funiang-x/G2026/hardware/67-外壳v5尺寸定案-20261017.md

# 67 · 外壳 v5 尺寸定案（2026-10-17）

> **用途**：在立创EDA 3D 外壳编辑器里**照表落图**的唯一尺寸源。所有数值已用实测锚点闭合，可直接填。
> **性质**：几何定案（**未落图、未打印**）。上一版实测见 `62`，设计基准见 `61`，堆叠来源见 `60`。
> **取代**：`62` §3 的三处建议值（那版按"屏装在上壳"推，已作废）。
> **证据目录**：`_work/print_prep/`（活体导出 `live/`、解析脚本、STL）。

---

## §0 一屏结论

| 项 | v4（10-17 实测） | **v5 定案** | 动作 |
|---|---|---|---|
| 外廓 | 85.0 × 123.0 × 42.0 | **87.0 × 123.0 × 35.8** | X +2（内腔要到 81）、总高 −6.2 |
| 内腔 | 79.0 × 117.0 | **81.0 × 117.0** | 板 80.25 才能进 |
| 分界面 | 22.0 | **27.25** | 抬到 SMA 孔顶 |
| 屏窗 | 57 × 86 | **54 × 83** | 现在比屏还大，屏会掉 |
| 螺丝柱 | Ø4.74/Ø2.2，上壳垂下 | **Ø8.0/Ø2.5，下壳内底长出** | 端面壁厚 1.27 → 2.75 |
| 上下盖 | 无定位无锁止 | **止口 + 一颗 M3 锁三层** | 新增 |
| SMA 孔 | Ø8.5 @Y22 封闭 | **Ø8.5 @Y23，上开口 U 槽** | 抬 1.0 并改开口 |
| Type-C 孔 | 8.0 × 5.3 | **9.5 × 4.0 R2** | 插头 8.25 进不去 |

---

## §1 实测锚点（唯一硬约束）

**用户实测**：核心板顶面（含突出元件）→ 底板顶面 = **17.0 mm**（游标卡尺）。

由此反推座子档位：

```
17.0 = 层高 + 核心板厚 1.6 + 元件高
层高 11.5（母座塑高 9 + 排针塑胶 2.5）⇒ 元件 3.9   ← 与 Type-C 座 3.26 吻合 ✓
层高 9.0（若 9 是插合层高）         ⇒ 元件 6.4   ← 偏大，不成立
```

⇒ **采信层高 11.5**，即"约 9 mm"= 母座塑高。上、下两组座子同规格（用户确认两处都是约 9 mm）。

---

## §2 高度链（外壳外底 = 0，全部锁定）

| 层 | Y | 相对板顶 | 依据 |
|---|---|---|---|
| 下壳外底 | 0.00 | −18.50 | |
| 下壳内底 | **1.50** | −17.00 | 底厚 1.5 |
| 核心板最低点 | 1.50 | −17.00 | **实测 17** |
| 核心板背面 | 5.40 | −13.10 | |
| 核心板针面 | 7.00 | −11.50 | 层高 11.5 |
| 底板底面 | 16.90 | −1.60 | |
| **底板顶面** | **18.50** | **0 ★基准** | 1.5 + 17 |
| 转接板底面 | 30.00 | +11.50 | 层高 11.5 |
| 转接板顶面 | 31.60 | +13.10 | 板厚 1.6 |
| 屏背面 | 31.90 | +13.40 | 背胶 0.3 |
| **屏面** | **33.96** | **+15.46** | 屏 2.06 |
| 上壳内面 | 34.26 | +15.76 | 留 0.3 压筋 |
| **外顶** | **35.76** | +17.26 | 顶厚 1.5 |

⇒ **总高 35.8**（取整）。下壳 0~27.25，上壳 27.25~35.8。

> ⚠️ 与 `60` §0.3 的差异：`60` 用层高 11.0 得屏面 +14.96、总高 ≈35.3。本次按用户口径 9 mm 取层高 11.5，
> 整体上移 0.5。**以本表为准**。

---

## §3 外廓 / 内腔 / 壁厚

| 项 | 值 | 说明 |
|---|---|---|
| 外廓 X | **87.0** | v4 是 85.0 |
| 外廓 Z | **123.0** | 不变 |
| 壁厚 | **3.0** | 不变（X 加宽而非减壁） |
| 内腔 X | **81.0** | 板 80.25 ⇒ 单边 0.375 |
| 内腔 Z | **117.0** | 板 100.25 ⇒ 余量充裕 |
| 下壳底厚 | 1.5 | |
| 上壳顶厚 | 1.5 | |
| 四角圆角 | R10（沿用） | |

> 为什么不能靠减壁解决：壁厚降到 1.9 才够内腔 81.2，FDM 打出来侧壁会软、螺丝柱无根。

---

## §4 开孔表（★ 照此落图）

坐标口径：**板坐标**（底板框左下角为原点，X 右 Y 上）。
外壳→板映射（用 3 个柱位拟合，残差 <0.15）：`板x = 外壳X + 0.13`，`板y = 0.14 − 外壳Z`。

| 开孔 | 位置（板坐标） | 尺寸 | 高度（Y，外底起算） | 形状 |
|---|---|---|---|---|
| **屏窗** | 中心 **(38.86, 37.90)** | **54.0 × 83.0** | 上壳顶面贯穿 34.26~35.76 | 矩形，四角 R2 |
| **SMA** | 板 y **41.44** | **Ø8.5** | 中心 **23.0**（= 板顶 +4.5） | **上开口 U 形槽**，槽宽 7.0，槽顶 = 分界面 27.25 |
| **Type-C** | 板 y **85.84** | **9.5 × 4.0**，R2 | 中心 **≈7.4**（座中心，实测反推） | 横向胶囊 |
| **M3 ×3** | (4.32,4.50)/(75.56,4.50)/(75.56,94.16) | 上壳 **Ø4.2 过孔 + Ø7.5 沉孔深 1.8** | 贯穿上壳 | 沉头 |

**屏窗校核**：屏模块 55.05 × 84.50，显示区 52.96 × 81.34。
窗 54 × 83 ⇒ 四周压边 0.525 / 0.75，露出显示区并挡住 PCB 边框 ✓（v4 的 57×86 反而比屏大 1.95，屏会掉出去）

**SMA 校核**：SMA-KE 螺纹外径 Ø6.35，槽宽 7.0 ⇒ 单边 0.325，端子从上方垂直落入不掉出。
孔顶 27.25 = 分界面 ⇒ 上壳完全不碰端子（v4 孔骑在接缝上，合盖会刮螺纹）。

**Type-C 校核**：插座外框 8.94 宽、插头 8.25 ⇒ 开 9.5 给单边 0.28；v4 的 8.0 插头进不去。

---

## §5 结构与锁紧

### 5.1 螺丝柱（3 处，从**下壳内底**长出）

| 项 | 值 |
|---|---|
| 柱外径 | **Ø8.0** |
| 自攻底孔 | **Ø2.5**（M3 自攻） |
| 柱高 | **15.4**（1.5 → 16.9，顶到板底） |
| 端部 | 倒角 C0.5；柱顶做 Ø4.0 × 0.8 定位凸台（先定板再合盖） |
| 位置 | 与板上 3 个 M3 孔同心（见 §4） |

> 三个柱位都在核心板区域 (1.08,53.61)–(71.31,98.87) **之外**，柱体不会撞核心板。

### 5.2 锁紧：一颗 M3×20 锁三层

螺丝从**上壳外面**沉头穿入 → 穿过上壳 → 穿过底板 → 拧进下壳柱 8 mm。
板由柱端面承重，不再靠 Ø2.2 自攻孔吊着（v4 的自攻壁厚仅 1.27 mm，必裂）。

### 5.3 止口（上下盖定位）

| 项 | 值 |
|---|---|
| 下壳侧壁顶部 | 内侧开槽 **1.7 宽 × 2.5 深**（外侧保留 1.3） |
| 上壳开口端 | 内侧减薄成 **1.5 厚 × 2.4 长** 的凸边 |
| 配合 | 外侧齐平，内侧单边间隙 **0.1**（FDM 实测偏紧时放到 0.15） |

### 5.4 屏的防晃

屏靠母座固定，插合有 0.2~0.5 间隙 ⇒ 上壳内面做 **0.3 高压筋**（窗框内侧 2 mm 处一圈），
合盖时贴住屏的 PCB 边框把屏压正。上壳内面 34.26 − 屏面 33.96 = 0.30，压筋正好不顶屏。

---

## §6 装配顺序（U 形槽成立的前提）

1. 核心板插到底板下方（2×20 双排母 ×2）
2. 屏模块（转接板）插到底板上方 J5
3. 组件整体垂直放入下壳，**SMA 端子从 U 槽口落入**；3 个柱顶凸台套进板孔定位
4. 上壳套下，止口导向，30pin 已在步骤 2 完成，此处不再对插
5. 3 颗 M3×20 从顶面穿入拧紧

> ⚠️ 屏与板的对插在**合盖前**就完成了（屏跟着板走），合盖只是罩上去。
> 这与 `61` §6 的"合盖时对插"不同 —— 那一版假设屏装在上壳。

---

## §7 待验 / 出处

| 项 | 状态 |
|---|---|
| 核心板顶面→板顶 17.0 | ✅ 用户游标卡尺实测（2026-10-17） |
| 母座塑高 9 → 层高 11.5 | ✅ 由 17 反推自洽（元件 3.9） |
| Type-C 座中心 7.4 | ⚠️ 由 v4 外壳孔位反推，**装壳前用实物核一次** |
| 屏模块 55.05×84.50 / 显示区 52.96×81.34 | ✅ `58` / `60` |
| 板 80.25×100.25 | ✅ `hardware/data/pcb_snapshot_20261011.json` |
| SMA-KE 中心在板顶 +4.5 | ✅ `62` §3.2 |

**复算**：`_work/print_prep/` 下 `analyze.py`（分层）、`loops.py`（开孔环）、`obj2stl.py`（转 STL + 流形自检）。
**活体导出**：EDA bridge `POST /execute` → `pcb_ManufactureData.get3DShellFile(pcb_uuid,'obj')`。
