funiang-x/G2026/hardware/58-屏与转接板机械尺寸-20261011.md

# 58 · 屏与转接板 机械尺寸（做外壳用）（2026-10-11）

> **用途**：给 **PCB 外壳/结构件** 设计提供**纯屏幕**与**转接板**两部分的准确尺寸。
> **性质**：只读资料整理。**每个数字都标了出处**，凡没找到出处的都明确写"未查到"。
> **配图**：`_work/_mech/尺寸标注_屏与转接板.png`（按真实比例绘制的两件外形 + 关键尺寸）。

---

## §1 一屏结论（先看这张表）

| 件 | 外形（W×H） | 厚 | 出处 |
|---|---|---|---|
| **① 纯屏幕**（LCD 模块 TK035F9629，驱动 IC ST7796） | **55.05 (±0.2) × 84.50 (±0.2) mm** | **2.06 (±0.06) mm** | 屏规格书 P.4「GENERAL INFORMATION」+ P.5「EXTERNAL DIMENSIONS」 |
| **② 转接板**（TK035F5501） | **98.70 × 56.00 mm** | **未查到**（常规 1.6 mm，**请卡尺实测**） | 转接板 Altium 源文件 `TK035F5501_adapter_Constant_current.pcbdoc` 的 Board 记录（板框顶点实测 56.01 × 98.71 mm） |

> ⚠️ **方向约定**：屏是**竖屏**（55.05 宽 × 84.50 高）；转接板是**横板**（98.70 长 × 56.00 宽）。
> 屏在转接板上**居中**安装，两者长轴同向（屏的 84.50 贴着转接板的 98.70）。

---

## §2 ① 纯屏幕（LCD 模块）的尺寸

| 项 | 数值 | 出处 |
|---|---|---|
| **模块外形（含铁框/背光）** | **55.05 ±0.2 × 84.50 ±0.2 mm** | 规格书 P.5 标注 `55.05±0.2` / `84.50±0.2` |
| **模块厚度** | **2.06 ±0.06 mm** | 规格书 P.5 侧视图标注 `2.06±0.06` |
| **玻璃外形（LCD OD）** | 52.96 × 81.34 mm | 规格书 P.5 标注 `LCD OD 52.96` / `LCD OD 81.34` |
| **可视区（LCD AA）** | **48.96 × 73.44 mm** | 规格书 P.4「Active area」+ P.5 标注 `LCD AA 48.96` / `LCD AA 73.44` |
| 分辨率 / 像素间距 | 320RGB × 480 / 0.1395 × 0.1395 mm | 规格书 P.4 |
| **FPC** | **45 pin，0.3 mm 间距**，型号 `CDN1TDRFH26-45S-0.3SHW(05)` | 规格书 P.5 注释「FPC MEET WITH CDN1TDRFH26-45S-0.3SHW(05)」 |
| FPC 引出长度 | 图上标注 **9.67** / **9.45**（**归属未完全确认**，建议实测） | 规格书 P.5（数字可读，箭头归属需现场核） |
| 视角方向 | 6 O'CLOCK（正视） | 规格书 P.4 / P.5 |
| 工作温度 | −20 ~ +70 ℃ | 规格书 P.6 |

**给外壳的提示**：
- **开窗**要 ≥ **可视区 48.96 × 73.44**，但要留**公差 + 视角**余量 ⇒ 建议按 **玻璃外形 52.96 × 81.34** 再放 0.3–0.5 mm 单边间隙来开窗。
- **压边**（盖住铁框）可用区域 = 玻璃外形到模块外形之间，即**单边 1.045 mm**（(55.05−52.96)/2）与 **1.58 mm**（(84.50−81.34)/2）。压边别压到玻璃。
- 屏正面到安装面 ≈ **2.06 mm**（模块厚）。

---

## §3 ② 转接板（TK035F5501）的尺寸

### 3.1 板框与安装孔（**从 Altium 源文件直接解出，可复算**）

| 项 | 数值 | 出处 / 说明 |
|---|---|---|
| **PCB 外形** | **98.70 × 56.00 mm** | `.pcbdoc` Board 记录：X 3000.0–5205.1 mil = **56.01 mm**；Y 3000.0–6886.2 mil = **98.71 mm** |
| **四角圆角** | **R ≈ 1.275 mm** | 顶点 `3050.1968 mil = 3000 + 50.2 mil` ⇒ 半径 50.2 mil = 1.275 mm |
| **安装孔** | **4 × Ø3.00 mm** | `.pcbdoc` 中 4 个 `HOLESIZE=118.1 mil` 的无网络焊盘 |
| **安装孔中心距** | **92.70 × 50.00 mm** | 孔心 (79.20,79.20)/(129.20,79.20)/(79.20,171.90)/(129.20,171.90) mm ⇒ ΔX=**50.00**、ΔY=**92.70** |
| **孔到板边** | **各 3.00 mm** | (98.70−92.70)/2 = 3.00；(56.00−50.00)/2 = 3.00 |
| **定位孔** | **2 × Ø1.70 mm**，间距 **33.02 mm** | `.pcbdoc` 中 2 个 `HOLESIZE=66.9 mil` 焊盘，位于距短边 4.40 mm 处 |

> **外壳安装建议**：用 **M3 螺钉**穿过 Ø3.0 孔，或做 **Ø3.2 的定位柱**。
> 孔位 = 板左下角起 **(3.00, 3.00)、(95.70, 3.00)、(3.00, 53.00)、(95.70, 53.00) mm**（x 沿 98.70 方向、y 沿 56.00 方向）。

### 3.2 板上的关键接口位置

| 项 | 位置 | 出处 |
|---|---|---|
| **屏 footprint**（板上的屏轮廓） | **84.50 × 55.05**，在板上**居中** | 机构图内框（像素实测 84.6 × 55.0）+ 与屏规格一致；长向各留 **7.10 mm**、短向各留 **0.475 mm** |
| **30pin 接口**（2×15 / 2.54 mm，与底板 `J5` 对插） | 板**左端**，沿 **56.00** 方向排列，跨度 **35.56 mm** | 机构图丝印标签（CS/RS/WR/RD/RST/D00…D15/T_CS/T_SCK/T_MISO/T_MOSI/T_IQR/BL_CTR/3V3/GND 共 30 个） |
| **LCD FPC 座**（45 pin） | 板**左侧**（贴板边） | `.pcbdoc` 中 45 个 0.3 mm 间距焊盘 |

> ⚠️ **未完全落实**：30pin 排针与 FPC 座的**精确坐标**我没能在 Altium 文件里唯一定位（该板有多个细间距连接器），
> 上表给的是**从机构图像素测量 + 丝印推断**的结果。**做外壳若要紧贴这两个接口开孔，请以实物卡尺为准。**

### 3.3 板厚与层数

- **板厚**：`.pcbdoc` 里**未找到** THICKNESS 记录（Altium 的层叠表在别的流里）。
  ⇒ **按常规 1.6 mm 假设，请卡尺实测**（这是外壳"总厚"的关键一项）。

---

## §4 装配关系（三层堆叠）与总厚估算

本装置的堆叠（详见 `hardware/49`）：

```
        ┌───────────────┐
        │  ① 屏 2.06mm  │   ← 朝上（用户看的一面）
        ├───────────────┤
        │  ② 转接板     │   ← 屏在其上居中；板厚待实测（≈1.6mm）
        ├───────────────┤
        │  30pin 排针   │   ← 转接板向下插进底板 J5（母座）
        ├───────────────┤
        │  底板 1.6mm   │   ← 本项目自己画的板
        ├───────────────┤
        │  核心板       │   ← 从下方插进底板的 EVK1 双排母
        └───────────────┘
```

| 层 | 厚度 | 来源 |
|---|---|---|
| 屏 | **2.06 mm** | 规格书 |
| 转接板 | **待实测**（≈1.6 mm） | 未查到 |
| 排针啮合高度 | **待实测** | 未查到 |
| 底板 | 1.6 mm（默认） | `54 §8.1` |
| 核心板 | 待实测 | — |

> ⚠️ **总厚必须实测**：上面三层里**有两层我没拿到厚度**（转接板、排针啮合），
> 外壳的"总高"必须等实物到齐后用卡尺量。**不要用估算值开模。**

---

## §5 关键注意事项（做外壳前必读）

1. **别用估算值开模**：屏的两个尺寸（55.05×84.50×2.06）来自**厂家规格书**，可信；
   转接板外形（98.70×56.00）来自**厂家 Altium 源文件**，也可信；
   但**板厚、排针啮合高度、FPC 实际长度**都**没有**权威数字 ⇒ 必须实测。
2. **公差**：屏的外形公差 **±0.2 mm**（宽/高）、**±0.06 mm**（厚）⇒ 开窗与压边要按最坏情况留余量。
3. **FPC 的弯折空间**：屏的 FPC 要从屏折到转接板的 FPC 座上，**这段折叠需要空间**（厚度 + 弯折半径）。
   外壳里要给 FPC 留**至少一个板厚的空腔**，否则压伤 FPC。
4. **转接板的安装孔与屏的压边可能打架**：孔距板边只有 **3.00 mm**，
   而屏居中后短向只留 **0.475 mm** ⇒ 短向两侧的螺钉/定位柱**紧贴屏边**，注意别顶到屏的铁框。
5. **本工程的转接板是"屏厂配套件"**，不在我们的 BOM 里 ⇒ 尺寸以**厂家机构图**为准；
   本项目自画的只有**底板**（80.3 × 100.3 mm，见 `54 §8.1`）。

---

## §6 出处与复算

| 数据 | 文件 | 取法 |
|---|---|---|
| 屏外形 / 玻璃 / AA / 厚 / FPC 型号 | `docs/TK035F5687_9629_整理资料_(含SPI及并口版)/01_文档规格书/TK035F9629_ST7796版/TK035F9629规格书v1.2.pdf` | P.4 文字表 + P.5 外形图（渲染成图后读标注） |
| 转接板板框 / 圆角 / 安装孔 / 定位孔 | `…/05_硬件转接板资料/1000亮度转接板/Altium_TK035F5501_adapter_Constant_current/TK035F5501_adapter_Constant_current.pcbdoc` | 该文件是 **`\|RECORD=` 分隔的 ASCII**（不是纯二进制）⇒ 直接正则解出 Board 记录的顶点与 Pad 记录的孔径 |
| 转接板尺寸标注（98.70 / 92.70 / 56.00 / 50.00 / 55.00） | `…/TK035F5501_adapter机构图/TK035F5501_adapter机构图.png` | 用板上 **2×15 排针（2.54 mm 间距）** 做标尺标定 ≈18.63 px/mm，再量各轮廓 |
| 两件比例图 | `_work/_mech/尺寸标注_屏与转接板.png` | matplotlib 按真实 mm 绘制 |

> **交叉验证**：转接板外形用**三种方法**得到一致结果 —— ① Altium 板框顶点 **56.01 × 98.71 mm**；
> ② 机构图像素测量（以排针 2.54 mm 标定）**98.71 × 56.04 mm**；③ 图上标注 **98.70 × 56.00**。⇒ **可信**。
