funiang-x/G2026/hardware/59-PCB与原理图深度审查-精度专项-20261011.md

# 59 · PCB 与原理图深度审查（精度专项）（2026-10-11）

> **性质**：对**当前活体原理图 + PCB** 的**只读**深度审查，**以"设计精度"为主线**，
> 同时覆盖：布局合理性 · 布线规范 · 信号完整性 · 电源完整性 · 接地 · 去耦 · 阻抗匹配 ·
> 散热 · EMC/EMI · 丝印 · 封装与实物一致性 · 制造工艺。
> **状态**：审查完成，**一条都没改**（本轮只读 + 取证脚本）。
>
> **本版快照**：PCB `semanticSha256 = ce89ef0f…`（20:29 版）· 原理图网表
> `.easyeda/artifacts/20261011-202945-schematic_netlist-c708521a.enet`（20:29:45）。
> **与 54/55/56/57 的关系**：那四份是 16:07–17:24 版；**16:07 之后板子又变过**
> （四只电感换 0630 一体成型、L7=15µH、R15/R16 删除、R6/R11 同步），
> 本文按**新快照**重跑全部几何判据，并补上此前四轮都没做的**互感耦合量化**与**公差累积表**。
> **判据**：本文数字全部可复跑 —— 脚本 `_work/pcb_audit_r5_20261011/{audit_r5,audit_r5b,mutual_coupling}.py`，
> 原始输出 `geo_report.txt` / `geo_report_b.txt`，快照 `pcb.json`，DRC/DFM/规则 `{drc,check,drc_rules,config}.json`。
>
> **符号**：**★ = 直接影响电路精度 / 测量准确性**；◐ = 间接（经基准 / 接地 / 耦合 / 换件）；
> — = 与精度无关（工艺 / 装配 / 可读性）。

---

## §0 一屏结论

| # | 级 | 结论 | 精度 |
|---|---|---|---|
| 1 | **P1** | **B1（增益 ×4）已落图落码 ⇒ 旧标定表作废**；且**标定残差 0.383 mV 是 12 µH 口径**（L7 已改 15 µH）⇒ 必须重标定 + 复跑残差 | **★** |
| 2 | **P1** | **L7 的 BOM 三字段不一致**：`Value=15µH` / `MPN=HCM0630-150M` / `LCSC=C9900009031` → 库内实为 **`MPEV1D0630L150`**（封装名 `W6.5` ≠ 板用 `W6.6`）；且丝印还印着旧名 `XR0630-220M` | ◐ |
| 3 | **P1** | **背光驱动方式仍未确认**：转接板通用版只有 `SI2302` MOSFET 直驱、**无镇流**，而屏规格要求**恒流 60 mA ±10%** | ◐ |
| 4 | **P1** | **`+3V3` 同时是 ADC 基准与屏/背光电源**（核心板 `VREF+=VDDA=+3V3`）⇒"背光开/关谱底差"**仍未实测** | **★** |
| 5 | **P1** | **`SCREW3` 仍在板中央 AFE 岛内** (40.64, 46.53) —— 四角不齐、三点支撑、在模拟地岛中央打 Ø3.2 通孔 | — |
| 6 | **P1** | **`AGND↔GND` 铜隙仅 5.0 mil = 0.127 mm**（`POUR6↔POUR2` L1）⇒ 制造缺陷即可桥接成第二个接地点（**DRC 不报**） | ◐ |
| 7 | **P1** | **模数隔离带 5.97 mm < 10 mm**（`LCD_BL_CTL`→`C11`）；数字**过孔**最近 7.36 mm —— 而固件找峰门限只有 **1.5 mV** | **★** |
| 8 | **P2** | **L3/L5/L7 现在共轴摆放（0°/0°/0°）**，违反"四电感正交"这条既有设计规则（旧版为 90/0/90/0）。新件是一体成型（自屏蔽）⇒ 估计 k≈0.5–3%，折算**阻带劣化约 1–5 dB**（余量 15.6 → ≥10 dB，仍达标） | **★** |
| 9 | **P2** | 总线 `LCD_D1` **62.0 mm** / `LCD_RS` **60.8 mm** 越 60 mm 硬上限；`D0` 51.9 / `D2` 44.3 / `RD` 42.4 越 40 mm 提示线 | ◐ |
| 10 | **P2** | **规则两条比厂能力还松**：`trackTrack = 4.02 mil` < 嘉立创 2 层下限 5 mil；`copperToEdge = 10 mil` < 建议 0.3 mm | — |
| 11 | **P2** | **地铺铜焊盘连接 = 直接连接**（`connectMode=0`，三层模型全 0）⇒ 手焊时地脚被大铜面抽热 | — |
| 12 | **P2** | `R7` → `U1.6(-INB)` = **3.67 mm**（判据 ≤3 mm）；`-in` 高阻节点铜长 **7.05 mm** | ◐ |
| 13 | **P2** | **`+5V` 入口只有一颗 22 µF 钽**（无陶瓷）；`J5.30` 旁只有 `C3`(3.42 mm)/`C22`(6.33 mm)，无 22–47 µF | ◐ |
| 14 | **P2** | **`R1`→`J1`(SMA) 8.75 mm**（判据 ≤2–3 mm）：端接点不在"输入端" | **★** |
| 15 | **P2** | **`C10`→`PA1` 9.53 mm / `R11`→`PA1` 11.52 mm**：ADC 电荷库与串联电阻离引脚偏远 | **★** |
| 16 | **P2** | **文档口径错两处**（54/55/56 写"CD54 **屏蔽**电感"、"L **±10%**"）：旧件 XRCD54/CD54 实为**非屏蔽鼓芯**、M 档是 **±20%** | **★** |
| 17 | **P3** | **全板丝印 0 条自由文字**（无板名/版本/装配说明）；**21 处位号倒置**；**9 处丝印压盘**（含 `L7` 的旧器件名） | — |
| 18 | **P3** | **`+3V3` 在 L2 上穿过 `AGND` 铺铜 22.13 mm**（把模拟地平面开了一条槽；2 条模拟线跨越它） | ◐ |
| 19 | **P3** | `J5.23`(`T_CS`) 悬空 ⇒ 转接板 XPT2046 未确定性关断 | ◐ |
| 20 | **P3** | `R6` 的 `Tolerance`/`Temperature Coefficient` 字段为空；`R7` 字段写 ±5 ppm/℃（与 R6 的 25 ppm 不一致） | ◐ |
| 21 | **P3** | 触摸 I²C **底板已无上拉**（`R15/R16` 已删）⇒ 完全依赖转接板 `R9=4.7K`（通用版原理图已确认有此件） | ◐ |
| 22 | **P3** | 无 Mark 点（**可接受**：最小间距 1.27 mm、无细间距件、手焊）；`track-over-pad` 1 处（`R2.1`）；`width-mismatch` 7 处；`width-under-spec` 1 处（AGND 10 mil 短段） | — |
| 23 | **P3** | 板框是**圆角矩形**（工具报 `unexpected-start:R`，`outline-get` 的 `segments=0`/`centerlineBBox=null`）⇒ 需在 EDA 里目视确认板框闭合 | — |
| **好** | — | **DRC `passed=true` / 0 违规**；**原理图↔PCB 逐脚 65/65 件、68/68 网、0 不符**；33Ω 21/21 仍贴 MCU 侧 2.53–2.88 mm；`AFE_ADC_IN` 4.01 mm / 0 过孔；数字线 **0 段**侵入 AGND；AGND 单点成立；缝合孔 373 个；**并联电容 AGND 脚到过孔 1.28–1.30 mm**（新证，优秀）；层间铜平衡 77.4/77.7 cm² | — |

**一句话**：电气与几何层面**没有致命缺陷**（DRC 绿、网表 1:1、六条电源网都有源、单点接地成立）。
本轮新增的三条实打实的发现是：**① L7 料号三字段不一致 + 丝印印旧名；② 电感由"正交"变"共轴"（附互感量化）；③ `+3V3` 在模拟地平面上开了 22 mm 的槽**。
**而"精度"这件事，当前最大的风险仍然不在板子上，而在流程上：B1 改了增益之后，标定必须重做。**

---

## §1 16:07 之后板子变了什么（本轮与 54/55/56/57 的差异清单）

| 项 | 16:07 版（54/55/56/57 口径） | **20:29 版（本文口径）** |
|---|---|---|
| `L1` | `XRCD54-4R7M`（非屏蔽鼓芯，5.2×4.5） | **`XR0630-4R7M`**（一体成型 0630，7.0×6.6） |
| `L3`/`L5` | `CD54-220M`（非屏蔽鼓芯） | **`XR0630-220M`**（一体成型） |
| `L7` | `XRCD54-120M`（**12 µH**，非屏蔽） | **`HCM0630-150M`**（**15 µH**，一体成型档） |
| 电感轴向 | **90°/0°/90°/0°**（相邻正交） | **90°/0°/0°/0°** —— **L3/L5/L7 共轴**（§2.4） |
| `R15`/`R16` | 4.7 kΩ 触摸上拉 | **已删**（PCB/原理图均已无此件） |
| `R6` | 24.9 kΩ（×2.0） | **53.6 kΩ**（×4.0，B1 已落图落码） |
| `R11` | 100 Ω | **300 Ω**（D1 已落，`0805W8F3000T5E`/`C17617`） |
| 走线/过孔/弧 | 272 段 / 386 孔 / 9 弧 | **270 段 / 393 孔 / 5 弧**（电感换型后重布） |
| 缝合孔 | 364 | **373**（AGND 230 / GND 143） |
| 丝印 DFM | silk-over-pad 8 | **9**（新增 `L7` 的两条器件名丝印压盘） |
| 线宽突变 DFM | width-mismatch 4 | **7**（电感换型后新增 3） |
| DRC | passed（57 记 1 条平台侧 Netlist Error） | **passed=true，`violations=[]`（那条已不在）** |

> 网表口径同步：**原理图 65 件 / PCB 65 件 / 68 网 / 逐脚 0 差异**（仅 `EVK1` 符号 84 脚比封装多 4 个 NC 脚，既有、无害）。

---

## §2 精度专项（本文重点）

### 2.1 先把"哪些东西真的影响精度"划清楚

| 类别 | 项 | 为什么 | 标记 |
|---|---|---|---|
| **标定消不掉**（真正吃 5 mV 预算） | ADC 的 INL/DNL（0.6–1.2 mV）· VREF 温漂（0.25–1.0 mV）· 屏/背光对 `+3V3`(=基准) 的扰动 · 混叠残留（0.135 mV） | 标定只消"恒定乘性/加性"项 | **★** |
| **标定消不掉，但来自"标定质量"** | 17 点表的插值残差（现值 **0.383 mV** 是 12 µH 口径）· 标定后换件/换板 | 与"表"和"件"绑定 | **★** |
| **会被标定吸收**（但会放大上面的项） | `R1/R3/R4` ±1% · `R6/R7` ±0.1% · `L ±20%` · C0G ±5% · 运放带宽/孔径损失 | 恒定 ⇒ 表里记下就是 | ◐ |
| **与精度无关** | 33Ω 位置、丝印、Mark 点、`SCREW3`、`connectMode`、总线长度 | 影响 EMC/装配/可制造性 | — |
| **无匹配要求** | 走线等长（§2.3） | 无差分对、无同步时钟总线 | — |

### 2.2 公差累积链（逐项 → 折算 → 能否被标定吸收）

> 口径：输入 250 mVpp ⇒ ADC 端 ≈1003 mVpp（×4.0137）。"折算读数"指折算到**输入端**的 mV。

| # | 环节 | 器件 / 参数 | 容差 | 折算到输入端 | 标定能吸收？ |
|---|---|---|---|---|---|
| 1 | 输入端接 | `R1` 49.9 Ω ±1% | 1%（乘性） | 2.5 mV | 能（恒定） |
| 2 | 滤波源/负载端接 | `R3`/`R4` 49.9 Ω ±1% | 1% | 带内 <0.1 dB | 能 |
| 3 | **滤波电感** | `L1/L3/L5/L7` **±20%（M 档真实件）** | ±20% | 带内起伏最坏 **2.5 dB**（15 µH 档，n=1500 MC）⇒ 标定残差被放大 | 能（同板标定），**但增大 §2.1 的插值残差** |
| 4 | 滤波电容 | `C2/C4/C6/C8` C0G ±5% | ±5% | 同上 | 能 |
| 5 | **增益网络** | `R6` 53.6 k / `R7` 3.57 k，**均 ±0.1%** | 最坏 0.14% | **0.35 mV** | 能 |
| 6 | 增益温漂 | `R6` 25 ppm/℃（RT 系列）vs `R7` 字段写 **±5 ppm/℃** | 差 20 ppm/℃ | 20 ℃ 内 ≈0.10 mV | **不能**（但极小；两者同热区） |
| 7 | 偏置 | `R9`/`R10` ±1% + `+3V3` ±1~2% | VBIAS ±1~3% | **只吃 ADC 余量**（±50 mV 内），不改读数 | — |
| 8 | **基准** | `+3V3`(=VREF) 温漂 | 0.25–1.0 mV | **不能**（见 `56 §4`） |
| 9 | **ADC 非线性** | INL ±1.5/±3 LSB | 0.6 / 1.2 mV | **不能**（第 1 大项） |
| 10 | ADC 量化 | LSB_in = 0.2014 mV（×4 后） | 每 bin 0.008 mV | 能（噪声） |
| 11 | 采样时序 | fs = 144 MHz/72 = **2.000 MHz 精确**、触发间隔 = 18 ADCCLK 整 | **0 抖动** | 能 |
| 12 | **电感温漂** | 一体成型件规格未归档（按 ±0.05%/℃ 量级估） | 20 ℃ → ~1% L | **0.1–0.5 mV（估）** | **不能**（未归档，见 §2.5） |

**结论**：所有"乘性/加性"容差（1–5、10）都会被标定吸收 —— 这也是本项目一直能过的原因；
**剩下的 6/8/9/12 四项（温漂 + ADC INL）才是 5 mV 判据的敌人**，与 `56`/`57` 的结论一致，
**新增的是第 12 项（电感温漂）此前没有归档**。

### 2.3 走线长度匹配误差 —— 本板"不需要等长"，但要给出量化

- **核实**：网表里 `equalLengthNetGroup = {}`、`differentialPair = {}` —— **没有任何等长/差分约束**。
- **信号侧**：模拟链是单端、单通道 ⇒ 无匹配对象；8080 总线**无同步时钟**（写周期由 `WR` 选通，~104 ns/字）。
- **量化**：数据线最长 `LCD_D1` 62.0 mm ↔ 最短（数据组）`LCD_D14` 34.6 mm ⇒ 失配 **27.4 mm**；
  按 εeff≈3.3（v≈165 mm/ns）折算**偏斜 ≈ 166 ps**，占 104 ns 写周期的 **0.16%** ⇒ **无影响**。
- **唯一"看似要匹配"的是 FSMC 21 条线**：它们靠 **33Ω 源端阻尼**（已 21/21 贴 MCU 侧 2.53–2.88 mm）控制振铃，
  不靠等长 ⇒ **结论：本板不存在走线长度匹配误差问题**（这一条是"审查过、无问题"，不是遗漏）。

### 2.4 新发现：电感互感耦合（L3/L5/L7 共轴摆放）

**事实**（PCB 快照实测）：

| 电感 | 器件 | 轴向 | 中心位置(mm) | 相邻中心距 |
|---|---|---|---|---|
| `L1` | XR0630-4R7M（4.7 µH） | **90°** | (12.95, 33.07) | L1↔L3 10.20 mm（正交 ✓） |
| `L3` | XR0630-220M（22 µH） | **0°** | (15.37, 23.17) | L3↔L5 **10.29 mm（共轴）** |
| `L5` | XR0630-220M（22 µH） | **0°** | (25.65, 23.29) | L5↔L7 **10.29 mm（共轴）** |
| `L7` | HCM0630-150M（15 µH） | **0°** | (35.94, 23.17) | L3↔L7 20.57 mm |

替换前是 **90/0/90/0（相邻正交）**，替换后 **L3/L5/L7 三只共轴一列**（绕线轴都在 X，且 Y 相同）——
这正是"非屏蔽鼓芯时代"那条设计规则（互感抑制）要避免的摆放。**新件的材料属性变了，规则的理由也变了，但"共轴"这个事实必须重新评估。**

**量化**（`mutual_coupling.py`，MNA 含耦合电感支路；已用独立节点法对拍，k=0 时差 **0.0000%**）：

| 耦合系数 k | 带内峰谷(dB) | 500 kHz Δ | 1.0 MHz Δ | 1.2 MHz Δ | 1.5 MHz Δ |
|---|---|---|---|---|---|
| 0（基准） | 0.081 | — | — | — | — |
| **+2%** | 0.076 | −0.006 | **+2.6** | **+3.5** | **+5.2** |
| **+5%** | 0.075 | −0.015 | **+6.1** | **+7.9** | **+10.9** |
| +8% | 0.080 | −0.025 | +9.1 | +11.5 | +15.3 |

（值为"阻带衰减劣化量"，dB；正号 = 抑制变差。负 k 会反而改善，但同型号同朝向、电流同向 ⇒ **实际应为正 k**。）

**怎么读这张表**：
1. **带内几乎不变**（±0.08 dB 量级）⇒ 500 kHz 以内的读数与标定**不受影响**；
2. **阻带敏感度是 dB 级/%** ⇒ 这是"u_J 抑制余量"（现 15.6 dB）的净损失；
3. 新件是**一体成型（自屏蔽）**：LCSC 器件描述原文"**由于采用模制结构，超低嗡嗡声**"⇒ 估计 k ≈ **0.5–3%**
   （旧的非屏蔽鼓芯同样距离会到 5–10%，那时才必须正交）⇒ **预计损失 1–5 dB，余量仍 ≥10 dB，达标**。
   ⚠️ 但 k 是**估计值**，没有实测（本板未制造）；且 `_work/ind_sel_check/results.md` 的 MC 也**没有计入互感**。
4. **建议**（按性价比）：
   - **首选**：投板前把 **`L5` 转 90°**（2 个焊盘各挪 ~3.3 mm，只动 2 段短线）⇒ 恢复相邻正交，风险归零；
   - **次选**：不改，把 **"u_b + 200 mVpp @1.5 MHz ⇒ |ΔUpp| < 1 mV"**（`56 §14-7`）列为投板后**第一优先**验证项 ——
     它天然覆盖这条风险，测不过再改板；
   - 文档侧：把"四电感正交（因非屏蔽鼓芯互感）"改写为"**新件为一体成型，正交非必需但保留**；已评估".

### 2.5 "标定之后会漂"的清单（精度最怕的不是误差，是误差会变）

| 会漂的项 | 现值/估计 | 标定后是否失效 | 对策 |
|---|---|---|---|
| `+3V3`(=VREF) 温漂 | 0.25–1.0 mV | 是 | `57 A3`（VREFINT 补偿）；赛前/赛中各标一次 |
| 屏/背光加载 `+3V3` | 未测 | 是（若背光被反复开关） | 背光只开一次（现有固件如此）+ 实测谱底 |
| `R6`/`R7` 比值温漂 | ≤0.1 mV / 20 ℃ | 否（量级太小） | — |
| `L`/`C` 温漂 | C0G 可忽略；**电感温漂未归档** | 可能是（0.1–0.5 mV 估） | 归档 `XR0630/HCM0630` 的感值温漂规格；**赛前/赛中各标一次** |
| 换件 / 换屏 / 换核心板 | — | **是（残差直接翻倍级）** | 铁律：标定后不换任何前端件（`56 §13-1`） |

### 2.6 影响精度的布局判据复核（本轮实测）

| 判据 | 实测 | 结论 | 精度 |
|---|---|---|---|
| 21×33Ω → MCU 引脚 | **2.53–2.88 mm**（21/21） | 优 | — |
| `R1` → `J1`(SMA) | **8.75 mm** | 端接点不在输入端；≤500 kHz 电气可忽略（Γ<0.005） | **★**（规范项） |
| `R11` → `C10` | **1.93 mm** | 好（Riso + 电荷库成对） | — |
| `C10` → `PA1`(EVK1.4) | **9.53 mm** | 偏远（判据 ≤5 mm）；`AFE_ADC_IN` 本体仅 4.01 mm | **★** |
| `C14` → `U1.8`(+5V_A) | **2.23 mm** | 优 | — |
| `C11` → `U1.8` | **3.55 mm** | 边际（DFM `decap-too-far`） | ◐ |
| `C3`/`C22` → `J5.30` | **3.42 / 6.33 mm** | 一般 | ◐ |
| `R6`/`R7` → `U1.6(-INB)` | **2.46 / 3.67 mm** | `R7` 越线（`-in` 高阻节点） | ◐ |
| `-in` 节点(`$3N658`)铜长 | **7.05 mm / 6 段** | 与 16:07 版持平（未回退） | ◐ |
| `AFE_ADC_IN` | **4.01 mm / 1 段 / 0 过孔** | 优 | — |
| 并联电容 AGND 脚 → 最近 AGND 过孔 | **1.28–1.30 mm**（`C2/C4/C6/C8/C10/C5/D1`） | **优（本文新证）** | — |
| 数字线侵入 AGND 岛 | **0 段** | 优 | — |

---

## §3 布局合理性

| 项 | 实测 | 判定 |
|---|---|---|
| 三区结构（AFE 岛 / 数字+屏 / 电源） | `AGND` 五块铺铜（L1+L2 成对）罩住 AFE；`GND` 三块在数字区 | 成立 |
| `SCREW3` 在 AFE 岛中央 (40.64, 46.53) | 判据=四角对称 | **P1 未改** |
| `R24`(97.7)/`R41`(97.6) 距上边缘 ~2.4 mm | 装壳时防压 | 注意 |
| 屏模块 + 转接板压在底板上方 | 转接板背光升压正对 AFE 上方 | 与 §7 N2 同一件事（实测覆盖） |
| 电感区域 | 四只 0630，L3/L5/L7 共轴 | 见 §2.4 |
| 底层 23 件 | `EVK1` + `R12` + `R22~R42`（21 只 33Ω） | 与 `55 §1.3` 口径一致 |

## §4 布线规范性

| 项 | 实测/规则 | 判定 |
|---|---|---|
| 最小线宽 / 最小净距 | 10 mil / **9.56 mil**（`AGND↔$3N702`） | 实测达标（厂下限 5 mil） |
| **设计规则** `trackTrack` | **4.02 mil** | **P2：比厂能力松**（应按 6 mil 收） |
| **设计规则** `copperToEdge` | **10 mil** | **P2：嘉立创建议 ≥12 mil** |
| 过孔 | **393 个全部 24/12 mil**，单一规格 | 优 |
| 线宽分布 | 10 mil×229 / 15×27 / 30×14 | 合理（30 mil 在电源/地） |
| 走线↔过孔 最小净距 | 5.99 mil | 刚好达标 |
| 弧 / 悬空头 / 锐角 / 重复段 / 单层过孔 / 盘中孔 | 5 / **0** / **0** / **0** / **0** / **0** | 优 |
| DFM 遗留 | `track-over-pad` 1（`R2.1`）· `width-mismatch` 7 · `width-under-spec` 1（AGND 10 mil 短段） | P3 |

## §5 信号完整性

- **端接与匹配**：`J1 → R1 49.9Ω ∥ (C1+R2)` ⇒ 输入 ≈50 Ω；LC 梯形双端 49.9 Ω；**无需控阻抗走线**（最高关注频率 1.5 MHz，λ/100 尺度 ≫ 板尺寸）。
- **源端阻尼**：21 条 FSMC 线 33Ω 贴 MCU 侧（2.53–2.88 mm）—— 过冲 47%→8% 的既有结论仍成立。
- **ADC 前端**：`R11` 300 Ω + `C10` 470 pF ⇒ fc ≈ **1.13 MHz**；`R11` 落在 ADC 数据手册反解的窗口（240 Ω…1.1 kΩ）内；
  采样电荷由 `C10`（≥100×`CADC`）就近供给 ⇒ 采样瞬态不受 `R11` 影响。
- **总线长度**：`D1` 62.0 / `RS` 60.8 / `D0` 51.9 / `D2` 44.3 / `RD` 42.4 mm —— **P2**（有 33Ω 阻尼，主要是辐射面积）。
- **串扰**：DFM `coupling` = 0；最小线间距 9.56 mil ⇒ 3W 规则（10 mil 线 → 30 mil 间距）在数字区不满足，但总线为**低速选通**（~9.6 MHz 基频），风险低。
- **参考平面**：`AGND` 在 L1+L2 **成对**；数字网**没有一个**以 AGND 为参考（此前 `55` 已证，本轮结构未变）。

## §6 电源完整性

| 网 | 实现 | 判定 |
|---|---|---|
| `+5V` | 3 块填充；来源 `EVK1.40`+`EVK1.80` | 去耦仅 `C16`(22 µF 钽) ⇒ **P2 补陶瓷** |
| `+5V_A` | 1 块填充；`R21` 4.7Ω 隔离 | `C11`+`C14`（2.23 mm）✓ |
| `+3V3` | 2 块填充 + **32.58 mm 走线**；`EVK1.38` → `J5.30`(屏) / `R9`(VBIAS) / `C3`/`C22` | 见 §2.1 N2；**且 L2 段在 AGND 铺铜里开了 22.13 mm 槽（§7）** |
| `VBIAS` | 分压 + `C5`；25.83 mm 走线 | AC 低阻（5 k∥10 µF）⇒ 长走线无害 |
| `GND` / `AGND` | 3 块 / 5 块铺铜 + 缝合孔 373 | 单点成立 |

- **载流**：最大电流（背光恒流 60 mA + LCD 逻辑 + MCU ≈ 170 mA）对 10 mil（≈0.89 A）仍有 ~5× 余量 ✓。
- **填充间最小净距**：0.508 mm（前版结论，本轮结构未变）。
- `pcb check` 的 3 条 `power-not-poured` 仍是**误报**（工是不认 fill）。

## §7 接地

- **单点结构成立**：`AGND` 唯一出口 `EVK1.37`；板上 `AGND↔GND` **零连接件**。
- **P1 未改**：`AGND↔GND` 铜隙 **0.127 mm**（`POUR6↔POUR2` L1）⇒ 见 §13-6。
- 缝合孔 **373**（AGND 230 / GND 143）；10 mm 网格空格 6/90（7%）；最大最近邻 **7.62 mm**（顶到 ≤300 mil 边界，**别再删**）。
- `J5.29`（屏地针）→ 最近 GND 过孔 **1.80 mm**，5 mm 内 **8 个** ✓。
- **新发现（P3）**：`+3V3` 有一条 **22.13 mm** 的 L2 走线（x=14.76 mm，y 35.6→57.7）**穿在 `AGND` 铺铜内部**，
  把模拟地平面切开一条 ~0.7 mm 宽的槽；**跨越该槽的 L1 走线 2 段**（`$3N526`@37.2 mm、`$3N702`@41.6 mm，都是模拟网）。
  该走线只供 `R9/R10` 分压（165 µA），**电学影响很小**；建议改到 L1 沿 AGND/GND 边界走，或接受并记录。

## §8 EMC / EMI

| 项 | 量化 | 级 |
|---|---|---|
| `J5.29` 单地针承担 21 线 + 背光回流 | 8 就近过孔缓解；上板用地弹实测 | 中 |
| 模数隔离带 **5.97 mm**（判据 ≥10 mm） | 门限 1.5 mV ⇒ 直接判据 | **P1** |
| `AGND↔GND` 0.127 mm | 桥接 + 24 mm 近距耦合边 | **P1** |
| 电感由**非屏蔽鼓芯**换**一体成型** | 自屏蔽 ⇒ **漏磁显著下降（改善）**；但共轴摆放的**互耦**仍在（§2.4） | P2 |
| 总线 `D1` 62 mm 环路 | 有 33Ω，自干扰风险低 | P2 |
| `+3V3` 槽 | 见 §7 | P3 |
| 整机辐射认证 | 赛题无要求 ⇒ 风险是"自干扰" | 低 |

## §9 散热

- 器件级：`U1` ≤20 mW、`R21` 0.12 mW、其余 <1 mW ⇒ **无器件散热风险**。
- 工艺级（P2）：地铺铜**直接连接**（`connectMode=0`）⇒ 手焊时烙铁热量被 77 cm² 铜面抽走，地脚难上锡。
  **建议改十字连接**（改前请在 EDA 里目视确认 `connectMode` 语义）。

## §10 丝印与装配

- **自由文字 = 0 条**（236 个丝印对象**全是** attribute）⇒ **没有板名/版本/日期/装配说明**。
- **21 处位号倒置**（`EVK1` 侧向 + 底层 `R12`/`R22~R42` 反向）；**9 处丝印压盘**。
- **新发现（P3）**：`L7` 的**器件名丝印仍印着 `XR0630-220M`**，且正压在 `L7.2` 焊盘上 —— 而实物是 **15 µH** ⇒ 装配误导，建议删掉/改成 `15µH`。
- 建议补的丝印（沿用 `54/57`，一条都没做）：板名/版本/日期 · **"33Ω 贴 MCU 侧"** · **"`PB0` 严禁 PWM"** · `J1 = 50Ω IN` · `TP3/4/5` 功能 · 安装孔 `NPTH Ø3.2`。
- 极性件 `C11`/`C16`（钽）封装内丝印**读不到**，仍需目视确认。

## §11 封装 / BOM 与实物一致性

| 项 | 状态 |
|---|---|
| 原理图↔PCB 脚级 | **65/65 件、68/68 网、0 不符**（本轮用 20:29 网表 + 20:29 快照重算） |
| `C3/C5/C7/R11` 料号（上轮修的） | 已闭环 ✓（`CC0805KRX5R8BB106`/`C1952586`、`0805W8F3000T5E`/`C17617`） |
| **`L7`（新）** | **三字段不一致**：`Value=15µH` ↔ `MPN=HCM0630-150M` ↔ `LCSC=C9900009031`（库内 `MPEV1D0630L150`，封装 `W6.5`，板用 `W6.6`）⇒ **P1，下单前必须对齐** |
| `L1/L3/L5`（新） | `XR0630-4R7M`/`C5307631`、`XR0630-220M`/`C5307626` 自洽 ✓ |
| 电感容差口径 | 实物为 **M 档 ±20%**（不是文档写的 ±10%）⇒ 报告/PPT 要改 |
| `R6` | `RT0805BRD0753K6L`（0.1%/25 ppm 由料号隐含），但**属性字段空** ⇒ 建议补齐 |
| 转接板 I²C 上拉 | 底板 `R15/R16` 已删 ⇒ 依赖转接板 `R9=4.7K`（**通用版原理图已确认存在**）✓ |
| 转接板背光 | 通用版 = `SI2302` 直驱（**无镇流**）⇒ 与屏规格"恒流 60 mA"不符 ⇒ **P1 待实物确认** |
| 屏 `VCI` 电压 | 规格书自相矛盾（2.8 V vs 2.8–3.3 V），需实测（沿用 `55 §4.3`） |
| 转接板 `IM[2:0]` | 6 个 0Ω，上电前万用表核（贴错 = 乱码） |

## §12 制造工艺与 DFM（本版实测）

- **DRC `passed=true` / 0 违规**（`pcb drc --project G2026`）。
- **DFM 自检：0 ERROR / 36 WARN** —— `silkFlipped 21` · `silkOverPad 9` · `widthMismatch 7` ·
  `overPad 1`(`R2.1`) · `decapTooFar 1`(`C11`) · `widthUnderSpec 1` · `fiducialMissing 1` · `powerNotPoured 3`(误报)；
  `viaInPad / dangling / clearance / acute / coupling / singleLayerVia / netlessPour / floatingIsland` **全 0**。
- 铜到板边 10 mil（P2）、过孔环 6 mil ✓、113 个金属化孔最小环宽 9.35 mil（前版数据，本轮 dump 未含孔字段）。
- 安装孔已 NPTH ✓；无 Mark 点（可接受）。
- **两个已证 DRC 盲区仍成立**：① "焊盘有网、板上无网"（网表不同步）抓不到 ⇒ 本文用**本地逐脚比对**补上（0 差异）；
  ② `Pad Hole Ring` 检查项为空 ⇒ 改过孔/封装后必须桥读孔径。

---

## §13 问题总表（按严重程度分级；★=直接影响精度/测量准确度）

| # | 级 | 问题 | 位置 | 精度 | 状态 |
|---|---|---|---|---|---|
| 1 | **P1** | 增益改 ×4 后**必须重标定**；标定残差需按 **L7=15µH** 复跑（现 0.383 mV 是 12 µH 口径） | 流程 + `op_cal` | **★** | 未做 |
| 2 | **P1** | `L7` BOM 三字段不一致 + 丝印印旧名 `XR0630-220M` | L7 | ◐ | 未做 |
| 3 | **P1** | 背光驱动方式未确认（通用版无镇流 vs 规格恒流 60 mA） | 转接板 | ◐ | 待实物 |
| 4 | **P1** | `+3V3`=ADC 基准 且被屏/背光共用 ⇒ 背光开/关谱底差未测 | 全板 | **★** | 待实测 |
| 5 | **P1** | `SCREW3` 在 AFE 岛中央 (40.64, 46.53) | SCREW3 | — | 未改 |
| 6 | **P1** | `AGND↔GND` 铜隙 0.127 mm（DRC 不报） | POUR6↔POUR2 | ◐ | 未改 |
| 7 | **P1** | 模数隔离带 5.97 mm < 10 mm（门限 1.5 mV） | LCD_BL_CTL→C11 | **★** | 未改 |
| 8 | **P2** | L3/L5/L7 共轴（违反正交规则）；估 k 0.5–3% ⇒ 阻带 −1~−5 dB | AFE | **★** | 本文新发现 |
| 9 | **P2** | `LCD_D1` 62.0 / `LCD_RS` 60.8 越硬上限；`D0/D2/RD` 越 40 mm | 总线 | ◐ | 未改 |
| 10 | **P2** | 规则 `trackTrack 4.02 mil` / `copperToEdge 10 mil` 比厂能力松 | 规则 | — | 未改 |
| 11 | **P2** | 地铺铜焊盘连接 = 直接连接（手焊散热） | 规则 | — | 未改 |
| 12 | **P2** | `R7`→`U1.6` 3.67 mm；`-in` 节点 7.05 mm | AFE | ◐ | 未改 |
| 13 | **P2** | `+5V` 仅 22 µF 钽；`J5.30` 旁无 22–47 µF | 电源 | ◐ | 未改 |
| 14 | **P2** | `R1`→`J1` 8.75 mm（端接点不在输入端） | 输入 | **★** | 未改 |
| 15 | **P2** | `C10`→`PA1` 9.53 mm / `R11`→`PA1` 11.52 mm | ADC | **★** | 未改 |
| 16 | **P2** | 文档口径错：旧件"非屏蔽"误写"屏蔽"；L 容差 ±10% 误（实为 ±20%） | 54/55/56/报告 | **★** | 未改 |
| 17 | **P3** | 丝印 0 自由文字 + 21 倒置 + 9 压盘 | 全板 | — | 未改 |
| 18 | **P3** | `+3V3` 在 L2 穿过 AGND 22.13 mm（槽） | x=14.76 mm | ◐ | 本文新发现 |
| 19 | **P3** | `J5.23`(`T_CS`) 悬空 | J5.23 | ◐ | 未改 |
| 20 | **P3** | `R6` 容差/温漂字段空；`R7` 温漂字段 ±5 ppm 与 R6 不一致 | 属性 | ◐ | 本文新发现 |
| 21 | **P3** | 底板触摸 I²C 无上拉（依赖转接板） | I²C2 | ◐ | 已确认可接受 |
| 22 | **P3** | 无 Mark 点 / `R2.1` 压盘 / 7 处线宽突变 / AGND 10 mil 短段 | 全板 | — | 可接受 |
| 23 | **P3** | 板框为圆角矩形，工具读不全（需目视确认闭合） | 板框 | — | 待确认 |

## §14 建议动作（按"先做哪个"排序）

| 序 | 级 | 动作 | 验证方法 |
|---|---|---|---|
| 1 | **P1** | **`L7` 料号对齐**：把 `MPN` 改成与 `LCSC C9900009031` 一致的 `MPEV1D0630L150`（或反之，并确认封装 W6.5/W6.6 是否同焊盘）；**删掉/改写 L7 的旧器件名丝印** | `easyeda lib by-lcsc` 回读 + `bom export` 29 行复核 |
| 2 | **P1** | **投板前复跑标定残差**（L7=15 µH 口径）并**把"重标定"写进上板流程** | 复跑 `cal_resid_opt.py`（需 numpy/scipy）；上板跑 `56 §14-1` 的 41 个非表点 |
| 3 | **P1** | **确认转接板版本**（有 `LP3321B6F`+4.7 µH ⇒ 恒流版；只有 `SI2302` ⇒ 通用版，需改驱动或加镇流） | 目视 + 测 `LED−` 电流 54–66 mA |
| 4 | **P1** | **实测背光开/关的 ADC 谱底差**（判据 <0.5 mV） | 输入端 50Ω 终端 + 频谱底对比 |
| 5 | **P1** | **`SCREW3` 移到左上角**（与另三孔对称） | `pcb drc` + 目视 |
| 6 | **P1** | **`AGND` 颈两侧加禁铺铜区**，间隙 ≥0.5 mm（建议 1 mm） | `pcb drc` + 复跑 `ref_plane_check.py` |
| 7 | **P1** | **`LCD_BL_CTL` 绕开 `C11`**，隔离带 ≥10 mm | 复跑 `audit_r5.py §5`（数字线↔AFE 距离） |
| 8 | **P2** | **`L5` 转 90°**（恢复相邻正交），或**不改并记录**，把 u_J 1.5 MHz 实测列为投板后第一项 | `audit_r5.py §4`（轴向角）+ 上板 `56 §14-7` |
| 9 | **P2** | 规则收紧：`trackTrack → 6 mil`；`copperToEdge → 12 mil`；地铺铜改**十字连接** | `pcb config get` 回读 + `pcb drc` |
| 10 | **P2** | `+5V` 并 10 µF X5R + 100 nF；`J5.30` 旁补 22–47 µF | 纹波/谱底实测 |
| 11 | **P2** | `R1` 往 `J1` 收（≤3 mm）；`C10` 往 `PA1` 收（≤5 mm） | 复跑 `audit_r5.py §3` |
| 12 | **P2** | **文档口径修正**：旧件非屏蔽、新件一体成型、L 容差 ±20%、共轴已评估 | 改 `hardware/54/55/56` 与答辩 PPT 对应页 |
| 13 | **P3** | 补丝印（板名/版本/"33Ω 贴 MCU 侧"/"PB0 禁 PWM"/`J1=50Ω IN`/TP 功能/NPTH Ø3.2）；位号转正 21 处、移 9 处压盘 | `pcb check` 丝印项归零 |
| 14 | **P3** | 归档 `XR0630`/`HCM0630` 的**感值温漂与 Q/SRF**（现只有容差/电流/DCR） | 器件手册 → `_work`/`docs` |
| 15 | **P3** | 确认板框闭合 + 上板前万用表核转接板 `IM[2:0]` + 钽电容极性目视 | 目视/万用表 |

**收尾闭环（只读、可复跑）**

```bash
easyeda pcb drc   --project G2026            # ① 应保持 passed=true
easyeda pcb check --project G2026            # ② DFM 计数不应回升
easyeda pcb dump  --project G2026 --include-copper --out _work/pcb_audit_r5_20261011/pcb.json
python _work/pcb_audit_r5_20261011/audit_r5.py     # ③ §2.6/§4/§7 几何判据
python _work/pcb_audit_r5_20261011/audit_r5b.py    # ④ 网络长度/地回流/+3V3 槽
python _work/pcb_audit_r5_20261011/mutual_coupling.py   # ⑤ 互感敏感度（改了电感摆放后必跑）
easyeda sch netlist --project G2026          # ⑥ 重导网表 → 与 PCB dump 逐脚比对
```

---

## §15 诚实边界

1. **本文全部"实测"= 活体快照/网表读数**；凡标"待实测/待确认"的（谱底、互感 k、INL、板框闭合、转接板版本）
   **都是装置制造后才可判定**的，一律按三态口径记"**未验证**"。
2. **互感 k 是估计**（0.5–3%）：`mutual_coupling.py` 给的是**敏感度**（dB/%），不是实测 k；
   `_work/ind_sel_check/results.md` 的 MC **未计入互感**。结论"仍达标"依赖 k 的估计区间。
3. **`+3V3` 槽的影响是定性判断**（2 条模拟线跨越、电流 165 µA）⇒ 判 P3；未做场仿真。
4. **本轮未能复跑 `cal_resid_opt.py`**（本机 `python`/uv 3.12 均无 numpy/scipy）⇒
   "标定残差 0.383 mV" 仍是 `hardware/57` 的 **12 µH 口径**，换 15 µH 后需复跑。
5. **未做**：SI/EMC 场仿真 · 热仿真 · 3D 干涉 · ADC 的实测 INL · 板级噪声实测 · 阻抗计算
   （本板无需）· 拼板/工艺边。
6. **`connectMode=0` 的语义**仍按 EasyEDA 通行约定判"直接连接"（`54 §8.4` 的保留意见继续有效）。
7. 与本文件冲突时：**几何/网表数字以本文快照为准**；**误差预算仍以 `56`/`57` 为准**（本文只补增量与口径修正）。

## §16 依据索引

| 主题 | 出处 |
|---|---|
| 本轮 PCB 快照 | `_work/pcb_audit_r5_20261011/pcb.json`（sha `ce89ef0f…`） |
| 本轮网表 | `.easyeda/artifacts/20261011-202945-schematic_netlist-c708521a.enet` |
| DRC / DFM / 规则 | `_work/pcb_audit_r5_20261011/{drc,check,drc_rules,config}.json` |
| 几何/电气判据脚本（可复跑） | `_work/pcb_audit_r5_20261011/{audit_r5,audit_r5b,mutual_coupling}.py` + `geo_report*.txt` |
| 上轮 PCB 全量复审（16:07 版） | `hardware/54-PCB全量复审-20261011.md` |
| 交叉评审（需求/代码/模块） | `hardware/55-PCB交叉评审-需求代码模块三视角-20261011.md` |
| 精度专项（误差预算） | `hardware/56-精度专项评审-5mV与频率带宽-20261011.md` |
| 优化方案 v2（B1/D1 已执行） | `hardware/57-智能优化方案-精度与鲁棒性-20261011.md` |
| 电感选型/替换证据 | `_work/ind_sel_check/results.md` · `hcm0630_study.md` |
| 转接板（通用版）原理图渲染 | `_work/_pcb_now/adapter_general.png` |
| 屏规格书 / 核心板原理图 | `docs/TK035F5687_9629_整理资料_(含SPI及并口版)/…` · `docs/立创·梁山派·天空星STM32F407VET6开发板资料（标准库）/…` |
| 赛题判据 | `docs/G题_周期信号测量分析装置.pdf` |
| DSP 口径（fs/N/标定） | `docs/01_软件架构与DSP方案.md` |
| 嘉立创 2 层工艺能力 | skill `jlcpcb` |
