funiang-x/G2026/hardware/01-requirements.md

# G2026 硬件方案 · 01 需求冻结（约束表）· v2

> ⚠️ **2026-10-03 题面口径勘误（读原文得到，以 `27-优化方案与仿真验证-20261003.md` §1 为准）**：
> 题面**要求 1（u_a）的频率成分是 10kHz~200kHz**，**要求 2/3（u_b）才是 10kHz~500kHz**。
> 下表第 2 行写的"全部 10kHz~500kHz"是**把两个场景混成一个**了。
> 设计按 500kHz 做（对 u_a 是保守的，无危害），但**报告里必须分开写**，否则会被问"u_a 为什么要 500k 的带宽"。
>
> ⚠️ **2026-09-30 勘误指针**：本篇的 `fc=800kHz` / L·C 元件值 / `×4 前端增益` 均为**定稿前旧口径**；
> 图纸实落 = fc≈648kHz（L=4.7/22/22/12µH，C=5.6/10/10/1.8nF），增益已改 **×8（净增益≈2.0）**。
> 以 `14-全链路审核-20260930.md` 与 `15-评审与开发-20260930.md` 为准。
>
> 项目：G题 周期信号测量分析装置 · 阶段一选型 · 2026-09-28
> v2 变更（2026-09-28 用户拍板）：**前端架构解冻**（"你来一个最优解"）；板卡形态 = **STM32 核心板 + 底板**；**手焊**；手头有 **OPA2197**。
> DSP 判据仍冻结：fs=2.0MHz / N=4096 / BH4 / 5mV·1kHz 误差判据 / 500Hz 分辨率（依据 `../docs/01_软件架构与DSP方案.md`）。
> 状态：**待 [CHK] 人确认**

## 1. 工程约束表

| # | 约束项 | 值 | 来源 |
|---|---|---|---|
| 1 | 功能 | 波形页(1T/3T)/参数页/定性谱页/谱线表页 × u_a、u_b、u_b+J 三场景；触摸键控（外置按键已取消） | 题面 + 用户拍板 |
| 2 | 信号带宽 | 被测信号全部频率成分 10kHz~500kHz；单频干扰 u_J ≥1MHz、**200mVpp**（按题面不打折） | 题面 |
| 3 | ADC | MCU 片内 ADC1，12bit，fs=2.0MSPS（核心板 F407VGT6，TIM8 触发） | 软件文档 §4（冻结） |
| 4 | 幅值精度 | Upp/Urms/谱线幅值 绝对误差 ≤5mV；基频 ≤1kHz | 题面 |
| 5 | 模拟前端（判据级） | ① 折叠带（起点 fs−f_max=1.5MHz）衰减 ≥42.5dB（=残留不过 1.5mV 峰门限反解，见 02 §3）；② 带内 10k~500k 传函 LTI（可标定）；③ **增益级前必须先滤除 u_J**（防 IM3 入带）；④ 输入 BNC+50Ω 端接（端接的 ×0.5 同时是最便宜的抗混叠增益）；⑤ 单 5V 供电，1.65V 偏置轨 ratiometric 于 VREF | v3 链路 02 §3 |
| 6 | 显示 | 3.5″ 320×480 ST7796S，FSMC 8080-16bit；题面 ≥6″ 条款偏差用户已拍板接受 | 用户拍板 |
| 7 | 触摸 | FT6206(FT6x06)，I2C2（PB10/PB11），INT=PC5 | 既有固件/模组 |
| 8 | 供电 | 单路 5V 直流稳压电源；模拟/数字 LC 分割 | 题面 + 软件文档 §9 |
| 9 | 板卡形态 | **核心板 + 底板**；核心板 = **立创·天空星 STM32F407VGT6 高配版**（VREF+ 三路可选 R1/R2/R4：板载基准/排针外部基准/主电源磁珠；板载 LDO SCJA1117B-3.3 自供；双排针引出 ~70 IO；AGND-DGND 0Ω 单点） | 用户确认 2026-09-28 + lckfb Wiki |
| 10 | 焊接工艺 | **手焊** → LQFP（核心板出厂）/SOIC/TSSOP/SOT-23/SOT-223/0805/1206/通孔，禁 QFN/BGA | 用户拍板 2026-09-28 |
| 11 | 成本上限 | [TBD-3] 底板 BOM ≤¥100 量级（v2 已把模拟+电源压到 ≈¥15，不含屏/核心板） | 假设待确认 |
| 12 | 交期 | [TBD-4] 无硬交期（复盘练习项目） | 假设待确认 |
| 13 | 供应链 | [TBD-5] 默认混合：模拟/主控 TI·ST，电源/被动/连接器国产通用件 | 假设待确认 |
| 14 | PCB 层数 | [TBD-6] 底板 2 层 vs **4 层（建议）**——mV 级模拟与 FSMC 共板，完整 GND 平面根治回流/EMI；差价量级几十元（下单复核） | ✅ **已拍板：2 层**（2026-10-01；补偿措施见 `16 §4-1` / `22`） |
| 15 | 环境 | 室内实验/竞赛现场，无温湿度/EMC 认证要求 | 题面语境 |

## 2. 关键推导（约束 → 器件门槛）

- 滤波器：折叠带起点 1.5MHz 处需 ≥40dB（复算报告 §1：8 阶 BW fc=800k 给 −43.7dB ✓）——
  **有源实现需 GBW≥205MHz 运放（SK 规则 100×f0×Qmax），无源 LC 实现零运放门槛** → v2 走 LC。
- 增益级：×4 闭环带宽 ≥5×800kHz → GBW ≥16MHz？不必——通带 droop 是 LTI 可标定项，
  OPA2197 的 10MHz（闭环 2.5MHz，−0.17dB@500k）+ 17 点标定即可（复算报告 §5）。
  压摆率需求 0.79V/µs ≪ 20V/µs（复算报告 §6）。
- 峰检测门限联动：折叠残留最坏 1.31mVpk < 1.5mV 门限（余量薄，verify_dsp.py 重跑时复核门限取值）。
- 3.3V 轨预算 ~0.15A（LCD 数字+触摸；核心板自供 MCU；背光走 5V）。
