funiang-x/G2026/hardware/02-architecture.md

# G2026 硬件方案 · 02 架构候选与冻结声明 · v3

> ⚠️ **2026-09-30 勘误指针**：本篇 §3 的电平预算漏算了两个 ×0.5（端接 + LC 双端接插损），
> 实际净增益 = 0.5×0.5×运放增益；2026-09-30 运放级已改 **×8**（R6 69.8k），净增益 ≈2.0，
> ADC 摆幅 ±250mVpk 量级。以 `14-全链路审核-20260930.md` §3-B 与 `15-评审与开发-20260930.md` 为准。
>
> ⚠️ **2026-10-02 勘误指针（更新，以 `25-独立评审与优化-20261002.md` 为准）**：
> ① `VREF+` 实为 **≈3.3V**（不是 3.0V）——核心板 `R4=47Ω` 由 `VDDA` 供，板载 `REF3030` **不贴**；
> ② 本文 §3 的"滤波器输出回到 0V DC"**错**：直流点是 `VBIAS`（见下表 AC 耦合 2 行），
>    现已由 `C23` 串入 `R4` 地侧断掉梯内 16.4mA 直流；
> ③ 偏置的**取用点**从核心板排针 `REF` 针改为底板 `+3V3`（那根针官方默认悬空）。
>
> 阶段一选型 · 2026-09-28 · 状态：**待 [CHK] 人确认**
> v3 变更：前端链路按"逐级跟随/隔离/偏置"重排（补输入跟随器、明确每级职责与电平预算）；
> fc=800k 给出反解推导（不是沿用文档的拍板值）；核心板确认天空星高配版。

## 1. 冻结范围声明

- **仍冻结**：DSP 全链（fs=2.0MHz、N=4096、BH4、单点 DFT 口径、17 点标定、5mV/1kHz 判据）。
- **解冻（2026-09-28 用户拍板）**：模拟前端实现路线。判据级要求见 01 §1 第 5 行。

## 2. 前端实现路线三案

| 案 | 构成 | 结论 |
|---|---|---|
| A 有源 8 阶（初案） | TLV3544（200MHz）4×SK + 增益 | 排除：GBW 205MHz 门槛贴线、Q=2.56 稳定性风险、u_J 未滤先入运放 IM3 |
| C 无源 LC 无跟随（v2，被否） | LC 直接挂电缆 | 排除：LC 输入端无隔离，端接节点被滤波器阻抗起伏与 TVS 容性扰动；无输入跟随 |
| **B 无源 LC + 逐级缓冲 + OPA2197（v3，定案）** | 见 §3 | **定案** |

## 3. 前端 v3 信号链（逐级职责与电平预算）

```
BNC ─ TVS(≤5pF) ─ 50Ω端接(1%) ─ AC耦合100nF/10k ─ ►BUF1（OPA2197半A，G=1）
                                                       │ 50Ω 串联端接电阻
                                                       ▼
                        LC 8阶巴特沃斯 fc=800k（50Ω 系统，双端接，L/C E24 值见复算报告 §2）
                                                       │ 50Ω 负载电阻(1%)
                                                       ▼
                              AC耦合100nF/10k ─► GAIN（OPA2197半B，同相×4，+in偏置1.65V）
                                                       │ 100Ω + 470pF(C0G)
                                                       ▼
                                                    ADC1（fs=2.0MSPS）
1.65V 偏置轨：REF3033(3.3V=VREF) → 10k/10k 分压 → 10µF 去耦 → 10k 偏置电阻喂两级 +in
              （ratiometric：VREF 漂移对幅值测量自动抵消；自检走备用 ADC 通道采 1.65V）
```

**逐级"为什么"（v3 的主见所在）：**

| 级 | 职责 | 不这样做的后果 / 依据 |
|---|---|---|
| TVS ≤5pF | 静电防护，容性不伤通带 | 普通 TVS 数十 pF → 500kHz 相位/增益漂移不可控 |
| 50Ω 端接 | 匹配题面 50Ω 电缆；电平与源阻抗无关；**×0.5 同时是链路里唯一免费且无失真的抗混叠增益**（折叠残留减半：2.62→1.31mVpk） | 不端接：残留翻倍 >1.5mV 峰门限，须抬门限、伪峰风险 |
| AC 耦合 1（100nF/10k，fc=159Hz） | 隔源端 DC 偏移，把单电源域入口偏到 1.65V | 直耦：输入 CM 摆到 −112mV 出轨（u_b+u_J 反相叠加最坏） |
| **BUF1（G=1）** | 高阻读端接节点（端接值精确）、低阻经 50Ω 串联电阻驱动 LC；G=1 输出摆幅最小 → 对未滤除的 u_J 处于最线性区 | v2 缺此级：LC 直接挂电缆/TVS 节点，端接与滤波器输入阻抗互相扰动 |
| 50Ω 串联 + LC + 50Ω 负载 | 双端接梯形：低元件灵敏度、无稳定性问题、@1.5M −43.7dB | 有源 8 阶：需 GBW≥205MHz 运放 + Q 稳定性风险 |
| AC 耦合 2 | 滤波器输出经 C9 隔直、抬到 VBIAS 进增益级。**2026-10-02 更正**：滤波器的直流点就是 VBIAS（电感在直流上等于短路，"回到 0V DC"是错的），真正断直流的是串在 `R4` 入地侧的 **C23(10µF)** ⇒ 梯内直流电流 = 0（修前 16.4mA） | 单电源域必需 |
| **GAIN（×4）** | 滤波后才加增益 → 运放只见带内 ±62.5mVpk，u_J 已 −43.7dB → IM3 无从产生；同相输入高阻兼作滤波器的终接隔离（"后跟随"的职责由本级输入完成）；低阻输出经 100Ω 直驱 ADC（"后跟随"的驱动职责由本级输出完成） | 增益前置：u_J ±400mVpk@≥1MHz 打进运放，IM3 产物落带内且**滤波器无法去除**（失真产生在滤波器之前） |
| 100Ω+470pF | ADC 开关电容 kickback 隔离；Rsrc=100Ω ≤1.1kΩ（SMP=3 要求） | 无：采样电荷反冲在 ×4 输出产生建尖 |
| 不加第三管（输出跟随） | ×4 已是低阻驱动，再串 G=1 只多一级 droop 与失真源，零收益 | 主见：拒绝为"结构好看"加管 |

**电平/动态预算表**（最坏 = u_b 250mVpp ⊕ u_J 200mVpp 同相，全部脚本复算于 `verify_afe_v2_report.md`）：

| 节点 | DC | 最坏交流 | 核算 |
|---|---|---|---|
| 端接节点 | 0V | ±112mVpk | 50Ω/50Ω |
| BUF1 出 | 1.65V | ±112mVpk | SR 1.8 ≪ 20V/µs，小摆幅线性区 |
| LC 出 | 0V | 带内 ±62.5mVpk；u_J 残留 0.33mVpk(@1.5M) | −43.7dB@1.5M |
| ×4 出 = ADC | 1.65V | ±250mVpk | SR 0.79V/µs；摆幅 1.40~1.90V；轨余量 1.4V |
| 折叠残留@ADC | — | 最坏 **1.31mVpk** | < 1.5mV 峰门限 < 5mV 判据 ✓ |

## 4. fc=800kHz 的理论依据（反解，非沿用）

- 唯一硬频率：折叠带起点 **f_fold = fs − f_max = 1.5MHz**（≥1.5MHz 的干扰才折进分析带；[1.0,1.5)M 的镜像落 [0.5,1.0)M 带外；1.0M 整落 Nyquist bin 丢弃）。
- 残留约束：伪峰不过峰门限 → 100mVpk(u_J) × 0.5(端接) × |H(1.5M)| × 4(增益) ≤ 1.5mV
  → **|H(1.5M)| ≤ 0.0075 即 −42.5dB**。
- n 阶巴特沃斯解：[1+(1.5M/fc)^2n]^−½ ≥ 0.0075 → n=8 得 **fc ≤ 813.7kHz**；n=6 得 fc ≤ 663kHz。
- **fc=800k = 门限反解出的最大标准值**（留 0.9dB 余量）；此时通带 @500k 仅 −0.003dB（标称读数即准，利调试）。
  n=6/650k 省 2 个元件但通带 −0.18dB（标称口径失真，只能标定后读数）——为调试期可用性取 n=8。
- 上限验证（复算报告 §1）：−43.7dB@1.5M ✓ −15.6dB@1.0M（镜像带外）✓ −79dB@2.5M ✓。

## 5. 核心板（立创·天空星 F407VGT6 高配版）对本设计的事实

| 事实 | 对设计的影响 |
|---|---|
| **VREF+ 三路可选**（R1/R2/R4 贴法：板载基准 / 排针外部基准 / 主电源磁珠） | REF3033 走**排针外部基准**贴法注入——官方支持路径；具体电阻位/排针脚阶段二对原理图确认 |
| 板载 LDO SCJA1117B-3.3（钽电容）自供 MCU | 底板 AMS1117 只供 LCD 数字/触摸，不加载核心板 |
| 5V 排针/Type-C 共用过流保护+防反接+钳位(~13V) | 底板 5V 排针馈入即可，无需重复保护 |
| AGND–DGND 0Ω 单点在核心板 | 底板模拟地与核心板 AGND 的连接点阶段二定（经 0Ω/磁珠） |
| 双排针 ~70 IO + 2×5P 调试口（SWD+SWO+串口1+5V/3.3V，排针随板未焊） | pinout 空间足够；**提醒：调试排针记得焊** |
| 板载 W25Q128 SPI Flash / TF 卡 / 用户键 | op_flash 持久化可迁 W25Q128（比片内 Flash 擦写友好）；BOOT/NRST 板载齐备 |

## 6. 优化记录（多方面扫描，全部量化后裁决，脚本 `report_opt.md`）

### 6.1 采纳（零成本或纯收益）

| # | 优化项 | 方面 | 收益/理由 | 落点 |
|---|---|---|---|---|
| O1 | **采样窗静默**：engine 的 2.048ms 采样窗内暂停 LVGL/FSMC 刷新与触摸轮询 | 软件×硬件协同 | 机制性消除"采集瞬间 LCD 总线开关噪声灌进 AFE"这一最大板内干扰源；三任务架构天然支持，成本≈0 | 交接 `../docs/01` 修订一条 |
| O2 | **背光恒亮，禁 PWM** | 干扰源管理 | PWM 谐波列全落 10k~500k 分析带 → 固定频率伪峰源；竞赛装置无需调光 | 底板背光驱动恒亮 + 软件不调 |
| O3 | **测试点组 ×6**：端接节点 / LC入 / LC出 / ×4出 / 1.65V轨 / AGND | 可调试性 | 扫频标定（§11）与上电自检的物理基础；没有它们 R5 风险无从验证 | 底板 BOM 加 testpoint |
| O4 | **电感正交摆放 + 间距 ≥2mm** | 布局 | LC 梯形低灵敏度≠零灵敏度：互感会改高节频响；零成本降 R4 | 阶段二布局约束 |
| O5 | **标定表迁 W25Q128** | 存储可靠性 | 擦写寿命/掉电安全优于片内 Flash；板载现成 | 03 结论表 #12 |
| O6 | **AFE 分区 + 模拟地平面完整 + 单点接地** | 布局 | 星点与核心板 AGND 0Ω 汇合点对齐；REF/偏置走线最短 | 阶段二布局约束 |
| O7 | **FSMC 总线 33Ω 串阻 + 降速余量** | EMI 源头 | 总线飞线/排线边沿振铃的谐波落分析带；串阻阻尼+预留降速档（LVGL 帧率不敏感） | 底板 33Ω×N（✅ **已定 N=20 并落图** `R22`~`R41`，2026-10-01/02） |
| O8 | **0Ω 断点 ×3**：BUF1 入 / ×4 出→ADC / VREF 注入 | 可调试性 | 与 6 测试点配合，把 AFE/ADC/基准三段解耦，分治排障 | 底板 0Ω×3 |
| O9 | **LCD 模块刚性固定**（官方转接板/双排母直插，禁杜邦飞线） | 可靠性+SI | 16bit 总线走飞线=振铃+接触不良；转接板资料已在 docs/TK035 | 装配约束 |
| O10 | **板间多 GND 针 + ~~底板 5V 入口 SS34+自恢复保险~~** | 回流/防护 | 跨板回流阻抗↓ | 排针 GND 占满。⚠️ **2026-10-04**：底板 5V 入口件（`J3`/`F1`/`D2`）**已从图上删除**，本板改由**核心板 Type-C 供电**（`38 §3.2-①`）⇒ 这一半作废 |
| O11 | **底板 4 层工艺（完整 GND 平面）** | PCB 工艺 | mV 级模拟与 FSMC 共板，完整地平面根治回流/EMI；嘉立创 4 层差价下单复核（量级几十元） | ✅ **已拍板 = 2 层**（2026-10-01）；本条转为"2 层的补偿措施"（`16 §4-1`、`22` 号文档） |

### 6.2 量化后拒绝（防返工，数字在 `report_opt.md`）

| 候选 | 收益 | 拒绝理由 |
|---|---|---|
| fs 微调 K=71（2.0282M） | 残留 1.31→1.13mV | 收益 0.18mV，代价=软件文档全部 DSP 复算重跑回填；K=64~70 更优但 Δf>500Hz 违规 |
| 增益 ×4→×6 | 0.0004 mV | 量化噪声本就可忽略；白吃回归面 |
| 输入串 100Ω 加强保护 | — | 须改 100Ω 系统梯形，增益同步 ×8 → 残留反升 1.31→1.74mV；TVS+50Ω 端接已够 |
| 双帧变频识别 u_J | 残留→~0.1mV，余量→30× | 收益最大但回归面最大（§5/§6 重写+全重跑）；挂「精度拉满」可选项，余量 3.8× 下不做 |
| **内置 DAC 标定源**（DDS→模拟开关→AFE 输入） | 现场自标定不依赖外部信号源 | **不可行**：F407 DAC 建立 ~3µs（DS8626，复核✓），500kHz 正弦周期 2µs，模拟输出跟不上；寄存器可写 10.5MSPS（AN4566）但模拟域不建立=幅值未知，标定源必须幅值已知 → 毙。且生成器竞测必然在场（u_b+u_J 必用） |
| 双 ADC 交替采样提 fs | 翻案 fs=2.0M 冻结参数 | 拒 |
| 温漂对抗（TCXO/低温漂基准） | 判据无关（±20ppm=0.5Hz@25kHz vs 1kHz 判据） | 拒 |

### 6.3 Plan B 挂起（触发条件制）

- **椭圆（Cauer）n=6 滤波器**：零点@1.5M + Amin=50dB → 残留 0.63mV、余量 7.8×，且比巴特沃斯 n=8 少一个电感。
  不先做的理由：元件值非 E24、零点随容差漂移、DSP 文档滤波器模型要改。
  **触发条件**：板到手扫频标定后，混叠残留实测 > 预算，或竞测发现 u_J 相关伪峰 → 启用重设计。
