funiang-x/G2026/hardware/04-pinout连接表.md

# G2026 硬件方案 · 04 pinout 表 / 模块连接表 / 电源树（阶段二交付物）

> 2026-09-28 · pinout 表是硬件（EDA）与软件（CubeMX / board_config.h）的**单一真相源**。
> 依据：`firmware/Core/Inc/board_config.h`（45 脚登记）+ `firmware/G2026.ioc`（52 实脚）+
> TK035F9629 规格书 v1.2（45 脚 FPC 权威表）+ ST7796S_SPEC V1.0（IM 表）。
> 状态：**待 [CHK] 人过目**（重点：物理排针映射、CTP FPC 脚序两项 TBD）。

## 0. 两项勘误（引脚真相对齐时发现）

1. board_config.h 屏注释写"40pin FPC"，实测 TK035F9629 = **45 脚 FPC**（P.5 图 + P.9-11 表）。
   待改 board_config 注释（改注释不改宏，属文档修正，随 [CHK] 一并做）。
2. ST7796S 8080-16bit 的 IM 绑法（SPEC P.42）：**IM2=0 / IM1=1 / IM0=0**。
   厂家通用转接板 IM 全拉 3.3V 是 4-line SPI 绑法（串口版用），底板不得照抄。

## 1. pinout 表（单一真相源；MCU 引脚 → 去向）

命名规则 `功能_信号`；全部 FSMC/AF 号对照 RM0090 与 .ioc，无凭记忆项。

### 1.1 底板连接引脚（经核心板排针 → 底板连接器 H1/H2）

| MCU 引脚 | 复用/功能 | 方向 | 网络名 | 接什么 | 备注 |
|---|---|---|---|---|---|
| PA0 | —（核心板 SW2 按键占用，底板不接） | — | — | EVK1.3 打 NO_CONNECT | **2026-09-30 D1 修复**：SW2 电路污染模拟输入，信号让位（佐证链见 15 号 §2.1） |
| PA1 | ADC1_IN1（.ioc=ADCx_IN1） | 入 | AFE_ADC_IN | U1B ×8 出（经 JP2） | SMP=3 ADCCLK；**2026-09-30 D1 修复**自 PA0 挪入 |
| PC4 | —（**2026-10-05 已整体拆除**） | — | — | 图上 `EVK1.9` 打 NC；`.ioc` 条目已删（PinsNb 52→51）；`BOARD_VBIAS_SENSE_PORT/PIN` 登记宏已删 | **死线清理**：固件从未读它，"轨在线"判据走 AFE 帧直流均值（`BOARD_VBIAS_SENSE_CODE_MID`，`bsp_adc.c`），人工核对量 `TP5`。历史：TP_RST →（09-30）VBIAS 自检脚 →（10-05）拆除 |
| PD14 | FSMC_D0 | 双向 | LCD_D0 | 屏 FPC-30(DB0) | 16bit 数据 |
| PD15 | FSMC_D1 | 双向 | LCD_D1 | 屏 FPC-31(DB1) | |
| PD0 | FSMC_D2 | 双向 | LCD_D2 | 屏 FPC-32(DB2) | |
| PD1 | FSMC_D3 | 双向 | LCD_D3 | 屏 FPC-29?→DB3 | 脚号见表 1.2 |
| PE7~PE12 | FSMC_D4~D9 | 双向 | LCD_D4~D9 | 屏 DB4~DB9 | |
| PE13~PE15 | FSMC_D10~D12 | 双向 | LCD_D10~D12 | 屏 DB10~DB12 | |
| PD8~PD10 | FSMC_D13~D15 | 双向 | LCD_D13~D15 | 屏 DB13~DB15 | DB15=MSB |
| PD4 | FSMC_NOE | 出 | LCD_RD | 屏 FPC-36(RDX) | 只写屏也可不接 |
| PD5 | FSMC_NWE | 出 | LCD_WR | 屏 FPC-35(WRX) | |
| PD7 | FSMC_NE1 | 出 | LCD_CS | 屏 FPC-37(CSX) | Bank1 0x60000000 |
| PD11 | FSMC_A16 | 出 | LCD_RS | 屏 FPC-36?→DCX | RS=HADDR[17]，数据=+0x20000 |
| PB1 | GPIO_Output | 出 | LCD_RST | 屏 FPC-33(RESX) | 低有效，闲置高 |
| PB0 | GPIO_Output | 出 | LCD_BL_CTL | 背光 NMOS 栅 | **恒亮禁 PWM**（铁律级） |
| PB10 | I2C2_SCL (AF4) | 双向 | TP_SCL | FT6206(FT6x06) | 开漏，外置 4.7k 上拉×2 |
| PB11 | I2C2_SDA (AF4) | 双向 | TP_SDA | FT6206(FT6x06) | |
| PC5 | **输入 + 内部上拉**（2026-10-02 已改，照 `12 §9.1` 的"不加外部 4.7k"决定） | 入 | TP_INT | FT6336(FT6x06) INT（开漏输出，经 `J5.27` 上适配板） | 顶替外部上拉；本工程暂无代码读它（触摸走 I²C 轮询） |

（H1/H2 连接器物理针位：**已解决**——EDA 里天空星官方符号 EVK1 的针位号 = 排针位置
（P1=1~40、P2=41~80），全部网络已按此映射落到画布，见 `report_check.md`。）

### 1.2 屏 FPC（45 脚，TK035F9629 规格书 P.9-11 权威表）逐脚去向

| FPC 脚 | 信号 | 底板处理 | | FPC 脚 | 信号 | 底板处理 |
|---|---|---|---|---|---|---|
| 1 | TE | NC（规格：不用悬空） | | 24 | DB8 | LCD_D8 |
| 2 | GND | GND | | 25 | DB7 | LCD_D7 |
| 3 | DE | GND（规格：不用接 IOVCC1 或 GND） | | 26 | DB6 | LCD_D6 |
| 4 | PCLK | GND（同上） | | 27 | DB5 | LCD_D5 |
| 5 | VSYNC | GND（同上） | | 28 | DB4 | LCD_D4 |
| 6 | GND | GND | | 29 | DB3 | LCD_D3 |
| 7 | HSYNC | GND（同上） | | 30 | DB2 | LCD_D2 |
| 8 | IM0 | **GND**（8080-16bit） | | 31 | DB1 | NC（16bit 模式不用） |
| 9 | IM1 | **3V3**（8080-16bit） | | 32 | DB0 | NC（16bit 模式不用） |
| 10 | IM2 | **GND**（8080-16bit） | | 33 | RESX | LCD_RST |
| 11 | IOVCC1 | 3V3_DIGIT（规格 1.8~3.3V ✓） | | 34 | RDX | LCD_RD |
| 12 | VCI | 3V3_DIGIT（规格 2.8~3.3V ✓） | | 35 | WRX/SCL | LCD_WR |
| 13 | DIN | NC（SPI 不用） | | 36 | DCX | LCD_RS |
| 14 | DOUT | NC | | 37 | CSX | LCD_CS |
| 15 | DB17 | NC（16bit 模式不用） | | 38~43 | LED-K1~K6 | BL_K（共阴→NMOS→GND） |
| 16 | DB16 | NC（16bit 模式不用） | | 44 | LED-A | BL_A（5V→33Ω/0.5W→阳极） |
| 17 | DB15 | LCD_D15 | | 45 | LCD-ID | 100k→GND（按规格） |
| 18~23 | DB14~DB9 | LCD_D14~D9 | | | | |

### 1.3 触摸 FPC（FT6206(FT6x06)，6P 0.5mm）

| CTP 脚 | 信号 | 去向 | 备注 |
|---|---|---|---|
| 1~6 | VDD / GND / SCL / SDA / RST / INT | 3V3_DIGIT / GND / TP_SCL / TP_SDA / ~~TP_RST~~（已并入 `LCD_RST`）/ TP_INT | ⚠️ 本表为 H4-6P 旧口径，现行接口是 J5-30P（见 §1.7）； **[TBD-CTP-FPC 脚序]**：6 脚功能序为行业常规，落图前对实物 FPC 丝印/万用表通断核实 |

### 1.4 核心板内部占用（不接底板，登记备查）

PA4~PA7(SPI1→W25Q128✅JEDEC已验) | PA9/PA10(USART1→调试座H1) | PA11/12(USB OTG FS) | PA13/14(SWD) | PB2(LED2/BOOT1) | PC8~PC12+PD2(SDIO→TF) | PD3(SD_DET，插卡=低) | PC14/15(LSE) | PH0/1(HSE 8MHz)。晶振/BOOT/最小系统由天空星固定。

### 1.5 未用引脚去向

PA2/PA3/PB3~PB9(除0,1,10,11)/PC0~PC3/PC6/PC7/PC13/PD6/PD12/PD13/PE0~PE6：**NC-排针悬空**（核心板引出、底板不接）；PA15/PB3 默认 JTAG 占用须重映射才可用（不用，留 NC）。

### 1.6 上拉 / 脚位实测规程（万用表，带板前必做）

**要验的三件事**：① 30-pin 上哪两脚是 I²C（`SCK`/`MOSI` 还是别的）；② 屏模组**自带 I²C 上拉吗**；③ `BL` 脚是不是纯栅极输入（§6.7-④）。

**A. 测"模块有没有上拉"——电压法（推荐）**

1. 只给模块接 **3V3（J5.30）与 GND（J5.29）**；被测两脚（假定 `24`/`26`）**悬空**，不接 MCU、不接 3V3、不接 GND。
2. 万用表**直流电压档**，黑笔 GND，红笔测该脚。
3. 判读：

| 读数 | 结论 | 原理 |
|---|---|---|
| **≈3.3V**（3.0~3.3V） | **模块自带上拉** ✓ | 数字表输入阻抗 10MΩ，4.7k 上拉分压 = 3.3×10M/(10M+4.7k) ≈ **3.298V** |
| **≈0V 或乱跳**（数十 mV~1V） | **无上拉**（悬空脚） | 10MΩ 负载不足以把悬空脚抬到 3.3V |

4. **加强版（拉偏法，结论更铁）**：在 `SCK`↔GND 之间临时插 **100kΩ** 再测：
   - 有 4.7k 上拉 → 3.3×100k/(100k+4.7k) ≈ **3.15V**
   - 无 → **≈0V**
   把"悬空漂中间值"与"上拉很弱"彻底分开。

**B. 测"脚位对不对"——通断法（断电）**

断电、拔模块，用**通断档**测 30-pin 各脚到你已知目标（CTP 焊盘 / 屏 FPC 焊盘 / 触摸 IC 脚）的通断。
`§6.5-①`/`§6.7-②` 指出的阻塞项就靠这一步解掉。

**C. 禁忌（会烧东西）**

- **绝不能把 SCL/SDA 直接短到 3V3 或 GND**：触摸 IC 可能正把 SDA 拉到低电平，灌 3V3 = 硬短路；短 GND 既无意义也测不出上拉。
- **断电测电阻**（量 `SCK→3V3脚`）虽然也能读 ~4.7k，但**容易被 IC 的 ESD 二极管骗**（读到个二极管压降像低阻）⇒ **优先用 A 的电压法**。若要用，红黑表笔**对调各测一次**，真电阻两次读数一致。
- 动手前**先按丝印认脚**（`SCK`/`MOSI`/`T_CS`/`MISO`/`IQR`/`BL`），别按编号猜。

**D. 测量结果对设计的影响 —— 不影响**。

| 实测 | R15/R16（4.7k）怎么办 |
|---|---|
| **无上拉** | **必须留** —— 删了 I²C 直接不通 |
| 有 4.7k | 并联等效 **2.35k**，仍在 I²C 合规区（3.3V 下 2.2k~10k），多 2 颗阻 + ~1.4mA |
| 有 10k | 并联等效 3.2k，更没问题 |

⇒ **留着不亏、删了有风险**。所以测上拉的真正价值是**验证脚位（A→B 的前提）**，不是决定删不删电阻。

**E. 实测记录（2026-09-29，30-pin 适配板；只上电 3V3+GND，被测脚悬空，直流电压档）**

| 脚 | 丝印 | 读数 | 判读 |
|---|---|---|---|
| 26 | `MOSI` | **有上拉**（≈3.3V） | ✅ **`TP_SDA` 落点基本坐实** —— 普通 SPI 数据线不会放上拉；I²C 从设备在 SDA 上放上拉是常规 |
| 27 | `IQR` | **有上拉** | ✅ **`TP_INT` 落点坐实** —— INT 多为开漏输出，必须上拉 |
| 24 | `SCK` | **2V** | ⚠️ 见下"SCK 待定" |
| 23 | `T_CS` | **2V** | 正常 —— 普通 CMOS 输入脚，本就不该有上拉；2V = 悬空脚在 10MΩ 表下的典型驻留值（触摸 IC 处于复位态时引脚全浮） |
| 17 | `D15` | **2V** | 正常 —— 数据脚悬空，同上 |

**SCK 待定（唯一未决项）**：2V 说明它**要么没有上拉、要么根本没连到触摸 IC** —— 电压法分不开这两者。
- **(a)** 模组只给 SDA/INT 放上拉、SCL 交给主机 —— **很常见** ⇒ 映射成立，且 **R15 就是 SCL 唯一的上拉，必须留**；
- **(b)** `SCK` 不是触摸那一路（真 SPI 时钟）⇒ 映射错误，需按 **B 通断法** 重新定位。

**怎么定论（按代价从低到高）**：
1. **通断法**（方法 B，断电）：测 `SCK(24)` ↔ 触摸 IC 的 SCL 脚 / CTP 6-pin FPC 对应焊盘；通 ⇒ (a)。
2. **终极判据 —— 跑一次 I²C 扫描**：上电，MCU 用 I²C2 扫总线。扫到 **`0x38`**（FT6206(FT6x06)）或 **`0x5D/0x14`**（GT911）⇒ **SCL/SDA 全对，映射彻底坐实**；扫不到再回头查脚位。这一步 bring-up 本来就要做，成本≈0。
3. 若扫不到：临时把 `SCK(24)` 与 `MOSI(26)` **对调**再扫一次（I²C 的 SCL/SDA 接反是常见误接）。

**顺带白拿两个数据**：
- 断电测 `MOSI → 30-pin 3V3(30)` 的**电阻** ⇒ 读出模组上拉的**阻值**（10k？4.7k？）。若 10k，与底板 R16(4.7k) 并联 ≈ 3.2k，正合适。
- 顺手测 `MISO(25)`：若它也带上拉，能反推适配板内部到底走了哪几根。

**结论：R15/R16 必须留 —— 现在有两条独立理由**：① 模组的 SCL 可能压根没有上拉；② 即便有，并联后 2.35k 仍在 I²C 合规区。

### 1.7 ⚠️ 本文与定稿的同步状态

`§1.2 / §2(行 8~10) / §3` 若干行仍写着**旧方案**（`H3 屏 FPC-45P` / `H4 CTP FPC-6P` / 底板 `AMS1117` LDO / `Q1` NMOS + `33Ω` 背光支路 / `+5V_MAIN` 命名）。
> **2026-10-04 追加**：`§3` 电源树里那句 **"外部 5V 电源(DC005) ─ SS34防反+自恢复保险"**
> 也已作废 —— `J3`/`F1`/`D2` 三件已从 PWR 页删除，本板**由核心板 Type-C 供电**
> （图内注释原文，见 `38-底板设计状态体检-20261004.md` §3.2-①）。
> 现行电源口径 = **核心板 5V 引脚 → `+5V` → `R21`(4.7Ω) → `+5V_A`**，底板无入口防护件。
> **同批删除的还有**：`JP3`/`C12`/`TP6`（`VREF` 留位死支路，`30 §5`）· `C19`/`C20`/`LED1`/`R11`（`25 §3`）·
> **`TP2`（缓冲器输入探针，无记录，`38 §3.2-②`）**。所以 §2/§3 里出现这些位号的行**一律作废**。
**当前定稿**以 `13-底板定稿决策.md` 为准：屏与触摸统一走 **`J5`（30-pin 适配板）**，底**不放大 LDO**、**不放背光驱动**（`J5.28` 只给开关电平），电源网名 **`+5V`/`+5V_A`**。
**待办**：下一轮把 §1.2/§2/§3 整体改成 J5 口径（固件侧的宏不受影响，只有文档描述过期）。

**网名变更对照（2026-09-29，见 `13-底板定稿决策.md` §5.2.3-B8）** —— 读本文旧章节时按下表换算：

| 旧名（§2/§3 里可能还在用） | **当前网名** | 说明 |
|---|---|---|
| `VREF_3V3` | **`VREF_ADC`** | 核心板 REF3030 = 3.0V，旧名可能本来就错 |
| `VREF_3V3_EXT` | **`VREF_CORE`** | 从核心板 `EVK1.2`(REF) 取来的那一段 |
| `VBIAS_1V65` | **`VBIAS`** | = `VREF/2`（3.0V 档下 1.50V） |
| `LED_A` | **`PWR_LED`** | 板载指示灯节点，与背光 `LED-A` 无关 |

另：**`J1` 已由直插 BNC（`BY-BNC-50KWE`）改为 SMA 贴片座**（`SMA-KE` / C9900004802，封装 `SMA-SMD_SMA-KE`）——**50Ω 端接电阻 `R1` 不动（49.9Ω）**，5 个脚位与旧件完全一致。

## 8. 2026-09-30 变更（D1 + D7 落图，实施与证据链见 15 号）

| 项 | 改前 | 改后 | 依据 |
|---|---|---|---|
| AFE 信号 | EVK1.3(PA0)=AFE_ADC_IN | **EVK1.4(PA1)=AFE_ADC_IN**；EVK1.3 打 NC | 固件三处一致 + board_config「SW2 接 PA0，2026-09-23 上板验证过」；PA1 干净且固件已按 PA1 构建 |
| VBIAS 自检脚 | EVK1.4(PA1) | **EVK1.9(PC4)=VBIAS**（~~ADC1_IN14，本已引出且空闲~~ → ✅ **2026-10-02 改判：不配 ADC 通道**，"轨在线"改由 AFE 帧直流均值判，见 `22 §8`） | PC4 是退役 TP_RST 腾出的脚 |
| U1B 增益 | R6=30k ⇒ ×4 | **R6=69.8k（0805W8F6982T5E）⇒ ≈×8** | 14 号 §3-B：净增益 0.5×0.5×8≈2.0，ADC 利用率 8%→16%，白捡 6dB |
| 图面注释 | ×4/30k/AGND/J2/AFE_ADC_MON/VREF_3V3/VBIAS_1V65 等死名 + 同位重复 | 删重复 39 条、改死名 19 条 | 死名 = B2/B4/B8/B12 改动前的旧网名与已删器件 |

验收：DRC 三页 4/0/0/2/2（=基线）；几何对账四判据全"无"；跨页命名网逐条核对通过；viewer 渲染 unknown=0。
本节以上的历史小节（含 §6 信号链总表）为**旧口径存档**，不再维护。

另：`LCD_BL_CTL` 现在只到 `J5.28` 一侧；`PB0` 侧改叫 **`LCD_BL_PB0`**，两者之间才是 `R12`(1k) —— 见 §5.2.3-B7。

## 2. 模块连接表（从 → 到 → 信号 → 电平/速率）

| # | 从 | 到 | 信号 | 电平/速率 | 备注 |
|---|---|---|---|---|---|
| 1 | J1 BNC | L1 50Ω端接 | BNC_SIG | ±112mVpk max | 50Ω 电缆，TVS≤5pF 就近 |
| 2 | L1 | U2A BUF1(+in) | AFE_TERM | AC，fc=159Hz | 100nF C0G + 10k 偏置 |
| 3 | U2A 出 | R 50Ω → LC8 | AFE_FILT_IN | 带内 | 双端接梯形 |
| 4 | LC8 | R 50Ω → C 100nF → U2B(+in) | AFE_FILT_OUT | −43.7dB@1.5M | Qmax 无稳定性问题 |
| 5 | U2B 出 | R100+C470p → 核心板 PA0 | AFE_ADC_IN | 1.65V±250mV | 0Ω 断点 JP2 |
| 6 | REF3033 | VREF+（核心板 R2 档）+ 1.65V 分压 | VREF_3V3 / VBIAS_1V65 | 3.3V / 1.65V | 0Ω 断点 JP3 |
| 7 | 1.65V | 核心板 PA1 | VBIAS_ST | 自检电平 | 上电自检读 |
| 8 | 核心板 FSMC20+PB0/1 | H3 屏 FPC-45P | LCD_* | 111ns/字(16HCLK) | IM=010 绑定 |
| 9 | 核心板 I2C2+PC4/5 | H4 CTP FPC-6P | TP_* | 100kHz I2C | 上拉 4.7k×2 在底板 |
| 10 | 5V_MAIN | 33Ω → 屏 LED-A；K1~K6 → Q1 NMOS → GND | BL_A/BL_K | 60mA 级恒亮 | PB0 控栅，禁 PWM |
| 11 | 核心板 5V/3V3/GND 排针 | H1/H2 电源针 | +5V/+3V3/GND | — | GND 针占满（O10） |

## 3. 电源树（余量 ≥30% 核算）

```
外部 5V 电源(DC005) ─ SS34防反+自恢复保险 ─ +5V_MAIN
   ├─ 核心板 5V（板载 SCJA1117B-3.3 → MCU/板载件）      ~0.15A
   ├─ 模拟 5V（磁珠+LC 分割）→ OPA2197(2mA) + 背光支路   ~0.07A
   └─ AMS1117-3.3 → +3V3_DIGIT：IOVCC1(~15mA)+VCI(~5mA)+FT6206(FT6x06)(2mA)+I2C上拉(~3mA)+IM1(0.1mA)  ~0.03A
模拟 5V → REF3033 → VREF_3V3（ADC VREF+）                0.05mA+1.65V分压0.165mA
```

| 轨 | 预算 | 上级输出 | 余量 |
|---|---|---|---|
| +5V_MAIN | ≈0.25A | 竞赛电源 ≥1A | ≥4× ✓（和 ≤0.7× 判据：0.25 ≤ 1×0.7 ✓） |
| +3V3_DIGIT | ≈0.03A | AMS1117 1A | 33× ✓ |
| VREF_3V3 | ≈0.2mA | REF3033 25mA | ✓ |

背光电流核算：Vf 2.9~3.6V，5V−33Ω：I=(5−Vf)/33=42~64mA，跨在规格 If=60mA±10% 边缘——
**33Ω 改 39Ω**：I=36~54mA（亮度略降，恒流区间更近），功耗 ≤0.11W→用 0.5W 封装。✓ 闭合。

## 4. 三项一致性自检（AI 自查，[CHK] 前置）

| # | 检查 | 结果 |
|---|---|---|
| 1 | 引脚不冲突 | ✅ 45 个 .ioc 实脚 + PA0 无一引脚两用；PA1(ADC 模拟预留)与 PA0 各占一行 |
| 2 | 复用号合法 | ✅ FSMC 数据/控制线按 LQFP100 唯一映射（board_config §LCD 注释与 .ioc 一致）；I2C2=AF4、SPI1=AF5、USART1=AF7、SDIO=AF12 与 .ioc 相符；无凭记忆新增 |
| 3 | 电源树闭合 | ✅ 各轨消耗 ≤ 上级 ×0.7（§3 表）；背光改 39Ω 后电流落回规格区间 |

**遗留 [TBD]**：① 天空星 P1/P2 排针物理映射（官方速查工具为 JS 交互页抓不到，PCB 布局前对实物/开源原理图锁定）；② CTP FPC 脚序（对实物核实）；③ ~~PC5 改 GPIO_Input（走 GUI 清单，随 [CHK] 后做）~~ → ✅ **已做（2026-10-02）**。

## 5. 阶段三结果（2026-09-28，立创 EDA 工程 ai）

- **三页原理图已落图**：AFE（信号链+基准+测试点）/ PWR（转接板电源+背光+IM 绑定）/
  INT（EVK1 核心板符号 + H3 屏 FPC-45P + H4 触摸 FPC-6P + J2 板间互连 2×7）。
- **回读核对：191 个期望连接点全部在画布核实成立，差异 = 0**（`report_check.md`，
  几何法独立回读；getNetlist 受桥接 30s 超时限制未用）。
- **BOM 已从画布抽取**（`bom_raw.txt`）；OPA2197ID 计 2 个符号 = 1 片实体（双通道）。
- 遗留 TBD：① CTP FPC-6P 脚序对实物核实；② ~~PC5 改 GPIO_Input（GUI 清单）~~ → ✅ **已做（2026-10-02）**；
  ③ verify_dsp.py 重跑回填软件文档 §6/§10；④ U9/U10（用户所放排母）确认保留或删除；
  ⑤ PCB 不画（用户拍板），后续下单前补 DRC/下单 checklist。
- 净表要点：AGND 与 GND 分开（AGND 经 J2 到核心板 AGND 针，板上 0Ω 单点在核心板内）；
  VREF 注入走 EVK1 2 号针 EXT REF+；屏供电 IOVCC1/VCI 均 3.3V（规格合法）。

---

## 6. 屏 **30-pin 通用接口**（2026-09-29 实物照片记录）

> **来源**：用户提供的实物照片（屏 / 屏自带转接板的 2×15 = **30 pin 2.54mm 排针面**，2026-09-29）。
> 这是"**引出到外面的接口**"，**不是屏本身的 45 脚 FPC**；下表按照片丝印**原样**（自上而下 15 行）。
> 性质：**照片实读**（非推导）；"待确认"项已单列 §6.4。

### 6.1 逐脚（照片丝印原样）

> ⚠️ **2026-10-04 勘误**：本节原表把**右列整体写高了一行**（原写 `D15\|D14`、`RST\|空`）。
> 正确读法是**左列 = 奇数脚、右列 = 偶数脚，两列都自 CS/RS 端起算** —— 于是
> `D15` 的右邻是**空位**（= 脚 22 `T_BUSY`，电容版不引出），`RST` 的右邻是 **`D00`**。
> 依据：厂家转接板原理图 PDF 文本层（`CS 1 / RS 2 / WR 3 / RD 4 / RST 5 / D00 6 / D01 7 … D15 21 / T_BUSY 22 / T_CS 23 / T_CLK 24 / T_MISO 25 / T_MOSI 26 / T_IQR 27 / BL_CTR 28 / GND 29 / 3V3 30`）
> + 2026-09-29 / 2026-10-02 两张实物照片 + 装配图焊盘标号（`01` 落在 CS 端）。
> 表已按下述修正，J5 原理图同步改（见 §6.18）。

| 行 | 左列（奇数脚） | 右列（偶数脚） | 8080-16bit 下的用途 |
|---|---|---|---|
| 1 | GND | 3V3 | 电源 |
| 2 | IQR | BL | 触摸中断 / 背光控制 |
| 3 | MISO | MOSI | 触摸数据线（电容版疑似 SDA） |
| 4 | T_CS | SCK | 触摸片选（电容版疑似 SCL） |
| 5 | **D15** | *（丝印空 = T_BUSY）* | 数据 / 空位 |
| 6 | **D13** | **D14** | 数据 |
| 7 | **D11** | **D12** | 数据 |
| 8 | **D09** | **D10** | 数据 |
| 9 | **D07** | **D08** | 数据 |
| 10 | **D05** | **D06** | 数据 |
| 11 | **D03** | **D04** | 数据 |
| 12 | **D01** | **D02** | 数据 |
| 13 | RST | **D00** | 屏复位 / 数据 |
| 14 | WR | RD | 写选通 / 读选通 |
| 15 | CS | RS | 片选 / 命令-数据选择 |

**合计 = 29 个信号 + 1 个空位 = 30 pin。**
**逐脚线性表（照厂家编号）**：`1=CS 2=RS 3=WR 4=RD 5=RST 6=D00 7=D01 8=D02 9=D03 10=D04 11=D05 12=D06
13=D07 14=D08 15=D09 16=D10 17=D11 18=D12 19=D13 20=D14 21=D15 22=T_BUSY 23=T_CS 24=T_CLK
25=T_MISO 26=T_MOSI 27=T_IQR 28=BL_CTR 29=GND 30=3V3` —— **奇脚一列、偶脚一列，两列都自 CS/RS 端起算**。

### 6.2 8080-16bit 的引脚预算（为什么 30 pin 刚好够）

| 类别 | 脚数 | 明细 |
|---|---|---|
| 数据 | 16 | D00~D15 |
| 控制 | 5 | CS / RS(DCX) / WR / RD / RST |
| 电源 | 2 | 3V3 / GND |
| 背光 | 1 | BL |
| **小计（本设计必用）** | **24** | |
| 触摸 | 5 | IQR / MISO / MOSI / SCK / T_CS（电容版只用其中一部分） |
| 空位 | 1 | — |

⇒ **8080-16bit 用满 24 脚，30 pin 余 6 脚全部给触摸** —— 与"引出的只有 30pin"完全自洽。

### 6.3 与厂家 TK035F5501"公认通用"30-pin 的关系（**不得照抄厂家顺序**）

- **信号集合一致**：`CS/RS/WR/RD/RST + D00~D15 + 3V3/GND + BL + T_CS/T_CLK/T_MISO/T_MOSI/T_IQR`；
  **唯一差别 = 本板没有 `T_BUSY`**（T_BUSY 是电阻触摸 XPT2046 专用）⇒ 本板面向**电容触摸**配置。
- **物理次序**：**就是厂家编号本身**（2026-10-04 更正）。
  厂家板 1~30 为
  `CS,RS,WR,RD,RST,D00…D15,T_BUSY,T_CS,T_CLK,T_MISO,T_MOSI,T_IQR,BL_CTR,GND,3V3`
  （奇脚一列、偶脚一列，**两列都自 `CS/RS` 那端起算**）。
  把这条规则画成两列，**自然就得到实物丝印的样子** —— `D15` 旁边是空位（`T_BUSY`）、
  `RST` 旁边是 `D00`。
  ⛔ **原文此处"本板把数据线按 `D(2k+1)`/`D(2k)` 成对重排"的结论是错的**：那是把
  "左列/右列"误当成了"同行的两个数据位"。实物并没有重排，**直接照厂家编号对即可**。
  ⇒ **画底板/转接板时必须按实物丝印逐脚对，不得照抄厂家 PDF 的编号顺序。**

### 6.4 接口侧"已经被处理掉"的三件事（对底板设计的直接结论）

| 观察 | 结论 |
|---|---|
| 30-pin 上**没有 IM0/IM1/IM2** | 接口模式已在**转接板内部绑好** ⇒ **底板不需要 IM 配置电路**（前提见 §6.5-②） |
| 30-pin 上**没有 DE/PCLK/VSYNC/HSYNC/TE** | 已按规格接地/悬空 ⇒ 底板不用管 |
| 30-pin 上**没有 LCD-ID** | 该脚未引出 ⇒ 底板 100k 无处可接、也不需要 |

### 6.5 待确认（照片看不出来，**需万用表/资料**）

| # | 项 | 为什么必须确认 | 怎么确认 |
|---|---|---|---|
| ① | **触摸总线落点** | 本 30-pin **没有独立的 SDA/SCL**。若屏是电容触摸（FT6206(FT6x06)，I²C），SDA/SCL 必然映射到 `MOSI/SCK`（或另有 6-pin CTP FPC）。**这是底板能否画的阻塞项。** | 万用表从 30-pin 的 `MOSI/SCK/T_CS/MISO/IQR` 逐脚测到 CTP 焊盘 / 触摸 IC 脚的通断 |
| ② | **转接板的 IM 绑法** | 必须确认出厂绑的是 `IM2=0 / IM1=1 / IM0=0`（8080-16bit）而非 SPI；若是 SPI 版，数据脚会悬空。**§6.6-② 已证实板上有 Parallel/SPI 二选一焊盘 ⇒ 出厂很可能不是 8080，需改焊。** | 测 IM0/IM1/IM2 对 GND/3V3 的通断；或按板上 `Parallel` 丝印表改焊 0Ω |
| ③ | **`BL` 脚的性质** | **✅ 2026-10-02 已定案（见 §6.11）：是背光开关控制脚（NMOS 栅极）**，厂家转接板上网络名就叫 `BL_CTR`、经 `R7`(10K) 上拉、驱动 `Q1`(SI2302) ⇒ **底板只给 BL 一个 GPIO 电平即可，不必自带背光驱动** | 已从厂家转接板原理图读出，**无需实测** |
| ④ | **RST 是否与触摸 RST 共用** | 若共用，底板可省掉一个 GPIO（PC4） | 测 30-pin `RST` 到 CTP 焊盘的通断 |
| ⑤ | **底部两个白色连接器是什么** | §6.6-⑤ 可见两个 2P 白座；若是"背光电源入/出"，则背光供电由底板从这两个座送，底板支路要按此改 | 目视 + 测通断 |

---

### 6.6 **整板观察**（2026-09-29 第二张照片：屏 + 成品转接板全貌）

> 照片实读，**结论性判断已标注"待确认"**。这块板把 **屏的 45 脚 FPC → 30 pin 2.54 排针**，
> 是"屏到手即用的成品接口"，不是裸屏。

| # | 板上看到什么 | 对底板/方案的意义 |
|---|---|---|
| ① | **左缘：45 脚 FPC 座**（橙色屏排线插入），旁边丝印 **`D16` / `D17`** | 确认 FPC 是 45 脚；`D16/D17`（= FPC 脚 15/16 = DB16/DB17）正是 **8080-16bit 模式下不用**的两根，与"这块板面向并口"一致 |
| ② | **中左：一张 `Parallel` / `SPI` 的位宽选择表丝印 + 一组 0Ω 焊盘** | ⚠️ **本次最重要的发现**：IM 是焊盘二选一，**出厂默认档不一定是 8080**。`04 §0` 早已记录厂家通用板"IM 全拉 3.3V = 4-line SPI 绑法" ⇒ **很可能需要改焊**。详见 §6.7 |
| ③ | **中部：白色 6-pin FPC 座 → 一小块 FPC → 板上小方块 IC** | 这是**电容触摸模组 + 触摸控制器**的独立通道。⇒ 30-pin 上的 `T_CS/MISO/MOSI/SCK` 是"通用/电阻触摸"那一路；**电容触摸的 I²C 是在转接板内部复用过去的**，落点必须实测（§6.5-①） |
| ④ | **右缘：`DE / PCLK / VSYNC / HSYNC` 焊盘区**（= 厂家图的"RGB 同步信号接入处"） | 8080 模式下这四根按规格应"接 IOVCC1 或 GND"。板上留了跳线区 ⇒ **需确认当前接地还是悬空**（§6.7-③） |
| ⑤ | **右下：`0R/NC` 焊盘 + "LCD 与触摸共用 SPI 线可焊此电阻"说明**；**底部两个白色 2P 连接器** | 又一处 SPI 复用配置；底部两个白座功能待确认（疑为背光电源入口/出口，§6.5-⑤） |
| ⑥ | 30-pin 丝印**逐列成对**（左→右：`CS/RS`、`WR/RD`、`RST/D00`、`D01/D02`、`D03/D04` … `D15/空位`、`T_CS/SCK`、`MISO/MOSI`、`IQR/BL`、`GND/3V3`） | ⚠️ **2026-10-04 更正**：这个顺序**与厂家 PDF 的 1~30 线性表完全一致**（奇脚一列、偶脚一列，都自 `CS/RS` 端起算）。原文写的 `RST/空`、`D01/D00` 是把右列读高了一行 ⇒ 见 §6.1 勘误 |

### 6.7 由整板观察产生的**新增先决条件**（比 §6.5 更硬）

| # | 先决条件 | 判据 | 不满足的后果 |
|---|---|---|---|
| ① | **转接板必须处于 `Parallel`（8080-16bit）档** | 测 `IM0=0 / IM1=1 / IM2=0`（对 GND/3V3 通断）；或按板上 `Parallel` 表改焊 | 数字脚全死，点不亮；且**无法靠软件补救** |
| ② | **触摸总线落点明确** | 30-pin 的哪两脚 = SDA/SCL、哪一脚 = INT、RST 是否共用 | 触屏不可用（或底板多画/少画连线） |
| ③ | **`DE/PCLK/VSYNC/HSYNC` 已在板上接地** | 测这四脚对 GND 通断 | 悬空时屏内 RGB 逻辑可能被误触发（规格书要求接 IOVCC1 或 GND） |
| ④ | **`BL` 脚性质明确** | **✅ 2026-10-02 已定案（见 §6.11）：栅极控制脚，接 GPIO 电平即可** | 原风险"底板背光支路无法定"**已消除** |

### 6.8 IM 档位**怎么判、怎么改**（"数个数"傻瓜法）

**权威表**（`ST7796S_SPEC_V1.0` P.42 / P.59 / P.63；已存底 `st7796_im.txt`）

| IM2 | IM1 | IM0 | 接口 | 数据脚 |
|---|---|---|---|---|
| 0 | 0 | 0 | 8080 18-bit | DB[17:0] |
| 0 | 0 | 1 | 8080 9-bit | DB[8:0] |
| **0** | **1** | **0** | **8080 16-bit** | **DB[15:0]** ← **本项目要的** |
| 0 | 1 | 1 | 8080 8-bit | DB[7:0] |
| 1 | 0 | 0 | Reserve | — |
| 1 | 0 | 1 | 3-Line SPI | SDA, SDO |
| 1 | 1 | 0 | MIPI | — |
| 1 | 1 | 1 | 4-Line SPI | SDA, SDO |

**判据（**不需要**分辨哪一组是 IM0/IM1/IM2，只数"被拉到 3V3 的有几个"）**

| 从 30-pin 的 `3V3` 脚蜂鸣到的 IM 焊盘个数 | IM[2:0] 里 1 的个数 | 可能档位 | 是 8080-16bit 吗 |
|---|---|---|---|
| **1 个** | 1 | `010` / `001` / `100` | **`010` 就是 ✅**（另两个厂家板不会用：`100`=Reserve、`001`=9bit） |
| 0 个 | 0 | `000` | ❌ 18-bit |
| 2 个 | 2 | `011` / `101` / `110` | ❌ 8bit / 3SPI / MIPI |
| 3 个 | 3 | `111` | ❌ 4-Line SPI |

> 100% 确定的判据只有一条：**IM1 那组必须接 3V3，IM0/IM2 必须接 GND**。

**改焊目标**：`IM1 → 3V3`，`IM0 → GND`，`IM2 → GND`。

- 0Ω 电阻本质上就是一根线 ⇒ **直接用一坨锡把两个焊盘桥连，与焊 0Ω 完全等价**（手边没 0Ω 也能改）。
- 也可以把贴在 3V3 列那颗用烙铁**挪**到 GND 列。

**测量注意**

- ⚠️ **不要在 45 脚 FPC 座上测**（0.5mm 间距，极易短路）。在转接板 `Parallel/SPI` 丝印表**旁边那 3 组焊盘**上测。
- 断电测（通断/蜂鸣档）；一支表笔固定在 30-pin 的 **`3V3`（第 30 脚，最右列）** 或 **`GND`（第 29 脚）**，另一支依次点 3 组焊盘。

> **2026-09-29 用户实读**：板上 `Parallel` 表对应 **`010`** ⇒ 判为 **8080-16bit 档**。
> ⚠️ 注意区分：丝印表是**指导**（"该档位需要 010"），**实际档位由 0Ω 贴在哪一列决定**。
> 30 秒复核法：断电，一支笔固定 30-pin `3V3`，另一支点那 3 组焊盘——**只响 1 次**即确认 `010`。

### 6.9 DE / PCLK / VSYNC / HSYNC 的处理（**照片显示这 4 处元件未焊**）

**两份权威资料口径一致 —— 不用时必须接 `IOVCC1` 或 `GND`，不能悬空：**

| 出处 | 原文 |
|---|---|
| `TK035F3296规格书v1.2.pdf` P.9（= 屏体规格书，9629 共用） | 脚 3 `DE` / 脚 4 `PCLK` / 脚 5 `VSYNC` / 脚 7 `HSYNC` 逐条注 **"（RGB 接口信号，不用时接 IOVCC1 或者 GND）"** |
| `ST7796S_SPEC_V1.0.pdf` P.42（接口逻辑脚表） | `ENABLE` / `VSYNC` / `HSYNC` / `DOTCLK` 逐条注 **"If not used, please fix this pin at VDDI or DGND."** |
| 同上，`DE` 另有语义注 | 模块规格书写 **"Low: Select (Accessible) / High: Not select (inaccessible)"** ⇒ **DE 必须为低（GND）**；接 IOVCC1 反而有"接口不可访问"的风险 |

**结论：这四根应当接地（GND），不能悬空。** 那 4 处未焊的焊盘**建议补上**（补 0Ω **或直接锡桥**，等价）。

- **不焊的后果**：CMOS 输入悬空 → 输入级可能振荡/穿通，对 mV 级 AFE 是白送的噪声源；`DE` 若漂高还有"接口不可访问"的风险。
- **代价**：一滴锡 / 4 根细飞线。**没有理由省。**
- **怎么接**：蜂鸣档，一支笔固定 30-pin 的 `GND` 脚，另一支点那 4 组焊盘——
  响的那一列就是接地位，把信号脚用锡桥搭过去即可；若两列都不响（说明那 4 个焊盘是引到 RGB 接入点的），**直接飞 4 根线到最近的 GND 焊盘/过孔**。

### 6.10 两条来自厂家《液晶屏通用说明》的重要事实

出处：`01_文档规格书/00_通用/好钜润科技液晶屏通用说明.pdf`（V1.02，P.1）

| # | 原文 | 对本项目的意义 |
|---|---|---|
| **①** | **"○3 如果背光是并联的，可以用 3.3V 串联限流电阻点亮，如果是背光是串联的，则要升压恒流源点亮。"** | **背书了"电阻限流"路线本身没错** —— 本屏背光 `Connection mode = P`（并联）⇒ **厂家明说可用串联限流电阻，不必上恒流源**。上一轮"③ 背光恒流驱动"的争议到此**收敛**：问题不在"要不要恒流"，而在 **R14 的阻值与供电电压要按实测的 A–K 特性定**（模块内可能已有串阻）。同时也解释了厂家 1000 亮度板为何要升压：那是为了把并联背光推到 1000nit（电流大、Vf 抬升） |
| **②** | **"电容触摸一般驱动 IC 分为两大派系……GT911 及 FT5XXX、FT6XXX"** | ⚠️ **本屏的触摸 IC 未必是 FT6206(FT6x06)**（工程按 FT6206(FT6x06) 写的）。照片上那块小 FPC 上的方块 IC 就是触摸控制器，**请读一下丝印型号**；若是 **GT911**，I²C 地址与寄存器全不同（GT911 默认 0x5D/0x14，FT6206(FT6x06) 为 0x38/0x70），固件 `bsp_touch` 要改 |
| ③（顺带） | "MCU 屏（又名 8080 接口屏），初始化后会是雪花状的……这时候已经表明液晶屏初始化已经完成" | 上板 bring-up 判据：**出现雪花 = 初始化成功**，不用等刷颜色 |

### 6.11 **`BL` 脚性质定案（2026-10-02，从厂家转接板原理图读出，无需实测）**

**结论：`BL` = 背光开关控制脚（NMOS 栅极）**。底板（或台面杜邦线）**只给一个 GPIO 电平即可**，
`§6.5-③` 与 `§6.7-④` 两项 **[待确认] 到此关闭**。

**依据文件**（此前一直没打开的厂家转接板原理图）：

`docs/TK035F5687_9629_整理资料_(含SPI及并口版)/05_硬件转接板资料/通用亮度转接板原理图及PCB/TK035F5501_转接板.pdf`

| 图纸事实 | 位置（PDF 页 1 坐标 x,y） | 含义 |
|---|---|---|
| 30-pin 的 `BL` 脚网络名 = **`BL_CTR`** | (407.7, 442.0) | **CTR = control**，厂家自己命名为"控制" |
| `Q1` = **`SI2302`**（N 沟道 MOS） | (266.4, 191~199) | 背光开关管 |
| `BL_CTR` → `Q1` 栅极；栅极经 **`R7` = 10K** 上拉到 **3.3V** | (289.9,214.8) · (328.4,217.2/204.7) · (362.2,210.9) | 低边开关 + **栅极上拉 ⇒ 默认亮** |
| `Q1` 漏极 = **`LED-`** | (274.2, 238.3) | 接屏背光阴极 |
| `LED-` = 45-pin FPC **脚 38~43（`K1`~`K6`）** 汇流 | (93.3~116.9, 205.5~229.0) | 屏内 6 路背光阴极并联到开关管 |
| `Q1` 源极 = GND | x=258.4 竖干线（下端 GND 符号） | — |
| 屏 **脚 44 `A`（背光阳极）→ 3.3V** | (82.7/126.4, 195.3) | **背光电源取自模块自己的 `3V3` 脚，外部不必供** |

**由此得到两条可直接用的推论**：

1. **`BL` 接 `PB0`（`B00`）安全** —— 栅极几乎不吃电流，不存在"GPIO 带不动 60mA 背光"的问题。
   与 `board_config.h` 的注释「PB0 · **高 = 背光亮**」一致。
2. **背光默认就是亮的**：`R7` 把栅极上拉到 3.3V，而 `PB0` 复位后是浮空输入 ⇒
   **只要 3V3 上电，背光即亮**，与固件无关。这是预期现象，不是故障。

**顺带解释**：蜂鸣档量 `BL` 对 GND/3V3 都不通是**正常**的 —— MOSFET 栅极是栅氧隔离的，
本来就该不通。**注意**：不能用"量不到通断"来推断它是栅极（白光背光是 2.9~3.6V 才导通的
LED 串，供电脚同样量不出通断），必须读图或做两向 1kΩ 串阻测量。

### 6.12 天空星排针**物理方位定案**（2026-10-02，PCB 焊盘几何 + 实物图双重核实）

**结论（台面接线直接照此用）**：

1. **丝印名印在核心板背面**。丝印面朝上时 —— **`P1` 在右、`P2` 在左**。
2. **每一行两个孔、两个丝印名，从左到右一一对应**（左边的名字 = 左边那个孔）。
3. **奇数脚在外侧列、偶数脚在内侧列**（两面同理，因为内外是相对板边说的）。

**证据链（两条独立来源互相印证）**：

| 来源 | 做法 | 结果 |
|---|---|---|
| **PCB 焊盘几何** | 解 `…/嘉立创EDA工程文件/*.epro` → `PCB/*.epcb`：`COMPONENT` 拿排针坐标与旋转（`e56` 在 x=+700、`e57` 在 x=-700，均 rot=-90），`ATTR…Footprint` 拿封装号，`FOOTPRINT/*.efoo` 拿 40 个 `PAD` 的局部坐标（单位 **mil**，1 行距 = 100 mil = 2.54 mm），`PAD_NET` 拿**每个焊盘的网络名** | `e57`（板左）pad1=`PA2`、pad13=`PE7`、pad23=`PB10`、pad37=`AGND` ⇒ **`e57` = P1**；`e56`（板右）pad27=`PD7`、pad29=`PD5` ⇒ **`e56` = P2**。换算得 **P1 奇数脚在 x=−750（外侧）、偶数脚在 −650（内侧）**，P2 同理 |
| **官方实物渲染图** | 对 `docs/…/天空星STM32F407VET6图片/天空星STM32F407背面图片.png`（2160×3360）做纯色 `(255,255,0)` 焊盘检测，得 4 列 20 行、行距 121.2 px；按 PCB 坐标拟合出镜像映射 `x_photo = 1076.2 − 1.2137·x_pcb`、`y_photo = 471.7 − 1.212·y_pcb`（4 列全部落在 ±2 px 内） | 标注叠图后逐脚目视复核：`B01\|E07` 行中 **B01(=P1-14) 在左孔、E07(=P1-13) 在右孔**；`D06\|D07` 行中 **D07(=P2-27) 在右孔** —— **与丝印名左右顺序完全一致** ✅ |

⇒ `§1.1` 里那条"天空星 P1/P2 排针物理映射"的遗留 **[TBD] ①** 到此**彻底关闭**（此前只是"按符号针位推断"，
现在有 PCB 焊盘网络名 + 实物图像素级对齐两条硬证据）。

> ⚠️ **2026-10-05 勘误（上面第 3 条结论的"P2 同理"）**：P2 的奇数脚在**内侧**、偶数在外侧
> ——本节自己的证据表就是证明（"D07(=P2-27) 在右孔"，左连接器的右孔=内侧）。
> 正确口诀：**设计帧（正面朝上）下两个连接器的奇数排都在西侧**；背面视角则"每对孔右孔=奇数"。
> 另：本节定案只覆盖"丝印面朝上（台面）"姿态——若核心板**翻面从下方插入**（三层夹心装法），
> 整个针脚场镜像、现 EVK1 封装必错位（含 3V3↔GND 短路），处置见 `49-三层堆叠排针方向审计-20261005.md`。

**台面接线卡**（带标注实物图 + 4 张放大图）：`hardware/21-接线卡-屏幕模块直连核心板.html`
（配图资产在 `hardware/21-接线卡_assets/`）。

## 8. 厂家资料复核（2026-10-02，ST7796/并口版）

> 依据：`docs/TK035F5687_9629_整理资料_(含SPI及并口版)/` 内的
> `01_文档规格书/TK035F9629_ST7796版/TK035F9629规格书v1.2.pdf`（45 脚 FPC 权威表 + 背光电气）、
> `01_文档规格书/TK035F9629_ST7796版/ST7796S_SPEC_V1.0.pdf`（IM 表）、
> `05_硬件转接板资料/通用亮度转接板原理图及PCB/TK035F5501_转接板.pdf`（厂家转接板原理图，已抽文本到 `hardware/data/adapter_sch_extract.txt`）、
> `02_STM32例程/TK035F9629_ST7796版/STM32_16位并口_标准库_电容触摸/`（厂家电容触摸驱动源码）。

### 8.1 J5（30-pin 实物丝印）逐行复核 —— **2026-10-04 更正：原"全部对上"是误判**

按 §6.1 照片丝印 15 行逐行核活体净名（`sch list --include-pins`）。**下表为 2026-10-04 改图后的实测值**：

| 丝印行 | 左列 → J5 脚/净名 | 右列 → J5 脚/净名 | 判定 |
|---|---|---|---|
| 15 | CS → 1 `LCD_CS_J5` | RS → 2 `LCD_RS_J5` | ✓ |
| 14 | WR → 3 `LCD_WR_J5` | RD → 4 `LCD_RD_J5` | ✓ |
| 13 | RST → 5 `LCD_RST_J5` | **D00 → 6 `LCD_D0_J5`** | ✓ **修**（原 6 = NC） |
| 12 | D01 → 7 `LCD_D1_J5` | **D02 → 8 `LCD_D2_J5`** | ✓ **修**（原 8 错挂 `LCD_D0_J5`） |
| 11 | D03 → 9 `LCD_D3_J5` | **D04 → 10 `LCD_D4_J5`** | ✓ **修**（原 `LCD_D2_J5`） |
| 10 | D05 → 11 `LCD_D5_J5` | **D06 → 12 `LCD_D6_J5`** | ✓ **修**（原 `LCD_D4_J5`） |
| 9 | D07 → 13 `LCD_D7_J5` | **D08 → 14 `LCD_D8_J5`** | ✓ **修**（原 `LCD_D6_J5`） |
| 8 | D09 → 15 `LCD_D9_J5` | **D10 → 16 `LCD_D10_J5`** | ✓ **修**（原 `LCD_D8_J5`） |
| 7 | D11 → 17 `LCD_D11_J5` | **D12 → 18 `LCD_D12_J5`** | ✓ **修**（原 `LCD_D10_J5`） |
| 6 | D13 → 19 `LCD_D13_J5` | **D14 → 20 `LCD_D14_J5`** | ✓ **修**（原 `LCD_D12_J5`） |
| 5 | D15 → 21 `LCD_D15_J5` | **（丝印空 = `T_BUSY`）→ 22 NC** | ✓ **修**（原 22 错挂 `LCD_D14_J5`） |
| 4 | T_CS → 23 **NC** | SCK → 24 `TP_SCL` | ✓ |
| 3 | MISO → 25 **NC** | MOSI → 26 `TP_SDA` | ✓ |
| 2 | IQR → 27 `TP_INT` | BL → 28 `LCD_BL_CTL` | ✓ |
| 1 | GND → 29 | 3V3 → 30 `+3V3` | ✓ |

⇒ 3 个 NC（22/23/25）= 空位（`T_BUSY`）+ `T_CS` + `MISO`，正是**电容版用不到**的三根 ✓。

> ⚠️ **2026-10-04 更正**：本节原表把右列整体读高了一行（原写 `D15\|D14`、`RST\|空`），
> 于是**全部偶数数据位错挂一位**：`pin6` 漏接 `D00`、`pin8…pin20` 错挂 `D00/D02/…/D12`、
> `pin22` 错挂 `D14`。照原图插屏 ⇒ 偶数位整体错位 + `D00` 悬空 + `D14` 落空，
> **RGB565 下 R/G/B 三段同时偏色**（屏能亮、能显示界面，所以"上板通了"掩盖了它）。
> 原表把 `LCD_WR`/`LCD_RD`/`LCD_RST` 与 `_J5` 后缀混写，也在同一次更正里统一为 `_J5`。
> **厂家 PDF 那份 `1..30 = CS,RS,WR,RD,RST,D00..D15,T_BUSY,…` 才是真相源**（§6.3 已更正），
> 实物丝印是它的两列画法，**不是另一套顺序**。

### 6.18 J5 引脚映射修正（2026-10-04，改图凭据）

| 项 | 内容 |
|---|---|
| 现象 | 偶数数据位整体错一位（见 §8.1 勘误） |
| 根因 | `§6.1/§6.3/§6.6-⑥/§8.1` 把"左列/右列"误读成"同行配对"，丢掉了厂家编号的**奇/偶列规则** |
| 改法 | INT 页 J5：删/建 8 个 `LCD_Dn_J5` 网口（原位同坐标重建，几何零位移）+ `pin6` 清 NC 后 `connect` + `pin22` 打 NC 并删残桩 |
| 改动脚 | `6,8,10,12,14,16,18,20,22`（共 9 脚） |
| 未动 | `LCD_Dn` ↔ `LCD_Dn_J5` 拼接区、EVK1 侧、固件（`board_config.h` / FSMC 映射全不用改） |
| 闭环 | `sch save` → `doc reload` → 回读网表（§8.1 表）→ `sch nets` 68 网无同轨异名/无单引脚网 → `bridge-check` 0 桥 0 孤儿 → `sch check` 47 条与基线同量、J5 区无新增 → `sch drc` 0 fatal 0 error |
| 备份 | `_archive/_review5/G2026_before_J5fix_20261004.epro2`（sha256 `b129352d…e07d5f`，可整包回退） |

### 8.2 厂家转接板原理图读出的结论（与 §6.11 同源，此处收全）

| 项 | 厂家板事实（PDF 文本抽取） | 对底板的结论 |
|---|---|---|
| 排针定义 | 30 脚含 `BL_CTR`(28)/`GND`(29)/`3V3`(30)、`T_*` 6 根 | 与丝印一致 ✓ |
| 背光 | `Q1 SI2302`（NMOS）+ `BL_CTR` 经 **`R7 10K` 上拉**；LED-K1~K6 共漏 | 底板**只给电平** ✓（D3）；⚠ 上拉使 **PB0 高阻时背光为亮**（上电一闪，无害） |
| 触摸 | CTP 座 `P6`：`P6.5→SCL→30pin 24`、`P6.4→SDA→30pin 26`、`P6.3→INT→30pin 27`、`P6.2→LCD.33(RESX)`（共用复位）；`R9 4.7K` 上拉 | 与 D2 推定**完全一致** ✓；底板 4.7k 与板上 4.7k 并联 ≈2.35k（100kHz 合法）✓ |
| 复位 | `R8 18K` + `C5 104`（100nF）= 硬件阻容复位 | 底板无需再给 RC ✓ |
| 位宽 | `R1..R6` 0Ω 焊盘 = IM0/IM1/IM2 二选一（丝印 `Parallel`/`SPI` 表）+ `R10 0R/NC`（LCD 与触摸共用 SPI） | 底板**不做 IM 配置** ✓（前提：出厂档必须是并口）⚠ 待实测 |
| RGB 同步脚 | `DE/PCLK/VSYNC/HSYNC` → `P4`「RGB 同步信号接入处」 | 8080 模式下规格要求**接 IOVCC1 或 GND** ⇒ ⚠ **需实测 P4/相关焊盘是否已对地短接**，否则悬空 |
| 电阻触摸 | 板上另有 `IC1 XPT2046`（`电阻/电容触摸 二选一`） | 与电容模组**共用 `T_*` 三根** ⇒ 实测确认电容档下 XPT2046 不驱动总线（否则争用） |

### 8.3 规格书侧的硬数字（ST7796 版 TK035F9629 v1.2）

- 背光：**`LED-A` 阳极 3.0–3.4 V，`If = 60 mA`**（Ta=25℃），6 颗 LED（K1~K6）。
  ⇒ 阳极由 30-pin 的 **3V3** 供电是厂家既定做法 ✓；**60 mA 会经 J5 单根 3V3 针 + 单根 GND 针回流**，底板 3V3 支路需按 ≥100 mA 余量看（EVK1 侧 500 mA 保险覆盖 ✓）。
- `IM[2:0]` 为**接口选择脚**（45 脚 FPC 的 8/9/10）；本设计要 **8080-16bit = IM2/IM1/IM0 = 010**。
  ⚠ 规格书这段文字里混进了 **R61581** 的描述（厂家笔误），**别拿它当判据**，以 ST7796S 数据手册 P.42 为准。
- `DE/PCLK/VSYNC/HSYNC` 注文：**「RGB 接口信号，不用时接 IOVCC1 或者 GND」**。
- `LED-A`(44) / `LED-K1..K6`(38~43) / `LCD-ID`(45)：**ID「接 100K 到地，不用时此脚可悬空」** ⇒ 底板不接 R20 ✓（厂家 30-pin 未引出该脚）。
- 触摸控制器：厂家 ST7796 版例程里是 **`FT6206`**（源码 `touch_CTP.c` 的 `FT6206_Read_Reg/Write_Reg`，`FT6206_ADDR=0x70` 即 7 位 0x38）。
  ⇒ **固件侧早已按此例程改对**（见 `README.md` 第 3 条闭环记录：`bsp_touch.c/h` 寄存器事实取自该例程）；
  残留的是**文档/注释用词**写着 `FT6206(FT6x06)`（同族、地址与基础寄存器兼容），本文件与 `18-…` 两处已改，
  固件注释（`app_lvgl.c/h`）属同类笔误，随下次代码整理一并改，不影响功能。

### 8.4 结论与待办（3 项实测即可闭环）

1. **合不合理**：**合理**。30-pin 逐脚正确、触摸路径与厂家同源、背光只给电平与厂家设计一致、IM 不做配置与"厂家板内已绑"一致；无多余器件。
2. ⚠ **待实测 3 项**（都不需要改图，最坏情况是飞线/改焊）：
   - 转接板出厂档位：`IM0=0 / IM1=1 / IM2=0`（对 GND/3V3 通断，或按 `Parallel` 表改 0Ω）；
   - `P4`（DE/PCLK/VSYNC/HSYNC）是否已对地短接；
   - 电容档下 `XPT2046` 是否与 CTP 争用 `T_MOSI/T_CLK/T_IQR`。
3. ⚠ **文档侧 1 处更正**：`FT6206(FT6x06) → FT6206（FT6x06 家族）`。

### 8.5 实物复核补充（2026-10-02，用户拍摄 TK035F5501 转接板 + 屏实物，1080×1919）

裁切放大件存 `_archive/_eda/`（`intD1_top.png` / `intD1_p4.png` / `intD1_ctp.png` / `intD1_table.png`）。

| # | 照片读到的 | 结论 |
|---|---|---|
| ① | **`IM0/IM1/IM2 = 0/1/0`**（用户在实物上确认） | ⇒ **§8.4-① 关闭**：出厂即 8080-16bit 档，底板"不做 IM 配置"的前提成立 ✓ |
| ② | 顶部 30-pin 丝印逐列（裁切逐字读）：`(CS/RS)(WR/RD)(RST/D00)(D01/D02)(D03/D04)…(D15/∅)(T_CS/SCK)(MISO/MOSI)(IQR/BL)(GND/3V3)` | **2026-10-04 更正**：原文写成 `(RST/∅)(D01/D00)…(D15/D14)` 是**把右列读高了一行**。正确列序如上；`∅`（=`T_BUSY`）挨着 `D15`，`D00` 挨着 `RST`。改图后与 J5 净名**逐脚一致** ✓（24=SCK→`TP_SCL`、26=MOSI→`TP_SDA`、22/23/25=NC ✓） |
| ③ | **P4 区（DE/PCLK/VSYNC/HSYNC）焊盘全空、无短接** | 四根**出厂悬空** ✗（规格要求"不用时接 IOVCC1 或 GND"）⇒ **上电前把它短到 GND**（焊锡搭接 P4 信号焊盘↔GND 焊盘，或飞 4 根短线）|
| ④ | 触摸模组 = **6-pin 电容 FPC**（丝印 `VCC/RST/INT/…/GND`，COF 触摸 IC）插在白色 FPC 座 | 与 §8.2 的 P6 映射、D2 推定一致 ✓；板上**电阻触摸（XPT2046）区域未见装件** ⇒ 与 CTP 争用 `T_*` 的风险低 ✓（上电后用 I²C 读 0x38/0x70 的 TD_STATUS 复核即可）|
| ⑤ | 其余：`TE`/`D16`/`D17` 测试焊盘、两个白色 2P 座（背光电源入/出，未用）、4 安装孔、`Parallel`/`SPI` 选择表 + 0Ω 焊盘、`0R/NC`（共用 SPI 用，**本设计不焊**）| 与 §6.6 观察一致 ✓ |

**⇒ 转接板这条路的设计收口**：底板侧无需再改（J5 逐脚正确、触摸/背光/复位路径与厂家一致），
也**不需要另画 30→45 小转接板**（D1 的逃生方案可搁置）；剩余只有 ③ 的搭接与 ④ 的上电复核两件小事。

### 6.13 屏接线**首次上板验证记录（2026-10-02）**

台面 26 根杜邦线（§6.11/§6.12 的方案）直接接天空星核心板，J-Link 烧录 + RTT 取日志。
**验证凭据 = 固件自检日志**（`firmware/build/Debug/rtt_verify.log`）：

| 判据 | 实测 | 结论 |
|---|---|---|
| `[SELFTEST] LCD ok, RDDID=00 FF FF FF` | ✅ 读到 4 字节 | **RS 地址译码 + 读写时序 + 16 位数据总线全通** ⇒ **26 根线的接法正确**（该判据只要求"读得到"，不判具体值 —— 不同批次 ID 有差异） |
| `[LVGL] 就绪：320x480 · draw buffer 48 行 · 池 32 KB @CCM` | ✅ | 屏初始化序列发完、背光已开、界面已建 |
| `[AI_READY] boot ok, uptime=3009 ms` + `heartbeat` | ✅ | 启动链走完、调度器起来了 |
| `[SELFTEST] ADC ok, 采到 64 点，码值范围 872 ~ 1052` | ✅ | TIM8→ADC1→DMA2 三跳全通 |
| `[LVGL] 就绪` + 屏实拍 | ✅ | 背光亮、界面已刷（见 §6.14） |
| `[SELFTEST] FT6336 读不到 TD_STATUS` | ❌ | **触摸 I²C 不通** —— 与 §1.6-E / §6.5-① 的预警一致（`SCK` 侧可能缺上拉）。待补 4.7k 或对调 SCK/MOSI 后复测 |

⇒ **屏与并口那 26 根线由"未验证"转正**（有上板日志）。**触摸总线仍未验证**（未过）。

⚠️ 本次上板同时暴露了**一串与接线无关的固件缺陷**（全部是"调度器启动前使用 FreeRTOS
原语"这一类），已修并复验；根因链与修法见 `.workbuddy-ai/memory/2026-10-02.md`。
**注意 `app.h` 顶部那条规矩的兑现**：ADC 自检因为要走 `xSemaphoreTake` 与 DMA 中断里的
`xSemaphoreGiveFromISR`，已从 `app_self_test()` 挪到 `app_adc_selftest()`（调度器后跑）。

### 6.14 屏"能初始化但不出界面"的根因（2026-10-02，已修）

**现象**（用户实拍）：背光亮、屏上**雪花 + 顶部一条白带**。
雪花按厂家口径 = 初始化已完成（§6.10-③）；白带宽度 ≈ **48 行 = 一个 LVGL draw buffer**
⇒ 指向"只刷了一块就停"。

**根因**：`Task/Src/app_lvgl.c` 的 `lcd_send_color()` **没有调 `lv_display_flush_ready(disp)`**。
LVGL 的 flush 是**异步握手**（驱动源码 `lv_lcd_generic_mipi.c` 里那句 note 写明），
不回这一句就永远等第一块 ⇒ 整屏只刷了第一块。
**该文件头第 9 行早已写着这条警告，只是漏了实现。**

**修法**：`lcd_send_color()` 末尾补 `lv_display_flush_ready(disp);`（本工程 `bsp_lcd_write_pixels`
是同步写，写完才返回，紧接着调是对的）。

**验证口径（不靠肉眼）**：读 `app_lvgl.c` 的静态计数 `s_flush_px`（`nm` 取址，J-Link 连读）——
修后 **339694 px ≈ 2.2 整帧**且停止增长、`s_fps_x10 = 0`（静屏空闲，设计如此）；
修前只可能是 48×320 = **15360 px**。差 22 倍 ⇒ 整屏确实刷完了。

⇒ **"注释里写了的规矩" ≠ "实现了"**。本工程已出现两次：本节这条、
以及 `app.h` 顶部"`app_init()` 里不许取 FreeRTOS 原语"（§6.13 的 ADC 自检）。
**接手这类工程时，把注释里的硬规矩逐条 grep 一遍看有没有实现，是省时的第一招。**

### 6.15 横屏与触摸总线（2026-10-02 晚）

**① 显示已改横屏 480×320（顺时针 90°）**
`Task/Src/app_lvgl.c` 加一句 `lv_display_set_rotation(s_disp, LV_DISPLAY_ROTATION_90);`。
读源码确认：**LVGL 9.5 不做软件旋转**，旋转是显示驱动的活 ——
`lv_lcd_generic_mipi.c` 的 `res_chg_event_cb` + `set_rotation()` 把它落到面板 **MADCTL**
（翻 `swap_xy`/`mirror_y`）⇒ **硬件旋转、零 CPU、不动绘制缓冲**；LVGL 自己把逻辑
分辨率换成 480×320。实测日志 `[LVGL] 就绪：480x320` ✓
（顺手把该行从打 `BOARD_LCD_*` 常量改成打 `lv_display_get_*_resolution()` —— 之前那行
旋转后会**说谎**，从日志看不出旋转生效没有。）
⚠️ 方向若反 ⇒ 只改 `LV_DISPLAY_ROTATION_270` 一处。⚠️ **触摸坐标也要跟着转**。

**② 触摸：全总线扫描证明"一个器件都不应答"**
`bsp_touch.c` 新增 `touch_scan_bus()`（`HAL_I2C_IsDeviceReady` 扫 0x08~0x77），
在 `bsp_touch_self_check()` 读失败时调用。实测：

```
[E] [TOUCH] I2C2 上**没有任何器件应答** —— 查 SCL/SDA 上拉（4.7k）、SCL·SDA 是否接对/接反、屏 3V3 是否到位
```

⇒ **排除"触摸 IC 型号不是 FT6336"**（若 GT911 会在 0x5D/0x14 应答，`§6.10-②` 那条
挂着的"请读丝印型号"到此**不必再读**）。
⇒ 坐实 `§1.6-E` 那个"分不出"的结论：**模块很可能只给 SDA 上了拉、SCL 没有**。
**下一步（按代价）**：模块 `SCK` ↔ 3V3 补 **4.7k** → 不行则 SCK/MOSI 对调 →
再不行量触摸 FPC 的 `VCC`（照片实读 FPC 6 脚 = `VCC/RST/INT/SDA/SCL/GND`）。

### 6.16 触摸不通的**根因定论**：SCL 缺上拉（2026-10-02，厂家例程为证）

**先排除两条**（查厂家例程 `02_STM32例程/TK035F9629_ST7796版/STM32_16位并口_标准库_电容触摸/project/bsp/touch/touch_CTP.c`）：
- 例程**全程不碰 RST**（`grep RST` 无命中）⇒ 不是复位时序问题，`§1.3` 的 CTP 脚序猜测不影响；
- `FT6206_ADDR = 0x70`（= 7 位 **0x38**）⇒ **与固件假设一致**，IC 型号确认是 FT6336/FT6206 系，
  `§6.10-②` 那条"请读丝印型号"到此**关闭**。

**根因（厂家例程的引脚模式 + 注释直接给出）**：

| 线 | 例程配置 | 例程注释原话 |
|---|---|---|
| **SCL**（PB13） | `GPIO_Mode_Out_PP` **推挽** | "由于只工作在主机模式，没涉及切换，所以 **SCK 直是输出模式，不用串电阻**" |
| **SDA**（PB15） | `GPIO_Mode_Out_OD` **开漏** | "硬件电路中一般**在 SDA 信号线上接一个电阻后再接 VCC**" |

⇒ **厂家例程用软件模拟 I²C，SCL 推挽驱动（能主动拉高）⇒ 不需要 SCL 上拉；
只有开漏的 SDA 要上拉 ⇒ 模块/转接板也只给 SDA 放了上拉。**
这与 `§1.6-E` 的 2026-09-29 实测**完全吻合**（`MOSI`/SDA 有上拉 ≈3.3V、`SCK`/SCL 只读到 2V）。

**而本工程走 STM32 硬件 I²C2 —— SCL/SDA 都是开漏（AF4），两路都必须外部上拉。**
SCL 没上拉 ⇒ 时钟线拉不起来 ⇒ 总线不通 ⇒ `§6.15` 的全总线扫描 112 个地址全无应答。

**⇒ 结论：不是漏接线，是台面缺上拉电阻。** 这正是**底板 `R15/R16`（4.7k I²C 上拉）**
的作用（`§1.6-D` 已论证"必须留"）—— 台面没有它们。

**修法**：模块 `SCK` 脚（或核心板 `PB10`）↔ 3V3 补一颗 **4.7k**。SDA 侧模块自带；
再补一颗也无妨（并联 ≈2.35k，仍在 I²C 合规区 2.2k~10k，`§1.6-D` 已算过）。
（另一条路：把触摸改成软件模拟 I²C，像厂家那样 SCL 推挽 —— 要写代码、丢硬件 I²C 优势，**不推荐**。）

**§6.16 补：证据链收口（同日）**

- **接线是对的**：转接板原理图网络名显示 30-pin **第 24 脚 = `SCL`、第 26 脚 = `SDA`**
  （即 `T_CS|SCK` 行的右脚与 `MISO|MOSI` 行的右脚），与接线卡的 `SCK→PB10`、`MOSI→PB11` 一致。
- **型号/地址/寄存器宽度都对**：厂家例程 `FT6206_ADDR=0x70`（7 位 `0x38`）、8 位寄存器、**全程不碰 RST**。
- **本板 MCU 侧无上拉**：`Core/Src/i2c.c` 里 `GPIO_InitStruct.Pull = GPIO_NOPULL`。
- **转接板上唯一的上拉 `R9`(4.7k) 挂在 `INT` 上**（与 §1.6-E 实测"`IQR` 有上拉"吻合），
  **`SCL`/`SDA` 上没有上拉电阻**；厂家例程也只给 SDA 上了拉（SCL 靠推挽驱）。
⇒ 综合仍是 **SCL 缺上拉**。**10 秒确认**：断电，量模块 `SCK` 脚 → 3V3 的电阻，
开路 = 缺上拉 ⇒ 补一颗 4.7k。
⚠️ **别用"空闲电平高"当判据** —— 悬空脚也会读 1（本次就栽在这条上，日志已改成诚实说法）。
**第二怀疑对象**：触摸 `RST`（转接板上未见其拉高电阻；`R8` 18K 是屏 RESX 那一路）。

**§6.16 再补（同日，测法纠错 + 上拉排除）**

- ⚠️ **"断电量 `SCK`→3V3 电阻"这个判据不成立**：用户实测红黑互换得 **8.4k / 14k**，
  两个方向不同 ⇒ 路径里有 **ESD 保护二极管**，不是电阻。**在路测半导体无意义。**
  ⇒ **正确测法是上拉的定义**：拉低 → 松开 → 看能否自己回高。已由固件实现
  （`bsp_touch.c` 的 `line_has_pullup()`），**实测两条线都有上拉** ⇒ **上拉这条排除**。
- **扫描前必须先复位 I²C 外设**（`HAL_I2C_DeInit + MX_I2C2_Init`），否则
  `bsp_touch_init()` 那次失败会把外设留在 BUSY 态，后续每个地址都立刻返回 `HAL_BUSY`
  （**根本没上总线**），错误码全是 TIMEOUT —— 会得出"时序没形成"的**假结论**。
- **干净数据**：首次失败 `State=0x20(READY)` / `ErrorCode=0x20(TIMEOUT)`；
  上拉都有；两线都没被拉死。
  ⇒ **失败是 TIMEOUT 而不是 NACK** ⇒ 指向"线序 / 从机拉死时钟"，不是"器件不在"。
- **下一步顺序**：① 对调 `SCK`(24)/`MOSI`(26) 重试；② 触摸 FPC 插到位 / `VCC` 有电；
  ③ `RST`（FPC 第 2 脚）是否被拉低。

### 6.17 LVGL 诊断浮层（2026-10-02）

`Task/Src/app_lvgl.c`：诊断浮层建在 **`lv_layer_top()`** 上（浮在所有页面之上、切页面不丢），含
- 状态标签：`fps 12.3   touch 123,45  DOWN` / `up`，无触点显示 `--,--`；
- 触点红点：按下时 `lv_obj_set_pos(x-9, y-9)`，抬起隐藏。
⚠️ 必须 `lv_obj_remove_flag(lv_layer_top(), LV_OBJ_FLAG_CLICKABLE)`，否则 top 层吃掉触摸事件、界面点不动。
⚠️ `touch x,y` 是 **LVGL 坐标系**（横屏下 480×320）；对不上要改 `bsp_touch_read()` 的映射，不是改这里。
