funiang-x/G2026/hardware/05-原理图评审与改造方案.md

# G2026 硬件 · 05 原理图评审与改造方案 · v1

> 对象：立创 EDA 工程 `ai`（工程 uuid `a45fc831…`，三页）
> 日期：2026-09-28 · 性质：**评审 + 改造方案**（本文不改冻结参数，只把"图与冻结参数不符"的地方摆出来）
> 状态：**待 [CHK] 人确认**，确认后按 §4 执行改造
> 证据：画布实读（`_review/inventory.json`、`_review/netlist.json`、`_review/src_*.txt`）+ 本目录脚本复算

---

## §0 评审口径

- **三态**：**已验证**（跑了哪条命令、结果如何）/ **未验证**（为什么没跑）/ **不适用**。
- 本次评审全部结论均为**画布实读**或**脚本复算**，无凭记忆项。
- 判据来源：`01-requirements.md`（约束表）、`02-architecture.md`（链路与推导）、`03-components.md`（选型表）、`04-pinout连接表.md`（引脚真相源）。

---

## §1 现状快照（画布实读）

| 页（uuid） | 页面名 | 内容 | 器件 | 导线 | 网络端口/旗标 | 有效位号 |
|---|---|---|---|---|---|---|
| `fe840e6f545a2753` | **P2** | 前端模拟（AFE） | 40 | **0** | 82 | **0** |
| `0c870c063661db6c` | **P1** | 电源 + 背光 + IM 绑定 | 20 | **0** | 44 | **0** |
| `63accad121e053cf` | **ai** | 核心板 + 屏 FPC + 触摸 FPC + 板间互连 | 6 | 80 | 103 | 3（EVK1/U9/U10） |

**先说一条澄清（避免误判）**：AFE/PWR 两页虽然**一根线都没有**，但连接是**成立的**——
网络端口被精确放在引脚端点上（`端点 = 引脚根 + 引脚长 × 方向`，见 `label_plan.py::endpoint()`），
属"纯标签式连线"。所以**不是电气断路，是图纸不可读**。这一点与"画得不好"的用户直觉吻合。

**位号状态**：AFE/PWR 的 60 个器件**全部是 `U?/R?/C?/L?/D?/CN?`**，无一个有效位号。

---

## §2 问题清单

### A 级 —— 会让板子做错 / 指标必挂（必须改）

| # | 问题 | 画布实际 | 冻结要求 | 证据 | 后果 |
|---|---|---|---|---|---|
| **A1** | **核心板符号选错型号** | `立创·天空星开发板-**GD32F407VET6-青春版**`（`LCKFB-LSPI-SkyStar-GD32F407VET6-LITE`，C20607214） | `立创·天空星 **STM32F407VGT6 高配版**`（01 约束#9 / 03 结论#1） | `_review/netlist.json` EVK1 props | MCU 品牌/容量/外设全变；**高配版独有的 VREF+ 三路可选（外部基准注入路径）在青春版上未必存在** → 03 风险 R3 由"待确认"升级为"已踩雷"；固件按 STM32 HAL + F407VGT6 写，全部前提失效 |
| **A2** | **背光限流电阻值错 118 倍** | `rbl` = **330 mΩ**（1206W4F330） | **39 Ω / 0.5 W**（04 §3 明确"33Ω 改 39Ω"） | `place_parts.py:60` + 画布值 | 5V 经 0.33Ω 直灌 LED-A：限流几乎只剩 LED 自身 ESR → 电流数十安级 → **屏背光当场烧毁** |
| **A3** | **ADC 隔离电阻值错 10 倍** | `r100` = **1 kΩ**（0805W8F1001） | **100 Ω**（02 §3、03 #11） | `place_parts.py:32` | 与 470pF 组成极点从 3.39MHz 掉到 **339kHz** → 500kHz 处 **−5.0dB**、带内不再平坦；虽属 LTI 可标定，但 17 点标定表要吸收 5dB 的斜率，且违背"Rsrc=100Ω"设计口径 |
| **A4** | **三个电感值偏离冻结值，直接把抗混叠打穿门槛** | L3=**15µH**（应16）、L5=**18µH**（应20）、L7=**12µH**（应11） | L = 3.9/16/20/11 µH | `place_parts.py:21,23,25` + `_lc_recheck.py` 复算 | **@1.5MHz 衰减 −42.18dB，不满足 −42.5dB 门槛（差 0.32dB）** → 折叠带残留超出峰门限预算，02 §4 的整条反解失效 |
| **A5** | **滤波电容介质违规（3/4 只）** | C2=7.5nF **X8R** 1210；C3=6.8nF **X7R 630V** 0805；C1=4.3nF **U2J** 0603；C4=1.6nF C0G **0402** | 信号/滤波路径**必须 C0G/NP0**（01 #10、03 #10） | 画布器件属性 `Temperature Coefficient` | X7R/X8R 容值随温度/偏压漂移（±15% 量级）→ 滤波器形状不可控，直接命中 R4/HB4；0402 违反**手焊**工艺约束（01 #10 禁 0402） |
| **A6** | **输入 TVS 结电容超标** | `PESD5V0S1BA`，**Cj ≈ 30pF (Typ)** | **≤ 5 pF**（01 #5、03 #8） | DOWOSEMI/东沃 `ESD-PESD5V0S1BA` datasheet（2026-09-28 查）；NXP 同型号亦为"低容"系列 | 并接在 50Ω 端接节点：@1.5MHz 容抗 3.5kΩ ∥ 49.9Ω → 阻抗偏 1.5%、相位 −0.8°。**不致命但违反约束**，且是与滤波器级联的复阻抗项，标定吸收不干净 |
| **A7** | **5V 入口"自恢复保险"用错元件** | 只放了 `SS34`；"保险"位置实际是 **330mΩ 厚膜电阻** | **SS34 串入 + 自恢复保险（PPTC）**（02 §6 O10、03 #15） | `place_parts.py:50,60` | 电阻不熔断：短路时 5V/0.33Ω → 15A/75W，**保护功能为零**，且电阻自身炸裂可能引燃 |

### B 级 —— 图纸不可交付（出不了 BOM / 无法评审）

| # | 问题 | 证据 | 后果 |
|---|---|---|---|
| **B1** | **60 个器件零位号**（全 `?`） | `_review/inventory.json` | 出不了 BOM、无法贴片、无法对图、无法写"把 R12 换成…" |
| **B2** | **位号前缀系统性错乱** | 18µH 电感标 `U?`、22µF 钽电容标 `U?`、6 个测试点标 `U?`、BNC 标 `CN?`、连接器标 `U?` | 即便做了标注，前缀也是错的；BOM 分类与 PCB 装配全乱 |
| **B3** | **AFE/PWR 零导线** | 画布 `wireCount = 0/0` | 主信号链 BNC→TVS→端接→AC耦合→BUF1→LC8→GAIN→ADC 在图上**看不见**，评审者只能逐个标签名追；且靠名字匹配的隐式连接，**任一处名字打错即静默断链**（EDA 不报错） |
| **B4** | **网络命名三套并存，与 pinout 表对不上** | AFE 用 `AFE_B1_IN/AFE_G1_OUT/AFE_G2_FB/F1..F5`；04 §2 用 `AFE_FILT_IN/AFE_FILT_OUT`；电源三套 `+5V/+5V_RAW/+5V_A`、`GND/AGND`、`+3V3` | 文档↔图不一致，交接必出错 |
| **B5** | **OPA2197 拆成两个独立符号** | 画布两处 `U?`（同一 device `d8ce77080adbe3fc`），各自独立 | BOM 会出 2 片（实际 1 片）；PCB 出现 2 个 SOIC-8；应做 **U1A / U1B** 双通道 |
| **B6** | **页面命名与内容无关、页序颠倒** | 工程名 `ai`；页名 `ai`(INT) / `P1`(PWR) / `P2`(AFE)，第 1 页是 INT | 打开工程不知道哪页是什么 |
| **B7** | **无标题栏内容** | `titleBlockData` 全空 | 无工程名/版本/日期/页码，不可交付 |
| **B8** | **同一位置放两个 `AFE_TERM` 端口** | 画布 (160,1050) 处两个同名端口叠放 | 冗余，易误改 |
| **B9** | **板间互连连接器针数不符** | `J2/J3` = `W10006-206MG0ER1`（**2×6P** SH1.0 SMT） | 04 §5 写 **2×7**；针数对不上，AGND/ADC_IN/VBIAS/VREF 四条模拟线 + 电源的分配需重定 |

### C 级 —— 设计里写了、图上没落（缺件）

| # | 缺什么 | 依据 | 说明 |
|---|---|---|---|
| **C1** | **FSMC 33Ω 串阻 ×N** | 02 §6 O7、03 #13 | ✅ 已落图 18 只（`R22`~`R39`，INT 页 J5 侧，2026-10-01，见 `22` 号文档）；原判：PWR/INT 两页无任何 33Ω；EMI 源头治理未落地 |
| **C2** | **运放电源去耦** | 工程惯例 | AFE 页的 100nF×2 是 AC 耦合电容，不是去耦；**OPA2197 的 V+/V− 没有就近 100nF** |
| **C3** | **PPTC 自恢复保险** | 见 A7 | — |
| **C4** | **0Ω 断点未标位号** | 02 §6 O8 | 3 个 0Ω 存在（数量✓），但应标 `JP1/JP2/JP3` 并加丝印注释 |
| **C5** | **测试点未标位号** | 02 §6 O3 | 6 个测试点存在（数量✓），应标 `TP1..TP6` 并注明对应节点 |

### D 级 —— 命名/注释（小）

| # | 项 |
|---|---|
| D1 | `led1` 搜索词写 "LED 0805 red"，实际落料 `KT-0805Y` **黄灯** |
| D2 | `cin/cout` 用 22µF 钽电容（ESR 2.3Ω）做 REF3033 输入/输出——基准输出建议陶瓷（datasheet 量级 1~10µF），钽电容噪声不利 |
| D3 | `cin`/`cout` 被选成两个**不同厂牌/不同库条目**的 22µF（一个前缀 `U?` 一个 `C?`），是 B2 的一个来源 |
| D4 | `j3`(AFE) 与 `j2`(INT) 同型号同功能，命名不统一 |

---

## §3 数值复算：A4 的量化（脚本 `_lc_recheck.py`）

8 阶巴特沃斯 · 双端接 50Ω · fc=800kHz · 级联 ABCD 求 |S21|：

| f | 设计值 (L=3.9/16/20/11) | 画布值 (L=3.9/**15/18/12**) | 差 |
|---|---|---|---|
| 100 kHz | −0.000 dB | −0.000 dB | — |
| 500 kHz | −0.011 dB | −0.007 dB | +0.004 |
| 800 kHz | −2.914 dB | −1.305 dB | +1.609 |
| 1.0 MHz | −15.054 dB | −12.927 dB | +2.127 |
| **1.5 MHz** | **−43.104 dB** | **−42.180 dB** | **+0.923** |
| 2.5 MHz | −78.817 dB | −78.129 dB | +0.688 |

**判据**（02 §4 反解）：折叠带起点 1.5MHz 需 **≤ −42.5 dB**。

- 设计值：−43.10 dB → **通过**，余量 +0.60 dB（注：`02 §4` 写 −43.7dB，口径略有差异，量级一致）。
- 画布值：−42.18 dB → **不通过**，**欠 0.32 dB**。

> ⚠️ 即使改回设计值，余量也只有 0.6 dB —— 与 `docs/02 §2` 已登记的 **HB2「混叠残留余量薄」** 一致。
> 这意味着 A4 修好只是"回到合规线"，不是"回到安全区"。是否顺手启用 **Plan B（Cauer n=6，Amin=50dB）**，见 §5 待拍板 T4。
>
> **口径备注（2026-09-28 补）**：项目日志（`.workbuddy-ai/memory/2026-09-28.md`）记录 SB4 已澄清——
> 0.655mV 与 1.309mV 是**不同参考点**（输入端 vs ADC 端，比值 = 4×0.5 = 2），
> 误差预算表与峰门限 1.5mV **都在输入端域**，故若按输入端域反解，门槛应为
> `100mVpk × |H| ≤ 1.5mV → −36.5dB`，而非 `02 §4` 写的 −42.5dB。
> 两个口径的差异不影响本节结论的**方向**（画布值最差、设计值勉强），
> 也不影响 §4 的改造定案：**fc=660kHz 方案在两种口径下都通过，余量分别为 16.8dB / 22.8dB**。

---

## §4 改造方案（目标态）

### 4.1 总原则

1. **图必须自证**：主信号链用**实线**画出来，端口只用于跨页与电源/地。
2. **一位一号**：所有器件标注位号，前缀按器件类型（U/R/C/L/D/Q/J/TP/JP/FPC/CN）。
3. **一名一网**：网络名以 `04-pinout连接表.md` 为准，图与表**逐条对账**。
4. **一页一职**：页名 = `AFE` / `PWR` / `INT`，页序 AFE→PWR→INT，工程名改 `G2026-底板`。
5. **改一个数，重跑一次**：任何 LC/增益/采样参数改动，先重跑 `verify_afe_v2.py` 与 `tools/verify_dsp.py` 再落图。

### 4.2 AFE 页（重画）

- **信号链实线**：`J1(BNC) —D1(TVS)— R1(49.9Ω) —C1(100nF)— U1A(BUF1, G=1) —R2(49.9Ω)— [LC8] —C6(100nF)— U1B(GAIN ×4) —R? (100Ω)+C?(470pF)— JP2 — AFE_ADC_IN`，一条线走到底。
- **LC8 用子框圈起**，标注"8阶巴特沃斯 fc=800k 双端接50Ω"，元件值标设计值。
- **电源/地走旗标**：`+5V_A` / `AGND`；**跨页走端口**：`AFE_ADC_IN` / `VBIAS_1V65` / `VREF_3V3_EXT`。
- **功能分区**（虚线框 + 文字标题）：①输入保护与端接 ②缓冲 ③抗混叠滤波 ④增益与 ADC 驱动 ⑤基准与偏置 ⑥测试点与断点。
- **补**：U1 的 V+/V− 就近 100nF 去耦；REF3033 输出改陶瓷电容（10µF 0805 X7R + 100nF C0G，或按 datasheet）。

### 4.3 PWR 页（重画）

- 5V 入口：`DC005 → SS34 → PPTC → +5V_MAIN`（按 04 电源树统一命名）。
- 数字 3.3V：`AMS1117-3.3`（SOT-223）+ 22µF 钽输入 + 22µF 钽/10µF 陶瓷输出 + 100nF。
- 背光：`+5V_MAIN → R_bl(**39Ω 0.5W**) → LED_A`；`LED_K → Q1(SI2302) → GND`；`PB0 → 1kΩ → Q1_G`；`100kΩ` 栅极下拉；**恒亮禁 PWM**（注释写死）。
- IM 绑定：`IM0=GND / IM1=3V3 / IM2=GND`（8080-16bit），加醒目注释"**不得照抄厂家 SPI 转接板**"。
- I²C 上拉 4.7k×2；LCD_ID 100k→GND。
- ~~**补**：FSMC D0~D15/NE1/RS 的 33Ω 串阻（放在 PWR 或 INT 页，二选一，不重复）。~~ → ✅ **已落图（2026-10-01/02）**：`R22`~`R41` ×20，在 INT 页 J5 侧。

### 4.4 INT 页（修补为主，尽量保留现有走线）

- **替换 EVK1 符号为 STM32F407VGT6 高配版**（A1）→ 逐脚重核 `04 §1.1` 的映射。
- 屏 FPC-45P（H3）逐脚按 `04 §1.2` 表核对；触摸 FPC-6P（H4）按 `04 §1.3`（脚序仍为 [TBD]，图上加醒目注释）。
- 板间互连连接器针数按拍板结果（T3）统一。
- 处理悬空的 3 个 `={Manufacturer Part}` 标签。

### 4.5 三页共做

- 标题栏：工程名 / 版本 / 日期 / 页号 / 设计者。
- 网络名全项目唯一化 + 与 04 表对账脚本（`_netcheck.py`）。
- 出 BOM 并与 03 选型表逐条比对（脚本 `_bomcheck.py`）。

---

## §5 待人拍板项（[CHK]）

| # | 项 | 选项 | 建议 |
|---|---|---|---|
| **T1** | 核心板型号 | (a) 按文档换 **STM32F407VGT6 高配版** 符号 ／ (b) 实际就用 **GD32F407VET6 青春版**，同步改文档与固件前提 | **(a)**。除非手上只有青春版实物 |
| **T2** | 改造方式 | (a) **重建三页**（清空重画，位号/值/连线全部规范） ／ (b) 原地修补（保留现有坐标，只换错料+补位号+加线） | **(a)**。当前图的可读性无法靠补丁救 |
| **T3** | 板间互连连接器 | (a) **2×7**（按 04 §5） ／ (b) **2×6**（按现图，需删减一路） | **(a)**，但需确认 SH1.0 2×7 有货；或换 2.54 排针更利于手焊 |
| **T4** | 抗混叠余量 | (a) 只修回设计值（余量 0.6dB，薄） ／ (b) 顺手启用 **Plan B：Cauer n=6 @1.5M Amin=50dB**（余量 ≈7.8×，且**少一个电感**） | **(b)** 值得评估——A4 暴露的正是"余量薄"这个已知瓶颈；但需重跑 DSP 文档的滤波器模型 |
| **T5** | TVS 替代料 | 建议 `SRV05-4`（SOT-23-6，Cj≈1.5pF，立创 ¥0.08，手焊友好）或 `PESD5V0X1BCSF`（0.3pF，SOD-882 偏小） | `SRV05-4` |
| **T6** | INT 页 U9/U10 排母 | (a) 保留（作为核心板插座） ／ (b) 删除（改用排针直接对插） | 待用户答 |

---

## §6 变更记录

| 日期 | 变更 | 谁 |
|---|---|---|
| 2026-09-28 | v1 初稿：画布实读评审（A1~A7 / B1~B9 / C1~C5 / D1~D4）+ LC 数值复算 + 改造方案 + 6 项待拍板 | AI（待 [CHK]） |
