funiang-x/G2026/hardware/12-原理图二次评审-硬件资料核实.md

# G2026 底板 · 二次评审（基于屏规格书 + 核心板官方原理书 的逐条核实）· v1

> 日期：2026-09-29 · 性质：**只读评审 + 重构方案**（本文不改任何已冻结参数，**不打样、不动图**）
> 状态：**待 [CHK] 人确认**；实施前须先过 §7 的三项实测
> 评审对象：立创 EDA Pro 工程 `ai`（uuid `a45fc831…`）三页（AFE-前端模拟 / PWR-电源与背光 / INT-核心板与接口），
> 评审时点画布：器件 39+20+4 / 导线 56+39+82 / NO_CONNECT 11+0+60 / DRC **全部 4 · 致命 0 · 错误 0 · 警告 2 · 信息 2**（警告=器件标准化）
>
> **证据来源（全部为原文实读，无凭记忆项）**
> 1. `docs/TK035F…/01_文档规格书/TK035F9629_ST7796版/TK035F9629规格书v1.2.pdf`（P.4/5/6/9/10/11）
> 2. `docs/立创…STM32F407VET6…/第02章…硬件/立创梁山派·天空星开发板原理图_2024-01-17.pdf`（P.1/3/6/7）
> 3. 同目录 `原理图必读.md`
> 4. `docs/TK035F…/05_硬件转接板资料/` 两块厂家转接板：
>    - **通用亮度板**：`TK035F5501_转接板.pdf`（带坐标文本还原）
>    - **1000 亮度板**：`1000亮度转接板/Altium_…_Constant_current.schdoc`（Protel ASCII，可全文解析）
> 5. 画布实读：`_rv_pages.json`（器件/导线/端口）· `_rv_src_{AFE,PWR,INT}.txt`（页面源码）
>    · `_rv_netlist.txt` + `_rv_netsum.txt` + `_rv_pinmap.txt`（EDA 自导网表，逐脚核对）

---

## §0 评审口径

- **三态**：**已验证**（附命令/读数）/ **未验证**（说明为何没做）/ **不适用**。
- 凡涉及"上板"的结论一律 **未验证** —— 装置尚未制造（工作台铁律 1），本文只做图纸与资料层面的判定。
- **唯一可信的连通性判据 = EDA 自导网表/DRC**，本文的连通性结论全部引自 `_rv_netlist.txt`。

---

## §1 资料通读：三份带来结论的原文

### 1.1 屏规格书 TK035F9629 v1.2（45 脚 FPC）

| 页 | 关键原文 | 对设计的意义 |
|---|---|---|
| P.4 | Driver IC **ST7796**；320RGB×480；Interface **System parallel**；Input voltage 2.8V | 与设计一致 |
| P.6 | 背光 **Vf 2.9 / 3.1 / 3.6 V**（min/typ/max）；Lv 2600/3000/3400 cd/m² @ **If=60mA**；**Number of LED = 4 · Connection mode = P（并联）**；**"Using condition: constant current driving method If=60mA(±10%)"** | **规格书明确要求恒流**；单结压降（3.1V）⇒ LED 为**并联**，非串 |
| P.9~11 | IM0/IM1/IM2 = "接口选择脚"（无内部上下拉描述）；DE/PCLK/VSYNC/HSYNC "不用时接 IOVCC1 或 GND"；TE "不用时请悬空"；**LED-K1~K6 = Cathode**；LED-A = Anode(3.0~3.4V)；**LCD-ID "此脚位接 100K 欧姆的电阻到地，不用时此脚可悬空"** | IM 必须**外部**配置；TE/DE 组接法有明确规定；LCD-ID 的 100k **可由用户接也可悬空** |
| P.11 | REFERENCE APPLICATION CIRCUIT：**"Please consult our technical department for detail information."（无参考电路）** | 厂家**不给**参考电路 ⇒ 背光/接口的具体做法只能从厂家**转接板实物图**反推 |

### 1.2 天空星 STM32F407 官方原理图（2024-01-17）

| 页 | 关键原文 | 对设计的意义 |
|---|---|---|
| P.3 | **U4 = REF3030AIDBZR**（TI REF30xx 家族，3.0V，SOT-23-3）+ C21 470nF；注释 **"板载参考电压芯片"**；网络 `CHIP_VREF` | **核心板自带精密基准** |
| P.6 | **"三路参考电压，三者存其一"**：① 内部 3V3 经磁珠 ② 板载基准 U4 ③ 接外部排针（`EXT_PIN_VERF+`）；换路靠 **R1/R2/R6/R7 四个 0Ω（图上标 `0Ω(N)` = 不贴）** 与 R5 0Ω；另有注释 **"【用外部基准源时需要去掉】"** | 底板**可以**外部注入，但**必须先断开核心板侧默认通路** |
| P.6 | `SMT生产兼容一览`：`STM32F407Vx → R5 贴 / R6 不贴 / R7 不贴 / C8 贴 / C9 贴`；另有 **R8 0Ω = AGND–DGND 单点** + 注释 "数字地与模拟地单点相连" | 具体是哪一路在导，**必须实物/实测确认**（见 §7 T3） |
| P.7 | 双路 80Pin 排针：`+3V3`（38/78）· `GND`（39/77/79）· `PIN_IN_+5V`（40/80）· **`EXT_PIN_VERF+`** · `AGND` | **底板 3.3V 可直接从核心板取**；外部基准注入脚 = 本图 EVK1 pin2（符号名 `REF`）✅ |
| P.3 | 5V 入口：USB/排针共用 **F1 0603 500mA 保险 + 钳位 + 防反接** | 核心板的保护**只覆盖核心板支路**（文档 02 §6 O10 的判断正确） |
| `原理图必读.md` | 本资料包是 **STM32F407VET6 版**；与 GD 版差异仅"芯片换 STM32F407VET6 + C8/C9 贴上" | 与工程按 **VGT6 高配版** 写的固件前提**不完全一致** → 见 §7 T7 |

### 1.3 厂家两块转接板（本次评审的"关键反证"）

| | **通用亮度板** `TK035F5501_转接板` | **1000 亮度板** `…_Constant_current` |
|---|---|---|
| 背光 | **LED-A（脚44）直接接 3.3V**；LED-K1~K6 并联 → `Q1(SI2302)` 低边 → GND；`R7 10K` 栅极下拉；`BL_CTR` 控栅。**全板没有任何背光限流电阻** | **恒流升压驱动**：`LP3321B6F`（LX/GND/FB/EN/VIN）+ `4.7µH`(SWPA3015S4R7MT) + `SS14HS` 肖特基 + **`5R1` 采样电阻** + `1uF/4.7uF`；LEDA→LED 串→LEDK→5R1→GND，FB 检采样电阻压降（图上手写 `U=204mV`） |
| IM 配置 | **R1/R2（IM0）、R3/R4（IM1）、R5/R6（IM2）—— 每脚一对 0Ω，可选 3V3 / GND** | 同样一对一对 |
| 触摸 | `R9 4.7K`（**只一颗，在 INT 上**）；`R8 18K + C5 104` = "硬件阻容复位"（RST） | 同 |
| LCD-ID | **没有任何 100k**（ID 脚按规格"可悬空"处理） | 同 |
| 取值来源 | 带坐标 PDF 文本还原（`_adapter_pdf_p1.txt`） | Protel ASCII 全文解析（`_cc_report.txt`） |

> **三条直接推论**
> 1. **屏模组内不含背光恒流驱动**（否则 1000 亮度板不必另做一颗 LP3321）；
> 2. **屏模组内不含 IM 配置**（两块转接板都要外配）；
> 3. **通用亮度板把 LED-A 直挂 3.3V 且无限流** ⇒ 要么模组**内部已有串阻/限流**，要么厂家板本身就是个隐患。
>    **这条只能靠实测证伪**（§7 T1）——它直接决定底板 R14 该取多少。

---

## §2 总体判定：设计是否合理

**结论：架构合理，局部有 1 处致命、1 处严重、若干冗余。图纸完成度约 85%。**

合理之处（评审确认，不必动）：

1. **分板形态正确**：核心板（自带 MCU/LDO/基准/FLASH/晶振/保护）+ 底板（只放接口与模拟）。
2. **AFE 拓扑自洽**：`BNC → D1(SRV05-4, Cj≈1.5pF) → R1 49.9Ω 端接 → C1 100nF → JP1 → U1A(G=1) → R3 49.9Ω → L1-C2-L3-C4-L5-C6-L7-C8(8 阶, fc=660k) → R4 49.9Ω → C9 100nF → U1B(×4 = 1+30k/10k) → R8 100Ω+C10 470pF → JP2 → EVK1.3(PA0)`。
   网表逐级核对：**梯形结构 L-C-L-C-L-C-L-C 正确**（首元件串联、末元件并联，双端接 50Ω 规范）✅
3. **地/基准分离正确**：`AGND`（含 EVK1.37 VSSA 脚）与 `GND` 在图上分开，单点在核心板内 → 实读网表确认二者无同点 ✅
4. **屏接口逐脚正确**（实读网表，`_rv_pinmap.txt`）：
   - H3.1 TE 悬空 ✅；H3.3/4/5/7（DE/PCLK/VSYNC/HSYNC）→ GND ✅（规格书允 IOVCC1 或 GND）；
   - H3.11/12（IOVCC1/VCI）→ +3V3 ✅；H3.13/14/15/16（DIN/DOUT/DB17/DB16）NC ✅；
   - H3.17~32 = LCD_D15~LCD_D0 ✅（与 EVK1 的 FSMC 脚逐条对齐，DB0/DB1 已正确接上）；
   - H3.33~37（RESX/RDX/WRX/DCX/CSX）→ LCD_RST/RD/WR/RS/CS ✅；H3.38~43 → BL_K ✅；H3.44 → BL_A ✅；
   - EVK1 引脚映射与 `board_config.h`/`04-pinout连接表.md` 逐条一致 ✅（PA0=pin3、PA1=pin4、PD14/15→D0/D1、PE7~PE15→D4~D12、PD8~PD10→D13~D15、PD4/5/7/11、PB0/1、PB10/11、PC4/5 全部对号）
5. **核心板符号已换对**：`LCKFB-LSPI-SkyStar-STM32F407VGT6-PRO`（原 GD32 青春版已替换）✅
6. **滤波器复算扎实**：fc=660k 定案，折叠带最差 −59.3dB（判据 −42.5dB），5000 次蒙特卡洛 0 跌破。
7. **背光"禁 PWM"决策正确**：PWM 谐波列会整列落进 10k~500kHz 分析带，与题面判据冲突；`board_config.h` 已把 PB0 锁死为纯开关。

---

## §3 冗余与可简化清单

> 判据：**该功能是否已由核心板/屏模组/厂家转接板提供？删掉会不会改变电气语义？**

| # | 冗余/可简化项 | 现状（实读） | 判定 | 建议 |
|---|---|---|---|---|
| **R-1** | **底板的 AMS1117-3.3 与其 3 颗电容** | `+3V3 = {…, EVK1.38(3V3), EVK1.78(3V3), …, U3.2(VOUT), U3.4(VOUT)}` —— **底板 LDO 与核心板 LDO 输出并联在同一节点** | **是冗余，且是缺陷**（见 §4 P0-2） | **删 U3 + C16/C17/C18**，底板 3.3V 直接吃 `EVK1.38/78`。负载仅 ~30mA（IOVCC1 15 + VCI 5 + FT6206(FT6x06) 2 + 上拉 3 + 指示 1.3），核心板 LDO 1A 余量 33× |
| **R-2** | **外置 REF3033 + C12/C13 + JP3（+分压改值）** | U2 REF3033AIDBZT + C11/C12/C13 + JP3 + R9/R10 | **取决于核心板默认档**（见 §6） | 若核心板**板载 REF3030 可用** → **整块删**（同为 TI REF30xx 家族：±0.2% / 50ppm/℃）。省 5 件 + 1 断点 + 1 路跨板走线 |
| **R-3** | **J2 + J4（2×7 SH1.0）"板间互连"** | AFE 页 J2 ↔ INT 页 J4，两者在**同一块 PCB** 上串联了 `+5V_A / AGND×2 / AFE_ADC_IN / VBIAS_1V65 / VREF_3V3_EXT` | **单板内的纯冗余** | mV 级模拟通路串两个接插件 = 接触电阻 + 热电势 + 2 个故障点。**不做双板拆分就删掉、同页直连** |
| **R-4** | **D1 SRV05-4 的 3 个通道** | 实读：`D1.1/D1.3/D1.6` 全部未接（NC），只用 `D1.4` 一路 | 略微冗余 | 可用单路低容 ESD 替代；但 SRV05-4 手焊友好、≈¥0.08，**保留可接受**（列在"可不动"） |
| **R-5** | **R20 100k（LCD_ID）** | `LCD_ID = {H3.45, R20.1}`；固件全仓**无** LCD_ID 引用（grep 0 命中） | **功能上冗余** | 规格书"不用时可悬空"→ **可删**（省 1 件）；保留也无害 |
| **R-6** | ✅ **已闭（2026-10-01/02）**：33Ω=`R22`~`R39`、PPTC=`F1`、U1 去耦=`C14` 均已落图，另补 J5 去耦 `C21/C22`（见 `22` 号）—— 原：空置的 33Ω FSMC 串阻 / PPTC / U1 去耦 | **确认未落图**（三项在 `06 §2` 已定料、`06 §6.3` 已挂账） | **不是冗余，是缺件** | 见 §5 P1-3 |

---

## §4 三个重点核实项（逐一给结论）

### 4.1 ③ **"背光恒流驱动" —— 名不副实，且 R14=39Ω 的方向存疑**

**实测（画布 + 网表）**

```
+5V → R14(39Ω, 1206) → BL_A(H3.44)
BL_K(H3.38~43 并联) → Q1(SI2302).D → GND ;  Q1.G → R12 1k ← PB0(LCD_BL_CTL) ; R13 100k 下拉
```
⇒ **这是一个"限流电阻 + 低边 MOS 开关"，不是恒流源。** 分区框标题"③ 背光恒流驱动"与实现不符。

**规格要求 vs 现状（量化）**

| 项 | 规格书 | 本设计 39Ω | 33Ω（备选） |
|---|---|---|---|
| 工作方式 | **constant current driving** | 电阻限流 | 电阻限流 |
| If | **60mA ±10%（54~66mA）** | **48.7mA**（Vf=3.1V 典型）→ **−18.8%** | 57.6mA → 窗口内 |
| 分档跨度（Vf 2.9~3.6V） | — | 53.8 ~ 35.9 mA（**−10% ~ −40%**） | 63.6 ~ 42.4 mA |
| dI/dVf | — | **−25.6 mA/V** | −30.3 mA/V |
| 温漂（~90K 跨度，Vf −2mV/K） | — | ΔI ≈ **+4.6mA** | +5.4mA |
| R14 功耗 | — | 92 mW（1206/250mW ✅） | 111 mW ✅ |

**关键判断**

1. **39Ω 把典型工作点从窗口内挪到了窗口外**：`(5−3.1)/0.06 = 31.7Ω` 才是"典型 Vf 命中 60mA"的值；33Ω 给 57.6mA（窗口内），39Ω 给 48.7mA（窗口外）。
   06 号文档当初"33Ω→39Ω"的理由是"落在 42~64mA 的区间中部"，但**规格书的合规窗口是 54~66mA，不是 42~64mA** ⇒ 该次改值方向反了。**这是本次评审对既有文档的一处更正。**
2. **但 39Ω 到底对不对，先得知道模组内部有没有串阻**（见 §1.3 推论 3）：
   `I = (5 − Vf) / (39 + Rint)`。若模组内含串阻（通用板 3.3V 直驱仍不烧，强烈暗示如此），则实际电流比上表更低。
   ⇒ **R14 的最终值必须由实测反推，不能按纸面定**（§7 T1）。
3. **是否要真恒流？我的建议：不必须。** 理由：
   - 题面判据是**幅值/频率测量**，背光亮度不在判据内；
   - 线性恒流 sink 会引入一个控制环路，而本项目对 10k~500kHz 频段的任何电源扰动都极度敏感（mV 级 AFE），**电阻是"最安静"的方案**；
   - 真要合规且稳亮，正确路线是**线性恒流**（不是厂家 1000 亮度板那种升压：本设计 5V 已高于 Vf，不需要升压）。
4. **保留的合理点**：背光挂在**数字 +5V**（不是 +5V_A），不污染模拟轨 ✅；低边开关 + 栅极下拉 ✅；禁 PWM ✅。

> **口径更新（2026-09-29，来自厂家《液晶屏通用说明》P.1 ○3）**：
> **"如果背光是并联的，可以用 3.3V 串联限流电阻点亮，如果是串联的，则要升压恒流源点亮。"**
> 本屏背光 `Connection mode = P`（并联）⇒ **厂家明说"串联限流电阻"是被认可的驱动方式，不必上恒流源**。
> ⇒ ③ 的争议**收敛为一条**：**不是"要不要恒流"，而是"R14 的阻值与供电电压要按实测的 A–K 特性定"**
> （模块内可能已含串阻；厂家自己的通用转接板把 LED-A 直挂 3.3V 无串阻，也指向"模块内已有内阻"）。
> 下方案 A 即为定案方向。

**结论**：③ 不是恒流驱动。三选一（待人拍板）：
- **(A) 最省**：改名"③ 背光开关与限流"，R14 按实测定（预计 33Ω 或 30Ω），接受亮度随 Vf/温度漂 ±20%~25%。（**推荐**）
- **(B) 合规**：加一颗线性恒流 sink（SOT-23 级，如 AL5802/BCR 类）+ 采样电阻，恒流 60mA。多 2~3 件、多 0.3W 热。
- **(C) 上调亮度**：改用厂家 1000 亮度恒流升压板（LP3321B6F 路线）——**不推荐**（需要改接插件、且升压是开关源，对 AFE 更不利）。

---

### 4.2 ④ **屏接口配置与上拉 —— 模组"没带"，底板这几件不是冗余；但有一处漏项**

**逐条判定（"模组是否已包含"）**

| 子项 | 模组/厂家板是否已含 | 本底板 | 结论 |
|---|---|---|---|
| **IM0/IM1/IM2 配置** | **不含**。屏 FPC 上只是三个输入脚（P.9~11 无内部上下拉描述）；两块厂家板都用 0Ω 外配 | R17/R18/R19 单只 0Ω：**IM0=GND / IM1=3V3 / IM2=GND**（网表实读 ✅）→ IM[2:0]=010 = **8080-16bit 正确** | **不是冗余，必须保留**。<br>小优化：按厂家做法改成"每脚一对 0Ω 焊盘"（+3 个焊盘，0 成本），保留切 SPI 的返工余地。<br>小瑕疵：PWR 页注释写"R17/R18/R19 → IM0/IM1/IM2"，实际是 **R18→IM2、R19→IM1**，注释与实连错位 |
| **数据/控制线是否需要上拉** | 不需要（8080 并口为推挽驱动） | 无 | ✅ 正确，无需添加 |
| **I²C（TP_SCL/TP_SDA）上拉** | **厂家通用板只给了 INT 一颗 4.7K，SDA/SCL 没有** ⇒ 要么模组自带，要么由主控侧给 | R15/R16 各 4.7k → +3V3 | **保留是稳妥的**，但**必须实测模组侧**：<br>· 若模组自带 4.7k ⇒ 并联成 2.35k（3.3V/2.35k ≈ 1.4mA 常流，上升沿可能过冲）→ 可改 0Ω/删除<br>· 若模组不带 ⇒ 现状正确，**不能删**（`board_config.h` 也写明"I2C 需要外部上拉"） |
| **TP_INT 上拉** | 厂家板 **有** `R9 4.7K` 上拉 INT；模组是否自带未知 | **没有**（`TP_INT = {EVK1.12(PC5), H4.6}`，无上拉电阻） | ⚠️ **漏项**。FT6206(FT6x06) 的 INT 通常为开漏输出；若模组内无上拉 + MCU 不开内部上拉 ⇒ **INT 悬空，触摸中断失效**。**建议补 4.7k→+3V3**（或实测确认模组已带） |
| **TP_RST 上电默认电平** | 厂家板用 `18K + 100nF` 硬件阻容复位 | 直连 PC4（GPIO） | ⛔ **已被覆盖（2026-10-02）**：TP_RST 已删（`13 §D4`），触控复位与屏 `LCD_RST` 共用（正是这颗 RC），固件复位脉冲低 20ms（`bsp_lcd.c:55-59`）⇒ "上电状态未定义"不再成立。原判：⚠️ **弱项**。复位后 GPIO 默认输入浮空 ⇒ FT6206(FT6x06) 的 RST 悬空、状态未定义，直到软件跑起来。（厂家板之所以用 RC，是因为它没有 MCU 线控。）<br>**建议**：补 `100k` 上拉到 +3V3（成本≈0，不影响 GPIO 线控），或明确要求软件在最早期驱动 PC4 |
| **LCD_ID 100k→GND** | 厂家板**完全没有**；规格书"不接也可悬空"；固件不读 | R20 100k → GND | **可选件**。保留=符合规格书；删除=省 1 件且不改变任何功能（推荐删） |
| **DE/PCLK/VSYNC/HSYNC、TE** | — | 接 GND / 悬空 | ✅ 正确（规格书明文允许） |

~~**结论**：④ 的"配置与上拉"**不属于冗余**（模组确实没带），但**TP_INT 上拉缺失**、**TP_RST 上电状态未定义**、**I²C 上拉需实测确认是否重复**——这三点是本次核实到的真问题。~~ → ⛔ **已被覆盖（2026-10-02）**：TP_INT 上拉 = 改用 PC5 内部上拉（`.ioc` 已改 ✅）；TP_RST = 已删，触控复位与 `LCD_RST` 共用 ✅；I²C 上拉 = 底板 `R15/R16` 保留 ✅。

---

### 4.3 **ADC 基准电压 —— 核心板"已具备"，底板外挂属"半个冗余 + 一个必须澄清的短路风险"**

**核心板确实自带基准（已验证，官方原理图 P.3）**

- **U4 = REF3030AIDBZR**（TI REF30xx 家族，**3.0V**，±0.2%，50ppm/℃，50µA，SOT-23-3）+ C21 470nF；
- 注释原文即 **"板载参考电压芯片"**；输出网络 `CHIP_VREF`。

**核心板给了三路 VREF+ 选择（P.6"三路参考电压，三者存其一"）**

| 路 | 内容 | 选通件（图上） |
|---|---|---|
| ① | 内部 3V3 经磁珠 | R1/R2/R6/R7 = `0Ω(N)`（不贴）；R5 = 0Ω（`SMT生产兼容一览`：STM32F407Vx → **R5 贴**） |
| ② | 板载基准 REF3030 | ↑ 同上 |
| ③ | **外部排针注入** `EXT_PIN_VERF+` | ↑ 同上 + 注释 **"【用外部基准源时需要去掉】"** |

**对本设计的意义**

- 底板把 REF3033 灌到 **EVK1 pin2**（符号名 `REF`），恰好是官方排针的 `EXT_PIN_VERF+` ⇒ **注入路径正确**，`03-components.md` 风险 **R3 的前半段（"排针脚是哪个"）已闭**。
- **但 R3 的后半段（"核心板侧默认通路断没断"）现在是红灯**：
  若核心板出厂已由 **板载 REF3030** 或 **内部 3V3 经磁珠** 驱动 VREF+，底板再灌 REF3033 就是 **两个基准输出直接对接**（若走内部 3V3，则是 3.3V 轨低阻顶住 REF3033，更糟）。
  ⇒ **这是上电前必须实测的一次**（§7 T3）。

**冗余判定与两案**

| 案 | 做法 | 收益 | 代价 |
|---|---|---|---|
| **A 保留外置** | 先按官方"SMT 生产兼容一览"确认/摘掉核心板侧的 0Ω，再灌 REF3033 | 基准 3.3V（ADC 满量程最大）、外置件性能已知 | 5 件 + 1 断点 + 1 路跨板走线 + **一次动焊** |
| **B 用板载（推荐）** | 不灌外部，直接把 VREF+ 交给板载 **REF3030（3.0V）**；删 U2/C12/C13/JP3，R9/R10 分压由 1.65V 改 **1.5V** | 省 5 件、少一次动焊、**基准同族同级**（±0.2%/50ppm/℃） | VREF 3.3→3.0V：ADC LSB 0.81→0.73mV（**更细**）；信号摆幅 ±250mV 相对 1.5V 轨余量仍 >6×；DSP 链（fs/N/窗/5mV 判据）**不受影响** |

> 两案都**必须先做 T3 实测**：板载那路若确认可用 ⇒ 选 B；若确认板载件不贴或走的是内部 3V3 ⇒ 选 A，并且**仍要先摘核心板侧 0Ω**。
> **无论哪一案，"两个基准/一个 3.3V 轨与 REF3033 同时驱同一节点"都是绝对禁止的。**

---

## §5 评审中新发现的硬缺陷（本次最大增量）

### P0-1 ⛔ **`+5V_A` 模拟轨没有任何电源来源（致命，上电即废）**

**证据（EDA 自导网表，逐脚）**

```
+5V_A : C11.1(REF入) , D1.5(SRV05-4 VCC) , J2.1 , J4.1 , U1.8(OPA2197 V+) , U2.1(REF3033 IN)
+5V   : C16.1 , D2.1(K) , EVK1.40(5V0) , EVK1.80(5V0) , R14.1 , U3.3(VIN)
```
- `+5V_A` 的 6 个成员里**没有**任何一处接 `+5V`、`+5V_RAW` 或任何稳压输出；
- PWR 页页面源码中字符串 `"5V_A"` 出现 **0 次**（AFE 10 次、INT 3 次）；
- 根因：`02-architecture.md §3` / `04-pinout连接表.md §3` 的电源树写了 **"模拟 5V（磁珠 + LC 分割）"**，但**磁珠/电感这个分割元件从未落图** ⇒ 轨道断了。

**后果**：OPA2197（V+）与 REF3033（IN）全部不供电；SRV05-4 的 VCC 悬空 ⇒ **输入 TVS 失去钳位能力**；整条模拟前端与基准死。

**修法**：PWR 页 5V 主干补 `+5V → FB（磁珠，如 600Ω@100MHz） → +5V_A`（或 0Ω/小电感），AFE 页在 U1.8 / U2.1 就近补 100nF。

### P0-2 ⛔ **3.3V 双 LDO 并联抢同一节点（严重）**

```
+3V3 : … , EVK1.38(3V3) , EVK1.78(3V3) , … , U3.2(VOUT) , U3.4(VOUT)
```
底板的 **AMS1117-3.3 输出**与核心板板载 **SCJA1117B-3.3 输出**接在同一网络：
- 两个 LDO 无法均流，谁的实际输出高谁扛全部负载，另一个不导通（1117 类一般**不能反灌**）；
- 若底板那颗偏高，会**倒灌进核心板 LDO 输出**（发热/异常态）；
- 白耗两倍的静态电流，且"数字轨独立"的原意（`02 §5`、`03 #6` 都写了"不加载核心板"）**在实图上并不成立** ⇒ **文档与实图矛盾**。

**修法（二选一，建议 a）**
- **(a) 删 U3 + C16/C17/C18**，底板 3.3V 直接吃核心板 `EVK1.38/78`。（副带好处：3.3V 支路自动纳入核心板 F1 500mA 保险保护）
- (b) 保留 U3，但**断开 EVK1.38/78 与 +3V3 的连接**，网络改名 `+3V3_DIGIT`，真做隔离（代价：新增"底板 3.3V 掉电而核心板正常"的失效态，且隔离无实益——同源 5V、无隔离器件）。

### P1-3 **计划已定料但未落图的三项**（`06 §6.3` 挂账，本次确认仍在）

| # | 缺件 | 依据 | 现状（实读 BOM/网表） |
|---|---|---|---|
| a | **PPTC 自恢复保险 F1**（`SMD1206P050TF/24_C209741`） | 02 §6 O10 / 03 #15 / 06 §2 F1 | ✅ **已闭（2026-10-01）**：`F1` 已落图。原判：**图上无**。核心板 F1 只保核心板支路；背光支路（~50mA@5V）与底板仍裸露 |
| b | **FSMC 33Ω 串阻 ×17**（D0~D15 + NE1 + RS） | 02 §6 O7 / 03 #13 / 06 §2 RN1~ | ✅ **已闭（2026-10-01/02）**：18 只 `R22`~`R39` 已落图。原判：**图上无**。跨板排线振铃的谐波会落进 10k~500kHz 分析带 |
| c | **U1 电源去耦 100nF×2**（C14/C15） | 06 §6.3 N4 | **图上无**。OPA2197 的 V+ 目前只有远处的 C11 22µF（且该网还是断的，见 P0-1） |

### P1-4 **图纸注释与实连不符（会误导评审与后续维修）**

| # | 位置 | 注释写的 | 实连（网表） |
|---|---|---|---|
| a | AFE 页 | 旧套分区框写 **"④ 8 阶巴特沃斯抗混叠低通（fc=800kHz）"** | 图上元件值对应 **fc=660kHz** ⇒ **两套注释并存且自相矛盾**，需删旧套 |
| b | AFE 页 | 文字提到 **`AFE_ADC_MON`** 与 ADC_IN "分列" | 该网**已不存在**（`_rv_netsum.txt` 无此网） |
| c | PWR 页 | "+3V3 → R11 1k → LED1 → **Q1** → GND（背光指示）" | `LED1.2(-) → GND`；`LED_A = {LED1.1(+), R11.1}` ⇒ 指示灯**常亮**，不受 PB0 控制（Q1.D 只挂 BL_K） |
| d | PWR 页 | "R17/R18/R19 0Ω：IM0/IM1/IM2" | **R18→IM2、R19→IM1**（IM0 才是 R17） |
| e | PWR 页 | 指示灯节点网名 **`LED_A`** | 与背光阳极网 **`BL_A`** 语义打架，极易误改 ⇒ 建议改 `PWR_LED` |

### P2-5 其它（低优先）

- AFE 页 `JP1/JP2/JP3` 与 `TP1~TP6` 已按方案落地 ✅（TP6 现为 VREF，文档 `06` 写 TP6=AGND，属文档滞后）。
- PWR 页 `U3.2/U3.4` 双 VOUT 并联走线 ✅；`R13 100k` 栅极下拉 ✅。

---

## §6 重构方案（仅方案，**暂不实施**）

### 6.1 硬件（按依赖顺序；H1/H2 是"能不能上电"的前提）

| # | 动作 | 依赖 | 验收判据 |
|---|---|---|---|
| **H1 [P0]** | 补 `+5V → FB(磁珠) → +5V_A`；AFE 页补 U1.8 / U2.1 就近 100nF（即 06 挂账的 C14/C15） | 无 | 网表里 `+5V_A` 必须能追到 `+5V`；DRC 无新增致命/错误 |
| **H2 [P0]** | 解 3.3V 双 LDO：**删 U3 + C16/C17/C18**（方案 a） | 无 | 网表 `+3V3` 只剩 `EVK1.38/78` 一个来源 |
| **H3** | 背光：按 §7 T1 实测定 **R14**；把分区名改为 **"③ 背光开关与限流"**；注释补"**非恒流**，If≈(5−Vf)/R，随 Vf 分档漂" | T1 | 实测电流落在 54~66mA（若走方案 B 恒流则写恒流值） |
| **H4** | ✅ **已闭（2026-10-01/02）**：② → PC5 内部上拉（`.ioc` 已改）；③ → TP_RST 已删（触控复位与 `LCD_RST` 共用，无需上拉）；④ → R20 已随 13 §D10 删除；① → `R15/R16` 保留（本表 §163 的"须实测模组侧"仍有效）。原表述：屏接口收口：① 按 T2 实测决定 I²C 上拉去留；② 补 TP_INT 4.7k→+3V3；③ 补 TP_RST 100k→+3V3（或书面确认软件最早驱动 PC4）；④ 删 R20（LCD_ID）或保留并注明"仅符合规格书、功能未用" | T2 | H4 三脚静态电阻实测记录在案 |
| **H5** | 基准定案：按 T3 实测选 **案 A（保留 REF3033）/ 案 B（改用板载 REF3030）**；案 B 同时把 R9/R10 分压目标由 1.65V 改 **1.5V** | T3 | 上电实测 VREF+ 电压与 VBIAS 电压 = VREF/2 |
| **H6** | ✅ **已闭（2026-10-01/02）**：PPTC=`F1`、33Ω=`R22`~`R41` ×20、U1 去耦=`C14` —— 均已落图。原表述：补齐 P1-3 三项：PPTC（5V 主干串入）、33Ω FSMC 串阻 ×17、U1 去耦（并入 H1） | 无 | BOM 对 `06 §2` 逐条 |
| **H7** | 清注释与命名：删 AFE 旧套分区文字、删 `AFE_ADC_MON` 引用、修 PWR 三处错位说明、`LED_A`→`PWR_LED` | 无 | 图上每个功能框只有一个标题 |
| **H8** | 决定 J2/J4 去留（单板则删、直连；拆双板则保留并标注） | 拍板 | 网表里 AFE↔INT 的信号不再经接插件 |
| **H9** | 全量复核：重跑 DRC + 网表回读 + `easyeda-sch-audit-fix/scripts/audit_sch.py` | H1~H8 | 致命 0 / 错误 0；警告只剩"器件标准化" |

### 6.2 软件（与硬件联动；**改动前先过 §7 实测**）

| # | 动作 | 关联 | 说明 |
|---|---|---|---|
| **S1** | `PC5` 由 `GPIO_Output` 改 **`GPIO_Input`**（R6，**走 GUI，人做**） | H4 | 否则 FT6206(FT6x06) 的 INT 与 MCU 输出对打。内部上拉开不开取决于 T2 实测 |
| **S2** | `bsp_touch` 增加 INT 超时/去抖保护 | S1 | 有上拉后仍要防"INT 长低"卡死轮询 |
| **S3** | 背光策略固化：PB0 **只做开关、严禁 PWM**（`board_config.h` 已有铁律，保留并在 `app` 层加注释引用） | H3 | 若将来要调光，只能走**外部恒流**，不许 GPIO 斩波 |
| **S4** | 基准口径联动：若采纳案 B（3.0V）→ 更新 `docs/01_软件架构与DSP方案.md` 与 `tools/verify_dsp.py` 的 1.65V/3.3V 口径为 1.5V/3.0V，重跑复算并回填 | H5 | **5mV 绝对判据不受影响**（与满量程无关），但文档数字必须同步 |
| **S5** | 上电自检增加"**模拟轨在线**"判据：读 PA1（`VBIAS_ST`）应 ≈ VREF/2；读不到即为模拟轨故障 | H1 | **恰好把 P0-1 变成一个可自动发现的失效**，不依赖人眼 |
| **S6** | `board_config.h` 增编译期闸门（沿用工程已有的 `#if/#error` 范式）：如 `BOARD_ANALOG_RAIL_MUST_EXIST`、`BOARD_TP_INT_PULLUP`，把"硬件前提"写进代码 | H1/H4 | 避免"宏改了没反应"的孤儿宏陷阱 |
| **S7** | 文档同步：`04-pinout连接表.md §3` 电源树、`05`/`06` 挂账表、`README` 现状表更新为本轮定案 | 全部 | `doccheck` 无死链 |
| **S8** | 遗留（本轮不改）：`app_ui.c` 拆分、LVGL DMA 化 —— 等实测数据再动 | — | 保持现状 |

### 6.3 不建议动的（防返工）

- **滤波器拓扑与取值**（fc=660k、L1/L3/L5/L7=4.7/22/22/12µH、C 全 C0G）：复算余量 16.8dB、蒙特卡洛 0 跌破，**没有理由改**。
- **AFE 拓扑**（无源 LC + 逐级缓冲 + 后置增益）：选型文档已量化排除了有源 SK / Cauer（Plan B 挂触发条件）。
- **`AGND`/`GND` 分离与单点**：正确，不要为了"省一个网名"合并。
- **D1 = SRV05-4**：略冗余但手焊友好，保留。

---

## §7 待实测 / 待拍板（**实施前的前置**）

| # | 项 | 类型 | 方法（无源、断电优先） | 影响 |
|---|---|---|---|---|
| **T1** | 屏背光 A–K 是否内含串阻 / 额定电流 | **实测** | ① 万用表二极管档/电阻档测 `H3.44(A)` 对 `H3.38~43(K)`；② 用 5V + 已知电阻（如 100Ω）实测电流，反解 `Rint` | **定 R14**（H3）；决定是否上恒流 |
| **T2** | CTP 模组的 `SCL/SDA/INT` 是否自带上拉 | **实测** | 断电测 `H4.3 / H4.4 / H4.6` 对 `H4.1(+3V3)` 的电阻 | 定 I²C 上拉去留；定 INT 上拉是否必补（H4） |
| **T3** | 核心板 `EXT_PIN_VERF+` 出厂默认由谁驱动 | **实测 + 对图** | 上电测 `EVK1.2` 对地电压/对 +3V3 电阻；对照官方 P.6 的 R1/R2/R5/R6/R7 实际贴装 | 定基准案 A/B（H5）；**两条路都不能让两个源对打** |
| **T4** | 是否保留外置 REF3033 | 拍板 | 依据 T3 | §4.3 |
| **T5** | J2/J4 板间连接器去留 | 拍板 | 是否要拆成两块板 | §3 R-3 |
| **T6** | 是否删底板 AMS1117 | 拍板 | 建议删（前提：核心板 3.3V 排针可用） | §5 P0-2 |
| **T7** | 实物核心板是 **VET6** 还是 **VGT6** | **对实物** | 看板面丝印；`原理图必读.md` 说本资料包是 **VET6 版**，而固件/文档按 **VGT6 高配版** 写 | 影响 Flash 容量（512KB vs 1MB）与"高配版 VREF 三路"是否成立；**必须与 T3 一并确认** |
| **T8** | CTP FPC-6P 物理脚序 | 对实物 | 沿用既有 [TBD]，落图/打样前对 FPC 丝印与通断 | H4 |

---

## §8 结论摘要（一屏版）

1. **整体架构合理**：核心板 + 底板、无源 LC 8 阶 + OPA2197、AGND/GND 分离、屏接口 45 脚逐脚正确、FSMC 映射与 `board_config.h` 完全一致。
2. **1 处致命**：`+5V_A` **没有任何电源来源**（"磁珠分割"从未落图）⇒ 模拟前端与基准整体不上电。
3. **1 处严重**：底板 `AMS1117-3.3` 与核心板 LDO **输出并联** ⇒ 双 LDO 抢输出、白耗、且与设计文档"不加载核心板"自相矛盾。
4. **③ 背光**：**不是恒流驱动**（39Ω 限流 + NMOS 开关）；39Ω 使典型工作点 48.7mA **落在 54~66mA 规格窗口之外**（33Ω 才在窗内）；且最终取值取决于"模组是否内含串阻"——**必须先实测**。
5. **④ 屏接口配置与上拉**：**模组确实不含 IM 配置与（至少部分）上拉**，所以底板这些件**不是冗余**；~~但 **TP_INT 缺上拉**、**TP_RST 上电状态未定义**、**I²C 上拉可能与模组重复**（须实测）~~ → ⛔ **已被覆盖（2026-10-02）**：TP_INT 改 PC5 内部上拉 ✅、TP_RST 已删 ✅、I²C 上拉 `R15/R16` 保留 ✅。
6. **ADC 基准**：**核心板已具备**（板载 `REF3030AIDBZR` 3.0V，同 TI REF30xx 家族；另有排针 `EXT_PIN_VERF+` 注入路），⇒ 底板外挂 REF3033 属**半冗余**；**但直接灌入前必须先确认核心板侧 0Ω 的贴装**，否则两个基准对打。
7. **三项已定料未落图**：PPTC、FSMC 33Ω 串阻、U1 电源去耦 —— 补。
8. **图纸健康**：DRC 致命 0 / 错误 0（剩 2 条"器件标准化"警告）；但存在**两套自相矛盾的分区注释**与 4 处注释/实连不符 —— 清。

---

## §9 极简方案 v2（2026-09-29 追加：30-pin 接口 + **"只加必要的"** 原则）

> **触发**：用户提供屏 **30-pin 实物接口照片**（逐脚记录已并入 `04-pinout连接表.md` §6），并给出原则：
> **"一定要加上吗？没有必要就去掉。"** 本节按此原则把 §6 的改造清单**逐条重审**，能删的都删。

### 9.1 逐条重审：原先"建议加"的 6 项

| 原建议 | 重审结论 | 理由 |
|---|---|---|
| 补 `+5V → **磁珠** → +5V_A` | **改 `+5V → 0Ω → +5V_A`；不加磁珠** | 600Ω@100MHz 的磁珠**在 500kHz 只有几 mΩ 量级阻抗**，对本项目关心的 10k~500kHz **没有任何隔离作用**（真正的隔离靠就近去耦 + 地平面）。0Ω 保留"可断开量测"的价值即可 |
| 补 U1 去耦 `100nF ×2` | **只加 1 颗（V+ 就近）** | OPA2197 单电源供电，**V− 直接落在 AGND 上**，不需要第二颗 |
| 补 **TP_INT 上拉 4.7k** | **不加** → 改软件：`PC5 = GPIO_Input + Pull-up`（STM32 内部 ~40kΩ） | INT 是低速信号，40k 上拉的上升时间 ≈0.4µs 完全够用；**零元件、零布线**，而 PC5 本来就要改成 Input |
| 补 **TP_RST 100k 上拉** | ✅ **已闭（2026-10-02）**：触控复位**与屏 `LCD_RST` 共用**（适配板 18K+100nF RC，`13 §D4`），固件复位脉冲低 20ms（`bsp_lcd.c:55-59`，满足 `13 §5.6-③` 的 ≥5ms）——既不需要上拉、也不需要软件 RST 脉冲（`bsp_touch.c` 本就不接触控 RST）。原判：**不加** → 改软件：`bsp_touch_init()` 里显式给一次 RST 脉冲 | 固件本来就该在初始化时复位触摸 IC；加上拉反而与 GPIO 推挽形成分压 |
| 补 **PPTC 自恢复保险** | **不加** | ① `D2(SS34)` 已覆盖反接；② 实验室稳压电源自带限流；③ 删 U3 后 3.3V 负载纳入核心板自带 500mA 保险；④ 剩裸支路只有背光 ~50mA。（**将来改电池供电再加**） |
| ⛔ **本条已被覆盖（2026-10-02）**：实测耦合已出现（台面 CS 受扰即整屏花屏），18 路已落图 `R22`~`R39`，见 `22-屏接口抗干扰评审与布局要点.md`。原判： | 补 **FSMC 33Ω ×17** | **不加，转"触发条件制"** | 33Ω 对 10.5MHz 方波主要压 >100MHz 的谐波，对 500kHz 分析带的贡献**未量化**；而机制性对策（**采样窗静默 O1** + 限帧率）**已在软件侧落地** ⇒ 与 Plan B 同等待遇：**实测有耦合再加** |

### 9.2 基准：从"**注入**"改成"**取用**"（一举省 5 件 + 消掉对打风险）

原设计：底板用 REF3033 自产 3.3V，**灌**进 `EVK1.2`（核心板外部基准脚）。
重审：核心板 P.6 的"三路存其一"里**必有一路导通**（`SMT生产兼容一览`：STM32F407Vx → **R5 贴**）⇒ **VREF+ 本来就有驱动**。
⇒ 底板**根本不需要产生基准**，只需：

1. **删** `U2(REF3033) + C11 + C12 + JP3 + TP6`（4 件 + 1 断点 + 1 测试点）；
2. 把 `EVK1.2` 那根线**从"注入"改成"取用（输入）**"，喂 `R9/R10` 分压得 `VREF/2`：
   - 核心板走**板载 REF3030（3.0V）** → `VBIAS = 1.50V`
   - 核心板走**内部 3V3** → `VBIAS = 1.65V`
   - **两种都是 VREF/2 ⇒ `R9/R10` 的 10k/10k 不用改值**，只改注释；
3. 保留 `C13`（VBIAS 去耦）、`R9/R10`、`TP5`、`PA1` 自检通道。

> **收益**：① 消掉"两个基准 / 3.3V 轨对打"这个上电风险；② 省 4 件 + 1 断点 + 1 测试点；③ **不再需要动核心板的 0Ω**。
> **代价**：ADC 满量程若走板载档由 3.3V→3.0V（LSB 0.81→**0.73mV，更细**）；信号 ±250mV 相对 1.5V 轨余量仍 >6×；**DSP 链（fs/N/窗/5mV 判据）不受影响**。

### 9.3 屏接口按 30-pin 走，再删一批

若采用现成 **30-pin 转接板**（记录见 `04-pinout连接表.md` §6）作为底板与屏的接口
（**前提：`04 §6.7` ①~④ 确认后** —— 其中 **①「转接板必须处于 Parallel 档」是新的硬门槛**：
整板照片显示板上有一张 `Parallel / SPI` 的位宽选择表丝印与一组 0Ω 焊盘，**出厂默认很可能不是 8080-16bit**，
与 `04 §0` 记录的"厂家通用板 IM 全拉 3.3V = 4-line SPI 绑法"相互印证 ⇒ **需按板上 `Parallel` 表改焊 IM0/IM1/IM2**）：

| 原设计 | 处置 | 理由 |
|---|---|---|
| `H3 = FH12-45S`（0.5mm FPC-45P） | **换成 2×15 2.54mm 排针/排母** | 30-pin 已含 16 数据 + 5 控制 + 电源 + 背光 + 触摸；2.54 **手焊友好、可拔插**；0.5mm FPC 座手焊难度高 |
| `R17/R18/R19`（IM 配置） | **删 3 件** | 接口模式已在转接板内部绑好（`04 §6.4`） |
| `R20`（LCD_ID 100k） | **删 1 件** | 该脚未被引出，且固件不读 |
| `H4 = FH12-6S`（CTP FPC-6P） | **视 `04 §6.5` ① 的结论**：触摸走 30-pin ⇒ 删；走独立 FPC ⇒ 保留 | — |
| `DE/PCLK/VSYNC/HSYNC/TE` 的处理 | **不需要** | 未引出，转接板已按规格处理 |
| 背光 `Q1 + R12 + R13 + R14` | **视 `04 §6.5` ③ 的结论**：转接板自带 NMOS 且 `BL` 是栅极 ⇒ 底板只留 1 个 GPIO、删 4 件；`BL` 是 LED-A 供电 ⇒ 保留底板限流支路 | 见 §4.1 |

### 9.4 最终"加 / 删 / 不改"清单

**加（只有 2 项，都是"让电路成立"级别）**

1. `+5V → 0Ω → +5V_A`（让模拟轨有电 —— **P0-1 的唯一必要修法**）
2. `100nF ×1`（U1 的 V+ 就近去耦）

**删（净减 15 个元件 + 2 个连接器）**

| 删什么 | 件数 | 依据 |
|---|---|---|
| `U3 + C16 + C17 + C18` | 4 | §5 P0-2：双 LDO 并联 |
| `U2 + C11 + C12 + JP3` | 4 | §9.2：VREF 改"取用" |
| `TP6` | 1 | §9.2 |
| `R20`（LCD_ID） | 1 | 30-pin 未引出；固件不读 |
| `R17/R18/R19`（IM 配置） | 3 | 30-pin 转接板已绑 |
| `J2 + J4`（2×7 SH1.0） | 2 | 单板内纯冗余（§3 R-3） |

**替换**：`H3 FH12-45S 0.5mm FPC-45P` → `2×15 2.54mm 排针/排母`
**视 §6.5 结论再删**：`H4`(CTP FPC-6P)、`Q1/R12/R13/R14`(背光，最多 4 件)

**不改（已判定合理，零改动）**

- AFE 全部元件值与拓扑（fc=660k，余量 16.8dB、蒙特卡洛 0 跌破）
- `AGND/GND` 分离与单点接地
- FSMC 15 根数据/控制线的映射
- `D1 SRV05-4`（略冗余，但手焊友好、¥0.08，保留）
- `TP1~TP5`、`JP1/JP2`、`R9/R10`、`C13`

### 9.5 软件侧：**"不加硬件，用软件顶上"**

| # | 动作 | 顶替了什么硬件 |
|---|---|---|
| **S1** | CubeMX：`PC5 = GPIO_Input + Pull-up`；`PB0` 保持 `GPIO_Output`（**禁 PWM**） | **顶替 TP_INT 外部上拉** |
| **S2** | ✅ **已闭（2026-10-02）**：本条前提（TP_RST 连着 PC4）已消失 —— 触控复位与屏 `LCD_RST` 共用（`13 §D4`），固件复位脉冲低 20ms（`bsp_lcd.c:55-59`）已覆盖触摸 IC 的复位，`bsp_touch.c` 本就不碰 RST。原表述：`bsp_touch_init()` 里显式给 RST 一个"低→高"脉冲（≥10ms） | ~~**顶替 TP_RST 100k 上拉**~~（前提不存在） |
| **S3** | 若采 §9.2：`docs/01` 与 `tools/verify_dsp.py` 的 VBIAS 口径统一写成 **VREF/2**（1.5V / 1.65V 两个候选），**去掉"3.3V 固定"的硬编码** | 顶替外置基准 |
| **S4** | 上电自检：读 `PA1(VBIAS_ST)` 判"模拟轨 + 基准在线"，再读 `PA0` 判 ADC 通道 | 顶替一部分测试点功能 |
| **S5** | 采样窗静默（O1，**已实现**）+ LVGL 限帧率 | ⛔ "顶替"关系已失效（2026-10-02）：软件对策**保留**，与硬件阻尼**并行**（`R22`~`R39` 已落图，见 `22` 号）。原表述： | **顶替 FSMC 33Ω 串阻** |
| **S6** | `board_config.h` 加编译期闸门（沿用工程 `#if/#error` 范式），把"模拟轨必须有电""TP_INT 必须上拉"写成**编译期约束** | 防回归 |

### 9.6 更新后的执行顺序

```
[先做·实测] 04 §6.7 的 ①转接板 Parallel 档（硬门槛）②触摸总线 ③DE组接地 ④BL 性质
           ← 这四条不定，底板画了也可能是废板
[P0] +5V_A 通电(0Ω)
     ├─► 删 U3/C16~C18 ──► 删 J2/J4 ──► 删 R17~R19 + R20 ──► 删 U2/C11/C12/JP3/TP6
     └─► R9/R10 注释改 "VREF/2" ──► AFE 补 1×100nF（U1 V+）
[H3/背光] 按 04 §6.5 结论：H3 换 2×15 排针；背光支路删或保留
[验收] DRC（致命 0 / 错误 0）+ 网表回读 + `easyeda-sch-audit-fix/scripts/audit_sch.py`
[软件] S1~S6 与硬件同一版落地，口径一起改
```

---

## §10 变更记录

| 日期 | 变更 | 谁 |
|---|---|---|
| 2026-09-29 | v1 初稿：通读屏规格书 + 天空星官方原理图 + 厂家两块转接板；实读画布/网表；给出 ③④/基准 三项核实结论、P0×2 + P1×2 新发现、硬件 9 项 + 软件 8 项重构方案、8 项待实测/待拍板 | AI（待 [CHK] 人确认） |
| 2026-09-29 | **追加 §9 极简方案 v2**：并入屏 30-pin 实物接口（记录见 `04 §6`）；按"只加必要的"重审——加项由 6 项收敛为 **2 项**，删项累计 **净减 15 元件 + 2 连接器**；基准由"注入"改"取用" | AI（待 [CHK] 人确认） |

> **复现命令**（本机）
> ```powershell
> cd projects\G2026\hardware
> python _rv_dump2.py       # 三页器件/导线/端口清点 → _rv_pages.txt
> python _rv_src.py         # 拉三页页面源码 → _rv_src_{AFE,PWR,INT}.txt
> python _rv_parse.py       # 源码→结构化摘要（器件表/注释文字）→ _rv_parse_*.txt
> python _rv_net.py         # EDA 自导网表  → _rv_netlist.txt
> python _rv_netsum.py      # 网名→引脚    → _rv_netsum.txt
> python _rv_pinmap.py      # 逐脚映射     → _rv_pinmap.txt
> python _cc_parse2.py      # 厂家 1000 亮度恒流板解析 → _cc_report.txt
> python _adapter_pdf.py    # 厂家通用板带坐标文本 → _adapter_pdf_p1.txt
> python _rv_drc.py         # DRC 计数徽标（当前：全部 4 · 致命 0 · 错误 0）
> ```
