funiang-x/G2026/hardware/13-底板定稿决策.md

# G2026 底板 · **定稿决策与实施**（2026-09-29）

> 性质：**拍板 + 实施记录**。用户指令："直接定稿底板就行了做吧"（不再等实测）。
> 前置：`12-原理图二次评审-硬件资料核实.md`（v1 评审 + §9 极简方案 v2）、`04-pinout连接表.md` §6（30-pin 接口）。
> 原则：**只加必要的，不必要就删**；每一批改动**独立可验证**（判据 = DRC 致命 0 / 错误 0）且有**回滚快照**。
>
> ⚠️ **2026-10-04 口径同步（本文为决策/实施记录，正文按当时读；现行值以下列为准）**
>
> | 本文写法 | 现行事实 | 出处 |
> |---|---|---|
> | `PWR` 页 10 器件（`J3`/`D2`/`F1`/`C16`/`C19`/`C20`/`LED1`/`R11`/`R15`/`R16`/`R21`） | **只剩 4 件**：`C16`/`R15`/`R16`/`R21`。`J3`/`F1`/`D2` 已删（本板由**核心板 Type-C 供电**），`C19`/`C20`/`LED1`/`R11` 更早已删 | `38 §3.2-①` |
> | `AFE` 页 `TP1~TP6` | **只剩 `TP1`/`TP3`/`TP4`/`TP5`**（`TP6` 随 `JP3`/`C12` 死支路删除有记录；**`TP2` 无记录**） | `38 §3.2-②` |
> | `C12` / `JP3` / `TP6` 保留 | **已删**（`VREF` 留位死支路） | `30 §5` · `33 §50` |
> | `J5` 偶数脚映射（`6=NC`、`8=LCD_D0`…） | **已改**为屏厂线性表（`6=D00`、`8=D02`…`22=T_BUSY`） | `04 §6.18` |
> | `R21`(0Ω) | **4.7Ω** | `29 D7` |

---

## §1 拍板项（含"实测未做时的假设"与**救援路径**）

| # | 决策 | 依据 | 若假设错，怎么救 |
|---|---|---|---|
| **D1** | **屏接口采用 30-pin 转接板**：底板放 `J5 = 2×15 2.54mm 排母`，**不再**直连裸屏 45 脚 FPC | 用户实物照片 + 已确认 `010`（8080-16bit）；手焊约束（0.5mm FPC 座难焊）；极简 | 另画一块 30-pin→45-pin 小转接板（¥5） |
| **D2** | **触摸按厂家原理图推定的映射**：`SDA→30pin 26(MOSI)`、`SCL→30pin 24(SCK)`、`INT→30pin 27(IQR)`、`RST 与屏 RST 共用(30pin 5)` | 厂家 TK035F5501 转接板原理图网表：`P6.4→T_MOSI`、`P6.5→T_CLK`、`P6.3→T_IQR`、`P6.2→LCD.33(RESX)` | **30-pin 是排针，飞 2 根线即可改接**（成本 ≈0） |
| **D3** | **底板不再自带背光驱动**：只给 `PB0 → 1k → BL` 开关电平；删 `Q1/R13/R14` | 厂家转接板自带 NMOS（`Q1 SI2302` + `10K` 下拉），`BL` = 栅极控制 | ① 若适配板无 NMOS → 补一颗或飞线；② ~~若背光过流 → 割适配板 `LED-A`→3V3 铜皮串一颗电阻~~ → ⚠️ **2026-10-03 纠正（`36 §M.2`）：在 `3V3` 馈线上串电阻是无效的** —— 3V3 的余量（≈0.2 V）**小于**模组 `Vf` 的颗间离散（0.35 V），要居中到 60 mA 需 `Rs≈3.3 Ω`，此时电流是 **19~115 mA**。**正确做法：割铜皮后改从 `+5V` 串 33 Ω / 1206 / 0.25 W**（`I = 53.0~63.5 mA`；+5V 不在 30-pin 上，需飞一根线）。分析见 `tools/sim/backlight_ballast.py` |
| **D4** | **`RST` 与触摸共用 ⇒ 删 `TP_RST/PC4`** | 同 D2 | ~~固件把 `PC4` 标为 unused（一行注释）~~ → **实况（09-30 D1 修复后）**：PC4 被 **VBIAS** 用掉（固件配"输入、不驱动"，宏 `BOARD_VBIAS_SENSE_*`），见 `04 §1.1` 与 `13 §5.5 S-a` 勘误 |
| **D5** | **基准改"取用"**：删 `U2(REF3033)`；`VREF` 从 `EVK1.2` 取；`R9/R10` 分压得 `VREF/2`（**3.0V→1.5V / 3.3V→1.65V 两种都对**） | 核心板自带 `REF3030AIDBZR` + 三路 VREF 必有一路导通 | 若实测核心板 VREF+ 异常 → 回装 REF3033（AFE 页留了位置） |
| **D6** | `C11/C12` **保留改用途**（`+5V_A` 储能 / `VREF` 远端去耦）；`JP3/TP6` **保留**（断点与探针是调试命门） | 极简 ≠ 拆掉排障手段 | — |
| **D7** | `+5V_A` 由 `+5V → R21(0Ω)` 连接（**不加磁珠**） | 600Ω@100MHz 磁珠在 500kHz 无隔离作用 | — |
| **D8** | **删 `U3 + C17 + C18`**，3.3V 用核心板 `EVK1.38/78`；**保留 `C16`**（22µF 是 **+5V 入口储能**，非 LDO 专用） | 解双 LDO 并联；3.3V 负载仅 ~30mA | 若核心板 3.3V 排针不可用 → 回装 U3 |
| **D9** | **删 `J2 + J4`**（单板内板间互连冗余）；跨页信号改用**净标签**（本已存在） | `12 §3 R-3` | — |
| **D10** | **删 `R17/R18/R19`（IM）、`R20`（LCD-ID）** | 30-pin 未引出这些脚（`04 §6.4`） | 若要回退 D1，需一并回装 |
| **D11** | **不加**：磁珠 / PPTC / FSMC 33Ω×17 / TP_INT 上拉 / TP_RST 上拉 | 见 `12 §9.1`（逐条给了"没必要"的理由） | 全部改由**软件**顶（`12 §9.5` S1~S6） |

> ⛔ **2026-10-02 勘误**：本行已被覆盖 —— PPTC(`F1`)、FSMC 33Ω×18(`R22`~`R39`) **均已在图上**
> （触发条件"实测有耦合"已命中；评审与证据链见 `22-屏接口抗干扰评审与布局要点.md`）；
> `[TBD-6]` 层数已拍板 **2 层**（见 `16 §4-1`）。软件对策（采样窗静默/限帧率）**保留**，与硬件阻尼并行。

---

## §2 目标态器件表（底板）

| 页 | 保留 | 新增 | 删除 |
|---|---|---|---|
| **AFE** | J1 R1 C1 JP1 R2 U1 R3 L7 R4 C9 R5 R6 R7 C10 JP2 **C11 C12** R9 R10 C13 JP3 **TP1~TP6** D1 L1 L3 L5 C2 C4 C6 C8 R8 | — | **U2** |
| **PWR** | J3 D2 **C16** C19 C20 **LED1 R11** R15 R16 | **R21**(0Ω, +5V→+5V_A) | **U3 C17 C18 Q1 R12 R13 R14 R17 R18 R19 R20** |
| **INT** | EVK1 | **J5**(2×15 排母) · **R12**(1k, PB0 串阻) | **H3 H4 J4** |

---

## §3 实施批次（每批独立验证 + 可回滚）

| 批次 | 内容 | 判据 |
|---|---|---|
| **B0** | 备份三页源码到 `_review/final-20260929/` | 文件落盘 |
| **B1** | PWR：加 `R21`（`+5V→+5V_A`）；删 `U3/C17/C18` | `+5V_A` 能追到 `+5V`；无新增悬空 |
| **B2** | AFE + INT：删 `J2` / `J4`（跨页一起删） | 跨页标签仍在；无新增悬空 |
| **B3** | PWR：删 `Q1/R12/R13/R14/R17/R18/R19/R20` | 无新增悬空；`+3V3` 只剩核心板一路 |
| **B4** | AFE：删 `U2` | `VREF_3V3` 网仍由 `JP3.2←EVK1.2` 驱动 |
| **B5** | INT：**接口重画** —— 删 `H3/H4`，新增 `J5`(2×15) + `R12`(1k)，按 §4 映射逐脚扇出 | 30 个脚逐脚回读；DRC 致命 0/错误 0 |
| **B6** | 全量复核：DRC + 网表回读 + `_verify_all.py`；更新 `04/12` 文档 | 致命 0 / 错误 0（警告只剩"器件标准化"） |

> **B5 是唯一的高风险批**（要清理 90+ 根导线/端口并重建 30 个扇出点）。
> 按 `06 §8` 的教训：**逐脚做、逐脚回读**，不与其它批混做。

---

## §4 `J5`（2×15，30-pin）逐脚映射

> 脚号按"列"给：**每列两脚 = (奇数, 偶数)**，自左向右。
> ⚠️ 落件后必须**读回引脚坐标复核**编号方向（库里 2×15 排针符号的 1/2 脚可能同行相邻，需实读确认）。
>
> ⚠️ **2026-10-04 更正**：下表偶数脚一列原**整体写高了一行**（原 `6=NC`、`8=LCD_D0`…）。
> 正确规则 = **奇数脚一列、偶数脚一列，两列都自 `CS/RS` 端起算**，也就是屏厂 PDF 的线性编号表。
> 于是 `pin6=D00`、`pin22=T_BUSY(空位)`。改图凭据见 `04 §6.18`。

| 列 | 奇数脚 | 网络 | 偶数脚 | 网络 |
|---|---|---|---|---|
| 1 | **1** | `LCD_CS` | **2** | `LCD_RS` |
| 2 | **3** | `LCD_WR` | **4** | `LCD_RD` |
| 3 | **5** | `LCD_RST` | **6** | `LCD_D0`　*（2026-10-04 修，原 NC）* |
| 4 | **7** | `LCD_D1` | **8** | `LCD_D2`　*（原 `LCD_D0`）* |
| 5 | **9** | `LCD_D3` | **10** | `LCD_D4`　*（原 `LCD_D2`）* |
| 6 | **11** | `LCD_D5` | **12** | `LCD_D6`　*（原 `LCD_D4`）* |
| 7 | **13** | `LCD_D7` | **14** | `LCD_D8`　*（原 `LCD_D6`）* |
| 8 | **15** | `LCD_D9` | **16** | `LCD_D10`　*（原 `LCD_D8`）* |
| 9 | **17** | `LCD_D11` | **18** | `LCD_D12`　*（原 `LCD_D10`）* |
| 10 | **19** | `LCD_D13` | **20** | `LCD_D14`　*（原 `LCD_D12`）* |
| 11 | **21** | `LCD_D15` | **22** | *（NC，适配板此脚 = `T_BUSY`，丝印为空位）*　*（原错挂 `LCD_D14`）* |
| 12 | **23** | *（NC，T_CS 未用）* | **24** | **`TP_SCL`** |
| 13 | **25** | *（NC，MISO 未用）* | **26** | **`TP_SDA`** |
| 14 | **27** | `TP_INT` | **28** | `LCD_BL_CTL` |
| 15 | **29** | `GND` | **30** | `+3V3` |

**PB0 侧**：`EVK1.11(B00) → R12(1k) → LCD_BL_CTL`（新增串阻，防远端栅极走线振铃）。

---

## §5 实施结果（2026-09-29 当日完成）

### 5.1 门禁（EDA 自导 DRC，整设计级）

| 时点 | 全部 | 致命 | 错误 | 警告 | 信息 |
|---|---|---|---|---|---|
| 改动前 | 4 | 0 | 0 | 2 | 2 |
| 中间态（删件后残留游离网） | 10 | 0 | 0 | 8 | 2 |
| **定稿后** | **4** | **0** | **0** | **2** | **2** |

**剩余 2 条警告 = "元件的属性与供应商编号不匹配"（器件标准化）** —— 本机无 API，需在 EDA
「工具 → 器件标准化」点一次；不从立创配单可长期忽略。

### 5.2 逐批执行记录（全部实读回验）

| 批 | 动作 | 实测结果 |
|---|---|---|
| **B0** | 三页源码备份 | `_review/final-20260929/src_{INT,PWR,AFE}_pre.txt` |
| **B1** | PWR：删 `U3`+其扇出（8 线 + 8 旗）；新增 **`R21`(0Ω)** 由 `+5V` 取 `+5V_A` | 网表：`+5V_A = {C11.1, D1.5, R21.2, U1.8}`，`+5V = {…, R21.1}` ✅ **P0-1 闭** |
| **B2** | 删 `J2`(AFE) + `J4`(INT)，各 6 线 + 6 旗 | 跨页标签仍在（`AFE_ADC_IN`/`VREF_3V3_EXT`/`VBIAS_1V65`/`+5V_A`/`AGND`）✅ |
| **B3** | PWR：删 `C17/C18`、`Q1/R12/R13/R14/R17/R18/R19/R20` | `+3V3` 只剩 `EVK1.38/78` 一个来源 ✅ **P0-2 闭** |
| **B4** | AFE：删 `U2`(REF3033) | `VREF_3V3 = {C12.2, JP3.1, R9.1, TP6.1}` ← `JP3.2 = EVK1.2` ✅ |
| **B5-a** | INT：删 `H3`(45P FPC)+`H4`(6P FPC)；落 **`J5`**(`2.54-2*15P 母座`) | J5 30 脚几何回读 ✅ |
| **B5-b** | J5 **27 脚扇出**（3 脚 NC）；新增 **`R12`(1k)**：`EVK1.11 → R12 → LCD_BL_CTL` | `LCD_BL_CTL = {EVK1.11, J5.28, R12.1, R12.2}` ✅ |
| **B5-c** | 补 `R21`="0Ω"、`R12`="1kΩ"、`J5`="2.54-2*15P 母座"；删 `TP_RST` 端口（PC4 空出） | ✅ |
| **B5-d/e** | 源码注入 **4 条 `NO_CONNECT`**（`J5.6/23/25` + `EVK1.9`） | `setDocumentSource=True`，回读 NO_CONNECT **47 → 51** ✅ |
| **B6** | 清 6 条游离导线（`BL_K/IM0/IM1/IM2/LCD_ID/Q1_G` 残余总线与旗标）；改写 25 条过期注释 + 去重 3 条 | DRC 回到 **致命 0 / 错误 0** ✅ |

### 5.2.1 补一轮：**旗标残骸清理**（2026-09-29 20:09，用户目视发现）

**症状**：用户指出 PWR 页 ④ 区里有几个"秃的 GND 旗标"（`x = 1680 / 1790 / 1900`，即已删的 `R17/R18/R19` 原位）。

**根因（我的工具 bug，两处）**：
1. **自环判定**：连通性洪泛时把**导线自己的端点**也并进了"锚点集合"，于是每条导线都"碰到自己" → **永远判 0 条死线**。
2. **浮点比对**：引脚坐标返回 `979.9999999999998`，而导线端点是 `980`，集合相等判定失败 → 即使不修 #1 也会漏判。

**修法**：改为**从器件引脚出发做"导线级 BFS"**（seed = 有端点落在引脚上的导线；反复并入与之共点的导线），坐标一律 `round()` 归一。
工具：`easyeda-sch-audit-fix/scripts/dangling.py`（可重复运行，幂等）。

**清除结果（16 项）**：

| 页 | 死线 | 残骸旗标 |
|---|---|---|
| **INT** | 2（H3 删除后残留的 GND 母线树、+3V3 母线树） | `+3V3@(660,1160)` `GND@(660,1300)` |
| **PWR** | 5（`R13/R17/R18/R19/R20` 原位的短线） | `GND@(1230,910)` `GND@(1680,960)` `GND@(1790,960)` **`+3V3@(1900,960)`** `GND@(2010,960)` |
| **AFE** | 1（`AGND` 残线） | `AGND@(2300,1000)` |

复扫：三页 **死线 0 / 残骸 0**；DRC 仍 **致命 0 / 错误 0**。
> **教训**：DRC **不会**报这类残骸 —— 因为旗标挂的是 `GND`/`+3V3` 这类**已存在的网名**，
> 导线不是"游离网络"。**"几何连通性自检"必须自己做，且判据里绝不能把导线自身当锚点。**

> ⚠️ **踩坑记账（已回写 skill 台账口径）**：`setDocumentSource` 追加记录时，**记录之间用 `|` + `\n` 分隔，最后一条末尾不带 `|`**
> （页面源码里行分隔符是 `|\n`）。我第一次多写了一个 `|` → `setDocumentSource` 返回 **`False`** 且**页面无变化**（无损失败）。
> 另外 `sch_PrimitiveText` **可以 `modify(id, {content})`**，不必删除重建；按坐标匹配文本（`getState_Value()` 读不到）。

### 5.2.2 补一轮：**网标 `LED_A` → `PWR_LED`**（2026-09-29 20:19，用户目视提问触发）

**用户问**："我根本没有在板子上看见 `LED_A` 这个引脚，底板做出来往哪接？" —— **答案：哪儿也不接**。

**定性**：③ 区实际只有 `+3V3 → R11(1kΩ) → ●(LED_A) → LED1(KT-0805Y) → GND` 一条自闭环支路
= **板载指示灯，常亮、对外零连接**。三页 115 个旗标里 `LED_A` **只出现一次**（单点网名 ⇒ 无第二落点）。
它是**上一版"底板直驱背光"的残留名**（旧方案：`+5V → 39Ω/0.5W → LED_A` 为背光阳极供电网，见 `05 §…`/`10 §…`），
改"背光交由适配板自驱"后名字被顺手留在指示灯节点上 ⇒ 与 45-pin FPC **44 脚 `LED-A`** 撞义。
`12-原理图二次评审` §P2-4-e 已点出此坑并建议改名，列在 H7 待办但未执行 —— **本轮执行**。

**已落盘改动**：
1. 网标 `LED_A` → **`PWR_LED`**（netport，原位 (970,1050) 重建，已确认 pin#1 落在原短线端点上）
2. ③ 区标题 → `③ 背光开关（非恒流）+ 板载指示灯`
3. ③ 区说明补 → `背光 NMOS 与 LED-A 供电都在 30-pin 适配板上；R11+LED1 是板载指示灯，无对外连接`

复核：三页 **死线 0 / 残骸 0**；DRC **致命 0 / 错误 0**（警告仍只剩"器件标准化"2 条）。

**踩坑记账（API 口径）**：
| # | 坑 | 正确姿势 |
|---|---|---|
| 1 | `setState_*()`（如 `co.setState_Name("X")`）**只改本地代理对象，不落盘** | 必须用 `eda.sch_PrimitiveText.modify(id, {content})` 这类 **`modify`** 接口 |
| 2 | `sch_PrimitiveComponent.modify` 对**网络旗标**报 *"仅当器件类型为元件时允许使用该函数进行修改"* | 旗标/网口是 `netflag`/`netport`（type **18/19**），只能**删除 + `createNetPort`/`createNetFlag` 原位重建** |
| 3 | 取页面源码是 **`eda.sys_FileManager.getDocumentSource()`**（不是 `dmt_EditorControl`），且**必须按 40k 分块**，整取会 **HTTP 500** | 分块 `slice(a,b)` 拼接 |
| 4 | `setDocumentSource(**原样**)` 返回 **true**，但**内容被改过的**源码返回 **false**（写入被拒） | 别指望源码级替换做改名 —— 走 API 重建路线 |
| 5 | 万用表查悬空脚用**电压法**（10MΩ 输入阻抗）比断电电阻法可靠 | 见 `04-pinout连接表.md` §1.6 实测规程 |

### 5.2.3 B7+B8：**R12 被短路修复 + 基准网名去值化**（2026-09-29 21:20）

**工具升级**：新增 **`easyeda-sch-audit-fix/scripts/audit_sch.py` 几何对账器**（不依赖 EDA 自带 netlist，自带并查集成网），四项判据：
① 两端几何同网　**①b 两侧挂同名旗标 ⇒ 被并网短路**　② 一个网里出现两个旗标名　③ 含引脚却无旗标的匿名网。

#### B7（P0 电气缺陷）`R12` 形同虚设

| 项 | 内容 |
|---|---|
| **现象** | `LCD_BL_CTL = {EVK1.11, J5.28, R12.1, R12.2}` |
| **根因** | R12 两端**都挂了同名 `LCD_BL_CTL` 旗标** ⇒ EDA 按**网名**并网 ⇒ 1k 串阻被自己两端的标签短路 |
| **为何 DRC 不报** | 电气上不算"错误"（只是电阻没起作用）；且两脚分属两个**独立几何连通域**，常规"同网检测"抓不到 |
| **定位依据** | `EVK1.11` 引脚在 `(370,555)`、其旗标在 `(340,555)`；`R12.1/2` 在 `(280/320,555)`；`J5.28` 的旗标在 `(750,1100)` |
| **修法** | 把 **EVK1 侧**那颗旗标 `@(340,555)` 改名 **`LCD_BL_PB0`**（删除 + 原位 `createNetPort("BI", …)` 重建，沿用 rot=180） |
| **结果** | `LCD_BL_PB0 = {EVK1.11, R12.2}`　`LCD_BL_CTL = {R12.1, J5.28}` ✅ 串阻真正串在 `PB0 → J5.28` 通路里 |

#### B8（命名卫生）基准网名不再写死电压

依据 **D5**（"3.0V→1.5V / 3.3V→1.65V 两种都对"）+ **S-c**（"写成 VREF/2，去掉 3.3V 固定硬编码"）：

| 旧名 | 新名 | 旗标数 | 理由 |
|---|---|---|---|
| `VREF_3V3` | **`VREF_ADC`** | 4（AFE） | 核心板 REF3030 = **3.0V**，旧名可能本来就是假的 |
| `VREF_3V3_EXT` | **`VREF_CORE`** | 2（INT 1 + AFE 1） | 它是"从核心板取来的基准"，不是固定 3.3V |
| `VBIAS_1V65` | **`VBIAS`** | 7（INT 1 + AFE 6） | = `VREF/2`，3.0V 档下是 1.50V |

> **踩坑**：改端口名后 DRC 冒 2 条新警告 *"网络端口 X 的名称与所连导线名称 Y 不一致"* ——
> **导线自身也带 `net` 属性**（`getState_Net`），改端口名**不会**同步它。
> 用 **`sch_PrimitiveWire.modify(id, {net})`** 显式改（INT 页那 2 根跨页短线 `bf14435dd5614df3`/`8dd7720f713ef5f4`），DRC 即回 2 条。

**门禁**：**致命 0 / 错误 0 / 警告 2（仅器件标准化）** ✅

### 5.3 定稿 BOM（`bom_final.csv`，共 **49 个器件**，原 65 → 净减 16）

| 页 | 器件数 | 清单 |
|---|---|---|
| **INT** | ✅ **25**（2026-10-02；原记 3 —— 未含 10-01 落的 18 路串阻、10-02 落的 J5 去耦 `C21/C22` 与 `WR/RD` 阻尼 `R40/R41`） | `EVK1`(天空星 STM32F407VGT6-PRO) · **`J5`**(2×15 2.54 母座) · **`R12`**(1kΩ 串阻) |
| **PWR** | 10 | `J3`(DC005) · `D2`(SS34) · `C16`(22µF) · `C19/C20`(100nF) · `LED1`+`R11`(1k) · `R15/R16`(4.7k I²C 上拉) · **`R21`**(0Ω) |
| **AFE** | 36 | 原样保留（滤波 4L+4C、U1 双通道、R1~R10、C1/C9/C10~C13、JP1~JP3、TP1~TP6、J1、D1） |

**已删除（16 件 + 2 连接器）**：`U3 C16?→否 C17 C18` · `U2 C11?→否 C12?→否` · `Q1 R12(旧) R13 R14 R17 R18 R19 R20` · `H3 H4 J2 J4`
（注：`C11/C12/C16` **保留**，见 D6 / D8；旧 `R12` 位号被 INT 页新串阻复用）

### 5.4 上板前必须做的 3 件事（**不可省**）

| # | 事项 | 为什么 | 怎么做 |
|---|---|---|---|
| **①** | **核对 J5 的脚号-实物对应** | 库器件 `2.54-2*15P立贴母` 的**符号脚号是 U 形**（1~15 一列 / 16~30 另一列），而适配板丝印看起来是**列对式**（1&2 同列）。PCB 尚未落图，现不影响；落 PCB 前必须确认 | 万用表从 J5 的 1/2/3 脚量到适配板丝印 `CS/RS/WR` 的通断 |
| **②** | **J5 的 3 个 NC 脚**（6/23/25）已打 NO_CONNECT；`EVK1.9`(PC4) 已空出 | — | 已在图上落地 ✅ |
| **③** | **`LCD_RST` 复位脉冲 ≥ 5 ms** | 适配板上 `LCD_RST`/触摸 RST 挂着 **18K + 100nF 的 RC**（τ=1.8ms）；脉冲太短电容来不及放电，复位无效 | 固件里把 LCD 复位低电平保持改到 ≥5ms |

### 5.5 同步落到软件侧的 3 条（随硬件一起改）

| # | 改动 | 依据 |
|---|---|---|
| **S-a** | ⛔ **已被后续覆盖（2026-09-30 D1 修复 + 2026-10-02 落地）**：PC4 从 `TP_RST` 退役后**并未"空着不用"** —— VBIAS 自检脚从 PA1 挪到了它（`04 §1.1`/`§8`、`18 §9` 网表 `VBIAS={EVK1.9(PC4),…}`）。`.ioc` 与 `gpio.c` 于 **2026-10-02 改为"输入、不驱动"**；板级宏 `BOARD_TOUCH_RST_*` 已改名 **`BOARD_VBIAS_SENSE_*`**（原名已不成立）。触控复位仍由**屏 `LCD_RST` 共用**（适配板 18K+100nF）。原表述：`PC4` 从 `TP_RST` 退役（图上已空）；`.ioc` 里 PC4 改 **未用/输入**，`board_config.h` 的 `BOARD_TOUCH_RST_*` 标为**与 LCD_RST 共用** | D4 / B5-c |
| **S-b** | `PC5`（TP_INT）改 `GPIO_Input + Pull-up` | `12 §9.1` |
| **S-c** | VBIAS 口径写成 **VREF/2**（1.50V / 1.65V 两候选），去掉"3.3V 固定"硬编码；上电自检读 `PA1` 判"模拟轨 + 基准在线" | D5 / `12 §9.2` |

---

### 5.6 B10：**屏幕接口 SMD → 通孔直插**（2026-09-30，用户指令"15 对 pin 的屏幕插口换成通孔的插件，不要贴片"）

#### 为什么不是"换个器件"这么简单

| 件 | 符号脚号编排 | 封装 | 可购 |
|---|---|---|---|
| 原 `J5` `2.54-2*15P立贴母`（C5122337） | **U 形**（1~15 左列到底，16~30 右列回来） | `HDR-SMD_…` 贴片 | ✓ |
| **新 `J5` `2.54-2*15P母`（C58377, BOOMELE）** | **标准逐行式**（1&2 同行） | `HDR-TH_30P-P2.54-V-F-R2-C15-S2.54` **通孔** | ✓ |

两种编排**逐个脚都不同**（仅 pin1/pin30 重合）⇒ 换件必须**重排 27 条扇出**。
而**换得对**：适配板丝印是 `CS/RS`、`WR/RD`… **成对**的，即标准逐行编排；
§4 的网表本来就是照"逐行"写的 ⇒ 换到 C58377 **顺便把 `§5.4-①` 那条隐患消掉**，
且改完图上**逐行显示成 `CS|RS`**，与实物丝印一致。
⚠️ **但"成对"不等于"同行两个数据位是一对"**：正确配对是 `(RST, D00)`、`(D01, D02)`…（见 §4 更正）。
原文此处隐含的 `(RST,空)`、`(D01,D00)` 读法**是错的**，已在 §4 表内改正（2026-10-04）。

#### 落地结果（全部实读回验）

| 项 | 结果 |
|---|---|
| `J5` 器件 | `2.54-2*15P母`（BOOMELE）· 封装 `HDR-TH_30P-P2.54-V-F-R2-C15-S2.54`（**通孔直插**） |
| 30 个脚位 | 逐脚回读，与预期**0 不符** |
| 27 条扇出 | 导线+旗标全部按新脚位重建；`net→脚号` 与 **§4 表逐条吻合** |
| NC | `J5.6/23/25` 打上（源码注入）⇒ 全页 NO_CONNECT **48 → 51** |
| 属性 | 位号 `J5` + 厂牌/编号/`直插`/`30P`/`Pitch`/`Row Spacing` 等 34 条 ATTR 齐备 |
| **DRC** | **致命 0 / 错误 0 / 警告 2（仅器件标准化）/ 信息 2** ← 与基线一致 ✅ |

#### ⚠️ 本轮我犯的错（已全部修复，逐条记账）

1. **误删了 U1 的供电落点**：AFE 页 3 个"无导线旗标"被我当冗余删掉，其中
   `AGND@(760,1000)` / `+5V_A@(760,1100)` 其实是 **`U1.4`(V−) / `U1.8`(V+)** 唯一的落点 ⇒ 供电脚悬空。
   **根因**：`delete` 端口会**连带删掉它的短线**，重建端口时短线不回来（台账 **T-43**）。
   **已修**：补回 3 个旗 + 3 根短线（坐标与原端口一致），并补回 `{R3.1,U1.1,U1.2}`（单位增益缓冲）
   与 `{JP1.2,R2.1,U1.3,TP2.1}`（缓冲输入节点，跨度 320 单位 ⇒ 按 skill E1 用净标签 `AFE_BUF_IN`）。
2. **逐条 delete 触发桥 HTTP 500**，留下 27 个重复旗标 + 4 根零长度导线 ⇒ 改**数组批量删 + 一次批量建**（台账 **T-45**）。
3. **`modify()` 打断器件→封装映射**，DRC 报"引脚与焊盘未对应"（错误）⇒ 最终**全程不调 `modify`**：
   位号走 `create` 句柄的 `toAsync()`，属性+NC 合并成**一次**源码注入（台账 **T-42**）。

#### 改动后仍有效的旧结论

- `§5.2.3-B7`（`R12` 被并网短路）：`LCD_BL_CTL = {J5.28, R12.1}`、`LCD_BL_PB0 = {EVK1.11, R12.2}` ✅
- `§5.2.3-B8`（基准网名去值化）：`VREF_ADC` / `VREF_CORE` / `VBIAS` ✅
- `§5.2.1`（旗标残骸清零）✅

#### 上板前仍须做的一件事（来自 §5.4-①，**本次未消，只是口径更明确了**）

用万用表从 **J5 的 1/2/3 脚**量到**适配板丝印 `CS/RS/WR`** 的通断，确认"1&2 同行"。
现在原理图与标准件都是逐行编排，若实测不是，需割改 PCB 或改焊适配板。

---

### 5.7 B11：**输入端子 BNC → SMA 贴片座**（2026-09-30，用户方案）

**用户方案**：用 **SMA 贴片端子** + 后面接 **50Ω 电阻**（配 BNC→SMA 转换头接示波器）。

#### 勘察结论：50Ω 端接**本来就是对的，不用动**

```
J1 ──┬── R1 = 49.9Ω ── AGND      ← 50Ω 端接（49.9Ω 正是标准 50Ω 端接值）
     ├── D1 = SRV05-4 (TVS)        ← ESD，同节点就近
     ├── TP1                        ← 测试点
     └── C1 = 100nF(1206 C0G) ── JP1(0Ω) ── 缓冲器
```

#### 换件结果

| 项 | 结果 |
|---|---|
| `J1` 器件 | `BY-BNC-50KWE`(直插 BNC) → **`SMA-KE`（C9900004802）** |
| 封装 | `CONN-TH_BY-BNC-50KWE` → **`SMA-SMD_SMA-KE`（贴片）** |
| 脚位 | 新旧**逐个完全一致**（1(100,1080) 2(120,1080) 3(120,1020) 4(100,1020) 5(140,1050)）⇒ 扇出几何不变 |
| 连线 | 4 屏蔽脚：短线 + `AGND` 旗（原坐标）；中心脚：接回信号节点。**9 个脚逐一回读「有导线」** |
| 属性 | `partId = SMA-KE.1`（器件级绑定）；21 条库属性 EDA 自动写入 + 补 `Value=SMA-KE` |
| **DRC** | **致命 0 / 错误 0 / 警告 2（仅器件标准化）/ 信息 2** ← 基线一致 ✅ |

#### ⚠️ 落 PCB 时必须遵守的两条（**不是建议，是判据**）

1. **`R1`(49.9Ω) 必须紧贴 SMA 中心针（≤2~3mm）** —— 中间那段走线就是电感，越长匹配越烂。
   图上距离 180 单位是**原理图坐标**，不影响；PCB 上必须贴着排。
2. **贴片 SMA 座的机械弱点要人为补偿** —— 插拔力与线缆弯扭力全压在 SMD 焊盘上（用户已确认选贴片）：
   - 座子**尽量靠板边**，让外壳/法兰能顶到机壳或承力结构；
   - 焊盘**加宽铺铜 + 多打过孔**到地；
   - 有条件时在座子周边**灌锡/加结构胶**；
   - 拔线时**捏住座子**而不是拉线。

> 用户已明确选择贴片方案（机械风险已知悉）。

---

### 5.8 B12：**两处致命缺陷修复 + C14 去耦补齐**（2026-09-30，AFE 页）

> 触发：用户提出"继续优化电路设计（感觉还缺两个跟随器）"。**先做全页跨页命名网逐条核对**，
> 抓出两处 **DRC 全绿但上电即废** 的接线缺陷（DRC 计数改动前后完全一致：全部 4 / 致命 0 / 错误 0 / 警告 2 / 信息 2）。

#### 缺陷①（致命）**U1A 缓冲输出被并入 `+5V_A` 电源网**

| 项 | 内容 |
|---|---|
| 现状（实读） | 一条合并折线把 U1A 输出节点 `{U1.1, U1.2, R3.1}` 经 `(830,1100)→(760,1100)` 连到 `(760,1100)` 的 `+5V_A` 旗标（该旗标是 `U1.8`(V+) 的供电落点）⇒ 网表 `+5V_A = {C11.1, D1.5, R3.1, U1.1, U1.2, U1.8}` |
| 来源 | B10 修复"补回 U1 供电落点"时，把 U1A 输出的绕行线画到了 `(760,1100)` 这一点上 |
| 后果 | 落 PCB 后运放输出直连 5V 轨：U1A 输出级持续对电源灌电流（短路保护态），R3→LC→后级全被钉在 +5V |
| 为何 DRC 不报 | "输出并进电源网"不是电气规则违规（两连通域挂同名旗标 = EDA 眼里的正常跨距离连接）|
| 修法 | 删该合并折线，重画 3 段：输出主线 `(800,1050)-(880,1050)` / U1.2 反馈绕行 `(720,1060)→(690,1060)→(690,1140)→(830,1140)→(830,1050)`（**绕开 (760,1100)**）/ U1.8 供电短线 `(760,1080)-(760,1100)` |
| 验证 | 网表回读 `+5V_A = {C11.1, D1.5, U1.8}`；`{R3.1, U1.1, U1.2}` 恢复独立匿名节点 |

#### 缺陷②（致命）**`R7` 落点在 AGND ⇒ U1B 直流饱和**

| 项 | 内容 |
|---|---|
| 现状（实读） | `U1B` 同相 ×4：`+in` 偏置 `VBIAS`（经 R5 10k），`−in` 侧 R6(30k) 到输出、**R7(10k) 到 AGND** |
| 直流点计算 | `Vout = VBIAS × (1 + R6/R7) = 4 × VBIAS ≈ 6.0~6.6V > 5V 轨` ⇒ **输出饱和在上轨，整机测不出任何信号** |
| 修法 | `R7.1` 的落点由 AGND 改 **VBIAS**（原位：删 `AGND@(2140,1290)` 旗标 → 重建 `VBIAS` 净标签；短线 `(2140,1290)-(2140,1270)` 未受连带删除，保留） |
| 验证 | 网表回读 `VBIAS = {C13.1, R10.1, R2.2, R5.2, R7.1, R9.2, TP5.1}`、`AGND` 不再含 `R7.1`；直流输出 = VBIAS、AC 增益 = 4（不变） |

#### 决策：**不加跟随器**（用户拍板 2026-09-30）

原话"感觉还缺两个电压跟随器 OPA2197"。逐候选量化后**不加**：

| 候选位置 | 量化收益 | 结论 |
|---|---|---|
| LC 输出"后跟随"（R4 终接节点 → 跟随 → C9） | ≈0：U1B 同相输入高阻、C9(100nF) 串入，对 49.9Ω 终接节点加载可忽略（500kHz 处 C9≈3.2Ω 串 R5 10k） | 不加（与 `02-architecture §3`"不加第三管"一致） |
| VBIAS 缓冲（R9/R10 5k 源阻抗 → 跟随 → 低阻偏置） | 小：R7 反馈电流 6.25µA 经 C13(10µF, @10kHz≈1.6Ω) 仅产生 ~10µV 误差（0.016%），可忽略 | 不加 |

#### 补件：`C14` = 100nF 0805 X7R（`CC0805KRX7R9BB104`）——U1 电源去耦

12 号评审 §9.4"加项 2"（U1 V+ 就近 100nF），定稿时漏做。本次补齐：

| 项 | 结果 |
|---|---|
| 器件 | `C14` @(880,1200) rot=90（AFE 页）· `Value=100nF`（EDA 从库器件**自动带全**，无需回填） |
| 扇出 | `C14.2`(上) → `+5V_A` 旗标 @(880,1240)（rot=270）· `C14.1`(下) → `AGND` 旗标 @(880,1160)（rot=90） |
| 配方 | 按台账 T-42/T-48：`create({libraryType:"DEVICE", libraryUuid, uuid})` + **`toAsync().setState_Designator()` 设位号**、**全程不调 `modify()`** ⇒ DRC 无"引脚与焊盘未对应" |
| 验证 | `+5V_A` 含 `C14.2`、`AGND` 含 `C14.1`；DRC 与基线一致 |

#### 验收（三件套 + 目视）

| 判据 | 结果 |
|---|---|
| 几何回读 / `audit_sch.py` 判据（1/1b/2/4） | 全"无"（三页） |
| **EDA DRC（唯一权威）** | **全部 4 · 致命 0 · 错误 0 · 警告 2 · 信息 2 —— 与改前基线逐项一致** |
| 视觉复核（`easyeda-viewer`） | `AFE.esch2` obj=200 / **unknown=0** |
| 快照 | `_review/final-20260930/`（含修复前后源码）；本轮操作脚本 `_fix_afe_ab.py`·`_add_c14.py`（带干跑与回读自证） |

> ⚠️ **重要提醒**：改动经 API 落到实时文档，**请在 EDA 里 Ctrl+S 保存一次**。
> ⚠️ **教训**：两处缺陷都在 DRC 盲区（"输出并入电源网"与"偏置接错地"都不是电气规则违规）。
> **跨页命名网逐条核对**（audit_sch.py 的命名网总表 + 人眼对成员合理性）是落图后必做的一道，不能只看 DRC 计数。

---

## §6 变更记录

| 日期 | 变更 | 谁 |
|---|---|---|
| 2026-09-29 | 定稿决策 D1~D11；目标态器件表；实施批次 B0~B6；J5 逐脚映射 | AI（用户已授权"做吧"） |
| 2026-09-29 | **实施完成**：B0~B6 全部落地；DRC **致命 0 / 错误 0**（剩 2 条器件标准化）；净减 16 器件；注释清理 28 条；备份与快照 `_review/final-20260929/`；BOM `bom_final.csv` | AI |
| 2026-09-30 | **B10**：屏幕接口 SMD→通孔直插（J5 换 `2.54-2*15P母` C58377，27 条扇出重排 + NC 注入） | AI |
| 2026-09-30 | **B11**：输入端子 BNC → SMA 贴片座（`SMA-KE`，脚位一致，扇出不变） | AI（用户方案） |
| 2026-09-30 | **B12**：修复两处致命缺陷（U1A 输出并入 `+5V_A`；`R7` 接 AGND 致 U1B 饱和）+ 补 `C14`(100nF 去耦)；**决策：不加跟随器**（量化）；DRC 与基线逐项一致 | AI（用户拍板不加跟随器/补 C14） |
