funiang-x/G2026/hardware/14-全链路审核-20260930.md

# G2026 硬件 · 全链路审核（需求 → 选型 → 连接表 → 原理图设计）· 2026-09-30

> 性质：**只读审核**。本报告不改图、不改文档、不改固件。
> 方法：**全部读数来自 EDA 实时回读**（不是来自既有文档），再与文档逐条对账。
> 三态口径：**已验证**（附命令/读数）/ **未验证**（说明为何没做）/ **不适用**。
> 工作台铁律 1：凡涉及"上板"的结论一律为**未验证**——装置尚未制造。

---

## §0 本次取到的实时读数（复核命令可复现）

| 项 | 命令 | 结果 |
|---|---|---|
| EDA 桥 | — | 端口 **49620**，EDA 已连接（`lceda-pro.exe` 在跑） |
| 器件体检 | `eda_sch.py audit --all` | INT 3 / PWR 10 / AFE 38（共 **51** 个符号，U1 双符号=1 片）· NC 51/0/3 · 空「值」0 |
| DRC（唯一权威） | `eda_sch.py drc --all` | 三页均 **全部 4 · 致命 0 · 错误 0 · 警告 2 · 信息 2**（警告=器件标准化） |
| 几何对账 | `rules/tools/eda/audit_sch.py` | 判据 1 / 1b / 2 / 4 **全"无"**（无元件被短路、无一域多网名、无孤儿旗标）；判据 3 匿名网均为正常内部节点 |
| 跨页命名网总表 | 同上 | 34 个命名网逐条列出，见 `_audit_now.txt` |
| 元件值 / 封装 / 厂牌 | `_audit_values.py`（页面源码解析） | 见 `_audit_values.txt` |
| EVK1 脚→MCU 脚 | `_audit_dump.py` | 84 脚全表，见 `_audit_evk_pinmap.txt` |
| 视觉复核 | `viewer.py dump + render` | AFE obj=269 / PWR 111 / INT 191，**unknown 全 0** |
| 数值复算 | `_audit_afe_calc.py` | LC 频响 + 电平/折叠预算（本报告 §3） |

> ⚠️ `viewer.py` 默认找 `~/easyeda-viewer`，本机实际在 `D:\JLC\easyeda-viewer`
> ⇒ 必须带环境变量 `EASYEDA_VIEWER_DIR="D:/JLC/easyeda-viewer"`（已回写 `rules/machine.md` §3）。

---

## §1 阶段一：需求冻结（01-requirements.md）

**结论：可打 85 分。约束表完整、判据量化、[TBD] 显式标注——这套需求表是合格的。**

| 判据 | 结果 |
|---|---|
| 约束表 15 项齐备（功能/带宽/ADC/精度/前端/显示/触摸/供电/形态/工艺/成本/交期/供应链/层数/环境） | ✅ |
| 判据级约束可量化（折叠带起点 1.5MHz、衰减 ≥42.5dB、5mV 绝对误差） | ✅ |
| 假设项显式标 [TBD-3~6] 而非默默假设 | ✅ 良好 |
| 手焊约束写进约束表（禁 QFN/BGA） | ✅ 良好 |

**发现**

| # | 级 | 内容 |
|---|---|---|
| A1 | P2 | **成本/交期/供应链仍是 [TBD-3/4/5]**，BOM 至今没有价格与库存复核（03 §4 表里 5 处"需联网查证"至今未查）。按 `20 §1` 坑清单"只比参数不比供货"是选型第一大坑。 |
| A2 | P2 | ✅ **[TBD-6] 已拍板 = 2 层**（2026-10-01，见 `16 §4-1` / `22`）—— 原表述"底板 4 层 vs 2 层未拍板"，而 PCB 尚未落图——这是落 PCB 的第一个阻塞项（mV 级模拟 + FSMC 共板，建议 4 层）。 |
| A3 | P1 | 01 §1 第 5 行与 §2 写的滤波器口径是 **fc=800kHz / L=3.9,16,20,11µH / C=4.3,7.5,6.8,1.6nF**；**图纸实落的是 fc≈648kHz / L=4.7,22,22,12µH / C=5.6,10,10,1.8nF**（见 §3）。需求文档与实现不符，且是三份文档（01/02/03）集体过时。 |

---

## §2 阶段一：架构与选型（02 / 03）

**结论：架构决策站得住，且有"拒绝的理由"记录——这是本方案最扎实的部分。**

已验证为正确的架构判断（本次复核未发现反证）：

1. **无源 LC 8 阶 + OPA2197 优于有源 SK** —— 有源需 GBW≥205MHz 运放且 Q=2.56 有稳定性风险；无源零运放门槛。✅
2. **增益必须放在滤波器之后** —— 否则 u_J ±400mVpk 打进运放产生 IM3，滤波器**无法去除**（失真产生在滤波之前）。这个判断是本案最关键的一条。✅
3. **50Ω 端接的 ×0.5 当作免费抗混叠增益**。✅（但见 §3-B，链路里还有第二个 ×0.5 被漏算）
4. **核心板 + 底板分板**：核心板自带 MCU/LDO/基准/Flash/晶振/保护，底板只放接口与模拟。✅
5. **背光禁 PWM**（谐波列整列落进 10k~500kHz 分析带）。✅ 且 `board_config.h` 已把 PB0 锁死为纯开关、固件 `bsp_lcd.c` 只做电平。✅
6. **不加第三只跟随器**（×4 已是低阻驱动，再加一级只多 droop 与失真源）。✅ 13 §5.8 已量化复核。

**发现**

| # | 级 | 内容 |
|---|---|---|
| B1 | **P0** | **链路总增益算错，ADC 欠驱动 6dB。** 实际总增益 = 0.5(输入 50Ω 端接) × **0.5(LC 双端接插入损耗)** × 4 = **1.0**，而 01 §1 第18行 / 02 §3 的电平预算按 2~4 计（LC 双端接梯形从源电动势到负载的 DC 传输就是 0.5，教科书结论，实测复算 DC |H|=0.4999 佐证）。⇒ 最坏 ADC 摆幅 **±125 mVpk**（非文档的 ±250mVpk / ±0.9V），**ADC 量程利用率仅 ~8%**。详见 §3。 |
| B2 | P2 | 03 §3 风险表 R6（替代料实时价/库存）**从未复核**；R2（电感 SRF/DCR）只在选型卡写了门槛值，未落到具体料号的 datasheet。 |
| B3 | P2 | 03 §1 第 8 行「输入 TVS 型号 **阶段二定型号（需联网查证）**」——实际图上落了 `D1 = SRV05-4`（Cj≈1.5pF，✅ 满足 ≤5pF），但**03 文档没回填**。 |

---

## §3 阶段二→三：AFE 数值独立复算（`_audit_afe_calc.py`）

> 输入全部取自图纸实读值，不取自文档。

### 3.A 抗混叠：大幅优于判据 ✅

| 项 | 值 | 判据 | 结论 |
|---|---|---|---|
| 实落图 LC（L=4.7/22/22/12µH，C=5.6/10/10/1.8nF，Rs=RL=50）等效 fc | 反解各元件得 **529~737 kHz**（均值 648 kHz，离散 32%） | — | 图纸注释写 660 kHz，属"名义值" |
| 通带 10k~500kHz 起伏 | **≤0.14 dB** | LTI 可标定 | ✅（17 点标定可吸收，残差 0.023mV） |
| **@1.5MHz 衰减（相对通带）** | **−59.3 dB** | ≤ −42.5 dB | ✅ **余量 16.8 dB** |
| @2.5MHz | −88 dB（相对通带） | — | ✅ |
| 折叠残留（u_J 200mVpp，输入端折算） | **0.027 mVpk** | < 1.5mV 峰门限 | ✅ **余量 55×**（文档口径为 0.655mV） |
| −3dB 带宽 | ≈ 570 kHz | > 500kHz | ✅ |

> 与既有文档的关系：12 §2 点 6 写"fc=660k、折叠带最差 −59.3dB、余量 16.8dB" —— **本次独立复算逐位吻合**，该结论可采信。
> 与 01/02/03 的关系：它们写"fc=800k、@1.5M −43.7dB" —— 那是**另一套元件值**，图纸没采用。

### 3.B 电平预算：ADC 欠驱动 6dB ⚠️

| 节点 | 文档预算（02 §3） | **本次实算** | 差 |
|---|---|---|---|
| 端接节点（u_b 250mVpp ⊕ u_J 200mVpp） | ±112 mVpk | ±112.5 mVpk | ✅ |
| BUF1 出 | ±112 mVpk | ±112.5 mVpk | ✅ |
| **LC 出（带内，u_b 单算）** | ±62.5 mVpk | **±31.2 mVpk** | **÷2** |
| **×4 出 = ADC 输入** | ±250 mVpk | **±124.7 mVpk** | **÷2** |
| ADC 摆幅（@VBIAS 1.5V） | 1.40~1.90 V | 1.375~1.625 V | 实际仅用 250mV / 3000mV |
| OPA2197 轨余量 | 1.4 V | **3.38 V** | **大量富余没用上** |

**两条后果**

1. **SNR 白丢 6 dB**（信号减半而 ADC 噪声不变）。经 N=4096 处理增益后量化项仍 ≪5mV，所以**不是致命**，但是白给的性能。
2. **`BOARD_FRONT_GAIN 4U` + `lsb_in_mv = 3300/4096/GAIN` 的 mV 折算系数错约 3.6 倍**（真实应为 `VREF/(4096×1.0)`，VREF 大概率 3.0V ⇒ 0.732mV/码，而非 0.201mV/码）。
   - 17 点标定**能**吸收这个常数尺度误差（它就是一个频率无关的 LTI 增益）；
   - **但 1.5mV 峰门限若作用在标定之前**，实际门限被抬到 ≈5.5mV（输入端）⇒ 可能漏掉小幅值谐波分量，直接影响 Upp/Urms。
   - ⇒ **必须**：① 明确"门限 vs 标定"的先后；② 重跑 `tools/verify_dsp.py` 并按真实总增益 1.0 + 实测 VREF 回填。

**建议（可量化收益，零风险）**：增益 ×4 → **×8**（R6 30k→70k；或 R6=39.1k / R7=5.6k）
- OPA2197 ×8 闭环带宽 = 10MHz/8 = **1.25 MHz**（@500kHz droop −0.65dB，LTI 可标定）
- 压摆率需求 = 2π×500kHz×0.45V = **1.41 V/µs ≪ 20 V/µs** ✅
- 最坏输出摆幅 1.05~1.95 V（VREF 3.0V 下仍在 0~3.0V 内）✅
- **混叠余量不变**（信号与残留同比放大）；白捡 **6 dB**，ADC 利用率 8%→16%
- （×16 会把闭环带宽压到 625kHz，与 500kHz 分析带太近，不推荐）

### 3.C 链路拓扑逐节点核对 ✅

```
J1(SMA-KE).1 ─┬─ R1 49.9Ω → AGND        端接 ✅（R1 必须贴 J1，见 13 §5.7）
               ├─ D1.4 SRV05-4           ESD ✅（D1.5→+5V_A 轨钳位；D1.1/3/6 NC）
               ├─ TP1                    测试点 ✅
               └─ C1 100nF(C0G) → JP1(0Ω) → AFE_BUF_IN
AFE_BUF_IN ── U1.3(+inA) ; R2 10k→VBIAS 偏置 ✅（fc_hp=159Hz ≪ 10kHz）
U1A: U1.1=OUT ─ U1.2=−in（单位增益缓冲 ✅）；U1.1→R3 49.9Ω→L1
LC: L1(4.7µH) ─ C2(5.6nF)↓ ─ L3(22µH) ─ C4(10nF)↓ ─ L5(22µH) ─ C6(10nF)↓ ─ L7(12µH) ─ C8(1.8nF)↓
    ⇒ 首元件串联、末元件并联，双端接 50Ω 规范 **8 阶梯形结构正确** ✅
R4 49.9Ω → AGND（终接）✅ ；TP3 在 LC 出 ✅
C9 100nF → U1.5(+inB) ; R5 10k → VBIAS 偏置 ✅
U1B: R6 30k / R7 10k → **增益 = 4** ✅（R7.1 落 VBIAS，13 §5.8 的修复有效，直流输出 = VBIAS 不饱出轨 ✅）
U1.7 → R8 100Ω + C10 470pF → JP2(0Ω) → AFE_ADC_IN → EVK1.3
U1.4(V−)→AGND · U1.8(V+)→+5V_A · C14 100nF 就近去耦 ✅
R9/R10 = 10k/10k：VREF_ADC → VBIAS → AGND ⇒ VBIAS = VREF/2 ✅（ratiometric 于 VREF，漂移自抵消 ✅）
```

---

## §4 阶段二：pinout / 连接表 / 电源树（04）

### 4.A MCU 引脚逐条核对（本次实读，对照 RM0090 LQFP100）

| EVK1 脚 | MCU | 复用 | 网络 | 判定 |
|---|---|---|---|---|
| 3 | PA0 | ADC1_IN0 | AFE_ADC_IN | 图上正确，**固件不对**（见 P0-1） |
| 4 | PA1 | ADC1_IN1 | VBIAS | 同上 |
| 11 | PB0 | GPIO | LCD_BL_PB0 → R12 1k → LCD_BL_CTL | ✅ |
| 12 | PC5 | GPIO | TP_INT | ✅（配置待改，见 P1-3） |
| 13–24 | PE7–PE15 / PB10 / PB11 | FSMC_D4~D12 / I2C2_SCL / I2C2_SDA | LCD_D4~D12 / TP_SCL / TP_SDA | ✅ |
| 14 | PB1 | GPIO | LCD_RST | ✅ |
| 29–32 | PD9/PD8/PD11/PD10 | FSMC_D14/D13/A16/D15 | LCD_D14/D13/RS/D15 | ✅ |
| 35/36 | PD15/PD14 | FSMC_D1/D0 | LCD_D1/D0 | ✅ |
| 67 | PD7 | FSMC_NE1 | LCD_CS | ✅ (Bank1 0x60000000) |
| 69/70 | PD5/PD4 | FSMC_NWE/NOE | LCD_WR/RD | ✅ |
| 71/72 | PD1/PD0 | FSMC_D3/D2 | LCD_D3/D2 | ✅ |
| 2 | REF | — | VREF_CORE | ⚠️ 见 P1-4 |
| 37 | AGND | — | AGND | ✅ |
| 38/78 | 3V3 | — | +3V3 | ✅ |
| 39/77/79 | GND | — | GND | ✅ |
| 40/80 | 5V0 | — | +5V | ✅ |
| 9 | PC4 | GPIO | ~~**NC**~~ → **VBIAS**（09-30 D1 修复把 VBIAS 挪入此脚） | ✅（D4 已删 TP_RST；⚠️ 原"NC"口径已过时，实况见 `04 §1.1` 与 `18 §9` 网表 `VBIAS={EVK1.9(PC4),…}`） |
| 其余 48 脚 | — | — | NO_CONNECT | ✅ |

**FSMC 映射与 RM0090 完全一致，无一错脚。** 已用引脚 36 / NC 48 / J5 NC 3 = 84+3-… 全部有明确去向，无悬空未声明。✅

### 4.B 电源树（实读网表）

```
J3(DC005) → +5V_RAW → D2(SS34 防反) → +5V ─┬─ EVK1.40/80（核心板）
                                            ├─ C16 22µF
                                            └─ R21(0Ω) → +5V_A ── C11 22µF / C14 100nF / D1.5 / U1.8 ✅
+3V3 ← EVK1.38/78（核心板 LDO）→ J5.30 / C19 / C20 / R11(LED指示灯) / R15 / R16(I²C 上拉) ✅
VBIAS ← VREF_ADC(R9/R10) ✅ ；VREF_ADC ← JP3(0Ω) ← VREF_CORE ← EVK1.2 ⚠️
```

| # | 级 | 内容 |
|---|---|---|
| C1 | — | 12 §5 **P0-1（+5V_A 无电源）已闭** ✅（R21 0Ω + C14 已落，网表可追到 +5V）——当轮最致命的坑已修好。 |
| C2 | — | 12 §5 **P0-2（3.3V 双 LDO 并联）已闭** ✅（+3V3 只剩 EVK1.38/78 一个来源）。 |
| C3 | **P1** | **背光电流改由核心板 3.3V 经 J5.30 供给（13 D3 的连带后果），电源树没重算。** 规格 If=60mA；而厂家通用转接板是 **LED-A 直挂 3.3V 且无任何限流电阻**（12 §1.3）⇒ 实际电流可能远超 60mA。核心板 `SCJA1117B-3.3` 要额外扛这一路；且 **J5 只有 1 根 3V3 + 1 根 GND 针**，背光回流与数字回流共一根针 ⇒ 压降/EMI 风险。 |
| C4 | **P1** | **12 §7 T1（背光 A–K 内含串阻否）至今未做**，而 13 §5.4「上板前必须做的 3 件事」**漏列了它**。这是"上电即烧/过流"的硬门槛。 |
| C5 | P2 | 04 §1.7 自述「§1.2/§2/§3 仍是旧口径（H3/H4/AMS1117/+5V_MAIN），待下一轮改」——**至今未改**。 |

---

## §5 阶段三：原理图设计（05–13）

### 5.A 已确认健康 ✅

| 项 | 状态 |
|---|---|
| EDA DRC | 全部 4 · 致命 0 · 错误 0 · 警告 2（仅"器件标准化"）· 信息 2 —— 与 13 的基线**逐项一致** |
| 几何对账 4 判据 | 全"无"（无元件被同网名短路 / 无隐性短路 / 无孤儿旗标 / 无死线） |
| `R12` 1k 串阻 | **真串在 PB0→J5.28 通路里**（`LCD_BL_PB0={EVK1.11,R12.2}` / `LCD_BL_CTL={R12.1,J5.28}`）—— 13 §5.2.3-B7 的修复有效 ✅ |
| 基准网名去值化 | `VREF_ADC` / `VREF_CORE` / `VBIAS` 已生效 ✅ |
| AFE 页注释 fc | 已是 **660kHz**，与实落元件一致（12 §5 P1-4a 已闭）✅ |
| `LED_A`→`PWR_LED` | 已改，板载指示灯自闭环、对外零连接 ✅ |
| 旗标残骸 / 死线 | 三页均为 0 ✅ |
| B10/B11/B12 | J5 通孔直插、J1 换 SMA-KE、两处致命缺陷修复 + C14 补齐 —— **全部在图上落地并逐脚回读** ✅ |
| 视觉复核 | 三页 `unknown=0`（AFE 269 / PWR 111 / INT 191 对象）✅ |

### 5.B 缺陷清单

| # | 级 | 缺陷 | 证据 | 处置 |
|---|---|---|---|---|
| **D1** | **P0** | **ADC 通道软硬对调**：图/04 表 = PA0 信号 + PA1=VBIAS；固件 `.ioc` `ADC1.Channel-1=ADC_CHANNEL_1` + `PA1.Signal=ADCx_IN1` + `BOARD_ADC_IN_PIN 1` ⇒ **固件采的是 VBIAS 直流，AFE 信号落在 PA0 无人采样** | `.ioc` L2/L135；`board_config.h` L335/L337；`_audit_now.txt` `AFE_ADC_IN: EVK1.3`、`VBIAS: EVK1.4`；`_audit_evk_pinmap.txt` EVK1.3=A00、EVK1.4=A01 | 分叉：先确认核心板 PA0 是否真有 SW2 按键（board_config 称"2026-09-23 上板验证过"，但本项目 `hardware/`、`docs/` 内**0 处佐证**）。有 ⇒ 改图（AFE→PA1、VBIAS→空闲脚如 PA2/PA3）；无 ⇒ 改固件回 PA0。**两边必须同步** |
| **D2** | **P0** | mV 折算系数错 ≈3.6×（见 §3-B）：真实总增益 **1.0**，VREF 大概率 **3.0V**；代码按 `3300/4096/4` | `board_config.h` L342 `BOARD_FRONT_GAIN 4U`；`_audit_afe_calc.py` §3-B | 改 `BOARD_FRONT_GAIN` 为净增益、VREF 用实测值；重跑 `verify_dsp.py`；明确 1.5mV 门限与标定的先后 |
| **D3** | P1 | **PC5(TP_INT) 在 `.ioc` 仍是 `GPIO_Output` 初始低**，而它是 FT6206(FT6x06) 的开漏输出脚 | `.ioc` PC5.Signal=GPIO_Output, PinState=RESET；README「⚠️ 留给人的（上板前）」亦列此项 | 改 `GPIO_Input + Pull-up`（12 §9.1 S1 定好的方案，省掉外部上拉）。当前固件轮询不读 INT 故不致命，但会把 INT 钉死 |
| **D4** | P1 | **核心板 `EVK1.2(REF)` 默认由谁驱动未实测**（12 §7 T3）。若核心板走板载 REF3030 或内部 3V3，则 `EXT_PIN_VERF+` 排针可能是**空脚** ⇒ `VREF_ADC`=0 ⇒ `VBIAS`=0 ⇒ **整个 AFE 偏置归零** | 12 §1.2 P.6「三路参考电压，三者存其一」；13 D5 把它当成"必有一路导通"的假设 | 上电前万用表测 EVK1.2 对地电压（30 秒）。有自检（PA1 读 VBIAS）与救援（回装 U2 REF3033，AFE 页留位） |
| **D5** | P1 | **背光电流改由核心板 3.3V 供（D3 连带）+ T1 实测未做**（见 §4 C3/C4） | 12 §1.3；13 D3 | 上板前测 A–K 特性；必要时割适配板 LED-A→3V3 铜皮串电阻 |
| **D6** | P1 | **BOM 的「封装」与「供应商编号」列几乎全空**（仅 U1 有 SOIC-8） | `bom_final.csv` | 按 `20 §3` 坑清单"封装列才是核对重点"，下单前必须补齐 |
| **D7** | P2 | ADC 欠驱动 6dB（见 §3-B），建议 ×4→×8 | `_audit_afe_calc.py` | 白捡 6dB，零风险 |
| **D8** | P2 | **C12 = 22µF 钽电容直挂 `VREF_ADC`（基准输出）**。REF30xx 类基准的容性负载远小于此，且钽容漏电/ESR 会引入基准误差 | `_audit_values.txt`（TAJB226K016RNJ） | 改 1~4.7µF 陶瓷；核 REF3030 datasheet 的容性负载范围 |
| **D9** | P2 | **PC4(TP_RST) 在 `.ioc` 仍是 `GPIO_Output` 高**，而图上 EVK1.9 已 NC | `.ioc` PC4；`_audit_now.txt` INT NC 含 EVK1.9 | 标 unused（13 §5.5 S-a 定的，未做）。无害但是配置/图不符 |
| **D10** | P2 | ✅ **已闭（2026-10-02）**：触发条件已命中并落图（PPTC=`F1`、33Ω×18=`R22`~`R39`，见 `22` 号）。原判：**PPTC 自恢复保险、FSMC 33Ω 串阻 ×17** 按 12 §9.1「触发条件制」挂账不落图——决策有据，但**触发条件没写进任何待办**，实测暴露耦合时容易漏 | 12 §9.1 | 在 13 或 04 里立一条"实测触发项" |
| **D11** | P2 | **J5 脚序实测未做**（13 §5.4-①）：图上按"标准逐行式"（C58377），若适配板丝印不是逐行 ⇒ 需割线/改焊 | 13 §5.6 末 | 万用表从 J5 的 1/2/3 脚量到适配板 `CS/RS/WR` |
| **D12** | P2 | **触摸 IC 型号未确认**：固件按 **FT6206(FT6x06)(0x38)**，若实物是 **GT911(0x5D/0x14)** 则 `bsp_touch` 全废 | 04 §6.10 ②；`bsp_touch.c` 用 0x38 | 读转接板上那颗小 IC 的丝印（30 秒） |
| **D13** | P3 | 06/07 等旧文档仍按 45-pin FPC 写（已废弃口径）；04 §1.7 的文档同步待办未执行 | 04 §1.7 | 下一轮文档收口时一并处理 |

---

## §6 六条验收判据（`rules/20_硬件链.md` §0）

| # | 判据 | 结论 |
|---|---|---|
| 1 | 选型有据（≥2 候选、带理由与替代料） | ✅ 03 表齐备；⚠️ 但**供货与价格未复核**（03 §4 五处"需联网查证"未查） |
| 2 | 连接表完整（覆盖全部引脚、无悬空未声明） | ✅ EVK1 84 脚 + J5 30 脚全部有去向；48+3 脚显式 NO_CONNECT |
| 3 | 网表一致（回读 == 连接表，差异 0） | ✅ 本次逐网回读与 04 §1.1 / 13 §4 逐条吻合，**差异 0** |
| 4 | **软硬件同源** | ❌ **D1（ADC 通道）+ D3（PC5）两条未同源** |
| 5 | EDA 干净（DRC 0 error、BOM 与位号一致、封装核对通过） | ✅ DRC 致命 0 / 错误 0；BOM 位号 ✅；⚠️ **封装列空 ⇒ 封装核对未过（D6）** |
| 6 | 下单 checklist 全勾 | ❌ **未开始**（无 Gerber/坐标、封装与供应商编号空、T1/T3/脚序三项实测未做、层数未拍板） |

**综合判定：图纸电气正确性高（DRC 全绿 + 几何对账全清 + 逐脚回读零差异），
但"软硬件同源"这条断了，且有 2 项上板前必做的实测未做——当前状态是
「图可以定稿，但还不能下单、也不能上电」。**

---

## §7 上板前必须做的（按代价从低到高，全部 <10 分钟）

| # | 项 | 方法 | 未做的后果 |
|---|---|---|---|
| 1 | **核心板 EVK1.2(REF) 有没有电压**（D4） | 上电，万用表测 EVK1.2 对地 | AFE 偏置归零，整机测不出信号 |
| 2 | **屏背光 A–K 特性 / 内含串阻否**（D5/C4） | 5V + 已知电阻实测电流，反解 Rint | 背光过流烧适配板或核心板 LDO 过热 |
| 3 | **J5 的 1/2/3 脚 ↔ 适配板 CS/RS/WR 通断**（D11） | 断电蜂鸣档 | 屏点不亮，需割线 |
| 4 | **触摸 IC 丝印型号**（D12） | 目视 | FT6206(FT6x06) 驱动对不上，触摸全废 |
| 5 | **核心板 PA0 是否真有 SW2 按键**（D1 分叉） | 对核心板官方原理图 / 断电测 PA0 对 GND 电阻 | 决定"改图还是改固件"，不定就没法定稿 |
| 6 | **改 `.ioc`：PC5 → GPIO_Input+Pull-up；PC4 → unused**（D3/D9） | CubeMX | INT 被钉死；配置与图不符 |

**然后（不是"可以跳"）**：改 `BOARD_FRONT_GAIN` / VREF 口径 → 重跑 `tools/verify_dsp.py` → 回填 `docs/01`。

---

## §8 变更与复核记录

| 日期 | 内容 |
|---|---|
| 2026-09-30 | 全链路只读审核：`eda_sch.py audit/drc` + `audit_sch.py` 几何对账 + 页面源码解析取元件值 + EVK1 84 脚映射 + `_audit_afe_calc.py` 数值复算 + `viewer.py` 视觉复核；产 D1~D13 共 13 条（P0×2 / P1×4 / P2×6 / P3×1） |
