funiang-x/G2026/hardware/15-评审与开发-20260930.md

# G2026 硬件 · 评审复核与落图开发（D1 + D7）· 2026-09-30

> 性质：承接 `14-全链路审核-20260930.md`（只读审核，产 D1~D13）——本轮把其中 **AI 可执行**的两项
> 落了图（**D1 P0**、**D7 P2**），并完成固件口径同步与文档收口。D8 等项按三态口径挂账（§8）。
> 路由记录：`硬件/审计` → `硬件/落图`（easyeda-agent + easyeda-api，证=421fca88a79c）→
> `软件/编码`（ponytail，证=751f86257b5c）→ `软件/构建`（stm32-hal-cli-flow，证=5e87f4608a35）。
> 三态口径：**已验证**（附读数）/ **未验证**（说明为何）/ **不适用**。凡涉上板结论均为未验证。

---

## §0 结果一句话

**D1（P0）已修**：ADC 信号 AFE_ADC_IN 从 PA0(EVK1.3) 挪到 PA1(EVK1.4)，VBIAS 自检脚挪到
PC4(EVK1.9)，PA0 打 NC —— 软硬同源恢复。
**D7（P2）已落**：U1B 增益 ×4→×8（R6 30k→69.8kΩ），净增益 ≈2.0，ADC 摆幅回到 ±250mVpk 量级。
**验收全绿**：DRC 三页 4/0/0/2/2（=13 号定稿基线）；几何对账四判据全"无"；跨页命名网逐条核对通过；
viewer 渲染 AFE obj=230 / INT obj=191，unknown=0；固件 test 5/5 + build 零告警 + lint + sizecheck 通过；
verify_dsp 全场景幅值误差 <1mV。

---

## §1 评审复核（对 14 号的增量确认，全部实时取证）

| 项 | 读数 | 与 14 号的关系 |
|---|---|---|
| 器件体检 `eda_sch.py audit --all` | INT 3 / PWR 10 / AFE 38（51 件）· NC 51/0/3 · 空值 0 | 与 14 号 §0 逐项一致 |
| DRC 基线（唯一权威） | 三页 全部 4 · 致命 0 · 错误 0 · 警告 2 · 信息 2 | 与 13 号基线一致 |
| 几何对账 `audit_sch.py` | 判据 1/1b/2/4 全"无"；判据 3 = NC 脚与内部节点（正常） | 一致 |
| my_skills 仓库核对 | `github.com/funiang-x/my_skills` 507 文件 = 共享库公开层镜像：**0 缺失**；抽查 4 文件 git 行尾归一化后**无内容差异**（450 个哈希差 = CRLF/LF） | 无需安装，本会话按路由协议直接装载使用 |

---

## §2 D1 修复（P0：ADC 通道软硬对调）

### §2.1 分叉判定与佐证链

14 号 D1 留了分叉：PA0 真有 SW2 → 改图；没有 → 改固件。本轮佐证：

1. `board_config.h`（原 L305）：「板上 **SW2 物理接在 PA0**（按下=高，经 10k 下拉；
   **2026-09-23 上板验证过**）」——唯一声明"上板验证过"的记录；
2. `Task/Src/app.c` L34/L138：两处一致（"板上 SW2（原 PA0）已让给 ADC1_IN0/…ADC 于 2026-09-28 挪到 PA1"）；
3. `Tools/ioc_pinlabels.py` L77-78：「用户按键 —— 板上 SW2，按下为高（外部 10k 下拉）PA0-WKUP: KEY_SW2」；
4. `docs/第02章硬件/原理图必读.md` 只有版本说明；引脚分配图 PDF **无文字层**无法自动取证（已留 §5-5 人工 30 秒实测）。

**决策**：按"SW2 在 PA0"处理 → **改图**。该方向在两个分支下都安全：
SW2 存在 ⇒ PA0 被 10k 下拉+触点污染，本就必须挪；SW2 不存在 ⇒ PA0→NC 也无任何损失，
而固件已按 PA1 构建并过全部门禁。反向（固件回 PA0）在任何分支下都不优。

### §2.2 落图实施（INT 页，按台账 T-43/T-45/T-50/T-31/T-10 配方）

| 步 | 动作 | 结果 |
|---|---|---|
| A | 批量删旧 AFE_ADC_IN 端口+导线、旧 VBIAS 端口+导线 | 见 §2.3（走了三次返工） |
| B | 源码手术：摘掉 EVK1.9 的 NO_CONNECT ATTR 记录 | NC 51→50，回读一致 |
| C | 建：导线 [510,595→540,595] + `AFE_ADC_IN` 端口@EVK1.4；导线 [370,565→340,565] + `VBIAS` 端口@EVK1.9 | 4/4 创建成功 |
| D | `inject_nc.py --pins EVK1.3 --apply` | NC 50→51（总数不变：−1 +1） |

终态（回读自证）：`AFE_ADC_IN = {EVK1.4, AFE.JP2.2}`、`VBIAS = {EVK1.9, AFE×7 成员}`、
`EVK1.3` 匿名（NC）、`VREF_CORE = {EVK1.2}` 不变。

### §2.3 过程中的三次返工（如实记账，教训已入台账 T-55~T-57）

| # | 事故 | 根因 | 修法 |
|---|---|---|---|
| R1 | 首轮删除后网表出现 `EVK1.4 ∈ AFE_ADC_IN ∧ VBIAS` 双网 | **`setDocumentSource` 写回的是步骤 A 删除**前**的快照，把刚删的旧端口/旧导线原样复活**（T-10 铁律"读写之间不许有操作"的同脚本版本） | 补一轮**纯 API 删除**，删除后不再写源码 |
| R2 | netport 数组 delete 返回 false 且不生效 | 新事实（T-56） | 改**单发** `Component.delete("<id>")`，两个端口各自成功 |
| R3 | AFE_ADC_IN 端口一度成孤儿（判据 4 报出） | 删旧 VBIAS 端口时，EDA 的"连带删短线"把**同坐标的新导线**一起带走（T-43 延伸） | 补建那根导线，且不再碰端口 |

---

## §3 D7 修复（×4→×8，AFE 页）

- **换件**：R6 30kΩ（0805W8F3002T5E）→ **69.8kΩ（0805W8F6982T5E，库 uuid `c0d5805e…`）**。
  按 T-42/T-48 配方：`create({libraryType:"DEVICE",…}, 2300,1150,"",270,…)` + 句柄
  `toAsync().setState_Designator("R6")`，**全程未调 modify**。
- **同坐标落件的收益**：新件引脚 (2300,1170)/(2300,1130) 与旧件完全重合，**既有合并折线自动咬合**，
  一根线都不用重画（回读 `{R6.1,R7.2,U1.6}` / `{R6.2,R8.1,U1.7}` 与改前一致）。
- **源码级核验**：COMPONENT 记录 `partId = "0805W8F6982T5E.1"`（器件级绑定 ✓）；
  `Value = "69.8kΩ"` 由库自动带全（T-51 再证），无需回填。
- **增益数学**（引 14 号 §3-B，改后口径）：净增益 = 端接 ×0.5 × LC 双端接插损 ×0.5 × 运放 ≈7.98 ≈ **2.0**；
  ADC 摆幅 ±249mVpk @VBIAS=VREF/2（1.25~1.75V，在轨内）；OPA2197 闭环 BW≈1.25MHz
  （@500kHz droop −0.65dB，LTI 可标定）；压摆 0.78V/µs ≪ 20V/µs；混叠余量不变，**白捡 6dB**。
- **附带清理（图面可读性）**：⑤⑥ 注释区发现**同位叠放 2~4 份的重复文案**及死名
  （`AFE_ADC_MON`、`→ J2`、`VREF_3V3`、`VBIAS_1V65`、`U2(REF3033)`、`1.65V 硬编码`、`×4/30k`）——
  均为 B2/B4/B8/B12 改动前的旧口径。共**删重复 39 条、改写死名 19 条**（逐条回读确认）。

---

## §4 D8（C12 = 22µF 钽挂 VREF_ADC）—— 未验证，本轮不动图

REF3030 输出电容允许范围在线取证两次失败（alldatasheet 超时、TI 404）。
按"手册 > 记忆"纪律，**不凭印象改图**。待人工查 REF30 手册（SBVS086）确认容值范围后：
超限 ⇒ C12 换 1~4.7µF 陶瓷（换件配方同 §3）；未超限 ⇒ D8 降级为 P3 备注。

---

## §5 上板前清单（人做，全部 <10 分钟；前 4 项沿 14 号 §7，第 5 项为本轮补充）

| # | 项 | 方法 | 未做的后果 |
|---|---|---|---|
| 1 | EVK1.2(REF) 电压实测（D4） | 上电万用表测 | AFE 偏置归零；实测后回填 `BOARD_ADC_VREF_MV` |
| 2 | 背光 A–K 特性 / 内含串阻否（D5/C4） | 5V+已知电阻测电流 | 背光过流烧适配板或 LDO 过热 |
| 3 | J5 1/2/3 脚 ↔ 适配板 CS/RS/WR 通断（D11） | 断电蜂鸣档 | 屏点不亮需割线 |
| 4 | 触摸 IC 丝印（D12） | 目视 | FT6206(FT6x06) 驱动对不上 |
| 5 | **PA0 对地电阻**（D1 终判佐证） | 断电测 PA0↔GND（≈10k=有 SW2 下拉） | 关闭 §2.1 分叉的最后人工确认 |
| 6 | **CubeMX GUI 操作清单（R-07，AI 不手写 .ioc）** | 见下 | INT 被钉死；配置与图不符 |

**GUI 清单**（CubeMX → Generate → `cmx_apply.py --write` → `fw.py lint`）：
① PC5：`GPIO_Output/RESET` → **`GPIO_Input` + Pull-up**（D3，FT6336 开漏 INT）；✅ **2026-10-02 已做**
② PC4：`GPIO_Output` → ~~`ADC1_IN14` 模拟~~ ⇒ ✅ **2026-10-02 改判：只做"输入、不驱动"，不配 ADC 通道**
   （把 ch14 加进 ADC1 **常规序列**会改 `TIM8_TRGO + DMA` 采集链）。VBIAS 的"轨在线"判据改走
   **AFE 帧直流均值**（`bsp_adc_self_check()`）；宏 `TP_RST_*` → `VBIAS_SENSE_*`。⇒ **本 GUI 清单到此清空**
③ 生成后跑 `fw.py lint` 确认 .ioc ↔ board_config 对账仍绿。✅ 已跑（通过）

---

## §6 固件与复算（软件/编码 + 软件/构建，证见页首路由记录）

| 文件 | 变更 |
|---|---|
| `board_config.h` | `BOARD_FRONT_GAIN 4U`（废，语义错误）→ **`BOARD_NET_GAIN 2U`** + **`BOARD_ADC_VREF_MV 3000U`**（REF3030 标称，D4 实测后回填） |
| `app_engine.c` ×2 | `lsb = 3300/4096/GAIN` → `(float)BOARD_ADC_VREF_MV/4096.0f/(float)BOARD_NET_GAIN` |
| `Test/test_op_meas.c` | `LSB_MV (3300/4096/4)` → `(3000/4096/2)` |
| `Operation/Inc/op_dsp.h` | 量纲注释同步 |
| `tools/verify_dsp.py` | `ADC_FS_MV 3300→3000`、`G_FRONT 4.0→2.0`（源端→ADC 净增益口径） |

**复算结果**（report_dsp_verify.md 已再生）：S1~S12 全场景 |ΔA|<1mV；全带最坏
|ΔA|=0.036mV / |ΔUpp|=0.073mV；最坏混叠场景 S9 = 0.554mV —— 判据 5mV 余量 >10×。
（注：复算的滤波器模型仍是规格口径 fc=800k；实落 648k 的混叠残差更好，见 14 号 §3-A 与 `_audit_afe_calc.py`。）

**门禁**（全部已验证）：
`fw.py test` **5/5 通过**；`fw.py build`（clean 后全量 568 目标）**零告警**，FLASH 46.35% / RAM 76.26% / CCM 50%；
`fw.py lint`（CubeMX 对账）通过；`fw.py sizecheck` 通过。
⚠️ 过程中发现两处与本次改动无关的环境问题：① `build/Debug` 缓存还是**搬家前** `products/G2026` 的路径，
`build --clean-first` 直接失败 → `fw.py clean` 后重建解决；② `Tools/cubemx_sync.py` 打印 `⊂` 字符
撞 GBK 控制台崩溃（机器档案 §1.1 同款坑，项目 Tools 未接 `setup_console()`），`PYTHONUTF8=1` 可绕过——
建议后续给项目 Tools 补控制台守卫。

---

## §7 文档同步（本轮落盘）

| 文档 | 变更 |
|---|---|
| `04-pinout连接表.md` | §1.1 三行改真实归属（PA0 NC / PA1=AFE_ADC_IN / PC4=VBIAS）+ §8 变更节；历史小节标"旧口径存档" |
| `01/02/03` | 各加 2026-09-30 勘误指针（旧口径以 14/15 号为准） |
| `bom_final.csv` | R6 行 → 69.8kΩ / 0805W8F6982T5E / 0805 |
| `docs/INDEX.md` | 补 14/15 号行 |
| `knowledge/20-踩坑记录/EasyEDA-API-实测台账.md` | 追加 T-55~T-57（setDocumentSource 复活 / netport 数组删失效 / 连带删线殃及同坐标新线） |

---

## §8 未决项（按优先级）

| # | 项 | 卡在哪 |
|---|---|---|
| 1 | **在线工程保存确认** | 已触发 `sch_Document.save()`，请在 EDA 里 **Ctrl+S** 确认云端同步（**保存后**重导出 .epro2 才能看到版面治理效果，见 §10） |
| 2 | D8：C12 22µF 钽容 | 待 REF30 手册人工确认容值范围（§4） |
| 3 | D6：BOM 封装/供应商编号列几乎全空 | 下单前必补（20 §3"封装列是核对重点"） |
| 4 | D2 残留：1.5mV 峰门限与 17 点标定的**先后关系** | 需在 op_peak/标定链路里明确（标定前生效会把实际门限抬到 ≈2.8mV 输入端） |
| 5 | ~~D10：PPTC/FSMC 33Ω×17 的"实测触发条件"没进任何待办~~ | ✅ **已闭（2026-10-02）**：条件已命中并落图 20 只（`R22`~`R41`）+ `F1`；见 `22` 号文档 |
| 6 | ~~注释区行距/压叠~~ → **已闭环（§10）** | — |
| 7 | 项目 `Tools/cubemx_sync.py` GBK 打印崩溃 | 补 `setup_console()`（机器档案 §1.1） |

---

## §10 版面治理（2026-09-30 第二轮，回应"重叠/出框"反馈）

**根因**：历次改版（B2/B3/B4/B8/B10/B12）重写注释**只加新块不删旧块**——三页累计 **40 个同位簇**
叠着 2~4 代口径（H3/H4 时代、U3 时代、Q1/R13/R14 时代、当前版），代际行错位 17。

**治理**（全程 API，`_layout_fix*.py` 带干跑）：

| 动作 | 数量 |
|---|---|
| 删旧代/重复注释 | **93 条**（AFE 15 / INT 38 / PWR 40） |
| 内容改写（BNC→SMA 口径） | 2 条 |
| 行距统一 25 重排（T-54 判据 ≥21/≥25） | AFE 31 / INT 11 / PWR 12 行 |
| 扩框（TP1/TP3/TP4/C14/R12/R21 入框） | 6 处（`delete+create`，见台账 T-58） |
| 删空框（INT ④、PWR ② —— J1/J4、U3 遗留） | 2 个 |

**验收**：`_layout_audit.py` 三页 **同位叠印 0 / 行压叠 0 / 行距<21 = 0**；DRC 三页 4/0/0/2/2（=基线，零电气影响）。
**注意**：`.epro2` 导出的是云端保存版（台账 T-59）——**Ctrl+S 保存后**重导出+截图才能看到治理后图面。

---

## §9 变更与复核记录

| 日期 | 内容 |
|---|---|
| 2026-09-30 | 评审复核（基线与 14 号逐项一致）+ D1 落图（三次返工后收口）+ D7 换件 + 注释清理（删 39/改 19）+ 固件口径 5 文件 + verify_dsp 复算 + 四道门禁全绿 + 文档同步 + 台账 T-55~T-57。D8 挂账未动。 |
