funiang-x/G2026/hardware/16-方案复核与补齐-20261001.md

# G2026 硬件 · 方案复核与补齐 · 2026-10-01

> 性质：承接 `14-全链路审核-20260930.md`（只读审核，产 D1~D13）与 `15-评审与开发-20260930.md`（D1/D7 落图），
> 按 **hardware-solution** skill 的「验证门控 + 评审清单」做**方案级复核**，并把 14/15 号挂账的遗留项**联网查证收口**。
> 方法：门控逐条判（Gate 1~5）+ 评审清单四张（原理图 / PCB / BOM / 设计方案）+ 立创商城与 TI 官网实时查证。
> 三态口径：**已验证**（附来源）/ **未验证**（说明为何）/ **不适用**。凡涉上板结论一律为未验证。
> **未改图纸、未改固件、未改旧文档正文。**

## §0 一句话结论

方案骨架**站得住**（架构取舍有据、前端数值已独立复算、图纸 DRC 全绿）。缺口**集中在「方案文档层」而非「图纸层」**：
成本与供应链从未查证、EVT/DVT/PVT 验证计划缺失、01/02/03 三份文档正文口径过时（带勘误指针但正文未改）。
本次把供应链与器件资料**查证补齐**；其余按 Gate 逐条列出，需人拍板的集中到 §4。

## §1 门控复核（Gate 1~5）

### Gate 1 需求冻结后

| 判据 | 结果 | 说明 |
|---|---|---|
| 约束表无空白必填项 | 部分 | 01 §1 共 15 项齐备，但 **TBD-3（成本）/ TBD-4（交期）/ TBD-5（供应链）** 三项仍未定（**TBD-6 层数已闭 = 2 层**，见 §4-1） |
| 每个「待确认」项标注负责人与截止时间 | 不通过 | 01 只标 `[TBD-n]`，无负责人、无截止点 |
| 用户已确认需求表 | 未闭环 | 01/02/03 页首状态仍写「待 [CHK] 人确认」 |

### Gate 2 架构选择后

| 判据 | 结果 | 说明 |
|---|---|---|
| 至少比较三个候选架构（国产优先 / 海外主流 / 混合折中） | 不通过 | 02 §2 比的是**前端实现路线**三案（有源 SK / 无源 LC 无跟随 / 无源 LC+缓冲），**不是 skill 要求的供应链三档** |
| 每案有优缺点与适用条件 | 通过 | 02 §2 逐案给了排除理由，质量高 |
| 用户已确认架构方向 | 通过 | 2026-09-28 拍板「前端架构解冻，你来一个最优解」 |
| 推荐理由基于约束匹配而非「常用」 | 通过 | 02 §4 用门限反解出 fc，非沿用文档拍板值 |

> 说明：本案是「赛题装置 + 手头库存优先」，供应链三档比较的适用性有限——但**仍需一句显式说明**（skill 要求「某类不适用必须说明原因」），当前是**沉默跳过**。

### Gate 3 选型完成后

| 判据 | 结果 | 说明 |
|---|---|---|
| 关键器件均有替代方案 | 部分 | 主控「锁定无替代」（核心板）；OPA2197 有 OPA2350A；REF3033 有 onsemi 第二源 |
| 每个关键模块比较国内与海外候选 | 不通过 | 03 §1 主控 / 运放 / 基准**全为海外件**，无国产候选对比，也无「国产为何不适用」的说明 |
| 供应链风险联网查证（生命周期 / 库存 / 交期 / 认证） | **本次补齐** | 见 §3 |
| 风险表非空且高风险项有验证动作 | 通过 | 03 §3 有 R1~R6；R1 已闭 |
| 器件参数来自手册而非记忆 | 通过 | `verify_afe_v2_report.md` + `_audit_afe_calc.py` |
| 关键 IC 与功能模块器件附采购 / datasheet / 封装链接 | **本次补齐** | 03 §4 原有 5 处「需联网查证」，见 §3 |
| 被动元件不要求链接 | 通过 | 符合 |

### Gate 4 方案输出后

| 判据 | 结果 | 说明 |
|---|---|---|
| 含系统框图 / 接口矩阵 / 电源树 / PCB 约束 / 验证计划 | 部分 | 前四项有（02 §3 信号链、04 pinout、02 §6 O4/O6 布局约束）；**EVT/DVT/PVT 验证计划缺失** |
| 风险清单非空，每项有影响 / 概率 / 验证动作 | 通过 | 03 §3 |
| 无占位符（TBD / 待补充）出现在已确定项中 | 不通过 | 01/02/03 正文仍是旧口径（fc=800k、×4、L/C 旧值），靠页首勘误指针兜——**指针不是替代品** |
| 已确定 / 待确认 / 高风险三类分列 | 部分 | 分散在 01 §1 TBD、03 §3 风险表、14 号 D 清单三处，无统一视图 |

### Gate 5 评审完成后

| 判据 | 结果 | 说明 |
|---|---|---|
| 独立评审已完成 | 通过 | 14 号全链路只读审核（实时回读 + 逐条对账），质量高于「自检」 |
| CONCERN / FAIL 已处理或标注 | 通过 | D1/D7 已落图修（15 号）；D8 本次查实（§3.3） |
| 可交给硬件工程师开始原理图设计 | 通过 | 实际已落图完成，DRC 全绿 |

## §2 14/15 号遗留项收口

| # | 项 | 状态 | 处置 |
|---|---|---|---|
| A1 | 成本 / 交期 / 供应链 TBD 未查证 | **本次补齐** | §3 查证表 |
| A2 | 底板 2 层 vs 4 层未拍板 | 待拍板 | §4-1 |
| A3 | 01/02/03 旧口径与图纸实落不符 | 待回填 | §4-2 |
| B2 | 替代料实时价 / 库存未复核；电感 SRF/DCR 未落料号 | **本次补齐（部分）** | §3.1 / §3.4 |
| B3 | 输入 TVS 型号未回填（图上已是 SRV05-4） | **本次补齐** | §3.1 |
| D6 | BOM 的封装 / 供应商编号列几乎全空 | 给方案 | §4-3 |
| D8 | C12 22µF 钽挂 VREF_ADC | **已查实** | §3.3 |

## §3 联网查证（2026-10-01，来源：立创商城 / TI 官网）

### 3.1 选型表价格与封装回填

| 位号 | 型号 | 封装 | 立创价 | 来源 |
|---|---|---|---|---|
| EVK1 | 立创·天空星 LCKFB-LSPI-SkyStar-STM32F407VGT6-**PRO** | 核心板 | **¥49.9** | item.szlcsc.com/34442339 |
| U1 | **OPA2197IDR** | SOIC-8 | **¥5.00** | item.szlcsc.com/150686 |
| U2（留位，BOM 中无此行） | **REF3033AIDBZR** | SOT-23-3 (DBZ) | **¥1.41** | item.szlcsc.com/37636 |
| — | AMS1117-3.3 | SOT-223 | **¥0.12** | item.szlcsc.com/6126101 |
| D1 | **SRV05-4.TCT** | SOT-23-6L | **¥0.52** | item.szlcsc.com/14264 |
| L* | 绕线功率电感（如 CYH74-22UH） | SMD 7.5x7.5 | ¥0.56 量级 | item.szlcsc.com/20528512 |

> 替代料第二源：REF3033 的 onsemi 第二源 **REF3033TB-GT3** 未查证库存（03 §1 第 5 行曾列为第二源）——**仍挂账**。

### 3.2 生命周期

- **REF30 / REF30E**（SBVS032 Rev K）：TI 产品页标 **ACTIVE**；REF30E 为 REF30 的 drop-in 替代（±0.1% / 15ppm/°C / ±10mA）。
- **OPA2197**：TI 在产（OPA197 家族），立创有现货。
- **STM32F407VGT6**：ST 在产（核心板锁定）。

### 3.3 D8 收口：REF30xx 输出电容 —— 已查实

**datasheet SBVS032 §9.1 Application Information 原文**（REF3033 datasheet，PDF 提取）：

> For normal operation, the REF30xx does not require a capacitor on the output. If a capacitive load is connected,
> **take special care when using low equivalent series resistance (ESR) capacitors and high capacitance**.
> This precaution is especially true for low-output voltage devices; therefore, for the REF3012 use a low-ESR
> capacitance of 10 uF or less. ... A supply bypass capacitor of 0.47 uF is always recommended.

**判读**：

1. REF30xx **不要求**输出电容——有它没它都能工作；
2. 接容性负载时，**「低 ESR + 大容值」**是风险组合；
3. 「especially true for low-output voltage devices」针对 REF3012（1.25V），REF3033 是 3.3V，**不在最敏感档**。

**对 C12 = 22µF 钽的结论**：22µF 属 high capacitance，**触发第 2 条**；钽电容 ESR 不算低（相对陶瓷），**不触发 low ESR**。
=> **D8 从 P2 降为 P3 建议**：不必紧急改，但**建议改为 1µF 陶瓷（0805）**——本设计 VREF 负载仅 R9/R10 分压（5kΩ）+ 偏置电阻，电流 <1mA，22µF 纯属过剩；改小可同时消掉钽的漏电与容值偏压漂移。
**不改也合规**（datasheet 未禁止），故列为「建议」而非「缺陷」。

### 3.4 仍挂账（本次未查证）

| 项 | 为何未查 |
|---|---|
| onsemi REF3033TB-GT3 库存 / 价格 | 第二源，非当前 BOM 件 |
| 电感具体料号的 SRF / DCR 实测值 | 需按「SRF>=12MHz、DCR<=0.5Ω、Isat>=50mA」在立创筛料号并逐个核 datasheet（人工筛更准） |
| 屏模组（ST7796S+FT6206(FT6x06) 3.5 寸）采购状态 | 既有件，非新选 |
| 交期（TBD-4） | 本项目为复盘练习，无硬交期 |

## §4 需人拍板 / 待办

### 4-1 底板层数（A2，落 PCB 前必须定）

| 方案 | 成本量级 | 收益 | 风险 |
|---|---|---|---|
| 4 层（02 §6 O11 建议） | 嘉立创 4 层打样较 2 层贵**数十元**（下单时复核） | 完整 GND 平面：mV 级模拟与 FSMC 共板的回流 / EMI 根治 | 无 |
| **2 层** | 省数十元 | — | 模拟地与数字地共板、FSMC 总线回流路径不可控 |

> **✅ 2026-10-01 用户拍板：底板 2 层。**
> AI 原建议 4 层（理由：mV 级判据 + 14 号已识别「LCD 总线开关噪声灌进 AFE」是最大板内干扰源）。
> 用户选 2 层后，**必须补做的补偿措施**（2 层靠布局换性能）：
> 1. AFE 区与 FSMC 区**物理隔开**，模拟地做成**完整铜皮**并单点汇到核心板 AGND；
> 2. 02 §6 O1「采样窗静默」由优化项**升级为必做项**（2 层没有地平面兜底）；
> 3. 02 §6 O7「FSMC 总线 33Ω 串阻」由"触发条件制"**提前为必装**（✅ 2026-10-01/02 已落图 18 只 `R22`~`R39`，见 `22` 号）；
> 4. 上板后必测 TP4 噪声底（目标 <0.5 mVrms），不达标再考虑局部改板。

### 4-2 文档口径回填（A3）

以下正文仍是**定稿前旧口径**，与图纸实落不符。建议在 01/02/03 正文直接改：

| 文档 | 旧口径 | 图纸实落 / 定稿 |
|---|---|---|
| 01 §1 第 5 行、§2 | fc=800kHz；L=3.9/16/20/11µH；C=4.3/7.5/6.8/1.6nF；×4 增益 | **fc≈648kHz；L=4.7/22/22/12µH；C=5.6/10/10/1.8nF；运放级 ×8，净增益≈2.0** |
| 02 §3、§4 | 链路 ×4；「@1.5M −43.7dB」 | **×8；@1.5M −59.3dB（余量 16.8dB）** |
| 03 §1 第 2 行 | 同上 LC 值；「@1.5M −43.7dB」 | 同上 |
| 03 §1 第 8 行 | 输入 TVS「阶段二定型号（需联网查证）」 | **D1 = SRV05-4.TCT（SOT-23-6L，Cj≈1.5pF）** |

### 4-3 BOM 封装 / 供应商编号补齐（D6）

`bom_final.csv` 现状：**51 行中仅 2 行**有值（R6 的 0805W8F6982T5E / 0805、U1 的 SOIC-8），其余「厂商型号 / 供应商编号 / 封装」三列全空。

**补齐方法**（不建议手写 CSV——会与 EDA 脱钩）：

1. 在嘉立创 EDA 里给每个元件**指定立创编号**（LCSC Part，如 `C123456`）——这是「器件级绑定」；
2. 重新导出 BOM（此时三列由库自动带全，15 号 §3 的 T-51 已证）；
3. 与 `bom_final.csv` 对账，确认位号无增减。

**关键件的立创编号**（本次已查到，可直接填）：OPA2197IDR、REF3033AIDBZR、AMS1117-3.3、SRV05-4.TCT、0805W8F6982T5E（R6 已有）。

### 4-4 其余挂账（沿 14/15 号，未动）

- **D4**：核心板 EVK1.2(REF) 实测电压（上电 30 秒）——**决定 VREF 是 3.0V 还是 3.3V**，固件 `BOARD_ADC_VREF_MV` 待此回填。
  > 顺带指出一处**文档不一致**：03 §1 第 5 行选的是 **REF3033（3.3V）**，而 15 号 §6 把固件口径写成 **`BOARD_ADC_VREF_MV 3000U`（REF3030 标称 3.0V）**。两者必须对齐——若实际走核心板板载基准，须查核心板基准型号。
- **D5 / C4**：屏背光 A–K 特性 / 内含串阻否（上电前必测）
- **D11**：J5 脚序 ↔ 适配板 CS/RS/WR 通断
- **D12**：触摸 IC 丝印（FT6206(FT6x06) vs GT911）
- **D2 残留**：1.5mV 峰门限与 17 点标定的先后关系
- ~~**D10**：PPTC / FSMC 33Ω×17 的「实测触发条件」未进待办~~ → ✅ **已闭（2026-10-02）**：触发条件已命中共落图（PPTC=`F1`、33Ω×18=`R22`~`R39`），见 `22` 号文档
- **Gate 4 缺口**：EVT/DVT/PVT 验证计划尚未成文（02 §11 只有扫频标定流程）

## §5 变更记录

| 日期 | 内容 |
|---|---|
| 2026-10-01 | 按 hardware-solution Gate 1~5 + 评审清单四张做方案级复核；联网补齐选型表价格 / 封装 / 生命周期；D8 用 datasheet §9.1 原文收口（降为 P3 建议）；列 A2 / A3 / D6 三项待拍板与待办。未改图纸、未改固件、未改旧文档正文。 |
