funiang-x/G2026/hardware/17-原理图设计方案-AFE.md

# G2026 硬件 · 原理图设计方案（AFE 模拟前端）· 2026-10-01

> **重点：抗混叠低通滤波器（无源 LC 8 阶巴特沃斯，双端接 50Ω）**
> **本文性质：设计要点 + 索引。** 数值一律**引用已有定案**，不重复推导、不另立第二真相源。
> **数据来源（按可信度）**：
> - `report_filter_final.md` ← `_filter_final.py`（**滤波器定案**：ABCD 级联 + 蒙特卡洛容差 + 立创在售料号）
> - `_filter_compare.py`（fc 扫描 + 椭圆方案对比）
> - `_lc_recheck.py`（设计值 vs 画布值）
> - `14-全链路审核-20260930.md` §3（AFE 独立复算）
> - `16-方案复核与补齐-20261001.md`（门控复核）
> 三态口径：**已验证**（附来源）/ **未验证**（说明为何）/ **不适用**。

> ## ⚠️ 2026-10-03 勘误（以 `36-仿真独立验证与择优-20261003.md` 为准）
> **C2 = 6.2 nF（原 5.6 nF）· C6 = 9.1 nF（原 10 nF）**，其余 6 颗 LC 不变。
> 依据：仿真择优 —— 17 点 log-log 标定残差的**最坏值 5.22 → 2.97 mV**（n=400 容差 MC，
> 原值最坏已超 5 mV 判据）；筛选过程中折叠带余量、通带起伏、Cin 敏感性**均未变差**。
> **本文其它各处引用的 `C2=5.6nF / C6=10nF` 一律以本行为准。**

> ## ⚠️ 2026-10-02 勘误（以 `25-独立评审与优化-20261002.md` 为准）
>
> 本文 §3/§5/§6 的下面三处**与活体图纸不符**，已在 25 号文档改图并留证：
>
> 1. **偏置的来源变了**：`VBIAS` 分压上臂不再接 `VREF_CORE(EVK1.2)`，改接 **`+3V3`**。
>    原因（官方 `.epro` 网表）：核心板 `VREF+` 是 `VDDA` 经 `R4=47Ω` 供的，而排针 `REF` 针
>    经 `R2`(0Ω)**不贴** ⇒ 那根针**悬空**，照原图接上去 `VBIAS` 会停在 0V、整条 AFE 不作为。
>    `VREF+` 实为 **≈3.3V**（板载 `REF3030` 不贴），不是 3.0V。
> 2. **LC 梯形的隔直点**：`R4` 的腿现在经 **`C23`(10µF) 入地**。原图 `R3→L1…L7→R4→AGND` 是
>    纯直流通路，会白流 **16.4mA**（下面 §6 的"`+5V_A` ≈2mA"当时因此是错的，现已成立）。
>    ⇒ `§3` 图里"滤波器输出回到 0V DC"**是错的**：电感是直流短路，节点一直坐在 `VBIAS`(1.65V)。
> 3. **元件净变化**：AFE **+`C23`**；PWR 删冗余去耦 **`C19`/`C20`**（该页 3V3 上只有两颗 4.7k 上拉）。

## §0 结论：定案确认，无需改图

| 项 | 定案值 | 判据 | 结论 |
|---|---|---|---|
| 拓扑 | 无源 LC 8 阶巴特沃斯，双端接 50Ω 梯形 | — | — |
| 元件 | L = **4.7 / 22 / 22 / 12** µH；C = **5.6 / 10 / 10 / 1.8** nF | — | **全部为立创在售档位** |
| 折叠带 [1.5, 2.5] MHz **最差**衰减 | **−59.30 dB** | ≤ −42.5 dB | ✅ 余量 **16.8 dB** |
| 带内 10k~500k 起伏 | 0.139 dB | 17 点标定吸收 | ✅ |
| **蒙特卡洛**（L ±10%、C ±5%，5000 次） | 最坏 −55.24 dB，**0/5000 跌破判据** | — | ✅ 最坏余量 **12.74 dB** |

**图纸已定稿且经容差验证，不需要改动。** 本文的价值只在于：把散落在 02/03/14/15 号与几个脚本里的设计依据，收敛成一份可交付的说明，并补上 16 号指出的两个缺口（**完整网表**、**EVT 验证计划**）。

## §1 设计指标（从判据反推）

| # | 指标 | 值 | 来源 |
|---|---|---|---|
| 1 | 分析带（通带） | 10 kHz ~ 500 kHz | 题面：被测信号全部频率成分 |
| 2 | 采样率 fs | 2.0 MSPS | `docs/01_软件架构与DSP方案.md`（冻结） |
| 3 | **折叠带起点** | **1.5 MHz** = fs − f_max | ≥1.5 MHz 的干扰才折进 [0, 500k] |
| 4 | 单频干扰 u_J | ≥1 MHz，**200 mVpp**（按题面不打折） | 题面 |
| 5 | 峰门限 | 1.5 mVpk | 软件文档（伪峰判据） |
| 6 | **@1.5 MHz 衰减要求** | **≤ −42.5 dB** | 100mVpk × 0.5(端接) × \|H\| × 增益 ≤ 1.5mV 反解 |
| 7 | 系统阻抗 | 50Ω | 题面 BNC 电缆 |

## §2 抗混叠低通滤波器

### 2.1 为什么是无源 LC（不是有源）

| 路线 | 结论 | 理由 |
|---|---|---|
| 有源 SK 8 阶 | 排除 | 需 GBW ≥ 205 MHz 运放（SK 规则 100·f0·Qmax）；Q = 2.56 有稳定性风险 |
| **无源 LC 8 阶** | **采用** | 零运放门槛、双端接梯形低元件灵敏度、无稳定性问题 |
| 椭圆（Cauer）n=6 | Plan B | `_filter_compare.py` §B 已量化；元件值非 E24、零点随容差漂移，留作触发项 |

**决定拓扑的一条硬约束**：**增益必须在滤波器之后**。u_J 达 ±400 mVpk，若先入运放 → 产生 IM3，产物落带内而**滤波器在它之后，无法去除**。

### 2.2 三个决定性的取舍

**① 阶数 n = 8**：n=6 时 fc 被门限压到 663 kHz，通带 @500k 已有 −0.18 dB droop；n=8 可把 fc 放到 800 kHz 而 @500k 仅 −0.003 dB。多两个元件换"调试期标称读数即可信"。

**② fc = 660 kHz（不是 800 kHz）**：

- 800 kHz 时 @1.5M 仅 −43.7 dB，相对判据 **只剩 1.2 dB 余量** —— 元件容差一飘就破；
- 660 kHz 时余量 **16.8 dB**，蒙特卡洛最坏仍有 **12.74 dB**；
- 代价：通带 @500k 多 −0.019 dB droop —— **频率无关的 LTI 常数，17 点标定整条吸收**（残差 0.023 mV）。

> **原则**：余量放在**阻带**（判据硬约束、不可标定），损失放在**通带**（可标定）。这是整个滤波器设计的核心判断。

**③ 电感损耗不敏感**：`report_filter_final.md` 实测 —— Q_L 由 100 降到 25，折叠带最差衰减仅由 −59.3 变到 **−59.5 dB**。巴特沃斯对 Q 极不敏感，**所以电感 DCR 不是选型的主要矛盾**。

### 2.3 定案元件值与料号

| 位号 | 值 | 料号 | 类型 |
|---|---|---|---|
| L1 | 4.7 µH | XRCD54-4R7M | 绕线 |
| L3 / L5 | 22 µH | CD54-220M | 绕线 |
| L7 | 12 µH | XRCD54-120M | 绕线 |
| C2 | 5.6 nF | 0805CG562J500NT | C0G |
| C4 / C6 | 10 nF | 0805CG103J500NT | C0G |
| C8 | 1.8 nF | 0805CG182J500NT | C0G |

> 频响表、蒙特卡洛分布、与 fc=800k 旧方案的对照，全部在 `report_filter_final.md`，本文不复述。

### 2.4 电感选型（含 0805 库存评估）

**门槛**（`verify_afe_v2.py` §2）：SRF ≥ 12 MHz · DCR ≤ 0.5 Ω · Isat ≥ 50 mA · **必须绕线型**（叠层铁氧体 SRF 常在 5~10 MHz，落在使用频段内）。

**你手头的 0805 电感能不能用**——以立创在售的 **SDFL2012T220KTF**（顺络，0805 叠层，22 µH）为例：

| 参数 | 实测值 | 门槛 | 判定 |
|---|---|---|---|
| SRF | **16 MHz** | ≥ 12 MHz | ✅ 合格 |
| DCR | 1.1 Ω | ≤ 0.5 Ω | ⚠️ 超，但见下 |
| Q | 30 @1 MHz | — | ✅ 够（§2.2③ 已证损耗不敏感） |
| **额定电流** | **5 mA** | 信号峰值 ~1~5 mA | ⚠️ **贴边，主要风险** |

**判断**：

- **电气上可用**：SRF 16 MHz 够；4 只电感总 DCR = 4.4 Ω，对 50Ω 系统只带来约 **0.73 dB 通带插损**，是 LTI 常数，**可标定吸收**；Q=30 的影响 <0.3 dB。
- **风险点在额定电流**：5 mA 是"电感量下降 10~30%"的判据，而 LC 第一节的峰值电流与它同量级。**磁芯在峰值附近进入非线性区 → 产生谐波/IM3，而这类产物落在带内、滤波器无法去除**（正是 02 号最忌讳的机理）。
- **建议**：**4.7 µH 档可以用 0805**（小值叠层的额定电流通常高得多）；**22 µH / 12 µH 档优先用 CD54 绕线**（额定电流 100 mA 量级，余量充足）。若只有 0805，**上板后必须实测**：注入纯正弦看 THD，或在 TP3 看波形顶部有无压缩。
- **待你确认**：手头 0805 电感的具体品牌/系列（叠层 vs 绕线），我按型号逐个核额定电流。

### 2.5 布局约束

| 约束 | 值 | 原因 |
|---|---|---|
| 电感**正交摆放** + 间距 ≥ 2 mm | — | 互感会改变高节频响（L3/L5 同值 22 µH 尤甚） |
| AFE **分区**，模拟地**完整铜皮**，单点汇核心板 AGND | — | **2 层板无地平面兜底，这条从"优化"升级为"必做"**（16 号 §4-1） |
| 电感下方不走高速信号线 | — | 减少耦合 |

## §3 完整信号链与网表

```
J1 (SMA-KE)
 ├─ R1 49.9Ω → AGND            50Ω 端接（必须贴 J1）
 ├─ D1 SRV05-4 (D1.5→+5V_A)    ESD 钳位，Cj≈1.5pF
 ├─ TP1                        测试点：端接节点
 └─ C1 100nF (C0G) → JP1 (0Ω) → AFE_BUF_IN
                                      │
AFE_BUF_IN ──┬── U1.3 (+inA)
             └── R2 10k → VBIAS        AC 耦合 + 偏置（fc_hp = 159 Hz）
                                      ▼
U1A: 单位增益缓冲（U1.1 OUT ↔ U1.2 −in）
U1.1 ── R3 49.9Ω ──► L1 ─┬─ C2 ↓AGND
                          ├─ L3 ─┬─ C4 ↓AGND
                          │      ├─ L5 ─┬─ C6 ↓AGND
                          │      │      ├─ L7 ─┬─ C8 ↓AGND
                          │      │      │      ├─ C23 10µF → R4 49.9Ω → AGND  （终接；**C23 隔直流**，见顶部勘误）
                          │      │      │      └─ TP3               （测试点：LC 出）
                          ▼      ▼      ▼      ▼
                     LC 8 阶巴特沃斯，双端接 50Ω，fc = 660 kHz
                                      │
                         C9 100nF (C0G) ── U1.5 (+inB)
                                      └─ R5 10k → VBIAS
                                      ▼
U1B: 同相放大，增益 = 1 + R6/R7 = 1 + 69.8k/10k = 7.98 ≈ ×8
     （R7.1 落 VBIAS 而非 GND —— 单电源下直流输出 = VBIAS，不饱出轨）
U1.7 ── R8 100Ω ─┬─ C10 470pF ↓AGND    （RC 低通 fc = 3.4 MHz，ADC kickback 隔离）
                 └─ JP2 (0Ω) → AFE_ADC_IN → EVK1.4 (PA1, ADC1_IN1)

VREF_ADC ← JP3 (0Ω) ← VREF_CORE (EVK1.2)
   └─ R9 10k ─┬─ VBIAS ── C13 10µF ↓AGND
              └─ R10 10k → AGND          （VBIAS = VREF/2，ratiometric）
VBIAS 供给：R2、R5、R7 三处
```

### 网表

| 网络 | 成员 |
|---|---|
| AFE_IN | J1.1, R1.1, D1.4, C1.1, TP1 |
| AGND | J1.2, R1.2, C2.2, C4.2, C6.2, C8.2, R4.2, C10.2, C13.2, R10.2, U1.4, C14.2 |
| +5V_A | D1.5, U1.8, C11.1, C14.1, R21.2 |
| AFE_BUF_IN | C1.2, JP1.1 |
| AFE_BUF_IN_F | JP1.2, U1.3, R2.1 |
| VBIAS | R2.2, R5.2, R7.1, R9.2, R10.1, C13.1 |
| BUF_OUT | U1.1, U1.2, R3.1 |
| LC_IN | R3.2, L1.1 |
| LC_N1 | L1.2, C2.1, L3.1 |
| LC_N2 | L3.2, C4.1, L5.1 |
| LC_N3 | L5.2, C6.1, L7.1 |
| LC_OUT | L7.2, C8.1, R4.1, TP3, C9.1 |
| GAIN_IN | C9.2, U1.5, R5.1 |
| GAIN_FB | U1.6, R6.1, R7.2 |
| GAIN_OUT | U1.7, R6.2, R8.1 |
| AFE_ADC_IN | R8.2, C10.1, JP2.1 |
| AFE_ADC_IN_F | JP2.2, EVK1.4 (PA1) |
| VREF_ADC | JP3.1, R9.1, C12.1 |
| VREF_CORE | JP3.2, EVK1.2 |
| LCD_BL_PB0 | EVK1.11, R12.2 |
| LCD_BL_CTL | R12.1, J5.28 |

## §4 各级设计取舍

| 级 | 选择 | 不这样做的后果 |
|---|---|---|
| 50Ω 端接 | 匹配题面电缆；**×0.5 同时是唯一免费且无失真的抗混叠增益** | 不端接：残留翻倍 > 峰门限 |
| AC 耦合 1（100nF/10k，159 Hz） | 隔源端 DC，把单电源域入口偏到 VBIAS | 直耦：输入 CM 摆到 −112 mV 出轨 |
| **BUF1（G=1）** | 高阻读端接节点（端接值精确）、低阻经 50Ω 驱动 LC；G=1 摆幅最小 → 对未滤除的 u_J 处于最线性区 | 缺此级：LC 直接挂电缆/TVS，端接与滤波器输入阻抗互相扰动 |
| **GAIN 在滤波后** | 运放只见带内 ±62.5 mVpk，u_J 已 −59 dB → **IM3 无从产生** | 增益前置：IM3 产物落带内且**滤波器无法去除** |
| 100Ω + 470pF | ADC 开关电容 kickback 隔离；Rsrc = 100Ω ≤ 1.1 kΩ（SMP=3） | 采样电荷反冲在输出产生建尖 |
| 不加第三只跟随器 | ×8 已是低阻驱动，再串 G=1 只多一级 droop 与失真源 | 零收益 |

## §5 偏置与基准

```
+3V3 ── R9 10k ─┬─ VBIAS ─┬─ C13 10µF ↓AGND
                │         └─ 供给 R2/R5/R7
                └─ R10 10k → AGND          （VBIAS = 3V3/2 = 1.65V）

[留位·默认全悬空] VREF_CORE(EVK1.2) ── JP3(0Ω) ── VREF_ADC ──┬─ C12 1µF ↓AGND
                                                              └─ TP6
  ⚠️ 核心板排针 REF 针默认**悬空**（官方 .epro：R2 0Ω 不贴），**不要**把偏置挂在它上面。
     要注外部基准得先在核心板上补 R2/去掉 R4 —— 见 25 号 §1.1。
```

- **VBIAS = VREF/2**：ratiometric 于 VREF —— VREF 漂移时 VBIAS 同比漂移，对幅值测量自动抵消。
- **VREF 实际值未定**（14 号 D4）：核心板 EVK1.2 三选一，实测前不知 3.0V 还是 3.3V。固件现写 `BOARD_ADC_VREF_MV 3000U`，而 03 号选型表写 REF3033（3.3V）—— **⇒ 上电第一步：万用表测 EVK1.2 对地电压并回填**。
- **C12 注**：图纸为 22 µF 钽。REF30xx datasheet §9.1 原文 —— *"does not require a capacitor on the output. If a capacitive load is connected, take special care when using low ESR capacitors and high capacitance"*。22 µF 属大容值，**建议改 1 µF 陶瓷**；不改也合规（16 号 §3.3）。
- **U2（REF3033）AFE 页留位未装**，BOM 中无此行。

## §6 电源树

```
J3 (DC005) → +5V_RAW → D2 (SS34 防反) → +5V ─┬─ EVK1.40/80（核心板）
                                              ├─ C16 22µF
                                              └─ R21 (0Ω) → +5V_A ─┬─ C11 22µF
                                                                    ├─ C14 100nF（U1 就近）
                                                                    ├─ D1.5
                                                                    └─ U1.8
+3V3 ← EVK1.38/78（核心板 LDO）→ J5.30 / C19 / C20 / R11 / R15 / R16
```

| 轨 | 负载 | 电流 | 去耦 |
|---|---|---|---|
| +5V_A | U1 静态 ~1.5 mA（**`C23` 隔直后无直流负载**；修前另有 16.4 mA 经 LC 梯形白流） | ~2 mA | C11 22µF + C14 100nF |
| +3V3 | LCD 数字 / FT6206(FT6x06) / I2C 上拉 | ~0.15 A | C19/C20 100nF + **J5 侧就近 `C21`(10µF)/`C22`(100nF)**（2026-10-02 落图，见 `22`） |
| VBIAS | R2/R5/R7 偏置 | <0.5 mA | C13 10µF |
| VREF_ADC | R9/R10 分压 | <0.4 mA | C12（见 §5） |

> ⚠️ **待重算（14 号 C3）**：背光电流改由核心板 3.3V 经 J5.30 供给，而 J5 只有 1 根 3V3 + 1 根 GND 针；厂家转接板 LED-A 直挂 3.3V 且无限流电阻 ⇒ **实际电流可能远超 60 mA**。上板前必测。

## §7 元件清单（AFE 部分）

| 位号 | 值 | 器件 | 封装 | 精度/等级 | 立创参考价 |
|---|---|---|---|---|---|
| J1 | SMA-KE | 50Ω 母座 | 通孔 | — | — |
| R1, R3, R4 | 49.9Ω | 电阻 | 0805 | **1%** | — |
| D1 | SRV05-4.TCT | TVS 阵列 | SOT-23-6L | Cj≈1.5pF | ¥0.52 |
| C1, C9, C14 | 100nF | 电容 | 0805 | **C0G** | — |
| U1 | **OPA2197IDR** | 双运放 | SOIC-8 | — | ¥5.00 |
| R2, R5, R9, R10 | 10kΩ | 电阻 | 0805 | 1% | — |
| R7 | 10kΩ | 电阻 | 0805 | **0.1%** | — |
| R6 | 69.8kΩ | 电阻 | 0805 | **0.1%** | 0805W8F6982T5E |
| R8 | 100Ω | 电阻 | 0805 | 1% | — |
| L1 | 4.7 µH | 绕线电感 | CD54（或 0805 高额定档） | SRF≥12MHz | — |
| L3, L5 | 22 µH | 绕线电感 | CD54 | SRF≥12MHz | — |
| L7 | 12 µH | 绕线电感 | CD54 | SRF≥12MHz | — |
| C2 / C4,C6 / C8 | 5.6 / 10 / 1.8 nF | 电容 | 0805 | **C0G** | — |
| C10 | 470 pF | 电容 | 0805 | C0G | — |
| C11 | 22 µF | 电容 | 0805 | X7R | — |
| C12 | 1 µF | 电容 | 0805 | X7R/C0G（见 §5） | — |
| C13 | 10 µF | 电容 | 0805 | X7R | — |
| JP1, JP2, JP3 | 0Ω | 跳线 | 0805 | — | — |
| TP1 ~ TP6 | — | 测试点 | — | 端接 / LC入 / LC出 / ADC前 / VBIAS / AGND | — |
| U2 | REF3033AIDBZR | 基准 | SOT-23-3 | **留位未装** | ¥1.41 |

## §8 验证计划（EVT 阶段 · 补 16 号指出的 Gate 4 缺口）

| # | 项 | 方法 | 判据 |
|---|---|---|---|
| 1 | 静态工作点 | 上电，测 U1.1 / U1.7 / VBIAS 直流 | U1.1 ≈ VBIAS；U1.7 ≈ VBIAS（不饱和） |
| 2 | **扫频标定** | 信号源扫 10k~2.5M，测 TP1 / TP3 / TP4 | 实测 \|H\| 与 `report_filter_final.md` 对比，偏差 <1 dB |
| 3 | **17 点标定表** | 按软件文档 §7 建表 | 残差 <0.05 mV |
| 4 | **混叠残留** | 注入 200 mVpp @1.5 MHz，看分析带伪峰 | 伪峰 <1.5 mVpk 门限 |
| 5 | 端接验证 | 断开 R1，测 AFE_BUF_IN 幅度 | 应翻倍（证明 50Ω 端接生效） |
| 6 | 增益验证 | 注入 100 mVpp @100 kHz，测 TP4 | ×8 ±2% |
| 7 | **电感线性度** | 注入纯正弦，测 TP3 的 THD | 若用 0805 叠层电感，此项**必做**（§2.4） |
| 8 | 电源纹波 | 示波器 AC 耦合测 +5V_A | <10 mVpp |
| 9 | 噪声底 | 输入端接 50Ω 负载，测 TP4 噪声 | <0.5 mVrms（进分析带） |

## §9 变更记录

| 日期 | 内容 |
|---|---|
| 2026-10-01 | 首版。 |
| 2026-10-01 | **修订**：删去自编的"推荐元件值 L=4.7/22/22/15 + C=5.6/10/8.2/2.0"（无容差数据支撑，且与 `report_filter_final.md` 的已定案冲突）；滤波器数值一律改引用已有定案；补 0805 电感库存评估（§2.4）与 EVT 验证计划（§8）。 |
