funiang-x/G2026/hardware/18-全板原理图设计方案.md

# G2026 底板 · 全板原理图设计方案 · 2026-10-01

> **性质**：按 `hardware-solution` skill（**快速模式**）产出的**全板级原理图设计方案**，覆盖 **AFE / INT / PWR 三页**。
> **与 17 号的分工**：17 号只讲 AFE 的 LC 滤波器设计要点与索引；本文把三页收敛成一份可评审、可交给硬件工程师的方案
> （系统框图 / 三页网表 / 接口矩阵 / 全板器件清单 / 电源树 / PCB 约束 / 风险 / 验证计划 / 决策门）。
> **文件落点说明**：skill 默认落 `docs/hardware/NN-*.md`；本工程现行约定是 `hardware/NN-*.md`（`docs/INDEX.md` 与 01~17 号同此），**工程内约定优先**。
>
> **数据来源（按可信度排序）**
> ① **立创EDA 活体回读**（2026-10-01 17:0x，工程 `funiang/ai`，三页逐页实测）——证据文件见 §16；
> ② **EDA 原生网表导出**（首版 `.easyeda/artifacts/20261001-171059-…enet` 50 位号 / 50 网；**第二轮终态** `20261001-180216-…enet` **69 网**，sha256 `ff330cfc…ea89f`）；
> ③ 工程内文档 01~17 号（**注意 01/02/03/04 正文仍有旧口径**，见 §3.5 对账表）；
> ④ 脚本复算：`report_filter_final.md`、`verify_afe_v2_report.md`、`tools/verify_dsp.py`。
>
> **三态口径**：**已验证**（附来源）/ **未验证**（说明为何）/ **不适用**。凡涉"上板"的结论一律 **未验证**——装置尚未制造。
>
> ⚠️ **2026-10-04 口径同步（本文 10-01 写成，以下五处已变，正文按历史读）**
>
> | 本文写法 | 现行事实 | 出处 |
> |---|---|---|
> | `§6 PWR` = 10 器件 + `F1` / 9 网（含 `+5V_IN`/`+5V_RAW`） | **PWR 页只剩 4 件**：`C16`/`R15`/`R16`/`R21`。`J3`/`F1`/`D2` 已删 ⇒ 本板**由核心板 Type-C 供电**，两网消失 | `38 §3.2-①` |
> | `§5.2 AFE_BUF_IN = JP1.2, R2.1, TP2.1, U1A.3` | 该网现为 `JP1.2`/`R2.1`/`U1.3`（自动名 `$3N698`）—— **`TP2` 已不在图上** | `38 §3.2-②` |
> | `§6` 电源树 `J3(DC005)→+5V_RAW→D2(SS34)→+5V` | 现行：**核心板 5V 引脚 → `+5V` → `R21`(4.7Ω) → `+5V_A`** | `38 §3.2-①` |
> | `C12` / `JP3` / `TP6` / `C19` / `C20` / `LED1` / `R11` 在册 | **均已删** | `30 §5` · `33 §50` |
> | `J5` 偶数脚映射 | **已改**为屏厂线性表 | `04 §6.18` |
>
> 另：跨页网从 10 条变 **9 条**（`VREF_CORE` 随死支路删除）。
> **本文不改图纸、不改固件、不改 `.ioc`**（AI 边界：改引脚/时钟、烧录、下单都要先问人）。

## §0 摘要（骨架成立；有一处必须先修的断线）

| 项 | 结论 |
|---|---|
| 推荐架构 | **核心板（立创·天空星 STM32F407VGT6-PRO）+ 自绘底板**；底板三页 = AFE（模拟前端）· INT（核心板 ↔ 30-pin 适配板接口）· PWR（电源与指示） |
| 推荐理由 | 前端走**无源 LC 8 阶巴特沃斯 + OPA2197 逐级缓冲**：零运放带宽门槛、无稳定性问题；**增益放在滤波之后**（u_J 先滤后放 ⇒ 无 IM3 入带）；核心板承担最小系统与板载基准，底板只放"赛题必需"的器件 |
| 图纸状态 | **EDA 原生 DRC：0 致命 / 0 错误 / 5 警告**（判"通过"）；`sch nets` 跨页审计：**50 张网，无同轨异名、无单引脚网**；但重建检查器 `sch check` 另报 206/132/108 条**绘图规范类** findings（§3.3） |
| **P0 缺陷（曾阻断上板）** | ~~`VREF_CORE → JP3 → VREF_ADC → R9 → VBIAS` 基准/偏置链断开~~ → **2026-10-01 17:3x 已落图修复并验证落盘**（§18 有全过程）：`floatingPins` 3→**0**、原生 DRC 5→**2 警告**、`bridge-check` 0 问题树。修复前 `VBIAS` 无源（被 `R10` 拉到 AGND ≈ 0 V）⇒ AFE 直流工作点不成立 |
| 次要缺口 | ① ~~5 V 入口无过流保护~~ → **已补 PPTC `F1`**；② ~~FSMC 33 Ω 串阻未落图~~ → **已补 20 只 `R22`~`R41`（图纸画在 J5 侧＝工具限制、**PCB 必贴 MCU 引脚 3~5mm**，见 §19/R-21 与 `22 §5`；10-02 补 `R40`/`R41` 给 `WR`/`RD`）**；③ ~~`.ioc` 仍把 PC4 配成 GPIO_Output(TP_RST)~~ → ✅ **已代改完并上板取证（2026-10-02）**：PC4=**输入、不驱动**（**不配 `ADC1_IN14`**，改判见 §11-2）、PC5=**输入+内部上拉**（原判"用户后面自己改 / 只登记不代改"已被当日批准取代） |
| 下一步 | ① 拍板项已落（C-2/C-3/C-4/C-5 见 §15）→ ② ✅ ~~等人改 `.ioc`(PC4→ADC1_IN14、PC5→Input+Pull-up)~~ **已完成（2026-10-02）**，且 PC4 改判为不配 ADC 通道 → ③ 过上板前实测清单（§12 / §13） |

## §1 需求与假设（快速模式）

**已冻结的工程约束**（来源：01 §1 + 13 号定稿决策 + 15 号变更；"状态"列为本文复核结果）

| # | 约束项 | 值 | 状态 |
|---|---|---|---|
| 1 | 功能 | 四页 UI（波形 1T/3T · 参数 · 定性谱 · 谱线表）× u_a / u_b / u_b+J 三场景；触摸键控 | 已知 |
| 2 | 信号带宽 | 被测成分 10 kHz~500 kHz；单频干扰 u_J ≥1 MHz / 200 mVpp | 已知（题面） |
| 3 | ADC | MCU 片内 ADC1 12 bit，fs = 2.000 MSPS（TIM8 TRGO，ADCCLK 36 MHz，SMP=3） | 已知（`board_config.h`） |
| 4 | 幅值精度 | Upp / Urms / 谱线幅值绝对误差 ≤5 mV（基频 ≤1 kHz） | 已知（题面） |
| 5 | 模拟前端 | 折叠带 [1.5, 2.5] MHz 衰减 ≤ −42.5 dB；带内 LTI 可标定；**增益必须在滤波之后**；50 Ω 端接；单 5 V 供电 + VREF/2 偏置 | 已知（02 §3/§4、12 §2） |
| 6 | 显示/触摸 | 3.5″ 320×480 ST7796S + FT6206(FT6x06)，**FSMC 8080-16 bit**，统一走 **J5（30-pin 适配板）** | 已知（13 §1 D1/D2） |
| 7 | 供电 | 单路 5 V 直流；底板不放 LDO、不放背光驱动（3.3 V 取核心板 EVK1.38/78） | 已知（13 §1 D5/D8） |
| 8 | 板卡形态 | 核心板 + 单块底板（无板间连接器 J2/J4） | 已知（13 §1 D9） |
| 9 | 焊接工艺 | 手焊：SOIC/SOT-23/SOT-223/0805/1206/通孔/直插排针（禁 QFN/BGA） | 已知 |
| 10 | PCB 层数 | **2 层**（用户 2026-10-01 拍板；14 §1 A2 曾列为待拍板） | 已知（16 §4-1） |
| 11 | 成本上限 / 交期 / 供应链 | 底板 BOM ≤¥100 量级 / 无硬交期 / 默认混合（模拟·主控 TI·ST，电源被动国产通用件） | **[假设]**（14 §1 A1 的 TBD-3/4/5 仍未闭环） |
| 12 | 认证与环境 | 室内实验/竞赛现场，无温湿度与 EMC 认证要求 | 已知 |

**快速模式的假设清单**（未提供或未闭环项，本文按此推进；有异议直接改）

- **[假设-1]** 成本上限按 ¥100 量级（01 §1 TBD-3）——本文不据此裁剪任何器件，只用于下单前复核。
- **[假设-2]** 供应链继续走"模拟/主控海外 + 电源/被动/连接器国产通用件"（TBD-5）。
- **[假设-3]** 不做供应链三档（国产优先/海外主流/混合）的正式比选：**核心板已锁定**（03 #1），本工程是赛题复盘装置，供应链自主性不是约束（skill 要求"某类不适用必须说明原因"）。
- **[假设-4]** 适配板（屏厂 30-pin）内部已绑好 IM=010 与背光 NMOS（04 §6.8 用户实读，仅确认丝印档位，见 §12 R-09）。

## §2 全板系统框图（活体实测拓扑）

```
                    ┌─────────────── 底板 PWR 页 ───────────────┐
 J3(DC005) 5V ──► +5V_RAW ── D2(SS34 防反) ──► +5V ──┬──► EVK1.40/80（核心板）
                                                    ├── C16 22µF（入口储能）
                                                    └── R21(0Ω) ──► +5V_A ──┬── U1.8(V+)
                                                                            ├── D1.5(TVS 钳位)
                                                                            ├── C11 22µF + C14 100nF
      +3V3 ◄── EVK1.38/78（核心板 LDO）──┬── J5.30（屏/触摸供电）          └── （AFE 页）
                                        ├── C19/C20 100nF + **C21/C22（J5 就近去耦，2026-10-02 落图）**
                                        ├── R11 1k ─► LED1 ─► GND（板载指示灯）
                                        ├── R15 4.7k ─► TP_SCL（I²C 上拉）
                                        └── R16 4.7k ─► TP_SDA（I²C 上拉）
                    └───────────────────────────────────────────┘

 INT 页（3 器件）：EVK1 ⟷ J5（30-pin 适配板）
   FSMC 16bit: LCD_D0~D15 · LCD_CS/RS/WR/RD · LCD_RST
   I²C2      : TP_SCL / TP_SDA · TP_INT
   背光开关  : EVK1.11(PB0) ── R12 1k ── LCD_BL_CTL ──► J5.28
   模拟接口  : AFE_ADC_IN ──► EVK1.4(PA1) ; VBIAS ──► EVK1.9(PC4) ; VREF_CORE ◄── EVK1.2(REF) ; AGND ◄── EVK1.37

 AFE 页（38 器件）：J1(SMA) → D1(SRV05-4) → R1 49.9Ω 端接 → C1 100nF → JP1
   → U1A(G=1 缓冲) → R3 49.9Ω → LC 8 阶(fc≈648k) → R4 49.9Ω 终接 → C9 100nF
   → U1B(同相 ×7.98) → R8 100Ω + C10 470pF → JP2 → AFE_ADC_IN
   基准/偏置：VREF_CORE ── JP3 ──► VREF_ADC ── R9 10k ──► VBIAS ◄── R10 10k ── AGND
              VBIAS 供给 R2 / R5 / R7 三处偏置           ▲ **本条当前图纸未接通，见 §3.4**
```

## §3 图纸现状与缺陷（活体实测 2026-10-01）

### 3.1 三页清单

| 页 | uuid | 器件 | 导线 | 网络 | 连接点 | 说明 |
|---|---|---|---|---|---|---|
| AFE-前端模拟 | `fe840e6f545a2753` | 38 符号 / 37 位号 | 89 | 20 | 81 脚 | 信号链 + 基准/偏置 + 6 测试点（`U1` 双运放 = 1 位号 2 符号） || INT-核心板与接口 | `63accad121e053cf` | 3 + **20 只 33 Ω** | — | 33 + 20 | 65 + 40 | EVK1 / J5 / R12 / `R22`~`R41`（两轮新增，见 §19；10-02 补 `R40`/`R41` 给 `WR`/`RD`） |
| PWR-电源与背光 | `0c870c063661db6c` | 10 + **F1(PPTC)** | — | 9 | 21 + 3 | 输入防反 + PPTC + 去耦 + 指示灯 + I²C 上拉 |
| 合计 | — | **52 符号 + 19 新件** | — | **69（跨页去重）** | — | 工程另含一个 PCB 文档 `PCB1`（按 04 §5 拍板**本项目不做 PCB** = 不适用） |

### 3.2 全工程网表审计（`easyeda sch nets`，跨页）

```
sch nets — 69 张网（全工程，跨页）            # 第二轮前为 50 张；+18 = LCD_xx_J5，+1 = +5V_IN
✓ 69 张网，无同轨异名，无单引脚网
```

⇒ 跨页命名（`+5V` / `+3V3` / `GND` / `AGND` / `+5V_A` / `VBIAS` / `VREF_CORE` / `AFE_ADC_IN` / `LCD_*` / `TP_*`）**一致，无一处"同一条轨两个名字"**。

### 3.3 三种检查口径（不要混用）

| 口径 | 命令 | AFE | INT | PWR | 性质 |
|---|---|---|---|---|---|
| **EDA 原生 DRC**（唯一权威验收，工程铁律） | `easyeda sch drc` | — | — | — | **0 致命 / 0 错误**：修复前 **5 警告** → 修复后 **2 警告** → passed |
| **重建检查器** | `easyeda sch check --page …` | 203 | 151 | 101 | 绘图规范类（`text-overlap` 166/69/78、`marker-overlap` 9/**47**/4、`reversed-net-flag` 16/10/12、`wire-through-body`(ERROR) 0/**19**/1、`pin-exit-direction`(ERROR) 5/0/7、`designator-overlap` 5/**4**/0、`dangling-wire` 0/0/0、`missing-partition` 1/0/1、`titleblock-key-absent` 1/1/1）；INT 的 marker-overlap 由 31→47，全部来自第二轮新增的 18 组网（J5 30-pin 在 10 单位脚距上多挂 18 个 netport） |
| **电气连通性**（本文判定缺陷用这个） | 原生网表 `.enet` + `sch list --include-pins` | **20 网** | 33+18 网 | 9 网 | 见 §3.4/§5/§6 与 §19 |

**读法**：`sch check` 的 `ERROR` 级**不是电气错误**，是工具自定的绘图规范判据（导线从引脚内侧引出、导线穿过元件体等），**不影响网表**；但它们影响可读性与后续自动布局，列入 §12 的交付规范项，不列为缺陷。

### 3.4 **P0 缺陷：基准/偏置链断开 → 已修复并验证落盘**（电气级）

**发现时的证据（三方一致，2026-10-01 17:0x）**

| 来源 | 结果 |
|---|---|
| EDA 原生网表 `.enet` | `R9`：`{'1': '', '2': ''}`；`JP3`：`{'1': '', '2': 'VREF_CORE'}`；`VREF_ADC = {C12.2, TP6.1}`；`VBIAS = {EVK1.9, R2.2, R5.2, R7.1, R10.1, C13.1, TP5.1}` |
| `sch list --include-pins`（AFE 页） | 同上，`R9.1/R9.2/JP3.1` 的 `net` 为空串 |
| `sch check --page AFE` | `floating-pin` ×2 器件（`JP3`、`R9`）、`dangling-wire` ×1 @(535,1355) |

对照设计意图（13 §5.2 B4 / §5.8）：应为 `VREF_ADC = {C12.2, JP3.1, R9.1, TP6.1}`、`VBIAS = {…, R9.2, …}`。
⇒ **09-29 落图时是通的（有文档回读记录），10-01 回读已断言开**——属**回归**。

**后果（不是"少一条线"）**

1. `VBIAS` 无上拉，只剩 `R10`(10 k) 到 AGND 与 `C13`(10 µF) ⇒ **VBIAS ≈ 0 V**；
2. `U1A` 输入被 `R2` 偏到 0 V，单电源下输出贴地；`U1B` 同相端经 `C9` 到 0 V、`R7` 回 VBIAS(0 V) ⇒ **增益级贴下轨饱和**，ADC 读数恒 0；
3. `VREF_ADC` 与 `VREF_CORE`（`EVK1.2`）断开 ⇒ 该页的基准去耦 `C12` / 测试点 `TP6` 悬空。

**根因未确证**：`_r9_restore.py`（09-30 22:32）里写死的 `(530,1335)`/`(570,1335)` 与 `R9.2`/`R9.1` 的连接点**完全一致** ⇒ "硬编码坐标写错"**不成立**。
最可能：**那一笔没真正落盘**（15 §8-1 的「Ctrl+S 保存确认」一直未闭环）。**所以修完必须做"保存 → 关页重开 → 回读网表"闭环——只回读一次不算验完。**

**✅ 已实施的修复（2026-10-01 17:3x，全过程见 §18）**

| # | 动作 | 结果 |
|---|---|---|
| 1 | `sch autoconnect --pin R9:1 --kind netport --net VREF_ADC` → 复核时因与原端口重叠改为 `sch disconnect` + `sch connect --direction right --offset 100` | `R9.1 = VREF_ADC` ✅ |
| 2 | `R9:2 → VBIAS`（同理改 `--direction left --offset 90` 让开原有 VBIAS 端口） | `R9.2 = VBIAS` ✅ |
| 3 | `JP3:1 → VREF_ADC`（`right/18`） | `JP3.1 = VREF_ADC`、`.2 = VREF_CORE` ✅ |
| 4 | 删 AFE 孤儿 stub (535,1355) + `bridge-check` 报的 1 个孤儿树 + 1 个孤儿旗 | AFE `dangling-wire` 1→**0**、`bridge-check` **0 问题树** ✅ |
| 5 | **保存 + 关页重开 + 回读**（`sch save` ×3 页 → `doc reload AFE` → `doc switch` → 重读） | 重开后三脚仍在目标网 ✅ **落盘确认** |

**修复前后（同一份工程，实测）**

| 指标 | 修复前 | 修复后 |
|---|---|---|
| AFE `floatingPins` | 3（JP3.1 / R9.1 / R9.2） | **0** |
| AFE `danglingWires` | 1 | **0** |
| PWR `danglingWires` | 2 | **0** |
| 原生 DRC（整设计） | 0 致命 / 0 错误 / **5 警告** | 0 致命 / 0 错误 / **2 警告** |
| `sch nets` 跨页审计 | 50 网，无同轨异名、无单引脚网 | 同（未破坏） |
| `bridge-check`（AFE） | — | 51 树，**0 桥接 / 0 孤儿** |

**⚠️ 两条必须记住的教训（都踩到了）**

1. **`dangling-wire` / "孤儿 stub" 的 finding 不能作为删除依据**。PWR 页两条被检查器判为"一端连引脚、另一端游离"的导线，**其实是 `+5V`（D2.K↔+5V 旗）与 `+5V_RAW`（J3.1↔D2.2）的承力线**——按 finding 删掉后 `+5V_RAW` 整张网消失、3 个引脚悬空（§18 记录了抢修过程）。
   **正确判据**：删任何线之前先看**原生网表成员**（`.enet` 里那两个脚在不在网上），并优先用 `sch disconnect`（线+旗一起删）；删完立刻 `sch connectivity` 对账。
2. **改完必须做"保存 → 关页重开 → 回读"闭环**（`sch save` → `doc reload` → 重读网表）。§3.4 这条 P0 本身就是"改了没落盘"的产物。

### 3.5 文档 ↔ 图纸对账（引用前必看）

| # | 文档口径 | **图纸实落（活体）** | 处置 |
|---|---|---|---|
| A | 01 §1/§2、03 #2：`fc=800k`、L=3.9/16/20/11 µH、C=4.3/7.5/6.8/1.6 nF、运放 ×4 | **fc≈648 kHz、L=4.7/22/22/12 µH、C=5.6/10/10/1.8 nF、U1B ×7.98** | 已由 14 号 A3/15 号指出；**本文一律用图纸实落值** |
| B | 01 §1/§2、02 §3：电平预算按**运放级 ×4** 计，**漏算端接与 LC 双端接两个 ×0.5**（14 §2 B1） | **运放 ×7.98、净增益 ≈2.0**（0.5 × 0.5 × 7.98） | 以 14 §2 B1 / 15 §3 为准（固件 `BOARD_NET_GAIN 2U`） |
| C | 17 §7：`C1/C9` = 0805 100 nF；`C10` = 0805 470 pF；`C11/C12` = 0805 X7R | **`C1/C9` = 1206 C0G（1206CG104J500NT）· `C10` = 0603（CL10C471JB8NNNC）· `C11/C12` = 钽 B 型（TAJB226K025/016RNJ）** | 以图纸为准；17 §7 封装列待回填 |
| D | 17 §7：`R6/R7` = 0.1% | **`R6` = 0805W8F6982T5E、`R7` = 0805W8F1002T5E**（厚声 `0805W8F` 系列按编码惯例为 **±1%**，**待下单页核对**） | ⚠️ 增益误差 ~2% 白吃判据余量（§12 R-13）；换 0.1% 或靠 17 点标定吸收 |
| E | 04 §1.7 自述 §1.2/§2/§3 仍是 `H3/H4/AMS1117/+5V_MAIN` 旧口径 | 图纸为 `J5` 30-pin、无底 LDO、网名 `+5V/+5V_A` | 引用 04 时只信 §1.1、§6~§8 |
| F | 03 #15：5 V 入口 = `SS34 + 自恢复保险` | ~~只有 `D2`(SS34)~~ → **第二轮已补 PPTC `F1`** | ✅ 已闭合（13 D11 的"不加"被用户 2026-10-01 授权覆盖，见 §15/§19） |
| G | 02 §6 O7 / 03 #13：FSMC 33 Ω×N | ~~未落图~~ → **第二轮已落 18 只（`R22`~`R39`；图纸在 J5 侧＝工具限制，PCB 必贴 MCU 侧）** | ✅ 已闭合（同样按用户授权；位置偏差见 R-21/§19.2） |
| H | 12 §7 T7：实物核心板 VET6 还是 VGT6 未定 | 图纸符号 = `LCKFB-LSPI-SkyStar-STM32F407VGT6-PRO` | 看板面丝印确认（Flash 512 KB vs 1 MB），§12 R-14 |
| I | 06 号：`TP6 = AGND` | **`TP6 = VREF_ADC`** | 06 号该行作废 |

## §4 AFE 页设计（38 器件 / 20 网）

### 4.1 信号链（活体网表还原）

```
J1(SMA-KE) ─┬─ R1 49.9Ω → AGND            50Ω 端接（必须紧贴 J1）
            ├─ D1.4 (SRV05-4, Cj≈1.5pF)    ESD 钳位；D1.5→+5V_A、D1.2→AGND；D1.1/3/6 = NC
            ├─ TP1                          测试点（端接节点）
            └─ C1 100nF(C0G,1206) → JP1(0Ω) ──► AFE_BUF_IN
AFE_BUF_IN ─┬─ U1A.3 (+inA)   ·  U1A.1(OUT)─U1A.2(−in) 单位增益缓冲
            └─ R2 10k → VBIAS                AC 耦合 + 偏置注入
U1A.1 → R3 49.9Ω → L1 ─┬─ C2 5.6nF ↓AGND
                       ├─ L3 ─┬─ C4 10nF ↓AGND
                       │      ├─ L5 ─┬─ C6 10nF ↓AGND
                       │      │      ├─ L7 ─┬─ C8 1.8nF ↓AGND
                       │      │      │      ├─ R4 49.9Ω → AGND   终接
                       │      │      │      └─ TP3                测试点（LC 出）
LC 8 阶巴特沃斯，双端接 50Ω，fc≈648 kHz（标称注释 660 kHz）
LC 出 → C9 100nF(C0G,1206) ─┬─ U1B.5 (+inB)
                            └─ R5 10k → VBIAS
U1B：同相 ×(1+R6/R7) = 1+69.8k/10k = 7.98 ≈ ×8（R7.1 落 VBIAS ⇒ 直流输出 = VBIAS）
U1B.7 → R8 100Ω ─┬─ C10 470pF ↓AGND（fc≈3.4 MHz，ADC kickback 隔离）
                 └─ JP2(0Ω) → AFE_ADC_IN → EVK1.4 (PA1, ADC1_IN1)
VREF_CORE(EVK1.2) ─ JP3(0Ω) ─ VREF_ADC ─┬─ C12 22µF 钽 ↓AGND
                                        ├─ TP6
                                        └─ R9 10k ─ VBIAS ─┬─ R10 10k → AGND
                                                           ├─ C13 10µF ↓AGND
                                                           ├─ TP5
                                                           └─ 供给 R2 / R5 / R7
```

### 4.2 全页网表（活体；`$3Nxxx` = EDA 自动网名）

| 网络 | 引脚 |
|---|---|
| `$3N586` | J1.1, R1.1, D1.4, C1.1, TP1.1 |
| `$3N523` | C1.2, JP1.1 |
| `AFE_BUF_IN` | JP1.2, R2.1, TP2.1, U1A.3 |
| `$3N591` | U1A.1(OUT), U1A.2(−in), R3.1 |
| `$3N526` | R3.2, L1.1 |
| `$3N527` | L1.2, C2.2, L3.1 |
| `$3N528` | L3.2, C4.2, L5.1 |
| `$3N529` | L5.2, C6.2, L7.1 |
| `$3N530` | L7.2, C8.2, R4.1, C9.1, TP3.1 |
| `$3N531` | C9.2, R5.1, U1B.5 |
| `$3N533` | R6.1, R7.2, U1B.6 |
| `$3N532` | R6.2, R8.1, U1B.7 |
| `$3N534` | R8.2, C10.1, JP2.1, TP4.1 |
| `AFE_ADC_IN` | JP2.2 **＋ EVK1.4（跨页）** |
| `+5V_A` | C11.1, C14.2, D1.5, U1A.8(V+) |
| `AGND` | J1.2/3/4/5, R1.2, R4.2, R10.2, C2.1, C4.1, C6.1, C8.1, C10.2, C11.2, C12.1, C13.2, C14.1, U1A.4(V−), D1.2 |
| `VBIAS` | C13.1, R2.2, R5.2, R7.1, R10.1, TP5.1 **＋ EVK1.9（跨页）** ⚠️ **缺 R9.2** |
| `VREF_ADC` | C12.2, TP6.1 ⚠️ **缺 JP3.1 / R9.1** |
| `VREF_CORE` | JP3.2 **＋ EVK1.2（跨页）** |
| （空网） | **JP3.1、R9.1、R9.2 ← P0 缺陷**；D1.1/3/6 = 有意 NC |

### 4.3 关键定量（来源：`report_filter_final.md` / 14 §3）

| 项 | 值 | 判据 | 结论 |
|---|---|---|---|
| 折叠带 [1.5, 2.5] MHz 最差衰减 | **−59.30 dB**（标称）/ 蒙特卡洛最坏 −55.24 dB（L±10%、C±5%，5000 次） | ≤ −42.5 dB | ✅ 余量 16.8 dB / 12.74 dB |
| 带内 10 k~500 k 起伏 | 0.139 dB | 17 点标定吸收 | ✅ |
| 端接 + LC 双端接插损 | 0.5 × 0.5 = 0.25（−12 dB，LTI 常数） | 可标定 | ✅ |
| 运放级增益 | ×7.98（R6 69.8 k / R7 10 k） | — | ✅ |
| 净增益（源端→ADC） | **≈2.0** ⇒ `BOARD_NET_GAIN 2U` | 固件同口径 | ✅ |
| ADC 摆幅 | ±249 mVpk @ VBIAS = VREF/2 | 轨余量 ≥1.4 V | ✅ |

### 4.4 逐级取舍（沿用 17 §4，本文不另立第二真相源）

| 级 | 选择 | 不这样做的后果 |
|---|---|---|
| 50 Ω 端接 | 匹配题面电缆；×0.5 是唯一免费且无失真的"抗混叠增益" | 不端接：折叠残留翻倍 > 1.5 mV 峰门限 |
| BUF1（G=1） | 高阻读端接节点、低阻经 49.9 Ω 驱动 LC；摆幅最小 ⇒ 对未滤除的 u_J 处于最线性区 | 缺此级：端接与滤波器输入阻抗互相扰动 |
| **增益在滤波之后** | 运放只见带内小信号，u_J 已 −59 dB ⇒ IM3 无从产生 | 增益前置：IM3 产物落带内，**滤波器无法去除** |
| 100 Ω + 470 pF | ADC 开关电容 kickback 隔离；Rsrc ≤ 1.1 kΩ（SMP=3） | 采样电荷反冲在输出产生建尖 |
| 不加第三只跟随器 | ×8 已是低阻驱动，再加 G=1 只多一级 droop 与失真源 | 零收益 |

### 4.5 布局约束（AFE 区）

| 约束 | 值 | 原因 |
|---|---|---|
| 电感**正交摆放**、间距 ≥2 mm、下方不走高速线 | — | 互感改变高节频响（L3/L5 同为 22 µH 尤甚） |
| AFE 分区 + 模拟地**完整铜皮** + 单点汇 `EVK1.37`(AGND) | — | **2 层板无地平面兜底，这条由"优化"升级为"必做"**（16 §4-1） |
| `R1` 端接电阻距 `J1` 中心针 ≤2~3 mm | — | 端接必须在电缆口，否则端接失效（13 §5.7） |
| `C14` 就近 `U1.8`、`C11` 就近 `+5V_A` 入口 | — | 去耦回路最短 |
| `TP1`~`TP6` 全部保留在板面可探位置 | — | 扫频标定与上电自检的物理基础（02 §6 O3） |

## §5 INT 页设计（3 器件 / 33 网）——EVK1 ↔ J5 全脚连接

### 5.1 J5（2×15 2.54 母座）逐脚连接表（活体网表，**这是接口的单一真相源**）

| J5 | 网络 | EVK1 脚（丝印） | MCU 脚 | 功能 |
|---|---|---|---|---|
| 1 | `LCD_CS` | 67 (D07) | PD7 | FSMC_NE1 |
| 2 | `LCD_RS` | 31 (D11) | PD11 | FSMC_A16 |
| 3 | `LCD_WR` | 69 (D05) | PD5 | FSMC_NWE |
| 4 | `LCD_RD` | 70 (D04) | PD4 | FSMC_NOE |
| 5 | `LCD_RST` | 14 (B01) | PB1 | 屏复位（按 13 D2/D4 与触摸复位共用；**共用关系未实测**，04 §6.5-④） |
| 6 | `LCD_D0` | 36 (D14) | PD14 | FSMC_D0　**2026-10-04 修**（原为 NC） |
| 7 | `LCD_D1` | 35 (D15) | PD15 | FSMC_D1 |
| 8 | `LCD_D2` | 72 (D00) | PD0 | FSMC_D2　**修**（原 `LCD_D0`） |
| 9 | `LCD_D3` | 71 (D01) | PD1 | FSMC_D3 |
| 10 | `LCD_D4` | 13 (E07) | PE7 | FSMC_D4　**修**（原 `LCD_D2`） |
| 11 | `LCD_D5` | 16 (E08) | PE8 | FSMC_D5 |
| 12 | `LCD_D6` | 15 (E09) | PE9 | FSMC_D6　**修**（原 `LCD_D4`） |
| 13 | `LCD_D7` | 18 (E10) | PE10 | FSMC_D7 |
| 14 | `LCD_D8` | 17 (E11) | PE11 | FSMC_D8　**修**（原 `LCD_D6`） |
| 15 | `LCD_D9` | 20 (E12) | PE12 | FSMC_D9 |
| 16 | `LCD_D10` | 19 (E13) | PE13 | FSMC_D10　**修**（原 `LCD_D8`） |
| 17 | `LCD_D11` | 22 (E14) | PE14 | FSMC_D11 |
| 18 | `LCD_D12` | 21 (E15) | PE15 | FSMC_D12　**修**（原 `LCD_D10`） |
| 19 | `LCD_D13` | 30 (D08) | PD8 | FSMC_D13 |
| 20 | `LCD_D14` | 29 (D09) | PD9 | FSMC_D14　**修**（原 `LCD_D12`） |
| 21 | `LCD_D15` | 32 (D10) | PD10 | FSMC_D15 |
| 22 | — | — | — | **NC**（适配板此脚 = `T_BUSY`，丝印为空位）　**修**（原错挂 `LCD_D14`） |
| 23 | — | — | — | **NC**（按 13 §4 判为适配板 T_CS 一路；**丝印/通断未实测**，04 §6.5-① 曾列为阻塞项） |
| 24 | `TP_SCL` | 23 (B10) | PB10 | I²C2_SCL |
| 25 | — | — | — | **NC**（按 13 §4 判为适配板 MISO 一路；**未实测**，同上） |
| 26 | `TP_SDA` | 24 (B11) | PB11 | I²C2_SDA |
| 27 | `TP_INT` | 12 (C05) | PC5 | 触摸中断（FT6206 输出，MCU 侧应为**输入**） |
| 28 | `LCD_BL_CTL` | ← `R12` 1 k ← 11 (B00) | PB0 | 背光**开关电平**（恒亮，禁 PWM） |
| 29 | `GND` | 39 / 77 / 79 | — | 地 |
| 30 | `+3V3` | 38 / 78 | — | 核心板 LDO 输出（屏/触摸供电，**背光电流从这里出，见 §12 R-02**） |

> **口径提醒 1（2026-10-04 更正）**：J5 的物理脚序**就是屏厂 PDF 的线性编号表**
> （`1=CS 2=RS 3=WR 4=RD 5=RST 6=D00 7=D01 … 21=D15 22=T_BUSY 23=T_CS 24=T_CLK 25=T_MISO
> 26=T_MOSI 27=T_IQR 28=BL_CTR 29=GND 30=3V3`）—— 画成两列就是**奇脚一列、偶脚一列，
> 两列都自 `CS/RS` 端起算**，实物丝印正是这么印的。
> ⛔ 原文"物理脚序按丝印成对排布（`D1/D0`、`D3/D2`…）"**是误读**：`D15` 的邻居是**空位**、
> `RST` 的邻居是 **`D00`**，不存在 `D1/D0` 这种配对。详情与改图凭据见 04 §6.1/§6.18/§8.1。
> **口径提醒 2（本节的性质）**：上表 = **图纸侧的连接事实**（活体网表，坐实）；但**"J5 第几脚 = 适配板哪根丝印"这一层是映射判断，尚未用万用表通断实测**
> （04 §6.5-①/§6.7-②/§6.9、15 §5-3、16 §4-4 D11：`CS/RS/WR`、`DE/PCLK/VSYNC/HSYNC`、触摸总线落点）。⇒ 上板前必做 §13 的 **EVT-14 通断核对**。

### 5.2 跨页网与逻辑关系

| 网络 | 成员（跨页） | 说明 |
|---|---|---|
| `+5V` | INT: EVK1.40/80 · PWR: C16.1, D2.1(K), R21.1 | 5 V 主轨 |
| `+5V_IN`/`+5V_RAW` | PWR: J3.1/F1.1 与 F1.2/D2.2 | **第二轮**：PPTC `F1` 插在 J3 与 D2 之间 |
| `LCD_Dx`/`LCD_CS`/`LCD_RS`/`LCD_WR`/`LCD_RD` | INT: EVK1 脚 + `R22`~`R41`:1 · J5 侧同名 netport | MCU 侧网（第二轮后只到阻尼电阻） |
| `LCD_Dx_J5`/`LCD_CS_J5`/`LCD_RS_J5`/`LCD_WR_J5`/`LCD_RD_J5` | INT: `R22`~`R41`:2 + J5 对应脚 | **第二轮新增 18 张网**；**2026-10-02 补 `WR`/`RD` 两张**（`R40`/`R41`，第三排 y=-50）⇒ 屏侧网共 20 张 |
| `PWR_LED` | PWR: LED1.1(+) / R11.1 | 板载指示灯，**常亮、不受 PB0 控制**（12 §5 P1-4c 已澄清） |
| `+3V3` | INT: EVK1.38/78, J5.30 · PWR: C19/C20/R11/R15/R16 · INT: C21/C22（J5 就近去耦，2026-10-02） | 核心板 LDO 输出，底板不放 LDO |
| `GND` | INT: EVK1.39/77/79, J5.29 · PWR: J3.2/3, C16.2, C19.2, C20.2, LED1.2 | 数字地 |
| `AGND` | INT: EVK1.37 · AFE: 见 §4.2 | 模拟地，0 Ω 单点在核心板内 |
| `AFE_ADC_IN` | INT: EVK1.4(PA1) · AFE: JP2.2 | 模拟输入（0 Ω 断点 JP2） |
| `VBIAS` | INT: EVK1.9(PC4) · AFE: 6 脚 | 偏置自检电平（~~需配 ADC1_IN14，见 §11~~ → ✅ **2026-10-02 改判：不配 ADC 通道**，改由 AFE 帧直流均值判"轨在线"，见 §11-2 与 `board_config.h`） |
| `VREF_CORE` | INT: EVK1.2(REF) · AFE: JP3.2 | 基准取用（0 Ω 断点 JP3） |
| `TP_SCL`/`TP_SDA` | INT: J5.24/26, EVK1.23/24 · PWR: R15.2/R16.2 | I²C2 + 底板 4.7 k 上拉 |
| `LCD_BL_PB0`/`LCD_BL_CTL` | INT: EVK1.11/R12.2 与 R12.1/J5.28 | 1 k 串阻分隔，便于单独测/断 |

### 5.3 EVK1 用量

84 脚中**已连 36 / 未连 48**（未连的绝大多数已打 `NO_CONNECT`，`sch check` 在 INT 页报 `floatingPins = 0`）。
关键脚：`2=REF` `4=A01(PA1)` `9=C04(PC4)` `11=B00(PB0)` `12=C05(PC5)` `14=B01(PB1)` `23=B10` `24=B11` `37=AGND` `38/78=3V3` `39/77/79=GND` `40/80=5V0`。

## §6 PWR 页设计（10 器件 + F1 / 9 网）

> ⚠️ **2026-10-04 口径已变，本节为历史存档**：`J3`(DC005) / `F1`(PPTC) / `D2`(SS34) **已从图上删除**，
> `+5V_IN` / `+5V_RAW` 两网随之消失。图内注释的现行口径是
> **"本板由核心板 Type-C 供电：+5V 取自核心板 5V 引脚，底板不再自带 DC 座"**。
> **PWR 页现存 4 个器件**：`C16`(22µF 就近储能) / `R15` / `R16`(I²C 上拉) / `R21`(4.7Ω 隔离)。
> 因此本节以下各表的 `J3`/`F1`/`D2`/`+5V_IN`/`+5V_RAW` 条目**全部作废**。
> 现行状态见 `38-底板设计状态体检-20261004.md` §3.2-①。

### 6.1 网表（活体，2026-10-01 第二轮后）

| 网络 | 成员 | 说明 |
|---|---|---|
| `+5V_IN` | J3.1, F1.1 | **第二轮新增**：DC005 座出口（PPTC 之前） |
| `+5V_RAW` | F1.2, D2.2(A) | **改为** PPTC 之后、SS34 之前 |
| `+5V` | D2.1(K), C16.1, R21.1, EVK1.40/80 | 防反后主轨；D2 = SS34（Vf≈0.4 V） |
| `+5V_A` | R21.2, + AFE 页（C11/C14/D1.5/U1.8） | 模拟 5 V 支路（`R21` = 0 Ω，预留磁珠位） |
| `+3V3` | C19.1, C20.1, R11.2, R15.1, R16.1, EVK1.38/78, J5.30 | 核心板 LDO 输出 |
| `GND` | J3.2, J3.3, C16.2, C19.2, C20.2, LED1.2(−) | 地 |
| `PWR_LED` | R11.1, LED1.1(+) | `+3V3 → R11 1 k → LED1(KT-0805Y) → GND`，常亮指示灯（≈1.3 mA） |
| `TP_SCL` | R15.2, + INT 页 | I²C 上拉（4.7 k） |
| `TP_SDA` | R16.2, + INT 页 | I²C 上拉（4.7 k） |

### 6.2 已删器件（13 号定稿，本文据活体确认均已不在图上）

`U3`(AMS1117) · `C17/C18` · `Q1/R13/R14`(背光驱动) · `U2`(REF3033) · `H3/H4`(45P/6P FPC) · `J2/J4`(板间连接器) · `R17/R18/R19/R20`(IM 0 Ω 配置)。
⇒ **底板不放 LDO、不放背光驱动、不做 IM 配置**（IM 由适配板出厂绑定）。

## §7 全板器件清单（活体回读；首版 50 位号，**第二轮后 69 位号**）

| 页 | 位号 | 值 / 器件 | 封装（活体） | 厂商型号 |
|---|---|---|---|---|
| INT | EVK1 | 立创·天空星 F407VGT6-PRO 核心板 | COMM-TH_…-PRO | LCKFB-LSPI-SkyStar-STM32F407VGT6-PRO |
| INT | J5 | 2.54-2×15P 母座 | HDR-TH_30P-P2.54-V-F-R2-C15 | 2.54-2\*15P母（BOOMELE） |
| INT | R12 | 1 kΩ | R0805 | 0805W8F1001T5E |
| PWR | J3 | DC005 电源座 | DC-IN-TH_DC005 | DC005 |
| PWR | D2 | SS34 肖特基 | SMA_L4.3-W2.6 | SS34 |
| PWR | C16 | 22 µF 钽 | CAP-SMD_L3.5-W2.8 | TAJB226K025RNJ |
| PWR | C19 / C20 | 100 nF X7R | C0805 | CC0805KRX7R9BB104 |
| PWR | R21 | 0 Ω | R0805 | 0805W8F0000T5E |
| PWR | R11 | 1 kΩ | R0805 | 0805W8F1001T5E |
| PWR | LED1 | 黄色 LED | LED0805-R-RD | KT-0805Y |
| PWR | R15 / R16 | 4.7 kΩ（I²C 上拉） | R0805 | 0805W8F4701T5E |
| AFE | J1 | SMA-KE 50 Ω 母座 | SMA-SMD_SMA-KE | SMA-KE |
| AFE | D1 | SRV05-4 TVS 阵列 | SOT-23-6 | SRV05-4 |
| AFE | U1 | OPA2197ID 双运放（1 片 2 单元） | SOIC-8 | OPA2197ID |
| AFE | R1 / R3 / R4 | 49.9 Ω（端接 / 串阻 / 终接） | R0805 | 0805W8F499JT5E |
| AFE | R2 / R5 / R7 / R9 / R10 | 10 kΩ | R0805 | 0805W8F1002T5E |
| AFE | R6 | 69.8 kΩ（增益 Rf） | R0805 | 0805W8F6982T5E |
| AFE | R8 | 100 Ω | R0805 | 0805W8F1000T5E |
| AFE | L1 | 4.7 µH 绕线 | IND-SMD_L5.8-W5.2_CD54 | XRCD54-4R7M |
| AFE | L3 / L5 | 22 µH 绕线 | IND-SMD_L5.8-W5.2 | CD54-220M |
| AFE | L7 | 12 µH 绕线 | IND-SMD_L5.8-W5.2 | XRCD54-120M |
| AFE | C2 | 5.6 nF C0G | C0805 | 0805CG562J500NT |
| AFE | C4 / C6 | 10 nF C0G | C0805 | 0805CG103J500NT |
| AFE | C8 | 1.8 nF C0G | C0805 | 0805CG182J500NT |
| AFE | C1 / C9 | 100 nF C0G（AC 耦合） | **C1206** | 1206CG104J500NT |
| AFE | C10 | 470 pF C0G | **C0603** | CL10C471JB8NNNC |
| AFE | C11 | 22 µF 钽（+5V_A 储能） | CAP-SMD_L3.5-W2.8 | TAJB226K025RNJ |
| AFE | C12 | 22 µF 钽（VREF 去耦，**建议改 1 µF 陶瓷**） | CASE-B_3528 | TAJB226K016RNJ |
| AFE | C13 | 10 µF X7R（VBIAS 去耦） | C0805 | CL21A106KAYNNNE |
| AFE | C14 | 100 nF X7R（U1 就近） | C0805 | CC0805KRX7R9BB104 |
| AFE | JP1 / JP2 / JP3 | 0 Ω 断点（BUF1 入 / ADC 前 / VREF 注入） | R0805 | 0805W8F0000T5E |
| AFE | TP1~TP6 | 黄色测试点（端接 / BUF 入 / LC 出 / ADC 前 / VBIAS / VREF） | TESTPOINT-TH_BD3.2 | TP-黄色测试点 |
| PWR | **F1**（第二轮） | PPTC 自恢复保险 1 A 保持 / 6 V | F0805 | PPTCPSMD1006V1A（C9900004101） |
| INT | **R22~R41**（两轮, 20 只） | 33 Ω ±1% FSMC 串阻 | R0805 | 0805W8F330JT5E（C17634） |
| AFE | **R6**（换料） | **69.8 kΩ ±0.1%** 薄膜（原 1% 厚膜） | R0805 | RT0805BRD0769K8L（C706249） |
| AFE | **R7**（换料） | **10 kΩ ±0.1%** 陶瓷（原 1%） | R0805 | HoAR0805-1/10W-10KR-0.1%-TCR5（C2912582） |
| AFE | **C12**（换料） | **1 µF 0805 X7R 25 V**（原 22 µF 钽 B 型） | C0805 | CC0805KFX7R8BB105（C1854196） |

## §8 接口矩阵

| 接口 | 信号 | 方向 | 电平 | 速率 / 电流 | 保护 / 约束 |
|---|---|---|---|---|---|
| J1（SMA-KE） | AFE 输入 | 入 | ±112 mVpk（50 Ω 端接后） | 10 k~2.5 MHz | `R1` 端接贴座；`D1` Cj≈1.5 pF；`TP1` |
| J3（DC005） | 5 V 直流 | 入 | 5 V | 底板支路 ≈0.3 A 量级（**估算，未验证**；04 §3 旧口径 +0.25 A，背光电流未定） | `D2` SS34 防反；**无过流保护**（§12 R-04） |
| EVK1 排针 40/80 | +5V | 入/出 | 5 V | 核心板 + 底板支路 | 板间 GND 针已占满（O10） |
| EVK1 排针 38/78 | +3V3 | 出 | 3.3 V | 屏/触摸/上拉/LED | 核心板 LDO 自供 |
| J5（30-pin） | 见 §5.1 | 双向 | 3.3 V / 8080 16 bit | FSMC 111 ns/字 | 通孔直插；**禁飞线**（O9） |
| J5.28 | 背光开关 | 出 | 3.3 V 电平 | 栅极级 | 经 `R12` 1 k；**恒亮，禁 PWM**（铁律） |
| J5.24/26/27 | I²C2 + INT | 双向/入 | 3.3 V 开漏 | 100 kHz | `R15/R16` 4.7 k 上拉；**PC5 应为输入** |
| EVK1 调试口 | SWD + SWO + USART1 | — | 3.3 V | — | 核心板排针**随板未焊**（记得补焊） |
| TP1~TP6 | 测试点 | — | — | — | 扫频标定 / 上电自检 |

## §9 电源树与功耗预算

```
J3(DC005) 5V ──► +5V_RAW ── D2(SS34) ──► +5V ─┬─► EVK1.40/80（核心板：MCU + 板载件）
                                              ├─ C16 22µF
                                              └─ R21(0Ω) ─► +5V_A ─► U1(2mA) + D1 钳位 + C11/C14
核心板 LDO(SCJA1117B-3.3) ─► +3V3 ─┬─► EVK1.38/78 ─► J5.30（屏 + 触摸 + 背光）
                                   ├─ C19/C20 100nF
                                   ├─ R11 1k ─► LED1（≈1.3mA）
                                   └─ R15/R16 4.7k 上拉（≈1.4mA）
```

| 轨 | 来源 | 负载 | 估算电流 | 备注 |
|---|---|---|---|---|
| `+5V` | J3 → D2 | 核心板 + 底板支路 | 屏背光未定（**未验证**） | 竞赛电源 ≥1 A，量级充裕 |
| `+5V_A` | `+5V` 经 R21(0Ω) | U1 双运放 + D1 | ≈2 mA | C11 22 µF + C14 100 nF |
| `+3V3` | 核心板 LDO | MCU + 板载件 + J5（屏 IOVCC/VCI + **背光**）+ 上拉 + LED | **背光电流未知** | ⚠️ 14 号 D5/C3：J5 只有 1 根 3V3、1 根 GND，适配板 LED-A 直挂 3.3 V 且无限流电阻 ⇒ **上板前必须实测**（§13 EVT-3） |
| `VBIAS` | VREF 分压（R9/R10） | R2/R5/R7 偏置 | <0.5 mA | ⚠️ 当前图纸未接通（§3.4） |
| `VREF_ADC` | `VREF_CORE` 经 JP3 | R9/R10 分压 + C12 | <0.4 mA | 实测前不知核心板基准是 3.0 V 还是 3.3 V |

## §10 PCB 与结构约束（2 层定稿后的补偿措施）

| # | 约束 | 依据 |
|---|---|---|
| 1 | **AFE 区与 FSMC/屏区物理隔开**；模拟地做**完整铜皮**，单点汇 `EVK1.37` | 2 层无地平面兜底（16 §4-1） |
| 2 | **采样窗静默**（采集的 2.048 ms 内暂停 LVGL/FSMC 刷新与触摸轮询）——**必做** | 机制性消除最大板内干扰源（02 O1，16 §4-1 升级） |
| 3 | **FSMC 33 Ω 串阻**：覆盖 D0~D15 / NE1 / RS / **WR / RD**（20 条；10-02 补 `R40`/`R41`） | 02 O7；**已落图**（`R22`~`R39`；图纸画在 J5 侧是工具限制，**PCB 必贴 MCU 引脚 3~5mm**，见 §19 与 `22 §5`）；13 D11 曾决定不加、16 §4-1 在 2 层定稿后改为必装 |
| 4 | 电感正交摆放、间距 ≥2 mm、下方不走高速线 | 02 O4 / 17 §2.5 |
| 5 | 屏模组**刚性固定**（直插转接板/排母），禁杜邦飞线 | O9 |
| 6 | `TP1~TP6` 测试点落板面；`JP1~JP3` 0 Ω 断点保留 | O3 / O8 |
| 7 | 5 V 入口靠 J3，`D2` 就近；`C16` 就近 +5 V | 入门防护与储能 |
| 8 | 板框/安装孔按屏模组与 SMA 座位置自定（**尺寸未定**，[假设] 按前作量级） | 14/16 号未见尺寸约束 |
| 9 | 上板后必测 `TP4` 噪声底 <0.5 mVrms（进分析带） | 16 §4-1 的验收判据 |

## §11 固件与调试影响

| # | 项 | 现状 | 待办 |
|---|---|---|---|
| 1 | ADC 通道 | `PA1 = ADC1_IN1`（`BOARD_ADC_CHANNEL 1`），SMP=3、ADCCLK 36 MHz、TIM8 TRGO 2.0 MSPS | ✅ 与图纸 `AFE_ADC_IN → EVK1.4` 一致 |
| 2 | 偏置自检 | 图纸 `PC4 = VBIAS` | ✅ **2026-10-02 已收**：`.ioc` + `MX_GPIO_Init()` 改 **输入、不驱动**（原为 `GPIO_Output(TP_RST)` 初始高 ⇒ 会向模拟偏置轨灌电流）；宏 `TP_RST_*` → `VBIAS_SENSE_*`。**不配 `ADC1_IN14`**（加 ch14 进常规序列会改 `TIM8_TRGO + DMA` 采集链）—— "模拟轨在线"改由 **AFE 帧直流均值**判（`bsp_adc_self_check()` + `board_config.h` 阈值） |
| 3 | 触摸中断 | `PC5 = TP_INT`（FT6336 开漏输出） | ✅ **2026-10-02 已改**：`.ioc` + `MX_GPIO_Init()` 改 **输入 + 内部上拉**（顶替外部 4.7k），见 14 号 D3 |
| 4 | 背光 | `PB0 = LCD_BL`，恒亮 | **禁 PWM**（PWM 谐波全落 10~500 kHz 分析带）；`R12` 1 k 只是串阻 |
| 5 | 基准口径 | `BOARD_ADC_VREF_MV = 3000U`（REF3030 标称）；`BOARD_NET_GAIN = 2U` | 上电 30 s 万用表测 `EVK1.2` 对地电压并回填（D4） |
| 6 | 触摸器件 | FT6206(FT6x06) @ 0x38，I²C2 100 kHz，`bsp_touch` 不碰 RST/INT | 上板跑一次 I²C 扫描坐实（0x38 = FT6206(FT6x06) / 0x5D/0x14 = GT911） |
| 7 | 采样缓冲 | DMA 缓冲必须在 SRAM1/2，**绝不放 CCM** | 与硬件无关但同属上板成败项 |
| 8 | 标定 | 17 点频标定吸收带内 LTI 起伏（残差 <0.05 mV） | 标定表落 W25Q128（O5） |

## §12 风险清单

| # | 风险 | 影响 | 概率 | 验证动作 | 截止 |
|---|---|---|---|---|---|
| ~~**R-01**~~ | ~~**P0：`VREF→VBIAS` 链断开**~~ → **已修复（2026-10-01 17:3x，§3.4/§18）** | — | — | 已验证：`floatingPins` 3→0、原生网表成员正确、`bridge-check` 0 问题树、**保存+关页重开**后仍成立 | **已关闭** |
| R-02 | 屏背光电流未知（适配板 LED-A 直挂 3.3 V，J5 只有 1 根 3V3） | 核心板 LDO 过热 / 适配板过流 | 中 | 限流源 3.3 V + 已知串阻测 J5.30 电流；再用 5 V+电阻反解 `Rint`（14 T1） | EVT |
| R-03 | FSMC 串扰/振铃（2 层无地平面兜底） | 判据（mV 级噪声/伪峰） | 中 | **20 只 33 Ω 已落图（§19；10-02 补 `R40`/`R41`）**；上板仍按 EVT-10 测 `TP4` 噪声底 <0.5 mVrms，不达标再降 FSMC 速度（软件已有余量） | EVT |
| R-04 | 5 V 入口无过流保护（03 #15 定了 PPTC，13 D11 又不加） | 可靠性（反插已由 D2 覆盖） | 低 | 拍板：加 PPTC 或明确接受（§15） | 下单前 |
| R-05 | 电感额定电流/线性（若用 0805 叠层） | 判据（THD/IM3 入带） | 低 | `TP3` 注入纯正弦测 THD（17 §8-7）；活体料号已是 CD54 绕线 | EVT |
| R-06 | 核心板基准实际值未实测（3.0 vs 3.3 V） | 判据（幅值标定） | 中 | 上电 30 s 测 `EVK1.2`（D4） | EVT 第一步 |
| R-07 | `.ioc` PC4/PC5 引脚模式与图纸冲突 | 功能（偏置轨被推、I²C 对打） | 高 | 人工改 `.ioc` 后 `fw.py lint` + `build` | 上板前 |
| R-08 | `C12` 22 µF 钽直挂基准输出 | 稳定性（REF30xx 容性负载提示） | 低 | 建议改 1 µF 陶瓷（16 §3.3 已用 datasheet §9.1 原文收口） | 下单前 |
| R-09 | 适配板 IM 档位 / DE-PCLK-VSYNC-HSYNC 接地状态 | 功能（点不亮 / 输入级振荡） | 中 | 断电通断法 30 秒复核（04 §6.8/§6.9） | 上板前 |
| R-10 | 触摸 IC 型号（FT6206(FT6x06) vs GT911） | 功能（固件全废） | 低 | 目视丝印 + I²C 扫描 | EVT |
| R-11 | **多部件 `U1` 使 `sch connectivity` 对 AFE 页报 `duplicate component cmp-U1`** | 流程（自动化回读失败，不是电气问题） | 必然 | 兜底：`sch list --include-pins` + `sch netlist`（本文即用此路）；后续整改元件多部件绑定 | 流程 |
| R-12 | 图纸无标题栏字段 / 无分区声明（`missing-partition`、`titleblock-key-absent`、166 条 `text-overlap`） | 交付规范与可读性 | 中 | 补标题栏与分区框；`text-overlap` 按需消 | 交付前 |
| R-13 | `R6/R7` 料号按厚声编码惯例为 ±1%（17 §7 写 0.1%，**待下单页核对**）⇒ 增益误差可达 ~2% | 判据余量被白吃 | 中 | 核对料号精度；必要时换 0.1% 件，或确认 17 点标定覆盖增益 | 下单前 |
| R-14 | 实物核心板 `VET6`(512 KB) 还是 `VGT6`(1 MB) 未确认 | 固件体积口径 | 低 | 看板面丝印（12 §7 T7） | 上板前 |
| R-15 | 成本/交期/供应链 TBD 与 BOM 三列空缺 | 下单效率 | 中 | 下单前在 EDA 内指定 LCSC 编号后重导 BOM（16 §4-3） | 下单前 |
| R-16 | **J5 脚序 ↔ 适配板丝印未实测**（CS/RS/WR、触摸总线落点、RST 是否共用、DE/PCLK/VSYNC/HSYNC 是否接地） | 功能（点不亮 / 触摸不可用 / 多画少画） | 中 | 断电通断法逐脚核对（04 §6.5/§6.7/§6.9）；见 §13 EVT-14 | 上板前 |
| R-17 | **1.5 mV 峰门限与 17 点标定的先后关系未定**（标定在门限判定前生效 ⇒ 实际门限被抬到 ≈2.8 mV 输入端） | 判据（伪峰漏判/误判） | 中 | 定顺序并写进软件文档；见 §13 EVT-13 | 上板前 |
| R-18 | `PA0` 上 `SW2` 电路是否仍构成模拟侧负载（D1 分叉终判） | 判据（多余负载/干扰） | 低 | 断电测 `PA0` 对地电阻（≈10 k = 有下拉）→ 15 §5-5 | 上板前 |
| ~~R-19~~ | ~~在线工程保存未闭环~~ → **本次已闭环**（`sch save` ×3 页 + `doc reload` + 回读对账通过） | — | — | 保留规矩：**每次改图后都要"保存→关页重开→回读"** | 已闭合（规矩保留） |
| R-20 | **检查器 `dangling-wire`/孤儿 stub 会误报承力线**（PWR 实例：删掉后 `+5V_RAW` 整网消失、3 脚悬空） | 电路被改坏且原生 DRC 未必立刻报 | 中 | 删线前先查**原生网表成员**；优先 `sch disconnect`（线+旗同删）；删后立刻 `sch connectivity` 对账（§3.4/§19 教训 1） | 每次清理时 |
| R-21 | **EVK1 符号的几何守卫误判**：内排引脚（x=510 面向右 / x=1040 面向左）被 `getPrimitivesBBox()` 的**并集框**覆盖 ⇒ 任何新导线都被判 `wire-through-body` 拒绝；原图的老导线是先于该守卫存在的 | 18 条 FSMC 线中有 9 条**无法在 MCU 侧插入器件/重画** | 必然（已实测） | 缓解：阻尼电阻改放 J5 侧（已做）；根治：修 EVK1 符号的两矩形布局或向工具方报 case | 已缓解 |
| R-22 | **`sch destagger` 在本页不可用**（内核拒绝"成员连线树触及非成员器件 pin"，两次都自动回滚） | 标记重叠只能手工/按几何重排 | 必然（已实测） | 已用"240 间距双排 + 重连"把 INT 标记重叠从 97 压到 47（基线 31） | 已缓解 |
| R-23 | **EDA 连接器中途掉线 2 次**（typed 链路 `windows: []`，桥链路仍在） | 保存/校验中断；改动可能只在客户端内存 | 中 | 用"保存→关页重开→回读"闭环 + `daemon health` 巡检；掉线期间改用桥链路保存（已做） | 每次改图 |
| R-24 | **注释"代"累积**：每次会话追加说明而不删旧代 ⇒ 图上多套文字叠加（§20 实测 313 处重叠、含旧口径 `×4/30k/VREF_3V3`） | 图不可读、口径混乱，评审/接板者会照旧值干活 | **必然（不加约束）** | 交付前**逐页渲染目视**；改注释先 `sch text-list` 盘点、改完删旧代（脚本 `_archive/_eda/*_text_clean.py`）；`text-overlap` 计入交付门 | 每次改注释 |
| R-25 | **`sch replace` 不带库器件属性** ⇒ 换料后图上 `Value` 丢失（本次 `R6` 空白） | 图上看不到阻值，装配/调试易错 | 高（换料必现） | 换料后回读 `otherProperty.Value` 并在图上确认；缺则源级补写（§20.2 第 4 条） | 每次换料 |

## §13 验证计划（EVT / DVT / PVT）

**EVT（板到手，限流上电）** —— **前置**：改过图就必须先走完"补线 → 保存 → 关页重开 → 回读网表"闭环（R-19），否则后面的测量对象不是你以为的那张图。

| # | 测试项 | 方法 | 通过标准 |
|---|---|---|---|
| EVT-1 | 静态工作点 | 5 V 限流上电，测 `TP5`(VBIAS) / `U1.1` / `TP4` | VBIAS ≈ VREF/2；`U1.1`≈VBIAS；`TP4`≈VBIAS（不饱和） |
| EVT-2 | 基准实测 | 万用表测 `EVK1.2` 对地 | 记录实测值 → 回填 `BOARD_ADC_VREF_MV` |
| EVT-3 | 背光/3V3 电流 | 限流源供 3.3 V 经 J5.30，测电流 | 不超核心板 LDO 与适配板额定；否则加串阻 |
| EVT-4 | 扫频标定 | 信号源扫 10 k~2.5 M，测 `TP1`/`TP3`/`TP4` | 实测 \|H\| 与 `report_filter_final.md` 偏差 <1 dB |
| EVT-5 | 混叠残留 | 注入 200 mVpp @1.5 MHz，看分析带伪峰 | 伪峰 <1.5 mVpk 门限 |
| EVT-6 | 端接验证 | 断开 `R1`，测 `AFE_BUF_IN` 幅度 | 应翻倍（证明 50 Ω 端接生效） |
| EVT-7 | 增益验证 | 注入 100 mVpp @100 kHz，测 `TP4` | ×7.98 ±2% |
| EVT-8 | 电感线性度 | 纯正弦注入，测 `TP3` THD | 无明显顶部压缩（R-05） |
| EVT-9 | 电源纹波 | AC 耦合测 `+5V_A` | <10 mVpp |
| EVT-10 | **噪声底** | 输入端接 50 Ω，测 `TP4`（进分析带） | **<0.5 mVrms**（16 §4-1 验收判据） |
| EVT-11 | I²C 坐实 | I²C2 扫描 | 读到 0x38（FT6206(FT6x06)） |
| EVT-12 | 屏点亮 | FSMC 初始化后写色块 | 出图正常（04 §6.10 ③：雪花=初始化成功） |
| EVT-13 | 17 点标定表 | 按软件文档 §7 建表 | 残差 <0.05 mV；**同时定清"门限判定 vs 标定"的先后**（R-17） |
| EVT-14 | **J5 脚序通断核对** | 断电蜂鸣档：J5.1/2/3/4/5 ↔ 适配板 `CS/RS/WR/RD/RST` 丝印；触摸总线落点；`DE/PCLK/VSYNC/HSYNC` 对 GND 通断（04 §6.8/§6.9） | 与 §5.1 表逐脚一致；否则改图/改线序 |
| EVT-15 | `PA0` 对地电阻 | 断电万用表 | ≈10 k（有 SW2 下拉）⇒ D1 分叉关闭（R-18） |
| EVT-16 | **33 Ω 阻尼效果**（第二轮新增） | 示波器看 J5 侧数据/控制线边沿过冲（对比 `R.n` 两侧），或直接看 EVT-10 的噪声底 | 过冲/振铃明显减轻；`TP4` 噪声底 <0.5 mVrms |
| EVT-17 | **PPTC 压降与保持电流**（第二轮新增） | 满载测 `+5V_IN`→`+5V_RAW` 压降；短时短路口验证跳闸 | 正常工作不跳闸（Ihold 1 A ≫ 预期 ≈0.3~0.5 A）、压降 <100 mV |

**DVT**：FSMC 全速长稳 2 h（查花屏/丢点）· 触摸连续点按 1 k 次 · 电源 4.75/5.25 V 边界 · 板内干扰复测（LCD 刷新 vs 采样窗静默前后对比伪峰）· 手感/装配（屏模组固定、SMA 插拔）。

**PVT**：**不适用**（单件赛题装置，无量产）。替代动作：交付前一次全量 DRC + 网表对账 + BOM 编号补全（16 §4-3）。

## §14 门控复核（hardware-solution Gate 1~6）

| 门 | 判据 | 结果 | 说明 |
|---|---|---|---|
| Gate 1 需求冻结 | 约束表无空白 / 待确认项有主有期 / 用户确认 | **部分** | 01 §1 15 项齐备；TBD-3/4/5 仍未闭环（无负责人/截止）→ §15 待确认 |
| Gate 2 架构选择 | ≥3 候选 + 理由基于约束匹配 + 用户确认 | **通过（附说明）** | 02 §2 比的是**前端实现路线三案**（有源 SK / 无源无跟随 / 无源+缓冲）；skill 要求的"国产/海外/混合"三档**不适用**（核心板锁定 + 赛题复盘，见 §1 [假设-3]） |
| Gate 3 选型 | 关键件有替代 / 供应链已查 / 参数来自手册 | **部分** | 替代料（OPA2350A、REF3033 第二源）在 03 §1；生命周期与价格 16 §3 已联网查；仍挂：电感**已有具体料号**（`XRCD54-4R7M`/`CD54-220M`/`XRCD54-120M`，活体）但 **SRF/DCR 未逐个对 datasheet 复核**（14 §2 B2）、BOM 三列空缺（R-15） |
| Gate 4 方案输出 | 框图/接口矩阵/电源树/PCB 约束/验证计划齐 + 风险非空 + 三分类 | **通过** | 本文即补齐件（§2/§8/§9/§10/§13/§12/§15）；无占位符（未闭环项一律标"待确认/未验证"） |
| Gate 5 评审 | 独立评审 + CONCERN 已处理 | **通过** | 14 号全链路只读审核 + **本文由独立 `hardware-reviewer` 复评**（五维：Completeness/Risk/Implementability/Cost/Validation，逐条 python 复算 `.enet`）：**P0 与 J5 逐脚表、三页网表、50 位号清单（当时）全部被独立证实**；评审提的 CONCERN 已并入本文（AFE 脚数 98→81、P0 根因改为"未落盘"、J5 待确认项加"未实测"标注、补 R-16~R-19 与 EVT-14/15、EVT-13 补充判据、PWR 孤儿 stub 进 §3.4） |
| Gate 6 模块原理图 | 用户选择展示方式后输出 | **不适用** | 图纸已在 EDA 里落图（比"连接表"更强），用户本次只要**方案文档**，不另出模块图 |

## §15 决策门

**已确定（可据以开工/交付）**

1. 架构：核心板 + 底板；AFE 走无源 LC 8 阶 + OPA2197 逐级缓冲，**增益在滤波之后**。
2. 屏/触摸统一走 `J5` 30-pin（`PCB` 不做，仅原理图）。
3. 底板**不放 LDO、不放背光驱动、不做 IM 配置**；3.3 V 取核心板。
4. 电源网名与拓扑：`+5V_RAW/+5V/+5V_A/+3V3/GND/AGND`（活体网表已核实）。
5. 图纸元件值：L=4.7/22/22/12 µH、C=5.6/10/10/1.8 nF、R6=69.8 k（×7.98）、净增益≈2.0。
6. PCB **2 层**（用户 2026-10-01 拍板）+ 三项补偿措施（§10-1/2/3）。

**待确认（要人拍板）**

| # | 事项 | 选项 |
|---|---|---|
| ~~C-1~~ | ~~**先修 P0 断线**~~ → **已按授权落图修复并验证落盘**（§3.4 / §18） | ✅ 完成 |
| ~~C-8~~ | ~~在线工程**保存闭环**归属~~ → **已由 `sch save`×3 + `doc reload` + 回读对账闭环** | ✅ 完成 |
| ~~C-2~~ | ~~FSMC 33 Ω×N 是否补装~~ → **已落图 18 只（`R22`~`R39`：D0~D15 + CS + RS），图纸统一画在 J5 侧（工具限制，理由见 R-21）——PCB 必贴 MCU 引脚 3~5mm**，每线新增 `LCD_xx_J5` 网 | ✅ 完成（§19） |
| ~~C-3~~ | ~~5 V 入口是否补 PPTC~~ → **已补 `F1`（1 A 保持 / 6 V / 0805），插在 J3 与 D2 之间**，新增 `+5V_IN` 网 | ✅ 完成（§19） |
| ~~C-4~~ | ~~`C12` 22 µF 钽 → 1 µF 陶瓷~~ → **已换 `CC0805KFX7R8BB105`（1 µF 0805 X7R 25 V）** | ✅ 完成（§19） |
| ~~C-5~~ | ~~`R6/R7` 精度 1% → 0.1%~~ → **已换 `RT0805BRD0769K8L`（69.8 k ±0.1%）+ `HoAR0805-1/10W-10KR-0.1%-TCR5`（10 k ±0.1%）** | ✅ 完成（§19） |
| C-6 | 标题栏字段与分区声明是否补（R-12） | ① 补 ② 忽略（本工程内部件） |
| C-7 | 1.5 mV 峰门限与 17 点标定的**先后关系**（R-17） | ① 先标定后判定 ② 先判定后标定 ③ 现状（未明确） |
| C-8 | 在线工程**保存闭环**归属（R-19） | ① 你手工 Ctrl+S 并回读确认 ② 授权我用 `sch save` + 关页重开 + 回读对账 |

### 用户明确"自己后面改"的项（AI 登记、不代改）

| 项 | 内容 | 为什么不由 AI 改 |
|---|---|---|
| **`.ioc` PC4 → 输入、不驱动**（~~`ADC1_IN14` 模拟~~） | 图纸 `PC4 = VBIAS` 自检脚，原先 `.ioc` 是 `GPIO_Output(TP_RST)` 初始高 ⇒ 会与模拟偏置轨对打（R-07） | ✅ **2026-10-02 已改**（用户当场批准 = 工程铁律 R6 的"人批准"）。**改判为不配 ADC 通道**：加 ch14 进常规序列会改 `TIM8_TRGO+DMA` 采集链；"轨在线"改用 **AFE 帧直流均值**（`bsp_adc_self_check()`） |
| **`.ioc` PC5 → `GPIO_Input + Pull-up`** | FT6336 的 INT 是开漏输出，MCU 侧不该驱动（14 号 D3） | ✅ **2026-10-02 已改**（同上批准）。照 `SD_CARD_DET(PD3)` 的既有写法，内部 ~40k 顶替外部 4.7k |

> 两条已分别登记在 §11 第 2/3 行与 R-07；改完请回读 `.ioc` 并跑 `fw.py lint`（改引脚要上板复验）。

**高风险（不验证会影响判据/可靠性）**

| # | 事项 | 截止 |
|---|---|---|
| H-1 | R-01 P0 断线（**阻断上板**） | 上板前 |
| H-2 | R-07 `.ioc` PC4/PC5（**会与图纸对打**） | 上板前 |
| H-3 | R-02 背光电流（可能烧 LDO/适配板） | EVT 第一步 |
| H-4 | R-06 基准实测（决定幅值口径） | EVT 第一步 |
| H-5 | R-03 FSMC 噪声（决定判据能否达标） | EVT |

## §16 证据文件与复现命令

**复现命令（只读回读；本次改图的写入命令见 §18）**

```powershell
$e = 'C:\Users\funiang\.local\bin\easyeda.exe'
& $e doc ls --project ai                                   # 三页 + PCB 清单（★=活动页）
& $e sch list --all-pages --project ai                      # 全板器件/封装/厂商型号
& $e sch list --include-pins --project ai                   # （AFE 页）逐脚网名
& $e sch connectivity --page "INT-核心板与接口" --project ai  # 连接 IR（AFE 页因多部件 U1 会报错，见 R-11）
& $e sch connectivity --page "PWR-电源与背光" --project ai
& $e sch check --page "AFE-前端模拟" --json                  # 逐项 findings
& $e sch netlist --project ai                               # EDA 原生网表 → .easyeda/artifacts/*.enet
& $e sch nets  --project ai                                 # 跨页网名审计
& $e sch drc   --project ai                                 # 原生 DRC（唯一权威验收）
& $e sch status --project ai                                # S1~S6 进度
```

**本次回读留档（本文的唯一事实来源）**

| 文件 | 内容 |
|---|---|
| `_archive/_eda/list_all.json` | 全板 50 位号 + 封装 + 厂商型号（2026-10-01 17:1x） |
| `_archive/_eda/afepins.json` | AFE 页逐脚网名（`sch list --include-pins`） |
| `_archive/_eda/conn_int.json` / `_archive/_eda/conn_pwr.json` | INT / PWR 页连接 IR（器件 + 网络 + 连接点） |
| `_archive/_eda/check_afe.json` / `_archive/_eda/check_int.json` / `_archive/_eda/check_pwr.json` | 三页 `sch check --json` findings |
| `_archive/_eda/net_afe.json` / `net_int.json` / `net_pwr.json` | 三页可读检查报告 |
| `_archive/_eda/live_drc.txt` / `live_nets.txt` / `live_status.txt` / `docls.txt` | 原生 DRC / 跨页网名 / S1~S6 / 工程文档清单（含 `PCB1`） |
| `_archive/_eda/board_truth.md` | 三页器件与网络汇总（脚本 `_archive/_eda/_truth.py` 生成） |
| `.easyeda/artifacts/20261001-171059-schematic_netlist-*.enet` | **EDA 原生网表（判定 P0 的决定性证据）** |

## §17 变更记录

| 日期 | 内容 |
|---|---|
| 2026-10-01 | 首版：按 `hardware-solution`（快速模式）出全板原理图设计方案；三页以**活体回读 + EDA 原生网表**为事实源；**新发现 P0 断线**（`VREF→VBIAS`）与 4 处文档↔图纸不一致；给出 Gate 1~6 复核、风险清单与 EVT/DVT 验证计划。未改图纸、未改固件。 |
| 2026-10-01 | 独立复评（`hardware-reviewer`，五维 + python 逐条对账）后修订：AFE 脚数 98→**81**；P0 根因由"硬编码坐标"改为"**未落盘**（15 §8-1 保存未闭环）"并加"保存-重开-回读"闭环要求；J5 映射中"触摸总线落点 / RST 共用 / CS-RS-WR"补 **未实测** 标注；补 R-16~R-19、EVT-14/15 与 EVT-13 判据、PWR 孤儿 stub 进 §3.4；§3.5 行 B 口径更正为"漏算两个 ×0.5"；补 C-7/C-8 决策项。 |
| 2026-10-01 | **落图实施**（用户授权改图）：修复 P0（`R9.1/R9.2/JP3.1` 三处连接）+ 清理 AFE/PWR 孤儿标记 + 落盘验证 → 详见 §18；§3/§12/§15 数字与状态同步；新增 R-20（删线前必须对原生网表）。 |
| 2026-10-01 | **第二轮落图（"一步到位"）**：① `C12`→1 µF 陶瓷、`R6`→0.1% 69.8 k、`R7`→0.1% 10 k 三处换料；② 5 V 入口插 PPTC `F1`（新增 `+5V_IN` 网）；③ FSMC 18 条线各插 33 Ω（`R22`~`R39`，图纸统一画在 J5 侧＝工具限制、PCB 必贴 MCU 侧，新增 `LCD_xx_J5` 网络）；④ 中途因工具守卫限制导致 INT 页 9 条内排引脚断线 → **用项目文档记载的 `setDocumentSource` 整页回滚**后改在可写侧重做（详见 §19）。终态：DRC 仍 0 致命/0 错误/2 警告；`sch nets` 69 张网无异常；三页 `floating/dangling = 0`。新增 R-21~R-23（工具限制与连接器掉线）。 |
| 2026-10-01 | **第三轮：可读性收口（视觉复核）**——按用户要求**逐页渲染并看图**，发现并修掉"注释多代叠加、`R6` 无值、旧口径文字"等问题：`text-overlap` 313→12、`check` 合计 455→152、注释记录 208→51 条，**电气零变化**；补 INT/PWR 新件说明；新增 §20（含方法、脚本与 4 条教训）。 |

## §18 本次落图实施记录（2026-10-01 17:2x~17:3x，用户授权改图）

> 类型：`硬件/落图`（skill `easyeda-agent` + `easyeda-api`，证 `f647b6de0573`）。
> 现场：内置浏览器 Web EDA，工程 `funiang/ai`（uuid `a45fc8318e214a9f88fbc2f75d4b2884`），V4.1.60，daemon v1.8.1 常驻。

| 步 | 动作 | 命令（要点） | 结果 |
|---|---|---|---|
| 0 | 体检 / 读现场 | `daemon health`、`health`、`project info`、`doc ls`、`sch list --include-pins`、`sch check`、`sch netlist` | 确认三页与活动页、拿到原生网表基线 |
| 1 | 修 P0 | `sch autoconnect --pin R9:1/R9:2/JP3:1`（幂等、pin-aware、硬拒短路） | `VREF_ADC` / `VBIAS` 补齐，`floatingPins` 3→0 |
| 2 | 消新标记重叠 | 先 `sch destagger --apply`（**失败**：内核拒绝"成员连线树触及非成员器件 pin"，自动回滚）→ 改用 `sch disconnect` + `sch connect --direction/--offset` 指定更远桩长 | 标记重叠回到基线 9，无新增 |
| 3 | 清孤儿 | AFE：`prim-delete` 孤儿 stub + `bridge-check` 报的 1 孤儿树 + 1 孤儿旗；PWR：**误删 2 条承力线 → 及时发现 → 用 `sch autoconnect`（3 脚）重建并删掉失联旧标记** | AFE/PWR `danglingWires` 1/2→**0/0**；`+5V_RAW`/`+5V` 网恢复；`bridge-check` 0 问题树 |
| 4 | 落盘闭环 | `sch save` ×3 页（`saved:true`）→ `doc reload AFE` → `doc switch AFE` → 重读 | 三脚仍在目标网 ⇒ **持久化确认** |
| 5 | 复核与留档 | `sch nets`、`sch drc`、`sch netlist`、`project export`、`sch export-image` | 50 网无异常；DRC 5→**2 警告**；产物见下 |

**产物（本次留档）**

| 文件 | 内容 |
|---|---|
| `.easyeda/artifacts/20261001-173457-schematic_netlist-*.enet` | **修复后**原生网表（sha256 `c726d4ef…b42cc7`） |
| `.easyeda/artifacts/20261001-173505-schematic_export-*.png` | 修复后 AFE 页渲染图（5672×1558） |
| `_archive/_eda/afe_chain_fixed.png` | `VBIAS —[R9 10k]— VREF_ADC`、`VREF_CORE —[JP3 0Ω]— VREF_ADC`、`AGND —[C12 22µF]— VREF_ADC` 视觉复核 |
| `_archive/_eda/G2026_board_after_fix.epro2` | **整工程原生快照**（1.93 MB，可回滚/对比） |
| `_archive/_eda/pwr_before_repair.png` / `_archive/_eda/pwr_input_zoom.png` | PWR 输入段修复过程证据（含那次误删的现场） |
| `_archive/_eda/check_afe_after*.json` / `check_pwr_after.json` / `pwr_clusters.json` | 修复过程中间的 findings 与簇几何 |

**S5 校验门（`sch gate`，AFE 页，诚实记录：仍 FAIL）**

```
sch gate: FAIL
  PASS   layout-lint    0 overlap, 0 pin-coincidence, 0 tight, 0 off-grid, …（全 0）
  FAIL   clusters       37 组：2 处组间图元重叠
  FAIL   check          203 finding: 5 error/fatal（全部 pin-exit-direction）
  PASS   bridge-check   0 bridge / 0 orphan-stub / 0 orphan-flag / 0 orphan-tree（51 树）
  PASS   drc            0 fatal, 0 error, 2 warn → native verdict PASS
阻塞项：clusters 2 处组间重叠 · check 的 5 条 pin-exit-direction
```

- 这 **5 条 `pin-exit-direction` 是改动前就存在的**（`R7.2`/`R6.2` 引脚朝下却横向出线、`TP1.1`/`TP3.1`/`TP4.1` 引脚朝左却纵向出线），**不是电气错误**，`drc` 与 `bridge-check` 均通过。
- **本次刻意不动它们**：这 5 根线是**带内信号链的中间段**（不是"引脚→旗"的短桩），要合规就得改走线形态或给内部网命名（`$3N53x` → 具名网），属于**结构性重排**，风险与本轮的收益不成比例（今天已经用 PWR 那两条承力线证明过：动看起来"多余"的线会真断网）。
- 建议作为**独立一轮"图纸规范收口"**做：先 `sch group-move`/`sch modify` 调 TP1/TP3/TP4 朝向，再对 `$3N532`/`$3N533` 两根反馈线做"命名 + 重画"，每步 `gate` 复验。
- 那 2 处组间重叠同理（`sch clusters` + `sch autoplace-free`/`group-move`），不是电气问题。

**未做**（刻意）：无 —— 第二轮（§19）已把 C-2/C-3/C-4/C-5 全部落图；唯一留着的是**用户点名自己改**的 `.ioc` PC4/PC5（§15 末表）。

## §19 第二轮落图实施记录（2026-10-01 17:40~18:05，"一步到位"）

> 类型：`硬件/落图`（skill `easyeda-agent` + `easyeda-api`）。用户授权：最高权限、可随意改图与重构、不必逐一过问。

### 19.1 做了什么

| # | 项 | 器件/网 | 结果 |
|---|---|---|---|
| 1 | **换料：AFE 基准去耦** | `C12`：22 µF 钽(B 型) → **1 µF 0805 X7R 25 V**（CC0805KFX7R8BB105） | `C12.1=AGND`、`C12.2=VREF_ADC` ✅ |
| 2 | **换料：增益电阻精度** | `R6` → **69.8 kΩ ±0.1%**（RT0805BRD0769K8L）、`R7` → **10 kΩ ±0.1%**（HoAR0805-…-0.1%-TCR5） | `$3N532`/`$3N533`/`VBIAS` 连接不变 ✅ |
| 3 | **5 V 入口加 PPTC** | `F1` = PPTCPSMD1006V1A（1 A 保持 / 6 V / 0805），插在 `J3` 与 `D2` 之间 | 新增 `+5V_IN={J3.1,F1.1}`；`+5V_RAW={F1.2,D2.2}` ✅ |
| 4 | **FSMC 18 条线各串 33 Ω** | `R22`~`R39`（0805W8F330JT5E 33 Ω ±1%），覆盖 `LCD_D0~D15` + `LCD_CS`(NE1) + `LCD_RS`(A16) | 每线：`LCD_xx = {EVK1 脚, R.n:1}`、**新增** `LCD_xx_J5 = {R.n:2, J5 脚}` ✅ |
| 5 | 落盘与留档 | 三页 `sch save`（`saved:true`）· 原生网表 · epro2 快照 | 见 19.4 |

### 19.2 走了什么弯路（**必须先看这一段**）

1. **第一次尝试把 33 Ω 放在 MCU（源）侧**：18 只放好、18 条 EVK1 侧旧端口断开后，`autoconnect` 有一半（9 条）被**几何守卫**拒绝：
   `wire-through-body (EVK1): wire segment 0 (510,435)→(540,435) enters component body`。
   **根因（工具误判，R-21）**：EVK1 是双排（P1/P2）符号，内排引脚（x=510 面向右、x=1040 面向左）落在**两矩形并集包围盒**（389.5~1160.5）内部 ⇒ 任何从它们引出的新导线都被判"穿本体"。原图那些老导线**先于该守卫存在**，所以留得住，但**重建不了**。守卫是强制的（`schematic.wire.create` 文档原文："Mandatory daemon geometry preflight … SCHEMATIC_GEOMETRY_INVALID is a failed action"），CLI/typed action **没有** bypass 开关。
2. **"pin 与 pin 重合 / netport 直接压 pin"不算电气连接**（实测：把 `R22.1` 挪到与 `EVK1.36` 同坐标、再在 `R22.2` 上直接放 netport，网表里三者仍是 `None`）⇒ 没有旁门。
3. 于是**整页回滚**（项目文档 10 §5 记载的做法）：从 17:35 的 epro2 快照抽出 INT 页源码（469,533 字符，`R22` 不存在、51 个 `NO_CONNECT`），用 `eda.sys_FileManager.setDocumentSource()` 写回 → **回读确认恢复原状**（3 器件 / EVK1 36 网 / J5 27 网 / `check` 总 132 = 基线值）。回滚前先把"被弄坏的"源码备份成 `_archive/_eda/INT_broken_backup.esch2`。
4. **改在 J5（负载）侧重做**：J5 的引脚在自身符号边缘（x=770/830，bbox 779.5~820.5 之外）⇒ **全部可写**。18 只按"J5 脚 —(`LCD_xx_J5`)— R —(`LCD_xx`)— EVK1 侧"插入，一次批量 54 个连接**全成**（0 失败）。
5. **布局收口**：首版 120 间距单排 → 标记重叠 **97**（基线 31）。`sch destagger` 在本页**不可用**（内核拒绝"成员连线树触及非成员器件 pin"，两次都自动回滚，R-22）⇒ 手工重排（断开标签 → `sch modify` 挪件 → 重连）改成 **240 间距双排**（y=250 九只 / y=100 九只）⇒ 标记重叠 **47**，净增 16，全部来自"J5 30-pin 在 10 单位脚距上多挂 18 个 netport"这一固有拥挤。

### 19.3 第二轮终态（实测）

| 指标 | 值 |
|---|---|
| 原生 DRC（整设计） | **0 致命 / 0 错误 / 2 警告**（与第一轮修复后相同，未被本轮改动破坏） |
| `sch nets`（跨页） | **69 张网**：无同轨异名、无单引脚网 |
| `floating / dangling` | AFE 0/0 · INT 0/0 · PWR 0/0 |
| `sch check` 总数 | AFE 203 · INT 151 · PWR 101（INT 增量来自 18 组新网） |
| 新增网名 | `+5V_IN` · `LCD_D0_J5`…`LCD_D15_J5` · `LCD_CS_J5` · `LCD_RS_J5`（共 19 张） |

### 19.4 产物与留档

| 文件 | 内容 |
|---|---|
| `_archive/_eda/G2026_final_20261001.epro2` | **第二轮终态整工程快照**（1.96 MB，可回滚/对比） |
| `_archive/_eda/G2026_before_33r_v2.epro2` | 33 Ω 动工前快照（回滚点） |
| `_archive/_eda/INT_before_33r.esch2` | 从快照抽出的 INT 页源码（整页回滚用） |
| `_archive/_eda/INT_broken_backup.esch2` | 出问题时的 INT 源码（事故证据） |
| `.easyeda/artifacts/20261001-180216-schematic_netlist-*.enet` | 终态原生网表（sha256 `ff330cfc…ea89f`） |
| `_archive/_eda/spec_33r_v2.json` / `spec_33r_v3.json` / `r_layout.txt` | 33 Ω 批量连接与排布的**参数化源数据**（可复现） |
| `_archive/_eda/relayout_33r.ps1` / `place_33r_v2.ps1` / `restore_int.py` | 本轮脚本（整页回滚法见 `restore_int.py`） |

### 19.5 第二轮教训（已进风险表）

1. **R-21**：EVK1 双排符号的并集 bbox 让 9 条内排引脚不可布线——**工具能力缺口**，不是图纸错误；缓解=把器件放到可写侧，根治=修符号或报 case。
2. **R-22**：`destagger` 在"标记挂在共享导线树"的页面上整批拒绝（两次实测）——别指望它兜底，布局一次做对（宽间距）。
3. **R-23**：typed 连接器在密集写入后会掉线（`windows: []`），本次掉线 **2 次**；桥链路仍在、可用它保存；恢复后**必须重新回读**再继续。
4. **假失败定律再次成立**：批量连接里 3 条报 `connector did not respond / 几何回读失败`，回读后其实**全部落地**（`R22.1/R24.1/R35.1`）——报错先回读，**绝不盲重试**。

## §20 可读性收口（第三轮：**用眼睛看**，2026-10-01 18:10~18:26）

> 触发：用户指出「你没有用视觉来看这些电路的可读性」。此前只做了**电气**核对（网表/DRC/连接性），
> 三页的**图面可读性**从未逐页目视复核过。本轮补上：**渲染 → 看图 → 定位问题 → 改 → 再渲染再看**。

### 20.1 看图看到了什么（这是本文此前缺失的一环）

用 `sch export-image` 出三页整页 PNG（AFE 5672×1552 / INT 5257×2839 / PWR 5001×986），逐页看：

| 页 | 看到的问题 |
|---|---|
| AFE | ① 注释**两代叠加**：同一位置叠着两套说明文字（如 "④ 增益 ×4 与 ADC 驱动" 与 "⑤ 二级增益 ×4 与 ADC 驱动" 同时存在并互相压字）；② 大量**逐字重影**（同一行坐标差 17 单位的两份拷贝）；③ **`R6` 没有值**（换料后 `Value` 属性为空，图上只有位号）；④ 注释里的旧口径：`×4`、`30k`、`VREF_3V3`、`VBIAS_1V65`、`U2(REF3033)`、`J2`、`AFE_ADC_MON` |
| INT | 同类多代注释；另见到已删器件的残留说明（`J2 = 2×4` 等） |
| PWR | 同类多代注释叠加；`③ 背光开关（非恒流）` 标题与说明互压 |

**判据**：`sch check` 的 `text-overlap` 数 = 166 / 69 / 78（三页合计 **313**），与目视一致。

### 20.2 怎么修的

1. **注释盘点**：`sch text-list`（typed，只读）拿全页 TEXT 记录；本次实测文本**没有** create/modify 的 typed action（catalog 里只有 `schematic.text.list` + `schematic.primitives.delete`）⇒ 内容改写走**源级**（`sys_FileManager.getDocumentSource` → 逐记录改 → `setDocumentSource`，即项目文档 07/10 记载的页面源码通路）。
2. **去代规则**（脚本 `_archive/_eda/afe_text_clean.py` / `_archive/_eda/sch_text_clean.py`，可复现）：
   · `fontSize ≥ 16` 的**分区框标题** → 保留；
   · `size < 16` 且以 ①②③… 开头的**标题副本** → 删；
   · 同一槽位（x/80、y/30 网格）的多代注释 → 只留**死名最少**的一条（并列取 zIndex 大者）；
   · 同文重复 → 只留一条；
   · 存活注释里的死名/旧值 → 按页替换表改写（`×4→×7.98`、`30k→69.8k`、`VREF_3V3→VREF_ADC`、`VBIAS_1V65→VBIAS`、`AMS1117→核心板 LDO`、`LED_A→PWR_LED` …）。
3. **补新件的说明**：按新件补了注释（源级克隆样式）——INT 两条（`R22~R39` 33 Ω 的用途与两侧网名）、PWR 两条（`F1` PPTC 与 `+5V_IN → F1 → +5V_RAW → D2 → +5V` 链路）。
4. **补 `R6` 的值**：`replace` 没有把库器件属性带过来（`Value` 为空）⇒ 源级写回 `Value=69.8kΩ / Tolerance=±0.1% / Type / LCSC Part Name`（`sch modify --patch` 对含 `Ω` 的字符串在本机 PowerShell 传参会被吃掉，故走源级）。
5. **再渲染再看**：改完重新出图逐页复看 ✓（`_archive/_eda/view_AFE_clean.png`、`_archive/_eda/view2_0c870c.png`、`_archive/_eda/view2_63acca.png`）。

### 20.3 效果（实测，同一份工程）

| 页 | `text-overlap` | `designator-overlap` | `marker-overlap` | `check` 合计 | DRC |
|---|---|---|---|---|---|
| AFE | **166 → 12** | 5 → 3 | 9 → 9 | **203 → 47** | 0 致命/0 错误/2 警告 |
| INT | **69 → 0** | 4 → 4 | 47 → 47 | **151 → 82** | 同上 |
| PWR | **78 → 0** | 0 | 4 → 4 | **101 → 23** | 同上 |
| 合计 | **313 → 12** | 9 → 7 | 60 → 60 | **455 → 152** | 不变 |

**电气零变化**：三页 `floating / dangling / multi-net / geom-mismatch` 全部仍为 **0**；`sch nets` 仍 **69 张网、无同轨异名**；原生 DRC 不变。文本记录：AFE 98→27、INT 54→14、PWR 56→10。

### 20.4 教训（新增）

1. **电气通过 ≠ 图能看懂**。三页的 DRC/网表早就全绿，但图上"两代注释叠在一起、电阻没有值"这类问题只有**渲染出来看**才发现。⇒ 交付前必须**逐页渲染 + 目视**，不能只跑检查器（检查器只会告诉你"有 313 处重叠"，不会告诉你**哪句是人话**）。
2. **反复改图会累积"注释代"**：每次会话追加一套说明、不删上一套，几轮下来就叠成一团。⇒ 改注释时**先 `sch text-list` 盘点，改完删旧代**。
3. **换料要连带核对显示属性**：`sch replace` 只带位号/uniqueId，**不带库器件属性**——本次 `R6` 因此丢了 `Value`（图上空白）。换料后必须回读 `otherProperty.Value` 并在图上确认。
4. 本机 **PowerShell 传含 `Ω` 的 CLI 参数会被吃掉**（`--patch` 报 invalid JSON / 值不生效）⇒ 中文/Ω 类属性改写走**源级**更稳。

## §21 PWR 页可读性与规范收口（用户授权 B 范围，2026-10-01 11:00~11:20）

> 用户拍板：范围 B（可读性 + 规范收口）；板载指示灯 **删**（`LED1`/`R11`）；供电 DC005 主用（电路不变）；背光实测后按需割板（图纸不变）。

**改动清单（全部落盘，含 save→reload→回读闭环）**

| # | 项 | 结果 |
|---|---|---|
| 1 | 删 `LED1`+`R11`（板载指示灯） | 连带清 3 标记（GND/+3V3 旗、PWR_LED port）+ 3 桩线；`PWR_LED` 网消失 |
| 2 | J3 出线修复 | `pin-exit-direction` 4 条 + `wire-through-body` 1 条 → 0；GND 两脚改"共树单旗"（J3.2 →折线→ J3.3 桩） |
| 3 | 全页旗标规范化 | `reversed-net-flag` 10 → **0**（逐 pin `disconnect`+`autoconnect` 重放） |
| 4 | **分区框**（`frame apply`） | 三个彩色虚线框：① 电源输入与防反接(红) ② 屏接口 I2C 上拉(蓝) ③ 3V3 去耦与 +5V_A(绿)；`missing-partition` **0**；旧 3 个彩色实线 RECT + 4 条旧标题删除 |
| 5 | 注释整理（源级 v3/v5） | 12 删 / 5 改 / 3 增（图外注释归位、+5V_IN 口径更新）；`text-overlap` → 0 |
| 6 | 簇重叠收口 | `clusters` 2 ERROR → **0**：J3.1—F1.1 改**直连**（+5V_IN 变匿名内部节点）、D2 右移 40、F1.2/D2 旗重放 |

**终态（实测）**：`check` **1**（仅 `titleblock-key-absent` INFO）· `clusters` 9 组 0 重叠 · `bridge-check` 0 · DRC 0/0/2（与基线同）· `nets` 68 张无异常 · 逐页渲染目视通过。
快照：`_archive/_eda/G2026_pwr_done_20261001.epro2`（sha256 `04c79ff1…`）。

**本轮新教训（进坑册）**

1. **`setDocumentSource` 是异步的**：写回后**立即** `sch save` 会保存"旧状态"（实测一次"写回 true 但三处改动全没落"）。正确流程：**写回 → 等 ~1s + `getDocumentSource` 复核（比语义不比字节；宿主序列化会造成 `same:false`/长度差）→ 再 save/reload/typed 回读**。
2. **`sch frame apply` 的 `documentId` 与 `--doc` 必须传同一字符串**（uuid 对 uuid），否则 `frame document conflicts with --doc`；标题渲染宽度必须落在框内（超宽拒绝：`rendered title outside module frame`）。
3. **多段折线（≥2 段）不能 `disconnect`/`group-move`**（拒绝文案 `has 3 observed segments, not one`）——先 `prim-delete` 整树重建，或保持单段桩。
4. **`group-move --ids` 单件时"附件"（桩/旗）不随迁**（须逐个列 id）；`--group` 的成员归属**独占**（一个器件不能同时在两个组）。
5. **对脸 pin 的"每 pin 一旗"是结构性冲突**（两旗间距 < 旗长必然互挤）：子网内部节点应改**直连**或**共树单旗**；两 pin 直连的合法性判据 = **两端各自的"第一段"都朝外**（同一直线上可同时满足）。
6. `sch modify` **只对 part 生效**（netflag/netport 改不了旋转，报"仅当器件类型为元件时允许"）；旗朝向的修法只有 `disconnect` + `autoconnect`/`connect`。
7. 源级坐标：**TEXT 的 y 必须写负值**（= -显示坐标）；`sch list` 的引脚编号字段是 **`pinNumber`**。

**未决（已登记）**

- PWR 页图签模板**无可写明细项**（`sch titleblock` 只接受模板已有 key）——"标题栏"目前以**框标题**呈现；如要图签字段需在 UI 换模板。
- 三页**无 sheet 图元**（纸面缺失）：`zone-plan` 按 A4 fallback 校验出纸面（`SheetOverflow`）；`zone-draw` 因此 fail-closed 拒画——本轮改走 **`frame apply`（显式几何，绕开纸面依赖）**。**是否在 UI 给三页设大纸（或接受无纸）待用户拍板**。
- D2（SS34）防反方向：按 symbol/网表初判正确（+5V_RAW→+5V），上板前用二极管档顺路复核。
- AFE / INT 页未动（待续；AFE 的待办清单以 §22 恢复后的实测为准：9 marker-overlap + 16 reversed-net-flag + 1 missing-partition + 框/注释收口；INT 47 marker 重排 + 10 reversed flags + 框）。

## §22 事故与恢复：AFE 页被 PWR 内容覆盖（2026-10-01 11:17~11:27Z / 北京 19:17~19:27）

**事故**：`setDocumentSource` 源级写回（v5/v5b 系列，本意写 PWR 页）的**目标页解析错位**——**AFE 页（`fe840e6f545a2753`）被 PWR 页的完整内容覆盖**（TEXT 11 条、3 个 frame 框、9 器件 + 16 标记，坐标逐项与 PWR 一致；页头 uuid 仍为 AFE）。

**发现路径**：AFE check 报"9 个器件无分区框"（37 器件版应为 38 符号）→ `list` 到的 9 个位号（J1,D1,C1,R1,R2,C2,C3,R3,F2）与渲染画面（出的是 PWR 图）**互相矛盾** → 拉**AFE 页源码**（`_archive/_eda/AFE_suspect.esch2`）比对：**TEXT/框/器件坐标 100% 是 PWR 的** → 定性"AFE 被 PWR 覆盖"。

**恢复**（已验证）：
- 素材：`_archive/_eda/AFE_source_after_clean.esch2`（第三轮终版，77 组件/27 文本/5 框，页头 uuid=AFE）
- 流程：`doc switch AFE` → `setDocumentSource`（527,367 chars）→ 等 1.5s → `getDocumentSource` 复核（`hasU1:true`）→ `save` → `doc reload` → 回读闭环
- 结果：38 位号（37 件全回）· check 回到 AFE 形态（50 条）· 渲染与改前快照同构 · **PWR 复查无恙**（1 条 info）· 全设计 DRC 0/0/2 · nets 68 张自洽
- 留档：保险副本 `_archive/_eda/PWR_rescue.esch2`（PWR 完好证实）；快照 `_archive/_eda/G2026_afe_restored_20261001.epro2`（sha256 `cb7d00cd…`）

**教训（进坑册，最高优先级）**

1. **`setDocumentSource`/`getDocumentSource` 无 `--doc` 保护**（作用于"当前聚焦页"）——密集切页与多条链路交替操作后，"聚焦页"可能≠预期页。**写回前必须**：显式 `doc switch` + `project doc` 确认 + **先存"目标页现有源"作保险副本**；**写回后必须**：`getDocumentSource` 复核**关键标志**（如 `hasU1`），不能只看 `set:"true"`。
2. **`same:false` + 回读长度异常 = "写错目标"的红灯**：v5b 时 `len2=158,622` vs 写入 `158,440` 被误判为"序列化差异"并放行——**那是最早的异常信号，当时追查即可避免覆盖 AFE**。
3. **typed（list/check/text-list）与桥（getDocumentSource）的页路由可能不一致**（同一 uuid 读出不同内容）——**发现矛盾时，以"页源码 + 器件/文字/框三重交叉"判真身**，不以任一单命令为准。
4. 覆盖事故的**检测模板**（可复用）：渲染画面与 `list` 器件集不符 → 拉源 → `_dump_page.py`（TEXT/RECT/COMPONENT 三联）比对坐标族 → 定性。
