funiang-x/G2026/hardware/20-INT原理图诊断与收口-20261001.md

# 20 · INT 页原理图诊断与收口（2026-10-01）

> 对象：工程 `ai` · 页面 **INT-核心板与接口**（doc `63accad121e053cf`）
> 工具：`easyeda` CLI v1.8.1 + `easyeda-agent` daemon(60832) + 连接器 1.8.0 / 宿主 4.1.60
> 证：`f647b6de0573`（`preflight.py 硬件/落图`）

## 1. 本轮已完成（已 `sch save` 固化）

| 项 | 收口前 | 现在 |
|---|---|---|
| `sch check` findings | 82 | **74** |
| `reversed-net-flag` | 10 | **4** |
| `floating pin` | 0 | **0**（中途拆旗产生的 10 个浮空脚已全部补回） |
| `marker-overlap` | 47 | 45 |
| `wire-through-body` ERROR | 19 | 19（被阻塞，见 §3） |

做法：
1. 拆掉 10 条反挂旗后按**正确朝外方向**重连 6 个体外引脚：`EVK1:37/39`@x370、`EVK1:78/80`@x1180、`J5:29/30`@y965。反挂旗 10→4。
2. 4 个**内侧脚**（`EVK1:38/40`@x510、`EVK1:77/79`@x1040）typed 无法落地，改由**源级写回**按改动前快照原样回填旗+桩，保住连通性（floating=0）。
3. 踩坑记录：**源快照必须在最后一次写操作之后重新拉取**。本次 `INT_work2` 是断旗后拉的，回填时把随后 6 次重连一并回滚，已重做。

## 2. 根因一：EVK1 符号本体罩住内侧引脚列（阻塞 19 ERROR + ≈40 叠旗）

`EVK1` = `LCKFB-LSPI-SkyStar-STM32F407VGT6-PRO`@(780,515)，Device `5064d5360e2055fe`（立创公共库，无项目内符号副本）。

引脚分布（实测）：左列 **x=370**（外）与 **x=510**（内）；右列 **x=1040**（内）与 **x=1180**（外）。

在 `EVK1:38`(510,425) 上做定向实验，`connect` 预检同时返回两条 ERROR：

```
pin-exit-direction : pin 38 outward rotation 0° requires its first wire segment to leave outward
                     segment 0 (510,425)->(480,425) does not
wire-through-body  : wire segment 0 (510,425)->(480,425) enters component body
                     （原桩 (510,425)->(540,425) 同样被判进本体）
```

即：**往右、往左都被判进本体** —— 符号的大矩形/实拍图把 x510 与 x1040 两列整列罩住，这两列上的**任何**桩线都不合法。x370 / x1180 两列在体外，所以它们的桩线正常。

⇒ 19 条 `wire-through-body` 与约 40 条 `marker-overlap` 都是这一根因，**靠挪端口/改桩长修不掉**。

**处置建议（未执行）**：为 EVK1 另建一个符号变体（去掉/缩小罩住内侧列的那块图形），再 `sch rebind-symbol` 事务式换绑（候选先建后读、回读绑定与 `uniqueId`、失败看 `phase`）。注意立创**系统库不可写**，须在项目库建副本。

## 3. 根因二：R22–R39 串阻阵列节距不足（15 处簇 ERROR）

实测中心坐标：

- 行1（y=250）：`R22`=400、`R23`=520、`R24`=880、`R25`=1120、`R26`=1360、`R27`=1600、`R28`=1840、`R29`=2080、`R30`=2320
- 行2（y=100）：`R31`=400、`R32`=640、`R33`=880、`R34`=1120、`R35`=1360、`R36`=1600、`R37`=1840、`R38`=2080、`R39`=2320

每颗的簇"体积"宽 **267–297**（本体仅 21，其余是两端的标记与桩线），而节距 **240**（`R22↔R23` 仅 120）→ 相邻体积互压 21–39，且两段桩线在**同一 y 上共线相遇**（潜在并网隐患，属真实缺陷而非纯视觉）。

**处置建议（未执行）**：把两行节距拉到 **≥300**（按 300 重排中心：400/700/1000/…/2800），用 `sch group-move`（带线刚移，附件自动随行）逐级右移后缀成员；**不可用 `sch distribute`** —— 它只挪器件不带线，会把桩线拉断。

## 4. 其余待办

- `designator-overlap` 4 条：`R23`、`R22`、`R12`×2 —— 位号压本体/他件，可随 §3 重排一并解决。**（2026-10-01 晚更新：R22/R23 两条已随 §3 重排消失，剩 `R12`×2，见 §6）**
- `missing-partition` 1 条：本页 21 个器件无功能分区框，需 `sch zones set` → `sch zone-draw`（整纸 `--mode partition`）。
- `titleblock-key-absent` 1 条 INFO：图签模板无 `Name`/`Drawed`/`Description` 可写项，无法消除。

## 5. 本轮相关文件

- 源快照：`_archive/_eda/INT_work1.esch2`（改动前）、`_archive/_eda/INT_work2.esch2`、`_archive/_eda/INT_work3.esch2`（当前）
- 脚本：`_archive/_eda/_int_dump.py`（findings 分类）、`_archive/_eda/_int_geo.py`（wire-through-body 全文 + 构件）、`_archive/_eda/_int_fill.py`（4 个被罩脚的回填）、`_archive/_eda/_p2.py`/`_archive/_eda/_p3.py`（引脚与网名）、`_archive/_eda/_int_arr.py`（阵列中心/附件）
- 渲染：`_archive/_eda/int_evk1.png`（EVK1 符号本体）

## 6. 第二轮（2026-10-01 晚）：② 完成落盘；① 备料完成、换型被宿主挂起

### 6.1 ② 串阻阵列重排 —— 已完成并 `sch save` 落盘

- 实测中心（活体 `sch list`）与 §3 一致：行1(y=250) `R22`=400、`R23`=520、`R24`=880…`R30`=2320；行2(y=100) `R31`=400…`R39`=2320。
- 做法：每颗一颗持久虚拟组（`sch group create --members Rxx`）→ `sch group-move --group gN --dx <Δ>` 按目标位**从右到左**逐颗刚移（桩线+两端口 netport 自动随行、导线按原桩长重建）；完成后 `sch group ungroup` 全部解散（不留假"功能模块"）。
- 结果：18 颗全部落在 400/700/1000/…/2800（300 节距），逐脚网名与动手前完全一致；`bridge-check` 0 桥/0 孤儿；`sch check` **74→55**（marker-overlap 45→28、designator-overlap 4→2）；`sch clusters` **16 ERROR → 1 ERROR + 1 WARN**（剩 R12↔EVK1 本体重叠，随 ① 消失；R22↔R23 gap=3 仅 WARN，§3 预期内）。
- 事故与修复：`R25/R34/R35` 三次撞上 bug #256（`sch modify` cmdKey 假失败，器件未动）；`R34` 的恢复段误清了 `EVK1:30` 与 `R35:1` 的 `LCD_D13` 桩/旗，`R34:1/2`、`R35:1` 断连。修复：typed `doc open` 后重试 group-move + `sch connect --pin … --kind netport` 补回（R34:1→LCD_D12、R34:2→LCD_D12_J5、R35:1→LCD_D13，方向/offset/rotation 与原桩一致），并删除重连过程中堆叠出的 4 只重复 netport（`sch prim-delete`，回读证实 4/4）。
- **遗留 1 条 floating-pin（EVK1:30→LCD_D13）**：其桩/旗被上述事故清掉，而补连被本体守卫拦（正是 ① 的根因）；① 换型成功后一条
  `easyeda sch connect --pin EVK1:30 --kind netport --net LCD_D13 --direction right --offset 30` 即可补上。

### 6.2 ① 根因再证实（比 §2 更精确）

- 19 条 wire-through-body 的判定域 = **符号图形并集 bbox**，不是逐图形：EVK1 符号实为「左右两个红色框(390..490 / 1060..1160 × ~400..635) + 中央板照(660..868 × 364..675)」（渲染 SVG 实测），被标记的 19 段导线 (510→540 / 1000→1040)**不与任何图形相交**，但落在三块图形的并集 bbox 389.5..1160.5 × 364..675 内。marker-overlap 里 19 条「EVK1(part) 与 XXX 视觉重叠」同源。
- 推论：**保留左右两个框 + 内侧列布线在几何上不可能**（并集 bbox 必然横跨两列）；变体只能放**一块中部矩形**（页坐标 x 600..950 × y 400..660，与两侧禁入带 [510,580.5]/[969.5,1040] 各留 ≥19.5）。

### 6.3 ① 已备料（团队库 `61e7264a-d363-47f1-8959-7d655265dee2`，EA_AGENT 命名空间）

- 符号变体 `EA_AGENT__LCKFB_LSPI_SKYSTAR_STM32F407VGT6_PRO`：uuid `629182eb-654b-433c-babe-4161102ee1ac`，由 `lib symbol create` + `lib symbol build` 生成：**84 只引脚逐脚按活体坐标（局部 = 页坐标 −(780,515)，rotation/length=20/shape=None 一致），唯一图形 = 中部矩形**（规格 `_archive/_eda/evk1_variant_spec.json`，build 回执 `verified:true`）。
- 封装副本：原 `COMM-TH_…`（系统库 `b957aa5d-…`）已由 device create 自动无损复制为团队库 `f6aa69ad-c691-45fe-b7f2-d30c3c0b34ca`。
- 自有 Device `EA_AGENT__…`：uuid `101e7ecb-c6eb-4198-92c3-63a95d19135c`（符号=变体、封装=副本、BOM 身份照抄 C32710423）。
- 顺带修正：EVK1 实例原先 `supplierId="…-PRO.1"`，已改为真实 **C32710423**（器件在系统库唯一，`lib by-lcsc` 证实）；重放后回读一致。

### 6.4 ① 阻塞点与已验证的恢复路径

- `sch rebind-symbol`（带 `--symbol-uuid`）在 `bind-device-association` 阶段失败：系统库设备只读、`lib_Device.modify` 返回 false，事务**在动画布前**安全回滚。
- 改走 `sch replace`（自有 Device）时，**删除步落地、重建步挂起**：宿主对「放置团队库自建设备」连续 4 次无响应（replace×2、place×2），同期放置原系统库器件（C32710423）两次都正常——嫌疑指向跨库 3D 模型引用/副本封装加载，未定论。
- 期间两次整链恢复均成功（删除→原器件原位重放→补 `uniqueId=gge4`），当前页面：EVK1=原符号原样（primitiveId `11435cf8-3b7f-20dd`，位号/坐标/C号/uniqueId/84 脚与基线一致，100 段导线全在），② 全部落盘。
- **待人在场重试（一条命令）**：
  `easyeda sch replace --project ai --doc 63accad121e053cf --id 11435cf83b7f20dd --device-uuid 101e7ecbc6eb419892c363a95d19135c --device-lib 61e7264ad36347f189597d655265dee2`
  成功判据：回执 `pinDiff` 为空（变体 84 脚与原符号逐脚同位）→ `sch check` 应余 0 wire-through-body、marker-overlap 28→9、floating-pin 0（补 EVK1:30 后）、clusters R12↔EVK1 消失 → `sch save`。
  失败恢复（已演练两次）：`sch place --lib 0819f05c4eef4c71ace90d822a990e87 --uuid 83522c3a8f3449db8f1333db69020001 --x 780 --y 515 --designator EVK1` → `sch modify --id <新pid> --patch '{"uniqueId":"gge4"}'`。
  注：若仍挂起，先在 EDA 窗口前台确认有无卡住的「器件标准化/另存为」弹窗（连接器对话框自动点击在后台标签页会被节流），或重启 EDA 宿主后重试。

### 6.5 第二轮证据文件

- 基线/对账：`_archive/_eda/int_list_live1.json`（②前）、`_archive/_eda/int_list_live4.json`（②后）、`_archive/_eda/int_check_live1.json`、`_archive/_eda/int_check_after2.json`、`_archive/_eda/int_check_final.json`、`_archive/_eda/int_clusters_live1.json`、`_archive/_eda/int_clusters_after2.json`
- ② 过程：`_archive/_eda/int40_arr_create.ps1`、`_archive/_eda/int40_arr_move.ps1`、`_archive/_eda/int40_arr_moves.log`、`_archive/_eda/int40_arr_ungroup.ps1`
- ① 备料：`_archive/_eda/_int53_spec.py`、`_archive/_eda/evk1_variant_spec.json`、`_archive/_eda/evk1_build1.json`、`_archive/_eda/evk1_sym_get.json`、`_archive/_eda/evk1_dev_orig.json`、`_archive/_eda/evk1_dev_new.json`、`_archive/_eda/evk1_rebind1/2.json`、`_archive/_eda/evk1_replace1/2.json`、`_archive/_eda/evk1_place_orig*.json`、`_archive/_eda/evk1_uid*.json`
- 判据/渲染：`_archive/_eda/_int40d.py`（并集 bbox 判据）、`_archive/_eda/_int41_svg.py`/`_archive/_eda/_int41b_img.py`（符号图形坐标实测）、`_archive/_eda/_int50_diff.py`/`_archive/_eda/_int56_lost.py`（逐脚对账）、`_archive/_eda/int_final_page.png`（终态整页渲染）

## 7. 第三轮（2026-10-02）：按模块排版（3 区认领 + owned 分区框）

> 目标：INT 页像 AFE/PWR 一样「按模块排版」——功能模块各自成区、有分区框与标题、区内自洽。
> skill：本轮补齐了 `easyeda-schematic-net-fanout`（落图/分区框正牌规程，**前两轮漏装**）与 `easyeda-viewer`；按其「开工前置·五问」执行（先列 scripts、写前落工程快照、DRC 为唯一权威）。

### 7.1 结果（前后同表）

| 项 | 改前 | 改后 |
|---|---|---|
| `sch check` | 55（含 `missing-partition` 1） | **54**（`missing-partition` **0**） |
| `sch clusters` | 1 ERROR + **1 WARN** | **1 ERROR + 0 WARN**（tight 已消） |
| `sch layout-score` | 56.9 fair | **85.9 good**（folded 100 / 反贴 100 / 长链 92 / 版面整洁 76 / 反向 60） |
| 分区框 | 2 个手画实线 RECT（规则不认） | **3 个 owned 虚线框 + 中文题注**（`frame check` verified / unchanged:3） |
| 模块认领 | 无 | **3 个**：`mod1_core_evk1`(EVK1,R12) / `mod2_display_touch_j5`(J5) / `mod3_fsmc_series_r`(R22–R39) |
| 网表 | — | **逐脚 0 差异**（`_archive/_eda/int81_verify.py`）；`bridge-check` 0 桥/0 孤儿；`drc` 0 致命 0 错 |
| `sch gate` | — | layout-lint PASS / bridge PASS / **drc PASS**；FAIL 两项=R12 簇重叠 + 18 条 wire-through-body（均留档） |

形状：`int-f1` 140..1310 × 340..830（① 蓝 #1F5FA9）· `int-f2` 500..1360 × 930..1450（② 绿 #1F7A3D）· `int-f3` -40..2900 × 60..300（③ 橙 #B7791F）；三框互不重叠、框内包住成员器件/引脚/导线/旗/位号/必检文字（含 ①② 的三行注释、③ 左侧两条串阻说明），框间留白 40~100。

### 7.2 做法（全 typed，可复现）

1. 写前整工程快照：`easyeda project export-source --uuid a45fc831… --out _archive/_eda/G2026_r4_20261002.epro2`（1.96 MB）。
2. 阵列节距修正（消 `R22↔R23` tight gap=3）：两行各自一个持久组 → `sch group-move --dx 40`（组员桩线+两侧 netport 自动随行）→ 解散。**R29/R30 撞 bug #256**（`sch modify` cmdKey 假失败，Row1 停在 R28 后），按规程「新鲜回读 → `doc open` → 重试」补移到位；期间产生 1 只重复 `LCD_RS` netport（2800,100），按工具建议 `sch prim-delete dee6eb319fdc63fa` 清掉。
3. 建 3 个模块认领组（虚拟组=功能模块，`sch group create`）。
4. 删旧 2 个手画 RECT + 2 条旧题注（`sch prim-delete`，回读证实 4/4）；`sch frame apply --from _archive/_eda/int_frames.json` 落 3 个 owned 框；`sch frame check` → verified/unchanged:3。
5. `sch save`（saved:true）→ `sch export-image` 整页渲染 `_archive/_eda/int_layout_after.png` 目视复核。

### 7.3 本轮**收不掉**的项（typed 能力边界，已实测钉死，附证据）

| 项 | 根因（实测） | 影响与选项 |
|---|---|---|
| **自由文字移动/新建** | `schematic.text.list` 只配 `primitives.delete`（action 目录原文）；`sch group-move --ids <textId>` → 「none of the 1 id(s) resolved to a component, flag, or wire」；`sch modify --id <textId>` → 「Failed to read component」 | 注释**不能归位**、模块群**不能整体位移**（① ② 被各自注释锚定）⇒ 改由「框去包住注释」达成 | 
| **③ 阵列折回 3×6** | 折回顶行 y=400 的端口文字带（至 y≈455）与 ① 带（340..830，被注释锚定不能上移）在 x 320..1270 相交 ⇒ 框必互压；腾挪只能靠移动被锚定的块 | 按方案逃生条款**保二维原样**（行内节距已锁 300，R22 段已拉开） | 
| **R12 位号错位 ×2 / R12↔EVK1 簇重叠 ERROR** | R12 右端 `(340,555)` 与 EVK1 引脚是**同一条 3 点导线**（x320..370），单独搬 R12 会撕线；位号位置无 typed 入口；R12 右端口文字嵌在 EVK1 的 x=340 端口列里 ⇒ 簇体积必然相交 | 留档。选项：(a) 授权一次源级文本/位号写入；(b) 人工在 EDA 里挪一次；(c) 接受该 WARN 级观感 | 

### 7.4 留白（同 §6.4，未动）

- **① EVK1 符号换型**（一条 `sch replace`，见 §6.4）——`wire-through-body` 18 条、`marker-overlap` 28 条与其同源。
- **4 条反挂旗**（EVK1 内侧脚 38/40/77/79）与 **EVK1:30 补连**：均被符号本体 bbox 守卫拦，① 完成后各一条 typed 命令即可（`sch disconnect` → `sch connect --direction …`；`sch connect --pin EVK1:30 --kind netport --net LCD_D13 --direction right --offset 30`）。
- `titleblock-key-absent` 1 条 INFO：图签模板无 `Name`/`Drawed`/`Description` 可写项，无法消除。

### 7.5 第三轮证据文件

- 契约/草案：`_archive/_eda/int_frames.json`（3 框，schemaVersion:1）· `_archive/_eda/int_layout_plan.json`（版式草案 + 折回否决依据 + blocked 清单）
- 基线/改后：`_archive/_eda/int_list_base.json`/`int_list_v2.json` · `int_check_base.json`/`int_check_after_layout.json` · `int_clusters_base*.json`/`int_clusters_after_layout.json` · `int_score_base.json`/`int_score_after.json` · `int_frames_check.json` · `int_bridge_after.json`
- 脚本/日志：`_archive/_eda/int70_env.py`（模块包络实测）· `int71_r12.py`（R12 共享结点取证）· `int72_74_clu*.py`（簇成员）· `int80_move.ps1`/`int80_move.log` · `int81_verify.py`（逐脚对账）· `int82_fix2930.ps1`/`.log` · `int83_del.json` · `int84_frame_apply.json` · `int85_newfind.py`
- 备份/渲染：`_archive/_eda/G2026_r4_20261002.epro2`（写前整工程快照）· `_archive/_eda/int_layout_after.png`（改后整页）
- 环境事实：`easyeda-viewer` 脚本在位（`~/.ai-skills/easyeda-viewer/scripts/viewer.py`）但**本体未安装**（`~/easyeda-viewer` 不存在、无 dist）⇒ 离线无头渲染本轮不可用，视觉证据用在线 `export-image`。

### 7.6 经验（已并入 skill 台账 T-55~T-62）

1. **自由文字在 easyeda-agent typed 面里是「只读+可删」**：`text.list` 配对的是 `primitives.delete`；`group-move --ids` 不认 text、`modify` 读不到 text。⇒ 只走 typed 时布局规划必须**把注释当固定锚点**。（**api 链路可改**：`sch_PrimitiveText.modify(id,{x,y,content})` 实测可用——见 T-54/T-63，两条链路能力不同。）
2. **`missing-partition` 只认 owned 框**：手画 RECT 不算（本轮之前该页带 2 个 RECT 仍报 1 条）；`sch frame apply` 后即 0。
3. **group-move 大组会撞 bug #256 后中途停**：8 件一组移动时若第 6 件失败，**后续成员不动**且恢复段会重建整组桩线——必须回读逐件核位，缺的按「fresh read → doc open → 重试」补（本轮 R29/R30）。
4. **恢复段可能留下重复 netport**：`sch check` 的 `duplicate-net-marker`/`redundant-net-marker` 会点名 `suggestDeleteIds`，照删即可（本轮 LCD_RS@2800）。

## 8. 第三轮·下（2026-10-02 同日，授权后）：api 链路手术 + ① 再试与恢复

> 授权：「给你全部权力放心做」⇒ 启用 **easyeda-api 桥**（49620，`edaConnected:true`）做 typed 面做不到的两件事，并把可独立收口的项一次收干。

### 8.1 最终结果（同一页，接 §7.1）

| 项 | 轮初 | §7 结束 | **本轮结束** |
|---|---|---|---|
| `sch check` | 55 | 54 | **45** |
| ├ `missing-partition` | 1 | 0 | 0 |
| ├ `designator-overlap` | 2 | 2 | **0** |
| ├ `reversed-net-flag` | 4 | 4 | **0** |
| ├ `floating-pin` | 1（49 脚） | 1（49 脚） | **0**（见 §8.6） |
| ├ duplicate/redundant-net-marker | 0 | 0 | 0 |
| └ 余下 | — | — | **19 wire-through-body + 25 marker-overlap + 1 titleblock-INFO（全部 ① 同类几何噪声或 INFO；pin30 补出的 2 条属此列）** |
| `sch clusters` | 1 E + 1 W | 1 E + 0 W | **0（PASS）** |
| `sch layout-score` | 56.9 fair | 85.9 good | **94.9 excellent** |
| `sch drc` | 0/0/7 | 0/0/7 | **0 致命 / 0 错 / 6 警** |
| `sch gate` | — | FAIL×2（clusters+check） | **layout-lint / clusters / bridge-check / drc 全 PASS，仅 check(①) FAIL** |
| 网表 | — | 0 差异 | **0 差异**（重载后复读仍 0） |

### 8.2 R12 根治（新范式：**按名互连**，与 R22–R39 一致）

- **实测根因**：R12 的右端口 `(340,555)` rot=180，其长标签 `LCD_BL_PB0` **反向挂进** R12 本体/位号区（`designator-overlap` bbox 重叠 12.84×8），同时它与 EVK1 引脚**共享同一条 3 点导线**（`8bc74de65d0c0bb0`，x320–370）⇒ `R12↔EVK1` 簇体积必然相交（那 1 条 cluster ERROR）。
- **动手前先量符号**：EVK1 内部图形（从 `evk1_live.svg` 取真实坐标）＝ H1 块 x390–490 / 照片 x660–868 / H2 块 x1060–1160；左列引脚 x=370（标签带 x295–340）。⇒ 空位在 H1 左侧。
- **做法**：`sch disconnect R12:1/R12:2`（R12:2 因合并线被拒 → `sch prim-delete` 合并线 + 旧端口）→ `sch modify --x 240 --y 590` → `sch connect` 三处：R12:1→`LCD_BL_CTL`(左)、R12:2→`LCD_BL_PB0`(右)、**EVK1:11→`LCD_BL_PB0`**(左, offset 30)。
- **电气等价证明**：改后逐脚网名与基线 **0 差异**；`sch bridge-check` 0 桥/0 孤儿；簇 ERROR 消失；两条 designator-overlap 归零；marker-overlap 28→24。
- 关键认识：**串联器件两端各挂净标签**（不拉实体长线）是本页阵列的既有范式；R12 采用同一范式后，「共享结点」这一整类问题（簇重叠/位号压字）自然消失。

### 8.3 4 条反挂旗（EVK1:38 / 40 / 77 / 79）修复

- **typed 路径不可用**（实测）：`sch connect` 被几何守卫拦 —— `wire-through-body ERROR: wire segment (510,425)→(540,425) enters component body`。**存量桩被容忍、新增桩被拒** ⇒ 这正是 ① 的判定式根因。
- **改走官方 API（skill 正文 Step 5 配方）**：`eda.sch_PrimitiveComponent.createNetFlag(kind, net, x, y, rot, false)`，**旗旋转按检查器要求**：API 传 `rot=90` → 检查器读 `270`（两者差 180，实测标定：探针旗验证后删除）。
- 结果：`reversed-net-flag` 4 → **0**；`drc` 警告 7 → 6。
- 中间态无损失：删除旧旗后曾短暂出现 4 脚无网名，按上法重建后回读四脚净名（GND/GND/+3V3/+5V）+ 逐脚网表 0 差异。

### 8.4 ① EVK1 符号换型：再试 → 失败 → **完整恢复**（页面等价）

- 命令同 §6.4。回执：`DISPATCH_FAILED: connector did not respond (context deadline exceeded)`。
- **按假失败规程新鲜回读**：EVK1 **已被删除**（parts 21→20），重建步挂起——与 §6.4 同一失败模式（第 3 次复现）。
- **恢复（§6.4 已演练路径，1 次成功）**：`sch place --lib 0819f05c… --uuid 83522c3a… --x 780 --y 515 --designator EVK1`（回执 ok:false 但 `actionResult` 显示已建、几何守卫仅报存量 finding）→ `sch modify --id c5c8741a896a14ee --patch '{"uniqueId":"gge4"}'`。
  - ⚠ **PowerShell 引号坑**：`--patch '{"uniqueId":"gge4"}'` 会被吞成 `{uniqueId:gge4}`（报 `invalid --patch JSON`）；须用 `--patch '{\"uniqueId\":\"gge4\"}'`。
- **恢复后自证**：84 脚 / 35 有网名脚（= 84−49 悬空）/ `uniqueId=gge4` / 逐脚网表 **0 差异** / `sch save` + `doc reload` 后复读一致。
- 结论：**① 仍受宿主「放置团队库自建设备挂起」阻塞**（本轮为第 3 次）；其余可达项已全部收口。

### 8.6 EVK1:30 → LCD_D13 补连 + 48 个声明未用脚打 NC（`floating-pin` 归零）

- **定性**：`floating-pin` finding 当时是「49 个引脚悬空（无导线连接，未打 NC 标识）」。按设计表拆开看：84 脚 = 已连 35 + **真缺口 1（EVK1:30）** + 声明未用 48 ✓（`18-全板原理图设计方案.md:286` 记 `J5.19 ↔ EVK1.30(D08) ↔ PD8 ↔ FSMC_D13`；`hardware/20` 旧文亦记「EVK1:30→LCD_D13 桩被 R34 事故清掉」）。
- **补 pin30**：typed `sch connect` 被本体守卫拦（T-59）⇒ 走官方 API：`sch_PrimitiveWire.create([510,465,540,465],'')` + `sch_PrimitiveComponent.createNetPort('BI','LCD_D13',540,465,0,false)`；回读 rot=0/x=540/y=465 ✓（netport 的 rot 无 netflag 那种 180 偏移）。
- **打 NC**：`easyeda sch no-connect --designator EVK1 --pin 41,45,…`（48 脚，一次命令，回执 `noConnected:true, notApplied:[]`）。
- **对账**：逐脚网表与基线**唯一差异 = `EVK1 pin 30 '' → 'LCD_D13'`**（即这处修复本身，其余 0 差异）；`floating-pin` → **0**；`clusters` 仍 0；`bridge` 0/0。
- **代价（明记）**：pin30 新桩带来 1 条 wire-through-body + 1 条 marker-overlap（桩落在符号体内，属 ① 同类噪声）——电气正确性优先于几何噪声，① 换型后自然归零。

### 8.5 本轮证据文件

- 手术：`_archive/_eda/int99_restore.py`、`_archive/_eda/int99e_fixflags.py`（旗重建）、`_archive/_eda/int99d_probe.py`（rot 标定）、`_archive/_eda/int99_rot2.py`、`_archive/_eda/int99b_rot.py`
- ① 与恢复：`_archive/_eda/int95_replace.json`、`_archive/_eda/int96_place.json`、`_archive/_eda/int97_uid.json`、`_archive/_eda/int_list_v4/v5/v6.json`
- 终局：`_archive/_eda/int_check_final3.json`、`_archive/_eda/int_clusters_final3.json`、`_archive/_eda/int_bridge_final3.json`、`_archive/_eda/int_score_final.json`、`_archive/_eda/int_final_v3.png`
- pin30/NC：`_archive/_eda/int9b_pin30.py`、`_archive/_eda/int9c_nc.json`、`_archive/_eda/int_check_final4.json`、`_archive/_eda/int_clusters_final4.json`、`_archive/_eda/int_bridge_final4.json`、`_archive/_eda/int_final_v4.png`（终态整页）
- 备份：`_archive/_eda/G2026_r4_20261002.epro2`（R12 术前）、`_archive/_eda/G2026_r4b_afterR12.epro2`（① 术前）
- 探针脚本：`_archive/_eda/int90_texts.py`（全页 TEXT + 器件几何，走桥）、`_archive/_eda/int91_h1h2.py`（符号内部图形坐标）
