funiang-x/G2026/hardware/22-屏接口抗干扰评审与布局要点.md

# 22 · 屏 8080 并口：抗干扰评审与布局要点（2026-10-02）

> 范围：**原理图评审 + 落图收口**（不含 PCB 作业）。评审目标是"电路可工作 + 抗干扰"，
> 触发事实是台面实测的**信号完整性问题**（下 §1）。
> 依据：活体 EDA 工程（`INT`/`PWR`/`AFE` 三页）+ 几何对账（自建脚本，判据同 `easyeda-sch-audit-fix`）
> + **EDA 自身 DRC**（唯一权威）。
> 本轮改动**两次落图**：① J5 就近去耦 `C21/C22`；② `WR`/`RD` 补源端阻尼 `R40/R41`。

---

## 0. 结论速览

| 项 | 结论 |
|---|---|
| DRC（全程 = 基线） | **致命 0 / 错误 0 / 警告 2 / 信息 2**，警告仅"器件标准化"一类（既有可接受口径） |
| 20 路源端串阻 | **全部正确串接**，无被两端同名旗标并网短路（判据 1b 三页全"无"） |
| 更新 1 | **J5 就近去耦 `C21`(10µF) + `C22`(100nF)** —— 原图**确实缺**（全工程零记载） |
| 更新 2 | **`WR`/`RD` 补 33Ω**（`R40`/`R41`）—— 原先这两根是**直连**，无阻尼 |
| 现在仍直连 | 只剩 `LCD_RST` 一根（低频、上电一次，**无需**阻尼） |
| 遗留（需人判） | 上板后目视复核屏显（颜色/方向）；~~`PC5(TP_INT)`/`PC4` 的 `.ioc` 配套~~ → ✅ **已闭（2026-10-02，见 §8）** |

---

## 1. 触发事实与机理（为什么这次评审盯 8080 接口）

台面用约 30 根杜邦线跨接 16 位并口。实测：

- 把 **CS** 线挪到"不受干扰的位置" ⇒ 刷新**清晰**；
- CS 一受干扰 ⇒ **整屏花屏**。

机理：CS 是每次访问的**门闸**，一次假跳变即整条事务作废（一条参数被当命令写进面板 ⇒
`CASET/RASET` 窗口寄存器错位 ⇒ 之后所有像素落错位置，且 LVGL 不知情、**不会重画**）。
这是跨板长线上的**边沿振铃/串扰**（信号完整性），与"面板反显/显示方向/渲染缓冲"那条
已修复的链路**正交**。

> **`WR` 是同一类风险**：CS 决定"谁"、`WR` 决定"**什么时候写**"——被干扰同样是整屏级后果。
> 这就是本轮把 `WR`/`RD` 也补上阻尼的原因。

---

## 2. 逐脚核对结果（20 路串阻）

跨页命名网逐条核对（**MCU 侧 `LCD_x` 与 J5 侧 `LCD_x_J5` 成对分离**）：

| 串阻 | 串在哪条线上 | MCU 侧网络成员 | J5 侧网络成员 |
|---|---|---|---|
| `R22`~`R37` | `LCD_D0`~`LCD_D15` | `EVK1.36/35/72/71/13/16/15/18/17/20/19/22/21/30/29/32` | `J5.6/7/8/9/10/11/12/13/14/15/16/17/18/19/20/21`　**2026-10-04 修**（原 `J5.8/7/10/9/12/11/14/13/16/15/18/17/20/19/22/21`） |
| **`R38`** | **`LCD_CS`**（用户实测敏感那根） | `EVK1.67` | **`J5.1`** |
| `R39` | `LCD_RS` | `EVK1.31` | `J5.2` |
| **`R40`**（本轮） | **`LCD_WR`** | `EVK1.69` | **`J5.3`** |
| **`R41`**（本轮） | **`LCD_RD`** | `EVK1.70` | **`J5.4`** |

其余几何判据（三页一致）：① 无导线短接 ② **无"两侧同名旗标⇒并网短路"** ③ 无一域多旗标名 ④ 无孤儿旗标。
（判据 ② 是本工具独有、DRC 报不出来的那一类 —— 本仓 `R12` 历史上就栽过一次。）

**仍直连**：`LCD_RST`(`EVK1.14`→`J5.5`) —— 上电复位一次的低频信号，**不加阻尼**（加了反而拖慢复位沿）。

---

## 3. 本轮改动（两次落图，均已留证）

### 3.1 J5 就近去耦（更新 1）

模块 VCC(`J5.30` = `+3V3`) 旁补 10µF + 100nF，吸收面板电流尖峰（"间歇/位置相关花屏"的另一大成因）。
沿用**现有同料**，不引入新料号：

| 位号 | 值 | 料号 | 位置 |
|---|---|---|---|
| `C21` | 10µF | `CL21A106KAYNNNE`（同 `C13`） | J5 正下方 `(700,860)` |
| `C22` | 100nF | `CC0805KRX7R9BB104` | J5 正下方 `(820,860)` |

### 3.2 `WR`/`RD` 源端阻尼（更新 2）

照抄既有 18 只的**实测范式**（`18 §19.2`）：`J5 脚 —(LCD_x_J5)— R —(LCD_x)— EVK1 侧`。
新起第三排 `y=-50`，与前两排（`y=250` / `y=100`）同列对齐：

| 位号 | 值 | 料号 | 位置 | pin1(左)=MCU 侧 | pin2(右)=J5 侧 |
|---|---|---|---|---|---|
| `R40` | 33Ω | `0805W8F330JT5E`（同 `R38/R39`） | `(440,-50)` | `LCD_WR` → `EVK1.69` | `LCD_WR_J5` → `J5.3` |
| `R41` | 33Ω | 同上 | `(740,-50)` | `LCD_RD` → `EVK1.70` | `LCD_RD_J5` → `J5.4` |

端口做法：`createNetPort('BI', 网名, x, y, rot, false)` + **每个端口配一根短线**；
J5 侧那两个旧端口（原名 `LCD_WR`/`LCD_RD`）按规程**删除重建**为 `_J5` 名
（**不能用 `toAsync().setState_X/Y` 挪端口** —— 会抹掉网名，见 `06` 号踩坑）。

### 3.3 证据链（四件齐全）

1. **写前备份**：三页整页源码落盘 `_review/final-2026-10-02/pre/`（INT 510,031 字符）；
2. **回读自证**：`INT` 页 器件 **21 → 25**；`R40/R41` 回读为**横排**（pin1 左 `rot180` / pin2 右 `rot0`，
   与 `R38/R39` 逐字一致），四张网端口成员与网表设计一致：
   `LCD_WR = (1010,475)+(410,-50)` · `LCD_WR_J5 = (470,-50)+(750,1095)`（`RD` 同构）；
3. **DRC**：全程 = 基线（致命 0 / 错误 0 / 警告 2）；
4. **离线快照**：`_review/final-2026-10-02/post/`（INT 575,663 字符），
   viewer 无头渲染自检 **`obj=261 / unknown=0`**（较去耦后 +10：**2 器件 + 4 端口 + 4 导线**）。
   改后自证（脚本 `--verify`）：INT 页 **器件 25 / 端口与旗标 109 / 导线 109**；
   `R40`/`R41` 每脚都有端口（`LCD_WR`@410 · `LCD_WR_J5`@470 · `LCD_RD`@710 · `LCD_RD_J5`@770）且**恰好 1 根接线**。

### 3.4 本轮自己踩到并修掉的坑（留档）

给"改名重建的两个端口"我又按通用规程补了短线 ⇒ 与端口原有短线**合并成一条带多余尾巴的折线**
（`(770,1095)->(750,1095)->(750,1095)->(740,1095)`）⇒ DRC 警告 2→4。
**根因**：EDA 会把端点相接的导线自动合并成多段折线，而多段折线**不能修剪**
（`18 §19.3` 坑 3 已记）⇒ 只能**整条删除 + 重建**。
教训：**改端口的网名时不要补短线**（端口原有短线还在）；落完件立刻用 DRC 计数对基线，别只看"成功"。

---

## 4. 未落、需人判的两条

1. **上板目视复核（必须人做）**：`INVON` 修复（面板反显）与本月两次落图都需要**眼睛确认**
   —— 屏上颜色是否正确、方向是否符合预期（判据见 `05 §4.4`）。
2. ~~**`.ioc` 配套（见 §8）**：`PC5(TP_INT)` 仍是 `GPIO_Output` 初始低 ⇒ **上板会与触摸 IC 的 INT 输出对打**；
   `PC4` 应按 `18 §11-2` 改 `ADC1_IN14`~~ → ✅ **已闭（2026-10-02）**：两脚已改完并寄存器取证（见本文 §8；`PC5`=输入+上拉、`PC4`=输入不驱动且**改判不配 `ADC1_IN14`**，"轨在线"改由帧均值判）。

> `WR`/`RD` 这两条**已不再"建议评估"，已落图**（原 §4 的第一条建议已闭环）。

---

## 5. 布局必须做到（给画板的人；2 层版）

> 本节是**要求**，不是建议。任一"硬约束"做不到 ⇒ 请先回来说，不要硬画。

| 网络/区域 | 约束 | 理由 |
|---|---|---|
| `D0~D15` + `CS/RS/WR/RD` | 走成一束；目标 ≤40mm、硬上限 60mm；束内每 2~3 根插一根地；**不得跨地平面分割** | 2 层下"回流路径连续"是唯一可靠的"地" |
| 33Ω 串阻（`R22`~`R41`） | **贴 MCU 引脚 3~5mm 内**（源端阻尼） | 阻尼要加在**驱动端**；放连接器侧等于没加 |
| `J5` | **尽量靠近 FMC 引脚**；`GND`(29 脚) 就近打孔到地层并加宽铺铜，两侧加缝合过孔 | 单地脚 ⇒ 靠平面补回流 |
| J5 去耦（`C21/C22`） | 落板时**紧贴 `J5.30`**（≤5mm），先 100nF 后 10µF | 就近储能才吸得住尖峰 |
| AFE 区 | 与数字/总线区**分离 ≥10mm**；模拟地局部完整、单点汇合于核心板 `AGND` | mV 级模拟不得被数字回流借道 |
| 背光 / 5V | 5V 走线加粗；背光回路与总线**不平行**（≥10mm）或用地面隔开 | 40~60mA 开关电流是大环路干扰源 |
| 触摸 I²C | `R15/R16`(4.7k) 就近主端 ≤10mm；`TP_SCL/SDA` 不与总线平行 | 上拉位置决定边沿与抗扰 |
| SMA 输入 | `R1`(49.9Ω) 紧贴 SMA 中心针 ≤2~3mm；座子靠板边、焊盘加宽多打过孔 | `13 §5.7` 已定 |
| 层数升级判据 | 若**地平面被切成 2 块以上** / 总线**必须跨分割或穿越 AFE 区** / 总线 >60mm ⇒ **改 4 层** | 差价几十元，远低于一次返工 |

---

## 6. 上板验证方法

1. **上电前**：J5 逐脚对适配板丝印核对（`13 §5.4-①` 不可省）+ 通断/短路检查；
2. **显示对照**：整屏四色条 / 满屏图案 / 长时间动画三组；量化口径用固件的像素吞吐
   （`app_lvgl_fps_x10` / J-Link 读 `s_flush_px`）；
3. **AFE 噪声底**：与台面基线比（目标 <0.5 mVrms @ TP4）；
4. **判据**：显示无错位、无间歇花屏、心跳正常、LVGL 无告警。

---

## 7. 文档同步清单（下列旧结论已过期，以本文档为准）

| 位置 | 旧表述 | 现状 |
|---|---|---|
| `12 §9.1` | 补 FSMC 33Ω×17 ⇒ "**不加**，转触发条件制" | **已被覆盖**：实测耦合已出现，20 路已落图 |
| `12 §9.5 S5` | "采样窗静默 + 限帧率 ⇒ **顶替** FSMC 33Ω 串阻" | "顶替"关系失效：软件对策保留，与硬件阻尼**并行** |
| `13-D11` | "**不加**：… FSMC 33Ω×17 …" | 同上；33Ω（`R22`~`R41`，后补 `R42` 给 `RST`）均已在图上。~~PPTC(`F1`)~~ 已于 2026-10-04 删除（`38 §3.2-①`） |
| `13 §5.3` / `14 D10` / `15 §5` / `16 §4-4-D10` | "33Ω 未落图 / 未进待办" | 已落图并闭环（`R22`~`R41` ×20） |
| `01 约束 14` / `02 O11` / `14-A2` | `[TBD-6]` 层数"待拍板" | **已拍板 = 2 层**（2026-10-01） |
| `05 §C1` / `06 §2 RN1~` | "PWR/INT 两页无任何 33Ω" | 已落图 20 只（非排阻）；另补 J5 去耦 `C21/C22` |
| `bom_final.csv` / `bom_after.md` | INT 段只有 `EVK1`/`J5`/`R12` | 已补 21 路串阻（`R22`~`R42`）+ `C21/C22`（`bom_after.md` 为 09-28 快照，已标注作废）。~~`F1`~~ 已于 2026-10-04 删除 |
| `18 §9` 网表 | 阻尼电阻只到 `R39`、屏侧网 18 张 | 已更新为 `R22`~`R41`、屏侧网 20 张 |

---

## 8. 登记：不属于本次评审、但上板前必须做的两项（固件侧）

这两项**不在本次原理图评审范围内**，只是登记在册，免得漏（结论来自 `18 §11`、`14 D3/D9`、`13 §5.5`）：

| 项 | 现状 / 处置 |
|---|---|
| `PC5`（`TP_INT`） | ✅ **已改（2026-10-02，用户当场批准 = 工程铁律 R6 的"人批准"）**：`.ioc` + `MX_GPIO_Init()` 双双改为 **输入 + 上拉**（照 `SD_CARD_DET(PD3)` 的既有写法）；寄存器实测已生效。原风险：输出初始低会与触摸 IC 的 INT **对打** |
| `PC4`（`VBIAS`） | ✅ **已改（同上）**：`.ioc` + `MX_GPIO_Init()` 改为 **输入、不驱动**。原风险：`GPIO_Output` 初始**高** = 向模拟偏置轨（`VBIAS = {EVK1.9, R2.2, R5.2, R7.1, R10.1, C13.1, TP5.1}`）**灌电流**。板级宏 `BOARD_TOUCH_RST_*` → **`BOARD_VBIAS_SENSE_*`**（原名已不成立） |
| `PC4` 的 `ADC1_IN14` | ✅ **2026-10-02 拍板：不配**。把 ch14 加进 ADC1 的**常规序列**会改掉 `TIM8_TRGO + DMA` 采集链（现为 1 通道 @2.0 MSPS），而"模拟轨是否在线"本来只要一个是/否结论 ⇒ 改由 **AFE 输出帧的直流均值**判（`bsp_adc_self_check()` 里新增提示级判据 + `board_config.h` 的 `BOARD_VBIAS_SENSE_CODE_MID/TOL_PCT`：VBIAS=VREF/2 且 ADC 的 VREF+ 同源 ⇒ 恒在半量程附近，与核心板给 3.0V 还是 3.3V 无关）。**真正的 VBIAS 绝对值**由人工在 `TP5` 上用万用表量 |

> 验收：`Tools/fw.py lint` **通过**（.ioc ↔ board_config 对账）+ 重建零告警 + 烧录 `Verify successful` + RTT `[AI_READY] boot ok` + J-Link 读 `GPIOC` 寄存器确认两脚 `MODER=输入`、`PC5 PUPDR=上拉`、`ODR` 均不驱高。
