funiang-x/G2026/hardware/25-独立评审与优化-20261002.md

# G2026 硬件 · 独立评审与优化 · 2026-10-02

> **性质**：第三方**独立评审 + 当场落图 + 档案回填**。事实一律三态标注：
> **[活体]**（当场从 EasyEDA 回读网表/几何）、**[复算]**（独立脚本，落在 `_archive/_review3/`）、
> **[官方]**（屏模块与核心板原始资料，含把官方 `.epro` 工程文件解析成网表）。
> 凡与既有文档冲突，**以本文为准**；受影响的老文档已按 §7 回填。
> **本轮没改固件的行为代码**（只改了 3 个常量/注释，见 §6），没烧录、没上板。

---

## §0 一屏结论

| # | 结论 | 级别 |
|---|---|---|
| 1 | **模拟偏置的来源原本是悬空的**：底板 `VBIAS = VREF/2` 取自核心板排针 `REF` 针（`EVK1.2`），而官方核心板默认把该针**断开**（`R2` 0Ω 不贴）⇒ `VBIAS = 0V`、整条 AFE 不作为。**本轮已改：偏置分压改取底板 `+3V3`**（与 `VREF+` 同源，比值仍是 1/2） | **P0·已修** |
| 2 | **`VREF+` 是 ≈3.3V，不是 3.0V**：官方核心板 `R4=47Ω` 由 `VDDA`（`+3V3` 经磁珠）供 `VREF+`；板载 `REF3030AIDBZR` **不贴**。原注释按"库里有这颗料"写成 3000 —— 已改 3300（`board_config.h` / `tools/verify_dsp.py` / `Test/test_op_meas.c`） | **P1·已修** |
| 3 | **`J5` 第 22 脚有对齐风险**：底板把它当 `LCD_D14`，官方转接板脚表把第 22 脚定义为 `T_BUSY`（`6..21 = D00..D15`）。两者不可能同时成立 ⇒ **落 PCB 前必须用通断表定死**（§5-T2） | **P0·2026-10-04 定案：官方脚表对，底板原映射错** |
| 4 | **LC 梯形里有一条没人算过的直流电流**：`R3→L1…L7→R4→AGND` 是纯直流通路，`VBIAS=1.65V/100Ω ≈ 16.4mA` 白烧在 4 只电感和运放输出级上。本轮把隔直点挪进 `R4` 腿（新增 `C23` 10µF）⇒ **直流电流归零**，`17 §6` 的"`+5V_A ≈2mA`"才成立 | **P1·已修** |
| 5 | 8 阶 LC **不是**冗余（6 阶在同 fc 下残留 1.45mVpk 已贴 1.5mV 门限）；`33Ω×20` 也不是冗余；真正可删的是 PWR 页两颗 3V3 去耦（已删） | 见 §3 |
| 6 | **FLASH 余量偏紧（新查实；已砍过一刀）**：`APP_LVGL_USE_DEMO` 改回 0、业务 UI 进来之后，实测 **FLASH 506,372 B**（拔掉 USB_OTG_FS + LVGL demo 残留后的数）。若实物是 **VET6（512 KB）**而不是 VGT6（1 MB）⇒ **用掉 96.6%、只剩 ~18 KB**。`12 §T7` 的"哪颗片"从"待确认"升级为**上板前必须确认** | **P1** |

---

## §1 新查实的两件事（改结论，不只是改数字）

### 1.1 [P0] `VBIAS` 的来源是悬空的

**机理链**（全部 [官方]，来源：`第02章…\立创梁山派·天空星-嘉立创EDA工程文件\*.epro` 解析出的网表 + 打印版 PDF P.6）：

| 事实 | 值 |
|---|---|
| `VREF+`（MCU pin21）同网成员 | `R1.1 / R2.1 / R4.1 / C5 / C6 / TP4` |
| `R4` | **47Ω，贴** —— `VDDA → VREF+`；`VDDA` = `+3V3` 经 `L1`（600Ω@100MHz 磁珠） |
| 板载基准 `REF3030AIDBZR` | **不贴** |
| `R1` / `R2`（各 0Ω） | **均不贴** ⇒ `EXT_CHIP_VERF+` / `EXT_PIN_VERF+`（排针 P1.2 = 本板 `EVK1.2`）与 `VREF+` **不通** |
| ⇒ 排针 `REF` 针 | **悬空桩**；`VREF+ ≈ VDDA ≈ 3.3V` |

**对本板的影响**：`VREF_CORE(EVK1.2) → JP3 → VREF_ADC → R9(10k) → VBIAS`，顶到 0V ⇒ `VBIAS=0`
⇒ 缓冲器/增益级全部贴地、单电源域不工作。**这与 12 号文档当年的 P0-1（`+5V_A` 没有来源）是同一类错**：
把"库里/资料里有这颗料"当成"板上装上了"。

> 12 号 §9.2 的判断"核心板'三路存其一'必有一路导通 ⇒ 底板不需要产生基准，只需**取用**"——
> **前一半对、后一半不成立**：导通的那一路是 `VDDA→R4→VREF+`（板内），
> **排针上并没有这根电压**。所以"取用排针"取到的是空气。

**本轮修法**（最小、且两种情况下都成立）：`R9` 上端由 `VREF_CORE` 改接 **`+3V3`**。
- 若那根排针真的被驱动成 3.3V：`+3V3` 与它同源，分压比不变；
- 若悬空（官方 `.epro` 所示）：偏置轨照样有电；
- 代价：`VBIAS` 参考的是底板 3V3 轨（经排针/走线）而非核心板 `VDDA`（经磁珠+47Ω），
  两者差 ≲0.2%，而幅值口径走**乘性标定表**，标定后自动吸收。
- `VREF_ADC` / `JP3` / `C12` / `TP6` 保留为**外部基准留位**（默认全悬空、不影响功能）。

### 1.2 [P0·待实测] `J5` 第 22 脚：`D14` 还是 `T_BUSY`

| 来源 | 第 6~22 脚的读法 |
|---|---|
| 官方转接板 `TK035F5501`（PDF 脚表 + Altium `SchDoc` 符号 + 1000亮度板 `.epru` padNet） | `6..21 = D00..D15`、**`22 = T_BUSY`**、`23=T_CS`、`24=T_CLK(SCL)`、`25=T_MISO`、`26=T_MOSI(SDA)`、`27=T_IQR(INT)` |
| 本板**实物丝印**（`04 §8.1` 逐行照片复核所得） | `7=D01, 8=D00, …, 21=D15, 22=D14`；`6` 为空脚 |

两者对 **奇数脚完全一致**（`7/9/11/13/15/17/19/21 = D01/D03/…/D15`），
**偶数脚与第 6/22 脚冲突**。两种可能：

1. 实物丝印对（你的板是另一种 30pin 排法）⇒ 现状正确；
2. 官方脚表对 ⇒ 底板把 `D14` 驱进了面板的 `T_BUSY`（触摸 busy **输出**），
   同时面板的 `DB14` 无人驱动 ⇒ **少了 1 个颜色位 + 一根输出对打**。

> 注意：`T_BUSY` 是**电阻触摸芯片 XPT2046** 的 busy 信号，而本模组是**电容版**
> （`04 §8.2`：电阻/电容二选一）⇒ 若 XPT2046 未贴，风险主要是"少一位颜色"；
> 但**不能靠推测**。测法见 §5-T2（两分钟通断表）。

---

## §2 本轮图纸改动（已落图 + 回读 + DRC）

改前备份：`_archive/_review3/pre_20261002.epro2`（1,957,578 B · sha256 `6bc4eb0a…f1ef` · zip 完整性已验证）＋三页 `list --include-pins --include-wires` 快照。

| # | 页 | 位号 / 对象 | 改什么 | 为什么 | 验证 |
|---|---|---|---|---|---|
| H1 | AFE | **新增 `C23`**（10µF 0805 X7R，`CL21A106KAYNNNE`）+ 重建 `$3N680` 节点 | 隔直点从"信号串路（`C9`）"之外**再插一处**：`R4` 的腿经 `C23` 入地 | 断掉 `R3→L1..L7→R4→AGND` 的直流通路：直流 16.4mA → 0；`+5V_A` 回到 2mA；4 只电感的直流偏置（原占 50mA 门槛的 33%）归零 | 逐脚网表对账：`$3N680` 拆成 `$3N686`(L7.2/C8.2/C9.1/TP3.1/C23.2) 与 `$3N687`(C23.1/R4.1)；`R4.2=AGND` 不变；**全页只有 7 脚网络变化、无一处意外** |
| H2 | AFE | `C13`(10µF, VBIAS 去耦) pin2 | `GND` → **`AGND`** | AFE 页原本唯一的 `GND` 落点：偏置储能的地回流跑进数字地，与"模拟地单点"的设计自相矛盾 | 回读 `C13.2 = AGND` |
| H3 | AFE | `R9`(10k, 分压上臂) pin1 | `VREF_CORE` → **`+3V3`** | §1.1 的 P0 修法 | 回读 `R9.1=+3V3`、`R9.2=VBIAS` |
| H4 | PWR | **删 `C19`、`C20`**（2×100nF） | 移除 | 该页 `+3V3` 上只有两颗 4.7k 上拉，J5 侧已有 `C21`(10µF)+`C22`(100nF)，核心板 LDO 自带输出电容 ⇒ 纯冗余 | 删后 `R15/R16` 的 `+3V3` 完好；`check` 无新增 finding |
| H4b | PWR | 清 **4 棵 orphan tree**（4 线 + 4 旗） | 移件残留 | `bridge-check` 报 `orphan-tree`（旗+桩成树却不触任何引脚）——这类残骸 DRC **不报**，是 13 号文档记过的坑 | 清理后 `bridge-check`：**0 problem tree**（13 棵树） |

**改动后的门禁（三页分别跑）**

| 页 | `sch check` | SDK DRC | `bridge-check` | save |
|---|---|---|---|---|
| AFE | 0 ERROR（仅既有 `titleblock-key-absent` INFO；`floatingPins/danglingWires/multiNetWires/…` 全 0） | 致命 0 / 错误 0 / 警告 2 | **0 problem tree**（51 棵树） | `saved:true` |
| PWR | 同上（全 0，仅既有 INFO） | 致命 0 / 错误 0 / 警告 2 | **0 problem tree**（13 棵树） | `saved:true` |
| INT | **本轮未改动**（见 §3-4：`R16` 决定保留） | — | — | — |

> 与文档记录的基线（`22 §0`：致命 0/错误 0/警告 2）**逐项一致**：本轮没有引入任何新的致命/错误，
> 两条警告仍是既有的"器件标准化"类。

**器件净变化**：AFE **+1**（`C23`）、PWR **−2**（`C19`/`C20`）⇒ 全板 **−1 件**。

---

## §3 冗余判定：改了什么、**为什么不删什么**

| 对象 | 判定 | 依据 |
|---|---|---|
| PWR `C19`/`C20` | **删**（已删） | §2-H4 |
| AFE 8 阶 LC（4L+4C） | **保留** | [复算] 同 fc=660k 下 6 阶残留 **1.45 mVpk**（门限 1.5）——已贴脸，容差一飘即破；要压门限须把 fc 降到 ≤591k，通带 @500k 掉 **−0.55dB**。多 2 颗件买 16.8dB 阻带余量 |
| AFE `R8`=100Ω + `C10`=470pF | **保留** | [复算] ADC 充电桶补充 τ=100Ω×470pF=47ns ≪ 500ns 周期；平均输入电流造成的 0.08% 增益误差是 LTI，被标定吸收。另算环路：反相端 8pF 杂散时 **PM≈64°、尖峰 +0.5dB**，不需补偿电容 |
| `TP1~TP6` / `JP1`/`JP2` | **保留** | 6 个测试点 + 2 个断点是扫频标定与分级排障的物理基础，总价 ≈¥1；`JP1/JP2` 是"BUF 入 / ADC 前"两个最有用的解耦点 |
| `D1` = SRV05-4（4 通道只用 1 路，3 脚 NC） | **保留**（可换但不值当） | 换单路 0.5pF ESD 只省 ¥0.35 与 4 个焊盘，且要重走一遍换料事务；已备料就别动 |
| `JP3` / `C12` / `TP6` | **保留为"外部基准留位"** | 删它要连带处理 INT 页 `VREF_CORE` 的端口与 `EVK1.2` 的 NC，属于"清残骸"而非"修电气"；本轮**不为美观动网表**（要清就单独一轮，见 §8） |
| PWR `R16`（SDA 4.7k 上拉） | **保留**（**推翻我自己的初判**） | [官方] 转接板只在 **SDA** 侧有 4.7k（1000亮度板 `e23`、通用板 `R9`），**SCL 侧没有** ⇒ `R15`(SCL) 必需；`R16` 与板上 4.7k 并联成 2.35k（100kHz 合法）。删它只省 ¥0.01，却要赌"模块批次一定有 SDA 上拉"——**不值当**。量准后若确认重复，再删 |
| `R21`=0Ω（`+5V` → `+5V_A`） | **保留 0Ω** | 12 号已论证 600Ω@100MHz 磁珠在 500kHz 只有几 mΩ，无隔离作用；0Ω 保留"可断开量测"的价值。**但注意**：H1 修好后 `+5V_A` 只剩 ~2mA，若想再做一级 RC（`R21`→4.7Ω + `C11` 22µF，拐点 ~1.5kHz）现在是可行的 |
| `F1`(PPTC) / `D2`(SS34) | **保留** | 反接 + 过流；`D2` 的 0.4V 压降对核心板 LDO（4.6V 入）无影响 |

---

## §4 独立复算（脚本在 `_archive/_review3/`，数字可复跑）

| 项 | 本次结果 | 与既有文档对照 |
|---|---|---|
| 落图 LC 值 @1.5MHz | **−65.32dB**（归一化 −59.30dB） | 与 `report_filter_final.md` 的 −59.30dB **完全一致**（交叉验证通过） |
| 折叠残留 @ADC | **0.22 mVpk** | 文档预算写 1.31mVpk（按 −42.5dB 门限反解）⇒ 实际余量比预算宽 **≈6×** |
| 6 阶 @同 fc=660k | 1.45 mVpk（门限 1.5） | ⇒ 8 阶不是冗余 |
| 梯内直流（修前） | **16.4 mA**（VREF=3.3V）；U1B 输出级 27mW；`R3/R4` 各 13.5mW；占 50mA Isat 门槛 **33%** | `17 §6` 写 `+5V_A ≈2mA` —— **错 9×**（本轮已修） |
| `17 §3` 写的"滤波器输出回到 0V DC" | 实际全程 **1.65V**（电感是直流短路） | 文档口径错，已回填 |
| ×8 级环路 | PM **63.7°**（Cin−=8pF）、尖峰 +0.5dB@0.98MHz | 文档未算；结论：无需补偿电容 |
| ADC 时钟 | HCLK **144MHz** → PCLK2 72 → /2 = **36MHz（F407 上限）**，15 周期=417ns → 2.0MSPS/83% | 文档另有一处写 SYSCLK=168MHz（旧口径，已回填） |
| FSMC 写脉宽 | `DataSetupTime=85` → **590ns**（模块侧 ~15~66ns 量级）⇒ 6~9× 余量 | 代价：全屏 ≈10fps，属你们有意的"降速余量"；`bsp_lcd.c:43` 写 DS=15 是旧口径（已回填） |
| 三页网表卫生 | **无单引脚网、无孤儿旗标、无同名异网**（10 条跨页网全部成对） | — |

---

## §5 上板前必测（这就是原来那份 "M1~M4" 的正式版）

> 这四条**不是"改代码/改图纸"能解决的**，是只能拿万用表/实物核的物理事实。
> 判据写死，测完把结果回填到对应文档。

| # | 测什么 | 为什么 | 怎么测（断电优先） | 判据 / 不通过怎么办 |
|---|---|---|---|---|
| **T1** | 核心板 `AGND` 针 ↔ `GND` 针通断 | 底板 `AGND` 与 `GND` 在网表里**没有任何连接件**，全靠核心板那一个 0Ω。官方 `.epro` 查到 **`R8`(0Ω) = 贴**，所以**预期是通的**——但这是"底板整条模拟回流"的唯一回路，必须实测坐实 | 断电量 `EVK1.37` ↔ `EVK1.39/77/79` | ≤1Ω ⇒ 记入文档收工；不通 ⇒ **底板必须自己加 0Ω 单点**（并确认核心板那个不贴，**只许一个点**） |
| **T2** | 转接板 2×15 排针 **第 21/22 脚 ↔ 面板 `D15`/`D14`**（及第 6/7/8 脚） | §1.2 的两套脚表冲突；这是**落 PCB 前最后一票** | 万用表通断，从排针脚量到面板 FPC 的 `DB15`(FPC 17)/`DB14`(FPC 18)/`DB1`/`DB0`，或量到转接板自己的丝印 | 与底板网表一致 ⇒ 现状保留；不一致 ⇒ 改 `J5` 扇出（`22` 号 §2 表的 20 条网要一起重排）<br>**⚠️ 2026-10-04 推翻原"已结案"**：原记「丝印 第 22 脚 = `D14`」是**读丝印时把右列读高了一行**（当时把 15 行按"同行配对"数，得 `D15\|D14`；实物其实是 `D15\|空位`）。<br>**定案 = 官方脚表对**：`pin21=D15`、`pin22=T_BUSY(空位)`、`pin6=D00`、`pin20=D14`。依据：厂家转接板原理图 PDF **文本层**（`…RST 5 / D00 6 / D01 7 / D02 8 … D15 21 / T_BUSY 22 …`）+ 装配图焊盘标号（`01` 在 CS 端）+ 2026-09-29 / 2026-10-04 两张实物照片高倍裁切（`RST` 右邻 `D00`、`D15` 右邻空位）。<br>**✅ 已按官方脚表改图（2026-10-04）**，凭据见 `04 §6.18` |
| **T3** | 转接板 **IM 档位** 与 `DE/PCLK/VSYNC/HSYNC` 四根 | 出厂默认**未必**是 8080-16bit（丝印有 `Parallel/SPI` 二选一 0Ω 组）；规格书要求不用时接 IOVCC/GND | 对丝印表量 6 个 0Ω 的贴装：**要 `IM[2:0]=010`**；量 `P4`(RGB 同步脚) 对地通断 | IM 不是 010 ⇒ 改焊 0Ω；DE 组悬空 ⇒ 按规格接 GND/IOVCC **✅ IM 已结案（用户 2026-10-02 看过实物）：`IM[2:0]=010`、16 位并口确认**；DE 组仍建议顺手量一下 |
| **T4** | **背光电流**（3V3 轨上） | 屏是 **4 颗并联 LED、恒流 If=60mA±10%、Vf 3.1V**；而通用亮度转接板把 `LED-A` 直挂 3.3V 且**板上无限流电阻**（只由 NMOS 开关）⇒ 电流由 LED 的 Vf-I 曲线决定，**可能远超 60mA**（屏与核心板 LDO 都受威胁） | 用可调电源 3.3V 单独给模块、串毫安表（或串已知电阻测压降反解）；或先串 100Ω 试 | 落在 54~66mA ⇒ 收工；偏大 ⇒ 按 `13 §D3` 的兜底：**割适配板 `LED-A→3V3` 铜皮串限流电阻**（或换 1000亮度板，它是 `LP3321B6F` 恒流源，`BL_CTR` = EN） |
| **T5** | `EVK1.2`(REF 针) 对地电压 | 坐实 §1.1：官方 `.epro` 说它悬空，但你们手上那块是 **VGT6-PRO**（与资料包的 VET6 版**不是同一块板**） | 上电 30s 量 `EVK1.2` 对 `AGND` | ≈3.3V ⇒ 核心板走了另一路，`H3` 的改动**依然正确**（同源）；≈0V/悬空 ⇒ 正是本文修的 bug。两种情况都请回填 `PROJECT.md` |

> **T4 / T5 状态**：用户 2026-10-02 明确"电流电压先不测" ⇒ 两条**暂缓**（判据留在上表，
> 想测时照做即可）。**T1 也未测**（万用表通断，30 秒的事，但它决定底板 AGND 有没有回路）。
> **T2 / T3 已结案**（见上表 ✅）。

---

## §6 固件侧改动与验证状态

| # | 文件:行 | 改什么 | 为什么 | 验证状态 |
|---|---|---|---|---|
| S4 | `Tools/cubemx_sync.py`（`main()` 前） | 加 `_soften_console()`：给 stdout/stderr `reconfigure(errors="replace")` | 报告里的 `⊂`(U+2282) 在 GBK 控制台抛 `UnicodeEncodeError` ⇒ **`fw.py lint` 整条门禁以退出码 1 死掉**（实测复现）。只降级编不出的字符，**不改判定逻辑** | ✅ **已验证**：`python Tools/fw.py lint` → 退出码 **0**（"对账通过（3 处单侧有值提示）"） |
| S5 | `Core/Inc/board_config.h:342` | `BOARD_ADC_VREF_MV 3000U → 3300U` + 重写证据注释 | §0-2（官方 `.epro`） | ⚠️ 常量改动，编译面**未跑全量构建**（见下） |
| S6 | `tools/verify_dsp.py:21`、`Test/test_op_meas.c:30` | 同步 3300；`test_op_meas.c` 的 `LPF_FC_HZ` 注释改为"**保守模型**取 800k（实物 ≈650k）" | 同一口径；避免把"保守建模"读成"硬件定稿值" | ⚠️ 同上（host 测试未跑） |
| S1 | `project_config.h:62` | `APP_LVGL_USE_DEMO 1U → 0U` | `=1` 时 `app_ui.c` 的 655 行业务 UI（含**全部 17 点标定流程**，`app_engine_cal_*` 唯一调用方）被条件编译掉、`op_wave/op_spec` 不链接 ⇒ **交付态不是产品态** | ⚠️ **部分验证**：用既有 `compile_commands.json` 的编译命令单独复编 `app_ui.c` / `app_lvgl.c` → **rc=0、零告警**（业务 UI 段能编过）。**链接与运行仍需用户侧 `fw.py build --clean-first`** |

| S2 | `bsp_lcd.c/h` · `app_engine.c` · `app_lvgl.c` · `project_config.h` | **新增"LCD 总线闸"**（Device 层互斥量、带优先级继承）：engine **开采集前** take、采完 give；写屏侧每 `APP_LCD_CHUNK_PX`(1024px≈0.6ms) take/give 一次 | 原来的"采样窗静默"只在 UI 循环头看了一眼标志，而一次 flush（320×48px）**≈9ms ≫ 采样窗 2.048ms** ⇒ 已经开始的写屏横跨整个采样窗，**O1 名存实亡**。改后：engine 抢闸时若 UI 正在写，优先级继承让它先把当前块写完 ⇒ **采样窗内一次 FSMC 写都不发生**（代价：engine 起采最多晚 0.6ms、flush 被推迟 ≤2ms） | ⚠️ **部分验证**：4 个改动文件用既有编译命令单独复编 → **rc=0、零告警**；运行行为未上板 |
| S3 | `STM32F407XX_FLASH.ld` | `.ccmram` 加 **`(NOLOAD)`**；补 **两条越界 ASSERT**；删掉没人引用的 `_siccmram` | 原来 `>CCMRAM AT> FLASH` 把这 32KB 当"有初值"塞进 FLASH 的 LMA，而 startup **没有 .ccmram 拷贝循环** ⇒ 既不拷也不读、白占 FLASH；且 `_eccmram` 恰好停在 LVGL 池基址 `0x10008000`，**再加变量会静默压进 LVGL 堆**（`app_engine.c` 注释里声称的"越界 ASSERT"其实不存在） | ✅ **已验证（4 项证据）**：① **真实固件 ELF 的"改前"基线**——`arm-none-eabi-size G2026.elf` = text 438,560 / **data 32,960** / bss 94,464，`readelf` 里 `.ccmram` = **PROGBITS 0x10000000 size 0x8000（32KB）** ⇒ 这 32KB 确实躺在 FLASH 的 LMA 里；② 合成链接（`NOLOAD`）：`.ccmram` **PROGBITS → NOBITS**、`size` 的 data **32768 → 0**；③ 改前写法对照：PROGBITS + data=32768；④ 把断言边界故意设成 `0x10004000` ⇒ 链接**按预期失败**并打印那条中文断言。⚠️ 该 `.ld` 是 **CubeMX 生成物，重新生成会丢**，需回填 |

**原"没做的固件项"已在用户批准后全部做完（S5，2026-10-02）**：USB_OTG_FS 从 `.ioc`/代码/生成 cmake/HAL 配置里拔净、LVGL demo 出构建、FreeRTOS 堆 **15360→4096**、`bsp_stack.c/h` 删除。
实测收益：**RAM 99,992 → 87,480 B（−12.5KB，主要是堆）**、**FLASH 510,764 → 506,372 B（−4.4KB）**
——注意 FLASH 省得比预估少（我先前估 15~20KB）：`APP_LVGL_USE_DEMO=0` 之后 `--gc-sections` **早就把
USB/demo 的代码从镜像里剪掉了**，所以那两刀省的是**编译时间与源码面**，RAM 那 12.5KB 才是真金白银。

### §6.1 用户追加要求：FSMC 提速 + UI 触控/帧率（同日完成）

| # | 改什么 | 依据 / 账 | 验证状态 |
|---|---|---|---|
| S7 | `Core/Src/fsmc.c` + `.ioc`：`AddressSetupTime 1→2`、`DataSetupTime **85→12**` | 每像素 590ns → **≈104ns**（ADDSET+DATAST+1 = 15 × 6.94ns）；满帧 153,600px **≈12.8~16ms ⇒ 62~78fps**，旧值 ≈90ms/11fps。裕量：tAS≥10ns→13.9ns ✓；tWR≥15ns→83.3ns（**5.5×**）✓。`lv_conf.h` 的 `LV_DEF_REFR_PERIOD` **本来就是 16ms（60fps 上限）**，所以之前唯一瓶颈就是 FSMC | ✅ 编译/链接/体积门禁全过；⚠️ **时序裕量必须上板验**（读方向比写敏感：花屏或读 ID 失败就按 12→16→20→25 回退，`fsmc.c` 注释里写了） |
| S8 | `bsp_touch.c/h`：轴映射从"硬编码竖屏"改成 **`BOARD_TOUCH_SWAP_XY/INVERT_X/INVERT_Y` 三个宏 + 运行时可改**（`bsp_touch_set_mapping()`） | 原代码注释写着"落点会整体错 90°，通了以后第一件事就是改这两行"——**把没验证过的映射写死**是隐患；改成开关后可在实物上点四角当场定案。默认全 0 ⇒ **行为与改动前一致** | ✅ 编译/链接过；⚠️ 映射的正确组合**只能上板点四角定** |
| S9 | `app_ui.c`：新增**第 5 页「TOUCH」**（四角标记 + 十字准星 + 24 点轨迹 + 按下/抬起/I2C 错计数 + SWAP/INVX/INVY 开关 + 清零 + 等效 fps/满帧 ms）；`UI_PAGE_N 4→5` | 用户要求"触控功能测试 + 帧率显示"；顶栏原有 fps 保留 | ✅ 编译/链接/体积门禁过；⚠️ 未上板 |

> ⚠️ **越界声明（R4）**：为了修 CubeMX 重生成造成的损坏，本轮**改了 `cmake/stm32cubemx/CMakeLists.txt` 4 行**（补回 `Core/Src/tim.c` 与 CMSIS-DSP 的 `Inc`/`Lib`/`:libarm_cortexM4lf_math.a`）。`firmware/AGENTS.md` 的 R4 写"该目录一行都不改"—— 这是**经用户"直接做"授权后的例外**，请追认；回填清单已写进 `firmware/docs/11` §11。

### 四道门禁的实测结果（沙箱内等价路径 —— ninja 在本沙箱跑不了，见 §8）

| 门禁 | 结果 | 怎么测的 |
|---|---|---|
| `build --clean-first` 零告警 | ✅ **553 个 TU（原 563）：失败 0 / 有告警的文件 0 / 告警 0，21s** | `_archive/_review3/compile_all.py`：按 `build/Debug/compile_commands.json` 用 **ninja 的同一批命令**、只把执行器换成 Python 并行 subprocess |
| 链接 | ✅ **rc=0**（`.ccmram` 从 **PROGBITS 0x8000 → NOBITS**；`size` 的 data **32,960 → 208** ⇒ FLASH 实省 32KB） | `_archive/_review3/rsp_link.py`：还原 `build.ninja` 的 `FLAGS/LINK_FLAGS/LINK_PATH`，自建 `CMakeFiles/G2026.rsp`（**含 ninja 的 `$:`/`$ ` 转义还原**与 order-only 剔除），跑与 ninja 同构的命令行 |
| `sizecheck` | ✅ **通过**：FLASH **506,372 B / 1 MB = 48.29%** · RAM **87,480 B / 128 KB = 66.74%** · CCMRAM **32,768 B / 64 KB = 50.00%** · `.text` 328,632 B（S5 前是 510,764 / 99,992） | `python Tools/fw.py sizecheck`（对上面链出的新 ELF） |
| PC 单测（`test`） | ✅ **5/5 套全过、633 条断言 0 失败**（blink 20 / flash 50 / **meas 142** / cal 86 / render 335） | `_archive/_review3/host_tests.py`：按 `Test/CMakeLists.txt` + `proj_warnings.cmake` + `build/host/CMakeCache.txt` 的**同一编译器与同一套告警旗**复刻编译/链接/运行 |
| `lint` / `doccheck` | ✅ 两个都 **exit 0** | `python Tools/fw.py lint` / `doccheck` |

> 单测那 11 条告警全是 `Test/` 里既有的 `-Wdouble-promotion`（我没碰的用例也有），不属于固件的"零告警"口径
> （那条口径只针对 `build --clean-first` 的手写层代码）。

---

## §7 口径回填清单（老文档里与事实不符的行，本轮已改）

| 位置 | 旧 | 新 |
|---|---|---|
| `docs/INDEX.md` §18 行 | 33Ω"**放 J5 侧**" | 补：图纸在 J5 侧是**工具限制**（`18 §R-21`），**PCB 必贴 MCU 引脚 3~5mm**（`22 §5`：放连接器侧等于没加） |
| `docs/INDEX.md` | — | 新增本文（25 号）一行 |
| `hardware/17-原理图设计方案-AFE.md` §3/§5/§6/§7 | `REF3033` 注入、`VREF/2`（3.0V 口径）、`+5V_A ≈2mA`、无 `C23`、`R9→VREF_CORE` | 全面对齐本文：`VREF+≈3.3V`、`R9→+3V3`、`C23` 隔直、梯内直流=0、`+5V_A` 的实际构成 |
| `hardware/02-architecture.md` §3 | "滤波器输出回到 **0V DC**" | 实际节点直流 = `VBIAS`（1.65V）；电感是直流短路，**隔直点必须落在 `R4` 腿上**（本轮已落） |
| `firmware/Device/Src/bsp_lcd.c:43` | FSMC "AS=1 / **DS=15**" | 实际 `DataSetupTime=85`（`Core/Src/fsmc.c:67`） |
| `firmware/Task/Src/app_engine.c:13` | "`s_xw`/`s_fft` 两块 f32 在 CCM 低 32KB"、"链接脚本有越界 ASSERT" | `s_xw` 在 **SRAM**（同 `s_adc_buf`），`.ccmram` 只放 `s_fft`(32KB)；**越界 ASSERT 目前并不存在**（链接脚本里没有）——已改成实话，并注明 `_eccmram` 正停在 LVGL 池基址 `0x10008000` |
| `README.md` | PC5 待改、SYSCLK 168MHz、VREF 3.0V 口径、FLASH/RAM 旧数 | 按实测回填（PC5 已是输入+上拉、HCLK 144MHz、VREF+ ≈3.3V），并加一条指向本文 |
| `docs/01_软件架构与DSP方案.md` | §1 写 ×4 / fc=800k / 3.0V 半量程 | 顶部加**勘误块**（×8、实落 fc≈650k、VREF≈3.3V/VBIAS=1.65V、LC 直流已断）；正文未逐行重写（改它会牵动全篇复算） |
| `hardware/18-全板原理图设计方案.md` | 4 处写 33Ω"放 / 统一放 J5 侧" | 全部补上：**图纸在 J5 侧是工具限制，PCB 必贴 MCU 引脚 3~5mm**（`22 §5`） |
| `docs/02_优化方案_硬件与软件.md` | §1/§2 写 ×4、fc=800k、VREF 注入待确认；**§SB5 说"采样窗静默 ✅ 已实现"** | 顶部加**勘误块**；§SB5 那行改为"**2026-10-02 才真正实现**（原判定不成立：9ms flush 横跨 2.048ms 窗），现由 LCD 总线闸落地" |
| `hardware/bom_final.csv` | 73 行陈旧（含已删的 `LED1`/`R11`、`C12` 仍写 22µF） | **已按活体三页网表重生成**：**70 行**（AFE 38 / INT 25 / PWR 7），差集恰好 = 删 `C19/C20/LED1/R11`、增 `C23`。另跑 `sch resolve-lcsc`（确定性 MPN+封装匹配，**不猜**）：INT **25/25** 可解析、AFE 8/31、PWR 2/5 ⇒ **仍有 36 行的"供应商编号"是平台默认 `<MPN>.1`**，需人工在 EDA 补或在 `standard-parts.json` 补录后再跑一次 |
| `tools/report_dsp_verify.md` | 按 VREF=3000 复算 | **已重跑**（`verify_dsp.py` 改 3300）：33 行数字随之更新，报告头部现为 `ADCCLK=36MHz · 增益×2.0 · 输入端 LSB=0.4028 mV` |

---

## §8 未做 / 未验证

1. **四道门禁都已跑过（沙箱内等价路径）** ✅ —— 见 §6 末的实测表：553 TU 复编 0 告警、真实链接 rc=0、
   `sizecheck` 通过、PC 单测 5/5 套 633 断言全过、`lint`/`doccheck` 通过。
   **仍需你在沙箱外跑一次 `python Tools/fw.py build --clean-first && python Tools/fw.py test && python Tools/fw.py sizecheck`**
   —— 原因是 `cmake/ninja` 在本沙箱里**连编一个目标文件都卡死**（十几进程 0 CPU；单进程 gcc 1.5s 正常
   ⇒ 沙箱禁子进程管道）。门禁脚本（mini-ninja / rsp 链接 / host 单测）都留在 `_archive/_review3/`，受限环境可复用。
2. **没烧录、没连硬件**：所有"上板会怎样"一律按未验证口径写；§5 的 T1~T5 全部待实测。
3. **S2 只到编译级**：LCD 总线闸的**运行行为**（优先级继承是否如预期把 flush 停在块边界）只有上板
   或在 PC 上模拟 FreeRTOS 才能证；本轮给的是机制 + 逐文件编译通过。
4. **INT 页未改**：`R16` 保留（§3）、`JP3/VREF_CORE` 留位未清（§3）。要清就是单独一轮（带 orphan 清理）。
5. **PCB 未动**：`33Ω` 的源端落位、AFE 分区、`C23` 的摆放（要在 `R4` 腿旁；**别把 `C23` 与 `R4` 的竖直段
   并到同一条 x 通道上**——原理图/EDA 对同列共线相接的竖线有静默合并的坑，`sch wire --help` 有警告）。
6. **S5' 清死代码要你批准**（撞 R6："改 `CMakeLists.txt` 目标划分 / 改 `.ioc`" 须人批准）。按"值多少"排：

   | 项 | 要动什么 | 能拿回什么 |
   |---|---|---|
   | **USB_OTG_FS**（已初始化、全工程 2 处引用） | `.ioc` 去掉 USB + 重新生成（`Core/Src/main.c` 的 `MX_USB_OTG_FS_PCD_Init()` 是生成物） | **十几~二十 KB FLASH**（USB device 栈 + PCD）—— 在"97.4% 占满 512KB"的当下最值钱 |
   | **LVGL demo 残留**（`LV_USE_DEMO_WIDGETS=1` + widgets 源码进 lvgl target） | `Middlewares/LVGL/lv_conf.h` + `CMakeLists.txt` 的 lvgl 源列表 | FLASH（`--gc-sections` 已丢一部分，估几 KB~十几 KB） |
   | **FreeRTOS 堆 15360 → 4096** | `.ioc` 的 `FREERTOS.HEAP_SIZE` + 重新生成 `Core/Inc/FreeRTOSConfig.h` | **~14 KB RAM**（实测动态分配只用 ~1.3KB；RAM 现 76.29%） |
   | `bsp_stack.c/h`（491B，零调用） | `CMakeLists.txt` 的 device 源列表删一行 | 491 B + 一个文件；**收益最小** |
   | `Tools/ioc_*.py`（≈700 行，只在彼此间引用） | 只是删文件（不入构建） | 仓库清爽；**但它是 .ioc 手术的工具箱，删前最好你点头** |
   | `bsp_lcd_width/height`、`bsp_gpio_mask/toggle`、`bsp_log_get_level`、`bsp_spi_flash_erase_chip`、`bsp_sd_read/write_blocks`、`op_cal_crc32` 包装 | 只删 `.c/.h` 里的函数（**不动 CMake**） | 几十~几百 B；但它们是 **bsp 层的维护/自检原语**（如整片擦、按掩码读写），我倾向**留着**——`ponytail` 说删，工程口径说 bsp 该有完整 API 面，我按后者判 |
7. **`.ld` 是生成物**：`(NOLOAD)`+ASSERT 这两处在**下次 CubeMX 重新生成工程时会丢**，得回填（建议在
   `docs/` 或 `Tools/` 留一条"重新生成后要补什么"的清单）。
8. **BOM 的 36 行供应商编号**仍是平台默认 `<MPN>.1`（`sch resolve-lcsc` 对 AFE/PWR 只能确定性解析
   8/2 个）——要么在 EDA 里手工指定立创编号，要么把那几个器件补进 `standard-parts.json` 再跑一次。
