funiang-x/G2026/hardware/26-原理图评审与信号流梳理-20261003.md

# G2026 底板 · 原理图评审与信号流梳理 · 2026-10-03

> **性质**：第三方**只读评审 + 逐块讲解**。本轮**未改图纸、未改固件、未上板**。
> **数据源（三态标注）**：
> - **[活体]** = 2026-10-03 当场从运行中的 EasyEDA（工程 `funiang/ai`，三页 AFE/INT/PWR）回读的网表
>   （`sch list --include-pins` 重建，脚本 `_archive/_review4/../_archive/_review3/netlist_now.py`）；
> - **[复算]** = 本轮独立脚本 `_archive/_review4/afe_recheck.py`（ABCD 级联，不引用既有报告）；
> - **[渲染]** = `easyeda sch export-image` 导出的三页 PNG（`_archive/_review4/*.png`，`Black on White`）；
> - **[引用]** = 既有文档（`17`/`18`/`25`），仅用于对照口径，不作为事实来源。
> ⚠️ **2026-10-03 勘误（读本文数字前先看这条）**：本文的活体快照是 **AFE 39 位号 / 21 网**。
> 当日稍后做**冗余清理**（见 `30 §5`）删掉了 `JP3` / `C12` / `TP6` 与 `VREF_CORE` 网
> —— 那是"外部基准留位"整条死支路（核心板 REF 针悬空、`R9` 已改接 `+3V3`）。
> **现值为 AFE 36 位号 / 19 网 · INT 25 / 52 · PWR 7 / 8**。
> 本文 §2 的逐块讲解对**保留下来的元件**全部仍然成立（`TP1~TP5`、`JP1`、`JP2` 都在）。
>
> **本文的定位**：把"这张图为什么长这样"讲清楚 —— 每一块电路的设计理由、每一个元件的数值来历、
> 每一条信号的走向。**发现的问题集中在 §7**，其余章节是讲解。

---

## §0 一屏结论

| 项 | 结论 |
|---|---|
| 整体 | **架构成立、信号链正确、数值有复算背书**。三页 71 个位号、82 张网（跨页去重）全部对得上，无单引脚网、无同名异网。 |
| 独立复算 | LC 折叠带最差 **−59.31 dB**（判据 ≤ −42.5 dB，**余量 16.8 dB**）；带内 10k~500k 起伏 **0.1413 dB**；与既有报告的 −59.30 / 0.139 **逐位吻合** ⇒ 交叉验证通过。 |
| FSMC 引脚映射 | 16 条数据线**逐条核对 PD14/PD15/PD0/PD1/PE7~PE15/PD8/PD9/PD10 全部正确**，无一条错位。 |
| 本轮新发现 | **5 条 P2、6 条 P3**（详见 §7），另有 4 处**注释口径过期**会误导接板人。<br>⚠️ **2026-10-03 更正**：原判 P1 的「5V 双源」已降为 P2 —— 重推网表发现 **`D2` 本身（阴极接 `+5V`、阳极接 DC 支路）就挡住了双向反灌**，原判漏看了它的方向。见 §7-N2 与 `hardware/28 §5.1`。 |
| 不能从图上解决的事 | 5 条"只能拿万用表/实物核"的物理事实（§8），其中 **AGND↔GND 通断**与**背光电流**是上板成败项。 |

---

## §1 全板信号流总图

### 1.1 一句话架构

**核心板（立创·天空星 F407VGT6-PRO）+ 底板**。底板只做三件事：
① 把 SMA 进来的被测信号**抗混叠滤波 + 抬到单电源域中点**，送进 MCU 的 PA1；
② 把 30-pin 屏模块接到核心板的 FSMC / I²C2 / 背光开关；
③ 把 DC 座的 5V 灌进核心板，并从核心板的 LDO 取 3.3V 给屏。

```
                          ┌─────────────────────── 底板 ───────────────────────┐
 信号源 ──BNC──► J1(SMA) ──► AFE 页（39 器件）──► AFE_ADC_IN ──┐
  (50Ω)            │                                            │
                   └ 50Ω 端接 R1                               │
                                                               ▼
                                              INT 页 EVK1.4 = PA1 = ADC1_IN1
                                                               │
                                          TIM8 TRGO @2.000MHz ─┤
                                          ADC1 12bit / VREF+≈3.3V / DMA2_S0
                                                               ▼
                                              SRAM 双缓冲 4096 点 → CMSIS-DSP
                                                               │
                                                               ▼
                                          LVGL 5 页 UI ──FSMC 8080-16bit──► J5 ──► 3.5" ST7796S
                                                          ▲                ▲
                                                          │ 33Ω×20 串阻    │
  DC 5V ─► J3 ─► F1(PPTC) ─► D2(SS34) ─► +5V ─► EVK1.40/80 ─┘      I²C2 ──► FT6336 触摸
                                        └─ R21(0Ω) ─► +5V_A ─► U1(OPA2197)
                                          核心板 LDO ─► +3V3 ─► J5.30（屏+触摸+背光）
```

### 1.2 模拟信号链（AFE 页，从 SMA 到 ADC 引脚）

```
J1 ─┬─ R1 49.9Ω → AGND        ← 50Ω 端接（贴座）
    ├─ D1.4  SRV05-4 (Cj≈1.5pF) ← ESD 钳位
    ├─ TP1                      ← 测试点：端接节点
    └─ C1 100nF (C0G,1206)      ← 隔直（与 R2 组成 159Hz 高通）
         └─ JP1 (0Ω) ──► AFE_BUF_IN ─┬─ U1A.3 (+in)     U1A.1(OUT)─U1A.2(−in) 短接
                                     └─ R2 10k → VBIAS   ⇒ 单位增益缓冲 G=1
U1A.1 ── R3 49.9Ω ──► L1 4.7µH ─┬─ C2 5.6nF ↓AGND
                                ├─ L3 22µH ─┬─ C4 10nF ↓AGND
                                │           ├─ L5 22µH ─┬─ C6 10nF ↓AGND
                                │           │           ├─ L7 12µH ─┬─ C8 1.8nF ↓AGND
                                │           │           │           ├─ C23 10µF ─ R4 49.9Ω → AGND
                                │           │           │           └─ TP3
                                │           │           │      （8 阶巴特沃斯，双端接 50Ω，fc≈625kHz）
LC 出 ── C9 100nF (C0G) ──► U1B.5 (+in)      U1B: 同相 ×(1+R6/R7) = 1+69.8k/10k = 7.98
                              └─ R5 10k → VBIAS    （R7 落 VBIAS 而非 GND ⇒ 直流输出 = VBIAS）
U1B.7 ── R8 100Ω ─┬─ C10 470pF ↓AGND    ← ADC 开关电容反冲隔离（fc≈3.39MHz，τ=47ns）
                  └─ JP2 (0Ω) ──► AFE_ADC_IN ──► EVK1.4 (PA1)

偏置：+3V3 ─ R9 10k ─┬─ VBIAS ─┬─ C13 10µF ↓AGND
                     │         └─ 供给 R2 / R5 / R7 三处
                     └─ R10 10k → AGND      ⇒ VBIAS = 3V3/2 = 1.650V
留位：[VREF_CORE(EVK1.2) ─ JP3 ─ VREF_ADC ─ C12 1µF ↓AGND ─ TP6]  默认全悬空
```

### 1.3 信号走向的"三个域"

| 域 | 在哪一页 | 参考地 | 成员 |
|---|---|---|---|
| **模拟域** | AFE 页 | `AGND`（单点汇 `EVK1.37`） | J1/R1/D1/C1/R2/U1/L1~L7/C2~C10/C23/R3~R10/C11~C14/TP1~TP6 |
| **数字域** | INT 页 + PWR 页 | `GND`（`EVK1.39/77/79`） | EVK1 数字脚 / J5 / R22~R41 / C16 / J3 / F1 / D2 / R15 / R16 / R21 / C21 / C22 |
| **桥** | 只有 4 条线跨域 | — | `AFE_ADC_IN`（模拟→数字）、`VBIAS`（模拟→数字，**功能上未用**）、`VREF_CORE`（数字→模拟，**悬空**）、`+5V_A`（数字→模拟） |

> **关键**：`AGND` 与 `GND` 在底板网表里**没有任何连接件** —— 唯一的汇合点是**核心板内部那颗 0Ω**。
> 这是全板模拟回流的唯一回路，也是 §8-T1 必须实测的那一条。

---

## §2 AFE 页逐块讲解（39 器件 / 21 网）

图纸上分成 6 个虚线分区：① 输入保护与端接 ② 一级缓冲与偏置注入 ③ 基准与偏置
④ 8 阶巴特沃斯抗混叠低通 ⑤ 二级增益与 ADC 驱动 ⑥ 电源去耦与 ESD。

### 2.1 ① 输入保护与端接

**电路**：`J1(SMA-KE)` ─ `R1 49.9Ω → AGND` ／ `D1 SRV05-4` ／ `TP1` ／ `C1 100nF` 串出。

| 元件 | 值 | 为什么是这个 |
|---|---|---|
| `J1` | SMA-KE 母座 | 题面是 BNC 电缆 + 50Ω 系统；SMA 座 + BNC-SMA 转接。 |
| `R1` | **49.9Ω 1%** | **50Ω 端接**。判据①匹配题面电缆；判据②**电平与源阻抗无关**（源内阻从 0 变到 50Ω 都不改读数）；判据③折叠残留的绝对值减半。**49.9 而不是 50**：E96 里 49.9 是标准值，1% 容差下回波损耗 Γ≈0.005（−46dB），足够。**布局硬约束：必须贴在 J1 中心针 2~3mm 内**，否则端接失效（端接必须在电缆口）。 |
| `D1` | SRV05-4（4 通道只用 1 路） | ESD 钳位。选它是因为 **Cj≈1.5pF**：普通 TVS 是几十 pF，会在 500kHz 处引入不可控的相位/增益漂移（这颗的 1.5pF 在 500kHz 只有 212kΩ，可忽略）。`D1.5→+5V_A`、`D1.2→AGND` 是它的钳位轨。 |
| `TP1` | 测试点 | 扫频标定的**第一个探针**（量端接节点的真实幅度）。没有它，"端接生效了吗"只能靠推。 |
| `C1` | **100nF C0G，1206** | **隔直电容**：把源端的直流偏置挡在外面，让单电源域的输入落在 VBIAS。用 **C0G** 而不是 X7R —— X7R 的容值随电压/温度漂移，会在 159Hz 拐点附近引入不可标定的相移。用 **1206** 而不是 0805 是 C0G 大容值的封装代价。 |

**信号走向**：`J1 → 节点 $3N654`。这个节点上并了 4 个东西：R1 入地（端接）、D1.4（钳位）、TP1（探针）、C1（串出）。
**这是一个"高阻点被 49.9Ω 拉低"的设计** —— 所以节点幅度 = 源 EMF 的一半。

> ⚠️ **设计取舍要说清**：端接的 ×0.5 对**信号**和**折叠残留**是**同比例**衰减，所以它**不改变"残留/信号"比**。
> 把 `R1` 写成"免费的抗混叠增益"（17 §4）在数学上会误导 —— 真正压住折叠带的是 LC 的 −59.3dB。
> 准确的表述：**端接是 50Ω 匹配的必然代价，它的顺带好处是把残留的绝对值压到门限以内**。
> 反过来说：**如果有人为了"拿回那 6dB"而把 R1 拿掉，读数会翻倍、源阻抗也变成未知** —— 别动它。

### 2.2 ② 一级缓冲与偏置注入

**电路**：`AFE_BUF_IN` = `JP1.2 / R2.1 / TP2.1 / U1.3(INA+)`；`U1.1(OUTA)` 与 `U1.2(INA−)` 短接成单位增益缓冲。

| 元件 | 值 | 为什么是这个 |
|---|---|---|
| `JP1` | 0Ω | **断点**：把"输入端接节点"与"缓冲器输入"解耦，扫频时可以在 JP1 处断开单测前半段。 |
| `R2` | 10kΩ 1% | 给 +in 提供**直流回路**到 VBIAS。与 C1 组成 159Hz 高通。取 10k 是"足够大不加载源、足够小不被运放偏置电流顶偏"的折中（OPA2197 的 Ib 是 ±5pA，10k 上只有 50nV）。 |
| `U1A` | OPA2197 半 A | **为什么必须有这一级（不能把 LC 直接挂电缆）**：<br>① 端接节点是**高阻测量点**，直接挂 LC 的话，LC 的输入阻抗会与 R1 分压，端接值不再精确；<br>② LC 的输入端有 C2（5.6nF），在 MHz 处是几 Ω 的容性负载，直接挂电缆/TVS 会让端接节点被容性扰动；<br>③ **G=1 意味着输出摆幅最小** ⇒ 对还没被滤掉的 u_J（±50mVpk）处于运放最线性的区间 —— 这一级刻意**不加增益**，就是为了不让 u_J 在这里产生 IM3。 |
| `TP2` | 测试点 | 缓冲器输入的探针（验证 C1/R2 的高通拐点）。 |

**为什么增益必须放在滤波器之后**（全篇最重要的一个判断）：
u_J 是 ±50mVpk（端接后）的大信号。如果先在运放里放大 ×8 再滤波，运放会被 u_J 推到非线性区，
产生 **IM3**，而 IM3 的产物**落在分析带内**（10k~500k）—— 此时滤波器在它后面，**根本去不掉**。
所以顺序被钉死为：**缓冲 → 滤波 → 放大**。

### 2.3 ③ 基准与偏置

**电路**：`+3V3 ─ R9 10k ─ VBIAS ─ R10 10k ─ AGND`，`VBIAS` 上挂 `C13 10µF`、`TP5`，并供给 R2/R5/R7。

| 元件 | 值 | 为什么是这个 |
|---|---|---|
| `R9`/`R10` | 10kΩ/10kΩ 1% | 分压得 **VBIAS = 3V3/2 = 1.650V**，正好是 ADC 量程中点。**取 10k 是"电流 vs 噪声"的折中**：分压支路电流 165µA（可忽略），而等效源阻抗 5k∥5k=2.5k 与 C13 组成 6.4Hz 低通，把 3V3 轨上的噪声压掉。 |
| `C13` | 10µF X7R | VBIAS 储能。因为 R2/R5/R7 三个偏置电阻会从 VBIAS 抽取瞬态电流（尤其 U1B 反相端的 10k）。**2026-10-02 已把它的地端从 `GND` 改成 `AGND`**（原先 AFE 页唯一一个 GND 落点，与"模拟地单点"自相矛盾）。 |
| `TP5` | 测试点 | 上电第一件事就是量它：应当是 1.650V。 |
| `JP3`/`C12`/`TP6` | 0Ω / 1µF / — | **外部基准留位**，默认全悬空。**注意 `R9.1` 已改接 `+3V3`**（不再接 `VREF_CORE`）—— 因为核心板排针 `REF` 针（`EVK1.2`）官方默认**不导通**（`R2` 0Ω 不贴），接上去 VBIAS 会停在 0V、整条 AFE 不作为。详见 `25 §1.1`。 |

**这条链的"为什么"**：单电源（+5V_A）运放不能处理负半周，必须把整个模拟域抬到中点。
抬到 **VREF/2**（而不是随便 1.65V）的意义是 **ratiometric**：VREF 漂 → VBIAS 同比漂 → 幅值测量自动抵消。
本设计的 VBIAS 来自底板 +3V3、VREF+ 来自核心板 VDDA（+3V3 经磁珠 + 47Ω），
两者**差 ≲0.2%**，不严格同源，但**读数取的是交流分量（Upp/Urms/FFT）**，
一个几十 mV 的直流偏置对幅值几乎无影响 —— 所以这个"不严格"是可接受的。

### 2.4 ④ 8 阶巴特沃斯抗混叠低通（本设计的技术核心）

**电路**：`R3 49.9Ω → L1 → [C2↓] → L3 → [C4↓] → L5 → [C6↓] → L7 → 输出节点`；
输出节点上 `[C8↓AGND]` 与 `[C23 10µF 串 R4 49.9Ω 入 AGND]` 两支并联。

**这是一条"双端接 LC 梯形"**：`R3` 是源端阻抗（49.9Ω）、`R4` 是负载端阻抗（49.9Ω），
中间 4L+4C = **8 阶**。

#### 为什么是"无源 LC"而不是有源
| 路线 | 结论 | 理由 |
|---|---|---|
| 有源 SK 8 阶 | 排除 | 需 GBW ≥ 205MHz 的运放（SK 规则 100·f0·Qmax），Q=2.56 有稳定性风险 |
| **无源 LC 8 阶** | **采用** | **零运放门槛**、双端接梯形**元件灵敏度低**、无稳定性问题 |
| 椭圆 n=6 | Plan B | 元件值非 E24、零点随容差漂移 |

#### 为什么 fc 落在 625kHz（不是 800kHz）
- 唯一硬频率是**折叠带起点 f_fold = fs − f_max = 2.0M − 0.5M = 1.5MHz**；
- 要求：`100mVpk(u_J) × 0.5(端接) × |H(1.5M)| × 7.98(增益) ≤ 1.5mVpk` ⇒ 滤波器归一化衰减需 **≥ −42.5dB**；
- **8 阶在 fc=800k 时 @1.5M 只有 −43.7dB，余量 1.2dB** —— 元件容差一飘就破；
- 把 fc 压到 ~660k，余量变成 **16.8dB**；代价是通带 @500k 多 droop 0.019dB ——
  **频率无关的 LTI 常数，17 点标定整条吸收**。
> **核心原则**：**余量放在阻带（判据硬约束、不可标定），损失放在通带（可标定）**。

#### 为什么是 8 阶不是 6 阶
6 阶在同 fc 下折叠带残留 **1.45 mVpk**，而门限是 **1.5 mVpk** —— **已贴脸**；
要压下去必须把 fc 降到 ≤591k，通带 @500k 掉 −0.55dB。
**多 2 颗件买 16.8dB 的阻带余量，值。**

#### 元件值是怎么来的（**不是抄标准表**）
按 8 阶巴特沃斯标准 g 值（g1..g8 = 0.3902/1.1111/1.6629/1.9616/1.9616/1.6629/1.1111/0.3902）
与 R=50Ω、fc≈660kHz 反算，理想值是：

| 位号 | 理想值 | **图纸实值** | 偏差 | 备注 |
|---|---|---|---|---|
| L1 | 4.70 µH | **4.7 µH** | 0% | XRCD54-4R7M 绕线 |
| C2 | 5.35 nF | **5.6 nF** | +4.6% | 0805CG562J500NT C0G |
| L3 | 20.03 µH | **22 µH** | +9.8% | CD54-220M 绕线 |
| C4 | 9.45 nF | **10 nF** | +5.8% | C0G |
| L5 | 23.63 µH | **22 µH** | −6.9% | CD54-220M |
| C6 | **8.01 nF** | **10 nF** | **+24.9%** | ⚠️ 见下 |
| L7 | 13.38 µH | **12 µH** | −10.3% | XRCD54-120M |
| C8 | 1.88 nF | **1.8 nF** | −4.3% | C0G |

⇒ **这是"在立创在售档位里做的拟合"，必须靠 ABCD 级联复算背书，不能凭标准表核对。**
`C6` 用 10nF（与 C4 同值）而非 8.2nF 是最大的一处偏差，代价是带内在 ~375kHz 出现 **−0.14dB** 的凹（[复算] 实测）。
仍在标定可吸收范围（残差 <0.05mV 口径）。**后来人若按"巴特沃斯标准表"核对会以为画错了 —— 这是必须写在图上的话。**

#### 独立复算（[复算]，本轮从零跑 ABCD，不引用既有报告）

| 频率 | \|H\| | 绝对 dB | 归一化 dB |
|---|---|---|---|
| 10 kHz | 0.50015 | −6.018 | 0.000（通带基准） |
| 100 kHz | 0.49938 | −6.031 | −0.013 |
| 300 kHz | 0.49384 | −6.128 | −0.110 |
| 500 kHz | 0.49897 | −6.039 | −0.021 |
| 660 kHz | 0.26199 | −11.634 | −5.616 |
| 800 kHz | 0.06570 | −23.648 | −17.630 |
| 1.0 MHz | 0.01223 | −38.250 | −32.232 |
| 1.5 MHz | 0.00054 | −65.325 | **−59.307** |
| 2.5 MHz | 0.00001 | −100.351 | −94.333 |

- **折叠带 [1.5, 2.5] MHz 最差 = −59.31 dB @1.5MHz**（判据 ≤ −42.5 dB，**余量 16.8 dB**）—— 与 `report_filter_final.md` 的 −59.30 **吻合到 0.01dB**；
- **带内 10k~500k 起伏 = 0.1413 dB**（最差点 ~375kHz）—— 与文档的 0.139 **吻合**；
- **归一化 −3dB 拐点 = 625 kHz**（图纸注释写 660k、设计方案写 648k，都是"标称设计值"；实落值 625k 是 E24 取整的后果，**不影响结论**）。

#### 三个容易被问到的细节
1. **`C23` 是干什么的**（2026-10-02 新增）：没有它时，`R3 → L1…L7 → R4 → AGND` 是一条**纯直流通路**
   （电感在直流上是短路），会白流 `1.65V/99.8Ω = 16.5 mA`，在 4 只电感和 U1B 输出级上白烧功率，
   还占掉电感 Isat 门槛的 33%。串入 C23 后**直流电流归零**。
   而 C23=10µF 在 500kHz 的阻抗只有 **31.8 mΩ** —— 对射频终接**毫无影响**。
2. **`R4` 是"终接"不是"隔离"**：它和 `R3` 一起构成双端接梯形的两个端阻抗，**改它 = 改滤波器**。
3. **`R3` 同时是两个角色**（图上注释只写了一半，见 §7-N4）：
   ① 双端接梯形的**源端阻抗**（49.9Ω，与 R4 配对）；
   ② **把 U1A 与梯形的大容性输入隔开**（C2 在 MHz 处是几 Ω，串 49.9Ω 防容性负载振铃）。
   **危险读法**：以为它只是"隔离"，随手改成 0Ω ⇒ 同时废掉匹配与源阻抗。

### 2.5 ⑤ 二级增益与 ADC 驱动

**电路**：`C9 100nF → U1B.5(+in)`，`R5 10k → VBIAS`；`R6 69.8k` 从 OUT 反馈到 `U1B.6(−in)`，`R7 10k` 从 −in 落 **VBIAS**；
`U1B.7 → R8 100Ω → [C10 470pF↓AGND] → JP2(0Ω) → AFE_ADC_IN`。

| 元件 | 值 | 为什么是这个 |
|---|---|---|
| `C9` | 100nF C0G | 第二级隔直：LC 输出的直流点就是 VBIAS（电感是直流短路），C9 把它"重新抬"到 VBIAS 进增益级。 |
| `R5` | 10kΩ | +in 的直流回路到 VBIAS。 |
| `R6`/`R7` | **69.8k / 10k，均 0.1%** | **增益 = 1 + R6/R7 = 7.98**。为什么 0.1%：增益误差是**乘性**的，靠标定能吸收，但 1% 的 R6/R7 会给标定表加 ~2% 的斜率不确定度，白吃判据余量。换 0.1% 只贵几分钱。 |
| **`R7` 落 VBIAS 而不是 GND** | — | **这是单电源设计的巧点**。若 R7 落 GND：`Vout = Vin×(1+R6/R7)`，直流输出 = 1.65V × 7.98 = **13.2V** —— 直接饱和出轨。<br>落 VBIAS 后：`Vout = VBIAS + (Vin − VBIAS)×(1+R6/R7)` ⇒ **直流输出恒等于 VBIAS = 1.650V，与增益无关**。增益只作用在交流分量上。 |
| `R8` + `C10` | 100Ω + 470pF | **ADC 开关电容反冲（kickback）隔离**：ADC 采样瞬间把内部 4pF 开关电容接到引脚上，会往运放输出灌一记电荷尖。470pF 是 100× 的电荷库，把尖压平；100Ω 限制尖峰电流。fc = 3.386MHz、τ = 47ns（采样窗 500ns 的 9.4%）—— 对 500kHz 通带毫无影响。 |
| `JP2` | 0Ω | **ADC 前断点**：断开后 AFE 与 ADC 解耦，可以单独给 ADC 注入测试信号。 |

**动态核算**（[复算]）：

| 项 | 值 |
|---|---|
| 标称增益 | 7.9800 |
| 净增益（源端→ADC） | 0.5(端接) × 0.5(LC 双端接) × 7.98 = **1.995** ⇒ 固件 `BOARD_NET_GAIN 2U` |
| 闭环 −3dB | GBW(10MHz)/7.98 = **1253 kHz** |
| 通带 droop | @100kHz **−0.028 dB**；@500kHz **−0.642 dB**（LTI 常数，17 点标定吸收） |
| 直流输出 | VBIAS = **1.650 V** |
| u_b 最坏 250mVpp ⊕ u_J 200mVpp | ADC ±**249.4 mVpk**，相对 VBIAS 轨余量 **1.40 V** |
| 不削顶的最大源端输入 | ±**827 mVpk** = 1.654 Vpp |
| ADC LSB | 805.66 µV @ADC = **403.84 µV @源端** |

### 2.6 ⑥ 电源去耦与 ESD

`+5V_A` 上：`C11 22µF 钽`（大储能）+ `C14 100nF`（高频，就近 U1.8）+ `D1.5`（TVS 钳位轨）+ `U1.8(V+)`。
`U1.4(V−) = AGND`。

| 轨 | 负载 | 电流 | 去耦 |
|---|---|---|---|
| `+5V_A` | U1 双运放静态 + D1 漏电 | **≈2 mA**（C23 修好后） | C11 22µF + C14 100nF |
| `VBIAS` | R2/R5/R7 偏置 | <0.5 mA | C13 10µF |

> **修 C23 前的口径是错的**：修前梯内有 16.5mA 直流，`+5V_A ≈2mA` 这句话**错了 9 倍**。现已成立。

---

## §3 INT 页逐块讲解（25 器件 / 53 网）

图纸上分 3 个分区：① 核心板（EVK1）② 显示与触摸（J5 30-pin）③ FSMC 串阻阵列。

### 3.1 ① 核心板 `EVK1`（LCKFB-LSPI-SkyStar-STM32F407VGT6-PRO）

84 脚中**已连 36 / 未连 48**（未连的绝大多数已打 `NO_CONNECT`，`floatingPins = 0`）。
关键脚位与用途（[活体] 网表）：

| EVK1 脚（丝印） | 网 | MCU | 用途 |
|---|---|---|---|
| 4 (A01) | `AFE_ADC_IN` | **PA1 = ADC1_IN1** | 模拟输入（SMP=3、TIM8 TRGO、DMA2_S0） |
| 9 (C04) | `VBIAS` | PC4 | 偏置自检脚 —— **⚠️ 功能上未用**，见 §7-N1 |
| 12 (C05) | `TP_INT` | PC5 | FT6336 中断输出（MCU 侧**输入 + 内部上拉**） |
| 23/24 (B10/B11) | `TP_SCL`/`TP_SDA` | PB10/PB11 | I²C2 @100kHz |
| 2 (REF) | `VREF_CORE` | — | **悬空桩**（核心板 R2 0Ω 不贴），仅作留位 |
| 37 (AGND) | `AGND` | — | 模拟地单点 |
| 38/78 (3V3) | `+3V3` | — | 核心板 LDO 输出 |
| 39/77/79 (GND) | `GND` | — | 数字地 |
| 40/80 (5V0) | `+5V` | — | 5V 输入/输出 |

### 3.2 ② 显示与触摸（`J5` 2×15 2.54 母座，30-pin 适配板）

**这是接口的单一真相源**（[活体] 网表逐脚核对）：

| J5 | 网 | EVK1 脚 | MCU | 功能 |
|---|---|---|---|---|
| 1 | `LCD_CS_J5` ←R38 33Ω← `LCD_CS` | 67 (D07) | PD7 | **FSMC_NE1** |
| 2 | `LCD_RS_J5` ←R39← `LCD_RS` | 31 (D11) | PD11 | **FSMC_A16** |
| 3 | `LCD_WR_J5` ←R40← `LCD_WR` | 69 (D05) | PD5 | **FSMC_NWE** |
| 4 | `LCD_RD_J5` ←R41← `LCD_RD` | 70 (D04) | PD4 | **FSMC_NOE** |
| 5 | `LCD_RST_J5` ←R42← `LCD_RST` | 14 (B01) | PB1 | 屏复位 |
| 6 | `LCD_D0_J5` ←R22← | 36 (D14) | PD14 | FSMC_D0　**2026-10-04 修**（原 NC） |
| 7 | `LCD_D1_J5` ←R23← | 35 (D15) | PD15 | FSMC_D1 |
| 8 | `LCD_D2_J5` ←R24← | 72 (D00) | PD0 | FSMC_D2　**修**（原 `LCD_D0_J5`） |
| 9 | `LCD_D3_J5` ←R25← | 71 (D01) | PD1 | FSMC_D3 |
| 10 | `LCD_D4_J5` ←R26← | 13 (E07) | PE7 | FSMC_D4　**修**（原 `LCD_D2_J5`） |
| 11 | `LCD_D5_J5` ←R27← | 16 (E08) | PE8 | FSMC_D5 |
| 12 | `LCD_D6_J5` ←R28← | 15 (E09) | PE9 | FSMC_D6　**修**（原 `LCD_D4_J5`） |
| 13 | `LCD_D7_J5` ←R29← | 18 (E10) | PE10 | FSMC_D7 |
| 14 | `LCD_D8_J5` ←R30← | 17 (E11) | PE11 | FSMC_D8　**修**（原 `LCD_D6_J5`） |
| 15 | `LCD_D9_J5` ←R31← | 20 (E12) | PE12 | FSMC_D9 |
| 16 | `LCD_D10_J5` ←R32← | 19 (E13) | PE13 | FSMC_D10　**修**（原 `LCD_D8_J5`） |
| 17 | `LCD_D11_J5` ←R33← | 22 (E14) | PE14 | FSMC_D11 |
| 18 | `LCD_D12_J5` ←R34← | 21 (E15) | PE15 | FSMC_D12　**修**（原 `LCD_D10_J5`） |
| 19 | `LCD_D13_J5` ←R35← | 30 (D08) | PD8 | FSMC_D13 |
| 20 | `LCD_D14_J5` ←R36← | 29 (D09) | PD9 | FSMC_D14　**修**（原 `LCD_D12_J5`） |
| 21 | `LCD_D15_J5` ←R37← | 32 (D10) | PD10 | FSMC_D15 |
| 22 | — | — | — | **NC**（适配板此脚 = `T_BUSY`，丝印为空位）　**修**（原错挂 `LCD_D14_J5`） |
| 23 | — | — | — | **NC**（适配板 T_CS 一路，未实测） |
| 24 | `TP_SCL` | 23 (B10) | PB10 | I²C2_SCL |
| 25 | — | — | — | **NC**（适配板 MISO 一路，未实测） |
| 26 | `TP_SDA` | 24 (B11) | PB11 | I²C2_SDA |
| 27 | `TP_INT` | 12 (C05) | PC5 | 触摸中断（FT6336 输出） |
| 28 | `LCD_BL_CTL` ←R12 1k← `LCD_BL_PB0` | 11 (B00) | PB0 | 背光**开关电平**（恒亮，禁 PWM） |
| 29 | `GND` | 39/77/79 | — | 地 |
| 30 | `+3V3` | 38/78 | — | 屏/触摸供电（**背光电流也从这里出**） |

**独立核对（本轮新增，[复算]）**：16 条数据线逐条对照 STM32F407 的 FSMC 复用表 ——
`D0=PD14 ✓ D1=PD15 ✓ D2=PD0 ✓ D3=PD1 ✓ D4=PE7 ✓ D5=PE8 ✓ D6=PE9 ✓ D7=PE10 ✓
D8=PE11 ✓ D9=PE12 ✓ D10=PE13 ✓ D11=PE14 ✓ D12=PE15 ✓ D13=PD8 ✓ D14=PD9 ✓ D15=PD10 ✓`
—— **一条不错**。`NE1=PD7`、`A16=PD11`、`NWE=PD5`、`NOE=PD4` 也全部正确。
这是全板最容易出错的地方（16 条线任意一条错位就是花屏/错色），**核对通过**。

**为什么用 8080-16bit 并口而不是 SPI/RGB**：16bit 并口每像素一次写，FSMC 硬件时序直出，
CPU 零参与；SPI 屏刷不动 320×480@60fps；RGB 屏要持续刷（无帧存），CPU 占用高。
代价是 20 根线 + 20 只串阻。

### 3.3 ③ FSMC 串阻阵列（`R22`~`R41`，20 只 33Ω）

**覆盖**：`D0~D15`（16 条）+ `CS` + `RS` + `WR` + `RD` = **20 条**，每条串一只 **33Ω ±1%**（0805W8F330JT5E）。

**为什么要串阻**：FSMC 走的是**排针 + 排线 + 转接板**的路径（不是紧邻 PCB 走线），
边沿的振铃谐波**整列落进 10k~500kHz 的分析带** —— 这是本板最大的**板内干扰源**。
33Ω 是"源端串联阻尼"的标准值：与线特征阻抗（~100Ω 排线）配比，把过冲压到可接受。
**不是冗余**：2 层板没有地平面兜底，这条从"优化"升级成"必做"。

> ⚠️ **图纸与 PCB 的已知偏差**：图纸把 20 只串阻**画在 J5 侧**，那是 EDA 工具限制
> （EVK1 符号的几何守卫误判，见 `18 §R-21`）。**PCB 阶段必须把它们贴到 MCU 引脚 3~5mm 以内** ——
> **放在连接器侧等于没加**（阻尼必须在信号源端）。这是交付时必须兑现的一条，见 §7-N5。

### 3.4 ③ 背光与触摸

- **背光**：`PB0(EVK1.11) ─ R12 1k ─ LCD_BL_CTL(J5.28)`。
  **R12 是栅极串阻，不是限流电阻** —— 适配板上背光由 NMOS 开关，`BL_CTL` 接栅极。
  **背光电流完全不由底板决定**（适配板把 LED-A 直挂 3.3V，无限流电阻）⇒ 见 §8-T4。
  铁律：**恒亮，禁 PWM**（PWM 谐波列全落 10~500kHz 分析带，是固定频率伪峰源）。
- **触摸**：`TP_SCL/SDA` 走 I²C2（PB10/PB11），`TP_INT` 到 PC5。
  `PC5` 固件侧配**输入 + 内部上拉（~40k）**，顶替外部 4.7k —— FT6336 的 INT 是**开漏输出**，
  MCU 侧绝不能驱动（否则对打）。INT 是慢信号，40k 上拉的边沿足够。

---

## §4 PWR 页逐块讲解（7 器件 / 8 网）

> ⚠️ **2026-10-04：现为 4 器件**。`J3`/`F1`/`D2` 已删（改由核心板 Type-C 供电，底板不带 DC 座），
> 见 `38 §3.2-①`。本节与 §3.2 的 `J3/F1/D2/+5V_IN/+5V_RAW` 条目按历史存档读。

### 4.1 ① 电源输入与防反接

```
J3(DC005) ─ J3.1 ──► F1(PPTC 1A/6V) ──► D2(SS34) ──► +5V ─┬─► C16 22µF 钽 ↓GND
   │                  (+5V_IN)        (+5V_RAW)             └─► EVK1.40/80（核心板）
   └ J3.2/J3.3 ─► GND
```

| 元件 | 值 | 为什么是这个 |
|---|---|---|
| `J3` | DC005 电源座 | 竞赛电源是 5V 直流稳压源。**J3.2 与 J3.3 都接地**（DC 座的套筒有两个脚，都接地降回流阻抗）。 |
| `F1` | PPTC **1A 保持 / 6V** | **过流保护**。底板这一路（5V→核心板→屏背光）不在核心板自带保护的覆盖范围内，外部电源反插/短路是真实场景。选 PPTC 而不是熔断器：可恢复、无需更换。1A 保持电流远高于预期负载（~0.3~0.5A）。 |
| `D2` | SS34 肖特基 | **防反接**。Vf≈0.4V（肖特基而不是普通硅管的 0.7V），@1A 时功耗 0.4W 可接受。核心板 LDO 的输入范围 4.6V 起，5−0.4=4.6V 正好够。 |
| `C16` | 22µF 钽 | 入口储能，抑制线缆电感的瞬态跌落。 |

**顺序（重要）**：`J3 → F1 → D2 → +5V`。PPTC 在二极管**之前** ——
这样二极管击穿短路时 PPTC 也能保护（若反接，D2 截止，几乎无电流，F1 不动作；正确）。

### 4.2 ② 屏接口 I²C 上拉

`+3V3 ─ R15 4.7k ─ TP_SCL`、`+3V3 ─ R16 4.7k ─ TP_SDA`。

**为什么底板上拉**：核心板的 I²C2 引脚（PB10/PB11）内部是**开漏**，必须有外部上拉。
4.7k 是 100kHz 标准 I²C 的典型值（总线电容 ≤200pF 时上升时间 ~470ns < 1µs 上限）。
**R16（SDA）可能是重复的**：官方转接板在 SDA 侧自带 4.7k ⇒ 并联成 2.35k。
100kHz 下仍然合法（只是功耗略增、边沿略陡）。**删它只省 ¥0.01，却要赌"模块批次一定有 SDA 上拉"** ——
判定：**保留**（与 `25 §3` 一致）。

### 4.3 ③ 3V3 去耦与 +5V_A

`+5V ─ R21 (0Ω) ─ +5V_A`。

**为什么是 0Ω 而不是磁珠**：600Ω@100MHz 的磁珠在 500kHz 处只有几 mΩ，**没有隔离作用**；
0Ω 保留了"可断开量测"的价值（把模拟轨与数字轨分开测电流）。
**底板不放 LDO、不放背光驱动、不做 IM 配置** —— 3.3V 全部取核心板（`EVK1.38/78`）。

> **⚠️ 本页有一处遗留注释**：图上仍写 "C19/C20 100nF：屏侧就近去耦"，但 `C19`/`C20` 已于
> 2026-10-02 删除（判为冗余：J5 侧已有 C21 10µF + C22 100nF，核心板 LDO 自带输出电容）。
> 见 §7-N4。

---

## §5 跨页信号走向矩阵（全板 10 条跨页网）

| 网名 | 成员（跨页） | 方向 | 性质 |
|---|---|---|---|
| `+5V` | INT: EVK1.40/80 · PWR: C16.1, D2.1(K), R21.1 | 电源 | 双源，但 **`D2` 已挡住双向反灌**（见 §7-N2 更正） |
| `+5V_A` | PWR: R21.2 · AFE: C11.1, C14.2, D1.5, U1.8 | 电源 | 模拟 5V 支路，仅 2mA |
| `+3V3` | INT: EVK1.38/78, J5.30 · PWR: R15.1, R16.1 · AFE: R9.1 | 电源 | 核心板 LDO 输出 |
| `GND` | INT: EVK1.39/77/79, C21.1, C22.1, J5.29 · PWR: C16.2, J3.2/3 | 地 | 数字地 |
| `AGND` | INT: EVK1.37 · AFE: 18 个成员 | 地 | 模拟地，**只经核心板 0Ω 与 GND 相连** |
| `AFE_ADC_IN` | AFE: JP2.2 · INT: EVK1.4(PA1) | **模拟→数字** | 唯一的模拟信号跨域点 |
| `VBIAS` | AFE: C13.1/R2.2/R5.2/R7.2/R9.2/R10.1/TP5.1 · INT: EVK1.9(PC4) | 模拟→数字 | ⚠️ **功能上未用**，见 §7-N1 |
| `VREF_CORE` | AFE: JP3.2 · INT: EVK1.2(REF) | 数字→模拟 | ⚠️ **悬空桩**（留位） |
| `TP_SCL` / `TP_SDA` | INT: J5.24/26, EVK1.23/24 · PWR: R15.2/R16.2 | 双向 | I²C2 + 上拉 |
| `LCD_*_J5`（20 张） | INT: R22~R41:2 + J5 对应脚 | 数字 | FSMC 屏侧网（串阻之后） |

**网表卫生（[活体] 核对）**：全板 **82 张网**，**无单引脚网、无同名异网、无孤儿旗标**；
10 条跨页网全部成对。

---

## §6 独立复算汇总（[复算]，脚本 `_archive/_review4/afe_recheck.py`，可复跑）

| 项 | 本轮结果 | 判据 / 对照 |
|---|---|---|
| 折叠带 [1.5,2.5]MHz 最差 | **−59.31 dB** @1.5MHz | ≤ −42.5 dB ⇒ **余量 16.8 dB**；与 `report_filter_final.md` 的 −59.30 吻合 |
| 带内 10k~500k 起伏 | **0.1413 dB** | 文档 0.139 ⇒ 吻合；17 点标定吸收 |
| 归一化 −3dB 拐点 | **625 kHz** | 图纸注释 660k / 设计值 648k（标称），实落 625k |
| 通带基准（双端接 ×0.5） | −6.018 dB | 梯形固有插损 |
| u_J 200mVpp @1.5MHz → ADC | **0.216 mVpk** | 门限 1.5 mVpk ⇒ **余量 6.9×** |
| u_J 200mVpp @1.0MHz → ADC | 4.88 mVpk | **超门限 3.3×** —— 但折到 DC/带外，见下 |
| 增益（U1B） | 7.9800 | R6/R7 均 0.1% |
| 净增益（源端→ADC） | **1.995** | 固件 `BOARD_NET_GAIN 2U` |
| 闭环 −3dB / droop@500k | 1253 kHz / −0.642 dB | LTI 常数，标定吸收 |
| 不削顶最大源端输入 | ±827 mVpk (1.654 Vpp) | 轨余量 1.40V @ u_b 最坏 |
| ADC LSB | 805.66 µV @ADC / **403.84 µV @源端** | 与 `report_dsp_verify.md` 一致 |
| 输入高通（C1/R2） | 159.2 Hz | 分析带下限 10kHz ⇒ 余量 63× |
| ADC 抗反冲 RC | 3.386 MHz / τ=47ns | 采样窗 500ns 的 9.4% |
| 梯内直流 | 修前 16.5 mA → **修后 0** | C23 隔直 |
| C23 在 500kHz 阻抗 | 31.8 mΩ | 对终接无影响 |
| 电感峰值电流 | 1.25 mA pk | CD54 额定 ~100mA ⇒ 80× 余量 |

> **⚠️ 一条必须写下来的边界条件**：判据 `1.5 mVpk` **只适用于会折进分析带的成分，即 f ≥ 1.5MHz**。
> 实测 u_J 在 **1.0 MHz** 时 ADC 上是 **4.88 mVpk**（比门限高 3.3×）—— 它之所以无害，是因为
> `fs=2.0MHz` 下 1.0MHz 整落 Nyquist bin（折到 DC）、1.0~1.5MHz 折到 0.5~1.0MHz（带外）。
> **⇒ 这个设计对"分析带上限 = 500kHz"这条题面条款是强依赖的**：
> 若将来把分析带拓宽（或 fs 下调），余量会瞬间塌掉。**改动 fs 或 f_max 前必须重跑本复算。**

---

## §7 评审发现（按级别）

### P2

**N2 · `+5V` 是双源（DC 座 + 核心板 Type-C VBUS 同网）** —— ⚠️ **2026-10-03 更正：本条原判 P1，过头了**

> **更正依据（按网表重推，见 `hardware/28 §5.1`）**：
> 底板 `+5V` 是 **`D2` 的阴极**，而核心板 Type-C VBUS 也在 `+5V` 上。于是：
> - **USB 反灌 DC 座**：USB 把 `+5V` 抬到 5.0V ⇒ `D2` 阴极=5.0V、阳极=DC 源输出（≈5.0V）
>   ⇒ **`D2` 零偏/反偏、不导通** ⇒ 反灌被 `D2` 挡住 ✅
> - **DC 座反灌 USB**：DC → `+5V` 走的是 `D2` 的**正向**（这正是正常供电路径）；
>   `+5V` → `J3` 是 `D2` 的**反向**，被挡 ✅
> - **两路同时供电**：谁电压高谁供，`D2` 让 DC 支路天然"退让"，不会互灌 ✅
>
> ⇒ **`D2` 这一个器件本身就覆盖了双向反灌**，原判把"没有 ORing 器件"当成了风险，是漏看了 `D2` 的方向。
>
> **真正的残余风险只剩一条**：核心板 Type-C VBUS 与排针 5V **在核心板内部**是否 ORing ——
> 这决定"DC 供电时会不会把 5V 灌进 PC 的 USB 口"。核心板资料写了"防反接（排针脚有可能接反）"，
> 暗示排针 5V 入有保护；但**资料包是 VET6 版、实物是 VGT6-PRO**，不能靠推断。
> **处置**：保留 `hardware/23 §1` 的 T2 实测；使用说明写"调试时避免同时接 DC 与 USB"。

### P2

**N1 · `VBIAS → PC4` 是一条"图纸说有、固件说不用"的死线**
[活体] 图纸：`VBIAS` 跨页引到 `EVK1.9 = PC4`。固件：`PC4` 配成 **GPIO 输入、不驱动、不配 ADC1_IN14**
（`board_config.h` 的 `BOARD_VBIAS_SENSE_*`），"模拟轨在线"改由 **AFE 帧直流均值**判。
⇒ 该脚高阻，这条网**既不驱动也不测量**，在电气上是**装饰**。
- **风险**：接板人看到 "VBIAS → PC4" 会以为固件在采偏置（"为什么我的 ch14 读不到"）。
- **建议**：二选一 —— ① 图纸把 `EVK1.9` 打 NC、VBIAS 只留 `TP5`（并把 `.ioc` 的 PC4 配置删掉）；
  ② 保留接线，但在图上加一行注释"**PC4 = 只读探针，固件不采**"。
  **推荐 ②**（改动最小，且保留了"将来要采就能采"的余地）。

**N3 · `LCD_RST` 没有串阻**
`R22`~`R41` 覆盖了 `D0~D15 + CS + RS + WR + RD`（20 条），唯独 `LCD_RST`（`EVK1.14 → J5.5`）直连。
RST 与其它控制线**同源同类**（长走线、强边沿），理论上有同样的振铃风险。
- **建议**：补一只 33Ω（`R42`），或明确接受（RST 只在初始化时翻转一次，对采样窗影响远小于总线）。
  **成本 ¥0.01，建议补。**

**N5 · 20 只 33Ω 串阻在图纸上画在 J5 侧，PCB 必须贴到 MCU 侧**
这是 EDA 工具限制（`18 §R-21`），**不是设计错误**，但**是交付风险**：
放连接器侧等于没加（阻尼必须在源端）。
- **建议**：把这条写进 **PCB 投板检查单的第一行**，并在图纸上加一行醒目标注。

**N4 · 三处注释口径过期，会误导接板人**
| 位置 | 图上现在写的 | 事实 |
|---|---|---|
| PWR 页 | "C19/C20 100nF：屏侧就近去耦" | C19/C20 已于 2026-10-02 删除 |
| INT 页 ③ 分区框 | 标题 "FSMC 串阻阵列（R22~R39）" | 实为 **R22~R41**（20 只，10-02 补了 WR/RD） |
| AFE 页顶部 | "VREF 取自核心板 EVK1.2（板载 REF3030 3.0V 或内部 3V3）" | `REF` 针**悬空**、`VREF+ ≈ 3.3V`、`R9.1` 已改接 `+3V3`（`25 §1.1`） |
| AFE 页 ② 区 | "R3 49.9Ω **隔离**缓冲输出与后续 LC 网络" | R3 同时是**双端接梯形的源端阻抗**，改它=改滤波器（§2.4-3） |
- **建议**：按 `25 §7` 的做法做一轮**注释换代**（改注释前先 `sch text-list` 盘点、改完删旧代）。

### P3

**N6 · `+5V_A` 的隔离度可以零成本再拿一档**
现在 `+5V → +5V_A` 只有 `R21 (0Ω)`。修好 C23 后 `+5V_A` 只剩 **~2mA**。
把它换成 **4.7Ω + 现有 C11 22µF** ⇒ RC 拐点 **1.5kHz**，2mA 下只掉 **9.4mV**（0.19%），
却在 1.5kHz 以上给模拟轨 **20dB 量级**的隔离 —— 而数字轨上挂着屏背光/FSMC 的几十~几百 mA 开关电流。
**这是当前性价比最高的一处改动**（只换一颗电阻的值）。

**N7 · `AGND`/`GND` 的唯一回路在核心板，底板无备份**
底板网表里 `AGND` 与 `GND` **没有任何连接件**，唯一的汇合点是**核心板内部那颗 0Ω**。
资料包是 **VET6 版**，实物是 **VGT6-PRO**，不是同一块板 —— 不能靠推断。
- **症状隐蔽**：不通的话**不报错**，只是噪声底变差、读数缓慢漂移。
- **建议**：底板预留一个 0Ω 位置（默认**不贴**，只许一个点）；上板第一件事量通断（§8-T1）。

**N8 · `C6`=10nF 偏离理想值 25%（不是缺陷，是"必须写在图上的话"）**
8 阶巴特沃斯第 3 节电容理想 8.01nF，图纸用 10nF（与 C4 同值）。代价是带内 ~375kHz 出现 −0.14dB 凹。
**结论：可接受**（LTI 可标定）。但**后来人按"标准表"核对会以为画错** ⇒ 图上应写明"按在售 E24 值拟合，见复算报告"。

**N9 · `R8`=100Ω 与 ADC 采样时间 3 周期是一组"绑死的约束"**
`SMP=3`（3 ADCCLK = 83ns）+ 12 周期转换 = 15 周期/417ns ⇒ 上限 2.4MSPS（取 2.0MSPS）。
F4 在 t_s=3 周期下要求 `R_AIN ≤ 0.4kΩ`，本设计 `R8=100Ω`，**余量 4×**。
⇒ **R8 不能再加大**（比如为了抗反冲改成 470Ω 就会破坏 12bit 精度）；
要加大就必须把 t_s 提到 15 周期，而那会把吞吐压到 1.33MSPS、**破坏 `fs=2.0MHz` 的冻结参数**。
**改任一个都要重跑整条 DSP 复算。**

**N10 · `D1` 的钳位电平高于 U1A 的绝对最大输入（鲁棒性备注）**
SRV05-4 的工作电压是 5V、钳位点 ~9V+；而 U1A 的绝对最大输入是 `V+ +0.5V = 5.5V`。
它挡得住 ESD 尖峰，**挡不住持续过压**。若有人把 >3.3Vpp 的大信号直接灌进 SMA，
U1A 会先于 D1 导通而受损。
⇒ 竞赛场景（信号源输出可预期）**可接受**；若要更稳，在 U1A 的 +in 前串 100Ω
（但会改高通拐点，需重算）。

**N11 · `.ioc` 回填清单里没有 PC4/PC5 的 GPIO 模式**
`firmware/docs/11 §11.2` 列了 6 项必须在 CubeMX 里逐条确认的开关（TIM8/ADC1/RCC/FSMC/FreeRTOS/USB），
但**没有 PC4/PC5 的 GPIO 模式**。这两条是**安全攸关**的：
`PC4` 若被生成成输出（历史形态 `TP_RST` 初始高）会**向模拟偏置轨灌电流**；
`PC5` 若被生成成输出会**与 FT6336 的开漏 INT 对打**。
⇒ 建议把这两条加进 §11.2 的核对表（`.ioc` 本身已改对，重生成不会丢；但**人做清单时应该看一眼**）。

---

## §8 上板前必测（只能拿万用表/实物核的物理事实）

| # | 测什么 | 为什么 | 怎么测 | 判据 / 不通过怎么办 |
|---|---|---|---|---|
| **T1** | `EVK1.37(AGND)` ↔ `EVK1.39/77/79(GND)` 通断 | 底板 `AGND`/`GND` 无连接件，全靠核心板那颗 0Ω（资料是 VET6 版、实物是 VGT6-PRO） | 断电，蜂鸣档 | ≤1Ω ⇒ 收工；**不通 ⇒ 底板必须自己加 0Ω 单点**（只许一个点） |
| **T2** | 核心板 5V 排针 ↔ Type-C VBUS 通断 | 查核心板内部是否 ORing（`D2` 只护到底板这一侧） | 断电，蜂鸣档 | 直通 ⇒ 核心板内部无 ORing ⇒ **使用说明写死"调试时别同时接 DC 与 USB"** |
| **T3** | 背光电流（3.3V 轨上） | 屏是 4 颗并联 LED、恒流 60mA、Vf 3.1V；适配板 LED-A 直挂 3.3V 且**无限流电阻** ⇒ 电流由 Vf-I 曲线决定，可能远超 60mA（威胁 LDO 与适配板） | 可调电源 3.3V 单独供模块 + 串毫安表 | 54~66mA ⇒ 收工；偏大 ⇒ 割适配板 `LED-A→3V3` 铜皮串限流电阻 |
| **T4** | `EVK1.2`(REF 针) 对地电压 | 坐实 §2.3 的改动（官方说悬空，但实物是 PRO 版） | 上电 30s 万用表 | ≈3.3V ⇒ 改动依然正确（同源）；≈0V ⇒ 正是 `25 §1.1` 修的 bug。两种情况都回填 |
| **T5** | 转接板 `IM[2:0]` 与 `DE/PCLK/VSYNC/HSYNC` | 出厂默认未必是 8080-16bit | 对丝印量 6 个 0Ω 的贴装 | 要 `IM[2:0]=010`（**已由用户实测确认 ✅**）；DE 组仍建议顺手量 |

> **上板前第一件事（顺序不能反）**：`T1` → `T2` → `T4` → 限流上电 → 量 `TP5`(VBIAS 应 1.650V)
> → 量 `U1.1`(应 ≈1.650V) → 量 `TP4`(应 ≈1.650V，不饱和) → 再上信号源。

---

## §9 证据与复现

```bash
# ① 三页活体网表（本轮用）
python _archive/_review3/netlist_now.py AFE INT PWR          # 读 _archive/_review3/final_{AFE,INT,PWR}.json（utf-16）

# ② 三页渲染（本轮导出，Black on White）
easyeda sch export-image --page fe840e6f545a2753 --scope page --format png --out _archive/_review4/AFE.png
easyeda sch export-image --page 63accad121e053cf --scope page --format png --out _archive/_review4/INT.png
easyeda sch export-image --page 0c870c063661db6c --scope page --format png --out _archive/_review4/PWR.png

# ③ 独立复算
<py> _archive/_review4/afe_recheck.py

# ④ 工程页面清单
easyeda doc ls          # AFE-前端模拟 / INT-核心板与接口 / PWR-电源与背光
```

**本轮产物**：`_archive/_review4/AFE.png` · `_archive/_review4/INT.png` · `_archive/_review4/PWR.png`（含切片 `*_s*.png`）·
`_archive/_review4/afe_recheck.py` · `_archive/_review4/信号流图册.html`（可视化版）· `_archive/_review3/netlist_now.py`。

**本轮未做**：未改图纸、未改固件、未上板。所有"上板会怎样"一律按**未验证**口径。

---

## §10 变更记录

| 日期 | 内容 |
|---|---|
| 2026-10-03 | 首版。三页活体网表重建 + 三页 PNG 渲染 + AFE 独立 ABCD 复算（与既有报告交叉验证吻合）+ 11 条评审发现（1 P1 / 4 P2 / 6 P3）+ 5 条上板必测。 |
