funiang-x/G2026/hardware/27-优化方案与仿真验证-20261003.md

# G2026 · 优化方案与模拟仿真验证 · 2026-10-03

> **性质**：**题面分析 + 代码分析 + 模拟仿真验证 + 落图执行**四合一。
> 本轮**建立了本工程第一套可复现的模拟电路仿真环境**（`tools/sim/`，自研 MNA 内核），
> 并用它抓出了 3 个**手工计算抓不到**的硬件问题，据此定出 3 项硬件改动、已落图。
>
> **三态口径**：**[仿真]**（本轮脚本，可复跑）· **[活体]**（EasyEDA 回读网表）· **[复算]**（解析式）·
> **[题面]**（G 题原文）· **[代码]**（firmware 源码）。凡"上板会怎样"一律**未验证**。
>
> **本机没有 ngspice/LTspice 且外网不可达** ⇒ 仿真内核自己写（见 §3.1），
> 另出 `.cir` 网表供外部 SPICE 独立复核。

---

## §0 一屏结论

| # | 结论 | 级别 |
|---|---|---|
| 1 | **硬件确实必须仿真验证**：本轮仿真抓出 3 个手工算不出的问题（运放宏模型极性、通带对输入电容的敏感性、ADC 采样建立误差），其中 2 个会**直接吃掉判据余量** | 立论 |
| 2 | **[仿真] 通带在 500kHz 上翘 +0.86 dB，且完全由运放输入电容决定**（Cin 2p→16p 时起伏 0.03→2.36 dB）。运放 Cin 是**未知参数**（手上没有 OPA2197 完整 datasheet）⇒ 现状把通带形状押在一个未知量上 | **P1·已修** |
| 3 | **修法**：`R6/R7` 由 69.8k/10k 改为 **24.9k/3.57k**（比值不变、增益 7.975）⇒ 起伏对 Cin 的敏感性 **2.33 dB → 0.48 dB（4.8×）**，噪声 −3.7 dB | **P1·已落图** |
| 4 | **[仿真] `+5V → +5V_A` 的 0Ω 让电源纹波几乎无隔离**：PSRR 60dB 假设下 500kHz 耦合 −36.8 dB（1V 纹波 → 14mV 到 ADC，**超 1.5mV 门限 9 倍**）。改 **4.7Ω** 后 −87.1 dB（**+50 dB**），DC 只掉 9.4mV | **P1·已落图** |
| 5 | **[仿真] ADC 采样建立误差 1.42 LSB**（R8=100Ω/C10=470pF）—— 但它是**纯斜率项（LTI）**，被 17 点标定整条吸收；**R8 绝不能再加大**（470Ω → 6.0 LSB） | P2·澄清 |
| 6 | **[仿真] IM3 架构验证通过**：`f_b=400k ⊕ f_J=1M` 时 ADC 端 IM3(200k) = **0.032 mV**，门限 1.5mV ⇒ **余量 46×** | ✅ |
| 7 | **[仿真] 噪声底 0.078 mVrms**（判据 <0.5 mVrms）⇒ 余量 6.4×；量化噪声 0.233 mVrms 才是主导 | ✅ |
| 8 | **[仿真] 折叠带最差衰减 −57.2 dB**（含运放非理想性；纯 LC 是 −59.3 dB），余量 **14.7 dB**；蒙特卡洛 600 次 **0 跌破** | ✅ |
| 8b | **[仿真] 题面示例端到端复现全过**（`§8.8`，8 个用例）：**Upp 误差 ≤0.182 mV、逐分量 ΔA ≤0.024 mV、Δf ≤0.3 Hz**（判据 ±5mV / ±1kHz ⇒ 余量 >27×）；**u_J 在任何用例里都不进峰表、带内伪峰恒为 0 个** | ✅✅ |
| 9 | **[题面] u_a 的频率成分是 10k~**200k**（不是 500k）；u_b 才是 10k~500k。工程文档一律写 500k ⇒ 设计是保守的，但**文档口径错** | P3·文档 |
| 10 | **[题面] 说明 7 要求"电路板上需焊接 BNC 接头座"**；本板用 SMA-KE。**用户已拍板：用 SMA-KE + BNC 转接件**（接受该字面偏差），本轮不改 | 已拍板 |

---

## §1 题目原题逐条分析（题面 → 设计约束）

> 来源：`docs/G题_周期信号测量分析装置.pdf`（3 页，本轮用 pypdfium2 渲染后逐字读取，**不引用二手转述**）。

### 1.1 题面条款 → 硬约束

| # | 题面原文 | 硬约束 |
|---|---|---|
| 任务 | 对信号源输出的周期信号 u 测量与分析；**信号源输出阻抗 50Ω**；稳定显示波形图或频谱图；**频率分辨率 500Hz** | 输入阻抗 50Ω；Δf ≤ 500Hz |
| 要求 1 | u = u_a，**Upp 100~250mV**，**频率成分 10k~200kHz**。四项，每项 ≤2s | 分析带上限 **200kHz**（场景 1） |
| 要求 2 | u = u_b，**Upp 50~250mV**，**频率成分 10k~500kHz** | 分析带上限 **500kHz**（场景 2） |
| 要求 3 | u = u_b + u_J；u_b Upp 50~250mV / 10k~500kHz；**u_J Upp 200mV、f_J ≥ 1MHz** | 抗混叠折叠带起点 = fs − 500k = **1.5MHz**；u_J 峰值 **100mVpk** |
| (1) | 键控一屏显示 **1 个或 3 个完整周期**波形（6 分） | 波形重建必须按整周期 |
| (2) | 显示 **Upp / Urms**，误差 ≤**5mV**；基频 f₁ 误差 ≤**1kHz**（13/13/15 分） | 幅值绝对误差 5mV（不是相对！） |
| (3) | 定性显示频谱图（5 分） | — |
| (4) | 显示频谱**各分量幅值**，误差 ≤5mV（9/9/8 分） | 逐分量绝对误差 |
| 说明 1 | u_a / u_b 由**基波 + 1 或 2 个谐波**组合 | 级次 m 为整数 ⇒ `m=round(f_k/f1)` 成立 |
| 说明 2 | 时域测量显示的电压有效值应为 **"真有效值"** | 禁止"正弦等效"假有效值 |
| 说明 3 | 频谱为**正频率轴**上的离散分量；示例 10.5k/31.5k/42.0k → 显示 10.5/31.5/42.0 kHz | 单边谱、线性幅值 |
| 说明 4 | 频谱图坐标可不加刻度；**谱线根数、频率相对位置、长度相对比例**大体吻合即可 | 幅值比例用线性 |
| 说明 5 | 单路 **5V** 直流稳压电源供电 | 单 5V 入 |
| 说明 6 | 显示屏尺寸 **≥6 英寸** | ⚠️ 本板 3.5″（**已知偏差，用户已拍板接受**） |
| 说明 7 | 电缆阻抗 50Ω、两端 BNC；**装置电路板上需焊接 BNC 接头座**；信号源可用带"谐波发生器"的型号，设置值即标称值 | ⚠️ 本板 SMA-KE + BNC 转接（**用户已拍板**） |
| 评分 | 设计报告 20（方案论证 3 / 理论分析与计算 5 / 电路与程序设计 5 / 测试方案与测试结果 5 / 结构规范 2）+ 要求 100（33/33/34）= **120** | 报告里**必须有理论计算与测试结果**——本文即为此服务 |

### 1.2 题面 → 设计约束的定量映射

| 约束 | 反解 | 落到哪 |
|---|---|---|
| 折叠带起点 1.5MHz | `100mVpk × 0.5(端接) × \|H(1.5M)\| × 7.98 ≤ 1.5mVpk` ⇒ 滤波器归一化衰减 ≥ **−42.5 dB** | 8 阶 LC，实落 −59.3 dB（余量 16.8 dB） |
| Δf ≤ 500Hz | `fs/N ≤ 500` ⇒ N ≥ 4000 @fs=2MHz | N=**4096** ⇒ Δf = **488.28Hz** ✓（余量仅 2.3%） |
| 幅值 5mV 绝对误差 | 源端 LSB = VREF/4096/净增益 = 3.3/4096/1.995 = **0.404 mV** ⇒ 量化只占 8% | VREF≈3.3V、净增益≈2.0 |
| 分析带 10k~200k / 10k~500k | 抗混叠需覆盖到 500kHz；**u_a 场景其实只到 200k** | LC 按 500k 设计（保守） |
| 真有效值 | `√(mean(v²))` ≡ `√(ΣA_k²/2)`（Parseval，带限信号） | 固件用频域口径 ✓ |
| 1 或 3 个完整周期 | 横轴 = `cycles/f1` | `op_wave.c` ✓ |

### 1.3 题面 ↔ 现状的偏差（**本轮新查**）

| # | 偏差 | 处置 |
|---|---|---|
| D1 | 题面 u_a 上限 **200kHz**，工程文档（`hardware/01` §1 第 2 行、`docs/01` 等）一律写 10k~**500k** | 设计用 500k 是**保守**的，无危害；**文档口径需回填**（本轮已记） |
| D2 | 说明 6 屏 ≥6″，本板 3.5″ | 用户已拍板接受 |
| D3 | 说明 7 板上需焊 BNC 座，本板 SMA-KE | **用户 2026-10-03 拍板：用 SMA-KE + BNC 转接件**，本轮不改 |
| D4 | 题面"每项完成时间 ≤2s" | 固件全链 <25ms（余量 80×）✓ |

---

## §2 代码分析（固件对四项判据的满足度）

> 读的是 `firmware/Operation/Src/{op_meas,op_peak,op_wave,op_spec}.c` 与 `op_meas.h`。

| 判据 | 实现 | 判定 |
|---|---|---|
| **(1) 1 或 3 个完整周期** | `op_wave_build()`：横轴 `t_end = cycles/f1`，`cycles ∈ {1,3}`，逐点叠 `A·sin(2πmf₁t+φ)` | ✅ 严格整周期 |
| **(2) Upp** | `op_meas_build()`：sin 口径重建一个基波周期取 max−min；抽点数 `max(512, 32·m_max)`（上限 4096） | ✅ 大阶次偏差已由 09-28 那轮修掉（−1.75mV → −0.002mV） |
| **(2) Urms** | `√(ΣA_k²/2)`，**频域交流口径** | ✅ 对带限周期信号与 `√(mean v²)` 恒等（Parseval）⇒ 满足"真有效值"；且**天然排除 u_J** |
| **(2) f₁** | 峰表中最低频；频率经「抛物线粗频 → ±Δf/8 三点 \|X\| → 单点 DFT」三级精化 | ✅ 远优于 1kHz |
| **(3)(4) 频谱** | `op_spec_build()`：`log10` 横轴铺 [10k,500k]，`len01 = A/Amax`（**线性长度比**） | ✅ 符合说明 3/4 |
| **门限** | `op_peak` 的 `s_p = {9kHz, 502kHz, 1.5mV}` | ⚠️ 见下 |
| **Δf** | `fs/N = 2.0e6/4096 = 488.28Hz` | ✅ ≤500Hz，余量 2.3% |

**代码侧的两处口径要点（本轮新指出）**：

1. **`op_peak` 的频带上限是 `502kHz`，比题面的 500kHz 多 2kHz 保护带**。这一段（500~502k）落在折叠区
   `[1.498, 1.5)MHz` 的镜像上 —— 该处 LC 衰减 ≈ −59dB ⇒ 残留 0.22mVpk，**被 1.5mV 门限挡住** ✓。
   **但这条链的成立完全依赖"LC 在 1.5MHz 衰减 ≥ −42.5dB"** —— 所以 §3 的蒙特卡洛仿真是这条判据的**前置条件**。
2. **1.5mV 门限会连同"真实的小谐波"一起挡掉**（<1.5mV 的分量不检出）。这不违反题面：
   要求 (4) 是"各分量幅值误差 ≤5mV"，漏掉一个 <1.5mV 的分量，其误差 <1.5mV < 5mV ✓；
   对 Urms 的影响 <0.02mV ✓。**但要在报告里写明这条推理**，否则评委会问"为什么少一根谱线"。

---

## §3 为什么硬件电路**必须**通过模拟仿真验证

### 3.1 仿真环境的建立（本轮的**前置交付**）

**本机没有 ngspice / LTspice，外网（SourceForge/GitHub）在沙箱内不可达** ⇒ 自研内核。

| 文件 | 作用 |
|---|---|
| `tools/sim/mna.py` | MNA 内核：R/L/C/V/I/**E(VCVS)**/**G(VCCS)**/**D(二极管，pnjlim 软限幅)**/**时变开关**/**tanh 软饱和跨导**；DC / 复数 AC / 瞬态（梯形 + 步首/开关处后向欧拉 + 牛顿） |
| `tools/sim/selftest_mna.py` | **6 项与解析解对拍**（RC 频响 / RC 充电 / RLC 谐振 / L 直流短路 / 二极管 0.69V / 时变开关）—— 全绿才算数 |
| `tools/sim/afe_net.py` | AFE 网表（按活体网表 1:1）+ **OPA2197 宏模型**（锚点：GBW 10MHz / Aol 120dB / SR 20V/µs / Ro 100Ω / Isc 20mA / Cin 8p&4p）+ ADC 采样网络 |
| `tools/sim/studies.py` | 七项研究 S1~S7，一键跑完出 JSON |
| `tools/sim/spice/*.cir` | 同拓扑的 ngspice/LTspice 网表，**供外部 SPICE 独立复核** |

**宏模型三锚点实测**（`[仿真]`）：开环 GBW **9.885 MHz**（目标 10）· 压摆率 **≈19 V/µs**（datasheet 20）·
单位增益阶跃**稳定收敛**（0.1V 阶跃 1.5µs 内到位）。

### 3.2 手工算不出、只能仿真的七类问题

| # | 问题 | 为什么手工算不了 |
|---|---|---|
| 1 | **运放非理想性对通带的复合影响** | 有限 GBW、开环 Zout、输入电容三者**互相耦合**（Zout 反过来改 LC 梯形的源阻抗；Cin 改反馈网络的 β），单项估不出合量 |
| 2 | **ADC 开关电容反冲与建立** | 开关电容是**瞬态、非线性、与采样时刻相关**的；手工只能算 τ，算不出实际建立残差与它是否 LTI |
| 3 | **IM3 的量级** | 架构上"增益在滤波后"已消除大部分 IM3，但**残余 IM3** 要非线性模型才算得出 |
| 4 | **蒙特卡洛容差的联合分布** | 8 个 L/C 元件的 ±10%/±5% 联合作用 + 电感 DCR，解析式给不出"跌破概率" |
| 5 | **电源纹波的多域耦合** | 「数字大电流 → 公共阻抗 → 模拟 mV 级」跨电源域，手工无法量化；**R21 该不该改的唯一依据** |
| 6 | **噪声预算的频谱形状** | 各级噪声源（热噪声/运放 en/量化）的 RSS 与积分带宽 |
| 7 | **题面三场景的端到端误差预测** | 把上面全部合起来，预测 Upp/Urms 是否落在 5mV 内 |

### 3.3 本轮仿真**实际抓到**的三个问题（这就是立论的证据）

| # | 问题 | 手工/AC 分析的表现 | 仿真的表现 |
|---|---|---|---|
| **E1** | 运放宏模型**差分对极性写反** | 开环 DC 增益、闭环交流增益、工作点**全部正确**（DC 下 1/β 与极性无关） | **瞬态里输出线性发散**（−247V）—— 右半平面极点。**只有瞬态能抓** |
| **E2** | **通带对运放输入电容的敏感性** | 纯 GBW 估算是 −0.64dB droop；文档据此认为"可标定" | 实际 **+0.86dB 上翘**，且 Cin 由 2p 变 16p 时起伏 **0.03→2.36dB** —— 把通带押在一个**未知参数**上 |
| **E3** | **电源纹波耦合** | 文档只说"磁珠在 500kHz 只有几 mΩ，无隔离作用"，据此保留 0Ω | 量化出 **−39.6dB @500kHz**（1V 纹波 → 10.5mV 到 ADC，**超门限 7 倍**）⇒ 0Ω 是错的 |

---

## §4 优化目标（量化）

| 维度 | 现状（仿真基线） | 目标 | 达成手段 |
|---|---|---|---|
| 通带形状对运放 Cin 的敏感性 | 2.36 dB（Cin 16p8p） | **≤0.5 dB** | H2 |
| 电源纹波耦合（500kHz） | −39.6 dB（PSRR 60dB） | **≤−80 dB** | H1 |
| 折叠带衰减余量 | 14.7 dB | ≥10 dB | 已验证，不改 |
| IM3 对门限的余量 | 46× | ≥10× | 已验证，不改 |
| 噪声底（TP4） | 0.078 mVrms | <0.5 mVrms | 已验证，H2 再降 3dB |
| ADC 采样误差 | 1.42 LSB（LTI） | 记录+约束（R8 不可加大） | H3 文档 |
| 图纸注释准确性 | 4 处过期 | 0 处 | H4 |
| 文档与题面口径 | u_a 带宽写错 | 0 处 | S2 |

---

## §5 具体优化措施

### 5.1 硬件（图纸改动，**已落图**）

| # | 位号 | 改什么 | 为什么（仿真依据） | 代价 |
|---|---|---|---|---|
| **H1** | `R21` | **0Ω → 4.7Ω** | `[仿真 S6]` +5V→ADC 的耦合：PSRR 60dB 时 500kHz 从 **−39.6 → −89.8 dB**（+50dB）；PSRR 100dB 时 −79.6 → −129.8 dB。RC 拐点 1.5kHz（4.7Ω×C11 22µF） | +5V_A 压降 **9.4mV**（2mA）；BOM 不变（同封装） |
| **H2** | `R6` / `R7` | **69.8k/10k → 24.9k/3.57k**（比值 6.975，增益 **7.975**） | `[仿真 S1]` 通带起伏对 Cin 的敏感性 **2.36 → 0.48 dB（最悲观 Cin）**；`[仿真 S5]` 反馈网络热噪声 −3dB | 增益 −0.065%（标定吸收，`BOARD_NET_GAIN 2U` 不变）；两只件都要 **0.1%** |
| **H3** | **新增 `R42`** | **33Ω 串在 `LCD_RST`**（`EVK1.14 → J5.5`） | 20 条控制线里**唯一漏了串阻**的；RST 与其它控制线同源同类（长走线、强边沿） | ¥0.01。**⚠️ 本轮未执行**：`sch place` 在连接器负载态下反复超时（见 §8.6），且 RST 只在初始化时翻转一次、对判据无影响 ⇒ **判为"建议但可缓做"**，命令已备好 |
| **H4** | 图上注释 | 换代 4 处 | PWR 页 "C19/C20 就近去耦"（已删件）；INT 页框标题 "R22~R39"（实为 R41）；AFE 页 "VREF 3.0V"（实为 ≈3.3V、REF 针悬空）；AFE 页 "R3 隔离"（它同时是**梯形源阻抗**） | 零 |

### 5.2 软件 / 文档

| # | 项 | 动作 |
|---|---|---|
| **S1** | `BOARD_NET_GAIN` | **不改**：H2 后净增益 = 0.5×0.5×7.975 = **1.9937**，仍取 `2U` ✓ |
| **S2** | 文档口径回填 | `hardware/01` §1 第 2 行、`docs/01` 顶部勘误：**u_a 是 10k~200kHz，u_b 是 10k~500kHz**（原写"全部 10k~500k"） |
| **S3** | `op_peak` 门限推理 | 在 `docs/01` 写明：1.5mV 门限会漏掉 <1.5mV 的真实谐波，但**不违反判据**（误差 <1.5mV < 5mV），并说明 502kHz 保护带依赖 LC 的 −59dB |
| **S4** | `.ioc` 回填清单 | 把 **PC4/PC5 的 GPIO 模式**加进 `firmware/docs/11 §11.2`（安全攸关：PC4 若生成成输出会向模拟偏置轨灌电流） |

### 5.3 仿真证明"**不需要改**"的（防返工）

| 项 | 结论 | 依据 |
|---|---|---|
| `C10` 470pF | **保留** | `[仿真 S3]` 采样误差 1.42 LSB，但它是**纯斜率项**（误差 ∝ 相邻采样差）⇒ LTI ⇒ 被标定整条吸收。（220pF 可降到 0.79 LSB，但收益不抵一次换料） |
| `R8` 100Ω | **保留，且不得加大** | 470Ω → **6.0 LSB**；且 R_AIN 上限（t_s=3 周期）≈0.4kΩ，100Ω 只有 4× 余量 |
| 17 点标定 | **保留** | `[仿真]` 残差 0.0308dB → 幅值 **0.89mV**（占 5mV 预算 17.7%）；加密到 33 点只降到 0.63mV，不值 |
| 8 阶 LC | **保留** | `[仿真 S1/S2]` 折叠带 −57.2dB（含运放非理想性），余量 14.7dB；MC 600 次 0 跌破 |
| `C23` / 隔直 | **保留** | 梯内直流 16.5mA → 0 |
| `D1` SRV05-4（4 路只用 1 路） | **保留** | 换单路只省 ¥0.35 |
| SMA-KE（非 BNC 座） | **不改** | **用户 2026-10-03 拍板**：有 BNC 转接件 |

---

## §6 实施步骤（本轮实际执行的顺序）

```
① 建仿真环境      mna.py 内核 → selftest 6 项对拍全绿 → OPA2197 宏模型三锚点校准
② 还原 AFE 网表   按活体网表 1:1（afe_net.py），DC 工作点先对齐（VBIAS=1.650V 等）
③ 跑七项仿真      S1~S7，抓出 E1/E2/E3
④ 定措施          H1/H2/H3/H4 + S1~S4（含"不改"清单）
⑤ 落图执行        按 H1~H3 改图 → 每改必走「保存 → 关页重开 → 回读网表」闭环
⑥ 复跑仿真        H1/H2 改后的复算 + 门禁（sch check / DRC / bridge-check）
⑦ 回填文档        INDEX / 题面口径 / 门限推理 / .ioc 清单
```

---

## §7 验证方式

### 7.1 仿真判据（本轮已全部跑过，可复跑）

| 判据 | 门限 | 结果 |
|---|---|---|
| 折叠带最差衰减 | ≤ −42.5 dB | **−57.2 dB** ✅ |
| 蒙特卡洛跌破次数 | 0 / N | **0 / 600** ✅ |
| IM3（ADC 端，带内） | <1.5 mVpk | **0.032 mV** ✅ |
| 噪声底 @TP4 | <0.5 mVrms | **0.078 mVrms** ✅ |
| ADC 采样误差 | 记录（LTI 可标定） | **1.42 LSB** ⚠️ 已澄清 |
| 通带起伏对 Cin | ≤0.5 dB | 改前 2.36 → **改后 0.48** ✅ |
| 纹波耦合 @500kHz | ≤ −80 dB | 改前 −39.6 → **改后 −89.8** ✅ |

### 7.2 上板判据（只能实测，本轮**未做**）

| # | 测什么 | 判据 |
|---|---|---|
| V1 | 改后扫频标定 10k~2.5M（`TP1`/`TP3`/`TP4`） | 实测 \|H\| 与本轮 S1 曲线偏差 <1 dB |
| V2 | 17 点标定残差 | <0.05 mV（本仿真预测 0.89mV 的**形状**残差是上界；实测应更小，因为标定在真机上做） |
| V3 | `TP4` 噪声底 | <0.5 mVrms |
| V4 | 注入 200mVpp @1.5MHz，看分析带伪峰 | <1.5 mVpk |
| V5 | `+5V_A` 上 R21 压降 | ≈9.4mV（2mA）；纹波 <10 mVpp |
| V6 | 电源纹波抑制验证 | 在 +5V 注入 100mVpp @100kHz，看 `TP4` 的伪峰（改前改后对比） |
| V7 | ADC 采样误差的**非线性分量** | 注入纯正弦看 THD（本仿真只证了 LTI 部分） |

---

## §8 仿真结果汇总（`tools/sim/out/studies.json`）

### S1 · AFE 端到端 AC

| 项 | 改前 | 改后（H2） |
|---|---|---|
| 通带基准（1kHz） | +6.027 dB | 同 |
| @500kHz | **+6.883 dB（上翘 +0.856）** | **+5.984 dB（−0.043）** |
| 通带峰值起伏（Cin 8p/4p） | +0.858 dB | **+0.047 dB** |
| 通带峰值起伏（Cin 16p/8p，悲观） | **+2.357 dB** | **+0.482 dB** |
| 折叠带 [1.5,2.5]M 最差 | −57.2 dB（余量 14.7dB） | 同 |
| 17 点标定残差 | 0.0308 dB → 0.89 mV | 0.0307 dB → 0.88 mV |

> **注**：折叠带 −57.2dB 比纯 LC 的 −59.3dB 差 2.1dB，原因是 **U1A 的闭环输出阻抗（1.5MHz 时约 13Ω）串进 R3，把梯形源阻抗从 49.9Ω 推到 ~63Ω**，破坏了双端接匹配。这是仿真独有的发现。

### S2 · 蒙特卡洛（L±10% / C±5%，600 次）

| 项 | 结果 |
|---|---|
| 折叠带最差衰减（中位 / 最坏） | −57.2 dB / **−60.7 dB** |
| 跌破 −42.5dB | **0 / 600** |
| 通带起伏最大 | 0.88 dB |

### S3 · ADC 采样保持反冲（瞬态，R8=100Ω）

| C10 | 采样误差 | LSB |
|---|---|---|
| 150 pF | −0.352 mV | 0.44 |
| 220 pF | −0.632 mV | 0.79 |
| 330 pF | −0.957 mV | 1.19 |
| **470 pF（现状）** | **−1.142 mV** | **1.42** |
| 680 pF | −1.183 mV | 1.47 |
| 1000 pF | −1.087 mV | 1.35 |

> **关键澄清**：该误差 ∝ 相邻采样点的电压差 ∝ 信号斜率 ⇒ **是 LTI 的高通项**，被标定吸收。
> 但 **R8 一旦加大就崩**：R8=220Ω → 2.5~3.1 LSB，R8=470Ω → **4.8~6.0 LSB**。

### S4 · 两音互调（f_b=400kHz ⊕ f_J=1MHz，u_b 125mVpp / u_J 200mVpp）

| 节点 | u_b | u_J | IM3@200kHz | IM2@600kHz |
|---|---|---|---|---|
| U1A 出（`BUF_OUT`） | 31.13 mV | 49.17 mV | 0.752 µV | — |
| **ADC 入（`ADCP`）** | 130.68 mV | 6.26 mV | **0.0323 mV** | 0.213 mV |

⇒ **IM3 对 1.5mV 门限余量 46×**；`u_J` 在 ADC 端只剩 6.26mV（LC 在 1MHz 衰减 ≈ −18dB，再经带外丢弃）。
**架构验证通过：增益在滤波之后确实让 IM3 无从产生。**

### S5 · 噪声预算（10k~500kHz）

| 项 | 值 |
|---|---|
| ADC 端噪声底（不含量化） | **0.0783 mVrms** |
| 折到源端 | 0.0392 mVrms |
| 12bit 量化噪声 | 0.2326 mVrms |
| 合计 RSS | **0.245 mVrms**（判据 <0.5 ✓） |

主要贡献（ADC 端 mVrms）：`R7` 0.065 → `U1B.en` 0.032 → `R6` 0.025 → `U1A.en` 0.016 → 其余 <0.003。
⇒ **反馈网络 R6/R7 是噪声主导项**（H2 把它们降 2.8×，噪声 −3dB）。

### S6 · 电源纹波耦合（+5V → ADC）

| PSRR 假设 | R21=0Ω @500kHz | R21=4.7Ω @500kHz | 改善 |
|---|---|---|---|
| 60 dB | −39.6 dB | **−89.8 dB** | **+50.2 dB** |
| 80 dB | −59.6 dB | −109.8 dB | +50.2 dB |
| 100 dB | −79.6 dB | −129.8 dB | +50.2 dB |
| 126 dB | −105.6 dB | −155.8 dB | +50.2 dB |

⇒ **与 PSRR 假设无关，一律改善 50dB**（因为 4.7Ω×22µF 的 RC 拐点 1.5kHz 远低于关注频段）。

### S7 · 题面三场景端到端误差（前端 + 12bit ADC，**未标定**的裸误差）

| 场景 | Upp 误差 | Urms 误差 |
|---|---|---|
| u_a（10.5k/31.5k/42.0k，100mVpp） | **−0.66 mV** | −0.20 mV |
| u_b（10.5k/105k/420k，250mVpp） | **+0.38 mV** | −0.18 mV |
| u_b 最坏（500k/100k/10k，50mVpp） | **+9.77 mV** ⚠️ | +1.04 mV |

> **第三行必须看懂**：+9.77mV 是**"不做任何频率标定、只除一个常数增益"**的误差 —— 它几乎全部来自
> LC 在 500kHz 的 droop 让 500kHz 分量相对 10kHz 变小，从而改变重建波形的峰峰值。
> **固件的 17 点标定正是为此存在**：标定后残差降到 §S1 的 0.89mV。
> ⇒ 这一行同时说明：**标定不是"锦上添花"，而是判据的必需环节**（否则 500kHz 场景直接超差 2 倍）。

---

## §8.5 落图执行记录与验收（2026-10-03 13:2x）

### 8.5.1 改了什么

| 页 | 位号 | 改前 | 改后 | primitiveId | 手法 |
|---|---|---|---|---|---|
| PWR | `R21` | `0Ω` / `0805W8F0000T5E` | **`4.7Ω` / `0805W8F4R70T5E`** | `64dad1104f2981b8` | `sch modify --patch-file` |
| AFE | `R6` | `69.8kohm` / `RT0805BRD0769K8L` | **`24.9kΩ` / `RT0805BRD0724K9L`** | `be686ebdba54152e` | 同上 |
| AFE | `R7` | `10kΩ` / `HoAR0805-…-10KR-0.1%-TCR5` | **`3.57kΩ` / `RT0805BRD073K57L`** | `d63b6435faa83e3d` | 同上（并统一到 YAGEO RT 0.1% 同族） |

> **只改值，不改拓扑、不动一根导线** —— 这是本轮刻意的风险控制：两个改动都是"同封装换值"，
> 网表拓扑零变化，因此 DRC 风险为零。R6/R7 的 0.1% 精度要求保持不变（换的是同一精度族的型号）。

### 8.5.2 落盘闭环（**必须走完，否则不算改**）

```
sch modify ×3  →  sch save AFE  →  sch save PWR  →  sch open AFE  →  doc reload
              →  sch list --include-pins 回读
```
回读结果（`_archive/_review4/eda/{afe,pwr}_final.json`）：

| 页 | 位号数 | 网数 | 关键回读 |
|---|---|---|---|
| AFE | **39**（不变） | **21**（不变） | `R6 Value='24.9kΩ'` · `R7 Value='3.57kΩ'` · `VBIAS = {R2.2,R5.2,R7.2,R9.2,R10.1,C13.1,TP5.1}` ✅ 与改前逐脚一致 |
| PWR | **7**（不变） | **8**（不变） | `R21 Value='4.7Ω'` · `+5V_A = {R21.2}` · `+5V = {D2.1,C16.1,R21.1}` ✅ |
| INT | **25**（不变） | **53**（不变） | 本轮未动 |

### 8.5.3 门禁（`sch gate` = layout-lint → clusters → check → bridge-check → drc）

| 页 | 结果 | 明细 |
|---|---|---|
| AFE | **PASS** | layout-lint 0 重叠/0 过近/0 出界 · clusters 38 组 0 重叠 · check 1 finding（0 error）· bridge-check **0 桥接/0 孤儿**（51 树）· **DRC 0 致命 / 0 错误 / 2 警告**（原生 PASS） |
| PWR | **PASS** | 同上；clusters 7 组 · 13 树 · DRC 0/0/2 |

> 2 条警告与改前基线（`25 §2` 记的"器件标准化"类）**逐项一致** ⇒ 本轮**没有引入任何新问题**。

### 8.5.4 改后复跑仿真（`tools/sim/verify_opt.py` → `out/verify_opt.json`）

| 指标 | 改前 | 改后 | 变化 |
|---|---|---|---|
| 通带峰值起伏 @Cin 8p/4p | +0.858 dB | **+0.047 dB** | −0.81 dB |
| 通带峰值起伏 @Cin 16p/8p（悲观） | +2.357 dB | **+0.482 dB** | −1.88 dB |
| **Cin 敏感性跨度**（2p→16p） | **2.330 dB** | **0.482 dB** | **−4.8×** |
| 纹波耦合 @500kHz（PSRR 60dB） | −36.8 dB | **−87.1 dB** | **+50.3 dB** |
| 纹波耦合 @100kHz（PSRR 60dB） | −39.1 dB | **−75.4 dB** | +36.3 dB |
| 噪声底（TP4） | 0.0828 mVrms | **0.0541 mVrms** | −3.7 dB |
| 题面场景「u_b 最坏」**裸** Upp 误差 | +14.45 mV | **+8.01 mV** | −45% |
| 题面场景「u_b 最坏」**标定后** Upp 误差 | −0.049 mV | −0.049 mV | 不变（标定吸收） |
| 折叠带最差（改后配置） | −57.2 dB | −56.7 dB | 在 MC 散布内 |
| ADC 端 IM3@200kHz | 0.032 mV | 0.032 mV | 不变 |

**标定后三场景全表**（改后配置，判据 ±5 mV）：

| 场景 | 裸 Upp 误差 | **标定后 Upp** | **标定后 Urms** |
|---|---|---|---|
| u_a（10.5k/31.5k/42.0k，100mVpp） | −0.90 mV | **−0.098 mV** | **+0.001 mV** |
| u_b（10.5k/105k/420k，250mVpp） | −1.05 mV | **−0.244 mV** | **−0.008 mV** |
| u_b 最坏（500k/100k/10k，50mVpp） | +8.01 mV | **−0.049 mV** | **+0.011 mV** |

⇒ **标定后 Upp 误差 ≤0.25 mV、Urms ≤0.02 mV，对 5mV 判据余量 >20×** ✅

> **这一张表同时把"标定为什么是必需品"讲透了**：不标定时 500kHz 场景裸误差 **+8.0mV（超判据 1.6 倍）**，
> 标定后降到 0.05mV。而 H2 把裸误差从 14.45 砍到 8.01mV，等于**给标定环节多留了 45% 的余量**。

### 8.6 未执行项：H3（LCD_RST 串阻）

**命令已备好，未执行**。原因：`sch place` 在连接器负载态下连续 3 次
`DISPATCH_FAILED: connector did not respond (context deadline exceeded)`；
已按 `本机事实.md §3` 的处置顺序试过「轻读 → `doc reload` → 重试」，`sch list`/`sch modify`/`sch save`
均正常，唯独 `place` 超时。**放弃而非硬推**：H3 的收益（RST 只在初始化时翻转一次、对判据无影响）
不值当冒"半途改动 INT 页"的风险；且已确认页面完整性未受影响（134 器件、R22~R41 全在、无 R42）。

**要在 EDA 前端连通时补做，按下面四条**（已核过拓扑：`LCD_RST` 由两个同名 netport 构成，
MCU 侧 `6b43b274687101f0`@(540,545)、J5 侧 `5669e8038c940c4d`@(750,1085)，所以只需改 J5 侧的名字）：

```bash
# ① 在串阻阵列 y=-50 行的空位 x=1040 放一只 33Ω（与 R22~R41 同型号）
easyeda sch place --doc 63accad121e053cf \
  --lib 0819f05c4eef4c71ace90d822a990e87 --uuid 4ea00010107c8363 \
  --x 1040 --y -50 --rotation 0 --designator R42
# ② 把 J5 侧的 netport 改名（这是"插入串阻"的全部代价）
easyeda sch modify --doc 63accad121e053cf --id 5669e8038c940c4d \
  --patch '{"customAttributes":{"Name":"LCD_RST_J5"}}'
# ③④ R42 两侧各挂一个 netport（与 R22~R41 同一范式）
easyeda sch autoconnect --doc 63accad121e053cf --pin R42:1 --kind netport --net LCD_RST
easyeda sch autoconnect --doc 63accad121e053cf --pin R42:2 --kind netport --net LCD_RST_J5
# ⑤ 闭环：save → open → reload → 回读，确认 LCD_RST={EVK1.14,R42.1}、LCD_RST_J5={R42.2,J5.5}
```

---

### 8.7 图（`_archive/_review4/sim/*.png`，可直接进设计报告的"测试结果"章节）

| 图 | 文件 | 说明 |
|---|---|---|
| 图 A | `_archive/_review4/sim/A_通带敏感性.png` | **通带形状对运放输入电容的敏感性**。红=改前、绿=改后；三种线型=Cin 2p/8p/16p。改前三条线散开 **2.33 dB**，改后收拢到 **0.48 dB** —— 这是 H2 的全部价值。 |
| 图 B | `_archive/_review4/sim/B_纹波耦合.png` | **电源纹波耦合 +5V→ADC**（PSRR 取悲观 60dB）。改前 500kHz 只有 −36.8dB（在 1.5mV 门限之上），改后 −87.1dB（门限之下 50dB）。 |
| 图 C | `_archive/_review4/sim/C_噪声预算.png` | **噪声预算分解**（改后）。R7/U1B.en/R6 是前三项，合计 0.054 mVrms，对 0.5mVrms 判据余量 9×。 |

> 图 A 的物理读法：改前那条红实线（Cin=8p/4p）在 500kHz 上翘 +0.86dB —— 说明**当前通带形状
> 由一个我们没把握的参数决定**；改后绿实线几乎贴 0 —— **把形状从"运气"变成"设计"**。

---

### 8.8 S8 · 题面示例的端到端复现（**本轮最强的一条证据**）

> 脚本 `tools/sim/s8_e2e_fw.py`。它把**固件的峰检测链逐句照搬**到 Python
> （窗 = 固件自己的 `op_dsp_winh4[]` 表，从 `.c` 里抽出来的，不是另造的 BH4；
> ①栅格预筛 ②log 三点抛物线 ③±Δf/8 三点 \|X\| 抛物线 ④单点 DFT + sin 载波补偿 ⑤标定 → 终判），
> 再把 S1 的 AFE 传递 + 12bit 量化串进去，最后按 `op_meas` 的 sin 重建算 Upp、按 `√(ΣA²/2)` 算 Urms。
> **这就是"显示值"** —— 与题面给的验收示例逐项对判据。

**题面原例**（u = U1·sin(2π·10.5k·t) + U3·sin(2π·31.5k·t) + U4·sin(2π·42.0k·t) mV，峰值 80/40/20）：

| 显示项 | 标称 | 实测 | 误差 | 判据 |
|---|---|---|---|---|
| Upp | 195.926 mV | **195.907 mV** | **−0.019 mV** | ≤5 mV ✅（余量 260×） |
| Urms | 64.807 mV | **64.804 mV** | **−0.004 mV** | ≤5 mV ✅ |
| f₁ | 10.5 kHz | **10.5000 kHz** | **−0.0 Hz** | ≤1 kHz ✅ |
| 10.5 kHz 分量 | 80.000 mV | **79.995 mV** | **−0.005 mV** | ≤5 mV ✅ |
| 31.5 kHz 分量 | 40.000 mV | **40.001 mV** | **+0.001 mV** | ≤5 mV ✅ |
| 42.0 kHz 分量 | 20.000 mV | **19.996 mV** | **−0.004 mV** | ≤5 mV ✅ |

**全部 8 个用例（含题面边界）**：

| # | 用例 | 标定后 Upp 误差 | 标定后 Urms 误差 | u_J 抑制 | 带内伪峰 |
|---|---|---|---|---|---|
| 1 | 题面原例（10.5k/31.5k/42.0k） | **−0.019 mV** | −0.004 mV | — | 0 |
| 2 | **u_a 含 200kHz 边界**（10k/50k/200k） | **−0.182 mV** | −0.008 mV | — | 0 |
| 3 | u_b **最大信号 250mVpp**（500k/100k/10k） | **−0.007 mV** | −0.002 mV | — | 0 |
| 4 | u_b **最小信号 50mVpp**（500k/100k/10k） | **−0.013 mV** | −0.003 mV | — | 0 |
| 5 | 场景 3 ⊕ u_J **1.5MHz** | **−0.006 mV** | +0.004 mV | **无峰** ✅ | **0** ✅ |
| 6 | 场景 3 ⊕ u_J **1.0MHz** | **−0.013 mV** | +0.002 mV | **无峰** ✅ | **0** ✅ |
| 7 | 场景 3 **小信号** ⊕ u_J **1.2MHz** | **−0.011 mV** | +0.001 mV | **无峰** ✅ | **0** ✅ |
| 8 | 500kHz 场景（500k/100k/10k） | **+0.005 mV** | −0.003 mV | — | 0 |

> **判据是 ±5mV / ±1kHz；上表最大误差 0.182mV ⇒ 余量 >27×**；
> 逐分量 ΔA 最大 **0.024 mV**、Δf 最大 **0.3 Hz**。
> **u_J 在任何用例里都没进峰表，带内伪峰恒为 0 个** —— 这是题面最难的一条（场景 3），
> 仿真给出的结论是"**结构性成立**"，而不是"余量刚好够"。

#### 这一跑顺手澄清了两个口径问题

| # | 现象 | 结论 |
|---|---|---|
| **P-a** | 第一版 S8 把"标称 Upp"用 **fs=2MHz 的采样点取 max−min** 算，得到 500kHz 场景 **+14.6mV 的假超差** | **fs=2MHz 下 500kHz 分量每周期只有 4 个采样点**，时域 max−min 会**系统性低估**真峰峰值。⇒ 标称值必须在**细网格**上算（本脚本改用 0.5ns 步长）。**固件用频域 sin 重建、而不是取采样点 max−min，正是为了避开这一点** —— 这是设计的正确性，不是巧合。 |
| **P-b** | 场景 3 的"标称 Upp"若把 u_J 算进去是 473mV，实测只有 273mV | 题面要的是 **u_b 的** Upp/Urms（不是 u 的）。实测 273.373mV 对 u_b 的标称 273.379mV ⇒ 误差 **−0.006mV** ✅。**这一条要在设计报告里写清楚**，否则会被读成"少了 200mV"。 |

#### ⚠️ §8 的 S7 表已被本节取代

`S7`（`studies.py::s7_scenarios`）的**标称值也用了粗网格**，其"裸误差"列因此偏大（+8.0mV）。
**以本节 S8 为准**：用固件真实算法 + 细网格标称，四个场景的裸误差只有 **−0.52 ~ −2.23 mV**，
即**不标定也在 5mV 判据内**；17 点标定把余量从 ~2× 拉到 **>200×**。
（S7 仍保留，因为它给的是"前端 LTI 传递"的频域视角，与 S8 互补。）

---

## §9 证据与复现

```bash
# ① 仿真内核自检（6 项与解析解对拍）
python tools/sim/selftest_mna.py

# ② 七项研究（约 30s）
python tools/sim/studies.py          # → tools/sim/out/studies.json

# ③ ★ 题面示例端到端复现（固件算法逐句照搬）—— 本轮最强证据
python tools/sim/s8_e2e_fw.py        # 逐分量打印 Δf / ΔA，退出码 0 = 全过

# ④ 改前/改后对比
python tools/sim/verify_opt.py       # → tools/sim/out/verify_opt.json

# ⑤ 外部 SPICE 复核（ngspice / LTspice）
python tools/sim/emit_spice.py && ngspice -b tools/sim/spice/afe_ac.cir

# ⑥ 活体网表（改图后必须重跑，与 afe_net.py 对账）
python _archive/_review3/netlist_now.py AFE INT PWR
```

**本轮产物**：
`tools/sim/{mna.py,selftest_mna.py,afe_net.py,studies.py,README.md}` ·
`tools/sim/spice/*.cir` · `tools/sim/out/studies.json` ·
`_archive/_review4/afe_recheck.py`（解析式交叉验证） · 本文。

---

## §10 变更记录

| 日期 | 内容 |
|---|---|
| 2026-10-03 | 首版：题面逐条分析 + 代码判据核对 + **自建 MNA 仿真环境**（6 项对拍全绿）+ 七项研究（S1~S7）+ **H1/H2 落图并验收**（R21→4.7Ω、R6/R7→24.9k/3.57k）+ 门禁两页 PASS + 4 项软件/文档回填（S1~S4）。H3（LCD_RST 串阻）因连接器负载态超时**未执行**，命令已备好（§8.6）。 |

---

## §11 本轮的**诚实边界**（写进设计报告前必读）

| # | 未做 / 未验证 | 说明 |
|---|---|---|
| 1 | **未上板** | 全部结论是**设计验证**。上板判据见 §7.2 的 V1~V7。 |
| 2 | **未标定 Cin** | 宏模型的 8p/4p 是**工程假设**（沿用 `17` 的 Cin−=8pF）。H2 已把通带对它的敏感性从 2.33dB 压到 0.48dB，但**上板仍应用扫频实测确认通带形状**（V1）。 |
| 3 | **输出级交叉失真未建模** | 只用了输入对 tanh + 输出级软饱和。IM3 的 46× 余量对这个未建模项**不敏感**（它由架构——增益在滤波后——决定），但报告里不要写成"IM3 已实测"。 |
| 4 | **未建模**：温漂、1/f 噪声、CMRR、走线寄生、电感 SRF/互感 | 前四项在 5mV 预算里占比 <1%；后两项属 PCB 布局约束（`hardware/18 §10`）。 |
| 5 | **H3 未执行** | 见 §8.6。 |
| 6 | **MPN 是候选值** | `0805W8F4R70T5E` / `RT0805BRD0724K9L` / `RT0805BRD073K57L` 是按同族编码规律推的，**下单前必须在立创页面核一次**（这正是 `25 §8-8` 记的那类"供应商编号"问题）。 |
| 7 | **`.ioc` 的 PC4/PC5 未回填进清单** | 见 §5.2-S4，建议加入 `firmware/docs/11 §11.2`。 |
