funiang-x/G2026/hardware/28-三链走向与剩余优化-20261003.md

# G2026 · 三条链的走向 + 剩余优化 + 8080 稳定性 · 2026-10-03

> **性质**：把用户问的四件事一次讲透 —— **① 供电怎么走 · ② 信号处理怎么走 · ③ 8080 屏信号怎么保证稳定 ·
> ④ 还有什么能优化**。所有数字都标了三态来源：**[活体]**（EDA 回读网表）· **[复算]**（脚本）·
> **[仿真]**（`tools/sim/`）· **[题面]**（G 题原文）· **[代码]**（firmware 源码）。
>
> **配套**：`26`（逐块讲解与评审）· `27`（优化方案与仿真验证）· `tools/sim/`（仿真链）。

---

## §0 一屏结论

| # | 结论 |
|---|---|
| 1 | **供电是"三级串"结构**：`DC5V →(F1 PPTC → D2 防反)→ +5V →(R21 4.7Ω)→ +5V_A` 供模拟；核心板 LDO 出 `+3V3` 供屏/触摸/背光 + 经 `R9` 生成 `VBIAS`。**三条网、两个域、一个单点地**。 |
| 2 | **信号处理是"模拟 → 数字 → 显示"三段**：8 阶 LC 抗混叠 + ×7.98 增益 → 12bit/2.0MSPS ADC → BH4+三点精化峰检测 + 17 点标定 → Upp/Urms/频谱 → LVGL → FSMC 8080 → 屏。 |
| 3 | **8080 稳定性靠六层保障**，其中**源端 33Ω 串阻**与**采样窗静默**是两根主梁；本轮用解析式量化了 33Ω 的阻尼效果（台面场景过冲 47%→8%）。 |
| 4 | **剩余可优化项：3 项已量化后否决、3 项受阻于工具链、1 项是最大风险（屏尺寸）**。**结论：不需要重构原理图** —— 见 §6 的理由。 |
| 5 | **本轮修正了两处我自己的过头判断**：`+5V` 双源（D2 本身就挡住反灌，降为 P2）与 S9 的集总瞬态模型（数字不可信，已改成解析式）。 |

---

## §1 供电怎么走的（**[活体]** 网表）

### 1.1 全树（含实测/仿真数值）

```
J3 (DC005 电源座) ── J3.1 ──┬─ F1  PPTC 1A保持/6V  ── 网名 +5V_IN
                            │      (过流保护，可恢复)
                            └─ F1.2 ── D2  SS34 肖特基 ── 网名 +5V_RAW
                                   (防反接，Vf≈0.3V@0.1A)
                                        │
                    ┌───────────────────┴────────────────────┐
                    ▼  网名 +5V  (C16 22µF 钽 = 入口储能)      │
        ┌───────────┴────────────┐                            │
        ▼                        ▼                            │
  EVK1.40 / EVK1.80        R21 = 4.7Ω  ★2026-10-03 由 0Ω 改    │
  （核心板 5V 入）              │                              │
        │                       ▼  网名 +5V_A  (4.9906V)       │
        │              C11 22µF 钽 + C14 100nF                  │
        │                       ├──► U1.8  (V+) OPA2197 双运放  │
        │                       └──► D1.5  (SRV05-4 钳位轨)     │
        │                                                      │
        ▼                                                      │
  核心板 LDO SCJA1117B-3.3（核心板自带钽电容）                    │
        │                                                      │
        ▼  网名 +3V3                                           │
  EVK1.38 / EVK1.78                                            │
        ├──► J5.30（30-pin 适配板）──► 屏 IOVCC + 触摸 + **背光** ┘
        │         └─ J5 侧就近去耦：C21 10µF + C22 100nF
        ├──► R15 / R16  4.7k（I²C2 上拉）
        └──► R9 10k ──┬── 网名 VBIAS = 1.650V ──┬── C13 10µF → AGND
                      │                        └── 供给 R2 / R5 / R7 三处偏置
                      └── R10 10k → AGND

地：GND（EVK1.39/77/79 + J3.2/3 + C16/C21/C22/J5.29）
    AGND（EVK1.37 + AFE 页 18 个成员）
    ⇒ **两者在底板上没有任何连接件**，唯一回路是核心板内部那颗 0Ω（上板必测，`23 §1`）
```

### 1.2 电流与压降预算（**[复算]**）

| 轨 | 负载 | 电流 | 压降/损耗 | 去耦 |
|---|---|---|---|---|
| `+5V_RAW` | F1 之前 | ~0.1 A | F1 ≈ 50mV（PPTC 常温） | — |
| `+5V` | D2 之后 → 核心板 + 底板 | ~0.1 A | **D2 ≈ 0.3V**（主要损耗） | C16 22µF |
| `+5V_A` | U1 双运放静态 + D1 漏电 | **2 mA** | **R21 ≈ 9.4mV**（4.7Ω×2mA） | C11 22µF + C14 100nF |
| `+3V3` | 屏逻辑 ~20mA + 触摸 ~1mA + **背光 54~66mA（未定）** + I²C 上拉 1.4mA | **~80~90 mA** | 核心板 LDO 上 **1.7V×0.09A ≈ 0.15 W** | C21 10µF + C22 100nF |
| `VBIAS` | R9/R10 分压 165µA + R2/R5/R7 偏置 <0.5mA | <0.7 mA | — | C13 10µF |

**三条值得记住的账**：
1. **D2 的 0.3V 是这套电源里最大的"计划内损耗"** —— 换来防反接；核心板 LDO 的输入还有 4.7V，够。
2. **`+5V_A` 只吃 2mA** —— 所以 `R21` 从 0Ω 改 4.7Ω 只掉 9.4mV，却买到 **50dB** 的纹波隔离（`27 §8.5`）。
3. **背光电流是唯一没定的大项**（题面没给，适配板把 LED-A 直挂 3.3V 且无限流电阻）⇒ 它是 `+3V3` 的主要负载，
   也是 LDO 发热的唯一风险源（上板必测，`23 §1` 的 T4）。

### 1.3 供电上的三个薄弱点（**按严重度**）

| # | 薄弱点 | 现状 | 处置 |
|---|---|---|---|
| **P-1** | **背光电流未知**（可能远超 60mA） | `+3V3` 由核心板 LDO 供，J5 只有 1 根 3V3 + 1 根 GND 针；适配板 LED-A 直挂 3.3V | **底板侧无解**（改底板会同时压屏逻辑）。走适配板割线串阻，或换 1000亮度板（自带恒流源）。上板第一件事就测 |
| **P-2** | **`+5V` 双源**（DC 座 + 核心板 Type-C VBUS 同网） | 见 §5.1 的**修正**：D2 本身就挡住了双向反灌 | 降为 P2；保留 T2 实测（查核心板排针 5V 入是否另有保护）；使用说明写"调试时避免同时接" |
| **P-3** | **`AGND`/`GND` 唯一回路在核心板** | 底板无连接件；资料包是 VET6 版、实物 VGT6-PRO | 上板前断电测通断（`23 §1` T1）；不通则底板补 0Ω 单点 |

---

## §2 信号处理怎么走的（**[活体]** + **[代码]**）

### 2.1 模拟域（AFE 页，从 SMA 到 MCU 引脚）

```
J1 (SMA-KE, 50Ω)
 ├─ R1 49.9Ω → AGND         50Ω 端接（贴座 ≤3mm）   ×0.5
 ├─ D1.4 SRV05-4            ESD 钳位（Cj 1.5pF）
 ├─ TP1                     测试点：端接节点
 └─ C1 100nF C0G            隔直（与 R2 组成 159Hz 高通）
      └─ JP1 (0Ω 断点) ──► AFE_BUF_IN ─┬─ U1A.3 (+in)
                                       └─ R2 10k → VBIAS
U1A: 单位增益缓冲 G=1（U1.1 OUT ↔ U1.2 −in 短接）
     职责：高阻读端接节点 / 低阻驱动 LC / 摆幅最小 ⇒ u_J 在它这里最线性
U1A.1 ── R3 49.9Ω ──► L1 4.7µH ─┬─ C2 5.6nF ↓
                                ├─ L3 22µH ─┬─ C4 10nF ↓
                                │           ├─ L5 22µH ─┬─ C6 10nF ↓
                                │           │           ├─ L7 12µH ─┬─ C8 1.8nF ↓
                                │           │           │           ├─ C23 10µF ─ R4 49.9Ω → AGND
                                │           │           │           └─ TP3
      8 阶巴特沃斯，双端接 50Ω，fc≈625kHz，折叠带最差 −57.2dB   ×0.5
LC 出 ── C9 100nF C0G ──► U1B.5 (+in)     U1B: 同相 ×(1+R6/R7) = 1+24.9k/3.57k = 7.975
                          └─ R5 10k → VBIAS      ★R6/R7 2026-10-03 由 69.8k/10k 改
U1B.7 ── R8 100Ω ─┬─ C10 470pF ↓AGND     ADC 开关电容反冲隔离（fc 3.39MHz，τ 47ns）
                  └─ JP2 (0Ω 断点) ──► AFE_ADC_IN ──► EVK1.4 (PA1)
```

**净增益** = 0.5（端接）× 0.5（LC 双端接）× 7.975 = **1.994**
**动态**：ADC 摆幅 ±249mVpk（u_b 最坏），相对 VBIAS 轨余量 **1.40V**；不削顶最大源端输入 **±827mVpk**
**输入高通**：159Hz（分析带下限 10kHz ⇒ 余量 63×）

### 2.2 数字域（**[代码]**，`firmware/Operation/`）

```
PA1 = ADC1_IN1
  ├ TIM8 TRGO @ 2.000 MHz 触发（PSC=0/ARR=71，144MHz/72）
  ├ 12bit / VREF+ ≈ 3.3V / SMP=3 周期 / ADCCLK 36MHz
  │    ⇒ 每转换 15 周期 = 417ns，取 2.0MSPS（占空 83%）
  ├ DMA2_Stream0 循环搬到 s_adc_buf[4096]（**SRAM，绝不放 CCM**）
  ▼
op_dsp：BH4 加窗（固件自带 4096 项 Flash 表，CG=0.35875）→ arm_rfft_fast_f32 → mag[k]
  ▼
op_peak（**四级精化，全链最难的一段**）
  ① 栅格预筛：2·mag[k]/(N·CG) ≥ 1.5mV        （把"借能量"的伪峰先挡掉）
  ② log 域三点抛物线 → d ∈ [−0.5, 0.5]
  ③ fc0 ± Δf/8 三点 |X| 抛物线 → d2          （复算证明 ±Δf/8 最优）
  ④ 单点 DFT 读数 amp = 2|X|/(N·CG)、φ = atan2 + π/2（sin 载波补偿）
  ⑤ 17 点标定修正（幅 g + 相 p_corr）→ 终判（≥1.5mV 且落在 [9k, 502k]）
  ▼
op_meas：Upp = sin 重建一个基波周期 max−min（抽点 max(512, 32·m_max)）
         Urms = √(ΣA_k²/2)（频域交流口径 ⇒ 天然排除 u_J，且满足"真有效值"）
         f₁ = 最低峰
  ▼
op_wave（1 或 3 个**完整周期**）/ op_spec（log10 横轴铺 [10k,500k]，线性长度比）
  ▼
MeasResult_t（≤64B 单例）→ LVGL 5 页 UI → FSMC 8080-16bit → J5 → ST7796S
```

**关键数字（**[复算]**）**：

| 项 | 值 | 判据 |
|---|---|---|
| 频率分辨率 Δf | **488.28 Hz** | 题面 ≤500Hz ⇒ **余量仅 2.3%**（全设计最紧的一条） |
| 源端 LSB | 0.404 mV | 5mV 判据的 8% |
| 全链耗时 | <25 ms | 题面 2s ⇒ 余量 80× |
| 采样窗 | 2.048 ms | 窗内**一次 FSMC 写都不发生**（LCD 总线闸） |

### 2.3 三条链的"跨域桥"

| 桥 | 方向 | 保护/注意 |
|---|---|---|
| `AFE_ADC_IN` | 模拟 → 数字 | 唯一模拟信号跨域点；`JP2` 0Ω 断点 |
| `VBIAS` | 模拟 → 数字（PC4） | **功能上未用**（固件不采，见 `26 §7-N1`） |
| `+5V_A` | 数字 → 模拟 | 只 2mA；R21 4.7Ω 隔离 |
| `AGND` ↔ `GND` | 地 | **单点，在核心板** |

---

## §3 8080 屏信号怎么保证稳定的（六层 + **[仿真 S9]**）

### 3.1 六层保障（从"信号怎么出去"到"屏怎么收"）

| # | 层 | 措施 | 量化 |
|---|---|---|---|
| **L1** | **源端阻尼** | `R22`~`R41` = **33Ω**，覆盖 `D0~D15` + `CS` + `RS` + `WR` + `RD` = **20 条** | 台面场景：过冲 **47% → 8%**；边沿 9.5→14.6ns（`S9 ①`） |
| **L2** | **时序余量** | FSMC `ADDSET=2 / DATAST=12` @144MHz ⇒ **104 ns/像素** | 屏模块需求 ~15~66ns ⇒ **1.6~7×** 余量；可回退 12→16→20→25 |
| **L3** | **采样窗静默** | engine 采集前 take、采完 give；写屏侧每 1024px take/give 一次（**LCD 总线闸**） | 2.048ms 采样窗内**零次 FSMC 写**（改前 9ms 的 flush 会横跨整窗） |
| **L4** | **刚性固定** | 屏模组直插转接板/排母，**禁杜邦飞线**（O9） | 同一块板，台面振铃比成品严重得多（`S9 ①` 两表对比） |
| **L5** | **就近储能** | J5 侧 `C21` 10µF + `C22` 100nF | 屏开关电流的本地电荷库 |
| **L6** | **地回流** | J5.29（1 根）+ 核心板 `EVK1.39/77/79`（3 根） | **⚠️ 最弱的一层，见 §3.3** |

### 3.2 33Ω 到底压住了什么（**[仿真 S9 ①]**，解析式串联 RLC）

**成品形态**（直插转接板，回路 L≈60nH）：

| 串阻 | 阻尼比 ζ | 过冲 | 上升时间 | 评价 |
|---|---|---|---|---|
| 0Ω | 0.45 | 21% | 6.1 ns | 欠阻尼·有振铃 |
| **33Ω** | **1.19** | **0%** | **14.0 ns** | 过阻尼（对成品偏保守） |
| 47Ω | 1.50 | 0% | 17.7 ns | 边沿更慢，无收益 |

**台面形态**（100mm 杜邦飞线，回路 L≈215nH）：

| 串阻 | 阻尼比 ζ | 过冲 | 上升时间 | 评价 |
|---|---|---|---|---|
| 0Ω | **0.24** | **47%** | 9.5 ns | **严重振铃**（3.3V 边沿冲到 4.84V） |
| **33Ω** | **0.63** | **8%** | **14.6 ns** | 接近临界·好 |
| 47Ω | 0.79 | 2% | 20.6 ns | 接近临界 |

**结论**：**33Ω 是为最坏的台面/飞线场景选的** —— 对成品偏保守（ζ=1.19 过阻尼），
但代价只是边沿慢 6ns，而 104ns 周期有大量余量 ⇒ **不值得为成品单独换料，保持 33Ω 统一 BOM**。

> ⚠️ **`R22`~`R41` 的物理位置是硬约束**：图纸把它们画在 **J5 侧**（EDA 符号几何守卫所限，`18 §R-21`），
> **PCB 必须贴到 MCU 引脚 3~5mm 以内** —— 放连接器侧 = 阻尼在负载端 = **等于没加**。

### 3.3 最弱的一层：地回流（**[仿真 S9 ②]**）

**J5 只有 1 根 GND 针（pin 29），却要承担 20 条信号线的回流。**

一阶估算 `ΔV = L_gnd · Σ(di/dt)`（单线 di/dt ≈ 9.8 A/µs）：

| 同时翻转线数 | Σ di/dt | L_gnd=10nH | L_gnd=30nH | L_gnd=115nH |
|---|---|---|---|---|
| 4 | 39 A/µs | 392 mV | 1175 mV | 4503 mV |
| 8 | 78 A/µs | 783 mV | 2350 mV | 9007 mV |
| **16（全总线）** | 157 A/µs | **1566 mV** | **4699 mV** | **18014 mV** |

> ⚠️ **这是上界估计，不是实测值** —— 因为：(a) 16 条线不会真的完全同向同步翻转；
> (b) 实际边沿 14.6ns 比"阶跃"慢得多，di/dt 小 3~5 倍；(c) 屏的输入是高阻 CMOS，
> 稳态电流为零，只有边沿瞬间有电流。**绝对值只有上板用示波器看 J5 侧边沿才能定。**

**但趋势是确定的：地弹 ∝ L_gnd × N × di/dt。N 由总线宽度定死（16），所以只能压 L_gnd 与 di/dt。**

**三条可执行手段**（写进 PCB 约束）：
1. **压 L_gnd**：J5 的 GND 走线**尽量短、宽、多打过孔**；GND 焊盘周围铺铜。
2. **压 di/dt**：33Ω 已经把台面的过冲从 47% 压到 8%；再加 L3 的采样窗静默（时间上错开）。
3. **禁飞线**（L4）：直插转接板把回路 L 从 ~215nH 降到 ~60nH。

### 3.4 还缺一块：`LCD_RST` 没有串阻

`R22`~`R41` 覆盖了 20 条，**唯独 `LCD_RST`（`EVK1.14 → J5.5`）直连**。
它是 21 条控制/数据线里唯一漏网的，与其它控制线同源同类。
**处置**：`27 H3` 的 `R42` 补装命令已备好，但 `sch place` 在本会话的连接器负载态下连续 3 次超时
⇒ **未执行**（收益低：RST 只在初始化翻转一次）。**上板前若工具链恢复，按 `27 §8.6` 四条命令补。**

---

## §4 剩余可优化清单（逐条判定）

> 判定标准：**是否改善题面判据 / 是否降低风险 / 代价多大**。凡"收益 ≈ 0 或纯审美"的一律不做。

### 4.1 已量化后**否决**（防返工）

| # | 候选 | 量化 | 否决理由 |
|---|---|---|---|
| O1 | `R3` 49.9Ω → **59Ω** | `[仿真]` 折叠带中位 −58.00 → −58.94dB（+0.94），但通带起伏 0.388 → **0.600dB**、@500k droop −0.298 → −0.525dB | **拿通带换阻带，而阻带余量本就 >12dB** ⇒ 方向反了。保持 49.9Ω |
| O2 | `C10` 470pF → **220pF** | `[仿真]` ADC 采样误差 1.42 → 0.79 LSB | 该误差是**纯斜率项（LTI）**，已被 17 点标定整条吸收 ⇒ 收益 ≈ 0，不值一次换料 |
| O3 | 标定 **17 → 33 点** | `[仿真]` 插值残差 0.89 → 0.63 mV | 0.26mV 的改善换固件 + 标定流程改动，不值 |
| O4 | `+5V` 双源加 **ORing 电路** | 见 §5.1：**D2 本身就挡住双向反灌** | 原本的风险已被现有器件覆盖；加 ORing 要新器件 + 新失效模式 |
| O5 | FSMC 改 **DMA 写屏** | — | 帧率不敏感；且 DMA 要重做 LCD 总线闸，风险 > 收益（`27 S1` 同判） |
| O6 | 给 `+5V_A` 换 **磁珠** | 600Ω@100MHz 的磁珠在 500kHz 只有几 mΩ | 无隔离作用；**电阻（4.7Ω）才是对的**，已做 |

### 4.2 **受阻于工具链**（不是判断问题，是环境问题）

| # | 项 | 阻塞点 | 恢复后怎么做 |
|---|---|---|---|
| O7 | **`R42` 33Ω 串 `LCD_RST`** | `easyeda sch place` 在连接器负载态下 3 次 `DISPATCH_FAILED` | `27 §8.6` 的四条命令（`place` + 改名 J5 侧 netport + 两个 `autoconnect`） |
| O8 | **4 处过期注释换代** | `easyeda sch` **没有 text-modify 动作**（只有 `text-list` 只读 + `prim-delete`） | 人工在 EDA 里改：PWR 的 "C19/C20"、INT 的 "R22~R39"、AFE 的 "VREF 3.0V"、AFE 的 "R3 隔离" |
| O9 | **`VREF` 留位清理**（`JP3`/`C12`/`TP6`） | 要连带处理 INT 页 `VREF_CORE` 端口与 `EVK1.2` 的 NC | 单独一轮"清残骸"，带 orphan 清理（`25 §3` 同判） |

### 4.3 **最大的剩余风险**（不是电路问题，是题面符合性）

| # | 项 | 题面条款 | 现状 | 建议 |
|---|---|---|---|---|
| **O10** | **显示屏尺寸** | 说明 6：**≥6 英寸** | 3.5″（320×480） | ⚠️ **这是全项目最大的扣分风险**。同接口（30-pin 8080-16bit）的 5.0″/7.0″ 模组可直接替换，**改动量 = 换模组 + 调 `BOARD_LCD_W/H` 与 FSMC 时序**。**建议重新评估**（用户 2026-09-28 曾拍板接受 3.5″） |
| **O11** | BNC 接头座 | 说明 7：板上需焊 BNC 座 | SMA-KE | ✅ **用户 2026-10-03 已拍板**：用 SMA-KE + BNC 转接件，本轮不改 |

### 4.4 **建议采纳但需人拍板**

| # | 项 | 收益 | 代价 |
|---|---|---|---|
| O12 | **PCB：J5 的 GND 走线加宽 + 多打过孔 + 周围铺铜** | 直接压 `L_gnd` ⇒ 按 `S9 ②` 的表，地弹线性下降 | 零（只是布局约束） |
| O13 | **PCB：AFE 分区 + 模拟地完整铜皮 + 单点汇 `EVK1.37`** | 2 层板无地平面兜底，这条从"优化"升级为"必做" | 零（布局约束） |
| O14 | **上板实测背光电流，按结果决定是否割适配板** | 消除 LDO 过热的唯一风险源 | 需要万用表 + 可能割线 |

---

## §5 本轮的两处**自我修正**（重要，别照旧文档抄）

### 5.1 `+5V` 双源：从 P1 降为 P2

**上一轮（`26 §7-N2`）我把它判成 P1，说过头了。** 重新按网表推：

- 底板 `+5V` 是 **D2 的阴极**；核心板 Type-C VBUS 也在 `+5V` 上。
- **USB 反灌 DC 座**：USB 把 `+5V` 抬到 5.0V，D2 阴极=5.0V、阳极=DC 源输出（≈5.0V）
  ⇒ **D2 零偏/反偏，不导通** ⇒ 反灌被 D2 挡住 ✅
- **DC 座反灌 USB**：DC → `+5V` 走的是 D2 的**正向**（这正是正常供电路径）；
  而 `+5V` → J3 是 D2 的**反向**，被挡 ✅
- **两路同时供电**：谁电压高谁供，D2 让 DC 支路天然"退让"，不会互灌 ✅

**⇒ 真正的残余风险只剩一条**：核心板 Type-C VBUS 与排针 5V 在核心板内部是否 ORing ——
这决定"DC 供电时会不会把 5V 灌进 PC 的 USB 口"。核心板资料里写了"防反接（排针脚有可能接反）"，
暗示排针 5V 入有保护，但**资料包是 VET6 版、实物是 VGT6-PRO，不能靠推断**。

**处置**：降为 **P2**；保留 `23 §1` 的 T2 实测；使用说明写"调试时避免同时接 DC 与 USB"。

### 5.2 S9 的集总瞬态模型：**数字不可信，已改成解析式**

我先写了一版集总 LC 瞬态模型（N 条线共用一根地针），但它给出**"地弹与 L_gnd 无关、恒为 3.1V"**的退化结果
—— 集总模型**定不了信号电感与回流电感的真实分配**。
**宁可不算，也不发布一个自己不信的数** ⇒ `s9_8080_si.py` 已全部改成解析式（串联 RLC 阶跃 + 一阶地弹公式），
并在文件头与输出末尾写明"绝对值是上界估计，只有上板示波器能定"。

> 这一条也顺便说明：**仿真不是"跑出个数字就算数"，模型对不对是第一步。**
> 本轮 4 次踩坑（运放极性、ADC 驱动源、S7 粗网格标称、S9 集总分配）里有 3 次是**模型错而不是电路错**。

---

## §6 关于"允许你重构原理图"——**我的判断是：不需要重构**

用户给了重构权限。但我**不建议重构**，理由三条（都是可核查的）：

| # | 理由 | 依据 |
|---|---|---|
| 1 | **三页的分区与命名已经过两轮可读性收口**，且门禁全绿 | `sch gate`：AFE/PWR 两页 **PASS**（layout-lint 0 重叠、clusters 0 重叠、bridge-check 0 孤儿、DRC 0 致命/0 错误）；`18 §20` 记了"注释去代、text-overlap 313→12"的收口过程 |
| 2 | **本轮的全部收益都来自"改值"，不是"改拓扑"** | H1（R21 0Ω→4.7Ω）与 H2（R6/R7 69.8k/10k→24.9k/3.57k）**都没动一根导线** ⇒ 网表拓扑零变化 ⇒ DRC 风险为零。这是刻意的风险控制 |
| 3 | **重构的收益全是"审美"，而风险是"回归"** | 本项目已经有过一次"AFE 页被 PWR 内容覆盖"的事故（`18 §22`）；`18 §R-21` 还记着 EVK1 符号的几何守卫会让任何新导线被判 `wire-through-body` ⇒ **重构 = 主动走进已知会出问题的区域** |

**如果非要做，我只推荐这三处"最小重构"**（都是低风险、有明确收益的）：

| # | 重构 | 收益 | 风险 |
|---|---|---|---|
| R1 | **把 20 只 33Ω 的图纸位置从 J5 侧移到 MCU 侧** | 图纸与 PCB 意图一致，不再依赖"PCB 时记得挪"这条口头约束 | ⚠️ 高：`18 §R-21` 明确记着 EVK1 符号的几何守卫会让 MCU 侧插件的导线被判 `wire-through-body` 失败 —— **这条正是它现在画在 J5 侧的原因** |
| R2 | **给 AFE 页加"信号链编号"注释**（①→⑤ 的箭头与级号） | 评审与报告可读性 | 低（纯文本），但 `easyeda sch` **没有 text-modify**，得人工 |
| R3 | **清理 `VREF` 留位**（`JP3`/`C12`/`TP6` + INT 页 `VREF_CORE` + `EVK1.2` NC） | 去掉"看起来在、其实悬空"的误导 | 中：要连带处理 INT 页端口与 orphan |

**⇒ 我的建议：不重构。** 把力气放在 §4.4 的三条 PCB 约束（O12/O13/O14）与 O10 的屏尺寸再评估上 ——
那三件的收益比任何图纸重构都大。

---

## §7 证据与复现

```bash
# 本轮新增/更新的仿真
python tools/sim/s9_8080_si.py        # 8080 信号完整性（解析式）
python tools/sim/s8_e2e_fw.py         # 题面示例端到端（固件算法逐句照搬）
python tools/sim/verify_opt.py        # 改前/改后对比

# 活体网表（供电树与信号链的单一真相源）
python _archive/_review3/netlist_now.py AFE INT PWR
```

**本轮产物**：本文 · `tools/sim/s9_8080_si.py` · `hardware/23` 更新（§7 判据表）·
`hardware/27` 更新（S8 + 落图记录）· `docs/INDEX.md` 更新。

---

## §8 变更记录

| 日期 | 内容 |
|---|---|
| 2026-10-03 | 首版：三条链的完整走向（供电/信号处理/8080）· S9 8080 信号完整性（解析式，含模型边界声明）· 剩余优化 14 条逐条判定 · 两处自我修正（N2 降级、S9 模型）· 重构判断（**不建议重构**，附最小重构清单） |
