funiang-x/G2026/hardware/29-全风险扫描与继续优化-20261003.md

# G2026 · 全风险扫描与继续优化 · 2026-10-03

> **性质**：一次**系统性风险扫描**（不是零散补漏）。分 11 类、逐条给
> **现象 → 根因 → 影响 → 概率 → 检测手段 → 缓解措施 → 状态**，共 **47 条**。
> 本轮**执行了 2 项**（1 项固件、1 项文档/约束），**关闭了 1 项**（屏尺寸，用户定死 3.5″）。
>
> **三态口径**：**[仿真]**（`tools/sim/`，可复跑）· **[活体]**（EDA 回读网表）· **[代码]**（firmware 源码）·
> **[题面]**（G 题原文）· **[未验证]**（只能上板实测）。
>
> **配套**：`26`（逐块讲解）· `27`（优化方案与仿真）· `28`（三链走向）· `23`（上板前检查清单）。

> ## ⚠️ 2026-10-03 稍晚勘误（以 `36-仿真独立验证与择优-20261003.md` 为准）
> 下面两条"待上板实测"的**状态变了**，读本文时请以 `36 §M` 为准：
> - **`C5`（背光电流未知）**：不是"未知"，是**驱动方式与规格不匹配** —— 模组规格要求
>   **恒流 60 mA ±10%**（4 颗并联，`Vf@60mA` = 2.9/3.1/3.6 V），而本设计是
>   **+3V3 恒压 + NMOS、电流路径无镇流电阻**。
>   **已实测 3.3 V 能点亮**（⇒ 本机 `Vf` 在 3.3 V 侧之内，"不亮"那一支对本机不适用），
>   但 ⚠️ **「能亮」≠「电流合规」**：3V3 直驱时电流由 `(3.3 − Vf) ÷ 寄生电阻` 定（寄生只有几十 mΩ）。
>   **先测 54~66 mA；在范围内就别动。** 超出才改 **+5V 串 33 Ω / 1206 / 0.25 W**（`I = 53.0~63.5 mA`）。
>   ⛔ 注意 **`13 D3` 那条"在 3V3 馈线上串一颗电阻"是无效的** —— 3V3 的余量（0.2 V）
>   **小于** `Vf` 的颗间离散（0.35 V）。分析脚本 `tools/sim/backlight_ballast.py`。
> - **`F1`（`AGND`/`GND` 唯一回路在核心板）**：**已实测通，本条结案。** 原理图侧的印证是
>   跨接件 **`R8`（0Ω ±1%，标注无 `(N)` = 贴）**，而 `R2` 标 `0Ω(N)` 且 `25 §1.1` 已实测印证同一约定。
>   ⇒ **因此底板不要补 0Ω**（补了就是第二个接地点 ⇒ 地环路）。见 `36 §M.1`。

---

## §0 一屏结论

| # | 结论 |
|---|---|
| 1 | **本轮扫描出 1 条真问题并已修**：`VBIAS` 建立时间 **τ=20ms / 0.1% 需 138ms**，而上电自检**紧跟调度器启动**跑 —— 改前靠 `bsp_lcd_init()` 里那 140ms 的 `HAL_Delay` **侥幸**盖住。已在 `app_rtos_run()` 显式 `osDelay(APP_AFE_SETTLE_MS=150)`。**553 TU 复编零告警**。 |
| 2 | **另有 1 条值得落到 PCB 约束**：`J1` 是 **SMA-KE 贴片座**，插拔 BNC 转接件的力矩全压在焊盘上 ⇒ PCB 需加机械加强。 |
| 3 | **用户定死 3.5″ 屏** ⇒ 题面说明 6（≥6″）的偏差**关闭**，但**设计报告里必须主动说明并给理由**（见 §11-J1）。 |
| 4 | **其余 44 条**：22 条**已验证/已缓解**、17 条**待上板实测**、5 条**待人工或供应链处理**。 |
| 5 | **扫描方法上的一条自律**：本轮刻意**不列"看着像风险但其实是错的"项** —— 例如"电感下方铺地会降 Q"在**小信号**滤波器里涡流损耗 ∝ I² 可忽略，真正的矛盾是**互感**（已列正交摆放）；又如"`C1/C9` 用 C0G 是必须的"其实**过度规格**（159Hz 拐点离分析带 63 倍，X7R 足够）。**宁少不滥。** |

---

## §1 扫描方法

- **分类**：模拟链 / 数字与时钟 / 显示与触摸 / 电源与热 / 信号完整性 / 地与 EMC /
  机械与装配 / 供应链与器件 / 固件与软件 / 测试与评审 / 过程。
- **五要素**：现象 · 根因 · 影响（对**题面判据**还是对**可靠性**）· 概率 · 检测与缓解。
- **状态词**：`已闭`（有证据）/ `已缓解`（有措施，待实测确认）/ `待实测` / `待人工` / `已接受`。
- **判据锚点**（题面）：幅值 **≤5mV** · 基频 **≤1kHz** · 频率分辨率 **≤500Hz** · 每项 **≤2s** ·
  u_J **200mVpp @≥1MHz** · 单 5V 供电 · 屏 ≥6″ · 板上 BNC 座。

---

## §2 模拟链风险（A）

| # | 风险 | 现象 | 根因 | 影响 | 概率 | 检测 / 缓解 | 状态 |
|---|---|---|---|---|---|---|---|
| A1 | **运放输入电容是未知量** | 通带在 500kHz 上翘，且幅度随 Cin 变 | Cin 不在手上 datasheet 里；它加载 R6∥R7 使 1/β 出零点 | 幅值判据 | 中 | **[仿真]** 敏感性 2.33→**0.48dB**（H2 已改 R6/R7）；**[未验证]** 上板扫频 V1 | **已缓解** |
| A2 | **U1A 输出阻抗使梯形失配** | 折叠带 −59.3→**−57.2dB**（含 Zout 13Ω@1.5MHz） | 闭环 Zout 串进 R3，源阻抗 49.9→63Ω | 抗混叠余量 | 必然 | **[仿真]** 余量仍 **14.7dB**；不改 | **已闭** |
| A3 | **电感 SRF / 磁芯线性度** | 大信号时 THD↑、折叠带变差 | CD54 绕线的 SRF 未逐个核 datasheet | 判据 | 低 | 门槛 SRF≥12MHz；**[未验证]** 上板测 TP3 的 THD（EVT-8） | **待实测** |
| A4 | **电感互感**（L3/L5 同为 22µH） | 高节频响被改 | 两电感同值同向 → 互感最大 | 判据 | 中 | 布局约束：**正交摆放 + 间距 ≥2mm + 下方不走高速线** | **已缓解** |
| A5 | **梯内直流**（`R3→L…→R4→AGND`） | 白流 16.5mA、电感偏置吃掉 33% Isat | 电感在直流上是短路 | 功耗/线性度 | 必然 | 已加 **`C23` 10µF** 隔直 ⇒ 直流归零（`25 §2-H1`） | **已闭** |
| A6 | **`R3` 取值**（49.9Ω 是否最优） | 折叠带差 2dB | 见 A2 | 余量 | — | **[仿真]** 扫 R3：59Ω 可换 +0.94dB 阻带但 **−0.21dB 通带** ⇒ 方向反了，**不改** | **已闭** |
| A7 | **`R8` 被误改大** | 12bit 精度崩 | `t_s=3` 周期下 `R_AIN` 上限 ≈0.4kΩ | 判据 | 低 | **[仿真]** R8=470Ω → **6.0 LSB**；`board_config.h` 注释写明"不可加大" | **已缓解** |
| A8 | **`C10` 采样反冲残差** | 1.42 LSB 采样误差 | 开关电容反冲 + 建立不足 | 判据 | 必然 | **[仿真]** 该误差 ∝ 相邻采样差 ⇒ **纯 LTI**，被 17 点标定吸收；上板测 THD 验非线性分量 | **已缓解** |
| A9 | **输入过压**（D1 钳位点 ~9V > U1A 绝对最大 5.5V） | 大信号灌进 SMA 会先伤 U1A | TVS 只挡 ESD 尖峰 | 可靠性 | 低 | 竞赛场景信号可预期；**[未验证]** 若要更稳可在 U1A 的 +in 串 100Ω（须重算高通） | **已接受** |
| A10 | **`C1/C9` 用 C0G 属过度规格** | — | 159Hz 拐点离分析带 63 倍，X7R 的容值漂移无影响 | 成本 | — | 可换 0805 X7R 100nF（省 ~¥3/板）；**本轮不改**（换料要重走验证，收益只是钱） | **已接受** |
| A11 | **R6/R7 的 TCR 匹配** | 增益随温度漂 | 两电阻若不同厂/不同 TCR，比值漂移 | 判据 | 低 | H2 已把 R6/R7 **统一到 YAGEO RT 同系列**（同 TCR）⇒ 比值漂移 ≈0 | **已闭** |
| A12 | **VREF 实际值**（3.0 还是 3.3V） | 幅值口径 | 核心板 REF 针悬空；VREF+ = VDDA 经 47Ω | 判据 | 中 | 固件 `BOARD_ADC_VREF_MV 3300U`；**[未验证]** 上电 30s 量 `EVK1.2`（T4/T5） | **待实测** |

---

## §3 数字与时钟风险（B）

| # | 风险 | 现象 | 根因 | 影响 | 概率 | 检测 / 缓解 | 状态 |
|---|---|---|---|---|---|---|---|
| B1 | **Δf 余量仅 2.3%** | 分辨率超 500Hz | `fs/N = 2.0e6/4096 = 488.28Hz` | **判据（最紧的一条）** | — | 晶振 ±20ppm ⇒ fs 误差 ±40Hz ⇒ Δf 误差 0.01Hz ✓；且**峰精化链**（±Δf/8 三点 + 单点 DFT）把频率**估计**精度做到远优于 488Hz | **已闭** |
| B2 | **ADC 采样时间只有 3 周期** | 12bit 精度不足 | STM32F4 的 SMP 只有 3/15/28/56…**离散档**；2.0MSPS 只能配 3 周期 | 判据 | 必然 | 这是**离散表逼出来的唯一解**，不是选择；代价是 `R_AIN ≤0.4kΩ` ⇒ **`R8` 必须 100Ω**（见 A7） | **已闭** |
| B3 | **DMA 覆盖导致数据撕裂** | 频谱随机错 | 若 FFT 期间 ADC 还在写同一缓冲 | 判据 | 低 | **[代码]** 单缓冲 + **门控采集**（ADC 只在 2.048ms 窗内跑，DSP 期间不转换）⇒ 不可能撕裂；`app_engine.h` 记了"双缓冲无收益"的理由 | **已闭** |
| B4 | **TIM8 触发丢拍** | 采样非均匀 → 频谱错 | 若转换时长 > 触发周期 | 判据 | 低 | 15 周期 = 417ns < 500ns 周期（占空 83%）⇒ 有 83ns 余量 ✓ | **已闭** |
| B5 | **`op_peak` 的 `k+=5` 跳过主瓣** | 两个峰靠太近时漏一个 | 命中后跳 5 个 bin（2.44kHz） | 判据 | 低 | 题面分量间隔 ≥ 基波 ≥10kHz = 20 bin ✓ | **已闭** |
| B6 | **1.5mV 门限漏掉真实小谐波** | 谱线根数少一根 | 门限本来是为挡 u_J 设的 | 判据 | 中 | 漏掉的分量 <1.5mV < 5mV 判据 ⇒ **不违反**；Urms 影响 <0.02mV。**报告里要写明这条推理** | **已缓解** |
| B7 | **CubeMX 重生成损坏工程** | TIM8 与 CMSIS-DSP 被删 ⇒ 变砖 | 生成器会覆盖 | 可靠性 | 中 | `firmware/docs/11 §11` 的回填清单（4 处生成物 + 6 项 `.ioc` 开关）；**建议把 PC4/PC5 的 GPIO 模式也加进去** | **已缓解** |

---

## §4 显示与触摸风险（C）

| # | 风险 | 现象 | 根因 | 影响 | 概率 | 检测 / 缓解 | 状态 |
|---|---|---|---|---|---|---|---|
| C1 | **屏 3.5″ < 题面 ≥6″** | — | 结构尺寸限制 | 题面说明 6 偏差 | 必然 | **用户 2026-10-03 定死 3.5″** ⇒ 关闭。**设计报告里主动说明**（见 §11-J1 的写法） | **已接受** |
| C2 | **`J5` 脚序 ↔ 适配板丝印未实测** | 花屏 / 点不亮 | 两套脚表（官方 PDF vs 实物丝印） | 功能 | 中 | **✅ 2026-10-04 关闭**：原记的"用户实测 `J5.22=D14`"是**读丝印时右列读高了一行**；实物高倍照片（`RST` 右邻 `D00`、`D15` 右邻空位）+ 厂家 PDF 文本层 + 装配图焊盘标号三方一致 ⇒ **以官方 PDF 脚表为准**，J5 已改图（`04 §6.18`）。`IM=010` 仍 ✓ | **已闭** |
| C3 | **触摸 IC 型号**（FT6336 vs GT911） | 触摸全废 | 屏厂批次不同 | 功能 | 低 | 目视丝印 + I²C 扫描（0x38 = FT6336） | **待实测** |
| C4 | **触摸轴映射** | 落点整体错 90° | 屏厂例程是竖屏、本工程横屏 | 功能 | 中 | 已改成**运行时可改**（`BOARD_TOUCH_SWAP_XY/INVERT_*`）+ UI 第 5 页现场定 | **已缓解** |
| C5 | **背光电流未知**（可能远超 60mA） | LDO 过热 / 适配板过流 | 适配板 LED-A 直挂 3.3V 无限流电阻 | 可靠性 | 中 | **[未验证]** 上板限流源测（T4）；兜底：割适配板铜皮串阻，或换 1000亮度板 | **待实测** |
| C6 | **`+3V3` 一根针供屏+背光** | IOVCC 跌落 | J5.30 单针 | 功能 | 低 | **[复算]** 86mA × ~70mΩ = **6mV** 压降 ⇒ 可忽略 | **已闭** |
| C7 | **`LCD_RST` 无串阻** | 边沿振铃 | 21 条控制/数据线里唯一漏的 | SI | 低 | `27 H3` 的 `R42` 命令已备；`sch place` 3 次超时 ⇒ 未执行。**RST 只在初始化翻转一次** | **已接受** |

---

## §5 电源与热风险（D）

| # | 风险 | 现象 | 根因 | 影响 | 概率 | 检测 / 缓解 | 状态 |
|---|---|---|---|---|---|---|---|
| **D1** | **上电时序：`VBIAS` 建立要 138ms，自检却立刻跑** | RTT 报**假的**「模拟轨可疑」 | `R9//R10//R2//R5//R7 = 2kΩ` 充 `C13 = 10µF` ⇒ τ=20ms | 误诊（把人往"查地"带） | 中 | ✅ **本轮已修**：`app_rtos_run()` 里显式 `osDelay(APP_AFE_SETTLE_MS=150)`；**553 TU 复编零告警** | **已闭** |
| D2 | **`+5V` 双源** | 担心互灌 | 见 `28 §5.1`：**`D2` 本身就挡住双向反灌** | 可靠性 | 低 | 保留 T2 实测（查核心板内部是否 ORing）；使用说明写"调试时别同时接" | **已缓解** |
| D3 | **`D2` 的 0.3V 压降** | 核心板 LDO 输入只有 4.7V | 肖特基正向压降 | 可靠性 | 必然 | SCJA1117 的 dropout 在 0.1A 下 <0.3V ⇒ 3.3V 输出有 >1.4V 余量 ✓ | **已闭** |
| D4 | **PPTC 的初始电阻压降** | `+5V` 略低 | PPTC 的 `R_init` 随型号/温度变 | 可靠性 | 低 | ⛔ **2026-10-04 作废**：`F1`(PPTC) 已从图上删除（本板改由核心板 Type-C 供电，`38 §3.2-①`）⇒ 无此件 | **已作废** |
| D5 | **LDO 发热** | 温升 | 1.7V × 0.09A = 0.15W | 可靠性 | 低 | SOT-223 的 θja≈60°C/W ⇒ 温升 ~9°C ✓；背光 150mA 时 0.29W ⇒ 17°C 仍 OK | **已闭** |
| D6 | **`+3V3` 纹波耦合到 `VBIAS`→ADC** | 伪峰 | 屏/触摸的开关电流 | 判据 | 中 | **[仿真]** +3V3→ADC：**−39dB@1kHz / −79dB@100kHz / −92dB@500kHz**；且无 1kHz 源（背光恒亮无 PWM） | **已闭** |
| D7 | **`+5V` 纹波耦合到 `+5V_A`** | 伪峰 | 原 R21=0Ω 无隔离 | 判据 | 高 | **[仿真]** H1 已改 4.7Ω ⇒ 500kHz **−36.8→−87.1dB（+50dB）** | **已闭** |
| D8 | **上电浪涌** | — | C11/C13/C16 充电 | 可靠性 | 低 | PPTC 限流 + 电源自身限流 ✓ | **已闭** |

---

## §6 信号完整性风险（E）

| # | 风险 | 现象 | 根因 | 影响 | 概率 | 检测 / 缓解 | 状态 |
|---|---|---|---|---|---|---|---|
| E1 | **8080 边沿振铃** | 花屏 / 错色 | 排线 + 转接板的 LC 谐振 | 功能 | 高（无措施时） | **[仿真 S9]** 33Ω 把**台面**过冲 **47%→8%**、边沿 9.5→14.6ns | **已缓解** |
| E2 | **33Ω 画在 J5 侧而 PCB 要贴 MCU 侧** | 阻尼失效（等于没加） | EDA 符号几何守卫（`18 §R-21`） | 功能 | **高（若不提醒）** | 已写进 `18 §10-3`、`22 §5`、`27 §8.5`、`23 §1` **四处**；**PCB 投板检查单第一行** | **已缓解** |
| E3 | **20 条线共用 1 根 GND 针** | 地弹吃掉噪声余量 | J5.29 单针 + 排针/排线电感 | 功能 | 中 | **[仿真 S9]** 地弹 ∝ `L_gnd × N × di/dt`；缓解：**PCB 把 J5 的 GND 走线加宽/多过孔**、**禁飞线**、采样窗静默 | **待人工（PCB）** |
| E4 | **FSMC 与模拟采样同时进行** | 采集瞬间 LCD 噪声灌进 AFE | 写屏 flush 9ms 横跨 2.048ms 采样窗 | 判据 | 高（无措施时） | **LCD 总线闸**（engine take/give + 写屏分块）⇒ 窗内零次 FSMC 写 | **已闭** |
| E5 | **排针 2.54mm 相邻针串扰** | — | 平行走线 | SI | 低 | 2.54mm 间距 + 104ns 边沿 ⇒ 耦合可忽略；33Ω 已进一步拉慢边沿 | **已闭** |
| E6 | **FSMC 时序不足** | 花屏 | 屏模块需求 ~15~66ns | 功能 | 低 | 104ns/像素 ⇒ **1.6~7×** 余量；回退档 12→16→20→25 | **已闭** |

---

## §7 地与 EMC 风险（F）

| # | 风险 | 现象 | 根因 | 影响 | 概率 | 检测 / 缓解 | 状态 |
|---|---|---|---|---|---|---|---|
| F1 | **`AGND`/`GND` 唯一回路在核心板** | 噪声底变差、读数慢漂（**不报错**） | 底板两网无连接件 | 判据 | 中 | **[未验证]** 断电测通断（`23 §1` T1）；不通则底板补 0Ω 单点（只许一个） | **待实测** |
| F2 | **2 层板无地平面** | 回流路径差、EMI | 用户拍板 2 层 | 判据 | 中 | 补偿三条：**AFE 分区 + 模拟地完整铜皮 + 单点汇 `EVK1.37`**、**采样窗静默**、**FSMC 33Ω** | **已缓解** |
| F3 | **AFE 与 FSMC 同板耦合** | 伪峰 | 共地阻抗 | 判据 | 中 | 同 F2；**[未验证]** 上板测 TP4 噪声底 <0.5mVrms（**[仿真]** 预测 0.054mVrms） | **待实测** |
| F4 | **电感下方铺地**（**不列为风险**） | — | 涡流损耗 ∝ I²，小信号下可忽略；铺地反而有利屏蔽 | — | — | 真正的矛盾是**互感**（已列 A4） | **不适用** |

---

## §8 机械与装配风险（G）

| # | 风险 | 现象 | 根因 | 影响 | 概率 | 检测 / 缓解 | 状态 |
|---|---|---|---|---|---|---|---|
| **G1** | **`J1`（SMA-KE 贴片座）受插拔力矩** | 焊盘脱落 / 座子歪 | 题面要求 BNC 座，本板用 SMA + **BNC 转接件** ⇒ 插拔力全传到贴片焊盘 | 可靠性 | **中** | **PCB 必须做机械加强**：座子下方与两侧**多打过孔**、焊盘外扩、必要时加机械支撑；或改**通孔 SMA 座** | **待人工（PCB）** |
| G2 | **屏模组刚性固定** | 花屏 / 接触不良 | 飞线 = 振铃 + 接触不良 | 功能 | 高（若飞线） | **禁杜邦飞线**（O9）；直插转接板/排母 | **已缓解** |
| G3 | **板框与安装孔未定** | 装不进外壳 | 尺寸未定 | 装配 | 中 | `18 §10-8` 已列；按前作量级假设 | **待人工** |
| G4 | **调试排针随板未焊** | 无法调试 | 核心板出厂未焊 2×5P 调试口 | 过程 | 高 | 提醒：**上板前先补焊 SWD/SWO/串口 排针** | **待人工** |

---

## §9 供应链与器件风险（H）

| # | 风险 | 现象 | 根因 | 影响 | 概率 | 检测 / 缓解 | 状态 |
|---|---|---|---|---|---|---|---|
| H1 | **3 个新 MPN 是候选值** | 买不到 / 买错 | `0805W8F4R70T5E` / `RT0805BRD0724K9L` / `RT0805BRD073K57L` 是按同族编码规律推的 | 采购 | 中 | **下单前在立创页面逐个核一次** | **待人工** |
| H2 | **BOM 有 36 行供应商编号未解析** | 下单慢 | 平台默认 `<MPN>.1` | 采购 | 必然 | 在 EDA 里指定 LCSC 编号后重导（`25 §8-8`） | **待人工** |
| H3 | **实物是 VET6 还是 VGT6** | FLASH 只剩 18KB（若 VET6） | 资料包是 VET6 版、实物是 VGT6-PRO | 功能 | 中 | 看板面丝印（`12 §T7`）；**上板前必须确认** | **待实测** |
| H4 | **电感供货**（CD54 绕线） | 换料导致频响变 | 供应链波动 | 判据 | 低 | 门槛已写（SRF≥12MHz/DCR≤0.5Ω/Isat≥50mA/必须绕线） | **已缓解** |
| H5 | **`C1/C9` 的 1206 C0G 100nF 是否在售** | 买不到 | 大容值 C0G 少见 | 采购 | 低 | 已核实存在（如 Murata GRM31C5C1H104JA01）；**但按 A10 其实可换 X7R** | **已闭** |

---

## §10 固件与软件风险（I）

| # | 风险 | 现象 | 根因 | 影响 | 概率 | 检测 / 缓解 | 状态 |
|---|---|---|---|---|---|---|---|
| I1 | **上电时序** | 见 D1 | — | — | — | ✅ 已修 | **已闭** |
| I2 | **首帧落在建立窗内** | 首帧读数错 | 若有人把 `APP_MEAS_PERIOD_MS` 从 500 改小（注释里写"别 <100ms"） | 判据 | 低 | D1 的修复已把自检推迟 150ms；`APP_MEAS_PERIOD_MS` 的注释里有下限警告 | **已缓解** |
| I3 | **PC4/PC5 引脚模式** | PC4 输出会向模拟偏置轨灌电流；PC5 输出会与 FT6336 对打 | 历史形态是 `TP_RST` 输出 | 功能 | 中 | `.ioc` 已改对；**建议把这两条加进 `docs/11 §11.2` 的核对表** | **待人工** |
| I4 | **标定流程忙等** | 标定时 UI 卡 | `while(bsp_adc_poll_done()==0);` | 体验 | 中 | 已改成阻塞等帧信号量（`02 §11.1`） | **已闭** |
| I5 | **Urms 依赖峰检测不漏检** | Urms 偏小 | 频域口径只对检出的峰求和 | 判据 | 低 | 漏检分量 <1.5mV ⇒ Urms 影响 <0.02mV ✓ | **已闭** |
| I6 | **17 点标定插值残差** | 幅值系统性偏 | 表只有 17 点 | 判据 | 必然 | **[仿真]** 残差 0.031dB ⇒ **0.89mV**（占 5mV 预算 17.7%）；加密到 33 点只降到 0.63mV ⇒ 不值 | **已接受** |
| I7 | **Upp 重建抽点密度** | 大阶次时 Upp 偏 | 固定 512 点在 m=50 时不够 | 判据 | — | 2026-09-28 已改成 `max(512, 32·m_max)`（−1.75mV → −0.002mV） | **已闭** |
| I8 | **CubeMX 重生成** | 见 B7 | — | — | — | — | **已缓解** |
| I9 | **`app_ui.c` 708 行单文件** | 可维护性 | — | 维护 | — | 建议缓做（UI 未稳定前拆，改一次动一次） | **已接受** |

---

## §11 测试与评审风险（J）

| # | 风险 | 现象 | 根因 | 影响 | 概率 | 检测 / 缓解 | 状态 |
|---|---|---|---|---|---|---|---|
| **J1** | **屏 3.5″ 不符说明 6（≥6″）** | 可能被扣分 | 结构尺寸 | 评分 | 必然 | **用户定死 3.5″**。**报告里的写法建议**：① 先说明"题面的**要求**（100 分）全部满足，说明 6 是**说明**而非要求"；② 给理由（结构紧凑、功耗、成本）；③ 强调功能已覆盖（一屏同显波形+参数+频谱+谱线表）；④ **主动列出偏差**（比被评委发现好） | **已接受** |
| J2 | **BNC 座不符说明 7** | 同上 | 用 SMA + 转接件 | 评分 | 必然 | 用户已拍板；报告里同 J1 的写法，并强调**电气上仍是 50Ω 同轴接口** | **已接受** |
| J3 | **设计报告缺"理论分析与计算"素材**（5 分） | 失分 | 需要有推导 | 评分 | — | `27` 的仿真链 + `tools/sim/` 就是素材：LC 的 ABCD 复算、IM3、噪声预算、蒙特卡洛 | **已闭** |
| J4 | **设计报告缺"测试方案与测试结果"**（5 分） | 失分 | 需要表格 | 评分 | — | `23 §7` 的 V1~V9 表 + `27 §8` 的仿真结果表可直接用 | **已闭** |
| J5 | **设计报告缺"方案论证"**（3 分） | 失分 | 需要候选对比 | 评分 | — | `27 §1` 的题面→约束映射 + `18 §14` 的 Gate 1~6 | **已闭** |
| J6 | **现场信号源行为未知** | 读数对不上 | 信号源的内阻/偏置/谐波设置 | 判据 | 中 | 题面允许自带信号源；`JP1/JP2` 断点 + `TP1~TP6` 支持分级排障 | **已缓解** |

---

## §12 过程风险（K）

| # | 风险 | 现象 | 根因 | 影响 | 概率 | 检测 / 缓解 | 状态 |
|---|---|---|---|---|---|---|---|
| K1 | **EDA 连接器负载态** | `sch place` 超时 | 连接器高负载 | 过程 | 中 | 已三次实测；`sch list/modify/save` 正常 ⇒ 只影响"放件"类动作 | **已接受** |
| K2 | **改图没落盘** | 回读发现改动丢了 | 只保存一次不闭环 | 过程 | 中 | **铁律**：每次改图走「保存 → 关页重开 → 回读」闭环 | **已闭** |
| K3 | **注释代累积** | 图上多套文字叠加 | 每次会话追加不删旧 | 可读性 | 高 | `18 §R-24`；`sch` **无 text-modify** ⇒ 需人工改 | **待人工** |
| K4 | **AI 越界烧录/下单** | — | — | — | — | 工程铁律：**不烧录、不下单、不擦片** | **已闭** |

---

## §13 本轮执行的优化

| # | 优化 | 依据 | 验证 |
|---|---|---|---|
| **O-1** | **固件：上电显式等模拟轨建立** —— `project_config.h` 加 `APP_AFE_SETTLE_MS 150U`；`app_rtos.c` 的 `app_adc_selftest()` 前加 `osDelay(APP_AFE_SETTLE_MS)` | D1：`VBIAS` 的 τ=20ms、0.1% 需 138ms，而自检紧跟调度器启动 ⇒ 改前靠 LCD 初始化那 140ms **侥幸**盖住 | ✅ **553 TU 复编：失败 0 / 告警 0**（与工程基线一致）；4 个受影响 TU 单独复编也零告警 |
| **O-2** | **文档：把 D1/G1/E3 三条落成 PCB 与上板约束** | 见下 | `23` 与本文 |

**O-2 的三条约束（写给 PCB 与上板）**：

| # | 约束 | 判据 |
|---|---|---|
| **PCB-1** | **`J1`（SMA-KE）做机械加强**：座子下方与两侧多打过孔、焊盘外扩；或改通孔 SMA 座 | 手推转接件不晃；焊盘无剥离 |
| **PCB-2** | **`J5` 的 GND（pin 29）走线尽量短、宽、多打过孔**，焊盘周围铺铜 | 按 `S9 ②`：地弹 ∝ L_gnd ⇒ 目标 L_gnd ≤30nH（直插转接板形态） |
| **PCB-3** | **`R22`~`R41` 必须贴到 MCU 引脚 3~5mm 以内**（图纸画在 J5 侧是工具限制） | 示波器看 J5 侧边沿过冲 <20%（`S9 ①`） |

---

## §14 风险总表（按严重度排序）

| 级别 | 条数 | 条目 |
|---|---|---|
| **已闭**（有证据） | **20** | A2/A5/A6/A11 · B1/B2/B3/B4/B5 · C6 · D3/D5/D6/D7/D8 · E4/E5/E6 · H5 · I1/I4/I5/I7 |
| **已缓解**（有措施待实测） | **14** | A1/A4/A7/A8 · B6/B7 · C4 · D2 · E1/E2 · F2 · H4 · I2/I8 · J6 |
| **待上板实测** | **9** | A3/A9/A12 · C2/C3/C5 · D4 · F1/F3 · H3 |
| **待人工/PCB/供应链** | **6** | **G1（SMA 机械）** · E3（J5 地回流） · G3/G4 · H1/H2 · I3 · K3 |
| **已接受**（用户拍板或量化后不做） | **6** | C1（3.5″ 屏） · C7（RST 串阻） · A10（C0G 过规格） · I6（17 点标定） · I9 · K1 |

> **没有"高"级别未处置项**。最高的是 **G1（SMA 座机械）与 E3（J5 地回流）**，
> 两条都是 **PCB 约束**，写进 `PCB-1/PCB-2`，代价为零。

---

## §15 变更记录

| 日期 | 内容 |
|---|---|
| 2026-10-03 | 首版：11 类 47 条系统性风险扫描；**执行 2 项**（O-1 固件上电时序，553 TU 复编零告警；O-2 三条 PCB/上板约束）；**关闭 1 项**（屏尺寸，用户定死 3.5″）；列出 6 条"已接受"与 9 条"待实测"。 |
