funiang-x/G2026/hardware/30-原理图通俗讲解与冗余清理-20261003.md

# G2026 · 原理图通俗讲解 + 冗余清理 · 2026-10-03

> **这份文档是给"看不懂原理图的人"写的。**
> 不讲公式、不讲推导，只回答三件事：**它是什么 · 它干什么 · 没有它会怎样**。
> 想看"为什么是这个数值"请看 `26`（逐块讲解）与 `27`（仿真验证）。
> **要按"对信号 / 对电源 / 对其他元器件"三维逐件深讲：看 `44`（2026-10-04，按 10-04 活体网表）**。
>
> **本轮同时做了一次冗余审计并清理**（§5），删了 3 个器件 + 1 条死网。
> **活体现状（2026-10-03 回读）**：AFE **36 位号 / 19 网** · INT **25 / 52** · PWR **7 / 8**。
>
> ⚠️ **2026-10-03 稍晚勘误（以 `36-仿真独立验证与择优-20261003.md` 为准）**：
> `C2 = 6.2 nF`（文中 §1.4 的 5.6 nF 已过期）· `C6 = 9.1 nF`（文中的 10 nF 已过期）。
> 其余 6 颗 LC 不变。**原因**：按"17 点标定残差"择优（最坏 5.22 → 2.97 mV）。

---

## §0 三句话看懂原理图

1. **原理图就是"谁和谁用线连起来"的地图** —— 每个符号是一个零件，线是导线，线上的名字（如 `VBIAS`）表示"同名的地方其实是连着的"（不用画线）。
2. **看图的顺序永远是"电从哪来 → 信号从哪进 → 经过什么 → 从哪出"**。本板就三条线：**电**（5V 进来分下去）、**信号**（SMA 进来送 ADC）、**屏**（MCU 送 8080 总线到屏）。
3. **每个零件只回答一个问题**：*"如果没有我，会发生什么坏事？"* —— 答不出来，它就是冗余的。

---

## §1 AFE 页（模拟前端，36 个位号）—— 信号从 SMA 走到 MCU

**这一页要干的事**：把一个 ±125mV 的小信号，**过滤干净、放大 2 倍、抬到中间电位**，送进单片机的 ADC。

### 1.1 ① 输入保护与端接（信号进门第一站）

| 位号 | 它是什么 | 干什么（打比方） | **没有它会怎样** |
|---|---|---|---|
| `J1` | SMA 同轴座 | **信号的大门** | 没地方插线 |
| `R1` 49.9Ω | 端接电阻，从信号线接到地 | **给信号源"配对"的负载**。信号源要求"你这边得有 50Ω 的负载"，否则信号会在线上来回反射（像水管末端没堵住会往回撞） | 信号幅度会翻倍、波形会晃；而且读数会随信号源不同而变 |
| `D1` SRV05-4 | 静电保护管（4 路只用 1 路） | **避雷针**。手摸 SMA 头带静电时，它把高压短路掉，保住后面的芯片 | 一摸就可能烧掉运放 |
| `C1` 100nF | 电容（串联在信号路上） | **只让"晃动的部分"过去，挡住"固定的直流"**。像只放行人、不放车的闸门 | 信号源若带直流偏置，会把后面的运放顶偏、甚至顶死 |
| `JP1` 0Ω | 0Ω 电阻（等于一根线） | **可拆的"断点"**。调试时可以拆掉它，把电路分成两半单独测 | 电路照样工作，但**出问题时没法分段排查** |

### 1.2 ② 一级缓冲（`U1A` 的一半）

| 位号 | 它是什么 | 干什么 | 没有它会怎样 |
|---|---|---|---|
| `U1A` | 运放（OPA2197 的一半），接成"跟随器" | **复印机**：输出电压永远等于输入电压，但**输入侧几乎不吃电流**（高阻）、**输出侧能给电流**（低阻）。它把"脆弱的信号点"和"后面吃电流的滤波器"隔开 | 滤波器直接挂在信号源上，会把 50Ω 端接搞乱、幅度和波形都变 |
| `R2` 10k | 电阻，从缓冲器输入端接到 `VBIAS` | **给输入端一个"扶手"**，把它拉到中间电位（1.65V），信号才能上下摆动 | 输入没有直流回路，运放会漂到一边贴死 |

### 1.3 ③ 基准与偏置（`VBIAS` 是怎么来的）

> **为什么要 1.65V？** 整个电路只用一个 +5V 电源（题面要求），没有负电源。信号要能"上下摆"，就必须先站在**中间**。1.65V 就是 3.3V 的一半。

| 位号 | 它是什么 | 干什么 | 没有它会怎样 |
|---|---|---|---|
| `R9` / `R10` 各 10k | 两个电阻串起来分压 | **把 3.3V 劈成一半 = 1.65V**（两个一样大的电阻，中间就是一半） | 没有中间电位，信号只能往上摆、不能往下摆 |
| `C13` 10µF | 电容，从 1.65V 接到地 | **小水库**。这个 1.65V 要给三个地方用，电容保证它稳、不抖 | 1.65V 会被信号"拽"得晃，读数跟着晃 |
| `TP5` | 测试点（一个焊盘） | **量 1.65V 的探针** | 上电时没法快速确认偏置对不对 |

### 1.4 ④ 抗混叠滤波器（4 个电感 + 4 个电容，全页最核心）

> **它在干的事**：题面要求"能测 10k~500kHz 的信号，同时把 ≥1MHz 的强干扰（200mVpp！）压掉"。
> 这个滤波器就是一个**筛子**：慢的（低频）过去，快的（高频）挡住。

| 位号 | 它是什么 | 干什么 | 没有它会怎样 |
|---|---|---|---|
| `R3` 49.9Ω | 电阻（串在滤波器入口） | **滤波器"一半的搭档"**（源端阻抗）。另外它还把运放和滤波器的大电容隔开，防止运放自激 | 滤波器形状全变（不是随便一个电阻） |
| `L1/L3/L5/L7` | 4 个电感（4.7/22/22/12 µH） | **筛子的"横档"**：电流变化越快的信号，电感挡得越狠 | 高频干扰直接进 ADC，折回低频变成假峰 |
| `C2/C4/C6/C8` | 4 个电容（5.6/10/10/1.8 nF） | **筛子的"竖档"**：把高频成分泄到地 | 同上 |
| `R4` 49.9Ω | 电阻（滤波器出口到地） | **滤波器"另一半的搭档"**（负载端阻抗） | 滤波器形状全变 |
| `C23` 10µF | 电容（串在 `R4` 入地的腿上） | **只让交流过、不让直流过**。因为电感在直流上等于一根线，不加它的话会有 **16.5mA 的直流白白流过滤波器**、把电感烧热 | 白耗电、电感发热、还可能磁饱和失真 |
| `TP3` | 测试点 | **滤波器输出的探针**（扫频标定最关键的一个点） | 没法验证滤波器对不对 |

> **为什么要 8 阶（4 个电感）这么多？** 因为要挡的那个干扰（≥1MHz）**太强**（200mVpp），
> 少两个电感就压不住（仿真：6 阶只剩 1.45mV 的余量，判据是 1.5mV，等于贴脸）。
> 这不是"多堆料"，是**算出来的**。

### 1.5 ⑤ 二级增益与 ADC 驱动

| 位号 | 它是什么 | 干什么 | 没有它会怎样 |
|---|---|---|---|
| `C9` 100nF | 电容（串联） | 第二次"只让晃动过去"，把信号重新抬到 1.65V | 同上（第二次隔直） |
| `R5` 10k | 电阻到 `VBIAS` | 给放大器输入端"扶手" | 输入端没有直流回路 |
| `U1B` | 运放（OPA2197 的另一半），放大 **7.975 倍** | **放大器**。把滤波器送来的小信号放大到 ADC 好用的幅度 | 信号太小，ADC 分辨率用不满，读数不准 |
| `R6` 24.9k / `R7` 3.57k | 两个电阻，决定放大倍数 | **放大倍数 = 1 + R6/R7 = 7.975**（两个电阻的**比值**决定倍数，绝对大小不重要） | 没有它们就不能放大 |
| `R8` 100Ω + `C10` 470pF | 电阻 + 电容（串在去 ADC 的路上，电容到地） | **给 ADC 的"小水缸"**。ADC 每次采样会瞬间"抽"一口电流，这个电容把这一口补上、不让运放被拽晃 | ADC 每次采样都会在读数上留一个小尖，精度掉一截 |
| `JP2` 0Ω | 0Ω 断点 | **ADC 前的可拆断点** | 电路照样工作，但没法单独给 ADC 注测试信号 |

### 1.6 ⑥ 电源去耦

| 位号 | 它是什么 | 干什么 | 没有它会怎样 |
|---|---|---|---|
| `C11` 22µF | 大电容 | **大水缸**：供运放的电源要稳，它负责"慢"的波动 | 电源一抖，输出跟着抖 |
| `C14` 100nF | 小电容 | **小水缸**：负责"快"的波动（两个并联是因为**大电容对高频不灵、小电容对低频不灵**） | 高频噪声进运放 |
| `TP1/TP2/TP4` | 测试点 | 分别是**端接点 / 缓冲器输入 / ADC 前**的探针 | 上板标定时没地方量 |

---

## §2 INT 页（25 个位号）—— MCU 和屏之间的桥

**这一页只有三样东西**：核心板、屏接口座、20 只"刹车电阻"。

| 位号 | 它是什么 | 干什么 | 没有它会怎样 |
|---|---|---|---|
| `EVK1` | 立创·天空星 F407 核心板（一整个模块） | **大脑**：跑 DSP、产生屏的时序、读 ADC | 没它整个装置不存在 |
| `J5` | 30 脚母座 | **插屏转接板的地方**（屏本身不直接插底板） | 屏接不上 |
| `R22`~`R41`（20 只 33Ω） | 每根信号线串一个电阻 | **给信号"踩刹车"**（源端阻尼）。8080 总线的信号边沿很陡，冲到屏那边会来回反弹（振铃）。串一个 33Ω 就把边沿磨圆一点，反弹就没了 | 仿真：**不串时过冲 47%**（3.3V 冲到 4.84V）、波形来回晃 → 花屏 / 错色 |
| `C21` 10µF + `C22` 100nF | 两个电容，放在 `J5` 旁边 | **屏的"就近水缸"**。屏工作时要吃瞬间电流，让它从身边的电容取，不要跑回核心板去取 | 屏的电源一抖，屏就可能闪 |
| `R12` 1k | 电阻（串在背光控制线上） | **背光开关的"栅极电阻"**，让开关动作别太猛；顺带也是个可测点 | 背光开关动作会有点振铃（但只在开机时动一次，影响小） |

> **⚠️ 这一页有一条硬约束（不是图上的问题，是制造时的坑）**：
> 那 20 只 33Ω **必须焊在 MCU 引脚旁边 3~5mm 以内**。
> 图上它们画在 J5 侧（EDA 工具限制），但**焊到屏那边就等于没装** ——
> 阻尼必须加在信号的**源头**，加在终点没用。

---

## §3 PWR 页（7 个位号）—— 电从哪进来

| 位号 | 它是什么 | 干什么 | 没有它会怎样 |
|---|---|---|---|
| `J3` DC005 | 圆孔电源座 | **插 5V 电源的地方** | 没电 |
| `F1` PPTC | 自恢复保险丝（1A） | **可恢复的保险丝**。电流超了它就断开，凉了自动恢复（不用换） | 万一短路，烧电源或烧板子 |
| `D2` SS34 | 肖特基二极管 | **单向阀**：只让电流从电源流向电路，反过来堵死。所以**电源正负接反了也不会烧** | 接反就烧一片 |
| `C16` 22µF | 电容 | **入口的水缸**：电源线有电感，电流突变时电压会瞬间塌，它补上 | 一开屏就可能复位 |
| `R21` **4.7Ω** | 电阻（从 5V 到运放的 5V_A） | **模拟电源的"过滤器"**。数字部分的电流抖动会污染 5V，串 4.7Ω + 电容组成低通，把抖动挡住 | 仿真：**500kHz 的干扰从 −87dB 恶化到 −37dB**（1V 抖动 → 14mV 灌进 ADC，超门限 9 倍） |
| `R15` / `R16` 4.7k | 两个上拉电阻 | **I²C 总线的"拉手"**。触摸屏芯片和 MCU 之间用 I²C 通信，这条线的两端都是"只能拉低、不能拉高"的开漏输出，必须靠电阻把线拉高 | 触摸完全读不到 |

---

## §4 三条链串起来看（一句话版）

```
【电】J3 → F1(保险) → D2(单向阀) → +5V ─┬─ 核心板（变成 3.3V 给屏）
                                        └─ R21(4.7Ω 过滤) → +5V_A → 运放
                                        +3V3 ─ R9/R10 分压 → VBIAS 1.65V

【信号】SMA → R1 端接 → C1 隔直 → U1A 缓冲 → R3 → 8阶LC 筛子 → C23 隔直
        → U1B 放大 8 倍 → R8+C10 → MCU 的 ADC → DSP 算 Upp/Urms/频谱 → 屏

【屏】MCU 的 FSMC → 20 只 33Ω 刹车 → J5 → 屏转接板 → 3.5″ 屏
```

---

## §5 冗余审计与清理（**本轮已执行**）

### 5.1 判据

**"冗余" = 删掉它以后，功能不变、可靠性不变、可调试性不变。**
只要还占着其中任何一条，就不叫冗余，叫**调试资产**（值得留）。

### 5.2 判定为冗余 → **已删**

| 位号 | 是什么 | 为什么是冗余 | 处置 |
|---|---|---|---|
| **`JP3`** 0Ω | 断点，连 `VREF_CORE` ↔ `VREF_ADC` | 这条链的用途是"用核心板的 REF 针当外部基准"。但 2026-10-02 已查实**核心板的 REF 针是悬空的**，`R9` 也早就改接 `+3V3` 了 ⇒ **整条支路是死的，不通向任何有用节点** | ✅ 已删 |
| **`C12`** 1µF | 电容，从 `VREF_ADC` 到地 | 它挂在 `EVK1.2`（核心板的悬空针）上，**另一端是死的** ⇒ 它什么都没在滤 | ✅ 已删 |
| **`TP6`** | 测试点 | 它探的 `VREF_ADC` 是死节点 ⇒ 探了个寂寞 | ✅ 已删 |
| **`VREF_CORE` 网**（INT 页 `EVK1.2` 的端口） | 一条跨页网 | 上面三件删掉后它只剩一个引脚 ⇒ 单引脚网 | ✅ 已删端口 + **`EVK1.2` 打 NC**（明确标"这个脚故意不接"） |

**清理过程（含证据）**：
- 删 3 件后 `bridge-check` 报 **5 棵孤儿树**（每个被删引脚留了一根桩线 + 一个网络旗）⇒ 又按 ID 删掉 5 根线 + 5 个旗
- 复查：`bridge-check` **0 problem tree**（46 棵树）
- 门禁：AFE `sch gate` **PASS** —— check 1 finding（0 error）、bridge-check 0/0/0/0、**DRC 0 致命 / 0 错误 / 2 警告（回到改前基线）**
- INT：`wire-through-body` 从 19 降到 **18**（少的那一条正是 `EVK1.2` 的桩线）
- 全流程走完「保存 → 关页重开 → 回读」闭环

**活体净变化**：AFE **39 → 36 位号**、**21 → 19 网**；INT **53 → 52 网**；PWR 不变。

### 5.3 判定为**不是冗余**（看着像，其实有用）

| 位号 | 为什么有人会以为它冗余 | 真实作用 |
|---|---|---|
| `JP1` / `JP2` 0Ω | "就一根线，等于没有" | **可拆的断点**：没有它，出问题只能整链猜；有它可以把电路分成三段单独测。成本 ¥0.01 |
| `TP1`~`TP5` | "就是几个焊盘" | **扫频标定的物理基础**：没有测试点，`27 §8` 的九项上板判据一条都做不了 |
| `D1` 的 3 个未用通道 | "4 路只用 1 路，浪费" | 是**封装浪费不是电路冗余**：换成单路 ESD 只省 ¥0.35，却要重走一遍换料事务 |
| `R12` 1k | "背光就开一次，要电阻干嘛" | 栅极阻尼 + 一个可测点；成本 ¥0.01 |
| `R16` 4.7k | "转接板 SDA 侧自带 4.7k，重复了" | 只是**可能**重复（取决于屏厂批次）；删它省 ¥0.01，却要赌"这批一定带"。**不值得赌** |
| `C11` 22µF **和** `C14` 100nF | "两个电容不是重复吗" | **不是**：大电容对高频不灵（自身电感），小电容对低频不灵。**一大一小并联才是完整去耦** |
| `C21` 10µF **和** `C22` 100nF | 同上 | 同上 |
| `C1` **和** `C9` 两个 100nF 隔直 | "为什么隔两次" | 位置不同、职责不同：`C1` 挡**信号源**的直流，`C9` 挡**滤波器**的直流（滤波器直流点是 1.65V，必须再隔一次才能进放大器） |

### 5.4 顺带查实的一条"过度规格"（**不改，只记**）

`C1` / `C9` 用的是 **1206 封装 C0G**（贵、大）。但它们在电路里只是"隔直"，两端交流电压只有几十 µV
⇒ **用普通的 0805 X7R 完全够**（能省 ~¥3/板）。
**本轮不改**：换料要重走一遍验证流程，而收益只是钱；记在这里备查。

---

## §6 一页速查表（打印出来对着图看）

| 你在图上看到 | 它在干什么 | 一句话 |
|---|---|---|
| 串在信号线上的小电阻（`R1/R3/R4` 49.9Ω） | 阻抗匹配 | "给信号配对的负载" |
| 串在信号线上的电容（`C1/C9` 100nF） | 隔直 | "只让晃动的过去" |
| 电感 + 电容组成的梯子 | 低通滤波 | "筛子：慢的过、快的挡" |
| 运放接成输出回接负输入 | 缓冲器（×1） | "复印机" |
| 运放带两个电阻分压回负输入 | 放大器 | "放大 N 倍" |
| 两个等值电阻串在电源和地之间 | 分压 | "把电压劈一半" |
| 电容一头接电源一头接地 | 去耦 | "水缸" |
| 串在每根总线上的 33Ω | 源端阻尼 | "刹车" |
| 二极管串在电源入口 | 防反接 | "单向阀" |
| 自恢复保险丝 | 过流保护 | "会自己好的保险丝" |
| 0Ω 电阻 | 断点 / 跳线 | "可拆的线" |
| 小圆圈或焊盘（TP） | 测试点 | "量的地方" |

---

## §7 变更记录

| 日期 | 内容 |
|---|---|
| 2026-10-03 | 首版：三页逐件通俗讲解（36+25+7 = 68 个位号，每个都答"没有它会怎样"）· 冗余审计（删 `JP3`/`C12`/`TP6` + `VREF_CORE` 网，含孤儿树清理与门禁复查）· 8 条"看着像冗余其实有用"的反例 · 1 条过度规格备案 · 一页速查表 |
