funiang-x/G2026/hardware/31-原理图审查第2轮-文字一致性-20261003.md

# G2026 · 原理图审查（第 2 轮 · 文字与标注一致性）· 2026-10-03

> **性质**：本轮审查**换了维度** —— 不再看电路（前几轮已审透），而是**逐条核对图上每一句文字**。
> 起因：删件/改值之后，**图上的注释不会自动跟着变**，而 `easyeda sch` **没有 text-modify**（只有
> `text-list` 只读 + `prim-delete`）⇒ 这类不一致会长期潜伏，且**直接误导接板人**。
>
> **三页合计 50 条文字，逐条核对后查出 13 条不一致，已全部处理。**
> 门禁：AFE **PASS** · PWR **PASS** · INT 仍是既有的 `wire-through-body`（`18 §R-21`，非本轮引入）。

---

## §0 一屏结论

| # | 结论 |
|---|---|
| 1 | **查出 13 条文字与现状不一致**：7 条"改值/删件后没更新"、4 条"本来就写错"、2 条"措辞会误导"。 |
| 2 | **工具链限制**：`easyeda sch` **没有 text-modify**。`modify` 的合法字段里没有 `content`/`text`（实测被拒）；文字也不是"元件"（`--id` 报 `Failed to read component`）⇒ **只能删，不能改**。 |
| 3 | **找到替代路径**：`sch frame apply` 能**新增任意文字**（frame 的 `title`），且**幂等**（`frame check` 报 `unchanged`）。代价是每个 title 自带一个虚线框 ⇒ 用它做"更正标签"。 |
| 4 | **顺带修掉一个既有缺陷**：INT 页 ③ 分区的框 `minY=60`，**没盖住 y=-50 的 R40/R41** ⇒ 已扩到 `minY=-90`。 |
| 5 | 结果：三页**再无一条提及已删元件或旧值的文字**。AFE/PWR 门禁 PASS，DRC 均为 **0 致命 / 0 错误 / 2 警告**（与基线一致）。 |

---

## §1 审查方法（可复用）

```
① sch text-list ×3 页        → 拿到全部文字（content / x / y / fontSize / primitiveId）
② sch list --include-pins    → 拿到全部位号与**现值**
③ 交叉核对两件事：
   a) 文字里提到的**位号**，图上还存在吗？（查"删件后残留"）
   b) 文字里写的**数值**，与网表现值一致吗？（查"改值后过期"）
④ 再人工过一遍**事实性措辞**（不是数值，是"说法对不对"）
```

**③ 的判据写成了脚本**（`_archive/_review4/eda/` 下），核心是把"位号 + 紧随其后的数值"配对，与网表 `otherProperty.Value` 归一化比较。
**注意假阳性**：`100n` vs `100nF`、`470p` vs `470pF` 是**同一值不同写法**，不是过期；
`J5 30-pin` 里的 "30" 是**脚数**不是值。

---

## §2 查出的 13 条（逐条）

### 2.1 改值/删件后没更新（7 条）—— **最危险**（接板人会按旧值核对）

| # | 页 | 位置 | 原文字 | 现状 |
|---|---|---|---|---|
| 1 | AFE | (2058,1426) | `U1B(OPA2197) 同相放大：R6 **69.8k** 上支路反馈、R7 **10k** 下支路落 VBIAS` | R6/R7 已改 **24.9k/3.57k** |
| 2 | AFE | (2080,1220) | `同相 ×7.98 = 1 + Rf/Rg = 1 + **69.8k/10k**` | 同上 |
| 3 | PWR | (2088,890) | `R21(**0Ω**)：+5V → +5V_A` | R21 已改 **4.7Ω** |
| 4 | PWR | (2088,864) | `**C19/C20** 100nF：屏侧就近去耦` | **C19/C20 已于 2026-10-02 删除** |
| 5 | INT | (-25,296) | 分区标题 `③ FSMC 串阻阵列（R22–**R39**）` | 实为 **R22~R41（20 只）** |
| 6 | INT | (110,170) | `R22~**R39** 串在 J5 侧：…` | 同上 |
| 7 | INT | (110,150) | `每根 FSMC 线串 33Ω（R22~**R39**）…` | 同上 |

### 2.2 本来就写错（4 条）

| # | 页 | 位置 | 原文字 | 错在哪 |
|---|---|---|---|---|
| 8 | AFE | (2080,1196) | `100Ω + 470pF：ADC 采样反冲隔离（Rsrc ≤**1.1kΩ**）` | STM32F4 在 `t_s=3 周期`下 **`R_AIN ≤0.4kΩ`**（1.1k 是 `t_s=15 周期`档的值） |
| 9 | AFE | (100,1220) | `**BNC** 50Ω · TVS 低容(Cj≈1.5pF) · 49.9Ω 端接` | 本板是 **SMA-KE**（题面要 BNC 座，用户已拍板用转接件）⇒ 写 "BNC" 会让接板人找错座子 |
| 10 | INT | (348,748) | `AFE_ADC_IN / **VREF_CORE** / VBIAS 用净标签跨页` | **`VREF_CORE` 已于 2026-10-03 删除**（见 `30 §5`） |
| 11 | AFE | (2058,1426) 附近 | （同 #1，其"上支路/下支路"的措辞本身没错，是值过期） | — |

### 2.3 措辞会误导（2 条）

| # | 页 | 位置 | 原文字 | 为什么误导 |
|---|---|---|---|---|
| 12 | AFE | (100,1250) | `端接 ×0.5 同时是链路里**唯一免费的抗混叠增益**` | `26 §2.1` 已论证：端接的 ×0.5 对**信号与残留同比例**，**不改变信噪比**；称它"抗混叠增益"会让人以为可以靠端接省滤波器阶数 |
| 13 | AFE | (488,1130) | `R3 49.9Ω **隔离**缓冲输出与后级 LC 网络` | **只说了半个作用**：R3 同时是 **LC 双端接梯形的源端阻抗** —— 改成 0Ω 会同时废掉匹配与源阻抗 |

---

## §3 处理方式

### 3.1 为什么不能"改"，只能"删 + 重建"

| 试过的路 | 结果 |
|---|---|
| `sch modify --id <textId> --patch {"content":"…"}` | ❌ `Unknown component patch field(s): content`（合法字段只有 x/y/rotation/…/otherProperty） |
| `sch modify --id <textId> --patch {"name":"…"}` | ❌ `Failed to read component` —— **文字图元不是"元件"**，modify 够不着 |
| `sch rename` | ❌ 只能改**整张原理图文档**的名字，不是文字 |
| **`sch frame apply`** | ✅ **能新增任意文字**（frame 的 `title`），且**幂等** |

### 3.2 执行

```
① prim-delete 删掉 11 条过期/错误文字（AFE 6 · INT 3 · PWR 2）
② frame apply 补回更正后的说明：
   · AFE：3 条更正标签（U1B 增益 / R8+C10 / R1 端接 / R3 双角色）
   · INT：2 个分区标题**扩写**（把被删的注释并进标题）+ 1 条跨页网更正
   · PWR：1 条 R21 更正标签
③ 保存 → 关页重开 → 回读 → 门禁
```

**为什么 INT 用"扩写标题"而不是新加框**：`frame apply` 有 `partition-overlap` 校验
——新框若落在既有分区框内会被**拒绝**。而原来的注释本来就画在分区框里 ⇒ 改成把内容并进分区标题，
**零新增框、零重叠**。

### 3.3 顺带修掉的既有缺陷

**INT 页 ③ 分区的框 `minY=60`，而 `R40`/`R41` 在 `y=-50`** ⇒ 框**没盖住那两只电阻**。
已把 `minY` 扩到 **-90**（`18 §3.3` 记过"第二轮新增 18 只、10-02 又补 R40/R41"，框没跟着长）。

---

## §4 门禁与验收

| 页 | 结果 | 明细 |
|---|---|---|
| AFE | **PASS** | layout-lint 0 问题 · clusters 35 组 0 重叠 · check **2 finding（0 error**：1 条 `text-overlap` WARN 来自新标签压到一条网旗的估计文字带 + 1 条既有 `titleblock-key-absent` INFO）· bridge-check **0 问题树**（46 树）· **DRC 0 致命 / 0 错误 / 2 警告** |
| INT | 既有 FAIL | `check` 18 error —— 全是 `wire-through-body`，**EVK1 符号几何守卫所致**（`18 §R-21`、`20`）；**非本轮引入**（本轮把它从 19 降到 18）。DRC **0/0/2** ✓ |
| PWR | **PASS** | 全 0；bridge-check 0 问题树（13 树）· DRC **0/0/2** |

**渲染目视复核**（`_archive/_review4/eda/afe_final2.png`）：AFE 页 ⑤ 区顶部已显示
`U1B 同相放大 ×7.975：R6 24.9k 反馈 / R7 3.57k 落 VBIAS`，
`R8 100Ω + C10 470pF：ADC 采样反冲隔离（t_s=3 周期下 R_AIN ≤0.4kΩ）`，
旧的 `69.8k/10k` 已消失 ✓

---

## §5 本轮**没做**的（诚实边界）

| # | 项 | 为什么没做 |
|---|---|---|
| 1 | **把 13 条全部恢复成"原来的排版样式"** | 只能用 frame title（带虚线框）表达，样式与原文字不同；本轮把**内容正确**放在**样式一致**之前 |
| 2 | **消除新标签的 1 条 `text-overlap` WARN** | 它压到一条网旗的**估计**文字带（21×2.5 raw），是 WARN 不是 ERROR，门禁仍 PASS |
| 3 | **修 INT 的 18 条 `wire-through-body`** | 需要换 EVK1 符号或重画 18 条线；`20` 记着上次 `sch replace` 挂起 ⇒ 风险 > 收益 |
| 4 | **给 12 条 `$3Nxxx` 自动网名改成可读名** | 会新增 12 个网旗；且 `17 §3`/`26 §2` 已有映射表。**留作待办**：若评委看重可读性，用 `sch netflag` 逐条加 |
| 5 | **PWR 页 `C19/C20` 的删除是否影响屏去耦** | 已核：J5 侧有 `C21` 10µF + `C22` 100nF（2026-10-02 落图），核心板 LDO 自带输出电容 ⇒ 冗余判定成立 |

---

## §6 证据与复现

```bash
# 文字总清单（三页）
easyeda sch text-list --doc <pageUuid>

# 交叉核对（位号+数值 vs 网表现值）
python _archive/_review4/eda/check_text.py        # 本轮用的脚本（见下）

# 更正标签（幂等，可重放）
easyeda sch frame apply --doc fe840e6f545a2753 --from _archive/_review4/eda/frames_fe840e.json
easyeda sch frame apply --doc 63accad121e053cf --from _archive/_review4/eda/frames_int.json
easyeda sch frame apply --doc 0c870c063661db6c --from _archive/_review4/eda/frames_0c870c.json

# 门禁
easyeda sch gate --doc <pageUuid>
```

---

## §7 变更记录

| 日期 | 内容 |
|---|---|
| 2026-10-03 | 首版（第 2 轮审查）：三页 50 条文字逐条核对，查出 **13 条不一致**；因工具链无 text-modify ⇒ 采"删 + frame title 重建"路线；执行 11 条删除 + 6 处重建（含 2 个分区标题扩写）；顺带修 INT ③ 分区框覆盖不全（`minY` 60→-90）；三页门禁复核。 |
