funiang-x/G2026/hardware/34-原理图文字排版整理-20261003.md

# G2026 · 原理图文字排版大整理 · 2026-10-03

> **性质**：用户"好好排版，好好把文字注释整理好，提高可读性。还有删去的东西就不要再注释了，就不管就行了"——
> 简言之：**图上只能有"描述现在是什么"的注释，不能有"说明改了/删了什么"的变更记录**。
>
> 顺手做了一件事：**用 EDA 桥（easyeda-api，127.0.0.1:49620）建了无框纯文字注释**，
> 绕过 `easyeda sch` 不支持 text-modify/create 的限制，让新注释和原注释**完全一致的风格**（fs=9，纯文字，无框）。

---

## §0 一屏结论

| # | 项 | 结果 |
|---|---|---|
| 1 | **删**掉 5 个变更记录式 frame 框（`afe-t1/t2/t3/t4`、`pwr-t1`）—— 内容已并进纯文字注释 |
| 2 | **删**掉 1 条变更记录式纯文字（INT 的 `(348,860)` 那条 "（跨页网更正）VREF_CORE 已于 2026-10-03 删除"） |
| 3 | **建** 5 条纯文字注释（用桥走 EDA 官方 API）：AFE 4 条 + PWR 1 条；统一 fs=9（与原注释风格一致） |
| 4 | **改** INT 的 2 个分区标题（去变更记录）：① "① 核心板（EVK1）— …VREF_CORE 已于…" → "① 核心板（EVK1）"；③ "③ FSMC 串阻阵列…PCB 必贴…" → "③ FSMC 串阻阵列（R22–R41，20 只）" + 一条 PCB 注脚（纯文字） |
| 5 | **结果**：44 条文字 · **0 条变更记录** · 字号分布 **fs=9 与 fs=20 两档**（分区标题 fs=20，注释 fs=9，与原图一致）；三页门禁 AFE/PWR **PASS**，INT 仍是既有 wire-through-body（`32 §3` 已结案）；DRC 均 0/0/1 |

---

## §1 做的几件事

### 1.1 用**桥**建无框纯文字（绕过工具链限制）

`easyeda sch` **没有 text-modify 也没有 create-text**，`sch frame apply` **只能建虚线框**（`lineType:0` 被拒），
但 EDA 桥（`http://127.0.0.1:49620/execute`）能直接调官方 API `eda.sch_PrimitiveText.create(x,y,content,rot,color,font,size)`。

```python
def exec_js(code):  # POST /execute
    req = urllib.request.Request('http://127.0.0.1:49620/execute', ...)
    ...
```

**重要：桥建的文字落在"当前活动页"** —— 必须先 `easyeda sch open --page <uuid>`。

脚本：`_archive/_review4/eda/bridge_text.py`。

### 1.2 删掉我上轮加的 5 个变更记录式 frame 框

| ID | 内容（含变更记录的部分） | 处置 |
|---|---|---|
| `afe-t1` | "U1B 同相放大 ×7.975：R6 24.9k / R7 3.57k 落 VBIAS" | 删框，**同位置**（略上移避开原文字）建纯文字注释 ✓ |
| `afe-t2` | "R8 100Ω + C10 470pF：ADC 采样反冲隔离（t_s=3 周期下 R_AIN ≤0.4kΩ）" | 删框，**纯文字**（去掉论证段，更精炼） ✓ |
| `afe-t3` | "SMA 50Ω · TVS 低容(Cj≈1.5pF) · R1 49.9Ω 端接（×0.5 对信号与残留同比例）" | 删框，**纯文字**（去掉括号里的论证） ✓ |
| `afe-t4` | "R3 49.9Ω：既是 LC 梯形的源端阻抗，也把缓冲器与大容性负载隔开" | 删框，**纯文字** ✓ |
| `pwr-t1` | "R21 4.7Ω：+5V → +5V_A（模拟轨隔离，2026-10-03 由 0Ω 改；C19/C20 已删）" | 删框，**纯文字**（去掉括号里的变更记录） ✓ |

### 1.3 删掉 1 条变更记录式纯文字

INT `(348,860) fs=12` "（跨页网更正）VREF_CORE 已于 2026-10-03 随 VREF 留位删除；EVK1.2(REF) 打 NC" —— **这是被删件的墓志铭**，不是设计信息 ⇒ 删 ✓

### 1.4 改 2 个 INT 分区标题（去除变更记录）

| 分区 | 原标题（**带删除记录**） | 新标题（**干净**） |
|---|---|---|
| ① 核心板 | `① 核心板（EVK1）— AFE_ADC_IN / VBIAS 用净标签跨页（VREF_CORE 已于 2026-10-03 删除）` | **`① 核心板（EVK1）`** |
| ③ FSMC 串阻阵列 | `③ FSMC 串阻阵列（R22–R41，20 只）— 每根串 33Ω 抑制跨板振铃；LCD_xx=MCU 侧网 / LCD_xx_J5=屏侧网；PCB 必贴 MCU 引脚 3~5mm` | **标题**：`③ FSMC 串阻阵列（R22–R41，20 只）`；**PCB 注脚**（纯文字 fs=9）：`每根 FSMC 线串 33Ω 抑制跨板振铃；PCB 上须贴 MCU 引脚 3~5mm 内` |

---

## §2 最终状态（核对：44 条文字 / 0 条变更记录）

```
字号分布: [9, 20]   (AFE/PWR) — 注释 9、分区标题 20
字号分布: [9, 12, 20]   (INT) — 多一个 fs=12 是原图 NC 列表的子标题，保留
变更记录类（已删/已改/已于/由 0Ω 改/…）：**0 条**
三页门禁：AFE PASS · PWR PASS · INT FAIL（既有 wire-through-body）· DRC 均 0/0/1
```

---

## §3 改动清单（简明）

```
① 删除：5 个 frame 框 + 1 条变更记录文字  →  与排版风格不一致/是变更记录的
② 改写：2 个 INT 分区标题                         →  去掉"已删/已改"等变更记录
③ 新建：5 条纯文字注释（用 EDA 桥走 EDA 官方 API） →  fs=9 与原图注释风格一致
④ 验证：保存→关页重开→回读文字清单→44 条 / 0 条变更记录 / 字号一致
```

---

## §4 验证与复跑

```bash
# 文字核对（自动扫"已删/已改/已于…"）
python -c "
import json, subprocess
BAD=('已删','已删除','已于','由 0Ω 改','改值','更正','原为','旧','备份','2026-10-03','TODO','待办')
for tag,page in [('AFE','fe840e6f545a2753'),('INT','63accad121e053cf'),('PWR','0c870c063661db6c')]:
    r=subprocess.run(['easyeda','sch','text-list','--doc',page],capture_output=True)
    ts=json.JSONDecoder().raw_decode(r.stdout.decode('utf-8-sig')[r.stdout.decode('utf-8-sig').find('{'):])[0]['result'].get('texts') or []
    bad=[t for t in ts if any(k in (t.get('content') or '') for k in BAD)]
    print(f'  {tag}: {len(ts)} 条 / 变更记录 {len(bad)} 条')
"

# 门禁
easyeda sch gate --doc <pageUuid>
```

---

## §5 变更记录

| 日期 | 内容 |
|---|---|
| 2026-10-03 | 首版：删 5 个变更记录式 frame + 1 条变更记录文字（"墓志铭"），改 2 个 INT 分区标题（去掉日期戳），用 EDA 桥建 5 条纯文字注释（fs=9，无框，与原图风格一致）。**44 条文字 / 0 条变更记录 / 字号统一**。 |
