funiang-x/G2026/hardware/35-原理图优化轮-R42落图与注释收口-20261003.md

# G2026 · 原理图优化轮（R42 落图 + 注释收口）· 2026-10-03

> **性质**：用户要求"善用 skill 优化原理图（功能性、可读性等）"。本轮从 26/27/28 号文档挂账项
> 与活体目视两条线收口：**功能侧唯一挂账项 O7（`LCD_RST` 补串阻）落图**，可读侧做
> 注释去重、过期标题换代、杂框清理，并补上 26 号推荐但一直没落的 PC4 探针注释。
>
> **工具链**：`easyeda-agent`（typed CLI 为主）+ `easyeda-api` 桥（仅文字 create，同 `34`）。
> 全程未动 AFE 参数、未动 pinout、未动固件。

---

## §0 一屏结论

| # | 类 | 项 | 结果 |
|---|---|---|---|
| 1 | **功能** | **`R42` 33Ω 串入 `LCD_RST`**（28 §4.2-O7 / 26-N3 / 27-H3 挂账） | ✅ 落图并三重验收：`LCD_RST={EVK1.14,R42.1}` · `LCD_RST_J5={R42.2,J5.5}`；保存→重开→回读一致；DRC 0/0/1 |
| 2 | 可读 | INT ③ 分区标题换代 | "R22–R41，20 只" → "**R22–R42，21 只**" |
| 3 | 可读 | PWR ③ 分区标题去过期口径 | "③ 3V3 去耦与 +5V_A" → "**③ +5V_A 模拟轨隔离**"（C19/C20 已于 `25 §4` 删除，标题一直没换） |
| 4 | 可读 | AFE 注释去重 3 组（34 轮 frame→文字时与老注释撞车） | 21 → **18 条**：R8/C10 漂浮重复行、SMA/R1 重复行（合并为一条）、"经 49.9Ω 串阻"（保留具名 R3 那条） |
| 5 | 可读 | AFE 补 C6 取值说明（26-N8 "应写明"） | 容差行追加："**；C6=10nF 系 E24 在售值（理想 8.01nF）**" |
| 6 | 可读 | INT 补 PC4 探针注释（26-N1 推荐方案②） | 新增："**PC4(EVK1.9) = 只读探针，固件不采**"（@150,625，引脚列上方空白带） |
| 7 | 可读 | INT 删**空虚线框**（#333333，499×28 @145,885） | 杂框删除（旧分区残骸，框内无任何内容） |
| 8 | 一致 | **BOM 重生成**：69 数据行（AFE 36 · INT 26 · PWR 7），真 C# 66/69 | R42=C17634 已入列；D1/R8/D2 三件仍是**故意留空**（32 §1 的真歧义），dry-run 可补 0 |
| 9 | 一致 | `23 上板清单` 两处：加 R42 核对行；删已失效的 JP3 核对项 | ✅ |

**门禁终态（=基线，零回归）**：AFE/PWR `sch check` 0 ERROR（仅图签模板 INFO）；INT 18 ERROR =
既有 EVK1 符号并集框问题（`32 §3` 结案，**零新增**）；无 text-overlap / net-marker-mismatch /
partition-overlap；三页 DRC 均 0 fatal / 0 error / 1 warn（既有 advisory）；`sch nets` 69 网无异名、无单脚网。

---

## §1 功能侧：R42 补装（O7）——预案两处都翻车了，实际走法如下

`27 §8.6` 预写的四条命令**不能照抄**，本轮踩到两个坑：

### 1.1 坑一：预案的器件 UUID 已漂移

预案写 `--uuid 4ea00010107c8363`，但**活体** R22~R41 的 deviceUuid 已是 `72b9a53b8e064184ad3626512d381c3c`
（期间某轮 replace/rebind 过）。照预案落件会与 20 只同款电阻绑定不一致。
**修法**：落图前先 `sch list --include-device-identity` 取活体身份再 place。
落完回读：R42 绑定 = `72b9a53b...`，与 R22~R41 完全一致（属性 Value=33Ω / C17634 / 0805W8F330JT5E 齐全）。

> ⚠️ `place` 回包 `ok:false`（验证超时）但**已落地**（fresh list 证实 134 器件、坐标 (1040,-50)、位号 R42）——
> 再次印证 skill 的"超时 ≠ 未落地，先新鲜回读"。

### 1.2 坑二：netport 改名**不重绑线岛网名**（本轮最重要的发现）

预案第②步是 `sch modify` 把 J5 侧端口改名 `LCD_RST`→`LCD_RST_J5`。实际：

1. `sch modify` 直接拒绝（"仅当器件类型为元件时允许修改"——netport 不在可改范围）；
2. 改走桥 `sch_PrimitiveAttribute.modify(attrPid, {value})`，**回读三重全对**（属性值/组件名/net 字段都是
   LCD_RST_J5），但 `sch connectivity` + 权威网表 + `sch check` 一致表明：**端口标记改名了，其下线岛的
   引擎网名还是 LCD_RST**，`sch check` 报 `net-marker-mismatch`（"网络标识 LCD_RST_J5 与所连导线
   LCD_RST 名称不一致"）；保存→重开→回读仍是老网。
3. **结论：EasyEDA 的网身份跟着线岛走，netport 的 Name 只是显示层；改名事后不生效，必须重建线岛。**

**最终走法**（全部 typed）：

```bash
# ① place（活体 deviceUuid！）
easyeda sch place --doc 63accad121e053cf \
  --lib 0819f05c4eef4c71ace90d822a990e87 --uuid 72b9a53b8e064184ad3626512d381c3c \
  --x 1040 --y -50 --rotation 0 --designator R42
# ② 改名走不通 ⇒ 直接断开（disconnect 连桩线带端口一起删，alsoDisconnectedPins=[] 无附带）
easyeda sch disconnect --doc 63accad121e053cf --pin J5:5
easyeda sch disconnect --doc 63accad121e053cf --pin R42:2
# ③ 重建两侧线岛（autoconnect 建岛时才绑定网名——与 R22~R41 同范式）
easyeda sch autoconnect --doc 63accad121e053cf --pin R42:1 --kind netport --net LCD_RST
easyeda sch autoconnect --doc 63accad121e053cf --pin J5:5   --kind netport --net LCD_RST_J5
easyeda sch autoconnect --doc 63accad121e053cf --pin R42:2  --kind netport --net LCD_RST_J5
# ④ 闭环：save → doc reload → fresh connectivity（LCD_RST / LCD_RST_J5 成员核对）→ sch check
```

验收：`LCD_RST={EVK1.14, R42.1}`、`LCD_RST_J5={J5.5, R42.2}`；net-marker-mismatch 消失；
R42.1 桩向左、R42.2 桩向右、J5.5 侧重建桩向左 offset=125（规划器硬拒了会交叉其它引脚的方向）；
INT check ERROR 仍 18（全为既有 EVK1 项）。

---

## §2 可读侧

### 2.1 AFE 注释去重（21 → 18 条）

34 轮把 frame 转纯文字时，新注释与页面上原有注释形成了 3 组"同一件事说两遍"：

| 组 | 删除 | 保留/合并 |
|---|---|---|
| R8/C10 | (2080,1196)"R8…ADC 采样反冲隔离"（34 轮新建、漂浮在 R10 上方） | ⑤区注释块里信息更全的老行（含 → JP2 → AFE_ADC_IN 路径） |
| R1 | (100,1220)"SMA 50Ω · TVS 低容…R1 49.9Ω 端接" | 老行改写合并：**"SMA 50Ω · TVS 低容(Cj≈1.5pF) · R1 49.9Ω 端接：×0.5 分压"**（48,1195，与 C1 行左对齐） |
| R3 | (620,1250)"经 49.9Ω 串阻驱动 LC 梯形" | (488,1130) 具名 R3 的行（26-N4 要求的"源端阻抗"口径） |

### 2.2 过期标题换代（桥：删旧建新，同位同色同字号）

- INT ③：`③ FSMC 串阻阵列（R22–R42，21 只）`（R42 落图后必须同步，否则标题即错）
- PWR ③：`③ +5V_A 模拟轨隔离`——原标题"③ 3V3 去耦与 +5V_A"里的 3V3 去耦（C19/C20）早在
  `25 §4` 就删了，标题是 26-N4 类"口径过期"的漏网之鱼。

### 2.3 新增两条"防误导"注释

- **INT (150,625)**：`PC4(EVK1.9) = 只读探针，固件不采` —— 26-N1 的推荐方案②：固件把 PC4 配成
  高阻输入（"模拟轨在线"改由 AFE 帧直流均值判），图上却画着 VBIAS→PC4，接板人会以为固件在采偏置。
  落点选在 EVK1 左列引脚上方空白带（y=625，距最近端口行 18 units 以上，check 的 text-overlap 判定零新增）。
- **AFE (950,1210)**：容差行追加 `；C6=10nF 系 E24 在售值（理想 8.01nF）` —— 26-N8：后来人按"标准表"
  核对会以为 C6 画错，图上应写明按在售 E24 值拟合。

### 2.4 INT 空虚线框删除

`ac2a992ea77c67ae`（#333333，499×28 @145,885，虚线）——三个分区框之外的第 4 个矩形，
框内无文字无内容，旧分区残骸。`prim-delete` 删除并回读证实（AFE 恰好 5 框、PWR 恰好 3 框，无同类残留）。

---

## §3 门禁与证据

```bash
# 三页 check：AFE/PWR 0 ERROR；INT 18 ERROR（既有 EVK1 wire-through-body，32 §3 已结案）
easyeda sch check --doc <page>          # 无 text-overlap / net-marker-mismatch / partition-overlap 新增
easyeda sch drc --doc <page>            # 三页均 0 fatal / 0 error / 1 warn（与 34 基线一致）
easyeda sch nets                        # 69 网无同轨异名、无单引脚网
# 持久化：三页 save→doc reload→fresh 回读（文字条数 18/14/10、R42 网成员、0 变更记录式文字）
# 渲染：_archive/_eda/opt_20261003/{AFE,INT,PWR}_final.png（含基线版 AFE/INT/PWR.png 对照）
```

BOM：`python _archive/_review4/eda/gen_bom.py`（→ 69 数据行，R42=C17634 入列）+ `resolve_bom.py` dry-run（可补 0，
D1/R8/D2 维持 32 §1 的"真歧义留空"）。

---

## §4 本轮未做 / 移交

| 项 | 状态 |
|---|---|
| INT 18 条 wire-through-body（EVK1 符号并集框） | 维持 `32 §3` 结案口径：线是对的、符号的问题，权威 DRC 0 错误；根治需换 EVK1 符号（`20` 记录 `sch replace` 3 次挂起，不动） |
| 26-N1 方案①（EVK1.9 打 NC + 删 `.ioc` PC4 配置） | 未采（26 推荐②，本轮按②落注释） |
| 28 §4.3 O10（屏 ≥6 英寸题面符合性） | 用户 2026-09-28 已拍板 3.5″，维持 |
| 上板实测 9 条（`29 §14` 待实测） | 未验证口径不变；`23` 清单已含 R42 核对行 |

## §5 变更记录

| 日期 | 内容 |
|---|---|
| 2026-10-03 | 首版：**R42 33Ω 落图收口 O7**（预案 UUID 漂移 + netport 改名不重绑线岛两大坑，见 §1）；AFE 注释去重 3 组（21→18）、C6 E24 说明；INT ③标题换代 + PC4 探针注释 + 删空虚框；PWR ③标题去"3V3 去耦"过期口径；BOM 重生成（R42 入列）；23 清单加 R42 行、删 JP3 行。门禁零回归。 |
