funiang-x/G2026/hardware/36-仿真独立验证与择优-20261003.md

# G2026 · 仿真驱动的独立验证 + 择优 + 落图 · 2026-10-03

> **用户指令**："你来优化吧。不能单靠算，你尽量做电路模拟来看是不是真的是这样的。"
>
> 本轮不是"再读一遍文档"，是**换一套方法把文档的结论重算一遍**：
> 凡文档只给了"手算式 / 单个频点 / 标称值"的结论，这里都给**扫频、蒙特卡洛、或直接测量**。
> 结果：**1 个必须修的缺陷 · 1 项有证据的优化 · 1 个门禁盲区 · 1 个仿真环境隐患 ·
> 2 条文档结论被修正 · 3 条被独立证实**。
>
> **脚本**：`tools/sim/indep_check.py`（六项，可复跑）· `_archive/_review4/eda/fix_parts.py`（落图，
> fail-closed）· `_archive/_review4/eda/check_bom_consistency.py`（新门禁）· `_archive/_review4/eda/probe_part.py`（取证/回读）

---

## §0 一屏结论

| # | 项 | 结论 | 证据 |
|---|---|---|---|
| 1 | **`R6`/`R7`/`R21` 的供应商编号指向旧值器件** | ❌ **真缺陷**：`C706249`=69.8kΩ、`C2912582`=10kΩ、`C17477`=**0Ω**。BOM 的「值」对、「厂商型号」对、**唯独下单要看的那一列是错的** | `check_bom_consistency.py` 负向用例精确抓出这 3 行 |
| 2 | **`C2`/`C6` 取值可择优** | ✅ **真优化**：17 点标定残差的**最坏值 5.22 → 2.97 mV**（n=400 容差 MC）；原值最坏**已超 5 mV 判据** | §B 表 + n=400 MC |
| 3 | 「真 C# 覆盖率 96%」这个指标 | ⚠️ **是语法指标不是正确指标**——`resolve_bom.py` 的安全规则"只对不是真 C# 的件动手"**保证它看不到这类错** | §H 负向用例 |
| 4 | 仿真环境自身的口径 | ⚠️ **有隐患已修**：`afe_net.py` 的 R6/R7 还是改前旧值，而 `studies.OPT` 用 `r6=None` 兜底 ⇒ **单独跑 `studies.py` 算的是改前设计** | §I（修后逐位重现文档数字） |
| 5 | 文档「C6 不是 E24 最近值 ⇒ 应换 8.2nF」 | ❌ **被仿真推翻**（我自己的手算推断）：换 8.2nF 通带更平，但**折叠余量掉 2.1 dB** | §A/§B |
| 6 | 文档「`LCD_RST` 加 33Ω 会拖慢复位沿」 | ❌ **数量级不成立**：+7.7 µs = 5 ms 判据的 **0.155%** | §E |
| 7 | 文档「33Ω 贴连接器侧 = 等于没加」 | ⚠️ **过强**：负载端仍能拿到源端约 1/3~1/2 的降幅（台面 37.6% vs 22.5%） | §F |
| 8 | 折叠带判据用 1.5 MHz | ✅ **成立且偏保守 0.11 dB**（真边界 = `fs − 502 kHz = 1.498 MHz`） | §D 8501 点扫频，**0 违规** |
| 9 | 「1.0 MHz 只是恰好落 Nyquist bin 才无害」 | ✅ **更强**：整个 **1.0~1.498 MHz 都无害**（折到 >500 kHz 带外） | §D 点名频点表 |
| 10 | **`AGND↔GND` 那颗 0Ω 到底贴不贴**（`23` 列为"上板前优先级最高"） | ✅ **已实测通（结案）**。原理图侧印证：是 **`R8`（0Ω ±1%）**，`R8` 无 `(N)` 而 `R2` 标 `0Ω(N)`，且 `R2` 不贴已被 `25 §1.1` 实测印证 ⇒ 约定可信 ⇒ **底板不要再补 0Ω**（补了就是第二个接地点 ⇒ 地环路） | §M.1 |
| 11 | 背光（`28 §P-1` 称"供电三个薄弱点"之首） | ⚠️ **不是"电流未知"，是驱动方式不匹配**：规格要**恒流 60 mA ±10%**，实际是 **+3V3 恒压 + NMOS、无镇流电阻**。**已实测 3.3 V 能点亮**（⇒ 本机 `Vf` 在 3.3 V 侧内），**但「能亮」≠「合规」**。**先测；54~66 mA 就别动**；超了才改 **+5V 串 33Ω**（53.0~63.5 mA）。⛔ 从 3V3 串电阻**无效**（余量 0.2 V < 离散 0.35 V） | §M.2 |
| 12 | `T2` 5V 双源是否 ORing | ⚠️ **文本抽取判不了拓扑**，保持"必须实测"。但查实了核心板供电页的结构（两张独立网名 + `F1 0603 500mA` + 四条保护说明） | §M.3 |
| 13 | **我改的 C2/C6 有没有改坏东西** | ✅ **过了项目最强的测试**：`s8_e2e_fw.py`（题面 6 场景 × 标定开/关，固件峰检测链逐句照搬）**全部通过**，标定后 Upp 误差 **−0.005 ~ −0.144 mV**，u_J 抑制达标、带内伪峰 0 个 | §M.4 |
| 14 | **`23 §PCB-4` 的判据措辞"`AGND` 铜皮与 `GND` 只在一点相接"** | ❌ **照字面做会造出第二个接地点**（原文与"那个点在核心板"冲突）。已拆成 **4a~4d** 四条可检查判据：底板上两张铜皮**不得相连** · AFE 18 个模拟地**只汇 `EVK1.37`** · 数字回流不得借道（≥10mm）· 底层整片铺 GND、AGND 独立成岛 | §M.5 |
| 15 | `F1`（PPTC）的 `R_init` 能不能核 | ⚠️ **核不了**：平台库里是"三无"条目（无厂商/无描述/无值）。但**风险可判为低**（即使 1Ω 也只 100mV，LDO 还有 1.2V 余量）⇒ 降级为"顺手量、不阻塞" | §M.5 |
| 16 | **会不会自激？** | ✅ **不自激**（零输入长瞬态五档全部完全静默，含最坏叠加）；拓扑有三道保护（`R3`/`R8` 把大电容隔离在环外 + `U1B` 噪声增益 8）。**但发现两条新东西**：① 本电路反馈**不是单环**（`VBIAS` 共用造成第二条路径）⇒"单一相位裕度"不良定义；② **H2 把环内相位损失从 39.6° 砍到 16.4°**（最坏 `Cin` 下 58.8°→30.6°）—— 这是"必须贴 24.9k/3.57k"的**第二条、更硬的理由**。风险在**高阻的 `−in` 节点**，不在输出节点（输出挂 100pF 也只损失 4.5°） | §M.6 |

---

## §A 原型复算：8 阶双端接 Butterworth 的元件值从闭式解独立推导

文档 `26 §2.4` 给了"理想值 vs 图纸实值"表，但**没说那些理想值是怎么来的**。这里自己推：

双端接 Butterworth 的归一化元件值有闭式解 `g_k = 2·sin((2k−1)π/16)`，k=1..8
（奇序号 = 串联电感，偶序号 = 并联电容）：

```
g = 0.3902  1.1111  1.6629  1.9616  1.9616  1.6629  1.1111  0.3902
```

**fc 不能随便锚在某一颗上**（锚 C2 得 631.6 kHz、锚 L1 得 660.6 kHz）。本轮取
**逐颗反解 fc 的几何均值**当"这块板实际的设计 fc"——它是最小化全体相对偏差的那个 fc，
也因此能客观排出"哪一颗最离谱"：

| 件 | 理想值 | 图纸实值 | 偏差 | 反解 fc | **偏离设计 fc** | E24 最近 | 换后偏差 |
|---|---|---|---|---|---|---|---|
| **C6** | 8.21 nF | 10.00 nF | **+21.8%** | 529.3 k | **−17.9%** | **8.20 nF** | −0.1% |
| L7 | 13.71 µH | 12.00 µH | −12.5% | 736.8 k | +14.3% | 13.00 µH | −5.2% |
| L5 | 24.20 µH | 22.00 µH | −9.1% | 709.5 k | +10.0% | 24.00 µH | −0.8% |
| C8 | 1.93 nF | 1.80 nF | −6.5% | 690.0 k | +7.0% | 2.00 nF | +3.9% |
| L3 | 20.52 µH | 22.00 µH | +7.2% | 601.5 k | −6.7% | 20.00 µH | −2.5% |
| C4 | 9.68 nF | 10.00 nF | +3.3% | 624.4 k | −3.2% | 10.00 nF | +3.3% |
| L1 | 4.81 µH | 4.70 µH | −2.4% | 660.6 k | +2.4% | 4.70 µH | −2.4% |
| C2 | 5.48 nF | 5.60 nF | +2.1% | 631.6 k | −2.1% | 5.60 nF | +2.1% |

**设计 fc = 644.9 kHz**（几何均值）。**C6 是最离谱的一颗**，而 E24 里就有一个只差 0.1% 的 8.2 nF。

> ⚠️ **但我据此推出的"应把 C6 换成 8.2nF"被仿真推翻了** —— 见 §B。这正是"不能单靠算"。

---

## §B 元件值择优：目标不是"像 Butterworth"，是"17 点标定残差"

### B.1 为什么目标函数是它

固件 `op_cal.c:47` 的读取口径是 **log-log 线性插值**：

```c
*g = expf(logf(t->g[k]) + u * (logf(t->g[k+1]) - logf(t->g[k])));
```

所以某个频率落在两个标定点之间时，读数的残差就是**真响应与 17 点 log 域折线的最大偏离**。
判据是幅值 ≤5 mV ⇒ **这个残差必须算进预算**（`29 §I6` 记的"0.89 mV 占 17.7%"就是它）。
本轮把它当优化目标：**折叠余量 ≥10 dB 的约束下，最小化它**。只动电容（电感是难买件）。

### B.2 响应面（同一套 AC 判据，`indep_check.py B`）

| 方案 | 净增益 | @500k | 通带峰谷 | 折叠最差 | 余量 | **标定残差** | →幅值 | Cin 跨度 |
|---|---|---|---|---|---|---|---|---|
| **优化前**（C2=5.6n / C6=10n） | 1.9988 | −0.038 dB | 0.153 dB | −57.43 dB | 14.9 dB | 0.0299 dB | **0.863 m** | 0.240 dB |
| **活体现状**（C2=6.2n / C6=9.1n） | 1.9988 | −0.023 dB | **0.070 dB** | **−57.59 dB** | **15.1 dB** | **0.0102 dB** | **0.293 m** | 0.270 dB |
| 再搜一轮的最优 | 1.9988 | −0.029 dB | 0.046 dB | −57.06 dB | 14.6 dB | 0.0007 dB | 0.020 m | 0.258 dB |
| 若只把 C6 换回原型值 8.2 nF | 1.9988 | −0.053 dB | 0.042 dB | **−56.48 dB** | **14.0 dB** | 0.0173 dB | 0.498 m | 0.211 dB |
| 再把 C8 也换 2.0 nF | 1.9988 | −0.057 dB | 0.047 dB | −56.76 dB | 14.3 dB | 0.0219 dB | 0.630 m | 0.203 dB |
| 全部电容 ×0.95 | 1.9989 | −0.020 dB | 0.069 dB | −55.86 dB | 13.4 dB | 0.0054 dB | 0.155 m | 0.276 dB |
| 全部电容 ×1.05 | 1.9987 | −0.038 dB | 0.077 dB | −59.24 dB | 16.7 dB | 0.0198 dB | 0.570 m | 0.240 dB |

**第 4 行就是"我的直觉"**：C6 换成原型值 8.2 nF ⇒ 通带确实更平（0.070→0.042 dB），
**但折叠余量从 15.1 dB 掉到 14.0 dB**（−1.1 dB 相对现取值、−2.1 dB 相对优化前）。
也就是说 `C6 = 10 nF` **不是一个错误，是一笔取舍**：拿一点通带凹换一点抗混叠余量。
而通带那点凹**会被 17 点标定吸收**（残差 0.0102 vs 0.0173 dB —— 现取值反而更好）。

> **结论**：教科书原型值不是本设计的最优。判据不是"离 Butterworth 多近"，
> 是"17 点 log-log 标定后剩多少残差"。**优化后的 C2/C6 反而离原型更远**
> （+12.9% / +10.8%）—— 这是搜索出来的，不是推出来的。

### B.3 容差鲁棒性：真优势还是"拟合到那 17 个点上"？

给 L±10% / C±5% 做蒙特卡洛（固件口径的残差，换算成 250 mVpp 上的幅值误差）：

| 样本数 | 方案 | 中位 | 90 分位 | **最坏** |
|---|---|---|---|---|
| n=400 | 优化前 | 1.030 mV | 2.891 mV | **5.217 mV（超 5 mV 判据）** |
| n=400 | **活体（优化后）** | **0.550 mV** | **1.512 mV** | **2.966 mV** |
| n=150 | 优化前 | 1.155 mV | 3.016 mV | 4.911 mV |
| n=150 | 活体（优化后） | 0.545 mV | 1.606 mV | 2.868 mV |

两个独立种子、两组样本量给出同一结论：**中位减半、最坏减半**，不是拟合。

### B.4 把指标拿去做直接测量（不迷信自己的指标）

在最坏频点 f\* 注入单音，走固件全口径（17 点标定 → 12 bit 量化 → 频域 sin 重建）读 Upp 误差：

| 方案 | 8 块"随机容差板"上实测到的最大 Upp 误差 |
|---|---|
| 优化前 | **2.979 mV**（f\*=458.74 kHz，残差 +0.1014 dB） |
| 活体（优化后） | **1.367 mV**（f\*=457.55 kHz，残差 +0.0570 dB） |

**dB 代理指标与直接测量吻合**（+0.1014 dB ⇒ 2.93 mV，实测 2.979 mV）—— 指标可信。

### B.5 最小改动：C2+C6 两颗就够

`{C2, C6, C8}` 的 2³ 组合，各 100 次容差 MC：

| 改哪几颗 | 中位 | 90 分位 | 最坏 |
|---|---|---|---|
| **C2 + C6** | **0.517 mV** | **1.311 mV** | **2.114 mV** |
| C2 + C6 + C8 | 0.563 mV | 1.531 mV | 2.221 mV |
| C6 | 0.813 mV | 2.126 mV | 3.063 mV |
| C2 | 0.896 mV | 1.724 mV | 2.655 mV |
| C8 | 1.021 mV | 2.034 mV | 3.984 mV |
| 都不改 | 1.089 mV | 3.033 mV | 3.796 mV |

⇒ **只改 C2、C6**（C8 加进去反而略差）。落图就改了这两颗。

### B.6 端到端三场景：**不变**（诚实说明）

| | u_a | u_b | u_b 最坏 |
|---|---|---|---|
| 裸 Upp 误差 | −0.903 mV | −2.661 mV | +6.396 mV |
| 标定后 Upp | −0.098 mV | −0.244 mV | −0.049 mV |

优化前后**逐位相同**。因为这三个场景的频率/权重下，误差被 12 bit 量化与 sin 重建主导，
而不是被标定插值残差主导。**所以本项优化改善的是"最坏频点"（一个评委可能测到的任意频率），
不是那三个已知场景** —— 不要把它写成"提高了三场景精度"。

### B.7 没有继续追的部分

从活体再搜一轮能到残差 0.0007 dB（0.020 mV，**只剩预算的 0.4%**）。**不追**：
到那个量级，残差已经比量化噪声（0.233 mVrms）小一个数量级，
继续调只是在拟合这个特定指标，收益不可辨认，还要多改两颗料。`ponytail`：到收益不可辨认就停。

---

## §C 买错件：四种阻力组合的仿真后果

按 BOM 的供应商编号下单，实际会装上的 R6/R7：

| 情形 | 净增益 | vs 图纸 | @500k | 噪声底 | 不削顶余量 | **未标定时**最坏 Upp 误差 |
|---|---|---|---|---|---|---|
| OK 24.9k / 3.57k | 1.9988 | 1.00× | −0.023 dB | 0.0532 mV | 800 mVpk | **+6.396 mV** |
| ERR R6 买成 69.8k | 5.1510 | **2.58×** | −2.176 dB | 0.1293 mV | 311 mVpk | **+371.97 mV** |
| ERR R7 买成 10k | 0.8753 | **0.44×** | +0.340 dB | 0.0311 mV | 1828 mVpk | **−141.24 mV** |
| ERR 两颗都买错 | 2.0015 | **1.00×** | +0.793 dB | 0.0783 mV | 799 mVpk | +9.62 mV |

三条反直觉的发现：

1. **两颗都买错时净增益恰好还是 1.00×** —— 因为 `1 + 69.8k/10k = 7.98` 正是改值**之前**
   的运放增益，端接与 LC 的 ×0.25 没变。**所以"读数偏了"这个检验抓不到它**；
   能抓到它的是 **@500k 上翘 +0.793 dB**（图纸值是 −0.023 dB）—— 即 `27 §7.2 V1` 那条判据。
2. **"标定后"四组完全相同** —— 因为 `s7_scenarios` 的标定表是从**同一条仿真响应**上建的。
   现实里 17 点标定表是**在本板上实测建的**，所以静态增益偏差确实会被吸收。
   ⇒ **修正我在对话里的说法**：卖错件**不是**"读数永远偏 2.6 倍、判据直接崩"；
   它是"**在跑完扫频标定之前**偏 2.6 倍 / 0.44 倍"。
3. 但仍有 **4 条不靠标定兜底**，所以它**仍是必须修的缺陷**：
   - 上板扫频判据 `V1`（|H| 与仿真图 A 偏差 <1 dB）会 FAIL（实测会看到 +0.79 dB 的形状差异）；
   - 噪声底 **0.1293 vs 0.0532 mVrms（2.4×）**；
   - 不削顶余量从 800 → **311 mVpk**；
   - 设计文件与实物不一致 ⇒ 之后所有报告/答辩口径、`14`/`15`/`27` 的复算全部对不上。
   - 另外**裸误差 +6.396 mV 本身已超 5 mV 判据** ⇒ 本设计**依赖标定**，这条要在报告里写明。

---

## §D 干扰源扫频 0.90~2.60 MHz：文档只测了两个点，这里扫 8501 个

`26 §6`/`27 §S1` 只在 **1.0 MHz** 与 **1.5 MHz** 两点上论证折叠带。这里把 u_J（200 mVpp）
从 0.90 扫到 2.60 MHz（步长 200 Hz），逐点算"折进固件认的 `[9k, 502k]` 后能有多大"：

| 口径 | 带内伪峰最高 | 出现在 | 折到 | 门限 1.5 mV ⇒ 余量 | 违规频点数 |
|---|---|---|---|---|---|
| 峰值 = 100 mV（200 mVpp 的正解） | **0.1336 mVpk** | **1.4980 MHz** | 502.0 kHz | **11.2×** | **0 / 8501** |
| 峰值 = 200 mV（按题面不打折的保守口径） | **0.2671 mVpk** | 1.4980 MHz | 502.0 kHz | **5.6×** | **0 / 8501** |

**两条修正：**

- 真边界不是 1.5 MHz，是 **`fs − 502 kHz = 1.498 MHz`**（固件认到 502 kHz，不是 500 kHz）。
  文档用 1.5 MHz 作判据**偏保守 0.11 dB** —— 结论成立，只是可以说得更准。
- 文档说「u_J@1.0 MHz 只因**恰好**落在 Nyquist bin 才无害」。实际更强：
  **整个 1.0~1.498 MHz 都无害**（这一段的镜像落在 0.5~1.0 MHz，全在分析带外）。
  真要说危险，危险的是 1.498 MHz 起的**窄带** —— 而那里衰减已经 −57.5 dB。

点名频点（`|H|` 为源端 → ADC 的全链传递）：

| u_J | 折到 | \|H\| | ADC 端 | 判 |
|---|---|---|---|---|
| 1.000 MHz | 0.0 kHz（Nyquist bin → DC） | −26.74 dB | 4.6022 mVpk | 带外 |
| 1.100 MHz | 900.0 kHz | −33.74 dB | 2.0558 mVpk | 带外 |
| 1.400 MHz | 600.0 kHz | −52.11 dB | 0.2479 mVpk | 带外 |
| 1.498 MHz | 502.0 kHz | −57.49 dB | 0.1336 mVpk | **带内（最坏）** |
| 1.500 MHz | 500.0 kHz | −57.59 dB | 0.1319 mVpk | 带内 |
| 2.000 MHz | 0.0 kHz | −81.47 dB | 0.0084 mVpk | 带外 |
| 2.500 MHz | 500.0 kHz | −100.53 dB | 0.0009 mVpk | 带内 |

> 备注：折叠按"恰在 fs/2 的按落 DC 处理"（Nyquist bin 与 DC 都被固件的 `[9k,502k]` 排除）。
> 1.0 MHz 处 ADC 端 4.6022 mVpk 与文档的 4.88 mVpk（200 mVpk 口径）吻合到 6%。

---

## §E `LCD_RST` 串 33Ω：`22 §2` 的理由在数量上不成立

`22 §2` 写"不加阻尼（**加了反而拖慢复位沿**）"，`29 §C7` 记为"已接受"，
而 `26 §N3`/`27 §H3` 建议加，**活体 BOM 里 `R42` 已经在**（`35` 补装）。
两边都没给数。这里给数：适配板 `LCD_RST` 挂 **18 kΩ 上拉 + 100 nF**，
MCU 侧 PB1（输出阻抗按 30 Ω 估）经 `R42` 驱动，拉低 5 ms 后释放：

| 串阻 | 低电平 | **下降到 10%** | 释放到 90% |
|---|---|---|---|
| 无（等效直连） | 5.49 mV | **0.0070 ms** | 0.0072 ms |
| **R42 = 33 Ω（活体）** | 11.51 mV | **0.0147 ms** | 0.0148 ms |
| R42 = 100 Ω（夸张对照） | 23.66 mV | 0.0307 ms | 0.0300 ms |

⇒ **33 Ω 让下降沿多花 7.7 µs = 5 ms 判据的 0.155%**。释放沿由适配板自身的
18 kΩ×100 nF = 1.8 ms 主导，33 Ω 的贡献同样是 0.155% 量级。

**判据是"复位低电平脉冲 ≥5 ms"（`13 §5.4③`）** —— 7.7 µs 对它没有意义。
`22 §2` 那条注脚应退休；`R42` 保留。

---

## §F 8080 串阻贴 MCU 侧 vs 连接器侧

`18 §R-21`/`28 §5.2` 断言"放连接器侧 = 阻尼在负载端 = **等于没加**"，但 `28 §5.2`
自己标注过它的数字"是上界估计、不是实测"。这里用**分布 LC 阶梯**
（8 段，Z0=120 Ω，驱动 30 Ω，末端 10 pF，5 ns 斜坡边沿）直接量：

| 形态 | 不串 | **MCU 侧 33 Ω** | **连接器侧 33 Ω** |
|---|---|---|---|
| 成品（直插转接板，L≈60 nH） | 8.8% | **4.9%** | 6.7% |
| 台面（100 mm 杜邦，L≈215 nH） | 46.6% | **22.5%** | **37.6%** |

- **处方是对的**（必须贴 MCU 侧）：台面形态 22.5% vs 37.6%，差 **1.67×**。
- **但机制说法过强**：负载端仍能拿到源端约 **1/3~1/2 的降幅**（台面：不串 46.6%，
  源端降 24.1 个点，负载端降 9.0 个点）。不是"等于没加"。
- ⚠️ **绝对值不稳健**（随 Z0 / 驱动阻抗 / 边沿 / 末端电容而变）；**排序稳健**。
  上板仍须按 `23 §7 V12` 用示波器看 J5 侧过冲。

---

## §G 落图：5 件 / 15 个字段，回读 15/15

脚本 `_archive/_review4/eda/fix_parts.py`（fail-closed：取证 → 写入 → 保存 → **关页重开 → fresh 回读** → 逐字段判定）。

| 页/位号 | 字段 | 改前 | **改后** | 为什么 |
|---|---|---|---|---|
| AFE `R6` | 供应商编号 | `C706249`（=69.8 kΩ） | **`C865327`** | 指向旧值器件 |
| AFE `R7` | 供应商编号 | `C2912582`（=10 kΩ） | **`C2681644`** | 指向旧值器件 |
| AFE `R7` | 厂商型号 / 厂商 | `RT0805BRD073K57L` / YAGEO | **`ARG05BTC3571`** / **Viking(光颉)** | 该 MPN 平台库里根本不存在 |
| AFE `C2` | 值 | `5.6nF` | **`6.2nF`** | §B 择优 |
| AFE `C2` | 型号 / 厂商 / C# | `0805CG562J500NT` / FH / `C913931` | **`GRM2195C1H622JA01D`** / **muRata(村田)** / **`C710949`** | 同上 |
| AFE `C6` | 值 | `10nF` | **`9.1nF`** | §B 择优 |
| AFE `C6` | 型号 / 厂商 / C# | `0805CG103J500NT` / FH / `C2971995` | **`GRM2195C1H912JA01D/BKN`** / **muRata(村田)** / **`C184639`** | 同上 |
| PWR `R21` | 供应商编号 | `C17477`（=**0 Ω**） | **`C137513`** | 指向旧值器件 |
| PWR `R21` | 型号 / 厂商 | `0805W8F4R70T5E` / UNI-ROYAL | **`RC0805FR-074R7L`** / **YAGEO(国巨)** | 该 MPN 平台库里根本不存在 |

**回读：15 个字段全部 OK，不符 0。** 改前状态存 `_archive/_review4/eda/parts_before.json`（可一行回退）。

### G.2 顺带修：图上两条注释被改电容变成了假话

改 `C2`/`C6` 之后，AFE 页有**两条注释与实物不符** —— 这正是 `31` 号文档（"改值/删件后图上文字没跟上"）
要防的那类问题，而且它是我自己引入的，必须一起收口：

| 旧文字（假） | 新文字（真） |
|---|---|
| `L1/L3/L7... C2/C4/C6/C8 = 5.6/10/10/1.8 nF (全 C0G 0805)` | `… = 6.2/10/9.1/1.8 nF (全 C0G 0805)` |
| `容差复算：L±10%/C±5% × 5000 次，0/5000 跌破；C6=10nF 系 E24 在售值（理想 8.01nF）` | `容差复算 L±10%/C±5%：折叠带 0/300 跌破 -42.5dB；C2/C6 按 17 点标定残差择优（最坏 2.97mV < 5mV）` |

- 第二条同时**撤掉了一个被仿真推翻的理由**：原文用"8.01 nF 才是理想值"给 C6=10nF 找台阶，
  而 §B 证明**理想原型值不是本设计的判据**（换 8.2 nF 会掉 1.1 dB 折叠余量）。
  新文字只写"按什么指标择优、最坏多少" —— 按 `34` 的规矩**不写变更记录**。
- 路径：`easyeda sch` **没有 text-modify** ⇒ `sch prim-delete --ids` + **桥**
  （easyeda-api，127.0.0.1:49620）在原坐标原风格（fs=9 / `#1F5FA9` / 无框）重建。
  脚本 `_archive/_review4/eda/fix_afe_text.py`（fail-closed）。
- 回读：**18 条文字（2 删 2 建）、残留旧口径 0 条**；AFE 门禁复跑仍 **PASS**（check 1 finding / DRC 0/0/1）。
- ⚠️ **踩到一个坑，记下来**：`easyeda sch save` **只认 `--doc`**，传 `--page` 会**静默 rc=1**。
  第一次就踩了 —— 若只看到"text-list 里文字在"就收工，会误以为已存盘。
  **判据必须是 `save` 返回的 `result.saved == true`**（已在脚本里加硬判）。

**门禁零回归**（改后复跑）：

| 页 | layout-lint | clusters | check | bridge-check | **DRC** | gate |
|---|---|---|---|---|---|---|
| AFE | 0 重叠/0 出界 | 35 组 0 重叠 | 1 finding（0 error） | 0 桥接/0 孤儿（46 树） | **0 致命 / 0 错误 / 1 警告** | **PASS** |
| PWR | 0 / 0 | 7 组 0 重叠 | 1 finding（0 error） | 0 / 0（13 树） | **0 / 0 / 1** | **PASS** |
| INT | 0 / 0 | 26 组 0 重叠 | 47 finding（18 error = 既有 `wire-through-body`）× | 0 / 0（110 树） | **0 / 0 / 1** | FAIL（既有，`32 §3` 已结案） |

**BOM 从活体重生成**：`hardware/bom_final.csv` **69 行**（AFE 36 · INT 26 · PWR 7）。

---

## §H 新增门禁：BOM 一致性（并做了负向用例自检）

### H.1 为什么要它

`32 §1.4` 报的指标是「**真 C# 覆盖率 65/68（96%）**」—— 它数的是"这一格是不是 C# 语法"。
而 `resolve_bom.py` 的安全规则 ① 是「**只对 `supplierId` 不是真 C# 的件动手**」——
`C17477` / `C706249` / `C2912582` 都是**语法完全合法的真 C#**，
⇒ **这套"不猜"守卫保证它永远不会去看它们**。覆盖率 96% 全绿，下单却买错件。

**门禁判的是语义一致，不是语法存在。**

### H.2 判据与实现

`_archive/_review4/eda/check_bom_consistency.py`：逐行拿「供应商编号」去平台器件库回查，
比对库里的 `value` 与 `footprintName` 是否与 BOM 该行的「值」「封装」一致。

**默认语义 = "这版 BOM 能不能直接下单"**（fail-closed）：
`供应商编号` 不是 C 编号的行（占位串 `<MPN>.1`）**默认算 FAIL** ——
那种行在平台上查不到，下单时必然卡住，那就应该在门禁这步卡住，而不是在下单那步。
只想单独看一致性时加 `--allow-unresolved`。

### H.3 负向用例（`工程契约` §1 第 6 件：检查器自己是假的吗）

| 输入 | 命令 | 结果 | 退出码 |
|---|---|---|---|
| 改后 BOM（**下单就绪**） | 默认 | **FAIL 3 行**：`D1`/`R8`/`D2` 未指定供应商编号（真歧义，`32 §1.5`）⇒ **整版还不能下单** | **1** |
| 改后 BOM（只看一致性） | `--allow-unresolved` | **一致 66 · 不符 0 · 未指定 0 · 无法判定 3** | **0** |
| **改前 BOM**（`bom_final.csv.bak2-20261003`） | `--allow-unresolved` | **精确抓出 3 行**：`R6 C706249 值：BOM「24.9kΩ」vs 库「69.8kΩ」` · `R7 C2912582 值：BOM「3.57kΩ」vs 库「10kΩ」` · `R21 C17477 值：BOM「4.7Ω」vs 库「0Ω」` | **1** |

---

## §I 顺带修掉的仿真环境隐患（否则上面所有结论都会被算错）

`afe_net.py` 的元件值**必须与活体网表一致**（文件头自己写的规矩），
但 H2 改图（R6/R7 → 24.9 k/3.57 k）**只改了图纸，没同步这里**：
`V["R6"]=69.8e3`、`V["R7"]=10e3` 一直是旧值。

而 `studies.py` 的改前基线写的是 `dict(r21=0.0, r6=None, r7=None)` —— **靠 `None` 兜底到
`afe_net.V`**。两者一叠加的后果很隐蔽：

> **`python tools/sim/studies.py` 单独跑，输出的 S1/S2/S3/S5/S7 全部是"改前设计"的数字，
> 但它自己以为在讲现状。**

修法（两处，缺一不可）：
1. `afe_net.py` 的 `V` 对齐活体（`R6=24.9e3`、`R7=3.57e3`、`C2=6.2e-9`、`C6=9.1e-9`）；
2. `studies.OPT`（改前基线）改成**显式写值** `dict(r21=0.0, r6=69.8e3, r7=10e3)`，
   `verify_opt.py` 的两处 `r6=None, r7=None` 同样改成显式 —— **谁都不再依赖对方的默认值**。

**修后验收**（`verify_opt.py` 复跑）。注意要分**两个时点**看，否则会读错：

| 量 | 文档原值 | ② 口径对齐后（**改电容之前**） | ③ 现在（改电容之后） | |
|---|---|---|---|---|
| 改前 Cin 敏感性跨度 | 2.330 dB | **2.330 dB** ✓ | 2.338 dB | ②逐位吻合 |
| 改后 Cin 敏感性跨度 | 0.482 dB | **0.482 dB** ✓ | 0.497 dB | ②逐位吻合 |
| 改后 8p/4p 峰值起伏 | +0.047 dB | **+0.047 dB** ✓ | +0.054 dB | ②逐位吻合 |
| 改后 8p/4p 标定残差 | 0.0307 dB | **0.0307 dB** ✓ | **0.0104 dB**（变好） | 见下 |
| 噪声底 改前 / 改后 | 0.0828 / 0.0541 mVrms | 同 ✓ | 同 ✓ | 与电容无关 |
| u_b 最坏裸 Upp 改前 / 改后 | +14.45 / +8.01 mV | **+14.4531 / +8.0078** ✓ | 同 ✓ | ②逐位吻合 |
| 折叠带最差（改后） | −56.7 dB | **−56.73 dB** ✓ | −56.89 dB | 网格量级 |
| ADC 端 IM3@200k | 0.032 mV | **0.0315 mV** ✓ | 0.0295 mV | |

**② 这一列是口径对齐的验收证据** —— 在**没碰电容**的前提下，`verify_opt.py` 逐位重现了
`27 §8.5.4` 的每一个数字。⇒ 对齐**没有改坏任何东西**，且从此"改前/改后"两个基线都是显式的。

**③ 这一列才是现在的活体状态**，与 ② 的差异**全部来自 C2/C6 的择优**（LC 网络变了，
通带/折叠/残差本来就会动）—— 这反过来正好说明：**这几颗电容确实在影响判据量，
不是"随便取值都行"**。其中标定残差 0.0307 → **0.0104 dB**（0.89 → 0.30 mV）就是 §B 的收益。

> ⚠️ **折叠带那个数有网格量级的不确定度**：`−56.73 / −56.89 / −57.59` 三个值分别来自
> 不同的扫频栅格（`verify_opt` 200 点 vs `indep_check` 260 点）。因为 [1.5, 2.5] MHz
> 上 |H| 单调下降，粗栅格取到的最小衰减会随栅格位置浮动 ±0.3 dB。
> **判据是 ≤ −42.5 dB，余量 14 dB 量级，这个浮动不影响结论** —— 但引用绝对数时要写清是哪个栅格。

---

## §J 诚实边界（哪些不是"验证过的"）

1. **本轮全部是设计验证，不是上板验证** —— 板子还没做。
2. **`C2`/`C6` 的择优依赖一个模型化的尾部**：容差 MC 用的是"L±10% / C±5% 均匀分布"，
   真实批次分布不是均匀的。**判据侧的结论（残差是标定后的主要误差来源）不受影响，
   但"最坏 2.97 mV"这个具体数不要当承诺。**
3. **`§F` 的绝对值不可信**：Z0、驱动阻抗、末端电容都是估值；只有"源端优于负载端"这个排序是稳的。
4. **`§E` 的 MCU 输出阻抗按 30 Ω 估**：改成 20~50 Ω 只会让 33 Ω 的相对贡献在 0.1~0.3 ms% 量级变动，不改变结论。
5. **未建模**（沿用 `27 §11`）：输出级交叉失真、温漂、1/f、CMRR、走线寄生、电感 SRF/互感。
6. **没有动**：`R6`/`R7`/`R21` 的"器件名"（库绑定）仍是旧料号 —— 改它要 `sch replace`，
   会丢属性（`18 §R-25`），而下单只看 C#，本轮与 `33 §3.4` 的判断一致，继续不动。
7. **没追的更优解**：见 §B.7。
8. `D1`/`R8`/`D2` 三件仍是占位串（真歧义，需人工），门禁把它们标 SKIP 而不是通过。

---

## §K 复跑（全部命令）

```bash
PY=C:/Users/funiang/.workbuddy-ai/binaries/python/envs/default/Scripts/python.exe

# 0) 内核自检（必须先全绿，否则上层模型不算数）
$PY tools/sim/selftest_mna.py

# 1) 独立验证六项（A 原型 / B 择优 / C 买错件 / D 扫频 / E 复位 / F 串阻位置）
$PY tools/sim/indep_check.py all          # 约 6~8 分钟
$PY tools/sim/indep_check.py B            # 只跑择优（含容差 MC 与直接测量）
$PY tools/sim/indep_check.py R            # 只跑 n=400 大样本 MC
#   → tools/sim/out/indep_check.json

# 2) 工程原有仿真链（口径对齐后的验收）
$PY tools/sim/studies.py && $PY tools/sim/verify_opt.py && $PY tools/sim/s8_e2e_fw.py

# 2b) 背光镇流分析（§M.2；纯 KVL + LED 模型，无外部依赖）
$PY tools/sim/backlight_ballast.py

# 3) BOM：重生成 + 门禁（负向用例见 §H.3）
$PY _archive/_review4/eda/gen_bom.py
$PY _archive/_review4/eda/check_bom_consistency.py                     # 下单就绪：现在应 rc=1（3 行未指定）
$PY _archive/_review4/eda/check_bom_consistency.py --allow-unresolved   # 只看一致性：应 rc=0
$PY _archive/_review4/eda/check_bom_consistency.py --allow-unresolved \
     --csv hardware/bom_final.csv.bak2-20261003                # 负向：应 rc=1，精确抓 3 行

# 4) 图纸：取证 / 落图 / 回读（fix_parts.py 无 --apply 即 dry-run）
$PY _archive/_review4/eda/probe_part.py AFE C2,C6,R6,R7
$PY _archive/_review4/eda/fix_parts.py --apply
easyeda sch gate --doc fe840e6f545a2753   # AFE → PASS
easyeda sch gate --doc 0c870c063661db6c   # PWR → PASS
easyeda sch gate --doc 63accad121e053cf   # INT → FAIL（既有 18 条 wire-through-body，已结案）
```

---

## §M 两项"只能上板测"的检查，其实仓里有材料能答（2026-10-03 追加）

用户追加指令："看你来吧，做最有性价比的优化"。按 **价值 × 不做的代价 ÷ 落地成本** 排序，
最划算的不是再改一处电路，而是**把两条被列为"只能拿万用表量"的前置检查用仓里已有的资料答掉** ——
因为它们决定的是"**要不要动板子**"，而错动一次比不动更贵。

### M.1 `T1` `AGND` ↔ `GND`：**已实测通**（已结案），所以最优动作是**不要补**

`23 §1` 把它列为"上板前优先级最高"，`27 §7.2 T1` 说"底板这两张网没有任何连接件，
唯一回路是核心板内部那颗 0Ω"。那颗件是谁、贴不贴 —— 在 `hardware/data/_evk_sch_extract.txt`
（核心板原理图文本抽取）里直接能读出来：

```
GND AGND
R8  0402  0Ω  ±1%   GND   GND
数字地与模拟地单点相连
```

**`R8` = 0 Ω ±1%，0402，跨接 `GND` 与 `AGND`，注释写明"数字地与模拟地单点相连"。**

而"贴不贴"有约定：这份抽取里 **`(N)` 后缀 = 不贴**，全文件共 7 处：

| 位号 | 标注 | 判 |
|---|---|---|
| **`R8`**（AGND↔GND 单点） | `0Ω ±1%` | **贴** ✅ |
| `R2`（外部基准注入） | `0Ω(N)` | 不贴 |
| `R1` / `R6` | `0Ω(N)` | 不贴 |
| `C5` / `C6`（外部基准时补的电容） | `1uF(N)` / `100nF(N)` | 不贴 |
| `R13` | `1.5kΩ(N)` | 不贴 |

**两条印证**：

1. `25 §1.1` 早就**实测**确认"核心板排针 `REF` 针（`EVK1.2`）官方默认**不导通**（`R2` 0Ω **不贴**）"
   —— 与 `R2` 标 `0Ω(N)` **完全一致** ⇒ 同一条约定可信；
2. **2026-10-03 用户实测：`AGND` 与 `GND` 在核心板上是通的** ✅ —— 与 `R8` 无 `(N)` 一致。

⇒ **本条从"待测"结案。** 最有性价比的动作就是 **`23` 里那条"不通 ⇒ 底板补 0Ω"不要执行**：

> ⚠️ 若没查这条、按"预留 0Ω 位 / 补一个 0Ω"去设计，会造出一个**更糟**的故障 ——
> 核心板已经单点连了，底板再连一次就是**第二个接地点 ⇒ 地环路**，
> 而 `26 §N7` 自己写着"只许一个点"。**`23` 的判据已据此改写为"通了就不要再补；不通才补，且只补一个"。**

**这条是本轮最值钱的"不做"** —— 它的收益不是"省一颗 0Ω"，而是**避免引入一个隐蔽的地环路**。

### M.2 背光：不是"电流未知"，是**驱动方式与器件要求不匹配**；而"能点亮"**不等于"合规"**

`28 §P-1` / `29 §C5` 把背光列为"供电三个薄弱点"之首，说法是"电流未知（可能远超 60mA）……
**底板侧无解**"。查规格书后发现**问题比"未知"更具体**：

**模组规格**（`_spec_t3296.txt` §BACKLIGHT CHARACTERISTICS 与 `lcd_spec_extract.txt`
给出**同一张表**，即 TK035F3296 与 TK035F9629 两个模组同规格）：

| 项 | Min | Typ | Max | 单位 | 条件 |
|---|---|---|---|---|---|
| Forward voltage `Vf` | **2.9** | **3.1** | **3.6** | V | |
| Luminance `Lv` | 2600 | 3000 | 3400 | cd/m² | `If=60mA`, Ta=25℃ |
| Number of LED | — | — | **4** | Piece | |
| Connection mode | — | **parallel** | — | — | |
| **Using condition: constant current driving method `If=60mA(±10%)`** | | | | | |

**本设计的驱动方式**（`_adapter_pdf_p1.txt` / `adapter_sch_extract.txt`，适配板 TK035F5501）：

- 30-pin 接口上"背光"只有两根：**pin 28 = `BL_CTR`**（栅极）、**pin 30 = `3V3`**；
- 适配板：`Q1`(SI2302) 栅极 = `BL_CTR`、漏极 = `LED-`、源极 = GND；
  旁边那颗 `R7 = 10K` 是**栅极电阻**（就是 `13 D3` 记的"10K 下拉"）；
- **电流路径上没有任何镇流电阻**；模组阳极挂在适配板的 `3.3V` 网（= `J5.30`）。

⇒ **恒压（3.3 V）驱动一个要求恒流的负载。**

**2026-10-03 用户实测：3.3 V 能点亮。** 这条信息量比看起来大 ——

- 它**推翻**了本文初版"`Vf` 偏高的批次不亮"那一支**对本机**的适用性（本机 `Vf` 显然在 3.3 V 侧之内）；
- 它**不能**说明电流合规。**"能亮"正是过流也会有的样子**：3V3 直驱时电流由
  `(轨压 − Vf) ÷ 寄生电阻` 决定，而**寄生电阻只有几十 mΩ 量级**（Q1 的 `Rds(on)` + 走线 + 接插件）
  ⇒ **电流不是设计定的，是寄生参数定的**。

#### 结构化结论：决定成败的是「**余量 vs 颗间离散**」

用 `tools/sim/backlight_ballast.py`（`Vf@60mA` 作锚点 + 斜率假设 0.03/0.06/0.12 V/decade 做敏感性）：

| 驱动档 | 余量（轨压 − Vf_typ） | `Vf` 颗间离散 | 比值 | 结果 |
|---|---|---|---|---|
| **3V3 直驱** | ≈0.2 V | 0.35 V | **0.57** | `Vf`=3.6 → **0 mA（不亮）**；`Vf`=2.9 → **安培级（烧）** |
| **3V3 串阻** | ≈0.2 V | 0.35 V | **0.57** | 要居中到 60 mA 需 `Rs≈3.3 Ω`，此时 **19 ~ 115 mA（跨度 91 mA）** ⇒ **无解** |
| **5V 串 33 Ω** | ≈1.9 V | 0.35 V | **5.4** | **53.0 ~ 63.5 mA（跨度 10.4 mA）** ⇒ 基本合规 |

**为什么 3V3 档"串个电阻"救不了**：余量（0.2 V）**小于**颗间离散（0.35 V）。
串大阻值确实能把跨度压小，但电流也同时掉到 60 mA 以下 —— 那不是"救"，是"关掉"。

> ⚠️ **这条要纠正 `13 D3` 记的救援路径**：那里写的是"割适配板 `LED-A→3V3` 铜皮、**串一颗电阻**"。
> **在 3V3 馈线上串电阻是无效的**（上表第 2 行）—— 必须**改从 +5V 供**才有效。

#### 处置（按性价比排序）

1. **先测**：串限流源量 `+3V3` → 背光支路电流，判据 **54~66 mA**。
   - **落在 54~66 mA ⇒ 什么都别动**（"能用就别碰"）。
2. 明显超出 ⇒ 割适配板 `LED-A ↔ 3V3` 铜皮，**改从 `+5V` 串 33 Ω（1206 / 0.25 W）**：
   - `I = 53.0 ~ 63.5 mA`（`Vf` 2.9~3.25 全区间；对斜率假设不敏感）；
   - 电阻耗散 `I²R ≈ 0.133 W` ⇒ **必须 1206 或两颗 0805 并联**，别用 0805 单颗（额定 0.125 W，贴线）；
   - **顺带把 60 mA 从 +3V3 挪到 +5V**：核心板 LDO 耗散 `0.139 W → 0.037 W`。
   - ⚠️ **+5V 不在 30-pin 接口上** ⇒ 这一步必然要**飞一根线**（`+5V` 只到核心板排针）。
3. 要**严格**合规（覆盖 54~66 mA 全区间）⇒ 只能**恒流驱动**：适配板加恒流沉，
   或换带恒流背光驱动的模组（`29 §C5` 的兜底"换 1000 亮度板"）。

**为什么这不只是"亮度问题"**：`+3V3` 同时经核心板 `R4 47Ω` 供 `VDDA`/`VREF+`、
经底板 `R9/R10` 生成 `VBIAS`。设计是 **ratiometric**（`01` 约束⑤）⇒ **直流压降被抵消，不伤幅值精度**；
但过流会把核心板 LDO 的耗散从 `(5−3.3)×0.082 ≈ 0.14 W` 推高（若背光到 150 mA ⇒ **0.29 W**），
并把屏的 `IOVCC` 拉低。

**底板侧确实无解**（`28 §P-1` 的判断正确）—— 因为 pin 30 同时供屏逻辑与触摸，不能整体抬到 5 V。
但它**从"未知风险"变成了"下单前就定好的装配预案 + 一条决策规则"**，这就是本轮的价值。

### M.3 `T2` 5V 双源：**判不了**，保持实测（诚实边界）

核心板供电页（`_evk_sch_extract.txt` PAGE 3"供电部分"）能读到：

- `USB_IN_+5V` 与 `PIN_IN_+5V` 是**两张独立的网名**，然后都汇到 `+5V`；
- `F1 0603 500mA`、`U3 SCJA1117B-XXX-A`（核心板 LDO）、`R11/R10 = 5.1kΩ`（Type-C CC 下拉）、
  `R9/R12 = 22Ω`（USB 串阻）、以及四条保护说明
  （`1.USB数据口静电防护 2.钳位（过压）保护 3.过流保护 4.防反接（排针脚有可能接反）`）。

**但"两者之间是 ORing（如理想二极管）还是共节点"是连接拓扑，不是文字。**
文本抽取是按坐标顺序排列的，推不出拓扑。⇒ **不改 `23 §1` 的原判据：必须实测。**
（`26 §N2` 已经把这条从 P1 降为 P2，处置是"使用说明写死二选一"，所以**风险可控、不阻塞**。）

### M.4 对本轮改动的最终验收：过 `s8_e2e_fw.py`

改了 C2/C6 之后我先跑了 `verify_opt.py`，但**没跑项目自己称为"★ 最强证据"的那个**。
补跑（题面 6 个场景 × 标定开/关，固件峰检测链逐句照搬）：

```
✅ S8 全部通过（逐分量 |Δf| ≤ 1kHz 且 |ΔA| ≤ 5mV）
```

| 场景 | 标定后 Upp 误差 | Δf 最大 | ΔA 最大 | u_J |
|---|---|---|---|---|
| 题面原例（10.5k/31.5k/42k） | **−0.005 mV** | 0.0 Hz | 0.003 mV | — |
| 场景 1 u_a 含 200 kHz | −0.144 mV | 0.0 Hz | 0.013 mV | — |
| 场景 2 u_b 250 mVpp | −0.077 mV | 0.0 Hz | 0.016 mV | — |
| 场景 2 u_b 50 mVpp | +0.076 mV | 0.0 Hz | 0.028 mV | — |
| 场景 3 ⊕ u_J 1.5 MHz | −0.054 mV | 0.0 Hz | 0.005 mV | 峰表无、**带内伪峰 0 个** |
| 场景 3 ⊕ u_J 1.0 MHz | −0.054 mV | 0.3 Hz | 0.009 mV | 峰表无、**带内伪峰 0 个** |
| 场景 3 小信号 ⊕ u_J 1.2 MHz | +0.010 mV | 0.3 Hz | 0.007 mV | 峰表无、**带内伪峰 0 个** |
| 500 kHz 场景 | +0.041 mV | 0.0 Hz | 0.011 mV | — |

⇒ **C2/C6 的择优过了最强的一关**，不是"只在某个指标上好看"。

> **顺便记一条口径**：**未标定**时题面原例的 Upp 误差是 **−1.324 mV**（不是文档里那个 −0.005 mV）。
> 这再次印证 §C 的结论：**本设计依赖 17 点标定**，报告里要把"标定后"的口径写清楚。

---

### M.5 澄清「单点接地」+ 修掉一条**照字面做就会出错**的布局判据

用户追问："`AGND↔GND` 这个不用设计单点接地了嘛？" —— **这个误解必须当场拆掉，
因为它是"半懂"最容易造出的地环路。** 三件事要分开看：

| # | 是什么 | 谁负责 | 结论 |
|---|---|---|---|
| ① | **电气单点在哪**（两张地网只在一个点相连） | **核心板** `R8`（已实测贴） | 底板**不连** —— 不是"取消单点接地"，而是**这个点由核心板提供，你不能再造第二个** |
| ② | **底板 `AGND` 铜皮怎么汇** | **底板布局** | **必须做**：AFE 页 18 个模拟地成员**只汇到 `EVK1.37` 一个点** |
| ③ | **回流不许借道** | **底板布局** | **必须做**：数字回流（FSMC 束 / 背光）不得跨越 AGND 岛 |

⇒ **①不用做、②③一点没省。** 而且因为 `AGND` 在底板上是**一块电气上独立的铜皮**
（它回 `GND` 的唯一路径是 `EVK1.37 → 核心板 R8`），**②③ 在 2 层板上比有地平面的 4 层板更难做** ——
这也正是 `28 §3.3` 把"地回流"列为最弱一环的原因。

#### 顺手查出的一个真问题：`23 §PCB-4` 的措辞是**危险**的

原文判据栏写的是：

> `AGND` 铜皮与 `GND` 只在一点相接

**照字面做，设计者会去"底板上找一个点把两块铜皮连起来" ⇒ 正好造出第二个接地点 ⇒ 地环路。**
这与 `26 §N7`"只许一个点"、以及 ①"那个点在核心板"直接冲突。

**已改**（`23 §7.1`）：`PCB-4` 拆成 **4a~4d** 四条可检查判据 ——
**4a 底板上两张铜皮不得相连**（不许重叠、不许 0Ω/跳线/过孔桥接）·
**4b AFE 18 个模拟地只汇 `EVK1.37`** · **4c 数字回流不得借道（≥10mm）** · **4d 底层整片铺 GND，AGND 独立成岛**。

> **注意：原理图这一层本来就是对的** —— `AGND` 与 `GND` 在网表里是两张网、**没有任何连接件**，
> "单点"是靠**不连**来表达的。**要改的只是"给布局的人看的措辞"。**
> 顺带把 `PCB-3` 的"放连接器侧 = 等于没加"改成实测比例（源端约 1/3~1/2，`§F`）。

#### 另一条顺手查实的：`F1`（PPTC）在平台库里是"三无"条目

想核 `29 §D4` 的 `R_init`，查 `PPTCPSMD1006V1A` / `C9900004101` ——
**无厂商、无描述、无值**，只有一个 C 编号（`C99…` 前缀通常是嘉立创代管料）。`R_init` 无从核对。

但**风险可判定为低**：即使 `R_init` 坏到 1Ω，@0.1A 也只有 100mV；
`+5V` 到 LDO 输入 `5 − 0.4(D2) − 0.1(F1) = 4.5V`，对 3.3V LDO 仍有 ~1.2V 余量。
⇒ **从"待实测（可能有问题）"降级为"顺手量、不阻塞"**，已写进 `23 §1`。

#### 剩下哪些是我认为**不该动**的（各带理由）

| 不动 | 理由 |
|---|---|
| `D1`/`R8`/`D2` 挑料 | `D1` 两个候选是**镜像封装**，选错 = **ESD 防护静默失效**；拿"3 分钟人工步骤"去赌静默故障，不划算 |
| `C1`/`C9` 从 C0G 1206 换 X7R 0805 | 只省 ~¥3/板（单板），代价是重走一遍验证 —— `30 §5.4` 的"不改"判断正确 |
| 给 `D1` 前加串阻做持续过压保护 | `C1` 已隔直流；快速瞬态下 100Ω 相对 50Ω 源阻抗分不掉多少，**没有廉价解** |
| 把 `J5` 的 NC 脚改接地以增加地回流路径 | **2026-10-04 更正**：原文理由"用户已实测 `J5.22=D14`"不成立 —— `J5.22` 实为 `T_BUSY`（空位），且 J5 脚序已按官方脚表改图（`04 §6.18`）。**结论不变**：22/23/25 在适配板上有触摸用途（`T_BUSY`/`T_CS`/`T_MISO`），**不要接地** |
| 底板侧修背光 | pin 30 同供屏逻辑与触摸，**无解**（`§M.2`） |

---

### M.6 会不会自激？（脚本 `tools/sim/stability_check.py`）

**为什么必须单独查**：`27 §3.3` 的 E1 就是"AC 增益、DC 工作点全对，**只有瞬态才抓到的右半平面极点**"——
自激在 AC 扫描里可以完全看不出来。

#### 拓扑上本来就有的三道保护

1. `U1A` 接成跟随器，但**反馈点取在输出引脚**，`R3`(49.9Ω) 串在反馈点**之后**
   ⇒ 梯形的**大电容不在环内**（经典"隔离电阻"手法，`30 §1.4` 已记其意图）；
2. `U1B` 同理：反馈取在 `GOUT`，`R8`(100Ω) 在**之后** ⇒ `C10` **不在环内**；
3. `U1B` 噪声增益 = `1+R6/R7` = **7.975**（不是 1）⇒ 比跟随器更容易稳定。

⇒ **`U1A` 的环内没有任何外部极点**（环增益就等于运放自己的 `A(f)`，
实测宏模型 `|A|=1` 穿越 9.993 MHz、该点相位 87.8° —— 但**宏模型只有单主极点，这是上界**）。

#### 先说一个实测出来的"没有单一相位裕度"这件事

用串联注入法测 `U1B` 环增益时，实测到 **`V(GAININ) ≈ V(FB)`**（差模被抵消，`|GOUT/FB|` 只有 155
而运放开环增益应是 1e5）。查清了原因：

> **`VBIAS` 同时是** `U1A` 的 `+in` 偏置（经 `R2`）、`U1B` 的 `+in` 偏置（经 `R5`）、
> **以及 `U1B` 反馈网络的回地点（`R7`）** ⇒ 存在 **`FBJ → R7 → VBIAS → R5 → GAININ` 的第二条反馈路径**。

⇒ **本电路的反馈不是单环，"一个相位裕度数字"数学上并不良定义。**
（这解释了为什么工程里从没给出过 PM 值 —— 不是没人算，是这么算不对。）
所以本项改为回答两个**定义明确**的问题：

#### ② 环内唯一的外部极点在哪、吃掉多少相位

`U1B` 的 `−in` 节点上，反馈网络阻抗 `R6∥R7` 与运放输入电容形成一个**在环内**的极点：

| `R6`/`R7` | `Cin` | `R6∥R7` | 极点 | 在 1.25 MHz 环穿越处的相位损失 |
|---|---|---|---|---|
| **69.8k/10k（改前）** | 2p/2p | 8.75 kΩ | 4.55 MHz | 15.4° |
| **69.8k/10k（改前）** | 8p/4p | 8.75 kΩ | 1.52 MHz | **39.6°** |
| **69.8k/10k（改前）** | 16p/8p | 8.75 kΩ | 0.76 MHz | **58.8°** ⚠️ |
| **24.9k/3.57k（活体）** | 2p/2p | 3.12 kΩ | 12.74 MHz | 5.6° |
| **24.9k/3.57k（活体）** | 8p/4p | 3.12 kΩ | **4.25 MHz** | **16.4°** |
| **24.9k/3.57k（活体）** | 16p/8p | 3.12 kΩ | 2.12 MHz | 30.6° |

**这是本轮的一个新发现，而且是一条比原有理由更硬的理由：**

> **H2（`R6/R7` 69.8k/10k → 24.9k/3.57k）把 `−in` 节点阻抗从 8.75 kΩ 压到 3.12 kΩ，
> 从而把环内相位损失从 39.6° 砍到 16.4°（最坏 `Cin` 下 58.8° → 30.6°）。**
>
> `27 §H2` 给出的理由是"**通带对 `Cin` 的敏感性 2.33→0.48 dB**"。
> 现在多一条：**58.8° 的外部相位损失，配上真实运放自身的裕度，足以把环路推到临界甚至自激。**
> **通带形状不对还能靠标定救，自激不能标定。**
> ⇒ 这同时给 `23 §1` 的"`R6`=24.9k / `R7`=3.57k"加了**第二条判据**（已写成 `V14`）。

**顺带一个重要推论（反直觉）**：稳定性风险**不在输出节点，在高阻节点**。
输出脚上即使挂 **100 pF**，因为 `Ro≈100Ω`，极点也在 16 MHz，穿越处只损失 **4.5°**；
而 `−in` 节点阻抗是它的 **31 倍**，同样的杂散造成的极点低 4 倍。
⇒ **布局要盯的是 `R6`/`R7` 到 `U1B.-in` 那几毫米**（已写成 `37 §3.4` 的 A12/A13）。
每多 5 pF（≈5 mm 走线量级）就多吃约 **6°** 裕度。

#### ③ 零输入长瞬态：直接问"会不会振"

把输入**置零**（`VSRC` 的 dc 与 ac 都设 0），跑 **200 µs @1 ns**。
自激的特征是**末窗 p-p 不趋于 0**；起始瞬态会把所有模式都激励起来，所以不稳定模式会自己长出来。

| 情形 | `GOUT` 50–100 µs | `GOUT` 150–200 µs | `ADCP` 150–200 µs |
|---|---|---|---|
| 活体（无寄生） | 0.001 µV | **0.001 µV** | 0.001 µV |
| 输出脚寄生 22 pF | 0.002 µV | 0.002 µV | 0.002 µV |
| 输出脚寄生 100 pF | 0.001 µV | 0.002 µV | 0.002 µV |
| `Cin` 16p/8p（最坏档） | 0.002 µV | 0.003 µV | 0.002 µV |
| 改前 `R6`/`R7` + `Cin` 16p/8p | 0.001 µV | 0.001 µV | 0.001 µV |

⇒ **五档全部完全静默（nV 量级）—— 不自激。** 包括最坏叠加档。

#### 这两个测试的分工（都很重要）

- **③ 证"不自激"**：能抓到真正的失稳（起始瞬态就是激励）。
- **③ 抓不到"临界"**：理想仿真零输入下没有噪声源，**边缘稳定（裕度极小）看起来和稳定一样**。
  ⇒ "裕度有多薄"必须靠 **②**。
- **② 只能横向比较**：宏模型只有 1~2 个极点，**会低估真实运放的高频相位损失**；
  且真实器件的 `Cin` 是**未标定的工程假设**。
  ⇒ 真实器件能不能稳，**只能上板测**。

#### 上板判据（已写成 `23 §7 V13`）

**SMA 端接 50Ω、不接信号源**，用示波器看 `TP4` / `U1` 输出有无**持续正弦**（自激不靠外部激励）；
并交叉验 `V5`（`+5V_A` 压降异常偏大 = 运放可能在振荡 —— `23` 原本就用这条当"是否振荡"的探针）。

---

### M.7 手上只有 1% 的 51Ω / 47Ω，49.9Ω 怎么办？（脚本 `tools/sim/rterm_check.py`）

**这三个不是同一种角色，不能一起拍脑袋**：`R1` = **输入端接**（50Ω 匹配）；
`R3` = **LC 梯形的源端阻抗**、`R4` = **负载端阻抗** —— 后两颗**是滤波器的一部分**（`30 §5.3`：
"`R3` 不是随便一个串阻"）。而 `49.9Ω` 只是 E96 里最接近 50Ω 的值，
真实信号源/电缆本身就有 ±2~5% 的阻抗不确定度。

| 方案 | 端接比 | VSWR | 净增益 | vs 基准 | @500k | 通带峰谷 | 折叠最差 | 余量 | **标定残差→mV** |
|---|---|---|---|---|---|---|---|---|---|
| 基准 49.9 / 49.9 / 49.9 | 0.4995 | 1.002 | 1.9988 | — | −0.023 dB | 0.071 dB | −57.59 dB | 15.1 dB | 0.295 |
| **全 51Ω** ✅ | 0.5050 | **1.020** | 2.0175 | +0.94% | −0.014 dB | 0.075 dB | −57.45 dB | 14.9 dB | **0.267** |
| 全 47Ω | 0.4845 | 1.064 | 1.9477 | −2.56% | −0.072 dB | 0.057 dB | −58.01 dB | 15.5 dB | 0.375 |
| 只 `R1` 换 51Ω | 0.5050 | 1.020 | 2.0206 | +1.09% | −0.023 dB | 0.071 dB | −57.50 dB | 15.0 dB | 0.295 |
| 只 `R3`/`R4` 换 47Ω | 0.4995 | 1.002 | 2.0077 | +0.45% | −0.072 dB | 0.057 dB | −57.75 dB | 15.3 dB | 0.375 |
| 组合 `51∥2.7k` = 50.05Ω | 0.5003 | 1.001 | 2.0014 | +0.13% | −0.021 dB | 0.072 dB | −57.57 dB | 15.1 dB | 0.291 |
| 组合 `47+3.0` = 50.0Ω | 0.5000 | 1.000 | 2.0005 | +0.09% | −0.022 dB | 0.072 dB | −57.58 dB | 15.1 dB | 0.292 |

容差 MC（L±10% / C±5%，n=200）：**49.9 / 51 / 47 三档都是 0/200 跌破**（中位 −57.4 / −57.3 / −57.9 dB）。

**结论：三颗都用 51Ω，直接换。**

- **不用 47Ω**：VSWR 1.064（51Ω 只有 1.020）、@500k droop 是它的 3 倍、标定残差 0.375 mV（比 51Ω 的 0.267 差 40%）。
  47Ω 的折叠余量确实更好（15.5 vs 14.9 dB），但**那不是瓶颈** —— 判据 42.5 dB，两档都留着 ~15 dB。
- **不用凑 50Ω**（`51∥2.7k` / `47+3.0`）：VSWR 与净增益更漂亮，但**标定残差反而略差**（0.291 vs 0.267），
  还多一颗料、多一个焊点。**不值得。**
- **净增益那 +0.94% 不用管**：17 点标定表是本板实测建的，它会吸收；对 ADC 域绝对幅度的影响是
  0.134 → 0.135 mV，离 1.5 mV 门限还差一个数量级。

**⚠️ 换值必须三处同时改，否则会造出新的"值与料号不一致"**（这正是 `32 §1.4` 那次事故的形态）：

| # | 改哪里 | 51Ω 的值 |
|---|---|---|
| 1 | 图上 `R1`/`R3`/`R4` 的 **「值」** | `51Ω` |
| 2 | 图上三颗的 **厂商型号 + 供应商编号** | `0805W8F510JT5E` + **`C17738`**（厚声，与现用 `0805W8F499JT5E`/`C17720` 同厂同系列，直接替换） |
| 3 | **图上注释**（会变成假话的两条） | `R3 49.9Ω 兼作 LC 梯形的源端阻抗` → `R3 51Ω …`；`SMA 50Ω · TVS 低容 · R1 49.9Ω 端接` → `R1 51Ω …` |

> 47Ω 若要备选：`0805W8F470JT5E` / **`C17714`**（同厂同系列）。
>
> **好消息**：这次一致性门禁会自己发现漏改 —— 只改「值」不改 C#，
> `_archive/_review4/eda/check_bom_consistency.py` 会报 **`FAIL R1 C17720 值：BOM「51Ω」vs 库「49.9Ω」`**。
> 这是那道门禁建成后**第一次真正派上用场**。

---

### M.8 AFE 页加了「信号流向图例」+ 49.9Ω 替代的实测（2026-10-03）

**用户诉求**："在 AFE 页尽量把电路图都连接起来吧，不然我看不懂信号的流向。"

**先纠正一个前提**：**AFE 页本来就是连通的** —— 活体网表
`$3N522 = C1.1 + D1.4 + J1.5 + R1.1 + TP1.1`、`$3N523 = C1.2 + JP1.1`、`$3N524 = JP1.2 + R2.1 + TP2.1 + U1.3` …
渲染出来 `J1 → C1 → JP1 → U1A → R3 → L1…L7 → C8/C23/R4 → C9 → U1B → R8 → C10 → JP2 → AFE_ADC_IN`
是一条连续实线。**"看不懂"的真因是那 12 条网名是 EDA 自动生成的 `$3Nxxx`**
（`32 §4` 明确决定不改名：*"落点稍偏就变身 orphan-flag —— 比 `$3Nxxx` 更糟"*）。

**而"把导线都连起来"这条路本工程走过并且被挡住了**：
`18 §R-21`（`EVK1` 符号 body 是并集框 ⇒ 新画到内排引脚的导线被判 `wire-through-body` 拒绝）、
`18`（**"动看起来多余的线会真断网"**）、`20`（`R12` 因画线造成簇重叠 ⇒ 最后改「按名互连」才收口）。

⇒ **正确解法 = 把"读图顺序"写进图里，而不是重画导线。** 已落：

- 落点 `y=1520~1625`（器件 y∈[850,1440]、文字 y∈[830,1470] ⇒ 这条带 50 单位净空），共 **6 行**
- 内容：完整信号链 + 两次 ×0.5 + 净增益 ×1.98 + 两端点幅度 + `VBIAS`/`AGND` 归属
- 脚本 `_archive/_review4/eda/add_afe_flow.py`（幂等，重跑不重复建）；**文字 18 → 24 条**，回读 6/6，保存 `saved=true`
- **门禁零回归**（AFE `sch gate` PASS，DRC 0/0/1）
- 渲染目视核对：`_archive/_view3/AFE_flow.png`（`export-image --format png`）

**链上仍有两处"按名互连"**（刻意的，不是缺陷）：`AFE_BUF_IN`（`JP1` 之后）与跨页的 `AFE_ADC_IN`。

#### 49.9Ω → 51Ω 的替代（`tools/sim/rterm_check.py`，见 §M.7）

用户实际条件：**信号源 50Ω 输出 + 端子并 51Ω** ⇒ 分压比 `51/101 = 0.5050`、VSWR **1.02**。
落地要**三处同时改**：`R1`/`R3`/`R4` 的「值」`51Ω` + 厂商型号 `0805W8F510JT5E` + 供应商编号 **`C17738`**
（与现用 `0805W8F499JT5E`/`C17720` 同厂同系列）+ **图上两条写 `49.9Ω` 的注释**
（`SMA 50Ω · TVS 低容(Cj≈1.5pF) · R1 49.9Ω 端接：×0.5 分压`、`R3 49.9Ω 兼作 LC 梯形的源端阻抗`、`R4 49.9Ω 末端匹配…`）。
**漏改 C# 时新门禁会自己抓到**（`FAIL R1 C17720 值：BOM「51Ω」vs 库「49.9Ω」`）。

> ⚠️ **一个必须钉死的约定**：信号源面板显示的是**电动势（High-Z 档）**还是**50Ω 负载上的电压**？
> 两种约定差 **2 倍（6dB）**。本工程全部数字（含"不削顶上限 ±827mVpk"）按**电动势**口径。
> 自检方法：把源设成 250mVpp 接上板，量 `TP2`（`AFE_BUF_IN`）——
> 读到 **±62.3mVpk** 说明显示的是电动势；读到 **±123.7mVpk** 说明显示的是 50Ω 负载电压。

---

### M.9 事故留档：我误改 AFE 页导线（`sch wire`），**已整体回滚**（2026-10-03）

**用户诉求**："在 AFE 页尽量把电路图都连接起来吧，不然我看不懂信号的流向。"

#### 事实：信号链**本来就是实线连的**

活体取证 —— `JP1.2 → U1A.3` 是**同一条 wire tree** `f76a38f38695664c`：

```
(560,1050)[JP1.2] → (575,1050) → (575,1000) → (695,1000) → (695,1040) → (670,1040)[netport] → (720,1040)[U1A.3]
```

它**先爬到 y=1000 再绕下来**，所以渲染出来"看着像断的"。
**真正按名挂的只有两条支路**：`R2.1`（偏置注入）与 `TP2.1`（测试点）。

#### 我做错了什么

我按"看起来断"就动手，用 `sch wire` 把那条树**删掉重画成更直的形状**。而 `sch wire` 的
**自己的文档第一句**就写着：「**这是逃生口，不是常规布线手段**」，并警告
「EasyEDA 会自动合并共线相接的导线……**合并后多个网络并成一个，而 `sch check` 不报网络归属错误**」。

**两处真实损伤**：
1. 我把 `(670,1040)` 从**度数 1 的自由端**改成了**中间顶点（度数 2）**——
   而 `netport` **只能挂在自由端** ⇒ `bridge-check` 报 **1 orphan-flag**、`check` 报 `zero-length-wire`；
2. 修第 1 条时，我把 `pid=281b3abfc437c4d7` 的**"零长线" `(550,1385)→(550,1385)` 当成垃圾删了**——
   **它其实是 `R10.1 → VBIAS` 的连接**（netport 正好落在引脚上，所以桩长为 0）
   ⇒ `VBIAS` 丢掉 `R10.1`；同一轮里重画主链的 `sch wire` **直接失败（rc=1）**，
   ⇒ `JP1.2` / `U1.3` 掉出 `AFE_BUF_IN`。**信号链真的被断了。**

#### 处置：整体回滚，逐项回基线

`_archive/_review4/eda/rollback_afe_wires.py`（fail-closed）：

| 判据 | 事故中 | 回滚后 |
|---|---|---|
| `check` | 3 findings（**1 error**） | **1 finding / 0 error** ✅ 基线 |
| `bridge-check` | **1 orphan-flag** / 45 trees | **0 orphan-flag / 46 trees** ✅ 基线 |
| `AFE_BUF_IN` 成员 | `{R2.1, TP2.1}`（断了） | `{JP1.2, R2.1, TP2.1, U1.3}` ✅ |
| `VBIAS` 含 `R10.1` | 否 | **是** ✅ |
| 导线段 | 87 | **94** ✅ 与改动前一致 |
| `sch gate` | **FAIL** | **PASS**（drc 0/0/1，layout-lint 全 0，clusters 35） ✅ |

`R10:1 → VBIAS` 用 `sch autoconnect` 重补，工具自己选了 18 单位桩长
（`up offset=18 end=(550,1405)`）—— 比原来那条 **0 长度桩更规范**。

#### 三条教训（写给下一个改图的人）

1. **别凭渲染图判断"断没断"** —— 先 `sch list --include-pins --include-wires` 取**导线树**。
   图上"看起来断" ≠ 电气断：**网标/netport 本身就是连接**。
2. **`sch wire` 不是常规手段**（工具自己这么写）。改一个**没坏**的图形 = 纯风险、零收益。
   收益是"好看"，代价是差点真断网 —— 本工程已经因为同类操作断过一次（`18`："动看起来多余的线会真断网"）。
3. **"零长线"可能是合法连接**（netport 压在引脚上时桩长就是 0）。
   删任何图元前先问"它连着谁"，用 `--include-pins` 核对引脚归属，**不要按形状判断**。

#### 保留下来的净收益

**只有一条，而且是安全的**：AFE 页的 **`★ 信号流向` 图例**（`§M.8`，门禁零回归）。

#### 追加：用户要求"都做 + 从头到尾的信号流向"后的两次尝试

**（B）图例扩成「主链 + 逐分区进出口」—— ✅ 成功。**
11 行（`y=1520~1720`，与最低既有文字 `y=1470` 留 50 单位）：
主链 4 行 + `①~⑤ 逐分区 入/出 位号` 5 行 + 净增益 1 行 + 表头 1 行。
**中途自己踩了一个坑并修掉**：幂等判据原本用 `startswith('★ 信号流向')` **只删到表头 1 条**，
旧版其余 5 行留下 ⇒ 新旧**交错重叠**；改成**按区域（`x=100, y∈(1450,1800)`）删除**后干净。
另：初版最低一行放 `y=1490` 会压到 `(330,1395)` 的 `AFE_BUF_IN` netport（`check` 报 `text-overlap`），
整体上移到 `y≥1520` 后消失。**现在 `check` = 1 finding（仅剩既有的 `titleblock-key-absent` INFO）。**

**（C）把 `R2` / `TP2` 挪到信号导线上、改用实线连 —— ❌ 失败二次，已完整回滚。**

- **尝试 1（`sch wire` 拉直主链）**：见上文，造成 `orphan-flag` + 误删 `R10.1→VBIAS`。**已回滚**。
- **尝试 2（`sch modify` 把元件挪到导线上，全程不画线）**：
  思路是"引脚落到既有导线上即自动连接"（`sch wire` 文档原话："竖线穿过非目标引脚同样算电气接触"）。
  把 `R2` 从 `(595,1365)` 挪到 `(595,980)`（pin1 落在导线顶边 `(575,1000)-(695,1000)` 的**中部**）后实测：
  **`R2.1` 的网 = `None`** ⇒ **EasyEDA 不把"引脚压在线段中部"当作连接**（需要端点/结点）。
  脚本自动 revert。
- **而那次 revert 只挪回了元件、没恢复已删的桩与端口** ⇒ 页面一度停在**退化状态**：
  导线段 `94→93`、非 part 图元 `33→32`、`AFE_BUF_IN` 端口 `3→2`、wire trees `46→45`、`drc` warn `1→2`。
  **已用 `sch autoconnect --pin R2:1 / TP2:1 --net AFE_BUF_IN` 补齐**，并逐项回基线 ✅。

| 判据 | 退化时 | 修复后（= 基线） |
|---|---|---|
| `check` | 2 findings | **1 finding / 0 error** ✅ |
| `bridge-check` | 1 处 | **0 orphan-stub / 0 orphan-flag / 46 trees** ✅ |
| `drc` | 0 fatal / 0 error / **2** warn | **0 / 0 / 1** ✅ |
| 导线段 | 93 | **94** ✅ |
| 非 part 图元 | 32 | **33** ✅ |
| `AFE_BUF_IN` 端口 | 2 | **3** ✅ |
| `AFE_BUF_IN` 成员 | 缺 `R2.1` | **{JP1.2, R2.1, TP2.1, U1.3}** ✅ |

#### 最终结论：`R2` / `TP2` **保持网标连接**，这是**正确的做法，不是缺陷**

- **`netport` 本身就是连接**，不是"断开的占位"。`AGND`（17 旗标/34 脚）、`VBIAS`（7 端口/14 脚）同理。
- 在本工具下把它改成实线只有两条路：**`sch wire`（已证危险）**，或**引脚恰好落在导线结点上**（未验证）。
- **判据：改一个"电气上没坏"的图形，收益只是美观，代价是断网风险。** ⇒ 不做。
- **用户真正要的"从头到尾的信号流向"，由图例承担**（每个分区的入/出口位号都在上面）。

#### 教训加一条（第 4 条）

4. **写 revert 要覆盖"改动全集"**：删了桩、挪了件、删了端口 —— revert 就必须**逐个恢复**。
   只挪回元件 = 留下一个更难发现的退化状态（`drc` warn 才暴露）。

---

### M.10 偏置 `VBIAS` 的直流传递：**×1，不是 ×0、也不是 ×7.975**（脚本 `tools/sim/dc_bias_check.py`）

**起因**：用户"我没看懂这个偏置这个部分"。为了在图上写一段注释，我先把推导写下来，
结果发现自己要写的"**`R7` 回 `VBIAS` 时直流增益为 0**"**不严谨**，于是用仿真判。

**推导**（`U1B` 同相放大；`R6` 由 `GOUT` 到 `−in`、`R7` 由 `−in` 到 `VBIAS`）：
`V− = VBIAS + (Vout − VBIAS)·R7/(R6+R7)`；直流下 `V− = V+ = VBIAS`
⇒ **`Vout = VBIAS`，即偏置传到输出是 ×1**（不是 ×0，也不是被放大 ×7.975）。

**仿真（DC 解）**：

| 情形 | `VBIAS` | `U1A` 出 | 梯形出 | **`U1B` 出** | ADC 入 | 结论 |
|---|---|---|---|---|---|---|
| ① 活体（`R9=R10=10k` ⇒ 1.650V） | 1.6499 | 1.6499 | 1.6499 | **1.6495** | 1.6495 | — |
| ② 偏置抬到 2.4812V（`R9=3.3k`） | 2.4812 | 2.4812 | 2.4811 | **2.4807** | 2.4807 | **×1** ✅ |
| ③ 偏置抬到 2.7500V（`R9=2.0k`） | 2.7500 | 2.7500 | 2.7499 | **2.7496** | 2.7496 | **×1** ✅ |
| ④ 反例：**`R7` 改接 `AGND`** | 1.6500 | 1.6500 | 1.6499 | **13.1579** | 13.1579 | **贴轨饱和** ✅ |

⇒ **三条结论**：
1. **`R7` 必须回 `VBIAS`**：回 `AGND` 时偏置被放大 **×7.975** ⇒ 输出 **13.16V**（= `1.65×7.975`，与推导逐位吻合）⇒ 超出 3.3V 轨、开电即饱和。**这半句成立。**
2. **回 `VBIAS` 时偏置只按 ×1 传到输出** ⇒ 我原打算写的"直流增益为 0" **是错的**，已改成 ×1，
   并注明仿真实测 `1.6495V`。**"偏置对信号隐身"的准确说法是"偏置不被放大"，不是"偏置完全不过去"。**
3. **一处澄清（避免误伤文档）**：`27 §H1` **不是**关于偏置的（它是 `R21` 0→4.7Ω 的**电源纹波耦合**改进，
   500kHz 从 −39.6 → −89.8 dB）。**全仓检索确认没有任何文档写过"偏置误差 ×7.975 ⇒ 6.8V 饱和"**，
   那条是我把上一轮会话小结记串了 —— 已在本文纠正，**无需给其它文档出勘误**。
   另：`14 §133` 的表述是对的 —— "`R9/R10 = 10k/10k`：`VREF_ADC → VBIAS → AGND` ⇒ `VBIAS = VREF/2`，
   **ratiometric 于 `VREF`，漂移自抵消**" ✓ 与本结论一致。

**顺带一条实现细节**：`afe_net.build_afe` 的 `r9_from` **只认 `"3v3"`**，
传别的值会落到 `VREF_ADC`（不是"改成 +5V_A"）—— 所以本脚本改用**直接改分压比**（`V["R9"]`）制造偏置误差，
不再依赖该参数。（`_eda\afe_nets.md` 里 `VREF_ADC` 只剩 `C12`/`TP6`，`30 §4.5` 已把 `JP3/C12/TP6` 整条支路删除。）

---

### M.11 AFE 页"去网络标签"：**只有 1 张网该改，其余 30 个是"不得不用"**（2026-10-03）

**用户定的规范**：**AFE 页禁止使用网络标签，除非不得不用。** 本节是范围判定 + 执行 + 新教训。

#### 范围判定：33 个非 part 图元 → 30 个，**只有 `AFE_BUF_IN` 该改**

| 网 | 数量 | 性质 | 判定 |
|---|---|---|---|
| `AFE_ADC_IN` | 1 | **跨页**（→ INT 页 `PA1`） | **不得不用**（导线画不到另一页） |
| `+3V3` | 1 | **跨页**（← PWR 页 LDO） | **不得不用** |
| `AGND` | 17 | 电源轨（34 脚铺满 x∈[100,2500]） | **不得不用** |
| `VBIAS` | 8 | 电源轨（消费点相隔 1700 单位） | **不得不用** |
| `+5V_A` | 4 | 电源轨 | **不得不用** |
| **`AFE_BUF_IN`** | **3** | **普通在页信号网** | ✅ **改掉** |

> **电源轨为什么不是"怕麻烦"而是"不该改"**：`37 §4.3` / `36 §M.1` 要求 **AGND 的成员各自只汇
> `EVK1.37` 一个点＝星形**。若在图纸上画成菊花链母线，**原理图就在指示画板的人做出更差的地**
> （梯形各级共享地阻抗 ⇒ 等于偷偷加耦合元件）。**原理图的标注方式本身在传达布局意图。**

#### 方法：把引脚落到信号树的【自由端】（度数=1）—— **全程不用 `sch wire`**

取证（树 `65c6c0322a98d925`）：自由端只有两个 —— **`(580,1050)`** 与 **`(670,1040)`**
（`(560,1050)=JP1.2` 与 `(720,1040)=U1A.3` 已被占）。`JP1.2` 就是这么接的，所以引脚落在自由端**必定连通**。

| 件 | 落位 | pin1 | 说明 |
|---|---|---|---|
| `R2` | `(650,1040) rot=180` | `(670,1040)` | 朝外 +x，与导线出线方向一致 |
| `TP2` | `(600,1050) rot=0` | `(580,1050)` | 朝外 −x，与导线出线方向一致 |

#### 结果（逐项验收）

| 判据 | 结果 |
|---|---|
| `AFE_BUF_IN` | **彻底消失**（0 个残留旗标） ✅ |
| `JP1.2 / R2.1 / TP2.1 / U1.3` | **由纯实线连成一网**（`$3N690`） ✅ |
| 电气分区签名 | **19 组逐位一致**（只是网名 `AFE_BUF_IN → $3N690`） ✅ |
| `VBIAS` | 7 个元件脚完整 `{R2.2, R5.2, R7.2, R9.2, R10.1, C13.1, TP5.1}` ✅ |
| 非 part 图元 | 33 → **30** ✅ |
| `sch gate` | **PASS**（layout-lint 全 0 · check **1 finding/0 error** · bridge-check **0 orphan** · drc 0/0/1） ✅ |

> **顺手修掉一个组织不一致**：`R2` 原来画在 **③ 基准与偏置** 框内，但它的功能属于
> **② 一级缓冲与偏置注入**。同一次挪件让它落进了 ② 框 ✅（这原本是我上一轮单独指出的问题）。

#### 三条新教训

**5. `pin-exit-direction`：引脚的"朝外方向"必须等于导线离开该点的方向**（`outward = (rotation+180) mod 360`）。
第一次把 `R2` 放成 `rot=90`（outward 270°）而导线走 **+x** ⇒ 门禁报 **2 个 ERROR**。改成 `rot=180` 才对。

**6. `sch autoconnect` 会被几何卡死（rc=1），此时用 `sch connect` 手动给「短桩 + 旗标转向」**：
`R2` 的 pin2 朝外方向被规则锁成 **−x**，而正前方 19.5 单位就是 `TP2` 的本体 ⇒ autoconnect 拒绝。
解法：`sch connect --direction left --offset 5 --rotation 270` —— **桩只走 5 单位**（够不着 TP2），
**旗标转向 ±y 展开**（旗标朝向不受 `pin-exit-direction` 约束）⇒ 一次通过。

**7. 改完必须查 `bridge-check` 的 `orphan-tree`**（`check` 不报它）：挪件会留下"**旗标 + 桩**"的悬空树
（本次在 `(670,1330)` 留了一棵 `VBIAS` 悬空树）。`bridge-check` 会点名 **wireIds + flagIds**，
按提示 `sch prim-delete` 整树清掉即可。

**（第 4 条教训的再犯与修正）** `finish_delabel_afe.py` 里我把 `R2` 原来的 `VBIAS` 端口当"残留"删了，
但**那时 `R2` 已经挪位、上一轮 `autoconnect` 建的新端口又因再挪位而悬空**
⇒ **`R2.2` 断成 `net=None`** —— 那是 `U1A` 的**偏置注入开路**，直流工作点会塌，**属于真实缺陷**。
已用 `sch connect` 补回。**教训：判"残留"要看它是否接触导线，不能只看位置。**

---

## §L 变更记录

| 日期 | 内容 |
|---|---|
| 2026-10-03 | **四次追加（用户问"电路会不会自激？"）**：新增 **`tools/sim/stability_check.py`** 与 **§M.6** —— ① **拓扑上不自激**（`U1A`/`U1B` 的反馈点都取在输出引脚、`R3`/`R8` 在反馈点**之后** ⇒ 梯形大电容与 `C10` **都在环外**；`U1B` 噪声增益 7.975）；② **实测发现本电路反馈不是单环** —— `VBIAS` 被 `R2`/`R5`/`R7` 三处共用，存在 `FBJ→R7→VBIAS→R5→GAININ` 第二条路径（串联注入时实测 `V(GAININ)≈V(FB)`、差模被抵消）⇒ **"单一相位裕度"不良定义**，本项改答两个定义明确的问题；③ **环内唯一外部极点** = `R6∥R7 × Cin`（在 `U1B` 的 `−in`）：**H2 把 `R6∥R7` 从 8.75k 压到 3.12k ⇒ 相位损失 39.6°→16.4°（最坏 `Cin` 58.8°→30.6°）** —— 这是"必须贴 24.9k/3.57k"的**第二条、比通带形状更硬的理由**（通带不对能标定，自激不能）；④ **反直觉推论：风险在高阻节点不在输出** —— 输出挂 100 pF 因 `Ro≈100Ω` 只损失 4.5°，而 `−in` 阻抗是它 31 倍；⑤ **零输入长瞬态（200µs@1ns）五档全部完全静默**（nV 量级）⇒ 不自激；⑥ 同步 `23 §7` 新增 **`V13`（自激：SMA 端接 50Ω 不接源看持续正弦）** 与 **`V14`（R6/R7 的稳定性后果）**、`37 §3.4` 新增布局硬约束 **A12~A15**（`R6`/`R7` 紧贴 `−in` ≤3mm；每多 5pF 吃约 6°） |
| 2026-10-03 | **三次追加（用户追问"不用设计单点接地了嘛？"）**：拆掉这个误解并**修掉一条危险的判据** ——「单点接地」要分三层：① **电气单点在哪**（核心板 `R8`，底板不连）② **底板 `AGND` 铜皮怎么汇**（必须做，18 个成员只汇 `EVK1.37`）③ **回流不许借道**（必须做）⇒ **①不用做、②③一点没省**，且因 `AGND` 是电气独立的铜皮，在 2 层板上比 4 层更难。**`23 §PCB-4` 原文判据"`AGND` 铜皮与 `GND` 只在一点相接"照字面做会造出第二个接地点**，已拆成 **4a~4d**（不得相连 / 只汇 `EVK1.37` / 回流不借道 ≥10mm / 底层整片铺 GND、AGND 独立成岛），并把 `PCB-3` 的"等于没加"改成实测比例 1/3~1/2；顺手查实 `F1`(PPTC) 在平台库里是**"三无"条目**（`R_init` 核不了），但**风险可判为低**（即使 1Ω 也只 100mV，LDO 余量 1.2V）⇒ 降级为"顺手量、不阻塞"；并列出 5 项**明确不该动**的（含理由） |
| 2026-10-03 | **二次追加（用户给出两条实测：`AGND↔GND` 通 · 3.3 V 能点亮）**：① `T1` **从"推断"升级为"实测通、已结案"**，`23` 的判据固化为"通了不要碰"；② **背光那一节按实测重写并纠错** —— 本机 `Vf` 在 3.3 V 侧之内（"不亮"那一支对本机不适用），但**「能亮」≠「电流合规」**（电流由 `(3.3−Vf)÷寄生电阻` 定）；新增 `tools/sim/backlight_ballast.py` 把结论做成结构性判据（**余量 vs 颗间离散**）：3V3 档余量 0.2 V < 离散 0.35 V ⇒ **任何串阻都无解**（居中需 3.3 Ω → 19~115 mA），5V 档余量 1.9 V ⇒ 33 Ω 给 **53.0~63.5 mA**；**纠正 `13 D3` 的救援路径**（在 3V3 馈线上串电阻无效，必须改从 +5V）；③ 同步 `23 §1`（背光项重写 + 决策规则"在范围内就别动"）、`29` 勘误、`13 D3`、`docs/INDEX.md` |
| 2026-10-03 | **追加（"做最有性价比的优化"）**：① **`T1` `AGND↔GND` 从核心板原理图答掉** —— 那颗件是 `R8`（0Ω ±1%，**无 `(N)` = 贴**），而 `R2` 标 `0Ω(N)` 且 `25 §1.1` 已实测印证同一约定 ⇒ **预期是通的；因此最有性价比的动作是"不要补"**（补了就是第二个接地点 ⇒ 地环路），`23` 判据已据此改写；② **背光从"电流未知"升级为"驱动方式与规格不匹配"** —— 规格要求**恒流 60 mA ±10%**、`Vf` 上限 **3.6 V**，实际是 **+3V3 恒压 + NMOS、无镇流电阻** ⇒ 偏低批次过流 / 偏高批次不亮；给了 4 档处置与具体阻值（+5V 串 33 Ω/0.25 W，耗散 0.14→0.04 W）；③ `T2` 5V 双源**明确判不了拓扑**，保持实测（诚实边界）；④ **补跑 `s8_e2e_fw.py`（项目最强测试）验收 C2/C6 改动 —— 全部通过**，标定后 Upp 误差 −0.005~−0.144 mV；⑤ BOM 门禁改为 **fail-closed 的"下单就绪"语义**（未指定的行默认算 FAIL，`--allow-unresolved` 只看一致性），三档用例全对 |
| 2026-10-03 | 首版：独立验证六项（原型闭式复算 / 电容择优 / 买错件 / 干扰源 8501 点扫频 / `LCD_RST` 串阻 / 8080 串阻位置）· **查出并修掉 3 个器件的供应商编号指向旧值器件**（`R6`/`R7`/`R21`，含 2 个平台库里不存在的 MPN）· **择优 C2 5.6→6.2nF、C6 10→9.1nF**（标定残差最坏 5.22→2.97 mV，n=400 MC）· 图上 **2 条取值注释同步换代**（残留旧口径 0 条；`save` 只认 `--doc` 的坑已记）· 新增 BOM 一致性门禁并做双向自检 · 修掉 `afe_net.py`/`studies.py` 的陈旧基线与隐式兜底（复跑逐位重现文档数字）· 修正文档 3 条结论（C6"错值"→取舍、"33Ω 等于没加"→1/3~1/2、`LCD_RST`"拖慢复位沿"→0.155%）· 落图 5 件 15 字段回读 15/15 · 三页门禁零回归 |
