funiang-x/G2026/hardware/38-底板设计状态体检-20261004.md

# G2026 底板 · 设计状态体检（"设计好了吗？"）· 2026-10-04

> **口径**：全部结论来自**活体读**（`sch list --include-pins` / `sch check` / `sch drc` / `sch nets`
> / `pcb list` / `pcb check` / `pcb drc` / `pcb stackup show` / `bom export`），不引用旧文档的转述。
> 本文是 `37-投板检查单` 的**前置状态页**：37 说"画板时必须守住什么"，本文说"现在到底画到哪了"。

---

## §0 一屏结论

| 问题 | 答案 |
|---|---|
| **原理图** | ✅ **基本完成**（三页，0 悬空脚 / 0 孤桩 / 无单引脚网 / DRC 0 致命 0 错误）。今天又修掉 J5 的 9 个错脚（`04 §6.18`） |
| **PCB** | ❌ **只导入了器件，等于没开始**：64 个封装已落在画布上，但**无板框、无布局、无布线**（0 走线 / 0 过孔），DRC **191 条**全是"未连接" |
| **能不能投板** | ❌ **不能**。PCB 三项主活（板框 / 布局 / 布线）一件没做，另有 8 条待实测、6 处文档与图纸脱同步、1 个 BOM 缺料号 |
| 叠层 | ✅ `copperLayerCount = 2`（与 10-01 拍板一致） |
| 板↔图绑定 | ✅ `Board1` = `G2026-底板原理图`(3 页) ↔ `PCB1`，`linked: true` |

---

## §1 原理图体检（活体）

| 页 | 器件 | `sch check` | `sch drc` | 悬空脚 | 孤桩/桥 | 单引脚网 |
|---|---|---|---|---|---|---|
| AFE-前端模拟 | 35 | 2 条（1 处导线交叉） | 0 致命 / 0 错误 / 1 警告 | 0 | 0 | 0 |
| INT-核心板与接口 | 26 | 47 条（24 marker 重叠 + 4 旗反挂 + 19 导线穿 EVK1 体） | 0 / 0 / 1 | 0 | 0 | 0 |
| PWR-电源与背光 | 4 | 1 条 | 0 / 0 / 1 | 0 | 0 | 0 |

- 全工程 **68 张网**：`无同轨异名`、`无单引脚网`（`sch nets`）。
- `sch check` 的 47 条**全部是 WARN**（视觉重叠/旗朝向），无 ERROR；INT 的 19 条"导线穿体"是
  `EVK1` 符号体与引出线的**既有基线**，非本轮引入（改前改后同为 47）。
- `sch drc` 只给聚合值（EDA 未回逐条明细），三页同形，与改前一致。

---

## §2 PCB 状态（`PCB1` = `9346501af55b5204`）

| 项 | 实测 | 判定 |
|---|---|---|
| 封装 | **64 个**，244 个焊盘 | ✅ 与 BOM 位号数**一一对上**（64 = 64） |
| 走线 / 过孔 | **0 / 0** | ❌ 未布线 |
| 板框（BOARD_OUTLINE） | `segments: 0`、`width: null` | ❌ **没有板框** |
| 布局 | 器件停在导入原位（y ≈ −6000…−10000），未做分区/摆放 | ❌ 未布局 |
| 叠层 | `copperLayerCount = 2` | ✅ |
| `pcb drc` | **FAIL**，191 条，**全部 = `Connection Error`**（未布线的必然结果） | ❌ |
| `pcb check`（DFM） | **0 ERROR / 47 WARN**：丝印反/侧 18、丝印压焊盘 23、未铺电源铜 4、去耦偏远 2、缺基准点 1 | ⚠️ 均为布局期才能消的项 |

⇒ **结论：PCB 停在"刚 `import-changes` 完"的那一步。** 板框、分区布局、`R22~R42` 贴 MCU 侧、
`J5` 地针加固、铺铜、布线、丝印整理、DRC 清零 —— 全都没做。

---

## §3 遗留项清单

### 3.1 只能上板/实物实测的（8 条，都不需要改图）

| # | 项 | 判据 | 出处 |
|---|---|---|---|
| 1 | 核心板 `AGND` 针 ↔ `GND` 针通断 | ≤1Ω ⇒ 收工；不通 ⇒ 底板补 **0Ω 单点**（只许一个） | `29 F1` · `23 T1` |
| 2 | `EVK1.2`(REF 针) 对地电压 | ≈3.3V / ≈0V 都请回填 | `29 A12` |
| 3 | 触摸 IC 型号 | I²C 扫 **0x38** = FT6336 | `29 C3` |
| 4 | 背光电流 | 3.3V 单供 + 串毫安表，落 **54~66mA** | `29 C5` |
| 5 | PPTC 压降 | ⚠️ **前提已变**：PPTC 已不在图上（见 §3.2-①）⇒ 本条**作废** | `29 D4` |
| 6 | AFE 噪声底 | `TP4` < 0.5 mVrms | `29 F3` |
| 7 | 实物是 VET6 还是 VGT6 | 看板面丝印（决定 FLASH 是否只剩 18KB） | `29 H3` |
| 8 | 电感 SRF / 大信号 THD | 上板测 `TP3` 的 THD | `29 A3` |

### 3.2 文档 ↔ 图纸**脱同步**（6 处，必须改，否则下一个人按文档画错板）

> 来源：**2026-10-04 把 `_archive/_review5/G2026_before_J5fix_20261004.epro2` 里的 PWR 页缩略图与
> 10-02 快照逐件比对**得出。三件是**有意删的**（图上有注释），但**文档一条都没记**。

| # | 事实（图纸） | 还按老口径写的文档 |
|---|---|---|
| ① | **PWR 页已删 `J3`(DC005) / `F1`(PPTC) / `D2`(SS34)**；图内注释：**"本板由核心板 Type-C 供电：+5V 取自核心板 5V 引脚，底板不再自带 DC 座"**（故 `+5V_IN`/`+5V_RAW` 两网也消失） | `18 §6`（仍写"10 器件 + F1 / 9 网"）· `26 §4`（写 7 器件）· `37 §7`（仍勾"`F1`/`D2` 紧邻 `J3`"）· `04 §3` 电源树 · `23 §1` · `29 D2/D3/D4/D8` · `28 §5.1` · `36 §M.3` |
| ② | **AFE 页 `TP2`（缓冲器输入 / LC 入探针）已不在图上**（10-02 有 TP1~TP6，现只有 TP1/TP3/TP4/TP5） | `18 §5.2`（`AFE_BUF_IN = JP1.2,R2.1,TP2.1,U1A.3`）· `13 §264` · `06 §1.1` · `30 §90` · `37 §7`（"`TP1`~`TP5` 探针可达"） |
| ③ | `JP3` / `C12` / `TP6` 已删（死支路） | ✅ **已记**（`30 §5`、`33 §50`） |
| ④ | `C19` / `C20` / `LED1` / `R11` 已删 | ✅ **已记**（`25 §3`、`31 §129`、`33 §50`） |
| ⑤ | `R21` 已由 0Ω 改 **4.7Ω** | ✅ 已记（`29 D7`） |
| ⑥ | `07-无连接标志待点清单.md` **整篇过期**：引用 `H3`/`H4`/`J4` 等**已不存在的位号**，且写着"这版 EDA 的 API 放不了 NC 标志"—— 现在 `sch no-connect` 可用（今天刚用过） | 该文件自身 |

### 3.3 BOM / 工程文件

| # | 项 | 状态 |
|---|---|---|
| ① | **`R8`（100Ω）的 `Supplier Part` 仍是 `0805W8F1000T5E.1`**（平台占位，**不是 C 号**）⇒ 不可直接下单 | 33 §1.5 的"真歧义留空"（另两件 `D1`/`D2` 中 `D2` 已随电源级删除、`D1` 已补 `C456094`）⇒ **只剩 R8 一件** |
| ② | 29 行 BOM、64 个位号、**无缺封装** | ✅ |
| ③ | 工程根**没有 `PROJECT.md`**（`AGENTS.md` 指定的状态落点） | ⚠️ 缺失 |
| ④ | 转接板 `P4`（`DE/PCLK/VSYNC/HSYNC`）出厂悬空，规格要求接 GND/IOVCC | ⚠️ 上电前锡桥（`04 §8.5-③`） |

---

## §4 下一步（按顺序）

1. **画板的人接手 PCB**：板框 → 分区（`37 §2.1`）→ `R22~R42` 贴 MCU 侧 → `J5` 地针/去耦 → 铺铜 → 布线 → DRC 清零。
   全部硬约束在 `37 §0`（12 条）与 `37 §7`（勾选单）。
2. **改 §3.2 那 6 处文档**（尤其 ①：电源口径变了，`23 §1`/`37 §7` 的勾选项目前会误导）。
3. **`TP2` 是否要补回** —— 图上没有、文档都引用它。补/不补请拍板（`sch place` 一个测试点即可）。
4. `R8` 补 LCSC C 号。
5. 上板前做 §3.1 的 8 条实测。

---

## §5 诚实边界

- `sch drc` 只回聚合值（"1 warn / 无逐条明细"），所以"与基线一致"是**按 `sch check` 的条数**
  （AFE 2 / INT 47 / PWR 1）判断的，不是逐项比对 EDA 客户端的 DRC 面板。
- §3.2 的"有意删"依据是**图纸上的注释文字**（从备份包的页面缩略图读出），
  没有找到对应的决策记录 —— 所以列成"文档待同步"，而不是"误删"。
- PCB 的 47 条 DFM WARN 里有 23 条"丝印压焊盘"、18 条"丝印反/侧"，**布局与丝印整理后会自然消解**，
  现在不必逐条处理。
