funiang-x/G2026/hardware/39-原理图缺陷体检-20261004.md

# G2026 原理图 · 缺陷体检（三页全量）· 2026-10-04

> **怎么查的**：全部结论来自**活体读**——`sch list --include-pins` 逐页拉全量引脚 →
> 本地重建**全局网表**（64 位号 / 68 网 / 全部引脚）→ 跑 8 类机械判据；
> 再叠 `sch check` / `sch drc` / `sch nets` / `bridge-check` / `clusters --strict` /
> `layout-score` / `titleblock-get` / `sheet-geometry` / `status`。
> **不引用任何旧文档的转述**。脚本 `_archive/_review5/audit_sch.py` + `_archive/_review5/audit2.py`，原始输出 `_archive/_review5/audit_report.txt` / `audit2.txt`。
>
> **前置**：`38-底板设计状态体检-20261004.md`（那份讲"画到哪了"，这份讲"图本身有没有错"）。

---

## §0 一屏结论

**电气层：查不出错。** 8 类连接性判据**全部为 0**，与固件的逐脚对照**全一致**。
**缺陷集中在"可复核性"与"交付规范"两层**：4 项待办 + 3 项待确认，**没有一条会烧板子**。

| 层 | 结论 |
|---|---|
| 电气连接 | ✅ 无缺陷（悬空脚 0 / 单引脚网 0 / 孤桩 0 / 桥接短路 0 / 同名异网 0 / 孤立网标 0） |
| 与固件一致性 | ✅ 20 条 FSMC + 背光/复位/触摸/ADC/VBIAS **逐脚一致** |
| 可复核性 | ⚠️ **AFE 页 14 条内部网全是自动名 `$3Nxxx`** —— 该区按网名核对失效 |
| 交付规范 | ⚠️ **标题栏字段全空 + 无 sheet 图框图元** —— 越界检查不可判、`sch status` 的 S1 过不了 |
| 待办 | `R8` 缺 LCSC 号 · INT 页可读性 67.7 [fair] · `TP2` 无记录消失 |
| 待确认 | `D1` 的"型号 ↔ 符号 ↔ 封装"三者对不上 |

---

## §1 电气连接（8 类判据，全 0 = 无缺陷）

| # | 判据 | 结果 |
|---|---|---|
| 1 | 悬空引脚（无网 **且** 未打 NC） | **0**（AFE 0 / INT 0 / PWR 0） |
| 2 | 单引脚网（只有 1 个器件脚） | **0** |
| 3 | 孤桩 / 桥接短路（`bridge-check`，110 棵线树） | **0 / 0** |
| 4 | 同名异网 / 同轨异名（`sch nets`，68 网） | **无** |
| 5 | 孤立网标（该页有网标但该页无器件脚落到该网） | **0** |
| 6 | 位号重复 | 无（`U1` 出现 2 条 = 双运放两半，正常） |
| 7 | 缺封装 | **0** |
| 8 | 簇重叠 / 出图纸（`clusters --strict`） | AFE **0 / 0** · INT **0 / 0** |

**AGND ↔ GND 的唯一回路**（设计要的单点）：
底板上两网**零连接件** ✓ —— 唯一同时落在两网上的是**核心板符号 `EVK1` 自己**（`AGND=EVK1.37`、
`GND=EVK1.39/77/79`），回路走核心板内部 `R8`(0Ω)，与 `36 §M.1` 的结论一致。
⇒ **底板绝不能再加 0Ω/过孔桥接**（`37 §0-1`）。

**电源网成员（现行）**：

| 网 | 成员 | 说明 |
|---|---|---|
| `+5V` | `EVK1.40/80` · `C16.1` · `R21.1` | **唯一来源 = 核心板 5V 引脚**（Type-C 进电）⇒ **底板不能独立供电** |
| `+5V_A` | `U1.8` · `C11.1` · `C14.2` · `R21.2` | 经 `R21` 4.7Ω 隔离 |
| `+3V3` | `EVK1.38/78` · `J5.30` · `C21.2` · `C22.2` · `R15.1` · `R16.1` · `R9.1` | 屏 + 触摸 + I²C 上拉 + 偏置分压 |
| `VBIAS` | `R2.2` `R5.2` `R7.2` `R9.2` `R10.1` `C13.1` `TP5.1` · `EVK1.9(PC4)` | `R9/R10` 10k 分压 + 自检脚 |
| `AGND` | 17 个 AFE 件 + `EVK1.37` | 与文档的"18 成员"一致 |
| `GND` | `J5.29` · `EVK1.39/77/79` · `C16.2` · `C21.1` · `C22.1` | 数字地 |
| `AFE_ADC_IN` | `JP2.2` · `EVK1.4(PA1)` | 2 端网，正常 |
| 跨页网 | **9 条**：`+3V3` `+5V` `+5V_A` `AGND` `GND` `VBIAS` `AFE_ADC_IN` `TP_SCL` `TP_SDA` | 旧文档说 10 条 —— 第 10 条 `VREF_CORE` 已随死支路删除 |

---

## §2 与固件 `board_config.h` 逐脚对照 —— **全一致**

| 网络 | 图上 EVK1 脚 | MCU | `board_config.h` | 判定 |
|---|---|---|---|---|
| `LCD_D0`~`LCD_D15` | 36/35/72/71/13/16/15/18/17/20/19/22/21/30/29/32 | PD14 PD15 PD0 PD1 PE7~PE15 PD8 PD9 PD10 | `BOARD_LCD_D0..D15` 逐条相同 | ✅ |
| `LCD_CS` / `LCD_RS` / `LCD_WR` / `LCD_RD` | 67 / 31 / 69 / 70 | PD7 / PD11 / PD5 / PD4 | `NE1` / `RS` / `NWE` / `NOE` | ✅ |
| `LCD_BL_PB0` | 11 | PB0 | `BOARD_LCD_BL` | ✅ |
| `LCD_RST` | 14 | PB1 | `BOARD_LCD_RST` | ✅ |
| `TP_SCL` / `TP_SDA` / `TP_INT` | 23 / 24 / 12 | PB10 / PB11 / PC5 | `TOUCH_I2C_SCL/SDA/INT` | ✅ |
| `AFE_ADC_IN` | 4 | PA1 | `BOARD_ADC_IN` + `ADC_CHANNEL 1` | ✅ |
| `VBIAS` | 9 | PC4 | `BOARD_VBIAS_SENSE` | ✅ |

**串阻阵列也逐条核过**：`R22`~`R37` = `LCD_D0..D15 ↔ LCD_D0_J5..D15_J5`（33Ω，21 只，含 `R38`CS/`R39`RS/`R40`WR/`R41`RD/`R42`RST）—— **21 条一一对应，无错位**。

---

## §3 缺陷清单（按影响排序）

### 3.1 待办（3 条）

| # | 项 | 影响 | 怎么修 |
|---|---|---|---|
| **1** | **标题栏（明细表）字段全空**：三页 `titleblock-get` 都返回 `titleBlockData: {}`（`showTitleBlock: true` 但**无任何字段值**）。另：**API 读不到 sheet 图元**（`sheet-geometry: no sheet primitive found`），`export-image --scope page` 导出的 PNG 里也没有图框/标题栏 | ① `layout-lint` 的"器件是否越出图纸"这一维**永远不可判**（一直 WARN）；② `sch status` 的 **S1（图纸/分页）= 0/1，过不了**；③ 交图/写报告时没有图号、版本、日期 | `sch titleblock --doc <页>` 填字段（先 `titleblock-get` 看可编辑 key）；sheet 图框若确实没有，`sch frame apply` 或改用带图框的模板 |
| **2** | **`R8`（100Ω）的 `Supplier Part` 仍是平台占位** `0805W8F1000T5E.1`，不是 LCSC C 号 | 按 BOM 下单会**买不到这一颗**（`33 §1.5` 的"真歧义留空"，另两件 `D1`/`D2` 中 `D2` 已随电源级删除、`D1` 已补 `C456094`） | 选中 `R8` → 属性面板指定 LCSC 编号；或 `easyeda sch resolve-lcsc --apply` |
| **3** | **INT 页可读性 `layout-score` = 67.7 [fair]**（AFE 82.7 [good] / PWR 100） | 不影响电气，但这是**全板最差的一页**；交接给画板的人时更容易看错 | ① 4 条 netport 背向核心：`R12` 的 `LCD_BL_CTL`、`R40` 的 `LCD_WR`、`R41` 的 `LCD_RD`、`R42` 的 `LCD_RST_J5`；② `R40/R41/R42` 距 `EVK1` 边距 410（>150 开始扣分）⇒ 挪到 `EVK1` 下方 `(775,325)`；③ 24 条 marker 视觉重叠（多为 `LCD_Dx` netport 压在 `EVK1` 符号体上）。命令 `sch destagger --apply` / `sch layout-score --all` 会逐条给 fix |

### 3.2 待确认（3 条）

| # | 项 | 事实 | 要确认什么 |
|---|---|---|---|
| **4** | **`D1` 的"型号 ↔ 符号 ↔ 封装"三者对不上** | 符号 3 脚、脚名 `C1`/`C2`/`A`（**双路共阳极** TVS，`D1.2` 打 NC ⇒ 只保护一路）；封装 `SOT-23-3`；BOM 型号 **`PESD5V0X1BT,215`**（单路）；而 `33 §64` 记录的设计意图是 **`SRV05-4`**（SOT-23-**6**、4 路） | **到底要保护几路、装哪颗**。若确实是单路器件，符号脚名应改；若要 4 路，封装与 BOM 都得换 |
| **5** | **`TP2`（缓冲器输入 / LC 入探针）从图上消失，且没有任何删除记录** | 10-02 快照有 `TP1`~`TP6`；`TP6` 随 `VREF` 死支路删除**有记录**（`30 §5`/`33 §50`），**`TP2` 没有**。现只剩 `TP1`/`TP3`/`TP4`/`TP5` | **补回还是确认不需要**。它在 `JP1.2→R2.1→U1A.3` 这条高阻输入节点上，是自激排查的第一探点（`37 §3.4`） |
| **6** | **`EVK1` 符号的 81~84 脚** | 符号共 84 脚（`18 §340` 已记），其中 **81~84 的脚名就是数字**（无 MCU 名），已全部打 NC | 这 4 个是什么（固定孔？额外焊盘？）—— 确认不影响连接即可 |

### 3.3 已知取舍（不是缺陷，但要知道代价）

| 项 | 事实 | 代价 |
|---|---|---|
| **AFE 页禁止网络标签**（2026-10-03 用户定，`37 §8.1`） | AFE 页 **14 条内部网全是自动名** `$3N526`/`$3N527`/…/`$3N701` | ① netlist 导出与 PCB 侧的 AFE 网名**不可读**；② 任何"按网名核对"的复核在 AFE 区**失效**（只能按坐标/拓扑）；③ 建议至少给 4 个关键节点留名：端接点 / 缓冲输入 / 滤波输入 / 滤波输出 |
| **`+5V` 唯一来源 = 核心板 5V 引脚** | 底板无 DC 座、无入口防护 | 底板**不能独立供电**，调试必须插核心板 Type-C；反插/过流保护由核心板提供 |
| **`sch drc` 只回聚合值** | 三页都只报 "1 reported violation(s) — 0 fatal / 0 error / 1 warn"，**EDA 不回逐条明细** | "零回归"只能按 `sch check` 的条数（AFE 2 / INT 47 / PWR 1）判，**不能逐项比对 EDA 客户端的 DRC 面板** |
| **`sch check` 47 条里 19 条是 `wire-through-body`** | 根因是 `EVK1` 符号的 body 是并集框，把内侧引脚列也包住 —— **线是对的、符号的问题**（`32 §1.5` 已结案） | 会一直报，别当成真错 |

---

## §4 逐页可读性评分

| 页 | 综合 | folded | reversed | proximity | stub | frame |
|---|---|---|---|---|---|---|
| AFE | **82.7** [good] | 100 | 80 | 57 | 82 | 100 |
| INT | **67.7** [fair] | 100 | **20** | **44** | 100 | 100 |
| PWR | 100 [incomplete] | 100 | 100 | skipped | 100 | 100 |

（PWR 只有 4 件，"proximity"维 skipped ⇒ 满分不代表达标。）

---

## §5 诚实边界

- 本体检**只覆盖"图上可机械判定"的东西**。**数值正确性**（滤波 fc、增益、噪声、稳定性）不在这里 ——
  那些在 `26`/`27`/`36` 与 `tools/sim/` 里，靠仿真与解析复算，本文不重复。
- **`D1` 那条我没有定论**：符号/封装/BOM 三者确实互不匹配，但"哪个才是你要的"是设计意图问题，不是我能判的。
- `sch drc` 的"1 warn"**查不到是什么**（EDA 不回明细）——所以本文不说"DRC 干净"，只说"0 致命 0 错误 + 与改前同形"。
- 三页 `floating pin = 0` 是**机械判据**：它保证"每个脚要么接了、要么明确标了 NC"，
  但**不保证"接对了"**——接对与否靠 §2 的逐脚对照与 §1 的网表人工复核。

---

## §6 当日下午复查补记（活体只读，未改图）

全文重跑一轮后**新增 3 条**（详细凭据与处置见 `40 §I`）：

| # | 新增发现 | 为什么 `§1~§5` 里没有 |
|---|---|---|
| 1 | **三页都没有"图纸边框（sheet）"图元** —— 一个根因卡死三处：`layout-lint` 的越界维永久不可判、`sch status` S1 恒 0/1、`sch titleblock --data` **填不进去**（该页图签模板**没有任何可写明细项**，不是"字段空着"） | 本轮第一次跑 `sch gate --strict` 与 `sheet-geometry`，才发现它是**总根因**；§3.1-1 只记到"字段全空"这一层 |
| 2 | **`sch drc` 的 FAIL 是 `--strict` 造出来的**：默认模式下三页都是 `✓ Native DRC passed（1 warn advisory）`；且同一条 1 warn 在**三页（含只有 4 件的 PWR）都一样** ⇒ 更像**工程级/规则级**，不是逐页几何 | §3.3 只说了"查不到明细"，没说"strict 与默认结论相反" |
| 3 | **`sch check` 的 `reversed-net-flag = 4` 是 `C21/C22` 的 4 个电源旗**（`GND`×2 rot=90 / `+3V3`×2 rot=270），**不是** §3.1-3 提到的 `R12/R40/R41/R42` netport —— 那 4 条属 `layout-score` 的 `reversed-labels` 维，**是另一批**。⇒ 要修 **8 条** | §3.1-3 把两套计数当成了一套（`40 §C` 同样，已改） |

**复查中重跑且仍"干净"的**：`sch nets` 68 网无异常 · 三页 `floating/geom-net/multi-net/wire-over-pin/dangling/duplicate-marker` 全 0 ·
`bridge-check` 三页 0 桥 0 孤 · `clusters --strict` 三页 0 重叠 0 出图纸 · BOM 29 行 64 位号除 `R8` 外全部有 C 号。
**`§A` 的 4 处布局约束注释仍未上图**（逐条 grep 过 AFE 37 条 / INT 14 条文字，只有 33Ω 那一条）。
