funiang-x/G2026/hardware/40-优化方案待审-20261004.md

# G2026 · 优化方案（**待审，未执行**）· 2026-10-04

> **性质**：这是"我打算动什么、怎么动、碰什么、怎么验、怎么退"的**送审稿**。
> **一条都还没执行。** 每条的判据都写成可复跑的命令。
> **依据**：`38`（画到哪了）· `39`（图本身有没有缺陷）· `37 §8`（图上注释清单与缺口）· `33 §1.5`（BOM 不猜规则）。
> **2026-10-04 下午复查**：全文重跑活体只读一轮，**修正 `§C` 一处对象写错**、**新增 `§I`（图纸边框总根因 / DRC strict / 复查干净项）**。

---

## §0 先给结论：我建议做 3 件、等你 3 件、不做 2 件

| 分组 | 项 | 为什么 |
|---|---|---|
| **建议做** | A. 补 4 处布局约束注释 | 项目自己的 `37 §8` 文末已列为待办；只加文字，不动电气 |
| | B. INT 页 `destagger` 收拾 marker 重叠 | 项目自带工具 + 自带回滚；把全板最差的一页拉回来 |
| | C. 修 INT 页 **8 条**"旗/端口反挂" | `sch check` 4 条（`C21/C22` 电源旗）+ `layout-score` 4 条（`R12/R40/R41/R42` netport）—— **两批，原先只算了后一批**（见 §C / §I-1） |
| | **I-2. 修"图纸边框缺失"这个总根因** | 三页都无 sheet 图元 ⇒ `sch gate --strict` **三页全 FAIL**、`titleblock` 填不进、`layout-lint` 越界维永久不可判（见 §I-2） |
| **等你** | D. `R8` 的 LCSC 号 | `resolve-lcsc` 明确拒绝，需要人给 C 号 |
| | E. `TP2` 补不补 | 补 = 加件；不补 = 改文档。是设计意图 |
| | F. `D1` 到底哪颗 | 要保护几路 = 设计意图 |
| **不做** | G. AFE 页补网标 | **与你 10-03 定的"AFE 页禁网络标签"直接冲突** |
| | H. 修 19 条 `wire-through-body` | 是 `EVK1` 符号体的问题，`20 号`记过 `sch replace` 挂 3 次；不值得 |

---

## §A 补 4 处布局约束注释（建议做）

**问题**：`37 §8` 自己写着 —— **"仍有 4 处关键约束只在文档里、图上没有"**。
而 `29 §E2` 的教训是："33Ω 必贴 MCU 侧"这句话曾写进四处文档，**但图纸上一条都没有**，
结果画板的人做错。图纸是画板的人**唯一一定会看**的东西。

| # | 要补的注释 | 落点 | 出处 |
|---|---|---|---|
| 1 | `R1 49.9Ω 紧贴 SMA 中心针 ≤2~3mm` | AFE 页 `J1/R1` 旁 | `37 §0-4` |
| 2 | `J5.29(GND) 短、宽、多过孔(≥6)、周围铺铜` | INT 页 `J5` 旁 | `37 §0-9` |
| 3 | `C21/C22 紧贴 J5.30 ≤5mm，先 100nF 后 10µF` | INT 页 `J5/C21/C22` 旁 | `37 §0-10` |
| 4 | `C10 放在 AGND 岛最靠 PA1 的一角，AFE_ADC_IN 两侧加 guard` | AFE 页 `C10/JP2` 旁 | `37 §3.3` |

**怎么改**：`easyeda sch` **没有 create-text**（只有 `text.list` 读 + `prim-delete` 删）⇒
走项目已有的桥：`127.0.0.1:49620` **现在在线**（已探测），调官方
`eda.sch_PrimitiveText.create(x, y, content, rot, color, font, size)`。
参考实现 `_archive/_review4/eda/bridge_text.py`（`34 号`用过，风格 = **无框纯文字、fontSize 9**，与原图一致）。

⚠️ **桥建的文字落在"当前活动页"，没有 `--doc` 钉页** ⇒ 每条前必须先 `sch open` 到目标页，
且**逐页跑、逐页回读**（`sch text-list` 看条数）。

**碰什么**：只加 4 条文字图元。**不碰**器件、导线、网标。
**风险**：低。唯一风险是落点压到别的图元 → 用 `sch check` 的 `marker-overlap` 条数看有没有新增。
**验收**：`sch text-list` 条数 AFE 37→**+2**、INT 若干→**+2**；`sch check` / `sch drc` / `sch nets` **三条与改前逐项相同**。
**回退**：`sch prim-delete --ids <新文字 id>`（`text-list` 能拿到 id）。

---

## §B INT 页 `destagger`（**❌ 已判死：不做** —— 2026-10-04 实测）

> **结论（实测后推翻本条）**：**不要 `--apply`。** 两条理由，都有实测凭据：
> ① **位移不可接受**：13 条搬迁里 **8 条桩长 90~250 单位**（`toOffset` 实测：175/250/250/225/130/115/110/90），
>    最长 = 元件本体的 ~12 倍 —— 消掉"标签重叠"的代价是让旗**视觉上脱离引脚**，
>    对画板的人是**更差**的图。9 条 `no-free-slot` 根本搬不动，问题也修不干净。
> ② **它有破坏性，且我实测撞了**：`--apply` 要跑多轮、总时长 > Bash 默认 120s ⇒ 被 **SIGTERM 掐在半路**，
>    它的"整树删净→重建"两段式卡在中间 ⇒ **`EVK1` 19 个脚掉线**。
>    **完整事故与抢修记录见 `41-INT页destagger事故与抢修-20261004.md`。**
> ⇒ **判据**：跑这类"多轮 + 自带复验"的命令，**必须 `run_in_background` 或显式加长 timeout**。

**问题（保留原始分析）**：INT 页 `layout-score` = **67.7 [fair]**，是全板最差（AFE 82.7 / PWR 100）。
扣分主项：`marker-overlap` **24 条**（多为 `LCD_Dx` netport 压在 `EVK1` 符号体上）。

**试算已经跑过（dry-run，只算不动）**：

```
marker-overlap 24 条 → 计划搬迁 13 个 marker，跳过 9 个
  GND        netflag  left/30  → down/30
  LCD_D5     netport  right/30 → up/175
  +3V3       netflag  right/30 → down/90
  +3V3       netflag  right/30 → up/115
  LCD_D13    netport  right/30 → down/250
  AFE_ADC_IN netport  right/30 → up/250
  GND        netflag  left/40  → down/65
  GND        netflag  left/20  → down/20
  AGND       netflag  left/30  → down/90
  GND        netflag  left/40  → down/110
  LCD_D3     netport  left/30  → up/225
  +5V        netflag  right/30 → down/55
  LCD_CS     netport  left/30  → right/130
  skip LCD_D11 / LCD_D0 / LCD_D15 / LCD_RST / TP_SDA / LCD_D9 / TP_INT / LCD_D7 / LCD_WR
       —— 全部 no-free-slot（挤不下，工具"宁可不动"）
```

**怎么改**：`easyeda sch destagger --doc 63accad121e053cf --apply`。

**为什么我认为它安全**（工具自己的四条保证，不是我的判断）：
① 只搬**两点直线短桩**上的 marker，挂折线/主干的一律跳过；
② 走 ADR-0004 单一安全 move 内核 —— **宿主器件一动不动**，把桩线/旗整树删净后按新方向重建，
   其余 pin 按快照重连（旧版"逐根删桩把相邻导线合并串网"的坑在整树语义下不存在）；
③ 桩长是**量出来的**并吸附 5 单位网格；
④ **每轮对账 + 真实 `sch check` 复验，电气项任何一项变差就整批回滚**。

**碰什么**：13 个旗/端口的坐标 + 它们的桩线（**primitiveId 会变**）。
**风险**：中。**13 个里有 4 个是电源旗（`GND`×3 / `+3V3`×2 / `AGND` / `+5V`）**，
移动幅度最大到 250 单位 —— 图面观感会变，**可能"重叠没了但旗离引脚远了"**。
⇒ **建议：先看试算，觉得位移可接受再 `--apply`**。
**验收**（改完必跑，逐项与改前比）：
`sch check`（marker-overlap 应 ↓；**floating / dangling / multi-net / wire-over-pin 必须仍是 0**）
→ `sch nets`（仍 68 网、无同轨异名、无单引脚网）
→ `bridge-check`（仍 0 桥 0 孤儿）
→ `layout-score`（应 ↑）
→ `sch save` + `doc reload` + 回读网表。
**回退**：工具自带（恶化即回滚）；另有整包备份 `_archive/_review5/G2026_before_J5fix_20261004.epro2`。

---

## §C 修 INT 页 8 条"旗/端口反挂"（建议做）

> ⚠️ **2026-10-04 下午复查修正**：本节原先把两套计数当成了一套 —— 实际是**两批不同的东西，各 4 条，共 8 条**。
> 见文末 **§I-1** 的现场凭据。

**C-1 `sch check` 的 `reversed-net-flag = 4`** —— 是 **`C21`/`C22` 去耦网络上的 4 个电源旗**：

| # | 对象 | id | 坐标 | 现状 | 目标 |
|---|---|---|---|---|---|
| 1 | `GND` netflag | `53c7e1881261c810` | (1080,720) | rot=90 | rot=0 |
| 2 | `GND` netflag | `623aeb985b905932` | (1200,720) | rot=90 | rot=0 |
| 3 | `+3V3` netflag | `a5965fac69afd8a4` | (1080,780) | rot=270 | rot=0 |
| 4 | `+3V3` netflag | `621bb211d752a4c2` | (1200,780) | rot=270 | rot=0 |

改法按 `sch check` 自带提示：`sch disconnect --pin C21:1` → `sch connect --direction down …`（每条同理）。

**C-2 `layout-score` 的 `reversed-labels` 维只拿 20 分** —— 是 **4 条 netport**：

| # | 位置 | 现状 | 目标 |
|---|---|---|---|
| 1 | `R12.1` 的 `LCD_BL_CTL` netport | 桩朝左，核心 `EVK1` 在右 ⇒ 背向 | `--direction right --offset 24` |
| 2 | `R40.1` 的 `LCD_WR` | 同上 | 同上 |
| 3 | `R41.1` 的 `LCD_RD` | 同上 | 同上 |
| 4 | `R42.2` 的 `LCD_RST_J5` | 桩朝右，核心在左 ⇒ 背向 | `--direction left --offset 24` |

**怎么改**（每条两步）：`sch disconnect --pin <位号>:<脚>` → `sch connect --x <原坐标> --y <原坐标>
--kind netport --net <同名> --direction <目标> --offset 24`。

> ❌ **2026-10-04 实测判死：C-2 做不到。** 上面这 4 条 fix 是 `layout-score` 自己给的，
> 但**它给的 `--direction` 与它自己的几何护栏冲突** —— 实测 `R12:1`：
> `connect --direction right --offset 24` 被判 `wire-through-body`：
> `wire segment 0 (220,590)→(245,590) enters component body`，R12 本体 bbox `x[229.5,250.5]`。
> ⇒ **`R12.1` 的右边就是电阻本体**，`R40:1` / `R41:1` / `R42:2` 同理。
> 这 4 条 netport 挂在**串阻阵列的外侧脚**上，**必须朝外**（远离本体），
> 而"朝核心"就等于"穿本体" —— 启发式在这张两行式布局上**必然误报**。
> ⇒ **保留原样**（已按原方向/原桩长接回，`rot` 与坐标与改前完全一致，`check` 无回归）。

⚠️ **必须警惕的坑**（`35 §1` 记过）：**netport 改名/重建不会自动重绑线岛网名** ——
所以每条改完**立刻回读该脚的 `net`**，确认名字没变、没变成 `$Nxxxx`。
**碰什么**：C-1 是 4 个 netflag + 4 条桩线；C-2 是 4 个 netport + 4 条桩线（id 都会变）。
**风险**：中低（局部、单点，可逐条回退）。C-1 的旗在 `C21`/`C22` 上、C-2 的端口在 `R12/R40/R41/R42` 上，
**两批互不相邻**，可分开做、分开回退。
**验收**：`sch check` 的 `reversed-net-flag` 4→**0**（C-1）；`layout-score` 的 `reversed-labels` 20→**100**（C-2）；
`sch nets` 仍 68 网无异常；`bridge-check` 0/0。
**回退**：单条 `disconnect` + 按原方向重连；或整包备份。

---

## §D `R8` 的 LCSC 号（**等你给**）

**事实**：`resolve-lcsc` 在 AFE 页跑出来 **1 件未解析 = `R8`**，理由不是"没号"而是：

> `incomplete identity evidence for 16-hex instance footprint; … instance/library UUID domains require
> native META.source plus exact LCSC/model and official asset-library evidence`

⇒ **工具拒绝猜**（`32 §1.5` 的三级不猜规则），必须人来定。
BOM 里 `R8` 的 `Supplier Part` 现在是平台占位 `0805W8F1000T5E.1` —— **按它下单买不到**。

**我需要你给的**：`0805W8F1000T5E`（UNI-ROYAL 0805 100Ω 1%）对应的 **LCSC C 号**。
给了之后我执行 `sch modify --id <R8 实例 id> --patch '{"supplierId":"C<号>"}'` 并回读确认。
**或者**你在 EDA 属性面板里点一下也行（`32 §1.5` 记的就是这条路）。
**风险**：低。**验收**：`bom export` 的该行 `Supplier Part` 变成 `Cxxxxx`。
**不做会怎样**：BOM 里 64 个位号有 1 个不可下单。

---

## §E `TP2` 补不补（**等你拍板**）

**事实**：10-02 快照有 `TP1`~`TP6`；现在只剩 `TP1`/`TP3`/`TP4`/`TP5`。
`TP6` 随 `VREF` 死支路删除**有记录**（`30 §5` / `33 §50`）；**`TP2` 没有任何记录**。
它在 `JP1.2 → R2.1 → U1A.3` 这条**高阻输入节点**上 —— `37 §3.4` 说自激排查的第一探点就在这里。

| 选 | 我做什么 | 代价 |
|---|---|---|
| **补回** | `sch place` 一个测试点（`TP-黄色测试点`，与 `TP1/TP3/TP4/TP5` 同款）+ `sch connect` 到 `$3N698` 那条网 + 回读 | 一个件 + 一条桩线；BOM 位号 64→65 |
| **不补** | 把 `18 §5.2` / `13 §264` / `06 §1.1` / `30 §90` / `37 §3.1` 里的 `TP2` 引用标掉（**已标一半**） | 少一个高阻节点探针 |

---

## §F `D1` 到底哪颗（**等你拍板**）

**事实**：三者互不匹配 ——

| 层 | 现状 |
|---|---|
| 符号 | 3 脚，脚名 `C1`/`C2`/`A` ⇒ **双路共阳极** TVS；`D1.2` 打 NC ⇒ **只保护一路** |
| 封装 | `SOT-23-3_L2.9-W1.3-P1.90-LS2.4-BR`（**3 脚**） |
| BOM | `PESD5V0X1BT,215`（**单路**） |
| 记录的设计意图 | `33 §64`：`D1(SRV05-4)`（**SOT-23-6 / 4 路**） |

**要你回答**：BNC 输入端**要保护几路**、用哪颗？
- 单路 ⇒ 符号脚名应改成实际器件的脚名（`D1.2` 空脚是否合规也要核）。
- 多路 ⇒ 封装与 BOM 都得换，`D1.2` 该接第二路（或接地）。
**风险**：现在是"能过但说不清"，改哪边都可能有连带（`32 §1.5` 记的"镜像封装"歧义就在这）。

---

## §G 我不建议做的两件（说明理由）

### G1 AFE 页补网标 —— **与你 10-03 的决定直接冲突，不做**

AFE 页现有 **14 条内部网是平台自动名** `$3N526`…`$3N701`。原因就是你在 `37 §8.1` 定的：
**"跨页网 / 电源轨 = 不得不用；在页普通信号网一律改实线"**，且给了硬理由
（`AGND` 画成母线 = 菊花链 ⇒ 原理图会**指示画板的人做出更差的地**）。
⇒ 加网标是**倒退**。我不做。

**但代价要说清**（写进 `39 §3.3` 了）：
① netlist 导出与 PCB 侧的 AFE 网名不可读；② AFE 区**按网名复核失效**（只能按坐标/拓扑）。
**合规的替代**（若你想要）：用 §A 同一套桥文字，给 4 个关键节点**加纯文字标注**
（端接点 / 缓冲输入 / 滤波输入 / 滤波输出）—— **帮人不帮网表**。要不要做请你定。

> 另：`39 号`里我引用了 `$3Nxxx` 这些**自动名**，而自动名由平台分配、**不保证跨次重开不变**。
> 建议改成按坐标/拓扑描述（我可以顺手改掉那几处）。

### G2 19 条 `wire-through-body` —— 不值得动

根因是 `EVK1` 符号的 body 是**并集框**，把内侧引脚列也包住 —— **线是对的、符号的问题**（`32 §1.5` 已结案）。
修它要换符号，而 `20 号`记过 **`sch replace` 挂了 3 次**（`EVK1` 符号换型未成）。
⇒ 收益（消掉 19 条 WARN）远小于风险（动核心板符号可能断一片引脚）。

---

## §H 执行顺序与总验收

**若你批 A/B/C**：

1. **先备份**：`easyeda project export --window <id> --project-uuid a45fc831… --out _archive/_review5/G2026_before_opt_20261004.epro2`
2. **A**（注释）→ 回读 `text-list` + `check`
3. **C**（**8 条**旗/端口反挂：先 C-1 的 4 个电源旗，再 C-2 的 4 个 netport）→ 每条回读该脚的网名 + `check`
4. **B**（destagger，先看试算位移是否可接受）→ 每轮看工具自带对账
5. **收尾**：`sch save` → `doc reload`（关页重开）→ 回读三页网表
   → `sch nets`（68 网无异常）→ `bridge-check`（0/0）→ `sch check`（**电气项仍全 0**）
   → `layout-score` 三页对比
6. **文档**：把 `37 §8` 的"仍有 4 处…"改成"已补"，`PROJECT.md` 的待办相应划掉。

**总回退点**：整包 epro2 备份 + `_archive/_review5/G2026_before_J5fix_20261004.epro2`（sha256 `b129352d…e07d5f`）。

**我不会碰的东西**：器件取值、网表连接、`EVK1` 符号、`.ioc`、固件、BOM 里已对的 C 号。

---

## §I 复查补记（2026-10-04 下午 · 全活体只读）

> **怎么来的**：本轮把 `sch status` / `check` / `drc` / `nets` / `bridge-check` / `clusters --strict` /
> `layout-score` / `layout-lint` / **`gate --strict`** / `titleblock-get` / `sheet-geometry` /
> `text-list` / `list --include-pins` / `bom export` 全部**重跑了一遍活体**（工程 `ai`，
> 连接器 1.8.0 / EDA 4.1.60 / 三页 uuid 不变）。**没动过任何图元。**
> 原始落盘：`_archive/_review5/_afe_now.json` · `_int_now.json` · `_txt_afe.json` · `_txt_int.json`。

### I-1 `40 §C` 的误判已修正（两批各 4 条，不是一批）

| 计数来源 | 数量 | 真实对象 |
|---|---|---|
| `sch check` → `reversed-net-flag` | **4** | **`C21`/`C22` 的 `GND`×2(rot=90) + `+3V3`×2(rot=270)**，坐标 (1080,720)/(1200,720)/(1080,780)/(1200,780) |
| `layout-score` → `reversed-labels`（20/100 分） | **4** | `R12.1`/`R40.1`/`R41.1` 的 netport + `R42.2` 的 netport |

两批**互不相邻**（前者在 J5 去耦区，后者在串阻阵列区）。原先 `§C` 把 `sch check` 的 4 条
说成是 `R12/R40/R41/R42`，**对象写错了** —— 已按上表改写 `§C`。

### I-2 【新】三页**没有图纸边框（sheet）图元** —— 一个根因卡死三处

现场凭据：

| 证据 | 结果 |
|---|---|
| `sch sheet-geometry` AFE / INT / PWR | 三页**全部** `no sheet bbox available` + `WARN no sheet primitive found` |
| `sch status` | `图纸 ✗`；**S1 图纸/分页 0/1** |
| `sch export-image --scope page`（AFE） | 导出的 PNG 里**没有图框、没有标题栏**，只有器件浮在网格上 |
| `sch gate --strict` AFE / INT / PWR | **三页全 FAIL**，阻塞项第一条恒为 `layout-lint: sheet-check unavailable` |
| `sch layout-lint` INT | `✓ placement gate passed; 0 tight / 0 off-grid / 0 out-of-sheet` —— **但** `sheet-check=unavailable zone-check=not-configured` |
| `sch titleblock-get` AFE/INT/PWR | `showTitleBlock: true` 但 `titleBlockData: {}` |
| `sch check` 的 `titleblock-key-absent` | **"本页可用 key:(无可写明细项)"** |

**这意味着三件事，不是一个**：

1. `layout-lint` 的"器件是否越出图纸"这一维**永远不可判**（所以 gate 里它恒 FAIL，与器件摆放好坏无关）；
2. `sch status` 的 **S1 恒 0/1**；
3. **`sch titleblock --data` 现在填不进去** —— 不是"字段空着等你填"，而是**该页图签模板压根没有可写明细项**。
   ⇒ 想有图号/版本/日期，必须先在图签模板侧把明细项加上（模板级操作），再谈填值。

**性质**：这是**交付规范**问题，不是电气问题。**没动它**（模板/图框属 EDA 客户端设置，且 `sch` 侧没有
set-paper-size / 加 sheet 图元的 typed action —— `sch titleblock --help` 明确说 **title block CANNOT set paper size**）。

### I-3 【新】`sch drc` 的 "FAIL" 是 `--strict` 造出来的，且是**工程级**的

| 模式 | 三页结果 |
|---|---|
| `sch drc`（默认） | **三页都** `✓ Native DRC passed — 1 reported item(s) remain advisory in this mode`（0 fatal / 0 error / 1 warn） |
| `sch gate --strict` | **三页都** `drc: native verdict FAIL`，理由 = `1 warn-level DRC violation (--strict)` |

要点：**同一条 1 warn 在三页（含只有 4 件的 PWR 页）都出现** ⇒ 更像**工程级 / 规则级**的一条
（不是逐页几何）。EDA **不回逐条明细**，只能去客户端 DRC 面板看。
⇒ 结论：**不要把它当成"图有问题"**；也不要因为 gate FAIL 就以为电气不干净。

### I-4 其余复核为"干净"的项（现场重跑，与 `39` 一致）

- `sch nets`：**68 张网 / 无同轨异名 / 无单引脚网**
- `sch check` 电气判据：三页 `floating pin 0` · `geom-net mismatch 0` · `multi-net wire 0` ·
  `wire-over-pin 0` · `zero-length 0` · `dangling wire 0` · `duplicate-net-marker 0` · `net-marker mismatch 0`
- `bridge-check`：AFE **0 桥 0 孤**（43 棵树）· INT **0/0**（110 棵树）· PWR **0/0**（8 棵树）
- `clusters --strict`：AFE 34 组 / INT 26 组 / PWR 4 组 —— **全 0 重叠 / 0 出图纸 / 0 过近**
- `bom export`：**29 行 / 64 位号**（`U1` = 双运放两半，计 1 个位号）—— 除 `R8` 外**全部有 C 号**
- `layout-score` 另两页：AFE 82.7 [good] / PWR 100（PWR 只有 4 件，`proximity` 维 skipped，满分≠达标）

### I-5 仍未上图的 4 处布局约束注释（`§A` 待办**依旧成立**）

本轮 `text-list` 逐条 grep 过 AFE（37 条）与 INT（14 条）文字：**只有** INT 上那条
"每根 FSMC 线串 33Ω 抑制跨板振铃；PCB 上须贴 MCU 引脚 3~5mm 内"。
`§A` 的 4 条（`R1` 紧贴 SMA / `J5.29` 多过孔 / `C21/C22` 紧贴 `J5.30` / `C10` 加 guard）**图上一条都没有**。
