funiang-x/G2026/hardware/44-原理图逐件详解-20261004.md

# G2026 原理图 · 逐件三维详解（对信号 · 对电源 · 对其他元器件）· 2026-10-04

> **定位**：这是 `30-原理图通俗讲解` 的加深层。用户定的讲解标准是：
> **每一个元器件都必须答全三个维度——① 它对信号的作用；② 它对电源的作用；③ 它对其他元器件的作用。**
> "它是什么 / 干什么 / 没有它会怎样"（`30`）是入门层；本文在每件上再补全"它跟电源什么关系、
> 它跟别的件什么关系"，并保留"缺它后果"一列（教学价值最高，不丢）。
>
> **事实来源（三态口径）**：全部引脚级事实取自 **2026-10-04 活体网表**
> （`_archive/_review5/audit_report.txt`，64 位号 / 68 网 / 悬空脚 0）；数值结论标来源：
> [复算] = 独立脚本可复算 · [仿真] = `tools/sim/` · [活体] = EDA 回读 · [代码] = 固件源码。
> **凡涉及"上板会怎样"一律未验证**（工作台铁律 1）。
>
> **配套阅读**：`30`（通俗版，打比方）· `26`（为什么是这个值）· `28`（三条链走向）·
> `39`（图本身有没有错）· `37`（布局时必须守住什么）。

---

> ### ⚠️ 口径更新（2026-10-04 晚，渲染 45 号配图时发现）
> 本文的位号与取值按**当日活体体检（39 号）+ 评审版**书写。当晚活体渲染发现图纸在体检后被改过且无文档记录：
> **① 4 个位号改名：`C13→C5`（VBIAS 储能）、`C23→C7`（R4 腿隔直）、`C21→C3`（屏去耦）、`R8→R11`（ADC 隔离）——
> 本文读到这四个旧位号时按括号对应读；② 9 个器件的实体 MPN ≠ 图面值**，模式恰好是「36 §C 修复前 / H1·H2 改前旧值回归」：
> `C2` 实体 5.6nF（图面 6.2nF）· `C6` 实体 10nF（图面 9.1nF）· `C5/C7/C3` 实体 100nF（评审 10µF）·
> `R6` 实体 69.8k（图面 24.9k）· `R7` 实体 10k（图面 3.57k）· `R11` 实体 69.8k（图面 100Ω）· `R21` 实体 0Ω（图面 4.7Ω）。
> 其余 55 件逐件一致。**证据与带警示徽章的图文版见 `45-原理图图文讲解-20261004.html`；待用户拍板回退或采纳。**
> 本文表中对这 9 件的取值描述 = 评审版（唯一有仿真背书的口径），实体的现值以 45 号页首警示表为准。

## §0 怎么读这份文档

### 0.1 三个维度的定义

| 维度 | 回答的问题 |
|---|---|
| **对信号** | 这件在信号通路上做了什么（放大 / 衰减 / 滤波 / 隔直 / 阻尼 / 保护 / 采样）？不承载信号的件，写它对信号质量的**间接**贡献。 |
| **对电源** | 这件跟电源轨（+5V / +5V_A / +3V3 / VBIAS / GND / AGND）什么关系：取电？耗电？储能？隔离？还是**不接任何轨**（写"—"并说明它的电流走哪条地回去）。 |
| **对其他元器件** | 它约束谁、配合谁、保护谁；它的取值/位置改变时，谁的命跟着变。 |
| **缺它后果** | （附加列，沿 `30` 的口径）没有它会塌掉什么。 |

### 0.2 现状口径（先钉死，别按旧文档讲）

- **三页 64 个唯一位号**：AFE 页 **34**（网表条目 35，因 `U1` 双运放计两条）· INT 页 **26** · PWR 页 **4**；全局 **68 张网**，其中**跨页网 9 条**（+3V3、+5V、+5V_A、AGND、GND、VBIAS、AFE_ADC_IN、TP_SCL、TP_SDA）[活体]。
- **已消失的件（讲解时不要再提）**：`J3`/`F1`/`D2`（PWR 页，2026-10-04 删——**本板由核心板 Type-C 供电**，底板不带 DC 座，`38 §3.2-①`）；`TP2`（AFE 页，无记录消失，`39 §3.2-5`）；`JP3`/`C12`/`TP6`（VREF 死支路，`30 §5`）；`C19`/`C20`/`LED1`/`R11`（`38 §3.2-④`）。
- **已改过的值（讲最终值）**：`C2`=6.2nF、`C6`=9.1nF（36 择优）· `R6/R7`=24.9k/3.57k（原 69.8k/10k）· `R21`=4.7Ω（原 0Ω）· `R42` 已补（33Ω，串 LCD_RST）。
- **供电唯一来源 = 核心板 5V 引脚**（EVK1.40/80，Type-C 进电）⇒ 底板不能独立供电 [活体]。

### 0.3 三条链一句话（每件在链上的位置见 §4 索引表）

```
【电】核心板 Type-C → +5V(EVK1.40/80) ─┬─ R21 4.7Ω → +5V_A → 运放（模拟，~2mA）
                                        └─ 核心板 LDO → +3V3 → 屏/触摸/背光 + R9/R10 分压 → VBIAS 1.65V
【信号】SMA → R1 端接 → C1 隔直 → U1A 缓冲 → R3 → 8阶LC → C23 隔直终接
        → C9 隔直 → U1B 放大 7.975× → R8+C10 → JP2 → PA1 → DSP → 屏
【屏】FSMC 20+1 条线 → 33Ω×21 → J5 → 屏转接板；触摸 I²C → R15/R16 上拉
```

---

## §1 AFE 页（模拟前端，34 位号）—— 信号从 SMA 走到 PA1

### 1.1 分区① 输入保护与端接（信号进门第一站）

这一区的节点拓扑 [活体]：`J1.1 中心针`、`R1.1`、`D1.1(C1)`、`C1.1`、`TP1.1`、`JP1.1` 共 **6 个引脚落在同一个内部网**上——这是一个"被 49.9Ω 拉到低阻"的测量点，后面所有件的取值都以这个阻抗为前提。

| 位号 · 值 | 对信号 | 对电源 | 对其他元器件 | 缺它后果 |
|---|---|---|---|---|
| `J1` SMA-KE 母座（5 脚） | 被测信号的**唯一入口**；题面是 BNC 电缆 + 50Ω 系统，用 SMA 座 + BNC-SMA 转接（用户 10-03 拍板）。中心针（脚 1）把源信号送到端接节点 | **不接任何电源轨**。外壳 4 脚（J1.2/3/4/5）全部接 **AGND**：给同轴信号电流提供屏蔽层回流路径，兼把外壳静电导入地 | 决定端接节点的物理位置——PCB 上 `R1` 必须贴它的中心针 **≤2~3mm**（端接必须在电缆口，`26 §2.1`） | 没地方插信号线 |
| `R1` 49.9Ω 1% | **50Ω 端接**：与电缆特征阻抗/源内阻匹配，吸收反射；端接使节点幅度 = 源电动势 ×0.5（全链 ×0.5 的第一处）。49.9 是 E96 标准值，1% 容差下回波损耗 ≈−46dB | 不接电源轨；但它是**信号交流电流入 AGND 的回流路径**（AGND 成员之一） | 把输入节点定义为低阻点——`D1` 的钳位、`C1` 的隔直、`TP1` 的测量全以"这个节点是 49.9Ω 低阻"为前提；与 `R3`/`R4` 构成全链双 50Ω 口径。**别为"拿回 6dB"删它**：删了幅度翻倍、源阻抗变未知（`26 §2.1`） | 幅度翻倍且随信号源漂移、反射振铃，读数不可信 |
| `D1` ESD 管（SOT-23-3） | 正常工作时几乎透明（pF 级结电容，500kHz 处阻抗极高）；静电/过压瞬间把输入节点钳住。**现接法 = 单通道对地钳位**：`D1.1(C1)`→信号节点、`D1.3(A)`→**AGND**、`D1.2(C2)`→NC [活体] | 钳位轨就是 **AGND**（不是旧口径 SRV05-4 的"+5V_A + AGND 双轨"）；静态漏电可忽略 | **保住 `U1A` 的输入级**。两条必须带上：① 负向钳在 ≈−0.7V（二极管正向），正向钳位电平是器件击穿档、**高于 U1A 的绝对最大输入**——挡得住 ESD、挡不住持续过压（`26 §7-N10`）；② **型号↔符号↔封装三者对不上**（BOM `PESD5V0X1BT` 单路 / 符号画成双路共阳 / 封装 SOT-23-3）——`39 §3.2-4` 待确认项，讲解时按"单路对地钳位"讲 | 手摸 SMA 头的静电可能打穿 U1A 输入级 |
| `C1` 100nF C0G 1206 | **隔直**：串在信号路上，挡住信号源可能带的直流偏置，只放交流过去；与 `R2`(10k) 组成 **159Hz 高通** [复算]（分析带下限 10kHz 的 1/63，不伤带内） | 不接电源轨；它对"电源"的作用是反向的——**把源端直流与单电源域的中点电位隔开**，两边的直流工作点互不打扰 | 与 `R2` 共同定 159Hz 拐点；给 `U1A` 输入端"让位"给 `R2` 的偏置。**为什么 C0G**：X7R 容值随电压/温度漂，会在拐点附近引入不可标定的相移；**为什么 1206**：C0G 做到 100nF 的封装代价。与 `C9` 是"隔两次直"——位置不同职责不同（见 C9 行） | 源端直流直接进运放，工作点被顶死 |
| `TP1` 测试点 | **不参与信号**（高阻焊盘）。它"量"的是端接节点的真实幅度——扫频标定第一探点（`23 §7` 扫频判据用它与 `27 §8.7` 曲线对表） | 不接电源 | 给万用表/示波器一个可重复落点；"端接生效了吗"只能靠它验证 | 电路照常工作，但标定与排障没有落脚点 |
| `JP1` 0Ω | 导通时等于一根线，把端接节点接到缓冲器输入（`AFE_BUF_IN` 网名——注意：旧文档写该网含 `TP2.1`，**TP2 已不在图上** [活体]） | 不接电源；0Ω 无压降，不影响任何直流工作点 | 前半段（端接）与后半段（缓冲/滤波）之间的**可拆断点**：断开后能单独给后半段注信号、或单测前半段 | 功能不变，排障只能整链猜 |

### 1.2 分区② 一级缓冲（`U1A` 半片）

| 位号 · 值 | 对信号 | 对电源 | 对其他元器件 | 缺它后果 |
|---|---|---|---|---|
| `U1A` OPA2197ID 半 A（SOIC-8，接成跟随器：`U1.1` OUT ↔ `U1.2` −in 直连） | **×1 缓冲**：高阻读端接节点（输入偏置电流 ±5pA 级 → 失调仅 50µV @10k），低阻驱动后面的 LC 滤波器。**刻意不加增益**：让 u_J（±50mVpk 大干扰）处于运放最线性区间，不在它这里产生落进分析带的 IM3——这是"缓冲→滤波→放大"顺序钉死的一半理由（`26 §2.2`） | `U1.8`(V+) 吃 **+5V_A**，`U1.4`(V−) 接 **AGND**——单电源工作；双运放静态合计约 2mA（C23 修复后的口径，`26 §2.6`） | 为 LC 滤波器提供低阻源，`R3` 的"源端阻抗"才成立；输入端的直流工作点由 `R2` 供给 | LC 的容性输入（`C2` 在 MHz 处只有几 Ω）直接挂在端接节点上 → 端接失效、波形畸变、随源漂移 |
| `R2` 10kΩ 1% | 给 `U1A` 同相端提供**直流回路到 VBIAS**——信号才能"站在 1.65V 上"上下摆；与 `C1` 定 159Hz 高通 | 从 VBIAS 轨抽约 165µA 级偏置电流的一部分（VBIAS 的三个负载之一） | 与 `C13`（VBIAS 储能）配合——瞬态电流由 C13 顶住；10k 是"不加载源 / 不被 Ib 顶偏"的折中 | 输入节点无直流回路，运放漂到轨 |

### 1.3 分区③ 基准与偏置（VBIAS 是怎么来的）

单电源（+5V_A）运放处理不了负半周 ⇒ 整个模拟域必须抬到中点。`R9/R10` 把 +3V3 劈成一半：**VBIAS = 1.650V**，正好是 ADC 量程中点。

| 位号 · 值 | 对信号 | 对电源 | 对其他元器件 | 缺它后果 |
|---|---|---|---|---|
| `R9` 10kΩ 1% | 不承载信号——但它生成整个模拟域的"地板高度"，信号质量间接全靠它稳 | 从 **+3V3** 拉电流：与 R10 串成分压，支路电流 3.3V/20k = **165µA** [复算] | `R10` 的上臂搭档；**等值 + 1% 匹配度直接决定 VBIAS 绝对精度**（±1% → ±16.5mV）。它的另一端接 +3V3 而不是核心板 REF 针——因为 REF 针官方悬空（`25 §1.1` 修的 P0） | 无偏置基准，整条 AFE 不作为 |
| `R10` 10kΩ 1% | 同上（分压下臂） | 把 165µA 放掉到 **AGND**（AGND 成员之一） | `R9` 的对偶臂；二者等值才能"正好劈一半" | VBIAS = 3.3V，信号只能上半摆、下半削顶 |
| `C13` 10µF X7R 0805 | 对信号而言它是"把 1.65V 钉成交流地"——VBIAS 稳如电池，读数才不跟着晃 | **VBIAS 轨的储能/退耦**：`R2`/`R5`/`R7` 三处偏置抽瞬态电流时由它就近供给。分压等效源阻抗 = R9∥R10 = **5k**，与它构成 **≈3.2Hz 低通** [复算]，把 3V3 轨上的噪声压掉 | 三处偏置电阻的"共享水缸"；地端 2026-10-02 起接 **AGND**（原 GND 与"模拟地单点"自相矛盾，`26 §2.3`）。⚠️ **勘误（对 `26 §2.3`）**：该处写"等效源阻抗 5k∥5k=2.5k ⇒ 6.4Hz"，按 R9∥R10 = 10k∥10k = **5k** 复算应为 **3.2Hz**；结论不变（远低于分析带下限 10kHz） | VBIAS 被偏置电流与分压噪声拽晃，读数跟着晃 |
| `TP5` 测试点 | 不参与信号——**上电第一测点**：应量得 1.650V（`26 §8` 上电顺序第一步之后） | 直接探 VBIAS 轨 | "偏置对不对"的唯一直观验证点 | 偏置故障只能推算不能确认 |

### 1.4 分区④ 8 阶巴特沃斯抗混叠低通（全页核心：4L + 4C 双端接梯形）

**它挡的是什么**：fs=2.0MHz 下，≥1.5MHz 的强干扰（u_J 200mVpp）会折叠进 10k~500kHz 分析带变成假峰。要求 |H(1.5M)| ≤ −42.5dB。
**现状** [仿真]（36 择优后）：折叠带 [1.5,2.5]MHz 最差 **−57.59dB（余量 15.1dB）** · 带内起伏 **0.0102dB** · 17 点标定残差标称 0.293mV、容差 MC 最坏 **2.97mV < 5mV 判据**（n=400）。
**为什么 8 阶**：6 阶在同 fc 下折叠残留 1.45mVpk，门限 1.5mVpk——贴脸；多 2 颗件买 15dB 阻带余量。
**为什么无源 LC**：8 阶有源（SK）要 GBW ≥205MHz 的运放；无源梯形零稳定性问题、元件灵敏度低。

| 位号 · 值 | 对信号 | 对电源 | 对其他元器件 | 缺它后果 |
|---|---|---|---|---|
| `R3` 49.9Ω 1% | 双端接梯形的**源端阻抗**——滤波器形状的一半由它定义；同时把 `U1A` 输出与 `C2` 的容性输入隔开（防容性负载振铃） | 不接电源轨；LC 链交流电流入 AGND 的路径从它开始 | 与 `R4` 配对成"双 50Ω"。**改它 = 改滤波器**（仿真 O1 试过 59Ω：阻带 +0.94dB 但通带起伏 0.39→0.60dB，方向反了，否决——`28 §4.1`） | 滤波器形状全变；拿掉它还会让运放直接驱动大容性负载而振铃 |
| `L1` 4.7µH / `L3` 22µH / `L5` 22µH / `L7` 12µH（CD54 绕线） | 梯形的**串臂**：对高频呈高阻（\|Z\|=2πfL），逐节把 ≥1.5MHz 的成分挡下来；四节串臂 + 四节并臂 = 8 阶 | **不接电源轨，但直流上电感 = 短路**——正是这条直流短路特性逼出了 `C23`（见下） | 与 `C2/C4/C6/C8` 逐节配对（取值是按在售档位对 g 值的**拟合**，不是抄标准表——后来人按标准表核对会以为画错，`26 §2.4`）；PCB 上四个电感**正交摆放防互感**（`37 §0-6`）；SRF 与大信号 THD 是上板实测项（`23 §3.1-8`） | 6 阶折叠残留 1.45mVpk 贴脸，容差一飘就破门限 |
| `C2` 6.2nF / `C4` 10nF / `C6` 9.1nF / `C8` 1.8nF（全 C0G 0805） | 梯形的**并臂**：把漏过电感的高频成分泄入 AGND。`C2/C6` 的值是按"17 点标定残差最坏 2.97mV"**择优**出来的（`C6` 理想 8.01nF，在售档取 9.1nF；36 §B） | 它们是高频电流的"泄洪口"——泄放电流全部走 AGND ⇒ **四个电容的地要收拢、不要散**（`37 §0`） | 与对应电感定每节转折频率；C0G 保证容值不随电压/温度漂；±5% 容差纳入蒙特卡洛（0/500 跌破）。**换型号时供应商编号要跟着验**（36 §C 抓到过三件的 C# 指向旧值） | 对应节失去泄放，阻带塌、干扰折叠成假峰 |
| `C23` 10µF 0805 | 对 500kHz 只有 **31.8mΩ** [复算]——对信号带完全透明；对**直流是断路** | **掐断滤波器里的 16.5mA 直流白流**：电感直流短路，`R3→L…→R4` 原本是 1.65V/99.8Ω = 16.5mA 的纯直流通路；串入后直流归零，+5V_A 的真实负载回到 ~2mA | 串在 `R4` 入地的腿上；它让"+5V_A ≈2mA、R21 压降 9.4mV"这整套账成立（`26 §2.4-1`）；电感不再白发热、Isat 余量不被吃 33% | 16.5mA 白流：电感发热、U1B 输出级白耗功率、电感磁饱和风险 |
| `R4` 49.9Ω 1% | 双端接梯形的**负载端阻抗**（终接）——是滤波器定义的另一半，**不是"隔离电阻"** | 交流终接电流经它入 AGND（`C23` 就串在这条腿上） | 与 `R3` 配对；与 `C23` 构成"隔直终接"支路 | 滤波器形状全变 |
| `TP3` 测试点 | 不参与信号——**LC 输出探针**：扫频标定与电感 THD 实测的关键落点（`23 §7` 扫频判据） | 不接电源 | "滤波器对不对"的唯一验证点 | 滤波器只能靠仿真自证，没有实测抓手 |

### 1.5 分区⑤ 二级增益与 ADC 驱动

**增益为什么放在滤波器之后**（全篇最重要的顺序判断）：u_J 是 ±50mVpk 大信号，先放大 ×8 再滤波会把运放推进非线性区，IM3 产物**落在分析带内**且滤波器在它后面去不掉。所以顺序钉死：**缓冲 → 滤波 → 放大**。

| 位号 · 值 | 对信号 | 对电源 | 对其他元器件 | 缺它后果 |
|---|---|---|---|---|
| `C9` 100nF C0G 1206 | **第二次隔直**：LC 输出的直流点本来就是 VBIAS（电感直流短路），必须再隔一次，把纯交流分量交给增益级重新抬到 VBIAS | 与 `C1` 同款"域隔离"角色——挡住滤波器侧的直流 | 与 `R5` 定第二级工作点。**为什么隔两次**：`C1` 挡**信号源**的直流、`C9` 挡**滤波器**的直流——位置不同、职责不同（`30 §5.3`） | U1B 的直流增益 ×7.975 会把 1.65V 放大到 ≈13.2V——立即饱和出轨 |
| `R5` 10kΩ 1% | 给 `U1B` 同相端提供直流回路到 VBIAS | VBIAS 的三个负载之一 | 与 `C13` 配合（同 `R2` 行） | 输入端无直流回路，漂到轨 |
| `U1B` OPA2197ID 半 B（同相放大） | **G = 1 + R6/R7 = 7.975** [复算]；输出直流恒等于 VBIAS（`R7` 落 VBIAS 的巧点，见 R7 行）；闭环 −3dB = GBW/7.975 ≈ **1.25MHz**（通带 500kHz 的 2.5 倍）[复算] | `U1.8` 吃 +5V_A；输出级要给 ADC 采样电容供 charge（经 `R8`+`C10`） | `R6/R7` 定倍数；`R8+C10` 是它的输出负载；**`R6/R7` 必须紧贴 U1B 反相端 ≤3mm**——高阻 −in 节点每多 5pF 寄生吃约 6° 相位裕度，自激风险在输入端不在输出端（`37 §3.4 A12~A15`） | 信号太小，ADC 分辨率用不满（源端 LSB 0.404mV，`26 §6`） |
| `R6` 24.9kΩ **0.1%** | 反馈电阻：与 R7 的**比值**定增益 7.975（绝对值不重要） | 不接电源轨；交流反馈电流走它 | 与 `R7` 绑死。**为什么 0.1%**：增益误差是乘性的，1% 电阻给 17 点标定表加 ~2% 斜率不确定度、白吃判据余量；0.1% 只贵几分钱。供应商编号曾指向旧值 69.8k（36 §C 抓出并修） | 无增益；或比值错 → 读数整体偏一个比例 |
| `R7` 3.57kΩ **0.1%** | 增益下臂。**落 VBIAS 而不是 GND——单电源设计的巧点**：若落 GND，直流输出 = 1.65×7.975 ≈ 13.2V 直接饱和；落 VBIAS 后 `Vout = VBIAS + (Vin−VBIAS)×7.975`，**直流输出恒等于 1.650V、与增益无关**，增益只作用于交流分量（`26 §2.5`） | 不接电源轨（VBIAS 本质是 +3V3 的分压轨，它算 VBIAS 的负载） | 与 `R6` 绑定成增益对；两颗都要贴 `U1B.−in` ≤3mm（自激判据，同 U1B 行） | 增益开环/输出饱和 |
| `R8` 100Ω | 与 `C10` 组成 **3.39MHz 低通** [复算]；限制 ADC 采样 kickback 尖峰电流；隔离运放输出与采样开关 | 不接电源轨 | **与固件采样时间绑死**：SMP=3 周期下 F4 要求 R_AIN ≤ 0.4kΩ，100Ω 余量 4× ⇒ **不能再加大**（加大就要抬采样周期 → 破坏 fs=2.0MHz 冻结参数，`26 §7-N9`） | 采样尖直接打在运放输出上，每次采样在读数上留尖 |
| `C10` 470pF C0G | **ADC 采样开关的就近电荷库**：ADC 内部 ~4pF 开关电容每次采样抽一记电荷，470pF 是 100× 的蓄水池，把 kickback 压平；τ = 100Ω×470pF = **47ns**（采样窗 500ns 的 9.4%）[复算] | 高频泄放到 **AGND** | 与 `R8` 定 3.39MHz 拐点（对 500kHz 通带无影响）。仿真 O2 试过 220pF：采样误差 1.42→0.79 LSB，但那是纯斜率项、已被标定吸收 ⇒ 收益≈0，否决（`28 §4.1`） | kickback 尖峰进读数，精度掉一截 |
| `JP2` 0Ω | 导通时等于线；把 `AFE_ADC_IN` 之前的链路在此分成两段 | 不接电源 | **ADC 前断点**：断开后 AFE 与 ADC 解耦，可单独给 ADC 注测试信号（`37`：它要放在 AFE 区边缘方便操作） | 功能不变，分段排查能力没了 |
| `TP4` 测试点 | 不参与信号——**JP2 之前的输出节点探针**：静态应 ≈1.650V（不饱和）· 噪声底判据 <0.5mVrms（仿真预测 0.054）· 扫频与自激观察点（`23 §7 V3/V13`） | 不接电源 | 噪声底、扫频、自激三张判据表都落在它身上；`37`：要放在 `JP2` 之前且探针可达 | 三项上板判据失去观察点 |

### 1.6 分区⑥ 电源去耦（+5V_A 轨）

| 位号 · 值 | 对信号 | 对电源 | 对其他元器件 | 缺它后果 |
|---|---|---|---|---|
| `C11` 22µF 钽 | 不承载信号——但**信号质量依赖 +5V_A 干净**：它是模拟轨的"慢水缸" | **+5V_A 储能下臂**：与 `R21`(4.7Ω) 组成 **1.5kHz 低通** [复算]，把数字轨的抖动挡在模拟轨外 | 与 `R21` 绑成 RC 对（R21 是它的上臂）；就近 `U1.8`；C23 修复后 +5V_A 只 ~2mA，它绰绰有余 | `R21` 的隔离作用塌一半——没有下臂电容，低通不成立 |
| `C14` 100nF C0G | 同上（高频侧） | **高频去耦**：钽电容自感大、对高频不灵；小电容补高频——**一大一小并联才是完整去耦**（`30 §5.3` 反例清单） | 就近 `U1.8`；与 `C11` 是互补不是重复 | 高频噪声经电源进运放，混进读数 |

---

## §2 INT 页（核心板与接口，26 位号）—— MCU 和屏之间的桥

### 2.1 `EVK1` 核心板（LCKFB-LSPI-SkyStar-STM32F407VGT6-PRO，84 脚：35 连 / 49 NC）[活体]

| 维度 | 内容 |
|---|---|
| **对信号** | 全板的大脑：① 经 `EVK1.4`(PA1=ADC1_IN1) 采 AFE 送来的信号——TIM8 TRGO @2.0MHz 触发、12bit、DMA2_S0 循环搬 4096 点 [代码]；② DSP 算 Upp/Urms/频谱；③ 用 FSMC 硬件时序（8080-16bit，~104ns/像素）生成屏时序。16 条数据线 + 4 条控制线的引脚映射已逐条核对、一条不错（`26 §3.2` [复算]） |
| **对电源** | **全板的电源源头**：+5V 从核心板 5V 针（`EVK1.40/80`）出（Type-C 进电）[活体]；核心板 LDO 生成 +3V3（`EVK1.38/78`）供屏/触摸/背光与 VBIAS 分压。**地**：`EVK1.37`(AGND) 与 `EVK1.39/77/79`(GND) 在核心板内部经一颗 0Ω（`R8`）单点汇合——**这是全板唯一的地回路**（36 §M.1 已实测通；底板两网零连接件，**绝不能再加桥接**，否则第二个接地点 → 地环路） |
| **对其他元器件** | `J5` 的驱动者（21 条线经 33Ω）；AFE 的落点（EVK1.4=PA1）；`VBIAS` 只读探针落点（`EVK1.9`=PC4——**固件不采**，图上有"只读探针"注释，`26 §7-N1` 处置②）；触摸 I²C 主机（`EVK1.23/24`=PB10/PB11）+ INT 输入（`EVK1.12`=PC5，配输入+内部上拉，顶替外部 4.7k）；背光开关（`EVK1.11`=PB0）；屏复位（`EVK1.14`=PB1） |
| **缺它后果** | 装置不存在 |

（49 个 NC 里值得知道的：`EVK1.2`(REF 针) NC——官方悬空针，VBIAS 已改取 +3V3；`EVK1.81~84` 无名脚 NC（`39 §3.2-6` 待确认是什么，不影响连接）；其余为未用 GPIO。）

### 2.2 `J5` 屏接口母座（2.54mm 2×15P 直插，30 脚）

| 维度 | 内容 |
|---|---|
| **对信号** | 屏侧全部信号的出入口：21 根 LCD 线（经 33Ω）+ I²C 两根 + INT + 背光控制。**逐脚单一真相源 = `26 §3.2` 的 30 行表**（含 3 个 NC：J5.22/23/25 是转接板 T_BUSY/T_CS/MISO 一路，触摸走 I²C 不用它们） |
| **对电源** | `J5.30` 送 **+3V3**——屏逻辑 + 触摸 + **背光电流全从这一针出**（背光是 +3V3 的最大负载 54~66mA 级、且驱动方式与规格不匹配，`36 §M.2`——"能亮≠合规"，上板先测）；`J5.29` 是**唯一的地针**：20 条信号线的回流全压在它上——**全板最弱一环**（地弹 ∝ L_gnd×N×di/dt，`28 §3.3`；PCB 上必须短/宽/多过孔，`37 §0-9`） |
| **对其他元器件** | `C21/C22` 就近伺候它；21 只 33Ω 的屏侧端就是它的 21 个脚；转接板 `P4`（DE/PCLK/VSYNC/HSYNC）出厂悬空需锡桥按规格接（`38 §3.3-④`，上电前检查项） |
| **缺它后果** | 屏接不上 |

### 2.3 FSMC 串阻阵列 `R22`~`R42`（21 只 33Ω ±1%，0805）

**共享的三维说明（21 只相同，先读这段再看逐只映射）**：

| 维度 | 内容 |
|---|---|
| **对信号** | **源端串联阻尼**：FSMC 边沿很陡，冲进"排针+排线+转接板"路径会来回反弹（振铃），振铃谐波**整列落进 10k~500kHz 分析带**——这是全板最大的板内干扰源。33Ω 与排线特征阻抗（~100Ω）配比，把台面场景（飞线）过冲 **47%→8%**、边沿 9.5→14.6ns [仿真]（成品直插形态它是过阻尼、偏保守，但保持统一 BOM 不值得换料，`28 §3.2`）。2 层板没有地平面兜底 ⇒ 这是"必做"不是"优化" |
| **对电源** | 不接任何电源轨；但它们决定 21 条线边沿的 di/dt——**直接决定 J5.29 上的地弹幅度**（压 di/dt 是地弹三条手段之一） |
| **对其他元器件** | 每只串在"MCU 引脚 ↔ J5 引脚"之间。⚠️ **图纸把它们画在 J5 侧是 EDA 工具限制，PCB 必须贴 MCU 引脚 3~5mm**——贴到负载（屏）侧 = 阻尼加在终点 = **等于没加**（`18 §R-21`/`26 §7-N5`/`43 §1`：内排受几何限制实际 6~7mm，已量化接受） |
| **缺它后果** | 0Ω 时台面过冲 47%（3.3V 冲到 4.84V）→ 花屏/错色/干扰进 ADC |

**逐只映射** [活体]（网名口径：MCU 侧网 = `LCD_x`，屏侧网 = `LCD_x_J5`）：

| 位号 | MCU 侧网（MCU 脚） | J5 侧网（J5 脚） | 功能 | 备注 |
|---|---|---|---|---|
| `R22` | LCD_D0（PD14/EVK1.36） | LCD_D0_J5（J5.6） | FSMC_D0 | 16 条数据线之一 |
| `R23` | LCD_D1（PD15/EVK1.35） | LCD_D1_J5（J5.7） | FSMC_D1 | |
| `R24` | LCD_D2（PD0/EVK1.72） | LCD_D2_J5（J5.8） | FSMC_D2 | |
| `R25` | LCD_D3（PD1/EVK1.71） | LCD_D3_J5（J5.9） | FSMC_D3 | |
| `R26` | LCD_D4（PE7/EVK1.13） | LCD_D4_J5（J5.10） | FSMC_D4 | |
| `R27` | LCD_D5（PE8/EVK1.16） | LCD_D5_J5（J5.11） | FSMC_D5 | |
| `R28` | LCD_D6（PE9/EVK1.15） | LCD_D6_J5（J5.12） | FSMC_D6 | |
| `R29` | LCD_D7（PE10/EVK1.18） | LCD_D7_J5（J5.13） | FSMC_D7 | |
| `R30` | LCD_D8（PE11/EVK1.17） | LCD_D8_J5（J5.14） | FSMC_D8 | |
| `R31` | LCD_D9（PE12/EVK1.20） | LCD_D9_J5（J5.15） | FSMC_D9 | |
| `R32` | LCD_D10（PE13/EVK1.19） | LCD_D10_J5（J5.16） | FSMC_D10 | |
| `R33` | LCD_D11（PE14/EVK1.22） | LCD_D11_J5（J5.17） | FSMC_D11 | |
| `R34` | LCD_D12（PE15/EVK1.21） | LCD_D12_J5（J5.18） | FSMC_D12 | |
| `R35` | LCD_D13（PD8/EVK1.30） | LCD_D13_J5（J5.19） | FSMC_D13 | |
| `R36` | LCD_D14（PD9/EVK1.29） | LCD_D14_J5（J5.20） | FSMC_D14 | |
| `R37` | LCD_D15（PD10/EVK1.32） | LCD_D15_J5（J5.21） | FSMC_D15 | |
| `R38` | LCD_CS（PD7/EVK1.67） | LCD_CS_J5（J5.1） | **FSMC_NE1** 片选 | 控制线 4 条之一 |
| `R39` | LCD_RS（PD11/EVK1.31） | LCD_RS_J5（J5.2） | **FSMC_A16** 命令/数据 | |
| `R40` | LCD_WR（PD5/EVK1.69） | LCD_WR_J5（J5.3） | **FSMC_NWE** 写选通 | 每像素都翻转，最忙 |
| `R41` | LCD_RD（PD4/EVK1.70） | LCD_RD_J5（J5.4） | **FSMC_NOE** 读选通 | |
| `R42` | LCD_RST（PB1/EVK1.14） | LCD_RST_J5（J5.5） | 屏复位 | 2026-10-03 补装（`35`）；RST 只在初始化翻一次，补它为阵列完整性与同类边沿风险，非性能必需（`36 §E`：拖慢复位沿 0.155%） |

### 2.4 `R12` / `C21` / `C22`

| 位号 · 值 | 对信号 | 对电源 | 对其他元器件 | 缺它后果 |
|---|---|---|---|---|
| `R12` 1kΩ | 串在背光控制线上（`LCD_BL_PB0`=PB0 → R12 → `LCD_BL_CTL`→J5.28）。**它是栅极串阻，不是限流电阻**——背光电流完全不由底板决定（适配板把 LED-A 直挂 3.3V） | 不接电源轨 | 压制开关管栅极动作瞬间的振铃；顺带是可测点。背光铁律：**恒亮、禁 PWM**（PWM 谐波列全落分析带，`26 §3.4`） | 只在开机动作时有一点振铃（影响小，但成本 ¥0.01 且是测点，留） |
| `C21` 10µF 0805 | 不承载信号——但屏的开关电流若跑回核心板取，会在长电源路径上扰出纹波 | **屏的就近"慢水缸"**（六层保障 L5，`28 §3.1`）：+3V3/GND 各一脚，紧贴 J5.30 | 与 `C22` 互补（一大一小才是完整去耦）；**图上它的 2 条电源旗方向反挂**（`39 §6-3`，可读性瑕疵、非电气错误） | 屏开关电流叠加在长路径上 → +3V3 抖 → 屏闪/伪峰进 ADC |
| `C22` 100nF 0805 | 同上（高频侧） | 屏的就近**高频**去耦 | 与 `C21` 配对；同样有 2 条旗反挂（同上） | 高频瞬态无就近泄放 |

---

## §3 PWR 页（电源与触摸上拉，4 位号）

> **口径**：本页原为 7 件（J3/F1/D2/C16/R21/R15/R16）。2026-10-04 删 `J3`(DC005)/`F1`(PPTC)/`D2`(SS34)——**本板由核心板 Type-C 供电**，底板不带 DC 座、不带入口防护（防护由核心板提供），`38 §3.2-①`。讲老文档（如 `30 §3`、`28 §1` 的供电树前半段）时按本口径折算。

| 位号 · 值 | 对信号 | 对电源 | 对其他元器件 | 缺它后果 |
|---|---|---|---|---|
| `C16` 22µF 钽 | 不承载信号——但 +5V 轨的干净度是全板读数的根基 | **+5V 入口储能**：电源路径（现为核心板 5V 针→排针）有电感，负载电流突变（开屏、FSMC 全总线翻转）时电压会瞬塌，它就近补上 | 是 `R21`（+5V_A 支路）与核心板共用的"慢水缸"；接 +5V/GND（[活体]：C16.1=+5V、C16.2=GND） | 开屏瞬间 +5V 塌 → 核心板复位 |
| `R21` **4.7Ω**（2026-10-03 由 0Ω 改） | 不承载信号——但它是**模拟轨干净度的主承担者**：与 `C11` 组成 1.5kHz 低通，对 500kHz 纹波隔离 **+50dB** [仿真]（改前 0Ω 时仿真 −37dB：1V 电源抖动 → 14mV 灌进 ADC，超判据 9 倍） | **+5V 与 +5V_A 两网之间唯一的阻件**：压降 = 2mA×4.7Ω = **9.4mV**（0.19%，可接受）[复算] | `C11` 是它的下臂（缺了下臂低通不成立）。**上电前必查"是否误贴 0Ω"**（`23 §1`）——它的供应商编号曾指向旧 0Ω 件，按 C# 下单会买错（`36 §C` 已修） | 数字纹波直通模拟轨，干扰以电源纹波形式混进 ADC 读数 |
| `R15` 4.7kΩ | I²C 时钟线 **TP_SCL 的上拉**：PB10 是开漏输出，只能拉低、拉高全靠它 | 拉低时从 **+3V3** 抽 ~0.7mA（3.3V/4.7k）[复算] | 与 `R16` 成对；4.7k 是 100kHz I²C 标准值（百 pF 级总线电容下上升时间亚微秒级 < 1µs 上限） | 触摸完全读不到（总线拉不高） |
| `R16` 4.7kΩ | I²C 数据线 **TP_SDA 的上拉**（同上） | 同上 | 与 `R15` 成对。**"可能重复"**：转接板 SDA 侧或自带 4.7k（并联成 2.35k，100kHz 下仍合法）——删它省 ¥0.01 却要赌"这批一定带"，判定保留（`26 §4.2`） | 同上（赌输的话） |

---

## §4 每件在三条链上的位置（速查索引）

| 链 | 顺序与成员 |
|---|---|
| **电源链** | 核心板 Type-C → **EVK1.40/80**(+5V) → ┬ **C16**(储能) ┬ **R21**(4.7Ω) → **C11+C14**(去耦) → **U1**(模拟) ；└ 核心板 LDO → +3V3 → **J5.30**(屏/触摸/背光，**C21+C22** 就近) + **R15/R16**(上拉) + **R9/R10→C13**(VBIAS) |
| **信号链** | **J1**(入口) → **R1**(端接) / **D1**(钳位) / **TP1**(探) → **C1**(隔直) → **JP1**(断点) → **R2**(偏置) → **U1A**(缓冲) → **R3** → **L1·C2·L3·C4·L5·C6·L7·C8**(8阶LC) → **C23+R4**(隔直终接) / **TP3**(探) → **C9**(隔直) → **R5**(偏置) → **U1B**(×7.975) → **R6/R7**(增益对) → **R8+C10**(反冲隔离) → **JP2**(断点) / **TP4**(探) → **EVK1.4**(PA1) → DSP → 屏 |
| **屏链** | **EVK1** 的 FSMC/I²C/BL/RST → **R22~R42**(21×33Ω 阻尼) → **J5** → 屏转接板；触摸回路经 **R15/R16**(上拉) + **R12**(背光栅极阻尼) |

---

## §5 讲解时的"禁错清单"（最容易讲错、讲错不报错的地方）

| # | 禁错 | 正确口径 | 出处 |
|---|---|---|---|
| 1 | 把 33Ω 讲成"限流电阻"或"滤波" | **源端串联阻尼**（压制振铃），且**PCB 必须贴 MCU 侧 3~5mm**——图上画在 J5 侧是工具限制，贴屏侧=没加 | `28 §3.2`/`43 §1` |
| 2 | 把 `R12` 讲成背光限流 | **栅极串阻**——背光电流由适配板决定（还与规格不匹配，上板先测 54~66mA） | `36 §M.2` |
| 3 | 把 `R3`/`R4` 讲成"隔离/保护电阻" | **双端接梯形的两个端阻抗**——改任一个 = 改滤波器 | `26 §2.4-3` |
| 4 | 把 `R1` 讲成"抗混叠的一部分" | 端接是 50Ω 匹配的必然代价；真正压折叠带的是 LC 的 −57.6dB | `26 §2.1` |
| 5 | 按 SRV05-4 讲 `D1`（双轨钳位、4 通道） | **现为 3 脚单通道对地钳位**（C1→信号、A→AGND、C2 NC），且型号↔符号↔封装不一致待确认 | `39 §3.2-4`（本 §1.1） |
| 6 | 讲 `TP2`（缓冲器输入探针） | **已不在图上**（无记录消失，待用户拍板补/不补）；现有探针 TP1/TP3/TP4/TP5 | `39 §3.2-5` |
| 7 | 讲 DC 座/保险丝/防反接（J3/F1/D2） | **已删**——由核心板 Type-C 供电，底板无入口防护 | `38 §3.2-①` |
| 8 | 把 `R7` 讲成"接地分压" | **R7 落 VBIAS**（直流输出=VBIAS 的巧点）；落 GND 会饱和 | `26 §2.5` |
| 9 | 按"巴特沃斯标准表"核对 LC 值 | 是**在售档拟合值 + 择优值**（C2=6.2n、C6=9.1n 按 17 点标定残差择优），复算背书在 `26 §2.4`/`36 §B` | `26 §7-N8` |
| 10 | 说"VBIAS 被 MCU 采样" | **PC4 是只读探针、固件不采**（自检走 AFE 帧直流均值） | `26 §7-N1` |
| 11 | 说"AGND 和 GND 在底板上连着" | **底板两网零连接件**——唯一回路在核心板内部 0Ω；底板补桥=第二个接地点 | `39 §1`/`36 §M.1` |
| 12 | 引用 26 §2.3 的"6.4Hz" | 应为 **3.2Hz**（R9∥R10=5k 与 C13；本 §1.3 勘误） | 本文 §1.3 |
| 13 | 说 `+5V_A` 吃几十 mA | C23 修复后 **≈2mA**（修前 16.5mA 直流白流的口径已废） | `26 §2.6` |
| 14 | 把 C11/C14、C21/C22 当重复件 | 一大一小并联才是完整去耦（大管低频小管高频） | `30 §5.3` |

---

## §6 诚实边界

- 本文所有引脚级连接取自 2026-10-04 活体网表（`_archive/_review5/audit_report.txt`）；**数值结论**（增益、拐点、阻带、压降）全部标了来源且可复算（复算脚本：`_archive/_review4/afe_recheck.py`、`tools/sim/indep_check.py` 等）；**上板行为一律未验证**。
- `D1` 的真实器件行为（结电容、钳位电压曲线）在"型号↔符号↔封装"确认前**不能引用 datasheet 具体数字**——本文只讲了"接法与角色"。
- 背光的三维描述里凡涉及"54~66mA"均为**仿真/规格推算**，实测口径见 `36 §M.2` 与 `23 §7`。
- `R22~R42` 的"贴 MCU 侧 3~5mm"在 `43 §1` 已被几何量化修正为"顶层做不到全部满足，内排 6~7mm 已接受"——讲解时引用后一口径。

---

## §7 变更记录

| 日期 | 内容 |
|---|---|
| 2026-10-04 | 首版：按用户标准（每件必答 对信号·对电源·对其他元器件）逐件详解三页 64 位号；含 R22~R42 逐只映射、三条链位置索引、14 条禁错清单、2 条勘误（D1 接法换代、VBIAS 低通 6.4→3.2Hz）。全部引脚事实取自 10-04 活体网表。 |
