funiang-x/G2026/hardware/50-PCB布局布线复核与铺铜策略-20261005.md

# 50 · PCB 布局布线复核 + 铺铜策略（用户首版布线后）

> **性质**：对用户首版布局布线的只读复核（2026-10-05，活体 dump：`_review/pcb_geom_full.json` /
> `pcb_layout_dump.json` / `pads_current.json`）。289 段走线 / 32 过孔 / **铺铜 0 块（尚未铺）** /
> 68 器件。本文回答用户三问（电感铺铜 / SMA 包地 / ADC 包地）并对照 `37 §0` 十二条硬约束逐项定量。
> 坐标单位 mil（1mil=0.0254mm）；层 1=顶 2=底。

---

## §1 一屏结论

| 级别 | 发现 |
|---|---|
| **P1 必改** | ① **21 只 33Ω 全部贴错端**（距 J5 仅 3.8~4.0mm、距 EVK1 17.8~41.9mm）——源端阻尼在负载端=没加；② **R1 距 SMA 中心针 9.2mm**（判据 ≤2~3mm）；③ **C10 距 EVK1.4 约 27mm**（37 §①要求贴 PA1）；④ **铺铜未铺**——本文 §4 给铺铜策略（含电感挖空/SMA 包地/ADC 护线） |
| **P2 建议** | ⑤ FSMC 5 条总线 >40mm（D2 69.2 / D1 62.1 / RD 56.1 / RS 52.2 / D0 50.2）；⑥ R6/R7 距 U1B −in 4.4~6.6mm（A12~A15：≤3mm）；⑦ 隔离带被压缩到 4.7~9.8mm（判据 ≥10mm）；⑧ J5.29 GND 针 0 个就近过孔；⑨ 板框疑似未画（SCREW4 在 x=5527，走线 bbox 只到 4050）；⑩ +3V3 线宽 0.38/0.76mm 混用 |
| **做对了** | EVK1 底面安装且**镜像结构在移动后保持** ✓；R12（背光串阻）贴 EVK1 侧底层=正确的源端位 ✓；C3/C22（J5 去耦）贴 J5 ✓；AFE_ADC_IN 全顶面 0 过孔 ✓；R11 澄清=滤波器内部网（$3N656/$3N683），**不是** AGND↔GND 桥，转接板确无第二接地点 ✓ |

---

## §2 答用户三问

### 2.1 电感要不要禁止铺铜？——**要**

- **底面 GND 铜在 L1/L3/L5/L7 正下方挖空**：非屏蔽电感的磁力线穿过铜面产生涡流（500kHz~2MHz 频段损耗与 Q 值劣化明显），并使电感量下降、把磁场耦合进地平面。挖空范围 = 本体轮廓外扩 **≥2mm**；顶面若铺 AGND 铜同样挖空。
- **先查电感是否屏蔽式**（`17` 的选型门槛）：一体成型屏蔽电感（带金属罩）可免挖空（仍建议下方不过孔、不走线）；工字/鼓式非屏蔽必须挖空。
- **附加发现**：四只电感全部平行（rot 0/180 对两脚元件是同一朝向），间距 10.2~10.8mm——`37`"电感正交"未满足。互感会使两级 LC 互相牵引（`17` 的蒙特卡洛没算互感）。**修法（三选一）**：相邻电感旋转 90° 交错（推荐，零成本）/ 间距拉到 ≥15mm / 换屏蔽电感。
- 滤波电容（C2/C4/C6/C8）地脚就近下 AGND 铺铜过孔（每只 ≥2 个）。

### 2.2 SMA 要不要包地？——**要，且先修 R1 位置**

- **P1：R1(49.9Ω 端接) 距 SMA 中心针 9.2mm**——`13 §5.7`/`37` 判据 ≤2~3mm：中间走线就是感量，匹配先烂。把 R1 挪到中心针旁 ≤3mm（D1 TVS、C1 同节点依次就近）。
- **包地做法**：SMA→R1→C1→JP1 整段用 **AGND 铜皮两侧包夹 + 沿线缝合过孔（间距 ≤5mm）**，SMA 四个接地脚每脚 ≥2 过孔下铜（现状距 J1<10mm 仅 1 个过孔 ⚠️）；该段整体留在 AGND 岛内不出岛。
- SMA 座本身：贴板边 + 外壳焊盘多孔接地 + 结构加强（`13 §5.7` 两条判据不变）。

### 2.3 ADC 采集线要不要包地？——**要**

- AFE_ADC_IN 现状：24.7mm / 4 段 / 全顶面 / 0 过孔 / 10mil——全顶面无过孔是好设计 ✓。
- 但**与 LCD_RS 最近仅 2.9mm**：16 位总线在 3mm 外 10MHz 翻转，是白送的耦合源。**做法**：AGND 伴线沿 ADC 线两侧（或铜皮夹击），缝合孔间距 4~5mm；与 LCD 总线间距拉到 ≥3W 或用护线隔离；跨隔离带段走直线最短。
- **配套 P1：C10 距 EVK1.4 约 27mm**——`37 §①` 的"靠 PA1"要求落空。把 C10 挪到 pad4（4050,−5255）旁 ≤5mm（AGND 回岛走底部或就近缝合）。

---

## §3 硬约束逐条定量（`37 §0` 十二条）

| # | 约束 | 实测 | 判定 |
|---|---|---|---|
| 1 | AGND/GND 板上不相连 | 两者均零走线（待铺铜）；R11 澄清非桥接件 | ✅（铺铜时保持，见 §4） |
| 2 | AFE 只汇 EVK1.37 | AGND 铺铜须伸到 (2350,−5355)（P1 排西端） | 铺铜时执行 |
| 3 | 隔离带 ≥10mm | 最近 R21 4.7 / C16 6.6 / TP4 7.2 / C11 9.8mm | ⚠️ 被压缩，见 §1-⑦ |
| 4 | R1 ≤2~3mm | **9.2mm** | ❌ P1 |
| 5 | SMA 机械补偿 | 待铺铜时做外壳多孔 | 铺铜时执行 |
| 6 | 电感正交 | 四只全平行 10.2~10.8mm | ⚠️ 见 §2.1 |
| 7 | 33Ω 贴 MCU 侧 3~5mm | **全部贴 J5 侧 3.8~4.0mm（距 EVK1 17.8~41.9mm）** | ❌ **P1 最大返工项** |
| 8 | 总线 ≤40mm | D2 69.2 / D1 62.1 / RD 56.1 / RS 52.2 / D0 50.2mm | ❌ P2（33Ω 移位后重评估） |
| 9 | J5.29 多过孔 L_gnd≤30nH | **0 个就近过孔** | ❌ 铺铜时补 ≥4 个 |
| 10 | C21/C22 贴 J5.30 | C3 3.6mm ✓ / C22 5.9mm（略远） | ⚠️ C22 挪近 1mm |
| 11 | 背光不平行 | PB0 线 43.4mm、距 ADC 线 7.7mm | ⚠️ 建议缩短 |
| 12 | 层数升级判据 | 2 层目前可行（33Ω 移位后复评） | 暂 ✅ |

**稳定性 A12~A15**：R6 中心→U1.6（U1B −in）4.4mm、R7→U1.6 6.6mm（判据 ≤3mm）——高阻 −in 节点每多 5pF 吃 ~6° 相位裕度，建议 R6/R7 挪到 U1.6 旁 3mm 内。

---

## §4 铺铜策略（下一步照此执行）

1. **两个地、两片铜**：底面整板 **GND** 铺铜；顶面 AFE 区 **AGND** 铺铜（岛）。AGND/GND 在板上**零连接**——唯一汇点是 EVK1.37（经核心板 R8）。
2. **AGND 岛范围**：覆盖 J1/D1/R1/C1/JP1/TP1/TP5/R2/R3/R9/R10/L1/L3/L5/L7/C2/C4/C6/C8/U1/R5/R6/R7/C14/C9/R4/C7/TP3/C5/VBIAS 等全部 AFE 件，向西北伸颈到 **EVK1.37 (2350,−5355)**；**AFE_ADC_IN (到 4050,−5255) 是唯一跨岛信号**，伴 AGND 护线过带。
3. **隔离带**：两片铜的分界画直线（建议沿 y≈−5450 一线，即 EVK1 南排外 ≥2mm），带内（约 4.7~10mm 现状）**禁止任何数字走线**；AGND 侧缝合孔只属于 AGND。
4. **挖空清单（铜避让）**：电感本体+2mm（§2.1）；SMA 区按 §2.2 反着做（是要包不是要避）；晶体区若有同理。
5. **缝合孔**：GND 铜均匀打孔（间距 ≤10mm 一颗）；AGND 岛边缘 4~5mm 一颗；J5.29 就近 ≥4 颗；SMA 每脚 ≥2 颗。
6. **J5.29 (2565,−4405)**：屏回流唯一地针——铺铜时**必须 ≥4 过孔**直下底面 GND（现状 0 个）。
7. **+3V3 主干统一 30mil(0.76mm)**，支路 15mil 可留；+5V/+5V_A 25mil ✓ 维持。
8. **板框**：确认/画板框后再跑 DRC（SCREW 与走线区现状不吻合，疑似板框未画或待对齐）。

---

## §5 建议执行顺序

1. **33Ω 迁位**（21 只，最大返工）：每只移至自己 EVK1 焊盘 3~7mm 内（外排放排针外侧、内排挤中间带，`43 §5` 已论证内排 6~7mm 可接受）；底层与排母同面。
2. R1→SMA 旁 ≤3mm；C10→EVK1.4 旁 ≤5mm；R6/R7→U1.6 旁 ≤3mm。
3. 电感交错 90°（或换屏蔽型号）。
4. 按 §4 铺铜 + 缝合 + 挖空。
5. 画板框 → DRC → 复跑本文全部判据（脚本思路见 `_review/*.json` 的分析方法）。

---

## §6 诚实边界

- 本文所有数字来自活体几何 dump；**未跑 EDA DRC**（板框疑似未画，跑了也会失真）。
- 33Ω 迁位后总线长度、隔离带宽度会变，需复测。
- 电感互感对滤波器响应的影响未建模（`17` 蒙特卡洛不含互感项）——正交化是保守做法。
- 铺铜策略是提案不是既成事实；执行后用 DRC + 本文判据复验。
