funiang-x/G2026/hardware/_review/afe_flags_summary.txt

=== FLAGS (net @ x,y) ===
  +5V_A            @ (180,1440)  ct=netflag name=+5V_A id=270aaf4d88d5aa21
  +5V_A            @ (200,1020)  ct=netflag name=+5V_A id=db68975cde6a35fa
  +5V_A            @ (760,1100)  ct=netflag name=+5V_A id=188b011df73df0e8
  AFE_ADC_IN       @ (2640,1050)  ct=netport name=AFE_ADC_IN id=1f68bb14777a2b59
  AFE_BUF_IN       @ (580,1050)  ct=netport name=AFE_BUF_IN id=c6ddf5a1c1c97778
  AFE_BUF_IN       @ (620,1190)  ct=netport name=AFE_BUF_IN id=6174c97a1a9f8936
  AFE_BUF_IN       @ (700,1040)  ct=netport name=AFE_BUF_IN id=1beb3e7b955e4a2e
  AFE_BUF_IN       @ (720,850)  ct=netport name=AFE_BUF_IN id=f37e6f705d1a6e66
  AGND             @ (100,1100)  ct=netflag name=AGND id=2b249eb2e2d612c2
  AGND             @ (100,1000)  ct=netflag name=AGND id=42e588cafcab0bbc
  AGND             @ (120,1100)  ct=netflag name=AGND id=c1b498a0c3465878
  AGND             @ (120,1000)  ct=netflag name=AGND id=8e52bccd4fe9317f
  AGND             @ (180,1360)  ct=netflag name=AGND id=d301ecb9983ee069
  AGND             @ (200,880)  ct=netflag name=AGND id=d613954008ae87e2
  AGND             @ (280,910)  ct=netflag name=AGND id=fc72a22167fc4941
  AGND             @ (440,1360)  ct=netflag name=AGND id=0c5a317f8fb7243f
  AGND             @ (560,1130)  ct=netflag name=AGND id=790f1213e41763df
  AGND             @ (660,1190)  ct=netflag name=AGND id=e19f412a8cb50c01
  AGND             @ (760,1000)  ct=netflag name=AGND id=cb228fdc33184025
  AGND             @ (1140,910)  ct=netflag name=AGND id=ee470f1d568150af
  AGND             @ (1380,910)  ct=netflag name=AGND id=ab64a27366a1c7ca
  AGND             @ (1620,910)  ct=netflag name=AGND id=3ccf3280232b0edd
  AGND             @ (1860,910)  ct=netflag name=AGND id=003502606b4a3306
  AGND             @ (1980,910)  ct=netflag name=AGND id=f973bec9582b16e2
  AGND             @ (2140,1290)  ct=netflag name=AGND id=56330b6c12fc2de0
  AGND             @ (2500,910)  ct=netflag name=AGND id=2dba1909807e2c24
  VBIAS            @ (520,850)  ct=netport name=VBIAS id=bf34cc3f5ca8f760
  VBIAS            @ (560,1210)  ct=netport name=VBIAS id=421ea90e6b10ba7e
  VBIAS            @ (560,1290)  ct=netport name=VBIAS id=71e3e21ebcefb211
  VBIAS            @ (620,1110)  ct=netport name=VBIAS id=3d89186ed2eff401
  VBIAS            @ (660,1270)  ct=netport name=VBIAS id=6e22bc178ca0f88e
  VBIAS            @ (2240,910)  ct=netport name=VBIAS id=600374aedbf31e7b
  VREF_ADC         @ (440,1440)  ct=netport name=VREF_ADC id=920eb643c6d1dd51
  VREF_ADC         @ (560,1330)  ct=netport name=VREF_ADC id=be4226efac3e01e0
  VREF_ADC         @ (720,1450)  ct=netport name=VREF_ADC id=e543f8235510c74d
  VREF_ADC         @ (760,1330)  ct=netport name=VREF_ADC id=e03d224c347f4fb7
  VREF_CORE        @ (760,1250)  ct=netport name=VREF_CORE id=a6052105e53de0af

=== PARTS of interest ===
  R1   @ (280,950) ={Value}
       pin   2 @ (280,930)
       pin   1 @ (280,970)
  R3   @ (900,1050) ={Value}
       pin   2 @ (920,1050)
       pin   1 @ (880,1050)
  C1   @ (400,1050) ={Value}
       pin   1 @ (385,1050)
       pin   2 @ (415,1050)
  C9   @ (2100,1050) ={Value}
       pin   1 @ (2085,1050)
       pin   2 @ (2115,1050)
  JP1  @ (540,1050) ={Value}
       pin   2 @ (560,1050)
       pin   1 @ (520,1050)
  JP2  @ (2600,1050) ={Value}
       pin   2 @ (2620,1050)
       pin   1 @ (2580,1050)
  JP3  @ (760,1290) ={Value}
       pin   2 @ (760,1270)
       pin   1 @ (760,1310)
  R2   @ (620,1150) ={Value}
       pin   2 @ (620,1130)
       pin   1 @ (620,1170)
  R5   @ (2240,950) ={Value}
       pin   2 @ (2240,930)
       pin   1 @ (2240,970)
  R7   @ (2140,1250) ={Value}
       pin   2 @ (2140,1230)
       pin   1 @ (2140,1270)
  R9   @ (560,1290) ={Value}
       pin   2 @ (560,1270)
       pin   1 @ (560,1310)
  R10  @ (560,1170) ={Value}
       pin   2 @ (560,1150)
       pin   1 @ (560,1190)
  U1   @ (760,1050) ={Manufacturer Part}
       pin   4 @ (760,1020)
       pin   8 @ (760,1080)
       pin   1 @ (800,1050)
       pin   2 @ (720,1060)
       pin   3 @ (720,1040)
  R6   @ (2300,1150) ={Value}
       pin   2 @ (2300,1130)
       pin   1 @ (2300,1170)
  C10  @ (2500,950) ={Value}
       pin   1 @ (2500,965)
       pin   2 @ (2500,935)
  C11  @ (180,1400) ={Value}
       pin   2 @ (180,1380)
       pin   1 @ (180,1420)
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
  net=             id=f23240f86bd3b0b1  [[100, 1100], [100, 1080]]
  net=             id=324124521f870611  [[120, 1100], [120, 1080]]
  net=             id=afd15afdc2c13fd3  [[120, 1000], [120, 1020]]
  net=             id=149cc187469d0f65  [[100, 1000], [100, 1020]]
