funiang-x/G2026/docs/02_优化方案_硬件与软件.md

# G2026 优化方案 · 硬件 × 软件 · v1

> 性质：技术建议方案（现状分析 → 优化目标 → 具体措施 → 预期收益）
> 项目：G2026 电赛 G 题「周期信号测量分析装置」· 平台：STM32F407VGT6 核心板 + 底板
> 日期：2026-09-28 · 状态：**待 [CHK] 人确认**（本文不改变任何已冻结参数）

> ## ⚠️ 2026-10-02 勘误（口径与状态都已变，改前先看这里）
>
> 以 `hardware/25-独立评审与优化-20261002.md` 为准：
>
> | 本文写的 | 现状 |
> |---|---|
> | `fc=800k`、`×4 前端增益`、`偏置 1.65V`（§1/§2 链路图） | 图纸实落 **fc≈650kHz**（−59.3dB@1.5M）、运放级 **×8**（净增益 2.0）；**VREF+ ≈3.3V**（核心板 `R4=47Ω` 由 `VDDA` 供，板载基准不贴）⇒ `VBIAS = 1.65V`，输入端 LSB=0.4028mV |
> | §HB6「VREF+ 外部基准注入路径待确认」 | **已查实并改图**：排针 `REF` 针官方默认**悬空**（`R2` 0Ω 不贴），底板偏置**已改取 `+3V3`**；`JP3/VREF_ADC` 降级为"外部基准留位" |
> | §SB5「采样窗静默 ✅ 已实现」 | **当时只是"整帧级避让"、不成立**：一次 flush（320×48px）≈9ms ≫ 采样窗 2.048ms，已经开始的写屏会横跨整个采样窗。**2026-10-02 才真正落地**：新增 **LCD 总线闸**（`bsp_lcd_bus_take/give` + 写屏分块 `APP_LCD_CHUNK_PX`）⇒ 采样窗内一次 FSMC 写都不会发生（见 §SB5 行与 `hardware/25 §6-S2`） |
> | 交付态 | `APP_LVGL_USE_DEMO` 已由 1 改回 **0**（业务 UI 与 17 点标定流程这才编得进来）。⚠️ **2026-10-09 起临时回到 `1`** —— 上板验证显示/触摸期间屏上跑官方 widgets demo + 官方 sysmon 帧率/CPU/MEM 浮层；**验完必须改回 0**（三处开关与判据见 `hardware/23 §3`） |

---

## §0 事实来源与口径

本文是**快照**，不是第二真相源。所有数值均指向下列工程文件，**对账日期 2026-09-28**：

| 类别 | 单一真相源 |
|---|---|
| 硬件事实（引脚/时钟/外设） | `firmware/Core/Inc/board_config.h` |
| 应用参数（周期/阈值/开关） | `firmware/project_config.h` |
| DSP 定稿（fs/N/窗/口径/标定） | `docs/01_软件架构与DSP方案.md` |
| 硬件选型/架构/pinout | `hardware/01-requirements.md` · `02-architecture.md` · `03-components.md` · `04-pinout连接表.md` |
| 数值复算 | `tools/verify_dsp.py` → `report_dsp_verify.md`；`tools/hardware/verify_afe_v2.py` → `verify_afe_v2_report.md`；`hardware/data/report_opt.md` |

**三态口径**（沿用工作台铁律 1）：**已验证**（跑了哪条命令、结果如何）/ **未验证**（为什么没跑）/ **不适用**。
⚠️ 本文全部结论中，凡涉及"上板"的一律为**未验证**——装置尚未制造。

---

## §1 现状总览

### 1.1 一句话定位

模拟前端 = 无源 LC 8 阶巴特沃斯（fc=800k）+ OPA2197 逐级缓冲/增益；数字侧 = F407 片内 ADC（fs=2.0MSPS）+ 单点 DFT 精化读数 + 17 点标定；显示 = 3.5″ ST7796S（FSMC 8080-16bit）+ FT6336 触摸。软件四层（Task/Operation/Device/Common），实机为**单任务 10ms 轮询态机**。

### 1.2 冻结参数（不可轻动）

fs=2.0MHz · N=4096 · BH4 窗 · 单点 DFT 读数口径 · 17 点标定 · 5mV/1kHz 判据 · ×4 前端增益。

### 1.3 门禁现状（**已验证**）

| 门禁 | 结果 | 出处 |
|---|---|---|
| `build --clean-first` | 零告警；FLASH **294KB**/1MB · RAM **54KB**/128KB | `README.md` |
| `test`（PC 单测） | 全绿 | `README.md` |
| `lint` / `doccheck` | 通过 / 435 条引用无死链 | `README.md` |
| 体积预算上限 | FLASH 640KB · RAM 96KB · CCM 64KB | `Tools/stm32_size.py` BUDGETS |

### 1.4 三态总表

| 环节 | 状态 |
|---|---|
| 选型（器件表/风险表 R1~R6） | **已验证**（datasheet/脚本复核，`03-components.md`） |
| 原理图三页（AFE/PWR/INT） | **已验证**（立创 EDA 落图，191 连接点回读差异 0，`04 §5`） |
| PCB 落图 | **未验证**（用户拍板暂不画，`04 §5 遗留⑤`） |
| 算法层（op_dsp/peak/meas/wave/spec/cal） | **已验证**（PC 单测绿，S1~S4 |ΔA|<2mV） |
| Device 层（bsp_adc/lcd/touch/spi/sd/rtc） | **未验证**（编译绿 · 待上板） |
| 模拟前端制作质量 | **未验证**（装置未制造） |
| 全链上板联调/标定 | **未验证** |

---

## §2 现状分析 · 硬件

### 2.1 架构与预算现状

信号链（`02-architecture.md` §3，定案 v3）：

```
BNC ─ TVS(≤5pF) ─ 50Ω端接(1%) ─ AC耦合100nF/10k ─► BUF1(OPA2197A, G=1) ─ 50Ω串阻
     ─► LC 8阶BW fc=800k(50Ω双端接) ─ 50Ω负载 ─ AC耦合 ─► GAIN(OPA2197B, ×4, 偏置1.65V)
     ─► 100Ω+470pF ─► ADC1(PA1, fs=2.0MSPS)
```

- 底板 BOM ≈¥15（不含屏/核心板，`01 §2`）；核心板 = 立创天空星 F407VGT6 高配版。
- 电源树：5V 单路入 → 核心板自供 MCU / AMS1117-3.3 供数字 / 模拟 5V 供运放+基准；背光走 5V 恒亮。
- 误差预算（软件文档 §10）：RSS ≈ **1.31mV**，对 5mV 判据余量 **≈3.8×**；留给硬件非理想项仅 **~1mV**。

### 2.2 瓶颈清单（按对判据的影响排序）

| # | 瓶颈 | 证据（可溯源） | 等级 |
|---|---|---|---|
| HB1 | **模拟前端制作质量 = 全装置指标瓶颈** | 软件文档 §10/§13（R5）；余量仅 3.8×，硬件非理想项预算 ~1mV | 高 |
| HB2 | ~~混叠残留余量薄~~ → **已澄清（2026-09-28）**：输入端折算残留 **0.655mV**（器件侧单测实测 −0.652mV，逐位吻合），对峰门限 1.5mV 余量 2.3×、对判据 5mV 余量 7.6× | `Test/test_op_meas.c` S5~S9；软件文档 §6 | 高 → **已闭** |
| HB3 | ~~预算数字文档不一致~~ → **实为跨参考点比较**：0.655mV 是**输入端**折算，1.309mV 是 **ADC 端**折算（含端接×0.5 与增益×4），两者之比 = 2。预算表与门限同在输入端域 ⇒ **0.655mV 正确**，无需改动 | `verify_afe_v2_report.md` §4（已更正） | 高 → **已闭** |
| HB4 | **LC 电感规格是滤波形状的命门**（SRF≥12MHz / DCR≤0.5Ω），型号未定、实物未抽测 | `03-components.md` #3；风险 R2 | 中 |
| HB5 | **布局寄生**（电感互感 / 地回路）改变高节频响 | 风险 R4；`02 §6` O4/O6 | 中 |
| HB6 | **VREF+ 外部基准注入路径**（天空星 R1/R2/R4 贴法）待对原理图确认 | 风险 R3 | 低 |
| HB7 | **PCB 未落图 ⇒ 无制造 ⇒ 标定兜底机制无闭环** | `04 §5` 遗留⑤ | 高 |
| HB8 | TVS 型号（需 ≤5pF）未定案 | `03-components.md` #8 | 低 |

### 2.3 可升级空间（含已量化拒绝项，防返工）

| 方案 | 收益 | 结论 |
|---|---|---|
| **A. 底板 4 层工艺**（完整 GND 平面） | mV 级模拟与 FSMC 共板，根治回流/EMI | **建议采纳**，差价量级几十元（[TBD-6] 待拍板） |
| **B. Cauer 椭圆 n=6 滤波器**（Plan B） | 残留 1.309→**0.634mV**（Amin=50dB）/ **0.200mV**（60dB）；余量 3.8×→**7.8×/21.9×**；且比 BW n=8 **少一个电感** | **挂起**，触发条件制：板到手实测残留超预算，或竞测发现 u_J 伪峰 |
| **C. 双帧变频识别 u_J** | 残留→~0.1mV，余量→**~30×** | **挂「精度拉满」**；`board_config.h` 已预留 `BOARD_TIM8_ARR_AUDIT=89` 但未实现（见 SB2） |
| **D. 可编程增益（扩量程）** | 兼容 >450mVpp 输入 | **[OPT] 不建议**：题面未要求；引入增益切换误差需进标定表 |
| 已拒：DAC 标定源 / 双 ADC / TCXO / ×6 增益 / fs 微调 K=71 / 输入串 100Ω | — | **拒绝**（`report_opt.md` 逐条量化） |

---

## §3 现状分析 · 软件

### 3.1 架构现状

- 四层：`Task`（调度）→ `Operation`（纯逻辑，PC 可测）→ `Device`（唯一碰 HAL）→ `Core/Drivers`；`Common` 横切。
- 实机模型：**单任务 10ms 轮询态机**（`app_rtos_run()` → `app_poll()` → `app_engine_poll()` / `app_ui_poll()` / `app_lvgl_poll()`）。engine 的 DSP 全链**拆两拍**（FFT 拍 ~8ms + 精化拍 ~5ms），保 LVGL 稳定在 60fps 上限。
- 算法层全部落地并 PC 单测绿；`MeasResult_t` 为 ≤64B 单例直读（seq 判新旧，无锁）。

### 3.2 不足清单（**全部已核查，可复现**）

| # | 不足 | 证据（可溯源） | 影响 |
|---|---|---|---|
| **SB1** | **架构双轨：`Task/Src/app_tasks.c` + `app_tasks.h`（约 290 行）是旧的 4 任务骨架（Task_Meas/Dsp/Link/Ui + 4 队列 + g_wave 乒乓），已完全死代码** | ① 当前 `CMakeLists.txt` 的 `task_root` 只含 `app.c`/`app_lvgl.c`，`app_tasks.c` **不在任何 target**；② 最终链接 `build/Debug/G2026.map` 中 `app_tasks` 引用数 = **0**；③ 它调用的 `app_lvgl_run()` **全仓无定义**（这正是它被踢出构建的原因） | 高：误导后续判断（以为架构是 4 任务），且是一处"编译不进、看着却像活的"陷阱 |
| **SB2** | **孤儿宏**：`BOARD_TIM8_ARR_AUDIT=89`（审计帧 fs=1.6MHz）声明后**无任何代码读** | `grep` 全仓仅 `board_config.h` 一处 | 中：双帧变频功能实为未实现；违反 board_config.h 自己写的"孤儿宏=最难查的静默失效" |
| **SB3** | **孤儿宏且与实现矛盾**：`BOARD_ADC_BUF_COUNT=2U` 注释写"双缓冲"，但 engine 实际是**单缓冲** `s_adc_buf[OP_DSP_N]` | `app_engine.c:16`；软件文档 §4 明确"单缓冲" | 中：宏与实现互相打脸，读者无从判断哪个是真 |
| **SB4** | **文档数字互相矛盾（=HB3）**：软件文档 §6/§10 与 `report_dsp_verify.md` 仍写混叠残留 0.655mV / 余量 7.5×，与硬件裁定 1.309mV / 3.8× 冲突 | `verify_afe_v2_report.md` §4 | 高：验收/竞赛报告若引用会出错 |
| **SB5** | **"采样窗静默"（O1）文档已采纳、代码未实现**：硬件 `02 §6` O1 要求 engine 采样窗内暂停 LVGL/FSMC 刷新与触摸轮询；当前 `app_poll_at()` 同拍跑 engine 与 ui/lvgl，ADC 转换期间屏仍在刷 | `app.c:344-351`；全仓无相关门控代码 | 中高：板内最大干扰源（采集瞬间 LCD 总线噪声）未被机制性消除 |
| **SB6** | **标定流程忙等阻塞**：`app_engine_cal_step()` 用 `while (bsp_adc_poll_done()==0);` 忙等 ~40ms，且注释自认"只能从 LVGL 按钮回调里调" | `app_engine.c:189-197` | 中：标定时 UI 卡顿，与"拆两拍保 60fps"的初衷冲突 |
| **SB7** | **干扰场景无 C 侧回归测试**：`Test/test_op_meas.c` 只覆盖 S1~S4（**无干扰**）；S5~S12（u_J 抑制，第 3 项最易翻车的链路）只存在于 Python 模型 `verify_dsp.py` | `test_op_meas.c` 场景标记；`verify_dsp.py:261-272` | 中高：C 实现的干扰抑制无回归保护 |
| **SB8** | **LVGL 像素搬运为同步 FSMC 直写、无 DMA**：整帧 320×480×2B≈300KB，写吞吐约 18MB/s ⇒ 整帧 ≈17ms | `app_lvgl.h` 说明；`board_config.h` FSMC 时序注释 | 中：CPU 占用与帧率的天花板；当前靠"帧率不敏感+背光恒亮"扛住 |
| **SB9** | **全部 Device 层未上板验证** | `board_config.h` 多处"编译绿·待上板"；`README` 现状 | 高：最大一类"未验证" |
| **SB10** | `app_ui.c` 708 行，四页面状态机 + LVGL 全挤在单文件 | `wc -l` | 低：可维护性 |

---

## §4 优化目标（量化）

| 维度 | 现状 | 目标 | 达成手段 |
|---|---|---|---|
| 判据余量（幅值 5mV） | 3.8×（RSS 1.31mV） | **≥5×**（可选 7.8×/21.9×/30×） | 文档回填（SB4）+ 可选 Plan B / 双帧 |
| 架构一致性 | 双轨（1 套死代码） | **单轨，0 死代码 / 0 孤儿宏** | SB1/SB2/SB3 |
| 文档一致性 | ≥1 处数字冲突 | **0 处"文档与实现不符"** | SB4 + `doccheck` |
| 测试覆盖 | C 侧 S1~S4 | **C 侧 S1~S12 全覆盖** | SB7 |
| 实时性 | 全链 <25ms（2s 余量 50×+）；标定卡 UI | 判据余量 ≥50× 且**标定不卡 UI**；采样窗静默 | SB5/SB6 |
| 可验证性 | Device 层全"未验证" | **上板验收清单 100% 过** | 阶段 2 上板 |

---

## §5 硬件优化措施

### P0 — 阻断闭环，必须先做

| # | 措施 | 具体动作 | 预期收益 | 验证动作 |
|---|---|---|---|---|
| **H1** | **补齐打样前三项遗留** | ① CTP FPC-6P 脚序对实物核实（丝印/万用表通断）；② PC5 改 `GPIO_Input`（**GUI 清单，人做**，R6）；③ 天空星 P1/P2 排针物理映射锁定 | 消除"上板才发现接错"的返工 | `04 §4` 三项一致性自检 |
| **H2** | **PCB 落图（建议 4 层）** | 待 [TBD-6] 拍板；建议选 4 层完整 GND 平面 | mV 级模拟与 FSMC 共板根治回流/EMI（降 R4/R5）；**唯一能进入制造与标定闭环的路径** | 嘉立创 DRC + BOM 复核 + 下单 checklist |
| **H3** | **混叠残留口径澄清（原 =SB4）** | ✅ **已完成，但结论与原计划相反**：不是"0.655 → 1.309"，而是确认 **0.655mV 正确**（输入端域），1.309mV 是 ADC 端域 —— 原判是跨参考点比较。已更正硬件报告 §4 + 登记 R1 关闭 | 消除"虚高 7.5×"的误判；余量 7.5× **维持** | 重跑 `tools/verify_dsp.py`，数字直接回填 |

### P1 — 提升余量 / 降低风险

| # | 措施 | 具体动作 | 预期收益 |
|---|---|---|---|
| **H4** | 测试点×6 + 0Ω 断点×3 落到 PCB | O3/O8 已入 BOM，需在 PCB 上布 | 扫频标定与分治排障的物理基础 |
| **H5** | LC 电感选型卡死 + 实物抽测 | 规格 SRF≥12MHz / DCR≤0.5Ω / Isat≥50mA；到货抽测 SRF | 锁死 R2；不合格即触发 Plan B |
| **H6** | 布局约束落地 | O4 电感正交+≥2mm；O6 AFE 分区+单点地；O7 FSMC 33Ω 串阻+降速余量 | 降 R4；EMI 源头治理 |
| **H7** | 无源/防护件定案 | TVS ≤5pF 选型号；50Ω 端接/负载 1%；信号路径全 C0G/NP0 | 锁死 `03-components.md` #8/#10 的 TBD |

### P2 — 余量拉满（触发条件制，不在当前计划内）

- **H8 = 方案 B（Cauer n=6）**：触发条件 = 板到手扫频实测残留 > 预算，或竞测发现 u_J 伪峰。
- **H9 = 方案 C（双帧变频）**：挂「精度拉满」。⚠️ **注意口径统一**：`report_opt.md` 用的是 K71/K73（2.0282/1.9726MHz），而 `board_config.h` 预留的 `BOARD_TIM8_ARR_AUDIT=89` 对应 K90（1.6MHz）——**两者不一致**，启用前必须先统一。
- **H10 = 方案 D（可编程增益）**：**[OPT] 不做**，除非现场信号超出现有满量程（±225mVpk）。

---

## §6 软件优化措施

### P0 — 清死代码 / 消矛盾（零风险，纯收益）

| # | 措施 | 具体动作 | 预期收益 |
|---|---|---|---|
| **S1** | **删除死代码（=SB1）** | 删 `Task/Src/app_tasks.c` + `Task/Inc/app_tasks.h`；清 `build/` 下 stale `.obj`；核对 `app.h`/文档中对它的引用 | 架构单轨；消除"4 任务 vs 轮询"认知陷阱；减 ~290 行 |
| **S2** | **消孤儿宏（=SB2/SB3）** | `BOARD_TIM8_ARR_AUDIT`：按 board_config 自己的闸门范式加 `#if`/`#error` 声明"功能未实现"，或删除；`BOARD_ADC_BUF_COUNT`：改为 1 或删除 | 消除静默失效源；宏与实现一致 |
| **S3** | **修文档数字（=SB4/H3）** | 重跑 `tools/verify_dsp.py` → 回填软件文档 §6/§10 与 `report_dsp_verify.md` | 0 处数字冲突 |

### P1 — 正确性回归 / 实时性

| # | 措施 | 具体动作 | 预期收益 |
|---|---|---|---|
| **S4** | **补 S5~S12 干扰单测（=SB7）** | 用 `verify_dsp.py` 的 S5~S12 场景，以桩输入数组搬进 `Test/test_op_meas.c`（软件文档 §12 已要求） | 干扰抑制链路获得 C 侧回归保护 |
| **S5** | **落地"采样窗静默"（=SB5/O1）** | engine 在 `ENG_ACQ` 期间置标志，`app_poll_at()` 该拍跳过 `app_ui_poll`/`app_lvgl_poll`（或延后 flush） | 机制性消除板内最大干扰源（LCD 总线噪声灌进 AFE） |
| **S6** | **标定流程去忙等（=SB6）** | 把 `app_engine_cal_step()` 的单点测量改为态机（复用 `ENG_ACQ`/`PROC_*`），UI 只发起不阻塞 | 标定时 UI 不卡；不破坏 60fps 节拍 |

### P2 — 性能 / 可维护性（建议缓做）

| # | 措施 | 说明 | 建议 |
|---|---|---|---|
| **S7** | LVGL 刷屏提吞吐（=SB8） | FSMC 扩展模式（AccessMode D，写 27.8ns/字）或 DMA2 内存→FSMC | **缓做**：当前帧率不敏感；改 FSMC 参数须走 GUI（人做）+ 时序重验，等实测 UI 卡顿再动 |
| **S8** | `app_ui.c` 拆分（=SB10） | 四页面状态机拆文件/函数组 | **缓做**：UI 未稳定前拆，改一次动一次 |
| **S9** | Device 层上板验收清单（=SB9） | 复用 `app_self_test()` 的 9 项，逐项标注三态 | 阶段 2 执行 |

---

## §7 实施路线图

```
阶段 0（今天 · 零成本 · 纯软件/文档）
  S1 删死代码 · S2 消孤儿宏 · S3 修数字矛盾 · S4 补干扰单测 · H3 预算回填
  门禁：build --clean-first / test / lint / doccheck  四绿

阶段 1（打样前 · 人拍板 + 人做 GUI）
  H1 三项遗留 · H2 PCB 落图(4层, 待拍板) · H5 电感/电容/TVS 选型 · H7 防护件定案
  门禁：DRC + BOM 复核 + 下单 checklist

阶段 2（打样到货 · 上板）
  H4 测试点/断点 · S5 采样窗静默 · S6 标定去忙等 · S9 上板验收
  → 扫频标定（软件文档 §11）→ 实测残留 → 裁定是否启用 H8 Plan B
  门禁：fw.py verify / 标定残差 ≤0.023mV

阶段 3（可选 · 触发条件制）
  H8 Cauer / H9 双帧变频（先统一 K 口径）
```

**依赖关系**：S1~S4/H3 与硬件无关，**立即可做**；H2 是 H4/H5/H6 与整个标定闭环的前置；S5/S6 属上板调优，依赖阶段 1 完成。

---

## §8 预期收益汇总

| 措施组 | 收益（量化） |
|---|---|
| S1+S2+S3 | 减 ~290 行死代码；0 孤儿宏；0 文档数字冲突 |
| S4 | C 侧测试覆盖 S1~S4 → **S1~S13**（+9 场景，含全部 u_J 干扰场景） |
| S5 | 机制性消除采集窗内 LCD 总线对 AFE 的干扰 |
| S6 | 标定期间 UI 不卡；节拍一致性保持 |
| **S13**（新发现） | **Upp 重建抽点密度自适应**：大阶次（m=50）系统性误差 **−1.75mV → −0.002mV**，判据余量 +35% |
| H2 | 从"原理图"进入"可制造"，标定兜底机制闭环 |
| H3 | 混叠残留口径澄清：**余量 7.5× 维持**（原以为要降到 3.8×） |
| H8（触发制） | 余量 7.5× → **15.6× / 49×**，且少一个电感 |
| H9（触发制） | **裁定不做**（见 §11）：精度收益≈0，代价最大 |

---

## §9 风险与待人拍板项

| # | 项 | 类型 | 说明 |
|---|---|---|---|
| T1 | **底板层数 2 层 vs 4 层** | [TBD-6] 待拍板 | 建议 4 层；差价量级几十元，下单前复核 |
| T2 | **PCB 是否落图** | 待拍板 | 不落图则 H4~H7 与标定闭环全部悬空 |
| T3 | **PC5 改 GPIO_Input** | R6 需人批准 + GUI 操作 | 否则 FT6336 INT 与 MCU 输出对打 |
| T4 | **CTP FPC-6P 脚序** | 需对实物核实 | 落图前必须确认 |
| T5 | **H8 是否启用** | 触发条件制 | 取决于上板实测残留；H9（双帧变频）已**裁定不做**（见 §11.3），若要拉余量走 H8 硬件路线 |
| T6 | **S7/S8 是否做** | 建议缓做 | 等实测 UI 性能与稳定性数据 |

---

## §11 实施进展（2026-09-28）

> 门禁（每轮实测）：`build --clean-first` **零告警** · `test` **5/5** · `lint` · `doccheck` · `sizecheck` **全绿**。
> RAM 81.6KB/128KB（门禁上限 96KB）· CCM 32KB/64KB · FLASH 531KB/1MB。

### 11.1 第一轮：FreeRTOS 真多任务

| 原编号 | 事项 | 状态 | 落地内容 |
|---|---|---|---|
| **SB1** | 架构双轨死代码 | ✅ **已消除** | `app_tasks.c/h` 重写为"任务创建"模块（旧 4 任务骨架全删），**接回构建**（`task_rtos`）；陈旧 `.obj` 已清 |
| **SB2** | 孤儿宏 `BOARD_TIM8_ARR_AUDIT` | ✅ **已删** | 改为注释留痕（指向本方案 H9），不再有"翻成 1 无反应"的静默失效源 |
| **SB3** | 孤儿宏 `BOARD_ADC_BUF_COUNT` | ✅ **已删** | 注释写明"单缓冲及其理由"，宏与实现不再互相打脸 |
| **SB5** | 采样窗静默（O1） | ✅ **2026-10-02 才真正实现** | 原先只有"UI 循环头看 `s_acquiring` ⇒ `vTaskDelay`"，**挡不住已经开始的 flush**（9ms ≫ 2.048ms 窗）。现改为 **LCD 总线闸**：engine 开采集前 take、采完 give；写屏侧每 `APP_LCD_CHUNK_PX`(1024px≈0.6ms) take/give 一次（`bsp_lcd_bus_take/give`，互斥量带优先级继承）|
| **SB6** | 标定忙等 | ✅ **已改** | `while` 自旋 → **阻塞等帧信号量**；标定仍在 UI 任务里同步跑（异步版待做） |
| — | **FreeRTOS 真多任务** | ✅ **新增** | `Task_Engine`(26) / `Task_Ui`(23) 用 `xTaskCreateStatic` 建（栈/TCB 静态）；帧**二值信号量**（ISR 给）+ **任务通知**（重测）+ **结果 mailbox**（1 深队列 = 跨任务双缓冲） |
| — | 并发保护（自查发现） | ✅ **已修** | 标定（UI 任务）与周期测量（engine 任务）**共用**同一批静态 DSP 缓冲，engine 抢占会写坏标定数据 → 加 `s_buf_busy` 互斥标志 |

### 11.2 第二轮：测试覆盖 + 精度修复 + 口径澄清

| 任务 | 状态 | 落地内容与实测数字 |
|---|---|---|
| **B** 补 S5~S12 干扰单测 | ✅ **已完成** | `Test/test_op_meas.c` 新增 u_J 场景（含前端 LPF 幅频模型 `bw8_mag`，与 `verify_dsp.py` 同式，不硬编码数字）。**实测**：S5~S8/S10~S12 镜像**零伪峰**、\|ΔUpp\| ≤ 0.016mV；S9 最坏点读数偏 **−0.652mV** |
| **S13** 重建抽点密度（**本轮新发现**） | ✅ **已修** | 单测暴露 `OP_MEAS_REBUILD_PTS=512` 在 m=50（10k 基波 + 500k 分量）时 Upp 偏 **−1.75mV**；改为按 m_max 自适应（`max(512, 32·m_max)`，上限 4096），实测 **−0.002mV**。S13 成为回归保护 |
| **SB4** 混叠残留数字 | ✅ **已澄清（结论与原计划相反）** | **不是**"0.655→1.309"，而是 **0.655mV 正确**：两者参考点不同（输入端 vs ADC 端，比值 = 4增益×0.5端接 = 2），而预算表与门限同在输入端域。已更正 `verify_afe_v2_report.md` §4、关闭硬件风险 R1 |
| **A** 任务栈余量可观测 | ✅ **代码就绪**（读数待上板） | `app_tasks_report_stack()` + `APP_STACK_REPORT_MS=10s` 一次性上报；`uxTaskGetStackHighWaterMark` 打印两任务剩余栈（word + B） |

### 11.3 H9 双帧变频：**裁定不做**（量化理由）

| 项 | 数字 / 事实 |
|---|---|
| 声称收益 | 残留 1.31mV → ~0.1mV，余量 3.8× → 30× |
| **实际收益** | **≈0**。① 镜像残留实测只有 **0.652mV**（输入端），对 5mV 判据余量 **7.6×**，本来就达标；② "镜像落点无真分量"的情形，**固定 1.5mV 门限已完全剔除**（S5~S8/S10~S12 实测 \|ΔUpp\| ≤ 0.016mV）；③ "镜像恰落在真分量上"（S9）**同频无法用频率分离**，只能靠幅值启发式（取两帧较小者），而镜像可加可减 ⇒ **启发式不成立** |
| 代价 | 冻结的 DSP 链要改（§5/§6 重写 + `verify_dsp.py` 全重跑）；采集 2×（~30ms，仍 ≪2s）；+8KB RAM；新增跨帧匹配的失效模式 |
| **触发条件**（若将来要做） | **只有**板到手扫频标定后实测混叠残留 > 1.5mV 门限（即 LC 实际衰减差于 −42dB）才值得做；否则优先走**硬件** Plan B（Cauer） |

> **一句话**：H9 治的是"前端不达标"的病，但**药在硬件**（Plan B / 把 LC 做好）。
> 同样一笔投入，本轮在**软件侧**改掉的 Upp 重建格点误差（−1.75mV）比 H9 的全部收益还大。

### 11.4 本轮明确未做（诚实标注）

- **采集侧乒乓双缓冲**：门控采集下生产者 2.048ms/帧 vs 消费者 DSP ~13ms/帧（快 6 倍），
  双缓冲只会让新帧盖掉未处理完的旧帧 —— **无收益**（理由已写进 `app_engine.h`）。
- **SB7 已完成**（S5~S12 已补）；**SB8 LVGL DMA 化 / SB10 `app_ui.c` 拆分**：按 §6 P2 缓做。
- **A 的上板读数**：AI 不烧录（工作台铁律 2），需人上板跑 ≥10s 后看 RTT 的 `[STACK]` 行。

---

## §10 变更记录

| 日期 | 变更 | 谁 |
|---|---|---|
| 2026-09-28 | v1 初稿：硬件 HB1~HB8 / 软件 SB1~SB10 现状清单 + 目标 + 措施 + 路线图 | AI（待 [CHK] 人确认） |
| 2026-09-28 | 增 §11 实施进展：SB1/SB2/SB3/SB5/SB6 已落地 + FreeRTOS 双任务改造；门禁五道全绿 | AI（待 [CHK] 人确认） |
| 2026-09-28 | 第二轮：SB7（S5~S12 干扰单测）完成；**新发现并修复 Upp 重建抽点密度不足（−1.75mV→−0.002mV）**；SB4 澄清为跨参考点比较（0.655mV 正确，余量 7.5× 维持）；**H9 双帧变频裁定不做**（收益≈0、代价最大）；A 栈余量上报代码就绪 | AI（待 [CHK] 人确认） |
