funiang-x/G2026/docs/03_LVGL刷屏优化评估-20261014.md

# 03 · LVGL 刷屏优化评估 —— 对照 CSDN《DMA+FSMC 驱动 TFT 屏》（2026-10-14）

> **性质**：技术评估（外部方案 → 本工程适用性 → 逐条量化判定）。阶段二才动代码。
> **状态**：**结论待 [CHK] 人确认**；本文**未改任何代码**。
> **被评估对象**：CSDN 博客《STM32F4标准库下，用DMA+FSMC驱动TFT屏，让你的LVGL界面刷新快人一步》
> （`https://blog.csdn.net/weixin_31476015/article/details/161699653`，作者 Ron.王靖渝，2026-08-30；正文已抓取全文）。
> **三态口径**（沿用工作台铁律 1）：本文每个数字分三类 ——
> **已实测**（附来源文件/行号或 RTT 记录）/ **已推算**（成本模型算出，标"推算"）/ **未验证**（没做过，标"未验证"）。
> 凡"某方案能带来多少收益"一律是**上限推算**，不是实测；未做过的实现细节不作承诺。

> ## ★★ v1.1 修订（2026-10-14 同日，触发 = 用户现场观察）
>
> **用户观察**：「全屏滑动的时候，屏上那个控件（sysmon 的 CPU%）也达到了接近 100。」
>
> **v1.0 错在哪**：它把"DMA 收益上限"锚在**静屏**负载（59 kpx/s ⇒ 0.59%），
> 又把"极端上界"锚在 **10 Hz** —— 那是**数据率**（`APP_MEAS_PERIOD_MS`），
> 而全屏滑动时每个动画帧**整屏 153,600 px 全脏**、动画帧率是 **~50 fps** ⇒ **低估 5 倍**。
> ⇒ 正确的滑动口径是 **flush 占墙钟 59~77%**（§5.1）。
>
> **本节以下结论一律以"分场景"为准**（静屏 / 全屏滑动），不再有单一的"收益上限"。

> ## ★★ v1.2 实测裁决（2026-10-14 同日，触发 = 用户按 C4 抓回的 RTT）
>
> **v1.1 的 59~77% 也被实测推翻 —— 这次错在"帧率"**：v1.1 沿用项目文档的"滑动 ~50 fps"估计，
> 而**实测滑动只有 7~16 fps**。实测结果（§5.6）：
>
> | | flush÷handler | handler 占墙钟 |
> |---|---|---|
> | 静屏 | 1.5% | 29.7% |
> | 滑动（最快那一窗） | **26.0%** | **87.6%** |
>
> ⇒ **滑动的主成本是软件渲染（64.8% 墙钟），写屏只占 22.8%** ⇒ **裁决：不做 DMA**
> （理由**换了**：v1.0 说"flush 太小"用的是静屏口径；实测说"**写屏只占 23%、渲染占 65%，且双缓冲装不进 RAM**"）。
> ⇒ **下一个靶子是渲染侧，而且已有具体嫌疑人**：滑动时 **LVGL 堆近乎耗尽**（`heap free` 1910 → 189 → **1**，静屏 19100）。

> ## ★ v1.4 候选人被否（2026-10-14 同日，触发 = 用户烧了 C5 的 B 版）
>
> **C5 的嫌疑人被 A/B 证伪并已回退**（§5.7）：把 `LV_DRAW_LAYER_SIMPLE_BUF_SIZE` 从 24 KB 改到 8 KB，
> 上板读数**逐项相同**（`heap free` 1 B / `handler` 88.6% / 16.2 fps / `flush÷handler` 25.9%）。
> **原因查清了，不是"改了没用"，是"这条路径根本没被走到"** —— 该宏只对 `style_opa<255` / 非 NORMAL blend 生效，
> 而本 UI **只有 `bg_opa` / `border_opa`**、**没有任何触发 simple layer 的控件** ⇒ 它是**死配置**。
>
> ⇒ **下一个动作不是"照 `heap free` 去调池"，而是先确认那个读数是不是真的（§6.2 C6）**：
> 若真只剩 1 B，下次分配必然失败并打 ERROR，而**整份日志 0 条 `[E]`/`[W]`**。

---

## §0 一句话结论（**v1.2：以上板实测为准**）

**博客 9 条里，本工程"已做且更深"3 条、"不适用/有害"4 条、"条件采纳"2 条。**

**实测裁决（§5.6，2026-10-14）——两个场景的 `flush ÷ handler`：**

| 场景 | `flush` 占墙钟 | 写屏 ÷ handler | 谁是大头 | 裁决 |
|---|---|---|---|---|
| **静屏**（页 0 + 悬空） | 0.44% | 1.5% | 渲染 | **不做 DMA** |
| **全屏滑动**（最快一窗，16.2 fps） | **22.8%** | **26.0%** | **软件渲染 64.8%**（写屏 22.8%） | **不做 DMA；转渲染侧** |

⇒ **主结论（v1.2）**：
1. **不做 DMA**（三个版本的理由不同，见 §8：v1.0 用静屏口径、v1.1 用推算、**v1.2 用实测**）。
   实测依据：滑动里**渲染是写屏的 2.8 倍**（每帧 `render ≈40.0 ms` vs `flush ≈14.1 ms`）；且**双缓冲装不进 RAM**（§5.5 ②）。
2. **两个场景都不是"写屏瓶颈"** ⇒ 博客 B2/B3/B4/B5 在本工程**始终不适用**。
3. **滑动确实是残留缺口**（帧率 7~16 fps、sysmon CPU 87.6%、`>33 ms` 掉帧桶占 10~18%），
   但**该啃的是渲染**（每帧 render 40 ms vs flush 14 ms）。
4. **两个候选靶子已被否掉**：`LV_DRAW_LAYER_SIMPLE_BUF_SIZE` 是**死配置**（A/B 逐项不变，§5.7）；
   "**滑动把 LVGL 堆吃干**"是**日志截断造出来的假象**（真值一直 18.9 KB 空闲，§5.9 A）。
5. **★ 新发现的第三个靶子（也是本轮最有价值的）**：滑动窗口回归给出
   `handler = 38.0 ms/帧 × 帧率 + 253 ms/s` —— 那 **253 ms/s（25.3% CPU）与画了几帧无关**，
   而且**静屏时也在**（**静屏 `handler 29.7%` 几乎全是它，不是渲染**）
   ⇒ 新登记 **C7**（§5.9 B / §6.2）。**它之前从来没被看见过。**

**最硬的一条论据**：博客自报"DMA 方式整屏 8 ms"（320×240）⇒ **9.6 Mpx/s**；
而本工程**没有 DMA 的 CPU 直写**实测 **100 ns/字 ≈ 10 Mpx/s**（`bsp_lcd.c:91`）——
**本工程现有的直写实现，已经达到了该文 DMA 方案的吞吐水平。**
该文真正的收益来自"把逐像素函数调用的写法换成批量搬运"（其"传统方式"隐含 ≈0.38 Mpx/s），
那一步本工程在 2026-10-13 之前就跨过了。

---

## §1 事实来源与口径

| 类别 | 单一真相源 |
|---|---|
| 板级事实（引脚/时钟/FSMC 时序/内存落点） | `firmware/Core/Inc/board_config.h` |
| 应用参数（周期/开关/分块粒度） | `firmware/project_config.h` |
| 屏链路实现（命令/像素/总线闸） | `firmware/Device/Src/bsp_lcd.c` · `firmware/Device/Inc/bsp_lcd.h` |
| LVGL 适配层（显示/触摸/flush） | `firmware/Task/Src/app_lvgl.c` · `firmware/Task/Inc/app_lvgl.h` |
| LVGL 配置（v9.5） | `firmware/Middlewares/LVGL/lv_conf.h` |
| DMA 占用现状 | `firmware/Core/Src/adc.c` · `firmware/Core/Src/dma.c` · `firmware/G2026.ioc` |
| 体积门禁口径 | `firmware/Tools/stm32_size.py` 的 `BUDGETS` |
| 上板实测记录（本轮引用的原始日志判读） | `_work/lvgl_perf_20261014/` 下各篇 |
| 屏的 0x2C 写地址复位（本屏专属行为） | `hardware/65-屏8080写地址复位-根因与修复-20261012.md` |

**同主题前序工作**（本文不重复它们的结论，只在其上增量）：
- `_work/lvgl_perf_20261014/帧率与波形流畅度-优化方案.md` —— 七轮 T0–T3，**渲染侧**优化并上板实测。
- `_work/lvgl_perf_20261014/外部优化文章对照.md` —— 对照 CSDN《LVGL 在资源受限 MCU 上的性能优化》（v8 时代文章），净增量 0。
- `_work/lvgl_perf_20261014/外部文章对照-多核并行渲染.md` —— 对照 CSDN《LVGL 多核处理》，前提不成立，净增量 0。
- `_work/lvgl_perf_20261014/滑动流畅度优化方案.md` —— **滑动场景**的成本模型（"整屏每帧全脏" / flush 物理下限 / ~50 fps 上限）；**v1.1 修订的主要依据**。
- `_work/lvgl_perf_20261014/无信号画直线-上板结果.md` —— 11:12 上板日志判读（静屏口径的基线）。
- 本文是**第三篇**外部文章对照，评估对象是**DMA + FSMC 刷屏**这一条路线。

---

## §2 被评估方案（逐条拆解）

原文以 ILI9341 + STM32F4 **标准库**为背景，共 9 条可操作内容：

| # | 博客的主张 | 原文关键参数 |
|---|---|---|
| B1 | FSMC 时序优化 | `AddressSetupTime=1 / AddressHoldTime=0 / DataSetupTime=5 / AccessMode A`；建议逻辑分析仪微调 |
| B2 | DMA2 引擎调优 | `DMA2_Stream3`、`MemoryToMemory` 方向、`PAR=源`、目标固定 `&LCD->RAM`、HalfWord、Normal、`Priority_High`、`FIFOMode_Enable`、`FIFOThreshold_HalfFull`、`MemoryBurst_INC4`、`PeripheralBurst_Single`、开 TC 中断 |
| B3 | `LCD_DMA_Transfer(x1,y1,x2,y2,color)` 封装 | 开窗 → 关 DMA 并等 `DISABLE` → 设 `NDTR`/`PAR` → 清 TC → 使能 |
| B4 | **异步 flush** | `disp_flush` 发起 DMA 后**不立即**调 `lv_disp_flush_ready`，改到 **DMA 完成中断**里调（让 CPU 在搬运期间渲染下一块） |
| B5 | **双缓冲 + 局部缓冲** | `buf1/buf2` 各 `LCD_HOR_RES*10`，`lv_disp_buf_init()`；文中提示"频繁更新小区域时用双缓冲避免等 DMA" |
| B6 | 性能监控 | `#define LV_USE_PERF_MONITOR 1` |
| B7 | 实测收益表 | 静态 42→45 fps · 列表 18→36 · 复杂动画 9→24 · 全屏渐变 5→18；CPU 最高 97%→41% |
| B8 | 常见问题排查 | 花屏三因（FSMC 时序不匹配 / DMA 传输未完成 / 缓冲区地址需 4 字节对齐） |
| B9 | DMA 性能检查清单 | 最高优先级通道 / 启用 FIFO / 验证内存突发 / 测总线带宽利用率 |

> ⚠️ 原文自身的一处技术提示（抓取时即已标注）：B2 把 DMA 方向写成 `MemoryToMemory`、同时把**源地址写进 `PAR`**、目标固定为 `&LCD->RAM` —— 与"内存→外设"的常规写法在语义上交叉。**照抄前必须按其标准库版本核对**：本工程用的是 HAL（`HAL_SRAM_Init` + FSMC 写窗口），DMA 侧要走 `DMA_MEMORY_TO_PERIPH`（外设侧 = FSMC 数据窗口地址、不自增；内存侧 = draw buffer、自增）。

另有一条原文**未涉及**：编译选项（Keil/IAR/GCC 优化等级、`.ramfunc` 段）。本工程的实际取值见 §3.2。

---

## §3 本工程现状（代码级事实）

### 3.1 链路（一句话）

LVGL 9.5 渲染到 draw buffer（SRAM1）→ `lcd_send_color()` 分块 → `bsp_lcd_write_pixels*()` 用 CPU **同步直写** FSMC 8080-16bit 窗口 → 写完才调 `lv_display_flush_ready()`。

| 环节 | 现状 | 出处 |
|---|---|---|
| 屏 / 接口 | ST7796S 320×480 · FSMC Bank1(NE1) · RS=A16 · 16 位并口 | `board_config.h:394-505` |
| FSMC 时序 | `AddressSetupTime=2 / DataSetupTime=8 / AccessMode A / ExtendedMode DISABLE` ⇒ 写周期 11 HCLK = **76.4 ns/字** ⇒ **26.2 MB/s** ⇒ 整屏 11.7 ms | `fsmc.c:62-69` · `board_config.h:473-480` |
| 写吞吐（实测） | **100 ns/字 ≈ 10 Mpx/s**（BTR 理论 76.4 ns，多出来的是循环与 AHB 开销） | `bsp_lcd.c:91` |
| 字节序 | 搬运循环里逐字交换：`LCD_DAT_WR = (p[1]<<8) \| p[0]`（成本 3~4 周期/字，相对 100 ns 总线周期"白送"） | `bsp_lcd.c:176` · `bsp_lcd.h:70-73` |
| 颜色格式 | `LV_COLOR_FORMAT_RGB565`（**原生**，非 `_SWAPPED`） | `app_lvgl.c:486` |
| 渲染模式 / 缓冲 | `LV_DISPLAY_RENDER_MODE_PARTIAL` + **单** draw buffer `480×56×2` = 53760 B @SRAM1 | `app_lvgl.c:489-490` · `project_config.h:54` |
| 分块 + 总线闸 | 每 `APP_LCD_CHUNK_PX=1024` px 抢一次 `bsp_lcd_bus_take()`；**只有第一块发 `0x2C`** | `app_lvgl.c:134-166` · `project_config.h:128` |
| flush 完成 | **同步**：搬运返回后立刻 `lv_display_flush_ready()` | `app_lvgl.c:187` |
| 重绘周期 | 10 ms（`refr_timer`）⇒ sysmon FPS 上限 100 | `app_lvgl.c:515-520` · `project_config.h:87` |
| 内存池 | 32 KB @CCM 高半 + 4 KB @SRAM1（第二块池） | `board_config.h:603-621` |
| LVGL 线程模型 | **`LV_USE_OS = LV_OS_NONE`**，契约 = **LVGL 只能由 UI 任务访问** | `lv_conf.h:125-135` |
| 性能监控 | `LV_USE_SYSMON=1` + `LV_USE_PERF_MONITOR=1`（右下角浮层，产品要求）；`LV_USE_MEM_MONITOR=0` | `lv_conf.h:1139` / `1154` / `1169` |
| DMA 占用 | **只有 ADC1 → DMA2_Stream0 / Channel 0**（循环模式，固定映射，不能换流）；DMA2_Stream1~7 与 DMA1 全空闲；I2C2 / SPI1 **均未用 DMA** | `adc.c:111-126` · `dma.c:39-50` · `board_config.h:387` · `G2026.ioc` |

### 3.2 最新上板基线（2026-10-14 11:12，**已实测**）

| 指标 | 实测值 | 出处 |
|---|---|---|
| `[UI] 1s` 间隔分布 ≤12/≤20/≤33/>33 | **100 / 0 / 0 / 0**（零掉拍） | `_work/lvgl_perf_20261014/无信号画直线-上板结果.md:11` |
| `[UI] 1s` 最大间隔 | 12 ms | 同上 `:12` |
| `[UI] 1s` 分段 LVGL 峰值 | 9 ms | 同上 `:14` |
| `[LVGL] diag` px/s | 59,395 | 同上 `:15` |
| `[LVGL] diag` handler | 28.9%（1444 ms/5s，其中 S4 触摸 100 Hz 约 +8.3%） | 同上 `:17` · `:50-59` |
| DSP 段 | 9.36 ms | 同上 `:18` |
| RAM / 门禁 | **112,272 B（85.66%）** · CCMRAM 32,768 B（50%）· FLASH 524,252 B（50.00%）· 门禁 RAM 120 KB ⇒ **余量 ≈10.4 KB** | 本文实跑 `fw.py sizecheck` 退 0（2026-10-14）；历史同量级记录见 `_work/lvgl_perf_20261014/S1-S6-实施记录.md:73-82` |
| 构建档 | 快档 `-O2`（RelWithDebInfo，渲染侧实测 1.2×）；门禁档 Debug | `_work/lvgl_perf_20261014/帧率与波形流畅度-优化方案.md:164` |

### 3.3 三条硬约束（决定任何外部方案能不能落）

1. **采样窗静默（O1）**：engine 采样窗 2.048 ms 内 FSMC 一次都不许动，靠 `bsp_lcd_bus_take/give` 的**块级**互斥落地（engine 开采集前 take、采完 give；写屏侧每 1024 px take/give 一次）。见 `bsp_lcd.h:92-109`、`app_engine.c:142`、`project_config.h:115-133`。
2. **本屏每收到一次 `0x2C` 就把写地址复位到窗口起点**（2026-10-12 上板实测）⇒ 一次窗口只许发一次 `0x2C`，分块续写必须走 `_cont` 版本。见 `hardware/65`、`bsp_lcd.c:147-158`。
3. **内存余量 ≈10.4 KB**（门禁 120 KB − 实测 112,272 B）⇒ 任何"再加一块缓冲"的想法都要先过这笔账。

### 3.4 顺带查清：sysmon 那个 CPU% 量的是什么（用户的判据锚在它身上）

```
lv_timer.c:131    state_p->busy_time += lv_tick_elaps(handler_start);   /* 每次 handler 返回，累加整段墙钟 */
lv_timer.c:134    state_p->idle_last = (state_p->busy_time * 100) / idle_period_time;  /* busy% */
lv_timer.c:135    state_p->idle_last = ... ? 0 : 100 - state_p->idle_last;             /* 转成 idle */
lv_sysmon.c:273   info->calculated.cpu = 100 - LV_SYSMON_GET_IDLE();                  /* 屏上显示的就是 busy% */
```

⇒ **它 = `lv_timer_handler()` 的累计墙钟 ÷ 窗口墙钟**。而本工程的 **flush 回调（CPU 直写 FSMC）就在 handler 里面**
⇒ **这个数含写屏，且不区分"渲染"与"写屏"**。
⇒ 所以"滑动时它接近 100"的含义只是"**UI 任务被 handler 占满、没时间睡**"；
**不能**据此判断是渲染慢还是写屏慢 —— 要分解必须看 `[LVGL] diag` 的 `flush µs` 与 `handler µs`（§6.2 C4）。

---

## §4 逐条判定

判定用词：**已做**（本工程已实现且更深）/ **不适用**（前提不成立）/ **不采纳**（有害或收益不划算）/ **条件采纳**（登记，需人拍板）。

| # | 判定 | 依据（量化） |
|---|---|---|
| B1 FSMC 时序 | **不采纳（照抄会违规）** | 原文 `AS=1/DS=5` ⇒ 7 HCLK = **48.6 ns**（本工程 144 MHz）⇒ **低于本屏 TWC(min) 66 ns**（`board_config.h:481-482` 引屏 spec §7.4.1），更是远低于现有 76.4 ns 的 16% 余量。本工程现行值是按"33Ω 串阻 + 排线负载"留余量后定的（`board_config.h:477-480`）。**提速正路是扩展模式，但属 `.ioc`（人做）** ⇒ 见 §6-C1 |
| B2 DMA 引擎配置 | **写法存疑，不能照抄** | `MemoryToMemory` + 源写 `PAR` + 目标 `&LCD->RAM` 的语义交叉（见 §2 注）。本工程若做须走 `MEMORY_TO_PERIPH`：外设侧 = FSMC 数据窗口（不自增）、内存侧 = draw buffer（自增）。资源上空闲流充足（DMA2_Stream1~7 全空，`adc.c:111` 只占 Stream0） |
| B3 `LCD_DMA_Transfer()` 封装 | **已做（等价物）** | 本工程 `bsp_lcd_write_pixels()` / `_cont()` 就是它的等价物，且**多解决了一件事**：本屏的 `0x2C` 复位问题（原文"每块重设窗口"的写法在本屏会**整屏雪花**，2026-10-12 已实测踩过 —— `hardware/65`） |
| B4 **异步 flush** | **不采纳（与线程模型冲突）** | 收益 = flush 那点时间（§5.1 实测上限 0.6%）；代价 = 必须在 **ISR/另一上下文**里调 `lv_display_flush_ready()`，而本工程 `LV_USE_OS = LV_OS_NONE` 的契约是"LVGL 只能单任务访问"（`lv_conf.h:125-135`，且该契约有 BASEPRI 死链的历史教训）。详见 §5.4 |
| B5 **双缓冲 + 局部缓冲** | **不适用** | ① 双缓冲的收益**完全依赖 DMA** —— 单核上"渲染"与"同步写屏"用的是同一个 CPU，没有并行可言；② 前提是"传输是瓶颈" —— **静屏下不成立（0.59%）**，但**滑动下成立（59~77%，见 §5.1）⇒ 这一条在滑动口径下要重判**；③ 内存不允许：两块 `480×56×2` = 105 KB > 余量 10.4 KB（§5.5）；④ 本工程已是 PARTIAL 单缓冲 + 1024 px 分块，`s_draw_buf` 就在 SRAM1（DMA 可访问）—— 这条**为将来预留的口子已经留好了**（`app_lvgl.c:14-17`、`project_config.h:51-53`） |
| B6 `LV_USE_PERF_MONITOR` | **已做且更细** | 本工程 = `LV_USE_SYSMON=1` + `LV_USE_PERF_MONITOR=1`（产品要求，右下角浮层），另有**三处自建可观测量**：`[LVGL] diag`（窗口 ms / px / px·s⁻¹ / flush µs / handler µs / 堆）、`[UI] 1s`（刷新次数 / 最大间隔 / **间隔分布** / 分段 等待·业务·LVGL）、顶栏等效 fps。见 `lv_conf.h:1124-1160`、`app_lvgl.c:628-655` |
| B7 实测收益表（2~3× 帧率） | **不可移植** | 该表的对照基准是"**逐像素绘制**"（其自报 320×240 全屏 200 ms ⇒ 隐含 **0.38 Mpx/s**）。本工程直写实测 **10 Mpx/s** —— 比其基准快 **≈26×**，且已等于其 DMA 方式（9.6 Mpx/s）。**收益来源（消除写屏瓶颈）本工程早已拿到**，剩下的天花板只有那 0.6~4% |
| B8 花屏三因排查 | **条件采纳** | ① FSMC 时序 → 本工程有 16% 余量且时序重验走 `.ioc`；② "DMA 传输未完成" → 本工程目前无此风险（同步写）；③ **缓冲区 4 字节对齐** → 已满足（`lv_conf.h:157` 的 `LV_DRAW_BUF_ALIGN = 4`）。三条**作为将来真上 DMA 时的检查单**保留 |
| B9 DMA 性能检查清单 | **不适用** | 清单全部针对"DMA 是瓶颈"的场景；本工程根本没有 DMA 写屏路径，`flush` 也不是瓶颈 |

---

## §5 总判定：DMA 化的收益上限（量化）

### 5.1 上限怎么算（**v1.1：分两个场景**）

**场景 A —— 静屏（页 0 + 输入悬空，已实测）**

```
实测写吞吐        = 100 ns/px                      （bsp_lcd.c:91，已实测）
静屏写屏负载      = 59,395 px/s                    （11:12 上板日志，已实测）
⇒ flush 占用      = 59,395 × 100 ns = 5.94 ms/s ≈ 0.59% CPU
历史窗口同量级：3.9%（_work/lvgl_perf_20261014/帧率与波形流畅度-优化方案.md:41）
               · 1.8%（_work/lvgl_perf_20261014/外部文章对照-多核并行渲染.md:57）
```

**场景 B —— 全屏滑动（推算；本工程已有独立的成本模型）**

```
滑动 = 滚动整个 tileview ⇒ **每个动画帧整屏 480×320 全部变脏**
                （_work/lvgl_perf_20261014/滑动流畅度优化方案.md:10-17）
整屏像素        = 480 × 320 = 153,600 px
每帧 flush      = 153,600 × 100 ns = **15.36 ms**（按实测吞吐）
                （按理论时序 76.4 ns/字 则 11.74 ms —— 同上文 :24）
动画帧率        ≈ **50 fps**（该文 §1 的物理上限估计；**注意它 ≠ 10 Hz 数据率**）
⇒ flush 占用    = 15.36 ms × 50 /s = 768 ms/s = **76.8%**（理论时序口径 58.7%）
⇒ 剩给软件渲染  = 23~41% ⇒ UI 任务被占满 ⇒ **sysmon 显示接近 100** ✔（与现场观察一致）
```

| 场景 | 每秒送屏像素 | `flush` 占墙钟 | 性质 |
|---|---|---|---|
| A 静屏 | 59,395 px/s | **0.59%** | 已实测 |
| B 全屏滑动 | 7.68 Mpx/s | **59~77%** | 推算（本工程成本模型） |

**⇒ 更正 v1.0 的锚点错误**：v1.0 把极端上界写成"整屏每次都重绘 **@10 Hz** ⇒ 15.4%" ——
10 Hz 是**数据率**（`APP_MEAS_PERIOD_MS`），而滑动的**动画帧率**是 ~50 fps ⇒ **低估 5 倍**。
⇒ 正确的上界是 **59~77%**。（教训已登记进 §8。）

**⇒ DMA 化的收益上限 = `flush` 的全部时间**：静屏 **0.59%**（可忽略）· 滑动 **59~77%**（不可忽略）。

**★ 而且滑动场景下 DMA 不只是"省 CPU"，还能提帧率**：现在"渲染"与"写屏"在**同一个 CPU 上串行**
（单块 draw buffer + 同步写）⇒ 每帧墙钟 = `渲染 + 写屏`；若用 DMA + **双缓冲**，每带变成
`max(渲染, 写屏)` ⇒ 帧时间的**理论上界 = (渲染+写屏) ÷ max(渲染,写屏) 倍**，
写屏占 59~77% 时约 **1.5~2×**。**这是本次评估里唯一"帧率真能涨"的场合。**

> 附带一笔账：实测 **100 ns/px** 而理论总线只要 **76.4 ns/字** ⇒ 那多出来的 24% 是**循环与 AHB 开销**
> （`bsp_lcd.c:91` 的注释）。DMA 能吃掉这部分——**但**字节序交换若回退成软件预交换，等于把这笔开销换个地方付（§5.3）。

### 5.2 三笔代价（都要在真做之前付）

| 代价 | 具体是什么 | 出处 |
|---|---|---|
| **跨上下文碰 LVGL** | 异步 flush 要求 ISR 调 `lv_display_flush_ready()`；本工程契约是"LVGL 只能 UI 任务访问"（`LV_USE_OS = LV_OS_NONE`）。要么破契约，要么改回 `LV_OS_FREERTOS` 并把 LVGL 初始化挪到调度器之后（有历史死链：`lv_conf.h:125-135` 记录过"BASEPRI 被钉住 → 时基与 ADC DMA 中断全失效"） | `lv_conf.h:125-135` |
| **分块中断** | 采样窗静默要求 1024 px 粒度的 take/give（`project_config.h:115-133`）。DMA 化后"块完成"事件要从 **DMA TC 中断**里拿，即把现在 6 行循环的分块逻辑搬进 ISR —— 复杂度上移，且是**采样窗静默这条硬约束的核心路径** | `app_lvgl.c:134-166` · `bsp_lcd.h:92-109` |
| **字节序改造** | F407 的 DMA **没有字节交换**功能；本工程靠"渲染原生 RGB565 + 搬运循环里交换"。DMA 化后源缓冲必须已是目标字节序 ⇒ 三条路：① 回退 `RGB565_SWAPPED`；② 加一遍软件预交换（等于现状甚至更贵）；③ 其它。**①是否廉价，本工程内部尚未定案** —— 见 §5.3 | `bsp_lcd.c:170-176` · `app_lvgl.c:479-486` |

### 5.3 字节序：一个**未定案的归因**（写下来供阶段二第一项实测）

本工程内部对 `RGB565_SWAPPED` 的代价有两处**互相矛盾**的记载：

- `app_lvgl.c:479-485` 写：`_SWAPPED` "让 LVGL 在渲染的每一像素上做字节交换/格式转换"，**实测每像素 ~2.2 µs** ⇒ 2026-10-13 六轮改成原生 RGB565。
- 但**七轮基线（即在六轮改完之后）**实测仍是 **≈2.0 µs/px**，且七轮把根因定在"**面积 × 算法**"（`lv_obj` 的 `SIZE_CONTENT` 面积被撑成 465×150、斜线掩膜每段每带一次 `malloc`），并明确"`-O2` 只值 1.2× ⇒ 成本不在指令效率"。见 `_work/lvgl_perf_20261014/帧率与波形流畅度-优化方案.md:45` · `:169-179`。

**源码侧的核查（本次新增）**：LVGL 9.5 对 `RGB565_SWAPPED` **有独立的混合实现**，不是"逐像素转换"的包装 ——

```
firmware/Middlewares/LVGL/src/draw/sw/blend/lv_draw_sw_blend_to_rgb565_swapped.c   1560 行
firmware/Middlewares/LVGL/src/draw/sw/blend/lv_draw_sw_blend_to_rgb565.c           1531 行
```

⇒ 两者同量级；`firmware/Middlewares/LVGL/src/draw/sw/blend/lv_draw_sw_blend.c:186-189` / `:246-249` 按目标格式直接分派到对应的 `..._rgb565_swapped()`。（用全路径写是为了消歧：屏厂 ESP32 例程里另有一份同名文件。）
**即：`app_lvgl.c` 那句"逐像素字节交换/格式转换"在 LVGL 9.5 代码里找不到依据。**

**这条为什么对本文是决定性的**：若"回退 `_SWAPPED`"的真实代价≈0，则 §5.2 的第三笔代价（字节序）**瓦解**，DMA 方案的技术障碍只剩两笔；
若 2.2 µs/px 归因成立，则该路不可行。
**⇒ 阶段二第一项 = 一行 A/B 实验**（把 `app_lvgl.c:486` 改回 `LV_COLOR_FORMAT_RGB565_SWAPPED`、同时把 `bsp_lcd.c:176` 的交换去掉，抓同一组 `[UI] 1s` 分段与 `handler`）。成本极低、判据现成。
（**未验证**：本文不做该实验，也不预设结论。）

### 5.4 顺带：另一条**未验证**的顺带项

`board_config.h:494` 写"扩展模式写能到 ~27.8 ns/字 ≈ 72 MB/s"。按本屏 spec 反算，**27.8 ns 低于 TWC(min) 66 ns**，
且远低于 tWRH/tWRL(≥15 ns) 所需的脉宽预算 —— **该数字若按字面启用会违反屏 spec**。
⇒ 登记为待澄清项（真要走扩展模式，须同时重验 TWC 与 tWRH/tWRL，且改 `.ioc` 属人做）。

### 5.5 ★ 两道新障碍（做 DMA 之前必须先过）

| # | 障碍 | 数字 / 判据 |
|---|---|---|
| **① 渲染 vs 写屏的占比未实测** | 决定"该啃写屏还是啃渲染" —— 这是 DMA 值不值的**唯一判据** | 项目内部两个估算**互相打架**：滑动成本模型说"整屏帧 ≈20 ms 其中 flush 11.74 ms ⇒ 渲染 ≈8 ms"（`滑动流畅度优化方案.md:23-25`）；而波形区实测"≈50 周期/px ⇒ 整屏渲染要 53 ms"。**判据 = 滑动期间 `[LVGL] diag` 的 `flush µs ÷ handler µs`**（§6.2 C4）：>50% ⇒ 写屏瓶颈、DMA 对症；<20% ⇒ 仍渲染瓶颈、DMA 只省那 20% |
| ~~② RAM 装不下标准双缓冲~~ → **v1.6 更正** | "渲染 ∥ 传输"**必须有第二块缓冲**才成立（单缓冲只能等） | **v1.5 之前这里算错了**：正确的算法是"**把现有 56 行换成两块 28 行**" ⇒ `2×480×28×2 = 53,760 B` = **与现在一模一样，零 RAM 增量** —— 我拿"**加法**"去算了一个"**替换**"的问题。**真正的代价换成了"带数"**：每帧 **6 带 → 12 带**，每带固定开销（走一遍对象树 + 开窗 + 抢闸）翻倍，**这个开销没人量过** ⇒ 登记为 C9 的第 ② 道 1 行关（`APP_LVGL_DRAW_BUF_LINES` 56→28 单缓冲即可量）。**好消息**：28 行时一整带只有 **1.34 ms**（480×28×100 ns）< 采样窗 2.048 ms ⇒ 采样窗静默可以**整带抢一次闸**，比现在 1024 px 分块还简单 |

### 5.6 ★★ C4 实测结果（2026-10-14，用户按 §6.2 C4 抓回的 RTT）

**原始数据**（`[LVGL] diag`，同一块板；滑动 = 手指在 3 页之间反复快滑）：

| 窗口 | 时长 | flush | flush 调用 | 整屏帧率 | `flush µs` | `handler µs` | **flush÷handler** | handler 占墙钟 |
|---|---|---|---|---|---|---|---|---|
| ① 滑动（中） | 5000 ms | 3,735,318 px（747,063 px/s） | 213（42.6/s） | 7.1 fps | 350,418 | 2,706,686 | **12.9%** | 54.1% |
| ② 滑动（快） | 5035 ms | 8,094,006 px（1,607,548 px/s） | 343（68.1/s） | 11.4 fps | 758,889 | 3,298,627 | **23.0%** | 65.5% |
| ③ 滑动（最快） | 5006 ms | 12,184,416 px（2,433,962 px/s） | 486（97.1/s） | **16.2 fps** | 1,142,221 | 4,384,969 | **26.0%** | **87.6%** |
| ④ 静屏（对照） | 5000 ms | 228,831 px（45,766 px/s） | 88（17.6/s） | — | 21,802 | 1,483,965 | **1.5%** | 29.7% |

**帧率怎么来的**：所有窗口的"最大 … px/次"都恰好 = **26,880 px = 480×56 = 一个完整带**
⇒ "整屏全脏"成立；一帧 = 6 带 ⇒ 帧率 = flush 调用数 ÷ 6。

**窗口 ③ 拆到"每帧"（全屏一帧 = 153,600 px）：**

```
每帧 flush   = 1,142,221 µs ÷ 81 帧 = **14.1 ms**   ← 与 §5.1 推算的 15.36 ms 吻合 ✔
每帧 render  = (4,384,969 − 1,142,221) ÷ 81 = **40.0 ms**
             ⇒ 40.0 ms ÷ 153,600 px = 0.26 µs/px = **37.5 周期/px @144MHz**
                （与波形区实测的"≈50 周期/px"**同量级** ✔ ⇒ 该成本常数在滑动场景也成立）
每帧墙钟     = 54.1 ms ⇒ 18.5 fps（实测 16.2，差的是调度与其他任务）
```

**⇒ 判据结论（按 §5.5 ① 预注册的规则）**：

| 预注册判据 | 实测 | 结论 |
|---|---|---|
| `flush÷handler` **>50%** ⇒ 写屏瓶颈 | 峰值 **26.0%** | ❌ 不成立 |
| `flush÷handler` **<20%** ⇒ 渲染瓶颈 | 12.9% / 23.0% / 26.0% | ⚠️ **落在 20~50% 灰区，但明显偏渲染侧** |

⇒ **滑动 = "渲染 64.8% + 写屏 22.8%" 的混合，渲染是大头（2.8×）**。

**⇒ 对 DMA 的裁决（实测口径）**：

| 方案 | 帧时间 | 帧率 | 结论 |
|---|---|---|---|
| 现状 | render + flush = 54.1 ms | 16.2 fps（实测） | — |
| DMA **单缓冲**（写屏挪给 DMA，仍串行） | **不涨**（54.1 ms） | 不涨 | CPU 省 22.8%，但**约束是渲染墙钟、不是 CPU** ⇒ 无感 |
| DMA **+ 双缓冲**（渲染 ∥ 传输） | max(40.0, 14.1) = 40.0 ms | **≈25 fps（+54%）** | 有收益，且 **RAM 零增量**（两块 28 行 = 现有 56 行，见 §5.5 ②的更正）；代价 = **带数 6→12 的每带开销**（未量，C9 第②关）+ **字节序**（C9 第①关） |

⇒ **裁决：不做 DMA**。它**能**给约 +54% 帧率，但：① 这笔收益全部来自"渲染 ∥ 传输"的重叠，
而**渲染本身（40 ms/帧）才是更大的靶子** —— 省掉 30% 渲染（12 ms/帧）就约等于它的收益，
**且不必付那三笔代价**；② 双缓冲的 RAM 账不成立。

#### ③ ★ 本轮价值最大的一条新发现：滑动时 **LVGL 堆近乎耗尽**

| 窗口 | `heap free` |
|---|---|
| ④ 静屏 | **19,100 B** |
| ① 滑动（中） | **1,910 B** |
| ② 滑动（快） | **189 B** |
| ③ 滑动（最快） | **1 B** |

32 KB 的 LVGL 主池在滑动时**见底**。最可能的元凶（**待实测，未验证**）：
`lv_conf.h:171` 的 **`LV_DRAW_LAYER_SIMPLE_BUF_SIZE = 24*1024`** —— 只要某个 widget 有
`style_opa < 255` 或非 NORMAL blend，LVGL 就为"simple layer"申请**最高 24 KB** 的临时缓冲，
而池总共只有 32 KB（同时还要放 65 个对象、字体缓存、以及**斜线掩膜** —— 后者在
`_work/lvgl_perf_20261014/外部优化文章对照.md:84-107` 已查明是"每段每带一次 `lv_malloc/lv_free`"）。
⇒ **它很可能同时解释"滑动渲染 40 ms/帧"**：分配失败/碎片化会让渲染走慢路径或反复重试。

**同一份日志里的其它观察**（已登记进 §8）：`>33 ms` 掉帧桶占 10~18% · `发布→重绘 max` 380~441 ms ·
DSP 段被 UI 抢到 19.9 ms · `Task_Ui 栈余量 1124 B`；
**而 `循环 87~117 次/s` 基本维持 ⇒ 排除 L1"UI 循环塌了"的假说**。

### 5.7 C5 的 A/B 结果：**嫌疑人被证伪，已回退**（2026-10-14 上板）

**A/B 并排**（同口径 = 滑动最快那一窗）：

| 指标 | **A：24 KB** | **B：8 KB** |
|---|---|---|
| flush | 12,184,416 px（2,433,962 px/s） | 12,331,254 px（2,446,677 px/s） |
| `flush µs` | 1,142,221 | 1,155,978 |
| `handler µs` | 4,384,969（**87.6%**） | 4,467,671（**88.6%**） |
| `flush÷handler` | 26.0% | **25.9%** |
| **`heap free`** | **1 B** | **1 B** |
| 帧率 | 16.2 fps | 16.2 fps |
| 每帧 render | 40.0 ms | 40.5 ms |

**⇒ 逐项相同。** 而且**这不是"改动没生效"，是"这条路径根本没被走到"** —— 两条独立证据：

1. **该宏对本 UI 是死配置**：`LV_DRAW_LAYER_SIMPLE_BUF_SIZE` 只对"带 `style_opa < 255`
   **或**非 NORMAL blend 的控件"生效（LVGL 自己的注释，`lv_conf.h:165-168` —— **`bg_opa` / `text_opa` 不算**）。
   而本界面全 UI **只有 `bg_opa` / `border_opa`**（`firmware/Task/Src/app_ui.c:324-399`），
   **没有** `style_opa`、**没有** `LV_BLEND_MODE` 非 NORMAL（全仓 grep 0 命中）
   ⇒ **没有任何控件会触发 simple layer** ⇒ 该宏的值不影响任何一帧。
2. 反向也成立：若池真的只剩 **1 B**，下一次分配必然失败、`LV_ASSERT_MALLOC` 会打 ERROR
   （八轮刚修好级别映射，ERROR 现在可见）—— 而**整份日志 0 条 `[E]` / 0 条 `[W]`**。

**处置**：`lv_conf.h:171` **已回退到 24 KB**（上游默认），原地留一条 ★ 注释说明"为什么不用改"。
门禁复跑：`test` 5/5 · `lint` 0 · `build --clean-first` **0 告警 0 错误** · `sizecheck` RAM **112,112 B（85.53%）**。

**⇒ 连带结论：`heap free = 1 B` 这个读数本身可疑**（见 §8）—— 它既解释不了现象，
又与"渲染一直在跑、一条分配失败都没有"矛盾。**下一个动作不该是"照它去调池"，而是先确认它的真伪（§6.2 C6）。**

### 5.8 ★ 顺带发现：滑动期间 **engine 被 UI 饿死**（A/B 两版日志都有）

```
[ENG] 一拍   8 ms（采集 2096 + DSP  6589 + 发布 6）   ← 静止/轻载
[ENG] 一拍 897 ms（采集 2096 + DSP 895099 + 发布 6）   ← 滑动最剧烈那一拍
```

同一份日志里还有 `发布→重绘 max **833 ms**`，以及相邻那一秒
`[UI] 1s: 刷新 1 次 · 循环 53 次/s · 间隔分布 …/**21**`。

**机理**：UI 任务优先级 **26** > engine **22**（`docs/01` 的定稿表），滑动时 UI 任务被 LVGL 占满
⇒ engine 那一拍的**墙钟**被拉到 0.9 s（DSP 本身只算 8 ms，其余全是等时间片）。
⇒ **测量节拍在滑动期间从 10 Hz 掉到 ~1 Hz**，松手后恢复。

**这不是本文的 bug**（优先级是刻意的，2 s 判据仍满足），但它是"**滑动时数据看起来不动**"的直接原因，
而且**与刷屏无关**：即便把写屏全免了，只要渲染还占 65%，engine 照样被压。
⇒ 登记为独立观察（**未验证**其对手感与判据的实际影响）。

### 5.9 第三轮抓数：**两个真结果**（2026-10-14，用户授权烧录后）
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
