funiang-x/G2026/docs/INDEX.md

# G2026 · docs 索引

> **给 agent 的入口**：接 G2026 相关的活，**先读本文件**再挑具体文档——按"何时读"对上号，
> 然后**打开原文读**，不许凭印象复述。规则见 `rules/01_任务路由协议.md` §3。
> 新增文档请在本表补一行（这是产品文档的单一索引）。

| 文档 | 内容 | 何时读 |
|---|---|---|
| `hardware/65-屏8080写地址复位-根因与修复-20261012.md` | **★ 屏"整屏雪花"的根因与修复（已上板验证）** —— **根因：本屏（ST7796S/TK035F9629）每收到一次 `0x2C`(RAMWR) 就把写地址复位到窗口起点**；而本工程为"采样窗静默"把一次 flush 切成 `APP_LCD_CHUNK_PX=1024` 的块、**每块都重发 `0x2C`** ⇒ 每次 flush 只反复覆写窗口最前 ~3 行、其余行从未写过（上电随机 GRAM）= **整屏雪花 + 几条均匀横线上才有界面**。**判据实验**（J-Link 活体、不烧录）：窗口 8×2 里先 `0x2C` 写 `0111..0118`、**再 `0x2C`** 写 `0121..0128`、`0x2E` 读回 = `0121..0128` + `FFFF×8` ⇒ 第二批覆盖第一批。**同一批取证排除**：总线/GRAM 往返（写 `0x1234` 读回成功）、固件连发写确实落盘（读回整行 `F800`）、`IM[2:0]=010` = 8080
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
