funiang-x/G2026/docs/电赛测评值.png

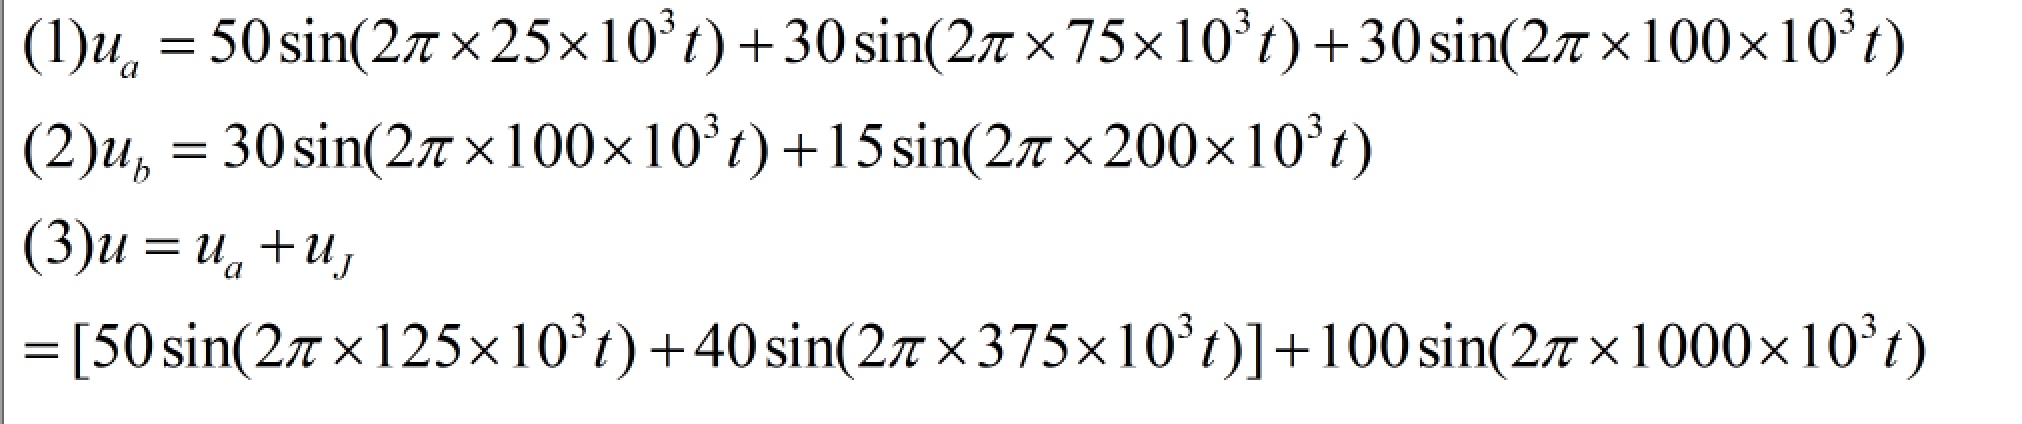
docs/电赛测评值.png
