funiang-x/G2026/hardware/21-接线卡_assets/core_annotated.png

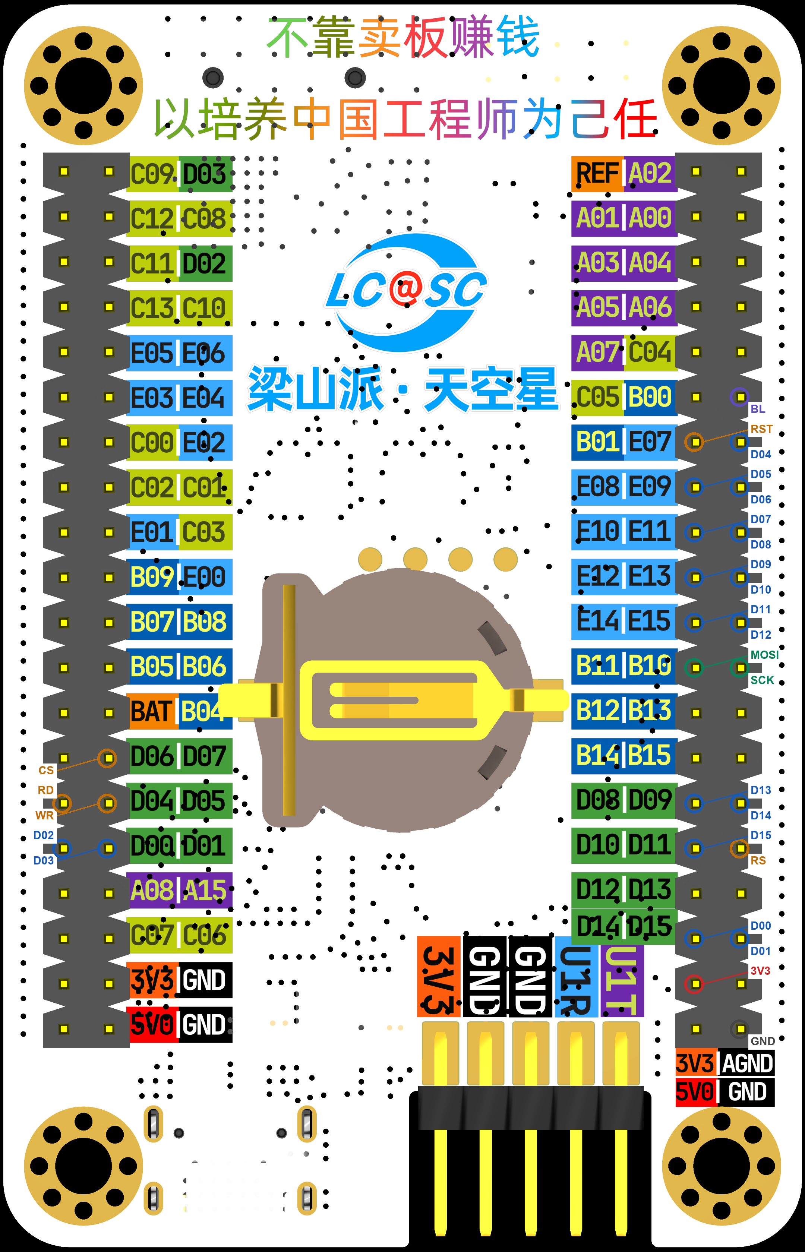
hardware/21-接线卡_assets/core_annotated.png
