funiang-x/G2026/hardware/21-接线卡_assets/core_p1_bot.png

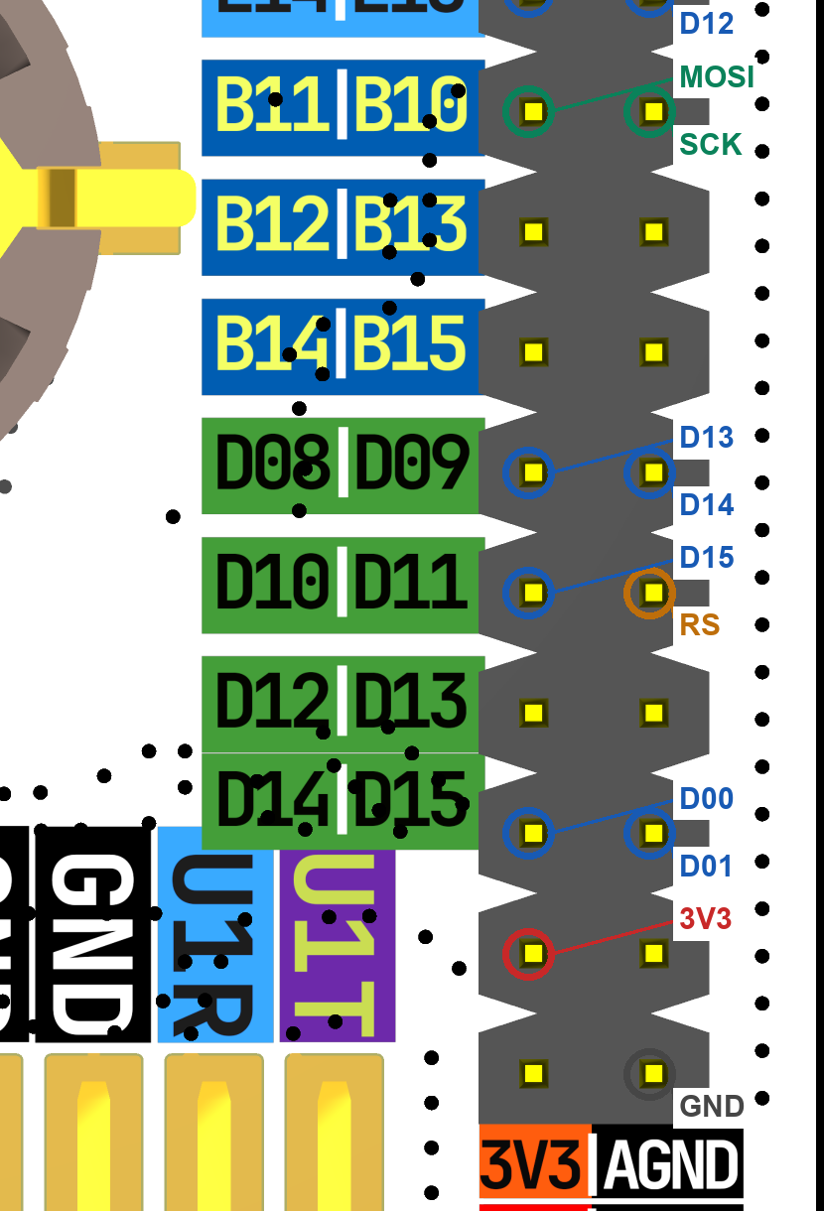
hardware/21-接线卡_assets/core_p1_bot.png
