funiang-x/G2026/hardware/21-接线卡_assets/core_p2_bot.png

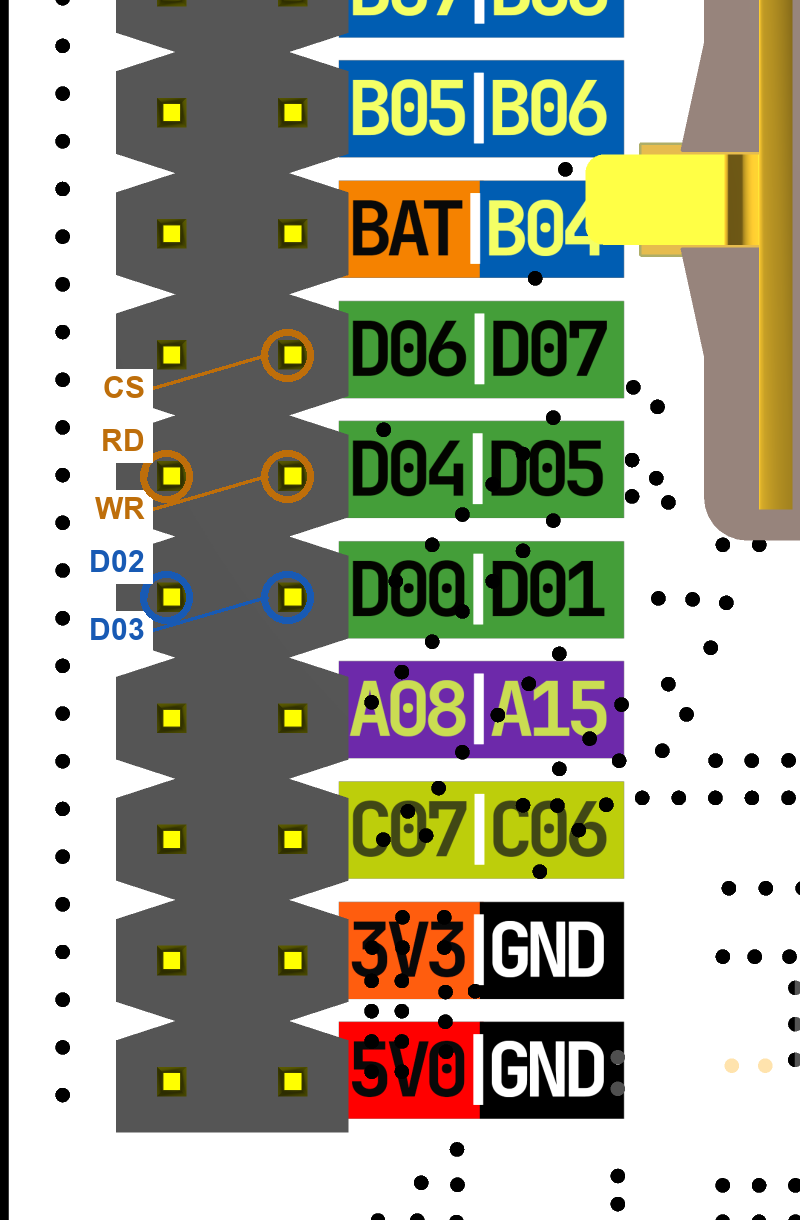
hardware/21-接线卡_assets/core_p2_bot.png
