funiang-x/G2026/hardware/21-接线卡_assets/mod_conn.png

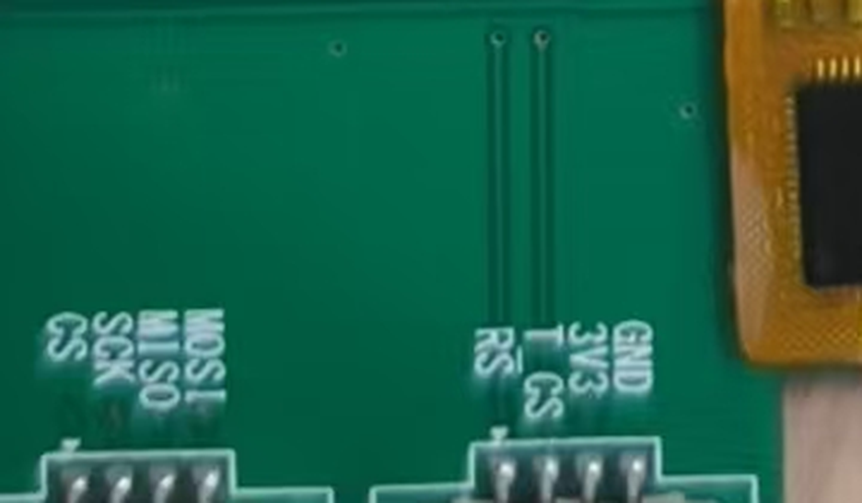
hardware/21-接线卡_assets/mod_conn.png
