funiang-x/G2026/hardware/21-接线卡_assets/module_board.jpg

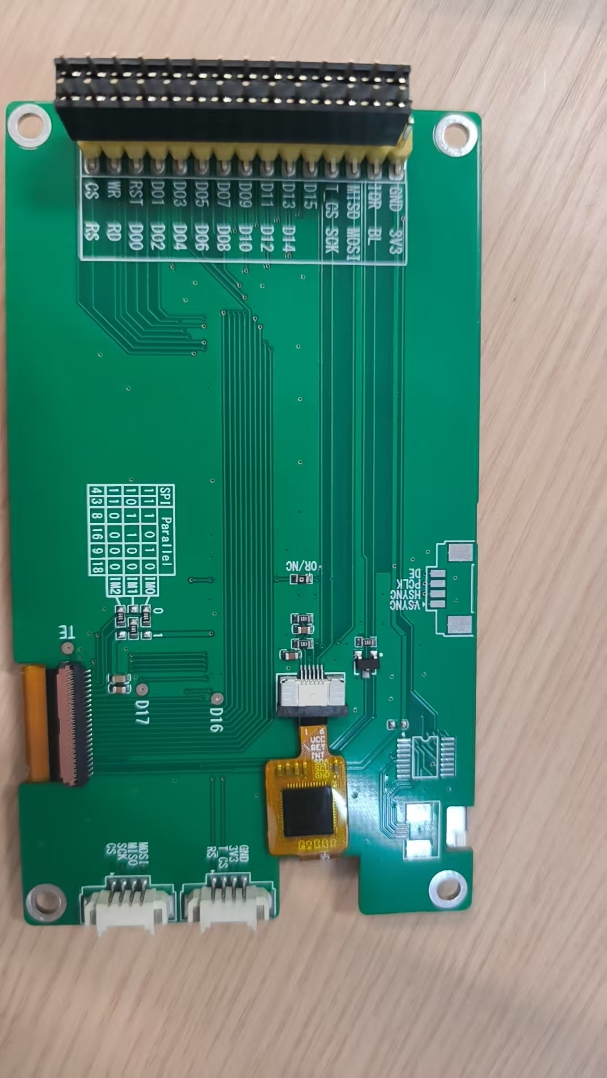
hardware/21-接线卡_assets/module_board.jpg
