funiang-x/G2026/hardware/45-讲解配图/_check_INT.png

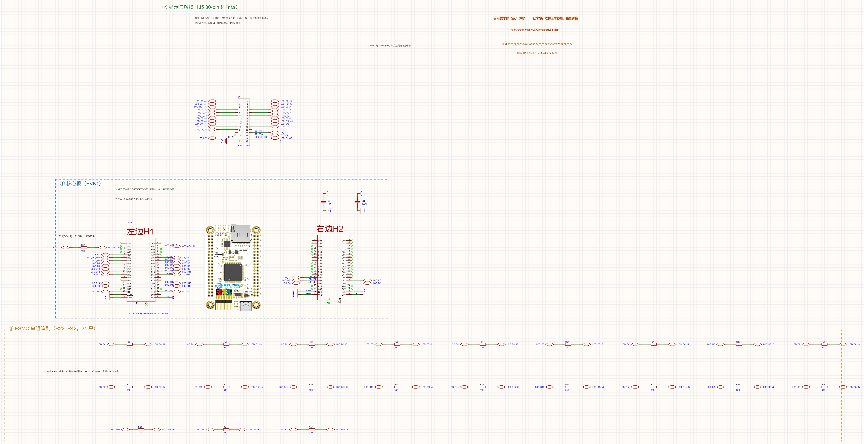
hardware/45-讲解配图/_check_INT.png
