funiang-x/G2026/hardware/45-讲解配图/_check_PWR.png

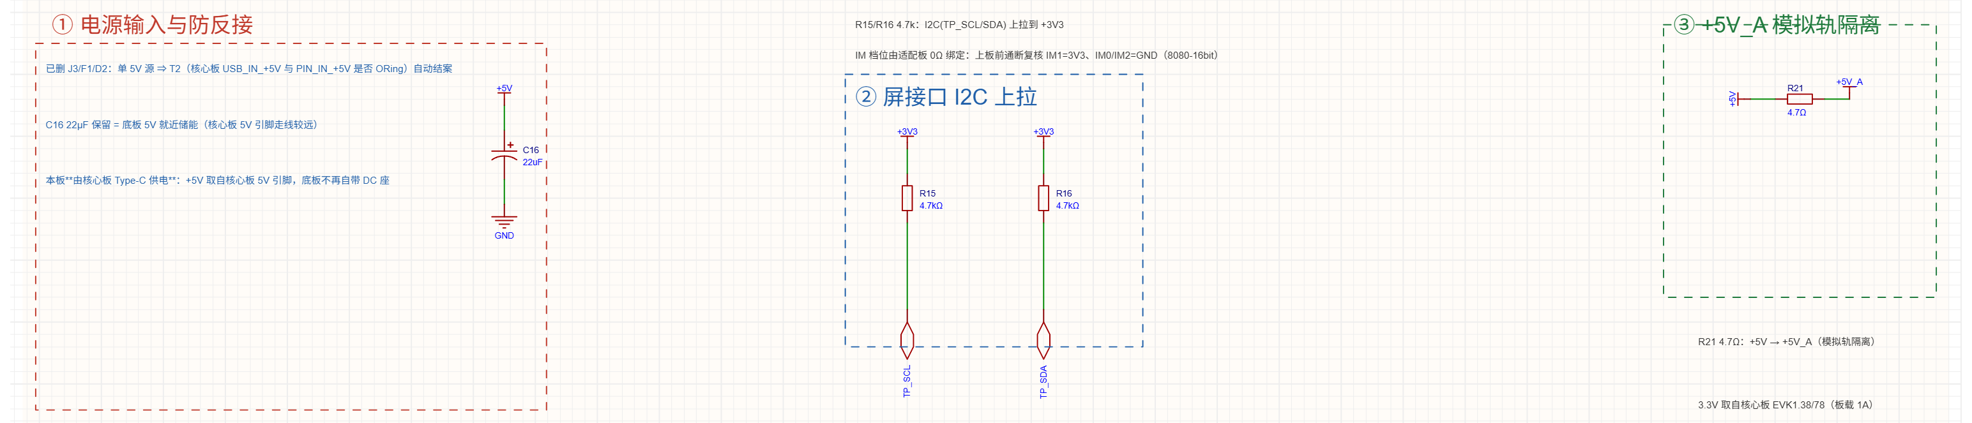
hardware/45-讲解配图/_check_PWR.png
