funiang-x/G2026/hardware/_review/refactor-20260929/01-AFE-重构前.png

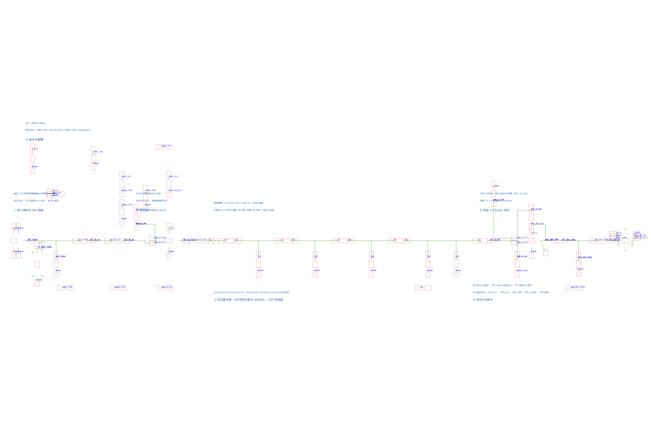
hardware/_review/refactor-20260929/01-AFE-重构前.png
