funiang-x/G2026/hardware/_review/refactor-20260929/02-AFE-重构后.png

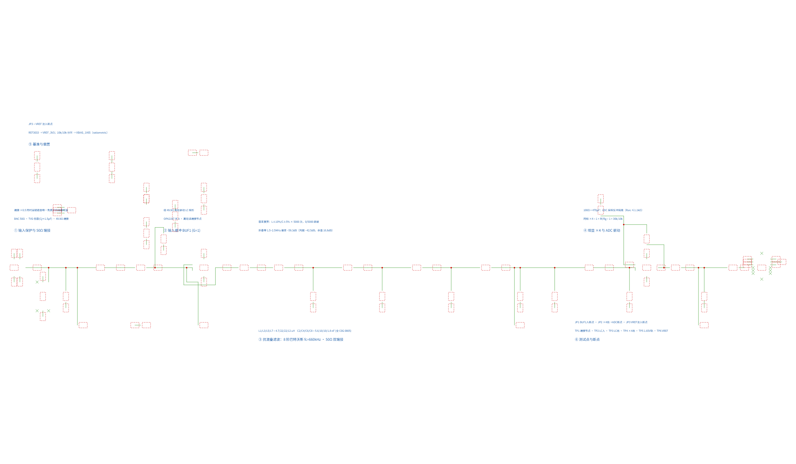
hardware/_review/refactor-20260929/02-AFE-重构后.png
