funiang-x/G2026/hardware/_review/refactor-20260929/03-U1B反馈网络-放大.png

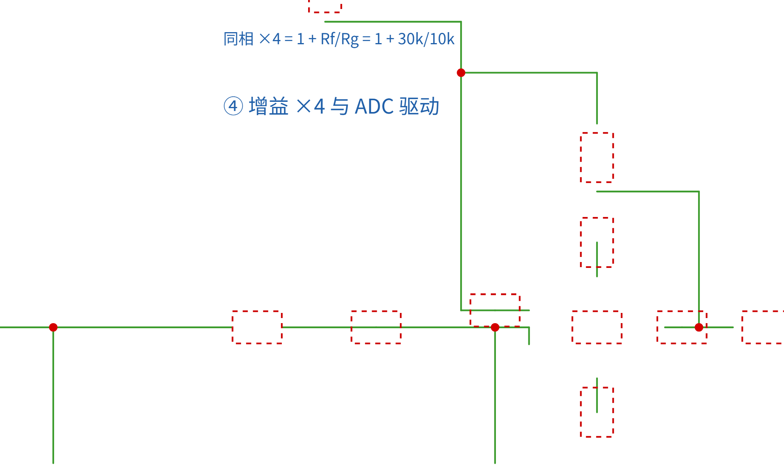
hardware/_review/refactor-20260929/03-U1B反馈网络-放大.png
