funiang-x/G2026/hardware/_review/refactor-20260929/04-AFE-分区与推导.png

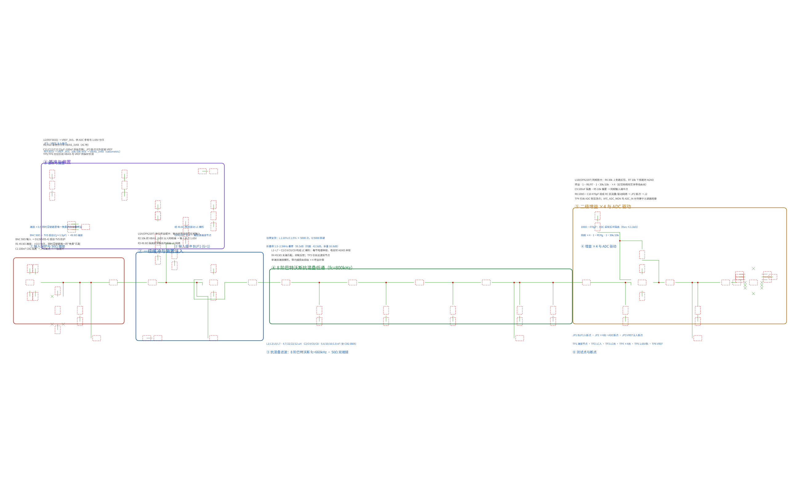
hardware/_review/refactor-20260929/04-AFE-分区与推导.png
