funiang-x/G2026/hardware/_review/refactor-20260929/05-PWR-分区与推导.png

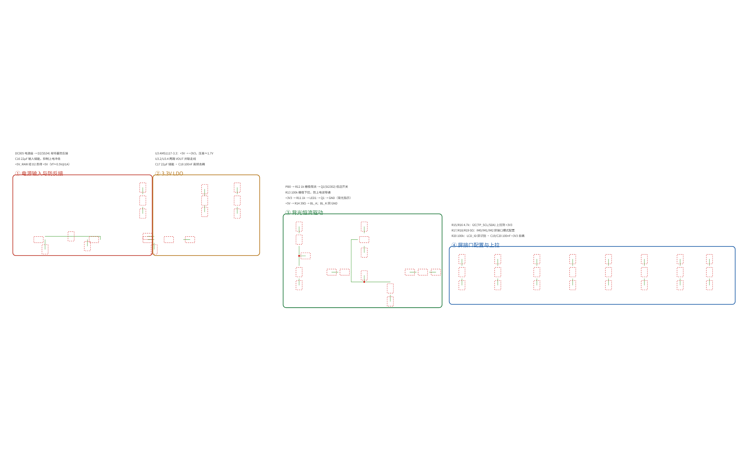
hardware/_review/refactor-20260929/05-PWR-分区与推导.png
