funiang-x/G2026/hardware/_review/refactor-20260929/06-INT-分区与推导.png

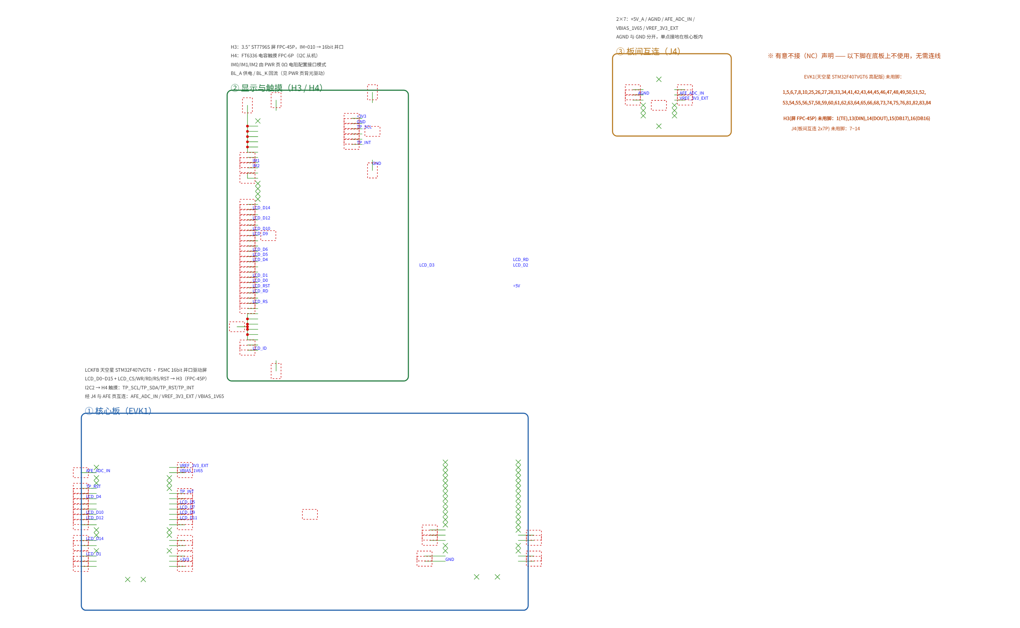
hardware/_review/refactor-20260929/06-INT-分区与推导.png
