funiang-x/G2026/hardware/_view/afe_full2.png

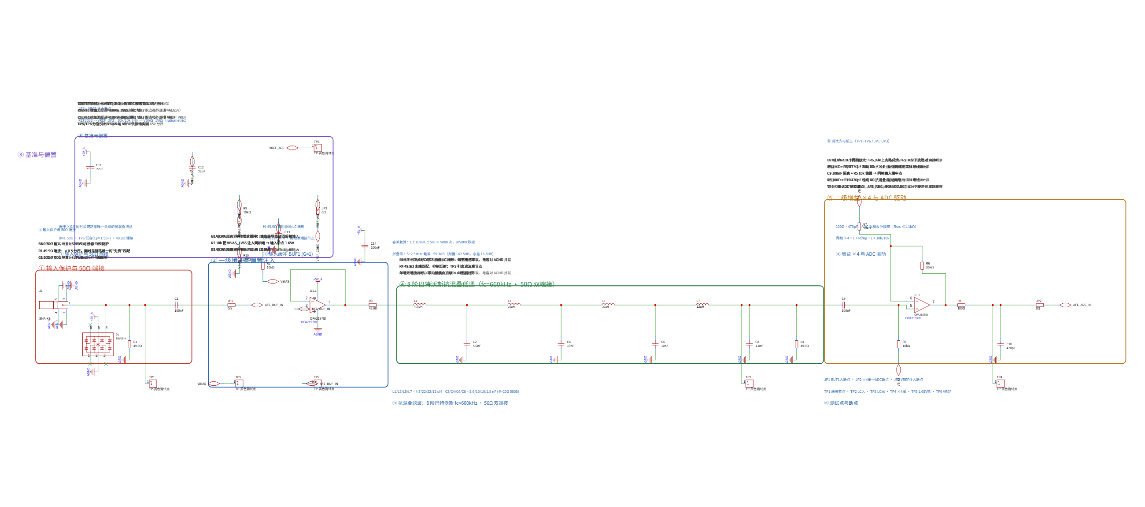
hardware/_view/afe_full2.png
