funiang-x/G2026/hardware/_view/afe_z_in.png

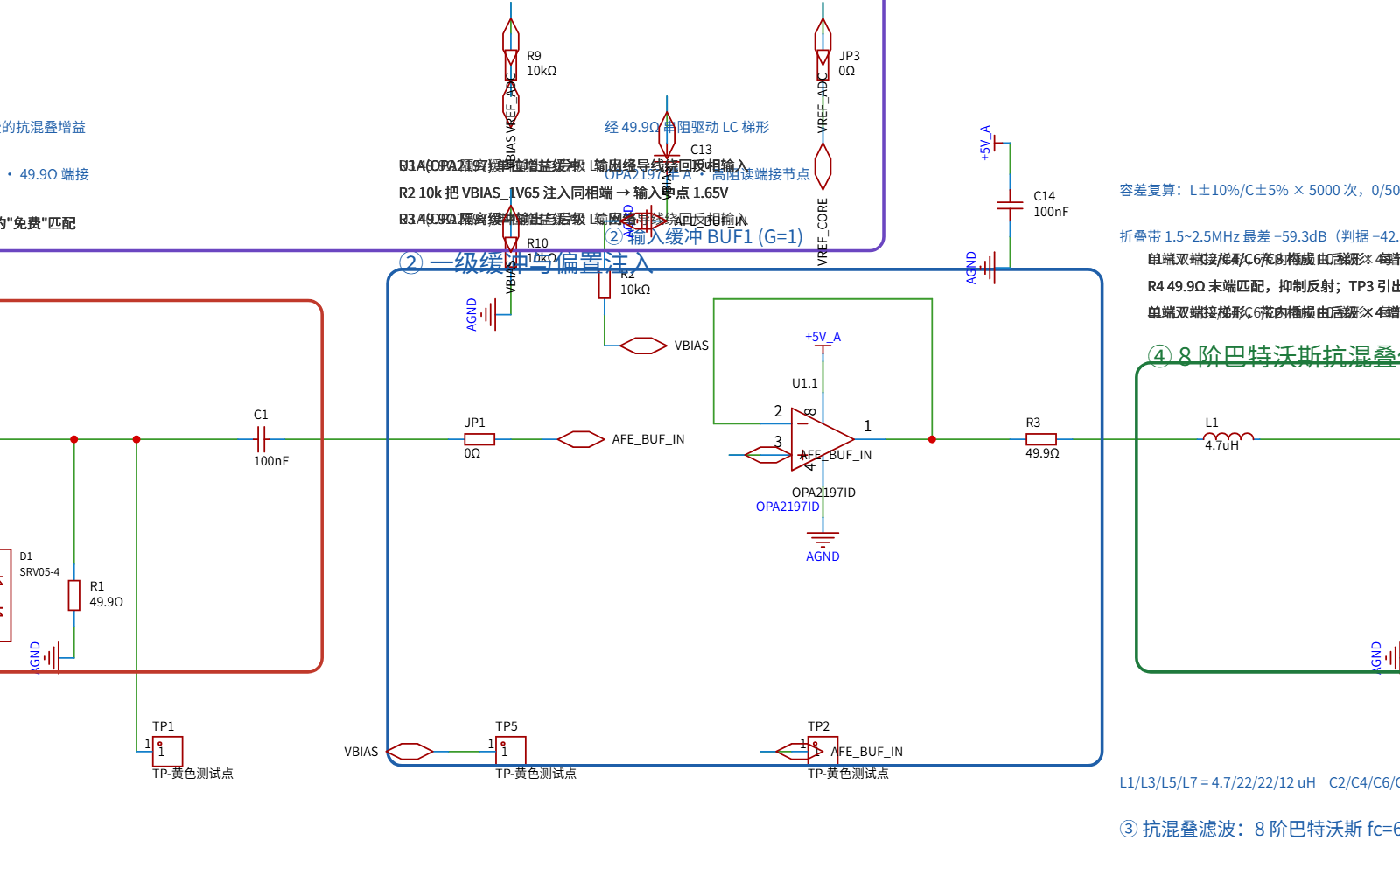
hardware/_view/afe_z_in.png
