funiang-x/G2026/hardware/_view/afe_z_u1.png

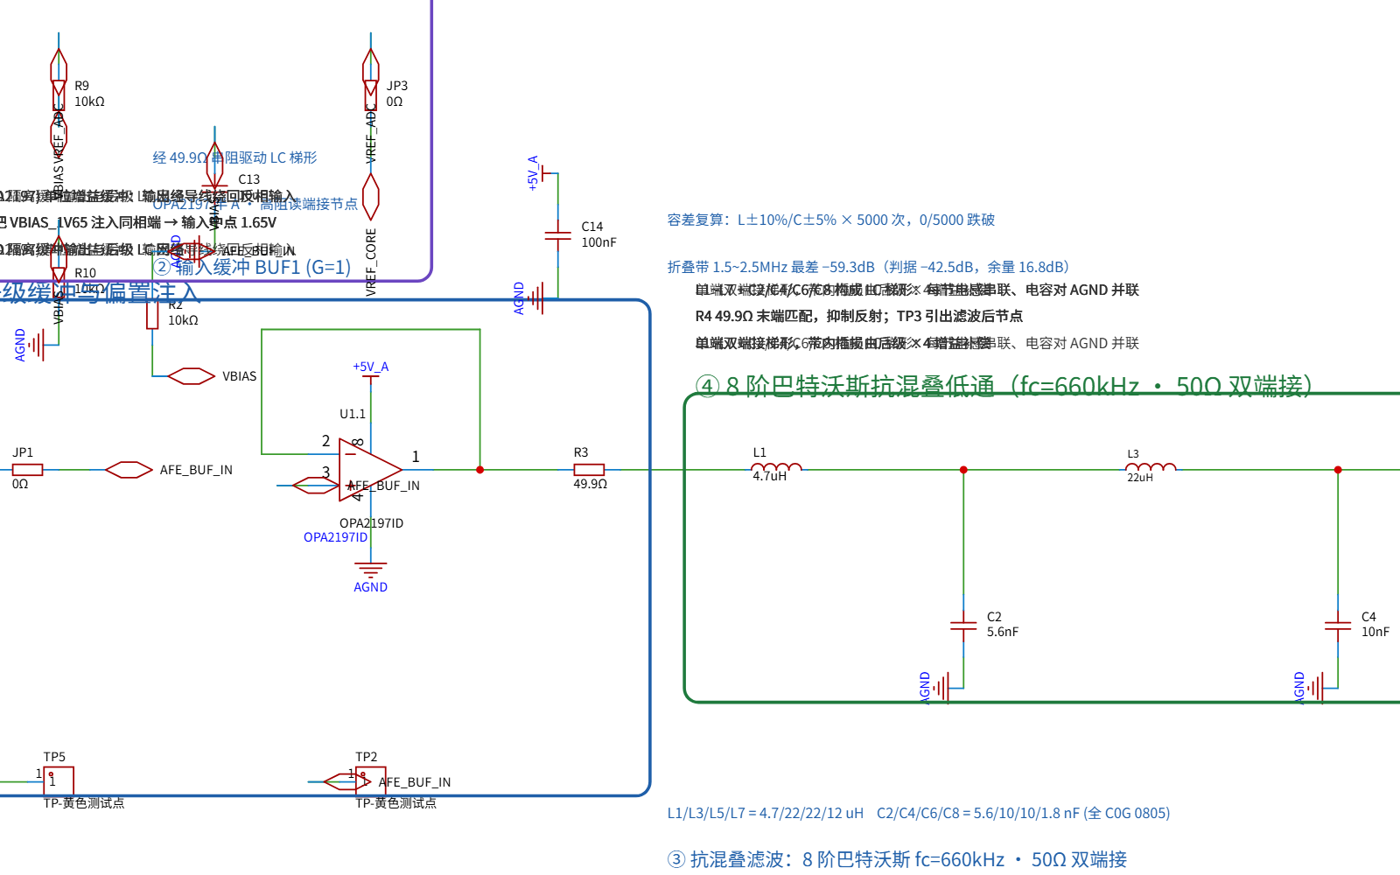
hardware/_view/afe_z_u1.png
