funiang-x/G2026/hardware/_view/afe_z_u2.png

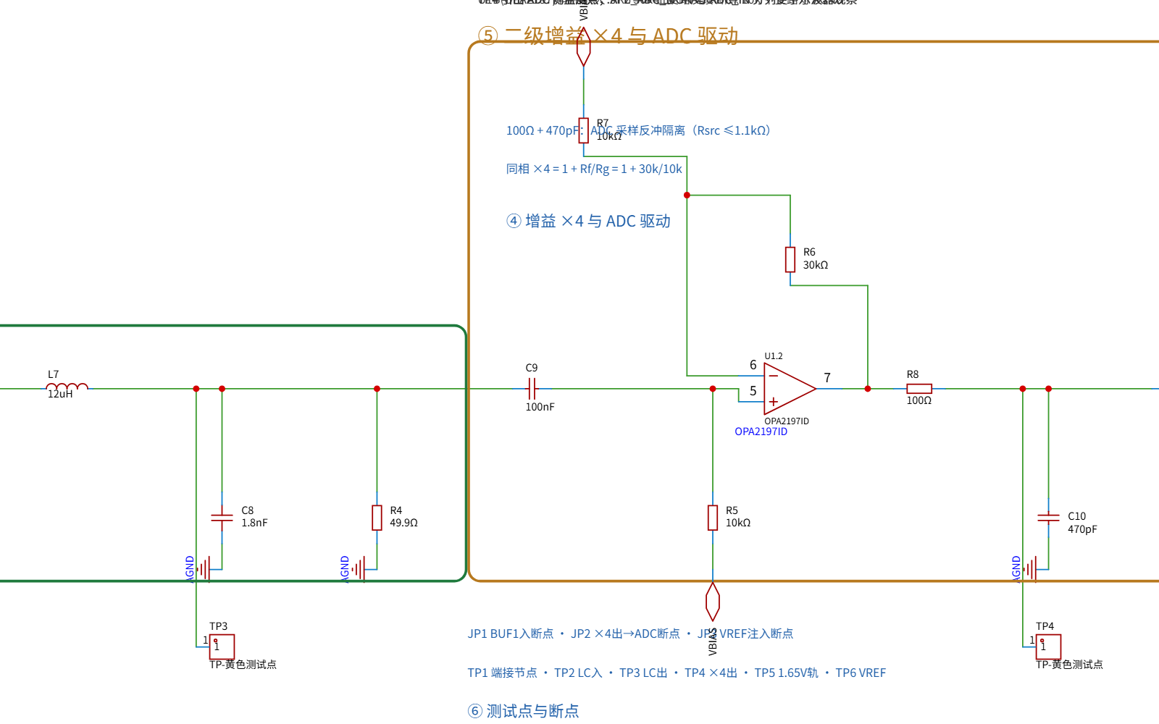
hardware/_view/afe_z_u2.png
