funiang-x/G2026/hardware/_view/AFE_zone_u1a.png

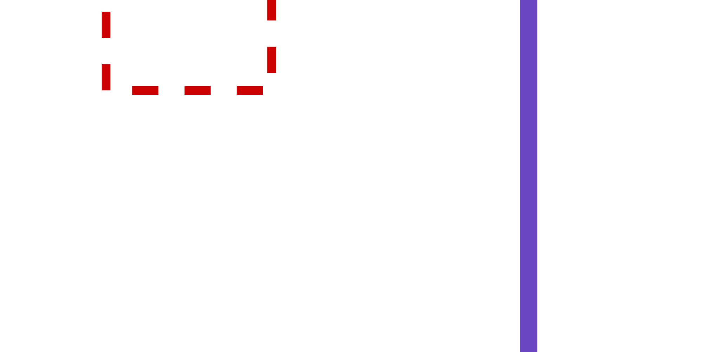
hardware/_view/AFE_zone_u1a.png
