funiang-x/G2026/hardware/_view/live_full.png

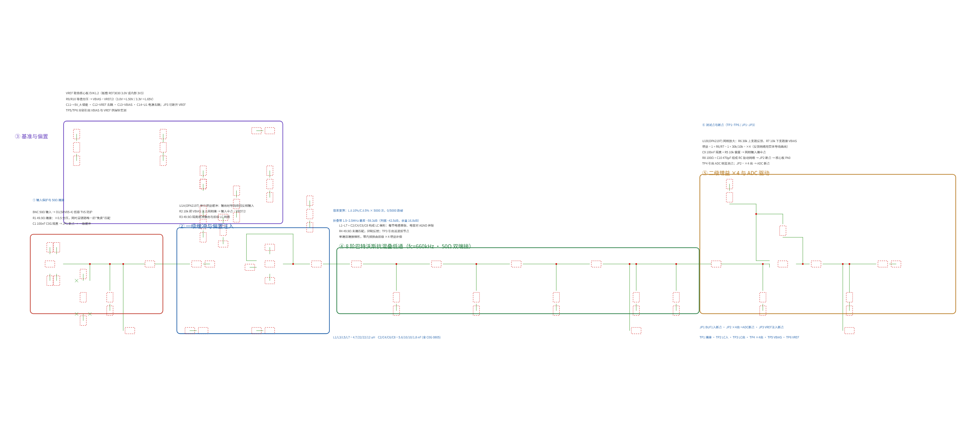
hardware/_view/live_full.png
