funiang-x/G2026/hardware/_view/live_z2.png

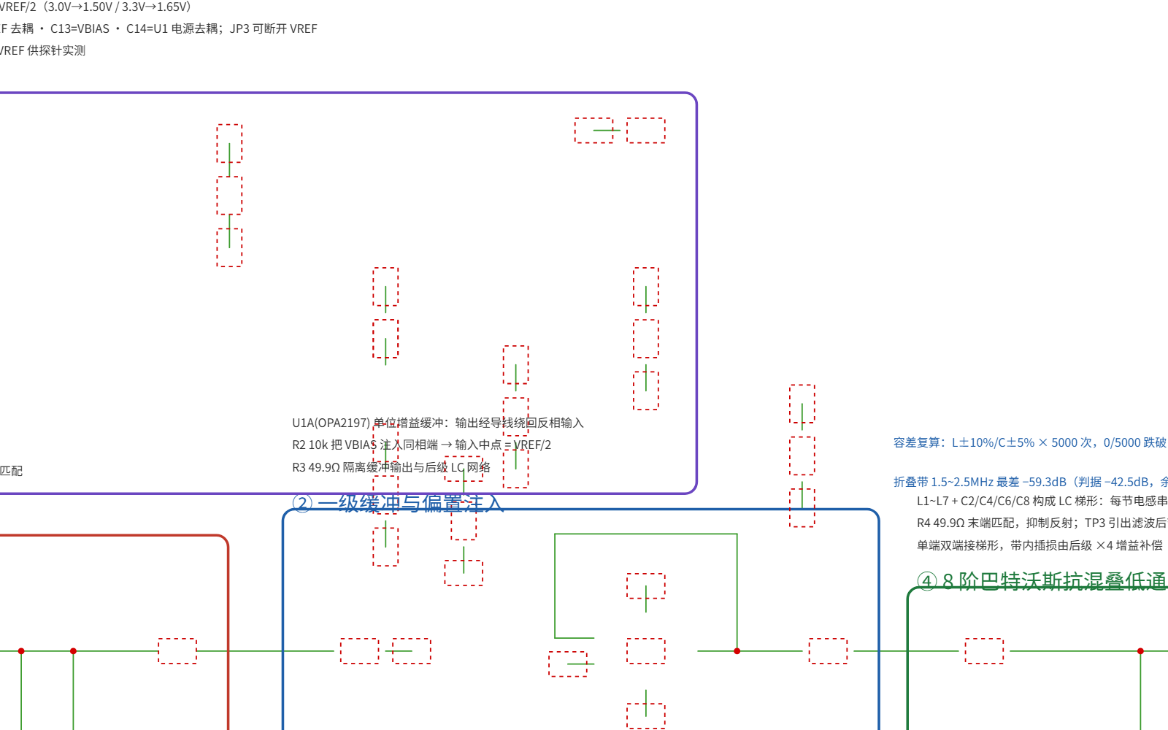
hardware/_view/live_z2.png
