funiang-x/G2026/hardware/_view/live_z5.png

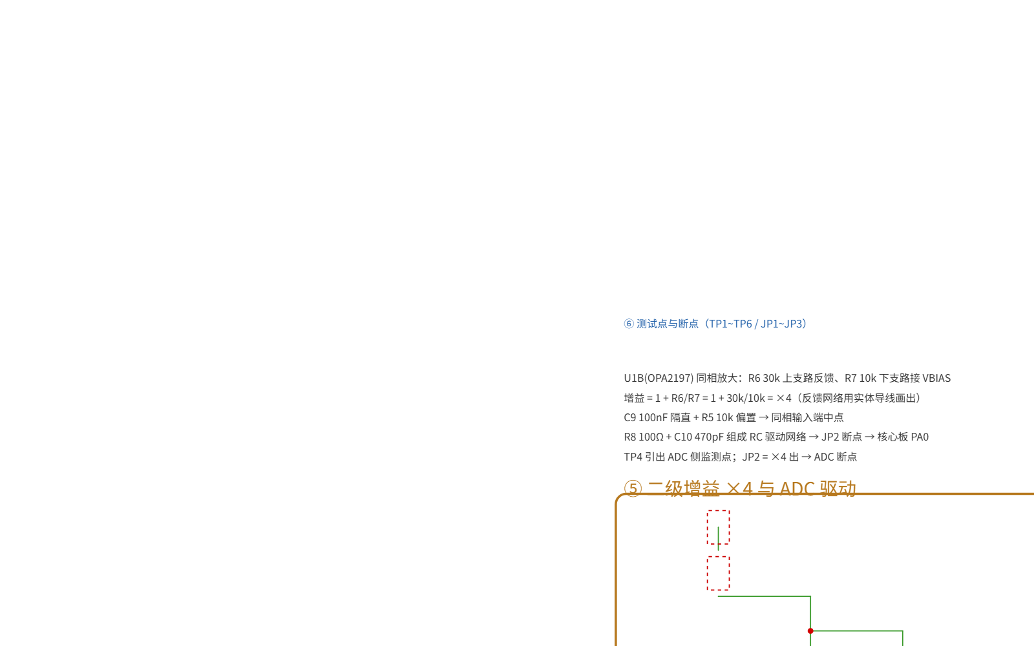
hardware/_view/live_z5.png
