funiang-x/G2026/hardware/_view/prj_default.png

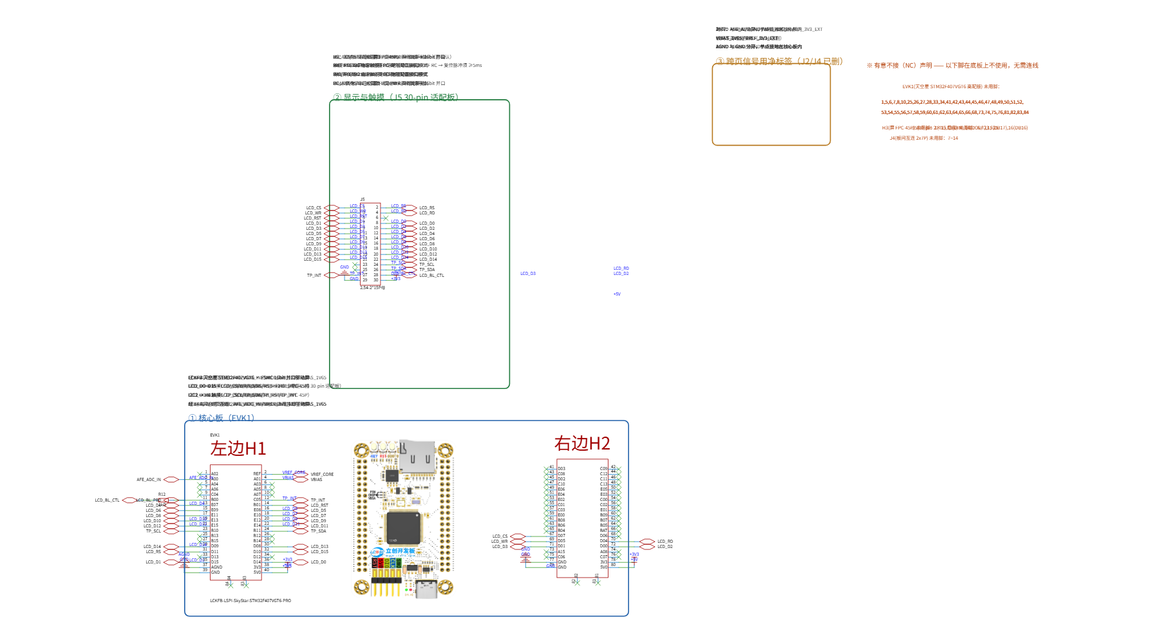
hardware/_view/prj_default.png
