funiang-x/G2026/hardware/_view/rel_final.png

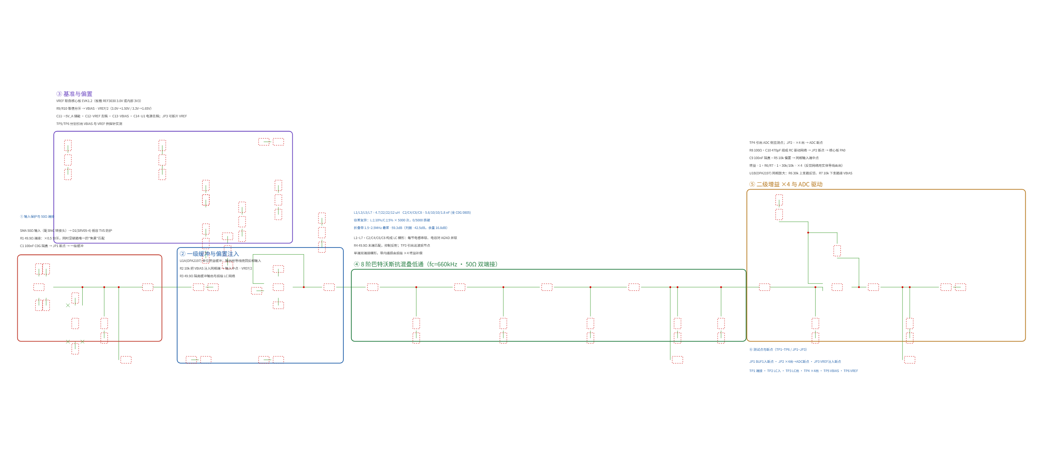
hardware/_view/rel_final.png
