funiang-x/G2026/hardware/_view/rel_z2.png

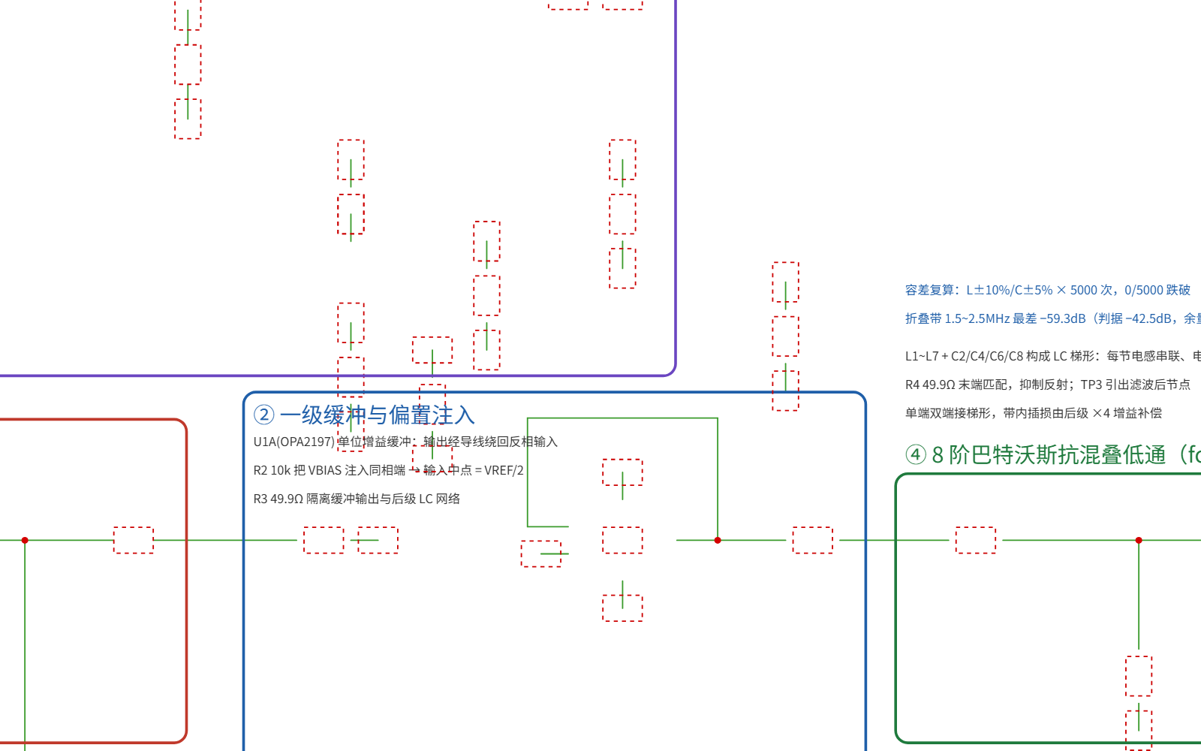
hardware/_view/rel_z2.png
