funiang-x/G2026/hardware/_view/rel_z3.png

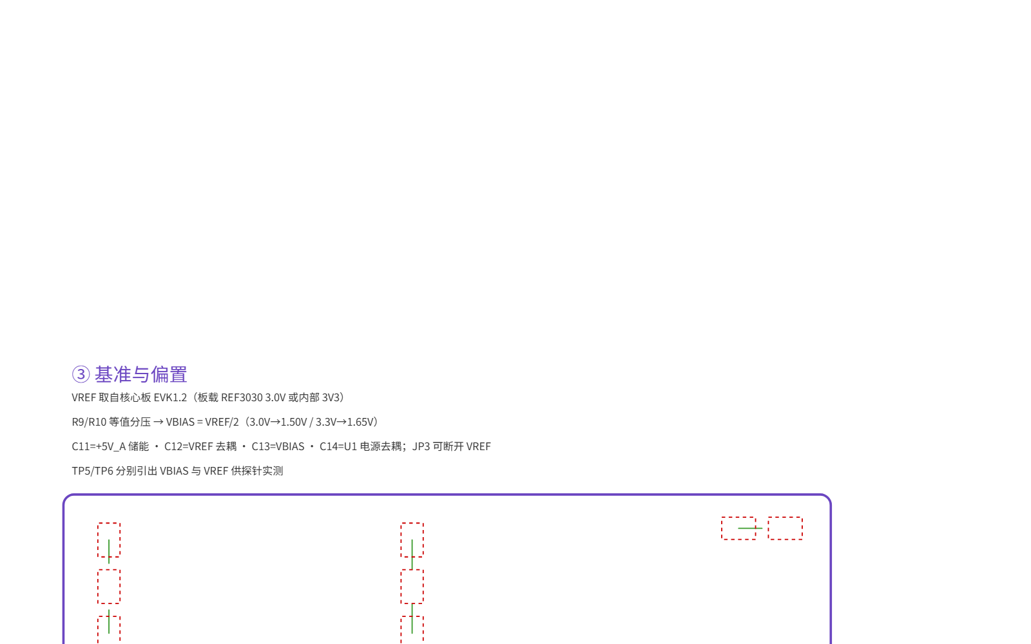
hardware/_view/rel_z3.png
