funiang-x/G2026/hardware/_view/rel_z4.png

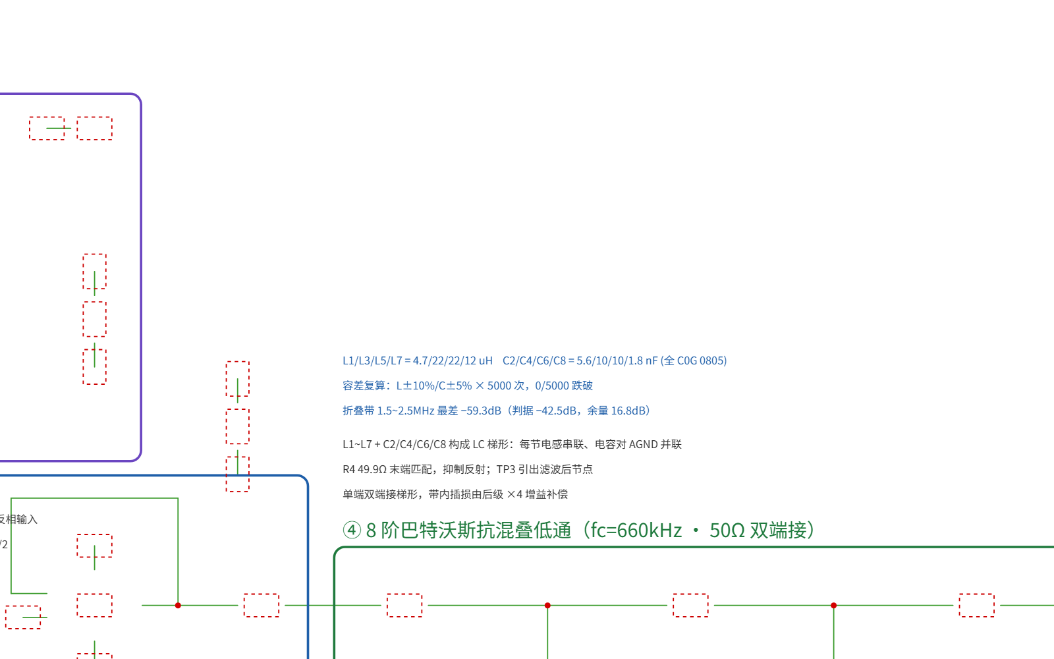
hardware/_view/rel_z4.png
