funiang-x/G2026/hardware/_view/rel_z5.png

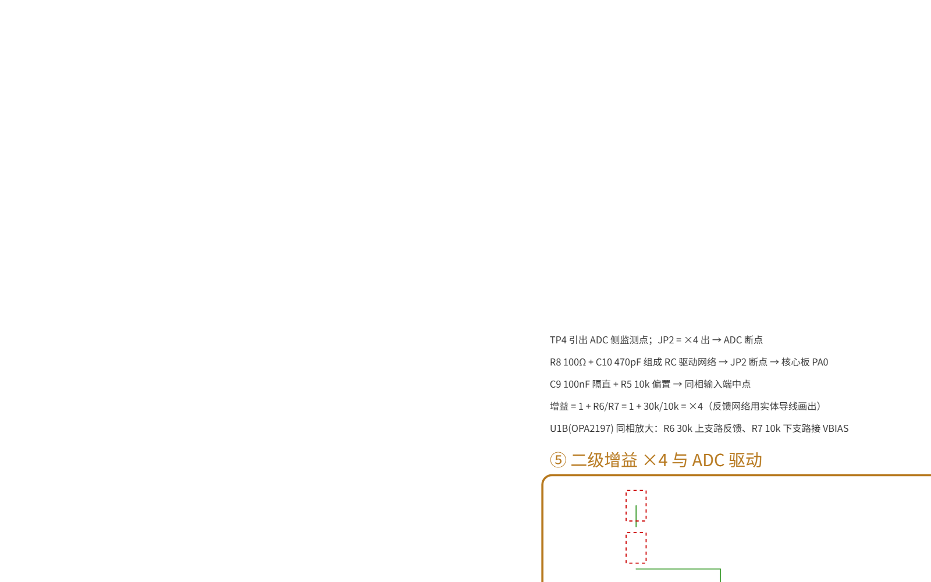
hardware/_view/rel_z5.png
