funiang-x/G2026/hardware/_view/rel_z6.png

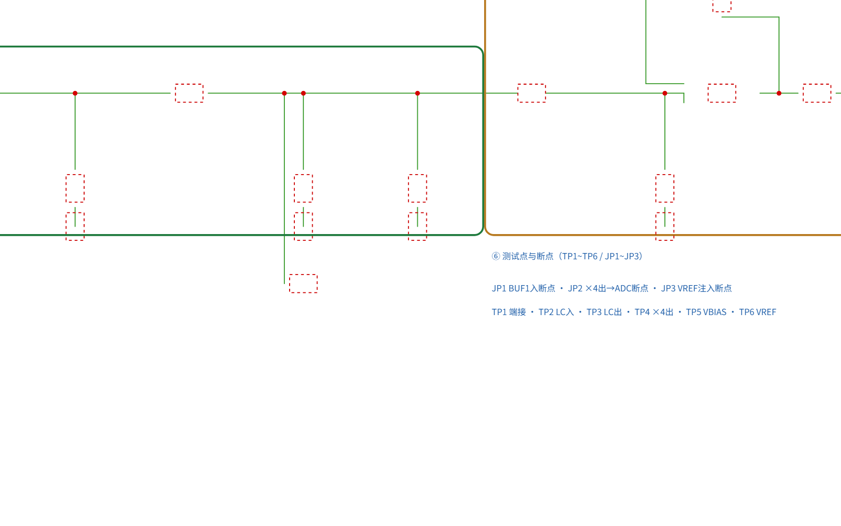
hardware/_view/rel_z6.png
