funiang-x/G2026/hardware/_view/sample_ra6e2.png

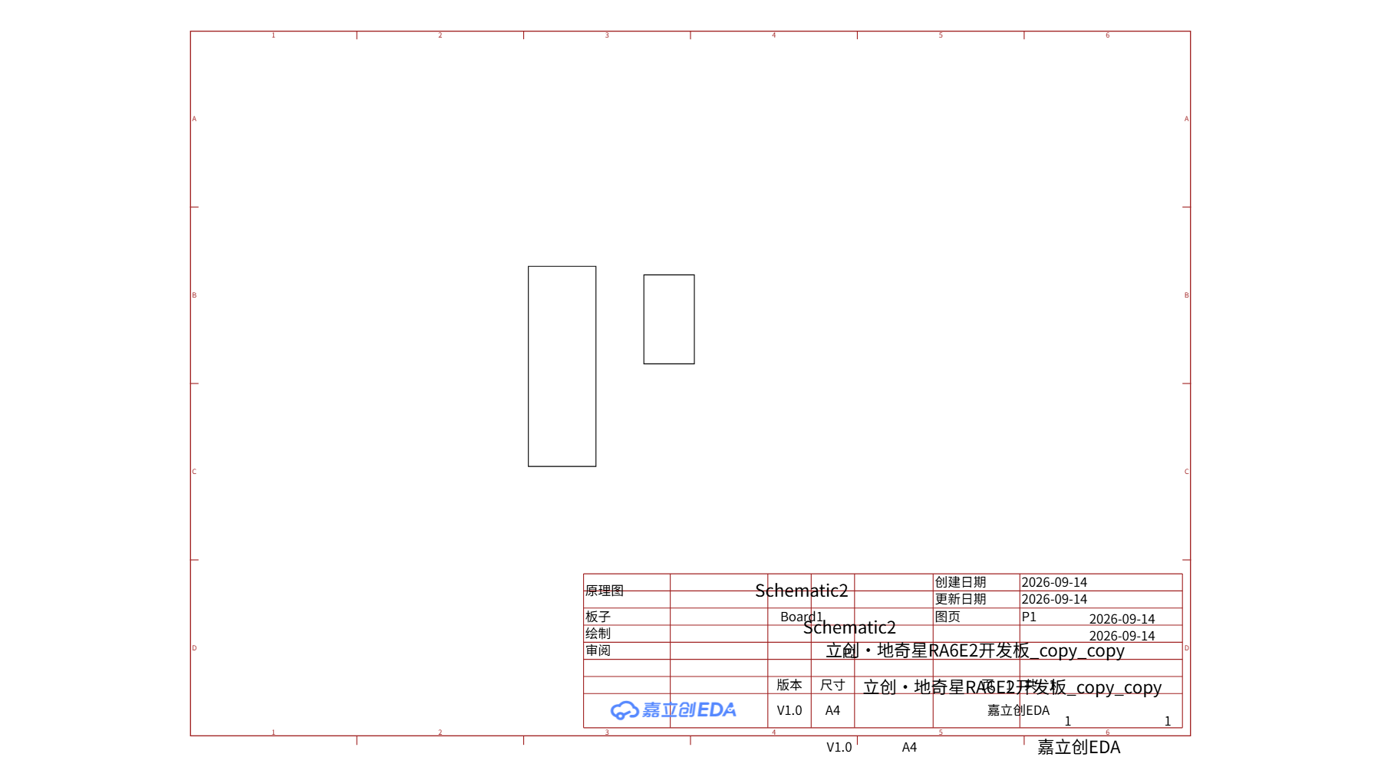
hardware/_view/sample_ra6e2.png
