funiang-x/G2026/hardware/_view/z_in.png

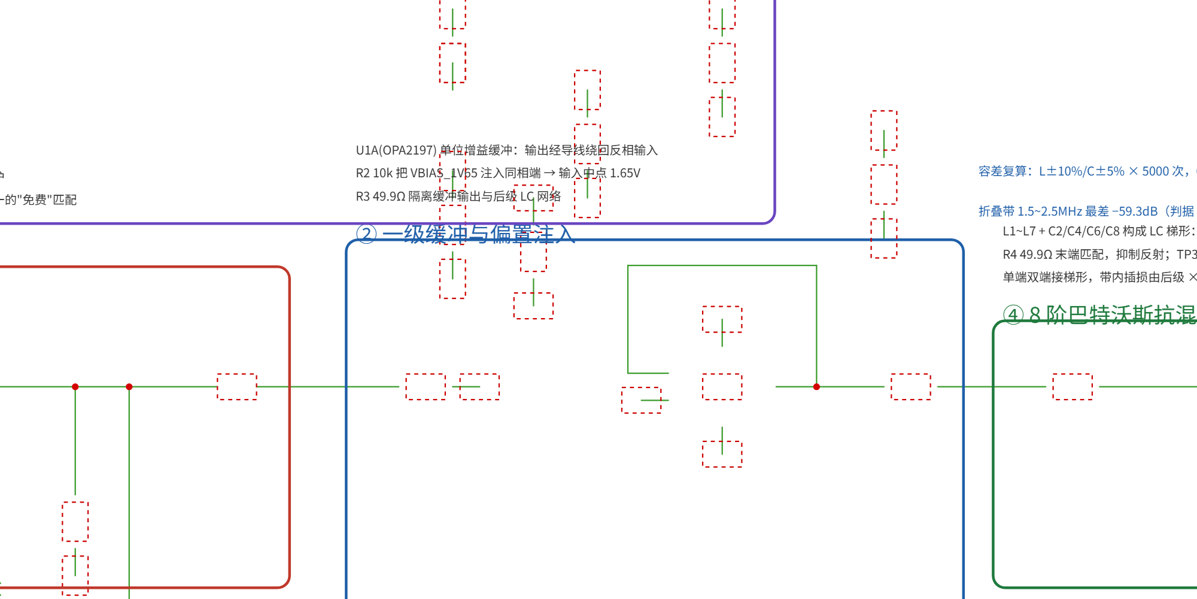
hardware/_view/z_in.png
