funiang-x/G2026/hardware/_view/z_u1a.png

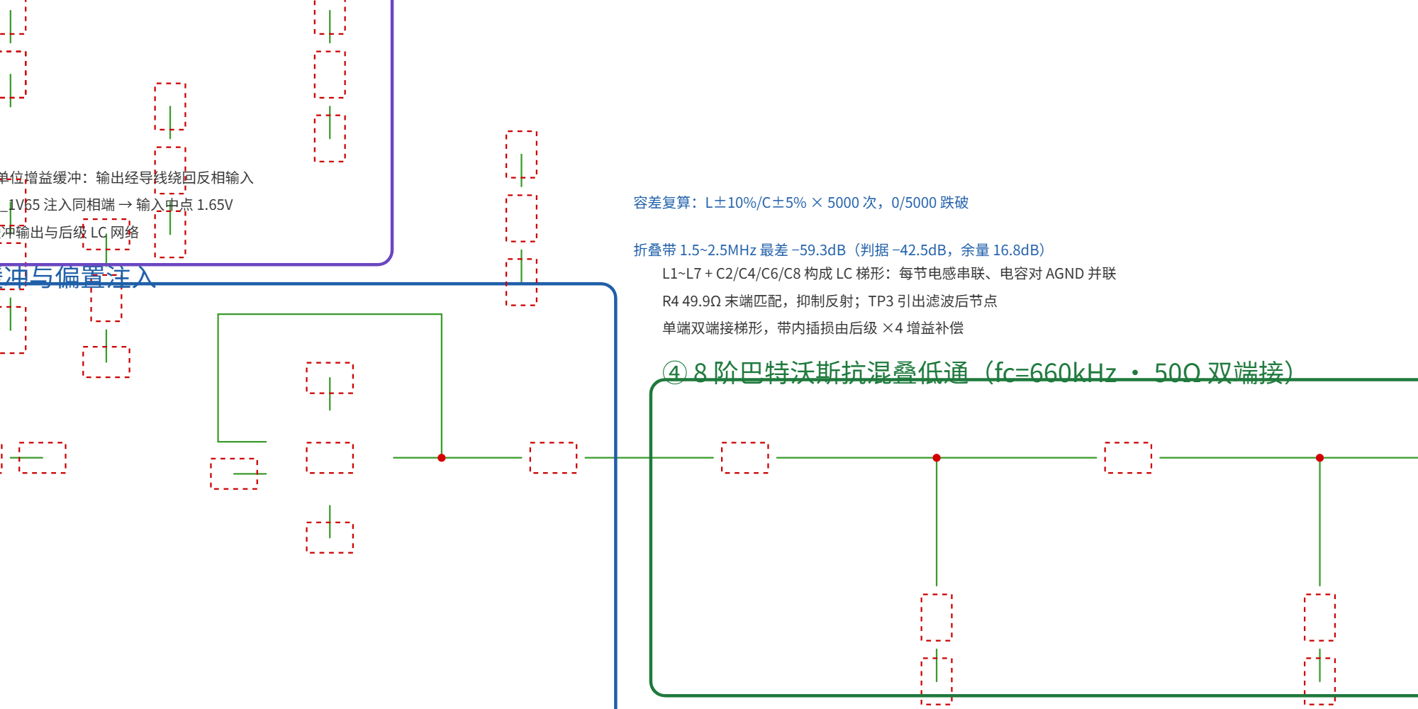
hardware/_view/z_u1a.png
