funiang-x/G2026/hardware/_view/z_u1b.png

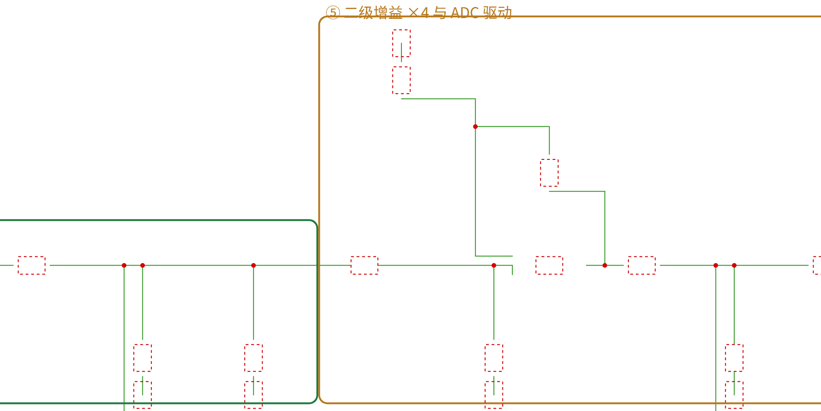
hardware/_view/z_u1b.png
