funiang-x/G2026/hardware/sch/G2026-AFE-frontend.jpg

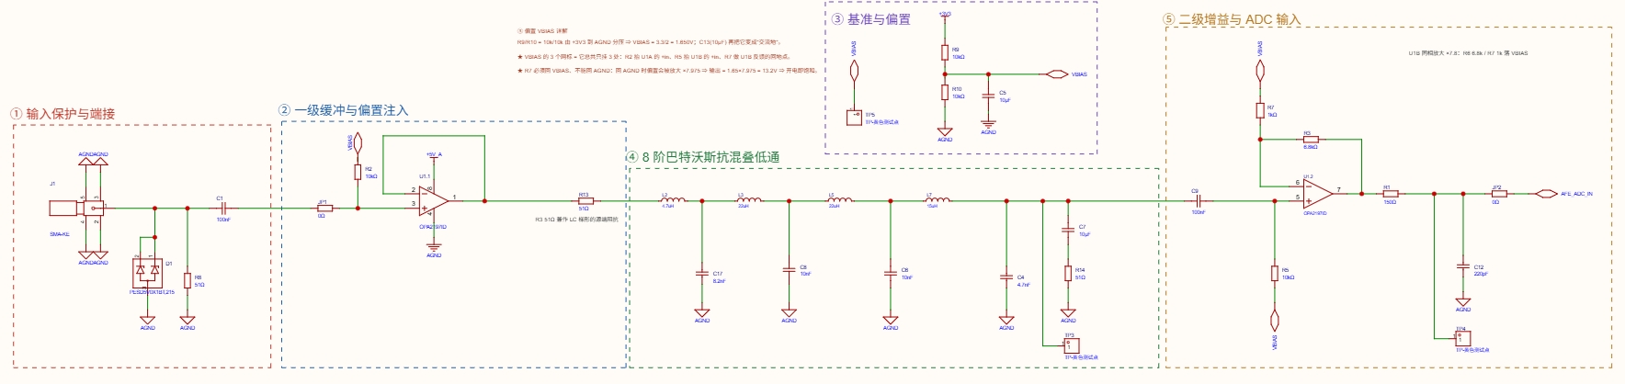
hardware/sch/G2026-AFE-frontend.jpg
