funiang-x/G2026/hardware/sch/G2026-INT.png

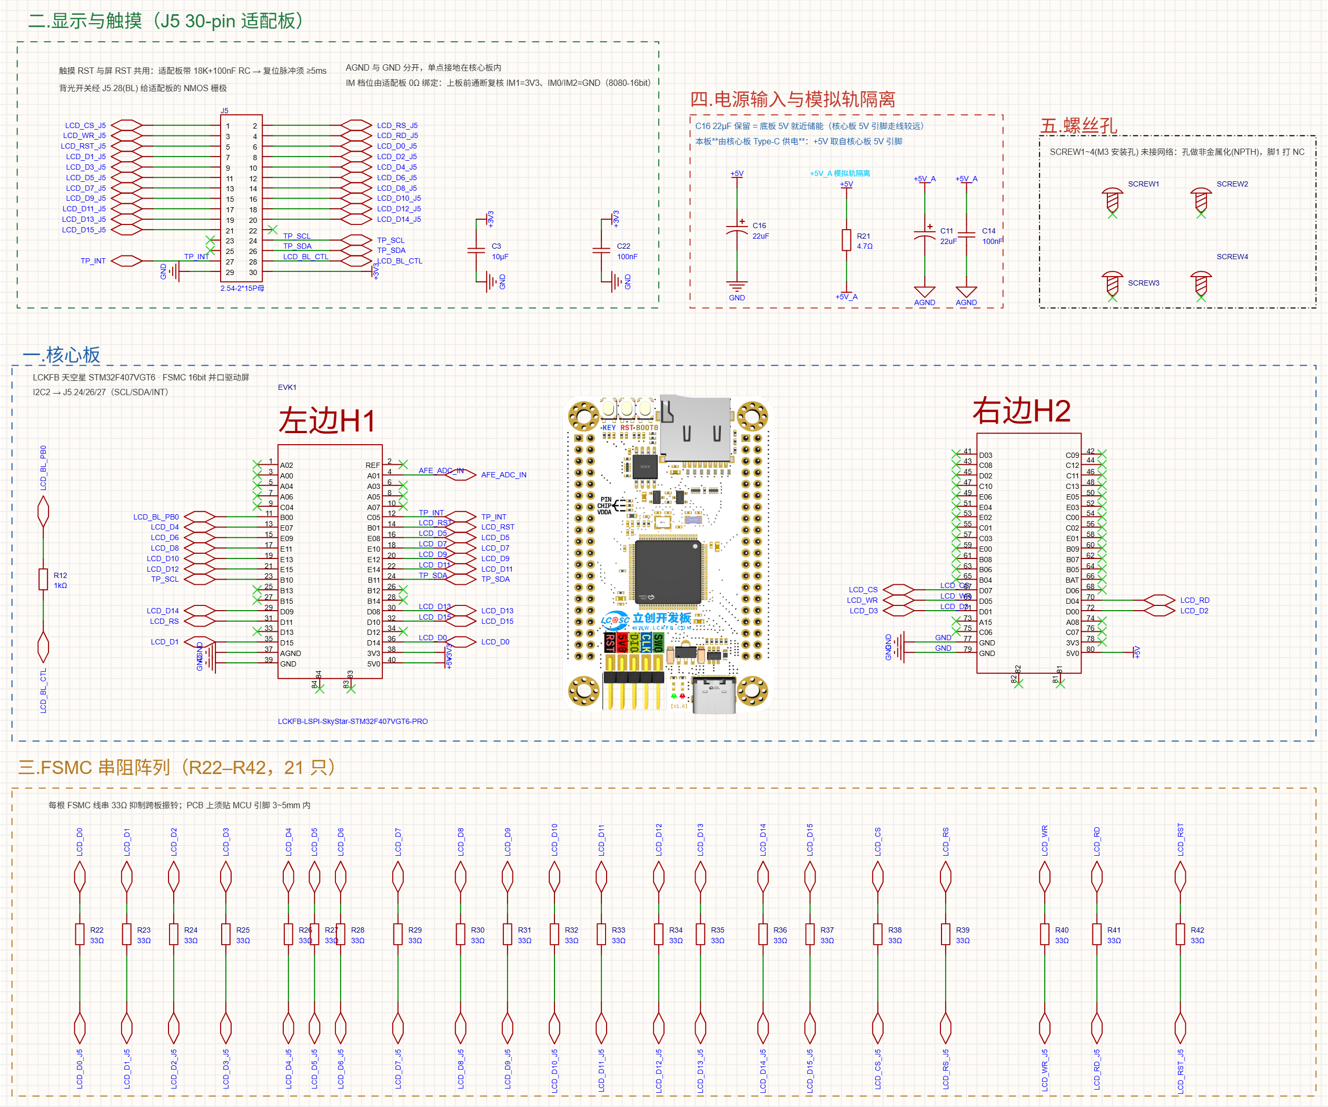
hardware/sch/G2026-INT.png
