funiang-x/G2026/tools/hardware/enclosure/out/case_v4_preview.png

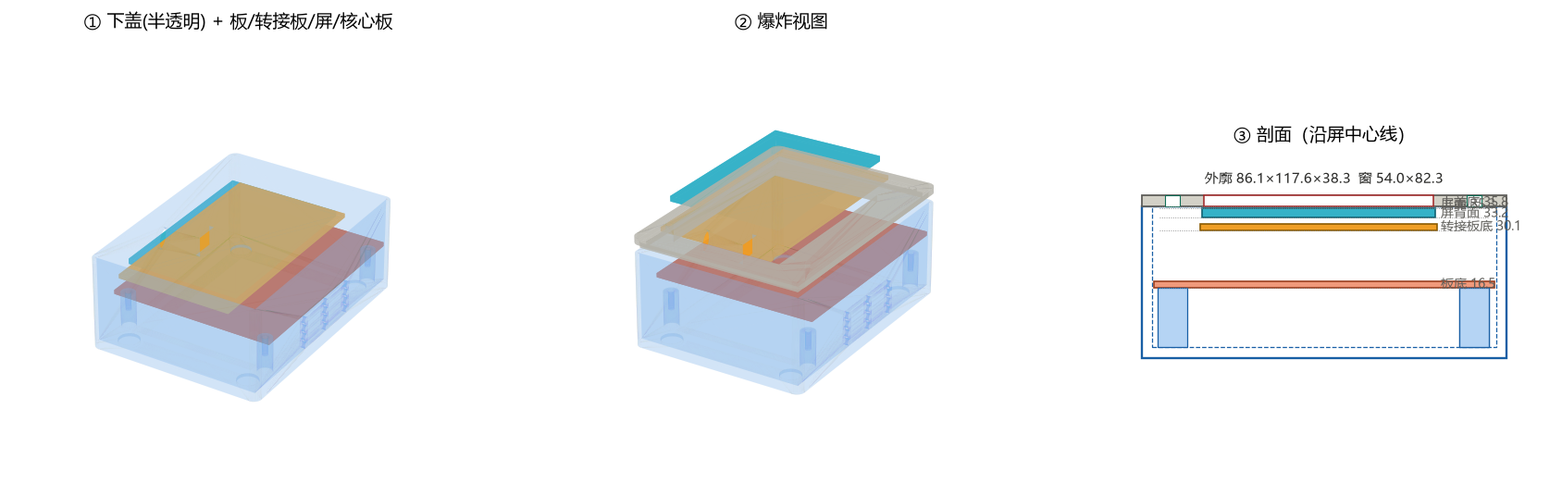
tools/hardware/enclosure/out/case_v4_preview.png
