funiang-x/G2026/hardware/66-原理图与BOM整理-20261017.md

# 66 · 原理图与 BOM 整理（2026-10-17）

> **性质**：台账（图纸 + BOM 真相源）｜**状态**：已执行
> **数据来源**：立创EDA 专业版活体工程 `G2026`（工程 UUID `a45fc831…`，文档 `G2026-底板原理V1`），
> 经 `easyeda sch list` / `sch netlist` / `sch nets` 回读，**不是**从旧文档转抄。
> **口径**：本文件与 `hardware/bom_final.csv` 是硬件数值与料号的**唯一真相源**；
> 与任何旧文档冲突时以本文件 + 活体原理图为准。

---

## 1 · 图纸清单与导出件

| 页 | 名称 | 位号数 | 导出件 |
|---|---|---|---|
| 1 | AFE-前端模拟 | 32（U1 双运放占 2 个符号实例） | [`sch/G2026-AFE.pdf`](sch/G2026-AFE.pdf) |
| 2 | INT-核心板与接口 | 34 | [`sch/G2026-INT.pdf`](sch/G2026-INT.pdf) |

> ⚠️ 活体工程当前只有 **AFE / INT 两页**，没有独立的 PWR 页；电源相关器件
> （`R21`、`C3`、`C11`、`C16`、`C14`、`C22`）都在 INT 页。旧文档说的“三页原理图”与现状不符。

**连通性基线（2026-10-17 改动后回读）**：
`sch nets` = **68 张网，无同轨异名，无单引脚网**；
`sch check` = 0 悬空脚 / 0 几何-网络不符 / 0 多网导线 / 0 悬空线 / 0 零长线；
`sch bridge-check` = **0 短路、0 孤桩**（37 棵树）。

---

## 2 · AFE-前端模拟逐件表

| 位号 | 数值 | 封装 | MPN | LCSC | 作用 |
|---|---|---|---|---|---|
| C1 | 100nF | **C0805** | CC0805KRX7R9BB104 | C49678 | 输入交流耦合，隔直 |
| C2 | 6.8nF | C0805 | GRM2195C1H622JA01D | **待补** | 抗混叠滤波并联臂 |
| C4 | 10nF | C0805 | 0805CG103J500NT | C2971995 | 抗混叠滤波并联臂 |
| C5 | 10µF | C0805 | CC0805KRX5R8BB106 | C1952586 | VBIAS 滤波/储能 |
| C6 | 10nF | C0805 | GRM2195C1H912JA01D/BKN | **待补** | 抗混叠滤波并联臂 |
| C7 | 10µF | C0805 | CC0805KRX5R8BB106 | C1952586 | VBIAS 滤波/储能 |
| C8 | 2.2nF | C0805 | 0805CG182J500NT | **待补** | 抗混叠滤波并联臂 |
| C9 | 100nF | **C0805** | CC0805KRX7R9BB104 | C49678 | 抗混叠滤波并联臂 |
| C10 | 470pF | C0603 | CL10C471JB8NNNC | C27694 | ADC 采样保持/就近去耦 |
| D1 | PESD5V0X1BT,215 | SOT-23-3 | PESD5V0X1BT,215 | C456094 | 输入 ESD 保护 |
| J1 | SMA-KE | SMA-SMD_SMA-KE | SMA-KE | C9900004802 | SMA 射频输入 |
| JP1 | 0Ω | R0805 | 0805W8F0000T5E | C17477 | 调试断点 |
| JP2 | 0Ω | R0805 | 0805W8F0000T5E | C17477 | AFE↔ADC 断点 |
| L1 | 4.7µH | IND-SMD_L7.0-W6.6 | XR0630-4R7M | C5307631 | 滤波串联臂 |
| L3 | 22µH | IND-SMD_L7.0-W6.6 | XR0630-220M | C5307626 | 滤波串联臂 |
| L5 | 22µH | IND-SMD_L7.0-W6.6 | XR0630-220M | C5307626 | 滤波串联臂 |
| L7 | 15µH | IND-SMD_L7.0-W6.6 | HCM0630-150M | C9900009031 | 滤波串联臂 |
| R1 | 49.9Ω | R0805 | 0805W8F499JT5E | C17720 | 50Ω 端接 |
| R2 | 10kΩ | R0805 | 0805W8F1002T5E | C38522 | 偏置/上拉网络 |
| R3 | 49.9Ω | R0805 | 0805W8F499JT5E | C17720 | 滤波器输入侧端阻抗 |
| R4 | 49.9Ω | R0805 | 0805W8F499JT5E | C17720 | 滤波器输出侧端阻抗 |
| R5 | 10kΩ | R0805 | 0805W8F1002T5E | C38522 | 偏置/上拉网络 |
| R6 | 6.8kΩ | R0805 | RT0805BRD0753K6L | **待补** | 同相增益 $R_f$ |
| R7 | 1kΩ | R0805 | ARG05BTC3571 | **待补** | 同相增益 $R_g$ |
| R9 | 10kΩ | R0805 | 0805W8F1002T5E | C38522 | VBIAS 上分压 |
| R10 | 10kΩ | R0805 | 0805W8F1002T5E | C38522 | VBIAS 下分压 |
| R11 | 300Ω | R0805 | 0805W8F3000T5E | C17617 | PA1 串联限流/钳位 |
| TP3 | — | TESTPOINT-TH_BD3.2 | TP-黄色测试点 | C9900007422 | 测试点 |
| TP4 | — | TESTPOINT-TH_BD3.2 | TP-黄色测试点 | C9900007422 | VREF+ 测试点 |
| TP5 | — | TESTPOINT-TH_BD3.2 | TP-黄色测试点 | C9900007422 | VBIAS 测试点 |
| U1 | OPA2197ID | SOIC-8 | OPA2197ID | C1347222 | 双运放：U1A 缓冲 + U1B 同相放大 |

**滤波网络实际取值（以图为准）**：`L1=4.7µH`、`L3=22µH`、`L5=22µH`、`L7=15µH`；
`C2=6.8nF`、`C4=10nF`、`C6=10nF`、`C8=2.2nF`、`C9=100nF`；端阻抗 `R3/R4=49.9Ω`。

---

## 3 · INT-核心板与接口逐件表

| 位号 | 数值 | 封装 | MPN | LCSC | 作用 |
|---|---|---|---|---|---|
| C3 | 10µF | C0805 | CC0805KRX5R8BB106 | C1952586 | 数字轨去耦 |
| C11 | 22µF | CAP-SMD_L3.5-W2.8 | TAJB226K025RNJ | C2837459 | 钽电容储能 |
| C14 | 100nF | C0805 | CC0805KRX7R9BB104 | C49678 | 去耦 |
| C16 | 22µF | CAP-SMD_L3.5-W2.8 | TAJB226K025RNJ | C2837459 | 钽电容储能 |
| C22 | 100nF | C0805 | CC0805KRX7R9BB104 | C49678 | 去耦 |
| EVK1 | SkyStar-STM32F407VGT6-PRO | COMM-TH_LCKFB… | LCKFB-LSPI-SkyStar-STM32F407VGT6-PRO | C32710423 | 核心板插座（2×20 双排） |
| J5 | 2.54-2×15P 母座（直插） | HDR-TH_30P-P2.54 | 2.54-2*15P母 | C58377 | 屏 30 pin 接口 |
| R12 | 1kΩ | R0805 | 0805W8F1001T5E | C17513 | 背光栅极串阻 |
| R21 | 4.7Ω | R0805 | RC0805FR-074R7L | C137513 | 模拟轨隔离 |
| R22~R42 | 33Ω ×21 | R0805 | 0805W8F330JT5E | C17634 | 屏总线源端阻尼（21 条） |
| SCREW1~4 | — | M3 螺丝 | — | **待补** | 安装孔（NPTH） |

> `R22~R42` 为 21 只独立位号，BOM 中合并为一行（Qty=21），逐只位号见
> [`bom_final.csv`](bom_final.csv)。

---

## 4 · BOM 汇总

> 完整机器可读版：[`hardware/bom_final.csv`](bom_final.csv)（UTF-8 BOM，可直接用 Excel 打开）。
> 共 **27 行、65 个器件**；其中 **6 行缺 LCSC 号**（C2、C6、C8、R6、R7 与 SCREW1~4）。

| 位号 | 数量 | 数值 | 封装 | MPN | LCSC |
|---|---|---|---|---|---|
| C1 C9 C14 C22 | 4 | 100nF | C0805 | CC0805KRX7R9BB104 | C49678 |
| C3 C5 C7 | 3 | 10µF | C0805 | CC0805KRX5R8BB106 | C1952586 |
| C4 | 1 | 10nF | C0805 | 0805CG103J500NT | C2971995 |
| C2 | 1 | 6.8nF | C0805 | GRM2195C1H622JA01D | **待补** |
| C6 | 1 | 10nF | C0805 | GRM2195C1H912JA01D/BKN | **待补** |
| C8 | 1 | 2.2nF | C0805 | 0805CG182J500NT | **待补** |
| C10 | 1 | 470pF | C0603 | CL10C471JB8NNNC | C27694 |
| C11 C16 | 2 | 22µF | CAP-SMD_L3.5-W2.8 | TAJB226K025RNJ | C2837459 |
| D1 | 1 | PESD5V0X1BT,215 | SOT-23-3 | PESD5V0X1BT,215 | C456094 |
| EVK1 | 1 | SkyStar-F407 | COMM-TH_LCKFB… | LCKFB-LSPI-SkyStar-STM32F407VGT6-PRO | C32710423 |
| J1 | 1 | SMA-KE | SMA-SMD_SMA-KE | SMA-KE | C9900004802 |
| J5 | 1 | 2.54-2×15P 母座 | HDR-TH_30P-P2.54 | 2.54-2*15P母 | C58377 |
| JP1 JP2 | 2 | 0Ω | R0805 | 0805W8F0000T5E | C17477 |
| L1 | 1 | 4.7µH | IND-SMD_L7.0-W6.6 | XR0630-4R7M | C5307631 |
| L3 L5 | 2 | 22µH | IND-SMD_L7.0-W6.6 | XR0630-220M | C5307626 |
| L7 | 1 | 15µH | IND-SMD_L7.0-W6.6 | HCM0630-150M | C9900009031 |
| R1 R3 R4 | 3 | 49.9Ω | R0805 | 0805W8F499JT5E | C17720 |
| R2 R5 R9 R10 | 4 | 10kΩ | R0805 | 0805W8F1002T5E | C38522 |
| R6 | 1 | 6.8kΩ | R0805 | RT0805BRD0753K6L | **待补** |
| R7 | 1 | 1kΩ | R0805 | ARG05BTC3571 | **待补** |
| R11 | 1 | 300Ω | R0805 | 0805W8F3000T5E | C17617 |
| R12 | 1 | 1kΩ | R0805 | 0805W8F1001T5E | C17513 |
| R21 | 1 | 4.7Ω | R0805 | RC0805FR-074R7L | C137513 |
| R22~R42 | 21 | 33Ω | R0805 | 0805W8F330JT5E | C17634 |
| SCREW1~4 | 4 | M3 螺丝 | M3 螺丝 | — | — |
| TP3 TP4 TP5 | 3 | 测试点 | TESTPOINT-TH_BD3.2 | TP-黄色测试点 | C9900007422 |
| U1 | 1 | OPA2197ID | SOIC-8 | OPA2197ID | C1347222 |

---

## 5 · 本次改动（C1 / C9 → 0805）

| 项 | 改前 | 改后 |
|---|---|---|
| 位号 | C1、C9 | 不变 |
| 数值 | 100nF | 100nF |
| 封装 | **C1206** | **C0805** |
| MPN | 1206CG104J500NT | **CC0805KRX7R9BB104** |
| LCSC | C46348 | **C49678** |

**做法与理由**：
1. 直接改封装引用会走平台的 `rebind-footprint` 事务，本次实测该事务在这颗器件上失败
   （返回 `EDA_CALL_FAILED`、回滚未验证）。因此改用 `sch replace` 换成工程内已验证的 0805 器件
   （与 C14/C22 同料号）。
2. 换件后符号引脚间距由 30 单位变为 40 单位，原导线端点需要重画。**两处网络的导线已按原拓扑重建**，
   改动后回读：
   - `C1`：pin1 与 `R1`/`D1` 同网，pin2 与右侧网络同网；
   - `C9`：pin1 与左侧网络同网，pin2 与 `2240` 竖支同网；
   - 全工程 `sch nets` = 68 网（与改前同数），0 单引脚网；`bridge-check` 0 短路 0 孤桩。
3. 换件会清空部分自定义属性：已回填 `C1` 的 LCSC（C49678）与 `C9` 的 Value（100nF），
   回读确认两者现在同属 BOM 行 `C1 C9 C14 C22 / 100nF / C0805 / C49678`。

**副作用（需要知道）**：
- 介质由 **C0G（1206CG…）** 变为 **X7R（CC0805KRX7R…）**。C1 是耦合电容，无影响；
  C9 在滤波并联臂上，X7R 的容值随温度/直流偏压有小幅变化（3.3V 偏压下远小于容差），
  若后续要压滤波精度，可换 0805 C0G（100nF/50V 的 0805 C0G 较少见，需另选型）。
- C1 与 C9 的**符号引脚间距**仍不同（C1 为 40 单位、C9 为 30 单位），电气等价，仅外观不同。

---

## 6 · 与旧文档的数值差异（旧值作废）

| 项 | 旧文档写的 | **本次回读（以此为准）** |
|---|---|---|
| 滤波电感 | 4.7 / 22 / 22 / **12** µH | 4.7 / 22 / 22 / **15** µH |
| 滤波电容 | **5.6** / 10 / 10 / **1.8** nF | **6.8** / 10 / 10 / **2.2** nF + 100nF(C9) |
| `R2/R5` | 未单列 | 10kΩ ×2（偏置网络） |
| `R11` | 旧文曾写 100Ω/1kΩ | **300Ω** |
| 原理图页数 | 三页（AFE/INT/PWR） | **两页**（AFE/INT），电源件在 INT 页 |
| C1/C9 封装 | C1206 | **C0805** |

> `docs/05`、`docs/06`、`docs/07`、`docs/paper` 中凡引用旧滤波器取值的段落，按本表更新。

---

## 7 · 待确认（不阻塞本轮）

1. **6 行缺 LCSC**：`C2`（6.8nF）、`C6`（10nF）、`C8`（2.2nF）、`R6`（6.8kΩ）、`R7`（1kΩ）
   只有 MPN 没有 C 号；下单前需在立创商城按 MPN 反查并回填。
2. `SCREW1~4` 为机械件，无 LCSC 属正常；若走装配需在 BOM 里单独标注“不贴”。
3. `C1/C9` 的介质变化（C0G→X7R）是否需要改回 C0G，取决于是否要求滤波精度不随温度漂移。

---

## 8 · 复现命令（只读）

```bash
# 逐页读器件（位号/数值/封装/料号）
easyeda sch list --page "AFE-前端模拟" --include-pins
easyeda sch list --page "INT-核心板与接口" --include-pins

# 连通性基线
easyeda sch nets
easyeda sch check
easyeda sch bridge-check

# 导出图纸
easyeda sch export-image --page "AFE-前端模拟" --format pdf --out hardware/sch/G2026-AFE.pdf
easyeda sch export-image --page "INT-核心板与接口" --format pdf --out hardware/sch/G2026-INT.pdf
```

---

**相关文档**：`docs/05`（讲义，数值已按本表对齐）· `docs/06`（补测）· `docs/07`（溯源）· `docs/INDEX.md`
