funiang-x/G2026/hardware/60-屏与核心板模块尺寸清单与对插高度-20261012.md

# 60 · 屏与核心板模块 · 尺寸清单与母座对插高度（2026-10-12）

> **用途**：**立创EDA 3D 外壳建模**的完整尺寸输入 —— 含「屏幕模块 / 核心板模块经 Pin 母座对插后的整体高度」。
> **性质**：只读资料整理。**已核实数**（规格书 / 厂方工程源文件 / 活体快照）与 **待实测数** 分开标注，凡未落实的绝不写成定数。
> **关系**：`58`（屏与转接板机械尺寸）的**增量** —— 新增 ① 核心板外形与排针（本任务解包出厂工程）② 母座对插层高（本次核心新增）③ 30pin 接口排距双源复核（发现与 J5 行距不一致 ⇒ 坐实为实物核对项）。
> **新证据目录**：`_work/mech_dim_20261012/`（核心板 `.epcb` 解包、转接板 `.epru` 解包、立创渲染图）
> **配图**：`_work/_mech/尺寸标注_屏与转接板.png`（屏/转接板按真实比例）

---

## §0 一屏结论（建模直接用的数）

### 0.1 四个件的外形（mm）

| 件 | 外形（长×宽） | 厚度 | 可信度 | 出处 |
|---|---|---|---|---|
| **① 屏**（LCD 模块 TK035F9629/ST7796） | **55.05±0.2 × 84.50±0.2** | **2.06±0.06** | ✅ 厂家规格书 | 规格书 P.4/P.5 |
| **② 转接板**（TK035F5501，屏厂配套件） | **98.70 × 56.00**（R1.275 圆角） | ~1.6【待实测】 | ✅ 外形（双源） | Altium `.pcbdoc` Board 记录 + 机构图 |
| **③ 核心板**（立创·梁山派·天空星 F407） | **70.0 × 45.0** | ~1.6【待实测】 | ✅ 外形（本任务新解包） | 官方 `.epro` 工程，见 §3 |
| **④ 底板**（G2026 自画） | **80.25 × 100.25** | 1.60 | ✅ 活体 | 活体 PCB bbox |

> ⚠️ **方向约定**：屏是**竖屏**（55.05 宽 × 84.50 高）；转接板是**横板**（98.70 长 × 56.00 宽）；**屏在转接板上居中**，长轴同向（84.50 贴 98.70 方向）。
> 核心板 70 沿底板 X、45 沿底板 Y（吊装在底板下方）。

### 0.2 竖向堆叠（★ 母座对插层高，本次核心结论）

| 连接 | 组成（标准件配合） | **层高（板面→板面）** |
|---|---|---|
| **屏模块**：底板顶面 → 转接板底面 | J5 母座塑高 **H**（8.5 标准 / 10.1 加高，**待实测**）+ 排针塑胶 **2.5** | **11.0**（H=8.5）/ **12.6**（H=10.1）|
| **核心板**：底板底面 → 核心板（针面） | 双排母塑高 **8.5** + 排针塑胶 **2.5** | **11.0** |
| **核心板**：底板底面 → 核心板底（板背面） | 上式 + 核心板厚 ~1.6 | ≈ **12.6** |

> **推导**（详见 §5）：标准 2.54 排针总长 11.6（焊端 3.1 / 塑胶 2.5 / 插针端 6.0）；插入 8.5 母座到"塑胶面与母座口平齐"时**针尖距孔底还有约 0.4 余量** —— 自洽全插配合。故 **层高 = 母座塑高 + 2.5**。

### 0.3 相对底板面的总堆叠（屏面朝上、核心板吊于下方，均按 H=8.5 档）

```
 屏面（玻璃顶）        ≈ 底板顶面 +14.96   ← 上盖内面 ≥ +15.3
 屏背面                ≈ +12.9（含背胶 0.3 名义）
 转接板顶面            =  +12.6
 转接板底面（排针出针）=  +11.0           ★ 对插层高
 底板顶面              =   0
 底板底面              =  -1.6
 核心板针面            = -11.0 -1.6 = -12.6（核心板面）★ 对插层高 11.0
 核心板底面元件最高点  ≈ -12.6 −（元件高，**待实测**，估 3~4）→ 外壳内底 ≥ -17
```

**外壳内腔总高（暂按 8.5 档 + 元件 4mm + 上下各 0.3~1.0 余量）：约 32.5 ~ 33 mm。**

---

## §1 屏（LCD 模块 TK035F9629 / ST7796）

| 项 | 数值 | 出处 |
|---|---|---|
| 模块外形 | **55.05 ±0.2 × 84.50 ±0.2 mm** | 规格书 P.5 |
| 模块厚度 | **2.06 ±0.06 mm** | 规格书 P.5 侧视图 |
| 玻璃外形（LCD OD） | **52.96 × 81.34 mm**（居中于模块） | 规格书 P.5 |
| **可视区（LCD AA）** | **48.96 × 73.44 mm**（居中于玻璃） | 规格书 P.4/P.5 |
| 分辨率 / 像素间距 | 320RGB×480 / 0.1395 × 0.1395 mm | 规格书 P.4 |
| FPC | **45 pin，0.3 mm 间距**；型号 `CDN1TDRFH26-45S-0.3SHW(05)` | 规格书 P.5 注释 |
| FPC 引出长度 | **9.67**（图上标注；**归属/有效长度待实物核**） | 规格书 P.5 |
| 视角 | 6 O'CLOCK（正视）；工作温度 −20 ~ +70 ℃ | 规格书 P.4/P.6 |

**开窗建议**：≥ AA（48.96×73.44），按**玻璃 52.96×81.34 + 单边 0.3~0.5** 留公差与视角余量。
**压边可用区**：玻璃外沿→模块外沿，**短向单边 1.045、长向单边 1.58**（压边不得压到玻璃）。

---

## §2 转接板（TK035F5501，屏厂配套件）

### 2.1 板框与安装孔（双源一致）

| 项 | 数值 | 出处 |
|---|---|---|
| 板框 | **98.70 × 56.00 mm**，四角 R ≈ 1.275 | Altium Board 记录（56.01×98.71）+ 机构图标注 |
| **安装孔** | **4 × Ø3.00 mm**，孔距 **92.70 × 50.00**（距板边各 3.00） | Altium Pad 记录 |
| **定位孔** | **2 × Ø1.70 mm**，间距 **33.02 mm**（位于 30pin 两排正中） | Altium Pad 记录（双源复核见 §5.4） |
| 板厚 | **未查到，常规 1.6【待实测】** | Altium 无层叠记录 |

### 2.2 接口位置与方向（本任务双源复核）

| 接口 | 位置 | 几何 |
|---|---|---|
| **30pin 排针接口**（"公认通用"） | 板一端的**居中**位置（沿 56 方向跨 35.56，两端各距板缘 10.2，"两排"沿板长方向，距该端板缘约 1.8 / 7.0） | **两排 1×15**：列距 **2.54**、跨度 **35.56**；**两排中心距 5.199 mm**（=204.7245 mil，Altium 与立创版**双源一致**）；附 §2.1 的 2 定位孔 |
| **45pin FPC 座**（屏 FPC 插这里） | 板**左侧中段**（距左板缘 5.76 / 8.76 两列；沿板长居中偏上） | 双排 0.3 mm 间距（23 + 22 脚） |
| 其余（触摸座 P1/P2/P6、Q1、阻容） | 顶部与右侧 | 见渲染图 `_work/mech_dim_20261012/adapter_render.webp` |

> ⚠️ **30pin 排距 5.2 mm 与底板 J5 行距 2.54 mm 不一致** —— **两源都是 5.2**（不是测量误差）。
> ⇒ **直插装配方式必须实物验证**（试插）；若确不可直插，需按"两条 1×15 单排针/座"方案转换或改换连接器。见 §8 核对表 #4。

---

## §3 核心板（立创·梁山派·天空星 STM32F407VGT6，本任务新解包）

| 项 | 数值 | 出处 |
|---|---|---|
| **板框外形** | **70.0 × 45.0 mm**（1771.46 × 2755.91 mil） | 官方 `.epro` → `.epcb` 解包：DIMENSION 标注（44.97 / 69.97）、POUR 矩形（1770 × 2750 mil）、OBJ 机械图尺寸**三重印证**；与活体焊盘 bbox（70.2 × 45.3）吻合 |
| 板厚 | ~1.6【待实测】 | 工程无层叠记录 |
| **排针** | **2 × `HDR-TH_40P-P2.54-V-M-R2-C20-S2.54`** 公排针（2×20 ×2 组，共 80 pin），**行距 2.54** ✓ | `.epcb` 器件 e56/e57 ATTR（3D Model Title 佐证）+ 活体焊盘 |
| 排针位置 | 沿板长两边；两组中心距 **35.56 mm** | 活体 PCB（P1/P2 组 y = −7385/−7285、−5985/−5885） |
| 出针面 | **与丝印面相反**（针从背面出） | 台面实测（`21` 接线卡）+ 官方渲染图 |

**与底板的关系**：核心板吊装在底板**下方**（EVK1 区 = 底板坐标 (1.08, 53.61)–(71.31, 98.87)，即 70.23 × 45.26）；**底板座 = 2×20 双排母 ×2（8.5 档、直插）** —— 行距 2.54 与核心板排针**匹配** ✓（与屏模块那对 5.2/2.54 的情况不同）。
> ⚠️ **BOM 缺口**：`hardware/data/bom_export_20261011.csv` 中 `EVK1` 行 = 核心板整板；**接收它的 2×20 双排母 ×2 尚无采购行**，下单前需补。

---

## §4 底板（G2026 自画板）

| 项 | 数值 | 出处 |
|---|---|---|
| 外形 | 80.25 × 100.25 × 1.60 | 活体 bbox |
| **J5**（2×15P 母座 `2.54-2*15P母`，BOOMELE C58377） | 中心 (38.86, 82.85)；**行距 2.54、列距 2.54、列跨 35.56**（活体焊盘实测） | `hardware/data/pcb_snapshot_20261011.json` |
| M3 螺钉孔 | 4 个：SCREW1 (4.32, 4.50)、SCREW2 (75.56, 4.50)、SCREW3 (40.64, 46.53)、SCREW4 (75.56, 94.16)；**SCREW3 在屏正下方 ⇒ 勿用于锁壳** | 活体 |
| J1（SMA-KE） | 板左缘，中心 (3.56, 41.55) | 活体 |
| 转接板相对位置 | 转接板**向底板 −Y 方向伸出板外约 11.5 mm**（外壳内腔必须覆盖） | `tools/hardware/enclosure/build_case_v4.py` |

---

## §5 母座对插层高（★ 本次核心结论，可直接用于净空计算）

### 5.1 标准件几何（推导基础）

| 件 | 几何 | 说明 |
|---|---|---|
| 2.54 mm 公排针（标准 11.6 mm） | 焊端 3.1 / 塑胶 **2.5** / 插针端 **6.0** | 贴板焊接后，针尖距板面 8.5 |
| 2.54 mm 母座（8.5 档/10.1 档） | 塑高 8.5 / 10.1；孔径与 6.0 插针配套 | 焊盘侧针脚穿板 |

**配合关系（全插到底时）**：插针 6.0 全部没入母座孔；**排针塑胶面与母座开口面齐平**；针尖距孔底尚有 ~0.4 余量。
⇒ **对插层高（板面 → 板面）= 母座塑高 + 2.5（排针塑胶）**。

### 5.2 屏模块（底板顶面 → 转接板底面）

```
        屏 55.05×84.50×2.06（居中贴装）
   ┌──────────────────┐
   │ 转接板 98.70×56  │ ← 底面出针（30pin 两排）
   └───────┬──────────┘
       排针（塑胶 2.5 + 插针 6.0）         层高 = J5 塑高 + 2.5
   ┌───────┴──────────┐
   │ J5 母座（8.5 或 10.1）│
   │ 底板 1.6          │
   └──────────────────┘
```

- **H=8.5（标准款）⇒ 层高 11.0 mm**；**H=10.1（加高款）⇒ 层高 12.6 mm**。
- v4 外壳脚本现值 `adapter_z=12.0` 介于两者之间（口径：J5 座高 ~10.1 + 排针塑体）→ **拿到实物以 §8 #1/#2 定案**。

### 5.3 核心板（底板底面 → 核心板）

- 母座 8.5 档（工程建议）⇒ **层高 11.0 mm**；核心板板厚 ~1.6 ⇒ **核心板底面距底板底面 ≈ 12.6 mm**。
- **核心板侧对插几何已闭合**（针/座行距均 2.54 ✓）；唯一变量是核心板朝下元件的最高点（Type-C 等）。

### 5.4 30pin 排距的双源复核（本次新证据）

对同一接口用**两个独立源文件**解出同一几何：

| 源 | 解出 | 结果 |
|---|---|---|
| Altium `.pcbdoc`（1000 亮度版） | P_Head_2x15 全部 32 焊盘：奇数脚 Y=3071.1、偶数脚 Y=3275.8 mil | 排距 **204.7 mil = 5.199 mm** |
| 立创工程 `.epro2`（同款恒流版） | FOOTPRINT `P_Head_2x15` 焊盘 1–30 局部坐标：Y = 0 / −204.7245 mil；另 2 孔间距 1300 mil | 排距 **204.7245 mil = 5.2 mm** |

⇒ 5.2 mm（公制）**double-confirmed**，不是笔误；与 J5 的 2.54 mm 行距**不匹配**，装配方式待实物核（§8 #4）。

---

## §6 外壳净空 / 外形建议（按 H=8.5 档，供建模起点）

| 部位 | 建议值 | 依据 |
|---|---|---|
| 内腔水平（X×Y） | **≈ 81 × 112.7 mm** | 底板 80.25 + 单边 0.4；Y 需覆盖转接板外伸段 |
| 内腔垂直（板顶面以上） | **≥ 15.3 mm**（屏面 14.96 + 0.3） | §0.3 上段 |
| 内腔垂直（板底面以下） | **≥ 15.8 ~ 16.6 mm**（待元件高实测） | §0.3 下段 |
| 上盖开窗 | **53.96 × 82.34**（=玻璃 + 单边 0.5）起步 | §1 |
| 侧壁/底/顶板厚 | 2.5（v4 现值，可调） | `tools/hardware/enclosure/build_case_v4.py` |

> **已有参数化脚本**：`tools/hardware/enclosure/build_case_v4.py`（cadquery → STEP/STL，双击 `重跑.bat`）。
> 本清单与它的差异点：`adapter_z` 应按 §8 #1 定档（11.0 或 12.6），`bot_depth` 按 §8 #6/#7 实测修正。

---

## §7 建模基准（坐标与方向约定）

- **原点**：底板框 bbox 左下角（板坐标）；单位 mm。
- **X**：沿底板 80.25 方向（右）；**Y**：沿底板 100.25 方向（上）；**Z**：从底板顶面起算，向上为正（屏在上），向下为负（核心板在下）。
- 屏/转接板以 **J5 中心 (38.86, 82.85)** 为基准：转接板宽 56 居中于 J5 的 X；转接板沿 −Y 外伸 11.5（全板长 98.7）。
- 屏在转接板上居中：屏长 84.50 沿转接板长 98.7（两端各留 7.10），屏宽 55.05 沿转接板宽 56（两侧各留 0.475）。

---

## §8 实测核对表（实物到齐后 ~30 分钟量完，7 项）

| # | 量什么 | 怎么量 | 影响 |
|---|---|---|---|
| 1 | **J5 母座塑高** | 卡尺：底板顶面 → 母座顶面（判 8.5 / 10.1） | 屏模块层高 11.0 / 12.6 |
| 2 | **屏模块试插层高** | 转接板插到底后量：底板顶面 → 转接板底面 | 直接写进外壳净空 |
| 3 | **转接板板厚** | 卡尺（估 1.6） | 总堆叠 +板厚 |
| 4 | **30pin 排距实物核对** | 量转接板 30pin 两排孔中心距（5.2？），与 J5 试插 | **能否直插**；不能则改连接方案 |
| 5 | **FPC 弯折空间** | 屏背 → 转接板顶面间距 + FPC 有效长度（≥9.67？） | 屏距转接板间隙（防压伤） |
| 6 | **核心板试插层高** | 底板底面 → 核心板针面（预估 11.0） | 下方净空 |
| 7 | **核心板朝下元件最高点 + 板厚** | 卡尺（Type-C/电感等） | 下方净空 |

---

## §9 出处清单（引用的本地路径全部真实存在）

| 数据 | 文件 / 来源 |
|---|---|
| 屏外形/玻璃/AA/厚/FPC | `docs/TK035F5687_9629_整理资料_(含SPI及并口版)/01_文档规格书/TK035F9629_ST7796版/TK035F9629规格书v1.2.pdf`（P.4/P.5） |
| 转接板板框/孔/30pin 焊盘 | `…/05_硬件转接板资料/1000亮度转接板/Altium_TK035F5501_adapter_Constant_current/TK035F5501_adapter_Constant_current.pcbdoc`（`\|RECORD=` 分隔 ASCII） |
| 转接板（立创版）footprint 复核 | `…/1000亮度转接板/TK035F5501_adapter_Constant_current.epro2` → 本任务解包 `_work/mech_dim_20261012/adapter.epru`（P_Head_2x15 焊盘 Y=0/−204.7245 mil） |
| 转接板渲染图 | `_work/mech_dim_20261012/adapter_render.webp`（`.epro2` → `IMAGE/…webp`） |
| **核心板外形/排针** | `docs/立创·梁山派·天空星STM32F407VET6开发板资料（标准库）/第02章【立创·梁山派·天空星STM32F407开发板】硬件/立创梁山派·天空星-嘉立创EDA工程文件/立创梁山派·天空星开发板_2024-01-17.epro` → 本任务解包 `_work/mech_dim_20261012/skystar.epcb`（DIMENSION e181/e185、POUR、OBJ、e56/e57 排针 ATTR） |
| 底板 J5/螺钉孔/SMA | `hardware/data/pcb_snapshot_20261011.json`（活体快照） |
| BOM（含 EVK1 缺母座） | `hardware/data/bom_export_20261011.csv` |
| 外壳脚本参数对照 | `tools/hardware/enclosure/build_case_v4.py` |
| 屏/转接板比例图 | `_work/_mech/尺寸标注_屏与转接板.png` |

> **复算方式**：转接板 `.pcbdoc`/`.epro2` 与核心板 `.epro` 均为**可解包文本/zip**（见 §5.4），本任务脚本留档 `_work/mech_dim_20261012/`；任何数字可按上述路径重解。
