funiang-x/G2026/hardware/62-外壳实况比对与修改清单-20261012.md

# 62 · 外壳实况比对与修改清单（SMA / USB / 屏幕开窗）（2026-10-12）

> **用途**：**直接读你 PCB1 里已做好的 3D 外壳**，把实测几何换算到板坐标，给出 **SMA / USB(Type-C) / 屏幕开窗** 三处的 **现状 → 建议值** 与填写指导。
> **性质**：只读实测 + 计算（**未改动你的工程任何对象**）。数值全部可由 `_work/mech_dim_20261012/` 脚本复算。
> **前提（重要）**：立创EDA **公开 API 不能写外壳层**（详见 §6），所以本清单是"**给你在 EDA 里照改的精确数值**"，不是自动写入。
> **关联**：`58`（屏/转接板）· `60`（堆叠与对插层高）· `61`（设计基准与开孔表）

---

## §0 一屏结论（三处）

| 项 | 你的现状（板坐标） | 尺寸 | 建议值 | 结论 |
|---|---|---|---|---|
| **屏幕开窗** | 中心 (39.69, **44.08**)，位于上壳顶面 | **56.0 × 85.0** | 中心 **(38.86, 37.90)**；尺寸 **≤ 54.45 × 83.90**（推荐 **53.96 × 82.34** = 玻璃 + 单边 0.5） | ⚠️ **窗比屏模块(55.05×84.5)还大 0.95mm ⇒ 压不住屏**；中心需下移 6.18 |
| **SMA 孔** | 左壁，板 y = **41.75**，高度 Z = **−4.5** | **8.5 × 8.0** | 板 y = **41.55**；高度 Z = **+4.5**（SMA 座在板**顶**面，中心高出板面 4.5） | ⚠️ **平面位置对（差 0.2）；高度低了 9.0mm** |
| **USB(Type-C) 孔** | 左壁，板 y = **86.00**，高度 Z = **−11.0** | **12.0 × 5.0** | 板 y 按核心板 Type-C 实际位置核（v4 假设 76.20）；高度 Z ≈ **−12.5 ~ −14.0**（核心板吊装层 11 + 板厚 1.6 + 座中心） | ⚠️ **高度偏低约 1.5~3.0mm；平面位置差约 9.8mm，需按实物核** |

---

## §1 分析怎么做的（可复算）

**读法**：经 API Gateway（`bridge-server.mjs`，端口 49620）调 `eda.pcb_ManufactureData.get3DShellFile('…','obj')`
→ 得到 zip，内含 `3DShell_p_T.obj`（上壳）/ `3DShell_p_B.obj`（下壳）→ 分块取回本地 → 解析。

**坐标映射（三条 M3 孔位拟合，残差 ≈ 0.2 mm）**：

```
板 x = 导出X − 43.62
板 y = 193.17 − 导出Z        ← 导出坐标在 Z 轴上与板坐标反向
板 Z(高度) = 导出Y − 20.0    ← 见 §1.1 基准推导
```

**拟合依据**（你外壳上 3 个 Ø4/Ø6.5 孔 ↔ 底板可用 M3 孔）：

| 你的孔（导出） | → 板坐标 | 底板孔位 | 差 |
|---|---|---|---|
| (47.81, 188.59) | (4.19, 4.58) | SCREW1 (4.32, 4.50) | 0.15 |
| (119.31, 188.59) | (75.69, 4.58) | SCREW2 (75.56, 4.50) | 0.16 |
| (119.31, 99.09) | (75.69, 94.08) | SCREW4 (75.56, 94.16) | 0.16 |

> ✅ 且第 4 角 (4.32, 94.16) **你和我都没做孔**——与底板"只有 3 个可用 M3 孔"完全一致，反证映射正确。

### 1.1 高度基准（自洽性验证）

用"**上下壳分界面 = 板顶面**"（导出 Y = 20）代入既有设计链：

```
板顶(0) + 11.0(母座对插层高) + 1.6(转接板) + 1.5(FPC) + 2.06(屏) = +16.16
20.0 + 16.16 = 36.16  ≈  你外壳实测总高 36.00     （偏差 0.16 → 自洽 ✓）
```

对照：若按"SMA 在板顶+4.5"反推板顶（导出 Y=11），则总高只有 ~27 ✗ 不成立。
⇒ **采用 板顶 = 导出 Y 20**，本文全部高度按此换算。

---

## §2 外壳总体实测

| 项 | 实测值 | 对照设计（`61`） | 备注 |
|---|---|---|---|
| 外廓（平面） | **85.00 × 133.00** | 86.05 × 117.70 | 长向 **多 15.3** |
| 总高 | **36.00**（下壳 20 + 上壳 16） | 37.26 | 差 1.26（因壁厚/底厚不同） |
| **壁厚** | **3.0**（左右实测） | 2.5 | — |
| **内腔** | **79.0 × 127.0** | 81.05 × 112.70 | ⚠️ 见 §4 风险 1 |
| 内部支撑/螺柱 | **未检出**（下壳内除孔壁外无柱体特征） | 3 × Ø7 螺柱 | ⚠️ 见 §4 风险 3 |
| M3 孔（上壳过孔） | 3 处，Ø4（上壳内面还测得 Ø6.5 沉孔） | Ø3.4 过孔 | 尺寸待定 |

---

## §3 三处开孔详表

### 3.1 屏幕开窗（上壳顶面，贯穿 Y 32.23~36）

| 项 | 值 |
|---|---|
| 实测（导出） | 中心 (83.31, 149.09)；尺寸 **56.0 × 85.0** |
| 实测（板坐标） | 中心 **(39.69, 44.08)**；尺寸 56.0 × 85.0 |
| 相对外壳 | 距左外壁 42.00、距南端外壁 58.50（自 (41.314, 90.590) 起算） |
| 建议中心 | **(38.86, 37.90)** = 与母座 J5 同心（偏置 (0, −44.95)） |
| 建议尺寸 | **53.96 × 82.34**（玻璃 52.96×81.34 + 单边 0.5）；上限 **54.45 × 83.90**（压边 ≥0.3） |
| 风险 | 现窗 56.0 **> 屏模块 55.05** ⇒ 屏无支撑、可掉出；中心偏北 6.18 |

### 3.2 SMA 孔（左壁，板 x −2.31 外表面）

| 项 | 值 |
|---|---|
| 实测（导出） | U(Z)[147.17,155.67] × V(Y)[11.5,19.5]；中心 (151.42, **15.5**) |
| 实测（板坐标） | 板 y = **41.75**，高度 Z = **−4.5**；尺寸 **8.5 × 8.0** |
| 设计目标 | 板 y = **41.55**（J1 SMA-KE 中心）、**Z = +4.5**（座在板顶面，中心高出板面）；开孔 Ø8.5 |
| 判定 | 平面 ✓（差 0.2）；**高度 ✗ 低 9.0mm**；孔径 ✓ |

### 3.3 USB（Type-C）孔（左壁）

| 项 | 值 |
|---|---|
| 实测（导出） | U(Z)[101.17,113.17] × V(Y)[6.5,11.5]；中心 (107.17, **9.0**)；另测孔内台阶收窄到 Z[103.45,110.48]（宽 7.03） |
| 实测（板坐标） | 板 y = **86.00**，高度 Z = **−11.0**；尺寸 **12.0 × 5.0**（内台阶 7.03 宽） |
| 设计参考 | v4 假设：板 y = 76.20、Z = −10.0、孔 12 × 8；Type-C 在核心板，核心板吊装层高 11 ⇒ 座中心约 Z = −12.5 ~ −14.0 |
| 判定 | 高度偏低 1.5~3.0；平面位置差 ~9.8（**以实物核**）；孔高 5.0 < 8（是否够插拔需按 Type-C 座实测） |

---

## §4 三个必须处理的风险

1. **内腔比底板窄 1.25 mm** —— 内腔实测 **79.0 × 127.0**，而底板 bbox **80.25 × 100.25** ⇒ **板放不进去**。
   处置：内腔 X 向至少 **+1.5**（左右各留 0.4~0.5 间隙）⇒ 内腔 ≥ 81.05（或把壁厚由 3.0 减到 2.5 并外廓加宽）。
2. **屏窗过大**（56.0 > 屏模块 55.05）⇒ 屏无压边、无法定位/固定。按 §3.1 建议值改。
3. **下壳未检出螺柱/支撑** —— 若外壳要承板，需补 3 处支撑（对应 SCREW1/2/4），柱位与上壳 3 个 Ø4 孔**同心**：
   | 位号 | 板坐标 | 上壳孔（导出） |
   |---|---|---|
   | SCREW1 | (4.32, 4.50) | (47.81, 188.59) |
   | SCREW2 | (75.56, 4.50) | (119.31, 188.59) |
   | SCREW4 | (75.56, 94.16) | (119.31, 99.09) |

---

## §5 在立创EDA 里怎么填（对照表）

**坐标口径**：下面给 **板坐标**（底板框左下角为原点，mm，X 右 Y 上）；若你的外壳编辑器用"外壳自身坐标"，改用括号内的**相对外壳值**。

| 开孔 | 填什么 | 基准 |
|---|---|---|
| 屏幕开窗 | 中心 X **38.86**（= 距左外壁 42.00）、Y **37.90**（= 距外壳南端 58.50）；尺寸 **53.96 × 82.34** | 与母座 J5 同心 |
| SMA 孔 | 板 y **41.55**；高度 **板顶面 +4.5**（= 外壳外底上方 **24.5**）；Ø **8.5** 通孔 | J1 中心 |
| USB 孔 | 板 y **以实物核**（v4 参考 76.20）；高度 **板顶面 −12.5 ~ −14.0**（= 外壳外底上方 **6.0 ~ 7.5**）；开口 **12 × 6 ~ 8** | Type-C 座位置 |

**自检三问**（改完在 EDA 里量一遍）：
1. 屏窗两条边是否都**小于**屏模块 55.05 × 84.50？（压边 ≥0.3/边）
2. 内腔宽是否 **> 80.25 + 0.8**？
3. SMA 孔中心是否**高于板顶面**（在外壳外底上方 24.5 附近）？

---

## §6 能力边界（为什么不能替你写）

立创EDA 的 `SHELL_3D_OUTLINE/TOP/BOTTOM`（层 53/54/55）**只在"可选层"清单**里；官方图元类型 `TPCB_LayersOfFill / OfLine / OfRegion / OfObject` **均不含外壳层**，对外壳**只有导出（`get3DShellFile`）与下单（`place3DShellOrder`）两个接口**。
⇒ 外壳几何写入 = **unsupported**；本清单给的是**精确数值**，落图需你在 EDA 界面完成（`easyeda-agent` 硬红线亦禁止 GUI 自动化代改）。

---

## §7 出处与复算

| 数据 | 来源 |
|---|---|
| 外壳几何（上下壳 OBJ） | 活体 PCB1 `get3DShellFile` 导出 → `_work/mech_dim_20261012/shell/3DShell_T.obj` · `3DShell_B.obj` |
| 取回脚本 | `_work/mech_dim_20261012/fetch_shell.py` |
| 解析 / 开孔识别 | `_work/mech_dim_20261012/shell_analyze.py` · `shell_holes.py` |
| 映射与聚类 | `_work/mech_dim_20261012/shell_probe.py` |
| 底板孔位 / 母座 / SMA | `hardware/data/pcb_snapshot_20261011.json`（活体） |
| 设计基准 | `hardware/61-外壳设计与30pin母座对位开孔-20261012.md` · `60` · `58` |

> **复算**：`python shell_holes.py all`（开孔识别）· `python shell_probe.py`（映射与聚类）。
> **诚实边界**：高度基准取"上下壳分界面 = 板顶面"（自洽性 0.16mm）；SMA/USB 的**目标高度**依赖 v4 的装配假设，**上壳前请以实物核对**（把板+核心板装进外壳量一次）。
