funiang-x/G2026/hardware/03-components.md

# G2026 硬件方案 · 03 选型结论表 · v2

> ⚠️ **2026-09-30 勘误指针**：增益电阻 R6 已由 30kΩ 改 **69.8kΩ（0805W8F6982T5E）**，
> U1B 增益 ×4→×8；~~C12（22µF 钽挂 VREF）**待 datasheet 复核后处置**（14 号 D8）~~ → ✅ **2026-10-03 已删**（`C12`/`JP3`/`TP6` 同属"`VREF` 留位死支路"，见 `30 §5`/`33 §50`）。
> 以 `15-评审与开发-20260930.md` 为准；BOM 见 `bom_final.csv`。
>
> 阶段一选型 · 2026-09-28 · 状态：**待 [CHK] 人确认**
> v2：前端实现改为「无源 LC 8 阶 + OPA2197」，MCU 改核心板自带；参数全部联网/datasheet 复核或脚本复算（`verify_afe_v2_report.md`）。

## 1. 选型结论表（工作台 20 分册格式）

| # | 器件位 | 选定型号 | 关键参数（复核值） | 落选者与理由 | 替代料 | 采购渠道 |
|---|---|---|---|---|---|---|
| 1 | 主控 | **立创·天空星 STM32F407VGT6 高配版核心板**（不采购、不画最小系统） | ADC 12bit 2.4MSPS（36MHz ADCCLK、15 周期=417ns）支撑 fs=2.0MSPS/83% 占空（复核✓）；168MHz/1MB/192KB；VREF+ 三路可选（板载基准/排针外部基准/主电源磁珠）；板载 LDO SCJA1117B-3.3 自供 | 全自定义单板：重复造核心板 | 无（锁定） | 既有（≈¥49.9 立创有售） |
| 2 | 抗混叠滤波器 | **无源 LC 8 阶巴特沃斯 fc=800kHz，50Ω 系统** | 精确衰减：@1.5MHz **−43.7dB**、@2.5M −79dB、@1.0M −15.6dB（脚本复算✓）；双端接梯形低灵敏度；E24 取值 L=3.9/16/20/11µH、C=4.3/7.5/6.8/1.6nF（偏差 ≤4%，标定吸收） | 有源 SK 8 阶（需 GBW≥205MHz 运放，TLV3544 贴线且有 Q 稳定性风险，¥30）；切比雪夫（0.1dB 波纹 Q=8.08，容差敏感，±1.16mV 通带起伏）；同步调谐 RC 级联（@1.5M 仅 −18dB 不足） | 阶数/fc 不动；电感缺货则同规格绕线件平替 | 电感：立创绕线 SMD（CD54/CD75/SWPA 类）；电容：C0G/NP0 0805/1206 |
| 3 | 电感规格 | 绕线 SMD 4.7µH?否——**3.9/16/20/11µH** 四值 | **SRF ≥12MHz、DCR ≤0.5Ω、Isat ≥50mA**（信号电流仅 4.5mA pk）；手焊 0805/1206 | 多层叠层铁氧体（SRF 5~10MHz 落在使用频段，滤波形状不可控） | 同规格任意绕线系列 | 立创按规格筛（下单复核） |
| 4 | 运放（输入跟随 + 增益） | **OPA2197（双运放，手头已有，1 片）** | GBW 10MHz、SR 20V/µs、RRIO、4.5~36V、Vos 25µV、1mA/ch（datasheet 复核✓）。半 A=BUF1（G=1，高阻读端接节点，经 50Ω 串阻驱动 LC；小摆幅最线性区，SR 1.8V/µs）；半 B=GAIN（×4，滤波后 u_J 已 −43.7dB → IM3 无从产生；低阻输出经 100Ω/470pF 直驱 ADC）。不加第三管：×4 已是低阻驱动，串 G=1 零收益 | TLV3542/OPA2350（达标但需新购）；增益前置（u_J 未滤先入运放，IM3 产物落带内且滤波器无法去除） | OPA2350A（无备件再购） | 手头库存（SOIC-8） |
| 5 | ADC 基准（VREF+） | **REF3033AIDBZR**（SOT23-3） | 3.3V ±0.2%（A 档）、50ppm/°C、50µA（复核✓）；**天空星 VREF+ 三路可选（R1/R2/R4 贴法），走"排针外部基准"注入——官方支持路径**（具体电阻位/排针脚阶段二对原理图确认）；1.65V 偏置=VREF/2，ratiometric 于 VREF，漂移对幅值测量自动抵消 | VDDA 直供（开关噪声直入基准）；板载基准（档位/噪声规格未知，劣于外置 REF3033） | onsemi REF3033TB-GT3（第二源）；极端情况退回板载基准档并重算预算 | 立创 ¥2~6 量级（下单复核） |
| 6 | 数字 3.3V LDO | **AMS1117-3.3**（SOT-223） | 供底板 LCD 数字/FT6206(FT6x06)/上拉 ~0.15A；耗散 0.26W→温升 ~23°C | RT9013-33（SOT-23-5 热余量薄）；AP2112K（同） | RT9013-33（负载<100mA 时） | 立创 ~¥0.5 |
| 7 | BNC 输入座 | 50Ω PCB 直焊母座（通孔） | 题面硬要求；手焊 | SMA（题面指定 BNC）；75Ω（阻抗不符） | 任意 50Ω 通孔 | 立创/淘宝 |
| 8 | 输入 TVS | 低结电容 TVS，**≤5pF** | 位于 50Ω 系统输入，大容值伤通带相位 | 普通 5V TVS（数十 pF） | 阶段二定型号（需联网查证） | 立创 |
| 9 | 显示模组（锁定） | 3.5″ ST7796S + FT6206(FT6x06)，FSMC 8080-16bit | ≥6″ 条款偏差已拍板接受（软件文档 §13 在案） | 不再比选 | — | 既有 |
| 10 | 被动件等级 | 滤波/信号路径电容 **C0G/NP0**；增益电阻 0.1%；50Ω 端接/负载 1%；每电源引脚 100nF | LC 滤波形状吃电容温漂；AC 耦合 100nF 用 C0G（1206）防容值随偏压漂 | X7R/X5R 信号路径位 | — | 通用件 |
| 11 | 测试点组 | **×6**：端接节点 / LC入 / LC出 / ×4出(ADC前) / 1.65V轨 / AGND | 扫频标定与上电自检的物理基础（02 §6 O3）；1.65V 轨同时接一路**备用 ADC 通道**作自检电平（阶段二 pinout 预留） | 无 | — | 通用件 |
| 12 | 标定表存储 | **W25Q128**（核心板板载 SPI Flash） | op_flash 迁移目标：擦写寿命/掉电安全优于片内 Flash（02 §6 O5） | 片内 Flash 扇区擦写 | — | 板载既有 |
| 13 | FSMC 串阻 | 33Ω **×20**（✅ 已落图 `R22`~`R39`，2026-10-01；覆盖 D0~D15/NE1/RS） | 阻尼跨板排线振铃，EMI 源头治理（02 §6 O7）；预留 FSMC 降速档 | 无串阻（振铃谐波入带） | — | 立创通用 |
| 14 | 0Ω 断点 | ~~×3~~ → **×2**：BUF1 入（`JP1`） / ADC 前（`JP2`） | AFE/ADC 两段解耦排障，配合 #11 测试点（02 §6 O8） | — | — | 立创通用 |
| 15 | ~~底板 5V 入口保护~~ | ~~**SS34 串入 + 自恢复保险**~~ | ⛔ **2026-10-04 作废**：`J3`/`F1`/`D2` 已从图上删除，本板由**核心板 Type-C 供电**（`38 §3.2-①`）⇒ 底板无入口防护件 | — | — | — |

## 2. 电源树（概要级，阶段二细化）

```
5V 单路入 ─┬─ 核心板 5V（板载 LDO 自供 MCU）── 排针引出 3.3V 仅作参考，不负载
           ├─ [数字 5V] ─ AMS1117-3.3 ─ 底板 3.3V（LCD 数字 / FT6206(FT6x06) / I2C 上拉） ~0.15A
           ├─ [模拟 5V]（LC 自输入分割）─ OPA2197（2mA）+ REF3033（50µA → VREF+ 与 1.65V 分压）
           └─ LCD 背光（晶体管自 5V，不进 3.3V/模拟轨）
```

## 3. 风险表（Gate 3 要求非空）

| # | 风险 | 等级 | 验证动作 |
|---|---|---|---|
| R1 | ~~软件文档 §6/§10 混叠残留行 0.655mV 与链路推算 1.31mV 差 2 倍~~ → **已消解（2026-09-28）**：两者是**不同参考点**（0.655 = 输入端折算；1.309 = ADC 端折算，含端接×0.5与增益×4）。预算与门限同在输入端域 ⇒ 取 0.655mV，余量 7.5× 维持不变。**器件侧单测实测偏 −0.652mV 逐位吻合**（`firmware/Test/test_op_meas.c` S9） | 高 → **已闭** | 详见 `verify_afe_v2_report.md` §4（已更正） |
| R2 | LC 电感实际 SRF/DCR 偏低 → 滤波形状劣化 | 中 | 选型卡 SRF≥12MHz/DCR≤0.5Ω；板到手扫频标定即暴露（§11 流程） |
| R3 | 天空星 VREF+ "排针外部基准"档的具体电阻位/排针脚待对原理图确认（三路可选机制已在官方 Wiki 证实） | 低 | 阶段二开工对图：确认 R2 位号+外部基准排针脚；万不可行退回板载基准档重算预算 |
| R4 | LC 布局寄生（电感互感/地回路）改变频响 | 中 | 阶段二布局约束：电感正交摆放+单点地；板到手扫频复测 |
| R5 | 模拟前端制作质量 = 全装置指标瓶颈（软件文档 §13） | 高 | 上电自检 + 扫频标定复测（§11） |
| R6 | TLV3544/REF3033 等实时价与库存（若动用替代料） | 低 | 下单前立创复核 |

## 4. Datasheet / 采购链接（无法提供处已标注）

| 器件 | datasheet | 采购/封装 |
|---|---|---|
| OPA2197 | TI 官网产品页（OPA197 家族 datasheet）：ti.com 搜 OPA2197（直链需联网查证） | 手头库存；DigiKey $3.94 现货参考（2026-09-28 查）；立创搜 OPA2197ID |
| REF3033 | REF30xx 家族 datasheet（TI，SOT23-3） | AllDatasheet 搜 REF3033（需联网查证） |
| STM32F407VGT6 | ST DS8626（核心板自带，仅存档） | — |
| AMS1117-3.3 | 通用 | 立创搜索（需联网查证） |
| LC 电感/电容 | 规格件，按 #3 规格筛 | 立创按规格筛选（被动件不附链接） |

> Gate 3 过后的 datasheet PDF 批量下载与封装收集 = 阶段二开工动作，待 [CHK] 后执行。
