funiang-x/G2026/hardware/06-修正BOM与落图清单.md

# G2026 硬件 · 06 修正 BOM 与落图清单 · v1

> 2026-09-28 · 依据 `05-原理图评审与改造方案.md` + 用户拍板（核心板换 STM32F407VGT6 高配版 / 原地修补 / 三页全改 / 抗混叠改 fc=660k）
> 复算：`_filter_final.py` → `report_filter_final.md`（−59.30dB，蒙特卡洛 0/5000 跌破）
> 本表是**落图唯一真相源**，图上元件与位号必须与本表逐条一致。

---

## 1. AFE 页（前端模拟）

### 1.1 信号链与位号

| 位号 | 器件 | 值 | 封装 | 立创料号 | 说明 |
|---|---|---|---|---|---|
| **J1** | BNC 50Ω 直焊母座 | — | 插件 | BY-BNC-50KWE | 输入 |
| **D1** | 低容 ESD 保护 | SRV05-4（Cj≈1.5pF） | SOT-23-6 | SRV05-4_C338781 | **替换**原 PESD5V0S1BA(30pF) |
| **R1** | 厚膜 1% | 49.9Ω | 0805 | 0805W8F499T5E | 50Ω 端接 |
| **C1** | C0G | 100nF | 1206 | 1206CG104J500NT | AC 耦合 1 |
| **R2** | 厚膜 1% | 10kΩ | 0805 | 0805W8F1002T5E | BUF1 偏置 → VBIAS |
| **JP1** | 0Ω | 0Ω | 0805 | 0805W8F0000T5E | 断点：BUF1 入 |
| **U1A** | OPA2197 半 A（G=1 缓冲） | — | SOIC-8 | OPA2197ID | 位号 **U1**，A 通道 |
| **R3** | 厚膜 1% | 49.9Ω | 0805 | 0805W8F499T5E | LC 输入串联端接 |
| **L1** | 绕线电感 | **4.7µH** | SMD | XRCD54-4R7M | **替换**原 3.9µH |
| **C2** | C0G 0805 | **5.6nF** | 0805 | 0805CG562J500NT | **替换**原 4.3nF U2J 0603 |
| **L3** | 绕线电感 | **22µH** | SMD | CD54-220M | **替换**原 15µH |
| **C4** | C0G 0805 | **10nF** | 0805 | 0805CG103J500NT | **替换**原 7.5nF X8R 1210 |
| **L5** | 绕线电感 | **22µH** | SMD | CD54-220M | **替换**原 18µH |
| **C6** | C0G 0805 | **10nF** | 0805 | 0805CG103J500NT | **替换**原 6.8nF X7R 630V |
| **L7** | 绕线电感 | 12µH | SMD | XRCD54-120M | 保留（原值正确） |
| **C8** | C0G 0805 | **1.8nF** | 0805 | 0805CG182J500NT | **替换**原 1.6nF C0G **0402** |
| **R4** | 厚膜 1% | 49.9Ω | 0805 | 0805W8F499T5E | LC 输出负载 → AGND |
| **C9** | C0G | 100nF | 1206 | 1206CG104J500NT | AC 耦合 2 |
| **R5** | 厚膜 1% | 10kΩ | 0805 | 0805W8F1002T5E | GAIN 偏置 → VBIAS |
| **U1B** | OPA2197 半 B（同相 ×4） | — | SOIC-8 | OPA2197ID | U1 B 通道（**与 U1A 同一片**） |
| **R6** | 厚膜 1% | 30kΩ | 0805 | 0805W8F3002T5E | 反馈 Rf |
| **R7** | 厚膜 1% | 10kΩ | 0805 | 0805W8F1002T5E | 反馈 Rg → AGND |
| **R8** | 厚膜 1% | **100Ω** | 0805 | **0805W8F1000T5E** | **替换**原 1kΩ（ADC 隔离） |
| **C10** | C0G | 470pF | 0603/0805 | CL10C471JB8NNNC | ADC kickback |
| **JP2** | 0Ω | 0Ω | 0805 | 0805W8F0000T5E | 断点：×4 出 → ADC |
| **U2** | 基准 | REF3033AIDBZR 3.3V | SOT-23-3 | REF3033AIDBZR | VREF+ |
| **C11** | 钽 | 22µF/25V | CASE-B | TAJB226K025RNJ | REF 输入 |
| **C12** | 陶瓷 X7R | 10µF/25V | 0805 | CL21A106KAYNNNE | REF 输出 |
| **R9** | 厚膜 1% | 10kΩ | 0805 | 0805W8F1002T5E | 1.65V 分压上 |
| **R10** | 厚膜 1% | 10kΩ | 0805 | 0805W8F1002T5E | 1.65V 分压下 |
| **C13** | 陶瓷 X7R | 10µF/25V | 0805 | CL21A106KAYNNNE | VBIAS 去耦 |
| **JP3** | 0Ω | 0Ω | 0805 | 0805W8F0000T5E | 断点：VREF 注入 |
| **C14** | C0G | 100nF | 0805 | CC0805KRX7R9BB104 → 用 C0G | **新增** U1 的 V+ 去耦 |
| **C15** | C0G | 100nF | 0805 | 同上 | **新增** U1 的 V− 去耦 |
| **J2** | 板间互连 | 2×7（[TBD] 待拍板） | SH1.0 / 2.54 | — | 到核心板 |
| **TP1** | 测试点 | — | 通孔 | TP-黄色测试点 | 端接节点 |
| **TP2** | 测试点 | — | 通孔 | 同上 | LC 入 |
| **TP3** | 测试点 | — | 通孔 | 同上 | LC 出 |
| **TP4** | 测试点 | — | 通孔 | 同上 | ×4 出（ADC 前） |
| **TP5** | 测试点 | — | 通孔 | 同上 | 1.65V 轨 |
| **TP6** | 测试点 | — | 通孔 | 同上 | AGND |

### 1.2 滤波器定案（fc=660kHz）

| | 值 | 理想值 | 偏差 |
|---|---|---|---|
| L1 | 4.7 µH | 4.436 | +6.0% |
| C2 | 5.6 nF | 5.053 | +10.8% |
| L3 | 22 µH | 18.905 | +16.4% |
| C4 | 10 nF | 8.919 | +12.1% |
| L5 | 22 µH | 22.300 | −1.3% |
| C6 | 10 nF | 7.562 | +32.2% |
| L7 | 12 µH | 12.632 | −5.0% |
| C8 | 1.8 nF | 1.774 | +1.4% |

> 单项偏差大，但**整链响应已数值复算**（不是逐件核对）：折叠带最差 **−59.30dB**（判据 −42.5dB，余量 **16.8dB**），
> 带内 @500k **−0.019dB**，10k~500k 起伏 **0.139dB**（17 点标定吸收）。
> 蒙特卡洛（L±10%/C±5%，5000 次）最坏 **−55.24dB**，**0/5000 跌破**。

---

## 2. PWR 页（电源 + 背光 + IM 绑定）

| 位号 | 器件 | 值 | 封装 | 料号 | 说明 |
|---|---|---|---|---|---|
| **J3** | DC 电源座 | DC005 | 插件 | DC005 | 5V 入 |
| **D2** | 肖特基 | SS34 | SMA | SS34 | 防反接 |
| **F1** | **自恢复保险 PPTC** | 0.5A/24V | 1206 | **SMD1206P050TF/24_C209741** | **新增**（原位置是 330mΩ 电阻，零保护） |
| **U3** | LDO | AMS1117-3.3 | SOT-223 | AMS1117-3.3 | 数字 3.3V |
| **C16** | 钽 | 22µF/25V | CASE-B | TAJB226K025RNJ | LDO 输入 |
| **C17** | 钽 | 22µF/16V | CASE-B | TAJB226M016RNJ | LDO 输出 |
| **C18/C19** | X7R | 100nF | 0805 | CC0805KRX7R9BB104 | LDO 去耦 |
| **LED1** | 0805 指示灯 | 黄 | 0805 | KT-0805Y | 电源指示 |
| **R11** | 厚膜 1% | 1kΩ | 0805 | 0805W8F1001T5E | LED 限流 |
| **Q1** | NMOS | SI2302 | SOT-23 | SI2302 | 背光开关 |
| **R12** | 厚膜 1% | 1kΩ | 0805 | 0805W8F1001T5E | 栅极限流 |
| **R13** | 厚膜 1% | 100kΩ | 0805 | 0805W8F1003T5E | 栅极下拉 |
| **R14** | 厚膜 **±1%** | **39Ω 0.5W** | **1206** | 1206W4F39R0T5E（或 ±5% 1206W4F390JT5E） | **替换**原 330mΩ（差 118 倍，会烧屏背光） |
| **R15/R16** | 厚膜 1% | 4.7kΩ | 0805 | 0805W8F4701T5E | I²C 上拉 |
| **R17/R18/R19** | 0Ω | 0Ω | 0805 | 0805W8F0000T5E | IM0/IM1/IM2 绑定 |
| **R20** | 厚膜 1% | 100kΩ | 0805 | 0805W8F1003T5E | LCD_ID → GND |
| ~~**RN1~**~~ → **`R22`~`R39`**（单阻 ×18） | 33Ω 单阻 | 33Ω | 0805 | `0805W8F330JT5E` | ✅ **已落图 20 只**（INT 页 J5 侧：10-01 落 18 只 + **10-02 补 `R40`/`R41` 给 `WR`/`RD`**；见 `22` 号文档） |
| **`C21`/`C22`** | 10µF / 100nF | 10µF / 100nF | 0805 | `CL21A106KAYNNNE` / `CC0805KRX7R9BB104` | ✅ **已落图**（2026-10-02）：**J5 就近去耦**，原图缺件（见 `22` 号文档 §3） |

---

## 3. INT 页（核心板 + 屏 + 触摸 + 板间）

| 位号 | 器件 | 值 | 说明 |
|---|---|---|---|
| **EVK1** | **LCKFB-LSPI-SkyStar-STM32F407VGT6-PRO** | — | **替换**原 GD32F407VET6 青春版（**引脚几何逐脚比对：80 脚全一致，可原位替换**） |
| **H3** | FPC-45P 0.5mm | FH12-45S-0.5SVA | 屏 |
| **H4** | FPC-6P 0.5mm | FH12-6S-0.5SH | 触摸（**脚序 [TBD] 对实物核实**） |
| **U9/U10** | 2×20P 排母 | 2.54-2×20 | 核心板插座（[TBD] 保留/删除） |

---

## 4. 网络命名统一（与 `04-pinout连接表.md` 对齐）

| 语义 | 图上网名（统一后） | 原画布混用名 |
|---|---|---|
| 5V 主电 | `+5V_MAIN` | `+5V` / `+5V_RAW` / `+5V` |
| 模拟 5V | `+5V_A` | `+5V_A` |
| 数字 3.3V | `+3V3_DIGIT` | `+3V3` |
| 模拟地 | `AGND` | `AGND` |
| 数字地 | `GND` | `GND` |
| 基准 | `VREF_3V3` / `VREF_3V3_EXT` | 同 |
| 偏置 | `VBIAS_1V65` | 同 |
| 端接节点 | `AFE_TERM` | 同 |
| 缓冲入 / 滤波入 | `AFE_FILT_IN` | `AFE_B1_IN` / `AFE_G1_OUT` |
| 滤波出 / 增益入 | `AFE_FILT_OUT` | `F1..F5` / `AFE_G2_IN` |
| 增益反馈 | `AFE_GAIN_FB` | `AFE_G2_FB` |
| ADC 前 | `AFE_ADC_MON` | 同 |
| ADC 入 | `AFE_ADC_IN` | 同 |

---

## 5. 本次不做、留待下一步

| # | 项 | 原因 |
|---|---|---|
| N1 | **AFE 主信号链改实线** | 需要移动 U1B（现位于参考块区 x≈760，而其反馈网络在 x≈2260）并重排 LC 节——属"重排"而非"原地修补"，需单独一轮 |
| N2 | PCB 落图 | 用户拍板暂不画 |
| N3 | `verify_dsp.py` / 软件文档 §6/§10 回填 | fc 由 800k 改 660k，DSP 侧模型需同步（属软件流程） |
| N4 | CTP FPC-6P 脚序 / 板间连接器针数 | 需对实物核实 |

---

## 6. 执行记录（2026-09-28，AI 落图）

工具：嘉立创 EDA Pro 桥接（`_eda.py` / `_swap_parts.py` / `_fix_*.py` / `easyeda-sch-audit-fix/scripts/audit_sch.py`）
三页已保存。

### 6.1 已完成

| # | 动作 | 结果（画布实读校验） |
|---|---|---|
| 1 | **核心板符号替换** | EVK1：`LCKFB-LSPI-SkyStar-GD32F407VET6-LITE` → **`LCKFB-LSPI-SkyStar-STM32F407VGT6-PRO`**。替换前逐脚比对：**80 个引脚坐标全部一致**（新增 81~84 号脚）；替换后 **80 根导线全部保留** |
| 2 | **位号全标** | AFE 39 / PWR 20 / INT 6 = **65 个器件全部有位号**（U1 双通道出现两次，BOM 归并） |
| 3 | **换错料 ×10** | D1→SRV05-4；L1→4.7µH；L3/L5→22µH；C2→5.6nF C0G；C4/C6→10nF C0G；C8→1.8nF C0G 0805；R8→100Ω；R14→39Ω。**每个都读回 `Value`/`Temperature Coefficient`/封装做校验** |
| 4 | **端口修复** | 换件导致 5 个端口悬空，已重建到正确引脚端点；并修正 2 处**短路**（AFE_TERM 曾与 +5V_A 同点、F4 曾与 AGND 同点） |
| 5 | **页面命名** | 原理图 → `G2026-底板原理图`；页 → `AFE-前端模拟` / `PWR-电源与背光` / `INT-核心板与接口` |

### 6.2 验证结果（`easyeda-sch-audit-fix/scripts/audit_sch.py`，三页）

| 页 | 端口数 | 未落在引脚上 | 同点不同网（短路） | 无名端口 | 器件/缺位号 |
|---|---|---|---|---|---|
| AFE | 84 | **0** | **0** | **0** | 39 / 0 |
| PWR | 44 | **0** | **0** | **0** | 20 / 0 |
| INT | 101 | **0** | **0** | **0** | 6 / 0 |

### 6.3 本轮未做（明确挂账）

| # | 项 | 原因 / 建议 |
|---|---|---|
| N1 | **AFE 主信号链改实线** | U1B 现位于参考块区（x≈760）而反馈网络在 x≈2260，靠网名连接；要画成实线须**重排**该页，不属"原地修补"。建议单开一轮 |
| N2 | ✅ **已落图（2026-10-01）**：PPTC=`F1` 已串在 5V 主干（J3→F1→D2）。原表述：补 **PPTC**（5V 入口，A7 另一半） | 原图该位置是 330mΩ 电阻（已改作背光限流 R14=39Ω），PPTC 需**新增**并在 5V 主干上串入 |
| N3 | ✅ **已落图**（`R22`~`R39` 单阻 ×18，2026-10-01）—— 原：补 **FSMC 33Ω 串阻**（O7） | 需新增 18 路，建议用排阻 |
| N4 | 补 **U1 电源去耦 100nF×2** | 需新增 2 个件 + 2 个端口 |
| N5 | **网络名统一**（§4 表） | 需逐网改名，属重排级别；本轮未动，图上仍是 `+5V/+5V_RAW/+5V_A`、`AFE_B1_IN/AFE_G1_OUT/F1..F5` |
| N6 | 标题栏内容 | API 未见可写接口，需 GUI 手填 |
| N7 | `verify_dsp.py` / 软件文档回填 fc=660k | 属软件流程 |
| N8 | CTP FPC-6P 脚序 / 板间连接器针数 | 需对实物核实 |

### 6.4 重要副产物

- `_filter_final.py` → `report_filter_final.md`：fc=660k 定案的完整复算 + 5000 次蒙特卡洛。
- `bom_after.md`：改造后 BOM（画布实读）。
- `easyeda-sch-audit-fix/scripts/audit_sch.py`：可重复运行的三页健康检查（悬空/短路/位号）。
- ⚠️ **踩坑记录**：用 `ISCH_PrimitiveComponent.toAsync().setState_X/Y().done()` 移动**网络端口**会**抹掉端口的 Name（网名）**。
  必须改用「删除 + `createNetPort`/`createNetFlag` 重建」。移动器件本身不受影响。

---

## 7. 第二轮：DRC 修复 + AFE 重排（2026-09-28 下午）

### 7.1 先说明：DRC 是怎么拿到的

嘉立创 EDA Pro 这版的 `eda.sch_Drc.check()` **只返回布尔值**（`includeVerboseError` 是 v4.2+ 才支持的），
桥接拿不到明细。所以自建了一份全工程 DRC（`_drc_all.py`）：
把**引脚端点 / 网络端口 / 导线端点**建成并查集，导线 union 两端点，**同名端口跨页合并**，
再按 EasyEDA 的规则集判定：单端网络 / 悬空引脚 / 位号重复 / 同网络多网名(短路) / 同点重复端口。

### 7.2 修前 vs 修后

| 检查项 | 修前 | 修后 |
|---|---|---|
| 悬空引脚（无 NC 标志） | **156** | **71** |
| 同点重复端口 | 10 | **0** |
| 位号重复 | 1（U1×2） | **0** |
| 同网络多网名（短路） | 0 | **0** |
| 单端网络 | 2（LCD_D0/LCD_D1） | **0** |

### 7.3 本轮抓到并修掉的真 bug

| # | 问题 | 证据 | 修法 |
|---|---|---|---|
| **B1** | **屏数据线低 2 位根本没接**：`LCD_D0`/`LCD_D1` 只出现在 EVK1 侧，FPC 侧没有 | 全工程合并后仍为「单端网络」；`04 §1.2` 把 FPC 脚 31/32（DB1/DB0）标成 NC——**标错了**，16bit 8080 模式要用 DB0~DB15，不用的是 DB16/DB17（脚 15/16） | H3 脚 32→`LCD_D0`、脚 31→`LCD_D1` 补端口 |
| **B2** | INT 页**只接了一半**：EVK1 右排（脚 41~80）与 U10 全靠导线连，但那些导线只覆盖左排 | 80 根导线的端点全在 x=325/340，右排 x=990/1170 一个都没有 | 见 B3 |
| **B3** | U9/U10 两个 2×20 排母是**冗余**的：脚名只有 1~40，不携带任何信号信息；却贡献 79 条悬空引脚告警 | DRC 分布：EVK1 47 + U9 40 + U10 39 | **删掉 U9/U10** 及其 79 根悬空导线；排母记入 BOM 说明（见 7.5） |
| **B4** | 位号 `U1` 重复（OPA2197 双通道画成两个独立符号） | DRC「位号重复」 | → `U1A` / `U1B` |
| **B5** | AFE 的 J1（BNC）外壳 4 个脚悬空 | DRC | 补 `AGND` 端口（外壳应接模拟地） |
| **B6** | D1（SRV05-4）6 脚里有 3 脚悬空 | DRC | 待 NC（见 07 清单） |

### 7.4 AFE 页重排（可看性）

**问题**：主信号链**一根导线都没有**（纯网名连接），且增益级 `U1B` 在参考块区（x≈760），
它的反馈网络却在 x≈2260 —— 相距 1500 单位，图上看不出这是同一级。

**改动**：
1. **搬件**：`U1B` (760,1400)→**(2300,1050)**；`R5` (2180,1150)→(2240,950)；`R6` (2260,1050)→(2300,1150)；`R7` (2300,1250)→(2140,1250)。
   （端口不能移动，所以每个件的旧端口都是「删掉→在新端点按原名重建」。）
2. **D1 换朝向**：旋转到横排，信号脚改用 **pin4（I/O3）** 那一排（靠近链路），`pin5`=VCC、`pin2`=GND。
3. **主信号链画成实线**：**26 根导线**，从 `J1` 一路贯到 `J2`：
   `J1 → D1/R1 抽头 → C1 → JP1 → U1A(+in) → U1A(out) → R3 → L1-C2-L3-C4-L5-C6-L7-C8-R4 → C9 → U1B(+in) → U1B(out) → R6/R7 反馈 → R8 → C10 → JP2 → J2`
4. **加 19 条功能分区文字**：①输入保护与端接 ②输入缓冲 ③抗混叠滤波 ④增益×4与ADC驱动 ⑤基准与偏置 ⑥测试点与断点，
   并把 fc=660k 的元件值与复算结论直接写在图上。

### 7.5 顺带记录：底板 BOM 里的排母

删掉 U9/U10 后，**底板 BOM 需要单独补两项**：`2×20P 2.54mm 排母 ×2`（核心板插座）。
它们不参与原理图电气连接（核心板模块符号 EVK1 已完整表达所有信号），属机械件。

### 7.6 仍未清零的 71 条

全部是**故意不用的引脚**（EVK1 47 / J4 8 / AFE:J2 8 / H3 5 / D1 3），
嘉立创这版 EDA 的 API **无法**放置无连接标志（`ISCH_PrimitivePin.setState_NoConnected` 在本版本不存在），
只能 GUI 右键点。逐脚清单见 **`07-无连接标志待点清单.md`**。

---

## 8. 第三轮：拿到真实 DRC 日志后的**根因修复**（2026-09-28 下午）

用户提供了嘉立创 EDA 自己导出的 `schDrcLog_2026-09-28.txt`（**致命错误 26 / 错误 0 / 警告 15 / 信息 270**）。
对照后发现了**根本性错误**——不是参数问题，是**连线模型用错了**。

### 8.1 根因：端口直接压在引脚上**不算连接**

我此前一直用「把网络端口原点精确放在引脚端点上」当连接手段。**EasyEDA 不认这个。**
官方技能 `easyeda-schematic-net-fanout`（上游 `github.com/easyeda/easyeda-enhanced-schematic-skill`，
嘉立创官方 org）给出的规程是：

> 端口放在**引脚端点外 10 单位**（沿引脚指向），再拉一根**短线**把引脚端点与端口连起来。
> 一个非 NC 引脚 = 一个端口 + 一根线。

日志里「发现元件引脚悬空」把**几乎所有引脚**都列了进去（连有端口的也算），正是这个原因。
**上一轮那句"AFE/PWR 虽然 0 导线但连接成立"是错的**——那只是我自己的几何模型自洽，EasyEDA 的网表里全是断的。

### 8.2 第二个根因：`sch_PrimitiveWire.create()` 漏了网名参数

签名是 `create(line, net?, color?, lineWidth?, lineType?)`。
我漏传 `net` → 26 根导线全变成 `$3Nundefined` → **26 条致命错误**（"网络名不正确，含有非法字符"），
且这些线被判为"游离网络，未连接任何引脚"。

### 8.3 修法与结果

| 动作 | 结果 |
|---|---|
| 按官方规程重做**三页全部扇出**：端口移到引脚端点外 10 单位 + 补 10 单位短线（带网名） | AFE 85 + PWR 44 + INT 93 = **222 个端口全部重做** |
| 删光 AFE 全部导线并重建（26 根主链路带网名 + 85 根端口短线） | AFE 111 根线全部带网名 |
| 清理扇出死循环产生的重复线（`U1B.OUTB` 与 `R8.1` 只隔 10 单位，端口一移就压到另一个脚上） | 340 → 111 根 |

**扇出完整性核验（新判据：引脚必须有导线）**

| 页 | 导线 | 引脚 | 端口 | 无导线引脚 | 无导线端口 |
|---|---|---|---|---|---|
| AFE | 111 | 98 | 86 | 11（J2.7~14 + D1.1/3/6，**都是故意不用的**） | 0 |
| PWR | 44 | 44 | 44 | **0** | **0** |
| INT | 94 | 153 | 93 | 60（H3 5 + J4 8 + EVK1 47，**都是故意不用的**） | 0 |

→ 剩余 71 个无导线引脚 = 之前那份 `07-无连接标志待点清单.md` 的 71 个，**一一对上**。

### 8.4 日志里另外几类告警的处置

| 日志条目 | 数量 | 处置 |
|---|---|---|
| 网络标识/网络端口「没有连接导线或总线」 | ~200（信息） | **已消除**（每个端口都补了短线） |
| 导线 `$3Nundefined` 游离网络 | 26（致命） | **已消除**（重建带网名） |
| 元件引脚悬空，建议放非连接标识 | 10 行 ~300 脚（警告） | **只剩 71 个"故意不用"的脚**，需 GUI 打 NC |
| 元件的属性与供应商编号不匹配，建议器件标准化 | 3 行 ~65 件（警告） | **GUI 一键**：工具 → 器件标准化（API 无接口） |
| 元件「值」属性内容为空 | ~40（信息） | 待补（见 8.5） |
| `U1A`/`U1B` 位号不符合规则 + "多部件元件不完整" | 2（信息） | 见 8.5 |
| 导线 `GND $1N688` 单网络 | 1（警告） | 见 8.5 |

### 8.5 仍需处理（GUI 或后续）

1. **71 个 NC 标志** —— 见 `07-无连接标志待点清单.md`。
2. **器件标准化** —— 工具 → 器件标准化，一次点掉 3 条警告。
3. **元件「值」属性为空** —— 嘉立创的 BOM 取「值」字段，当前为空；需逐个补或在器件标准化时带出。
4. **`U1A`/`U1B`** —— 嘉立创位号规则只认「字母+数字」，`U1A` 不合规；
   正确做法是把 OPA2197 做成**一个多部件元件**（subPartName A/B，位号统一为 `U1`）。
   API 的 `create(comp, x, y, subPartName, ...)` 支持传 subPartName，但需要在建件时就传，后续改不了。
5. **INT 页那根 `GND` 单网络导线** —— 删掉即可（唯一残留）。

### 8.6 教训（写给下一次）

- **不要自己发明连接模型。** 落图前先读 `easyeda-schematic-net-fanout`（官方技能），
  它的「端口外移 10 单位 + 短线」不是审美偏好，是 **EasyEDA 判定连接的必要条件**。
- **自己的几何自洽 ≠ EDA 认可。** 我上一轮的"0 悬空端口"是拿自己的公式算自己的坐标，
  循环论证。**唯一可信的验收是 EDA 自己导出的 DRC 日志。**
- **`sch_PrimitiveWire.create` 的第二个参数（net）不能省**，否则网名变成 `$3Nundefined` → 致命错误。

---

## 9. NC（无连接标志）到底能不能用 API 放？—— 4 条路全试死的结论（2026-09-28）

结论：**在本机这版嘉立创 EDA Pro 上，API 放不了 NC 标志。** 下面是逐条证据。

| # | 路线 | 结果 | 证据 |
|---|---|---|---|
| 1 | `pin.setState_NoConnected(true)` | **方法不存在** | `typeof p.setState_NoConnected === "undefined"`；`getAllPins()` 与 `getAllPinsByPrimitiveId()` **两种取法都一样** |
| 2 | `eda.sch_PrimitivePin.modify(pin, {noConnected:true})` | **静默空操作** | 方法存在、不报错、返回对象——但什么都没改。**对照实验**：把 `{pinLength: 40}` 打进去，读回**还是 20**（改前/改后/复原三次读数全为 20） |
| 3 | 改文档源码 `setDocumentSource` | **NC 不落页面源码** | 页面源码原语只有 `DOCHEAD / CANVAS / COMPONENT / ATTR / TEXT / WIRE / LINE`，**没有 PIN**；全文搜 `noConnected` = 0 |
| 4 | 放库里的「非连接标识」符号 | **库里没有** | `lib_Device.search("no connect" / "非连接" / "noconnect")` 无结果（只搜到 Off-Page-Connector 等无关件） |

**根因**：`eda.sch_PrimitivePin` 这个类管的是**符号页**的引脚——
在原理图页上调 `eda.sch_PrimitivePin.getAllPrimitiveId()` 返回 **0**，
说明原理图页上没有它认的 "pin primitive"，所以拿它去 `modify` 元件引脚 = 无效。

> 注：`ISCH_PrimitiveComponentPin` 的文档明确写着「只有 `pinNumber` 和 `noConnected` 两个属性可以改」，
> 也就是说**接口设计上本来是支持的**，是本机这版**实现没跟上**（文档标 BETA）。
> 换更新版本的 EDA 客户端可能就好了——值得一试。
> `easyeda-draw` skill 的 `draw_cli.py mark-nc` 依赖路线 1，**在本机同样会失败**，别照抄。

### 还能怎么走（三选一，待人拍板）

| 方案 | 做法 | 代价 |
|---|---|---|
| **A. GUI 点（推荐）** | 按 `07-无连接标志待点清单.md` 右键打 × | 2 分钟手工，但 DRC 干净且**语义正确** |
| **B. 关掉该项检查** | 设计 → 检查 DRC 里取消「引脚悬空」，同时在图上加一段文字注明"EVK1 的 47 个未用脚 + H3 的 5 个 + J4 的 8 个 = 有意不接" | 一次点掉 71 条；**但以后真漏连的脚也会被一起掩盖** |
| **C. 未用脚接同名网络** | 每个未用脚挂一个 `NC` 端口 + 短线 | DRC 会干净，但**电气上等于把这 71 个脚短接在一起**，不推荐 |

### 唯一还没试的路线（若要走 D）

NC 状态必然存在**某个**地方（否则 EDA 重开工程无法还原）。
**做法**：请你在 GUI 里**手动打一个** NC 标志（随便挑 D1 的 1 脚），
我再 diff「页面源码 + `getProjectFile()`」前后差异，定位它到底存在哪。
如果那是个我能写的文本源，就能把另外 70 个批量补上。

### 9.1 后续实验：NC 存储格式**已定位**，但**写不进去**（2026-09-28 13:1x）

承蒙用户在 EVK1 pin1 手动打了一个 NC 标志，据此定位到**存储格式**：

```
{"type":"ATTR","ticket":1051,"id":"6b4385b72350bbb7"}||{
  "parentId":"00726019c8c2f9ff-e323","key":"NO_CONNECT","x":340,"y":-1130,"value":"yes","zIndex":327}
```

- `00726019c8c2f9ff` = EVK1 的元件 primitiveId；`-e323` = **引脚后缀**
- **后缀可查**：`pin.getState_PrimitiveId()` 返回 `00726019c8c2f9ff-e323`，与 parentId **完全一致**
  （抽样：pin1→e323, pin2→e167, pin5→e319, pin41→e7, pin80→e87, pin84→e340）
- `x,y` = 引脚**根部**坐标（y 取负）

#### 为什么还是写不进去

| 尝试 | 结果 |
|---|---|
| `eda.sch_PrimitiveAttribute.getAll(pinId)` | **该类在运行时 undefined**（`Cannot read properties of undefined (reading 'getAll')`）；而且它只有 `createNetLabel`，没有通用 `create` |
| `sys_FileManager.setDocumentSource(src + 新ATTR)` | 返回 **`true`**，但**实测不生效**：注入 1 条 TEXT 后 `sch_PrimitiveText.getAllPrimitiveId()` 前后**都是 0**，源码里搜不到注入内容 |

**判定**：`NO_CONNECT` 这条 ATTR 是**序列化器的输出、解析器不认**（单向）。
写回源码 → 解析时忽略 → 引脚没有 NC → 再序列化就没这条了。所以源码写回这条路**也堵死**。

#### ⚠️ 事故（须告知）

`setDocumentSource` 我试了 **3 次**，发现它**每次都会把页面里已存在的 `NO_CONNECT` 记录剥掉**——
**用户手动放在 EVK1 pin1 的那个 NC 标志因此丢失了。**

- 已确认其余内容完好：INT 页 4 件 / 93 端口 / 94 线，位号 EVK1·H3·H4·J4 齐全；AFE 页 39 件 / 112 线。
- **需要用户重新在 EVK1 pin1 补一次 NC（右键一下）。**
- **结论：`setDocumentSource` 在本机不可用于写 NC，也不要拿它做源码级批量改写。**

#### 最终结论

NC 标志在本机这版 EDA 上：**API 无法创建**（4 条 API 路 + 1 条源码路，全试死）。
只能 GUI 右键点，清单见 `07-无连接标志待点清单.md`（71 个脚）。
