funiang-x/G2026/hardware/23-上板前检查清单.md

# 23 · 上板前检查清单（2026-10-03 整合 · 含仿真验证判据）

> 把散在 `13 §5.4/§5.6`、`22 §6`、`04 §8`、`18 §12`、**`27 §7.2`（仿真推出的上板判据）** 的检查项
> 收成一页，**从上到下逐项勾**。每项都给了"怎么判"；判不过就停下来查，不要带病往下走。
>
> **⚠️ 2026-10-03 新增前提**：图纸已按 `27 §5.1` 改了三个值（`R21`→4.7Ω、`R6/R7`→24.9k/3.57k）。
> 手上的板若是**改前**打的样，第 7 节的仿真对照判据**不适用**（通带形状会差 0.8dB 且对运放 Cin 敏感）。

---

## 0. 先读：台面 vs 真板（判据适用性）

| 环境 | 有什么 | 自检日志的预期 |
|---|---|---|
| **台面**（现在） | 核心板 + 屏 + 杜邦线，**没有 AFE、没有触摸上拉** | `[W] 模拟轨可疑` 与 `[W] FT6336 读不到` **均属预期**，可忽略 |
| **真板**（投板后） | 底板（AFE + `R15/R16` 上拉 + 21 只 33Ω） | 上述两项**必须通过**，不过就是真问题。⚠️ 2026-10-04：`F1` 已删，**无 5V 入口件**（核心板 Type-C 供电） |

> 固件的"模拟轨在线"判据 = AFE 输出帧直流均值落在 `2048±15%`（`board_config.h` 的
> `BOARD_VBIAS_SENSE_CODE_MID/TOL_PCT`）。机理与容差依据见 `board_config.h` 同段注释。

---

## 1. 上电前（断电，万用表）

- [ ] **`AGND` ↔ `GND` 通断**（`27 §7.2 T1`，**新加，优先级最高**）：量 `EVK1.37` ↔ `EVK1.39/77/79`。
      底板这两张网**没有任何连接件**，唯一回路是核心板内部那颗 0Ω。
      ✅ **2026-10-03（`36 §M.1`）：已实测 —— 核心板 `AGND` 与 `GND` 是通的，本条结案。**
      （原理图侧的独立印证：跨接件是 `R8`（0Ω ±1%，0402），标注无 `(N)` = 贴；
      同在核心板上的 `R2` 标 `0Ω(N)` = 不贴，而 `25 §1.1` 已实测确认 `R2` 不贴 ⇒ 同一约定可信。）
      **因此判据是：通了就不要碰。** ⚠️ **千万不要"预留/补一个 0Ω"** —— 会变成第二个接地点
      ⇒ **地环路**，而 `26 §N7` 自己写着"只许一个点"。
      只有**实测不通**时才补一个 0Ω 单点（且只补一个）。症状隐蔽：不通不报错，只是噪声底变差。
- [ ] **背光电流（真板侧第一个要量的东西）**（`36 §M.2`，2026-10-03 查实 + 用户实测补充）：
      模组规格是 **恒流 60 mA ±10%**（4 颗并联，`Vf@60mA` = 2.9/3.1/3.6 V），
      而本设计把背光阳极挂在 **+3V3**、适配板 `Q1`(SI2302) 通断、**电流路径上没有镇流电阻**
      ⇒ **恒压驱动一个要求恒流的负载**。
      ✅ **已实测：3.3 V 能点亮** ⇒ 本机 `Vf` 在 3.3 V 侧之内（"不亮"那一支对本机不适用）。
      ⚠️ **但"能亮"≠"电流合规"** —— 3V3 直驱时电流由 `(3.3 − Vf) ÷ 寄生电阻` 定，
      寄生只有几十 mΩ 量级 ⇒ **电流是寄生参数定的，不是设计定的**。
      ① **先量**：串限流源测 `+3V3` → 背光支路电流，判据 **54~66 mA**；
         **落在范围内 ⇒ 什么都别动。**
      ② 明显超出 ⇒ 割适配板 `LED-A ↔ 3V3` 铜皮，**改从 `+5V` 串 33 Ω / 1206 / 0.25 W** 喂
         （`I = 53.0 ~ 63.5 mA`，`Vf` 2.9~3.25 全区间；顺带把 60 mA 从核心板 LDO 挪走：
         耗散 `0.139 W → 0.037 W`；⚠️ **+5V 不在 30-pin 上，必须飞一根线**）。
         ⛔ **不要按 `13 D3` 那样"在 3V3 馈线上串一颗电阻"** —— 3V3 的余量（0.2 V）**小于**
         `Vf` 的颗间离散（0.35 V），要居中到 60 mA 需 `Rs≈3.3 Ω`，此时电流是 **19~115 mA**，无解。
      ③ 要**严格**合规 ⇒ 只能恒流驱动（适配板加恒流沉，或换带恒流背光驱动的模组）。
      **为什么这条不只是亮度问题**：+3V3 同时经 `R4 47Ω` 供 `VDDA`/`VREF+`、经 `R9/R10` 生成 `VBIAS`。
      设计是 ratiometric（共模漂移被抵消，`01` 约束⑤）所以**直流压降不伤幅值精度**，
      但过流会把核心板 LDO 耗散从 0.14 W 推到可能 0.29 W，并把屏的 IOVCC 拉低。
- [ ] ~~**核心板 5V 排针 ↔ Type-C VBUS 通断**~~ ⛔ **2026-10-04 作废**：`J3`/`F1`/`D2` 已从图上删除，
      本板**只有核心板 Type-C 一个电源入口**（`38 §3.2-①`）⇒ "双源二选一"这个风险本身不存在了。
      原条目保留作历史：`27 §7.2 T2`、`36 §M.3`。
- [x] ~~**J5 逐脚对适配板丝印**~~ ✅ **2026-10-04 已结案**：原图把右列读高了一行（9 个脚错位），
      已按屏厂 PDF 脚表改图并回读验证（`04 §6.18`）。判据从"割线/改焊"变成
      **"上电前确认模块的 `CS/RS` 那一行对准 J5 的 1/2 脚"**（2×15 无防呆，插反 180° 会把两列全换位）。
- [ ] **电源通断**：5V↔GND、3V3↔GND 的电阻值（应为 kΩ 级以上；短路不上电）。
- [ ] ~~**`+5V_IN` → `+5V_RAW` 压降**~~ ⛔ **2026-10-04 作废**：`F1`(PPTC) 已不在图上，
      `+5V_IN`/`+5V_RAW` 两网消失（`38 §3.2-①`）。原条目与 `36 §M.5` 的分析保留作历史。
- [ ] **`R21` 贴的是 4.7Ω 而不是 0Ω**（`27 H1`）：万用表量 `+5V` ↔ `+5V_A`。
      **误贴 0Ω 的后果**：电源纹波耦合从 −87dB 掉到 −37dB（1V 纹波 → 14mV 到 ADC，**超 1.5mV 门限 9 倍**）。
      ✅ **2026-10-03（`36`）：BOM 侧的根因已修** —— 这三个位号的「供应商编号」原来指向**旧值器件**
      （`R21`→`C17477`=0Ω、`R6`→`C706249`=69.8kΩ、`R7`→`C2912582`=10kΩ），按 C# 下单必买错件。
      已改为 `C137513` / `C865327` / `C2681644`，并由 `_archive/_review4/eda/check_bom_consistency.py`
      守住（下单前跑一次，rc≠0 就不要下单）。**本条物理检查仍然要做**（防贴装错）。
- [ ] **`R6`=24.9kΩ / `R7`=3.57kΩ**（`27 H2`）：量阻值。误贴成 69.8k/10k ⇒ 通带在 500kHz 上翘 +0.86dB 且
      **形状取决于运放输入电容**（改前那个"押在未知参数上"的状态）。
      补充（`36 §C`）：**两颗都买错时净增益恰好还是 1.00×**（`1+69.8k/10k=7.98`）——
      所以"读数偏了"抓不到它，**能抓到它的是 @500k 上翘 +0.79dB**（扫频判据 V1）。
- [ ] **`C2`=6.2nF / `C6`=9.1nF**（`36 §B`，2026-10-03 择优）：量容值。这两颗与 `C4`/`C8` 不同值，
      **不要按"同料好清点"把 C6 换回 10nF** —— 那会让 17 点标定残差的最坏值从 2.97 升回 5.22 mV。
- [ ] **`R42`=33Ω 在 `LCD_RST` 上且 BOM 是含 R42 的 70 行版**（`35`，2026-10-03 补装）：
      BOM 用旧版（69 行、无 R42）会漏贴 ⇒ RST 直连、与其它 20 条控制线振铃防护不一致。
- [ ] **屏 FPC / 触摸 FPC 插到位**（触摸 FPC 脚序见 `04 §1.3`，`[TBD-CTP-FPC 脚序]` 未闭）。
- [ ] **`JP2` 0Ω 断点**的贴装意图确认（AFE↔ADC 断点，`18 §4.2`；~~JP3~~ 基准留位已随 `30 §5` 整条删除，不再核对）。

## 2. 上电后（RTT 自检逐项判读；`python Tools/fw.py verify` 或 RTT 抓取）

| 日志行 | 判据 | 台面/真板 |
|---|---|---|
| `[AI_READY] boot ok` | 必须出现（闭环标记） | 两者一致 |
| `[SELFTEST] W25Q128 ok, JEDEC ID=0xEF18` | 必须一致 | 两者一致 |
| `[SELFTEST] SYSCLK = 144000000 Hz` | 必须一致（2.0 MSPS 的前提） | 两者一致 |
| `[SELFTEST] RTC 走时 … ✓ 正常` | 秒数在走 | 两者一致 |
| `[SELFTEST] LCD ok, RDDID=…` | 读到即证明 16 位总线 + RS 译码 + 时序通 | 两者一致 |
| `[SELFTEST] ADC ok, 采到 64 点，均值 …` | "搬回 64 点"是**硬判据**；均值判据见 §0 | 真板均值应 ≈2048 |
| `[SELFTEST] FT6336 …` / `[TOUCH] I2C2 …` | 真板应 ok；台面预期失败 | 见 §0 |

## 3. 显示对照（`22 §6`）

- [ ] 整屏四色条 / 满屏图案 / 长时间动画三组。
- [ ] 量化口径：`app_lvgl_fps_x10`、J-Link 读 `s_flush_px`（像素吞吐）。
- [ ] 判据：**无错位、无间歇花屏、颜色正确**（INVON 已修；若反色 ⇒ 查 `lv_st7796_set_invert`）、方向正确（见 `24` 号拍板）。
- [ ] 若仍有偶发花屏：这正是"排线无阻尼"的现场证据 —— 真板核对 `R22`~`R41` 是否都贴了。

## 4. 模拟链（真板才有效）

- [ ] `TP5` 量 **VBIAS ≈ 1.650V**（= +3V3/2，`27 §2.3` 已改取 `+3V3`）。
- [ ] `TP3`/`TP4` 静态都应 ≈1.650V（**不饱和**）。⚠️ 2026-10-04：原条目写的 `TP2` **已不在图上**（`38 §3.2-②`）
- [ ] `TP4` 噪声底 **< 0.5 mVrms**（与台面基线比；`16 §4-1`）。**仿真预测 0.054 mVrms**（`27 §S5`）。
- [ ] 自检的帧均值应自动落在带内（否则按告警里的 ①JP2 ②模拟轨 ③强直流 三查）。
- [ ] **扫频标定 10k~2.5M**（`TP1`/`TP3`/`TP4`）：实测 \|H\| 与 `27 §8.7 图 A` 的曲线偏差 **<1 dB**。
      ⚠️ 这一步同时是**通带形状的唯一实测确认**（仿真里 Cin 是工程假设，见 `27 §11-2`）。
- [ ] **注入 200mVpp @1.5MHz**，看分析带伪峰 **<1.5 mVpk**（仿真预测 0.28mVpk，`27 §S1/S4`）。

## 5. 触摸（真板才有效）

- [ ] I²C2 地址 **0x38** 应答（`R15/R16` 4.7k 在位；若模组自带 ⇒ 并联成 ~2.35k，须实测，`12 §163`）。
- [ ] `PC5`(TP_INT) 静态应为**高**（内部上拉），触摸时被 IC 拉低。

## 6. 记录

日期 / 固件版本（git describe）/ 每项结果 / 现象与照片。
**任何一项判不过：停在那一项，把现象记下来再继续** —— 带病上电会把两个问题搅在一起。

---

## 7. 仿真对照判据（`hardware/27` 推出；**改前打的样不适用**）

> 用法：上板实测后，把数字填进右列与仿真值比。**偏差大 ≠ 一定坏**，但一定要查为什么。

| # | 测什么 | 仿真预测（`27`） | 实测 | 判读 |
|---|---|---|---|---|
| V1 | 通带 \|H\| 10k~500k 形状 | 图 A（改后：起伏 ≤0.05dB） | | 偏差 >1dB ⇒ 查 `R6/R7` 贴装 / 运放批次 |
| V2 | 17 点标定残差 | ≤0.05 mV（仿真形状残差上界 0.89mV） | | 真机标定应更小 |
| V3 | `TP4` 噪声底 | 0.054 mVrms | | >0.5 ⇒ 查地回路 / R21 |
| V4 | 混叠伪峰（200mVpp@1.5M） | 0.28 mVpk | | >1.5 ⇒ 查 LC 电感（SRF/线性度） |
| V5 | `+5V_A` 压降 | 9.4 mV（2mA×4.7Ω） | | 明显偏大 ⇒ 查 U1 是否振荡 |
| V6 | **电源纹波抑制**（改前改后对比） | 500kHz 改善 **50 dB** | | 在 `+5V` 注 100mVpp@100kHz，看 `TP4` 伪峰 |
| V7 | **ADC 采样误差的非线性分量** | 仿真只证了 LTI 部分（1.42 LSB 斜率项） | | 注入纯正弦看 THD —— **这一项仿真盖不住** |
| V8 | 题面示例（10.5k/31.5k/42.0k） | Upp 误差 −0.019mV、ΔA ≤0.005mV（`27 §8.8`） | | 逐分量对 5mV / 1kHz |
| V9 | 场景 3 的 u_J 抑制 | 峰表无 u_J、**带内伪峰 0 个** | | 有伪峰 ⇒ 查 LC 与 R8/C10 |
| **V10** | **上电 150ms 内不应出现「模拟轨可疑」**（`29 §5-D1`） | 已加 `APP_AFE_SETTLE_MS=150` 显式等待 | | 若在 150ms 内仍报警 ⇒ 查 `+3V3` 是否先于 `+5V_A` 建立 / `C13` 是否贴错 |
| **V11** | **`J1` 机械强度**（`29 §8-G1`） | — | | 手推 BNC 转接件不晃、焊盘不剥离；见下方 **PCB-1** |
| **V12** | **8080 边沿过冲**（`29 §6-E1/E3`） | `S9 ①`：33Ω 下 8~21% | | 示波器看 J5 侧（对比 `R.n` 两侧）；>30% ⇒ 查 `R22~R41` 是否贴到 MCU 侧 |
| **V13** | **自激**（`37 §3.4` / `36 §M.6`） | 零输入长瞬态**完全静默**（末窗 p-p ~nV 量级）；环内唯一外部极点 4.25 MHz（穿越处损失 16.4°） | | **SMA 端接 50Ω、不接信号源**，示波器看 `TP4` / `U1` 输出有无**持续正弦**（自激不靠外部激励）；再交叉验 `V5`（`+5V_A` 压降异常偏大 = 运放可能在振荡） |
| **V14** | **`R6`/`R7` 的稳定性后果**（`37 §3.4`） | 24.9k/3.57k ⇒ `−in` 极点 4.25 MHz、损失 16.4° | | 若误贴 69.8k/10k ⇒ 极点掉到 1.52 MHz、损失 **39.6°**（最坏 `Cin` 下 **58.8°**）⇒ 这是"**必须贴 24.9k/3.57k**"的第二条、比通带形状更硬的理由。**通带不对还能标定，自激不能** |

### 7.1 PCB 约束（**投板检查单，从上到下勾**）

| # | 约束 | 依据 | 判据 |
|---|---|---|---|
| **PCB-1** | **`J1`（SMA-KE 贴片座）做机械加强**：座子下方与两侧多打过孔、焊盘外扩；或改通孔 SMA 座 | `29 §8-G1`：题面要 BNC 座，本板用 SMA + 转接件 ⇒ **插拔力矩全压在贴片焊盘上** | 手推转接件不晃；焊盘无剥离 |
| **PCB-2** | **`J5` 的 GND（pin 29）走线尽量短、宽、多打过孔**，焊盘周围铺铜 | `29 §6-E3`：20 条线共用 1 根 GND 针，地弹 ∝ `L_gnd×N×di/dt` | 目标 `L_gnd ≤30nH`（直插转接板形态） |
| **PCB-3** | **`R22`~`R42` 必须贴到 MCU 引脚 3~5mm 以内** | 图纸画在 J5 侧是 EDA 工具限制（`18 §R-21`）；放连接器侧实测只能拿到源端约 **1/3~1/2** 的降幅（`36 §F`） | 示波器看 J5 侧边沿过冲 <20% |
| **PCB-4** | ⚠️ **本条 2026-10-03 拆成 4a~4d，措辞已改**（原文"`AGND` 铜皮与 `GND` 只在一点相接"**照字面做会造出第二个接地点**，见 `36 §M.1`） | | |
| **PCB-4a** | **底板上 `AGND` 与 `GND` 两张铜皮不得相连** —— 不许重叠、不许用 0Ω/跳线/过孔把它们桥起来。**原理图这一层已经是对的**（两张网没有任何连接件）；要在 PCB 上**保持**它 | `36 §M.1`：唯一回路是核心板 `R8`（已实测贴）；`26 §N7`"只许一个点" | 底板网表里两张地网**零连接件**；目视两块铜皮不重叠 |
| **PCB-4b** | AFE 区所有模拟地**只汇到 `EVK1.37` 这一个点**（不是"找块大铜皮连上"） | AFE 页 `AGND` 共 **18 个成员**（`26 §5`） | 逐个数：`AGND` 的每个成员都指向 `EVK1.37`，无第二条出路 |
| **PCB-4c** | 数字回流**不得借道** `AGND` 铜皮：FSMC 总线束与背光电流回路不得跨越/穿过 AFE 区（`22 §5` 的 ≥10mm 分隔） | 借道 = 把数字回流注进模拟地，症状是噪声底变差、**不报错** | 目视：总线束与背光走线离 AGND 区 ≥10mm；底层铺铜不把两者连起来 |
| **PCB-4d** | 2 层板无地平面兜底 ⇒ 底层尽量整片铺 `GND`，`AGND` **只在 AFE 那一小块独立成岛** | 同上 | 目视 |
| **PCB-5** | **电感正交摆放 + 间距 ≥2mm + 下方不走高速线** | `L3/L5` 同为 22µH ⇒ 互感最大 | 目视 + 尺量 |
| **PCB-6** | **屏模组刚性固定**（直插转接板/排母），**禁杜邦飞线** | 飞线 = 振铃 + 接触不良 | 目视 |
