funiang-x/G2026/hardware/33-BOM重生成与缺失值修复-20261003.md

# G2026 · 原理图第 4 轮：BOM 重生成 + 缺失值修复 + 门禁补齐 · 2026-10-03

> **本轮做了三件前几轮漏掉的事**：
> ① **补跑固件四道门禁**（上轮只跑了 `compile_all`，另三道没跑）；
> ② **从活体网表重生成 BOM**（旧 CSV 的位号/值/C# 三列全是旧的）；
> ③ **修掉两个元件的"值"缺失**（`C23`/`C21` 图上不显示 10µF —— 这是 `18 §R-25` 记的坑）。

---

## §0 一屏结论

| # | 项 | 结果 |
|---|---|---|
| 1 | **固件四道门禁** | **全过** ✅ `lint` rc=0 · `doccheck` rc=0（446 条引用无死链）· `test` **5/5 套 100%** · `sizecheck` 通过 |
| 2 | **BOM 重生成** | `hardware/bom_final.csv` **69 行**（含表头）＝ AFE 36 · INT 25 · PWR 7；**真 C# 65/68（95%）**；旧版备份 `bom_final.csv.bak-20261003` |
| 3 | **修掉 2 个"值为空"** | `C23`（10µF）· `C21`（10µF）—— 图上原本**只显示器件名、不显示数值** |
| 4 | **单位写法统一** | `C23`/`C21` 统一为 `10uF`（与板上其余 `22uF`/`100nF`/`470pF` 一致） |
| 5 | **三页门禁** | AFE **PASS** · PWR **PASS** · INT 仍是既有的 `wire-through-body`（`32 §3` 已结案）；**三页 DRC 均 0 致命 / 0 错误 / 1 警告** |
| 6 | **`sizecheck` 的诚实说明** | 它跑在 **10-02 22:13 的 ELF** 上（我的固件改动只加一次 `osDelay`，~20 字节）⇒ **这条门禁验的不是本轮改动**；改动的编译级验证由 `compile_all`（553 TU 零告警）承担 |

---

## §1 补跑固件四道门禁（上一轮的缺口）

上一轮我改了固件（`project_config.h` 加 `APP_AFE_SETTLE_MS` + `app_rtos.c` 加 `osDelay`），
但只跑了 `_archive/_review3/compile_all.py`（553 TU 等价复编）。**项目自己的四道门禁里另三道没跑** —— 本轮补上：

| 门禁 | 结果 | 说明 |
|---|---|---|
| `fw.py lint` | ✅ **rc=0** | `.ioc` ↔ `board_config.h` 口径对账通过（5 处单侧有值的提示，不影响判定） |
| `fw.py doccheck` | ✅ **rc=0** | 扫描 17 个文档、**446 条引用**，**无死链、无陈旧标识符** |
| `fw.py test` | ✅ **rc=0** | **5/5 套全过、0 失败**（blink / flash / meas / cal / render，共 2.15s） |
| `fw.py sizecheck` | ✅ 通过 | RAM 87,784 B (66.97%) · CCMRAM 32,768 B (50.00%) · FLASH 508,492 B (48.49%) |

> ⚠️ **诚实标注**：`sizecheck` 读的 `build/Debug/G2026.elf` 是 **2026-10-02 22:13** 的，
> **不含本轮的固件改动**。本轮改动只是**一次 `osDelay` 调用**（~20 字节），
> 编译级验证由 `compile_all`（553 TU，失败 0 / 告警 0）承担。
> **要拿"含本轮改动的体积数"，需在沙箱外跑一次 `fw.py build --clean-first`**（本沙箱 ninja 跑不动）。

---

## §2 BOM 重生成（本轮主交付）

### 2.1 为什么必须重生成

旧 `hardware/bom_final.csv` 是 **2026-10-02 21:20** 的。之后发生了：

| 类别 | 变化 |
|---|---|
| **删件** | `C12` / `JP3` / `TP6`（VREF 留位死支路，`30 §5`）+ 更早的 `C19`/`C20`/`LED1`/`R11` |
| **改值** | `R21` 0Ω→**4.7Ω** · `R6` 69.8k→**24.9k** · `R7` 10k→**3.57k** |
| **补供应商编号** | 31 件从 `<MPN>.1` 换成**真 C#**（`32 §1`） |

⇒ 旧 CSV 的**位号、值、供应商编号三列全是旧的**，拿去下单会买错件。

### 2.2 重生成

脚本 `_archive/_review4/eda/gen_bom.py`（从活体网表直读，不依赖任何文档）：

```
hardware/bom_final.csv  69 行（含表头）
  AFE 36 · INT 25 · PWR 7  = 68 个位号
  供应商编号：真 C# 65 / 68（95%）
  仍待人工指定：D1(SRV05-4) · R8(0805W8F1000T5E) · D2(SS34)
```

表头与旧版一致：`页,位号,器件名,值,厂商型号,供应商编号,封装`
旧版已备份为 `hardware/bom_final.csv.bak-20261003`。

---

## §3 修掉 2 个"值为空"的元件（**本轮最有价值的修复**）

### 3.1 问题

重生成 BOM 时抽样发现：**`C23` 的「值」列是空的**。全页扫一遍，共 **6 个元件的「值」为空**：

| 位号 | 器件名 | 判定 |
|---|---|---|
| **`AFE/C23`** | CL21A106KAYNNNE | ❌ **真问题** —— 它是 **10µF 隔直电容**，图上却不显示数值 |
| **`INT/C21`** | CL21A106KAYNNNE | ❌ **真问题** —— 它是 **10µF 屏去耦**，同上 |
| `AFE/D1` | SRV05-4 | ✅ 正常（TVS 没有"值"） |
| `INT/EVK1` | LCKFB-…-PRO | ✅ 正常（核心板模块） |
| `PWR/D2` | SS34_C8678 | ✅ 正常 |
| `PWR/F1` | PPTCPSMD1006V1A | ✅ 正常 |

### 3.2 根因

**`18 §R-25` 早就记过这个坑**：
> "`sch replace` 不带库器件属性 ⇒ 换料后图上 `Value` 丢失（本次 `R6` 空白）"

`C23` 与 `C21` 是**后来新加/换料**的，`Value` 属性没跟着带上。
**后果**：装配时看着图不知道贴多少 —— 10µF 还是 100nF？**这是一个会贴错件的隐患。**

### 3.3 修复

```
sch modify --id <C23> --patch {"customAttributes":{"Value":"10uF"}}
sch modify --id <C21> --patch {"customAttributes":{"Value":"10uF"}}
```

- 两者都已生效并**回读确认**（`C23 Value='10uF'` · `C21 Value='10uF'`）
- 顺带**统一单位写法**：板上其余电容是 `22uF`/`100nF`/`470pF`，新补的也写成 `uF`
- ⚠️ **踩到工具已知 bug**：对**已经设好**的属性再 `modify` 一次会报
  `Cannot destructure property 'cmdKey'`（工具自己在开头就警告过 "Web 4.1.60 曾间歇报 cmdKey"）。
  **它不是失败** —— 回读证明值已生效。**判据：以回读为准，不以 `ok` 字段为准。**

### 3.4 还查出一条"器件名 vs 厂商型号"不一致（**未改，只记**）

| 位号 | 器件名（库绑定） | 厂商型号（属性） | 值 | 判定 |
|---|---|---|---|---|
| `R6` | RT0805BRD07**69K8**L | RT0805BRD07**24K9**L | 24.9kΩ | 值/型号对 ✓，**器件名是旧料号** |
| `R7` | HoAR0805-…10KR… | RT0805BRD073K57L | 3.57kΩ | 同上 |
| `R21` | 0805W8F**0000**T5E | 0805W8F**4R70**T5E | 4.7Ω | 同上 |

**根因**：`sch modify` 只改**属性**，不改**库器件绑定**（改绑定要用 `sch replace`，而它风险高、还会丢属性 —— 正是 §3.2 那个坑）。
**影响**：BOM 的「器件名」列是旧的，但**「值」「厂商型号」「供应商编号」三列都对** ⇒ 下单不受影响（下单看 C#）。
**处置**：不改。若要求 BOM 三列完全一致，需人工在 EDA 里重新绑定器件（或走 `sch replace` + 补属性）。

---

## §4 三页门禁（改后复核）

| 页 | 结果 | DRC |
|---|---|---|
| AFE | **PASS** | **0 致命 / 0 错误 / 1 警告**（改前 2 条，补 C# 后降到 1） |
| INT | FAIL（既有） | **0 致命 / 0 错误 / 1 警告** —— FAIL 来自 18 条 `wire-through-body`（`32 §3` 已结案：EVK1 符号几何，非线错） |
| PWR | **PASS** | **0 致命 / 0 错误 / 1 警告** |

---

## §5 本轮**没做**的

| # | 项 | 原因 |
|---|---|---|
| 1 | 在沙箱内重建 ELF 让 `sizecheck` 覆盖本轮改动 | 本沙箱 ninja 跑不动（`25 §8-1`）；`compile_all` 已做等价编译级验证 |
| 2 | 修 `R6`/`R7`/`R21` 的"器件名"旧料号 | 要 `sch replace`，会丢属性（`18 §R-25`）且曾挂起；而下单只看 C#，不影响 |
| 3 | 给 `D1`/`R8`/`D2` 补 C# | **真歧义**（镜像封装 / 多候选 / 封装差 0.2mm），工具拒绝猜 —— 见 `32 §1.5` |
| 4 | `R42`（LCD_RST 串阻） | `sch place` 第 4 次确认不可用（`32 §5`） |

---

## §6 证据与复现

```bash
# 固件四道门禁（在 firmware/ 下）
python Tools/fw.py lint && python Tools/fw.py doccheck
python Tools/fw.py test && python Tools/fw.py sizecheck

# BOM 重生成（从活体网表，不依赖文档）
python _archive/_review4/eda/gen_bom.py

# 供应商编号补全（三级不猜规则）
python _archive/_review4/eda/resolve_bom.py          # dry-run
python _archive/_review4/eda/resolve_bom.py --apply

# 三页门禁
easyeda sch gate --doc <pageUuid>
```

---

## §7 变更记录

| 日期 | 内容 |
|---|---|
| 2026-10-03 | 首版（第 4 轮）：补跑固件四道门禁（**全过**，含 `sizecheck` 跑在旧 ELF 上的诚实标注）· **BOM 从活体网表重生成**（69 行 / 真 C# 95%）· **修掉 `C23`/`C21` 的值缺失**（10µF，会贴错件的隐患）并统一单位 · 记录 `R6`/`R7`/`R21` 的"器件名"旧料号（未改，附理由）· 三页门禁复核。 |
