funiang-x/G2026/hardware/bom_final.csv

Designators | Qty | Value | Footprint | MPN | LCSC
C10 | 1 | 470pF | C0603 | CL10C471JB8NNNC | C27694
C1 C9 C14 C22 | 4 | 100nF | C0805 | CC0805KRX7R9BB104 | C49678
C6 | 1 | 10nF | C0805 | GRM2195C1H912JA01D/BKN
C4 | 1 | 10nF | C0805 | 0805CG103J500NT | C2971995
C3 C5 C7 | 3 | 10µF | C0805 | CC0805KRX5R8BB106 | C1952586
C8 | 1 | 2.2nF | C0805 | 0805CG182J500NT
C2 | 1 | 6.8nF | C0805 | GRM2195C1H622JA01D
C11 C16 | 2 | 22uF | CAP-SMD_L3.5-W2.8 | TAJB226K025RNJ | C2837459
EVK1 | 1 | LCKFB-LSPI-SkyStar-STM32F407VGT6-PRO | COMM-TH_LCKFB-LSPI-SKYSTAR-STM32F407VGT6-PRO | LCKFB-LSPI-SkyStar-STM32F407VGT6-PRO | C32710423
J5 | 1 | 2.54-2*15P 母座（直插） | HDR-TH_30P-P2.54-V-F-R2-C15-S2.54 | 2.54-2*15P母 | C58377
L7 | 1 | 15uH | IND-SMD_L7.0-W6.6 | HCM0630-150M | C9900009031
L3 L5 | 2 | 22uH | IND-SMD_L7.0-W6.6 | XR0630-220M | C5307626
L1 | 1 | 4.7uH | IND-SMD_L7.0-W6.6 | XR0630-4R7M | C5307631
SCREW1 SCREW2 SCREW3 SCREW4 | 4 | M3螺丝 | M3螺丝
JP1 JP2 | 2 | 0Ω | R0805 | 0805W8F0000T5E | C17477
R2 R5 R9 R10 | 4 | 10kΩ | R0805 | 0805W8F1002T5E | C38522
R7 | 1 | 1kΩ | R0805 | ARG05BTC3571
R12 | 1 | 1kΩ | R0805 | 0805W8F1001T5E | C17513
R11 | 1 | 300Ω | R0805 | 0805W8F3000T5E | C17617
R22 R23 R24 R25 R26 R27 R28 R29 R30 R31 R32 R33 R34 R35 R36 R37 R38 R39 R40 R41 R42 | 21 | 33Ω | R0805 | 0805W8F330JT5E | C17634
R21 | 1 | 4.7Ω | R0805 | RC0805FR-074R7L | C137513
R1 R3 R4 | 3 | 49.9Ω | R0805 | 0805W8F499JT5E | C17720
R6 | 1 | 6.8kΩ | R0805 | RT0805BRD0753K6L
J1 | 1 | SMA-KE | SMA-SMD_SMA-KE | SMA-KE | C9900004802
U1 | 1 | OPA2197ID | SOIC-8_L4.9-W3.9-P1.27-LS6.0-BL | OPA2197ID | C1347222
D1 | 1 | PESD5V0X1BT,215 | SOT-23-3_L2.9-W1.3-P1.90-LS2.4-BR | PESD5V0X1BT,215 | C456094
TP3 TP4 TP5 | 3 | TP-黄色测试点 | TESTPOINT-TH_BD3.2 | TP-黄色测试点 | C9900007422
