funiang-x/G2026/hardware/07-无连接标志待点清单.md

# G2026 原理图 · 无连接标志（NC）待点清单

> ⛔ **2026-10-04：本文件已过期，不要再照着做。**
> ① 下面的位号（`H3`/`H4`/`J4`/`J2`…）**多数已不存在**（`H3`/`H4` 早已并入 `J5`，见 `13`）；
> ② 那句"这版 EDA 的 API **放不了** NC 标志"**已不成立** —— 现在
> `easyeda sch no-connect --designator <位号> --pin <脚号>[,脚号]` 可用（`--clear` 取消），今天刚用过。
> **现行判据不看本清单，看活体**：三页 `sch check` 的 `floating pin(s)` 字段
> （2026-10-04 实测 **AFE 0 / INT 0 / PWR 0**）⇒ 该打的 NC 全都打了。
> 状态汇总见 `38-底板设计状态体检-20261004.md`。

> **打法（已验证）**：选中引脚 → 按快捷键 **`C`**
> （设置 → 快捷键 里「放置非连接」已绑定到 `C`，作用域：原理图页）
>
> **原因**：这版 EDA 的 API **放不了** NC 标志
> （`setState_NoConnected` 运行时不存在；`SCH_PrimitivePin.modify` 静默空操作；
> `SCH_PrimitiveAttribute` 类 undefined；源码里的 `NO_CONNECT` 属性是序列化器单向输出、解析器不认）。
> 详见 `06-修正BOM与落图清单.md` §9 / §9.1。
>
> 点完 DRC 里的「悬空引脚」告警即清零。

## 顺序建议

按页做，同页内按脚号从小到大，不容易漏。每打完一个在下面划掉。

## AFE 页 · D1（3 个）

脚号：1, 3, 6

## AFE 页 · J2（8 个）

脚号：7, 8, 9, 10, 11, 12, 13, 14

## INT 页 · EVK1（47 个）⚠️ 其中一个（脚 1）曾被误删，需重新打

脚号：1, 5, 6, 7, 8, 10, 25, 26, 27, 28, 33, 34, 41, 42, 43, 44, 45, 46, 47, 48, 49, 50, 51, 52, 53, 54, 55, 56, 57, 58, 59, 60, 61, 62, 63, 64, 65, 66, 68, 73, 74, 75, 76, 81, 82, 83, 84

## INT 页 · H3（5 个）

脚号：1, 13, 14, 15, 16

## INT 页 · J4（8 个）

脚号：7, 8, 9, 10, 11, 12, 13, 14

**合计 71 个引脚。**

---

## 打完之后的验收

1. 嘉立创里 设计 → 检查 DRC，重新导出 `schDrcLog_*.txt` 发给我。
2. 预期：只剩
   - 「元件的属性与供应商编号不匹配」→ 工具 → 器件标准化（一次点掉）
   - 「元件『值』属性内容为空」→ 待补
   - `U1A`/`U1B` 位号不合规 + 「多部件元件不完整」→ 需重做成多部件元件
   - 可能还有 1 条 INT 页 `GND` 单网络导线 → 删掉即可
3. 若仍报「引脚悬空」，把脚号发我，我核是不是漏了哪个。

---

## 2026-09-28 实测复核（自动执行结果）

> 本节是当天下午实测后补入。开头那句"打法（已验证）：选中引脚 → 按快捷键 `C`"描述的是**人工**做法；
> 实际执行走了**自动化路线**——结论不变（**API 层确实放不了 NC**），但手段升级了。

### 实际怎么打上的：OS 级模拟按键

skill `easyeda-sch-audit-fix` 的 NC 章（按键法兜底）（路线 E，跑通）的完整链路：

1. `eda.sch_SelectControl.doSelectPrimitives([引脚ID])` —— 选中目标引脚
2. `eda.dmt_EditorControl.zoomToSelectedPrimitives()` —— 聚焦，保证画布有焦点
3. PowerShell 调 `user32.dll SetForegroundWindow` —— **抢 EDA 窗口到前台**
   （抢不到就中止，避免把 `c` 打到别的窗口）
4. `WScript.Shell.SendKeys("c", false)` —— 模拟按下快捷键 `C`
5. 验证：读源码数 `"key":"NO_CONNECT"` 的出现次数

> ⚠️ **API 层"放不了 NC"的结论仍然成立**：`setState_NoConnected` 运行时不存在；
> `SCH_PrimitivePin.modify({noConnected:true})` **虽然在文档签名里有这个参数**
> （`easyeda-api/references/classes/SCH_PrimitivePin.md:499`），但实测静默空操作。
> 绕过办法就是**选中 + 模拟按键**。

### 当前进度（实测）

| 页 | uuid | 已打 NO_CONNECT | 本文件预期 |
|---|---|---|---|
| INT-核心板与接口 | `63accad121e053cf` | **56** | 60（EVK1 47 + H3 5 + J4 8） |
| PWR-电源与背光 | `0c870c063661db6c` | 0 | 0 |
| AFE-前端模拟 | `fe840e6f545a2753` | **11** | 11（D1 3 + J2 8）✅ |
| **合计** | | **67** | 71 |

→ **AFE 页完全对上；INT 页少 4 个**，待核（可能是本文件 §INT 里 EVK1"脚 1 曾被误删需重打"那条及邻近，
也可能是清单与图纸现状有出入）。

### 读取 NC 状态的正确方法（此前"读不到"的说法作废）

引脚对象（`sch_PrimitiveComponent.getAllPinsByPrimitiveId()`）返回的字段**不含** `noConnected`，
所以从引脚对象读不出来。**正确路径是读源码**：

```js
const src = await eda.sys_FileManager.getDocumentSource();
const n = (src.match(/"key":"NO_CONNECT"/g) || []).length;   // 该页 NC 总数
```

### DRC 的正确调用

`eda.sch_Drc.check(strict, userInterface, includeVerboseError)` —— **三个参数都要给**；
无参调用会返回 `false`（那是参数缺失，不代表"不通过"）。本次 `check(false,false,false)` 返回 `true`。

⚠️ 该返回值语义（"通过" vs "执行成功"）**未确证**；要看得见的告警明细，仍在 EDA 里跑 DRC
并导出 `schDrcLog_*.txt`——**EDA 自己导出的日志才是唯一可信验收**（工作台铁律）。

---

## 2026-09-28 傍晚 · 连接根因修正与 DRC 收口（AI 自动执行，实测）

### 真正的根因不是"缺 NC"，而是**所有连接接错了位置**

用 `sch_Primitive.getPrimitivesBBox()` 实测确认了 EasyEDA 的引脚模型：

- 引脚属性 `(x, y)` **就是电气连接点**；
- `rotation` 指向元件**体内**，`pinLength` 是朝内的绘制长度；
- 朝外方向：`0→(+1,0) · 90→(0,+1) · 180→(-1,0) · 270→(0,-1)`。

而本页画的连接是「端口放在 `(x,y)+朝外×(pinLength+10)`、导线从 `(x,y)+朝外×pinLength` 连到端口」
——**导线靠引脚的那一端落在引脚画的另一端，等于没接**。

证据（C16）：引脚属性 (470,1200) rot=270 len=19，包围盒 y = 1199.5→1219.5，
说明引脚是从 (470,1200) **朝体内**画的 ⇒ 连接点 = (470,1200)。
而导线接在 (470,1181) —— 在元件**外侧** 19 单位处。

### 修正动作（只改导线靠引脚的那一端，端口不动）

| 页 | 页内引脚数 | 已修正连接 | 未匹配（NC 已打/真缺） |
|---|---|---|---|
| INT | 153 | **84** | 69（含已打 NC 的 56+ 个） |
| PWR | 44 | **44** | 0 |
| AFE | 98 | **87** | 11（= 该页 NO_CONNECT 数） |
| **合计** | 295 | **215** | — |

> ⚠️ 踩到的坑：`sch_PrimitiveWire.modify(id, {line})` **只传 line 会把 `net` 清空**。
> 已按「端口坐标 → 网名」映射补回 **213 条**（PWR 44 / INT 84 / AFE 85）。

### DRC 结果（同一份工程，前后对比）

| 时点 | 全部 | 致命错误 | 错误 | 警告 | 信息 |
|---|---|---|---|---|---|
| 修复前（16:48 实测） | 118 | 0 | 0 | **69** | 49 |
| 修复后 | **62** | 0 | **0** | **13** | 47 |

**"引脚悬空"告警从 216 个引脚降到 12 个。**

### 剩余 12 个悬空引脚（需人定，AI 未动）

| 引脚 | 名称 | 现状与建议 |
|---|---|---|
| EVK1.67 / 69 / 70 / 71 / 72 | D07 / D05 / D04 / D01 / D00 | 对应网 `LCD_CS / LCD_WR / LCD_RD / LCD_D3 / LCD_D2`。**该页已存在这 5 个 EVK1 侧端口**，但它们与引脚**整体错位了整整 525 单位**（7 个端口 y 偏移完全一致，且只剩 10 单位残桩）——是 EVK1 挪位后的历史残留。建议：把端口搬到 `(x,y)+朝外×10` 并补 10 单位短线 |
| EVK1.78 / 80 | 3V3 / 5V0 | 同上错位；对应网 `+3V3` / `+5V` |
| EVK1.81 / 82 / 83 / 84 | 81~84 | **本清单已列**，属该打 NC 但尚未打 |
| U1B.8 | V+ | 同侧 U1A.8 已接 `+5V_A`；U1B.8 缺线。⚠️ (2300,1110) 处**同时压着 `AFE_ADC_OUT` 与 `+5V_A` 两个端口**（重复标签，疑似误留），先清掉多余那个再接，否则会短路 |

### 其余 DRC 类别（非连接问题）

- **「元件的属性与供应商编号不匹配」×3 条消息**（涉 60+ 器件）→ EDA 里 **工具 → 器件标准化** 一次点掉。
- **「元件『值』属性内容为空」** → 待补。实测 `get(C16).otherProperty.Value == ""`。
- **`U1A/U1B` 多部件元件不完整** + **「元件 OPA2197ID 的引脚与焊盘未对应（焊盘没有对应引脚：5、6、7）」**
  → 符号的 B 单元复用了 1/2/3 脚，而封装有 5/6/7 无对应引脚；需把 U1B 换成映射 5/6/7 的正确单元。
  **这属于元件级重做，未动。**

### 本页以外的三处教训（已写回工作台）

1. 根 `AGENTS.md` 铁律 1 的旧措辞（"端口放在引脚端点外 10 单位"）是**错的**，已按本条实测改写。
2. **DRC 明细的唯一可行读法**：`check(false,true,false)` 开面板 → 读
   `document.getElementById('schDrcPrimaryLog').textContent`（API 侧 `verboseError:true` 实测仍返回 boolean）。
   计数徽标 `全部/致命错误/错误/警告/信息` 就在文本里，**改前记基线、改后比对**是可靠闭环。
3. **你之前贴的那份 DRC 日志是被截断的**（原始 47 条信息只贴了 1 条）；
   实际"悬空"覆盖三页共 216 个引脚，不是日志里那几个。

---

## 2026-09-28 深夜 · NC 全部打卡完成（**改走源码注入，不再用模拟按键**）

### 换了方法：从"抢键鼠模拟按键"改成"改页面源码"

前一条记录里说"API 放不了 NC，只能走 OS 级模拟按键"——**这个结论只对了一半**：

- **对的一半**：引脚对象 API 确实写不了。`setState_NoConnected` 运行时不存在；
  `sch_PrimitivePin.modify(id, {noConnected:true})` 静默空操作（2026-09-28 二次实测确认：
  返回引脚对象、不报错、源码里 `NO_CONNECT` 计数不变）。
- **漏掉的一半**：页面源码是一条**纯文本记录流**，NC 就是其中一条普通 `ATTR` 记录 ——
  **可以直接构造并追加**，再用 `sys_FileManager.setDocumentSource()` 整体写回。
  **全程不碰用户的鼠标键盘。**

### 为什么弃用模拟按键

本批 4 个引脚（EVK1.81~84）先试按键法：**4 次只成 1 次**（只有 .82 成功）。
原因是它依赖"抢到窗口焦点 + 精确点中引脚"，而点击画布取焦点会**清掉已有选中**，
坐标稍有偏差就落空。更要紧的是它**会抢占用户的鼠标和键盘**，用户在用电脑时会被打断。

改用注入法后：**一次全成**。

### NC 记录的确切格式（已与 57 条现存记录逐条比对一致）

```
{"type":"ATTR","ticket":N,"id":"<16位小写hex>"}||{"parentId":"<引脚primitiveId>","key":"NO_CONNECT","x":<引脚x>,"y":<-引脚y>,"value":"yes","zIndex":<整数>}
```

- `parentId` = 引脚 primitiveId（形如 `00726019c8c2f9ff-e328`）
- **`y` 取负**——源码坐标系 y 与 API 返回的 `pin.y` 符号相反（**57 条现存记录全部符合此规则**）
- `value` 恒为 `"yes"`；`ticket` 全页单调递增（写前 max=1119，故用 1120/1121/1122）
- `id` 不得与任何现有 id 撞（写前共 1118 个 id，逐一对撞检测）
- 记录流格式：记录用 `"|\n"` 连接，每条内部是 `HEADER||DATA`，**末尾无分隔符**；只做**追加**

### 本次动作与结果

| 项 | 值 |
|---|---|
| 页 | INT-核心板与接口 |
| 补打 NC 的引脚 | **EVK1.81 / .83 / .84**（.82 已由按键法完成） |
| 源码长度 | 319896 → **320368**（+472） |
| `"key":"NO_CONNECT"` | 57 → **60** |
| `setDocumentSource` 返回 | `true` |
| 回读一致性 | **逐字节等价**（仅 `DOCHEAD` 的 `client` / `updateTime` 被 EDA 自行改写） |

### DRC 前后对比（同一份工程，全程实测）

| 时点 | 全部 | 致命错误 | 错误 | 警告 | 信息 | 悬空引脚 |
|---|---|---|---|---|---|---|
| 起点 | 118 | 0 | 0 | 69 | 49 | **216** |
| 第 1 轮（连接接回 `(x,y)`，215 条） | 62 | 0 | 0 | 13 | 47 | 12 |
| 第 2 轮（EVK1 侧 7 个端口搬回正确落点） | 57 | 0 | 0 | 8 | 47 | 5 |
| **第 3 轮（注入 NC）** | **57** | 0 | 0 | **8** | 47 | **1** |

**「引脚悬空」告警：216 个引脚 → 1 个（只剩 U1B.8）。**

### 关于之前那条"血的教训"

本 skill 的兄弟文档曾记：「`setDocumentSource` 每次调用都会把页面上已存在的 `NO_CONNECT` 剥掉，
实测 3 次全丢」。

**本次复测未能重现**：写回后回读，57 条旧 NC 全部幸存（抽样 5 条逐一确认），
记录总数 1120 → 1123、各 type 分布完全不变、`ticket` 最大值一致。

**它那次"弄丢 NC"最可能的真因是写回了过期快照**——读了源码之后又有人（或自己）在界面上改了页，
然后写回的是**读之前**那份，于是期间的改动被整份覆盖。
→ **铁律**：读源码与写源码之间**不许有人/有操作改动该页**；写前先 `getDocumentSource()` 存盘
（那就是完备备份）；写完立刻回读比对；改动**只做追加**。

### 仍未处理（需设计者拍板，AI 未动）

| 项 | 现状 |
|---|---|
| **U1B.8** | 运放 B 单元 V+ 脚，唯一剩余悬空。同侧 U1A.8 已接 `+5V_A`。⚠️ (2300,1110) 处**同时压着 `AFE_ADC_OUT` 与 `+5V_A` 两个端口**（重复标签），先清掉多余那个再接，否则短路 |
| 器件标准化 | 60+ 器件报「属性与供应商编号不匹配」，EDA 里「工具 → 器件标准化」可一次点掉 |
| 空 Value | 部分元件 `otherProperty.Value` 为空 |
| U1A/U1B 多部件不完整 | 符号 B 单元复用了 1/2/3 脚，而封装有 5/6/7 无对应引脚 → 需换成映射 5/6/7 的正确单元，属元件级重做 |

### 快照（可回滚）

归档在 `~/.local/g2026-sch-snapshot-20260928/`：
`INT_before_NC_api.txt`（改前源码）、`INT_planned_NC_inject.txt`（计划写入）、
`INT_after_NC_api.txt`（改后回读）、`drc_*.txt`（各阶段 DRC 面板文本）。
**整页源码本身就是完备备份**——写回原文即可还原。

---

## 2026-09-28 深夜续 · 取到全量 DRC 日志，清掉 4 类残留

### 方法突破：DRC 面板只有 8 行，**「导出」按钮才是全量**

面板 `#schDrcPrimaryLog` 的列表是滚动窗口，**只保留 8 条消息**（`textContent` 也只有 8 条），
但计数徽标统计的是全部 —— 所以前几轮我只能看见零头，靠猜。

**正解**：点**面板内**的「导出」按钮，EDA 直接落盘
`C:\Users\funiang\Downloads\<uuid>.tmp`（UTF-8 文本，就是完整日志）。
注意按文本找按钮会先命中**菜单栏**的「导出」，必须限定在
`#schDrcPrimaryLog [class*='log-btns']` 里。

### 清掉的 4 类（全部有实测前后对比）

| # | DRC 消息 | 病因 | 处置 |
|---|---|---|---|
| 1 | `导线 $1N375 / $1N378 是单网络，仅连接了一个元件引脚` | 导线端点落在**引脚尖端** `(x,y)+朝外×len` 而非连接点 `(x,y)` | `[2360,1050→2380,1050]` → `[2340,1050→2380,1050]`（R8.1 接 U1B.1 输出，net `AFE_ADC_OUT`）；`[2630,1050→2670,1050]` → `[2640,1050→2670,1050]`（J2.7 接 `AFE_ADC_IN`） |
| 2 | `导线 $3N688 有多个网络名: GND、GND` | 导线**既有 GND 标签、又被手动设了 `net='GND'`** | 清空这两条导线的 `net` 属性（名字交给标签） |
| 3 | `网络端口 AFE_ADC_OUT 的名称与所连导线名称 +5V_A 不一致` | (2300,1110) 处**同时压着 `AFE_ADC_OUT` 与 `+5V_A` 两个标签** | 见下方"增益网络判定" |
| 4 | `发现元件引脚悬空 : U1B.8` | V+ 未接线 | V+ 连接点 (2300,1080) → 新建 `+5V_A` 旗 + 10 单位短线 |

### 关键判定：为什么 (2300,1110) 该是 `AFE_ADC_OUT`

查器件型号（**LCSC 型号自带阻值**）：

| 位号 | partId | 值 |
|---|---|---|
| R6 | `0805W8F3002T5E` | **30 kΩ** |
| R7 | `0805W8F1002T5E` | **10 kΩ** |
| R8 | `0805W8F1000T5E` | 100 Ω |
| R1 / R3 / R4 | `0805W8F499JT5E` | 49.9 Ω |

R7 从 `AFE_G2_FB` 到 `AGND`，R6 从 `AFE_G2_FB` 到 (2300,1110) —— 同相放大增益
`1 + R6/R7 = 1 + 30k/10k = **4**`，与 `02-architecture.md` 的「GAIN（OPA2197 半 B，**同相×4**）」
**逐字吻合**。
⇒ **R6 是反馈电阻 Rf，其末端必须是运放输出网 `AFE_ADC_OUT`，不可能是电源 `+5V_A`。**

同时 `U1B.8 = V+`，只能接电源。两点虽在同一条竖线上（V+ 1080 / 节点 1110 / R6.2 1130），
但**语义不同**，因此拆开：

- (2300,1110) 保留 `AFE_ADC_OUT`（删掉误放的 `+5V_A` 旗；对应导线 `net` 改为 `AFE_ADC_OUT`）；
- U1B.8 在 `(2300,1080)+朝外×10 = (2300,1090)` 新建 `+5V_A` 旗 + 10 单位短线。

⚠️ **过程中踩的坑（已记入台账 T-19）**：同坐标有两个标签，我按坐标"找第一个"时
**误删了要保留的 `AFE_ADC_OUT` netport**，随后用 `createNetPort('BI','AFE_ADC_OUT',2300,1110,90,false)` 补回。
教训：定位标签要按 **id** 或 **坐标+类型+网名** 三重匹配。

### DRC 全程（同一份工程，逐轮实测）

| 轮次 | 全部 | 致命 | 错误 | 警告 | 信息 |
|---|---|---|---|---|---|
| 起点 | 118 | 0 | 0 | 69 | 49 |
| 连接接回 `(x,y)` | 62 | 0 | 0 | 13 | 47 |
| EVK1 端口归位 | 57 | 0 | 0 | 8 | 47 |
| 注入 NC | 57 | 0 | 0 | 8 | 47 |
| **本轮**：修 2 条单网络 + 清 2 条重名导线 + 拆 (2300,1110) + V+ 接电 | **51** | **0** | **0** | **3** | 46 |

### 剩余（**全部一类**，需人工一键）

```
[警告] ×3：元件的属性与供应商编号不匹配，建议使用器件标准化（约 60 个器件）
[信息] ×46：属性"值"内容为空 ×41 + 位号不符合建议规则 ×2（U1A/U1B）
             + 多部件元件不完整 ×2
```

**根因同一个：器件属性与库未同步。**

- **警告 ×3**：本机**未找到**可触发「器件标准化」的 API（`lib_*`/`dmt_*`/`sys_*` 穷举无果；
  底部「器件标准化」页签只切面板、不自动执行）→ 需在 EDA 里人工点一次。
- **信息 41 条空值**：`Value` 是**显示属性**，器件身份由 `partId`（LCSC 型号）确定、并未丢失，
  属提示级。可用 `modify(id,{otherProperty: 整表})` 批量补（**已验证通路**，R7 试填成功、
  DRC 信息 -1），但**值需逐个从 `partId` 解码或人工确认**，且本机 `lib_Device` 取不到库属性，
  我**没有擅自批量填**（避免写入未经确认的值）。

### 归档

`~/.local/g2026-sch-snapshot-20260928/`：
`AFE_before_drcfix2.txt` / `AFE_after_drcfix2.txt`、`INT_before_drcfix2.txt` / `INT_after_drcfix2.txt`、
`drc_FINAL_full.txt`（导出的全量日志）。
