funiang-x/G2026/hardware/bom_after.md

# G2026 底板 · 改造后 BOM（画布实读，2026-09-28）

| 页 | 位号 | 器件 | 值 | 介质 | 封装 | 厂商 | 立创料号 |
|---|---|---|---|---|---|---|---|
| AFE | **?** |  |  |  |  |  |  |
| AFE | **?** |  |  |  |  |  |  |
| AFE | **?** |  |  |  |  |  |  |
| AFE | **?** |  |  |  |  |  |  |
| AFE | **?** |  |  |  |  |  |  |
| AFE | **?** |  |  |  |  |  |  |
| AFE | **?** |  |  |  |  |  |  |
| AFE | **?** |  |  |  |  |  |  |
| AFE | **?** |  |  |  |  |  |  |
| AFE | **?** |  |  |  |  |  |  |
| AFE | **?** |  |  |  |  |  |  |
| AFE | **?** |  |  |  |  |  |  |
| AFE | **?** |  |  |  |  |  |  |
| AFE | **?** |  |  |  |  |  |  |
| AFE | **?** |  |  |  |  |  |  |
| AFE | **?** |  |  |  |  |  |  |
| AFE | **?** |  |  |  |  |  |  |
| AFE | **?** |  |  |  |  |  |  |
| AFE | **?** |  |  |  |  |  |  |
| AFE | **?** |  |  |  |  |  |  |
| AFE | **?** |  |  |  |  |  |  |
| AFE | **?** |  |  |  |  |  |  |
| AFE | **?** |  |  |  |  |  |  |
| AFE | **?** |  |  |  |  |  |  |
| AFE | **?** |  |  |  |  |  |  |
| AFE | **?** |  |  |  |  |  |  |
| AFE | **?** |  |  |  |  |  |  |
| AFE | **?** |  |  |  |  |  |  |
| AFE | **?** |  |  |  |  |  |  |
| AFE | **?** |  |  |  |  |  |  |
| AFE | **?** |  |  |  |  |  |  |
| AFE | **?** |  |  |  |  |  |  |
| AFE | **?** |  |  |  |  |  |  |
| AFE | **?** |  |  |  |  |  |  |
| AFE | **?** |  |  |  |  |  |  |
| AFE | **?** |  |  |  |  |  |  |
| AFE | **?** |  |  |  |  |  |  |
| AFE | **?** |  |  |  |  |  |  |
| AFE | **?** |  |  |  |  |  |  |
| AFE | **?** |  |  |  |  |  |  |
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
| PWR | **C17** | TAJB226K016RNJ |  |  |  | Kyocera AVX | TAJB226K016RNJ.1 |
| PWR | **C18** | CC0805KRX7R9BB104 |  |  |  | YAGEO(国巨) | CC0805KRX7R9BB104.1 |
| PWR | **C19** | CC0805KRX7R9BB104 |  |  |  | YAGEO(国巨) | CC0805KRX7R9BB104.1 |
| PWR | **C20** | CC0805KRX7R9BB104 |  |  |  | YAGEO(国巨) | CC0805KRX7R9BB104.1 |
| AFE | **D1** | SRV05-4 |  |  |  |  | SRV05-4_C338781.1 |
| PWR | **D2** | SS34 |  |  |  | MDD(辰达半导体) | SS34_C8678.1 |
| INT | **EVK1** | LCKFB-LSPI-SkyStar-STM32F407VGT6-PRO |  |  |  | 立创开发板 | LCKFB-LSPI-SKYSTAR-STM32F407VGT6-PRO.1 |
| INT | **H3** | FH12-45S-0.5SVA(54) |  |  |  | HRS(广濑) | FH12-45S-0.5SVA(54).1 |
| INT | **H4** | FH12-6S-0.5SH |  |  |  |  | FH12-6S-0.5SH.1 |
| AFE | **J1** | BY-BNC-50KWE |  |  |  |  | BY-BNC-50KWE.1 |
| AFE | **JP1** | 0805W8F0000T5E |  |  |  | UNI-ROYAL(厚声) | 0805W8F0000T5E.1 |
| AFE | **JP2** | 0805W8F0000T5E |  |  |  | UNI-ROYAL(厚声) | 0805W8F0000T5E.1 |
| AFE | **J2** | W10006-206MG0ER1 |  |  |  |  | W10006-206MG0ER1.1 |
| AFE | **JP3** | 0805W8F0000T5E |  |  |  | UNI-ROYAL(厚声) | 0805W8F0000T5E.1 |
| PWR | **J3** | DC005 |  |  |  | SHOU HAN(首韩) | DC005_C431533.1 |
| INT | **J4** | W10006-206MG0ER1 |  |  |  |  | W10006-206MG0ER1.1 |
| AFE | **L1** | XRCD54-4R7M |  |  |  | XR(祥如) | XRCD54-4R7M.1 |
| PWR | **LED1** | KT-0805Y |  |  |  | KENTO | 17-21SUYC/TR8.1 |
| AFE | **L3** | CD54-220M |  |  |  | Zoomdo(震东电子) | CD54-220M_C49230813.1 |
| AFE | **L5** | CD54-220M |  |  |  | Zoomdo(震东电子) | CD54-220M_C49230813.1 |
| AFE | **L7** | XRCD54-120M |  |  |  | XR(祥如) | XRCD54-120M.1 |
| PWR | **Q1** | SI2302 |  |  |  | TECH PUBLIC(台舟) | SI2302_C2841377.1 |
| AFE | **R1** | 0805W8F499JT5E |  |  |  | UNI-ROYAL(厚声) | 0805W8F499JT5E.1 |
| AFE | **R2** | 0805W8F1002T5E |  |  |  | UNI-ROYAL(厚声) | 0805W8F1002T5E.1 |
| AFE | **R3** | 0805W8F499JT5E |  |  |  | UNI-ROYAL(厚声) | 0805W8F499JT5E.1 |
| AFE | **R4** | 0805W8F499JT5E |  |  |  | UNI-ROYAL(厚声) | 0805W8F499JT5E.1 |
| AFE | **R5** | 0805W8F1002T5E |  |  |  | UNI-ROYAL(厚声) | 0805W8F1002T5E.1 |
| AFE | **R6** | 0805W8F3002T5E |  |  |  | UNI-ROYAL(厚声) | 0805W8F3002T5E.1 |
| AFE | **R7** | 0805W8F1002T5E |  |  |  | UNI-ROYAL(厚声) | 0805W8F1002T5E.1 |
| AFE | **R8** | 0805W8F1000T5E |  |  |  | UNI-ROYAL(厚声) | 0805W8F1000T5E.1 |
| AFE | **R9** | 0805W8F1002T5E |  |  |  | UNI-ROYAL(厚声) | 0805W8F1002T5E.1 |
| AFE | **R10** | 0805W8F1002T5E |  |  |  | UNI-ROYAL(厚声) | 0805W8F1002T5E.1 |
| PWR | **R11** | 0805W8F1001T5E |  |  |  | UNI-ROYAL(厚声) | 0805W8F1001T5E.1 |
| PWR | **R12** | 0805W8F1001T5E |  |  |  | UNI-ROYAL(厚声) | 0805W8F1001T5E.1 |
| PWR | **R13** | 0805W8F1003T5E |  |  |  | UNI-ROYAL(厚声) | 0805W8F1003T5E_C149504.1 |
| PWR | **R14** | 1206W4F390JT5E |  |  |  | UNI-ROYAL(厚声) | 1206W4F390JT5E_C22198.1 |
| PWR | **R15** | 0805W8F4701T5E |  |  |  | UNI-ROYAL(厚声) | 0805W8F4701T5E.1 |
| PWR | **R16** | 0805W8F4701T5E |  |  |  | UNI-ROYAL(厚声) | 0805W8F4701T5E.1 |
| PWR | **R17** | 0805W8F0000T5E |  |  |  | UNI-ROYAL(厚声) | 0805W8F0000T5E.1 |
| PWR | **R18** | 0805W8F0000T5E |  |  |  | UNI-ROYAL(厚声) | 0805W8F0000T5E.1 |
| PWR | **R19** | 0805W8F0000T5E |  |  |  | UNI-ROYAL(厚声) | 0805W8F0000T5E.1 |
| PWR | **R20** | 0805W8F1003T5E |  |  |  | UNI-ROYAL(厚声) | 0805W8F1003T5E_C149504.1 |
| AFE | **TP1** | TP-黄色测试点 |  |  |  |  | TP-黄色测试点.1 |
| AFE | **TP2** | TP-黄色测试点 |  |  |  |  | TP-黄色测试点.1 |
| AFE | **TP3** | TP-黄色测试点 |  |  |  |  | TP-黄色测试点.1 |
| AFE | **TP4** | TP-黄色测试点 |  |  |  |  | TP-黄色测试点.1 |
| AFE | **TP5** | TP-黄色测试点 |  |  |  |  | TP-黄色测试点.1 |
| AFE | **TP6** | TP-黄色测试点 |  |  |  |  | TP-黄色测试点.1 |
| AFE | **U1** | OPA2197ID |  |  |  | TI(德州仪器) | OPA2197ID.1 |
| AFE | **U1** | OPA2197ID |  |  |  | TI(德州仪器) | OPA2197ID.1 |
| AFE | **U2** | REF3033AIDBZT |  |  |  | TI(德州仪器) | REF3033AIDBZT.1 |
| PWR | **U3** | AMS1117-3.3 |  |  |  | Advanced Monolithic Systems | pid8a0e77bacb214e |
| INT | **U9** | 2.54-2*20 |  |  |  | ZHOURI(洲日) | 2.54-2*20.1 |
| INT | **U10** | 2.54-2*20 |  |  |  | ZHOURI(洲日) | 2.54-2*20.1 |
