funiang-x/G2026/test-record/G2026-上板测试单-20261016-v6.xlsx

Sheet: 官方测评值+测试矩阵
G2026 上板测试单
幅度一律【峰峰值 mVpp】（发生器直接按 Vpp 设）；题面三式全是 sin、各分量零相位。 橙底 = 你拨信号源；黄底 = 抄屏上的读数；绿底 = 自动算。 谱线①~⑤ 对应频域页右边那五个框，一格抄一条（例：125.0k 49.7），没检出留空。 判据：|Δf1|≤1kHz · |ΔVpp|≤5mV · |ΔVrms|≤5mV。峰峰值 / Vrms 一律 1 位小数（发生器与屏上口径一致）。
 | 场景 / 题面原式 · 档位 |  | 信号源设置 |  |  |  |  |  | 真值（参考） |  |  | 实测 |  |  |  |  |  |  |  |  | 自动判定
序号 | 场景 / 题面原式（照抄） | 对应档位 | ① 频率 kHz | ① 幅值 mVpp | ② 频率 kHz | ② 幅值 mVpp | ③ 频率 kHz | ③ 幅值 mVpp | f1 kHz | Vpp mV | Vrms mV | f1 kHz | Vpp mV | Vrms mV | 谱线① | 谱线② | 谱线③ | 谱线④ | 谱线⑤ | 备注 | Δf1 | ΔVpp | ΔVrms | 判定
电赛(1) | u_a = 50sin(2π·25k·t) + 30sin(2π·75k·t) + 30sin(2π·100k·t) | u_a 档（题面第 1 项） | 25 | 100.0 | 75 | 60.0 | 100 | 60.0 | 25.0 | 162.3 | 46.4 | 25.0 | 162.0 | 46.3 | 25.0khz，49.9mv | 75.0khz，29.9mv | 100.0khz，29.9mv |  |  |  | +0.00 | -+0.30 | -+0.10 | PASS
电赛(2) | u_b = 30sin(2π·100k·t) + 15sin(2π·200k·t) | u_b 档（题面第 2 项） | 100 | 60.0 | 200 | 30.0 |  |  | 100.0 | 77.9 | 23.7 | 100.0 | 77.9 | 23.7 | 100khz，29.9mv | 200.0khz，15.0mv |  |  |  |  | +0.00 | +0.00 | +0.00 | PASS
电赛(3) | u = u_a + u_J = [50sin(2π·125k·t) + 40sin(2π·375k·t)] + 100sin(2π·1000k·t) | 抗干扰档（题面第 3 项） | 125 | 100.0 | 375 | 80.0 | 1000 | 200.0 | 125.0 | 134.9 | 45.3 | 125.0 | 135.0 | 45.2 | 125.0khz，49.7mv | 375.0khz，40.3mv |  |  |  |  | +0.00 | +0.10 | -+0.10 | PASS
T1 | 单音·下边界(10k) |  | 10 | 50.0 |  |  |  |  | 10.0 | 50.0 | 17.7 | 10.0 | 49.6 | 17.5 | 10.0khz，24.8mv |  |  |  |  |  | +0.0 | -+0.4 | -+0.2 | PASS
T2 | ★单音·上边界(500k) |  | 500 | 50.0 |  |  |  |  | 500.0 | 50.0 | 17.7 | 500.0 | 49.0 | 17.3 | 500.0khz，24.5mv |  |  |  |  |  | +0.0 | -+1.0 | -+0.4 | PASS
T3 | ★题面原例(非整周期) |  | 10.5 | 160.0 | 31.5 | 80.0 | 42 | 40.0 | 10.5 | 195.9 | 64.8 | 10.5 | 195.6 | 64.7 | 10.5khz，79.7mv | 31.5khz，40.0mvv | 42khz，19.9mv |  |  |  | +0.0 | -+0.3 | -+0.1 | PASS
T4 | u_a 档 |  | 25 | 100.0 | 75 | 60.0 | 100 | 60.0 | 25.0 | 162.3 | 46.4 | 25.0 | 161.9 | 46.2 | 25.0khz，49.9mv | 75.0khz，30.0mv | 100.0khz，29.8mv |  |  |  | +0.0 | -+0.4 | -+0.2 | PASS
T5 | u_b 档(m=2) |  | 100 | 60.0 | 200 | 30.0 |  |  | 100.0 | 77.9 | 23.7 | 100.0 | 77.8 | 23.6 | 100.0khz，29.9mv | 200.0khz，15.0mv |  |  |  |  | +0.0 | -+0.1 | -+0.1 | PASS
T6 | ★u_b 最小档 |  | 10 | 7.3 | 100 | 14.6 | 160 | 29.2 | 10.0 | 50.0 | 11.8 | 10.0 | 50.1 | 11.9 | 10.0khz，3.6mv | 100.0khz，7.3mv | 160.0khz，14.7mv |  |  |  | +0.0 | +0.1 | +0.1 | PASS
T7 | u_b 最大档 |  | 10 | 36.5 | 100 | 73.0 | 160 | 146.0 | 10.0 | 250.1 | 59.1 | 10.0 | 251.6 | 59.8 | 10.0khz，18.2mv | 100.0khz，36.5mv | 160.0khz，74.0mv |  |  |  | +0.0 | +1.5 | +0.7 | PASS
T8 | ★大阶次 m=16（设备上限） |  | 10 | 120.0 | 100 | 60.0 | 160 | 40.0 | 10.0 | 205.6 | 49.5 | 10.0 | 205.8 | 49.4 | 10.0khz，59.9mv | 100.0kh，30.0mv | 160.0khz，20.3mv |  |  |  | +0.0 | +0.2 | -+0.1 | PASS
T9 | 高频双边缘 |  | 250 | 120.0 | 500 | 80.0 |  |  | 250.0 | 173.7 | 51.0 | 250.0 | 173.5 | 51.0 | 250.0khz，60mv | 500.0khz，39.7mv |  |  |  |  | +0.0 | -+0.2 | +0.0 | PASS
T10 | 低频双边缘 |  | 10 | 18.0 | 20 | 22.0 |  |  | 10.0 | 35.5 | 10.1 | 10.0 | 35.3 | 10.0 | 10.0khz，9.0mv | 20.0khz，10.9mv |  |  |  |  | +0.0 | -+0.2 | -+0.1 | PASS
T11 | 干扰矩阵的载波 |  | 125 | 100.0 | 375 | 80.0 |  |  | 125.0 | 134.9 | 45.3 | 125.0 | 134.5 | 45.1 | 125.0khz，49.6mv | 375.0khz，40.0mv |  |  |  |  | +0.0 | -+0.4 | -+0.2 | PASS

Sheet: 干扰矩阵
G2026 上板测试单 ② 干扰矩阵（题面第 3 项 · 官方(3) 的干扰扫频）
载波固定（B~E 列 = 官方(3) 的前两根 → 真值 f1 125 / Vpp 134.9 / Vrms 45.3）；每行只改【干扰频率】F 列（幅度固定 200mVpp）。判定 = 三项都在判据内 且 频谱只剩载波那两根（T 列选『是』）。 【① 干扰怎么给】用发生器的**谐波合成**：基波 125kHz，同一个波形里给 1 次(100mVpp) + 3 次(80mVpp) 载波 + 第 k 次(200mVpp) 干扰，一次输出直接接装置（不用第二台源、不用加法器）。 【② k 取几 / 折到哪】折叠 = |f_J − 2MHz
 | 载波（固定 · mVpp） |  |  |  | 干扰 u_J（你改这个） |  |  | 真值（参考） |  |  | 实测（你填这个） |  |  |  |  |  |  |  |  |  | 自动判定
序号 | 载波① kHz | 载波① mVpp | 载波② kHz | 载波② mVpp | 干扰 MHz (=125k×k) | 干扰 mVpp | 期望镜像落点 （折叠 = |f_J − 2MHz|） | f1 kHz | Vpp mV | Vrms mV | f1 kHz | Vpp mV | Vrms mV | 谱线① | 谱线② | 谱线③ | 谱线④ | 谱线⑤ | 只有两根? | 备注 | Δf1 | ΔVpp | ΔVrms | 判定
J1 | 125 | 100.0 | 375 | 80.0 | 1.000 | 200.0 | 直流（Nyquist 整 → 被去均值丢掉） | 125.0 | 134.9 | 45.3 | 125.0 | 135.0 | 45.2 | 125.0khz，49.7mv | 375.0khz，40.3mv |  |  |  | 是 | 8 次谐波 = 1.000MHz@200mVpp；折到直流 ⇒ 谱线须仍只有 125k/375k 两根 | +0.0 | +0.1 | -+0.1 | PASS
J2 | 125 | 100.0 | 375 | 80.0 | 1.250 | 200.0 | 750 kHz（分析带外） | 125.0 | 134.9 | 45.3 | 125.0 | 135.0 | 45.2 | 125.0khz，49.7mv | 375.0khz，40.3mv |  |  |  | 是 | 10 次谐波 = 1.250MHz；折到 750k（带外）⇒ 谱线须仍只有两根 | +0.0 | +0.1 | -+0.1 | PASS
J3 | 125 | 100.0 | 375 | 80.0 | 1.375 | 200.0 | 625 kHz（带外，离 502k 带边最近） | 125.0 | 134.9 | 45.3 | 125.0 | 135.0 | 45.2 | 125.0khz，49.7mv | 375.0khz，40.3mv |  |  |  | 是 | 11 次谐波 = 1.375MHz；折到 625k（带外里离带边最近的一点）⇒ 同上 | +0.0 | +0.1 | -+0.1 | PASS
J4 | 125 | 100.0 | 375 | 80.0 | 1.500 | 200.0 | 500 kHz（带内！最坏点） | 125.0 | 134.9 | 45.3 | 125.0 | 134.9 | 45.2 | 125.0khz，49.7mv | 375.0khz，40.1mv |  |  |  | 是 | ★12 次谐波 = 1.500MHz；折到 500k（带内最坏点）⇒ 谱线必须仍只有两根 | +0.0 | +0.0 | -+0.1 | PASS
J5 | 125 | 100.0 | 375 | 80.0 | 1.750 | 200.0 | 250 kHz（带内！不在载波上） | 125.0 | 134.9 | 45.3 | 125.0 | 134.8 | 45.2 | 125.0khz，49.7mv | 375.0khz，40.0mv |  |  |  | 是 | 14 次谐波 = 1.750MHz；折到 250k（带内、不在载波频率上）⇒ 多出一根就是漏 | +0.0 | -+0.1 | -+0.1 | PASS
J6 | 125 | 100.0 | 375 | 80.0 | 2.000 | 200.0 | 直流（2.0MHz 也落在 Nyquist 整上） | 125.0 | 134.9 | 45.3 | 125.0 | 134.7 | 45.2 | 125.0khz，49.7mv | 375.0khz，40.0mv |  |  |  | 是 | 16 次谐波 = 2.000MHz（谐波上限）；折到直流 ⇒ 同上 | +0.0 | -+0.2 | -+0.1 | PASS
