funiang-x/G2026/docs/G2026-上板测试单-20261016-v5.xlsx

Sheet: 官方测评值+测试矩阵
G2026 上板测试单 ⓪① 官方测评值 + 测试矩阵（2026-10-16） ｜ 共 4 页：① 本页（官方三式 + T1~T11）② 干扰矩阵 J1~J6 ③ 其他检查项 13 条 ④ 别判自己错 ｜ 切页：底部表标签 / Ctrl+PageDown
幅度一律【峰峰值 mVpp】（发生器直接按 Vpp 设）；题面三式全是 sin、各分量零相位。 橙底 = 你拨信号源；黄底 = 你抄屏上的读数；绿底 = 自动算。 谱线①~⑤ 对应频域页右边那五个框，一格抄一条（例：125.0k 49.7），没检出留空。 判据：|Δf1|≤1kHz · |ΔVpp|≤5mV · |ΔVrms|≤5mV。峰峰值 / Vrms 一律 1 位小数（发生器与屏上口径一致）。 ★ = 本机从没上板验证过，优先做。 注：T4 / T5 / T11 与官方(1)(2)(3) 是同一信号，可只做一遍。
 | 场景 / 题面原式 · 档位 |  | 信号源设置（你拨这个 · mVpp） |  |  |  |  |  | 真值（参考） |  |  | 实测（你填这个） |  |  |  |  |  |  |  |  | 自动判定
序号 | 场景 / 题面原式（照抄） | 对应档位 | ① 频率 kHz | ① 幅值 mVpp | ② 频率 kHz | ② 幅值 mVpp | ③ 频率 kHz | ③ 幅值 mVpp | f1 kHz | Vpp mV | Vrms mV | f1 kHz | Vpp mV | Vrms mV | 谱线① | 谱线② | 谱线③ | 谱线④ | 谱线⑤ | 备注 | Δf1 | ΔVpp | ΔVrms | 判定
官方(1) | u_a = 50sin(2π·25k·t) + 30sin(2π·75k·t) + 30sin(2π·100k·t) | u_a 档（题面第 1 项） | 25 | 100.0 | 75 | 60.0 | 100 | 60.0 | 25.0 | 162.3 | 46.4 | 25.0 | 161.6 | 46.2 | 25.0khz，49.8mv | 75.0khz，29.9mv | 100.0khz，29.8mv |  |  | 题面第 1 项（＝ T4） | +0.00 | -+0.70 | -+0.20 | PASS
官方(2) | u_b = 30sin(2π·100k·t) + 15sin(2π·200k·t) | u_b 档（题面第 2 项） | 100 | 60.0 | 200 | 30.0 |  |  | 100.0 | 77.9 | 23.7 | 100.0 | 77.6 | 23.6 | 100khz，29.8mv | 200.0khz，15.0mv |  |  |  | 题面第 2 项（＝ T5） | +0.00 | -+0.30 | -+0.10 | PASS
官方(3) | u = u_a + u_J = [50sin(2π·125k·t) + 40sin(2π·375k·t)] + 100sin(2π·1000k·t) | 抗干扰档（题面第 3 项） | 125 | 100.0 | 375 | 80.0 | 1000 | 200.0 | 125.0 | 134.9 | 45.3 | 125.0 | 135.0 | 45.2 | 125.0khz，49.7mv | 375.0khz，40.3mv |  |  |  | 1000kHz = 125k 的 8 次谐波（带外干扰）；真值只算带内 125k/375k 两根（＝ T11） | +0.00 | +0.10 | -+0.10 | PASS
T1 | 单音·下边界(10k) |  | 10 | 50.0 |  |  |  |  | 10.0 | 50.0 | 17.7 | 10.0 | 49.6 | 17.5 | 10.0khz，24.8mv |  |  |  |  | 扫带 f_lo 侧 | +0.0 | -+0.4 | -+0.2 | PASS
T2 | ★单音·上边界(500k) | ★ 未验 | 500 | 50.0 |  |  |  |  | 500.0 | 50.0 | 17.7 | 500.0 | 49.0 | 17.3 | 500.0khz，24.5mv |  |  |  |  | bin1024，从没上板验过 | +0.0 | -+1.0 | -+0.4 | PASS
T3 | ★题面原例(非整周期) |  | 10.5 | 160.0 | 31.5 | 80.0 | 42 | 40.0 | 10.5 | 195.9 | 64.8 | 10.5 | 195.4 | 64.6 | 10.5khz，79.7mv | 31.5khz，40.0mvv | 42khz，19.9mv |  |  | 4:2:1 | +0.0 | -+0.5 | -+0.2 | PASS
T4 | u_a 档 |  | 25 | 100.0 | 75 | 60.0 | 100 | 60.0 | 25.0 | 162.3 | 46.4 | 25.0 | 161.6 | 46.2 | 25.0khz，49.8mv | 75.0khz，29.9mv | 100.0khz，29.8mv |  |  | ＝ 官方(1)，同一信号（可只做一遍） | +0.0 | -+0.7 | -+0.2 | PASS
T5 | u_b 档(m=2) |  | 100 | 60.0 | 200 | 30.0 |  |  | 100.0 | 77.9 | 23.7 | 100.0 | 77.6 | 23.6 | 100.0khz，29.8mv | 200.0khz，15.0mv |  |  |  | ＝ 官方(2)，同一信号（可只做一遍） | +0.0 | -+0.3 | -+0.1 | PASS
T6 | ★u_b 最小档 | ★ 未验 | 10 | 7.3 | 100 | 14.6 | 160 | 29.2 | 10.0 | 50.0 | 11.8 | 10.0 | 50.1 | 11.9 | 10.0khz，3.6mv | 100.0khz，7.3mv | 160.0khz，14.7mv |  |  | 复合 50.0mVpp；最小分量 7.3mVpp（=3.65mVpk），离 2.5mV 门限只 1.46 倍 | +0.0 | +0.1 | +0.1 | PASS
T7 | u_b 最大档 |  | 10 | 36.5 | 100 | 73.0 | 160 | 146.0 | 10.0 | 250.1 | 59.1 | 10.0 | 252.0 | 59.9 | 10.0khz，18.2mv | 100.0khz，36.5mv | 160.0khz，74.2mv |  |  | 复合 250mVpp 上限（题面 u_b 幅度上界） | +0.0 | +1.9 | +0.8 | PASS
T8 | ★大阶次 m=16（设备上限） | ★ 未验 | 10 | 120.0 | 100 | 60.0 | 160 | 40.0 | 10.0 | 205.6 | 49.5 | 10.0 | 205.7 | 49.4 | 10.0khz，59.7mv | 100.0kh，30.0mv | 160.0khz，20.3mv |  |  | 大阶次 m=16（本机上限）；重建按 m 自适应加密抽点 | +0.0 | +0.1 | -+0.1 | PASS
T9 | 高频双边缘 |  | 250 | 120.0 | 500 | 80.0 |  |  | 250.0 | 173.7 | 51.0 | 250.0 | 173.1 | 50.9 | 250.0khz，60mv | 500.0khz，39.7mv |  |  |  |  | +0.0 | -+0.6 | -+0.1 | PASS
T10 | 低频双边缘 |  | 10 | 18.0 | 20 | 22.0 |  |  | 10.0 | 35.5 | 10.1 | 10.0 | 35.3 | 10.0 | 10.0khz，9.0mv | 20.0khz，10.9mv |  |  |  |  | +0.0 | -+0.2 | -+0.1 | PASS
T11 | 干扰矩阵的载波 |  | 125 | 100.0 | 375 | 80.0 |  |  | 125.0 | 134.9 | 45.3 | 125.0 | 133.8 | 44.9 | 125.0khz，49.5mv | 375.0khz，39.8mv |  |  |  | ＝ 官方(3) 的载波；第 2 页（干扰矩阵）要用它 | +0.0 | -+1.1 | -+0.4 | PASS

Sheet: 干扰矩阵
G2026 上板测试单 ② 干扰矩阵（题面第 3 项 · 官方(3) 的干扰扫频）
载波固定（B~E 列 = 官方(3) 的前两根 → 真值 f1 125 / Vpp 134.9 / Vrms 45.3）；每行只改【干扰频率】F 列（幅度固定 200mVpp）。判定 = 三项都在判据内 且 频谱只剩载波那两根（T 列选『是』）。 【① 干扰怎么给】用发生器的**谐波合成**：基波 125kHz，同一个波形里给 1 次(100mVpp) + 3 次(80mVpp) 载波 + 第 k 次(200mVpp) 干扰，一次输出直接接装置（不用第二台源、不用加法器）。 【② k 取几 / 折到哪】折叠 = |f_J − 2MHz|：8 次 1.0M → 直流 · 10 次 1.25M → 750k · 11 次 1.375M → 625k（带外里离带边最近的一点）· **12 次 1.5M → 500k（带内最坏点）** · 14 次 1.75M → 250k（带内、不在载波上）· 16 次 2.0M → 直流。⚠️ 干扰频率**必须落在 125kHz 的整数倍上** —— 所以 1.2 / 1.49 MHz（=9.6 / 11.92 次）给不出来；2.5 / 3.0 MHz 是 20 / 24 次，超过 16 次上限也给不出来（若你的发生器上限更高，可换回这两点）。1.49M 那种“刚好出带”的点，谐波网格是 125kHz 一步，同样做不到。 【③ 拨对了的标志】加干扰前后，载波那两根的读数（125k 读 49.7mV、375k 读 40.3mV）与 Vpp/Vrms 真值（134.9 / 45.3）都不应变化；变了就是载波幅度被带偏了，这根的点不能算数。
 | 载波（固定 · mVpp） |  |  |  | 干扰 u_J（你改这个） |  |  | 真值（参考） |  |  | 实测（你填这个） |  |  |  |  |  |  |  |  |  | 自动判定
序号 | 载波① kHz | 载波① mVpp | 载波② kHz | 载波② mVpp | 干扰 MHz (=125k×k) | 干扰 mVpp | 期望镜像落点 （折叠 = |f_J − 2MHz|） | f1 kHz | Vpp mV | Vrms mV | f1 kHz | Vpp mV | Vrms mV | 谱线① | 谱线② | 谱线③ | 谱线④ | 谱线⑤ | 只有两根? | 备注 | Δf1 | ΔVpp | ΔVrms | 判定
J1 | 125 | 100.0 | 375 | 80.0 | 1.000 | 200.0 | 直流（Nyquist 整 → 被去均值丢掉） | 125.0 | 134.9 | 45.3 | 125.0 | 135.0 | 45.2 | 125.0khz，49.7mv | 375.0khz，40.3mv |  |  |  | 是 | 8 次谐波 = 1.000MHz@200mVpp；折到直流 ⇒ 谱线须仍只有 125k/375k 两根 | +0.0 | +0.1 | -+0.1 | PASS
J2 | 125 | 100.0 | 375 | 80.0 | 1.250 | 200.0 | 750 kHz（分析带外） | 125.0 | 134.9 | 45.3 | 125.0 | 135.0 | 45.2 | 125.0khz，49.7mv | 375.0khz，40.3mv |  |  |  | 是 | 10 次谐波 = 1.250MHz；折到 750k（带外）⇒ 谱线须仍只有两根 | +0.0 | +0.1 | -+0.1 | PASS
J3 | 125 | 100.0 | 375 | 80.0 | 1.375 | 200.0 | 625 kHz（带外，离 502k 带边最近） | 125.0 | 134.9 | 45.3 | 125.0 | 135.0 | 45.2 | 125.0khz，49.7mv | 375.0khz，40.3mv |  |  |  | 是 | 11 次谐波 = 1.375MHz；折到 625k（带外里离带边最近的一点）⇒ 同上 | +0.0 | +0.1 | -+0.1 | PASS
J4 | 125 | 100.0 | 375 | 80.0 | 1.500 | 200.0 | 500 kHz（带内！最坏点） | 125.0 | 134.9 | 45.3 | 125.0 | 134.7 | 45.1 | 125.0khz，49.6mv | 375.0khz，40.1mv |  |  |  | 是 | ★12 次谐波 = 1.500MHz；折到 500k（带内最坏点）⇒ 谱线必须仍只有两根 | +0.0 | -+0.2 | -+0.2 | PASS
J5 | 125 | 100.0 | 375 | 80.0 | 1.750 | 200.0 | 250 kHz（带内！不在载波上） | 125.0 | 134.9 | 45.3 | 125.0 | 134.5 | 45.1 | 125.0khz，49.6mv | 375.0khz，40.0mv |  |  |  | 是 | 14 次谐波 = 1.750MHz；折到 250k（带内、不在载波频率上）⇒ 多出一根就是漏 | +0.0 | -+0.4 | -+0.2 | PASS
J6 | 125 | 100.0 | 375 | 80.0 | 2.000 | 200.0 | 直流（2.0MHz 也落在 Nyquist 整上） | 125.0 | 134.9 | 45.3 | 125.0 | 134.3 | 45.0 | 125.0khz，49.5mv | 375.0khz，40.0mv |  |  |  | 是 | 16 次谐波 = 2.000MHz（谐波上限）；折到直流 ⇒ 同上 | +0.0 | -+0.6 | -+0.3 | PASS

Sheet: 其他检查项
G2026 上板测试单 ③ 题面明写项与其他检查（结果列下拉）
检查项 | 怎么判 | 结果 | 备注
上电自检 | 页 2 那 8 项全 PASS（含 DSP 链自检）
标定持久化 | 重新标定 → 断电重启 → 页 2 仍显示 CAL OK
各项 ≤2 s | 切页 / 切 1T↔3T 后读数到位 ≤2 s（现在约 0.25 s）
波形 1T | 整数个完整周期、无缺口、不滚动不抖
波形 3T | 同上（3 个完整周期）
谱线图-根数 | 亮框数 = 你拨的分量数（不多不少）
谱线图-位置 | 柱在对数轴上位置与频率对得上（10k~500k）
谱线图-长度 | 柱长比 = 幅值比（官方(2) 里 200k 应是 100k 的一半）
基频分辨率 | Δf=488Hz（≤500Hz 判据）；相邻 10kHz 分量分得开
干扰 6 点 | 第 2 页 6 行全 PASS
最小/最大档 | T6(50mVpp) / T7(250mVpp) 都在判据内
★ 三个未验项 | T2 / T6 / T8 全 PASS（第 1 页重点）
官方三式 | 第 1 页 官方(1)(2)(3) 全 PASS

Sheet: 别判自己错
G2026 上板测试单 ④ 已知边界 —— 这几条别判自己错
现象 | 说明
给某个分量人为加相位差后，Vpp/波形偏 | 题面信号定义就是各分量零相位（u = Σ A_k·sin(2π f_k t)）；本机形状与 Upp 按零相位口径算（2026-10-16 定），这是刻意取舍，不是 bug。
重标定后 Vpp 不再变化 | 相位标定在本装置上先天不可靠（采集自由运行，帧起点与源无关）；现在标定只影响幅值。
官方(3) 的 1MHz 不出现在频谱里 | 它只许折叠到直流（Nyquist 整）或带外；带内 500kHz 若有残留，必须 < 2.5mV 门限。
THD 不上屏 | 题面不要求（值仍在结果体里，可随时接出来显示）。
屏 3.5 英寸（题面写 ≥6 英寸） | 已拍板接受该条款。
30pin 排距 / 触摸 I2C / 背光恒流 | 硬件遗留项，与本题判据无关（见 docs/INDEX 的 hardware/58~62）。
只支持 1T / 3T 两档波形 | 题面要求就是 1 或 3 个完整周期。
