funiang-x/G2026/tools/hardware/enclosure/out/case_bottom.step

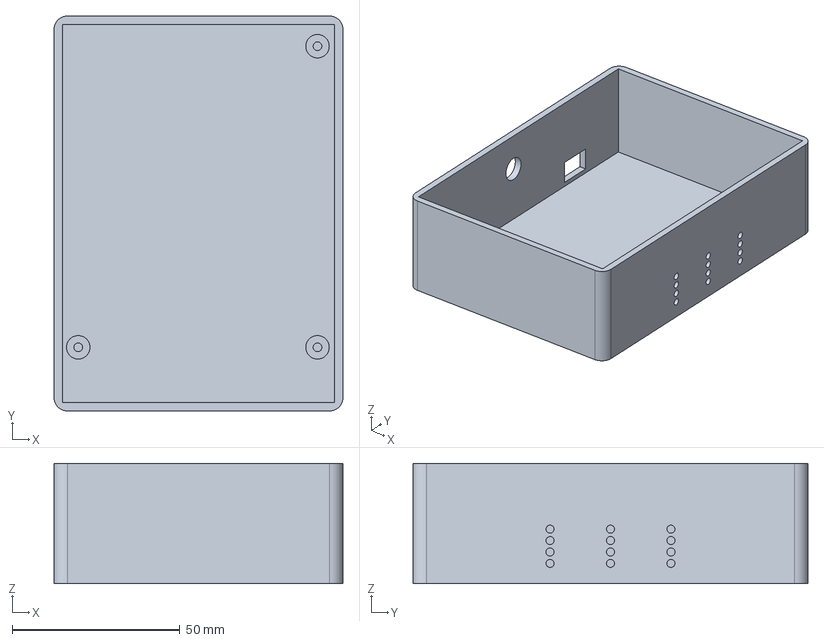
[picture p46: CAD file, 2026-10-14]
tools/hardware/enclosure/out/case_bottom.step
86.0 x 117.6 x 35.8 mm
