funiang-x/G2026/tools/hardware/enclosure/out/case_top.step

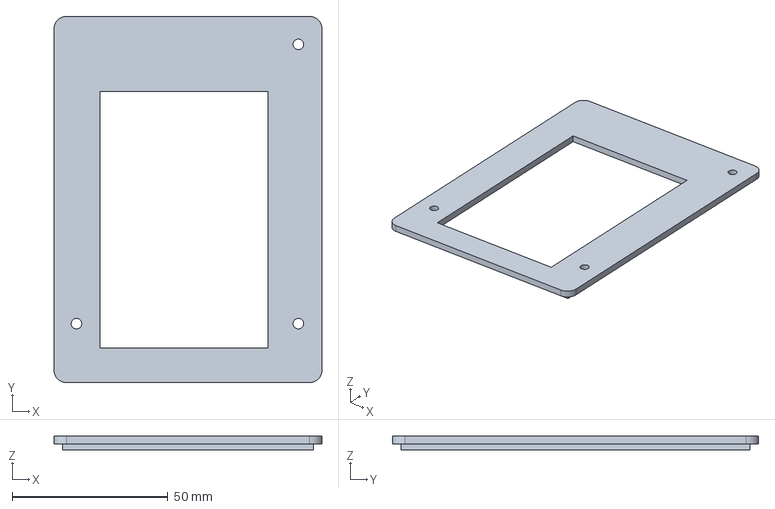
[picture p47: CAD file, 2026-10-14]
tools/hardware/enclosure/out/case_top.step
86.0 x 117.6 x 4.50 mm
