funiang-x/G2026/(list of files, cad)

Other CAD files:
tools/hardware/enclosure/out/case_bottom.stl
tools/hardware/enclosure/out/case_top.stl
