funiang-x/G2026/firmware/docs/guides/README.md

# docs/guides/ — 教程

> **知道了会省事**的东西放这里：上手流程、工具用法、某个外设怎么接。
>
> 与 `docs/0x_*.md`（**规则**：违反了会出事）区分开。判据见 `docs/README.md` §三类文档不要混。

## 预算

**≤ 5 篇**（另计，不算进"规范文档 ≤ 14 篇"）。

## 现状（0 个文件）

原先的三份 **已删除**，内容并入 `Core/Inc/board_config.h`：

| 已删除 | 原先管什么 | 现在在哪 |
|---|---|---|
| `01_板载外设与引脚对照.md` | 板子上有什么、接在哪个脚、与 `.ioc` 的差异 | `board_config.h` 一个外设一节 |
| `cubemx_config_map.svg` | CubeMX 配置总图（时钟树 + 外设 + 引脚占用） | `board_config.h` 的注释 + `.ioc` 本身 |
| `cubemx_clock_config.svg` | Clock Configuration 页逐项控件对照 | `board_config.h` 的 RTC 一节（那三个 Mux 的坑） |

⚠️ 两张 SVG 当初是**按本工程实际值画的**（读 `.ioc` 得出），不是通用模板 ——
`.ioc` 一改就过期，这也是删它们的原因之一。

⚠️ **别再重建这三份**：`board_config.h` 是板级事实的唯一来源（`docs/01` 的"单点真相"），
留第二份迟早漂移。

## 还没写的

**《从零到板子上跑起来》**：`fw.py env` → `build` → `flash` → `rtt` → `verify`
五条命令各自会看到什么、失败时先查什么。

写之前先看 `docs/11`（五条链的操作手册）—— 探针排查、RTT 丢数据那类内容
**已经在那里了，不要复制一份到这儿**（复制出来的第二份迟早过期）。
