funiang-x/G2026/tools/report_dsp_verify.md

# G2026 DSP 方案数值复算报告
- N=4096 · BH4 窗 · 相干增益 CG=0.358750
- ADCCLK=36MHz · 增益×1.95 · 输入端 LSB=0.4132 mV
- 判据：幅值/Upp/Urms ≤5.0 mV，基频 ≤1000 Hz

## ① 参数自检
- BH4 主瓣（−6dB）半宽约 2.2 bin；峰间最小间隔 = 10kHz/488Hz ≈ 20 bin，互不侵占
- 单音理想链路自检：
  - f=    25.0 kHz A= 100.0 mV → 读数  99.9734 mV（Δ-0.0266）· Δf=+0.00 Hz
  - f=    10.5 kHz A= 100.0 mV → 读数 100.0040 mV（Δ+0.0040）· Δf=+0.01 Hz
  - f=    42.0 kHz A=  50.0 mV → 读数  50.0100 mV（Δ+0.0100）· Δf=-0.00 Hz
  - f=   317.0 kHz A= 125.0 mV → 读数 125.0009 mV（Δ+0.0009）· Δf=+0.00 Hz
  - f=   499.0 kHz A= 125.0 mV → 读数 125.0009 mV（Δ+0.0009）· Δf=-0.00 Hz

## ② 采样率穷举（fs = 144MHz/K，N=4096，约束 Δf≤500Hz）

| K | fs(MHz) | Δf(Hz) | 折叠带起点(MHz) | 8阶BW fc=800k@折叠带(dB) | 混叠残留(mV,u_J=100mV峰) | ADC占空(15cyc/36MHz) |
|---|---|---|---|---|---|---|
| 71 | 2.0282 | 495.2 | 1.528 | 45.0 | 0.564 | 85% |
| 72 | 2.0000 | 488.3 | 1.500 | 43.7 | 0.655 | 83% ★ |
| 73 | 1.9726 | 481.6 | 1.473 | 42.4 | 0.759 | 82% |
| 74 | 1.9459 | 475.1 | 1.446 | 41.1 | 0.878 | 81% |
| 75 | 1.9200 | 468.8 | 1.420 | 39.9 | 1.015 | 80% |
| 76 | 1.8947 | 462.6 | 1.395 | 38.6 | 1.172 | 79% |
| 77 | 1.8701 | 456.6 | 1.370 | 37.4 | 1.351 | 78% |
| 78 | 1.8462 | 450.7 | 1.346 | 36.2 | 1.556 | 77% |
| 79 | 1.8228 | 445.0 | 1.323 | 34.9 | 1.790 | 76% |
| 80 | 1.8000 | 439.5 | 1.300 | 33.7 | 2.056 | 75% |
| 81 | 1.7778 | 434.0 | 1.278 | 32.5 | 2.360 | 74% |
| 82 | 1.7561 | 428.7 | 1.256 | 31.4 | 2.706 | 73% |
| 83 | 1.7349 | 423.6 | 1.235 | 30.2 | 3.100 | 72% |
| 84 | 1.7143 | 418.5 | 1.214 | 29.0 | 3.547 | 71% |
| 85 | 1.6941 | 413.6 | 1.194 | 27.8 | 4.055 | 71% |
| 86 | 1.6744 | 408.8 | 1.174 | 26.7 | 4.631 | 70% |
| 87 | 1.6552 | 404.1 | 1.155 | 25.5 | 5.284 | 69% |
| 88 | 1.6364 | 399.5 | 1.136 | 24.4 | 6.023 | 68% |
| 89 | 1.6180 | 395.0 | 1.118 | 23.3 | 6.859 | 67% |
| 90 | 1.6000 | 390.6 | 1.100 | 22.2 | 7.803 | 67% |
| 91 | 1.5824 | 386.3 | 1.082 | 21.0 | 8.868 | 66% |
| 92 | 1.5652 | 382.1 | 1.065 | 19.9 | 10.069 | 65% |
| 93 | 1.5484 | 378.0 | 1.048 | 18.8 | 11.421 | 65% |
| 94 | 1.5319 | 374.0 | 1.032 | 17.8 | 12.939 | 64% |
| 95 | 1.5158 | 370.1 | 1.016 | 16.7 | 14.641 | 63% |
| 96 | 1.5000 | 366.2 | 1.000 | 15.6 | 16.546 | 62% |
| 97 | 1.4845 | 362.4 | 0.985 | 14.6 | 18.671 | 62% |
| 98 | 1.4694 | 358.7 | 0.969 | 13.5 | 21.034 | 61% |
| 99 | 1.4545 | 355.1 | 0.955 | 12.5 | 23.651 | 61% |
| 100 | 1.4400 | 351.6 | 0.940 | 11.5 | 26.536 | 60% |

**结论：K=72 → fs=2.0MHz，Δf=488.28Hz ✓，折叠带起点 1.5MHz，混叠残留 0.65mV。**

## ③ 抗混叠低通对比（分析带 10k~500k，折叠带起点 fs−500k=1.5MHz）

| 方案 | 通带@500k(mV/100mV分量) | @1.5MHz 衰减(dB) | 混叠残留(mV) | Qmax |
|---|---|---|---|---|
| 8阶 BW fc=700k | 0.229 | 53.0 | 0.225 | 2.56 |
| 8阶 BW fc=750k | 0.076 | 48.2 | 0.391 | 2.56 |
| 8阶 BW fc=800k | 0.027 | 43.7 | 0.655 | 2.56 |
| 8阶 BW fc=850k | 0.010 | 39.5 | 1.063 | 2.56 |
| 12阶 BW fc=550k | 4.720 | 104.6 | 0.001 | 3.83 |
| 12阶 BW fc=600k | 0.623 | 95.5 | 0.002 | 3.83 |

- 孔径损失（SMP=3 ADCCLK, ts=83.3ns）@500k：0.285% = 0.285 mV/100mV 分量
- 8阶BW fc=800k 相位：∠H(100k)=-0.642 rad, ∠H(500k)=2.902 rad（标定消）
**结论：8 阶 BW fc=800k：通带起伏 0.03mV、Qmax=2.56、混叠残留 0.65mV，全达标。**

## ④ 端到端误差仿真（定稿：fs=2.0MHz · N=4096 · BH4 · 8阶BW fc=800k · 净×1.95增益 · 12bit量化 · 标定）

- 标定残差自检（41 个非表点、100mV 纯音）：最坏 0.0562 mV

### 场景表
- **S1 题面示例 f1=10.5k m=(1,3,4)**：|ΔA|max=0.007 mV · ΔUpp=-0.024 mV · ΔUrms=-0.007 mV · Δf1=+0.0 Hz · 多检谱线 0
  - 检出 3 线：10.5kHz/59.99mV, 31.5kHz/29.99mV, 42.0kHz/20.00mV（真值 3 线：10.5kHz/60.0mV, 31.5kHz/30.0mV, 42.0kHz/20.0mV）
- **S2 最小信号 f1=10k m=(1,2,3) Upp≈50mV**：|ΔA|max=0.017 mV · ΔUpp=-0.020 mV · ΔUrms=-0.003 mV · Δf1=-0.0 Hz · 多检谱线 0
  - 检出 3 线：10.0kHz/9.02mV, 20.0kHz/10.98mV, 30.0kHz/11.00mV（真值 3 线：10.0kHz/9.0mV, 20.0kHz/11.0mV, 30.0kHz/11.0mV）
- **S3 高频边缘 f1=250k m=(1,2)**：|ΔA|max=0.024 mV · ΔUpp=-0.008 mV · ΔUrms=-0.007 mV · Δf1=+0.0 Hz · 多检谱线 0
  - 检出 2 线：250.0kHz/59.98mV, 500.0kHz/40.02mV（真值 2 线：250.0kHz/60.0mV, 500.0kHz/40.0mV）
- **S4 全带组合 f1=10k m=(1,4,8)**：|ΔA|max=0.010 mV · ΔUpp=-0.040 mV · ΔUrms=-0.009 mV · Δf1=-0.0 Hz · 多检谱线 0
  - 检出 3 线：10.0kHz/49.99mV, 40.0kHz/24.99mV, 80.0kHz/25.00mV（真值 3 线：10.0kHz/50.0mV, 40.0kHz/25.0mV, 80.0kHz/25.0mV）
- **S5 干扰 u_J=1.0MHz(Nyquist整)**：|ΔA|max=0.009 mV · ΔUpp=+0.029 mV · ΔUrms=+0.004 mV · Δf1=-0.0 Hz · 多检谱线 0
  - 检出 3 线：10.5kHz/60.00mV, 31.5kHz/30.01mV, 42.0kHz/20.01mV（真值 3 线：10.5kHz/60.0mV, 31.5kHz/30.0mV, 42.0kHz/20.0mV）
- **S6 干扰 u_J=1.2MHz**：|ΔA|max=0.008 mV · ΔUpp=+0.011 mV · ΔUrms=+0.002 mV · Δf1=-0.0 Hz · 多检谱线 0
  - 检出 3 线：10.5kHz/60.00mV, 31.5kHz/30.00mV, 42.0kHz/20.01mV（真值 3 线：10.5kHz/60.0mV, 31.5kHz/30.0mV, 42.0kHz/20.0mV）
- **S7 干扰 u_J=1.49MHz(镜像带外边缘)**：|ΔA|max=0.003 mV · ΔUpp=-0.003 mV · ΔUrms=+0.000 mV · Δf1=-0.0 Hz · 多检谱线 0
  - 检出 3 线：10.5kHz/60.00mV, 31.5kHz/30.00mV, 42.0kHz/20.00mV（真值 3 线：10.5kHz/60.0mV, 31.5kHz/30.0mV, 42.0kHz/20.0mV）
- **S8 干扰 u_J=1.5MHz(折叠带起点·最坏)**：|ΔA|max=0.012 mV · ΔUpp=+0.030 mV · ΔUrms=+0.005 mV · Δf1=-0.0 Hz · 多检谱线 0
  - 检出 3 线：10.5kHz/60.00mV, 31.5kHz/30.00mV, 42.0kHz/20.01mV（真值 3 线：10.5kHz/60.0mV, 31.5kHz/30.0mV, 42.0kHz/20.0mV）
- **S9 干扰 u_J=1.5MHz + 真有500k分量**：|ΔA|max=0.541 mV · ΔUpp=-0.762 mV · ΔUrms=-0.104 mV · Δf1=+0.0 Hz · 多检谱线 0
- **S10 干扰 u_J=2.5MHz(二次折叠)**：|ΔA|max=0.007 mV · ΔUpp=-0.021 mV · ΔUrms=-0.006 mV · Δf1=-0.0 Hz · 多检谱线 0
  - 检出 3 线：10.5kHz/59.99mV, 31.5kHz/29.99mV, 42.0kHz/20.00mV（真值 3 线：10.5kHz/60.0mV, 31.5kHz/30.0mV, 42.0kHz/20.0mV）
- **S11 干扰 u_J=3.0MHz(镜像1MHz带外)**：|ΔA|max=0.007 mV · ΔUpp=-0.022 mV · ΔUrms=-0.007 mV · Δf1=+0.0 Hz · 多检谱线 0
  - 检出 3 线：10.5kHz/59.99mV, 31.5kHz/29.99mV, 42.0kHz/20.00mV（真值 3 线：10.5kHz/60.0mV, 31.5kHz/30.0mV, 42.0kHz/20.0mV）
- **S12 干扰 u_J=5.0MHz**：|ΔA|max=0.007 mV · ΔUpp=-0.024 mV · ΔUrms=-0.007 mV · Δf1=+0.0 Hz · 多检谱线 0
  - 检出 3 线：10.5kHz/59.99mV, 31.5kHz/29.99mV, 42.0kHz/20.00mV（真值 3 线：10.5kHz/60.0mV, 31.5kHz/30.0mV, 42.0kHz/20.0mV）

### 无标定对照（S1 与 S3）
- 无标定 S1: ΔA = -0.01, -0.01, -0.00 mV
- 无标定 S3: ΔA = -0.02, -0.02 mV

### f1 全带最坏扫描（非对齐最坏；f1≤125k 用 m=(1,3,4)，f1>125k 用 m=(1,2)，保证全部谐波 ≤500k）
- 最坏：|ΔA|=0.031 mV · |ΔUpp|=0.064 mV · |ΔUrms|=0.015 mV · |Δf1|=0.1 Hz

### Upp 口径对照（S1 真值 vs 2ΣA vs cos 约定）
- 真值（sin 零相位重建）：154.89 mV
- 2ΣA 口径：220.00 mV（差 +65.11）
- cos 口径重建：180.00 mV（差 +25.11）——禁用

## 总结论
1. fs=2.0MHz（TIM 144MHz/72）· N=4096 · BH4 · 单点DFT精化读数 —— 全部场景幅值误差 <1mV，判据 5mV 余量 ≥5×
2. 抗混叠：8 阶 BW fc=800k（Qmax=2.56），折叠带 1.5MHz 处 −44dB → 残留 0.65mV，是最大不可标定项
3. 17 点对数标定消掉通带起伏+孔径+增益，残差 <0.1mV 量级
4. Upp 必须 sin 口径重建（S1 实测：2ΣA 偏 +65mV、cos 口径偏 +25mV，均击穿判据）
5. Urms 用 √(ΣA²/2) 交流口径；u_J≥1.0MHz 的直通镜像 ≥0.5MHz 全在分析带外，唯一进带路径 1.5MHz 折叠已压到 0.65mV
