funiang-x/G2026/hardware/verify_afe_v2_report.md

# G2026 前端 v2 数值复算报告（LC 无源 + OPA2197）

- 生成：2026-09-28 · 脚本 verify_afe_v2.py · numpy 2.5.1
- 链路：BNC→TVS→LC8(BW fc=800k, 50Ω)→50Ω负载→AC耦合(100nF/10k)→×4(OPA2197)→100Ω/470pF→ADC1
- fs=2.0MHz / N=4096 / BH4 不变（与软件文档一致）

## 1. 8 阶巴特沃斯 fc=800kHz 精确衰减（|H|=1/√(1+(f/fc)^16)）

| 频率 | 用途 | |H| | dB |
|---|---|---|---|
| 0.010 MHz | 带内底 | 1 | 0.0 |
| 0.100 MHz | 带内 | 1 | -0.0 |
| 0.200 MHz | 带内(u_a上限) | 1 | -0.0 |
| 0.500 MHz | 带内顶 | 0.9997 | -0.0 |
| 0.800 MHz | -3dB点 | 0.7071 | -3.0 |
| 1.000 MHz | Nyquist/u_J合法域底 | 0.1655 | -15.6 |
| 1.500 MHz | 折叠带起点 | 0.006546 | -43.7 |
| 2.500 MHz | 二次折叠 | 0.00011 | -79.2 |
| 3.500 MHz | 三次折叠 | 7.45e-06 | -102.6 |

## 2. LC 元件值（fc=800k、Rs=RL=50Ω；串 L 起头，L/C 交替）

g 序列（闭式）：[0.3902, 1.1111, 1.6629, 1.9616, 1.9616, 1.6629, 1.1111, 0.3902]

| 节 | 类型 | 理想值 | 最近 E24 | 偏差 |
|---|---|---|---|---|
| 1 | 串联 L1 | 3.88 µH | 3.9 µH | +0.5% |
| 2 | 并联 C1 | 4.421 nF | 4.30 nF | -2.7% |
| 3 | 串联 L2 | 16.54 µH | 16.0 µH | -3.3% |
| 4 | 并联 C2 | 7.805 nF | 7.50 nF | -3.9% |
| 5 | 串联 L3 | 19.51 µH | 20.0 µH | +2.5% |
| 6 | 并联 C3 | 6.617 nF | 6.80 nF | +2.8% |
| 7 | 串联 L4 | 11.05 µH | 11.0 µH | -0.5% |
| 8 | 并联 C4 | 1.552 nF | 1.60 nF | +3.1% |

电感规格要求：绕线型 SMD（CD54/CD75 或 SWPA 类），SRF ≥ 12 MHz，DCR ≤ 0.5 Ω，Isat ≥ 50 mA（实际信号电流 ≈ 4.5 mA pk）。
全部为 0805/1206 + 通孔 BNC，手焊 ✓。电容全部 C0G/NP0。

## 3. u_J 折叠残留 @ADC（链路总增益 = DIV×|H(f_J)|×GAIN，理想 LC）

u_J 源端 200mVpp = 100 mVpk → 端接后 50 mVpk → ×|H| → ×4。

| f_J | 折叠落点 | 落点在分析带? | ADC 处残留 pk | 超过 1.5mV 峰门限? |
|---|---|---|---|---|
| 1.00 MHz | 1.000 MHz | 否 | 33.092 mV | 否 |
| 1.01 MHz | 0.990 MHz | 否 | 30.622 mV | 否 |
| 1.25 MHz | 0.750 MHz | 否 | 5.627 mV | 否 |
| 1.49 MHz | 0.510 MHz | 否 | 1.381 mV | 否 |
| 1.50 MHz | 0.500 MHz | 是 | 1.309 mV | 否 |
| 1.51 MHz | 0.490 MHz | 是 | 1.241 mV | 否 |
| 1.75 MHz | 0.250 MHz | 是 | 0.381 mV | 否 |
| 2.00 MHz | 0.000 MHz | 否 | 0.131 mV | 否 |
| 2.25 MHz | 0.250 MHz | 是 | 0.051 mV | 否 |
| 2.49 MHz | 0.490 MHz | 是 | 0.023 mV | 否 |

**全带扫描（10kHz 步进，f_J∈[1.0,2.5]MHz，落点在带内者）最坏残留 = 1.309 mV pk**

结论：最坏点 f_J=1.5MHz 恰折叠 → 1.309 mV < 1.5 mV 峰检测门限（独立伪峰会被门限拦下）；
若恰落在真分量上，幅值误差 ≤ 1.309 mV < 5 mV 判据 ✓。
f_J∈[1.0,1.5)MHz 的镜像落 [0.5,1.0)MHz 带外（软件文档 §6 层②机制不变）；f_J=1.0M 整落 Nyquist bin 随 mag[0] 丢弃。

## 4. 文档数字对照（发现的问题）

- 软件文档 §6 写「@1.5MHz −43.7dB → 残留 0.655mV」。精确值 −43.7 dB ✓（衰减本身对）。
- 但按其 §3 链路（端接×0.5 → ×4 → 滤波）推残留 = 100mVpk×0.5×4×0.006546 = **1.309 mV pk**，
  与 0.655mV 差 **2 倍**——文档该行少算了端接分压与增益的其中一项（LTI 链上增益与滤波可交换，顺序不影响结果）。
- 修正后预算：混叠残留 1.31 mV（原 0.655）→ RSS ≈ 1.31 mV，对 5mV 判据余量 ≈ 3.8×（原称 7.5×）。仍达标，但 §6/§10 两行数字须回改；
  **改动任何参数 → 按文档 §14 要求重跑 tools/verify_dsp.py 后回填**（本报告只裁定解析界，统计最坏以重跑为准）。

## 5. 通带（标称口径 vs 标定后）

增益级闭环带宽（×4，一阶近似）= GBW/4 = 2.5 MHz；与 LC 级联的通带响应：

| 频率 | LC |H| dB | 增益级 dB | 级联偏差/100mV 分量 |
|---|---|---|---|
| 10 kHz | +0.000 | -0.000 | -0.00 mV |
| 50 kHz | +0.000 | -0.002 | -0.02 mV |
| 100 kHz | -0.000 | -0.007 | -0.08 mV |
| 200 kHz | -0.000 | -0.028 | -0.32 mV |
| 315 kHz | -0.000 | -0.068 | -0.78 mV |
| 500 kHz | -0.002 | -0.170 | -1.97 mV |

- AC 耦合角（100nF/10k）= 159 Hz，10 kHz 处 droop ≈ -0.0011 dB → 可忽略；
- 全部 LTI → 17 点标定表吸收后残差 ~0.023mV（软件文档 §10/§11 机制不变）。**OPA2197 方案下标定为必做项**（10MHz 增益级的 -0.17dB@500k 靠标定消）。

## 6. OPA2197 压摆率/摆幅/噪声核算

- 滤波在前：运放只见 ≤62 mVpk 带内信号（u_J 残留 0.33 mVpk@输入），输出 ≤250 mVpk @≤500kHz；
- 需求 SR = 2π×500k×250mV = 0.79 V/µs ≪ 20 V/µs ✓（对照：若增益在前，u_J=200mVpk@1.5M 需 1.9 V/µs，也 < 20，但 IM3 风险高——仍选滤波在前）
- 输出摆幅：1.65V ± 250 mV = 1.40~1.90 V，RRIO 5V 供电 ✓（对 1.65V 半量程余量 1.40 V）
- 噪声：运放 ~2.9nV/√Hz×4×√(500k×π/2) ≈ 10.3 µV rms；50Ω 源热噪 ~0.4 µV rms —— 距 5mV 判据均 >50× ✓
- 半程 B 半管 = 1.65V 基准缓冲（VREF3033÷2 分压），兼作上电自检已知电平（软件文档 §9 自检要求）✓

## 7. 有源方案 vs LC 方案（本阶段定案依据）

| 项 | 原案：有源 8 阶（SK/MFB） | **v2：无源 LC 8 阶 + OPA2197** |
|---|---|---|
| 运放 GBW 门槛 | SK 规则 ≥100×f0×Qmax ≈ 205MHz（TLV3544 贴线） | 无要求（滤波器无源，OPA2197 10MHz 只做 ×4） |
| Q=2.56 稳定性风险（R1） | 存在，依赖扫频验证 | **消失**（双端接 LC 梯形天生低灵敏度） |
| 器件成本 | TLV3544+TLV3542 ≈ ¥30+ | OPA2197×1（手头已有）+ L/C ≈ ¥5 |
| 手焊 | SOIC-14/8 ✓ | 0805/1206 + SOIC-8 ✓ |
| DSP 侧影响 | — | 理想传递函数与原案完全相同（BW8 fc=800k），§4 采样/§5 口径全部不动；仅 §6/§10 残留行按本报告 §4 修正 |

**结论：v2 为给定约束下的最优解** —— 用手头器件、消掉最大风险项（R1）、保住 DSP 复算结论、BOM 省 ¥30+。
