funiang-x/G2026/hardware/_view/verify_shot.png

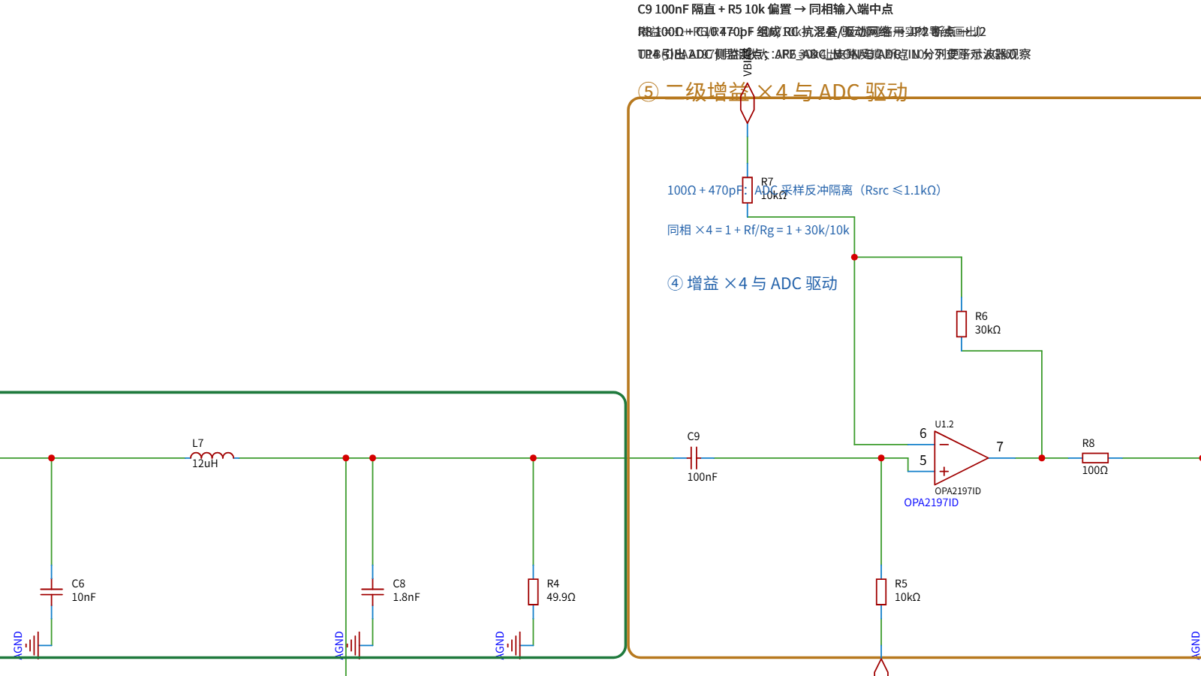
hardware/_view/verify_shot.png
