funiang-x/G2026/firmware/docs/11_构建烧录调试.md

# 11 — 构建 · 烧录 · 调试

> 状态：**已定稿**（2026-09-21）· 五条链的操作手册，日常只用 `python Tools/fw.py` 一个入口。

## 0. 五条链一览

```
源码 ─[1 GCC]→ .o ─[2 Ninja/CMake]→ .elf/.bin/.hex ─┬─[3 J-Link SWD]→ 烧进 Flash
                                                     ├─[4 RTT]───────→ 读日志 / 取证
                                                     └─[5 GDB]───────→ 断点 / 单步
```

| # | 链 | 工具 | 本机路径/版本 |
|---|---|---|---|
| 1 | 编译 | `arm-none-eabi-gcc` | 15.2.1（在 PATH 上） |
| 2 | 构建 | CMake 4.3.1 + Ninja 1.13.2 | 预设见 `CMakePresets.json` |
| 3 | 烧录 | J-Link SWD 4MHz，器件 `STM32F407VG` | `C:/Program Files/SEGGER/JLink_V936/` |
| 4 | 日志 | SEGGER RTT，通道 0 | 源码 vendor 在 `Middlewares/RTT/` |
| 5 | 调试 | `JLinkGDBServerCL` + `arm-none-eabi-gdb` | 同上 |

---

## 1. 编译 + 构建

**唯一入口**：

```bash
python Tools/fw.py build                     # Debug 预设，增量
python Tools/fw.py build --clean-first       # ★ 判"零告警"只能用它
python Tools/fw.py build --preset Release    # 换预设
```

`--preset` 写在子命令前或后都可以（`fw.py --preset Release build` ≡ `fw.py build --preset Release`）。

**预设**（`CMakePresets.json`）：

| 预设 | 优化 | 用途 |
|---|---|---|
| `Debug` | `-Og -g3` | 日常开发、单步调试 |
| `Release` | `-Os -g0` | 发布；**体积最小** |
| `RelWithDebInfo` | `-O2 -g3` | 现场取证 / profiling |

⚠️ **日志后端只有 RTT 一条**（2026-10-06 起）—— 原来的 `Debug-UART` 预设已删除，
理由见 §3。

⚠️ **Release 用 `-Os`，不要改回 `-O3`**：实测 `-O3` 会让 SEGGER RTT / HAL 这类按
`-O2/-Os` 写的第三方代码激进内联，同一份代码反而**多 7.3 KB**（全在第三方符号上）。

### 零告警口径（硬门禁）

```bash
python Tools/fw.py build --clean-first
```

**判据**：`warning` + `error` 总数为 0，且**没有新增 `-Wno-*`**。

⚠️ **"零告警"只在 `--clean-first` 之后才有资格说**：增量构建只重编改动过的文件，
只在别处触发的告警会被漏报 —— 实测过：一次注释改动让 3 个预设报 `-Wcomment`，
另 2 个因未重编而"看起来干净"。（顺带记住这个坑：注释体内出现 `/*`，
例如写路径 `Core/Src/*.c`，就会触发 `-Wcomment`。）

### 工程代码的告警档位

| 目标 | 告警 |
|---|---|
| `common` / `operation` / `device` / `task` | **全套**（`proj_warnings`：`-Wall -Wextra -Wshadow -Wundef -Wstrict-prototypes -Wdouble-promotion -Wmissing-prototypes -Wpointer-arith -Wcast-align`） |
| 可执行目标自己的源码（`Core/Src` 全部 = 生成物）、`SEGGER_RTT`、ST HAL、FreeRTOS | 只 `-Wall` |

**生成物为什么只给 `-Wall`**：ST 的代码风格在 `-Wextra` 下必然有告警，而 CubeMX
每次重新生成会反复报同样的 —— 压不住的告警等于没有告警。实测：`syscalls.c` 与
`sysmem.c` 在严格档下报 **19 条**（newlib 桩函数天生没有原型），且每次生成都原样回来。

⚠️ **`proj_warnings` 必须用 `PRIVATE` 挂在四个层上** —— 写成 `PUBLIC` 会顺着
`device`/`task` 传到可执行目标，把严格告警灌到生成物上（实测：那 19 条就是这么来的）。

⚠️ `Core/` 里只有 `main.c` / `freertos.c` 的 `USER CODE` 段是人写的，它们只拿
`-Wall` —— **刻意如此**：那里只该写胶水（一个 `#include` + 一次调用），
写了几十行逻辑就已经越层了。

---

## 2. 烧录（J-Link SWD）

```bash
python Tools/fw.py flash                     # 烧 Debug
python Tools/fw.py flash --preset Release
python Tools/fw.py flash --erase             # 先全片擦除再烧（⚠️ 见 docs/12，AI 不碰）
```

底层是 `JLink.exe -CommanderScript`，脚本按 `build/<preset>/board.env` 的
`JLINK_DEVICE` 生成。那份 `board.env` 是 CMake 的生成物，器件名与内存容量来自
`Core/Inc/board_config.h` ⇒ **换板子只改 `board_config.h`**，脚本与体积门禁跟着变。

⚠️ **烧录是不可逆操作**（会覆盖目标 Flash 上现有固件）。`docs/12` 把它归到
「必须先说再做」档 —— AI 动手前要说明"烧哪个预设、连的是哪个探针"。
脚本用 `loadbin` + `verifybin`（**不用 `loadfile`**：后者内容一致就**跳过下载**，
探针不稳时这个比较会误判 ⇒ 根本没烧却不报错，实测中过一次）。

### 探针连不上时的排查顺序

**★ 先分清「探针层」还是「目标层」**：报 `Cannot connect to the probe/programmer`
⇒ **探针**自己的 USB 没通（与目标板无关）；报 `Failed to initialize DAP`
⇒ 探针通了，但 **SWD 两根线**连不到芯片。

1. **`Get-PnpDevice -PresentOnly | ? InstanceId -match VID_1366`** 是**权威判据**。
   ⚠️ `fw.py env` 读的是 `ShowEmuList`，**可能是缓存** —— 实测遇到过
   "`env` 说在线、PnP 说没有、实连卡死"三者不一致。
2. 探针层：换 USB 口（直插机箱后面板）/ 换数据线 / 拔插。克隆探针常见（`S/N: -1`）。
3. 目标层：`VTref` 读到 3.3V ⇒ 3V3/GND 已通，问题只剩 SWDIO/SWCLK（**最易接反**）。
   本板调试口是 **H1**，引脚定义见 `guides/01`。`--erase` **不是第一选择**。
4. ⚠️ **`flash` 报 `Contents already match / Skipped` 不要当成功**：探针不稳时
   它的"读回比较"会**误判**，于是**根本没烧**却不报错（实测踩过）。

---

## 3. 日志（SEGGER RTT）

```bash
python Tools/fw.py rtt                       # 前台抓，Ctrl+C 停
python Tools/fw.py rtt --duration 5          # 抓 5 秒
```

底层 `JLinkRTTLogger.exe`，**通道 0**。源码在 `Middlewares/RTT/`，无需外部依赖。
**为什么用 RTT 而不是串口**：不占串口、不打断实时性（RTT 是内存环形缓冲，目标侧
只做 memcpy）、不需要额外接线 —— 调试探针插着就能看日志。

### ⚠️ RTT 丢数据（最容易误判的一类"故障"）

**上行缓冲默认只有 1024 B**，模式 `NO_BLOCK_SKIP` —— **满则直接丢**，不阻塞不报错。
`verify` 是"先复位放行、再挂 RTT 主机"⇒ **开机瞬间的批量输出会整段丢掉**（实测
153 个值只收到 18 个，日志在 1024 B 处直接跳到结束标记，看着像"算错了"）。
两条对策缺一不可：① 批量输出**分块让路**；② **等主机挂上再发**
（见 `project_config.h` 的 `APP_TRACE_START_MS`）。

⚠️ 丢数据是**静默**的 —— 消费端必须做完整性断言（收到的条数与期望比对）。

### 日志接口

```c
#include "log.h"
LOG_I("uart ready, baud=%u", baud);
```

⚠️ 不要直接 `printf`，也不要直接调 `SEGGER_RTT_Write`（通道规划在 `Device/Inc/rtt_channels.h`）。
⚠️ **不要用 `%f`** —— 见 `09` §7。

### UART 日志后端 —— **已于 2026-10-06 整条移除**

板子的 `.ioc` 里不再配任何 USART ⇒ 板子没有串口出口，所以串口日志这条链一并拆掉：

- `CMakePresets.json` 的 `Debug-UART` 预设删除（`Tools/fw.py` 的预设清单同步）；
- `Device/Src/bsp_log.c` 的串口后端整段移除，日志**只有 RTT 一条**；
- `Core/Inc/board_config.h` 里原日志串口那一组宏、`Tools/cubemx_sync.py` 的两条
  引脚对账项一并删除。

**要恢复串口日志**（这是一次真正的功能回退，先想清楚为什么）：

1. 在 CubeMX 里配一个 USART（例如 USART1 = PA9/PA10，AF7）并重新生成；
2. 加回 `board_config.h` 那组引脚宏 + `Tools/cubemx_sync.py` 的两条对账项；
3. 恢复 `bsp_log.c` 的 UART 分支与 `Debug-UART` 预设。

⚠️ 第 3 步**不要**自己定义 MSP 回调 —— 与 CubeMX 生成的那份会
`multiple definition` 链接失败（当时实测踩过：生成物与手写各一份）。

---

## 4. 调试（GDB）

```bash
python Tools/fw.py gdb                       # 启动 GDB server + gdb（交互）
python Tools/fw.py gdb --server-only         # 只起 server，自己接别的前端
```

底层：`JLinkGDBServerCL.exe -device STM32F407VG -if SWD -speed 4000 -port 2331`
+ `arm-none-eabi-gdb build/Debug/<name>.elf`。

VS Code 里用 `launch.json` 的 Cortex-Debug 配置，等价于上面这条命令（见 `.vscode/launch.json`）。

### 崩溃现场怎么取证

`Device/Src/bsp_fault.c` 在 `HardFault_Handler` 里打印 PC / LR / CFSR / HFSR，
并**直接给出 `addr2line` 命令**。优先把那条命令跑一遍再下结论，不要靠猜：

```bash
arm-none-eabi-addr2line -pfiaC -e build/Debug/<name>.elf 0x0800xxxx
```

⚠️ `addr2line` **只对同一份 elf 有效** —— 重新 build 过就要换新 elf。

| 现象 | 先查什么 |
|---|---|
| HardFault | `bsp_fault_report()` 的输出 → PC 落在哪个函数 |
| 卡在 `Error_Handler()` | 某个 `MX_*_Init()` 返回非 `HAL_OK`；时钟配置最可疑 |
| 任务完全不跑 | `osKernelStart()` 是否被调用；`configTOTAL_HEAP_SIZE` 是否够 |
| `malloc` 返回 NULL | 堆耗尽 → `sizecheck` 看 RAM 账目 |
| 日志突然中断 | 先排除 RTT 丢数据（见上），再看是不是死锁 |

---

## 5. 闭环验证（`verify`）

```bash
python Tools/fw.py verify --duration 8
```

做五步：**配置对账 → 编译 → 体积门禁 → 烧录 → 抓 RTT 判标记**。

前两步门禁（`lint`、`sizecheck`）排在烧录**之前**，理由是它们秒级且不碰硬件 ——
配置层面就矛盾、或体积已超预算时，烧录是白费；而烧录是**不可逆操作**
（docs/12 §B），不该拿它当"顺便检查一下"。任一门禁不过就中止，不浪费一次烧录。

`verify` 只认 RTT 日志后端 —— 现在这是**唯一**的后端（UART 后端 2026-10-06 已移除，
见 §3）。判据就是固件在 RTT 上打出的启动标记：没有标记就是没有，不假装能判。

| 退出码 | 含义 |
|---|---|
| **0** | 看到 `BOARD_BOOT_OK_MARKER`（`[AI_READY]`）⇒ 固件真的跑起来了 |
| **1** | 看到 `BOARD_BOOT_FAIL_MARKER`（`[AI_FAIL]`）⇒ 固件主动报错 |
| **2** | 超时，两个标记都没看到 ⇒ **探针/接线/固件卡死，原因未知** |

⚠️ **退出码 2 不等于"固件有问题"** —— 也可能是探针没插、串口被别的工具占着。
先 `fw.py env` 确认探针在线。

⚠️ **探针不在线时，不要把"编译通过"说成"验证通过"** —— 见 `AGENTS.md` §交付口径。

---

## 6. 体积

```bash
python Tools/fw.py size                      # 看明细
python Tools/fw.py sizecheck                 # 门禁：超线即失败
```

**只认一个口径**：`Tools/stm32_size.py` —— 按链接脚本 `MEMORY` 区 + ELF 的 LOAD 段
边界计算，与 `ld` 打印的 `Memory region Used Size` **逐字节一致**。

⚠️ `arm-none-eabi-size` 的 Berkeley 三列**不等于**真实占用（section 间有 ALIGN 间隙，
且 `.data` 初值运行时在 RAM、烧写时在 Flash）。回答体积问题前先跑 `fw.py size`。

预算上限在该文件顶部的 `BUDGETS`（单文件实现，不另开 json），超线即判失败。
⚠️ **为了让 `sizecheck` 变绿而调高上限 = 把门禁拆了。** 要调先说清理由（见 `docs/12`）。

---

## 7. 电脑上跑单测（不需要板子）

```bash
python Tools/fw.py test
```

用 **host gcc** 编译 `Operation/` 的源码 + `Test/` 的用例并运行。
这是本工程**最重要的反馈回路**：秒级、不烧板、不需要探针。

它同时是**规矩 2 的第二道墙** —— 谁在 `Operation/` 里偷用硬件函数，
这里会报 `undefined reference to vTaskDelay`（见 `01` §强制表）。
这条不是设计意图，是**实测过**的：`fw.py selftest --full` 会注入这个违规并断言它失败。

⚠️ **"跳过"不等于"通过"**：一个用例都没注册时 `ctest` 会跑出 0 个测试并**退出码 0**
—— 那意味着规矩 2 的强制**未经验证**。`fw.py test` 把这种情况单独判成退出码 **9**
（与断言失败同一个码），并在输出里说清是"断言挂了"还是"一个用例都没有"。

---

## 8. 文档一致性（死链 + 陈旧标识符）

```bash
python Tools/fw.py doccheck
```

扫三类：反引号里的路径 · 围栏代码块里的命令 · **工程自有标识符**
（`op_`/`bsp_`/`app_`/`LOG_`/`APP_`/`BOARD_` 前缀的名字必须在代码里存在）。

⚠️ **两类问题都是无声的** —— 死链不报错，直到某次 AI 按错的路子干了活；
陈旧标识符更隐蔽：文档写在实现定型之前时函数名会变（实测一次抓出 6 处），
固件照编、门禁全绿，直到 AI 照文档写了一个不存在的函数名才炸。
⚠️ 只查名字是否存在（不查签名/参数个数）；`docs/02`~`09` 是示例型规范，
名字本来就是虚构的，不参与对账 —— 改那几篇时靠人核。

---

## 9. 门禁自检

```bash
python Tools/fw.py selftest                  # 静态门禁
python Tools/fw.py selftest --full           # 追加编译期用例
```

在**工程副本**上跑三组（原工程全程只读）：**基线**（无注入时全绿，排除"永远报错"
的假检查器）→ **负向用例**（注入真违规，必须报错，排除"什么都不做"的假检查器）
→ **正向用例**（注入合法写法，必须仍通过，排除"什么都报"的假阳性）。

⚠️ **"退出码 0"不是有效判据** —— 一个什么都不做的检查器同样返回 0。
静态检查器的失效是**无声的**：不报错、不影响构建、报告照样全绿。

---

## 10. 环境自查

```bash
python Tools/fw.py env      # 工具链版本 / 依赖 / J-Link 路径 / 器件 / 各预设构建目录
```

⚠️ **禁止为了"确认环境"反复 `ls` / `which` / 读 `CMakeLists.txt`。** 需要事实就问它。

---

## 11. CubeMX 重新生成后的回填清单（2026-10-02 血的教训）

**背景**：2026-10-02 只为了把 FreeRTOS 堆从 15360 改成 4096 而重生成了一次，结果
**TIM8 整个 IP 连同 `Core/Src/tim.c` 被删**、**CMSIS-DSP 的链接接线被删**、还留下一个
**没闭合的 `/*`** 吃掉了 `USER CODE END Includes` 标记 —— 前两条任意一条都会让固件
变砖（TIM8 是 ADC 的 TRGO 触发源 ⇒ `fs=2.0MHz` 直接死；DSP 库没了 ⇒ `arm_cfft_f32`
链接不过）。**所以重生成之后、编译之前，先按本清单逐条核对。**

### 11.1 生成物里会被覆盖、必须回填的四处

| # | 文件 | 回填什么 | 丢了的症状 |
|---|---|---|---|
| 1 | `STM32F407XX_FLASH.ld` | `.ccmram (NOLOAD)`、两条越界 ASSERT、`_siccmram` 已删 | FLASH 白涨 32KB（`.ccmram` 又变成 `AT> FLASH`，而 startup 根本没有拷贝循环） |
| 2 | `cmake/stm32cubemx/CMakeLists.txt` | `Core/Src/tim.c` 进 `MX_Application_Src`；`Middlewares/ST/ARM/DSP/Inc` 进 `MX_Include_Dirs`；`.../DSP/Lib` 进 `MX_LINK_DIRS`；`:libarm_cortexM4lf_math.a` 进 `MX_LINK_LIBS` | `undefined reference to MX_TIM8_Init` / `arm_cfft_f32` |
| 3 | `Core/Src/main.c` | `#include "tim.h"` + `MX_TIM8_Init();` | 同上（TIM8 不初始化 ⇒ ADC 永不触发） |
| 4 | `Core/Inc/stm32f4xx_hal_conf.h` | `HAL_PCD_MODULE_ENABLED` 保持**注释**（USB 已拔除，见 `board_config.h` 的 USB 段） | FLASH 白涨十几 KB（USB PCD 又被编进来） |

`Core/Inc/main.h` 的 `USB_DM/DP_Pin` 宏、`Core/Src/stm32f4xx_it.c` 的
`OTG_FS_IRQHandler` + `extern PCD_HandleTypeDef hpcd_USB_OTG_FS` 同理：USB 拔除后
**每次重生成都要再删一遍**（`it.c` 里那两个不删，编译直接报 `unknown type name PCD_HandleTypeDef`）。

### 11.2 `.ioc` 侧要在 CubeMX 里逐条确认的开关

| 项 | 必须是 | 为什么 |
|---|---|---|
| `TIM8` | **勾上**：PSC=0 · ARR=71 · TRGO=Update · ClockSource=Internal | 144MHz/72 = **2.000MHz = fs** |
| `ADC1` | ExternalTrigConv = **T8_TRGO** · SamplingTime = 3 cycles · DMAContinuousRequests = ENABLE · Channel 1(PA1) | ADCCLK=36MHz 下 15 周期/417ns ⇒ 2.0MSPS |
| `RCC` | HSE 8M · PLLM=4 · PLLN=144 · PLLP=2 · PLLQ=6 · APB1=/4 · APB2=/2 · RTC=LSE | SYSCLK 144MHz（**故意的**：APB2=72 ⇒ ADCCLK=36=PCLK2/2 = F407 上限） |
| `FSMC` | AddressSetupTime=**2** · DataSetupTime=**8** · AccessMode=A · 16bit | 每像素 ≈**76.4ns** ⇒ 满帧 ≈11.7ms ⇒ 85fps（2026-10-13 从 12 收紧到 8；屏 spec TWC(min)=66ns ⇒ 留 16% 余量。⚠️ 改完要同步 `Core/Src/fsmc.c`，见下） |
| `FreeRTOS` | **TOTAL_HEAP_SIZE = 4096 Bytes** | 实测动态分配 <1.5KB；省 ~11KB RAM（key 名 `FREERTOS.configTOTAL_HEAP_SIZE`） |
| `USB_OTG_FS` | **不勾**（PA11/PA12 留给 ROM DFU 烧录即可） | 未使用，省十几 KB FLASH |

> **改 FSMC 时序的正确路径**（2026-10-13 补）：`.ioc` 的 `FSMC.AddressSetupTime1` /
> `FSMC.DataSetupTime1` 是**唯一真相源**，`Core/Src/fsmc.c` 的 `MX_FSMC_Init()` 是它的生成物。
> 两条改法：
> · **GUI**：加载 `.ioc` → Connectivity 里的 FMC/FSMC（认 SRAM/NOR 那一项）→ NOR/PSRAM-1
>   → Timing 表格改 *Address setup time* / *Data setup time* → GENERATE CODE；
> · **改文本 + CLI 生成**：直接改 `.ioc` 那两行，再跑 `STM32CubeMX.exe -q <脚本>`
>   （脚本格式见 `Tools/cubemx_check.txt`：`config load <ioc>` + `project generate` + `exit`）。
> ⚠️ 两条路都会**就地覆盖** `Core/`，生成后**必须**先过 §11.1 的回填清单再编译。
> ⚠️ **只改 `.ioc` 而不重新生成 = 两边不一致** —— 编译出来仍是旧时序，而且下次谁在 CubeMX
>   里点一下生成就把改动冲掉。（2026-10-13 收紧到 DS=8 时就是"改 `.ioc` + 手改 `fsmc.c` 同步"
>   顶上的，`fsmc.c` 那一次是**手改的生成物**，待用本流程正规化。）

### 11.3 重生成后的验证顺序（一条都不许跳）

```bash
cmake --preset Debug              # 重新 configure（compile_commands.json / build.ninja 要跟着变）
python Tools/fw.py build --clean-first   # 零告警口径；报错从第一条 error 改起
python Tools/fw.py lint           # .ioc ↔ board_config.h 的口径对账
python Tools/fw.py sizecheck      # 体积：`.ccmram` 是否为 NOBITS、FLASH 有没有白涨 32KB
```

> 基线（2026-10-02，本清单成文时）：**553 个 TU · 0 告警** · FLASH **506,372 B (48.29%)** ·
> RAM **87,480 B (66.74%)** · CCMRAM **32,768 B (50.00%)** · PC 单测 5 套 633 条断言全过。
