funiang-x/G2026/hardware/_review/audit_AFE_after_fix.txt

====================================================================
AFE-前端模拟   器件 37 / 导线 49 / 旗标 37
-- 1 两端几何同网（被导线短接）--
   （无）
-- 1b 两侧挂同名旗标 => 被并网短路（本工具独有，DRC 报不出来）--
   （无）
-- 2 一域多旗标名（隐性短路）--
   （无）
-- 3 匿名网（含引脚、无旗标；内部节点属正常）--
   ['C6.2', 'L5.2', 'L7.1']
   ['C10.1', 'JP2.1', 'R8.2', 'TP4.1']
   ['D1.6']
   ['R3.1', 'U1.1', 'U1.2']
   ['C2.2', 'L1.2', 'L3.1']
   ['R6.2', 'R8.1', 'U1.7']
   ['R6.1', 'R7.2', 'U1.6']
   ['L1.1', 'R3.2']
   ['C9.2', 'R5.1', 'U1.5']
   ['D1.3']
   ['C8.2', 'C9.1', 'L7.2', 'R4.1', 'TP3.1']
   ['D1.1']
   ['C4.2', 'L3.2', 'L5.1']
   ['C1.1', 'D1.4', 'J1.1', 'R1.1', 'TP1.1']
   ['C1.2', 'JP1.1']
-- 4 孤儿旗标（未被任何导线咬住）--
   （无）
====================================================================
跨页命名网总表
  +5V_A          : AFE-前端模拟.C11.1 , AFE-前端模拟.D1.5 , AFE-前端模拟.U1.8
  AFE_ADC_IN     : AFE-前端模拟.JP2.2
  AFE_BUF_IN     : AFE-前端模拟.JP1.2 , AFE-前端模拟.R2.1 , AFE-前端模拟.TP2.1 , AFE-前端模拟.U1.3
  AGND           : AFE-前端模拟.C10.2 , AFE-前端模拟.C11.2 , AFE-前端模拟.C12.1 , AFE-前端模拟.C13.2 , AFE-前端模拟.C2.1 , AFE-前端模拟.C4.1 , AFE-前端模拟.C6.1 , AFE-前端模拟.C8.1 , AFE-前端模拟.D1.2 , AFE-前端模拟.J1.2 , AFE-前端模拟.J1.3 , AFE-前端模拟.J1.4 , AFE-前端模拟.J1.5 , AFE-前端模拟.R1.2 , AFE-前端模拟.R10.2 , AFE-前端模拟.R4.2 , AFE-前端模拟.R7.1 , AFE-前端模拟.U1.4
  VBIAS          : AFE-前端模拟.C13.1 , AFE-前端模拟.R10.1 , AFE-前端模拟.R2.2 , AFE-前端模拟.R5.2 , AFE-前端模拟.R9.2 , AFE-前端模拟.TP5.1
  VREF_ADC       : AFE-前端模拟.C12.2 , AFE-前端模拟.JP3.1 , AFE-前端模拟.R9.1 , AFE-前端模拟.TP6.1
  VREF_CORE      : AFE-前端模拟.JP3.2
