funiang-x/G2026/hardware/_review/audit_all_after_fix.txt

====================================================================
INT-核心板与接口   器件 3 / 导线 64 / 旗标 64
-- 1 两端几何同网（被导线短接）--
   （无）
-- 1b 两侧挂同名旗标 => 被并网短路（本工具独有，DRC 报不出来）--
   （无）
-- 2 一域多旗标名（隐性短路）--
   （无）
-- 3 匿名网（含引脚、无旗标；内部节点属正常）--
   ['EVK1.56']
   ['EVK1.43']
   ['EVK1.7']
   ['EVK1.59']
   ['EVK1.34']
   ['EVK1.1']
   ['EVK1.81']
   ['EVK1.75']
   ['EVK1.82']
   ['EVK1.46']
   ['J5.25']
   ['EVK1.68']
   ['EVK1.8']
   ['EVK1.84']
   ['EVK1.62']
   ['EVK1.49']
   ['EVK1.42']
   ['EVK1.65']
   ['EVK1.58']
   ['EVK1.9']
   ['EVK1.52']
   ['EVK1.74']
   ['EVK1.61']
   ['EVK1.25']
   ['EVK1.55']
   ['EVK1.48']
   ['EVK1.10']
   ['EVK1.83']
   ['EVK1.64']
   ['EVK1.51']
   ['EVK1.26']
   ['EVK1.45']
   ['EVK1.60']
   ['J5.6']
   ['EVK1.54']
   ['EVK1.41']
   ['EVK1.76']
   ['EVK1.5']
   ['EVK1.27']
   ['EVK1.57']
   ['EVK1.50']
   ['EVK1.73']
   ['EVK1.44']
   ['J5.23']
   ['EVK1.66']
   ['EVK1.53']
   ['EVK1.6']
   ['EVK1.28']
   ['EVK1.47']
   ['EVK1.33']
   ['EVK1.63']
-- 4 孤儿旗标（未被任何导线咬住）--
   （无）
====================================================================
PWR-电源与背光   器件 10 / 导线 18 / 旗标 18
-- 1 两端几何同网（被导线短接）--
   （无）
-- 1b 两侧挂同名旗标 => 被并网短路（本工具独有，DRC 报不出来）--
   （无）
-- 2 一域多旗标名（隐性短路）--
   （无）
-- 3 匿名网（含引脚、无旗标；内部节点属正常）--
-- 4 孤儿旗标（未被任何导线咬住）--
   （无）
====================================================================
AFE-前端模拟   器件 37 / 导线 49 / 旗标 37
-- 1 两端几何同网（被导线短接）--
   （无）
-- 1b 两侧挂同名旗标 => 被并网短路（本工具独有，DRC 报不出来）--
   （无）
-- 2 一域多旗标名（隐性短路）--
   （无）
-- 3 匿名网（含引脚、无旗标；内部节点属正常）--
   ['D1.3']
   ['C8.2', 'C9.1', 'L7.2', 'R4.1', 'TP3.1']
   ['C4.2', 'L3.2', 'L5.1']
   ['C1.1', 'D1.4', 'J1.1', 'R1.1', 'TP1.1']
   ['C1.2', 'JP1.1']
   ['D1.1']
   ['C6.2', 'L5.2', 'L7.1']
   ['C2.2', 'L1.2', 'L3.1']
   ['C10.1', 'JP2.1', 'R8.2', 'TP4.1']
   ['R3.1', 'U1.1', 'U1.2']
   ['D1.6']
   ['R6.2', 'R8.1', 'U1.7']
   ['L1.1', 'R3.2']
   ['R6.1', 'R7.2', 'U1.6']
   ['C9.2', 'R5.1', 'U1.5']
-- 4 孤儿旗标（未被任何导线咬住）--
   （无）
====================================================================
跨页命名网总表
  +3V3           : INT-核心板与接口.EVK1.38 , INT-核心板与接口.EVK1.78 , INT-核心板与接口.J5.30 , PWR-电源与背光.C19.1 , PWR-电源与背光.C20.1 , PWR-电源与背光.R11.2 , PWR-电源与背光.R15.1 , PWR-电源与背光.R16.1
  +5V            : INT-核心板与接口.EVK1.40 , INT-核心板与接口.EVK1.80 , PWR-电源与背光.C16.1 , PWR-电源与背光.D2.1 , PWR-电源与背光.R21.1
  +5V_A          : PWR-电源与背光.R21.2 , AFE-前端模拟.C11.1 , AFE-前端模拟.D1.5 , AFE-前端模拟.U1.8
  +5V_RAW        : PWR-电源与背光.D2.2 , PWR-电源与背光.J3.1
  AFE_ADC_IN     : INT-核心板与接口.EVK1.3 , AFE-前端模拟.JP2.2
  AFE_BUF_IN     : AFE-前端模拟.JP1.2 , AFE-前端模拟.R2.1 , AFE-前端模拟.TP2.1 , AFE-前端模拟.U1.3
  AGND           : INT-核心板与接口.EVK1.37 , AFE-前端模拟.C10.2 , AFE-前端模拟.C11.2 , AFE-前端模拟.C12.1 , AFE-前端模拟.C13.2 , AFE-前端模拟.C2.1 , AFE-前端模拟.C4.1 , AFE-前端模拟.C6.1 , AFE-前端模拟.C8.1 , AFE-前端模拟.D1.2 , AFE-前端模拟.J1.2 , AFE-前端模拟.J1.3 , AFE-前端模拟.J1.4 , AFE-前端模拟.J1.5 , AFE-前端模拟.R1.2 , AFE-前端模拟.R10.2 , AFE-前端模拟.R4.2 , AFE-前端模拟.U1.4
  GND            : INT-核心板与接口.EVK1.39 , INT-核心板与接口.EVK1.77 , INT-核心板与接口.EVK1.79 , INT-核心板与接口.J5.29 , PWR-电源与背光.C16.2 , PWR-电源与背光.C19.2 , PWR-电源与背光.C20.2 , PWR-电源与背光.J3.2 , PWR-电源与背光.J3.3 , PWR-电源与背光.LED1.2
  LCD_BL_CTL     : INT-核心板与接口.J5.28 , INT-核心板与接口.R12.1
  LCD_BL_PB0     : INT-核心板与接口.EVK1.11 , INT-核心板与接口.R12.2
  LCD_CS         : INT-核心板与接口.EVK1.67 , INT-核心板与接口.J5.1
  LCD_D0         : INT-核心板与接口.EVK1.36 , INT-核心板与接口.J5.8
  LCD_D1         : INT-核心板与接口.EVK1.35 , INT-核心板与接口.J5.7
  LCD_D10        : INT-核心板与接口.EVK1.19 , INT-核心板与接口.J5.18
  LCD_D11        : INT-核心板与接口.EVK1.22 , INT-核心板与接口.J5.17
  LCD_D12        : INT-核心板与接口.EVK1.21 , INT-核心板与接口.J5.20
  LCD_D13        : INT-核心板与接口.EVK1.30 , INT-核心板与接口.J5.19
  LCD_D14        : INT-核心板与接口.EVK1.29 , INT-核心板与接口.J5.22
  LCD_D15        : INT-核心板与接口.EVK1.32 , INT-核心板与接口.J5.21
  LCD_D2         : INT-核心板与接口.EVK1.72 , INT-核心板与接口.J5.10
  LCD_D3         : INT-核心板与接口.EVK1.71 , INT-核心板与接口.J5.9
  LCD_D4         : INT-核心板与接口.EVK1.13 , INT-核心板与接口.J5.12
  LCD_D5         : INT-核心板与接口.EVK1.16 , INT-核心板与接口.J5.11
  LCD_D6         : INT-核心板与接口.EVK1.15 , INT-核心板与接口.J5.14
  LCD_D7         : INT-核心板与接口.EVK1.18 , INT-核心板与接口.J5.13
  LCD_D8         : INT-核心板与接口.EVK1.17 , INT-核心板与接口.J5.16
  LCD_D9         : INT-核心板与接口.EVK1.20 , INT-核心板与接口.J5.15
  LCD_RD         : INT-核心板与接口.EVK1.70 , INT-核心板与接口.J5.4
  LCD_RS         : INT-核心板与接口.EVK1.31 , INT-核心板与接口.J5.2
  LCD_RST        : INT-核心板与接口.EVK1.14 , INT-核心板与接口.J5.5
  LCD_WR         : INT-核心板与接口.EVK1.69 , INT-核心板与接口.J5.3
  PWR_LED        : PWR-电源与背光.LED1.1 , PWR-电源与背光.R11.1
  TP_INT         : INT-核心板与接口.EVK1.12 , INT-核心板与接口.J5.27
  TP_SCL         : INT-核心板与接口.EVK1.23 , INT-核心板与接口.J5.24 , PWR-电源与背光.R15.2
  TP_SDA         : INT-核心板与接口.EVK1.24 , INT-核心板与接口.J5.26 , PWR-电源与背光.R16.2
  VBIAS          : INT-核心板与接口.EVK1.4 , AFE-前端模拟.C13.1 , AFE-前端模拟.R10.1 , AFE-前端模拟.R2.2 , AFE-前端模拟.R5.2 , AFE-前端模拟.R7.1 , AFE-前端模拟.R9.2 , AFE-前端模拟.TP5.1
  VREF_ADC       : AFE-前端模拟.C12.2 , AFE-前端模拟.JP3.1 , AFE-前端模拟.R9.1 , AFE-前端模拟.TP6.1
  VREF_CORE      : INT-核心板与接口.EVK1.2 , AFE-前端模拟.JP3.2
