funiang-x/G2026/hardware/_review/final-20260930/src_AFE_mid_fix.txt

{"type":"DOCHEAD"}||{"docType":"SCH_PAGE","client":"c707c115792044b5","uuid":"fe840e6f545a2753","updateTime":1790691773619,"version":"1790691773619","editVersion":"4.1.60"}|
{"type":"CANVAS","ticket":1,"id":"CANVAS"}||{"originX":0,"originY":0}|
{"type":"COMPONENT","ticket":2,"id":"5d3e003fc8826190"}||{"partId":"0805W8F499JT5E.1","x":280,"y":-950,"rotation":270,"isMirror":false,"attrs":{"Footprints":"[]","Devices":"[]","DeviceName":"{\"uuid\":\"79f74f966b2afd5d\",\"name\":\"0805W8F499JT5E\",\"source\":\"\"}","FootprintName":null,"isSwitchClose":false,"pinClass":{},"differentialPairClass":{},"Symbols":"[]"},"zIndex":3}|
{"type":"ATTR","ticket":3,"id":"9ccf90f6555c8e4b"}||{"x":null,"y":null,"rotation":0,"color":null,"fontFamily":null,"fontSize":null,"fontWeight":false,"italic":false,"underline":false,"strikeout":false,"align":null,"value":"d299992fcd4d7387","keyVisible":null,"valueVisible":null,"key":"Symbol","fillColor":null,"parentId":"5d3e003fc8826190","zIndex":8,"locked":false}|
{"type":"ATTR","ticket":4,"id":"76450949fb0e210e"}||{"x":null,"y":null,"rotation":null,"color":null,"fontFamily":null,"fontSize":null,"fontWeight":null,"italic":null,"underline":null,"strikeout":false,"align":null,"value":"79f74f966b2afd5d","keyVisible":null,"valueVisible":null,"key":"Device","fillColor":null,"parentId":"5d3e003fc8826190","zIndex":5}|
{"type":"ATTR","ticket":5,"id":"e26f1fb17ae342aa"}||{"x":null,"y":null,"rotation":null,"color":null,"fontFamily":null,"fontSize":null,"fontWeight":null,"italic":null,"underline":null,"strikeout":false,"align":null,"value":"gge26","keyVisible":null,"valueVisible":null,"key":"Unique ID","fillColor":null,"parentId":"5d3e003fc8826190","zIndex":10}|
{"type":"ATTR","ticket":6,"id":"cddfeb2cf4a1ac12"}||{"x":null,"y":null,"rotation":null,"color":null,"fontFamily":null,"fontSize":null,"fontWeight":null,"italic":null,"underline":null,"strikeout":false,"align":null,"value":"yes","keyVisible":null,"valueVisible":null,"key":"Add into BOM","fillColor":null,"parentId":"5d3e003fc8826190","zIndex":3}|
{"type":"ATTR","ticket":7,"id":"e7402963f5629c45"}||{"x":null,"y":null,"rotation":null,"color":null,"fontFamily":null,"fontSize":null,"fontWeight":null,"italic":null,"underline":null,"strikeout":false,"align":null,"value":"yes","keyVisible":null,"valueVisible":null,"key":"Convert to PCB","fillColor":null,"parentId":"5d3e003fc8826190","zIndex":4}|
{"type":"ATTR","ticket":8,"id":"9543c0ea16805c14"}||{"x":290,"y":-950,"rotation":0,"color":null,"fontFamily":null,"fontSize":null,"fontWeight":false,"italic":false,"underline":false,"strikeout":false,"align":null,"value":"R1","keyVisible":null,"valueVisible":true,"key":"Designator","fillColor":null,"parentId":"5d3e003fc8826190","zIndex":9,"locked":false}|
{"type":"ATTR","ticket":9,"id":"64e84cbf11081856"}||{"x":null,"y":null,"rotation":null,"color":null,"fontFamily":null,"fontSize":null,"fontWeight":null,"italic":null,"underline":null,"strikeout":false,"align":null,"value":null,"keyVisible":null,"valueVisible":null,"key":"Footprint","fillColor":null,"parentId":"5d3e003fc8826190","zIndex":6}|
{"type":"ATTR","ticket":10,"id":"2239fd8adee39295"}||{"x":290,"y":-940,"rotation":0,"color":null,"fontFamily":null,"fontSize":null,"fontWeight":null,"italic":null,"underline":null,"align":null,"value":"={Value}","keyVisible":null,"valueVisible":true,"key":"Name","fillColor":null,"parentId":"5d3e003fc8826190","zIndex":11}|
{"type":"ATTR","ticket":11,"id":"a91671d2a5a336c1"}||{"x":null,"y":null,"rotation":null,"color":null,"fontFamily":null,"fontSize":null,"fontWeight":null,"italic":null,"underline":null,"align":null,"value":null,"keyVisible":null,"valueVisible":null,"key":"Reuse Block","fillColor":null,"parentId":"5d3e003fc8826190","zIndex":12}|
{"type":"ATTR","ticket":12,"id":"c8b1ef1d265e6291"}||{"x":null,"y":null,"rotation":null,"color":null,"fontFamily":null,"fontSize":null,"fontWeight":null,"italic":null,"underline":null,"align":null,"value":null,"keyVisible":null,"valueVisible":null,"key":"Group ID","fillColor":null,"parentId":"5d3e003fc8826190","zIndex":13}|
{"type":"ATTR","ticket":13,"id":"c680bac350b0305a"}||{"x":null,"y":null,"rotation":null,"color":null,"fontFamily":null,"fontSize":null,"fontWeight":null,"italic":null,"underline":null,"align":null,"value":null,"keyVisible":null,"valueVisible":null,"key":"Channel ID","fillColor":null,"parentId":"5d3e003fc8826190","zIndex":14}|
{"type":"COMPONENT","ticket":14,"id":"ac2df7588789e06a"}||{"partId":"1206CG104J500NT.1","x":400,"y":-1050,"rotation":0,"isMirror":false,"attrs":{"Footprints":"[]","Devices":"[]","DeviceName":"{\"uuid\":\"e27ef142eae24936\",\"name\":\"1206CG104J500NT\",\"source\":\"\"}","FootprintName":null,"isSwitchClose":false,"pinClass":{},"differentialPairClass":{},"Symbols":"[]"},"zIndex":4}|
{"type":"ATTR","ticket":15,"id":"82c1c460bfd9f14f"}||{"x":null,"y":null,"rotation":0,"color":null,"fontFamily":null,"fontSize":null,"fontWeight":false,"italic":false,"underline":false,"strikeout":false,"align":null,"value":"e3c7f97af9c02e88","keyVisible":null,"valueVisible":null,"key":"Symbol","fillColor":null,"parentId":"ac2df7588789e06a","zIndex":11,"locked":false}|
{"type":"ATTR","ticket":16,"id":"d416825114d39dca"}||{"x":null,"y":null,"rotation":null,"color":null,"fontFamily":null,"fontSize":null,"fontWeight":null,"italic":null,"underline":null,"strikeout":false,"align":null,"value":"e27ef142eae24936","keyVisible":null,"valueVisible":null,"key":"Device","fillColor":null,"parentId":"ac2df7588789e06a","zIndex":8}|
{"type":"ATTR","ticket":17,"id":"04435c90e3947c5c"}||{"x":null,"y":null,"rotation":null,"color":null,"fontFamily":null,"fontSize":null,"fontWeight":null,"italic":null,"underline":null,"strikeout":false,"align":null,"value":"gge27","keyVisible":null,"valueVisible":null,"key":"Unique ID","fillColor":null,"parentId":"ac2df7588789e06a","zIndex":13}|
{"type":"ATTR","ticket":18,"id":"18071f19f596b053"}||{"x":null,"y":null,"rotation":null,"color":null,"fontFamily":null,"fontSize":null,"fontWeight":null,"italic":null,"underline":null,"strikeout":false,"align":null,"value":"yes","keyVisible":null,"valueVisible":null,"key":"Add into BOM","fillColor":null,"parentId":"ac2df7588789e06a","zIndex":6}|
{"type":"ATTR","ticket":19,"id":"4424767edf1cf41a"}||{"x":null,"y":null,"rotation":null,"color":null,"fontFamily":null,"fontSize":null,"fontWeight":null,"italic":null,"underline":null,"strikeout":false,"align":null,"value":"yes","keyVisible":null,"valueVisible":null,"key":"Convert to PCB","fillColor":null,"parentId":"ac2df7588789e06a","zIndex":7}|
{"type":"ATTR","ticket":20,"id":"76bfb1d8c412fd92"}||{"x":395,"y":-1060,"rotation":0,"color":null,"fontFamily":null,"fontSize":null,"fontWeight":false,"italic":false,"underline":false,"strikeout":false,"align":null,"value":"C1","keyVisible":null,"valueVisible":true,"key":"Designator","fillColor":null,"parentId":"ac2df7588789e06a","zIndex":12,"locked":false}|
{"type":"ATTR","ticket":21,"id":"6f2db4ee616bf491"}||{"x":null,"y":null,"rotation":null,"color":null,"fontFamily":null,"fontSize":null,"fontWeight":null,"italic":null,"underline":null,"strikeout":false,"align":null,"value":null,"keyVisible":null,"valueVisible":null,"key":"Footprint","fillColor":null,"parentId":"ac2df7588789e06a","zIndex":9}|
{"type":"ATTR","ticket":22,"id":"32e376fd03dd4f73"}||{"x":395,"y":-1030,"rotation":0,"color":null,"fontFamily":null,"fontSize":null,"fontWeight":null,"italic":null,"underline":null,"align":null,"value":"={Value}","keyVisible":null,"valueVisible":true,"key":"Name","fillColor":null,"parentId":"ac2df7588789e06a","zIndex":14}|
{"type":"ATTR","ticket":23,"id":"386d484ea417ca1a"}||{"x":null,"y":null,"rotation":null,"color":null,"fontFamily":null,"fontSize":null,"fontWeight":null,"italic":null,"underline":null,"align":null,"value":null,"keyVisible":null,"valueVisible":null,"key":"Reuse Block","fillColor":null,"parentId":"ac2df7588789e06a","zIndex":15}|
{"type":"ATTR","ticket":24,"id":"66f3778b839f314f"}||{"x":null,"y":null,"rotation":null,"color":null,"fontFamily":null,"fontSize":null,"fontWeight":null,"italic":null,"underline":null,"align":null,"value":null,"keyVisible":null,"valueVisible":null,"key":"Group ID","fillColor":null,"parentId":"ac2df7588789e06a","zIndex":16}|
{"type":"ATTR","ticket":25,"id":"5344e18e4cfe4e75"}||{"x":null,"y":null,"rotation":null,"color":null,"fontFamily":null,"fontSize":null,"fontWeight":null,"italic":null,"underline":null,"align":null,"value":null,"keyVisible":null,"valueVisible":null,"key":"Channel ID","fillColor":null,"parentId":"ac2df7588789e06a","zIndex":17}|
{"type":"COMPONENT","ticket":26,"id":"21ae80ce7b51b802"}||{"partId":"0805W8F0000T5E.1","x":540,"y":-1050,"rotation":0,"isMirror":false,"attrs":{"Footprints":"[]","Devices":"[]","DeviceName":"{\"uuid\":\"bd8833f5dce78d43\",\"name\":\"0805W8F0000T5E\",\"source\":\"\"}","FootprintName":null,"isSwitchClose":false,"pinClass":{},"differentialPairClass":{},"Symbols":"[]"},"zIndex":5}|
{"type":"ATTR","ticket":27,"id":"ee3c6b85d157d103"}||{"x":null,"y":null,"rotation":0,"color":null,"fontFamily":null,"fontSize":null,"fontWeight":false,"italic":false,"underline":false,"strikeout":false,"align":null,"value":"bc12824f5caad1d3","keyVisible":null,"valueVisible":null,"key":"Symbol","fillColor":null,"parentId":"21ae80ce7b51b802","zIndex":8,"locked":false}|
{"type":"ATTR","ticket":28,"id":"45b072564b20a732"}||{"x":null,"y":null,"rotation":null,"color":null,"fontFamily":null,"fontSize":null,"fontWeight":null,"italic":null,"underline":null,"strikeout":false,"align":null,"value":"bd8833f5dce78d43","keyVisible":null,"valueVisible":null,"key":"Device","fillColor":null,"parentId":"21ae80ce7b51b802","zIndex":5}|
{"type":"ATTR","ticket":29,"id":"65b1da4f61de1e64"}||{"x":null,"y":null,"rotation":null,"color":null,"fontFamily":null,"fontSize":null,"fontWeight":null,"italic":null,"underline":null,"strikeout":false,"align":null,"value":"gge28","keyVisible":null,"valueVisible":null,"key":"Unique ID","fillColor":null,"parentId":"21ae80ce7b51b802","zIndex":10}|
{"type":"ATTR","ticket":30,"id":"a67e7f0a7f749801"}||{"x":null,"y":null,"rotation":null,"color":null,"fontFamily":null,"fontSize":null,"fontWeight":null,"italic":null,"underline":null,"strikeout":false,"align":null,"value":"yes","keyVisible":null,"valueVisible":null,"key":"Add into BOM","fillColor":null,"parentId":"21ae80ce7b51b802","zIndex":3}|
{"type":"ATTR","ticket":31,"id":"c518f07e42803184"}||{"x":null,"y":null,"rotation":null,"color":null,"fontFamily":null,"fontSize":null,"fontWeight":null,"italic":null,"underline":null,"strikeout":false,"align":null,"value":"yes","keyVisible":null,"valueVisible":null,"key":"Convert to PCB","fillColor":null,"parentId":"21ae80ce7b51b802","zIndex":4}|
{"type":"ATTR","ticket":32,"id":"b82c7c5afa18d8db"}||{"x":530,"y":-1055,"rotation":0,"color":null,"fontFamily":null,"fontSize":null,"fontWeight":false,"italic":false,"underline":false,"strikeout":false,"align":null,"value":"JP1","keyVisible":null,"valueVisible":true,"key":"Designator","fillColor":null,"parentId":"21ae80ce7b51b802","zIndex":9,"locked":false}|
{"type":"ATTR","ticket":33,"id":"5b35122950192de4"}||{"x":null,"y":null,"rotation":null,"color":null,"fontFamily":null,"fontSize":null,"fontWeight":null,"italic":null,"underline":null,"strikeout":false,"align":null,"value":null,"keyVisible":null,"valueVisible":null,"key":"Footprint","fillColor":null,"parentId":"21ae80ce7b51b802","zIndex":6}|
{"type":"ATTR","ticket":34,"id":"797aadecbcf8c8ec"}||{"x":530,"y":-1035,"rotation":0,"color":null,"fontFamily":null,"fontSize":null,"fontWeight":null,"italic":null,"underline":null,"align":null,"value":"={Value}","keyVisible":null,"valueVisible":true,"key":"Name","fillColor":null,"parentId":"21ae80ce7b51b802","zIndex":11}|
{"type":"ATTR","ticket":35,"id":"a97400eed64e8022"}||{"x":null,"y":null,"rotation":null,"color":null,"fontFamily":null,"fontSize":null,"fontWeight":null,"italic":null,"underline":null,"align":null,"value":null,"keyVisible":null,"valueVisible":null,"key":"Reuse Block","fillColor":null,"parentId":"21ae80ce7b51b802","zIndex":12}|
{"type":"ATTR","ticket":36,"id":"56d04087b10bd83e"}||{"x":null,"y":null,"rotation":null,"color":null,"fontFamily":null,"fontSize":null,"fontWeight":null,"italic":null,"underline":null,"align":null,"value":null,"keyVisible":null,"valueVisible":null,"key":"Group ID","fillColor":null,"parentId":"21ae80ce7b51b802","zIndex":13}|
{"type":"ATTR","ticket":37,"id":"ad3d4f2e996105d4"}||{"x":null,"y":null,"rotation":null,"color":null,"fontFamily":null,"fontSize":null,"fontWeight":null,"italic":null,"underline":null,"align":null,"value":null,"keyVisible":null,"valueVisible":null,"key":"Channel ID","fillColor":null,"parentId":"21ae80ce7b51b802","zIndex":14}|
{"type":"COMPONENT","ticket":38,"id":"ba13657df474ad19"}||{"partId":"0805W8F1002T5E.1","x":620,"y":-1150,"rotation":270,"isMirror":false,"attrs":{"Footprints":"[]","Devices":"[]","DeviceName":"{\"uuid\":\"1193929c9b0386fe\",\"name\":\"0805W8F1002T5E_C17414\",\"source\":\"\"}","FootprintName":null,"isSwitchClose":false,"pinClass":{},"differentialPairClass":{},"Symbols":"[]"},"zIndex":6}|
{"type":"ATTR","ticket":39,"id":"5c0c63555a8b90f8"}||{"x":null,"y":null,"rotation":0,"color":null,"fontFamily":null,"fontSize":null,"fontWeight":false,"italic":false,"underline":false,"strikeout":false,"align":null,"value":"78edfac15a307052","keyVisible":null,"valueVisible":null,"key":"Symbol","fillColor":null,"parentId":"ba13657df474ad19","zIndex":8,"locked":false}|
{"type":"ATTR","ticket":40,"id":"5ba8ef7860e32720"}||{"x":null,"y":null,"rotation":null,"color":null,"fontFamily":null,"fontSize":null,"fontWeight":null,"italic":null,"underline":null,"strikeout":false,"align":null,"value":"1193929c9b0386fe","keyVisible":null,"valueVisible":null,"key":"Device","fillColor":null,"parentId":"ba13657df474ad19","zIndex":5}|
{"type":"ATTR","ticket":41,"id":"eaa03bbf5cb80afd"}||{"x":null,"y":null,"rotation":null,"color":null,"fontFamily":null,"fontSize":null,"fontWeight":null,"italic":null,"underline":null,"strikeout":false,"align":null,"value":"gge29","keyVisible":null,"valueVisible":null,"key":"Unique ID","fillColor":null,"parentId":"ba13657df474ad19","zIndex":10}|
{"type":"ATTR","ticket":42,"id":"ae39379131a3d0d0"}||{"x":null,"y":null,"rotation":null,"color":null,"fontFamily":null,"fontSize":null,"fontWeight":null,"italic":null,"underline":null,"strikeout":false,"align":null,"value":"yes","keyVisible":null,"valueVisible":null,"key":"Add into BOM","fillColor":null,"parentId":"ba13657df474ad19","zIndex":3}|
{"type":"ATTR","ticket":43,"id":"82ccf88ccd795047"}||{"x":null,"y":null,"rotation":null,"color":null,"fontFamily":null,"fontSize":null,"fontWeight":null,"italic":null,"underline":null,"strikeout":false,"align":null,"value":"yes","keyVisible":null,"valueVisible":null,"key":"Convert to PCB","fillColor":null,"parentId":"ba13657df474ad19","zIndex":4}|
{"type":"ATTR","ticket":44,"id":"a948f3586732b785"}||{"x":630,"y":-1150,"rotation":0,"color":null,"fontFamily":null,"fontSize":null,"fontWeight":false,"italic":false,"underline":false,"strikeout":false,"align":null,"value":"R2","keyVisible":null,"valueVisible":true,"key":"Designator","fillColor":null,"parentId":"ba13657df474ad19","zIndex":9,"locked":false}|
{"type":"ATTR","ticket":45,"id":"5fbe30acafba5e15"}||{"x":null,"y":null,"rotation":null,"color":null,"fontFamily":null,"fontSize":null,"fontWeight":null,"italic":null,"underline":null,"strikeout":false,"align":null,"value":null,"keyVisible":null,"valueVisible":null,"key":"Footprint","fillColor":null,"parentId":"ba13657df474ad19","zIndex":6}|
{"type":"ATTR","ticket":46,"id":"ccc34d9a1fff7e6d"}||{"x":630,"y":-1140,"rotation":0,"color":null,"fontFamily":null,"fontSize":null,"fontWeight":null,"italic":null,"underline":null,"align":null,"value":"={Value}","keyVisible":null,"valueVisible":true,"key":"Name","fillColor":null,"parentId":"ba13657df474ad19","zIndex":11}|
{"type":"ATTR","ticket":47,"id":"b6419229d1f92b7e"}||{"x":null,"y":null,"rotation":null,"color":null,"fontFamily":null,"fontSize":null,"fontWeight":null,"italic":null,"underline":null,"align":null,"value":null,"keyVisible":null,"valueVisible":null,"key":"Reuse Block","fillColor":null,"parentId":"ba13657df474ad19","zIndex":12}|
{"type":"ATTR","ticket":48,"id":"0c03548211862129"}||{"x":null,"y":null,"rotation":null,"color":null,"fontFamily":null,"fontSize":null,"fontWeight":null,"italic":null,"underline":null,"align":null,"value":null,"keyVisible":null,"valueVisible":null,"key":"Group ID","fillColor":null,"parentId":"ba13657df474ad19","zIndex":13}|
{"type":"ATTR","ticket":49,"id":"0af6a779f5416fd6"}||{"x":null,"y":null,"rotation":null,"color":null,"fontFamily":null,"fontSize":null,"fontWeight":null,"italic":null,"underline":null,"align":null,"value":null,"keyVisible":null,"valueVisible":null,"key":"Channel ID","fillColor":null,"parentId":"ba13657df474ad19","zIndex":14}|
{"type":"COMPONENT","ticket":50,"id":"f2e48ec37a8f2db5"}||{"partId":"OPA2197ID.1","x":760,"y":-1050,"rotation":0,"isMirror":false,"attrs":{"Footprints":"[]","Devices":"[]","DeviceName":"{\"uuid\":\"1a9c3947b739c994\",\"name\":\"OPA2197ID\",\"source\":\"\"}","FootprintName":null,"isSwitchClose":false,"pinClass":{},"differentialPairClass":{},"Symbols":"[]"},"zIndex":7}|
{"type":"ATTR","ticket":51,"id":"348ca2bf9dd8a1cb"}||{"x":null,"y":null,"rotation":null,"color":null,"fontFamily":null,"fontSize":null,"fontWeight":null,"italic":null,"underline":null,"strikeout":false,"align":null,"value":"10018e0dcb9f4ecb","keyVisible":null,"valueVisible":null,"key":"Symbol","fillColor":null,"parentId":"f2e48ec37a8f2db5","zIndex":15}|
{"type":"ATTR","ticket":52,"id":"e40c8ffdbcae7fff"}||{"x":null,"y":null,"rotation":null,"color":null,"fontFamily":null,"fontSize":null,"fontWeight":null,"italic":null,"underline":null,"strikeout":false,"align":null,"value":"1a9c3947b739c994","keyVisible":null,"valueVisible":null,"key":"Device","fillColor":null,"parentId":"f2e48ec37a8f2db5","zIndex":12}|
{"type":"ATTR","ticket":53,"id":"493c17b8491d6ba6"}||{"x":null,"y":null,"rotation":null,"color":null,"fontFamily":null,"fontSize":null,"fontWeight":null,"italic":null,"underline":null,"strikeout":false,"align":null,"value":"gge30","keyVisible":null,"valueVisible":null,"key":"Unique ID","fillColor":null,"parentId":"f2e48ec37a8f2db5","zIndex":16}|
{"type":"ATTR","ticket":54,"id":"09492dc1bcd68d0d"}||{"x":null,"y":null,"rotation":null,"color":null,"fontFamily":null,"fontSize":null,"fontWeight":null,"italic":null,"underline":null,"strikeout":false,"align":null,"value":"yes","keyVisible":null,"valueVisible":null,"key":"Add into BOM","fillColor":null,"parentId":"f2e48ec37a8f2db5","zIndex":9}|
{"type":"ATTR","ticket":55,"id":"0d7b1e9be0bfad3a"}||{"x":null,"y":null,"rotation":null,"color":null,"fontFamily":null,"fontSize":null,"fontWeight":null,"italic":null,"underline":null,"strikeout":false,"align":null,"value":"yes","keyVisible":null,"valueVisible":null,"key":"Convert to PCB","fillColor":null,"parentId":"f2e48ec37a8f2db5","zIndex":10}|
{"type":"ATTR","ticket":56,"id":"336d9c9e1ebf793c"}||{"x":740,"y":-1080,"rotation":0,"color":null,"fontFamily":null,"fontSize":null,"fontWeight":null,"italic":null,"underline":null,"strikeout":false,"align":null,"value":"U1","keyVisible":null,"valueVisible":true,"key":"Designator","fillColor":null,"parentId":"f2e48ec37a8f2db5","zIndex":11}|
{"type":"ATTR","ticket":57,"id":"07dd9dcadb681c80"}||{"x":null,"y":null,"rotation":null,"color":null,"fontFamily":null,"fontSize":null,"fontWeight":null,"italic":null,"underline":null,"align":null,"value":"U1","keyVisible":null,"valueVisible":null,"key":"Multi-Part Group","fillColor":null,"parentId":"f2e48ec37a8f2db5","zIndex":17}|
{"type":"ATTR","ticket":58,"id":"e2f63415e200e001"}||{"x":null,"y":null,"rotation":null,"color":null,"fontFamily":null,"fontSize":null,"fontWeight":null,"italic":null,"underline":null,"strikeout":false,"align":null,"value":"","keyVisible":null,"valueVisible":null,"key":"Relevance","fillColor":null,"parentId":"f2e48ec37a8f2db5","zIndex":18}|
{"type":"ATTR","ticket":59,"id":"862e0522a4900897"}||{"x":null,"y":null,"rotation":null,"color":null,"fontFamily":null,"fontSize":null,"fontWeight":null,"italic":null,"underline":null,"strikeout":false,"align":null,"value":null,"keyVisible":null,"valueVisible":null,"key":"Footprint","fillColor":null,"parentId":"f2e48ec37a8f2db5","zIndex":13}|
{"type":"ATTR","ticket":60,"id":"837546a9f67e1551"}||{"x":740,"y":-1010,"rotation":0,"color":null,"fontFamily":null,"fontSize":null,"fontWeight":null,"italic":null,"underline":null,"align":null,"value":"={Manufacturer Part}","keyVisible":null,"valueVisible":true,"key":"Name","fillColor":null,"parentId":"f2e48ec37a8f2db5","zIndex":19}|
{"type":"ATTR","ticket":61,"id":"a13e3852a57d2bf6"}||{"x":null,"y":null,"rotation":null,"color":null,"fontFamily":null,"fontSize":null,"fontWeight":null,"italic":null,"underline":null,"align":null,"value":null,"keyVisible":null,"valueVisible":null,"key":"Reuse Block","fillColor":null,"parentId":"f2e48ec37a8f2db5","zIndex":20}|
{"type":"ATTR","ticket":62,"id":"93de9967d7f4e4fe"}||{"x":null,"y":null,"rotation":null,"color":null,"fontFamily":null,"fontSize":null,"fontWeight":null,"italic":null,"underline":null,"align":null,"value":null,"keyVisible":null,"valueVisible":null,"key":"Group ID","fillColor":null,"parentId":"f2e48ec37a8f2db5","zIndex":21}|
{"type":"ATTR","ticket":63,"id":"8d7f7daffb45f258"}||{"x":null,"y":null,"rotation":null,"color":null,"fontFamily":null,"fontSize":null,"fontWeight":null,"italic":null,"underline":null,"align":null,"value":null,"keyVisible":null,"valueVisible":null,"key":"Channel ID","fillColor":null,"parentId":"f2e48ec37a8f2db5","zIndex":22}|
{"type":"COMPONENT","ticket":64,"id":"f7f5d17397a67241"}||{"partId":"0805W8F499JT5E.1","x":900,"y":-1050,"rotation":0,"isMirror":false,"attrs":{"Footprints":"[]","Devices":"[]","DeviceName":"{\"uuid\":\"79f74f966b2afd5d\",\"name\":\"0805W8F499JT5E\",\"source\":\"\"}","FootprintName":null,"isSwitchClose":false,"pinClass":{},"differentialPairClass":{},"Symbols":"[]"},"zIndex":8}|
{"type":"ATTR","ticket":65,"id":"d26c2cb72c95d25e"}||{"x":null,"y":null,"rotation":0,"color":null,"fontFamily":null,"fontSize":null,"fontWeight":false,"italic":false,"underline":false,"strikeout":false,"align":null,"value":"d299992fcd4d7387","keyVisible":null,"valueVisible":null,"key":"Symbol","fillColor":null,"parentId":"f7f5d17397a67241","zIndex":8,"locked":false}|
{"type":"ATTR","ticket":66,"id":"cdfd5bd76d917a45"}||{"x":null,"y":null,"rotation":null,"color":null,"fontFamily":null,"fontSize":null,"fontWeight":null,"italic":null,"underline":null,"strikeout":false,"align":null,"value":"79f74f966b2afd5d","keyVisible":null,"valueVisible":null,"key":"Device","fillColor":null,"parentId":"f7f5d17397a67241","zIndex":5}|
{"type":"ATTR","ticket":67,"id":"97363db4fd10ec99"}||{"x":null,"y":null,"rotation":null,"color":null,"fontFamily":null,"fontSize":null,"fontWeight":null,"italic":null,"underline":null,"strikeout":false,"align":null,"value":"gge31","keyVisible":null,"valueVisible":null,"key":"Unique ID","fillColor":null,"parentId":"f7f5d17397a67241","zIndex":10}|
{"type":"ATTR","ticket":68,"id":"a0092f74e3fb17a2"}||{"x":null,"y":null,"rotation":null,"color":null,"fontFamily":null,"fontSize":null,"fontWeight":null,"italic":null,"underline":null,"strikeout":false,"align":null,"value":"yes","keyVisible":null,"valueVisible":null,"key":"Add into BOM","fillColor":null,"parentId":"f7f5d17397a67241","zIndex":3}|
{"type":"ATTR","ticket":69,"id":"2f8b0b5a712ad48f"}||{"x":null,"y":null,"rotation":null,"color":null,"fontFamily":null,"fontSize":null,"fontWeight":null,"italic":null,"underline":null,"strikeout":false,"align":null,"value":"yes","keyVisible":null,"valueVisible":null,"key":"Convert to PCB","fillColor":null,"parentId":"f7f5d17397a67241","zIndex":4}|
{"type":"ATTR","ticket":70,"id":"a1ad21b89b7267a8"}||{"x":890,"y":-1055,"rotation":0,"color":null,"fontFamily":null,"fontSize":null,"fontWeight":false,"italic":false,"underline":false,"strikeout":false,"align":null,"value":"R3","keyVisible":null,"valueVisible":true,"key":"Designator","fillColor":null,"parentId":"f7f5d17397a67241","zIndex":9,"locked":false}|
{"type":"ATTR","ticket":71,"id":"1b90e906554c80f5"}||{"x":null,"y":null,"rotation":null,"color":null,"fontFamily":null,"fontSize":null,"fontWeight":null,"italic":null,"underline":null,"strikeout":false,"align":null,"value":null,"keyVisible":null,"valueVisible":null,"key":"Footprint","fillColor":null,"parentId":"f7f5d17397a67241","zIndex":6}|
{"type":"ATTR","ticket":72,"id":"588e3ed5a8953a50"}||{"x":890,"y":-1035,"rotation":0,"color":null,"fontFamily":null,"fontSize":null,"fontWeight":null,"italic":null,"underline":null,"align":null,"value":"={Value}","keyVisible":null,"valueVisible":true,"key":"Name","fillColor":null,"parentId":"f7f5d17397a67241","zIndex":11}|
{"type":"ATTR","ticket":73,"id":"686798e5a6f8bd4a"}||{"x":null,"y":null,"rotation":null,"color":null,"fontFamily":null,"fontSize":null,"fontWeight":null,"italic":null,"underline":null,"align":null,"value":null,"keyVisible":null,"valueVisible":null,"key":"Reuse Block","fillColor":null,"parentId":"f7f5d17397a67241","zIndex":12}|
{"type":"ATTR","ticket":74,"id":"db6a6003e28576f9"}||{"x":null,"y":null,"rotation":null,"color":null,"fontFamily":null,"fontSize":null,"fontWeight":null,"italic":null,"underline":null,"align":null,"value":null,"keyVisible":null,"valueVisible":null,"key":"Group ID","fillColor":null,"parentId":"f7f5d17397a67241","zIndex":13}|
{"type":"ATTR","ticket":75,"id":"a512afd9a33471b0"}||{"x":null,"y":null,"rotation":null,"color":null,"fontFamily":null,"fontSize":null,"fontWeight":null,"italic":null,"underline":null,"align":null,"value":null,"keyVisible":null,"valueVisible":null,"key":"Channel ID","fillColor":null,"parentId":"f7f5d17397a67241","zIndex":14}|
{"type":"COMPONENT","ticket":76,"id":"40b59f91beff47c2"}||{"partId":"XRCD54-120M.1","x":1740,"y":-1050,"rotation":0,"isMirror":false,"attrs":{"Footprints":"[]","Devices":"[]","DeviceName":"{\"uuid\":\"31e8370528ea9259\",\"name\":\"XRCD54-120M\",\"source\":\"\"}","FootprintName":null,"isSwitchClose":false,"pinClass":{},"differentialPairClass":{},"Symbols":"[]"},"zIndex":15}|
{"type":"ATTR","ticket":77,"id":"5f0b2ecc065629e7"}||{"x":null,"y":null,"rotation":0,"color":null,"fontFamily":null,"fontSize":null,"fontWeight":false,"italic":false,"underline":false,"strikeout":false,"align":null,"value":"b6bdcc86d16d9a2c","keyVisible":null,"valueVisible":null,"key":"Symbol","fillColor":null,"parentId":"40b59f91beff47c2","zIndex":11,"locked":false}|
{"type":"ATTR","ticket":78,"id":"b1fdc346ef6ac003"}||{"x":null,"y":null,"rotation":null,"color":null,"fontFamily":null,"fontSize":null,"fontWeight":null,"italic":null,"underline":null,"strikeout":false,"align":null,"value":"31e8370528ea9259","keyVisible":null,"valueVisible":null,"key":"Device","fillColor":null,"parentId":"40b59f91beff47c2","zIndex":8}|
{"type":"ATTR","ticket":79,"id":"a6da4a39072a3956"}||{"x":null,"y":null,"rotation":null,"color":null,"fontFamily":null,"fontSize":null,"fontWeight":null,"italic":null,"underline":null,"strikeout":false,"align":null,"value":"gge32","keyVisible":null,"valueVisible":null,"key":"Unique ID","fillColor":null,"parentId":"40b59f91beff47c2","zIndex":13}|
{"type":"ATTR","ticket":80,"id":"d7f4efa3e2469532"}||{"x":null,"y":null,"rotation":null,"color":null,"fontFamily":null,"fontSize":null,"fontWeight":null,"italic":null,"underline":null,"strikeout":false,"align":null,"value":"yes","keyVisible":null,"valueVisible":null,"key":"Add into BOM","fillColor":null,"parentId":"40b59f91beff47c2","zIndex":6}|
{"type":"ATTR","ticket":81,"id":"89312937d86ef388"}||{"x":null,"y":null,"rotation":null,"color":null,"fontFamily":null,"fontSize":null,"fontWeight":null,"italic":null,"underline":null,"strikeout":false,"align":null,"value":"yes","keyVisible":null,"valueVisible":null,"key":"Convert to PCB","fillColor":null,"parentId":"40b59f91beff47c2","zIndex":7}|
{"type":"ATTR","ticket":82,"id":"6ac79da1b9fa3512"}||{"x":1725,"y":-1055,"rotation":0,"color":null,"fontFamily":null,"fontSize":null,"fontWeight":false,"italic":false,"underline":false,"strikeout":false,"align":null,"value":"L7","keyVisible":null,"valueVisible":true,"key":"Designator","fillColor":null,"parentId":"40b59f91beff47c2","zIndex":12,"locked":false}|
{"type":"ATTR","ticket":83,"id":"be189732d44ea697"}||{"x":null,"y":null,"rotation":null,"color":null,"fontFamily":null,"fontSize":null,"fontWeight":null,"italic":null,"underline":null,"strikeout":false,"align":null,"value":null,"keyVisible":null,"valueVisible":null,"key":"Footprint","fillColor":null,"parentId":"40b59f91beff47c2","zIndex":9}|
{"type":"ATTR","ticket":84,"id":"475e40f830e2318e"}||{"x":1725,"y":-1040,"rotation":0,"color":null,"fontFamily":null,"fontSize":null,"fontWeight":null,"italic":null,"underline":null,"align":null,"value":"={Value}","keyVisible":null,"valueVisible":true,"key":"Name","fillColor":null,"parentId":"40b59f91beff47c2","zIndex":14}|
{"type":"ATTR","ticket":85,"id":"9abf9b3508200a48"}||{"x":null,"y":null,"rotation":null,"color":null,"fontFamily":null,"fontSize":null,"fontWeight":null,"italic":null,"underline":null,"align":null,"value":null,"keyVisible":null,"valueVisible":null,"key":"Reuse Block","fillColor":null,"parentId":"40b59f91beff47c2","zIndex":15}|
{"type":"ATTR","ticket":86,"id":"cb1ddef029907b2e"}||{"x":null,"y":null,"rotation":null,"color":null,"fontFamily":null,"fontSize":null,"fontWeight":null,"italic":null,"underline":null,"align":null,"value":null,"keyVisible":null,"valueVisible":null,"key":"Group ID","fillColor":null,"parentId":"40b59f91beff47c2","zIndex":16}|
{"type":"ATTR","ticket":87,"id":"4a5574c840f7739e"}||{"x":null,"y":null,"rotation":null,"color":null,"fontFamily":null,"fontSize":null,"fontWeight":null,"italic":null,"underline":null,"align":null,"value":null,"keyVisible":null,"valueVisible":null,"key":"Channel ID","fillColor":null,"parentId":"40b59f91beff47c2","zIndex":17}|
{"type":"COMPONENT","ticket":88,"id":"8e69b0aeda799e9a"}||{"partId":"0805W8F499JT5E.1","x":1980,"y":-950,"rotation":270,"isMirror":false,"attrs":{"Footprints":"[]","Devices":"[]","DeviceName":"{\"uuid\":\"79f74f966b2afd5d\",\"name\":\"0805W8F499JT5E\",\"source\":\"\"}","FootprintName":null,"isSwitchClose":false,"pinClass":{},"differentialPairClass":{},"Symbols":"[]"},"zIndex":17}|
{"type":"ATTR","ticket":89,"id":"e068e8b9556724b6"}||{"x":null,"y":null,"rotation":0,"color":null,"fontFamily":null,"fontSize":null,"fontWeight":false,"italic":false,"underline":false,"strikeout":false,"align":null,"value":"d299992fcd4d7387","keyVisible":null,"valueVisible":null,"key":"Symbol","fillColor":null,"parentId":"8e69b0aeda799e9a","zIndex":8,"locked":false}|
{"type":"ATTR","ticket":90,"id":"5efd5c9531e64129"}||{"x":null,"y":null,"rotation":null,"color":null,"fontFamily":null,"fontSize":null,"fontWeight":null,"italic":null,"underline":null,"strikeout":false,"align":null,"value":"79f74f966b2afd5d","keyVisible":null,"valueVisible":null,"key":"Device","fillColor":null,"parentId":"8e69b0aeda799e9a","zIndex":5}|
{"type":"ATTR","ticket":91,"id":"39dd8d86a1d11dae"}||{"x":null,"y":null,"rotation":null,"color":null,"fontFamily":null,"fontSize":null,"fontWeight":null,"italic":null,"underline":null,"strikeout":false,"align":null,"value":"gge33","keyVisible":null,"valueVisible":null,"key":"Unique ID","fillColor":null,"parentId":"8e69b0aeda799e9a","zIndex":10}|
{"type":"ATTR","ticket":92,"id":"64b0b3d7cc4e03a4"}||{"x":null,"y":null,"rotation":null,"color":null,"fontFamily":null,"fontSize":null,"fontWeight":null,"italic":null,"underline":null,"strikeout":false,"align":null,"value":"yes","keyVisible":null,"valueVisible":null,"key":"Add into BOM","fillColor":null,"parentId":"8e69b0aeda799e9a","zIndex":3}|
{"type":"ATTR","ticket":93,"id":"9958f4b087fed495"}||{"x":null,"y":null,"rotation":null,"color":null,"fontFamily":null,"fontSize":null,"fontWeight":null,"italic":null,"underline":null,"strikeout":false,"align":null,"value":"yes","keyVisible":null,"valueVisible":null,"key":"Convert to PCB","fillColor":null,"parentId":"8e69b0aeda799e9a","zIndex":4}|
{"type":"ATTR","ticket":94,"id":"4c1841d39db1618f"}||{"x":1990,"y":-950,"rotation":0,"color":null,"fontFamily":null,"fontSize":null,"fontWeight":false,"italic":false,"underline":false,"strikeout":false,"align":null,"value":"R4","keyVisible":null,"valueVisible":true,"key":"Designator","fillColor":null,"parentId":"8e69b0aeda799e9a","zIndex":9,"locked":false}|
{"type":"ATTR","ticket":95,"id":"7af18b4b480f17f0"}||{"x":null,"y":null,"rotation":null,"color":null,"fontFamily":null,"fontSize":null,"fontWeight":null,"italic":null,"underline":null,"strikeout":false,"align":null,"value":null,"keyVisible":null,"valueVisible":null,"key":"Footprint","fillColor":null,"parentId":"8e69b0aeda799e9a","zIndex":6}|
{"type":"ATTR","ticket":96,"id":"ff1fefe9296d6fc2"}||{"x":1990,"y":-940,"rotation":0,"color":null,"fontFamily":null,"fontSize":null,"fontWeight":null,"italic":null,"underline":null,"align":null,"value":"={Value}","keyVisible":null,"valueVisible":true,"key":"Name","fillColor":null,"parentId":"8e69b0aeda799e9a","zIndex":11}|
{"type":"ATTR","ticket":97,"id":"2e863a2ce3985512"}||{"x":null,"y":null,"rotation":null,"color":null,"fontFamily":null,"fontSize":null,"fontWeight":null,"italic":null,"underline":null,"align":null,"value":null,"keyVisible":null,"valueVisible":null,"key":"Reuse Block","fillColor":null,"parentId":"8e69b0aeda799e9a","zIndex":12}|
{"type":"ATTR","ticket":98,"id":"3934b68d577b74e9"}||{"x":null,"y":null,"rotation":null,"color":null,"fontFamily":null,"fontSize":null,"fontWeight":null,"italic":null,"underline":null,"align":null,"value":null,"keyVisible":null,"valueVisible":null,"key":"Group ID","fillColor":null,"parentId":"8e69b0aeda799e9a","zIndex":13}|
{"type":"ATTR","ticket":99,"id":"5f7a39e5aad23838"}||{"x":null,"y":null,"rotation":null,"color":null,"fontFamily":null,"fontSize":null,"fontWeight":null,"italic":null,"underline":null,"align":null,"value":null,"keyVisible":null,"valueVisible":null,"key":"Channel ID","fillColor":null,"parentId":"8e69b0aeda799e9a","zIndex":14}|
{"type":"COMPONENT","ticket":100,"id":"902f4e53ca743fca"}||{"partId":"1206CG104J500NT.1","x":2100,"y":-1050,"rotation":0,"isMirror":false,"attrs":{"Footprints":"[]","Devices":"[]","DeviceName":"{\"uuid\":\"e27ef142eae24936\",\"name\":\"1206CG104J500NT\",\"source\":\"\"}","FootprintName":null,"isSwitchClose":false,"pinClass":{},"differentialPairClass":{},"Symbols":"[]"},"zIndex":18}|
{"type":"ATTR","ticket":101,"id":"eb7bd1580fcd3262"}||{"x":null,"y":null,"rotation":0,"color":null,"fontFamily":null,"fontSize":null,"fontWeight":false,"italic":false,"underline":false,"strikeout":false,"align":null,"value":"e3c7f97af9c02e88","keyVisible":null,"valueVisible":null,"key":"Symbol","fillColor":null,"parentId":"902f4e53ca743fca","zIndex":11,"locked":false}|
{"type":"ATTR","ticket":102,"id":"be5e1c43087c680f"}||{"x":null,"y":null,"rotation":null,"color":null,"fontFamily":null,"fontSize":null,"fontWeight":null,"italic":null,"underline":null,"strikeout":false,"align":null,"value":"e27ef142eae24936","keyVisible":null,"valueVisible":null,"key":"Device","fillColor":null,"parentId":"902f4e53ca743fca","zIndex":8}|
{"type":"ATTR","ticket":103,"id":"65fffd7a5183c996"}||{"x":null,"y":null,"rotation":null,"color":null,"fontFamily":null,"fontSize":null,"fontWeight":null,"italic":null,"underline":null,"strikeout":false,"align":null,"value":"gge34","keyVisible":null,"valueVisible":null,"key":"Unique ID","fillColor":null,"parentId":"902f4e53ca743fca","zIndex":13}|
{"type":"ATTR","ticket":104,"id":"fd9927d1c1e1b57f"}||{"x":null,"y":null,"rotation":null,"color":null,"fontFamily":null,"fontSize":null,"fontWeight":null,"italic":null,"underline":null,"strikeout":false,"align":null,"value":"yes","keyVisible":null,"valueVisible":null,"key":"Add into BOM","fillColor":null,"parentId":"902f4e53ca743fca","zIndex":6}|
{"type":"ATTR","ticket":105,"id":"b41b38d0756708fa"}||{"x":null,"y":null,"rotation":null,"color":null,"fontFamily":null,"fontSize":null,"fontWeight":null,"italic":null,"underline":null,"strikeout":false,"align":null,"value":"yes","keyVisible":null,"valueVisible":null,"key":"Convert to PCB","fillColor":null,"parentId":"902f4e53ca743fca","zIndex":7}|
{"type":"ATTR","ticket":106,"id":"35384500169cadfc"}||{"x":2095,"y":-1060,"rotation":0,"color":null,"fontFamily":null,"fontSize":null,"fontWeight":false,"italic":false,"underline":false,"strikeout":false,"align":null,"value":"C9","keyVisible":null,"valueVisible":true,"key":"Designator","fillColor":null,"parentId":"902f4e53ca743fca","zIndex":12,"locked":false}|
{"type":"ATTR","ticket":107,"id":"ec75b8614eca227f"}||{"x":null,"y":null,"rotation":null,"color":null,"fontFamily":null,"fontSize":null,"fontWeight":null,"italic":null,"underline":null,"strikeout":false,"align":null,"value":null,"keyVisible":null,"valueVisible":null,"key":"Footprint","fillColor":null,"parentId":"902f4e53ca743fca","zIndex":9}|
{"type":"ATTR","ticket":108,"id":"39c22fc19ae3fc9c"}||{"x":2095,"y":-1030,"rotation":0,"color":null,"fontFamily":null,"fontSize":null,"fontWeight":null,"italic":null,"underline":null,"align":null,"value":"={Value}","keyVisible":null,"valueVisible":true,"key":"Name","fillColor":null,"parentId":"902f4e53ca743fca","zIndex":14}|
{"type":"ATTR","ticket":109,"id":"1093faef1173bcf2"}||{"x":null,"y":null,"rotation":null,"color":null,"fontFamily":null,"fontSize":null,"fontWeight":null,"italic":null,"underline":null,"align":null,"value":null,"keyVisible":null,"valueVisible":null,"key":"Reuse Block","fillColor":null,"parentId":"902f4e53ca743fca","zIndex":15}|
{"type":"ATTR","ticket":110,"id":"eb747332a4607337"}||{"x":null,"y":null,"rotation":null,"color":null,"fontFamily":null,"fontSize":null,"fontWeight":null,"italic":null,"underline":null,"align":null,"value":null,"keyVisible":null,"valueVisible":null,"key":"Group ID","fillColor":null,"parentId":"902f4e53ca743fca","zIndex":16}|
{"type":"ATTR","ticket":111,"id":"25e22e12c3106cff"}||{"x":null,"y":null,"rotation":null,"color":null,"fontFamily":null,"fontSize":null,"fontWeight":null,"italic":null,"underline":null,"align":null,"value":null,"keyVisible":null,"valueVisible":null,"key":"Channel ID","fillColor":null,"parentId":"902f4e53ca743fca","zIndex":17}|
{"type":"COMPONENT","ticket":112,"id":"d70e53b3866f3ecd"}||{"partId":"0805W8F1002T5E.1","x":2240,"y":-950,"rotation":270,"isMirror":false,"attrs":{"Footprints":"[]","Devices":"[]","DeviceName":"{\"uuid\":\"1193929c9b0386fe\",\"name\":\"0805W8F1002T5E_C17414\",\"source\":\"\"}","FootprintName":null,"isSwitchClose":false,"pinClass":{},"differentialPairClass":{},"Symbols":"[]"},"zIndex":19}|
{"type":"ATTR","ticket":113,"id":"7d2848003a6ca760"}||{"x":null,"y":null,"rotation":0,"color":null,"fontFamily":null,"fontSize":null,"fontWeight":false,"italic":false,"underline":false,"strikeout":false,"align":null,"value":"78edfac15a307052","keyVisible":null,"valueVisible":null,"key":"Symbol","fillColor":null,"parentId":"d70e53b3866f3ecd","zIndex":8,"locked":false}|
{"type":"ATTR","ticket":114,"id":"096ce4dc6e0cc8fe"}||{"x":null,"y":null,"rotation":null,"color":null,"fontFamily":null,"fontSize":null,"fontWeight":null,"italic":null,"underline":null,"strikeout":false,"align":null,"value":"1193929c9b0386fe","keyVisible":null,"valueVisible":null,"key":"Device","fillColor":null,"parentId":"d70e53b3866f3ecd","zIndex":5}|
{"type":"ATTR","ticket":115,"id":"edd55f828d334bbf"}||{"x":null,"y":null,"rotation":null,"color":null,"fontFamily":null,"fontSize":null,"fontWeight":null,"italic":null,"underline":null,"strikeout":false,"align":null,"value":"gge35","keyVisible":null,"valueVisible":null,"key":"Unique ID","fillColor":null,"parentId":"d70e53b3866f3ecd","zIndex":10}|
{"type":"ATTR","ticket":116,"id":"cb815515f7386c41"}||{"x":null,"y":null,"rotation":null,"color":null,"fontFamily":null,"fontSize":null,"fontWeight":null,"italic":null,"underline":null,"strikeout":false,"align":null,"value":"yes","keyVisible":null,"valueVisible":null,"key":"Add into BOM","fillColor":null,"parentId":"d70e53b3866f3ecd","zIndex":3}|
{"type":"ATTR","ticket":117,"id":"71bb70e127cc08e9"}||{"x":null,"y":null,"rotation":null,"color":null,"fontFamily":null,"fontSize":null,"fontWeight":null,"italic":null,"underline":null,"strikeout":false,"align":null,"value":"yes","keyVisible":null,"valueVisible":null,"key":"Convert to PCB","fillColor":null,"parentId":"d70e53b3866f3ecd","zIndex":4}|
{"type":"ATTR","ticket":118,"id":"82af86229263e1bb"}||{"x":2250,"y":-950,"rotation":0,"color":null,"fontFamily":null,"fontSize":null,"fontWeight":false,"italic":false,"underline":false,"strikeout":false,"align":null,"value":"R5","keyVisible":null,"valueVisible":true,"key":"Designator","fillColor":null,"parentId":"d70e53b3866f3ecd","zIndex":9,"locked":false}|
{"type":"ATTR","ticket":119,"id":"6a35460baa9dd35d"}||{"x":null,"y":null,"rotation":null,"color":null,"fontFamily":null,"fontSize":null,"fontWeight":null,"italic":null,"underline":null,"strikeout":false,"align":null,"value":null,"keyVisible":null,"valueVisible":null,"key":"Footprint","fillColor":null,"parentId":"d70e53b3866f3ecd","zIndex":6}|
{"type":"ATTR","ticket":120,"id":"9af017e836d7d5c1"}||{"x":2250,"y":-940,"rotation":0,"color":null,"fontFamily":null,"fontSize":null,"fontWeight":null,"italic":null,"underline":null,"align":null,"value":"={Value}","keyVisible":null,"valueVisible":true,"key":"Name","fillColor":null,"parentId":"d70e53b3866f3ecd","zIndex":11}|
{"type":"ATTR","ticket":121,"id":"5d9b32a51e24ba5a"}||{"x":null,"y":null,"rotation":null,"color":null,"fontFamily":null,"fontSize":null,"fontWeight":null,"italic":null,"underline":null,"align":null,"value":null,"keyVisible":null,"valueVisible":null,"key":"Reuse Block","fillColor":null,"parentId":"d70e53b3866f3ecd","zIndex":12}|
{"type":"ATTR","ticket":122,"id":"c17fb2864723122f"}||{"x":null,"y":null,"rotation":null,"color":null,"fontFamily":null,"fontSize":null,"fontWeight":null,"italic":null,"underline":null,"align":null,"value":null,"keyVisible":null,"valueVisible":null,"key":"Group ID","fillColor":null,"parentId":"d70e53b3866f3ecd","zIndex":13}|
{"type":"ATTR","ticket":123,"id":"dd7f40f21747df47"}||{"x":null,"y":null,"rotation":null,"color":null,"fontFamily":null,"fontSize":null,"fontWeight":null,"italic":null,"underline":null,"align":null,"value":null,"keyVisible":null,"valueVisible":null,"key":"Channel ID","fillColor":null,"parentId":"d70e53b3866f3ecd","zIndex":14}|
{"type":"COMPONENT","ticket":124,"id":"fabf9e67c19f63d3"}||{"partId":"0805W8F3002T5E.1","x":2300,"y":-1150,"rotation":270,"isMirror":false,"attrs":{"Footprints":"[]","Devices":"[]","DeviceName":"{\"uuid\":\"ad0a96b39b5f334c\",\"name\":\"0805W8F3002T5E\",\"source\":\"\"}","FootprintName":null,"isSwitchClose":false,"pinClass":{},"differentialPairClass":{},"Symbols":"[]"},"zIndex":20}|
{"type":"ATTR","ticket":125,"id":"3620e24a4a982611"}||{"x":null,"y":null,"rotation":0,"color":null,"fontFamily":null,"fontSize":null,"fontWeight":false,"italic":false,"underline":false,"strikeout":false,"align":null,"value":"1f3e9c6783a9f463","keyVisible":null,"valueVisible":null,"key":"Symbol","fillColor":null,"parentId":"fabf9e67c19f63d3","zIndex":8,"locked":false}|
{"type":"ATTR","ticket":126,"id":"5bc555c3e603ef8e"}||{"x":null,"y":null,"rotation":null,"color":null,"fontFamily":null,"fontSize":null,"fontWeight":null,"italic":null,"underline":null,"strikeout":false,"align":null,"value":"ad0a96b39b5f334c","keyVisible":null,"valueVisible":null,"key":"Device","fillColor":null,"parentId":"fabf9e67c19f63d3","zIndex":5}|
{"type":"ATTR","ticket":127,"id":"f782b99ef1f0bef1"}||{"x":null,"y":null,"rotation":null,"color":null,"fontFamily":null,"fontSize":null,"fontWeight":null,"italic":null,"underline":null,"strikeout":false,"align":null,"value":"gge36","keyVisible":null,"valueVisible":null,"key":"Unique ID","fillColor":null,"parentId":"fabf9e67c19f63d3","zIndex":10}|
{"type":"ATTR","ticket":128,"id":"b4df78b86507c548"}||{"x":null,"y":null,"rotation":null,"color":null,"fontFamily":null,"fontSize":null,"fontWeight":null,"italic":null,"underline":null,"strikeout":false,"align":null,"value":"yes","keyVisible":null,"valueVisible":null,"key":"Add into BOM","fillColor":null,"parentId":"fabf9e67c19f63d3","zIndex":3}|
{"type":"ATTR","ticket":129,"id":"bfff30c1b365a194"}||{"x":null,"y":null,"rotation":null,"color":null,"fontFamily":null,"fontSize":null,"fontWeight":null,"italic":null,"underline":null,"strikeout":false,"align":null,"value":"yes","keyVisible":null,"valueVisible":null,"key":"Convert to PCB","fillColor":null,"parentId":"fabf9e67c19f63d3","zIndex":4}|
{"type":"ATTR","ticket":130,"id":"4cf166087d7c3ab0"}||{"x":2310,"y":-1150,"rotation":0,"color":null,"fontFamily":null,"fontSize":null,"fontWeight":false,"italic":false,"underline":false,"strikeout":false,"align":null,"value":"R6","keyVisible":null,"valueVisible":true,"key":"Designator","fillColor":null,"parentId":"fabf9e67c19f63d3","zIndex":9,"locked":false}|
{"type":"ATTR","ticket":131,"id":"1873ec2db0a109ba"}||{"x":null,"y":null,"rotation":null,"color":null,"fontFamily":null,"fontSize":null,"fontWeight":null,"italic":null,"underline":null,"strikeout":false,"align":null,"value":null,"keyVisible":null,"valueVisible":null,"key":"Footprint","fillColor":null,"parentId":"fabf9e67c19f63d3","zIndex":6}|
{"type":"ATTR","ticket":132,"id":"53d75ffcf60c160e"}||{"x":2310,"y":-1140,"rotation":0,"color":null,"fontFamily":null,"fontSize":null,"fontWeight":null,"italic":null,"underline":null,"align":null,"value":"={Value}","keyVisible":null,"valueVisible":true,"key":"Name","fillColor":null,"parentId":"fabf9e67c19f63d3","zIndex":11}|
{"type":"ATTR","ticket":133,"id":"365e57e6c70c64c0"}||{"x":null,"y":null,"rotation":null,"color":null,"fontFamily":null,"fontSize":null,"fontWeight":null,"italic":null,"underline":null,"align":null,"value":null,"keyVisible":null,"valueVisible":null,"key":"Reuse Block","fillColor":null,"parentId":"fabf9e67c19f63d3","zIndex":12}|
{"type":"ATTR","ticket":134,"id":"cea72eb835cc940f"}||{"x":null,"y":null,"rotation":null,"color":null,"fontFamily":null,"fontSize":null,"fontWeight":null,"italic":null,"underline":null,"align":null,"value":null,"keyVisible":null,"valueVisible":null,"key":"Group ID","fillColor":null,"parentId":"fabf9e67c19f63d3","zIndex":13}|
{"type":"ATTR","ticket":135,"id":"006b4c9b41d667da"}||{"x":null,"y":null,"rotation":null,"color":null,"fontFamily":null,"fontSize":null,"fontWeight":null,"italic":null,"underline":null,"align":null,"value":null,"keyVisible":null,"valueVisible":null,"key":"Channel ID","fillColor":null,"parentId":"fabf9e67c19f63d3","zIndex":14}|
{"type":"COMPONENT","ticket":136,"id":"9ba8c1a80e6e633e"}||{"partId":"0805W8F1002T5E.1","x":2140,"y":-1250,"rotation":270,"isMirror":false,"attrs":{"Footprints":"[]","Devices":"[]","DeviceName":"{\"uuid\":\"1193929c9b0386fe\",\"name\":\"0805W8F1002T5E_C17414\",\"source\":\"\"}","FootprintName":null,"isSwitchClose":false,"pinClass":{},"differentialPairClass":{},"Symbols":"[]"},"zIndex":21}|
{"type":"ATTR","ticket":137,"id":"eaee63c83e8c8666"}||{"x":null,"y":null,"rotation":0,"color":null,"fontFamily":null,"fontSize":null,"fontWeight":false,"italic":false,"underline":false,"strikeout":false,"align":null,"value":"78edfac15a307052","keyVisible":null,"valueVisible":null,"key":"Symbol","fillColor":null,"parentId":"9ba8c1a80e6e633e","zIndex":8,"locked":false}|
{"type":"ATTR","ticket":138,"id":"4e3642466e9d1f06"}||{"x":null,"y":null,"rotation":null,"color":null,"fontFamily":null,"fontSize":null,"fontWeight":null,"italic":null,"underline":null,"strikeout":false,"align":null,"value":"1193929c9b0386fe","keyVisible":null,"valueVisible":null,"key":"Device","fillColor":null,"parentId":"9ba8c1a80e6e633e","zIndex":5}|
{"type":"ATTR","ticket":139,"id":"10a6597c9c223fb1"}||{"x":null,"y":null,"rotation":null,"color":null,"fontFamily":null,"fontSize":null,"fontWeight":null,"italic":null,"underline":null,"strikeout":false,"align":null,"value":"gge37","keyVisible":null,"valueVisible":null,"key":"Unique ID","fillColor":null,"parentId":"9ba8c1a80e6e633e","zIndex":10}|
{"type":"ATTR","ticket":140,"id":"5501d3ba74d5ceb4"}||{"x":null,"y":null,"rotation":null,"color":null,"fontFamily":null,"fontSize":null,"fontWeight":null,"italic":null,"underline":null,"strikeout":false,"align":null,"value":"yes","keyVisible":null,"valueVisible":null,"key":"Add into BOM","fillColor":null,"parentId":"9ba8c1a80e6e633e","zIndex":3}|
{"type":"ATTR","ticket":141,"id":"54d95a4c7463d4fc"}||{"x":null,"y":null,"rotation":null,"color":null,"fontFamily":null,"fontSize":null,"fontWeight":null,"italic":null,"underline":null,"strikeout":false,"align":null,"value":"yes","keyVisible":null,"valueVisible":null,"key":"Convert to PCB","fillColor":null,"parentId":"9ba8c1a80e6e633e","zIndex":4}|
{"type":"ATTR","ticket":142,"id":"5a544b5120655ad2"}||{"x":2150,"y":-1250,"rotation":0,"color":null,"fontFamily":null,"fontSize":null,"fontWeight":false,"italic":false,"underline":false,"strikeout":false,"align":null,"value":"R7","keyVisible":null,"valueVisible":true,"key":"Designator","fillColor":null,"parentId":"9ba8c1a80e6e633e","zIndex":9,"locked":false}|
{"type":"ATTR","ticket":143,"id":"e79afdde2f84a598"}||{"x":null,"y":null,"rotation":null,"color":null,"fontFamily":null,"fontSize":null,"fontWeight":null,"italic":null,"underline":null,"strikeout":false,"align":null,"value":null,"keyVisible":null,"valueVisible":null,"key":"Footprint","fillColor":null,"parentId":"9ba8c1a80e6e633e","zIndex":6}|
{"type":"ATTR","ticket":144,"id":"7f496dc27c88067c"}||{"x":2150,"y":-1240,"rotation":0,"color":null,"fontFamily":null,"fontSize":null,"fontWeight":null,"italic":null,"underline":null,"align":null,"value":"={Value}","keyVisible":null,"valueVisible":true,"key":"Name","fillColor":null,"parentId":"9ba8c1a80e6e633e","zIndex":11}|
{"type":"ATTR","ticket":145,"id":"3a16b6a2d844e914"}||{"x":null,"y":null,"rotation":null,"color":null,"fontFamily":null,"fontSize":null,"fontWeight":null,"italic":null,"underline":null,"align":null,"value":null,"keyVisible":null,"valueVisible":null,"key":"Reuse Block","fillColor":null,"parentId":"9ba8c1a80e6e633e","zIndex":12}|
{"type":"ATTR","ticket":146,"id":"ab988f6829bd11dc"}||{"x":null,"y":null,"rotation":null,"color":null,"fontFamily":null,"fontSize":null,"fontWeight":null,"italic":null,"underline":null,"align":null,"value":null,"keyVisible":null,"valueVisible":null,"key":"Group ID","fillColor":null,"parentId":"9ba8c1a80e6e633e","zIndex":13}|
{"type":"ATTR","ticket":147,"id":"440111ebfeaf9f41"}||{"x":null,"y":null,"rotation":null,"color":null,"fontFamily":null,"fontSize":null,"fontWeight":null,"italic":null,"underline":null,"align":null,"value":null,"keyVisible":null,"valueVisible":null,"key":"Channel ID","fillColor":null,"parentId":"9ba8c1a80e6e633e","zIndex":14}|
{"type":"COMPONENT","ticket":148,"id":"543633c01b8faf64"}||{"partId":"CL10C471JB8NNNC.1","x":2500,"y":-950,"rotation":270,"isMirror":false,"attrs":{"Footprints":"[]","Devices":"[]","DeviceName":"{\"uuid\":\"6750ffee4edd4a40\",\"name\":\"CL10C471JB8NNNC\",\"source\":\"\"}","FootprintName":null,"isSwitchClose":false,"pinClass":{},"differentialPairClass":{},"Symbols":"[]"},"zIndex":23}|
{"type":"ATTR","ticket":149,"id":"b53393ef0d313716"}||{"x":null,"y":null,"rotation":0,"color":null,"fontFamily":null,"fontSize":null,"fontWeight":false,"italic":false,"underline":false,"strikeout":false,"align":null,"value":"7698a94309577d4d","keyVisible":null,"valueVisible":null,"key":"Symbol","fillColor":null,"parentId":"543633c01b8faf64","zIndex":11,"locked":false}|
{"type":"ATTR","ticket":150,"id":"314e60d2f5d1a8b5"}||{"x":null,"y":null,"rotation":null,"color":null,"fontFamily":null,"fontSize":null,"fontWeight":null,"italic":null,"underline":null,"strikeout":false,"align":null,"value":"6750ffee4edd4a40","keyVisible":null,"valueVisible":null,"key":"Device","fillColor":null,"parentId":"543633c01b8faf64","zIndex":8}|
{"type":"ATTR","ticket":151,"id":"1918e6f3c1bf9593"}||{"x":null,"y":null,"rotation":null,"color":null,"fontFamily":null,"fontSize":null,"fontWeight":null,"italic":null,"underline":null,"strikeout":false,"align":null,"value":"gge38","keyVisible":null,"valueVisible":null,"key":"Unique ID","fillColor":null,"parentId":"543633c01b8faf64","zIndex":13}|
{"type":"ATTR","ticket":152,"id":"55c166e29888e547"}||{"x":null,"y":null,"rotation":null,"color":null,"fontFamily":null,"fontSize":null,"fontWeight":null,"italic":null,"underline":null,"strikeout":false,"align":null,"value":"yes","keyVisible":null,"valueVisible":null,"key":"Add into BOM","fillColor":null,"parentId":"543633c01b8faf64","zIndex":6}|
{"type":"ATTR","ticket":153,"id":"6627fd9f71e222fd"}||{"x":null,"y":null,"rotation":null,"color":null,"fontFamily":null,"fontSize":null,"fontWeight":null,"italic":null,"underline":null,"strikeout":false,"align":null,"value":"yes","keyVisible":null,"valueVisible":null,"key":"Convert to PCB","fillColor":null,"parentId":"543633c01b8faf64","zIndex":7}|
{"type":"ATTR","ticket":154,"id":"80351c370794a4ac"}||{"x":2515,"y":-945,"rotation":0,"color":null,"fontFamily":null,"fontSize":null,"fontWeight":false,"italic":false,"underline":false,"strikeout":false,"align":null,"value":"C10","keyVisible":null,"valueVisible":true,"key":"Designator","fillColor":null,"parentId":"543633c01b8faf64","zIndex":12,"locked":false}|
{"type":"ATTR","ticket":155,"id":"3cc32899a05002be"}||{"x":null,"y":null,"rotation":null,"color":null,"fontFamily":null,"fontSize":null,"fontWeight":null,"italic":null,"underline":null,"strikeout":false,"align":null,"value":null,"keyVisible":null,"valueVisible":null,"key":"Footprint","fillColor":null,"parentId":"543633c01b8faf64","zIndex":9}|
{"type":"ATTR","ticket":156,"id":"2fda4a7167b831fe"}||{"x":2515,"y":-935,"rotation":0,"color":null,"fontFamily":null,"fontSize":null,"fontWeight":null,"italic":null,"underline":null,"align":null,"value":"={Value}","keyVisible":null,"valueVisible":true,"key":"Name","fillColor":null,"parentId":"543633c01b8faf64","zIndex":14}|
{"type":"ATTR","ticket":157,"id":"a7ef3b47dcb5e52d"}||{"x":null,"y":null,"rotation":null,"color":null,"fontFamily":null,"fontSize":null,"fontWeight":null,"italic":null,"underline":null,"align":null,"value":null,"keyVisible":null,"valueVisible":null,"key":"Reuse Block","fillColor":null,"parentId":"543633c01b8faf64","zIndex":15}|
{"type":"ATTR","ticket":158,"id":"cb68fc6d04da4a45"}||{"x":null,"y":null,"rotation":null,"color":null,"fontFamily":null,"fontSize":null,"fontWeight":null,"italic":null,"underline":null,"align":null,"value":null,"keyVisible":null,"valueVisible":null,"key":"Group ID","fillColor":null,"parentId":"543633c01b8faf64","zIndex":16}|
{"type":"ATTR","ticket":159,"id":"b8fdd8ea61820a1d"}||{"x":null,"y":null,"rotation":null,"color":null,"fontFamily":null,"fontSize":null,"fontWeight":null,"italic":null,"underline":null,"align":null,"value":null,"keyVisible":null,"valueVisible":null,"key":"Channel ID","fillColor":null,"parentId":"543633c01b8faf64","zIndex":17}|
{"type":"COMPONENT","ticket":160,"id":"d4cb833c0ea07861"}||{"partId":"0805W8F0000T5E.1","x":2600,"y":-1050,"rotation":0,"isMirror":false,"attrs":{"Footprints":"[]","Devices":"[]","DeviceName":"{\"uuid\":\"bd8833f5dce78d43\",\"name\":\"0805W8F0000T5E\",\"source\":\"\"}","FootprintName":null,"isSwitchClose":false,"pinClass":{},"differentialPairClass":{},"Symbols":"[]"},"zIndex":24}|
{"type":"ATTR","ticket":161,"id":"82b8e77e34c5e469"}||{"x":null,"y":null,"rotation":0,"color":null,"fontFamily":null,"fontSize":null,"fontWeight":false,"italic":false,"underline":false,"strikeout":false,"align":null,"value":"bc12824f5caad1d3","keyVisible":null,"valueVisible":null,"key":"Symbol","fillColor":null,"parentId":"d4cb833c0ea07861","zIndex":8,"locked":false}|
{"type":"ATTR","ticket":162,"id":"9273a87f18f73c92"}||{"x":null,"y":null,"rotation":null,"color":null,"fontFamily":null,"fontSize":null,"fontWeight":null,"italic":null,"underline":null,"strikeout":false,"align":null,"value":"bd8833f5dce78d43","keyVisible":null,"valueVisible":null,"key":"Device","fillColor":null,"parentId":"d4cb833c0ea07861","zIndex":5}|
{"type":"ATTR","ticket":163,"id":"906b1081136adce3"}||{"x":null,"y":null,"rotation":null,"color":null,"fontFamily":null,"fontSize":null,"fontWeight":null,"italic":null,"underline":null,"strikeout":false,"align":null,"value":"gge39","keyVisible":null,"valueVisible":null,"key":"Unique ID","fillColor":null,"parentId":"d4cb833c0ea07861","zIndex":10}|
{"type":"ATTR","ticket":164,"id":"44b092b8d387d0ab"}||{"x":null,"y":null,"rotation":null,"color":null,"fontFamily":null,"fontSize":null,"fontWeight":null,"italic":null,"underline":null,"strikeout":false,"align":null,"value":"yes","keyVisible":null,"valueVisible":null,"key":"Add into BOM","fillColor":null,"parentId":"d4cb833c0ea07861","zIndex":3}|
{"type":"ATTR","ticket":165,"id":"a0ad362e9a08a550"}||{"x":null,"y":null,"rotation":null,"color":null,"fontFamily":null,"fontSize":null,"fontWeight":null,"italic":null,"underline":null,"strikeout":false,"align":null,"value":"yes","keyVisible":null,"valueVisible":null,"key":"Convert to PCB","fillColor":null,"parentId":"d4cb833c0ea07861","zIndex":4}|
{"type":"ATTR","ticket":166,"id":"989d2dd6bc471ebf"}||{"x":2590,"y":-1055,"rotation":0,"color":null,"fontFamily":null,"fontSize":null,"fontWeight":false,"italic":false,"underline":false,"strikeout":false,"align":null,"value":"JP2","keyVisible":null,"valueVisible":true,"key":"Designator","fillColor":null,"parentId":"d4cb833c0ea07861","zIndex":9,"locked":false}|
{"type":"ATTR","ticket":167,"id":"7518fbc23bea61a8"}||{"x":null,"y":null,"rotation":null,"color":null,"fontFamily":null,"fontSize":null,"fontWeight":null,"italic":null,"underline":null,"strikeout":false,"align":null,"value":null,"keyVisible":null,"valueVisible":null,"key":"Footprint","fillColor":null,"parentId":"d4cb833c0ea07861","zIndex":6}|
{"type":"ATTR","ticket":168,"id":"19c40c568a542f4b"}||{"x":2590,"y":-1035,"rotation":0,"color":null,"fontFamily":null,"fontSize":null,"fontWeight":null,"italic":null,"underline":null,"align":null,"value":"={Value}","keyVisible":null,"valueVisible":true,"key":"Name","fillColor":null,"parentId":"d4cb833c0ea07861","zIndex":11}|
{"type":"ATTR","ticket":169,"id":"48d2c02bbe2344b1"}||{"x":null,"y":null,"rotation":null,"color":null,"fontFamily":null,"fontSize":null,"fontWeight":null,"italic":null,"underline":null,"align":null,"value":null,"keyVisible":null,"valueVisible":null,"key":"Reuse Block","fillColor":null,"parentId":"d4cb833c0ea07861","zIndex":12}|
{"type":"ATTR","ticket":170,"id":"c7c3da377ac24f18"}||{"x":null,"y":null,"rotation":null,"color":null,"fontFamily":null,"fontSize":null,"fontWeight":null,"italic":null,"underline":null,"align":null,"value":null,"keyVisible":null,"valueVisible":null,"key":"Group ID","fillColor":null,"parentId":"d4cb833c0ea07861","zIndex":13}|
{"type":"ATTR","ticket":171,"id":"6e37740ac94ce509"}||{"x":null,"y":null,"rotation":null,"color":null,"fontFamily":null,"fontSize":null,"fontWeight":null,"italic":null,"underline":null,"align":null,"value":null,"keyVisible":null,"valueVisible":null,"key":"Channel ID","fillColor":null,"parentId":"d4cb833c0ea07861","zIndex":14}|
{"type":"COMPONENT","ticket":172,"id":"52436a48dda5e32a"}||{"partId":"TAJB226K025RNJ.1","x":180,"y":-1400,"rotation":270,"isMirror":false,"attrs":{"Footprints":"[]","Devices":"[]","DeviceName":"{\"uuid\":\"b3bab7488b9d16de\",\"name\":\"TAJB226K025RNJ\",\"source\":\"\"}","FootprintName":null,"isSwitchClose":false,"pinClass":{},"differentialPairClass":{},"Symbols":"[]"},"zIndex":26}|
{"type":"ATTR","ticket":173,"id":"26a01e056a06e36b"}||{"x":null,"y":null,"rotation":0,"color":null,"fontFamily":null,"fontSize":null,"fontWeight":false,"italic":false,"underline":false,"strikeout":false,"align":null,"value":"c54ac0f7630c9add","keyVisible":null,"valueVisible":null,"key":"Symbol","fillColor":null,"parentId":"52436a48dda5e32a","zIndex":12,"locked":false}|
{"type":"ATTR","ticket":174,"id":"b682b92529a886cf"}||{"x":null,"y":null,"rotation":null,"color":null,"fontFamily":null,"fontSize":null,"fontWeight":null,"italic":null,"underline":null,"strikeout":false,"align":null,"value":"b3bab7488b9d16de","keyVisible":null,"valueVisible":null,"key":"Device","fillColor":null,"parentId":"52436a48dda5e32a","zIndex":9}|
{"type":"ATTR","ticket":175,"id":"f20c5894dafe6154"}||{"x":null,"y":null,"rotation":null,"color":null,"fontFamily":null,"fontSize":null,"fontWeight":null,"italic":null,"underline":null,"strikeout":false,"align":null,"value":"gge41","keyVisible":null,"valueVisible":null,"key":"Unique ID","fillColor":null,"parentId":"52436a48dda5e32a","zIndex":14}|
{"type":"ATTR","ticket":176,"id":"9d8a01b907061e5d"}||{"x":null,"y":null,"rotation":null,"color":null,"fontFamily":null,"fontSize":null,"fontWeight":null,"italic":null,"underline":null,"strikeout":false,"align":null,"value":"yes","keyVisible":null,"valueVisible":null,"key":"Add into BOM","fillColor":null,"parentId":"52436a48dda5e32a","zIndex":7}|
{"type":"ATTR","ticket":177,"id":"c65e88fa0039c9af"}||{"x":null,"y":null,"rotation":null,"color":null,"fontFamily":null,"fontSize":null,"fontWeight":null,"italic":null,"underline":null,"strikeout":false,"align":null,"value":"yes","keyVisible":null,"valueVisible":null,"key":"Convert to PCB","fillColor":null,"parentId":"52436a48dda5e32a","zIndex":8}|
{"type":"ATTR","ticket":178,"id":"03c2016886ce4071"}||{"x":195,"y":-1400,"rotation":0,"color":null,"fontFamily":null,"fontSize":null,"fontWeight":false,"italic":false,"underline":false,"strikeout":false,"align":null,"value":"C11","keyVisible":null,"valueVisible":true,"key":"Designator","fillColor":null,"parentId":"52436a48dda5e32a","zIndex":13,"locked":false}|
{"type":"ATTR","ticket":179,"id":"b210d0fffcc5fae6"}||{"x":null,"y":null,"rotation":null,"color":null,"fontFamily":null,"fontSize":null,"fontWeight":null,"italic":null,"underline":null,"strikeout":false,"align":null,"value":null,"keyVisible":null,"valueVisible":null,"key":"Footprint","fillColor":null,"parentId":"52436a48dda5e32a","zIndex":10}|
{"type":"ATTR","ticket":180,"id":"41e34e033c68602a"}||{"x":195,"y":-1390,"rotation":0,"color":null,"fontFamily":null,"fontSize":null,"fontWeight":null,"italic":null,"underline":null,"align":null,"value":"={Value}","keyVisible":null,"valueVisible":true,"key":"Name","fillColor":null,"parentId":"52436a48dda5e32a","zIndex":15}|
{"type":"ATTR","ticket":181,"id":"33444527b4a4cfc9"}||{"x":null,"y":null,"rotation":null,"color":null,"fontFamily":null,"fontSize":null,"fontWeight":null,"italic":null,"underline":null,"align":null,"value":null,"keyVisible":null,"valueVisible":null,"key":"Reuse Block","fillColor":null,"parentId":"52436a48dda5e32a","zIndex":16}|
{"type":"ATTR","ticket":182,"id":"712896d5ae539eda"}||{"x":null,"y":null,"rotation":null,"color":null,"fontFamily":null,"fontSize":null,"fontWeight":null,"italic":null,"underline":null,"align":null,"value":null,"keyVisible":null,"valueVisible":null,"key":"Group ID","fillColor":null,"parentId":"52436a48dda5e32a","zIndex":17}|
{"type":"ATTR","ticket":183,"id":"58ac199cca071817"}||{"x":null,"y":null,"rotation":null,"color":null,"fontFamily":null,"fontSize":null,"fontWeight":null,"italic":null,"underline":null,"align":null,"value":null,"keyVisible":null,"valueVisible":null,"key":"Channel ID","fillColor":null,"parentId":"52436a48dda5e32a","zIndex":18}|
{"type":"COMPONENT","ticket":184,"id":"ccb547786cab4b13"}||{"partId":"TAJB226K016RNJ.1","x":440,"y":-1400,"rotation":270,"isMirror":false,"attrs":{"Footprints":"[]","Devices":"[]","DeviceName":"{\"uuid\":\"6d28b5b2757afe60\",\"name\":\"TAJB226K016RNJ\",\"source\":\"\"}","FootprintName":null,"isSwitchClose":false,"pinClass":{},"differentialPairClass":{},"Symbols":"[]"},"zIndex":27}|
{"type":"ATTR","ticket":185,"id":"27d771b106b2e105"}||{"x":null,"y":null,"rotation":0,"color":null,"fontFamily":null,"fontSize":null,"fontWeight":false,"italic":false,"underline":false,"strikeout":false,"align":null,"value":"efbca32c2ba27903","keyVisible":null,"valueVisible":null,"key":"Symbol","fillColor":null,"parentId":"ccb547786cab4b13","zIndex":13,"locked":false}|
{"type":"ATTR","ticket":186,"id":"ca380b99019515e9"}||{"x":null,"y":null,"rotation":null,"color":null,"fontFamily":null,"fontSize":null,"fontWeight":null,"italic":null,"underline":null,"strikeout":false,"align":null,"value":"6d28b5b2757afe60","keyVisible":null,"valueVisible":null,"key":"Device","fillColor":null,"parentId":"ccb547786cab4b13","zIndex":10}|
{"type":"ATTR","ticket":187,"id":"fec9bca2048d985d"}||{"x":null,"y":null,"rotation":null,"color":null,"fontFamily":null,"fontSize":null,"fontWeight":null,"italic":null,"underline":null,"strikeout":false,"align":null,"value":"gge42","keyVisible":null,"valueVisible":null,"key":"Unique ID","fillColor":null,"parentId":"ccb547786cab4b13","zIndex":15}|
{"type":"ATTR","ticket":188,"id":"aa55d6a6c75888fa"}||{"x":null,"y":null,"rotation":null,"color":null,"fontFamily":null,"fontSize":null,"fontWeight":null,"italic":null,"underline":null,"strikeout":false,"align":null,"value":"yes","keyVisible":null,"valueVisible":null,"key":"Add into BOM","fillColor":null,"parentId":"ccb547786cab4b13","zIndex":8}|
{"type":"ATTR","ticket":189,"id":"064e6539b6be3767"}||{"x":null,"y":null,"rotation":null,"color":null,"fontFamily":null,"fontSize":null,"fontWeight":null,"italic":null,"underline":null,"strikeout":false,"align":null,"value":"yes","keyVisible":null,"valueVisible":null,"key":"Convert to PCB","fillColor":null,"parentId":"ccb547786cab4b13","zIndex":9}|
{"type":"ATTR","ticket":190,"id":"e5f7f3fb92604024"}||{"x":455,"y":-1395,"rotation":0,"color":null,"fontFamily":null,"fontSize":null,"fontWeight":false,"italic":false,"underline":false,"strikeout":false,"align":null,"value":"C12","keyVisible":null,"valueVisible":true,"key":"Designator","fillColor":null,"parentId":"ccb547786cab4b13","zIndex":14,"locked":false}|
{"type":"ATTR","ticket":191,"id":"add12b548ad05624"}||{"x":null,"y":null,"rotation":null,"color":null,"fontFamily":null,"fontSize":null,"fontWeight":null,"italic":null,"underline":null,"strikeout":false,"align":null,"value":null,"keyVisible":null,"valueVisible":null,"key":"Footprint","fillColor":null,"parentId":"ccb547786cab4b13","zIndex":11}|
{"type":"ATTR","ticket":192,"id":"424d2dcc9f79bd4a"}||{"x":455,"y":-1385,"rotation":0,"color":null,"fontFamily":null,"fontSize":null,"fontWeight":null,"italic":null,"underline":null,"align":null,"value":"={Value}","keyVisible":null,"valueVisible":true,"key":"Name","fillColor":null,"parentId":"ccb547786cab4b13","zIndex":16}|
{"type":"ATTR","ticket":193,"id":"8cee4b7f4fd2830c"}||{"x":null,"y":null,"rotation":null,"color":null,"fontFamily":null,"fontSize":null,"fontWeight":null,"italic":null,"underline":null,"align":null,"value":null,"keyVisible":null,"valueVisible":null,"key":"Reuse Block","fillColor":null,"parentId":"ccb547786cab4b13","zIndex":17}|
{"type":"ATTR","ticket":194,"id":"9aa0cf9f9760f340"}||{"x":null,"y":null,"rotation":null,"color":null,"fontFamily":null,"fontSize":null,"fontWeight":null,"italic":null,"underline":null,"align":null,"value":null,"keyVisible":null,"valueVisible":null,"key":"Group ID","fillColor":null,"parentId":"ccb547786cab4b13","zIndex":18}|
{"type":"ATTR","ticket":195,"id":"bfe6f68d13400726"}||{"x":null,"y":null,"rotation":null,"color":null,"fontFamily":null,"fontSize":null,"fontWeight":null,"italic":null,"underline":null,"align":null,"value":null,"keyVisible":null,"valueVisible":null,"key":"Channel ID","fillColor":null,"parentId":"ccb547786cab4b13","zIndex":19}|
{"type":"COMPONENT","ticket":196,"id":"d8f676ef6cd3bd61"}||{"partId":"0805W8F1002T5E.1","x":560,"y":-1290,"rotation":270,"isMirror":false,"attrs":{"Footprints":"[]","Devices":"[]","DeviceName":"{\"uuid\":\"1193929c9b0386fe\",\"name\":\"0805W8F1002T5E_C17414\",\"source\":\"\"}","FootprintName":null,"isSwitchClose":false,"pinClass":{},"differentialPairClass":{},"Symbols":"[]"},"zIndex":28}|
{"type":"ATTR","ticket":197,"id":"cb2dafecb4c0a538"}||{"x":null,"y":null,"rotation":0,"color":null,"fontFamily":null,"fontSize":null,"fontWeight":false,"italic":false,"underline":false,"strikeout":false,"align":null,"value":"78edfac15a307052","keyVisible":null,"valueVisible":null,"key":"Symbol","fillColor":null,"parentId":"d8f676ef6cd3bd61","zIndex":8,"locked":false}|
{"type":"ATTR","ticket":198,"id":"811f592abc4c748e"}||{"x":null,"y":null,"rotation":null,"color":null,"fontFamily":null,"fontSize":null,"fontWeight":null,"italic":null,"underline":null,"strikeout":false,"align":null,"value":"1193929c9b0386fe","keyVisible":null,"valueVisible":null,"key":"Device","fillColor":null,"parentId":"d8f676ef6cd3bd61","zIndex":5}|
{"type":"ATTR","ticket":199,"id":"6f24b0edf398e3a7"}||{"x":null,"y":null,"rotation":null,"color":null,"fontFamily":null,"fontSize":null,"fontWeight":null,"italic":null,"underline":null,"strikeout":false,"align":null,"value":"gge43","keyVisible":null,"valueVisible":null,"key":"Unique ID","fillColor":null,"parentId":"d8f676ef6cd3bd61","zIndex":10}|
{"type":"ATTR","ticket":200,"id":"894eb7cbc9feb3ad"}||{"x":null,"y":null,"rotation":null,"color":null,"fontFamily":null,"fontSize":null,"fontWeight":null,"italic":null,"underline":null,"strikeout":false,"align":null,"value":"yes","keyVisible":null,"valueVisible":null,"key":"Add into BOM","fillColor":null,"parentId":"d8f676ef6cd3bd61","zIndex":3}|
{"type":"ATTR","ticket":201,"id":"c6969bbc77d487ef"}||{"x":null,"y":null,"rotation":null,"color":null,"fontFamily":null,"fontSize":null,"fontWeight":null,"italic":null,"underline":null,"strikeout":false,"align":null,"value":"yes","keyVisible":null,"valueVisible":null,"key":"Convert to PCB","fillColor":null,"parentId":"d8f676ef6cd3bd61","zIndex":4}|
{"type":"ATTR","ticket":202,"id":"5b22c691b1aa5b99"}||{"x":570,"y":-1290,"rotation":0,"color":null,"fontFamily":null,"fontSize":null,"fontWeight":false,"italic":false,"underline":false,"strikeout":false,"align":null,"value":"R9","keyVisible":null,"valueVisible":true,"key":"Designator","fillColor":null,"parentId":"d8f676ef6cd3bd61","zIndex":9,"locked":false}|
{"type":"ATTR","ticket":203,"id":"07c753f39c51c306"}||{"x":null,"y":null,"rotation":null,"color":null,"fontFamily":null,"fontSize":null,"fontWeight":null,"italic":null,"underline":null,"strikeout":false,"align":null,"value":null,"keyVisible":null,"valueVisible":null,"key":"Footprint","fillColor":null,"parentId":"d8f676ef6cd3bd61","zIndex":6}|
{"type":"ATTR","ticket":204,"id":"838a193eb1f1150b"}||{"x":570,"y":-1280,"rotation":0,"color":null,"fontFamily":null,"fontSize":null,"fontWeight":null,"italic":null,"underline":null,"align":null,"value":"={Value}","keyVisible":null,"valueVisible":true,"key":"Name","fillColor":null,"parentId":"d8f676ef6cd3bd61","zIndex":11}|
{"type":"ATTR","ticket":205,"id":"85cb0f5d39080dc2"}||{"x":null,"y":null,"rotation":null,"color":null,"fontFamily":null,"fontSize":null,"fontWeight":null,"italic":null,"underline":null,"align":null,"value":null,"keyVisible":null,"valueVisible":null,"key":"Reuse Block","fillColor":null,"parentId":"d8f676ef6cd3bd61","zIndex":12}|
{"type":"ATTR","ticket":206,"id":"8b6365579af72d86"}||{"x":null,"y":null,"rotation":null,"color":null,"fontFamily":null,"fontSize":null,"fontWeight":null,"italic":null,"underline":null,"align":null,"value":null,"keyVisible":null,"valueVisible":null,"key":"Group ID","fillColor":null,"parentId":"d8f676ef6cd3bd61","zIndex":13}|
{"type":"ATTR","ticket":207,"id":"4251c3d2a79c52f0"}||{"x":null,"y":null,"rotation":null,"color":null,"fontFamily":null,"fontSize":null,"fontWeight":null,"italic":null,"underline":null,"align":null,"value":null,"keyVisible":null,"valueVisible":null,"key":"Channel ID","fillColor":null,"parentId":"d8f676ef6cd3bd61","zIndex":14}|
{"type":"COMPONENT","ticket":208,"id":"e584c449c600ff04"}||{"partId":"0805W8F1002T5E.1","x":560,"y":-1170,"rotation":270,"isMirror":false,"attrs":{"Footprints":"[]","Devices":"[]","DeviceName":"{\"uuid\":\"1193929c9b0386fe\",\"name\":\"0805W8F1002T5E_C17414\",\"source\":\"\"}","FootprintName":null,"isSwitchClose":false,"pinClass":{},"differentialPairClass":{},"Symbols":"[]"},"zIndex":29}|
{"type":"ATTR","ticket":209,"id":"dea2a2268d91c03f"}||{"x":null,"y":null,"rotation":0,"color":null,"fontFamily":null,"fontSize":null,"fontWeight":false,"italic":false,"underline":false,"strikeout":false,"align":null,"value":"78edfac15a307052","keyVisible":null,"valueVisible":null,"key":"Symbol","fillColor":null,"parentId":"e584c449c600ff04","zIndex":8,"locked":false}|
{"type":"ATTR","ticket":210,"id":"a251720ce4258981"}||{"x":null,"y":null,"rotation":null,"color":null,"fontFamily":null,"fontSize":null,"fontWeight":null,"italic":null,"underline":null,"strikeout":false,"align":null,"value":"1193929c9b0386fe","keyVisible":null,"valueVisible":null,"key":"Device","fillColor":null,"parentId":"e584c449c600ff04","zIndex":5}|
{"type":"ATTR","ticket":211,"id":"e59d2f0c1cadfd5d"}||{"x":null,"y":null,"rotation":null,"color":null,"fontFamily":null,"fontSize":null,"fontWeight":null,"italic":null,"underline":null,"strikeout":false,"align":null,"value":"gge44","keyVisible":null,"valueVisible":null,"key":"Unique ID","fillColor":null,"parentId":"e584c449c600ff04","zIndex":10}|
{"type":"ATTR","ticket":212,"id":"0b91ab8392648794"}||{"x":null,"y":null,"rotation":null,"color":null,"fontFamily":null,"fontSize":null,"fontWeight":null,"italic":null,"underline":null,"strikeout":false,"align":null,"value":"yes","keyVisible":null,"valueVisible":null,"key":"Add into BOM","fillColor":null,"parentId":"e584c449c600ff04","zIndex":3}|
{"type":"ATTR","ticket":213,"id":"7d133575c3bea70c"}||{"x":null,"y":null,"rotation":null,"color":null,"fontFamily":null,"fontSize":null,"fontWeight":null,"italic":null,"underline":null,"strikeout":false,"align":null,"value":"yes","keyVisible":null,"valueVisible":null,"key":"Convert to PCB","fillColor":null,"parentId":"e584c449c600ff04","zIndex":4}|
{"type":"ATTR","ticket":214,"id":"fba1cec031771092"}||{"x":570,"y":-1170,"rotation":0,"color":null,"fontFamily":null,"fontSize":null,"fontWeight":false,"italic":false,"underline":false,"strikeout":false,"align":null,"value":"R10","keyVisible":null,"valueVisible":true,"key":"Designator","fillColor":null,"parentId":"e584c449c600ff04","zIndex":9,"locked":false}|
{"type":"ATTR","ticket":215,"id":"562069d918a9a7f8"}||{"x":null,"y":null,"rotation":null,"color":null,"fontFamily":null,"fontSize":null,"fontWeight":null,"italic":null,"underline":null,"strikeout":false,"align":null,"value":null,"keyVisible":null,"valueVisible":null,"key":"Footprint","fillColor":null,"parentId":"e584c449c600ff04","zIndex":6}|
{"type":"ATTR","ticket":216,"id":"bcfe5a8b97d04ff0"}||{"x":570,"y":-1160,"rotation":0,"color":null,"fontFamily":null,"fontSize":null,"fontWeight":null,"italic":null,"underline":null,"align":null,"value":"={Value}","keyVisible":null,"valueVisible":true,"key":"Name","fillColor":null,"parentId":"e584c449c600ff04","zIndex":11}|
{"type":"ATTR","ticket":217,"id":"ee2df977e34ae5c9"}||{"x":null,"y":null,"rotation":null,"color":null,"fontFamily":null,"fontSize":null,"fontWeight":null,"italic":null,"underline":null,"align":null,"value":null,"keyVisible":null,"valueVisible":null,"key":"Reuse Block","fillColor":null,"parentId":"e584c449c600ff04","zIndex":12}|
{"type":"ATTR","ticket":218,"id":"dbf8b318bc1bf2c1"}||{"x":null,"y":null,"rotation":null,"color":null,"fontFamily":null,"fontSize":null,"fontWeight":null,"italic":null,"underline":null,"align":null,"value":null,"keyVisible":null,"valueVisible":null,"key":"Group ID","fillColor":null,"parentId":"e584c449c600ff04","zIndex":13}|
{"type":"ATTR","ticket":219,"id":"26fe45596d27bf67"}||{"x":null,"y":null,"rotation":null,"color":null,"fontFamily":null,"fontSize":null,"fontWeight":null,"italic":null,"underline":null,"align":null,"value":null,"keyVisible":null,"valueVisible":null,"key":"Channel ID","fillColor":null,"parentId":"e584c449c600ff04","zIndex":14}|
{"type":"COMPONENT","ticket":220,"id":"db09da3f021abb4e"}||{"partId":"CL21A106KAYNNNE.1","x":660,"y":-1230,"rotation":270,"isMirror":false,"attrs":{"Footprints":"[]","Devices":"[]","DeviceName":"{\"uuid\":\"3fda423064a81420\",\"name\":\"CL21A106KAYNNNE_C15850\",\"source\":\"\"}","FootprintName":null,"isSwitchClose":false,"pinClass":{},"differentialPairClass":{},"Symbols":"[]"},"zIndex":30}|
{"type":"ATTR","ticket":221,"id":"fee52afe43d157e0"}||{"x":null,"y":null,"rotation":0,"color":null,"fontFamily":null,"fontSize":null,"fontWeight":false,"italic":false,"underline":false,"strikeout":false,"align":null,"value":"ca469c7322005c01","keyVisible":null,"valueVisible":null,"key":"Symbol","fillColor":null,"parentId":"db09da3f021abb4e","zIndex":11,"locked":false}|
{"type":"ATTR","ticket":222,"id":"611bc5c0880df7a4"}||{"x":null,"y":null,"rotation":null,"color":null,"fontFamily":null,"fontSize":null,"fontWeight":null,"italic":null,"underline":null,"strikeout":false,"align":null,"value":"3fda423064a81420","keyVisible":null,"valueVisible":null,"key":"Device","fillColor":null,"parentId":"db09da3f021abb4e","zIndex":8}|
{"type":"ATTR","ticket":223,"id":"d80cfb4e882fba4d"}||{"x":null,"y":null,"rotation":null,"color":null,"fontFamily":null,"fontSize":null,"fontWeight":null,"italic":null,"underline":null,"strikeout":false,"align":null,"value":"gge45","keyVisible":null,"valueVisible":null,"key":"Unique ID","fillColor":null,"parentId":"db09da3f021abb4e","zIndex":13}|
{"type":"ATTR","ticket":224,"id":"afb926c12d4cca6f"}||{"x":null,"y":null,"rotation":null,"color":null,"fontFamily":null,"fontSize":null,"fontWeight":null,"italic":null,"underline":null,"strikeout":false,"align":null,"value":"yes","keyVisible":null,"valueVisible":null,"key":"Add into BOM","fillColor":null,"parentId":"db09da3f021abb4e","zIndex":6}|
{"type":"ATTR","ticket":225,"id":"9368171752ef026d"}||{"x":null,"y":null,"rotation":null,"color":null,"fontFamily":null,"fontSize":null,"fontWeight":null,"italic":null,"underline":null,"strikeout":false,"align":null,"value":"yes","keyVisible":null,"valueVisible":null,"key":"Convert to PCB","fillColor":null,"parentId":"db09da3f021abb4e","zIndex":7}|
{"type":"ATTR","ticket":226,"id":"0075dc28cc3f7d88"}||{"x":675,"y":-1230,"rotation":0,"color":null,"fontFamily":null,"fontSize":null,"fontWeight":false,"italic":false,"underline":false,"strikeout":false,"align":null,"value":"C13","keyVisible":null,"valueVisible":true,"key":"Designator","fillColor":null,"parentId":"db09da3f021abb4e","zIndex":12,"locked":false}|
{"type":"ATTR","ticket":227,"id":"d0d09b690b5a4fd1"}||{"x":null,"y":null,"rotation":null,"color":null,"fontFamily":null,"fontSize":null,"fontWeight":null,"italic":null,"underline":null,"align":null,"value":"","keyVisible":null,"valueVisible":null,"key":"LCSC Part Name","fillColor":null,"parentId":"db09da3f021abb4e","zIndex":14}|
{"type":"ATTR","ticket":228,"id":"e0112a10b181ee80"}||{"x":null,"y":null,"rotation":null,"color":null,"fontFamily":null,"fontSize":null,"fontWeight":null,"italic":null,"underline":null,"align":null,"value":"CL21A106KAYNNNE.1","keyVisible":null,"valueVisible":null,"key":"Supplier Part","fillColor":null,"parentId":"db09da3f021abb4e","zIndex":15}|
{"type":"ATTR","ticket":229,"id":"e49f4530c58854f0"}||{"x":null,"y":null,"rotation":null,"color":null,"fontFamily":null,"fontSize":null,"fontWeight":null,"italic":null,"underline":null,"align":null,"value":"SAMSUNG(三星)","keyVisible":null,"valueVisible":null,"key":"Manufacturer","fillColor":null,"parentId":"db09da3f021abb4e","zIndex":16}|
{"type":"ATTR","ticket":230,"id":"76c8108b54531f87"}||{"x":null,"y":null,"rotation":null,"color":null,"fontFamily":null,"fontSize":null,"fontWeight":null,"italic":null,"underline":null,"align":null,"value":"CL21A106KAYNNNE","keyVisible":null,"valueVisible":null,"key":"Manufacturer Part","fillColor":null,"parentId":"db09da3f021abb4e","zIndex":17}|
{"type":"ATTR","ticket":231,"id":"c9b493f20aad0ffd"}||{"x":null,"y":null,"rotation":null,"color":null,"fontFamily":null,"fontSize":null,"fontWeight":null,"italic":null,"underline":null,"align":null,"value":"","keyVisible":null,"valueVisible":null,"key":"Supplier Footprint","fillColor":null,"parentId":"db09da3f021abb4e","zIndex":18}|
{"type":"ATTR","ticket":232,"id":"96701121577432e0"}||{"x":null,"y":null,"rotation":null,"color":null,"fontFamily":null,"fontSize":null,"fontWeight":null,"italic":null,"underline":null,"align":null,"value":"","keyVisible":null,"valueVisible":null,"key":"JLCPCB Part Class","fillColor":null,"parentId":"db09da3f021abb4e","zIndex":19}|
{"type":"ATTR","ticket":233,"id":"7b7177b28c9e1ee8"}||{"x":null,"y":null,"rotation":null,"color":null,"fontFamily":null,"fontSize":null,"fontWeight":null,"italic":null,"underline":null,"align":null,"value":"","keyVisible":null,"valueVisible":null,"key":"Datasheet","fillColor":null,"parentId":"db09da3f021abb4e","zIndex":20}|
{"type":"ATTR","ticket":234,"id":"b9451d4ce0c0dae0"}||{"x":null,"y":null,"rotation":null,"color":null,"fontFamily":null,"fontSize":null,"fontWeight":null,"italic":null,"underline":null,"align":null,"value":"LCSC","keyVisible":null,"valueVisible":null,"key":"Supplier","fillColor":null,"parentId":"db09da3f021abb4e","zIndex":21}|
{"type":"ATTR","ticket":235,"id":"e47d5c7a821afcbe"}||{"x":null,"y":null,"rotation":null,"color":null,"fontFamily":null,"fontSize":null,"fontWeight":null,"italic":null,"underline":null,"strikeout":false,"align":null,"value":null,"keyVisible":null,"valueVisible":null,"key":"Footprint","fillColor":null,"parentId":"db09da3f021abb4e","zIndex":9}|
{"type":"ATTR","ticket":236,"id":"603ddaa557c4a75c"}||{"x":null,"y":null,"rotation":null,"color":null,"fontFamily":null,"fontSize":null,"fontWeight":null,"italic":null,"underline":null,"align":null,"value":null,"keyVisible":null,"valueVisible":null,"key":"3D Model","fillColor":null,"parentId":"db09da3f021abb4e","zIndex":22}|
{"type":"ATTR","ticket":237,"id":"d27916ead45984c9"}||{"x":null,"y":null,"rotation":null,"color":null,"fontFamily":null,"fontSize":null,"fontWeight":null,"italic":null,"underline":null,"align":null,"value":null,"keyVisible":null,"valueVisible":null,"key":"3D Model Title","fillColor":null,"parentId":"db09da3f021abb4e","zIndex":23}|
{"type":"ATTR","ticket":238,"id":"258516ef7b272064"}||{"x":null,"y":null,"rotation":null,"color":null,"fontFamily":null,"fontSize":null,"fontWeight":null,"italic":null,"underline":null,"align":null,"value":null,"keyVisible":null,"valueVisible":null,"key":"3D Model Transform","fillColor":null,"parentId":"db09da3f021abb4e","zIndex":24}|
{"type":"ATTR","ticket":239,"id":"5cd3fb2a37a6f1a1"}||{"x":null,"y":null,"rotation":null,"color":null,"fontFamily":null,"fontSize":null,"fontWeight":null,"italic":null,"underline":null,"align":null,"value":"10uF","keyVisible":null,"valueVisible":null,"key":"Value","fillColor":null,"parentId":"db09da3f021abb4e","zIndex":25}|
{"type":"ATTR","ticket":240,"id":"ae2a9c0d51660100"}||{"x":null,"y":null,"rotation":null,"color":null,"fontFamily":null,"fontSize":null,"fontWeight":null,"italic":null,"underline":null,"align":null,"value":"","keyVisible":null,"valueVisible":null,"key":"Tolerance","fillColor":null,"parentId":"db09da3f021abb4e","zIndex":26}|
{"type":"ATTR","ticket":241,"id":"8e98f872e0d79093"}||{"x":null,"y":null,"rotation":null,"color":null,"fontFamily":null,"fontSize":null,"fontWeight":null,"italic":null,"underline":null,"align":null,"value":"","keyVisible":null,"valueVisible":null,"key":"Voltage Rating","fillColor":null,"parentId":"db09da3f021abb4e","zIndex":27}|
{"type":"ATTR","ticket":242,"id":"a34f35b513282a11"}||{"x":null,"y":null,"rotation":null,"color":null,"fontFamily":null,"fontSize":null,"fontWeight":null,"italic":null,"underline":null,"align":null,"value":"","keyVisible":null,"valueVisible":null,"key":"Temperature Coefficient","fillColor":null,"parentId":"db09da3f021abb4e","zIndex":28}|
{"type":"ATTR","ticket":243,"id":"dc3d79dcd10feef6"}||{"x":675,"y":-1220,"rotation":0,"color":null,"fontFamily":null,"fontSize":null,"fontWeight":null,"italic":null,"underline":null,"align":null,"value":"={Value}","keyVisible":null,"valueVisible":true,"key":"Name","fillColor":null,"parentId":"db09da3f021abb4e","zIndex":29}|
{"type":"ATTR","ticket":244,"id":"c051c597821799b3"}||{"x":null,"y":null,"rotation":null,"color":null,"fontFamily":null,"fontSize":null,"fontWeight":null,"italic":null,"underline":null,"align":null,"value":"","keyVisible":null,"valueVisible":null,"key":"Description","fillColor":null,"parentId":"db09da3f021abb4e","zIndex":30}|
{"type":"ATTR","ticket":245,"id":"00bfb6f21904e88a"}||{"x":null,"y":null,"rotation":null,"color":null,"fontFamily":null,"fontSize":null,"fontWeight":null,"italic":null,"underline":null,"align":null,"value":null,"keyVisible":null,"valueVisible":null,"key":"Reuse Block","fillColor":null,"parentId":"db09da3f021abb4e","zIndex":31}|
{"type":"ATTR","ticket":246,"id":"ee75aff692e03cd9"}||{"x":null,"y":null,"rotation":null,"color":null,"fontFamily":null,"fontSize":null,"fontWeight":null,"italic":null,"underline":null,"align":null,"value":null,"keyVisible":null,"valueVisible":null,"key":"Group ID","fillColor":null,"parentId":"db09da3f021abb4e","zIndex":32}|
{"type":"ATTR","ticket":247,"id":"c252a2dd3b4dadb8"}||{"x":null,"y":null,"rotation":null,"color":null,"fontFamily":null,"fontSize":null,"fontWeight":null,"italic":null,"underline":null,"align":null,"value":null,"keyVisible":null,"valueVisible":null,"key":"Channel ID","fillColor":null,"parentId":"db09da3f021abb4e","zIndex":33}|
{"type":"COMPONENT","ticket":248,"id":"9bbe4bfab212f226"}||{"partId":"0805W8F0000T5E.1","x":760,"y":-1290,"rotation":270,"isMirror":false,"attrs":{"Footprints":"[]","Devices":"[]","DeviceName":"{\"uuid\":\"bd8833f5dce78d43\",\"name\":\"0805W8F0000T5E\",\"source\":\"\"}","FootprintName":null,"isSwitchClose":false,"pinClass":{},"differentialPairClass":{},"Symbols":"[]"},"zIndex":31}|
{"type":"ATTR","ticket":249,"id":"152faade62d7f24c"}||{"x":null,"y":null,"rotation":0,"color":null,"fontFamily":null,"fontSize":null,"fontWeight":false,"italic":false,"underline":false,"strikeout":false,"align":null,"value":"bc12824f5caad1d3","keyVisible":null,"valueVisible":null,"key":"Symbol","fillColor":null,"parentId":"9bbe4bfab212f226","zIndex":8,"locked":false}|
{"type":"ATTR","ticket":250,"id":"07ccbbd0b0bd5a87"}||{"x":null,"y":null,"rotation":null,"color":null,"fontFamily":null,"fontSize":null,"fontWeight":null,"italic":null,"underline":null,"strikeout":false,"align":null,"value":"bd8833f5dce78d43","keyVisible":null,"valueVisible":null,"key":"Device","fillColor":null,"parentId":"9bbe4bfab212f226","zIndex":5}|
{"type":"ATTR","ticket":251,"id":"d4598703fe86dc0d"}||{"x":null,"y":null,"rotation":null,"color":null,"fontFamily":null,"fontSize":null,"fontWeight":null,"italic":null,"underline":null,"strikeout":false,"align":null,"value":"gge46","keyVisible":null,"valueVisible":null,"key":"Unique ID","fillColor":null,"parentId":"9bbe4bfab212f226","zIndex":10}|
{"type":"ATTR","ticket":252,"id":"79b599eee8065776"}||{"x":null,"y":null,"rotation":null,"color":null,"fontFamily":null,"fontSize":null,"fontWeight":null,"italic":null,"underline":null,"strikeout":false,"align":null,"value":"yes","keyVisible":null,"valueVisible":null,"key":"Add into BOM","fillColor":null,"parentId":"9bbe4bfab212f226","zIndex":3}|
{"type":"ATTR","ticket":253,"id":"c71ce5dfed69602e"}||{"x":null,"y":null,"rotation":null,"color":null,"fontFamily":null,"fontSize":null,"fontWeight":null,"italic":null,"underline":null,"strikeout":false,"align":null,"value":"yes","keyVisible":null,"valueVisible":null,"key":"Convert to PCB","fillColor":null,"parentId":"9bbe4bfab212f226","zIndex":4}|
{"type":"ATTR","ticket":254,"id":"683ba6b7ac9bbcf9"}||{"x":770,"y":-1290,"rotation":0,"color":null,"fontFamily":null,"fontSize":null,"fontWeight":false,"italic":false,"underline":false,"strikeout":false,"align":null,"value":"JP3","keyVisible":null,"valueVisible":true,"key":"Designator","fillColor":null,"parentId":"9bbe4bfab212f226","zIndex":9,"locked":false}|
{"type":"ATTR","ticket":255,"id":"f85d28dd6280c9fa"}||{"x":null,"y":null,"rotation":null,"color":null,"fontFamily":null,"fontSize":null,"fontWeight":null,"italic":null,"underline":null,"strikeout":false,"align":null,"value":null,"keyVisible":null,"valueVisible":null,"key":"Footprint","fillColor":null,"parentId":"9bbe4bfab212f226","zIndex":6}|
{"type":"ATTR","ticket":256,"id":"46a6116d20fb2ce7"}||{"x":770,"y":-1280,"rotation":0,"color":null,"fontFamily":null,"fontSize":null,"fontWeight":null,"italic":null,"underline":null,"align":null,"value":"={Value}","keyVisible":null,"valueVisible":true,"key":"Name","fillColor":null,"parentId":"9bbe4bfab212f226","zIndex":11}|
{"type":"ATTR","ticket":257,"id":"6955292b907e4903"}||{"x":null,"y":null,"rotation":null,"color":null,"fontFamily":null,"fontSize":null,"fontWeight":null,"italic":null,"underline":null,"align":null,"value":null,"keyVisible":null,"valueVisible":null,"key":"Reuse Block","fillColor":null,"parentId":"9bbe4bfab212f226","zIndex":12}|
{"type":"ATTR","ticket":258,"id":"74b9e9990fffad14"}||{"x":null,"y":null,"rotation":null,"color":null,"fontFamily":null,"fontSize":null,"fontWeight":null,"italic":null,"underline":null,"align":null,"value":null,"keyVisible":null,"valueVisible":null,"key":"Group ID","fillColor":null,"parentId":"9bbe4bfab212f226","zIndex":13}|
{"type":"ATTR","ticket":259,"id":"17c62297c4c25217"}||{"x":null,"y":null,"rotation":null,"color":null,"fontFamily":null,"fontSize":null,"fontWeight":null,"italic":null,"underline":null,"align":null,"value":null,"keyVisible":null,"valueVisible":null,"key":"Channel ID","fillColor":null,"parentId":"9bbe4bfab212f226","zIndex":14}|
{"type":"COMPONENT","ticket":260,"id":"e080acf526ade866"}||{"partId":"TP-黄色测试点.1","x":340,"y":-850,"rotation":0,"isMirror":false,"attrs":{"Footprints":"[]","Devices":"[]","DeviceName":"{\"uuid\":\"898e6d6b826629a1\",\"name\":\"TP-黄色测试点\",\"source\":\"\"}","FootprintName":null,"isSwitchClose":false,"pinClass":{},"differentialPairClass":{},"Symbols":"[]"},"zIndex":33}|
{"type":"ATTR","ticket":261,"id":"ac851bcecaa84e10"}||{"x":null,"y":null,"rotation":0,"color":null,"fontFamily":null,"fontSize":null,"fontWeight":false,"italic":false,"underline":false,"strikeout":false,"align":null,"value":"7058a89e7066cfa0","keyVisible":null,"valueVisible":null,"key":"Symbol","fillColor":null,"parentId":"e080acf526ade866","zIndex":8,"locked":false}|
{"type":"ATTR","ticket":262,"id":"942b07d19b5deb6d"}||{"x":null,"y":null,"rotation":null,"color":null,"fontFamily":null,"fontSize":null,"fontWeight":null,"italic":null,"underline":null,"strikeout":false,"align":null,"value":"898e6d6b826629a1","keyVisible":null,"valueVisible":null,"key":"Device","fillColor":null,"parentId":"e080acf526ade866","zIndex":5}|
{"type":"ATTR","ticket":263,"id":"209059cde407e28d"}||{"x":null,"y":null,"rotation":null,"color":null,"fontFamily":null,"fontSize":null,"fontWeight":null,"italic":null,"underline":null,"strikeout":false,"align":null,"value":"gge48","keyVisible":null,"valueVisible":null,"key":"Unique ID","fillColor":null,"parentId":"e080acf526ade866","zIndex":10}|
{"type":"ATTR","ticket":264,"id":"f7d613ec17a8601e"}||{"x":null,"y":null,"rotation":null,"color":null,"fontFamily":null,"fontSize":null,"fontWeight":null,"italic":null,"underline":null,"strikeout":false,"align":null,"value":"yes","keyVisible":null,"valueVisible":null,"key":"Add into BOM","fillColor":null,"parentId":"e080acf526ade866","zIndex":3}|
{"type":"ATTR","ticket":265,"id":"490a1379e62708be"}||{"x":null,"y":null,"rotation":null,"color":null,"fontFamily":null,"fontSize":null,"fontWeight":null,"italic":null,"underline":null,"strikeout":false,"align":null,"value":"yes","keyVisible":null,"valueVisible":null,"key":"Convert to PCB","fillColor":null,"parentId":"e080acf526ade866","zIndex":4}|
{"type":"ATTR","ticket":266,"id":"5b429f75b587a407"}||{"x":330,"y":-860,"rotation":0,"color":null,"fontFamily":null,"fontSize":null,"fontWeight":false,"italic":false,"underline":false,"strikeout":false,"align":null,"value":"TP1","keyVisible":null,"valueVisible":true,"key":"Designator","fillColor":null,"parentId":"e080acf526ade866","zIndex":9,"locked":false}|
{"type":"ATTR","ticket":267,"id":"783d66c13ad89c25"}||{"x":null,"y":null,"rotation":null,"color":null,"fontFamily":null,"fontSize":null,"fontWeight":null,"italic":null,"underline":null,"strikeout":false,"align":null,"value":null,"keyVisible":null,"valueVisible":null,"key":"Footprint","fillColor":null,"parentId":"e080acf526ade866","zIndex":6}|
{"type":"ATTR","ticket":268,"id":"cff470be7e484e5c"}||{"x":330,"y":-830,"rotation":0,"color":null,"fontFamily":null,"fontSize":null,"fontWeight":null,"italic":null,"underline":null,"align":null,"value":"={Manufacturer Part}","keyVisible":null,"valueVisible":true,"key":"Name","fillColor":null,"parentId":"e080acf526ade866","zIndex":11}|
{"type":"ATTR","ticket":269,"id":"f29be8c33aee83dc"}||{"x":null,"y":null,"rotation":null,"color":null,"fontFamily":null,"fontSize":null,"fontWeight":null,"italic":null,"underline":null,"align":null,"value":null,"keyVisible":null,"valueVisible":null,"key":"Reuse Block","fillColor":null,"parentId":"e080acf526ade866","zIndex":12}|
{"type":"ATTR","ticket":270,"id":"5802acaa98957920"}||{"x":null,"y":null,"rotation":null,"color":null,"fontFamily":null,"fontSize":null,"fontWeight":null,"italic":null,"underline":null,"align":null,"value":null,"keyVisible":null,"valueVisible":null,"key":"Group ID","fillColor":null,"parentId":"e080acf526ade866","zIndex":13}|
{"type":"ATTR","ticket":271,"id":"b805aaea3bee448f"}||{"x":null,"y":null,"rotation":null,"color":null,"fontFamily":null,"fontSize":null,"fontWeight":null,"italic":null,"underline":null,"align":null,"value":null,"keyVisible":null,"valueVisible":null,"key":"Channel ID","fillColor":null,"parentId":"e080acf526ade866","zIndex":14}|
{"type":"COMPONENT","ticket":272,"id":"33eb9b42a976b2f1"}||{"partId":"TP-黄色测试点.1","x":760,"y":-850,"rotation":0,"isMirror":false,"attrs":{"Footprints":"[]","Devices":"[]","DeviceName":"{\"uuid\":\"898e6d6b826629a1\",\"name\":\"TP-黄色测试点\",\"source\":\"\"}","FootprintName":null,"isSwitchClose":false,"pinClass":{},"differentialPairClass":{},"Symbols":"[]"},"zIndex":34}|
{"type":"ATTR","ticket":273,"id":"c26836f9f1527d0d"}||{"x":null,"y":null,"rotation":0,"color":null,"fontFamily":null,"fontSize":null,"fontWeight":false,"italic":false,"underline":false,"strikeout":false,"align":null,"value":"7058a89e7066cfa0","keyVisible":null,"valueVisible":null,"key":"Symbol","fillColor":null,"parentId":"33eb9b42a976b2f1","zIndex":8,"locked":false}|
{"type":"ATTR","ticket":274,"id":"c477bea4e2e01637"}||{"x":null,"y":null,"rotation":null,"color":null,"fontFamily":null,"fontSize":null,"fontWeight":null,"italic":null,"underline":null,"strikeout":false,"align":null,"value":"898e6d6b826629a1","keyVisible":null,"valueVisible":null,"key":"Device","fillColor":null,"parentId":"33eb9b42a976b2f1","zIndex":5}|
{"type":"ATTR","ticket":275,"id":"82dfeced68e326e4"}||{"x":null,"y":null,"rotation":null,"color":null,"fontFamily":null,"fontSize":null,"fontWeight":null,"italic":null,"underline":null,"strikeout":false,"align":null,"value":"gge49","keyVisible":null,"valueVisible":null,"key":"Unique ID","fillColor":null,"parentId":"33eb9b42a976b2f1","zIndex":10}|
{"type":"ATTR","ticket":276,"id":"2190f44fda92f3c7"}||{"x":null,"y":null,"rotation":null,"color":null,"fontFamily":null,"fontSize":null,"fontWeight":null,"italic":null,"underline":null,"strikeout":false,"align":null,"value":"yes","keyVisible":null,"valueVisible":null,"key":"Add into BOM","fillColor":null,"parentId":"33eb9b42a976b2f1","zIndex":3}|
{"type":"ATTR","ticket":277,"id":"b9b78a7873a7571e"}||{"x":null,"y":null,"rotation":null,"color":null,"fontFamily":null,"fontSize":null,"fontWeight":null,"italic":null,"underline":null,"strikeout":false,"align":null,"value":"yes","keyVisible":null,"valueVisible":null,"key":"Convert to PCB","fillColor":null,"parentId":"33eb9b42a976b2f1","zIndex":4}|
{"type":"ATTR","ticket":278,"id":"fdc60c97140b7a21"}||{"x":750,"y":-860,"rotation":0,"color":null,"fontFamily":null,"fontSize":null,"fontWeight":false,"italic":false,"underline":false,"strikeout":false,"align":null,"value":"TP2","keyVisible":null,"valueVisible":true,"key":"Designator","fillColor":null,"parentId":"33eb9b42a976b2f1","zIndex":9,"locked":false}|
{"type":"ATTR","ticket":279,"id":"1a4d12df45d6ea1c"}||{"x":null,"y":null,"rotation":null,"color":null,"fontFamily":null,"fontSize":null,"fontWeight":null,"italic":null,"underline":null,"strikeout":false,"align":null,"value":null,"keyVisible":null,"valueVisible":null,"key":"Footprint","fillColor":null,"parentId":"33eb9b42a976b2f1","zIndex":6}|
{"type":"ATTR","ticket":280,"id":"9e2e97011fdd4523"}||{"x":750,"y":-830,"rotation":0,"color":null,"fontFamily":null,"fontSize":null,"fontWeight":null,"italic":null,"underline":null,"align":null,"value":"={Manufacturer Part}","keyVisible":null,"valueVisible":true,"key":"Name","fillColor":null,"parentId":"33eb9b42a976b2f1","zIndex":11}|
{"type":"ATTR","ticket":281,"id":"4229f31b16f5cd26"}||{"x":null,"y":null,"rotation":null,"color":null,"fontFamily":null,"fontSize":null,"fontWeight":null,"italic":null,"underline":null,"align":null,"value":null,"keyVisible":null,"valueVisible":null,"key":"Reuse Block","fillColor":null,"parentId":"33eb9b42a976b2f1","zIndex":12}|
{"type":"ATTR","ticket":282,"id":"8d9ae77f508d6e7d"}||{"x":null,"y":null,"rotation":null,"color":null,"fontFamily":null,"fontSize":null,"fontWeight":null,"italic":null,"underline":null,"align":null,"value":null,"keyVisible":null,"valueVisible":null,"key":"Group ID","fillColor":null,"parentId":"33eb9b42a976b2f1","zIndex":13}|
{"type":"ATTR","ticket":283,"id":"801844053daaa738"}||{"x":null,"y":null,"rotation":null,"color":null,"fontFamily":null,"fontSize":null,"fontWeight":null,"italic":null,"underline":null,"align":null,"value":null,"keyVisible":null,"valueVisible":null,"key":"Channel ID","fillColor":null,"parentId":"33eb9b42a976b2f1","zIndex":14}|
{"type":"COMPONENT","ticket":284,"id":"bc7aeb1adb1ed5b2"}||{"partId":"TP-黄色测试点.1","x":1860,"y":-850,"rotation":0,"isMirror":false,"attrs":{"Footprints":"[]","Devices":"[]","DeviceName":"{\"uuid\":\"898e6d6b826629a1\",\"name\":\"TP-黄色测试点\",\"source\":\"\"}","FootprintName":null,"isSwitchClose":false,"pinClass":{},"differentialPairClass":{},"Symbols":"[]"},"zIndex":35}|
{"type":"ATTR","ticket":285,"id":"13cc225c1189789b"}||{"x":null,"y":null,"rotation":0,"color":null,"fontFamily":null,"fontSize":null,"fontWeight":false,"italic":false,"underline":false,"strikeout":false,"align":null,"value":"7058a89e7066cfa0","keyVisible":null,"valueVisible":null,"key":"Symbol","fillColor":null,"parentId":"bc7aeb1adb1ed5b2","zIndex":8,"locked":false}|
{"type":"ATTR","ticket":286,"id":"eb92d6b633a5b891"}||{"x":null,"y":null,"rotation":null,"color":null,"fontFamily":null,"fontSize":null,"fontWeight":null,"italic":null,"underline":null,"strikeout":false,"align":null,"value":"898e6d6b826629a1","keyVisible":null,"valueVisible":null,"key":"Device","fillColor":null,"parentId":"bc7aeb1adb1ed5b2","zIndex":5}|
{"type":"ATTR","ticket":287,"id":"0015fd23ef031567"}||{"x":null,"y":null,"rotation":null,"color":null,"fontFamily":null,"fontSize":null,"fontWeight":null,"italic":null,"underline":null,"strikeout":false,"align":null,"value":"gge50","keyVisible":null,"valueVisible":null,"key":"Unique ID","fillColor":null,"parentId":"bc7aeb1adb1ed5b2","zIndex":10}|
{"type":"ATTR","ticket":288,"id":"94141206ded56c29"}||{"x":null,"y":null,"rotation":null,"color":null,"fontFamily":null,"fontSize":null,"fontWeight":null,"italic":null,"underline":null,"strikeout":false,"align":null,"value":"yes","keyVisible":null,"valueVisible":null,"key":"Add into BOM","fillColor":null,"parentId":"bc7aeb1adb1ed5b2","zIndex":3}|
{"type":"ATTR","ticket":289,"id":"d52819b83db519b1"}||{"x":null,"y":null,"rotation":null,"color":null,"fontFamily":null,"fontSize":null,"fontWeight":null,"italic":null,"underline":null,"strikeout":false,"align":null,"value":"yes","keyVisible":null,"valueVisible":null,"key":"Convert to PCB","fillColor":null,"parentId":"bc7aeb1adb1ed5b2","zIndex":4}|
{"type":"ATTR","ticket":290,"id":"ab361c89a39caada"}||{"x":1850,"y":-860,"rotation":0,"color":null,"fontFamily":null,"fontSize":null,"fontWeight":false,"italic":false,"underline":false,"strikeout":false,"align":null,"value":"TP3","keyVisible":null,"valueVisible":true,"key":"Designator","fillColor":null,"parentId":"bc7aeb1adb1ed5b2","zIndex":9,"locked":false}|
{"type":"ATTR","ticket":291,"id":"c0cc4daa55c9bf9f"}||{"x":null,"y":null,"rotation":null,"color":null,"fontFamily":null,"fontSize":null,"fontWeight":null,"italic":null,"underline":null,"strikeout":false,"align":null,"value":null,"keyVisible":null,"valueVisible":null,"key":"Footprint","fillColor":null,"parentId":"bc7aeb1adb1ed5b2","zIndex":6}|
{"type":"ATTR","ticket":292,"id":"29968a1e554a5048"}||{"x":1850,"y":-830,"rotation":0,"color":null,"fontFamily":null,"fontSize":null,"fontWeight":null,"italic":null,"underline":null,"align":null,"value":"={Manufacturer Part}","keyVisible":null,"valueVisible":true,"key":"Name","fillColor":null,"parentId":"bc7aeb1adb1ed5b2","zIndex":11}|
{"type":"ATTR","ticket":293,"id":"bbac0a90f373a10f"}||{"x":null,"y":null,"rotation":null,"color":null,"fontFamily":null,"fontSize":null,"fontWeight":null,"italic":null,"underline":null,"align":null,"value":null,"keyVisible":null,"valueVisible":null,"key":"Reuse Block","fillColor":null,"parentId":"bc7aeb1adb1ed5b2","zIndex":12}|
{"type":"ATTR","ticket":294,"id":"a3175fbcb7e60830"}||{"x":null,"y":null,"rotation":null,"color":null,"fontFamily":null,"fontSize":null,"fontWeight":null,"italic":null,"underline":null,"align":null,"value":null,"keyVisible":null,"valueVisible":null,"key":"Group ID","fillColor":null,"parentId":"bc7aeb1adb1ed5b2","zIndex":13}|
{"type":"ATTR","ticket":295,"id":"9faf728de06fe396"}||{"x":null,"y":null,"rotation":null,"color":null,"fontFamily":null,"fontSize":null,"fontWeight":null,"italic":null,"underline":null,"align":null,"value":null,"keyVisible":null,"valueVisible":null,"key":"Channel ID","fillColor":null,"parentId":"bc7aeb1adb1ed5b2","zIndex":14}|
{"type":"COMPONENT","ticket":296,"id":"ec483a879ff359c7"}||{"partId":"TP-黄色测试点.1","x":2500,"y":-850,"rotation":0,"isMirror":false,"attrs":{"Footprints":"[]","Devices":"[]","DeviceName":"{\"uuid\":\"898e6d6b826629a1\",\"name\":\"TP-黄色测试点\",\"source\":\"\"}","FootprintName":null,"isSwitchClose":false,"pinClass":{},"differentialPairClass":{},"Symbols":"[]"},"zIndex":36}|
{"type":"ATTR","ticket":297,"id":"0f1a5c13ba8aa49b"}||{"x":null,"y":null,"rotation":0,"color":null,"fontFamily":null,"fontSize":null,"fontWeight":false,"italic":false,"underline":false,"strikeout":false,"align":null,"value":"7058a89e7066cfa0","keyVisible":null,"valueVisible":null,"key":"Symbol","fillColor":null,"parentId":"ec483a879ff359c7","zIndex":8,"locked":false}|
{"type":"ATTR","ticket":298,"id":"659f3b9765ea8a40"}||{"x":null,"y":null,"rotation":null,"color":null,"fontFamily":null,"fontSize":null,"fontWeight":null,"italic":null,"underline":null,"strikeout":false,"align":null,"value":"898e6d6b826629a1","keyVisible":null,"valueVisible":null,"key":"Device","fillColor":null,"parentId":"ec483a879ff359c7","zIndex":5}|
{"type":"ATTR","ticket":299,"id":"e78fde0000a14dbb"}||{"x":null,"y":null,"rotation":null,"color":null,"fontFamily":null,"fontSize":null,"fontWeight":null,"italic":null,"underline":null,"strikeout":false,"align":null,"value":"gge51","keyVisible":null,"valueVisible":null,"key":"Unique ID","fillColor":null,"parentId":"ec483a879ff359c7","zIndex":10}|
{"type":"ATTR","ticket":300,"id":"fbb5496713bd5f39"}||{"x":null,"y":null,"rotation":null,"color":null,"fontFamily":null,"fontSize":null,"fontWeight":null,"italic":null,"underline":null,"strikeout":false,"align":null,"value":"yes","keyVisible":null,"valueVisible":null,"key":"Add into BOM","fillColor":null,"parentId":"ec483a879ff359c7","zIndex":3}|
{"type":"ATTR","ticket":301,"id":"c48f8666caf97953"}||{"x":null,"y":null,"rotation":null,"color":null,"fontFamily":null,"fontSize":null,"fontWeight":null,"italic":null,"underline":null,"strikeout":false,"align":null,"value":"yes","keyVisible":null,"valueVisible":null,"key":"Convert to PCB","fillColor":null,"parentId":"ec483a879ff359c7","zIndex":4}|
{"type":"ATTR","ticket":302,"id":"e89aec6dfba88bd1"}||{"x":2490,"y":-860,"rotation":0,"color":null,"fontFamily":null,"fontSize":null,"fontWeight":false,"italic":false,"underline":false,"strikeout":false,"align":null,"value":"TP4","keyVisible":null,"valueVisible":true,"key":"Designator","fillColor":null,"parentId":"ec483a879ff359c7","zIndex":9,"locked":false}|
{"type":"ATTR","ticket":303,"id":"bea9299cf8bf742f"}||{"x":null,"y":null,"rotation":null,"color":null,"fontFamily":null,"fontSize":null,"fontWeight":null,"italic":null,"underline":null,"strikeout":false,"align":null,"value":null,"keyVisible":null,"valueVisible":null,"key":"Footprint","fillColor":null,"parentId":"ec483a879ff359c7","zIndex":6}|
{"type":"ATTR","ticket":304,"id":"090bbc90b22df349"}||{"x":2490,"y":-830,"rotation":0,"color":null,"fontFamily":null,"fontSize":null,"fontWeight":null,"italic":null,"underline":null,"align":null,"value":"={Manufacturer Part}","keyVisible":null,"valueVisible":true,"key":"Name","fillColor":null,"parentId":"ec483a879ff359c7","zIndex":11}|
{"type":"ATTR","ticket":305,"id":"376a89a1e715edb7"}||{"x":null,"y":null,"rotation":null,"color":null,"fontFamily":null,"fontSize":null,"fontWeight":null,"italic":null,"underline":null,"align":null,"value":null,"keyVisible":null,"valueVisible":null,"key":"Reuse Block","fillColor":null,"parentId":"ec483a879ff359c7","zIndex":12}|
{"type":"ATTR","ticket":306,"id":"863e861f3ba86a79"}||{"x":null,"y":null,"rotation":null,"color":null,"fontFamily":null,"fontSize":null,"fontWeight":null,"italic":null,"underline":null,"align":null,"value":null,"keyVisible":null,"valueVisible":null,"key":"Group ID","fillColor":null,"parentId":"ec483a879ff359c7","zIndex":13}|
{"type":"ATTR","ticket":307,"id":"579e52df65e55ff9"}||{"x":null,"y":null,"rotation":null,"color":null,"fontFamily":null,"fontSize":null,"fontWeight":null,"italic":null,"underline":null,"align":null,"value":null,"keyVisible":null,"valueVisible":null,"key":"Channel ID","fillColor":null,"parentId":"ec483a879ff359c7","zIndex":14}|
{"type":"COMPONENT","ticket":308,"id":"002f4ea8fcaffc15"}||{"partId":"TP-黄色测试点.1","x":560,"y":-850,"rotation":0,"isMirror":false,"attrs":{"Footprints":"[]","Devices":"[]","DeviceName":"{\"uuid\":\"898e6d6b826629a1\",\"name\":\"TP-黄色测试点\",\"source\":\"\"}","FootprintName":null,"isSwitchClose":false,"pinClass":{},"differentialPairClass":{},"Symbols":"[]"},"zIndex":37}|
{"type":"ATTR","ticket":309,"id":"4f8b852a38b84537"}||{"x":null,"y":null,"rotation":0,"color":null,"fontFamily":null,"fontSize":null,"fontWeight":false,"italic":false,"underline":false,"strikeout":false,"align":null,"value":"7058a89e7066cfa0","keyVisible":null,"valueVisible":null,"key":"Symbol","fillColor":null,"parentId":"002f4ea8fcaffc15","zIndex":8,"locked":false}|
{"type":"ATTR","ticket":310,"id":"902c3cf3a5773e60"}||{"x":null,"y":null,"rotation":null,"color":null,"fontFamily":null,"fontSize":null,"fontWeight":null,"italic":null,"underline":null,"strikeout":false,"align":null,"value":"898e6d6b826629a1","keyVisible":null,"valueVisible":null,"key":"Device","fillColor":null,"parentId":"002f4ea8fcaffc15","zIndex":5}|
{"type":"ATTR","ticket":311,"id":"a55eb5c298de25c7"}||{"x":null,"y":null,"rotation":null,"color":null,"fontFamily":null,"fontSize":null,"fontWeight":null,"italic":null,"underline":null,"strikeout":false,"align":null,"value":"gge52","keyVisible":null,"valueVisible":null,"key":"Unique ID","fillColor":null,"parentId":"002f4ea8fcaffc15","zIndex":10}|
{"type":"ATTR","ticket":312,"id":"b8810fe70045cde2"}||{"x":null,"y":null,"rotation":null,"color":null,"fontFamily":null,"fontSize":null,"fontWeight":null,"italic":null,"underline":null,"strikeout":false,"align":null,"value":"yes","keyVisible":null,"valueVisible":null,"key":"Add into BOM","fillColor":null,"parentId":"002f4ea8fcaffc15","zIndex":3}|
{"type":"ATTR","ticket":313,"id":"16877b482d89c518"}||{"x":null,"y":null,"rotation":null,"color":null,"fontFamily":null,"fontSize":null,"fontWeight":null,"italic":null,"underline":null,"strikeout":false,"align":null,"value":"yes","keyVisible":null,"valueVisible":null,"key":"Convert to PCB","fillColor":null,"parentId":"002f4ea8fcaffc15","zIndex":4}|
{"type":"ATTR","ticket":314,"id":"612dfa5110bf2d10"}||{"x":550,"y":-860,"rotation":0,"color":null,"fontFamily":null,"fontSize":null,"fontWeight":false,"italic":false,"underline":false,"strikeout":false,"align":null,"value":"TP5","keyVisible":null,"valueVisible":true,"key":"Designator","fillColor":null,"parentId":"002f4ea8fcaffc15","zIndex":9,"locked":false}|
{"type":"ATTR","ticket":315,"id":"51b76f8f1529b86a"}||{"x":null,"y":null,"rotation":null,"color":null,"fontFamily":null,"fontSize":null,"fontWeight":null,"italic":null,"underline":null,"strikeout":false,"align":null,"value":null,"keyVisible":null,"valueVisible":null,"key":"Footprint","fillColor":null,"parentId":"002f4ea8fcaffc15","zIndex":6}|
{"type":"ATTR","ticket":316,"id":"87f7d7a278c6d0c2"}||{"x":550,"y":-830,"rotation":0,"color":null,"fontFamily":null,"fontSize":null,"fontWeight":null,"italic":null,"underline":null,"align":null,"value":"={Manufacturer Part}","keyVisible":null,"valueVisible":true,"key":"Name","fillColor":null,"parentId":"002f4ea8fcaffc15","zIndex":11}|
{"type":"ATTR","ticket":317,"id":"96b55519235f9285"}||{"x":null,"y":null,"rotation":null,"color":null,"fontFamily":null,"fontSize":null,"fontWeight":null,"italic":null,"underline":null,"align":null,"value":null,"keyVisible":null,"valueVisible":null,"key":"Reuse Block","fillColor":null,"parentId":"002f4ea8fcaffc15","zIndex":12}|
{"type":"ATTR","ticket":318,"id":"b309b4da293d34bd"}||{"x":null,"y":null,"rotation":null,"color":null,"fontFamily":null,"fontSize":null,"fontWeight":null,"italic":null,"underline":null,"align":null,"value":null,"keyVisible":null,"valueVisible":null,"key":"Group ID","fillColor":null,"parentId":"002f4ea8fcaffc15","zIndex":13}|
{"type":"ATTR","ticket":319,"id":"a5362af93f94c126"}||{"x":null,"y":null,"rotation":null,"color":null,"fontFamily":null,"fontSize":null,"fontWeight":null,"italic":null,"underline":null,"align":null,"value":null,"keyVisible":null,"valueVisible":null,"key":"Channel ID","fillColor":null,"parentId":"002f4ea8fcaffc15","zIndex":14}|
{"type":"COMPONENT","ticket":320,"id":"c06f7a9d7c460947"}||{"partId":"TP-黄色测试点.1","x":760,"y":-1450,"rotation":0,"isMirror":false,"attrs":{"Footprints":"[]","Devices":"[]","DeviceName":"{\"uuid\":\"898e6d6b826629a1\",\"name\":\"TP-黄色测试点\",\"source\":\"\"}","FootprintName":null,"isSwitchClose":false,"pinClass":{},"differentialPairClass":{},"Symbols":"[]"},"zIndex":38}|
{"type":"ATTR","ticket":321,"id":"a49c5e75fc4fb6a3"}||{"x":null,"y":null,"rotation":0,"color":null,"fontFamily":null,"fontSize":null,"fontWeight":false,"italic":false,"underline":false,"strikeout":false,"align":null,"value":"7058a89e7066cfa0","keyVisible":null,"valueVisible":null,"key":"Symbol","fillColor":null,"parentId":"c06f7a9d7c460947","zIndex":8,"locked":false}|
{"type":"ATTR","ticket":322,"id":"61a96d915bc57378"}||{"x":null,"y":null,"rotation":null,"color":null,"fontFamily":null,"fontSize":null,"fontWeight":null,"italic":null,"underline":null,"strikeout":false,"align":null,"value":"898e6d6b826629a1","keyVisible":null,"valueVisible":null,"key":"Device","fillColor":null,"parentId":"c06f7a9d7c460947","zIndex":5}|
{"type":"ATTR","ticket":323,"id":"b3fcd4324196c8cf"}||{"x":null,"y":null,"rotation":null,"color":null,"fontFamily":null,"fontSize":null,"fontWeight":null,"italic":null,"underline":null,"strikeout":false,"align":null,"value":"gge53","keyVisible":null,"valueVisible":null,"key":"Unique ID","fillColor":null,"parentId":"c06f7a9d7c460947","zIndex":10}|
{"type":"ATTR","ticket":324,"id":"5ccb734b232a9159"}||{"x":null,"y":null,"rotation":null,"color":null,"fontFamily":null,"fontSize":null,"fontWeight":null,"italic":null,"underline":null,"strikeout":false,"align":null,"value":"yes","keyVisible":null,"valueVisible":null,"key":"Add into BOM","fillColor":null,"parentId":"c06f7a9d7c460947","zIndex":3}|
{"type":"ATTR","ticket":325,"id":"cf4513b90c6c2779"}||{"x":null,"y":null,"rotation":null,"color":null,"fontFamily":null,"fontSize":null,"fontWeight":null,"italic":null,"underline":null,"strikeout":false,"align":null,"value":"yes","keyVisible":null,"valueVisible":null,"key":"Convert to PCB","fillColor":null,"parentId":"c06f7a9d7c460947","zIndex":4}|
{"type":"ATTR","ticket":326,"id":"a0be297dc6a996ee"}||{"x":750,"y":-1460,"rotation":0,"color":null,"fontFamily":null,"fontSize":null,"fontWeight":false,"italic":false,"underline":false,"strikeout":false,"align":null,"value":"TP6","keyVisible":null,"valueVisible":true,"key":"Designator","fillColor":null,"parentId":"c06f7a9d7c460947","zIndex":9,"locked":false}|
{"type":"ATTR","ticket":327,"id":"973dc73d844477cb"}||{"x":null,"y":null,"rotation":null,"color":null,"fontFamily":null,"fontSize":null,"fontWeight":null,"italic":null,"underline":null,"strikeout":false,"align":null,"value":null,"keyVisible":null,"valueVisible":null,"key":"Footprint","fillColor":null,"parentId":"c06f7a9d7c460947","zIndex":6}|
{"type":"ATTR","ticket":328,"id":"038e69e190808cfa"}||{"x":750,"y":-1430,"rotation":0,"color":null,"fontFamily":null,"fontSize":null,"fontWeight":null,"italic":null,"underline":null,"align":null,"value":"={Manufacturer Part}","keyVisible":null,"valueVisible":true,"key":"Name","fillColor":null,"parentId":"c06f7a9d7c460947","zIndex":11}|
{"type":"ATTR","ticket":329,"id":"096c559dbdbe3e01"}||{"x":null,"y":null,"rotation":null,"color":null,"fontFamily":null,"fontSize":null,"fontWeight":null,"italic":null,"underline":null,"align":null,"value":null,"keyVisible":null,"valueVisible":null,"key":"Reuse Block","fillColor":null,"parentId":"c06f7a9d7c460947","zIndex":12}|
{"type":"ATTR","ticket":330,"id":"e0b4851311226d2c"}||{"x":null,"y":null,"rotation":null,"color":null,"fontFamily":null,"fontSize":null,"fontWeight":null,"italic":null,"underline":null,"align":null,"value":null,"keyVisible":null,"valueVisible":null,"key":"Group ID","fillColor":null,"parentId":"c06f7a9d7c460947","zIndex":13}|
{"type":"ATTR","ticket":331,"id":"4d86865e3449fc63"}||{"x":null,"y":null,"rotation":null,"color":null,"fontFamily":null,"fontSize":null,"fontWeight":null,"italic":null,"underline":null,"align":null,"value":null,"keyVisible":null,"valueVisible":null,"key":"Channel ID","fillColor":null,"parentId":"c06f7a9d7c460947","zIndex":14}|
{"type":"ATTR","ticket":332,"id":"6172e28aeebfbf29"}||{"x":null,"y":null,"rotation":null,"color":null,"fontFamily":null,"fontSize":null,"fontWeight":null,"italic":null,"underline":null,"align":null,"value":"UNI-ROYAL(厚声)","keyVisible":null,"valueVisible":null,"key":"Manufacturer","fillColor":null,"parentId":"5d3e003fc8826190","zIndex":15}|
{"type":"ATTR","ticket":333,"id":"3427bc69aec9b875"}||{"x":null,"y":null,"rotation":null,"color":null,"fontFamily":null,"fontSize":null,"fontWeight":null,"italic":null,"underline":null,"align":null,"value":"0805W8F499JT5E","keyVisible":null,"valueVisible":null,"key":"Manufacturer Part","fillColor":null,"parentId":"5d3e003fc8826190","zIndex":16}|
{"type":"ATTR","ticket":334,"id":"6b93861e0787fa54"}||{"x":null,"y":null,"rotation":null,"color":null,"fontFamily":null,"fontSize":null,"fontWeight":null,"italic":null,"underline":null,"align":null,"value":"LCSC","keyVisible":null,"valueVisible":null,"key":"Supplier","fillColor":null,"parentId":"5d3e003fc8826190","zIndex":17}|
{"type":"ATTR","ticket":335,"id":"799c55789ea51d26"}||{"x":null,"y":null,"rotation":null,"color":null,"fontFamily":null,"fontSize":null,"fontWeight":null,"italic":null,"underline":null,"align":null,"value":"0805W8F499JT5E.1","keyVisible":null,"valueVisible":null,"key":"Supplier Part","fillColor":null,"parentId":"5d3e003fc8826190","zIndex":18}|
{"type":"ATTR","ticket":336,"id":"888f4605cb13ac3d"}||{"x":null,"y":null,"rotation":null,"color":null,"fontFamily":null,"fontSize":null,"fontWeight":null,"italic":null,"underline":null,"align":null,"value":"","keyVisible":null,"valueVisible":null,"key":"LCSC Part Name","fillColor":null,"parentId":"5d3e003fc8826190","zIndex":19}|
{"type":"ATTR","ticket":337,"id":"d9820a93fbfad536"}||{"x":null,"y":null,"rotation":null,"color":null,"fontFamily":null,"fontSize":null,"fontWeight":null,"italic":null,"underline":null,"align":null,"value":"","keyVisible":null,"valueVisible":null,"key":"Supplier Footprint","fillColor":null,"parentId":"5d3e003fc8826190","zIndex":20}|
{"type":"ATTR","ticket":338,"id":"21a0b0d5f3242df8"}||{"x":null,"y":null,"rotation":null,"color":null,"fontFamily":null,"fontSize":null,"fontWeight":null,"italic":null,"underline":null,"align":null,"value":"","keyVisible":null,"valueVisible":null,"key":"JLCPCB Part Class","fillColor":null,"parentId":"5d3e003fc8826190","zIndex":21}|
{"type":"ATTR","ticket":339,"id":"7278672a48374ee7"}||{"x":null,"y":null,"rotation":null,"color":null,"fontFamily":null,"fontSize":null,"fontWeight":null,"italic":null,"underline":null,"align":null,"value":"","keyVisible":null,"valueVisible":null,"key":"Datasheet","fillColor":null,"parentId":"5d3e003fc8826190","zIndex":22}|
{"type":"ATTR","ticket":340,"id":"4593720d831499a9"}||{"x":null,"y":null,"rotation":null,"color":null,"fontFamily":null,"fontSize":null,"fontWeight":null,"italic":null,"underline":null,"align":null,"value":"","keyVisible":null,"valueVisible":null,"key":"Type","fillColor":null,"parentId":"5d3e003fc8826190","zIndex":23}|
{"type":"ATTR","ticket":341,"id":"0adefb74b5cfb420"}||{"x":null,"y":null,"rotation":null,"color":null,"fontFamily":null,"fontSize":null,"fontWeight":null,"italic":null,"underline":null,"align":null,"value":"49.9Ω","keyVisible":null,"valueVisible":null,"key":"Value","fillColor":null,"parentId":"5d3e003fc8826190","zIndex":24}|
{"type":"ATTR","ticket":342,"id":"8b0b2daa68c85788"}||{"x":null,"y":null,"rotation":null,"color":null,"fontFamily":null,"fontSize":null,"fontWeight":null,"italic":null,"underline":null,"align":null,"value":"","keyVisible":null,"valueVisible":null,"key":"Tolerance","fillColor":null,"parentId":"5d3e003fc8826190","zIndex":25}|
{"type":"ATTR","ticket":343,"id":"9b2a7c5859cd344d"}||{"x":null,"y":null,"rotation":null,"color":null,"fontFamily":null,"fontSize":null,"fontWeight":null,"italic":null,"underline":null,"align":null,"value":"","keyVisible":null,"valueVisible":null,"key":"Power(Watts)","fillColor":null,"parentId":"5d3e003fc8826190","zIndex":26}|
{"type":"ATTR","ticket":344,"id":"7d6f708b6446531e"}||{"x":null,"y":null,"rotation":null,"color":null,"fontFamily":null,"fontSize":null,"fontWeight":null,"italic":null,"underline":null,"align":null,"value":"","keyVisible":null,"valueVisible":null,"key":"Voltage-Supply(Max)","fillColor":null,"parentId":"5d3e003fc8826190","zIndex":27}|
{"type":"ATTR","ticket":345,"id":"135cc9db389f32a8"}||{"x":null,"y":null,"rotation":null,"color":null,"fontFamily":null,"fontSize":null,"fontWeight":null,"italic":null,"underline":null,"align":null,"value":"","keyVisible":null,"valueVisible":null,"key":"Temperature Coefficient","fillColor":null,"parentId":"5d3e003fc8826190","zIndex":28}|
{"type":"ATTR","ticket":346,"id":"7214f7dc83530660"}||{"x":null,"y":null,"rotation":null,"color":null,"fontFamily":null,"fontSize":null,"fontWeight":null,"italic":null,"underline":null,"align":null,"value":"","keyVisible":null,"valueVisible":null,"key":"Operating Temperature","fillColor":null,"parentId":"5d3e003fc8826190","zIndex":29}|
{"type":"ATTR","ticket":347,"id":"bbd40dafc9ab9d59"}||{"x":null,"y":null,"rotation":null,"color":null,"fontFamily":null,"fontSize":null,"fontWeight":null,"italic":null,"underline":null,"align":null,"value":"","keyVisible":null,"valueVisible":null,"key":"Description","fillColor":null,"parentId":"5d3e003fc8826190","zIndex":30}|
{"type":"ATTR","ticket":348,"id":"8f7b3311b982c06c"}||{"x":null,"y":null,"rotation":null,"color":null,"fontFamily":null,"fontSize":null,"fontWeight":null,"italic":null,"underline":null,"align":null,"value":"FH(风华)","keyVisible":null,"valueVisible":null,"key":"Manufacturer","fillColor":null,"parentId":"ac2df7588789e06a","zIndex":18}|
{"type":"ATTR","ticket":349,"id":"7d17753096c2b301"}||{"x":null,"y":null,"rotation":null,"color":null,"fontFamily":null,"fontSize":null,"fontWeight":null,"italic":null,"underline":null,"align":null,"value":"1206CG104J500NT","keyVisible":null,"valueVisible":null,"key":"Manufacturer Part","fillColor":null,"parentId":"ac2df7588789e06a","zIndex":19}|
{"type":"ATTR","ticket":350,"id":"8e0a9eec39e098e4"}||{"x":null,"y":null,"rotation":null,"color":null,"fontFamily":null,"fontSize":null,"fontWeight":null,"italic":null,"underline":null,"align":null,"value":"LCSC","keyVisible":null,"valueVisible":null,"key":"Supplier","fillColor":null,"parentId":"ac2df7588789e06a","zIndex":20}|
{"type":"ATTR","ticket":351,"id":"04c9cfa6768624fd"}||{"x":null,"y":null,"rotation":null,"color":null,"fontFamily":null,"fontSize":null,"fontWeight":null,"italic":null,"underline":null,"align":null,"value":"1206CG104J500NT.1","keyVisible":null,"valueVisible":null,"key":"Supplier Part","fillColor":null,"parentId":"ac2df7588789e06a","zIndex":21}|
{"type":"ATTR","ticket":352,"id":"f1cd048ddad14aa5"}||{"x":null,"y":null,"rotation":null,"color":null,"fontFamily":null,"fontSize":null,"fontWeight":null,"italic":null,"underline":null,"align":null,"value":"","keyVisible":null,"valueVisible":null,"key":"LCSC Part Name","fillColor":null,"parentId":"ac2df7588789e06a","zIndex":22}|
{"type":"ATTR","ticket":353,"id":"a84cc8622aa5035d"}||{"x":null,"y":null,"rotation":null,"color":null,"fontFamily":null,"fontSize":null,"fontWeight":null,"italic":null,"underline":null,"align":null,"value":"","keyVisible":null,"valueVisible":null,"key":"Supplier Footprint","fillColor":null,"parentId":"ac2df7588789e06a","zIndex":23}|
{"type":"ATTR","ticket":354,"id":"502d4abd7610b014"}||{"x":null,"y":null,"rotation":null,"color":null,"fontFamily":null,"fontSize":null,"fontWeight":null,"italic":null,"underline":null,"align":null,"value":"","keyVisible":null,"valueVisible":null,"key":"JLCPCB Part Class","fillColor":null,"parentId":"ac2df7588789e06a","zIndex":24}|
{"type":"ATTR","ticket":355,"id":"f99a5150ca0422f6"}||{"x":null,"y":null,"rotation":null,"color":null,"fontFamily":null,"fontSize":null,"fontWeight":null,"italic":null,"underline":null,"align":null,"value":"","keyVisible":null,"valueVisible":null,"key":"Datasheet","fillColor":null,"parentId":"ac2df7588789e06a","zIndex":25}|
{"type":"ATTR","ticket":356,"id":"e83ca128d3634c54"}||{"x":null,"y":null,"rotation":null,"color":null,"fontFamily":null,"fontSize":null,"fontWeight":null,"italic":null,"underline":null,"align":null,"value":"100nF","keyVisible":null,"valueVisible":null,"key":"Value","fillColor":null,"parentId":"ac2df7588789e06a","zIndex":26}|
{"type":"ATTR","ticket":357,"id":"f35e8eb7e834c1f2"}||{"x":null,"y":null,"rotation":null,"color":null,"fontFamily":null,"fontSize":null,"fontWeight":null,"italic":null,"underline":null,"align":null,"value":"","keyVisible":null,"valueVisible":null,"key":"Tolerance","fillColor":null,"parentId":"ac2df7588789e06a","zIndex":27}|
{"type":"ATTR","ticket":358,"id":"b801e4eb0a7fe04f"}||{"x":null,"y":null,"rotation":null,"color":null,"fontFamily":null,"fontSize":null,"fontWeight":null,"italic":null,"underline":null,"align":null,"value":"","keyVisible":null,"valueVisible":null,"key":"Voltage Rating","fillColor":null,"parentId":"ac2df7588789e06a","zIndex":28}|
{"type":"ATTR","ticket":359,"id":"ffd9aa7bf0d09853"}||{"x":null,"y":null,"rotation":null,"color":null,"fontFamily":null,"fontSize":null,"fontWeight":null,"italic":null,"underline":null,"align":null,"value":"","keyVisible":null,"valueVisible":null,"key":"Temperature Coefficient","fillColor":null,"parentId":"ac2df7588789e06a","zIndex":29}|
{"type":"ATTR","ticket":360,"id":"3a037de7a7af213a"}||{"x":null,"y":null,"rotation":null,"color":null,"fontFamily":null,"fontSize":null,"fontWeight":null,"italic":null,"underline":null,"align":null,"value":"","keyVisible":null,"valueVisible":null,"key":"Description","fillColor":null,"parentId":"ac2df7588789e06a","zIndex":30}|
{"type":"ATTR","ticket":361,"id":"9881b0e233024bd7"}||{"x":null,"y":null,"rotation":null,"color":null,"fontFamily":null,"fontSize":null,"fontWeight":null,"italic":null,"underline":null,"align":null,"value":"UNI-ROYAL(厚声)","keyVisible":null,"valueVisible":null,"key":"Manufacturer","fillColor":null,"parentId":"21ae80ce7b51b802","zIndex":15}|
{"type":"ATTR","ticket":362,"id":"0dc18bbb15030fe8"}||{"x":null,"y":null,"rotation":null,"color":null,"fontFamily":null,"fontSize":null,"fontWeight":null,"italic":null,"underline":null,"align":null,"value":"0805W8F0000T5E","keyVisible":null,"valueVisible":null,"key":"Manufacturer Part","fillColor":null,"parentId":"21ae80ce7b51b802","zIndex":16}|
{"type":"ATTR","ticket":363,"id":"f1520bcf74c176b4"}||{"x":null,"y":null,"rotation":null,"color":null,"fontFamily":null,"fontSize":null,"fontWeight":null,"italic":null,"underline":null,"align":null,"value":"LCSC","keyVisible":null,"valueVisible":null,"key":"Supplier","fillColor":null,"parentId":"21ae80ce7b51b802","zIndex":17}|
{"type":"ATTR","ticket":364,"id":"f0a42c61c8b5584d"}||{"x":null,"y":null,"rotation":null,"color":null,"fontFamily":null,"fontSize":null,"fontWeight":null,"italic":null,"underline":null,"align":null,"value":"0805W8F0000T5E.1","keyVisible":null,"valueVisible":null,"key":"Supplier Part","fillColor":null,"parentId":"21ae80ce7b51b802","zIndex":18}|
{"type":"ATTR","ticket":365,"id":"6d686f636231cd72"}||{"x":null,"y":null,"rotation":null,"color":null,"fontFamily":null,"fontSize":null,"fontWeight":null,"italic":null,"underline":null,"align":null,"value":"","keyVisible":null,"valueVisible":null,"key":"LCSC Part Name","fillColor":null,"parentId":"21ae80ce7b51b802","zIndex":19}|
{"type":"ATTR","ticket":366,"id":"a13b407e87212901"}||{"x":null,"y":null,"rotation":null,"color":null,"fontFamily":null,"fontSize":null,"fontWeight":null,"italic":null,"underline":null,"align":null,"value":"","keyVisible":null,"valueVisible":null,"key":"Supplier Footprint","fillColor":null,"parentId":"21ae80ce7b51b802","zIndex":20}|
{"type":"ATTR","ticket":367,"id":"f3391d2f62a1d5ec"}||{"x":null,"y":null,"rotation":null,"color":null,"fontFamily":null,"fontSize":null,"fontWeight":null,"italic":null,"underline":null,"align":null,"value":"","keyVisible":null,"valueVisible":null,"key":"JLCPCB Part Class","fillColor":null,"parentId":"21ae80ce7b51b802","zIndex":21}|
{"type":"ATTR","ticket":368,"id":"e5ed554488091f24"}||{"x":null,"y":null,"rotation":null,"color":null,"fontFamily":null,"fontSize":null,"fontWeight":null,"italic":null,"underline":null,"align":null,"value":"","keyVisible":null,"valueVisible":null,"key":"Datasheet","fillColor":null,"parentId":"21ae80ce7b51b802","zIndex":22}|
{"type":"ATTR","ticket":369,"id":"5202834376896ee0"}||{"x":null,"y":null,"rotation":null,"color":null,"fontFamily":null,"fontSize":null,"fontWeight":null,"italic":null,"underline":null,"align":null,"value":"","keyVisible":null,"valueVisible":null,"key":"Type","fillColor":null,"parentId":"21ae80ce7b51b802","zIndex":23}|
{"type":"ATTR","ticket":370,"id":"3e7b6accc2196e0a"}||{"x":null,"y":null,"rotation":null,"color":null,"fontFamily":null,"fontSize":null,"fontWeight":null,"italic":null,"underline":null,"align":null,"value":"0Ω","keyVisible":null,"valueVisible":null,"key":"Value","fillColor":null,"parentId":"21ae80ce7b51b802","zIndex":24}|
{"type":"ATTR","ticket":371,"id":"9f1ce7b10db84b9d"}||{"x":null,"y":null,"rotation":null,"color":null,"fontFamily":null,"fontSize":null,"fontWeight":null,"italic":null,"underline":null,"align":null,"value":"","keyVisible":null,"valueVisible":null,"key":"Tolerance","fillColor":null,"parentId":"21ae80ce7b51b802","zIndex":25}|
{"type":"ATTR","ticket":372,"id":"2f72418a26aa85c3"}||{"x":null,"y":null,"rotation":null,"color":null,"fontFamily":null,"fontSize":null,"fontWeight":null,"italic":null,"underline":null,"align":null,"value":"","keyVisible":null,"valueVisible":null,"key":"Power(Watts)","fillColor":null,"parentId":"21ae80ce7b51b802","zIndex":26}|
{"type":"ATTR","ticket":373,"id":"3f301c554a91c7d7"}||{"x":null,"y":null,"rotation":null,"color":null,"fontFamily":null,"fontSize":null,"fontWeight":null,"italic":null,"underline":null,"align":null,"value":"","keyVisible":null,"valueVisible":null,"key":"Voltage-Supply(Max)","fillColor":null,"parentId":"21ae80ce7b51b802","zIndex":27}|
{"type":"ATTR","ticket":374,"id":"63dc654cd42e2490"}||{"x":null,"y":null,"rotation":null,"color":null,"fontFamily":null,"fontSize":null,"fontWeight":null,"italic":null,"underline":null,"align":null,"value":"","keyVisible":null,"valueVisible":null,"key":"Temperature Coefficient","fillColor":null,"parentId":"21ae80ce7b51b802","zIndex":28}|
{"type":"ATTR","ticket":375,"id":"d48ff5dd06144e3c"}||{"x":null,"y":null,"rotation":null,"color":null,"fontFamily":null,"fontSize":null,"fontWeight":null,"italic":null,"underline":null,"align":null,"value":"","keyVisible":null,"valueVisible":null,"key":"Operating Temperature","fillColor":null,"parentId":"21ae80ce7b51b802","zIndex":29}|
{"type":"ATTR","ticket":376,"id":"cc0daa85f26769ee"}||{"x":null,"y":null,"rotation":null,"color":null,"fontFamily":null,"fontSize":null,"fontWeight":null,"italic":null,"underline":null,"align":null,"value":"","keyVisible":null,"valueVisible":null,"key":"Description","fillColor":null,"parentId":"21ae80ce7b51b802","zIndex":30}|
{"type":"ATTR","ticket":377,"id":"0ee4a09a114acd12"}||{"x":null,"y":null,"rotation":null,"color":null,"fontFamily":null,"fontSize":null,"fontWeight":null,"italic":null,"underline":null,"align":null,"value":"UNI-ROYAL(厚声)","keyVisible":null,"valueVisible":null,"key":"Manufacturer","fillColor":null,"parentId":"ba13657df474ad19","zIndex":15}|
{"type":"ATTR","ticket":378,"id":"11026f93485c5d2c"}||{"x":null,"y":null,"rotation":null,"color":null,"fontFamily":null,"fontSize":null,"fontWeight":null,"italic":null,"underline":null,"align":null,"value":"0805W8F1002T5E","keyVisible":null,"valueVisible":null,"key":"Manufacturer Part","fillColor":null,"parentId":"ba13657df474ad19","zIndex":16}|
{"type":"ATTR","ticket":379,"id":"4a3d5b1c9b30a410"}||{"x":null,"y":null,"rotation":null,"color":null,"fontFamily":null,"fontSize":null,"fontWeight":null,"italic":null,"underline":null,"align":null,"value":"LCSC","keyVisible":null,"valueVisible":null,"key":"Supplier","fillColor":null,"parentId":"ba13657df474ad19","zIndex":17}|
{"type":"ATTR","ticket":380,"id":"e65686a4b9cd9364"}||{"x":null,"y":null,"rotation":null,"color":null,"fontFamily":null,"fontSize":null,"fontWeight":null,"italic":null,"underline":null,"align":null,"value":"0805W8F1002T5E.1","keyVisible":null,"valueVisible":null,"key":"Supplier Part","fillColor":null,"parentId":"ba13657df474ad19","zIndex":18}|
{"type":"ATTR","ticket":381,"id":"25c3d382398704e1"}||{"x":null,"y":null,"rotation":null,"color":null,"fontFamily":null,"fontSize":null,"fontWeight":null,"italic":null,"underline":null,"align":null,"value":"","keyVisible":null,"valueVisible":null,"key":"LCSC Part Name","fillColor":null,"parentId":"ba13657df474ad19","zIndex":19}|
{"type":"ATTR","ticket":382,"id":"855c1fc19bf612ae"}||{"x":null,"y":null,"rotation":null,"color":null,"fontFamily":null,"fontSize":null,"fontWeight":null,"italic":null,"underline":null,"align":null,"value":"","keyVisible":null,"valueVisible":null,"key":"Supplier Footprint","fillColor":null,"parentId":"ba13657df474ad19","zIndex":20}|
{"type":"ATTR","ticket":383,"id":"60bb6ccaabf8c2eb"}||{"x":null,"y":null,"rotation":null,"color":null,"fontFamily":null,"fontSize":null,"fontWeight":null,"italic":null,"underline":null,"align":null,"value":"","keyVisible":null,"valueVisible":null,"key":"JLCPCB Part Class","fillColor":null,"parentId":"ba13657df474ad19","zIndex":21}|
{"type":"ATTR","ticket":384,"id":"f5d20faca321aebf"}||{"x":null,"y":null,"rotation":null,"color":null,"fontFamily":null,"fontSize":null,"fontWeight":null,"italic":null,"underline":null,"align":null,"value":"","keyVisible":null,"valueVisible":null,"key":"Datasheet","fillColor":null,"parentId":"ba13657df474ad19","zIndex":22}|
{"type":"ATTR","ticket":385,"id":"75ab11fe3dec9b9a"}||{"x":null,"y":null,"rotation":null,"color":null,"fontFamily":null,"fontSize":null,"fontWeight":null,"italic":null,"underline":null,"align":null,"value":"","keyVisible":null,"valueVisible":null,"key":"Type","fillColor":null,"parentId":"ba13657df474ad19","zIndex":23}|
{"type":"ATTR","ticket":386,"id":"d57f3f8988865823"}||{"x":null,"y":null,"rotation":null,"color":null,"fontFamily":null,"fontSize":null,"fontWeight":null,"italic":null,"underline":null,"align":null,"value":"10kΩ","keyVisible":null,"valueVisible":null,"key":"Value","fillColor":null,"parentId":"ba13657df474ad19","zIndex":24}|
{"type":"ATTR","ticket":387,"id":"603275f2b759a547"}||{"x":null,"y":null,"rotation":null,"color":null,"fontFamily":null,"fontSize":null,"fontWeight":null,"italic":null,"underline":null,"align":null,"value":"","keyVisible":null,"valueVisible":null,"key":"Tolerance","fillColor":null,"parentId":"ba13657df474ad19","zIndex":25}|
{"type":"ATTR","ticket":388,"id":"db06051c75ab6063"}||{"x":null,"y":null,"rotation":null,"color":null,"fontFamily":null,"fontSize":null,"fontWeight":null,"italic":null,"underline":null,"align":null,"value":"","keyVisible":null,"valueVisible":null,"key":"Power(Watts)","fillColor":null,"parentId":"ba13657df474ad19","zIndex":26}|
{"type":"ATTR","ticket":389,"id":"c78939b09ed4b1f4"}||{"x":null,"y":null,"rotation":null,"color":null,"fontFamily":null,"fontSize":null,"fontWeight":null,"italic":null,"underline":null,"align":null,"value":"","keyVisible":null,"valueVisible":null,"key":"Voltage-Supply(Max)","fillColor":null,"parentId":"ba13657df474ad19","zIndex":27}|
{"type":"ATTR","ticket":390,"id":"8552e0f056ecbc93"}||{"x":null,"y":null,"rotation":null,"color":null,"fontFamily":null,"fontSize":null,"fontWeight":null,"italic":null,"underline":null,"align":null,"value":"","keyVisible":null,"valueVisible":null,"key":"Temperature Coefficient","fillColor":null,"parentId":"ba13657df474ad19","zIndex":28}|
{"type":"ATTR","ticket":391,"id":"d2a2cdd9d03f22e5"}||{"x":null,"y":null,"rotation":null,"color":null,"fontFamily":null,"fontSize":null,"fontWeight":null,"italic":null,"underline":null,"align":null,"value":"","keyVisible":null,"valueVisible":null,"key":"Operating Temperature","fillColor":null,"parentId":"ba13657df474ad19","zIndex":29}|
{"type":"ATTR","ticket":392,"id":"f27589fd2ac4b063"}||{"x":null,"y":null,"rotation":null,"color":null,"fontFamily":null,"fontSize":null,"fontWeight":null,"italic":null,"underline":null,"align":null,"value":"","keyVisible":null,"valueVisible":null,"key":"Description","fillColor":null,"parentId":"ba13657df474ad19","zIndex":30}|
{"type":"ATTR","ticket":393,"id":"f854e0a55b83e2a6"}||{"x":null,"y":null,"rotation":null,"color":null,"fontFamily":null,"fontSize":null,"fontWeight":null,"italic":null,"underline":null,"align":null,"value":"TI(德州仪器)","keyVisible":null,"valueVisible":null,"key":"Manufacturer","fillColor":null,"parentId":"f2e48ec37a8f2db5","zIndex":23}|
{"type":"ATTR","ticket":394,"id":"471800f476700766"}||{"x":null,"y":null,"rotation":null,"color":null,"fontFamily":null,"fontSize":null,"fontWeight":null,"italic":null,"underline":null,"align":null,"value":"OPA2197ID","keyVisible":null,"valueVisible":null,"key":"Manufacturer Part","fillColor":null,"parentId":"f2e48ec37a8f2db5","zIndex":24}|
{"type":"ATTR","ticket":395,"id":"cc25be2e42d37c2f"}||{"x":null,"y":null,"rotation":null,"color":null,"fontFamily":null,"fontSize":null,"fontWeight":null,"italic":null,"underline":null,"align":null,"value":"LCSC","keyVisible":null,"valueVisible":null,"key":"Supplier","fillColor":null,"parentId":"f2e48ec37a8f2db5","zIndex":25}|
{"type":"ATTR","ticket":396,"id":"647fb14b0539b1b7"}||{"x":null,"y":null,"rotation":null,"color":null,"fontFamily":null,"fontSize":null,"fontWeight":null,"italic":null,"underline":null,"align":null,"value":"C1347222","keyVisible":null,"valueVisible":null,"key":"Supplier Part","fillColor":null,"parentId":"f2e48ec37a8f2db5","zIndex":26}|
{"type":"ATTR","ticket":397,"id":"9205e307103b74f9"}||{"x":null,"y":null,"rotation":null,"color":null,"fontFamily":null,"fontSize":null,"fontWeight":null,"italic":null,"underline":null,"align":null,"value":"","keyVisible":null,"valueVisible":null,"key":"LCSC Part Name","fillColor":null,"parentId":"f2e48ec37a8f2db5","zIndex":27}|
{"type":"ATTR","ticket":398,"id":"fe20194d7d39364a"}||{"x":null,"y":null,"rotation":null,"color":null,"fontFamily":null,"fontSize":null,"fontWeight":null,"italic":null,"underline":null,"align":null,"value":"SOIC-8","keyVisible":null,"valueVisible":null,"key":"Supplier Footprint","fillColor":null,"parentId":"f2e48ec37a8f2db5","zIndex":28}|
{"type":"ATTR","ticket":399,"id":"404bb6f3dfb882f2"}||{"x":null,"y":null,"rotation":null,"color":null,"fontFamily":null,"fontSize":null,"fontWeight":null,"italic":null,"underline":null,"align":null,"value":"","keyVisible":null,"valueVisible":null,"key":"JLCPCB Part Class","fillColor":null,"parentId":"f2e48ec37a8f2db5","zIndex":29}|
{"type":"ATTR","ticket":400,"id":"5541b0e550970e1e"}||{"x":null,"y":null,"rotation":null,"color":null,"fontFamily":null,"fontSize":null,"fontWeight":null,"italic":null,"underline":null,"align":null,"value":"","keyVisible":null,"valueVisible":null,"key":"Datasheet","fillColor":null,"parentId":"f2e48ec37a8f2db5","zIndex":30}|
{"type":"ATTR","ticket":401,"id":"ebb38cc4ef736b0c"}||{"x":null,"y":null,"rotation":null,"color":null,"fontFamily":null,"fontSize":null,"fontWeight":null,"italic":null,"underline":null,"align":null,"value":"","keyVisible":null,"valueVisible":null,"key":"Number of Channels","fillColor":null,"parentId":"f2e48ec37a8f2db5","zIndex":31}|
{"type":"ATTR","ticket":402,"id":"e231d37a948d93dd"}||{"x":null,"y":null,"rotation":null,"color":null,"fontFamily":null,"fontSize":null,"fontWeight":null,"italic":null,"underline":null,"align":null,"value":"","keyVisible":null,"valueVisible":null,"key":"Single Supply","fillColor":null,"parentId":"f2e48ec37a8f2db5","zIndex":32}|
{"type":"ATTR","ticket":403,"id":"d3829b79758a61f2"}||{"x":null,"y":null,"rotation":null,"color":null,"fontFamily":null,"fontSize":null,"fontWeight":null,"italic":null,"underline":null,"align":null,"value":"","keyVisible":null,"valueVisible":null,"key":"Dual Supply","fillColor":null,"parentId":"f2e48ec37a8f2db5","zIndex":33}|
{"type":"ATTR","ticket":404,"id":"2b1331a61837af9c"}||{"x":null,"y":null,"rotation":null,"color":null,"fontFamily":null,"fontSize":null,"fontWeight":null,"italic":null,"underline":null,"align":null,"value":"","keyVisible":null,"valueVisible":null,"key":"Vos - Input Offset Voltage","fillColor":null,"parentId":"f2e48ec37a8f2db5","zIndex":34}|
{"type":"ATTR","ticket":405,"id":"ce57fadb977959a2"}||{"x":null,"y":null,"rotation":null,"color":null,"fontFamily":null,"fontSize":null,"fontWeight":null,"italic":null,"underline":null,"align":null,"value":"","keyVisible":null,"valueVisible":null,"key":"Input Offset Voltage Drift(Vos TC)","fillColor":null,"parentId":"f2e48ec37a8f2db5","zIndex":35}|
{"type":"ATTR","ticket":406,"id":"38c1ab544f1a9a2e"}||{"x":null,"y":null,"rotation":null,"color":null,"fontFamily":null,"fontSize":null,"fontWeight":null,"italic":null,"underline":null,"align":null,"value":"","keyVisible":null,"valueVisible":null,"key":"Gain Bandwidth Product","fillColor":null,"parentId":"f2e48ec37a8f2db5","zIndex":36}|
{"type":"ATTR","ticket":407,"id":"37373bda9f593ca5"}||{"x":null,"y":null,"rotation":null,"color":null,"fontFamily":null,"fontSize":null,"fontWeight":null,"italic":null,"underline":null,"align":null,"value":"","keyVisible":null,"valueVisible":null,"key":"Rail to Rail","fillColor":null,"parentId":"f2e48ec37a8f2db5","zIndex":37}|
{"type":"ATTR","ticket":408,"id":"7705623e6cada2e2"}||{"x":null,"y":null,"rotation":null,"color":null,"fontFamily":null,"fontSize":null,"fontWeight":null,"italic":null,"underline":null,"align":null,"value":"","keyVisible":null,"valueVisible":null,"key":"Slew Rate","fillColor":null,"parentId":"f2e48ec37a8f2db5","zIndex":38}|
{"type":"ATTR","ticket":409,"id":"160015c3522cbb96"}||{"x":null,"y":null,"rotation":null,"color":null,"fontFamily":null,"fontSize":null,"fontWeight":null,"italic":null,"underline":null,"align":null,"value":"","keyVisible":null,"valueVisible":null,"key":"Common Mode Rejection Ratio(CMRR)","fillColor":null,"parentId":"f2e48ec37a8f2db5","zIndex":39}|
{"type":"ATTR","ticket":410,"id":"eec3f135e1c87d76"}||{"x":null,"y":null,"rotation":null,"color":null,"fontFamily":null,"fontSize":null,"fontWeight":null,"italic":null,"underline":null,"align":null,"value":"","keyVisible":null,"valueVisible":null,"key":"Input Voltage Noise Density","fillColor":null,"parentId":"f2e48ec37a8f2db5","zIndex":40}|
{"type":"ATTR","ticket":411,"id":"c883432945634157"}||{"x":null,"y":null,"rotation":null,"color":null,"fontFamily":null,"fontSize":null,"fontWeight":null,"italic":null,"underline":null,"align":null,"value":"","keyVisible":null,"valueVisible":null,"key":"Ib - Input Bias Current","fillColor":null,"parentId":"f2e48ec37a8f2db5","zIndex":41}|
{"type":"ATTR","ticket":412,"id":"8caaff008a4f3504"}||{"x":null,"y":null,"rotation":null,"color":null,"fontFamily":null,"fontSize":null,"fontWeight":null,"italic":null,"underline":null,"align":null,"value":"","keyVisible":null,"valueVisible":null,"key":"Quiescent Current(Iq)","fillColor":null,"parentId":"f2e48ec37a8f2db5","zIndex":42}|
{"type":"ATTR","ticket":413,"id":"e3a194c99f8e85c4"}||{"x":null,"y":null,"rotation":null,"color":null,"fontFamily":null,"fontSize":null,"fontWeight":null,"italic":null,"underline":null,"align":null,"value":"","keyVisible":null,"valueVisible":null,"key":"Output Current","fillColor":null,"parentId":"f2e48ec37a8f2db5","zIndex":43}|
{"type":"ATTR","ticket":414,"id":"b758926482467d18"}||{"x":null,"y":null,"rotation":null,"color":null,"fontFamily":null,"fontSize":null,"fontWeight":null,"italic":null,"underline":null,"align":null,"value":"","keyVisible":null,"valueVisible":null,"key":"Input Offset Current(Ios)","fillColor":null,"parentId":"f2e48ec37a8f2db5","zIndex":44}|
{"type":"ATTR","ticket":415,"id":"671f50c4df7da66a"}||{"x":null,"y":null,"rotation":null,"color":null,"fontFamily":null,"fontSize":null,"fontWeight":null,"italic":null,"underline":null,"align":null,"value":"","keyVisible":null,"valueVisible":null,"key":"Operating Temperature","fillColor":null,"parentId":"f2e48ec37a8f2db5","zIndex":45}|
{"type":"ATTR","ticket":416,"id":"e4ca06ac291bff5d"}||{"x":null,"y":null,"rotation":null,"color":null,"fontFamily":null,"fontSize":null,"fontWeight":null,"italic":null,"underline":null,"align":null,"value":"","keyVisible":null,"valueVisible":null,"key":"Features","fillColor":null,"parentId":"f2e48ec37a8f2db5","zIndex":46}|
{"type":"ATTR","ticket":417,"id":"7dc1feda3f0efd70"}||{"x":null,"y":null,"rotation":null,"color":null,"fontFamily":null,"fontSize":null,"fontWeight":null,"italic":null,"underline":null,"align":null,"value":"","keyVisible":null,"valueVisible":null,"key":"Description","fillColor":null,"parentId":"f2e48ec37a8f2db5","zIndex":47}|
{"type":"ATTR","ticket":418,"id":"34855b65d4a53fda"}||{"x":null,"y":null,"rotation":null,"color":null,"fontFamily":null,"fontSize":null,"fontWeight":null,"italic":null,"underline":null,"align":null,"value":"UNI-ROYAL(厚声)","keyVisible":null,"valueVisible":null,"key":"Manufacturer","fillColor":null,"parentId":"f7f5d17397a67241","zIndex":15}|
{"type":"ATTR","ticket":419,"id":"131477ed259003a7"}||{"x":null,"y":null,"rotation":null,"color":null,"fontFamily":null,"fontSize":null,"fontWeight":null,"italic":null,"underline":null,"align":null,"value":"0805W8F499JT5E","keyVisible":null,"valueVisible":null,"key":"Manufacturer Part","fillColor":null,"parentId":"f7f5d17397a67241","zIndex":16}|
{"type":"ATTR","ticket":420,"id":"528edbe9313b319a"}||{"x":null,"y":null,"rotation":null,"color":null,"fontFamily":null,"fontSize":null,"fontWeight":null,"italic":null,"underline":null,"align":null,"value":"LCSC","keyVisible":null,"valueVisible":null,"key":"Supplier","fillColor":null,"parentId":"f7f5d17397a67241","zIndex":17}|
{"type":"ATTR","ticket":421,"id":"f8317d4488bcaa08"}||{"x":null,"y":null,"rotation":null,"color":null,"fontFamily":null,"fontSize":null,"fontWeight":null,"italic":null,"underline":null,"align":null,"value":"0805W8F499JT5E.1","keyVisible":null,"valueVisible":null,"key":"Supplier Part","fillColor":null,"parentId":"f7f5d17397a67241","zIndex":18}|
{"type":"ATTR","ticket":422,"id":"462e460da16b756e"}||{"x":null,"y":null,"rotation":null,"color":null,"fontFamily":null,"fontSize":null,"fontWeight":null,"italic":null,"underline":null,"align":null,"value":"","keyVisible":null,"valueVisible":null,"key":"LCSC Part Name","fillColor":null,"parentId":"f7f5d17397a67241","zIndex":19}|
{"type":"ATTR","ticket":423,"id":"b27a58a0703627df"}||{"x":null,"y":null,"rotation":null,"color":null,"fontFamily":null,"fontSize":null,"fontWeight":null,"italic":null,"underline":null,"align":null,"value":"","keyVisible":null,"valueVisible":null,"key":"Supplier Footprint","fillColor":null,"parentId":"f7f5d17397a67241","zIndex":20}|
{"type":"ATTR","ticket":424,"id":"abf23df49e9452f3"}||{"x":null,"y":null,"rotation":null,"color":null,"fontFamily":null,"fontSize":null,"fontWeight":null,"italic":null,"underline":null,"align":null,"value":"","keyVisible":null,"valueVisible":null,"key":"JLCPCB Part Class","fillColor":null,"parentId":"f7f5d17397a67241","zIndex":21}|
{"type":"ATTR","ticket":425,"id":"ecf288e6db5070c4"}||{"x":null,"y":null,"rotation":null,"color":null,"fontFamily":null,"fontSize":null,"fontWeight":null,"italic":null,"underline":null,"align":null,"value":"","keyVisible":null,"valueVisible":null,"key":"Datasheet","fillColor":null,"parentId":"f7f5d17397a67241","zIndex":22}|
{"type":"ATTR","ticket":426,"id":"34736e444e84bdc1"}||{"x":null,"y":null,"rotation":null,"color":null,"fontFamily":null,"fontSize":null,"fontWeight":null,"italic":null,"underline":null,"align":null,"value":"","keyVisible":null,"valueVisible":null,"key":"Type","fillColor":null,"parentId":"f7f5d17397a67241","zIndex":23}|
{"type":"ATTR","ticket":427,"id":"96939f1a9d314726"}||{"x":null,"y":null,"rotation":null,"color":null,"fontFamily":null,"fontSize":null,"fontWeight":null,"italic":null,"underline":null,"align":null,"value":"49.9Ω","keyVisible":null,"valueVisible":null,"key":"Value","fillColor":null,"parentId":"f7f5d17397a67241","zIndex":24}|
{"type":"ATTR","ticket":428,"id":"1c3ce3ee78c94797"}||{"x":null,"y":null,"rotation":null,"color":null,"fontFamily":null,"fontSize":null,"fontWeight":null,"italic":null,"underline":null,"align":null,"value":"","keyVisible":null,"valueVisible":null,"key":"Tolerance","fillColor":null,"parentId":"f7f5d17397a67241","zIndex":25}|
{"type":"ATTR","ticket":429,"id":"fa8bfe91be86f3ad"}||{"x":null,"y":null,"rotation":null,"color":null,"fontFamily":null,"fontSize":null,"fontWeight":null,"italic":null,"underline":null,"align":null,"value":"","keyVisible":null,"valueVisible":null,"key":"Power(Watts)","fillColor":null,"parentId":"f7f5d17397a67241","zIndex":26}|
{"type":"ATTR","ticket":430,"id":"a95cd544e91d1786"}||{"x":null,"y":null,"rotation":null,"color":null,"fontFamily":null,"fontSize":null,"fontWeight":null,"italic":null,"underline":null,"align":null,"value":"","keyVisible":null,"valueVisible":null,"key":"Voltage-Supply(Max)","fillColor":null,"parentId":"f7f5d17397a67241","zIndex":27}|
{"type":"ATTR","ticket":431,"id":"634ca5c741fca327"}||{"x":null,"y":null,"rotation":null,"color":null,"fontFamily":null,"fontSize":null,"fontWeight":null,"italic":null,"underline":null,"align":null,"value":"","keyVisible":null,"valueVisible":null,"key":"Temperature Coefficient","fillColor":null,"parentId":"f7f5d17397a67241","zIndex":28}|
{"type":"ATTR","ticket":432,"id":"b73cda7d16a76779"}||{"x":null,"y":null,"rotation":null,"color":null,"fontFamily":null,"fontSize":null,"fontWeight":null,"italic":null,"underline":null,"align":null,"value":"","keyVisible":null,"valueVisible":null,"key":"Operating Temperature","fillColor":null,"parentId":"f7f5d17397a67241","zIndex":29}|
{"type":"ATTR","ticket":433,"id":"d5dbbc5d0cce9095"}||{"x":null,"y":null,"rotation":null,"color":null,"fontFamily":null,"fontSize":null,"fontWeight":null,"italic":null,"underline":null,"align":null,"value":"","keyVisible":null,"valueVisible":null,"key":"Description","fillColor":null,"parentId":"f7f5d17397a67241","zIndex":30}|
{"type":"ATTR","ticket":434,"id":"5dc72549465505b7"}||{"x":null,"y":null,"rotation":null,"color":null,"fontFamily":null,"fontSize":null,"fontWeight":null,"italic":null,"underline":null,"align":null,"value":"XR(祥如)","keyVisible":null,"valueVisible":null,"key":"Manufacturer","fillColor":null,"parentId":"40b59f91beff47c2","zIndex":18}|
{"type":"ATTR","ticket":435,"id":"bf671ec97eedc00d"}||{"x":null,"y":null,"rotation":null,"color":null,"fontFamily":null,"fontSize":null,"fontWeight":null,"italic":null,"underline":null,"align":null,"value":"XRCD54-120M","keyVisible":null,"valueVisible":null,"key":"Manufacturer Part","fillColor":null,"parentId":"40b59f91beff47c2","zIndex":19}|
{"type":"ATTR","ticket":436,"id":"130888c86b2fb255"}||{"x":null,"y":null,"rotation":null,"color":null,"fontFamily":null,"fontSize":null,"fontWeight":null,"italic":null,"underline":null,"align":null,"value":"LCSC","keyVisible":null,"valueVisible":null,"key":"Supplier","fillColor":null,"parentId":"40b59f91beff47c2","zIndex":20}|
{"type":"ATTR","ticket":437,"id":"f31497cf977e720e"}||{"x":null,"y":null,"rotation":null,"color":null,"fontFamily":null,"fontSize":null,"fontWeight":null,"italic":null,"underline":null,"align":null,"value":"XRCD54-120M.1","keyVisible":null,"valueVisible":null,"key":"Supplier Part","fillColor":null,"parentId":"40b59f91beff47c2","zIndex":21}|
{"type":"ATTR","ticket":438,"id":"e4774b5a20e16256"}||{"x":null,"y":null,"rotation":null,"color":null,"fontFamily":null,"fontSize":null,"fontWeight":null,"italic":null,"underline":null,"align":null,"value":"","keyVisible":null,"valueVisible":null,"key":"LCSC Part Name","fillColor":null,"parentId":"40b59f91beff47c2","zIndex":22}|
{"type":"ATTR","ticket":439,"id":"36c01fdec727b3dc"}||{"x":null,"y":null,"rotation":null,"color":null,"fontFamily":null,"fontSize":null,"fontWeight":null,"italic":null,"underline":null,"align":null,"value":"","keyVisible":null,"valueVisible":null,"key":"Supplier Footprint","fillColor":null,"parentId":"40b59f91beff47c2","zIndex":23}|
{"type":"ATTR","ticket":440,"id":"0444b2d877234ec9"}||{"x":null,"y":null,"rotation":null,"color":null,"fontFamily":null,"fontSize":null,"fontWeight":null,"italic":null,"underline":null,"align":null,"value":"","keyVisible":null,"valueVisible":null,"key":"JLCPCB Part Class","fillColor":null,"parentId":"40b59f91beff47c2","zIndex":24}|
{"type":"ATTR","ticket":441,"id":"4a56978659fc0ce6"}||{"x":null,"y":null,"rotation":null,"color":null,"fontFamily":null,"fontSize":null,"fontWeight":null,"italic":null,"underline":null,"align":null,"value":"","keyVisible":null,"valueVisible":null,"key":"Datasheet","fillColor":null,"parentId":"40b59f91beff47c2","zIndex":25}|
{"type":"ATTR","ticket":442,"id":"7520d36a8089fb12"}||{"x":null,"y":null,"rotation":null,"color":null,"fontFamily":null,"fontSize":null,"fontWeight":null,"italic":null,"underline":null,"align":null,"value":"12uH","keyVisible":null,"valueVisible":null,"key":"Value","fillColor":null,"parentId":"40b59f91beff47c2","zIndex":26}|
{"type":"ATTR","ticket":443,"id":"df8c06ac90e5cf8d"}||{"x":null,"y":null,"rotation":null,"color":null,"fontFamily":null,"fontSize":null,"fontWeight":null,"italic":null,"underline":null,"align":null,"value":"","keyVisible":null,"valueVisible":null,"key":"Tolerance","fillColor":null,"parentId":"40b59f91beff47c2","zIndex":27}|
{"type":"ATTR","ticket":444,"id":"12c77f583462abb0"}||{"x":null,"y":null,"rotation":null,"color":null,"fontFamily":null,"fontSize":null,"fontWeight":null,"italic":null,"underline":null,"align":null,"value":"","keyVisible":null,"valueVisible":null,"key":"Current Rating","fillColor":null,"parentId":"40b59f91beff47c2","zIndex":28}|
{"type":"ATTR","ticket":445,"id":"334fee635d7ab9fe"}||{"x":null,"y":null,"rotation":null,"color":null,"fontFamily":null,"fontSize":null,"fontWeight":null,"italic":null,"underline":null,"align":null,"value":"","keyVisible":null,"valueVisible":null,"key":"DC Resistance(DCR)","fillColor":null,"parentId":"40b59f91beff47c2","zIndex":29}|
{"type":"ATTR","ticket":446,"id":"72ce48b303593a8b"}||{"x":null,"y":null,"rotation":null,"color":null,"fontFamily":null,"fontSize":null,"fontWeight":null,"italic":null,"underline":null,"align":null,"value":"","keyVisible":null,"valueVisible":null,"key":"Type","fillColor":null,"parentId":"40b59f91beff47c2","zIndex":30}|
{"type":"ATTR","ticket":447,"id":"88d24334516142a1"}||{"x":null,"y":null,"rotation":null,"color":null,"fontFamily":null,"fontSize":null,"fontWeight":null,"italic":null,"underline":null,"align":null,"value":"","keyVisible":null,"valueVisible":null,"key":"Description","fillColor":null,"parentId":"40b59f91beff47c2","zIndex":31}|
{"type":"ATTR","ticket":448,"id":"1bb4d96e367749b0"}||{"x":null,"y":null,"rotation":null,"color":null,"fontFamily":null,"fontSize":null,"fontWeight":null,"italic":null,"underline":null,"align":null,"value":"UNI-ROYAL(厚声)","keyVisible":null,"valueVisible":null,"key":"Manufacturer","fillColor":null,"parentId":"8e69b0aeda799e9a","zIndex":15}|
{"type":"ATTR","ticket":449,"id":"dd196f65865de93b"}||{"x":null,"y":null,"rotation":null,"color":null,"fontFamily":null,"fontSize":null,"fontWeight":null,"italic":null,"underline":null,"align":null,"value":"0805W8F499JT5E","keyVisible":null,"valueVisible":null,"key":"Manufacturer Part","fillColor":null,"parentId":"8e69b0aeda799e9a","zIndex":16}|
{"type":"ATTR","ticket":450,"id":"44f265ed2e120719"}||{"x":null,"y":null,"rotation":null,"color":null,"fontFamily":null,"fontSize":null,"fontWeight":null,"italic":null,"underline":null,"align":null,"value":"LCSC","keyVisible":null,"valueVisible":null,"key":"Supplier","fillColor":null,"parentId":"8e69b0aeda799e9a","zIndex":17}|
{"type":"ATTR","ticket":451,"id":"2ced7ba01ec620b4"}||{"x":null,"y":null,"rotation":null,"color":null,"fontFamily":null,"fontSize":null,"fontWeight":null,"italic":null,"underline":null,"align":null,"value":"0805W8F499JT5E.1","keyVisible":null,"valueVisible":null,"key":"Supplier Part","fillColor":null,"parentId":"8e69b0aeda799e9a","zIndex":18}|
{"type":"ATTR","ticket":452,"id":"6ffeb1a86bf6e270"}||{"x":null,"y":null,"rotation":null,"color":null,"fontFamily":null,"fontSize":null,"fontWeight":null,"italic":null,"underline":null,"align":null,"value":"","keyVisible":null,"valueVisible":null,"key":"LCSC Part Name","fillColor":null,"parentId":"8e69b0aeda799e9a","zIndex":19}|
{"type":"ATTR","ticket":453,"id":"e8279613a2f2ed89"}||{"x":null,"y":null,"rotation":null,"color":null,"fontFamily":null,"fontSize":null,"fontWeight":null,"italic":null,"underline":null,"align":null,"value":"","keyVisible":null,"valueVisible":null,"key":"Supplier Footprint","fillColor":null,"parentId":"8e69b0aeda799e9a","zIndex":20}|
{"type":"ATTR","ticket":454,"id":"268e10a08760ee35"}||{"x":null,"y":null,"rotation":null,"color":null,"fontFamily":null,"fontSize":null,"fontWeight":null,"italic":null,"underline":null,"align":null,"value":"","keyVisible":null,"valueVisible":null,"key":"JLCPCB Part Class","fillColor":null,"parentId":"8e69b0aeda799e9a","zIndex":21}|
{"type":"ATTR","ticket":455,"id":"9ddb3e301c56fb14"}||{"x":null,"y":null,"rotation":null,"color":null,"fontFamily":null,"fontSize":null,"fontWeight":null,"italic":null,"underline":null,"align":null,"value":"","keyVisible":null,"valueVisible":null,"key":"Datasheet","fillColor":null,"parentId":"8e69b0aeda799e9a","zIndex":22}|
{"type":"ATTR","ticket":456,"id":"888dd71cdd997e79"}||{"x":null,"y":null,"rotation":null,"color":null,"fontFamily":null,"fontSize":null,"fontWeight":null,"italic":null,"underline":null,"align":null,"value":"","keyVisible":null,"valueVisible":null,"key":"Type","fillColor":null,"parentId":"8e69b0aeda799e9a","zIndex":23}|
{"type":"ATTR","ticket":457,"id":"1294006b710a69b3"}||{"x":null,"y":null,"rotation":null,"color":null,"fontFamily":null,"fontSize":null,"fontWeight":null,"italic":null,"underline":null,"align":null,"value":"49.9Ω","keyVisible":null,"valueVisible":null,"key":"Value","fillColor":null,"parentId":"8e69b0aeda799e9a","zIndex":24}|
{"type":"ATTR","ticket":458,"id":"97bd7806ab8f9b9f"}||{"x":null,"y":null,"rotation":null,"color":null,"fontFamily":null,"fontSize":null,"fontWeight":null,"italic":null,"underline":null,"align":null,"value":"","keyVisible":null,"valueVisible":null,"key":"Tolerance","fillColor":null,"parentId":"8e69b0aeda799e9a","zIndex":25}|
{"type":"ATTR","ticket":459,"id":"a50d88c0f5eaa3bb"}||{"x":null,"y":null,"rotation":null,"color":null,"fontFamily":null,"fontSize":null,"fontWeight":null,"italic":null,"underline":null,"align":null,"value":"","keyVisible":null,"valueVisible":null,"key":"Power(Watts)","fillColor":null,"parentId":"8e69b0aeda799e9a","zIndex":26}|
{"type":"ATTR","ticket":460,"id":"6bf209c8e339028c"}||{"x":null,"y":null,"rotation":null,"color":null,"fontFamily":null,"fontSize":null,"fontWeight":null,"italic":null,"underline":null,"align":null,"value":"","keyVisible":null,"valueVisible":null,"key":"Voltage-Supply(Max)","fillColor":null,"parentId":"8e69b0aeda799e9a","zIndex":27}|
{"type":"ATTR","ticket":461,"id":"6ecd11387269cbed"}||{"x":null,"y":null,"rotation":null,"color":null,"fontFamily":null,"fontSize":null,"fontWeight":null,"italic":null,"underline":null,"align":null,"value":"","keyVisible":null,"valueVisible":null,"key":"Temperature Coefficient","fillColor":null,"parentId":"8e69b0aeda799e9a","zIndex":28}|
{"type":"ATTR","ticket":462,"id":"bfcf61be22a23a48"}||{"x":null,"y":null,"rotation":null,"color":null,"fontFamily":null,"fontSize":null,"fontWeight":null,"italic":null,"underline":null,"align":null,"value":"","keyVisible":null,"valueVisible":null,"key":"Operating Temperature","fillColor":null,"parentId":"8e69b0aeda799e9a","zIndex":29}|
{"type":"ATTR","ticket":463,"id":"8a6912d7cf462521"}||{"x":null,"y":null,"rotation":null,"color":null,"fontFamily":null,"fontSize":null,"fontWeight":null,"italic":null,"underline":null,"align":null,"value":"","keyVisible":null,"valueVisible":null,"key":"Description","fillColor":null,"parentId":"8e69b0aeda799e9a","zIndex":30}|
{"type":"ATTR","ticket":464,"id":"64fbf9ab7c6bde3c"}||{"x":null,"y":null,"rotation":null,"color":null,"fontFamily":null,"fontSize":null,"fontWeight":null,"italic":null,"underline":null,"align":null,"value":"FH(风华)","keyVisible":null,"valueVisible":null,"key":"Manufacturer","fillColor":null,"parentId":"902f4e53ca743fca","zIndex":18}|
{"type":"ATTR","ticket":465,"id":"b6b5b5c9f3a7aac2"}||{"x":null,"y":null,"rotation":null,"color":null,"fontFamily":null,"fontSize":null,"fontWeight":null,"italic":null,"underline":null,"align":null,"value":"1206CG104J500NT","keyVisible":null,"valueVisible":null,"key":"Manufacturer Part","fillColor":null,"parentId":"902f4e53ca743fca","zIndex":19}|
{"type":"ATTR","ticket":466,"id":"e79bf5a562015605"}||{"x":null,"y":null,"rotation":null,"color":null,"fontFamily":null,"fontSize":null,"fontWeight":null,"italic":null,"underline":null,"align":null,"value":"LCSC","keyVisible":null,"valueVisible":null,"key":"Supplier","fillColor":null,"parentId":"902f4e53ca743fca","zIndex":20}|
{"type":"ATTR","ticket":467,"id":"14ad82c26f00190f"}||{"x":null,"y":null,"rotation":null,"color":null,"fontFamily":null,"fontSize":null,"fontWeight":null,"italic":null,"underline":null,"align":null,"value":"1206CG104J500NT.1","keyVisible":null,"valueVisible":null,"key":"Supplier Part","fillColor":null,"parentId":"902f4e53ca743fca","zIndex":21}|
{"type":"ATTR","ticket":468,"id":"45f37c2d9bc8bbd7"}||{"x":null,"y":null,"rotation":null,"color":null,"fontFamily":null,"fontSize":null,"fontWeight":null,"italic":null,"underline":null,"align":null,"value":"","keyVisible":null,"valueVisible":null,"key":"LCSC Part Name","fillColor":null,"parentId":"902f4e53ca743fca","zIndex":22}|
{"type":"ATTR","ticket":469,"id":"f51b706415020050"}||{"x":null,"y":null,"rotation":null,"color":null,"fontFamily":null,"fontSize":null,"fontWeight":null,"italic":null,"underline":null,"align":null,"value":"","keyVisible":null,"valueVisible":null,"key":"Supplier Footprint","fillColor":null,"parentId":"902f4e53ca743fca","zIndex":23}|
{"type":"ATTR","ticket":470,"id":"2a3ab4d3da4fd66a"}||{"x":null,"y":null,"rotation":null,"color":null,"fontFamily":null,"fontSize":null,"fontWeight":null,"italic":null,"underline":null,"align":null,"value":"","keyVisible":null,"valueVisible":null,"key":"JLCPCB Part Class","fillColor":null,"parentId":"902f4e53ca743fca","zIndex":24}|
{"type":"ATTR","ticket":471,"id":"950f71d60e36c6eb"}||{"x":null,"y":null,"rotation":null,"color":null,"fontFamily":null,"fontSize":null,"fontWeight":null,"italic":null,"underline":null,"align":null,"value":"","keyVisible":null,"valueVisible":null,"key":"Datasheet","fillColor":null,"parentId":"902f4e53ca743fca","zIndex":25}|
{"type":"ATTR","ticket":472,"id":"e05718e767fecc95"}||{"x":null,"y":null,"rotation":null,"color":null,"fontFamily":null,"fontSize":null,"fontWeight":null,"italic":null,"underline":null,"align":null,"value":"100nF","keyVisible":null,"valueVisible":null,"key":"Value","fillColor":null,"parentId":"902f4e53ca743fca","zIndex":26}|
{"type":"ATTR","ticket":473,"id":"2bee08a62bda6d4f"}||{"x":null,"y":null,"rotation":null,"color":null,"fontFamily":null,"fontSize":null,"fontWeight":null,"italic":null,"underline":null,"align":null,"value":"","keyVisible":null,"valueVisible":null,"key":"Tolerance","fillColor":null,"parentId":"902f4e53ca743fca","zIndex":27}|
{"type":"ATTR","ticket":474,"id":"ffe640b131a89871"}||{"x":null,"y":null,"rotation":null,"color":null,"fontFamily":null,"fontSize":null,"fontWeight":null,"italic":null,"underline":null,"align":null,"value":"","keyVisible":null,"valueVisible":null,"key":"Voltage Rating","fillColor":null,"parentId":"902f4e53ca743fca","zIndex":28}|
{"type":"ATTR","ticket":475,"id":"152edefab27062c0"}||{"x":null,"y":null,"rotation":null,"color":null,"fontFamily":null,"fontSize":null,"fontWeight":null,"italic":null,"underline":null,"align":null,"value":"","keyVisible":null,"valueVisible":null,"key":"Temperature Coefficient","fillColor":null,"parentId":"902f4e53ca743fca","zIndex":29}|
{"type":"ATTR","ticket":476,"id":"c1f254ebcb5834a5"}||{"x":null,"y":null,"rotation":null,"color":null,"fontFamily":null,"fontSize":null,"fontWeight":null,"italic":null,"underline":null,"align":null,"value":"","keyVisible":null,"valueVisible":null,"key":"Description","fillColor":null,"parentId":"902f4e53ca743fca","zIndex":30}|
{"type":"ATTR","ticket":477,"id":"6cd46066ff6939b4"}||{"x":null,"y":null,"rotation":null,"color":null,"fontFamily":null,"fontSize":null,"fontWeight":null,"italic":null,"underline":null,"align":null,"value":"UNI-ROYAL(厚声)","keyVisible":null,"valueVisible":null,"key":"Manufacturer","fillColor":null,"parentId":"d70e53b3866f3ecd","zIndex":15}|
{"type":"ATTR","ticket":478,"id":"6c9a014f5e054300"}||{"x":null,"y":null,"rotation":null,"color":null,"fontFamily":null,"fontSize":null,"fontWeight":null,"italic":null,"underline":null,"align":null,"value":"0805W8F1002T5E","keyVisible":null,"valueVisible":null,"key":"Manufacturer Part","fillColor":null,"parentId":"d70e53b3866f3ecd","zIndex":16}|
{"type":"ATTR","ticket":479,"id":"2098e76c94a29a61"}||{"x":null,"y":null,"rotation":null,"color":null,"fontFamily":null,"fontSize":null,"fontWeight":null,"italic":null,"underline":null,"align":null,"value":"LCSC","keyVisible":null,"valueVisible":null,"key":"Supplier","fillColor":null,"parentId":"d70e53b3866f3ecd","zIndex":17}|
{"type":"ATTR","ticket":480,"id":"5ef04c5c4cd600a8"}||{"x":null,"y":null,"rotation":null,"color":null,"fontFamily":null,"fontSize":null,"fontWeight":null,"italic":null,"underline":null,"align":null,"value":"0805W8F1002T5E.1","keyVisible":null,"valueVisible":null,"key":"Supplier Part","fillColor":null,"parentId":"d70e53b3866f3ecd","zIndex":18}|
{"type":"ATTR","ticket":481,"id":"61115bd4679f9abb"}||{"x":null,"y":null,"rotation":null,"color":null,"fontFamily":null,"fontSize":null,"fontWeight":null,"italic":null,"underline":null,"align":null,"value":"","keyVisible":null,"valueVisible":null,"key":"LCSC Part Name","fillColor":null,"parentId":"d70e53b3866f3ecd","zIndex":19}|
{"type":"ATTR","ticket":482,"id":"c2f808475d7f0653"}||{"x":null,"y":null,"rotation":null,"color":null,"fontFamily":null,"fontSize":null,"fontWeight":null,"italic":null,"underline":null,"align":null,"value":"","keyVisible":null,"valueVisible":null,"key":"Supplier Footprint","fillColor":null,"parentId":"d70e53b3866f3ecd","zIndex":20}|
{"type":"ATTR","ticket":483,"id":"188aa2d6fa22f445"}||{"x":null,"y":null,"rotation":null,"color":null,"fontFamily":null,"fontSize":null,"fontWeight":null,"italic":null,"underline":null,"align":null,"value":"","keyVisible":null,"valueVisible":null,"key":"JLCPCB Part Class","fillColor":null,"parentId":"d70e53b3866f3ecd","zIndex":21}|
{"type":"ATTR","ticket":484,"id":"817f205c1673d7cd"}||{"x":null,"y":null,"rotation":null,"color":null,"fontFamily":null,"fontSize":null,"fontWeight":null,"italic":null,"underline":null,"align":null,"value":"","keyVisible":null,"valueVisible":null,"key":"Datasheet","fillColor":null,"parentId":"d70e53b3866f3ecd","zIndex":22}|
{"type":"ATTR","ticket":485,"id":"08a55c1e4b692dd9"}||{"x":null,"y":null,"rotation":null,"color":null,"fontFamily":null,"fontSize":null,"fontWeight":null,"italic":null,"underline":null,"align":null,"value":"","keyVisible":null,"valueVisible":null,"key":"Type","fillColor":null,"parentId":"d70e53b3866f3ecd","zIndex":23}|
{"type":"ATTR","ticket":486,"id":"53fd64881545ef3b"}||{"x":null,"y":null,"rotation":null,"color":null,"fontFamily":null,"fontSize":null,"fontWeight":null,"italic":null,"underline":null,"align":null,"value":"10kΩ","keyVisible":null,"valueVisible":null,"key":"Value","fillColor":null,"parentId":"d70e53b3866f3ecd","zIndex":24}|
{"type":"ATTR","ticket":487,"id":"d7a956726c1a1a18"}||{"x":null,"y":null,"rotation":null,"color":null,"fontFamily":null,"fontSize":null,"fontWeight":null,"italic":null,"underline":null,"align":null,"value":"","keyVisible":null,"valueVisible":null,"key":"Tolerance","fillColor":null,"parentId":"d70e53b3866f3ecd","zIndex":25}|
{"type":"ATTR","ticket":488,"id":"7ded12abe68baaad"}||{"x":null,"y":null,"rotation":null,"color":null,"fontFamily":null,"fontSize":null,"fontWeight":null,"italic":null,"underline":null,"align":null,"value":"","keyVisible":null,"valueVisible":null,"key":"Power(Watts)","fillColor":null,"parentId":"d70e53b3866f3ecd","zIndex":26}|
{"type":"ATTR","ticket":489,"id":"e4ddce6344370092"}||{"x":null,"y":null,"rotation":null,"color":null,"fontFamily":null,"fontSize":null,"fontWeight":null,"italic":null,"underline":null,"align":null,"value":"","keyVisible":null,"valueVisible":null,"key":"Voltage-Supply(Max)","fillColor":null,"parentId":"d70e53b3866f3ecd","zIndex":27}|
{"type":"ATTR","ticket":490,"id":"a116c67830e3440c"}||{"x":null,"y":null,"rotation":null,"color":null,"fontFamily":null,"fontSize":null,"fontWeight":null,"italic":null,"underline":null,"align":null,"value":"","keyVisible":null,"valueVisible":null,"key":"Temperature Coefficient","fillColor":null,"parentId":"d70e53b3866f3ecd","zIndex":28}|
{"type":"ATTR","ticket":491,"id":"3ba1d11facacdf1d"}||{"x":null,"y":null,"rotation":null,"color":null,"fontFamily":null,"fontSize":null,"fontWeight":null,"italic":null,"underline":null,"align":null,"value":"","keyVisible":null,"valueVisible":null,"key":"Operating Temperature","fillColor":null,"parentId":"d70e53b3866f3ecd","zIndex":29}|
{"type":"ATTR","ticket":492,"id":"270315d8a598a05a"}||{"x":null,"y":null,"rotation":null,"color":null,"fontFamily":null,"fontSize":null,"fontWeight":null,"italic":null,"underline":null,"align":null,"value":"","keyVisible":null,"valueVisible":null,"key":"Description","fillColor":null,"parentId":"d70e53b3866f3ecd","zIndex":30}|
{"type":"ATTR","ticket":493,"id":"e3cda860c3729175"}||{"x":null,"y":null,"rotation":null,"color":null,"fontFamily":null,"fontSize":null,"fontWeight":null,"italic":null,"underline":null,"align":null,"value":"UNI-ROYAL(厚声)","keyVisible":null,"valueVisible":null,"key":"Manufacturer","fillColor":null,"parentId":"fabf9e67c19f63d3","zIndex":15}|
{"type":"ATTR","ticket":494,"id":"07296a93393cf3fe"}||{"x":null,"y":null,"rotation":null,"color":null,"fontFamily":null,"fontSize":null,"fontWeight":null,"italic":null,"underline":null,"align":null,"value":"0805W8F3002T5E","keyVisible":null,"valueVisible":null,"key":"Manufacturer Part","fillColor":null,"parentId":"fabf9e67c19f63d3","zIndex":16}|
{"type":"ATTR","ticket":495,"id":"fe4af5c6b26bb71c"}||{"x":null,"y":null,"rotation":null,"color":null,"fontFamily":null,"fontSize":null,"fontWeight":null,"italic":null,"underline":null,"align":null,"value":"LCSC","keyVisible":null,"valueVisible":null,"key":"Supplier","fillColor":null,"parentId":"fabf9e67c19f63d3","zIndex":17}|
{"type":"ATTR","ticket":496,"id":"1bbf423a8e6d0de1"}||{"x":null,"y":null,"rotation":null,"color":null,"fontFamily":null,"fontSize":null,"fontWeight":null,"italic":null,"underline":null,"align":null,"value":"0805W8F3002T5E.1","keyVisible":null,"valueVisible":null,"key":"Supplier Part","fillColor":null,"parentId":"fabf9e67c19f63d3","zIndex":18}|
{"type":"ATTR","ticket":497,"id":"9f37add05ac47711"}||{"x":null,"y":null,"rotation":null,"color":null,"fontFamily":null,"fontSize":null,"fontWeight":null,"italic":null,"underline":null,"align":null,"value":"","keyVisible":null,"valueVisible":null,"key":"LCSC Part Name","fillColor":null,"parentId":"fabf9e67c19f63d3","zIndex":19}|
{"type":"ATTR","ticket":498,"id":"9fb780b7c8c1383e"}||{"x":null,"y":null,"rotation":null,"color":null,"fontFamily":null,"fontSize":null,"fontWeight":null,"italic":null,"underline":null,"align":null,"value":"","keyVisible":null,"valueVisible":null,"key":"Supplier Footprint","fillColor":null,"parentId":"fabf9e67c19f63d3","zIndex":20}|
{"type":"ATTR","ticket":499,"id":"eb780b28e61ab548"}||{"x":null,"y":null,"rotation":null,"color":null,"fontFamily":null,"fontSize":null,"fontWeight":null,"italic":null,"underline":null,"align":null,"value":"","keyVisible":null,"valueVisible":null,"key":"JLCPCB Part Class","fillColor":null,"parentId":"fabf9e67c19f63d3","zIndex":21}|
{"type":"ATTR","ticket":500,"id":"3139fcf48869d58b"}||{"x":null,"y":null,"rotation":null,"color":null,"fontFamily":null,"fontSize":null,"fontWeight":null,"italic":null,"underline":null,"align":null,"value":"","keyVisible":null,"valueVisible":null,"key":"Datasheet","fillColor":null,"parentId":"fabf9e67c19f63d3","zIndex":22}|
{"type":"ATTR","ticket":501,"id":"bc5ce06f9a56e208"}||{"x":null,"y":null,"rotation":null,"color":null,"fontFamily":null,"fontSize":null,"fontWeight":null,"italic":null,"underline":null,"align":null,"value":"","keyVisible":null,"valueVisible":null,"key":"Type","fillColor":null,"parentId":"fabf9e67c19f63d3","zIndex":23}|
{"type":"ATTR","ticket":502,"id":"9f0d9dcc24172795"}||{"x":null,"y":null,"rotation":null,"color":null,"fontFamily":null,"fontSize":null,"fontWeight":null,"italic":null,"underline":null,"align":null,"value":"30kΩ","keyVisible":null,"valueVisible":null,"key":"Value","fillColor":null,"parentId":"fabf9e67c19f63d3","zIndex":24}|
{"type":"ATTR","ticket":503,"id":"b3aff4add9a28fff"}||{"x":null,"y":null,"rotation":null,"color":null,"fontFamily":null,"fontSize":null,"fontWeight":null,"italic":null,"underline":null,"align":null,"value":"","keyVisible":null,"valueVisible":null,"key":"Tolerance","fillColor":null,"parentId":"fabf9e67c19f63d3","zIndex":25}|
{"type":"ATTR","ticket":504,"id":"cf75c7c8c494bf8d"}||{"x":null,"y":null,"rotation":null,"color":null,"fontFamily":null,"fontSize":null,"fontWeight":null,"italic":null,"underline":null,"align":null,"value":"","keyVisible":null,"valueVisible":null,"key":"Power(Watts)","fillColor":null,"parentId":"fabf9e67c19f63d3","zIndex":26}|
{"type":"ATTR","ticket":505,"id":"cec1a1834b16453a"}||{"x":null,"y":null,"rotation":null,"color":null,"fontFamily":null,"fontSize":null,"fontWeight":null,"italic":null,"underline":null,"align":null,"value":"","keyVisible":null,"valueVisible":null,"key":"Voltage-Supply(Max)","fillColor":null,"parentId":"fabf9e67c19f63d3","zIndex":27}|
{"type":"ATTR","ticket":506,"id":"b6bc4522d9ab39e0"}||{"x":null,"y":null,"rotation":null,"color":null,"fontFamily":null,"fontSize":null,"fontWeight":null,"italic":null,"underline":null,"align":null,"value":"","keyVisible":null,"valueVisible":null,"key":"Temperature Coefficient","fillColor":null,"parentId":"fabf9e67c19f63d3","zIndex":28}|
{"type":"ATTR","ticket":507,"id":"16e05c71ad17be5f"}||{"x":null,"y":null,"rotation":null,"color":null,"fontFamily":null,"fontSize":null,"fontWeight":null,"italic":null,"underline":null,"align":null,"value":"","keyVisible":null,"valueVisible":null,"key":"Operating Temperature","fillColor":null,"parentId":"fabf9e67c19f63d3","zIndex":29}|
{"type":"ATTR","ticket":508,"id":"b8afe42229050c39"}||{"x":null,"y":null,"rotation":null,"color":null,"fontFamily":null,"fontSize":null,"fontWeight":null,"italic":null,"underline":null,"align":null,"value":"","keyVisible":null,"valueVisible":null,"key":"Description","fillColor":null,"parentId":"fabf9e67c19f63d3","zIndex":30}|
{"type":"ATTR","ticket":509,"id":"01be7c4b6d145d49"}||{"x":null,"y":null,"rotation":null,"color":null,"fontFamily":null,"fontSize":null,"fontWeight":null,"italic":null,"underline":null,"align":null,"value":"UNI-ROYAL(厚声)","keyVisible":null,"valueVisible":null,"key":"Manufacturer","fillColor":null,"parentId":"9ba8c1a80e6e633e","zIndex":15}|
{"type":"ATTR","ticket":510,"id":"9e181498a9550e10"}||{"x":null,"y":null,"rotation":null,"color":null,"fontFamily":null,"fontSize":null,"fontWeight":null,"italic":null,"underline":null,"align":null,"value":"0805W8F1002T5E","keyVisible":null,"valueVisible":null,"key":"Manufacturer Part","fillColor":null,"parentId":"9ba8c1a80e6e633e","zIndex":16}|
{"type":"ATTR","ticket":511,"id":"e1073cc628e1158e"}||{"x":null,"y":null,"rotation":null,"color":null,"fontFamily":null,"fontSize":null,"fontWeight":null,"italic":null,"underline":null,"align":null,"value":"LCSC","keyVisible":null,"valueVisible":null,"key":"Supplier","fillColor":null,"parentId":"9ba8c1a80e6e633e","zIndex":17}|
{"type":"ATTR","ticket":512,"id":"cb4b13ad8ae1f993"}||{"x":null,"y":null,"rotation":null,"color":null,"fontFamily":null,"fontSize":null,"fontWeight":null,"italic":null,"underline":null,"align":null,"value":"0805W8F1002T5E.1","keyVisible":null,"valueVisible":null,"key":"Supplier Part","fillColor":null,"parentId":"9ba8c1a80e6e633e","zIndex":18}|
{"type":"ATTR","ticket":513,"id":"2d31ec56a7cd7ff7"}||{"x":null,"y":null,"rotation":null,"color":null,"fontFamily":null,"fontSize":null,"fontWeight":null,"italic":null,"underline":null,"align":null,"value":"","keyVisible":null,"valueVisible":null,"key":"LCSC Part Name","fillColor":null,"parentId":"9ba8c1a80e6e633e","zIndex":19}|
{"type":"ATTR","ticket":514,"id":"01ef8bb162ce5cdb"}||{"x":null,"y":null,"rotation":null,"color":null,"fontFamily":null,"fontSize":null,"fontWeight":null,"italic":null,"underline":null,"align":null,"value":"","keyVisible":null,"valueVisible":null,"key":"Supplier Footprint","fillColor":null,"parentId":"9ba8c1a80e6e633e","zIndex":20}|
{"type":"ATTR","ticket":515,"id":"9f390c98f2a82d68"}||{"x":null,"y":null,"rotation":null,"color":null,"fontFamily":null,"fontSize":null,"fontWeight":null,"italic":null,"underline":null,"align":null,"value":"","keyVisible":null,"valueVisible":null,"key":"JLCPCB Part Class","fillColor":null,"parentId":"9ba8c1a80e6e633e","zIndex":21}|
{"type":"ATTR","ticket":516,"id":"0eda2b4ca4181811"}||{"x":null,"y":null,"rotation":null,"color":null,"fontFamily":null,"fontSize":null,"fontWeight":null,"italic":null,"underline":null,"align":null,"value":"","keyVisible":null,"valueVisible":null,"key":"Datasheet","fillColor":null,"parentId":"9ba8c1a80e6e633e","zIndex":22}|
{"type":"ATTR","ticket":517,"id":"715b3204ffcc46cf"}||{"x":null,"y":null,"rotation":null,"color":null,"fontFamily":null,"fontSize":null,"fontWeight":null,"italic":null,"underline":null,"align":null,"value":"","keyVisible":null,"valueVisible":null,"key":"Type","fillColor":null,"parentId":"9ba8c1a80e6e633e","zIndex":23}|
{"type":"ATTR","ticket":518,"id":"566c787bd552ecaa"}||{"x":null,"y":null,"rotation":null,"color":null,"fontFamily":null,"fontSize":null,"fontWeight":null,"italic":null,"underline":null,"align":null,"value":"10kΩ","keyVisible":null,"valueVisible":null,"key":"Value","fillColor":null,"parentId":"9ba8c1a80e6e633e","zIndex":24}|
{"type":"ATTR","ticket":519,"id":"ad5d2e4b9d76db13"}||{"x":null,"y":null,"rotation":null,"color":null,"fontFamily":null,"fontSize":null,"fontWeight":null,"italic":null,"underline":null,"align":null,"value":"","keyVisible":null,"valueVisible":null,"key":"Tolerance","fillColor":null,"parentId":"9ba8c1a80e6e633e","zIndex":25}|
{"type":"ATTR","ticket":520,"id":"967ba0889ccb608b"}||{"x":null,"y":null,"rotation":null,"color":null,"fontFamily":null,"fontSize":null,"fontWeight":null,"italic":null,"underline":null,"align":null,"value":"","keyVisible":null,"valueVisible":null,"key":"Power(Watts)","fillColor":null,"parentId":"9ba8c1a80e6e633e","zIndex":26}|
{"type":"ATTR","ticket":521,"id":"ab63da67adea6ee0"}||{"x":null,"y":null,"rotation":null,"color":null,"fontFamily":null,"fontSize":null,"fontWeight":null,"italic":null,"underline":null,"align":null,"value":"","keyVisible":null,"valueVisible":null,"key":"Voltage-Supply(Max)","fillColor":null,"parentId":"9ba8c1a80e6e633e","zIndex":27}|
{"type":"ATTR","ticket":522,"id":"2cbdc2cea01c61ec"}||{"x":null,"y":null,"rotation":null,"color":null,"fontFamily":null,"fontSize":null,"fontWeight":null,"italic":null,"underline":null,"align":null,"value":"","keyVisible":null,"valueVisible":null,"key":"Temperature Coefficient","fillColor":null,"parentId":"9ba8c1a80e6e633e","zIndex":28}|
{"type":"ATTR","ticket":523,"id":"014070a380344638"}||{"x":null,"y":null,"rotation":null,"color":null,"fontFamily":null,"fontSize":null,"fontWeight":null,"italic":null,"underline":null,"align":null,"value":"","keyVisible":null,"valueVisible":null,"key":"Operating Temperature","fillColor":null,"parentId":"9ba8c1a80e6e633e","zIndex":29}|
{"type":"ATTR","ticket":524,"id":"79189d1d7c119a73"}||{"x":null,"y":null,"rotation":null,"color":null,"fontFamily":null,"fontSize":null,"fontWeight":null,"italic":null,"underline":null,"align":null,"value":"","keyVisible":null,"valueVisible":null,"key":"Description","fillColor":null,"parentId":"9ba8c1a80e6e633e","zIndex":30}|
{"type":"ATTR","ticket":525,"id":"83426b4e9bf0ee99"}||{"x":null,"y":null,"rotation":null,"color":null,"fontFamily":null,"fontSize":null,"fontWeight":null,"italic":null,"underline":null,"align":null,"value":"SAMSUNG(三星)","keyVisible":null,"valueVisible":null,"key":"Manufacturer","fillColor":null,"parentId":"543633c01b8faf64","zIndex":18}|
{"type":"ATTR","ticket":526,"id":"640c3b236c7df103"}||{"x":null,"y":null,"rotation":null,"color":null,"fontFamily":null,"fontSize":null,"fontWeight":null,"italic":null,"underline":null,"align":null,"value":"CL10C471JB8NNNC","keyVisible":null,"valueVisible":null,"key":"Manufacturer Part","fillColor":null,"parentId":"543633c01b8faf64","zIndex":19}|
{"type":"ATTR","ticket":527,"id":"d798a0cf805f3f93"}||{"x":null,"y":null,"rotation":null,"color":null,"fontFamily":null,"fontSize":null,"fontWeight":null,"italic":null,"underline":null,"align":null,"value":"LCSC","keyVisible":null,"valueVisible":null,"key":"Supplier","fillColor":null,"parentId":"543633c01b8faf64","zIndex":20}|
{"type":"ATTR","ticket":528,"id":"9a29dd3fe2c882b3"}||{"x":null,"y":null,"rotation":null,"color":null,"fontFamily":null,"fontSize":null,"fontWeight":null,"italic":null,"underline":null,"align":null,"value":"CL10C471JB8NNNC.1","keyVisible":null,"valueVisible":null,"key":"Supplier Part","fillColor":null,"parentId":"543633c01b8faf64","zIndex":21}|
{"type":"ATTR","ticket":529,"id":"2e6e302b8c80ac56"}||{"x":null,"y":null,"rotation":null,"color":null,"fontFamily":null,"fontSize":null,"fontWeight":null,"italic":null,"underline":null,"align":null,"value":"","keyVisible":null,"valueVisible":null,"key":"LCSC Part Name","fillColor":null,"parentId":"543633c01b8faf64","zIndex":22}|
{"type":"ATTR","ticket":530,"id":"3fcf8b5d82276de8"}||{"x":null,"y":null,"rotation":null,"color":null,"fontFamily":null,"fontSize":null,"fontWeight":null,"italic":null,"underline":null,"align":null,"value":"","keyVisible":null,"valueVisible":null,"key":"Supplier Footprint","fillColor":null,"parentId":"543633c01b8faf64","zIndex":23}|
{"type":"ATTR","ticket":531,"id":"385d427d4662165a"}||{"x":null,"y":null,"rotation":null,"color":null,"fontFamily":null,"fontSize":null,"fontWeight":null,"italic":null,"underline":null,"align":null,"value":"","keyVisible":null,"valueVisible":null,"key":"JLCPCB Part Class","fillColor":null,"parentId":"543633c01b8faf64","zIndex":24}|
{"type":"ATTR","ticket":532,"id":"9df4e8e4a5c4259f"}||{"x":null,"y":null,"rotation":null,"color":null,"fontFamily":null,"fontSize":null,"fontWeight":null,"italic":null,"underline":null,"align":null,"value":"","keyVisible":null,"valueVisible":null,"key":"Datasheet","fillColor":null,"parentId":"543633c01b8faf64","zIndex":25}|
{"type":"ATTR","ticket":533,"id":"8fb203d3416a7dfc"}||{"x":null,"y":null,"rotation":null,"color":null,"fontFamily":null,"fontSize":null,"fontWeight":null,"italic":null,"underline":null,"align":null,"value":"470pF","keyVisible":null,"valueVisible":null,"key":"Value","fillColor":null,"parentId":"543633c01b8faf64","zIndex":26}|
{"type":"ATTR","ticket":534,"id":"a856b2e2083e723d"}||{"x":null,"y":null,"rotation":null,"color":null,"fontFamily":null,"fontSize":null,"fontWeight":null,"italic":null,"underline":null,"align":null,"value":"","keyVisible":null,"valueVisible":null,"key":"Tolerance","fillColor":null,"parentId":"543633c01b8faf64","zIndex":27}|
{"type":"ATTR","ticket":535,"id":"8b2f03b81b18cc02"}||{"x":null,"y":null,"rotation":null,"color":null,"fontFamily":null,"fontSize":null,"fontWeight":null,"italic":null,"underline":null,"align":null,"value":"","keyVisible":null,"valueVisible":null,"key":"Voltage Rating","fillColor":null,"parentId":"543633c01b8faf64","zIndex":28}|
{"type":"ATTR","ticket":536,"id":"b29b783b7d31ecdc"}||{"x":null,"y":null,"rotation":null,"color":null,"fontFamily":null,"fontSize":null,"fontWeight":null,"italic":null,"underline":null,"align":null,"value":"","keyVisible":null,"valueVisible":null,"key":"Temperature Coefficient","fillColor":null,"parentId":"543633c01b8faf64","zIndex":29}|
{"type":"ATTR","ticket":537,"id":"fd653c5f35b1df4b"}||{"x":null,"y":null,"rotation":null,"color":null,"fontFamily":null,"fontSize":null,"fontWeight":null,"italic":null,"underline":null,"align":null,"value":"","keyVisible":null,"valueVisible":null,"key":"Description","fillColor":null,"parentId":"543633c01b8faf64","zIndex":30}|
{"type":"ATTR","ticket":538,"id":"64370a01dc508a72"}||{"x":null,"y":null,"rotation":null,"color":null,"fontFamily":null,"fontSize":null,"fontWeight":null,"italic":null,"underline":null,"align":null,"value":"UNI-ROYAL(厚声)","keyVisible":null,"valueVisible":null,"key":"Manufacturer","fillColor":null,"parentId":"d4cb833c0ea07861","zIndex":15}|
{"type":"ATTR","ticket":539,"id":"e0f2a12777dd0823"}||{"x":null,"y":null,"rotation":null,"color":null,"fontFamily":null,"fontSize":null,"fontWeight":null,"italic":null,"underline":null,"align":null,"value":"0805W8F0000T5E","keyVisible":null,"valueVisible":null,"key":"Manufacturer Part","fillColor":null,"parentId":"d4cb833c0ea07861","zIndex":16}|
{"type":"ATTR","ticket":540,"id":"350d92b396d1fe63"}||{"x":null,"y":null,"rotation":null,"color":null,"fontFamily":null,"fontSize":null,"fontWeight":null,"italic":null,"underline":null,"align":null,"value":"LCSC","keyVisible":null,"valueVisible":null,"key":"Supplier","fillColor":null,"parentId":"d4cb833c0ea07861","zIndex":17}|
{"type":"ATTR","ticket":541,"id":"55d2f4eda4b8ee37"}||{"x":null,"y":null,"rotation":null,"color":null,"fontFamily":null,"fontSize":null,"fontWeight":null,"italic":null,"underline":null,"align":null,"value":"0805W8F0000T5E.1","keyVisible":null,"valueVisible":null,"key":"Supplier Part","fillColor":null,"parentId":"d4cb833c0ea07861","zIndex":18}|
{"type":"ATTR","ticket":542,"id":"aea424a3328735fd"}||{"x":null,"y":null,"rotation":null,"color":null,"fontFamily":null,"fontSize":null,"fontWeight":null,"italic":null,"underline":null,"align":null,"value":"","keyVisible":null,"valueVisible":null,"key":"LCSC Part Name","fillColor":null,"parentId":"d4cb833c0ea07861","zIndex":19}|
{"type":"ATTR","ticket":543,"id":"6a953915f87f9db8"}||{"x":null,"y":null,"rotation":null,"color":null,"fontFamily":null,"fontSize":null,"fontWeight":null,"italic":null,"underline":null,"align":null,"value":"","keyVisible":null,"valueVisible":null,"key":"Supplier Footprint","fillColor":null,"parentId":"d4cb833c0ea07861","zIndex":20}|
{"type":"ATTR","ticket":544,"id":"7cb97ebac0e12e5f"}||{"x":null,"y":null,"rotation":null,"color":null,"fontFamily":null,"fontSize":null,"fontWeight":null,"italic":null,"underline":null,"align":null,"value":"","keyVisible":null,"valueVisible":null,"key":"JLCPCB Part Class","fillColor":null,"parentId":"d4cb833c0ea07861","zIndex":21}|
{"type":"ATTR","ticket":545,"id":"e966fc13cf9302bb"}||{"x":null,"y":null,"rotation":null,"color":null,"fontFamily":null,"fontSize":null,"fontWeight":null,"italic":null,"underline":null,"align":null,"value":"","keyVisible":null,"valueVisible":null,"key":"Datasheet","fillColor":null,"parentId":"d4cb833c0ea07861","zIndex":22}|
{"type":"ATTR","ticket":546,"id":"4b43c66e46d5eaaf"}||{"x":null,"y":null,"rotation":null,"color":null,"fontFamily":null,"fontSize":null,"fontWeight":null,"italic":null,"underline":null,"align":null,"value":"","keyVisible":null,"valueVisible":null,"key":"Type","fillColor":null,"parentId":"d4cb833c0ea07861","zIndex":23}|
{"type":"ATTR","ticket":547,"id":"625d51ffcdf60efb"}||{"x":null,"y":null,"rotation":null,"color":null,"fontFamily":null,"fontSize":null,"fontWeight":null,"italic":null,"underline":null,"align":null,"value":"0Ω","keyVisible":null,"valueVisible":null,"key":"Value","fillColor":null,"parentId":"d4cb833c0ea07861","zIndex":24}|
{"type":"ATTR","ticket":548,"id":"53c3bec33253d651"}||{"x":null,"y":null,"rotation":null,"color":null,"fontFamily":null,"fontSize":null,"fontWeight":null,"italic":null,"underline":null,"align":null,"value":"","keyVisible":null,"valueVisible":null,"key":"Tolerance","fillColor":null,"parentId":"d4cb833c0ea07861","zIndex":25}|
{"type":"ATTR","ticket":549,"id":"48d62a195c5d9a3a"}||{"x":null,"y":null,"rotation":null,"color":null,"fontFamily":null,"fontSize":null,"fontWeight":null,"italic":null,"underline":null,"align":null,"value":"","keyVisible":null,"valueVisible":null,"key":"Power(Watts)","fillColor":null,"parentId":"d4cb833c0ea07861","zIndex":26}|
{"type":"ATTR","ticket":550,"id":"2c662ff904661c63"}||{"x":null,"y":null,"rotation":null,"color":null,"fontFamily":null,"fontSize":null,"fontWeight":null,"italic":null,"underline":null,"align":null,"value":"","keyVisible":null,"valueVisible":null,"key":"Voltage-Supply(Max)","fillColor":null,"parentId":"d4cb833c0ea07861","zIndex":27}|
{"type":"ATTR","ticket":551,"id":"28c521541c784495"}||{"x":null,"y":null,"rotation":null,"color":null,"fontFamily":null,"fontSize":null,"fontWeight":null,"italic":null,"underline":null,"align":null,"value":"","keyVisible":null,"valueVisible":null,"key":"Temperature Coefficient","fillColor":null,"parentId":"d4cb833c0ea07861","zIndex":28}|
{"type":"ATTR","ticket":552,"id":"d5e04a421b6774e1"}||{"x":null,"y":null,"rotation":null,"color":null,"fontFamily":null,"fontSize":null,"fontWeight":null,"italic":null,"underline":null,"align":null,"value":"","keyVisible":null,"valueVisible":null,"key":"Operating Temperature","fillColor":null,"parentId":"d4cb833c0ea07861","zIndex":29}|
{"type":"ATTR","ticket":553,"id":"5826c98de020bf72"}||{"x":null,"y":null,"rotation":null,"color":null,"fontFamily":null,"fontSize":null,"fontWeight":null,"italic":null,"underline":null,"align":null,"value":"","keyVisible":null,"valueVisible":null,"key":"Description","fillColor":null,"parentId":"d4cb833c0ea07861","zIndex":30}|
{"type":"ATTR","ticket":554,"id":"757c2545728528ce"}||{"x":null,"y":null,"rotation":null,"color":null,"fontFamily":null,"fontSize":null,"fontWeight":null,"italic":null,"underline":null,"align":null,"value":"","keyVisible":null,"valueVisible":null,"key":"Manufacturer","fillColor":null,"parentId":"52436a48dda5e32a","zIndex":19}|
{"type":"ATTR","ticket":555,"id":"a8c9b88f10d2677d"}||{"x":null,"y":null,"rotation":null,"color":null,"fontFamily":null,"fontSize":null,"fontWeight":null,"italic":null,"underline":null,"align":null,"value":"TAJB226K025RNJ","keyVisible":null,"valueVisible":null,"key":"Manufacturer Part","fillColor":null,"parentId":"52436a48dda5e32a","zIndex":20}|
{"type":"ATTR","ticket":556,"id":"a80d95c87bf471be"}||{"x":null,"y":null,"rotation":null,"color":null,"fontFamily":null,"fontSize":null,"fontWeight":null,"italic":null,"underline":null,"align":null,"value":"LCSC","keyVisible":null,"valueVisible":null,"key":"Supplier","fillColor":null,"parentId":"52436a48dda5e32a","zIndex":21}|
{"type":"ATTR","ticket":557,"id":"49fb39436ad0493f"}||{"x":null,"y":null,"rotation":null,"color":null,"fontFamily":null,"fontSize":null,"fontWeight":null,"italic":null,"underline":null,"align":null,"value":"TAJB226K025RNJ.1","keyVisible":null,"valueVisible":null,"key":"Supplier Part","fillColor":null,"parentId":"52436a48dda5e32a","zIndex":22}|
{"type":"ATTR","ticket":558,"id":"bb651f708ff812c4"}||{"x":null,"y":null,"rotation":null,"color":null,"fontFamily":null,"fontSize":null,"fontWeight":null,"italic":null,"underline":null,"align":null,"value":"","keyVisible":null,"valueVisible":null,"key":"LCSC Part Name","fillColor":null,"parentId":"52436a48dda5e32a","zIndex":23}|
{"type":"ATTR","ticket":559,"id":"cc2a8f77b99739ae"}||{"x":null,"y":null,"rotation":null,"color":null,"fontFamily":null,"fontSize":null,"fontWeight":null,"italic":null,"underline":null,"align":null,"value":"","keyVisible":null,"valueVisible":null,"key":"Supplier Footprint","fillColor":null,"parentId":"52436a48dda5e32a","zIndex":24}|
{"type":"ATTR","ticket":560,"id":"c27c4a1c84ceb96b"}||{"x":null,"y":null,"rotation":null,"color":null,"fontFamily":null,"fontSize":null,"fontWeight":null,"italic":null,"underline":null,"align":null,"value":"","keyVisible":null,"valueVisible":null,"key":"JLCPCB Part Class","fillColor":null,"parentId":"52436a48dda5e32a","zIndex":25}|
{"type":"ATTR","ticket":561,"id":"2a1c019524b51901"}||{"x":null,"y":null,"rotation":null,"color":null,"fontFamily":null,"fontSize":null,"fontWeight":null,"italic":null,"underline":null,"align":null,"value":"","keyVisible":null,"valueVisible":null,"key":"Datasheet","fillColor":null,"parentId":"52436a48dda5e32a","zIndex":26}|
{"type":"ATTR","ticket":562,"id":"d9ebbe246d3ae582"}||{"x":null,"y":null,"rotation":null,"color":null,"fontFamily":null,"fontSize":null,"fontWeight":null,"italic":null,"underline":null,"align":null,"value":"22uF","keyVisible":null,"valueVisible":null,"key":"Value","fillColor":null,"parentId":"52436a48dda5e32a","zIndex":27}|
{"type":"ATTR","ticket":563,"id":"7681b255c6ae5943"}||{"x":null,"y":null,"rotation":null,"color":null,"fontFamily":null,"fontSize":null,"fontWeight":null,"italic":null,"underline":null,"align":null,"value":"","keyVisible":null,"valueVisible":null,"key":"Tolerance","fillColor":null,"parentId":"52436a48dda5e32a","zIndex":28}|
{"type":"ATTR","ticket":564,"id":"16a365391952403a"}||{"x":null,"y":null,"rotation":null,"color":null,"fontFamily":null,"fontSize":null,"fontWeight":null,"italic":null,"underline":null,"align":null,"value":"","keyVisible":null,"valueVisible":null,"key":"Rated Voltage","fillColor":null,"parentId":"52436a48dda5e32a","zIndex":29}|
{"type":"ATTR","ticket":565,"id":"28281c2086b62d7a"}||{"x":null,"y":null,"rotation":null,"color":null,"fontFamily":null,"fontSize":null,"fontWeight":null,"italic":null,"underline":null,"align":null,"value":"","keyVisible":null,"valueVisible":null,"key":"Leakage Current(DCL)","fillColor":null,"parentId":"52436a48dda5e32a","zIndex":30}|
{"type":"ATTR","ticket":566,"id":"6538067944d7fe05"}||{"x":null,"y":null,"rotation":null,"color":null,"fontFamily":null,"fontSize":null,"fontWeight":null,"italic":null,"underline":null,"align":null,"value":"","keyVisible":null,"valueVisible":null,"key":"Ripple Current","fillColor":null,"parentId":"52436a48dda5e32a","zIndex":31}|
{"type":"ATTR","ticket":567,"id":"1e1abe77e73336ff"}||{"x":null,"y":null,"rotation":null,"color":null,"fontFamily":null,"fontSize":null,"fontWeight":null,"italic":null,"underline":null,"align":null,"value":"","keyVisible":null,"valueVisible":null,"key":"Equivalent Series Resistance(ESR)","fillColor":null,"parentId":"52436a48dda5e32a","zIndex":32}|
{"type":"ATTR","ticket":568,"id":"7df4b4559e1a3f9d"}||{"x":null,"y":null,"rotation":null,"color":null,"fontFamily":null,"fontSize":null,"fontWeight":null,"italic":null,"underline":null,"align":null,"value":"","keyVisible":null,"valueVisible":null,"key":"Description","fillColor":null,"parentId":"52436a48dda5e32a","zIndex":33}|
{"type":"ATTR","ticket":569,"id":"dcee4f849b495c25"}||{"x":null,"y":null,"rotation":null,"color":null,"fontFamily":null,"fontSize":null,"fontWeight":null,"italic":null,"underline":null,"align":null,"value":"Kyocera AVX","keyVisible":null,"valueVisible":null,"key":"Manufacturer","fillColor":null,"parentId":"ccb547786cab4b13","zIndex":20}|
{"type":"ATTR","ticket":570,"id":"9639d6af6eb052b8"}||{"x":null,"y":null,"rotation":null,"color":null,"fontFamily":null,"fontSize":null,"fontWeight":null,"italic":null,"underline":null,"align":null,"value":"TAJB226K016RNJ","keyVisible":null,"valueVisible":null,"key":"Manufacturer Part","fillColor":null,"parentId":"ccb547786cab4b13","zIndex":21}|
{"type":"ATTR","ticket":571,"id":"91404fe61d25ab2a"}||{"x":null,"y":null,"rotation":null,"color":null,"fontFamily":null,"fontSize":null,"fontWeight":null,"italic":null,"underline":null,"align":null,"value":"LCSC","keyVisible":null,"valueVisible":null,"key":"Supplier","fillColor":null,"parentId":"ccb547786cab4b13","zIndex":22}|
{"type":"ATTR","ticket":572,"id":"f941447e4d943dc8"}||{"x":null,"y":null,"rotation":null,"color":null,"fontFamily":null,"fontSize":null,"fontWeight":null,"italic":null,"underline":null,"align":null,"value":"TAJB226K016RNJ.1","keyVisible":null,"valueVisible":null,"key":"Supplier Part","fillColor":null,"parentId":"ccb547786cab4b13","zIndex":23}|
{"type":"ATTR","ticket":573,"id":"d1a01c4bbe1e1589"}||{"x":null,"y":null,"rotation":null,"color":null,"fontFamily":null,"fontSize":null,"fontWeight":null,"italic":null,"underline":null,"align":null,"value":"","keyVisible":null,"valueVisible":null,"key":"LCSC Part Name","fillColor":null,"parentId":"ccb547786cab4b13","zIndex":24}|
{"type":"ATTR","ticket":574,"id":"3262cc930bbceea9"}||{"x":null,"y":null,"rotation":null,"color":null,"fontFamily":null,"fontSize":null,"fontWeight":null,"italic":null,"underline":null,"align":null,"value":"","keyVisible":null,"valueVisible":null,"key":"Supplier Footprint","fillColor":null,"parentId":"ccb547786cab4b13","zIndex":25}|
{"type":"ATTR","ticket":575,"id":"009a3de1ae205b5b"}||{"x":null,"y":null,"rotation":null,"color":null,"fontFamily":null,"fontSize":null,"fontWeight":null,"italic":null,"underline":null,"align":null,"value":"","keyVisible":null,"valueVisible":null,"key":"JLCPCB Part Class","fillColor":null,"parentId":"ccb547786cab4b13","zIndex":26}|
{"type":"ATTR","ticket":576,"id":"2be9c60ceb1d6e5f"}||{"x":null,"y":null,"rotation":null,"color":null,"fontFamily":null,"fontSize":null,"fontWeight":null,"italic":null,"underline":null,"align":null,"value":"","keyVisible":null,"valueVisible":null,"key":"Datasheet","fillColor":null,"parentId":"ccb547786cab4b13","zIndex":27}|
{"type":"ATTR","ticket":577,"id":"b5849b8453e0f66c"}||{"x":null,"y":null,"rotation":null,"color":null,"fontFamily":null,"fontSize":null,"fontWeight":null,"italic":null,"underline":null,"align":null,"value":"22uF","keyVisible":null,"valueVisible":null,"key":"Value","fillColor":null,"parentId":"ccb547786cab4b13","zIndex":28}|
{"type":"ATTR","ticket":578,"id":"000ffec66a52463a"}||{"x":null,"y":null,"rotation":null,"color":null,"fontFamily":null,"fontSize":null,"fontWeight":null,"italic":null,"underline":null,"align":null,"value":"","keyVisible":null,"valueVisible":null,"key":"Tolerance","fillColor":null,"parentId":"ccb547786cab4b13","zIndex":29}|
{"type":"ATTR","ticket":579,"id":"47a4b6f4ab42ef46"}||{"x":null,"y":null,"rotation":null,"color":null,"fontFamily":null,"fontSize":null,"fontWeight":null,"italic":null,"underline":null,"align":null,"value":"","keyVisible":null,"valueVisible":null,"key":"Voltage Rating","fillColor":null,"parentId":"ccb547786cab4b13","zIndex":30}|
{"type":"ATTR","ticket":580,"id":"828dc57e15ba866a"}||{"x":null,"y":null,"rotation":null,"color":null,"fontFamily":null,"fontSize":null,"fontWeight":null,"italic":null,"underline":null,"align":null,"value":"","keyVisible":null,"valueVisible":null,"key":"Equivalent Series Resistance(ESR)","fillColor":null,"parentId":"ccb547786cab4b13","zIndex":31}|
{"type":"ATTR","ticket":581,"id":"ddc017fa2c34824e"}||{"x":null,"y":null,"rotation":null,"color":null,"fontFamily":null,"fontSize":null,"fontWeight":null,"italic":null,"underline":null,"align":null,"value":"","keyVisible":null,"valueVisible":null,"key":"Operating Temperature","fillColor":null,"parentId":"ccb547786cab4b13","zIndex":32}|
{"type":"ATTR","ticket":582,"id":"d812a92f85f0beb2"}||{"x":null,"y":null,"rotation":null,"color":null,"fontFamily":null,"fontSize":null,"fontWeight":null,"italic":null,"underline":null,"align":null,"value":"","keyVisible":null,"valueVisible":null,"key":"Description","fillColor":null,"parentId":"ccb547786cab4b13","zIndex":33}|
{"type":"ATTR","ticket":583,"id":"fd5a85426ab1fc51"}||{"x":null,"y":null,"rotation":null,"color":null,"fontFamily":null,"fontSize":null,"fontWeight":null,"italic":null,"underline":null,"align":null,"value":"UNI-ROYAL(厚声)","keyVisible":null,"valueVisible":null,"key":"Manufacturer","fillColor":null,"parentId":"d8f676ef6cd3bd61","zIndex":15}|
{"type":"ATTR","ticket":584,"id":"ec3b1bcc91883a0e"}||{"x":null,"y":null,"rotation":null,"color":null,"fontFamily":null,"fontSize":null,"fontWeight":null,"italic":null,"underline":null,"align":null,"value":"0805W8F1002T5E","keyVisible":null,"valueVisible":null,"key":"Manufacturer Part","fillColor":null,"parentId":"d8f676ef6cd3bd61","zIndex":16}|
{"type":"ATTR","ticket":585,"id":"f1f08b4f73506135"}||{"x":null,"y":null,"rotation":null,"color":null,"fontFamily":null,"fontSize":null,"fontWeight":null,"italic":null,"underline":null,"align":null,"value":"LCSC","keyVisible":null,"valueVisible":null,"key":"Supplier","fillColor":null,"parentId":"d8f676ef6cd3bd61","zIndex":17}|
{"type":"ATTR","ticket":586,"id":"5d9a3d974bd5e54d"}||{"x":null,"y":null,"rotation":null,"color":null,"fontFamily":null,"fontSize":null,"fontWeight":null,"italic":null,"underline":null,"align":null,"value":"0805W8F1002T5E.1","keyVisible":null,"valueVisible":null,"key":"Supplier Part","fillColor":null,"parentId":"d8f676ef6cd3bd61","zIndex":18}|
{"type":"ATTR","ticket":587,"id":"a33c2ab1415556df"}||{"x":null,"y":null,"rotation":null,"color":null,"fontFamily":null,"fontSize":null,"fontWeight":null,"italic":null,"underline":null,"align":null,"value":"","keyVisible":null,"valueVisible":null,"key":"LCSC Part Name","fillColor":null,"parentId":"d8f676ef6cd3bd61","zIndex":19}|
{"type":"ATTR","ticket":588,"id":"3c92e872ed34d71c"}||{"x":null,"y":null,"rotation":null,"color":null,"fontFamily":null,"fontSize":null,"fontWeight":null,"italic":null,"underline":null,"align":null,"value":"","keyVisible":null,"valueVisible":null,"key":"Supplier Footprint","fillColor":null,"parentId":"d8f676ef6cd3bd61","zIndex":20}|
{"type":"ATTR","ticket":589,"id":"a2b0376233bcd129"}||{"x":null,"y":null,"rotation":null,"color":null,"fontFamily":null,"fontSize":null,"fontWeight":null,"italic":null,"underline":null,"align":null,"value":"","keyVisible":null,"valueVisible":null,"key":"JLCPCB Part Class","fillColor":null,"parentId":"d8f676ef6cd3bd61","zIndex":21}|
{"type":"ATTR","ticket":590,"id":"140518378514270d"}||{"x":null,"y":null,"rotation":null,"color":null,"fontFamily":null,"fontSize":null,"fontWeight":null,"italic":null,"underline":null,"align":null,"value":"","keyVisible":null,"valueVisible":null,"key":"Datasheet","fillColor":null,"parentId":"d8f676ef6cd3bd61","zIndex":22}|
{"type":"ATTR","ticket":591,"id":"81a7a94c734e97ad"}||{"x":null,"y":null,"rotation":null,"color":null,"fontFamily":null,"fontSize":null,"fontWeight":null,"italic":null,"underline":null,"align":null,"value":"","keyVisible":null,"valueVisible":null,"key":"Type","fillColor":null,"parentId":"d8f676ef6cd3bd61","zIndex":23}|
{"type":"ATTR","ticket":592,"id":"b7a1c9b89558abf0"}||{"x":null,"y":null,"rotation":null,"color":null,"fontFamily":null,"fontSize":null,"fontWeight":null,"italic":null,"underline":null,"align":null,"value":"10kΩ","keyVisible":null,"valueVisible":null,"key":"Value","fillColor":null,"parentId":"d8f676ef6cd3bd61","zIndex":24}|
{"type":"ATTR","ticket":593,"id":"a4d2749c28df4b5e"}||{"x":null,"y":null,"rotation":null,"color":null,"fontFamily":null,"fontSize":null,"fontWeight":null,"italic":null,"underline":null,"align":null,"value":"","keyVisible":null,"valueVisible":null,"key":"Tolerance","fillColor":null,"parentId":"d8f676ef6cd3bd61","zIndex":25}|
{"type":"ATTR","ticket":594,"id":"639cc076e794a2d0"}||{"x":null,"y":null,"rotation":null,"color":null,"fontFamily":null,"fontSize":null,"fontWeight":null,"italic":null,"underline":null,"align":null,"value":"","keyVisible":null,"valueVisible":null,"key":"Power(Watts)","fillColor":null,"parentId":"d8f676ef6cd3bd61","zIndex":26}|
{"type":"ATTR","ticket":595,"id":"4a1e5cc088540bca"}||{"x":null,"y":null,"rotation":null,"color":null,"fontFamily":null,"fontSize":null,"fontWeight":null,"italic":null,"underline":null,"align":null,"value":"","keyVisible":null,"valueVisible":null,"key":"Voltage-Supply(Max)","fillColor":null,"parentId":"d8f676ef6cd3bd61","zIndex":27}|
{"type":"ATTR","ticket":596,"id":"52ff72259afa3fe1"}||{"x":null,"y":null,"rotation":null,"color":null,"fontFamily":null,"fontSize":null,"fontWeight":null,"italic":null,"underline":null,"align":null,"value":"","keyVisible":null,"valueVisible":null,"key":"Temperature Coefficient","fillColor":null,"parentId":"d8f676ef6cd3bd61","zIndex":28}|
{"type":"ATTR","ticket":597,"id":"863c3ecfb2444987"}||{"x":null,"y":null,"rotation":null,"color":null,"fontFamily":null,"fontSize":null,"fontWeight":null,"italic":null,"underline":null,"align":null,"value":"","keyVisible":null,"valueVisible":null,"key":"Operating Temperature","fillColor":null,"parentId":"d8f676ef6cd3bd61","zIndex":29}|
{"type":"ATTR","ticket":598,"id":"49c621de059a2360"}||{"x":null,"y":null,"rotation":null,"color":null,"fontFamily":null,"fontSize":null,"fontWeight":null,"italic":null,"underline":null,"align":null,"value":"","keyVisible":null,"valueVisible":null,"key":"Description","fillColor":null,"parentId":"d8f676ef6cd3bd61","zIndex":30}|
{"type":"ATTR","ticket":599,"id":"10bbdb06e2e36a1a"}||{"x":null,"y":null,"rotation":null,"color":null,"fontFamily":null,"fontSize":null,"fontWeight":null,"italic":null,"underline":null,"align":null,"value":"UNI-ROYAL(厚声)","keyVisible":null,"valueVisible":null,"key":"Manufacturer","fillColor":null,"parentId":"e584c449c600ff04","zIndex":15}|
{"type":"ATTR","ticket":600,"id":"7dbcc0a42fd44360"}||{"x":null,"y":null,"rotation":null,"color":null,"fontFamily":null,"fontSize":null,"fontWeight":null,"italic":null,"underline":null,"align":null,"value":"0805W8F1002T5E","keyVisible":null,"valueVisible":null,"key":"Manufacturer Part","fillColor":null,"parentId":"e584c449c600ff04","zIndex":16}|
{"type":"ATTR","ticket":601,"id":"4ef97fc7098e5ef8"}||{"x":null,"y":null,"rotation":null,"color":null,"fontFamily":null,"fontSize":null,"fontWeight":null,"italic":null,"underline":null,"align":null,"value":"LCSC","keyVisible":null,"valueVisible":null,"key":"Supplier","fillColor":null,"parentId":"e584c449c600ff04","zIndex":17}|
{"type":"ATTR","ticket":602,"id":"f9a82f74a20877c4"}||{"x":null,"y":null,"rotation":null,"color":null,"fontFamily":null,"fontSize":null,"fontWeight":null,"italic":null,"underline":null,"align":null,"value":"0805W8F1002T5E.1","keyVisible":null,"valueVisible":null,"key":"Supplier Part","fillColor":null,"parentId":"e584c449c600ff04","zIndex":18}|
{"type":"ATTR","ticket":603,"id":"32f82ef8ad751e92"}||{"x":null,"y":null,"rotation":null,"color":null,"fontFamily":null,"fontSize":null,"fontWeight":null,"italic":null,"underline":null,"align":null,"value":"","keyVisible":null,"valueVisible":null,"key":"LCSC Part Name","fillColor":null,"parentId":"e584c449c600ff04","zIndex":19}|
{"type":"ATTR","ticket":604,"id":"794d90a35d92fbdc"}||{"x":null,"y":null,"rotation":null,"color":null,"fontFamily":null,"fontSize":null,"fontWeight":null,"italic":null,"underline":null,"align":null,"value":"","keyVisible":null,"valueVisible":null,"key":"Supplier Footprint","fillColor":null,"parentId":"e584c449c600ff04","zIndex":20}|
{"type":"ATTR","ticket":605,"id":"d7939159d61b4097"}||{"x":null,"y":null,"rotation":null,"color":null,"fontFamily":null,"fontSize":null,"fontWeight":null,"italic":null,"underline":null,"align":null,"value":"","keyVisible":null,"valueVisible":null,"key":"JLCPCB Part Class","fillColor":null,"parentId":"e584c449c600ff04","zIndex":21}|
{"type":"ATTR","ticket":606,"id":"a962f5048cd7fe3f"}||{"x":null,"y":null,"rotation":null,"color":null,"fontFamily":null,"fontSize":null,"fontWeight":null,"italic":null,"underline":null,"align":null,"value":"","keyVisible":null,"valueVisible":null,"key":"Datasheet","fillColor":null,"parentId":"e584c449c600ff04","zIndex":22}|
{"type":"ATTR","ticket":607,"id":"f48857628dc86194"}||{"x":null,"y":null,"rotation":null,"color":null,"fontFamily":null,"fontSize":null,"fontWeight":null,"italic":null,"underline":null,"align":null,"value":"","keyVisible":null,"valueVisible":null,"key":"Type","fillColor":null,"parentId":"e584c449c600ff04","zIndex":23}|
{"type":"ATTR","ticket":608,"id":"72cd90bbd6cf28e2"}||{"x":null,"y":null,"rotation":null,"color":null,"fontFamily":null,"fontSize":null,"fontWeight":null,"italic":null,"underline":null,"align":null,"value":"10kΩ","keyVisible":null,"valueVisible":null,"key":"Value","fillColor":null,"parentId":"e584c449c600ff04","zIndex":24}|
{"type":"ATTR","ticket":609,"id":"f43f7e708f8472ca"}||{"x":null,"y":null,"rotation":null,"color":null,"fontFamily":null,"fontSize":null,"fontWeight":null,"italic":null,"underline":null,"align":null,"value":"","keyVisible":null,"valueVisible":null,"key":"Tolerance","fillColor":null,"parentId":"e584c449c600ff04","zIndex":25}|
{"type":"ATTR","ticket":610,"id":"2261edf416d71e0b"}||{"x":null,"y":null,"rotation":null,"color":null,"fontFamily":null,"fontSize":null,"fontWeight":null,"italic":null,"underline":null,"align":null,"value":"","keyVisible":null,"valueVisible":null,"key":"Power(Watts)","fillColor":null,"parentId":"e584c449c600ff04","zIndex":26}|
{"type":"ATTR","ticket":611,"id":"4acaed0784707218"}||{"x":null,"y":null,"rotation":null,"color":null,"fontFamily":null,"fontSize":null,"fontWeight":null,"italic":null,"underline":null,"align":null,"value":"","keyVisible":null,"valueVisible":null,"key":"Voltage-Supply(Max)","fillColor":null,"parentId":"e584c449c600ff04","zIndex":27}|
{"type":"ATTR","ticket":612,"id":"7636170ae1cf92c6"}||{"x":null,"y":null,"rotation":null,"color":null,"fontFamily":null,"fontSize":null,"fontWeight":null,"italic":null,"underline":null,"align":null,"value":"","keyVisible":null,"valueVisible":null,"key":"Temperature Coefficient","fillColor":null,"parentId":"e584c449c600ff04","zIndex":28}|
{"type":"ATTR","ticket":613,"id":"781a2210a448e402"}||{"x":null,"y":null,"rotation":null,"color":null,"fontFamily":null,"fontSize":null,"fontWeight":null,"italic":null,"underline":null,"align":null,"value":"","keyVisible":null,"valueVisible":null,"key":"Operating Temperature","fillColor":null,"parentId":"e584c449c600ff04","zIndex":29}|
{"type":"ATTR","ticket":614,"id":"9f34bbf588cd9cfc"}||{"x":null,"y":null,"rotation":null,"color":null,"fontFamily":null,"fontSize":null,"fontWeight":null,"italic":null,"underline":null,"align":null,"value":"","keyVisible":null,"valueVisible":null,"key":"Description","fillColor":null,"parentId":"e584c449c600ff04","zIndex":30}|
{"type":"ATTR","ticket":615,"id":"c9f59971a1741ebd"}||{"x":null,"y":null,"rotation":null,"color":null,"fontFamily":null,"fontSize":null,"fontWeight":null,"italic":null,"underline":null,"align":null,"value":"UNI-ROYAL(厚声)","keyVisible":null,"valueVisible":null,"key":"Manufacturer","fillColor":null,"parentId":"9bbe4bfab212f226","zIndex":15}|
{"type":"ATTR","ticket":616,"id":"2b20ecd647a6fafb"}||{"x":null,"y":null,"rotation":null,"color":null,"fontFamily":null,"fontSize":null,"fontWeight":null,"italic":null,"underline":null,"align":null,"value":"0805W8F0000T5E","keyVisible":null,"valueVisible":null,"key":"Manufacturer Part","fillColor":null,"parentId":"9bbe4bfab212f226","zIndex":16}|
{"type":"ATTR","ticket":617,"id":"b31baa5c6b01b200"}||{"x":null,"y":null,"rotation":null,"color":null,"fontFamily":null,"fontSize":null,"fontWeight":null,"italic":null,"underline":null,"align":null,"value":"LCSC","keyVisible":null,"valueVisible":null,"key":"Supplier","fillColor":null,"parentId":"9bbe4bfab212f226","zIndex":17}|
{"type":"ATTR","ticket":618,"id":"bdb7756df78e7d8d"}||{"x":null,"y":null,"rotation":null,"color":null,"fontFamily":null,"fontSize":null,"fontWeight":null,"italic":null,"underline":null,"align":null,"value":"0805W8F0000T5E.1","keyVisible":null,"valueVisible":null,"key":"Supplier Part","fillColor":null,"parentId":"9bbe4bfab212f226","zIndex":18}|
{"type":"ATTR","ticket":619,"id":"58ff55a058f7e5a4"}||{"x":null,"y":null,"rotation":null,"color":null,"fontFamily":null,"fontSize":null,"fontWeight":null,"italic":null,"underline":null,"align":null,"value":"","keyVisible":null,"valueVisible":null,"key":"LCSC Part Name","fillColor":null,"parentId":"9bbe4bfab212f226","zIndex":19}|
{"type":"ATTR","ticket":620,"id":"59a756c36e95093b"}||{"x":null,"y":null,"rotation":null,"color":null,"fontFamily":null,"fontSize":null,"fontWeight":null,"italic":null,"underline":null,"align":null,"value":"","keyVisible":null,"valueVisible":null,"key":"Supplier Footprint","fillColor":null,"parentId":"9bbe4bfab212f226","zIndex":20}|
{"type":"ATTR","ticket":621,"id":"9fdd99505880d7a8"}||{"x":null,"y":null,"rotation":null,"color":null,"fontFamily":null,"fontSize":null,"fontWeight":null,"italic":null,"underline":null,"align":null,"value":"","keyVisible":null,"valueVisible":null,"key":"JLCPCB Part Class","fillColor":null,"parentId":"9bbe4bfab212f226","zIndex":21}|
{"type":"ATTR","ticket":622,"id":"d3f376701c44c40e"}||{"x":null,"y":null,"rotation":null,"color":null,"fontFamily":null,"fontSize":null,"fontWeight":null,"italic":null,"underline":null,"align":null,"value":"","keyVisible":null,"valueVisible":null,"key":"Datasheet","fillColor":null,"parentId":"9bbe4bfab212f226","zIndex":22}|
{"type":"ATTR","ticket":623,"id":"3d82f435bd6f319f"}||{"x":null,"y":null,"rotation":null,"color":null,"fontFamily":null,"fontSize":null,"fontWeight":null,"italic":null,"underline":null,"align":null,"value":"","keyVisible":null,"valueVisible":null,"key":"Type","fillColor":null,"parentId":"9bbe4bfab212f226","zIndex":23}|
{"type":"ATTR","ticket":624,"id":"f070ed8e7b3d3698"}||{"x":null,"y":null,"rotation":null,"color":null,"fontFamily":null,"fontSize":null,"fontWeight":null,"italic":null,"underline":null,"align":null,"value":"0Ω","keyVisible":null,"valueVisible":null,"key":"Value","fillColor":null,"parentId":"9bbe4bfab212f226","zIndex":24}|
{"type":"ATTR","ticket":625,"id":"0a6f921666b42d58"}||{"x":null,"y":null,"rotation":null,"color":null,"fontFamily":null,"fontSize":null,"fontWeight":null,"italic":null,"underline":null,"align":null,"value":"","keyVisible":null,"valueVisible":null,"key":"Tolerance","fillColor":null,"parentId":"9bbe4bfab212f226","zIndex":25}|
{"type":"ATTR","ticket":626,"id":"0db0dc0d9d07480e"}||{"x":null,"y":null,"rotation":null,"color":null,"fontFamily":null,"fontSize":null,"fontWeight":null,"italic":null,"underline":null,"align":null,"value":"","keyVisible":null,"valueVisible":null,"key":"Power(Watts)","fillColor":null,"parentId":"9bbe4bfab212f226","zIndex":26}|
{"type":"ATTR","ticket":627,"id":"a50efeac2151d130"}||{"x":null,"y":null,"rotation":null,"color":null,"fontFamily":null,"fontSize":null,"fontWeight":null,"italic":null,"underline":null,"align":null,"value":"","keyVisible":null,"valueVisible":null,"key":"Voltage-Supply(Max)","fillColor":null,"parentId":"9bbe4bfab212f226","zIndex":27}|
{"type":"ATTR","ticket":628,"id":"8bcf02cac3afb7e3"}||{"x":null,"y":null,"rotation":null,"color":null,"fontFamily":null,"fontSize":null,"fontWeight":null,"italic":null,"underline":null,"align":null,"value":"","keyVisible":null,"valueVisible":null,"key":"Temperature Coefficient","fillColor":null,"parentId":"9bbe4bfab212f226","zIndex":28}|
{"type":"ATTR","ticket":629,"id":"fd2eec49b0c13550"}||{"x":null,"y":null,"rotation":null,"color":null,"fontFamily":null,"fontSize":null,"fontWeight":null,"italic":null,"underline":null,"align":null,"value":"","keyVisible":null,"valueVisible":null,"key":"Operating Temperature","fillColor":null,"parentId":"9bbe4bfab212f226","zIndex":29}|
{"type":"ATTR","ticket":630,"id":"dc5bbecc1934bee7"}||{"x":null,"y":null,"rotation":null,"color":null,"fontFamily":null,"fontSize":null,"fontWeight":null,"italic":null,"underline":null,"align":null,"value":"","keyVisible":null,"valueVisible":null,"key":"Description","fillColor":null,"parentId":"9bbe4bfab212f226","zIndex":30}|
{"type":"ATTR","ticket":631,"id":"19e2a2e5d5ccdfbe"}||{"x":null,"y":null,"rotation":null,"color":null,"fontFamily":null,"fontSize":null,"fontWeight":null,"italic":null,"underline":null,"align":null,"value":"","keyVisible":null,"valueVisible":null,"key":"Manufacturer","fillColor":null,"parentId":"e080acf526ade866","zIndex":15}|
{"type":"ATTR","ticket":632,"id":"7a97b879a525cc4a"}||{"x":null,"y":null,"rotation":null,"color":null,"fontFamily":null,"fontSize":null,"fontWeight":null,"italic":null,"underline":null,"align":null,"value":"TP-黄色测试点","keyVisible":null,"valueVisible":null,"key":"Manufacturer Part","fillColor":null,"parentId":"e080acf526ade866","zIndex":16}|
{"type":"ATTR","ticket":633,"id":"bffeca2a55179c3a"}||{"x":null,"y":null,"rotation":null,"color":null,"fontFamily":null,"fontSize":null,"fontWeight":null,"italic":null,"underline":null,"align":null,"value":"LCSC","keyVisible":null,"valueVisible":null,"key":"Supplier","fillColor":null,"parentId":"e080acf526ade866","zIndex":17}|
{"type":"ATTR","ticket":634,"id":"3228500b7dbabd84"}||{"x":null,"y":null,"rotation":null,"color":null,"fontFamily":null,"fontSize":null,"fontWeight":null,"italic":null,"underline":null,"align":null,"value":"TP-黄色测试点.1","keyVisible":null,"valueVisible":null,"key":"Supplier Part","fillColor":null,"parentId":"e080acf526ade866","zIndex":18}|
{"type":"ATTR","ticket":635,"id":"d5ab3bad53a68e67"}||{"x":null,"y":null,"rotation":null,"color":null,"fontFamily":null,"fontSize":null,"fontWeight":null,"italic":null,"underline":null,"align":null,"value":"","keyVisible":null,"valueVisible":null,"key":"LCSC Part Name","fillColor":null,"parentId":"e080acf526ade866","zIndex":19}|
{"type":"ATTR","ticket":636,"id":"9c7267471aa79bcc"}||{"x":null,"y":null,"rotation":null,"color":null,"fontFamily":null,"fontSize":null,"fontWeight":null,"italic":null,"underline":null,"align":null,"value":"","keyVisible":null,"valueVisible":null,"key":"Supplier Footprint","fillColor":null,"parentId":"e080acf526ade866","zIndex":20}|
{"type":"ATTR","ticket":637,"id":"b57746ba35c20937"}||{"x":null,"y":null,"rotation":null,"color":null,"fontFamily":null,"fontSize":null,"fontWeight":null,"italic":null,"underline":null,"align":null,"value":"","keyVisible":null,"valueVisible":null,"key":"JLCPCB Part Class","fillColor":null,"parentId":"e080acf526ade866","zIndex":21}|
{"type":"ATTR","ticket":638,"id":"4676008585fcb08d"}||{"x":null,"y":null,"rotation":null,"color":null,"fontFamily":null,"fontSize":null,"fontWeight":null,"italic":null,"underline":null,"align":null,"value":"","keyVisible":null,"valueVisible":null,"key":"Datasheet","fillColor":null,"parentId":"e080acf526ade866","zIndex":22}|
{"type":"ATTR","ticket":639,"id":"fb69aa2930217e4a"}||{"x":null,"y":null,"rotation":null,"color":null,"fontFamily":null,"fontSize":null,"fontWeight":null,"italic":null,"underline":null,"align":null,"value":"","keyVisible":null,"valueVisible":null,"key":"Description","fillColor":null,"parentId":"e080acf526ade866","zIndex":23}|
{"type":"ATTR","ticket":640,"id":"57a8928e80500b55"}||{"x":null,"y":null,"rotation":null,"color":null,"fontFamily":null,"fontSize":null,"fontWeight":null,"italic":null,"underline":null,"align":null,"value":"","keyVisible":null,"valueVisible":null,"key":"Manufacturer","fillColor":null,"parentId":"33eb9b42a976b2f1","zIndex":15}|
{"type":"ATTR","ticket":641,"id":"728f131a1ed05347"}||{"x":null,"y":null,"rotation":null,"color":null,"fontFamily":null,"fontSize":null,"fontWeight":null,"italic":null,"underline":null,"align":null,"value":"TP-黄色测试点","keyVisible":null,"valueVisible":null,"key":"Manufacturer Part","fillColor":null,"parentId":"33eb9b42a976b2f1","zIndex":16}|
{"type":"ATTR","ticket":642,"id":"ea92bad6893269a6"}||{"x":null,"y":null,"rotation":null,"color":null,"fontFamily":null,"fontSize":null,"fontWeight":null,"italic":null,"underline":null,"align":null,"value":"LCSC","keyVisible":null,"valueVisible":null,"key":"Supplier","fillColor":null,"parentId":"33eb9b42a976b2f1","zIndex":17}|
{"type":"ATTR","ticket":643,"id":"4e028bb9ad7a8190"}||{"x":null,"y":null,"rotation":null,"color":null,"fontFamily":null,"fontSize":null,"fontWeight":null,"italic":null,"underline":null,"align":null,"value":"TP-黄色测试点.1","keyVisible":null,"valueVisible":null,"key":"Supplier Part","fillColor":null,"parentId":"33eb9b42a976b2f1","zIndex":18}|
{"type":"ATTR","ticket":644,"id":"634931fdece4100d"}||{"x":null,"y":null,"rotation":null,"color":null,"fontFamily":null,"fontSize":null,"fontWeight":null,"italic":null,"underline":null,"align":null,"value":"","keyVisible":null,"valueVisible":null,"key":"LCSC Part Name","fillColor":null,"parentId":"33eb9b42a976b2f1","zIndex":19}|
{"type":"ATTR","ticket":645,"id":"9b01e6303bc40d3e"}||{"x":null,"y":null,"rotation":null,"color":null,"fontFamily":null,"fontSize":null,"fontWeight":null,"italic":null,"underline":null,"align":null,"value":"","keyVisible":null,"valueVisible":null,"key":"Supplier Footprint","fillColor":null,"parentId":"33eb9b42a976b2f1","zIndex":20}|
{"type":"ATTR","ticket":646,"id":"2d172691499aa050"}||{"x":null,"y":null,"rotation":null,"color":null,"fontFamily":null,"fontSize":null,"fontWeight":null,"italic":null,"underline":null,"align":null,"value":"","keyVisible":null,"valueVisible":null,"key":"JLCPCB Part Class","fillColor":null,"parentId":"33eb9b42a976b2f1","zIndex":21}|
{"type":"ATTR","ticket":647,"id":"35b1cf0c0d755206"}||{"x":null,"y":null,"rotation":null,"color":null,"fontFamily":null,"fontSize":null,"fontWeight":null,"italic":null,"underline":null,"align":null,"value":"","keyVisible":null,"valueVisible":null,"key":"Datasheet","fillColor":null,"parentId":"33eb9b42a976b2f1","zIndex":22}|
{"type":"ATTR","ticket":648,"id":"9e074c35b6b5d703"}||{"x":null,"y":null,"rotation":null,"color":null,"fontFamily":null,"fontSize":null,"fontWeight":null,"italic":null,"underline":null,"align":null,"value":"","keyVisible":null,"valueVisible":null,"key":"Description","fillColor":null,"parentId":"33eb9b42a976b2f1","zIndex":23}|
{"type":"ATTR","ticket":649,"id":"3ab361538b34e6db"}||{"x":null,"y":null,"rotation":null,"color":null,"fontFamily":null,"fontSize":null,"fontWeight":null,"italic":null,"underline":null,"align":null,"value":"","keyVisible":null,"valueVisible":null,"key":"Manufacturer","fillColor":null,"parentId":"bc7aeb1adb1ed5b2","zIndex":15}|
{"type":"ATTR","ticket":650,"id":"9e8867ede34052a8"}||{"x":null,"y":null,"rotation":null,"color":null,"fontFamily":null,"fontSize":null,"fontWeight":null,"italic":null,"underline":null,"align":null,"value":"TP-黄色测试点","keyVisible":null,"valueVisible":null,"key":"Manufacturer Part","fillColor":null,"parentId":"bc7aeb1adb1ed5b2","zIndex":16}|
{"type":"ATTR","ticket":651,"id":"06e19823110f67d6"}||{"x":null,"y":null,"rotation":null,"color":null,"fontFamily":null,"fontSize":null,"fontWeight":null,"italic":null,"underline":null,"align":null,"value":"LCSC","keyVisible":null,"valueVisible":null,"key":"Supplier","fillColor":null,"parentId":"bc7aeb1adb1ed5b2","zIndex":17}|
{"type":"ATTR","ticket":652,"id":"b3847e12b2da5e83"}||{"x":null,"y":null,"rotation":null,"color":null,"fontFamily":null,"fontSize":null,"fontWeight":null,"italic":null,"underline":null,"align":null,"value":"TP-黄色测试点.1","keyVisible":null,"valueVisible":null,"key":"Supplier Part","fillColor":null,"parentId":"bc7aeb1adb1ed5b2","zIndex":18}|
{"type":"ATTR","ticket":653,"id":"68ce4f405340971c"}||{"x":null,"y":null,"rotation":null,"color":null,"fontFamily":null,"fontSize":null,"fontWeight":null,"italic":null,"underline":null,"align":null,"value":"","keyVisible":null,"valueVisible":null,"key":"LCSC Part Name","fillColor":null,"parentId":"bc7aeb1adb1ed5b2","zIndex":19}|
{"type":"ATTR","ticket":654,"id":"b2850abc7c0a3f92"}||{"x":null,"y":null,"rotation":null,"color":null,"fontFamily":null,"fontSize":null,"fontWeight":null,"italic":null,"underline":null,"align":null,"value":"","keyVisible":null,"valueVisible":null,"key":"Supplier Footprint","fillColor":null,"parentId":"bc7aeb1adb1ed5b2","zIndex":20}|
{"type":"ATTR","ticket":655,"id":"4d2e716a27c0a3a2"}||{"x":null,"y":null,"rotation":null,"color":null,"fontFamily":null,"fontSize":null,"fontWeight":null,"italic":null,"underline":null,"align":null,"value":"","keyVisible":null,"valueVisible":null,"key":"JLCPCB Part Class","fillColor":null,"parentId":"bc7aeb1adb1ed5b2","zIndex":21}|
{"type":"ATTR","ticket":656,"id":"80c730141ff471b0"}||{"x":null,"y":null,"rotation":null,"color":null,"fontFamily":null,"fontSize":null,"fontWeight":null,"italic":null,"underline":null,"align":null,"value":"","keyVisible":null,"valueVisible":null,"key":"Datasheet","fillColor":null,"parentId":"bc7aeb1adb1ed5b2","zIndex":22}|
{"type":"ATTR","ticket":657,"id":"ed3b663c8a10b722"}||{"x":null,"y":null,"rotation":null,"color":null,"fontFamily":null,"fontSize":null,"fontWeight":null,"italic":null,"underline":null,"align":null,"value":"","keyVisible":null,"valueVisible":null,"key":"Description","fillColor":null,"parentId":"bc7aeb1adb1ed5b2","zIndex":23}|
{"type":"ATTR","ticket":658,"id":"7f8f2b5427e6ec96"}||{"x":null,"y":null,"rotation":null,"color":null,"fontFamily":null,"fontSize":null,"fontWeight":null,"italic":null,"underline":null,"align":null,"value":"","keyVisible":null,"valueVisible":null,"key":"Manufacturer","fillColor":null,"parentId":"ec483a879ff359c7","zIndex":15}|
{"type":"ATTR","ticket":659,"id":"d809d0eb5e5d5065"}||{"x":null,"y":null,"rotation":null,"color":null,"fontFamily":null,"fontSize":null,"fontWeight":null,"italic":null,"underline":null,"align":null,"value":"TP-黄色测试点","keyVisible":null,"valueVisible":null,"key":"Manufacturer Part","fillColor":null,"parentId":"ec483a879ff359c7","zIndex":16}|
{"type":"ATTR","ticket":660,"id":"8375973dfa4fac59"}||{"x":null,"y":null,"rotation":null,"color":null,"fontFamily":null,"fontSize":null,"fontWeight":null,"italic":null,"underline":null,"align":null,"value":"LCSC","keyVisible":null,"valueVisible":null,"key":"Supplier","fillColor":null,"parentId":"ec483a879ff359c7","zIndex":17}|
{"type":"ATTR","ticket":661,"id":"b243b4ac89e991c3"}||{"x":null,"y":null,"rotation":null,"color":null,"fontFamily":null,"fontSize":null,"fontWeight":null,"italic":null,"underline":null,"align":null,"value":"TP-黄色测试点.1","keyVisible":null,"valueVisible":null,"key":"Supplier Part","fillColor":null,"parentId":"ec483a879ff359c7","zIndex":18}|
{"type":"ATTR","ticket":662,"id":"f2b0f26af6c8ab5e"}||{"x":null,"y":null,"rotation":null,"color":null,"fontFamily":null,"fontSize":null,"fontWeight":null,"italic":null,"underline":null,"align":null,"value":"","keyVisible":null,"valueVisible":null,"key":"LCSC Part Name","fillColor":null,"parentId":"ec483a879ff359c7","zIndex":19}|
{"type":"ATTR","ticket":663,"id":"5e718acde6629d50"}||{"x":null,"y":null,"rotation":null,"color":null,"fontFamily":null,"fontSize":null,"fontWeight":null,"italic":null,"underline":null,"align":null,"value":"","keyVisible":null,"valueVisible":null,"key":"Supplier Footprint","fillColor":null,"parentId":"ec483a879ff359c7","zIndex":20}|
{"type":"ATTR","ticket":664,"id":"e677e08d2aad2160"}||{"x":null,"y":null,"rotation":null,"color":null,"fontFamily":null,"fontSize":null,"fontWeight":null,"italic":null,"underline":null,"align":null,"value":"","keyVisible":null,"valueVisible":null,"key":"JLCPCB Part Class","fillColor":null,"parentId":"ec483a879ff359c7","zIndex":21}|
{"type":"ATTR","ticket":665,"id":"afe55f9718e053dc"}||{"x":null,"y":null,"rotation":null,"color":null,"fontFamily":null,"fontSize":null,"fontWeight":null,"italic":null,"underline":null,"align":null,"value":"","keyVisible":null,"valueVisible":null,"key":"Datasheet","fillColor":null,"parentId":"ec483a879ff359c7","zIndex":22}|
{"type":"ATTR","ticket":666,"id":"1a390728f31d3eeb"}||{"x":null,"y":null,"rotation":null,"color":null,"fontFamily":null,"fontSize":null,"fontWeight":null,"italic":null,"underline":null,"align":null,"value":"","keyVisible":null,"valueVisible":null,"key":"Description","fillColor":null,"parentId":"ec483a879ff359c7","zIndex":23}|
{"type":"ATTR","ticket":667,"id":"bcbc46246b6afd15"}||{"x":null,"y":null,"rotation":null,"color":null,"fontFamily":null,"fontSize":null,"fontWeight":null,"italic":null,"underline":null,"align":null,"value":"","keyVisible":null,"valueVisible":null,"key":"Manufacturer","fillColor":null,"parentId":"002f4ea8fcaffc15","zIndex":15}|
{"type":"ATTR","ticket":668,"id":"7ccee053bee72629"}||{"x":null,"y":null,"rotation":null,"color":null,"fontFamily":null,"fontSize":null,"fontWeight":null,"italic":null,"underline":null,"align":null,"value":"TP-黄色测试点","keyVisible":null,"valueVisible":null,"key":"Manufacturer Part","fillColor":null,"parentId":"002f4ea8fcaffc15","zIndex":16}|
{"type":"ATTR","ticket":669,"id":"b19ef10308ba2453"}||{"x":null,"y":null,"rotation":null,"color":null,"fontFamily":null,"fontSize":null,"fontWeight":null,"italic":null,"underline":null,"align":null,"value":"LCSC","keyVisible":null,"valueVisible":null,"key":"Supplier","fillColor":null,"parentId":"002f4ea8fcaffc15","zIndex":17}|
{"type":"ATTR","ticket":670,"id":"e1aba6357375b0ed"}||{"x":null,"y":null,"rotation":null,"color":null,"fontFamily":null,"fontSize":null,"fontWeight":null,"italic":null,"underline":null,"align":null,"value":"TP-黄色测试点.1","keyVisible":null,"valueVisible":null,"key":"Supplier Part","fillColor":null,"parentId":"002f4ea8fcaffc15","zIndex":18}|
{"type":"ATTR","ticket":671,"id":"1b3d44458d2faf3d"}||{"x":null,"y":null,"rotation":null,"color":null,"fontFamily":null,"fontSize":null,"fontWeight":null,"italic":null,"underline":null,"align":null,"value":"","keyVisible":null,"valueVisible":null,"key":"LCSC Part Name","fillColor":null,"parentId":"002f4ea8fcaffc15","zIndex":19}|
{"type":"ATTR","ticket":672,"id":"87b6d9b1946b0187"}||{"x":null,"y":null,"rotation":null,"color":null,"fontFamily":null,"fontSize":null,"fontWeight":null,"italic":null,"underline":null,"align":null,"value":"","keyVisible":null,"valueVisible":null,"key":"Supplier Footprint","fillColor":null,"parentId":"002f4ea8fcaffc15","zIndex":20}|
{"type":"ATTR","ticket":673,"id":"686dd94a52d88d28"}||{"x":null,"y":null,"rotation":null,"color":null,"fontFamily":null,"fontSize":null,"fontWeight":null,"italic":null,"underline":null,"align":null,"value":"","keyVisible":null,"valueVisible":null,"key":"JLCPCB Part Class","fillColor":null,"parentId":"002f4ea8fcaffc15","zIndex":21}|
{"type":"ATTR","ticket":674,"id":"24765d44f99278cb"}||{"x":null,"y":null,"rotation":null,"color":null,"fontFamily":null,"fontSize":null,"fontWeight":null,"italic":null,"underline":null,"align":null,"value":"","keyVisible":null,"valueVisible":null,"key":"Datasheet","fillColor":null,"parentId":"002f4ea8fcaffc15","zIndex":22}|
{"type":"ATTR","ticket":675,"id":"6dffd505b8e47074"}||{"x":null,"y":null,"rotation":null,"color":null,"fontFamily":null,"fontSize":null,"fontWeight":null,"italic":null,"underline":null,"align":null,"value":"","keyVisible":null,"valueVisible":null,"key":"Description","fillColor":null,"parentId":"002f4ea8fcaffc15","zIndex":23}|
{"type":"ATTR","ticket":676,"id":"144a71a6b2b7b2e1"}||{"x":null,"y":null,"rotation":null,"color":null,"fontFamily":null,"fontSize":null,"fontWeight":null,"italic":null,"underline":null,"align":null,"value":"","keyVisible":null,"valueVisible":null,"key":"Manufacturer","fillColor":null,"parentId":"c06f7a9d7c460947","zIndex":15}|
{"type":"ATTR","ticket":677,"id":"405f70f998a700db"}||{"x":null,"y":null,"rotation":null,"color":null,"fontFamily":null,"fontSize":null,"fontWeight":null,"italic":null,"underline":null,"align":null,"value":"TP-黄色测试点","keyVisible":null,"valueVisible":null,"key":"Manufacturer Part","fillColor":null,"parentId":"c06f7a9d7c460947","zIndex":16}|
{"type":"ATTR","ticket":678,"id":"4803223281426388"}||{"x":null,"y":null,"rotation":null,"color":null,"fontFamily":null,"fontSize":null,"fontWeight":null,"italic":null,"underline":null,"align":null,"value":"LCSC","keyVisible":null,"valueVisible":null,"key":"Supplier","fillColor":null,"parentId":"c06f7a9d7c460947","zIndex":17}|
{"type":"ATTR","ticket":679,"id":"5c55a9c23a58900e"}||{"x":null,"y":null,"rotation":null,"color":null,"fontFamily":null,"fontSize":null,"fontWeight":null,"italic":null,"underline":null,"align":null,"value":"TP-黄色测试点.1","keyVisible":null,"valueVisible":null,"key":"Supplier Part","fillColor":null,"parentId":"c06f7a9d7c460947","zIndex":18}|
{"type":"ATTR","ticket":680,"id":"4a2937fa8925bbca"}||{"x":null,"y":null,"rotation":null,"color":null,"fontFamily":null,"fontSize":null,"fontWeight":null,"italic":null,"underline":null,"align":null,"value":"","keyVisible":null,"valueVisible":null,"key":"LCSC Part Name","fillColor":null,"parentId":"c06f7a9d7c460947","zIndex":19}|
{"type":"ATTR","ticket":681,"id":"c42167a45371d0d5"}||{"x":null,"y":null,"rotation":null,"color":null,"fontFamily":null,"fontSize":null,"fontWeight":null,"italic":null,"underline":null,"align":null,"value":"","keyVisible":null,"valueVisible":null,"key":"Supplier Footprint","fillColor":null,"parentId":"c06f7a9d7c460947","zIndex":20}|
{"type":"ATTR","ticket":682,"id":"4e005abce7e46e28"}||{"x":null,"y":null,"rotation":null,"color":null,"fontFamily":null,"fontSize":null,"fontWeight":null,"italic":null,"underline":null,"align":null,"value":"","keyVisible":null,"valueVisible":null,"key":"JLCPCB Part Class","fillColor":null,"parentId":"c06f7a9d7c460947","zIndex":21}|
{"type":"ATTR","ticket":683,"id":"63a6d2c057e3950c"}||{"x":null,"y":null,"rotation":null,"color":null,"fontFamily":null,"fontSize":null,"fontWeight":null,"italic":null,"underline":null,"align":null,"value":"","keyVisible":null,"valueVisible":null,"key":"Datasheet","fillColor":null,"parentId":"c06f7a9d7c460947","zIndex":22}|
{"type":"ATTR","ticket":684,"id":"6e555050c6061b4f"}||{"x":null,"y":null,"rotation":null,"color":null,"fontFamily":null,"fontSize":null,"fontWeight":null,"italic":null,"underline":null,"align":null,"value":"","keyVisible":null,"valueVisible":null,"key":"Description","fillColor":null,"parentId":"c06f7a9d7c460947","zIndex":23}|
{"type":"COMPONENT","ticket":685,"id":"afc05500e5b8bc65"}||{"partId":"SRV05-4_C338781.1","x":200,"y":-950,"rotation":90,"isMirror":false,"attrs":{"Footprints":"[]","Devices":"[]","DeviceName":"{\"uuid\":\"6f472536d38f3187\",\"name\":\"SRV05-4_C338781\",\"source\":\"\"}","FootprintName":null,"isSwitchClose":false,"pinClass":{},"differentialPairClass":{},"Symbols":"[]"},"zIndex":145}|
{"type":"ATTR","ticket":686,"id":"f65f28344f77142a"}||{"x":null,"y":null,"rotation":null,"color":null,"fontFamily":null,"fontSize":null,"fontWeight":null,"italic":null,"underline":null,"strikeout":false,"align":null,"value":"098a510c035b853f","keyVisible":null,"valueVisible":null,"key":"Symbol","fillColor":null,"parentId":"afc05500e5b8bc65","zIndex":55}|
{"type":"ATTR","ticket":687,"id":"088d910e83393436"}||{"x":null,"y":null,"rotation":null,"color":null,"fontFamily":null,"fontSize":null,"fontWeight":null,"italic":null,"underline":null,"strikeout":false,"align":null,"value":"6f472536d38f3187","keyVisible":null,"valueVisible":null,"key":"Device","fillColor":null,"parentId":"afc05500e5b8bc65","zIndex":50}|
{"type":"ATTR","ticket":688,"id":"60bcf9d67e3ca829"}||{"x":null,"y":null,"rotation":null,"color":null,"fontFamily":null,"fontSize":null,"fontWeight":null,"italic":null,"underline":null,"strikeout":false,"align":null,"value":"gge54","keyVisible":null,"valueVisible":null,"key":"Unique ID","fillColor":null,"parentId":"afc05500e5b8bc65","zIndex":56}|
{"type":"ATTR","ticket":689,"id":"4db9ac7635000500"}||{"x":null,"y":null,"rotation":null,"color":null,"fontFamily":null,"fontSize":null,"fontWeight":null,"italic":null,"underline":null,"strikeout":false,"align":null,"value":"yes","keyVisible":null,"valueVisible":null,"key":"Add into BOM","fillColor":null,"parentId":"afc05500e5b8bc65","zIndex":48}|
{"type":"ATTR","ticket":690,"id":"f0c52941b6c0518b"}||{"x":null,"y":null,"rotation":null,"color":null,"fontFamily":null,"fontSize":null,"fontWeight":null,"italic":null,"underline":null,"strikeout":false,"align":null,"value":"yes","keyVisible":null,"valueVisible":null,"key":"Convert to PCB","fillColor":null,"parentId":"afc05500e5b8bc65","zIndex":49}|
{"type":"ATTR","ticket":691,"id":"1b452c19175078ef"}||{"x":245,"y":-960,"rotation":0,"color":null,"fontFamily":null,"fontSize":6.75,"fontWeight":false,"italic":false,"underline":false,"strikeout":false,"align":null,"value":"={Manufacturer Part}","keyVisible":null,"valueVisible":true,"key":"Name","fillColor":null,"parentId":"afc05500e5b8bc65","zIndex":53,"locked":false}|
{"type":"ATTR","ticket":692,"id":"69af56e69c544ca8"}||{"x":245,"y":-970,"rotation":0,"color":null,"fontFamily":null,"fontSize":6.75,"fontWeight":false,"italic":false,"underline":false,"strikeout":false,"align":null,"value":"D1","keyVisible":null,"valueVisible":true,"key":"Designator","fillColor":null,"parentId":"afc05500e5b8bc65","zIndex":54,"locked":false}|
{"type":"ATTR","ticket":693,"id":"9375458d3c7d0c5c"}||{"x":null,"y":null,"rotation":null,"color":null,"fontFamily":null,"fontSize":null,"fontWeight":null,"italic":null,"underline":null,"strikeout":false,"align":null,"value":null,"keyVisible":null,"valueVisible":null,"key":"Footprint","fillColor":null,"parentId":"afc05500e5b8bc65","zIndex":51}|
{"type":"ATTR","ticket":694,"id":"d676d8351ceb5380"}||{"x":null,"y":null,"rotation":null,"color":null,"fontFamily":null,"fontSize":null,"fontWeight":null,"italic":null,"underline":null,"align":null,"value":null,"keyVisible":null,"valueVisible":null,"key":"Reuse Block","fillColor":null,"parentId":"afc05500e5b8bc65","zIndex":57}|
{"type":"ATTR","ticket":695,"id":"4dd03cc85bd7b914"}||{"x":null,"y":null,"rotation":null,"color":null,"fontFamily":null,"fontSize":null,"fontWeight":null,"italic":null,"underline":null,"align":null,"value":null,"keyVisible":null,"valueVisible":null,"key":"Group ID","fillColor":null,"parentId":"afc05500e5b8bc65","zIndex":58}|
{"type":"ATTR","ticket":696,"id":"254a7e4a8a3eb0ee"}||{"x":null,"y":null,"rotation":null,"color":null,"fontFamily":null,"fontSize":null,"fontWeight":null,"italic":null,"underline":null,"align":null,"value":null,"keyVisible":null,"valueVisible":null,"key":"Channel ID","fillColor":null,"parentId":"afc05500e5b8bc65","zIndex":59}|
{"type":"ATTR","ticket":697,"id":"b30281119fb7a4c3"}||{"x":null,"y":null,"rotation":null,"color":null,"fontFamily":null,"fontSize":null,"fontWeight":null,"italic":null,"underline":null,"align":null,"value":"","keyVisible":null,"valueVisible":null,"key":"Manufacturer","fillColor":null,"parentId":"afc05500e5b8bc65","zIndex":60}|
{"type":"ATTR","ticket":698,"id":"e4184c86b153ca02"}||{"x":null,"y":null,"rotation":null,"color":null,"fontFamily":null,"fontSize":null,"fontWeight":null,"italic":null,"underline":null,"align":null,"value":"SRV05-4","keyVisible":null,"valueVisible":null,"key":"Manufacturer Part","fillColor":null,"parentId":"afc05500e5b8bc65","zIndex":61}|
{"type":"ATTR","ticket":699,"id":"1a11a1f4126279ce"}||{"x":null,"y":null,"rotation":null,"color":null,"fontFamily":null,"fontSize":null,"fontWeight":null,"italic":null,"underline":null,"align":null,"value":"LCSC","keyVisible":null,"valueVisible":null,"key":"Supplier","fillColor":null,"parentId":"afc05500e5b8bc65","zIndex":62}|
{"type":"ATTR","ticket":700,"id":"0b904261f4cbf0a3"}||{"x":null,"y":null,"rotation":null,"color":null,"fontFamily":null,"fontSize":null,"fontWeight":null,"italic":null,"underline":null,"align":null,"value":"SRV05-4_C338781.1","keyVisible":null,"valueVisible":null,"key":"Supplier Part","fillColor":null,"parentId":"afc05500e5b8bc65","zIndex":63}|
{"type":"ATTR","ticket":701,"id":"4aa577938c972289"}||{"x":null,"y":null,"rotation":null,"color":null,"fontFamily":null,"fontSize":null,"fontWeight":null,"italic":null,"underline":null,"align":null,"value":"","keyVisible":null,"valueVisible":null,"key":"LCSC Part Name","fillColor":null,"parentId":"afc05500e5b8bc65","zIndex":64}|
{"type":"ATTR","ticket":702,"id":"1a3e2746db49cf95"}||{"x":null,"y":null,"rotation":null,"color":null,"fontFamily":null,"fontSize":null,"fontWeight":null,"italic":null,"underline":null,"align":null,"value":"","keyVisible":null,"valueVisible":null,"key":"Supplier Footprint","fillColor":null,"parentId":"afc05500e5b8bc65","zIndex":65}|
{"type":"ATTR","ticket":703,"id":"f58b4f68d25c7b6c"}||{"x":null,"y":null,"rotation":null,"color":null,"fontFamily":null,"fontSize":null,"fontWeight":null,"italic":null,"underline":null,"align":null,"value":"","keyVisible":null,"valueVisible":null,"key":"JLCPCB Part Class","fillColor":null,"parentId":"afc05500e5b8bc65","zIndex":66}|
{"type":"ATTR","ticket":704,"id":"5e80aa63f044d206"}||{"x":null,"y":null,"rotation":null,"color":null,"fontFamily":null,"fontSize":null,"fontWeight":null,"italic":null,"underline":null,"align":null,"value":"","keyVisible":null,"valueVisible":null,"key":"Datasheet","fillColor":null,"parentId":"afc05500e5b8bc65","zIndex":67}|
{"type":"ATTR","ticket":705,"id":"8a7c75a2b2776389"}||{"x":null,"y":null,"rotation":null,"color":null,"fontFamily":null,"fontSize":null,"fontWeight":null,"italic":null,"underline":null,"align":null,"value":"","keyVisible":null,"valueVisible":null,"key":"Reverse Stand-Off Voltage (Vrwm)","fillColor":null,"parentId":"afc05500e5b8bc65","zIndex":68}|
{"type":"ATTR","ticket":706,"id":"17d36b817778fcc3"}||{"x":null,"y":null,"rotation":null,"color":null,"fontFamily":null,"fontSize":null,"fontWeight":null,"italic":null,"underline":null,"align":null,"value":"","keyVisible":null,"valueVisible":null,"key":"Maximum Clamping Voltage","fillColor":null,"parentId":"afc05500e5b8bc65","zIndex":69}|
{"type":"ATTR","ticket":707,"id":"0130af97a985fb0d"}||{"x":null,"y":null,"rotation":null,"color":null,"fontFamily":null,"fontSize":null,"fontWeight":null,"italic":null,"underline":null,"align":null,"value":"","keyVisible":null,"valueVisible":null,"key":"Peak Pulse Current (Ipp)","fillColor":null,"parentId":"afc05500e5b8bc65","zIndex":70}|
{"type":"ATTR","ticket":708,"id":"aaa2925551de8efa"}||{"x":null,"y":null,"rotation":null,"color":null,"fontFamily":null,"fontSize":null,"fontWeight":null,"italic":null,"underline":null,"align":null,"value":"","keyVisible":null,"valueVisible":null,"key":"Voltage - Breakdown","fillColor":null,"parentId":"afc05500e5b8bc65","zIndex":71}|
{"type":"ATTR","ticket":709,"id":"ade4b8ea765f633b"}||{"x":null,"y":null,"rotation":null,"color":null,"fontFamily":null,"fontSize":null,"fontWeight":null,"italic":null,"underline":null,"align":null,"value":"","keyVisible":null,"valueVisible":null,"key":"Type","fillColor":null,"parentId":"afc05500e5b8bc65","zIndex":72}|
{"type":"ATTR","ticket":710,"id":"f764bb5b2039e109"}||{"x":null,"y":null,"rotation":null,"color":null,"fontFamily":null,"fontSize":null,"fontWeight":null,"italic":null,"underline":null,"align":null,"value":"","keyVisible":null,"valueVisible":null,"key":"Description","fillColor":null,"parentId":"afc05500e5b8bc65","zIndex":73}|
{"type":"COMPONENT","ticket":711,"id":"18d8f01875955814"}||{"partId":"XRCD54-4R7M.1","x":1020,"y":-1050,"rotation":0,"isMirror":false,"attrs":{"Footprints":"[]","Devices":"[]","DeviceName":"{\"uuid\":\"6f5e521d46c219da\",\"name\":\"XRCD54-4R7M\",\"source\":\"\"}","FootprintName":null,"isSwitchClose":false,"pinClass":{},"differentialPairClass":{},"Symbols":"[]"},"zIndex":146}|
{"type":"ATTR","ticket":712,"id":"f10f8309bc3a268f"}||{"x":null,"y":null,"rotation":0,"color":null,"fontFamily":null,"fontSize":null,"fontWeight":false,"italic":false,"underline":false,"strikeout":false,"align":null,"value":"fa54ba7e81d90590","keyVisible":null,"valueVisible":null,"key":"Symbol","fillColor":null,"parentId":"18d8f01875955814","zIndex":11,"locked":false}|
{"type":"ATTR","ticket":713,"id":"0b234cdee043ed8e"}||{"x":null,"y":null,"rotation":null,"color":null,"fontFamily":null,"fontSize":null,"fontWeight":null,"italic":null,"underline":null,"strikeout":false,"align":null,"value":"6f5e521d46c219da","keyVisible":null,"valueVisible":null,"key":"Device","fillColor":null,"parentId":"18d8f01875955814","zIndex":8}|
{"type":"ATTR","ticket":714,"id":"69251be9d0553c09"}||{"x":null,"y":null,"rotation":null,"color":null,"fontFamily":null,"fontSize":null,"fontWeight":null,"italic":null,"underline":null,"strikeout":false,"align":null,"value":"gge55","keyVisible":null,"valueVisible":null,"key":"Unique ID","fillColor":null,"parentId":"18d8f01875955814","zIndex":13}|
{"type":"ATTR","ticket":715,"id":"a9f7afddad541c4a"}||{"x":null,"y":null,"rotation":null,"color":null,"fontFamily":null,"fontSize":null,"fontWeight":null,"italic":null,"underline":null,"strikeout":false,"align":null,"value":"yes","keyVisible":null,"valueVisible":null,"key":"Add into BOM","fillColor":null,"parentId":"18d8f01875955814","zIndex":6}|
{"type":"ATTR","ticket":716,"id":"9cfc92340d35e296"}||{"x":null,"y":null,"rotation":null,"color":null,"fontFamily":null,"fontSize":null,"fontWeight":null,"italic":null,"underline":null,"strikeout":false,"align":null,"value":"yes","keyVisible":null,"valueVisible":null,"key":"Convert to PCB","fillColor":null,"parentId":"18d8f01875955814","zIndex":7}|
{"type":"ATTR","ticket":717,"id":"476013cc0a91d0f0"}||{"x":1005,"y":-1055,"rotation":0,"color":null,"fontFamily":null,"fontSize":null,"fontWeight":false,"italic":false,"underline":false,"strikeout":false,"align":null,"value":"L1","keyVisible":null,"valueVisible":true,"key":"Designator","fillColor":null,"parentId":"18d8f01875955814","zIndex":12,"locked":false}|
{"type":"ATTR","ticket":718,"id":"274570876132d989"}||{"x":null,"y":null,"rotation":null,"color":null,"fontFamily":null,"fontSize":null,"fontWeight":null,"italic":null,"underline":null,"strikeout":false,"align":null,"value":null,"keyVisible":null,"valueVisible":null,"key":"Footprint","fillColor":null,"parentId":"18d8f01875955814","zIndex":9}|
{"type":"ATTR","ticket":719,"id":"fea3512783c616f3"}||{"x":1005,"y":-1040,"rotation":0,"color":null,"fontFamily":null,"fontSize":null,"fontWeight":null,"italic":null,"underline":null,"align":null,"value":"={Value}","keyVisible":null,"valueVisible":true,"key":"Name","fillColor":null,"parentId":"18d8f01875955814","zIndex":14}|
{"type":"ATTR","ticket":720,"id":"96f880b30294054f"}||{"x":null,"y":null,"rotation":null,"color":null,"fontFamily":null,"fontSize":null,"fontWeight":null,"italic":null,"underline":null,"align":null,"value":null,"keyVisible":null,"valueVisible":null,"key":"Reuse Block","fillColor":null,"parentId":"18d8f01875955814","zIndex":15}|
{"type":"ATTR","ticket":721,"id":"cd83453a9d9250fb"}||{"x":null,"y":null,"rotation":null,"color":null,"fontFamily":null,"fontSize":null,"fontWeight":null,"italic":null,"underline":null,"align":null,"value":null,"keyVisible":null,"valueVisible":null,"key":"Group ID","fillColor":null,"parentId":"18d8f01875955814","zIndex":16}|
{"type":"ATTR","ticket":722,"id":"2c64bbc69a5c4357"}||{"x":null,"y":null,"rotation":null,"color":null,"fontFamily":null,"fontSize":null,"fontWeight":null,"italic":null,"underline":null,"align":null,"value":null,"keyVisible":null,"valueVisible":null,"key":"Channel ID","fillColor":null,"parentId":"18d8f01875955814","zIndex":17}|
{"type":"ATTR","ticket":723,"id":"9fb4a528061ab2bd"}||{"x":null,"y":null,"rotation":null,"color":null,"fontFamily":null,"fontSize":null,"fontWeight":null,"italic":null,"underline":null,"align":null,"value":"XR(祥如)","keyVisible":null,"valueVisible":null,"key":"Manufacturer","fillColor":null,"parentId":"18d8f01875955814","zIndex":18}|
{"type":"ATTR","ticket":724,"id":"4dbad956b67cc976"}||{"x":null,"y":null,"rotation":null,"color":null,"fontFamily":null,"fontSize":null,"fontWeight":null,"italic":null,"underline":null,"align":null,"value":"XRCD54-4R7M","keyVisible":null,"valueVisible":null,"key":"Manufacturer Part","fillColor":null,"parentId":"18d8f01875955814","zIndex":19}|
{"type":"ATTR","ticket":725,"id":"f834574fd526a0a0"}||{"x":null,"y":null,"rotation":null,"color":null,"fontFamily":null,"fontSize":null,"fontWeight":null,"italic":null,"underline":null,"align":null,"value":"LCSC","keyVisible":null,"valueVisible":null,"key":"Supplier","fillColor":null,"parentId":"18d8f01875955814","zIndex":20}|
{"type":"ATTR","ticket":726,"id":"4f522dd3358f990f"}||{"x":null,"y":null,"rotation":null,"color":null,"fontFamily":null,"fontSize":null,"fontWeight":null,"italic":null,"underline":null,"align":null,"value":"XRCD54-4R7M.1","keyVisible":null,"valueVisible":null,"key":"Supplier Part","fillColor":null,"parentId":"18d8f01875955814","zIndex":21}|
{"type":"ATTR","ticket":727,"id":"cd3fed8c259f84cd"}||{"x":null,"y":null,"rotation":null,"color":null,"fontFamily":null,"fontSize":null,"fontWeight":null,"italic":null,"underline":null,"align":null,"value":"","keyVisible":null,"valueVisible":null,"key":"LCSC Part Name","fillColor":null,"parentId":"18d8f01875955814","zIndex":22}|
{"type":"ATTR","ticket":728,"id":"67b76f52827d2068"}||{"x":null,"y":null,"rotation":null,"color":null,"fontFamily":null,"fontSize":null,"fontWeight":null,"italic":null,"underline":null,"align":null,"value":"","keyVisible":null,"valueVisible":null,"key":"Supplier Footprint","fillColor":null,"parentId":"18d8f01875955814","zIndex":23}|
{"type":"ATTR","ticket":729,"id":"be2e38ee298f8b39"}||{"x":null,"y":null,"rotation":null,"color":null,"fontFamily":null,"fontSize":null,"fontWeight":null,"italic":null,"underline":null,"align":null,"value":"","keyVisible":null,"valueVisible":null,"key":"JLCPCB Part Class","fillColor":null,"parentId":"18d8f01875955814","zIndex":24}|
{"type":"ATTR","ticket":730,"id":"629ac7378b6ec66d"}||{"x":null,"y":null,"rotation":null,"color":null,"fontFamily":null,"fontSize":null,"fontWeight":null,"italic":null,"underline":null,"align":null,"value":"","keyVisible":null,"valueVisible":null,"key":"Datasheet","fillColor":null,"parentId":"18d8f01875955814","zIndex":25}|
{"type":"ATTR","ticket":731,"id":"efab04b94c028dc1"}||{"x":null,"y":null,"rotation":null,"color":null,"fontFamily":null,"fontSize":null,"fontWeight":null,"italic":null,"underline":null,"align":null,"value":"4.7uH","keyVisible":null,"valueVisible":null,"key":"Value","fillColor":null,"parentId":"18d8f01875955814","zIndex":26}|
{"type":"ATTR","ticket":732,"id":"6224f6f566b2ade7"}||{"x":null,"y":null,"rotation":null,"color":null,"fontFamily":null,"fontSize":null,"fontWeight":null,"italic":null,"underline":null,"align":null,"value":"","keyVisible":null,"valueVisible":null,"key":"Tolerance","fillColor":null,"parentId":"18d8f01875955814","zIndex":27}|
{"type":"ATTR","ticket":733,"id":"34ce5d1328b37257"}||{"x":null,"y":null,"rotation":null,"color":null,"fontFamily":null,"fontSize":null,"fontWeight":null,"italic":null,"underline":null,"align":null,"value":"","keyVisible":null,"valueVisible":null,"key":"Rated Current","fillColor":null,"parentId":"18d8f01875955814","zIndex":28}|
{"type":"ATTR","ticket":734,"id":"4b7c5f64ae214899"}||{"x":null,"y":null,"rotation":null,"color":null,"fontFamily":null,"fontSize":null,"fontWeight":null,"italic":null,"underline":null,"align":null,"value":"","keyVisible":null,"valueVisible":null,"key":"DC Resistance (DCR)","fillColor":null,"parentId":"18d8f01875955814","zIndex":29}|
{"type":"ATTR","ticket":735,"id":"a2f6aa5d2c2f47e6"}||{"x":null,"y":null,"rotation":null,"color":null,"fontFamily":null,"fontSize":null,"fontWeight":null,"italic":null,"underline":null,"align":null,"value":"","keyVisible":null,"valueVisible":null,"key":"Type","fillColor":null,"parentId":"18d8f01875955814","zIndex":30}|
{"type":"ATTR","ticket":736,"id":"6a44cbfad7c46d92"}||{"x":null,"y":null,"rotation":null,"color":null,"fontFamily":null,"fontSize":null,"fontWeight":null,"italic":null,"underline":null,"align":null,"value":"","keyVisible":null,"valueVisible":null,"key":"Description","fillColor":null,"parentId":"18d8f01875955814","zIndex":31}|
{"type":"COMPONENT","ticket":737,"id":"e9e90131ba3df242"}||{"partId":"CD54-220M_C49230813.1","x":1260,"y":-1050,"rotation":0,"isMirror":false,"attrs":{"Footprints":"[]","Devices":"[]","DeviceName":"{\"uuid\":\"8e054a9fbef4301c\",\"name\":\"CD54-220M\",\"source\":\"\"}","FootprintName":null,"isSwitchClose":false,"pinClass":{},"differentialPairClass":{},"Symbols":"[]"},"zIndex":147}|
{"type":"ATTR","ticket":738,"id":"175fe827bb41df46"}||{"x":null,"y":null,"rotation":null,"color":null,"fontFamily":null,"fontSize":null,"fontWeight":null,"italic":null,"underline":null,"strikeout":false,"align":null,"value":"959b7cd5b91b8cce","keyVisible":null,"valueVisible":null,"key":"Symbol","fillColor":null,"parentId":"e9e90131ba3df242","zIndex":13}|
{"type":"ATTR","ticket":739,"id":"209c3406f9720dc3"}||{"x":null,"y":null,"rotation":null,"color":null,"fontFamily":null,"fontSize":null,"fontWeight":null,"italic":null,"underline":null,"strikeout":false,"align":null,"value":"8e054a9fbef4301c","keyVisible":null,"valueVisible":null,"key":"Device","fillColor":null,"parentId":"e9e90131ba3df242","zIndex":8}|
{"type":"ATTR","ticket":740,"id":"b37bf0ece4258074"}||{"x":null,"y":null,"rotation":null,"color":null,"fontFamily":null,"fontSize":null,"fontWeight":null,"italic":null,"underline":null,"strikeout":false,"align":null,"value":"gge56","keyVisible":null,"valueVisible":null,"key":"Unique ID","fillColor":null,"parentId":"e9e90131ba3df242","zIndex":14}|
{"type":"ATTR","ticket":741,"id":"265cb9125482f14d"}||{"x":null,"y":null,"rotation":null,"color":null,"fontFamily":null,"fontSize":null,"fontWeight":null,"italic":null,"underline":null,"strikeout":false,"align":null,"value":"yes","keyVisible":null,"valueVisible":null,"key":"Add into BOM","fillColor":null,"parentId":"e9e90131ba3df242","zIndex":6}|
{"type":"ATTR","ticket":742,"id":"fe24cfb6c40eff38"}||{"x":null,"y":null,"rotation":null,"color":null,"fontFamily":null,"fontSize":null,"fontWeight":null,"italic":null,"underline":null,"strikeout":false,"align":null,"value":"yes","keyVisible":null,"valueVisible":null,"key":"Convert to PCB","fillColor":null,"parentId":"e9e90131ba3df242","zIndex":7}|
{"type":"ATTR","ticket":743,"id":"0217bbf3efe95c48"}||{"x":1245,"y":-1040,"rotation":0,"color":null,"fontFamily":null,"fontSize":6.75,"fontWeight":false,"italic":false,"underline":false,"strikeout":false,"align":null,"value":"={Value}","keyVisible":null,"valueVisible":true,"key":"Name","fillColor":null,"parentId":"e9e90131ba3df242","zIndex":11,"locked":false}|
{"type":"ATTR","ticket":744,"id":"38a63a39d8497f1a"}||{"x":1245,"y":-1055,"rotation":0,"color":null,"fontFamily":null,"fontSize":6.75,"fontWeight":false,"italic":false,"underline":false,"strikeout":false,"align":null,"value":"L3","keyVisible":null,"valueVisible":true,"key":"Designator","fillColor":null,"parentId":"e9e90131ba3df242","zIndex":12,"locked":false}|
{"type":"ATTR","ticket":745,"id":"35f79b5c55f115a4"}||{"x":null,"y":null,"rotation":null,"color":null,"fontFamily":null,"fontSize":null,"fontWeight":null,"italic":null,"underline":null,"strikeout":false,"align":null,"value":null,"keyVisible":null,"valueVisible":null,"key":"Footprint","fillColor":null,"parentId":"e9e90131ba3df242","zIndex":9}|
{"type":"ATTR","ticket":746,"id":"e8ecca67b70d43ea"}||{"x":null,"y":null,"rotation":null,"color":null,"fontFamily":null,"fontSize":null,"fontWeight":null,"italic":null,"underline":null,"align":null,"value":null,"keyVisible":null,"valueVisible":null,"key":"Reuse Block","fillColor":null,"parentId":"e9e90131ba3df242","zIndex":15}|
{"type":"ATTR","ticket":747,"id":"186a41e9dbc6d515"}||{"x":null,"y":null,"rotation":null,"color":null,"fontFamily":null,"fontSize":null,"fontWeight":null,"italic":null,"underline":null,"align":null,"value":null,"keyVisible":null,"valueVisible":null,"key":"Group ID","fillColor":null,"parentId":"e9e90131ba3df242","zIndex":16}|
{"type":"ATTR","ticket":748,"id":"8d38e345e32bc0bd"}||{"x":null,"y":null,"rotation":null,"color":null,"fontFamily":null,"fontSize":null,"fontWeight":null,"italic":null,"underline":null,"align":null,"value":null,"keyVisible":null,"valueVisible":null,"key":"Channel ID","fillColor":null,"parentId":"e9e90131ba3df242","zIndex":17}|
{"type":"ATTR","ticket":749,"id":"c54154903505edf9"}||{"x":null,"y":null,"rotation":null,"color":null,"fontFamily":null,"fontSize":null,"fontWeight":null,"italic":null,"underline":null,"align":null,"value":"Zoomdo(震东电子)","keyVisible":null,"valueVisible":null,"key":"Manufacturer","fillColor":null,"parentId":"e9e90131ba3df242","zIndex":18}|
{"type":"ATTR","ticket":750,"id":"de95aba54a24a1b3"}||{"x":null,"y":null,"rotation":null,"color":null,"fontFamily":null,"fontSize":null,"fontWeight":null,"italic":null,"underline":null,"align":null,"value":"CD54-220M","keyVisible":null,"valueVisible":null,"key":"Manufacturer Part","fillColor":null,"parentId":"e9e90131ba3df242","zIndex":19}|
{"type":"ATTR","ticket":751,"id":"5384aca9a90dd223"}||{"x":null,"y":null,"rotation":null,"color":null,"fontFamily":null,"fontSize":null,"fontWeight":null,"italic":null,"underline":null,"align":null,"value":"LCSC","keyVisible":null,"valueVisible":null,"key":"Supplier","fillColor":null,"parentId":"e9e90131ba3df242","zIndex":20}|
{"type":"ATTR","ticket":752,"id":"2eb90a26775b9888"}||{"x":null,"y":null,"rotation":null,"color":null,"fontFamily":null,"fontSize":null,"fontWeight":null,"italic":null,"underline":null,"align":null,"value":"CD54-220M_C49230813.1","keyVisible":null,"valueVisible":null,"key":"Supplier Part","fillColor":null,"parentId":"e9e90131ba3df242","zIndex":21}|
{"type":"ATTR","ticket":753,"id":"041791266358d968"}||{"x":null,"y":null,"rotation":null,"color":null,"fontFamily":null,"fontSize":null,"fontWeight":null,"italic":null,"underline":null,"align":null,"value":"","keyVisible":null,"valueVisible":null,"key":"LCSC Part Name","fillColor":null,"parentId":"e9e90131ba3df242","zIndex":22}|
{"type":"ATTR","ticket":754,"id":"85f51a4c421e53a9"}||{"x":null,"y":null,"rotation":null,"color":null,"fontFamily":null,"fontSize":null,"fontWeight":null,"italic":null,"underline":null,"align":null,"value":"","keyVisible":null,"valueVisible":null,"key":"Supplier Footprint","fillColor":null,"parentId":"e9e90131ba3df242","zIndex":23}|
{"type":"ATTR","ticket":755,"id":"2611276814193e3f"}||{"x":null,"y":null,"rotation":null,"color":null,"fontFamily":null,"fontSize":null,"fontWeight":null,"italic":null,"underline":null,"align":null,"value":"","keyVisible":null,"valueVisible":null,"key":"JLCPCB Part Class","fillColor":null,"parentId":"e9e90131ba3df242","zIndex":24}|
{"type":"ATTR","ticket":756,"id":"d849cf4e1075d2a6"}||{"x":null,"y":null,"rotation":null,"color":null,"fontFamily":null,"fontSize":null,"fontWeight":null,"italic":null,"underline":null,"align":null,"value":"","keyVisible":null,"valueVisible":null,"key":"Datasheet","fillColor":null,"parentId":"e9e90131ba3df242","zIndex":25}|
{"type":"ATTR","ticket":757,"id":"543df1688b081e83"}||{"x":null,"y":null,"rotation":null,"color":null,"fontFamily":null,"fontSize":null,"fontWeight":null,"italic":null,"underline":null,"align":null,"value":"22uH","keyVisible":null,"valueVisible":null,"key":"Value","fillColor":null,"parentId":"e9e90131ba3df242","zIndex":26}|
{"type":"ATTR","ticket":758,"id":"aaa28b7c9271959d"}||{"x":null,"y":null,"rotation":null,"color":null,"fontFamily":null,"fontSize":null,"fontWeight":null,"italic":null,"underline":null,"align":null,"value":"","keyVisible":null,"valueVisible":null,"key":"Tolerance","fillColor":null,"parentId":"e9e90131ba3df242","zIndex":27}|
{"type":"ATTR","ticket":759,"id":"2170c2add75da1b8"}||{"x":null,"y":null,"rotation":null,"color":null,"fontFamily":null,"fontSize":null,"fontWeight":null,"italic":null,"underline":null,"align":null,"value":"","keyVisible":null,"valueVisible":null,"key":"Current Rating","fillColor":null,"parentId":"e9e90131ba3df242","zIndex":28}|
{"type":"ATTR","ticket":760,"id":"6342533b35d91ef3"}||{"x":null,"y":null,"rotation":null,"color":null,"fontFamily":null,"fontSize":null,"fontWeight":null,"italic":null,"underline":null,"align":null,"value":"","keyVisible":null,"valueVisible":null,"key":"DC Resistance(DCR)","fillColor":null,"parentId":"e9e90131ba3df242","zIndex":29}|
{"type":"ATTR","ticket":761,"id":"982eeff8157b01da"}||{"x":null,"y":null,"rotation":null,"color":null,"fontFamily":null,"fontSize":null,"fontWeight":null,"italic":null,"underline":null,"align":null,"value":"","keyVisible":null,"valueVisible":null,"key":"Type","fillColor":null,"parentId":"e9e90131ba3df242","zIndex":30}|
{"type":"ATTR","ticket":762,"id":"d071f1892ebd833f"}||{"x":null,"y":null,"rotation":null,"color":null,"fontFamily":null,"fontSize":null,"fontWeight":null,"italic":null,"underline":null,"align":null,"value":"","keyVisible":null,"valueVisible":null,"key":"Description","fillColor":null,"parentId":"e9e90131ba3df242","zIndex":31}|
{"type":"COMPONENT","ticket":763,"id":"2b47267e18a481c1"}||{"partId":"CD54-220M_C49230813.1","x":1500,"y":-1050,"rotation":0,"isMirror":false,"attrs":{"Footprints":"[]","Devices":"[]","DeviceName":"{\"uuid\":\"8e054a9fbef4301c\",\"name\":\"CD54-220M\",\"source\":\"\"}","FootprintName":null,"isSwitchClose":false,"pinClass":{},"differentialPairClass":{},"Symbols":"[]"},"zIndex":148}|
{"type":"ATTR","ticket":764,"id":"0e15f473d7fc5b23"}||{"x":null,"y":null,"rotation":null,"color":null,"fontFamily":null,"fontSize":null,"fontWeight":null,"italic":null,"underline":null,"strikeout":false,"align":null,"value":"959b7cd5b91b8cce","keyVisible":null,"valueVisible":null,"key":"Symbol","fillColor":null,"parentId":"2b47267e18a481c1","zIndex":13}|
{"type":"ATTR","ticket":765,"id":"699b323ae11c2a8b"}||{"x":null,"y":null,"rotation":null,"color":null,"fontFamily":null,"fontSize":null,"fontWeight":null,"italic":null,"underline":null,"strikeout":false,"align":null,"value":"8e054a9fbef4301c","keyVisible":null,"valueVisible":null,"key":"Device","fillColor":null,"parentId":"2b47267e18a481c1","zIndex":8}|
{"type":"ATTR","ticket":766,"id":"3c7d73a988ef45cf"}||{"x":null,"y":null,"rotation":null,"color":null,"fontFamily":null,"fontSize":null,"fontWeight":null,"italic":null,"underline":null,"strikeout":false,"align":null,"value":"gge57","keyVisible":null,"valueVisible":null,"key":"Unique ID","fillColor":null,"parentId":"2b47267e18a481c1","zIndex":14}|
{"type":"ATTR","ticket":767,"id":"7dcc37f25153acbf"}||{"x":null,"y":null,"rotation":null,"color":null,"fontFamily":null,"fontSize":null,"fontWeight":null,"italic":null,"underline":null,"strikeout":false,"align":null,"value":"yes","keyVisible":null,"valueVisible":null,"key":"Add into BOM","fillColor":null,"parentId":"2b47267e18a481c1","zIndex":6}|
{"type":"ATTR","ticket":768,"id":"ecb89143452ead40"}||{"x":null,"y":null,"rotation":null,"color":null,"fontFamily":null,"fontSize":null,"fontWeight":null,"italic":null,"underline":null,"strikeout":false,"align":null,"value":"yes","keyVisible":null,"valueVisible":null,"key":"Convert to PCB","fillColor":null,"parentId":"2b47267e18a481c1","zIndex":7}|
{"type":"ATTR","ticket":769,"id":"4eb93b547b31c694"}||{"x":1485,"y":-1040,"rotation":0,"color":null,"fontFamily":null,"fontSize":6.75,"fontWeight":false,"italic":false,"underline":false,"strikeout":false,"align":null,"value":"={Value}","keyVisible":null,"valueVisible":true,"key":"Name","fillColor":null,"parentId":"2b47267e18a481c1","zIndex":11,"locked":false}|
{"type":"ATTR","ticket":770,"id":"a7fb34016edfd253"}||{"x":1485,"y":-1055,"rotation":0,"color":null,"fontFamily":null,"fontSize":6.75,"fontWeight":false,"italic":false,"underline":false,"strikeout":false,"align":null,"value":"L5","keyVisible":null,"valueVisible":true,"key":"Designator","fillColor":null,"parentId":"2b47267e18a481c1","zIndex":12,"locked":false}|
{"type":"ATTR","ticket":771,"id":"93d7f266ba8fee53"}||{"x":null,"y":null,"rotation":null,"color":null,"fontFamily":null,"fontSize":null,"fontWeight":null,"italic":null,"underline":null,"strikeout":false,"align":null,"value":null,"keyVisible":null,"valueVisible":null,"key":"Footprint","fillColor":null,"parentId":"2b47267e18a481c1","zIndex":9}|
{"type":"ATTR","ticket":772,"id":"0be09fa599df2efd"}||{"x":null,"y":null,"rotation":null,"color":null,"fontFamily":null,"fontSize":null,"fontWeight":null,"italic":null,"underline":null,"align":null,"value":null,"keyVisible":null,"valueVisible":null,"key":"Reuse Block","fillColor":null,"parentId":"2b47267e18a481c1","zIndex":15}|
{"type":"ATTR","ticket":773,"id":"10e07b7a76bdf258"}||{"x":null,"y":null,"rotation":null,"color":null,"fontFamily":null,"fontSize":null,"fontWeight":null,"italic":null,"underline":null,"align":null,"value":null,"keyVisible":null,"valueVisible":null,"key":"Group ID","fillColor":null,"parentId":"2b47267e18a481c1","zIndex":16}|
{"type":"ATTR","ticket":774,"id":"3742cf7d09250664"}||{"x":null,"y":null,"rotation":null,"color":null,"fontFamily":null,"fontSize":null,"fontWeight":null,"italic":null,"underline":null,"align":null,"value":null,"keyVisible":null,"valueVisible":null,"key":"Channel ID","fillColor":null,"parentId":"2b47267e18a481c1","zIndex":17}|
{"type":"ATTR","ticket":775,"id":"0aa743f45fe64d50"}||{"x":null,"y":null,"rotation":null,"color":null,"fontFamily":null,"fontSize":null,"fontWeight":null,"italic":null,"underline":null,"align":null,"value":"Zoomdo(震东电子)","keyVisible":null,"valueVisible":null,"key":"Manufacturer","fillColor":null,"parentId":"2b47267e18a481c1","zIndex":18}|
{"type":"ATTR","ticket":776,"id":"fa403f64aaf5337a"}||{"x":null,"y":null,"rotation":null,"color":null,"fontFamily":null,"fontSize":null,"fontWeight":null,"italic":null,"underline":null,"align":null,"value":"CD54-220M","keyVisible":null,"valueVisible":null,"key":"Manufacturer Part","fillColor":null,"parentId":"2b47267e18a481c1","zIndex":19}|
{"type":"ATTR","ticket":777,"id":"b6e1036af8d0ca92"}||{"x":null,"y":null,"rotation":null,"color":null,"fontFamily":null,"fontSize":null,"fontWeight":null,"italic":null,"underline":null,"align":null,"value":"LCSC","keyVisible":null,"valueVisible":null,"key":"Supplier","fillColor":null,"parentId":"2b47267e18a481c1","zIndex":20}|
{"type":"ATTR","ticket":778,"id":"58dbc1ae79c8bbfa"}||{"x":null,"y":null,"rotation":null,"color":null,"fontFamily":null,"fontSize":null,"fontWeight":null,"italic":null,"underline":null,"align":null,"value":"CD54-220M_C49230813.1","keyVisible":null,"valueVisible":null,"key":"Supplier Part","fillColor":null,"parentId":"2b47267e18a481c1","zIndex":21}|
{"type":"ATTR","ticket":779,"id":"6f6b15024346cd1d"}||{"x":null,"y":null,"rotation":null,"color":null,"fontFamily":null,"fontSize":null,"fontWeight":null,"italic":null,"underline":null,"align":null,"value":"","keyVisible":null,"valueVisible":null,"key":"LCSC Part Name","fillColor":null,"parentId":"2b47267e18a481c1","zIndex":22}|
{"type":"ATTR","ticket":780,"id":"594bd0c44eeac8a3"}||{"x":null,"y":null,"rotation":null,"color":null,"fontFamily":null,"fontSize":null,"fontWeight":null,"italic":null,"underline":null,"align":null,"value":"","keyVisible":null,"valueVisible":null,"key":"Supplier Footprint","fillColor":null,"parentId":"2b47267e18a481c1","zIndex":23}|
{"type":"ATTR","ticket":781,"id":"c61748f05af9fc44"}||{"x":null,"y":null,"rotation":null,"color":null,"fontFamily":null,"fontSize":null,"fontWeight":null,"italic":null,"underline":null,"align":null,"value":"","keyVisible":null,"valueVisible":null,"key":"JLCPCB Part Class","fillColor":null,"parentId":"2b47267e18a481c1","zIndex":24}|
{"type":"ATTR","ticket":782,"id":"21bcc90c173b8707"}||{"x":null,"y":null,"rotation":null,"color":null,"fontFamily":null,"fontSize":null,"fontWeight":null,"italic":null,"underline":null,"align":null,"value":"","keyVisible":null,"valueVisible":null,"key":"Datasheet","fillColor":null,"parentId":"2b47267e18a481c1","zIndex":25}|
{"type":"ATTR","ticket":783,"id":"7d80a156abcfe6f6"}||{"x":null,"y":null,"rotation":null,"color":null,"fontFamily":null,"fontSize":null,"fontWeight":null,"italic":null,"underline":null,"align":null,"value":"22uH","keyVisible":null,"valueVisible":null,"key":"Value","fillColor":null,"parentId":"2b47267e18a481c1","zIndex":26}|
{"type":"ATTR","ticket":784,"id":"25adada63124bc83"}||{"x":null,"y":null,"rotation":null,"color":null,"fontFamily":null,"fontSize":null,"fontWeight":null,"italic":null,"underline":null,"align":null,"value":"","keyVisible":null,"valueVisible":null,"key":"Tolerance","fillColor":null,"parentId":"2b47267e18a481c1","zIndex":27}|
{"type":"ATTR","ticket":785,"id":"e68da89d1f9bed1b"}||{"x":null,"y":null,"rotation":null,"color":null,"fontFamily":null,"fontSize":null,"fontWeight":null,"italic":null,"underline":null,"align":null,"value":"","keyVisible":null,"valueVisible":null,"key":"Current Rating","fillColor":null,"parentId":"2b47267e18a481c1","zIndex":28}|
{"type":"ATTR","ticket":786,"id":"2bbba5b779caa420"}||{"x":null,"y":null,"rotation":null,"color":null,"fontFamily":null,"fontSize":null,"fontWeight":null,"italic":null,"underline":null,"align":null,"value":"","keyVisible":null,"valueVisible":null,"key":"DC Resistance(DCR)","fillColor":null,"parentId":"2b47267e18a481c1","zIndex":29}|
{"type":"ATTR","ticket":787,"id":"bc89d85da893b70b"}||{"x":null,"y":null,"rotation":null,"color":null,"fontFamily":null,"fontSize":null,"fontWeight":null,"italic":null,"underline":null,"align":null,"value":"","keyVisible":null,"valueVisible":null,"key":"Type","fillColor":null,"parentId":"2b47267e18a481c1","zIndex":30}|
{"type":"ATTR","ticket":788,"id":"4c8ddf31d0db3e50"}||{"x":null,"y":null,"rotation":null,"color":null,"fontFamily":null,"fontSize":null,"fontWeight":null,"italic":null,"underline":null,"align":null,"value":"","keyVisible":null,"valueVisible":null,"key":"Description","fillColor":null,"parentId":"2b47267e18a481c1","zIndex":31}|
{"type":"COMPONENT","ticket":789,"id":"28ec30eb57e2ccb0"}||{"partId":"0805CG562J500NT.1","x":1140,"y":-950,"rotation":90,"isMirror":false,"attrs":{"Footprints":"[]","Devices":"[]","DeviceName":"{\"uuid\":\"0d096d1df1df491f\",\"name\":\"0805CG562J500NT\",\"source\":\"\"}","FootprintName":null,"isSwitchClose":false,"pinClass":{},"differentialPairClass":{},"Symbols":"[]"},"zIndex":149}|
{"type":"ATTR","ticket":790,"id":"60444285f6a3f33e"}||{"x":null,"y":null,"rotation":0,"color":null,"fontFamily":null,"fontSize":null,"fontWeight":false,"italic":false,"underline":false,"strikeout":false,"align":null,"value":"901ee3d0bb1c6d9e","keyVisible":null,"valueVisible":null,"key":"Symbol","fillColor":null,"parentId":"28ec30eb57e2ccb0","zIndex":11,"locked":false}|
{"type":"ATTR","ticket":791,"id":"ee1cf79908992172"}||{"x":null,"y":null,"rotation":null,"color":null,"fontFamily":null,"fontSize":null,"fontWeight":null,"italic":null,"underline":null,"strikeout":false,"align":null,"value":"0d096d1df1df491f","keyVisible":null,"valueVisible":null,"key":"Device","fillColor":null,"parentId":"28ec30eb57e2ccb0","zIndex":8}|
{"type":"ATTR","ticket":792,"id":"2e82f02773744de0"}||{"x":null,"y":null,"rotation":null,"color":null,"fontFamily":null,"fontSize":null,"fontWeight":null,"italic":null,"underline":null,"strikeout":false,"align":null,"value":"gge58","keyVisible":null,"valueVisible":null,"key":"Unique ID","fillColor":null,"parentId":"28ec30eb57e2ccb0","zIndex":13}|
{"type":"ATTR","ticket":793,"id":"0b4467d0d6dd8428"}||{"x":null,"y":null,"rotation":null,"color":null,"fontFamily":null,"fontSize":null,"fontWeight":null,"italic":null,"underline":null,"strikeout":false,"align":null,"value":"yes","keyVisible":null,"valueVisible":null,"key":"Add into BOM","fillColor":null,"parentId":"28ec30eb57e2ccb0","zIndex":6}|
{"type":"ATTR","ticket":794,"id":"109a5cd093a19686"}||{"x":null,"y":null,"rotation":null,"color":null,"fontFamily":null,"fontSize":null,"fontWeight":null,"italic":null,"underline":null,"strikeout":false,"align":null,"value":"yes","keyVisible":null,"valueVisible":null,"key":"Convert to PCB","fillColor":null,"parentId":"28ec30eb57e2ccb0","zIndex":7}|
{"type":"ATTR","ticket":795,"id":"f2fe31427f3e975e"}||{"x":1155,"y":-950,"rotation":0,"color":null,"fontFamily":null,"fontSize":null,"fontWeight":false,"italic":false,"underline":false,"strikeout":false,"align":null,"value":"C2","keyVisible":null,"valueVisible":true,"key":"Designator","fillColor":null,"parentId":"28ec30eb57e2ccb0","zIndex":12,"locked":false}|
{"type":"ATTR","ticket":796,"id":"ea57a9be7f45e3d4"}||{"x":null,"y":null,"rotation":null,"color":null,"fontFamily":null,"fontSize":null,"fontWeight":null,"italic":null,"underline":null,"strikeout":false,"align":null,"value":null,"keyVisible":null,"valueVisible":null,"key":"Footprint","fillColor":null,"parentId":"28ec30eb57e2ccb0","zIndex":9}|
{"type":"ATTR","ticket":797,"id":"be0fc1a050701f93"}||{"x":1155,"y":-940,"rotation":0,"color":null,"fontFamily":null,"fontSize":null,"fontWeight":null,"italic":null,"underline":null,"align":null,"value":"={Value}","keyVisible":null,"valueVisible":true,"key":"Name","fillColor":null,"parentId":"28ec30eb57e2ccb0","zIndex":14}|
{"type":"ATTR","ticket":798,"id":"bbbf600e7aade506"}||{"x":null,"y":null,"rotation":null,"color":null,"fontFamily":null,"fontSize":null,"fontWeight":null,"italic":null,"underline":null,"align":null,"value":null,"keyVisible":null,"valueVisible":null,"key":"Reuse Block","fillColor":null,"parentId":"28ec30eb57e2ccb0","zIndex":15}|
{"type":"ATTR","ticket":799,"id":"d18eab3f3bc8c792"}||{"x":null,"y":null,"rotation":null,"color":null,"fontFamily":null,"fontSize":null,"fontWeight":null,"italic":null,"underline":null,"align":null,"value":null,"keyVisible":null,"valueVisible":null,"key":"Group ID","fillColor":null,"parentId":"28ec30eb57e2ccb0","zIndex":16}|
{"type":"ATTR","ticket":800,"id":"abe5555833f611a0"}||{"x":null,"y":null,"rotation":null,"color":null,"fontFamily":null,"fontSize":null,"fontWeight":null,"italic":null,"underline":null,"align":null,"value":null,"keyVisible":null,"valueVisible":null,"key":"Channel ID","fillColor":null,"parentId":"28ec30eb57e2ccb0","zIndex":17}|
{"type":"ATTR","ticket":801,"id":"891dacc5b277dfd4"}||{"x":null,"y":null,"rotation":null,"color":null,"fontFamily":null,"fontSize":null,"fontWeight":null,"italic":null,"underline":null,"align":null,"value":"FH(风华)","keyVisible":null,"valueVisible":null,"key":"Manufacturer","fillColor":null,"parentId":"28ec30eb57e2ccb0","zIndex":18}|
{"type":"ATTR","ticket":802,"id":"02bd5e2f3cd56348"}||{"x":null,"y":null,"rotation":null,"color":null,"fontFamily":null,"fontSize":null,"fontWeight":null,"italic":null,"underline":null,"align":null,"value":"0805CG562J500NT","keyVisible":null,"valueVisible":null,"key":"Manufacturer Part","fillColor":null,"parentId":"28ec30eb57e2ccb0","zIndex":19}|
{"type":"ATTR","ticket":803,"id":"f93c3d6dec268cdd"}||{"x":null,"y":null,"rotation":null,"color":null,"fontFamily":null,"fontSize":null,"fontWeight":null,"italic":null,"underline":null,"align":null,"value":"LCSC","keyVisible":null,"valueVisible":null,"key":"Supplier","fillColor":null,"parentId":"28ec30eb57e2ccb0","zIndex":20}|
{"type":"ATTR","ticket":804,"id":"0cf5b16b234c1720"}||{"x":null,"y":null,"rotation":null,"color":null,"fontFamily":null,"fontSize":null,"fontWeight":null,"italic":null,"underline":null,"align":null,"value":"0805CG562J500NT.1","keyVisible":null,"valueVisible":null,"key":"Supplier Part","fillColor":null,"parentId":"28ec30eb57e2ccb0","zIndex":21}|
{"type":"ATTR","ticket":805,"id":"1c98a10e6acea6c6"}||{"x":null,"y":null,"rotation":null,"color":null,"fontFamily":null,"fontSize":null,"fontWeight":null,"italic":null,"underline":null,"align":null,"value":"","keyVisible":null,"valueVisible":null,"key":"LCSC Part Name","fillColor":null,"parentId":"28ec30eb57e2ccb0","zIndex":22}|
{"type":"ATTR","ticket":806,"id":"86f5df7d5a66269f"}||{"x":null,"y":null,"rotation":null,"color":null,"fontFamily":null,"fontSize":null,"fontWeight":null,"italic":null,"underline":null,"align":null,"value":"","keyVisible":null,"valueVisible":null,"key":"Supplier Footprint","fillColor":null,"parentId":"28ec30eb57e2ccb0","zIndex":23}|
{"type":"ATTR","ticket":807,"id":"0aea23bf5627be3c"}||{"x":null,"y":null,"rotation":null,"color":null,"fontFamily":null,"fontSize":null,"fontWeight":null,"italic":null,"underline":null,"align":null,"value":"","keyVisible":null,"valueVisible":null,"key":"JLCPCB Part Class","fillColor":null,"parentId":"28ec30eb57e2ccb0","zIndex":24}|
{"type":"ATTR","ticket":808,"id":"2a10759a7b1968c4"}||{"x":null,"y":null,"rotation":null,"color":null,"fontFamily":null,"fontSize":null,"fontWeight":null,"italic":null,"underline":null,"align":null,"value":"","keyVisible":null,"valueVisible":null,"key":"Datasheet","fillColor":null,"parentId":"28ec30eb57e2ccb0","zIndex":25}|
{"type":"ATTR","ticket":809,"id":"d39e1191cf2bce6c"}||{"x":null,"y":null,"rotation":null,"color":null,"fontFamily":null,"fontSize":null,"fontWeight":null,"italic":null,"underline":null,"align":null,"value":"5.6nF","keyVisible":null,"valueVisible":null,"key":"Value","fillColor":null,"parentId":"28ec30eb57e2ccb0","zIndex":26}|
{"type":"ATTR","ticket":810,"id":"d10829d5318c618b"}||{"x":null,"y":null,"rotation":null,"color":null,"fontFamily":null,"fontSize":null,"fontWeight":null,"italic":null,"underline":null,"align":null,"value":"","keyVisible":null,"valueVisible":null,"key":"Tolerance","fillColor":null,"parentId":"28ec30eb57e2ccb0","zIndex":27}|
{"type":"ATTR","ticket":811,"id":"e6fcc0c570b4ad39"}||{"x":null,"y":null,"rotation":null,"color":null,"fontFamily":null,"fontSize":null,"fontWeight":null,"italic":null,"underline":null,"align":null,"value":"","keyVisible":null,"valueVisible":null,"key":"Voltage Rating","fillColor":null,"parentId":"28ec30eb57e2ccb0","zIndex":28}|
{"type":"ATTR","ticket":812,"id":"a64c120eea940b61"}||{"x":null,"y":null,"rotation":null,"color":null,"fontFamily":null,"fontSize":null,"fontWeight":null,"italic":null,"underline":null,"align":null,"value":"","keyVisible":null,"valueVisible":null,"key":"Temperature Coefficient","fillColor":null,"parentId":"28ec30eb57e2ccb0","zIndex":29}|
{"type":"ATTR","ticket":813,"id":"398ac33fe0fd5bab"}||{"x":null,"y":null,"rotation":null,"color":null,"fontFamily":null,"fontSize":null,"fontWeight":null,"italic":null,"underline":null,"align":null,"value":"","keyVisible":null,"valueVisible":null,"key":"Description","fillColor":null,"parentId":"28ec30eb57e2ccb0","zIndex":30}|
{"type":"COMPONENT","ticket":814,"id":"c481994436307bea"}||{"partId":"0805CG103J500NT_C2971995.1","x":1380,"y":-950,"rotation":90,"isMirror":false,"attrs":{"Footprints":"[]","Devices":"[]","DeviceName":"{\"uuid\":\"7b42f40e04357f33\",\"name\":\"0805CG103J500NT\",\"source\":\"\"}","FootprintName":null,"isSwitchClose":false,"pinClass":{},"differentialPairClass":{},"Symbols":"[]"},"zIndex":150}|
{"type":"ATTR","ticket":815,"id":"85c16cbfcc7008a1"}||{"x":null,"y":null,"rotation":0,"color":null,"fontFamily":null,"fontSize":null,"fontWeight":false,"italic":false,"underline":false,"strikeout":false,"align":null,"value":"76943a1ea9d416e9","keyVisible":null,"valueVisible":null,"key":"Symbol","fillColor":null,"parentId":"c481994436307bea","zIndex":11,"locked":false}|
{"type":"ATTR","ticket":816,"id":"e7e65c9a46e130fd"}||{"x":null,"y":null,"rotation":null,"color":null,"fontFamily":null,"fontSize":null,"fontWeight":null,"italic":null,"underline":null,"strikeout":false,"align":null,"value":"7b42f40e04357f33","keyVisible":null,"valueVisible":null,"key":"Device","fillColor":null,"parentId":"c481994436307bea","zIndex":8}|
{"type":"ATTR","ticket":817,"id":"587bf188ec19ef1b"}||{"x":null,"y":null,"rotation":null,"color":null,"fontFamily":null,"fontSize":null,"fontWeight":null,"italic":null,"underline":null,"strikeout":false,"align":null,"value":"gge59","keyVisible":null,"valueVisible":null,"key":"Unique ID","fillColor":null,"parentId":"c481994436307bea","zIndex":13}|
{"type":"ATTR","ticket":818,"id":"e0a08c94b6f81946"}||{"x":null,"y":null,"rotation":null,"color":null,"fontFamily":null,"fontSize":null,"fontWeight":null,"italic":null,"underline":null,"strikeout":false,"align":null,"value":"yes","keyVisible":null,"valueVisible":null,"key":"Add into BOM","fillColor":null,"parentId":"c481994436307bea","zIndex":6}|
{"type":"ATTR","ticket":819,"id":"0c90cde640dcf21c"}||{"x":null,"y":null,"rotation":null,"color":null,"fontFamily":null,"fontSize":null,"fontWeight":null,"italic":null,"underline":null,"strikeout":false,"align":null,"value":"yes","keyVisible":null,"valueVisible":null,"key":"Convert to PCB","fillColor":null,"parentId":"c481994436307bea","zIndex":7}|
{"type":"ATTR","ticket":820,"id":"5374d42955063b0f"}||{"x":1395,"y":-950,"rotation":0,"color":null,"fontFamily":null,"fontSize":null,"fontWeight":false,"italic":false,"underline":false,"strikeout":false,"align":null,"value":"C4","keyVisible":null,"valueVisible":true,"key":"Designator","fillColor":null,"parentId":"c481994436307bea","zIndex":12,"locked":false}|
{"type":"ATTR","ticket":821,"id":"a40f0a8cabb36c4c"}||{"x":null,"y":null,"rotation":null,"color":null,"fontFamily":null,"fontSize":null,"fontWeight":null,"italic":null,"underline":null,"strikeout":false,"align":null,"value":null,"keyVisible":null,"valueVisible":null,"key":"Footprint","fillColor":null,"parentId":"c481994436307bea","zIndex":9}|
{"type":"ATTR","ticket":822,"id":"544a3de0e330770e"}||{"x":1395,"y":-940,"rotation":0,"color":null,"fontFamily":null,"fontSize":null,"fontWeight":null,"italic":null,"underline":null,"align":null,"value":"={Value}","keyVisible":null,"valueVisible":true,"key":"Name","fillColor":null,"parentId":"c481994436307bea","zIndex":14}|
{"type":"ATTR","ticket":823,"id":"1f2543e478607936"}||{"x":null,"y":null,"rotation":null,"color":null,"fontFamily":null,"fontSize":null,"fontWeight":null,"italic":null,"underline":null,"align":null,"value":null,"keyVisible":null,"valueVisible":null,"key":"Reuse Block","fillColor":null,"parentId":"c481994436307bea","zIndex":15}|
{"type":"ATTR","ticket":824,"id":"97c48930a378fcd8"}||{"x":null,"y":null,"rotation":null,"color":null,"fontFamily":null,"fontSize":null,"fontWeight":null,"italic":null,"underline":null,"align":null,"value":null,"keyVisible":null,"valueVisible":null,"key":"Group ID","fillColor":null,"parentId":"c481994436307bea","zIndex":16}|
{"type":"ATTR","ticket":825,"id":"5c7e011ef981663f"}||{"x":null,"y":null,"rotation":null,"color":null,"fontFamily":null,"fontSize":null,"fontWeight":null,"italic":null,"underline":null,"align":null,"value":null,"keyVisible":null,"valueVisible":null,"key":"Channel ID","fillColor":null,"parentId":"c481994436307bea","zIndex":17}|
{"type":"ATTR","ticket":826,"id":"80c1ca4168039a8c"}||{"x":null,"y":null,"rotation":null,"color":null,"fontFamily":null,"fontSize":null,"fontWeight":null,"italic":null,"underline":null,"align":null,"value":"FH(风华)","keyVisible":null,"valueVisible":null,"key":"Manufacturer","fillColor":null,"parentId":"c481994436307bea","zIndex":18}|
{"type":"ATTR","ticket":827,"id":"9e59cf969cab8b2e"}||{"x":null,"y":null,"rotation":null,"color":null,"fontFamily":null,"fontSize":null,"fontWeight":null,"italic":null,"underline":null,"align":null,"value":"0805CG103J500NT","keyVisible":null,"valueVisible":null,"key":"Manufacturer Part","fillColor":null,"parentId":"c481994436307bea","zIndex":19}|
{"type":"ATTR","ticket":828,"id":"8bd36a2f9e77d717"}||{"x":null,"y":null,"rotation":null,"color":null,"fontFamily":null,"fontSize":null,"fontWeight":null,"italic":null,"underline":null,"align":null,"value":"LCSC","keyVisible":null,"valueVisible":null,"key":"Supplier","fillColor":null,"parentId":"c481994436307bea","zIndex":20}|
{"type":"ATTR","ticket":829,"id":"de129c90b8c1c81a"}||{"x":null,"y":null,"rotation":null,"color":null,"fontFamily":null,"fontSize":null,"fontWeight":null,"italic":null,"underline":null,"align":null,"value":"0805CG103J500NT_C2971995.1","keyVisible":null,"valueVisible":null,"key":"Supplier Part","fillColor":null,"parentId":"c481994436307bea","zIndex":21}|
{"type":"ATTR","ticket":830,"id":"732f18cf528903a9"}||{"x":null,"y":null,"rotation":null,"color":null,"fontFamily":null,"fontSize":null,"fontWeight":null,"italic":null,"underline":null,"align":null,"value":"","keyVisible":null,"valueVisible":null,"key":"LCSC Part Name","fillColor":null,"parentId":"c481994436307bea","zIndex":22}|
{"type":"ATTR","ticket":831,"id":"7c05adadd6b0ffa2"}||{"x":null,"y":null,"rotation":null,"color":null,"fontFamily":null,"fontSize":null,"fontWeight":null,"italic":null,"underline":null,"align":null,"value":"","keyVisible":null,"valueVisible":null,"key":"Supplier Footprint","fillColor":null,"parentId":"c481994436307bea","zIndex":23}|
{"type":"ATTR","ticket":832,"id":"87eef55a1838fc48"}||{"x":null,"y":null,"rotation":null,"color":null,"fontFamily":null,"fontSize":null,"fontWeight":null,"italic":null,"underline":null,"align":null,"value":"","keyVisible":null,"valueVisible":null,"key":"JLCPCB Part Class","fillColor":null,"parentId":"c481994436307bea","zIndex":24}|
{"type":"ATTR","ticket":833,"id":"f74b4e184c5b25fd"}||{"x":null,"y":null,"rotation":null,"color":null,"fontFamily":null,"fontSize":null,"fontWeight":null,"italic":null,"underline":null,"align":null,"value":"","keyVisible":null,"valueVisible":null,"key":"Datasheet","fillColor":null,"parentId":"c481994436307bea","zIndex":25}|
{"type":"ATTR","ticket":834,"id":"36185392a620af04"}||{"x":null,"y":null,"rotation":null,"color":null,"fontFamily":null,"fontSize":null,"fontWeight":null,"italic":null,"underline":null,"align":null,"value":"10nF","keyVisible":null,"valueVisible":null,"key":"Value","fillColor":null,"parentId":"c481994436307bea","zIndex":26}|
{"type":"ATTR","ticket":835,"id":"e1437f45e4a6be5f"}||{"x":null,"y":null,"rotation":null,"color":null,"fontFamily":null,"fontSize":null,"fontWeight":null,"italic":null,"underline":null,"align":null,"value":"","keyVisible":null,"valueVisible":null,"key":"Tolerance","fillColor":null,"parentId":"c481994436307bea","zIndex":27}|
{"type":"ATTR","ticket":836,"id":"c81cdd1895652b1f"}||{"x":null,"y":null,"rotation":null,"color":null,"fontFamily":null,"fontSize":null,"fontWeight":null,"italic":null,"underline":null,"align":null,"value":"","keyVisible":null,"valueVisible":null,"key":"Voltage Rating","fillColor":null,"parentId":"c481994436307bea","zIndex":28}|
{"type":"ATTR","ticket":837,"id":"65aea21992041719"}||{"x":null,"y":null,"rotation":null,"color":null,"fontFamily":null,"fontSize":null,"fontWeight":null,"italic":null,"underline":null,"align":null,"value":"","keyVisible":null,"valueVisible":null,"key":"Temperature Coefficient","fillColor":null,"parentId":"c481994436307bea","zIndex":29}|
{"type":"ATTR","ticket":838,"id":"965a8c6b2b801d7e"}||{"x":null,"y":null,"rotation":null,"color":null,"fontFamily":null,"fontSize":null,"fontWeight":null,"italic":null,"underline":null,"align":null,"value":"","keyVisible":null,"valueVisible":null,"key":"Description","fillColor":null,"parentId":"c481994436307bea","zIndex":30}|
{"type":"COMPONENT","ticket":839,"id":"62cca8ba9d435e0f"}||{"partId":"0805CG103J500NT_C2971995.1","x":1620,"y":-950,"rotation":90,"isMirror":false,"attrs":{"Footprints":"[]","Devices":"[]","DeviceName":"{\"uuid\":\"7b42f40e04357f33\",\"name\":\"0805CG103J500NT\",\"source\":\"\"}","FootprintName":null,"isSwitchClose":false,"pinClass":{},"differentialPairClass":{},"Symbols":"[]"},"zIndex":151}|
{"type":"ATTR","ticket":840,"id":"c8f25cfce887bdc9"}||{"x":null,"y":null,"rotation":0,"color":null,"fontFamily":null,"fontSize":null,"fontWeight":false,"italic":false,"underline":false,"strikeout":false,"align":null,"value":"76943a1ea9d416e9","keyVisible":null,"valueVisible":null,"key":"Symbol","fillColor":null,"parentId":"62cca8ba9d435e0f","zIndex":11,"locked":false}|
{"type":"ATTR","ticket":841,"id":"345475d4b49b24a9"}||{"x":null,"y":null,"rotation":null,"color":null,"fontFamily":null,"fontSize":null,"fontWeight":null,"italic":null,"underline":null,"strikeout":false,"align":null,"value":"7b42f40e04357f33","keyVisible":null,"valueVisible":null,"key":"Device","fillColor":null,"parentId":"62cca8ba9d435e0f","zIndex":8}|
{"type":"ATTR","ticket":842,"id":"2ce6d4d4dac2aebd"}||{"x":null,"y":null,"rotation":null,"color":null,"fontFamily":null,"fontSize":null,"fontWeight":null,"italic":null,"underline":null,"strikeout":false,"align":null,"value":"gge60","keyVisible":null,"valueVisible":null,"key":"Unique ID","fillColor":null,"parentId":"62cca8ba9d435e0f","zIndex":13}|
{"type":"ATTR","ticket":843,"id":"a6b0bf37be2f9f8f"}||{"x":null,"y":null,"rotation":null,"color":null,"fontFamily":null,"fontSize":null,"fontWeight":null,"italic":null,"underline":null,"strikeout":false,"align":null,"value":"yes","keyVisible":null,"valueVisible":null,"key":"Add into BOM","fillColor":null,"parentId":"62cca8ba9d435e0f","zIndex":6}|
{"type":"ATTR","ticket":844,"id":"262238c8b17378df"}||{"x":null,"y":null,"rotation":null,"color":null,"fontFamily":null,"fontSize":null,"fontWeight":null,"italic":null,"underline":null,"strikeout":false,"align":null,"value":"yes","keyVisible":null,"valueVisible":null,"key":"Convert to PCB","fillColor":null,"parentId":"62cca8ba9d435e0f","zIndex":7}|
{"type":"ATTR","ticket":845,"id":"f84b43746945ee0b"}||{"x":1635,"y":-950,"rotation":0,"color":null,"fontFamily":null,"fontSize":null,"fontWeight":false,"italic":false,"underline":false,"strikeout":false,"align":null,"value":"C6","keyVisible":null,"valueVisible":true,"key":"Designator","fillColor":null,"parentId":"62cca8ba9d435e0f","zIndex":12,"locked":false}|
{"type":"ATTR","ticket":846,"id":"c0f88eff6a69a087"}||{"x":null,"y":null,"rotation":null,"color":null,"fontFamily":null,"fontSize":null,"fontWeight":null,"italic":null,"underline":null,"strikeout":false,"align":null,"value":null,"keyVisible":null,"valueVisible":null,"key":"Footprint","fillColor":null,"parentId":"62cca8ba9d435e0f","zIndex":9}|
{"type":"ATTR","ticket":847,"id":"85b151729cf0f5de"}||{"x":1635,"y":-940,"rotation":0,"color":null,"fontFamily":null,"fontSize":null,"fontWeight":null,"italic":null,"underline":null,"align":null,"value":"={Value}","keyVisible":null,"valueVisible":true,"key":"Name","fillColor":null,"parentId":"62cca8ba9d435e0f","zIndex":14}|
{"type":"ATTR","ticket":848,"id":"ef65981d7c7f3184"}||{"x":null,"y":null,"rotation":null,"color":null,"fontFamily":null,"fontSize":null,"fontWeight":null,"italic":null,"underline":null,"align":null,"value":null,"keyVisible":null,"valueVisible":null,"key":"Reuse Block","fillColor":null,"parentId":"62cca8ba9d435e0f","zIndex":15}|
{"type":"ATTR","ticket":849,"id":"72fbbdf1c49093bc"}||{"x":null,"y":null,"rotation":null,"color":null,"fontFamily":null,"fontSize":null,"fontWeight":null,"italic":null,"underline":null,"align":null,"value":null,"keyVisible":null,"valueVisible":null,"key":"Group ID","fillColor":null,"parentId":"62cca8ba9d435e0f","zIndex":16}|
{"type":"ATTR","ticket":850,"id":"776cf69bef6aff61"}||{"x":null,"y":null,"rotation":null,"color":null,"fontFamily":null,"fontSize":null,"fontWeight":null,"italic":null,"underline":null,"align":null,"value":null,"keyVisible":null,"valueVisible":null,"key":"Channel ID","fillColor":null,"parentId":"62cca8ba9d435e0f","zIndex":17}|
{"type":"ATTR","ticket":851,"id":"d531c0ddd5c3d22d"}||{"x":null,"y":null,"rotation":null,"color":null,"fontFamily":null,"fontSize":null,"fontWeight":null,"italic":null,"underline":null,"align":null,"value":"FH(风华)","keyVisible":null,"valueVisible":null,"key":"Manufacturer","fillColor":null,"parentId":"62cca8ba9d435e0f","zIndex":18}|
{"type":"ATTR","ticket":852,"id":"3d20878bd5d75df9"}||{"x":null,"y":null,"rotation":null,"color":null,"fontFamily":null,"fontSize":null,"fontWeight":null,"italic":null,"underline":null,"align":null,"value":"0805CG103J500NT","keyVisible":null,"valueVisible":null,"key":"Manufacturer Part","fillColor":null,"parentId":"62cca8ba9d435e0f","zIndex":19}|
{"type":"ATTR","ticket":853,"id":"0c886e2bb86904a3"}||{"x":null,"y":null,"rotation":null,"color":null,"fontFamily":null,"fontSize":null,"fontWeight":null,"italic":null,"underline":null,"align":null,"value":"LCSC","keyVisible":null,"valueVisible":null,"key":"Supplier","fillColor":null,"parentId":"62cca8ba9d435e0f","zIndex":20}|
{"type":"ATTR","ticket":854,"id":"687777e5c6d2d4c4"}||{"x":null,"y":null,"rotation":null,"color":null,"fontFamily":null,"fontSize":null,"fontWeight":null,"italic":null,"underline":null,"align":null,"value":"0805CG103J500NT_C2971995.1","keyVisible":null,"valueVisible":null,"key":"Supplier Part","fillColor":null,"parentId":"62cca8ba9d435e0f","zIndex":21}|
{"type":"ATTR","ticket":855,"id":"39947f4ffb19cc3f"}||{"x":null,"y":null,"rotation":null,"color":null,"fontFamily":null,"fontSize":null,"fontWeight":null,"italic":null,"underline":null,"align":null,"value":"","keyVisible":null,"valueVisible":null,"key":"LCSC Part Name","fillColor":null,"parentId":"62cca8ba9d435e0f","zIndex":22}|
{"type":"ATTR","ticket":856,"id":"e27decf80c6b1ff3"}||{"x":null,"y":null,"rotation":null,"color":null,"fontFamily":null,"fontSize":null,"fontWeight":null,"italic":null,"underline":null,"align":null,"value":"","keyVisible":null,"valueVisible":null,"key":"Supplier Footprint","fillColor":null,"parentId":"62cca8ba9d435e0f","zIndex":23}|
{"type":"ATTR","ticket":857,"id":"5301d6d0ab694eed"}||{"x":null,"y":null,"rotation":null,"color":null,"fontFamily":null,"fontSize":null,"fontWeight":null,"italic":null,"underline":null,"align":null,"value":"","keyVisible":null,"valueVisible":null,"key":"JLCPCB Part Class","fillColor":null,"parentId":"62cca8ba9d435e0f","zIndex":24}|
{"type":"ATTR","ticket":858,"id":"aff7af756cd11e2c"}||{"x":null,"y":null,"rotation":null,"color":null,"fontFamily":null,"fontSize":null,"fontWeight":null,"italic":null,"underline":null,"align":null,"value":"","keyVisible":null,"valueVisible":null,"key":"Datasheet","fillColor":null,"parentId":"62cca8ba9d435e0f","zIndex":25}|
{"type":"ATTR","ticket":859,"id":"585363099a6acbf6"}||{"x":null,"y":null,"rotation":null,"color":null,"fontFamily":null,"fontSize":null,"fontWeight":null,"italic":null,"underline":null,"align":null,"value":"10nF","keyVisible":null,"valueVisible":null,"key":"Value","fillColor":null,"parentId":"62cca8ba9d435e0f","zIndex":26}|
{"type":"ATTR","ticket":860,"id":"480855a93b07db97"}||{"x":null,"y":null,"rotation":null,"color":null,"fontFamily":null,"fontSize":null,"fontWeight":null,"italic":null,"underline":null,"align":null,"value":"","keyVisible":null,"valueVisible":null,"key":"Tolerance","fillColor":null,"parentId":"62cca8ba9d435e0f","zIndex":27}|
{"type":"ATTR","ticket":861,"id":"eccef2de2572b021"}||{"x":null,"y":null,"rotation":null,"color":null,"fontFamily":null,"fontSize":null,"fontWeight":null,"italic":null,"underline":null,"align":null,"value":"","keyVisible":null,"valueVisible":null,"key":"Voltage Rating","fillColor":null,"parentId":"62cca8ba9d435e0f","zIndex":28}|
{"type":"ATTR","ticket":862,"id":"632f3b0cf4105906"}||{"x":null,"y":null,"rotation":null,"color":null,"fontFamily":null,"fontSize":null,"fontWeight":null,"italic":null,"underline":null,"align":null,"value":"","keyVisible":null,"valueVisible":null,"key":"Temperature Coefficient","fillColor":null,"parentId":"62cca8ba9d435e0f","zIndex":29}|
{"type":"ATTR","ticket":863,"id":"de787edb8fffaf97"}||{"x":null,"y":null,"rotation":null,"color":null,"fontFamily":null,"fontSize":null,"fontWeight":null,"italic":null,"underline":null,"align":null,"value":"","keyVisible":null,"valueVisible":null,"key":"Description","fillColor":null,"parentId":"62cca8ba9d435e0f","zIndex":30}|
{"type":"COMPONENT","ticket":864,"id":"0c75f98574dfe415"}||{"partId":"0805CG182J500NT.1","x":1860,"y":-950,"rotation":90,"isMirror":false,"attrs":{"Footprints":"[]","Devices":"[]","DeviceName":"{\"uuid\":\"2903fab935f3392d\",\"name\":\"0805CG182J500NT\",\"source\":\"\"}","FootprintName":null,"isSwitchClose":false,"pinClass":{},"differentialPairClass":{},"Symbols":"[]"},"zIndex":152}|
{"type":"ATTR","ticket":865,"id":"e0e064018ca5376f"}||{"x":null,"y":null,"rotation":0,"color":null,"fontFamily":null,"fontSize":null,"fontWeight":false,"italic":false,"underline":false,"strikeout":false,"align":null,"value":"7549d60e71b69b2c","keyVisible":null,"valueVisible":null,"key":"Symbol","fillColor":null,"parentId":"0c75f98574dfe415","zIndex":11,"locked":false}|
{"type":"ATTR","ticket":866,"id":"1539af61e0b8b681"}||{"x":null,"y":null,"rotation":null,"color":null,"fontFamily":null,"fontSize":null,"fontWeight":null,"italic":null,"underline":null,"strikeout":false,"align":null,"value":"2903fab935f3392d","keyVisible":null,"valueVisible":null,"key":"Device","fillColor":null,"parentId":"0c75f98574dfe415","zIndex":8}|
{"type":"ATTR","ticket":867,"id":"98edaf133efde008"}||{"x":null,"y":null,"rotation":null,"color":null,"fontFamily":null,"fontSize":null,"fontWeight":null,"italic":null,"underline":null,"strikeout":false,"align":null,"value":"gge61","keyVisible":null,"valueVisible":null,"key":"Unique ID","fillColor":null,"parentId":"0c75f98574dfe415","zIndex":13}|
{"type":"ATTR","ticket":868,"id":"5b0722a6163ee805"}||{"x":null,"y":null,"rotation":null,"color":null,"fontFamily":null,"fontSize":null,"fontWeight":null,"italic":null,"underline":null,"strikeout":false,"align":null,"value":"yes","keyVisible":null,"valueVisible":null,"key":"Add into BOM","fillColor":null,"parentId":"0c75f98574dfe415","zIndex":6}|
{"type":"ATTR","ticket":869,"id":"3826a7fae4a0d54d"}||{"x":null,"y":null,"rotation":null,"color":null,"fontFamily":null,"fontSize":null,"fontWeight":null,"italic":null,"underline":null,"strikeout":false,"align":null,"value":"yes","keyVisible":null,"valueVisible":null,"key":"Convert to PCB","fillColor":null,"parentId":"0c75f98574dfe415","zIndex":7}|
{"type":"ATTR","ticket":870,"id":"07ec6c4555738a70"}||{"x":1875,"y":-950,"rotation":0,"color":null,"fontFamily":null,"fontSize":null,"fontWeight":false,"italic":false,"underline":false,"strikeout":false,"align":null,"value":"C8","keyVisible":null,"valueVisible":true,"key":"Designator","fillColor":null,"parentId":"0c75f98574dfe415","zIndex":12,"locked":false}|
{"type":"ATTR","ticket":871,"id":"1570da9eebbf83ed"}||{"x":null,"y":null,"rotation":null,"color":null,"fontFamily":null,"fontSize":null,"fontWeight":null,"italic":null,"underline":null,"strikeout":false,"align":null,"value":null,"keyVisible":null,"valueVisible":null,"key":"Footprint","fillColor":null,"parentId":"0c75f98574dfe415","zIndex":9}|
{"type":"ATTR","ticket":872,"id":"7766cc2f2a414145"}||{"x":1875,"y":-940,"rotation":0,"color":null,"fontFamily":null,"fontSize":null,"fontWeight":null,"italic":null,"underline":null,"align":null,"value":"={Value}","keyVisible":null,"valueVisible":true,"key":"Name","fillColor":null,"parentId":"0c75f98574dfe415","zIndex":14}|
{"type":"ATTR","ticket":873,"id":"298a78d2f1f3940d"}||{"x":null,"y":null,"rotation":null,"color":null,"fontFamily":null,"fontSize":null,"fontWeight":null,"italic":null,"underline":null,"align":null,"value":null,"keyVisible":null,"valueVisible":null,"key":"Reuse Block","fillColor":null,"parentId":"0c75f98574dfe415","zIndex":15}|
{"type":"ATTR","ticket":874,"id":"7f6b79b62129b153"}||{"x":null,"y":null,"rotation":null,"color":null,"fontFamily":null,"fontSize":null,"fontWeight":null,"italic":null,"underline":null,"align":null,"value":null,"keyVisible":null,"valueVisible":null,"key":"Group ID","fillColor":null,"parentId":"0c75f98574dfe415","zIndex":16}|
{"type":"ATTR","ticket":875,"id":"c02ad525d40d174a"}||{"x":null,"y":null,"rotation":null,"color":null,"fontFamily":null,"fontSize":null,"fontWeight":null,"italic":null,"underline":null,"align":null,"value":null,"keyVisible":null,"valueVisible":null,"key":"Channel ID","fillColor":null,"parentId":"0c75f98574dfe415","zIndex":17}|
{"type":"ATTR","ticket":876,"id":"2c140f525915e79a"}||{"x":null,"y":null,"rotation":null,"color":null,"fontFamily":null,"fontSize":null,"fontWeight":null,"italic":null,"underline":null,"align":null,"value":"FH(风华)","keyVisible":null,"valueVisible":null,"key":"Manufacturer","fillColor":null,"parentId":"0c75f98574dfe415","zIndex":18}|
{"type":"ATTR","ticket":877,"id":"f6deb9faa587c8f0"}||{"x":null,"y":null,"rotation":null,"color":null,"fontFamily":null,"fontSize":null,"fontWeight":null,"italic":null,"underline":null,"align":null,"value":"0805CG182J500NT","keyVisible":null,"valueVisible":null,"key":"Manufacturer Part","fillColor":null,"parentId":"0c75f98574dfe415","zIndex":19}|
{"type":"ATTR","ticket":878,"id":"11bf76a73be76e7d"}||{"x":null,"y":null,"rotation":null,"color":null,"fontFamily":null,"fontSize":null,"fontWeight":null,"italic":null,"underline":null,"align":null,"value":"LCSC","keyVisible":null,"valueVisible":null,"key":"Supplier","fillColor":null,"parentId":"0c75f98574dfe415","zIndex":20}|
{"type":"ATTR","ticket":879,"id":"541e68bf7d8a9e15"}||{"x":null,"y":null,"rotation":null,"color":null,"fontFamily":null,"fontSize":null,"fontWeight":null,"italic":null,"underline":null,"align":null,"value":"0805CG182J500NT.1","keyVisible":null,"valueVisible":null,"key":"Supplier Part","fillColor":null,"parentId":"0c75f98574dfe415","zIndex":21}|
{"type":"ATTR","ticket":880,"id":"4ba78dc38e769909"}||{"x":null,"y":null,"rotation":null,"color":null,"fontFamily":null,"fontSize":null,"fontWeight":null,"italic":null,"underline":null,"align":null,"value":"","keyVisible":null,"valueVisible":null,"key":"LCSC Part Name","fillColor":null,"parentId":"0c75f98574dfe415","zIndex":22}|
{"type":"ATTR","ticket":881,"id":"9e43c786ffa3652d"}||{"x":null,"y":null,"rotation":null,"color":null,"fontFamily":null,"fontSize":null,"fontWeight":null,"italic":null,"underline":null,"align":null,"value":"","keyVisible":null,"valueVisible":null,"key":"Supplier Footprint","fillColor":null,"parentId":"0c75f98574dfe415","zIndex":23}|
{"type":"ATTR","ticket":882,"id":"2d5b414dbc2a2301"}||{"x":null,"y":null,"rotation":null,"color":null,"fontFamily":null,"fontSize":null,"fontWeight":null,"italic":null,"underline":null,"align":null,"value":"","keyVisible":null,"valueVisible":null,"key":"JLCPCB Part Class","fillColor":null,"parentId":"0c75f98574dfe415","zIndex":24}|
{"type":"ATTR","ticket":883,"id":"81cbb30e6ca43c41"}||{"x":null,"y":null,"rotation":null,"color":null,"fontFamily":null,"fontSize":null,"fontWeight":null,"italic":null,"underline":null,"align":null,"value":"","keyVisible":null,"valueVisible":null,"key":"Datasheet","fillColor":null,"parentId":"0c75f98574dfe415","zIndex":25}|
{"type":"ATTR","ticket":884,"id":"9dc6c06a73d97d1f"}||{"x":null,"y":null,"rotation":null,"color":null,"fontFamily":null,"fontSize":null,"fontWeight":null,"italic":null,"underline":null,"align":null,"value":"1.8nF","keyVisible":null,"valueVisible":null,"key":"Value","fillColor":null,"parentId":"0c75f98574dfe415","zIndex":26}|
{"type":"ATTR","ticket":885,"id":"8b3cdbc933ceb81f"}||{"x":null,"y":null,"rotation":null,"color":null,"fontFamily":null,"fontSize":null,"fontWeight":null,"italic":null,"underline":null,"align":null,"value":"","keyVisible":null,"valueVisible":null,"key":"Tolerance","fillColor":null,"parentId":"0c75f98574dfe415","zIndex":27}|
{"type":"ATTR","ticket":886,"id":"ddd10dd01f73320d"}||{"x":null,"y":null,"rotation":null,"color":null,"fontFamily":null,"fontSize":null,"fontWeight":null,"italic":null,"underline":null,"align":null,"value":"","keyVisible":null,"valueVisible":null,"key":"Voltage Rating","fillColor":null,"parentId":"0c75f98574dfe415","zIndex":28}|
{"type":"ATTR","ticket":887,"id":"642997b748c4e0c3"}||{"x":null,"y":null,"rotation":null,"color":null,"fontFamily":null,"fontSize":null,"fontWeight":null,"italic":null,"underline":null,"align":null,"value":"","keyVisible":null,"valueVisible":null,"key":"Temperature Coefficient","fillColor":null,"parentId":"0c75f98574dfe415","zIndex":29}|
{"type":"ATTR","ticket":888,"id":"08ccf28ffaa82042"}||{"x":null,"y":null,"rotation":null,"color":null,"fontFamily":null,"fontSize":null,"fontWeight":null,"italic":null,"underline":null,"align":null,"value":"","keyVisible":null,"valueVisible":null,"key":"Description","fillColor":null,"parentId":"0c75f98574dfe415","zIndex":30}|
{"type":"COMPONENT","ticket":889,"id":"937aae99b814f439"}||{"partId":"0805W8F1000T5E.1","x":2400,"y":-1050,"rotation":0,"isMirror":false,"attrs":{"Footprints":"[]","Devices":"[]","DeviceName":"{\"uuid\":\"083283bdc31f2ba3\",\"name\":\"0805W8F1000T5E\",\"source\":\"\"}","FootprintName":null,"isSwitchClose":false,"pinClass":{},"differentialPairClass":{},"Symbols":"[]"},"zIndex":153}|
{"type":"ATTR","ticket":890,"id":"437c31ad0936db9b"}||{"x":null,"y":null,"rotation":0,"color":null,"fontFamily":null,"fontSize":null,"fontWeight":false,"italic":false,"underline":false,"strikeout":false,"align":null,"value":"f8bd3b43293353db","keyVisible":null,"valueVisible":null,"key":"Symbol","fillColor":null,"parentId":"937aae99b814f439","zIndex":8,"locked":false}|
{"type":"ATTR","ticket":891,"id":"49ba6a5b057ef916"}||{"x":null,"y":null,"rotation":null,"color":null,"fontFamily":null,"fontSize":null,"fontWeight":null,"italic":null,"underline":null,"strikeout":false,"align":null,"value":"083283bdc31f2ba3","keyVisible":null,"valueVisible":null,"key":"Device","fillColor":null,"parentId":"937aae99b814f439","zIndex":5}|
{"type":"ATTR","ticket":892,"id":"3d328b91f27763b6"}||{"x":null,"y":null,"rotation":null,"color":null,"fontFamily":null,"fontSize":null,"fontWeight":null,"italic":null,"underline":null,"strikeout":false,"align":null,"value":"gge62","keyVisible":null,"valueVisible":null,"key":"Unique ID","fillColor":null,"parentId":"937aae99b814f439","zIndex":10}|
{"type":"ATTR","ticket":893,"id":"a6f811a2a783f749"}||{"x":null,"y":null,"rotation":null,"color":null,"fontFamily":null,"fontSize":null,"fontWeight":null,"italic":null,"underline":null,"strikeout":false,"align":null,"value":"yes","keyVisible":null,"valueVisible":null,"key":"Add into BOM","fillColor":null,"parentId":"937aae99b814f439","zIndex":3}|
{"type":"ATTR","ticket":894,"id":"0661620284284e8b"}||{"x":null,"y":null,"rotation":null,"color":null,"fontFamily":null,"fontSize":null,"fontWeight":null,"italic":null,"underline":null,"strikeout":false,"align":null,"value":"yes","keyVisible":null,"valueVisible":null,"key":"Convert to PCB","fillColor":null,"parentId":"937aae99b814f439","zIndex":4}|
{"type":"ATTR","ticket":895,"id":"4ea93373e940cdc1"}||{"x":2390,"y":-1055,"rotation":0,"color":null,"fontFamily":null,"fontSize":null,"fontWeight":false,"italic":false,"underline":false,"strikeout":false,"align":null,"value":"R8","keyVisible":null,"valueVisible":true,"key":"Designator","fillColor":null,"parentId":"937aae99b814f439","zIndex":9,"locked":false}|
{"type":"ATTR","ticket":896,"id":"0ec1b7713a8b7e05"}||{"x":null,"y":null,"rotation":null,"color":null,"fontFamily":null,"fontSize":null,"fontWeight":null,"italic":null,"underline":null,"strikeout":false,"align":null,"value":null,"keyVisible":null,"valueVisible":null,"key":"Footprint","fillColor":null,"parentId":"937aae99b814f439","zIndex":6}|
{"type":"ATTR","ticket":897,"id":"b301aba23a2318d7"}||{"x":2390,"y":-1035,"rotation":0,"color":null,"fontFamily":null,"fontSize":null,"fontWeight":null,"italic":null,"underline":null,"align":null,"value":"={Value}","keyVisible":null,"valueVisible":true,"key":"Name","fillColor":null,"parentId":"937aae99b814f439","zIndex":11}|
{"type":"ATTR","ticket":898,"id":"4267a4e2dfcd65e2"}||{"x":null,"y":null,"rotation":null,"color":null,"fontFamily":null,"fontSize":null,"fontWeight":null,"italic":null,"underline":null,"align":null,"value":null,"keyVisible":null,"valueVisible":null,"key":"Reuse Block","fillColor":null,"parentId":"937aae99b814f439","zIndex":12}|
{"type":"ATTR","ticket":899,"id":"8f0cfd4ddd0ebfab"}||{"x":null,"y":null,"rotation":null,"color":null,"fontFamily":null,"fontSize":null,"fontWeight":null,"italic":null,"underline":null,"align":null,"value":null,"keyVisible":null,"valueVisible":null,"key":"Group ID","fillColor":null,"parentId":"937aae99b814f439","zIndex":13}|
{"type":"ATTR","ticket":900,"id":"d1bf524a6af99eb4"}||{"x":null,"y":null,"rotation":null,"color":null,"fontFamily":null,"fontSize":null,"fontWeight":null,"italic":null,"underline":null,"align":null,"value":null,"keyVisible":null,"valueVisible":null,"key":"Channel ID","fillColor":null,"parentId":"937aae99b814f439","zIndex":14}|
{"type":"ATTR","ticket":901,"id":"b1348d7099b5d400"}||{"x":null,"y":null,"rotation":null,"color":null,"fontFamily":null,"fontSize":null,"fontWeight":null,"italic":null,"underline":null,"align":null,"value":"UNI-ROYAL(厚声)","keyVisible":null,"valueVisible":null,"key":"Manufacturer","fillColor":null,"parentId":"937aae99b814f439","zIndex":15}|
{"type":"ATTR","ticket":902,"id":"f3fc778c30b57462"}||{"x":null,"y":null,"rotation":null,"color":null,"fontFamily":null,"fontSize":null,"fontWeight":null,"italic":null,"underline":null,"align":null,"value":"0805W8F1000T5E","keyVisible":null,"valueVisible":null,"key":"Manufacturer Part","fillColor":null,"parentId":"937aae99b814f439","zIndex":16}|
{"type":"ATTR","ticket":903,"id":"cbaa466f90be9973"}||{"x":null,"y":null,"rotation":null,"color":null,"fontFamily":null,"fontSize":null,"fontWeight":null,"italic":null,"underline":null,"align":null,"value":"LCSC","keyVisible":null,"valueVisible":null,"key":"Supplier","fillColor":null,"parentId":"937aae99b814f439","zIndex":17}|
{"type":"ATTR","ticket":904,"id":"45eb2705668e74e4"}||{"x":null,"y":null,"rotation":null,"color":null,"fontFamily":null,"fontSize":null,"fontWeight":null,"italic":null,"underline":null,"align":null,"value":"0805W8F1000T5E.1","keyVisible":null,"valueVisible":null,"key":"Supplier Part","fillColor":null,"parentId":"937aae99b814f439","zIndex":18}|
{"type":"ATTR","ticket":905,"id":"5936d8019ee05e3b"}||{"x":null,"y":null,"rotation":null,"color":null,"fontFamily":null,"fontSize":null,"fontWeight":null,"italic":null,"underline":null,"align":null,"value":"","keyVisible":null,"valueVisible":null,"key":"LCSC Part Name","fillColor":null,"parentId":"937aae99b814f439","zIndex":19}|
{"type":"ATTR","ticket":906,"id":"3989149e9e88d365"}||{"x":null,"y":null,"rotation":null,"color":null,"fontFamily":null,"fontSize":null,"fontWeight":null,"italic":null,"underline":null,"align":null,"value":"","keyVisible":null,"valueVisible":null,"key":"Supplier Footprint","fillColor":null,"parentId":"937aae99b814f439","zIndex":20}|
{"type":"ATTR","ticket":907,"id":"4830be32e7d76f97"}||{"x":null,"y":null,"rotation":null,"color":null,"fontFamily":null,"fontSize":null,"fontWeight":null,"italic":null,"underline":null,"align":null,"value":"","keyVisible":null,"valueVisible":null,"key":"JLCPCB Part Class","fillColor":null,"parentId":"937aae99b814f439","zIndex":21}|
{"type":"ATTR","ticket":908,"id":"2ef3a66d3bc05f76"}||{"x":null,"y":null,"rotation":null,"color":null,"fontFamily":null,"fontSize":null,"fontWeight":null,"italic":null,"underline":null,"align":null,"value":"","keyVisible":null,"valueVisible":null,"key":"Datasheet","fillColor":null,"parentId":"937aae99b814f439","zIndex":22}|
{"type":"ATTR","ticket":909,"id":"58f5a49a4e6ea667"}||{"x":null,"y":null,"rotation":null,"color":null,"fontFamily":null,"fontSize":null,"fontWeight":null,"italic":null,"underline":null,"align":null,"value":"","keyVisible":null,"valueVisible":null,"key":"Type","fillColor":null,"parentId":"937aae99b814f439","zIndex":23}|
{"type":"ATTR","ticket":910,"id":"3353d02176531903"}||{"x":null,"y":null,"rotation":null,"color":null,"fontFamily":null,"fontSize":null,"fontWeight":null,"italic":null,"underline":null,"align":null,"value":"100Ω","keyVisible":null,"valueVisible":null,"key":"Value","fillColor":null,"parentId":"937aae99b814f439","zIndex":24}|
{"type":"ATTR","ticket":911,"id":"8bb8d5770c89a34d"}||{"x":null,"y":null,"rotation":null,"color":null,"fontFamily":null,"fontSize":null,"fontWeight":null,"italic":null,"underline":null,"align":null,"value":"","keyVisible":null,"valueVisible":null,"key":"Tolerance","fillColor":null,"parentId":"937aae99b814f439","zIndex":25}|
{"type":"ATTR","ticket":912,"id":"7c791575df425cf8"}||{"x":null,"y":null,"rotation":null,"color":null,"fontFamily":null,"fontSize":null,"fontWeight":null,"italic":null,"underline":null,"align":null,"value":"","keyVisible":null,"valueVisible":null,"key":"Power(Watts)","fillColor":null,"parentId":"937aae99b814f439","zIndex":26}|
{"type":"ATTR","ticket":913,"id":"702182a5d2046add"}||{"x":null,"y":null,"rotation":null,"color":null,"fontFamily":null,"fontSize":null,"fontWeight":null,"italic":null,"underline":null,"align":null,"value":"","keyVisible":null,"valueVisible":null,"key":"Overload Voltage (Max)","fillColor":null,"parentId":"937aae99b814f439","zIndex":27}|
{"type":"ATTR","ticket":914,"id":"8937293156c2c818"}||{"x":null,"y":null,"rotation":null,"color":null,"fontFamily":null,"fontSize":null,"fontWeight":null,"italic":null,"underline":null,"align":null,"value":"","keyVisible":null,"valueVisible":null,"key":"Temperature Coefficient","fillColor":null,"parentId":"937aae99b814f439","zIndex":28}|
{"type":"ATTR","ticket":915,"id":"699b886f4e1164c4"}||{"x":null,"y":null,"rotation":null,"color":null,"fontFamily":null,"fontSize":null,"fontWeight":null,"italic":null,"underline":null,"align":null,"value":"","keyVisible":null,"valueVisible":null,"key":"Operating Temperature Range","fillColor":null,"parentId":"937aae99b814f439","zIndex":29}|
{"type":"ATTR","ticket":916,"id":"1eab6805e2236aa2"}||{"x":null,"y":null,"rotation":null,"color":null,"fontFamily":null,"fontSize":null,"fontWeight":null,"italic":null,"underline":null,"align":null,"value":"","keyVisible":null,"valueVisible":null,"key":"Description","fillColor":null,"parentId":"937aae99b814f439","zIndex":30}|
{"type":"TEXT","ticket":917,"id":"ea07c4d67ac90440"}||{"x":950,"y":-830,"rotation":0,"color":"#1F5FA9","fontFamily":null,"fontSize":9,"fontWeight":false,"italic":false,"underline":false,"align":null,"value":"L1/L3/L5/L7 = 4.7/22/22/12 uH    C2/C4/C6/C8 = 5.6/10/10/1.8 nF (全 C0G 0805)","fillColor":"#1F5FA9","zIndex":218}|
{"type":"TEXT","ticket":918,"id":"7820ff1c123f276c"}||{"x":950,"y":-1180,"rotation":0,"color":"#1F5FA9","fontFamily":null,"fontSize":9,"fontWeight":false,"italic":false,"underline":false,"align":null,"value":"折叠带 1.5~2.5MHz 最差 −59.3dB（判据 −42.5dB，余量 16.8dB）","fillColor":"#1F5FA9","zIndex":219}|
{"type":"TEXT","ticket":919,"id":"5f77433a135271d4"}||{"x":950,"y":-1210,"rotation":0,"color":"#1F5FA9","fontFamily":null,"fontSize":9,"fontWeight":false,"italic":false,"underline":false,"align":null,"value":"容差复算：L±10%/C±5% × 5000 次，0/5000 跌破","fillColor":"#1F5FA9","zIndex":220}|
{"type":"TEXT","ticket":920,"id":"083b23a7324c6eea"}||{"x":2050,"y":-830,"rotation":0,"color":"#1F5FA9","fontFamily":null,"fontSize":9,"fontWeight":false,"italic":false,"underline":false,"align":null,"value":"TP1 端接节点 · TP2 LC入 · TP3 LC出 · TP4 ×4出 · TP5 1.65V轨 · TP6 VREF","fillColor":"#1F5FA9","zIndex":228}|
{"type":"TEXT","ticket":921,"id":"8d2b44644141199a"}||{"x":2050,"y":-860,"rotation":0,"color":"#1F5FA9","fontFamily":null,"fontSize":9,"fontWeight":false,"italic":false,"underline":false,"align":null,"value":"JP1 BUF1入断点 · JP2 ×4出→ADC断点 · JP3 VREF注入断点","fillColor":"#1F5FA9","zIndex":229}|
{"type":"ATTR","ticket":922,"id":"7a53d3580e70d033"}||{"parentId":"afc05500e5b8bc65-e42","key":"NO_CONNECT","x":180,"y":-900,"value":"yes","zIndex":47}|
{"type":"ATTR","ticket":923,"id":"30419d78a71e210b"}||{"parentId":"afc05500e5b8bc65-e50","key":"NO_CONNECT","x":220,"y":-900,"value":"yes","zIndex":55}|
{"type":"ATTR","ticket":924,"id":"142093e22f0c9486"}||{"parentId":"afc05500e5b8bc65-e62","key":"NO_CONNECT","x":180,"y":-1000,"value":"yes","zIndex":67}|
{"type":"ATTR","ticket":925,"id":"3ce63c53093eb709"}||{"x":null,"y":null,"rotation":null,"color":null,"fontFamily":null,"fontSize":null,"fontWeight":null,"italic":null,"underline":null,"strikeout":false,"align":null,"value":"Default","keyVisible":null,"valueVisible":null,"key":"PCB Layer","fillColor":null,"parentId":"5d3e003fc8826190","zIndex":7}|
{"type":"ATTR","ticket":926,"id":"dcc0240b93bcbdf7"}||{"x":null,"y":null,"rotation":null,"color":null,"fontFamily":null,"fontSize":null,"fontWeight":null,"italic":null,"underline":null,"strikeout":false,"align":null,"value":"Default","keyVisible":null,"valueVisible":null,"key":"PCB Layer","fillColor":null,"parentId":"f7f5d17397a67241","zIndex":7}|
{"type":"ATTR","ticket":927,"id":"3a55495e1d9206a6"}||{"x":null,"y":null,"rotation":null,"color":null,"fontFamily":null,"fontSize":null,"fontWeight":null,"italic":null,"underline":null,"strikeout":false,"align":null,"value":"Default","keyVisible":null,"valueVisible":null,"key":"PCB Layer","fillColor":null,"parentId":"8e69b0aeda799e9a","zIndex":7}|
{"type":"ATTR","ticket":928,"id":"6776a2a0d6c5bc7d"}||{"x":null,"y":null,"rotation":null,"color":null,"fontFamily":null,"fontSize":null,"fontWeight":null,"italic":null,"underline":null,"strikeout":false,"align":null,"value":"Default","keyVisible":null,"valueVisible":null,"key":"PCB Layer","fillColor":null,"parentId":"ac2df7588789e06a","zIndex":10}|
{"type":"ATTR","ticket":929,"id":"0aa29027f1f1ff5a"}||{"x":null,"y":null,"rotation":null,"color":null,"fontFamily":null,"fontSize":null,"fontWeight":null,"italic":null,"underline":null,"strikeout":false,"align":null,"value":"Default","keyVisible":null,"valueVisible":null,"key":"PCB Layer","fillColor":null,"parentId":"902f4e53ca743fca","zIndex":10}|
{"type":"ATTR","ticket":930,"id":"6c0d1c39b46e5408"}||{"x":null,"y":null,"rotation":null,"color":null,"fontFamily":null,"fontSize":null,"fontWeight":null,"italic":null,"underline":null,"strikeout":false,"align":null,"value":"Default","keyVisible":null,"valueVisible":null,"key":"PCB Layer","fillColor":null,"parentId":"21ae80ce7b51b802","zIndex":7}|
{"type":"ATTR","ticket":931,"id":"703c00dc969b9d12"}||{"x":null,"y":null,"rotation":null,"color":null,"fontFamily":null,"fontSize":null,"fontWeight":null,"italic":null,"underline":null,"strikeout":false,"align":null,"value":"Default","keyVisible":null,"valueVisible":null,"key":"PCB Layer","fillColor":null,"parentId":"d4cb833c0ea07861","zIndex":7}|
{"type":"ATTR","ticket":932,"id":"66249f96d9785284"}||{"x":null,"y":null,"rotation":null,"color":null,"fontFamily":null,"fontSize":null,"fontWeight":null,"italic":null,"underline":null,"strikeout":false,"align":null,"value":"Default","keyVisible":null,"valueVisible":null,"key":"PCB Layer","fillColor":null,"parentId":"9bbe4bfab212f226","zIndex":7}|
{"type":"ATTR","ticket":933,"id":"19eda3c2b5532f9b"}||{"x":null,"y":null,"rotation":null,"color":null,"fontFamily":null,"fontSize":null,"fontWeight":null,"italic":null,"underline":null,"strikeout":false,"align":null,"value":"Default","keyVisible":null,"valueVisible":null,"key":"PCB Layer","fillColor":null,"parentId":"ba13657df474ad19","zIndex":7}|
{"type":"ATTR","ticket":934,"id":"34f59de59166782a"}||{"x":null,"y":null,"rotation":null,"color":null,"fontFamily":null,"fontSize":null,"fontWeight":null,"italic":null,"underline":null,"strikeout":false,"align":null,"value":"Default","keyVisible":null,"valueVisible":null,"key":"PCB Layer","fillColor":null,"parentId":"d70e53b3866f3ecd","zIndex":7}|
{"type":"ATTR","ticket":935,"id":"024fb14e0ced4061"}||{"x":null,"y":null,"rotation":null,"color":null,"fontFamily":null,"fontSize":null,"fontWeight":null,"italic":null,"underline":null,"strikeout":false,"align":null,"value":"Default","keyVisible":null,"valueVisible":null,"key":"PCB Layer","fillColor":null,"parentId":"d8f676ef6cd3bd61","zIndex":7}|
{"type":"ATTR","ticket":936,"id":"58c585c156ba1b53"}||{"x":null,"y":null,"rotation":null,"color":null,"fontFamily":null,"fontSize":null,"fontWeight":null,"italic":null,"underline":null,"strikeout":false,"align":null,"value":"Default","keyVisible":null,"valueVisible":null,"key":"PCB Layer","fillColor":null,"parentId":"e584c449c600ff04","zIndex":7}|
{"type":"ATTR","ticket":937,"id":"322eec80049a2d46"}||{"x":null,"y":null,"rotation":null,"color":null,"fontFamily":null,"fontSize":null,"fontWeight":null,"italic":null,"underline":null,"strikeout":false,"align":null,"value":"Default","keyVisible":null,"valueVisible":null,"key":"PCB Layer","fillColor":null,"parentId":"40b59f91beff47c2","zIndex":10}|
{"type":"ATTR","ticket":938,"id":"230435330ba99d6a"}||{"x":null,"y":null,"rotation":null,"color":null,"fontFamily":null,"fontSize":null,"fontWeight":null,"italic":null,"underline":null,"strikeout":false,"align":null,"value":"Default","keyVisible":null,"valueVisible":null,"key":"PCB Layer","fillColor":null,"parentId":"fabf9e67c19f63d3","zIndex":7}|
{"type":"ATTR","ticket":939,"id":"71c1896ce16f3619"}||{"x":null,"y":null,"rotation":null,"color":null,"fontFamily":null,"fontSize":null,"fontWeight":null,"italic":null,"underline":null,"strikeout":false,"align":null,"value":"Default","keyVisible":null,"valueVisible":null,"key":"PCB Layer","fillColor":null,"parentId":"543633c01b8faf64","zIndex":10}|
{"type":"ATTR","ticket":940,"id":"c9823a07b0a5a447"}||{"x":null,"y":null,"rotation":null,"color":null,"fontFamily":null,"fontSize":null,"fontWeight":null,"italic":null,"underline":null,"strikeout":false,"align":null,"value":"Default","keyVisible":null,"valueVisible":null,"key":"PCB Layer","fillColor":null,"parentId":"52436a48dda5e32a","zIndex":11}|
{"type":"ATTR","ticket":941,"id":"cc5868e80a8565ba"}||{"x":null,"y":null,"rotation":null,"color":null,"fontFamily":null,"fontSize":null,"fontWeight":null,"italic":null,"underline":null,"strikeout":false,"align":null,"value":"Default","keyVisible":null,"valueVisible":null,"key":"PCB Layer","fillColor":null,"parentId":"ccb547786cab4b13","zIndex":12}|
{"type":"ATTR","ticket":942,"id":"3be90185a6b439bb"}||{"x":null,"y":null,"rotation":null,"color":null,"fontFamily":null,"fontSize":null,"fontWeight":null,"italic":null,"underline":null,"strikeout":false,"align":null,"value":"Default","keyVisible":null,"valueVisible":null,"key":"PCB Layer","fillColor":null,"parentId":"db09da3f021abb4e","zIndex":10}|
{"type":"ATTR","ticket":943,"id":"5bf5bea1af2ffaea"}||{"x":null,"y":null,"rotation":null,"color":null,"fontFamily":null,"fontSize":null,"fontWeight":null,"italic":null,"underline":null,"strikeout":false,"align":null,"value":"Default","keyVisible":null,"valueVisible":null,"key":"PCB Layer","fillColor":null,"parentId":"18d8f01875955814","zIndex":10}|
{"type":"ATTR","ticket":944,"id":"3de3cb99141a0d08"}||{"x":null,"y":null,"rotation":null,"color":null,"fontFamily":null,"fontSize":null,"fontWeight":null,"italic":null,"underline":null,"strikeout":false,"align":null,"value":"Default","keyVisible":null,"valueVisible":null,"key":"PCB Layer","fillColor":null,"parentId":"e9e90131ba3df242","zIndex":10}|
{"type":"ATTR","ticket":945,"id":"c8ee315c09a4a7ba"}||{"x":null,"y":null,"rotation":null,"color":null,"fontFamily":null,"fontSize":null,"fontWeight":null,"italic":null,"underline":null,"strikeout":false,"align":null,"value":"Default","keyVisible":null,"valueVisible":null,"key":"PCB Layer","fillColor":null,"parentId":"2b47267e18a481c1","zIndex":10}|
{"type":"ATTR","ticket":946,"id":"3e61a2732b29ca58"}||{"x":null,"y":null,"rotation":null,"color":null,"fontFamily":null,"fontSize":null,"fontWeight":null,"italic":null,"underline":null,"strikeout":false,"align":null,"value":"Default","keyVisible":null,"valueVisible":null,"key":"PCB Layer","fillColor":null,"parentId":"28ec30eb57e2ccb0","zIndex":10}|
{"type":"ATTR","ticket":947,"id":"e269111d11489bdd"}||{"x":null,"y":null,"rotation":null,"color":null,"fontFamily":null,"fontSize":null,"fontWeight":null,"italic":null,"underline":null,"strikeout":false,"align":null,"value":"Default","keyVisible":null,"valueVisible":null,"key":"PCB Layer","fillColor":null,"parentId":"c481994436307bea","zIndex":10}|
{"type":"ATTR","ticket":948,"id":"e425ec92ede32b2f"}||{"x":null,"y":null,"rotation":null,"color":null,"fontFamily":null,"fontSize":null,"fontWeight":null,"italic":null,"underline":null,"strikeout":false,"align":null,"value":"Default","keyVisible":null,"valueVisible":null,"key":"PCB Layer","fillColor":null,"parentId":"62cca8ba9d435e0f","zIndex":10}|
{"type":"ATTR","ticket":949,"id":"8aae0ce527d626dc"}||{"x":null,"y":null,"rotation":null,"color":null,"fontFamily":null,"fontSize":null,"fontWeight":null,"italic":null,"underline":null,"strikeout":false,"align":null,"value":"Default","keyVisible":null,"valueVisible":null,"key":"PCB Layer","fillColor":null,"parentId":"0c75f98574dfe415","zIndex":10}|
{"type":"ATTR","ticket":950,"id":"8a0ca3d0dcf3bbae"}||{"x":null,"y":null,"rotation":null,"color":null,"fontFamily":null,"fontSize":null,"fontWeight":null,"italic":null,"underline":null,"strikeout":false,"align":null,"value":"Default","keyVisible":null,"valueVisible":null,"key":"PCB Layer","fillColor":null,"parentId":"937aae99b814f439","zIndex":7}|
{"type":"COMPONENT","ticket":951,"id":"d301ecb9983ee069"}||{"partId":"pid8a0e77bacb214e","x":180,"y":-1360,"rotation":270,"isMirror":false,"attrs":{"Footprints":"[]","Devices":"[]","DeviceName":"{\"uuid\":\"3f13421398586a3b\",\"name\":\"Ground-GND\",\"source\":\"\"}"},"zIndex":1014}|
{"type":"ATTR","ticket":952,"id":"e244fb6f102f7cfa"}||{"x":150,"y":-1360,"rotation":90,"color":null,"fontFamily":null,"fontSize":10,"fontWeight":null,"italic":null,"underline":null,"align":"RIGHT_TOP","value":"43a94a86e84eab37","keyVisible":null,"valueVisible":null,"key":"Symbol","fillColor":null,"parentId":"d301ecb9983ee069","zIndex":1,"locked":false}|
{"type":"ATTR","ticket":953,"id":"9eec5ada8e8a1d4c"}||{"x":null,"y":null,"rotation":null,"color":null,"fontFamily":null,"fontSize":null,"fontWeight":null,"italic":null,"underline":null,"align":null,"value":"3f13421398586a3b","keyVisible":null,"valueVisible":null,"key":"Device","fillColor":null,"parentId":"d301ecb9983ee069","zIndex":18}|
{"type":"ATTR","ticket":954,"id":"695465d59f235949"}||{"x":null,"y":null,"rotation":null,"color":null,"fontFamily":null,"fontSize":null,"fontWeight":null,"italic":null,"underline":null,"align":null,"value":"[]","keyVisible":null,"valueVisible":null,"key":"Relevance","fillColor":null,"parentId":"d301ecb9983ee069","zIndex":0}|
{"type":"ATTR","ticket":955,"id":"cbfe75e7efd5a7df"}||{"x":155,"y":-1360,"rotation":90,"color":null,"fontFamily":null,"fontSize":null,"fontWeight":null,"italic":null,"underline":null,"align":"CENTER_MIDDLE","value":"AGND","keyVisible":null,"valueVisible":true,"key":"Name","fillColor":null,"parentId":"d301ecb9983ee069","zIndex":3,"locked":false}|
{"type":"ATTR","ticket":956,"id":"aaa32f8f034b2801"}||{"x":155,"y":-1360,"rotation":90,"color":null,"fontFamily":null,"fontSize":null,"fontWeight":null,"italic":null,"underline":null,"align":"CENTER_MIDDLE","value":"AGND","keyVisible":null,"valueVisible":null,"key":"Global Net Name","fillColor":null,"parentId":"d301ecb9983ee069","zIndex":17}|
{"type":"ATTR","ticket":957,"id":"fb98ccb94daba576"}||{"x":null,"y":null,"rotation":null,"color":null,"fontFamily":null,"fontSize":null,"fontWeight":null,"italic":null,"underline":null,"align":null,"value":null,"keyVisible":null,"valueVisible":null,"key":"Description","fillColor":null,"parentId":"d301ecb9983ee069","zIndex":19}|
{"type":"ATTR","ticket":958,"id":"5c9f5da8c8610216"}||{"x":null,"y":null,"rotation":null,"color":null,"fontFamily":null,"fontSize":null,"fontWeight":null,"italic":null,"underline":null,"align":null,"value":null,"keyVisible":null,"valueVisible":null,"key":"3D Model","fillColor":null,"parentId":"d301ecb9983ee069","zIndex":20}|
{"type":"ATTR","ticket":959,"id":"8faa039186262b5c"}||{"x":null,"y":null,"rotation":null,"color":null,"fontFamily":null,"fontSize":null,"fontWeight":null,"italic":null,"underline":null,"align":null,"value":null,"keyVisible":null,"valueVisible":null,"key":"3D Model Title","fillColor":null,"parentId":"d301ecb9983ee069","zIndex":21}|
{"type":"ATTR","ticket":960,"id":"ad7c7bd5f8685425"}||{"x":null,"y":null,"rotation":null,"color":null,"fontFamily":null,"fontSize":null,"fontWeight":null,"italic":null,"underline":null,"align":null,"value":null,"keyVisible":null,"valueVisible":null,"key":"3D Model Transform","fillColor":null,"parentId":"d301ecb9983ee069","zIndex":22}|
{"type":"COMPONENT","ticket":961,"id":"e19f412a8cb50c01"}||{"partId":"pid8a0e77bacb214e","x":660,"y":-1190,"rotation":270,"isMirror":false,"attrs":{"Footprints":"[]","Devices":"[]","DeviceName":"{\"uuid\":\"3f13421398586a3b\",\"name\":\"Ground-GND\",\"source\":\"\"}"},"zIndex":1016}|
{"type":"ATTR","ticket":962,"id":"84f3963a05768de0"}||{"x":630,"y":-1190,"rotation":90,"color":null,"fontFamily":null,"fontSize":10,"fontWeight":null,"italic":null,"underline":null,"align":"RIGHT_TOP","value":"43a94a86e84eab37","keyVisible":null,"valueVisible":null,"key":"Symbol","fillColor":null,"parentId":"e19f412a8cb50c01","zIndex":1,"locked":false}|
{"type":"ATTR","ticket":963,"id":"bd4e134463cc2dd7"}||{"x":null,"y":null,"rotation":null,"color":null,"fontFamily":null,"fontSize":null,"fontWeight":null,"italic":null,"underline":null,"align":null,"value":"3f13421398586a3b","keyVisible":null,"valueVisible":null,"key":"Device","fillColor":null,"parentId":"e19f412a8cb50c01","zIndex":18}|
{"type":"ATTR","ticket":964,"id":"143a9caf48ee982b"}||{"x":null,"y":null,"rotation":null,"color":null,"fontFamily":null,"fontSize":null,"fontWeight":null,"italic":null,"underline":null,"align":null,"value":"[]","keyVisible":null,"valueVisible":null,"key":"Relevance","fillColor":null,"parentId":"e19f412a8cb50c01","zIndex":0}|
{"type":"ATTR","ticket":965,"id":"c57eaea9f0230822"}||{"x":635,"y":-1190,"rotation":90,"color":null,"fontFamily":null,"fontSize":null,"fontWeight":null,"italic":null,"underline":null,"align":"CENTER_MIDDLE","value":"AGND","keyVisible":null,"valueVisible":true,"key":"Name","fillColor":null,"parentId":"e19f412a8cb50c01","zIndex":3,"locked":false}|
{"type":"ATTR","ticket":966,"id":"5952b7b790c5f7b3"}||{"x":635,"y":-1190,"rotation":90,"color":null,"fontFamily":null,"fontSize":null,"fontWeight":null,"italic":null,"underline":null,"align":"CENTER_MIDDLE","value":"AGND","keyVisible":null,"valueVisible":null,"key":"Global Net Name","fillColor":null,"parentId":"e19f412a8cb50c01","zIndex":17}|
{"type":"ATTR","ticket":967,"id":"dc3de7b5f1298c12"}||{"x":null,"y":null,"rotation":null,"color":null,"fontFamily":null,"fontSize":null,"fontWeight":null,"italic":null,"underline":null,"align":null,"value":null,"keyVisible":null,"valueVisible":null,"key":"Description","fillColor":null,"parentId":"e19f412a8cb50c01","zIndex":19}|
{"type":"ATTR","ticket":968,"id":"9629d9d2ff826f1d"}||{"x":null,"y":null,"rotation":null,"color":null,"fontFamily":null,"fontSize":null,"fontWeight":null,"italic":null,"underline":null,"align":null,"value":null,"keyVisible":null,"valueVisible":null,"key":"3D Model","fillColor":null,"parentId":"e19f412a8cb50c01","zIndex":20}|
{"type":"ATTR","ticket":969,"id":"d0e17eb983019ce6"}||{"x":null,"y":null,"rotation":null,"color":null,"fontFamily":null,"fontSize":null,"fontWeight":null,"italic":null,"underline":null,"align":null,"value":null,"keyVisible":null,"valueVisible":null,"key":"3D Model Title","fillColor":null,"parentId":"e19f412a8cb50c01","zIndex":21}|
{"type":"ATTR","ticket":970,"id":"e98fad92ecd04414"}||{"x":null,"y":null,"rotation":null,"color":null,"fontFamily":null,"fontSize":null,"fontWeight":null,"italic":null,"underline":null,"align":null,"value":null,"keyVisible":null,"valueVisible":null,"key":"3D Model Transform","fillColor":null,"parentId":"e19f412a8cb50c01","zIndex":22}|
{"type":"COMPONENT","ticket":971,"id":"ee470f1d568150af"}||{"partId":"pid8a0e77bacb214e","x":1140,"y":-910,"rotation":270,"isMirror":false,"attrs":{"Footprints":"[]","Devices":"[]","DeviceName":"{\"uuid\":\"3f13421398586a3b\",\"name\":\"Ground-GND\",\"source\":\"\"}"},"zIndex":1017}|
{"type":"ATTR","ticket":972,"id":"36fa437aedeff377"}||{"x":1110,"y":-909.9999999999998,"rotation":90,"color":null,"fontFamily":null,"fontSize":10,"fontWeight":null,"italic":null,"underline":null,"align":"RIGHT_TOP","value":"43a94a86e84eab37","keyVisible":null,"valueVisible":null,"key":"Symbol","fillColor":null,"parentId":"ee470f1d568150af","zIndex":1,"locked":false}|
{"type":"ATTR","ticket":973,"id":"3e5334ef130a2480"}||{"x":null,"y":null,"rotation":null,"color":null,"fontFamily":null,"fontSize":null,"fontWeight":null,"italic":null,"underline":null,"align":null,"value":"3f13421398586a3b","keyVisible":null,"valueVisible":null,"key":"Device","fillColor":null,"parentId":"ee470f1d568150af","zIndex":18}|
{"type":"ATTR","ticket":974,"id":"bc30db6894d3f59b"}||{"x":null,"y":null,"rotation":null,"color":null,"fontFamily":null,"fontSize":null,"fontWeight":null,"italic":null,"underline":null,"align":null,"value":"[]","keyVisible":null,"valueVisible":null,"key":"Relevance","fillColor":null,"parentId":"ee470f1d568150af","zIndex":0}|
{"type":"ATTR","ticket":975,"id":"f0cd8bcb64997211"}||{"x":1115,"y":-909.9999999999998,"rotation":90,"color":null,"fontFamily":null,"fontSize":null,"fontWeight":null,"italic":null,"underline":null,"align":"CENTER_MIDDLE","value":"AGND","keyVisible":null,"valueVisible":true,"key":"Name","fillColor":null,"parentId":"ee470f1d568150af","zIndex":3,"locked":false}|
{"type":"ATTR","ticket":976,"id":"8855bfb96642b6cd"}||{"x":1115,"y":-909.9999999999998,"rotation":90,"color":null,"fontFamily":null,"fontSize":null,"fontWeight":null,"italic":null,"underline":null,"align":"CENTER_MIDDLE","value":"AGND","keyVisible":null,"valueVisible":null,"key":"Global Net Name","fillColor":null,"parentId":"ee470f1d568150af","zIndex":17}|
{"type":"ATTR","ticket":977,"id":"5de47bba79192f69"}||{"x":null,"y":null,"rotation":null,"color":null,"fontFamily":null,"fontSize":null,"fontWeight":null,"italic":null,"underline":null,"align":null,"value":null,"keyVisible":null,"valueVisible":null,"key":"Description","fillColor":null,"parentId":"ee470f1d568150af","zIndex":19}|
{"type":"ATTR","ticket":978,"id":"66e354fa33fcff01"}||{"x":null,"y":null,"rotation":null,"color":null,"fontFamily":null,"fontSize":null,"fontWeight":null,"italic":null,"underline":null,"align":null,"value":null,"keyVisible":null,"valueVisible":null,"key":"3D Model","fillColor":null,"parentId":"ee470f1d568150af","zIndex":20}|
{"type":"ATTR","ticket":979,"id":"9d98a21745a8708f"}||{"x":null,"y":null,"rotation":null,"color":null,"fontFamily":null,"fontSize":null,"fontWeight":null,"italic":null,"underline":null,"align":null,"value":null,"keyVisible":null,"valueVisible":null,"key":"3D Model Title","fillColor":null,"parentId":"ee470f1d568150af","zIndex":21}|
{"type":"ATTR","ticket":980,"id":"9986a7a14349b286"}||{"x":null,"y":null,"rotation":null,"color":null,"fontFamily":null,"fontSize":null,"fontWeight":null,"italic":null,"underline":null,"align":null,"value":null,"keyVisible":null,"valueVisible":null,"key":"3D Model Transform","fillColor":null,"parentId":"ee470f1d568150af","zIndex":22}|
{"type":"COMPONENT","ticket":981,"id":"ab64a27366a1c7ca"}||{"partId":"pid8a0e77bacb214e","x":1380,"y":-910,"rotation":270,"isMirror":false,"attrs":{"Footprints":"[]","Devices":"[]","DeviceName":"{\"uuid\":\"3f13421398586a3b\",\"name\":\"Ground-GND\",\"source\":\"\"}"},"zIndex":1018}|
{"type":"ATTR","ticket":982,"id":"bcae20b271192cbc"}||{"x":1350,"y":-909.9999999999998,"rotation":90,"color":null,"fontFamily":null,"fontSize":10,"fontWeight":null,"italic":null,"underline":null,"align":"RIGHT_TOP","value":"43a94a86e84eab37","keyVisible":null,"valueVisible":null,"key":"Symbol","fillColor":null,"parentId":"ab64a27366a1c7ca","zIndex":1,"locked":false}|
{"type":"ATTR","ticket":983,"id":"2ba6ce945c34c313"}||{"x":null,"y":null,"rotation":null,"color":null,"fontFamily":null,"fontSize":null,"fontWeight":null,"italic":null,"underline":null,"align":null,"value":"3f13421398586a3b","keyVisible":null,"valueVisible":null,"key":"Device","fillColor":null,"parentId":"ab64a27366a1c7ca","zIndex":18}|
{"type":"ATTR","ticket":984,"id":"d97b18f3c43b3485"}||{"x":null,"y":null,"rotation":null,"color":null,"fontFamily":null,"fontSize":null,"fontWeight":null,"italic":null,"underline":null,"align":null,"value":"[]","keyVisible":null,"valueVisible":null,"key":"Relevance","fillColor":null,"parentId":"ab64a27366a1c7ca","zIndex":0}|
{"type":"ATTR","ticket":985,"id":"c6cd3a01ed0933db"}||{"x":1355,"y":-909.9999999999998,"rotation":90,"color":null,"fontFamily":null,"fontSize":null,"fontWeight":null,"italic":null,"underline":null,"align":"CENTER_MIDDLE","value":"AGND","keyVisible":null,"valueVisible":true,"key":"Name","fillColor":null,"parentId":"ab64a27366a1c7ca","zIndex":3,"locked":false}|
{"type":"ATTR","ticket":986,"id":"dc6924b8571801a4"}||{"x":1355,"y":-909.9999999999998,"rotation":90,"color":null,"fontFamily":null,"fontSize":null,"fontWeight":null,"italic":null,"underline":null,"align":"CENTER_MIDDLE","value":"AGND","keyVisible":null,"valueVisible":null,"key":"Global Net Name","fillColor":null,"parentId":"ab64a27366a1c7ca","zIndex":17}|
{"type":"ATTR","ticket":987,"id":"94a59318c9aeb821"}||{"x":null,"y":null,"rotation":null,"color":null,"fontFamily":null,"fontSize":null,"fontWeight":null,"italic":null,"underline":null,"align":null,"value":null,"keyVisible":null,"valueVisible":null,"key":"Description","fillColor":null,"parentId":"ab64a27366a1c7ca","zIndex":19}|
{"type":"ATTR","ticket":988,"id":"96852af705a76a03"}||{"x":null,"y":null,"rotation":null,"color":null,"fontFamily":null,"fontSize":null,"fontWeight":null,"italic":null,"underline":null,"align":null,"value":null,"keyVisible":null,"valueVisible":null,"key":"3D Model","fillColor":null,"parentId":"ab64a27366a1c7ca","zIndex":20}|
{"type":"ATTR","ticket":989,"id":"cc9e60c20b5c62d5"}||{"x":null,"y":null,"rotation":null,"color":null,"fontFamily":null,"fontSize":null,"fontWeight":null,"italic":null,"underline":null,"align":null,"value":null,"keyVisible":null,"valueVisible":null,"key":"3D Model Title","fillColor":null,"parentId":"ab64a27366a1c7ca","zIndex":21}|
{"type":"ATTR","ticket":990,"id":"2c50aca465a562c2"}||{"x":null,"y":null,"rotation":null,"color":null,"fontFamily":null,"fontSize":null,"fontWeight":null,"italic":null,"underline":null,"align":null,"value":null,"keyVisible":null,"valueVisible":null,"key":"3D Model Transform","fillColor":null,"parentId":"ab64a27366a1c7ca","zIndex":22}|
{"type":"COMPONENT","ticket":991,"id":"3ccf3280232b0edd"}||{"partId":"pid8a0e77bacb214e","x":1620,"y":-910,"rotation":270,"isMirror":false,"attrs":{"Footprints":"[]","Devices":"[]","DeviceName":"{\"uuid\":\"3f13421398586a3b\",\"name\":\"Ground-GND\",\"source\":\"\"}"},"zIndex":1019}|
{"type":"ATTR","ticket":992,"id":"4fa17d5847bef6fd"}||{"x":1590,"y":-909.9999999999998,"rotation":90,"color":null,"fontFamily":null,"fontSize":10,"fontWeight":null,"italic":null,"underline":null,"align":"RIGHT_TOP","value":"43a94a86e84eab37","keyVisible":null,"valueVisible":null,"key":"Symbol","fillColor":null,"parentId":"3ccf3280232b0edd","zIndex":1,"locked":false}|
{"type":"ATTR","ticket":993,"id":"e7f5d00988dcdcaf"}||{"x":null,"y":null,"rotation":null,"color":null,"fontFamily":null,"fontSize":null,"fontWeight":null,"italic":null,"underline":null,"align":null,"value":"3f13421398586a3b","keyVisible":null,"valueVisible":null,"key":"Device","fillColor":null,"parentId":"3ccf3280232b0edd","zIndex":18}|
{"type":"ATTR","ticket":994,"id":"395e35d44bd94573"}||{"x":null,"y":null,"rotation":null,"color":null,"fontFamily":null,"fontSize":null,"fontWeight":null,"italic":null,"underline":null,"align":null,"value":"[]","keyVisible":null,"valueVisible":null,"key":"Relevance","fillColor":null,"parentId":"3ccf3280232b0edd","zIndex":0}|
{"type":"ATTR","ticket":995,"id":"7b5f83a5daff9a2e"}||{"x":1595,"y":-909.9999999999998,"rotation":90,"color":null,"fontFamily":null,"fontSize":null,"fontWeight":null,"italic":null,"underline":null,"align":"CENTER_MIDDLE","value":"AGND","keyVisible":null,"valueVisible":true,"key":"Name","fillColor":null,"parentId":"3ccf3280232b0edd","zIndex":3,"locked":false}|
{"type":"ATTR","ticket":996,"id":"5c071d2625cc4296"}||{"x":1595,"y":-909.9999999999998,"rotation":90,"color":null,"fontFamily":null,"fontSize":null,"fontWeight":null,"italic":null,"underline":null,"align":"CENTER_MIDDLE","value":"AGND","keyVisible":null,"valueVisible":null,"key":"Global Net Name","fillColor":null,"parentId":"3ccf3280232b0edd","zIndex":17}|
{"type":"ATTR","ticket":997,"id":"85267f971bd8b44a"}||{"x":null,"y":null,"rotation":null,"color":null,"fontFamily":null,"fontSize":null,"fontWeight":null,"italic":null,"underline":null,"align":null,"value":null,"keyVisible":null,"valueVisible":null,"key":"Description","fillColor":null,"parentId":"3ccf3280232b0edd","zIndex":19}|
{"type":"ATTR","ticket":998,"id":"998a68329de5441d"}||{"x":null,"y":null,"rotation":null,"color":null,"fontFamily":null,"fontSize":null,"fontWeight":null,"italic":null,"underline":null,"align":null,"value":null,"keyVisible":null,"valueVisible":null,"key":"3D Model","fillColor":null,"parentId":"3ccf3280232b0edd","zIndex":20}|
{"type":"ATTR","ticket":999,"id":"239bca08360d1340"}||{"x":null,"y":null,"rotation":null,"color":null,"fontFamily":null,"fontSize":null,"fontWeight":null,"italic":null,"underline":null,"align":null,"value":null,"keyVisible":null,"valueVisible":null,"key":"3D Model Title","fillColor":null,"parentId":"3ccf3280232b0edd","zIndex":21}|
{"type":"ATTR","ticket":1000,"id":"77000174e6a17084"}||{"x":null,"y":null,"rotation":null,"color":null,"fontFamily":null,"fontSize":null,"fontWeight":null,"italic":null,"underline":null,"align":null,"value":null,"keyVisible":null,"valueVisible":null,"key":"3D Model Transform","fillColor":null,"parentId":"3ccf3280232b0edd","zIndex":22}|
{"type":"COMPONENT","ticket":1001,"id":"003502606b4a3306"}||{"partId":"pid8a0e77bacb214e","x":1860,"y":-910,"rotation":270,"isMirror":false,"attrs":{"Footprints":"[]","Devices":"[]","DeviceName":"{\"uuid\":\"3f13421398586a3b\",\"name\":\"Ground-GND\",\"source\":\"\"}"},"zIndex":1020}|
{"type":"ATTR","ticket":1002,"id":"1724014277875299"}||{"x":1830,"y":-909.9999999999998,"rotation":90,"color":null,"fontFamily":null,"fontSize":10,"fontWeight":null,"italic":null,"underline":null,"align":"RIGHT_TOP","value":"43a94a86e84eab37","keyVisible":null,"valueVisible":null,"key":"Symbol","fillColor":null,"parentId":"003502606b4a3306","zIndex":1,"locked":false}|
{"type":"ATTR","ticket":1003,"id":"470051d4e5a96327"}||{"x":null,"y":null,"rotation":null,"color":null,"fontFamily":null,"fontSize":null,"fontWeight":null,"italic":null,"underline":null,"align":null,"value":"3f13421398586a3b","keyVisible":null,"valueVisible":null,"key":"Device","fillColor":null,"parentId":"003502606b4a3306","zIndex":18}|
{"type":"ATTR","ticket":1004,"id":"fdf7dfaca849c7a3"}||{"x":null,"y":null,"rotation":null,"color":null,"fontFamily":null,"fontSize":null,"fontWeight":null,"italic":null,"underline":null,"align":null,"value":"[]","keyVisible":null,"valueVisible":null,"key":"Relevance","fillColor":null,"parentId":"003502606b4a3306","zIndex":0}|
{"type":"ATTR","ticket":1005,"id":"07855c7ffe39b678"}||{"x":1835,"y":-909.9999999999998,"rotation":90,"color":null,"fontFamily":null,"fontSize":null,"fontWeight":null,"italic":null,"underline":null,"align":"CENTER_MIDDLE","value":"AGND","keyVisible":null,"valueVisible":true,"key":"Name","fillColor":null,"parentId":"003502606b4a3306","zIndex":3,"locked":false}|
{"type":"ATTR","ticket":1006,"id":"9fb98fbc7eb3ceed"}||{"x":1835,"y":-909.9999999999998,"rotation":90,"color":null,"fontFamily":null,"fontSize":null,"fontWeight":null,"italic":null,"underline":null,"align":"CENTER_MIDDLE","value":"AGND","keyVisible":null,"valueVisible":null,"key":"Global Net Name","fillColor":null,"parentId":"003502606b4a3306","zIndex":17}|
{"type":"ATTR","ticket":1007,"id":"032d682bb21dc5ea"}||{"x":null,"y":null,"rotation":null,"color":null,"fontFamily":null,"fontSize":null,"fontWeight":null,"italic":null,"underline":null,"align":null,"value":null,"keyVisible":null,"valueVisible":null,"key":"Description","fillColor":null,"parentId":"003502606b4a3306","zIndex":19}|
{"type":"ATTR","ticket":1008,"id":"c8c9c6389392d82b"}||{"x":null,"y":null,"rotation":null,"color":null,"fontFamily":null,"fontSize":null,"fontWeight":null,"italic":null,"underline":null,"align":null,"value":null,"keyVisible":null,"valueVisible":null,"key":"3D Model","fillColor":null,"parentId":"003502606b4a3306","zIndex":20}|
{"type":"ATTR","ticket":1009,"id":"90a833d78d8ccca6"}||{"x":null,"y":null,"rotation":null,"color":null,"fontFamily":null,"fontSize":null,"fontWeight":null,"italic":null,"underline":null,"align":null,"value":null,"keyVisible":null,"valueVisible":null,"key":"3D Model Title","fillColor":null,"parentId":"003502606b4a3306","zIndex":21}|
{"type":"ATTR","ticket":1010,"id":"a3a703c123bcbbe8"}||{"x":null,"y":null,"rotation":null,"color":null,"fontFamily":null,"fontSize":null,"fontWeight":null,"italic":null,"underline":null,"align":null,"value":null,"keyVisible":null,"valueVisible":null,"key":"3D Model Transform","fillColor":null,"parentId":"003502606b4a3306","zIndex":22}|
{"type":"COMPONENT","ticket":1011,"id":"d613954008ae87e2"}||{"partId":"pid8a0e77bacb214e","x":200,"y":-880,"rotation":270,"isMirror":false,"attrs":{"Footprints":"[]","Devices":"[]","DeviceName":"{\"uuid\":\"3f13421398586a3b\",\"name\":\"Ground-GND\",\"source\":\"\"}"},"zIndex":1021}|
{"type":"ATTR","ticket":1012,"id":"39efdf91a5a31806"}||{"x":170,"y":-880,"rotation":90,"color":null,"fontFamily":null,"fontSize":10,"fontWeight":null,"italic":null,"underline":null,"align":"RIGHT_TOP","value":"43a94a86e84eab37","keyVisible":null,"valueVisible":null,"key":"Symbol","fillColor":null,"parentId":"d613954008ae87e2","zIndex":1,"locked":false}|
{"type":"ATTR","ticket":1013,"id":"b514919b5ffa98d9"}||{"x":null,"y":null,"rotation":null,"color":null,"fontFamily":null,"fontSize":null,"fontWeight":null,"italic":null,"underline":null,"align":null,"value":"3f13421398586a3b","keyVisible":null,"valueVisible":null,"key":"Device","fillColor":null,"parentId":"d613954008ae87e2","zIndex":18}|
{"type":"ATTR","ticket":1014,"id":"980563b1edf78510"}||{"x":null,"y":null,"rotation":null,"color":null,"fontFamily":null,"fontSize":null,"fontWeight":null,"italic":null,"underline":null,"align":null,"value":"[]","keyVisible":null,"valueVisible":null,"key":"Relevance","fillColor":null,"parentId":"d613954008ae87e2","zIndex":0}|
{"type":"ATTR","ticket":1015,"id":"89d1a82765f472e1"}||{"x":175,"y":-880,"rotation":90,"color":null,"fontFamily":null,"fontSize":null,"fontWeight":null,"italic":null,"underline":null,"align":"CENTER_MIDDLE","value":"AGND","keyVisible":null,"valueVisible":true,"key":"Name","fillColor":null,"parentId":"d613954008ae87e2","zIndex":3,"locked":false}|
{"type":"ATTR","ticket":1016,"id":"0e0e34df3805d826"}||{"x":175,"y":-880,"rotation":90,"color":null,"fontFamily":null,"fontSize":null,"fontWeight":null,"italic":null,"underline":null,"align":"CENTER_MIDDLE","value":"AGND","keyVisible":null,"valueVisible":null,"key":"Global Net Name","fillColor":null,"parentId":"d613954008ae87e2","zIndex":17}|
{"type":"ATTR","ticket":1017,"id":"594021f139a7c62e"}||{"x":null,"y":null,"rotation":null,"color":null,"fontFamily":null,"fontSize":null,"fontWeight":null,"italic":null,"underline":null,"align":null,"value":null,"keyVisible":null,"valueVisible":null,"key":"Description","fillColor":null,"parentId":"d613954008ae87e2","zIndex":19}|
{"type":"ATTR","ticket":1018,"id":"77e980249a0c3579"}||{"x":null,"y":null,"rotation":null,"color":null,"fontFamily":null,"fontSize":null,"fontWeight":null,"italic":null,"underline":null,"align":null,"value":null,"keyVisible":null,"valueVisible":null,"key":"3D Model","fillColor":null,"parentId":"d613954008ae87e2","zIndex":20}|
{"type":"ATTR","ticket":1019,"id":"7bd7ad27171bf9d0"}||{"x":null,"y":null,"rotation":null,"color":null,"fontFamily":null,"fontSize":null,"fontWeight":null,"italic":null,"underline":null,"align":null,"value":null,"keyVisible":null,"valueVisible":null,"key":"3D Model Title","fillColor":null,"parentId":"d613954008ae87e2","zIndex":21}|
{"type":"ATTR","ticket":1020,"id":"877f64ed23cc9fe5"}||{"x":null,"y":null,"rotation":null,"color":null,"fontFamily":null,"fontSize":null,"fontWeight":null,"italic":null,"underline":null,"align":null,"value":null,"keyVisible":null,"valueVisible":null,"key":"3D Model Transform","fillColor":null,"parentId":"d613954008ae87e2","zIndex":22}|
{"type":"COMPONENT","ticket":1021,"id":"fc72a22167fc4941"}||{"partId":"pid8a0e77bacb214e","x":280,"y":-910,"rotation":270,"isMirror":false,"attrs":{"Footprints":"[]","Devices":"[]","DeviceName":"{\"uuid\":\"3f13421398586a3b\",\"name\":\"Ground-GND\",\"source\":\"\"}"},"zIndex":1028}|
{"type":"ATTR","ticket":1022,"id":"7008e0e0b2be35bc"}||{"x":250,"y":-910,"rotation":90,"color":null,"fontFamily":null,"fontSize":10,"fontWeight":null,"italic":null,"underline":null,"align":"RIGHT_TOP","value":"43a94a86e84eab37","keyVisible":null,"valueVisible":null,"key":"Symbol","fillColor":null,"parentId":"fc72a22167fc4941","zIndex":1,"locked":false}|
{"type":"ATTR","ticket":1023,"id":"15335a8b12134dce"}||{"x":null,"y":null,"rotation":null,"color":null,"fontFamily":null,"fontSize":null,"fontWeight":null,"italic":null,"underline":null,"align":null,"value":"3f13421398586a3b","keyVisible":null,"valueVisible":null,"key":"Device","fillColor":null,"parentId":"fc72a22167fc4941","zIndex":18}|
{"type":"ATTR","ticket":1024,"id":"4789b194de4009f7"}||{"x":null,"y":null,"rotation":null,"color":null,"fontFamily":null,"fontSize":null,"fontWeight":null,"italic":null,"underline":null,"align":null,"value":"[]","keyVisible":null,"valueVisible":null,"key":"Relevance","fillColor":null,"parentId":"fc72a22167fc4941","zIndex":0}|
{"type":"ATTR","ticket":1025,"id":"3b080d899773a35f"}||{"x":255,"y":-910,"rotation":90,"color":null,"fontFamily":null,"fontSize":null,"fontWeight":null,"italic":null,"underline":null,"align":"CENTER_MIDDLE","value":"AGND","keyVisible":null,"valueVisible":true,"key":"Name","fillColor":null,"parentId":"fc72a22167fc4941","zIndex":3,"locked":false}|
{"type":"ATTR","ticket":1026,"id":"997766c24e8c2ba6"}||{"x":255,"y":-910,"rotation":90,"color":null,"fontFamily":null,"fontSize":null,"fontWeight":null,"italic":null,"underline":null,"align":"CENTER_MIDDLE","value":"AGND","keyVisible":null,"valueVisible":null,"key":"Global Net Name","fillColor":null,"parentId":"fc72a22167fc4941","zIndex":17}|
{"type":"ATTR","ticket":1027,"id":"47743f45d0967f84"}||{"x":null,"y":null,"rotation":null,"color":null,"fontFamily":null,"fontSize":null,"fontWeight":null,"italic":null,"underline":null,"align":null,"value":null,"keyVisible":null,"valueVisible":null,"key":"Description","fillColor":null,"parentId":"fc72a22167fc4941","zIndex":19}|
{"type":"ATTR","ticket":1028,"id":"2e1f0891e19f55a9"}||{"x":null,"y":null,"rotation":null,"color":null,"fontFamily":null,"fontSize":null,"fontWeight":null,"italic":null,"underline":null,"align":null,"value":null,"keyVisible":null,"valueVisible":null,"key":"3D Model","fillColor":null,"parentId":"fc72a22167fc4941","zIndex":20}|
{"type":"ATTR","ticket":1029,"id":"200f48677a6e0b4c"}||{"x":null,"y":null,"rotation":null,"color":null,"fontFamily":null,"fontSize":null,"fontWeight":null,"italic":null,"underline":null,"align":null,"value":null,"keyVisible":null,"valueVisible":null,"key":"3D Model Title","fillColor":null,"parentId":"fc72a22167fc4941","zIndex":21}|
{"type":"ATTR","ticket":1030,"id":"6a7d59ffbf9b7a60"}||{"x":null,"y":null,"rotation":null,"color":null,"fontFamily":null,"fontSize":null,"fontWeight":null,"italic":null,"underline":null,"align":null,"value":null,"keyVisible":null,"valueVisible":null,"key":"3D Model Transform","fillColor":null,"parentId":"fc72a22167fc4941","zIndex":22}|
{"type":"COMPONENT","ticket":1031,"id":"790f1213e41763df"}||{"partId":"pid8a0e77bacb214e","x":560,"y":-1130,"rotation":270,"isMirror":false,"attrs":{"Footprints":"[]","Devices":"[]","DeviceName":"{\"uuid\":\"3f13421398586a3b\",\"name\":\"Ground-GND\",\"source\":\"\"}"},"zIndex":1029}|
{"type":"ATTR","ticket":1032,"id":"26e0b12224c18d87"}||{"x":530,"y":-1130,"rotation":90,"color":null,"fontFamily":null,"fontSize":10,"fontWeight":null,"italic":null,"underline":null,"align":"RIGHT_TOP","value":"43a94a86e84eab37","keyVisible":null,"valueVisible":null,"key":"Symbol","fillColor":null,"parentId":"790f1213e41763df","zIndex":1,"locked":false}|
{"type":"ATTR","ticket":1033,"id":"3066996dd18dead5"}||{"x":null,"y":null,"rotation":null,"color":null,"fontFamily":null,"fontSize":null,"fontWeight":null,"italic":null,"underline":null,"align":null,"value":"3f13421398586a3b","keyVisible":null,"valueVisible":null,"key":"Device","fillColor":null,"parentId":"790f1213e41763df","zIndex":18}|
{"type":"ATTR","ticket":1034,"id":"5377064fbf0b2a2d"}||{"x":null,"y":null,"rotation":null,"color":null,"fontFamily":null,"fontSize":null,"fontWeight":null,"italic":null,"underline":null,"align":null,"value":"[]","keyVisible":null,"valueVisible":null,"key":"Relevance","fillColor":null,"parentId":"790f1213e41763df","zIndex":0}|
{"type":"ATTR","ticket":1035,"id":"1755e0388656c6a1"}||{"x":535,"y":-1130,"rotation":90,"color":null,"fontFamily":null,"fontSize":null,"fontWeight":null,"italic":null,"underline":null,"align":"CENTER_MIDDLE","value":"AGND","keyVisible":null,"valueVisible":true,"key":"Name","fillColor":null,"parentId":"790f1213e41763df","zIndex":3,"locked":false}|
{"type":"ATTR","ticket":1036,"id":"2458de18c46f23d2"}||{"x":535,"y":-1130,"rotation":90,"color":null,"fontFamily":null,"fontSize":null,"fontWeight":null,"italic":null,"underline":null,"align":"CENTER_MIDDLE","value":"AGND","keyVisible":null,"valueVisible":null,"key":"Global Net Name","fillColor":null,"parentId":"790f1213e41763df","zIndex":17}|
{"type":"ATTR","ticket":1037,"id":"1e74bcc81ff56aef"}||{"x":null,"y":null,"rotation":null,"color":null,"fontFamily":null,"fontSize":null,"fontWeight":null,"italic":null,"underline":null,"align":null,"value":null,"keyVisible":null,"valueVisible":null,"key":"Description","fillColor":null,"parentId":"790f1213e41763df","zIndex":19}|
{"type":"ATTR","ticket":1038,"id":"216a893e23330256"}||{"x":null,"y":null,"rotation":null,"color":null,"fontFamily":null,"fontSize":null,"fontWeight":null,"italic":null,"underline":null,"align":null,"value":null,"keyVisible":null,"valueVisible":null,"key":"3D Model","fillColor":null,"parentId":"790f1213e41763df","zIndex":20}|
{"type":"ATTR","ticket":1039,"id":"db1b71842185d52c"}||{"x":null,"y":null,"rotation":null,"color":null,"fontFamily":null,"fontSize":null,"fontWeight":null,"italic":null,"underline":null,"align":null,"value":null,"keyVisible":null,"valueVisible":null,"key":"3D Model Title","fillColor":null,"parentId":"790f1213e41763df","zIndex":21}|
{"type":"ATTR","ticket":1040,"id":"a78e2ba2f247dc25"}||{"x":null,"y":null,"rotation":null,"color":null,"fontFamily":null,"fontSize":null,"fontWeight":null,"italic":null,"underline":null,"align":null,"value":null,"keyVisible":null,"valueVisible":null,"key":"3D Model Transform","fillColor":null,"parentId":"790f1213e41763df","zIndex":22}|
{"type":"COMPONENT","ticket":1041,"id":"f973bec9582b16e2"}||{"partId":"pid8a0e77bacb214e","x":1980,"y":-910,"rotation":270,"isMirror":false,"attrs":{"Footprints":"[]","Devices":"[]","DeviceName":"{\"uuid\":\"3f13421398586a3b\",\"name\":\"Ground-GND\",\"source\":\"\"}"},"zIndex":1030}|
{"type":"ATTR","ticket":1042,"id":"0d4fd9eb381c1b2d"}||{"x":1950,"y":-909.9999999999998,"rotation":90,"color":null,"fontFamily":null,"fontSize":10,"fontWeight":null,"italic":null,"underline":null,"align":"RIGHT_TOP","value":"43a94a86e84eab37","keyVisible":null,"valueVisible":null,"key":"Symbol","fillColor":null,"parentId":"f973bec9582b16e2","zIndex":1,"locked":false}|
{"type":"ATTR","ticket":1043,"id":"01bb9db63002ca44"}||{"x":null,"y":null,"rotation":null,"color":null,"fontFamily":null,"fontSize":null,"fontWeight":null,"italic":null,"underline":null,"align":null,"value":"3f13421398586a3b","keyVisible":null,"valueVisible":null,"key":"Device","fillColor":null,"parentId":"f973bec9582b16e2","zIndex":18}|
{"type":"ATTR","ticket":1044,"id":"841d8bda592cd07b"}||{"x":null,"y":null,"rotation":null,"color":null,"fontFamily":null,"fontSize":null,"fontWeight":null,"italic":null,"underline":null,"align":null,"value":"[]","keyVisible":null,"valueVisible":null,"key":"Relevance","fillColor":null,"parentId":"f973bec9582b16e2","zIndex":0}|
{"type":"ATTR","ticket":1045,"id":"12608db6a9c9235a"}||{"x":1955,"y":-909.9999999999998,"rotation":90,"color":null,"fontFamily":null,"fontSize":null,"fontWeight":null,"italic":null,"underline":null,"align":"CENTER_MIDDLE","value":"AGND","keyVisible":null,"valueVisible":true,"key":"Name","fillColor":null,"parentId":"f973bec9582b16e2","zIndex":3,"locked":false}|
{"type":"ATTR","ticket":1046,"id":"c7d4de3cf4b9d4a0"}||{"x":1955,"y":-909.9999999999998,"rotation":90,"color":null,"fontFamily":null,"fontSize":null,"fontWeight":null,"italic":null,"underline":null,"align":"CENTER_MIDDLE","value":"AGND","keyVisible":null,"valueVisible":null,"key":"Global Net Name","fillColor":null,"parentId":"f973bec9582b16e2","zIndex":17}|
{"type":"ATTR","ticket":1047,"id":"e8a5240ae3dbe9ba"}||{"x":null,"y":null,"rotation":null,"color":null,"fontFamily":null,"fontSize":null,"fontWeight":null,"italic":null,"underline":null,"align":null,"value":null,"keyVisible":null,"valueVisible":null,"key":"Description","fillColor":null,"parentId":"f973bec9582b16e2","zIndex":19}|
{"type":"ATTR","ticket":1048,"id":"6a48bab908c7b228"}||{"x":null,"y":null,"rotation":null,"color":null,"fontFamily":null,"fontSize":null,"fontWeight":null,"italic":null,"underline":null,"align":null,"value":null,"keyVisible":null,"valueVisible":null,"key":"3D Model","fillColor":null,"parentId":"f973bec9582b16e2","zIndex":20}|
{"type":"ATTR","ticket":1049,"id":"356fb4e170530d8f"}||{"x":null,"y":null,"rotation":null,"color":null,"fontFamily":null,"fontSize":null,"fontWeight":null,"italic":null,"underline":null,"align":null,"value":null,"keyVisible":null,"valueVisible":null,"key":"3D Model Title","fillColor":null,"parentId":"f973bec9582b16e2","zIndex":21}|
{"type":"ATTR","ticket":1050,"id":"12938bce8c6bb06f"}||{"x":null,"y":null,"rotation":null,"color":null,"fontFamily":null,"fontSize":null,"fontWeight":null,"italic":null,"underline":null,"align":null,"value":null,"keyVisible":null,"valueVisible":null,"key":"3D Model Transform","fillColor":null,"parentId":"f973bec9582b16e2","zIndex":22}|
{"type":"COMPONENT","ticket":1051,"id":"56330b6c12fc2de0"}||{"partId":"pid8a0e77bacb214e","x":2140,"y":-1290,"rotation":270,"isMirror":false,"attrs":{"Footprints":"[]","Devices":"[]","DeviceName":"{\"uuid\":\"3f13421398586a3b\",\"name\":\"Ground-GND\",\"source\":\"\"}"},"zIndex":1031}|
{"type":"ATTR","ticket":1052,"id":"403bb4217801d1d2"}||{"x":2110,"y":-1290,"rotation":90,"color":null,"fontFamily":null,"fontSize":10,"fontWeight":null,"italic":null,"underline":null,"align":"RIGHT_TOP","value":"43a94a86e84eab37","keyVisible":null,"valueVisible":null,"key":"Symbol","fillColor":null,"parentId":"56330b6c12fc2de0","zIndex":1,"locked":false}|
{"type":"ATTR","ticket":1053,"id":"f0daaf05808c3330"}||{"x":null,"y":null,"rotation":null,"color":null,"fontFamily":null,"fontSize":null,"fontWeight":null,"italic":null,"underline":null,"align":null,"value":"3f13421398586a3b","keyVisible":null,"valueVisible":null,"key":"Device","fillColor":null,"parentId":"56330b6c12fc2de0","zIndex":18}|
{"type":"ATTR","ticket":1054,"id":"11496643f5e329e6"}||{"x":null,"y":null,"rotation":null,"color":null,"fontFamily":null,"fontSize":null,"fontWeight":null,"italic":null,"underline":null,"align":null,"value":"[]","keyVisible":null,"valueVisible":null,"key":"Relevance","fillColor":null,"parentId":"56330b6c12fc2de0","zIndex":0}|
{"type":"ATTR","ticket":1055,"id":"7fe4b700b9fb2457"}||{"x":2115,"y":-1290,"rotation":90,"color":null,"fontFamily":null,"fontSize":null,"fontWeight":null,"italic":null,"underline":null,"align":"CENTER_MIDDLE","value":"AGND","keyVisible":null,"valueVisible":true,"key":"Name","fillColor":null,"parentId":"56330b6c12fc2de0","zIndex":3,"locked":false}|
{"type":"ATTR","ticket":1056,"id":"e6b33b6e066844d1"}||{"x":2115,"y":-1290,"rotation":90,"color":null,"fontFamily":null,"fontSize":null,"fontWeight":null,"italic":null,"underline":null,"align":"CENTER_MIDDLE","value":"AGND","keyVisible":null,"valueVisible":null,"key":"Global Net Name","fillColor":null,"parentId":"56330b6c12fc2de0","zIndex":17}|
{"type":"ATTR","ticket":1057,"id":"b9c3178aea98478d"}||{"x":null,"y":null,"rotation":null,"color":null,"fontFamily":null,"fontSize":null,"fontWeight":null,"italic":null,"underline":null,"align":null,"value":null,"keyVisible":null,"valueVisible":null,"key":"Description","fillColor":null,"parentId":"56330b6c12fc2de0","zIndex":19}|
{"type":"ATTR","ticket":1058,"id":"f0f15e8a41606f27"}||{"x":null,"y":null,"rotation":null,"color":null,"fontFamily":null,"fontSize":null,"fontWeight":null,"italic":null,"underline":null,"align":null,"value":null,"keyVisible":null,"valueVisible":null,"key":"3D Model","fillColor":null,"parentId":"56330b6c12fc2de0","zIndex":20}|
{"type":"ATTR","ticket":1059,"id":"92a1fd43b5de51cb"}||{"x":null,"y":null,"rotation":null,"color":null,"fontFamily":null,"fontSize":null,"fontWeight":null,"italic":null,"underline":null,"align":null,"value":null,"keyVisible":null,"valueVisible":null,"key":"3D Model Title","fillColor":null,"parentId":"56330b6c12fc2de0","zIndex":21}|
{"type":"ATTR","ticket":1060,"id":"bc3101d2cc5dc8cc"}||{"x":null,"y":null,"rotation":null,"color":null,"fontFamily":null,"fontSize":null,"fontWeight":null,"italic":null,"underline":null,"align":null,"value":null,"keyVisible":null,"valueVisible":null,"key":"3D Model Transform","fillColor":null,"parentId":"56330b6c12fc2de0","zIndex":22}|
{"type":"COMPONENT","ticket":1061,"id":"270aaf4d88d5aa21"}||{"partId":"pid8a0e77bacb214e","x":180,"y":-1440,"rotation":90,"isMirror":false,"attrs":{"Footprints":"[]","Devices":"[]","DeviceName":"{\"uuid\":\"411b21fb2b24b541\",\"name\":\"Power-5V\",\"source\":\"\"}"},"zIndex":1035}|
{"type":"ATTR","ticket":1062,"id":"a9c3cc5493d5c27e"}||{"x":210,"y":-1440,"rotation":90,"color":null,"fontFamily":null,"fontSize":null,"fontWeight":null,"italic":null,"underline":null,"align":null,"value":"dacfcbf66ef48611","keyVisible":null,"valueVisible":null,"key":"Symbol","fillColor":null,"parentId":"270aaf4d88d5aa21","zIndex":1,"locked":false}|
{"type":"ATTR","ticket":1063,"id":"178969539fffb9cc"}||{"x":null,"y":null,"rotation":null,"color":null,"fontFamily":null,"fontSize":null,"fontWeight":null,"italic":null,"underline":null,"align":null,"value":"411b21fb2b24b541","keyVisible":null,"valueVisible":null,"key":"Device","fillColor":null,"parentId":"270aaf4d88d5aa21","zIndex":12}|
{"type":"ATTR","ticket":1064,"id":"5fe04e67d85321c9"}||{"x":null,"y":null,"rotation":null,"color":null,"fontFamily":null,"fontSize":null,"fontWeight":null,"italic":null,"underline":null,"align":null,"value":"[]","keyVisible":null,"valueVisible":null,"key":"Relevance","fillColor":null,"parentId":"270aaf4d88d5aa21","zIndex":0}|
{"type":"ATTR","ticket":1065,"id":"f97f7f94d8501b51"}||{"x":170,"y":-1440,"rotation":90,"color":null,"fontFamily":null,"fontSize":null,"fontWeight":null,"italic":null,"underline":null,"align":"CENTER_BOTTOM","value":"+5V_A","keyVisible":null,"valueVisible":null,"key":"Name","fillColor":null,"parentId":"270aaf4d88d5aa21","zIndex":9}|
{"type":"ATTR","ticket":1066,"id":"dce737d271b0902e"}||{"x":170,"y":-1440,"rotation":90,"color":null,"fontFamily":null,"fontSize":null,"fontWeight":null,"italic":null,"underline":null,"align":"CENTER_BOTTOM","value":"+5V_A","keyVisible":null,"valueVisible":null,"key":"Global Net Name","fillColor":null,"parentId":"270aaf4d88d5aa21","zIndex":11}|
{"type":"ATTR","ticket":1067,"id":"196ae6ef5b6f0c75"}||{"x":null,"y":null,"rotation":null,"color":null,"fontFamily":null,"fontSize":null,"fontWeight":null,"italic":null,"underline":null,"align":null,"value":null,"keyVisible":null,"valueVisible":null,"key":"Description","fillColor":null,"parentId":"270aaf4d88d5aa21","zIndex":13}|
{"type":"ATTR","ticket":1068,"id":"fea0fd5b8b5c3940"}||{"x":null,"y":null,"rotation":null,"color":null,"fontFamily":null,"fontSize":null,"fontWeight":null,"italic":null,"underline":null,"align":null,"value":null,"keyVisible":null,"valueVisible":null,"key":"3D Model","fillColor":null,"parentId":"270aaf4d88d5aa21","zIndex":14}|
{"type":"ATTR","ticket":1069,"id":"2567b3aa1820d5a4"}||{"x":null,"y":null,"rotation":null,"color":null,"fontFamily":null,"fontSize":null,"fontWeight":null,"italic":null,"underline":null,"align":null,"value":null,"keyVisible":null,"valueVisible":null,"key":"3D Model Title","fillColor":null,"parentId":"270aaf4d88d5aa21","zIndex":15}|
{"type":"ATTR","ticket":1070,"id":"b5364ee4cf099a5b"}||{"x":null,"y":null,"rotation":null,"color":null,"fontFamily":null,"fontSize":null,"fontWeight":null,"italic":null,"underline":null,"align":null,"value":null,"keyVisible":null,"valueVisible":null,"key":"3D Model Transform","fillColor":null,"parentId":"270aaf4d88d5aa21","zIndex":16}|
{"type":"COMPONENT","ticket":1071,"id":"db68975cde6a35fa"}||{"partId":"pid8a0e77bacb214e","x":200,"y":-1020,"rotation":90,"isMirror":false,"attrs":{"Footprints":"[]","Devices":"[]","DeviceName":"{\"uuid\":\"411b21fb2b24b541\",\"name\":\"Power-5V\",\"source\":\"\"}"},"zIndex":1036}|
{"type":"ATTR","ticket":1072,"id":"352de95ba2117ecd"}||{"x":230,"y":-1020,"rotation":90,"color":null,"fontFamily":null,"fontSize":null,"fontWeight":null,"italic":null,"underline":null,"align":null,"value":"dacfcbf66ef48611","keyVisible":null,"valueVisible":null,"key":"Symbol","fillColor":null,"parentId":"db68975cde6a35fa","zIndex":1,"locked":false}|
{"type":"ATTR","ticket":1073,"id":"e781f6c6a0f48321"}||{"x":null,"y":null,"rotation":null,"color":null,"fontFamily":null,"fontSize":null,"fontWeight":null,"italic":null,"underline":null,"align":null,"value":"411b21fb2b24b541","keyVisible":null,"valueVisible":null,"key":"Device","fillColor":null,"parentId":"db68975cde6a35fa","zIndex":12}|
{"type":"ATTR","ticket":1074,"id":"8c6c9971b27c2fe1"}||{"x":null,"y":null,"rotation":null,"color":null,"fontFamily":null,"fontSize":null,"fontWeight":null,"italic":null,"underline":null,"align":null,"value":"[]","keyVisible":null,"valueVisible":null,"key":"Relevance","fillColor":null,"parentId":"db68975cde6a35fa","zIndex":0}|
{"type":"ATTR","ticket":1075,"id":"df430b03084d3f6f"}||{"x":190,"y":-1020,"rotation":90,"color":null,"fontFamily":null,"fontSize":null,"fontWeight":null,"italic":null,"underline":null,"align":"CENTER_BOTTOM","value":"+5V_A","keyVisible":null,"valueVisible":null,"key":"Name","fillColor":null,"parentId":"db68975cde6a35fa","zIndex":9}|
{"type":"ATTR","ticket":1076,"id":"9803d7e5d153ead0"}||{"x":190,"y":-1020,"rotation":90,"color":null,"fontFamily":null,"fontSize":null,"fontWeight":null,"italic":null,"underline":null,"align":"CENTER_BOTTOM","value":"+5V_A","keyVisible":null,"valueVisible":null,"key":"Global Net Name","fillColor":null,"parentId":"db68975cde6a35fa","zIndex":11}|
{"type":"ATTR","ticket":1077,"id":"73df0f01ffd83038"}||{"x":null,"y":null,"rotation":null,"color":null,"fontFamily":null,"fontSize":null,"fontWeight":null,"italic":null,"underline":null,"align":null,"value":null,"keyVisible":null,"valueVisible":null,"key":"Description","fillColor":null,"parentId":"db68975cde6a35fa","zIndex":13}|
{"type":"ATTR","ticket":1078,"id":"6147ae6bea8ff50c"}||{"x":null,"y":null,"rotation":null,"color":null,"fontFamily":null,"fontSize":null,"fontWeight":null,"italic":null,"underline":null,"align":null,"value":null,"keyVisible":null,"valueVisible":null,"key":"3D Model","fillColor":null,"parentId":"db68975cde6a35fa","zIndex":14}|
{"type":"ATTR","ticket":1079,"id":"ee32892a748e57d8"}||{"x":null,"y":null,"rotation":null,"color":null,"fontFamily":null,"fontSize":null,"fontWeight":null,"italic":null,"underline":null,"align":null,"value":null,"keyVisible":null,"valueVisible":null,"key":"3D Model Title","fillColor":null,"parentId":"db68975cde6a35fa","zIndex":15}|
{"type":"ATTR","ticket":1080,"id":"374255a49b6ff5b4"}||{"x":null,"y":null,"rotation":null,"color":null,"fontFamily":null,"fontSize":null,"fontWeight":null,"italic":null,"underline":null,"align":null,"value":null,"keyVisible":null,"valueVisible":null,"key":"3D Model Transform","fillColor":null,"parentId":"db68975cde6a35fa","zIndex":16}|
{"type":"COMPONENT","ticket":1081,"id":"1f68bb14777a2b59"}||{"partId":"pid8a0e77bacb214e","x":2640,"y":-1050,"rotation":0,"isMirror":false,"attrs":{"Footprints":"[]","Devices":"[]","DeviceName":"{\"uuid\":\"9a0caec64994524d\",\"name\":\"Netport-BI\",\"source\":\"\"}"},"zIndex":1080.2999999999997}|
{"type":"ATTR","ticket":1082,"id":"a44f022ea11610a1"}||{"x":2640,"y":-1020,"rotation":0,"color":null,"fontFamily":null,"fontSize":null,"fontWeight":null,"italic":null,"underline":null,"align":null,"value":"64daaa7d5c6d4170","keyVisible":null,"valueVisible":null,"key":"Symbol","fillColor":null,"parentId":"1f68bb14777a2b59","zIndex":1,"locked":false}|
{"type":"ATTR","ticket":1083,"id":"456d763a3baa636a"}||{"x":null,"y":null,"rotation":null,"color":null,"fontFamily":null,"fontSize":null,"fontWeight":null,"italic":null,"underline":null,"align":null,"value":"9a0caec64994524d","keyVisible":null,"valueVisible":null,"key":"Device","fillColor":null,"parentId":"1f68bb14777a2b59","zIndex":11}|
{"type":"ATTR","ticket":1084,"id":"9767b149bc026302"}||{"x":2685,"y":-1050,"rotation":0,"color":null,"fontFamily":null,"fontSize":null,"fontWeight":null,"italic":null,"underline":null,"align":"LEFT_MIDDLE","value":"AFE_ADC_IN","keyVisible":null,"valueVisible":true,"key":"Name","fillColor":null,"parentId":"1f68bb14777a2b59","zIndex":2,"locked":false}|
{"type":"ATTR","ticket":1085,"id":"107b993d788351e2"}||{"x":null,"y":null,"rotation":null,"color":null,"fontFamily":null,"fontSize":null,"fontWeight":null,"italic":null,"underline":null,"align":null,"value":null,"keyVisible":null,"valueVisible":null,"key":"Description","fillColor":null,"parentId":"1f68bb14777a2b59","zIndex":12}|
{"type":"WIRE","ticket":1086,"id":"9e49369deeea5d57"}||{"zIndex":1086.2999999999997}|
{"type":"LINE","ticket":1087,"id":"fe0f28d09ab068ce"}||{"fillColor":null,"fillStyle":null,"strokeColor":null,"strokeStyle":null,"strokeWidth":null,"startX":520,"startY":-1050,"endX":415,"endY":-1050,"lineGroup":"9e49369deeea5d57"}|
{"type":"ATTR","ticket":1088,"id":"c7fc7155df725bc5"}||{"x":467.5,"y":-1050,"rotation":null,"color":null,"fontFamily":null,"fontSize":null,"fontWeight":null,"italic":null,"underline":null,"align":null,"value":"","keyVisible":false,"valueVisible":true,"key":"NET","fillColor":null,"parentId":"9e49369deeea5d57","zIndex":2}|
{"type":"ATTR","ticket":1089,"id":"d9cbaf5912c431db"}||{"x":null,"y":null,"rotation":null,"color":null,"fontFamily":null,"fontSize":null,"fontWeight":null,"italic":null,"underline":null,"align":null,"value":"[]","keyVisible":null,"valueVisible":null,"key":"Relevance","fillColor":null,"parentId":"9e49369deeea5d57","zIndex":0}|
{"type":"WIRE","ticket":1090,"id":"a737e912c20536f8"}||{"zIndex":1092.2999999999997}|
{"type":"LINE","ticket":1091,"id":"f41260429131e16d"}||{"fillColor":null,"fillStyle":null,"strokeColor":null,"strokeStyle":null,"strokeWidth":null,"startX":1000,"startY":-1050,"endX":920,"endY":-1050,"lineGroup":"a737e912c20536f8"}|
{"type":"ATTR","ticket":1092,"id":"a290da70f0bdb142"}||{"x":960,"y":-1050,"rotation":null,"color":null,"fontFamily":null,"fontSize":null,"fontWeight":null,"italic":null,"underline":null,"align":null,"value":"","keyVisible":false,"valueVisible":true,"key":"NET","fillColor":null,"parentId":"a737e912c20536f8","zIndex":2}|
{"type":"ATTR","ticket":1093,"id":"5b277dd6c5739c06"}||{"x":null,"y":null,"rotation":null,"color":null,"fontFamily":null,"fontSize":null,"fontWeight":null,"italic":null,"underline":null,"align":null,"value":"[]","keyVisible":null,"valueVisible":null,"key":"Relevance","fillColor":null,"parentId":"a737e912c20536f8","zIndex":0}|
{"type":"WIRE","ticket":1094,"id":"e34be16ed54c7dfd"}||{"zIndex":1093.2999999999997}|
{"type":"LINE","ticket":1095,"id":"1ace9534b98769ab"}||{"fillColor":null,"fillStyle":null,"strokeColor":null,"strokeStyle":null,"strokeWidth":null,"startX":1240,"startY":-1050,"endX":1140,"endY":-1050,"lineGroup":"e34be16ed54c7dfd"}|
{"type":"ATTR","ticket":1096,"id":"bc3bc3da840eecd1"}||{"x":null,"y":null,"rotation":null,"color":null,"fontFamily":null,"fontSize":null,"fontWeight":null,"italic":null,"underline":null,"align":null,"value":"[]","keyVisible":null,"valueVisible":null,"key":"Relevance","fillColor":null,"parentId":"e34be16ed54c7dfd","zIndex":4}|
{"type":"LINE","ticket":1097,"id":"d14a3eff4bc3a2e8"}||{"fillColor":null,"fillStyle":null,"strokeColor":null,"strokeStyle":null,"strokeWidth":null,"startX":1140,"startY":-970,"endX":1140,"endY":-1050,"lineGroup":"e34be16ed54c7dfd"}|
{"type":"LINE","ticket":1098,"id":"83ca1140fac05fd3"}||{"fillColor":null,"fillStyle":null,"strokeColor":null,"strokeStyle":null,"strokeWidth":null,"startX":1140,"startY":-1050,"endX":1040,"endY":-1050,"lineGroup":"e34be16ed54c7dfd"}|
{"type":"ATTR","ticket":1099,"id":"28d2e7300c9c6bc5"}||{"x":1140,"y":-1010,"rotation":90,"color":null,"fontFamily":null,"fontSize":null,"fontWeight":null,"italic":null,"underline":null,"align":null,"value":"","keyVisible":false,"valueVisible":true,"key":"NET","fillColor":null,"parentId":"e34be16ed54c7dfd","zIndex":5}|
{"type":"WIRE","ticket":1100,"id":"8fa3959004f00fdd"}||{"zIndex":1095.2999999999997}|
{"type":"LINE","ticket":1101,"id":"9ba0f6f136c7ed27"}||{"fillColor":null,"fillStyle":null,"strokeColor":null,"strokeStyle":null,"strokeWidth":null,"startX":1480,"startY":-1050,"endX":1380,"endY":-1050,"lineGroup":"8fa3959004f00fdd"}|
{"type":"ATTR","ticket":1102,"id":"faf3f6eeb467130e"}||{"x":null,"y":null,"rotation":null,"color":null,"fontFamily":null,"fontSize":null,"fontWeight":null,"italic":null,"underline":null,"align":null,"value":"[]","keyVisible":null,"valueVisible":null,"key":"Relevance","fillColor":null,"parentId":"8fa3959004f00fdd","zIndex":4}|
{"type":"LINE","ticket":1103,"id":"0a71d23a216a8e79"}||{"fillColor":null,"fillStyle":null,"strokeColor":null,"strokeStyle":null,"strokeWidth":null,"startX":1380,"startY":-970,"endX":1380,"endY":-1050,"lineGroup":"8fa3959004f00fdd"}|
{"type":"LINE","ticket":1104,"id":"30aa3a651e85155a"}||{"fillColor":null,"fillStyle":null,"strokeColor":null,"strokeStyle":null,"strokeWidth":null,"startX":1380,"startY":-1050,"endX":1280,"endY":-1050,"lineGroup":"8fa3959004f00fdd"}|
{"type":"ATTR","ticket":1105,"id":"4dc7bfa502301a4a"}||{"x":1380,"y":-1010,"rotation":90,"color":null,"fontFamily":null,"fontSize":null,"fontWeight":null,"italic":null,"underline":null,"align":null,"value":"","keyVisible":false,"valueVisible":true,"key":"NET","fillColor":null,"parentId":"8fa3959004f00fdd","zIndex":5}|
{"type":"WIRE","ticket":1106,"id":"9f82bbc1d0d84ee4"}||{"zIndex":1097.2999999999997}|
{"type":"LINE","ticket":1107,"id":"56435daecd7d8772"}||{"fillColor":null,"fillStyle":null,"strokeColor":null,"strokeStyle":null,"strokeWidth":null,"startX":1720,"startY":-1050,"endX":1620,"endY":-1050,"lineGroup":"9f82bbc1d0d84ee4"}|
{"type":"ATTR","ticket":1108,"id":"fe2ed64264850ee7"}||{"x":null,"y":null,"rotation":null,"color":null,"fontFamily":null,"fontSize":null,"fontWeight":null,"italic":null,"underline":null,"align":null,"value":"[]","keyVisible":null,"valueVisible":null,"key":"Relevance","fillColor":null,"parentId":"9f82bbc1d0d84ee4","zIndex":4}|
{"type":"LINE","ticket":1109,"id":"262d94b0f03e2325"}||{"fillColor":null,"fillStyle":null,"strokeColor":null,"strokeStyle":null,"strokeWidth":null,"startX":1620,"startY":-970,"endX":1620,"endY":-1050,"lineGroup":"9f82bbc1d0d84ee4"}|
{"type":"LINE","ticket":1110,"id":"a74648abc91d7bf8"}||{"fillColor":null,"fillStyle":null,"strokeColor":null,"strokeStyle":null,"strokeWidth":null,"startX":1620,"startY":-1050,"endX":1520,"endY":-1050,"lineGroup":"9f82bbc1d0d84ee4"}|
{"type":"ATTR","ticket":1111,"id":"9348f789d7f28ed4"}||{"x":1620,"y":-1010,"rotation":90,"color":null,"fontFamily":null,"fontSize":null,"fontWeight":null,"italic":null,"underline":null,"align":null,"value":"","keyVisible":false,"valueVisible":true,"key":"NET","fillColor":null,"parentId":"9f82bbc1d0d84ee4","zIndex":5}|
{"type":"WIRE","ticket":1112,"id":"e2cfeb23b8b1a88f"}||{"zIndex":1099.2999999999997}|
{"type":"LINE","ticket":1113,"id":"32d4d5705f815c94"}||{"fillColor":null,"fillStyle":null,"strokeColor":null,"strokeStyle":null,"strokeWidth":null,"startX":2085,"startY":-1050,"endX":1980,"endY":-1050,"lineGroup":"e2cfeb23b8b1a88f"}|
{"type":"ATTR","ticket":1114,"id":"d5074abb0e792303"}||{"x":null,"y":null,"rotation":null,"color":null,"fontFamily":null,"fontSize":null,"fontWeight":null,"italic":null,"underline":null,"align":null,"value":"[]","keyVisible":null,"valueVisible":null,"key":"Relevance","fillColor":null,"parentId":"e2cfeb23b8b1a88f","zIndex":10}|
{"type":"LINE","ticket":1115,"id":"9e70d36c74ca588d"}||{"fillColor":null,"fillStyle":null,"strokeColor":null,"strokeStyle":null,"strokeWidth":null,"startX":1980,"startY":-970,"endX":1980,"endY":-1050,"lineGroup":"e2cfeb23b8b1a88f"}|
{"type":"LINE","ticket":1116,"id":"6f94c3c91f9babd5"}||{"fillColor":null,"fillStyle":null,"strokeColor":null,"strokeStyle":null,"strokeWidth":null,"startX":1860,"startY":-1050,"endX":1980,"endY":-1050,"lineGroup":"e2cfeb23b8b1a88f"}|
{"type":"LINE","ticket":1117,"id":"bd82ca7eecd899c1"}||{"fillColor":null,"fillStyle":null,"strokeColor":null,"strokeStyle":null,"strokeWidth":null,"startX":1860,"startY":-970,"endX":1860,"endY":-1050,"lineGroup":"e2cfeb23b8b1a88f"}|
{"type":"LINE","ticket":1118,"id":"9602f7ed5e0795e9"}||{"fillColor":null,"fillStyle":null,"strokeColor":null,"strokeStyle":null,"strokeWidth":null,"startX":1860,"startY":-1050,"endX":1840,"endY":-1050,"lineGroup":"e2cfeb23b8b1a88f"}|
{"type":"LINE","ticket":1119,"id":"5bf00c5b7042c5ba"}||{"fillColor":null,"fillStyle":null,"strokeColor":null,"strokeStyle":null,"strokeWidth":null,"startX":1840,"startY":-1050,"endX":1840,"endY":-850,"lineGroup":"e2cfeb23b8b1a88f"}|
{"type":"LINE","ticket":1120,"id":"5901b3839d3c25cb"}||{"fillColor":null,"fillStyle":null,"strokeColor":null,"strokeStyle":null,"strokeWidth":null,"startX":1840,"startY":-1050,"endX":1760,"endY":-1050,"lineGroup":"e2cfeb23b8b1a88f"}|
{"type":"ATTR","ticket":1121,"id":"c4cad1479197ac54"}||{"x":1840,"y":-950,"rotation":90,"color":null,"fontFamily":null,"fontSize":null,"fontWeight":null,"italic":null,"underline":null,"align":null,"value":"","keyVisible":false,"valueVisible":true,"key":"NET","fillColor":null,"parentId":"e2cfeb23b8b1a88f","zIndex":11}|
{"type":"WIRE","ticket":1122,"id":"c3b36016bcb5a5da"}||{"zIndex":1103.2999999999997}|
{"type":"LINE","ticket":1123,"id":"c7c44213a95d4cda"}||{"fillColor":null,"fillStyle":null,"strokeColor":null,"strokeStyle":null,"strokeWidth":null,"startX":2260,"startY":-1040,"endX":2260,"endY":-1050,"lineGroup":"c3b36016bcb5a5da"}|
{"type":"LINE","ticket":1124,"id":"c40d0227a82bfc12"}||{"fillColor":null,"fillStyle":null,"strokeColor":null,"strokeStyle":null,"strokeWidth":null,"startX":2260,"startY":-1050,"endX":2240,"endY":-1050,"lineGroup":"c3b36016bcb5a5da"}|
{"type":"ATTR","ticket":1125,"id":"eada9380b7c5bcd5"}||{"x":null,"y":null,"rotation":null,"color":null,"fontFamily":null,"fontSize":null,"fontWeight":null,"italic":null,"underline":null,"align":null,"value":"[]","keyVisible":null,"valueVisible":null,"key":"Relevance","fillColor":null,"parentId":"c3b36016bcb5a5da","zIndex":5}|
{"type":"LINE","ticket":1126,"id":"5a1b715daa6d5fd9"}||{"fillColor":null,"fillStyle":null,"strokeColor":null,"strokeStyle":null,"strokeWidth":null,"startX":2240,"startY":-970,"endX":2240,"endY":-1050,"lineGroup":"c3b36016bcb5a5da"}|
{"type":"LINE","ticket":1127,"id":"108f56481dbd279b"}||{"fillColor":null,"fillStyle":null,"strokeColor":null,"strokeStyle":null,"strokeWidth":null,"startX":2240,"startY":-1050,"endX":2115,"endY":-1050,"lineGroup":"c3b36016bcb5a5da"}|
{"type":"ATTR","ticket":1128,"id":"ed6b4deba1588b88"}||{"x":2240,"y":-1010,"rotation":90,"color":null,"fontFamily":null,"fontSize":null,"fontWeight":null,"italic":null,"underline":null,"align":null,"value":"","keyVisible":false,"valueVisible":true,"key":"NET","fillColor":null,"parentId":"c3b36016bcb5a5da","zIndex":6}|
{"type":"WIRE","ticket":1129,"id":"78b780fbb4af5f63"}||{"zIndex":1105.2999999999997}|
{"type":"LINE","ticket":1130,"id":"47837c9fb9c9d857"}||{"fillColor":null,"fillStyle":null,"strokeColor":null,"strokeStyle":null,"strokeWidth":null,"startX":2380,"startY":-1050,"endX":2360,"endY":-1050,"lineGroup":"78b780fbb4af5f63"}|
{"type":"ATTR","ticket":1131,"id":"4d2b5d3b944de4bc"}||{"x":null,"y":null,"rotation":null,"color":null,"fontFamily":null,"fontSize":null,"fontWeight":null,"italic":null,"underline":null,"align":null,"value":"[]","keyVisible":null,"valueVisible":null,"key":"Relevance","fillColor":null,"parentId":"78b780fbb4af5f63","zIndex":5}|
{"type":"LINE","ticket":1132,"id":"a47db62fe7cf4e44"}||{"fillColor":null,"fillStyle":null,"strokeColor":null,"strokeStyle":null,"strokeWidth":null,"startX":2360,"startY":-1050,"endX":2360,"endY":-1130,"lineGroup":"78b780fbb4af5f63"}|
{"type":"LINE","ticket":1133,"id":"5ef3924dfbf200c0"}||{"fillColor":null,"fillStyle":null,"strokeColor":null,"strokeStyle":null,"strokeWidth":null,"startX":2360,"startY":-1130,"endX":2300,"endY":-1130,"lineGroup":"78b780fbb4af5f63"}|
{"type":"LINE","ticket":1134,"id":"a2b220d5bdf4a931"}||{"fillColor":null,"fillStyle":null,"strokeColor":null,"strokeStyle":null,"strokeWidth":null,"startX":2360,"startY":-1050,"endX":2340,"endY":-1050,"lineGroup":"78b780fbb4af5f63"}|
{"type":"ATTR","ticket":1135,"id":"36b32cba54fb80f1"}||{"x":2360,"y":-1090,"rotation":90,"color":null,"fontFamily":null,"fontSize":null,"fontWeight":null,"italic":null,"underline":null,"align":null,"value":"","keyVisible":false,"valueVisible":true,"key":"NET","fillColor":null,"parentId":"78b780fbb4af5f63","zIndex":6}|
{"type":"WIRE","ticket":1136,"id":"faefe67a60b8b896"}||{"zIndex":1107.2999999999997}|
{"type":"LINE","ticket":1137,"id":"3260c4643c667568"}||{"fillColor":null,"fillStyle":null,"strokeColor":null,"strokeStyle":null,"strokeWidth":null,"startX":2220,"startY":-1060,"endX":2220,"endY":-1200,"lineGroup":"faefe67a60b8b896"}|
{"type":"LINE","ticket":1138,"id":"4de8d49f65b8f3c2"}||{"fillColor":null,"fillStyle":null,"strokeColor":null,"strokeStyle":null,"strokeWidth":null,"startX":2300,"startY":-1200,"endX":2220,"endY":-1200,"lineGroup":"faefe67a60b8b896"}|
{"type":"ATTR","ticket":1139,"id":"d4f2218fe6592cbd"}||{"x":null,"y":null,"rotation":null,"color":null,"fontFamily":null,"fontSize":null,"fontWeight":null,"italic":null,"underline":null,"align":null,"value":"[]","keyVisible":null,"valueVisible":null,"key":"Relevance","fillColor":null,"parentId":"faefe67a60b8b896","zIndex":7}|
{"type":"LINE","ticket":1140,"id":"af1fefc88a289104"}||{"fillColor":null,"fillStyle":null,"strokeColor":null,"strokeStyle":null,"strokeWidth":null,"startX":2300,"startY":-1170,"endX":2300,"endY":-1200,"lineGroup":"faefe67a60b8b896"}|
{"type":"LINE","ticket":1141,"id":"ba6ea82c9a4b8c70"}||{"fillColor":null,"fillStyle":null,"strokeColor":null,"strokeStyle":null,"strokeWidth":null,"startX":2220,"startY":-1230,"endX":2220,"endY":-1200,"lineGroup":"faefe67a60b8b896"}|
{"type":"LINE","ticket":1142,"id":"cb99586c0802806a"}||{"fillColor":null,"fillStyle":null,"strokeColor":null,"strokeStyle":null,"strokeWidth":null,"startX":2140,"startY":-1230,"endX":2220,"endY":-1230,"lineGroup":"faefe67a60b8b896"}|
{"type":"LINE","ticket":1143,"id":"9e109ecde68debe2"}||{"fillColor":null,"fillStyle":null,"strokeColor":null,"strokeStyle":null,"strokeWidth":null,"startX":2220,"startY":-1060,"endX":2260,"endY":-1060,"lineGroup":"faefe67a60b8b896"}|
{"type":"ATTR","ticket":1144,"id":"7b208a39eeed700e"}||{"x":2180,"y":-1230,"rotation":null,"color":null,"fontFamily":null,"fontSize":null,"fontWeight":null,"italic":null,"underline":null,"align":null,"value":"","keyVisible":false,"valueVisible":true,"key":"NET","fillColor":null,"parentId":"faefe67a60b8b896","zIndex":8}|
{"type":"WIRE","ticket":1145,"id":"8e91d1314b0ac319"}||{"zIndex":1110.2999999999997}|
{"type":"LINE","ticket":1146,"id":"1a4a25ec170735f4"}||{"fillColor":null,"fillStyle":null,"strokeColor":null,"strokeStyle":null,"strokeWidth":null,"startX":2580,"startY":-1050,"endX":2500,"endY":-1050,"lineGroup":"8e91d1314b0ac319"}|
{"type":"ATTR","ticket":1147,"id":"44870aad4a3ae014"}||{"x":null,"y":null,"rotation":null,"color":null,"fontFamily":null,"fontSize":null,"fontWeight":null,"italic":null,"underline":null,"align":null,"value":"[]","keyVisible":null,"valueVisible":null,"key":"Relevance","fillColor":null,"parentId":"8e91d1314b0ac319","zIndex":7}|
{"type":"LINE","ticket":1148,"id":"5b9b067fa54f977a"}||{"fillColor":null,"fillStyle":null,"strokeColor":null,"strokeStyle":null,"strokeWidth":null,"startX":2500,"startY":-965,"endX":2500,"endY":-1050,"lineGroup":"8e91d1314b0ac319"}|
{"type":"LINE","ticket":1149,"id":"ee3f98046290bdb2"}||{"fillColor":null,"fillStyle":null,"strokeColor":null,"strokeStyle":null,"strokeWidth":null,"startX":2500,"startY":-1050,"endX":2480,"endY":-1050,"lineGroup":"8e91d1314b0ac319"}|
{"type":"LINE","ticket":1150,"id":"ffdd89b76402a1e5"}||{"fillColor":null,"fillStyle":null,"strokeColor":null,"strokeStyle":null,"strokeWidth":null,"startX":2480,"startY":-1050,"endX":2480,"endY":-850,"lineGroup":"8e91d1314b0ac319"}|
{"type":"LINE","ticket":1151,"id":"8e59657044cbe56a"}||{"fillColor":null,"fillStyle":null,"strokeColor":null,"strokeStyle":null,"strokeWidth":null,"startX":2480,"startY":-1050,"endX":2420,"endY":-1050,"lineGroup":"8e91d1314b0ac319"}|
{"type":"ATTR","ticket":1152,"id":"2bd45b7fa508992e"}||{"x":2480,"y":-950,"rotation":90,"color":null,"fontFamily":null,"fontSize":null,"fontWeight":null,"italic":null,"underline":null,"align":null,"value":"","keyVisible":false,"valueVisible":true,"key":"NET","fillColor":null,"parentId":"8e91d1314b0ac319","zIndex":8}|
{"type":"WIRE","ticket":1153,"id":"fbe23f6898b72645"}||{"zIndex":1113.2999999999997}|
{"type":"LINE","ticket":1154,"id":"aa5d582e46629137"}||{"fillColor":null,"fillStyle":null,"strokeColor":null,"strokeStyle":null,"strokeWidth":null,"startX":2640,"startY":-1050,"endX":2620,"endY":-1050,"lineGroup":"fbe23f6898b72645"}|
{"type":"ATTR","ticket":1155,"id":"016b15751cc36ddf"}||{"x":2630,"y":-1050,"rotation":null,"color":null,"fontFamily":null,"fontSize":null,"fontWeight":null,"italic":null,"underline":null,"align":null,"value":"","keyVisible":false,"valueVisible":true,"key":"NET","fillColor":null,"parentId":"fbe23f6898b72645","zIndex":2}|
{"type":"ATTR","ticket":1156,"id":"d96e0a99c482bceb"}||{"x":null,"y":null,"rotation":null,"color":null,"fontFamily":null,"fontSize":null,"fontWeight":null,"italic":null,"underline":null,"align":null,"value":"[]","keyVisible":null,"valueVisible":null,"key":"Relevance","fillColor":null,"parentId":"fbe23f6898b72645","zIndex":0}|
{"type":"WIRE","ticket":1157,"id":"bb59daa0a272e0da"}||{"zIndex":1115.2999999999997}|
{"type":"LINE","ticket":1158,"id":"c3eca429dad521a1"}||{"fillColor":null,"fillStyle":null,"strokeColor":null,"strokeStyle":null,"strokeWidth":null,"startX":2500,"startY":-935,"endX":2500,"endY":-910,"lineGroup":"bb59daa0a272e0da"}|
{"type":"ATTR","ticket":1159,"id":"a6b5ddec6074c3cc"}||{"x":null,"y":null,"rotation":null,"color":null,"fontFamily":null,"fontSize":null,"fontWeight":null,"italic":null,"underline":null,"align":null,"value":"[]","keyVisible":null,"valueVisible":null,"key":"Relevance","fillColor":null,"parentId":"bb59daa0a272e0da","zIndex":2}|
{"type":"WIRE","ticket":1160,"id":"d99dc6013ad9873e"}||{"zIndex":1116.2999999999997}|
{"type":"LINE","ticket":1161,"id":"2709df0edb7fbcae"}||{"fillColor":null,"fillStyle":null,"strokeColor":null,"strokeStyle":null,"strokeWidth":null,"startX":180,"startY":-1360,"endX":180,"endY":-1380,"lineGroup":"d99dc6013ad9873e"}|
{"type":"ATTR","ticket":1162,"id":"2d52ac0d04bc28c2"}||{"x":180,"y":-1370,"rotation":90,"color":null,"fontFamily":null,"fontSize":null,"fontWeight":null,"italic":null,"underline":null,"align":null,"value":"","keyVisible":false,"valueVisible":true,"key":"NET","fillColor":null,"parentId":"d99dc6013ad9873e","zIndex":2}|
{"type":"ATTR","ticket":1163,"id":"3a3eea172e3d8252"}||{"x":null,"y":null,"rotation":null,"color":null,"fontFamily":null,"fontSize":null,"fontWeight":null,"italic":null,"underline":null,"align":null,"value":"[]","keyVisible":null,"valueVisible":null,"key":"Relevance","fillColor":null,"parentId":"d99dc6013ad9873e","zIndex":0}|
{"type":"WIRE","ticket":1164,"id":"a534cd566302ebb5"}||{"zIndex":1117.2999999999997}|
{"type":"LINE","ticket":1165,"id":"742191b9f260c3e4"}||{"fillColor":null,"fillStyle":null,"strokeColor":null,"strokeStyle":null,"strokeWidth":null,"startX":440,"startY":-1385,"endX":440,"endY":-1360,"lineGroup":"a534cd566302ebb5"}|
{"type":"ATTR","ticket":1166,"id":"c49245a6a32ce0ae"}||{"x":null,"y":null,"rotation":null,"color":null,"fontFamily":null,"fontSize":null,"fontWeight":null,"italic":null,"underline":null,"align":null,"value":"[]","keyVisible":null,"valueVisible":null,"key":"Relevance","fillColor":null,"parentId":"a534cd566302ebb5","zIndex":2}|
{"type":"WIRE","ticket":1167,"id":"888f41266a5c79f6"}||{"zIndex":1118.2999999999997}|
{"type":"LINE","ticket":1168,"id":"8304e15a1602a6e7"}||{"fillColor":null,"fillStyle":null,"strokeColor":null,"strokeStyle":null,"strokeWidth":null,"startX":660,"startY":-1190,"endX":660,"endY":-1210,"lineGroup":"888f41266a5c79f6"}|
{"type":"ATTR","ticket":1169,"id":"3360e4a5ca0bccc5"}||{"x":660,"y":-1200,"rotation":90,"color":null,"fontFamily":null,"fontSize":null,"fontWeight":null,"italic":null,"underline":null,"align":null,"value":"","keyVisible":false,"valueVisible":true,"key":"NET","fillColor":null,"parentId":"888f41266a5c79f6","zIndex":2}|
{"type":"ATTR","ticket":1170,"id":"0f14cf3d3a32f961"}||{"x":null,"y":null,"rotation":null,"color":null,"fontFamily":null,"fontSize":null,"fontWeight":null,"italic":null,"underline":null,"align":null,"value":"[]","keyVisible":null,"valueVisible":null,"key":"Relevance","fillColor":null,"parentId":"888f41266a5c79f6","zIndex":0}|
{"type":"WIRE","ticket":1171,"id":"197d43772723762a"}||{"zIndex":1119.2999999999997}|
{"type":"LINE","ticket":1172,"id":"4c389d6a56c6fa6b"}||{"fillColor":null,"fillStyle":null,"strokeColor":null,"strokeStyle":null,"strokeWidth":null,"startX":1140,"startY":-910,"endX":1140,"endY":-930,"lineGroup":"197d43772723762a"}|
{"type":"ATTR","ticket":1173,"id":"d18badcf5e9ba2a1"}||{"x":1140,"y":-920,"rotation":90,"color":null,"fontFamily":null,"fontSize":null,"fontWeight":null,"italic":null,"underline":null,"align":null,"value":"","keyVisible":false,"valueVisible":true,"key":"NET","fillColor":null,"parentId":"197d43772723762a","zIndex":2}|
{"type":"ATTR","ticket":1174,"id":"e9aa6e3e8e5d745a"}||{"x":null,"y":null,"rotation":null,"color":null,"fontFamily":null,"fontSize":null,"fontWeight":null,"italic":null,"underline":null,"align":null,"value":"[]","keyVisible":null,"valueVisible":null,"key":"Relevance","fillColor":null,"parentId":"197d43772723762a","zIndex":0}|
{"type":"WIRE","ticket":1175,"id":"f7ea097a62d77eca"}||{"zIndex":1120.2999999999997}|
{"type":"LINE","ticket":1176,"id":"78862197c3f9ce9a"}||{"fillColor":null,"fillStyle":null,"strokeColor":null,"strokeStyle":null,"strokeWidth":null,"startX":1380,"startY":-910,"endX":1380,"endY":-930,"lineGroup":"f7ea097a62d77eca"}|
{"type":"ATTR","ticket":1177,"id":"112fa2920f8acc4a"}||{"x":1380,"y":-920,"rotation":90,"color":null,"fontFamily":null,"fontSize":null,"fontWeight":null,"italic":null,"underline":null,"align":null,"value":"","keyVisible":false,"valueVisible":true,"key":"NET","fillColor":null,"parentId":"f7ea097a62d77eca","zIndex":2}|
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
