funiang-x/G2026/hardware/sch/G2026-INT.pdf

# ` 5•“e!ßh”»

# LCD_CS_J5 LCD_RS_J5 LCD_D⁰

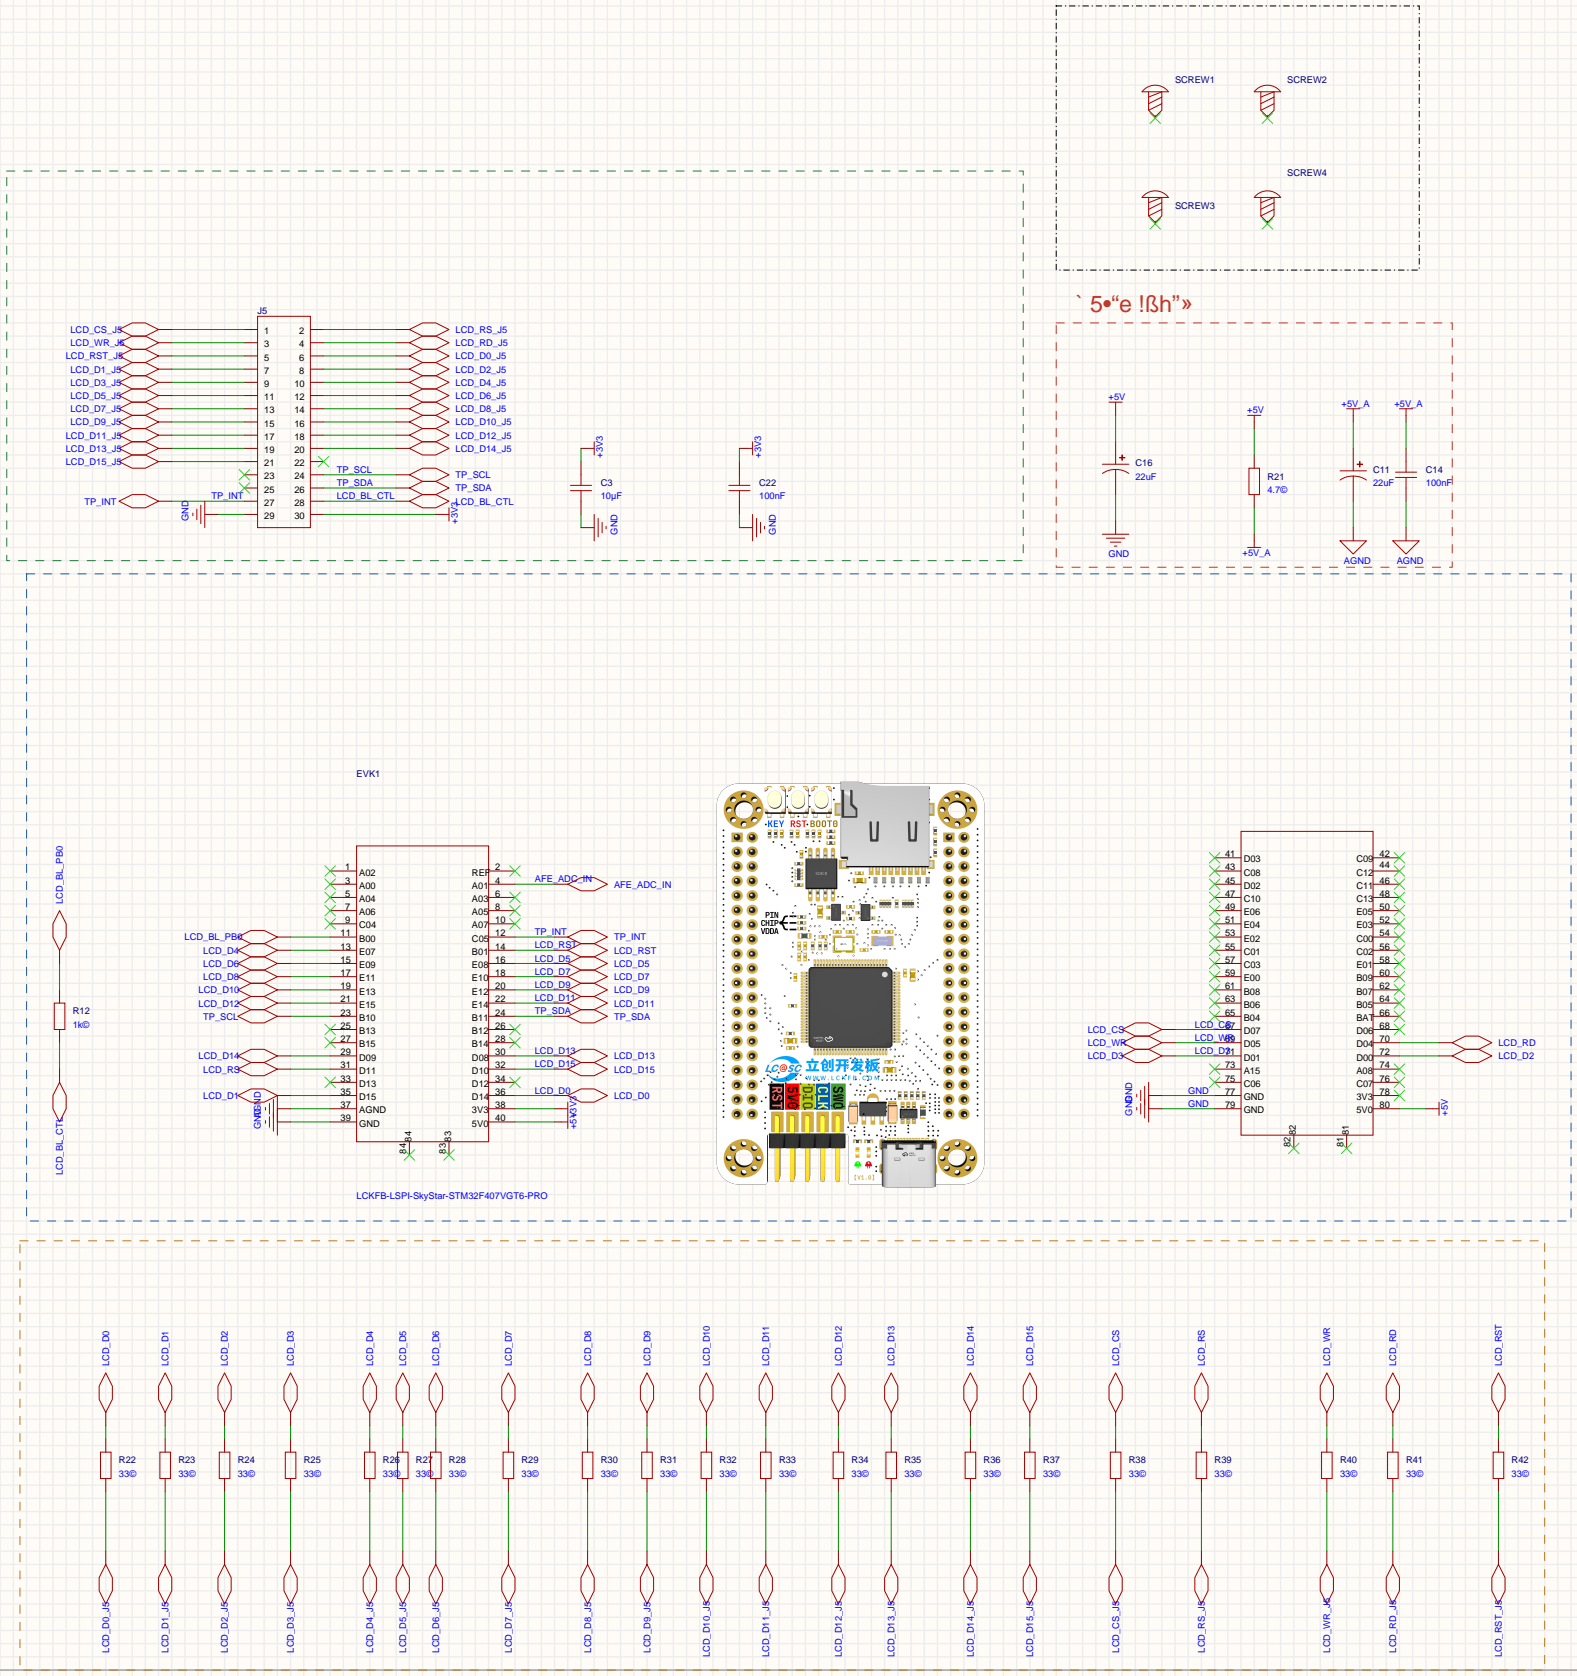
[picture p49: page 1]

LCKFB-LSPI-SkyStar-STM32F407VGT6-PRO
