funiang-x/G2026/hardware/sch/G2026-AFE.pdf

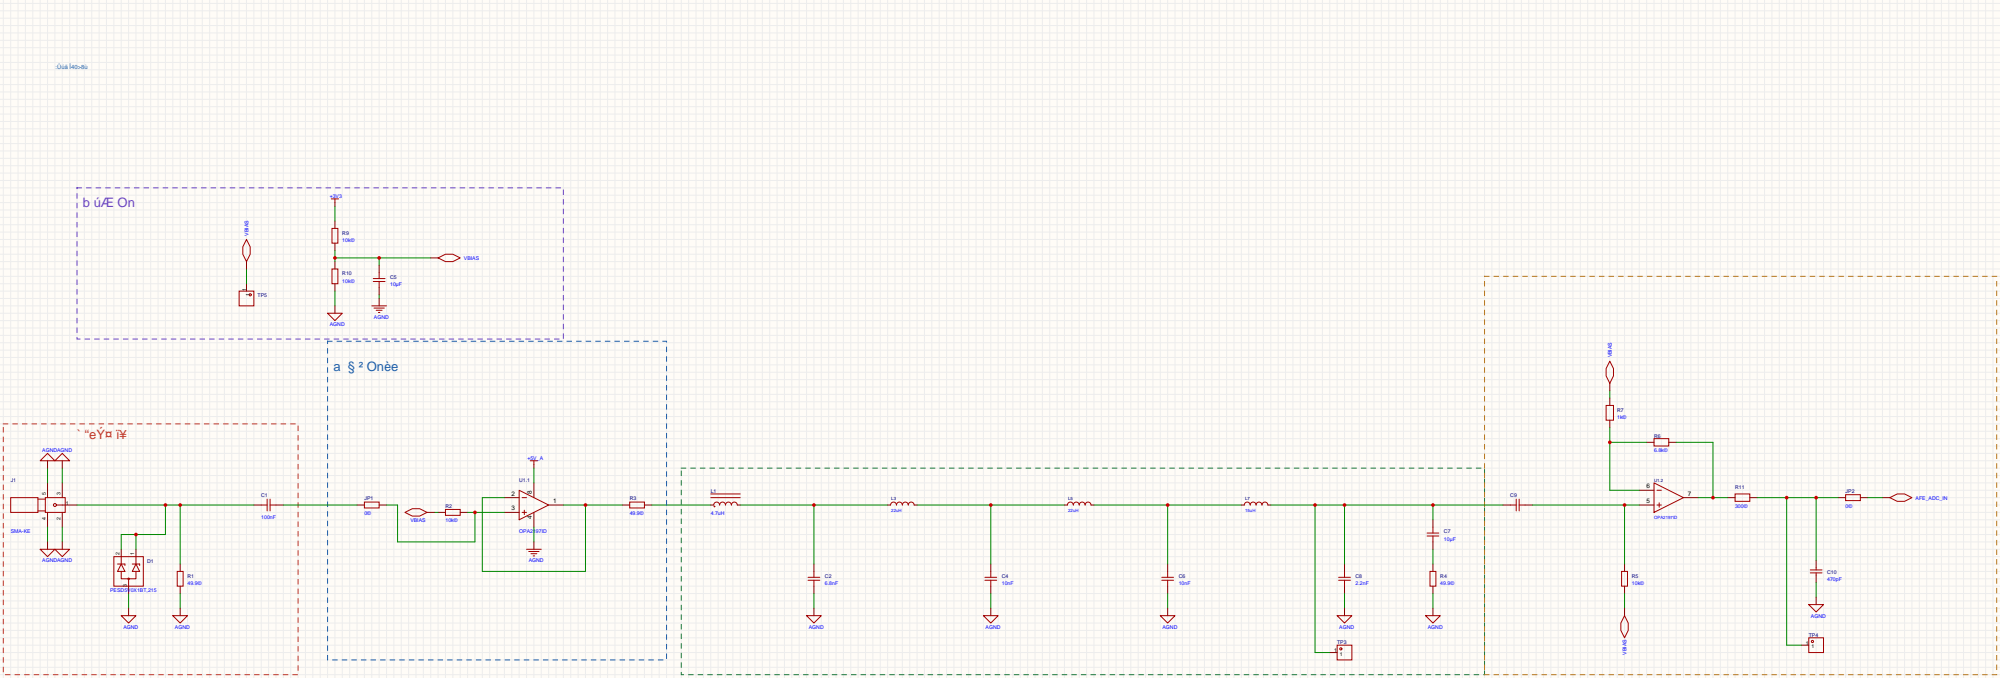
[picture p50: page 1]
