funiang-x/G2026/(list of files, drawings)

Other design files:
hardware/data/pcb_snapshot_20261011.json
hardware/data/pcb_snapshot_20261011_1456.json
