funiang-x/G2026/firmware/Core/Src/main.c

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
/* Includes ------------------------------------------------------------------*/
#include "main.h"
#include "cmsis_os.h"
#include "adc.h"
#include "dma.h"
#include "i2c.h"
#include "rtc.h"
#include "spi.h"
#include "tim.h"
#include "gpio.h"
#include "fsmc.h"

/* USER CODE BEGIN Includes */
/* ★ 程序入口。main() 属于 Core/（生成物），它是"启动序列"而不是四层里的一层，
 *   所以"Core 调 Task"不算越层（docs/01 §组合根）。
 *   规矩：这里**只写胶水**，任何逻辑都回 Task/ 层。 */
#include "app.h" /* Task 层：app_init() —— 组合根 */
/* USER CODE END Includes */


void SystemClock_Config(void);
void MX_FREERTOS_Init(void);
/**
  * @brief  The application entry point.
  * @retval int
  */
int main(void)
{

  /* MCU Configuration--------------------------------------------------------*/

  /* Reset of all peripherals, Initializes the Flash interface and the Systick. */
  HAL_Init();

  /* Configure the system clock */
  SystemClock_Config();

  /* Initialize all configured peripherals */
  MX_GPIO_Init();
  MX_DMA_Init();
  MX_SPI1_Init();
  MX_RTC_Init();
  MX_TIM8_Init();
  MX_I2C2_Init();
  MX_ADC1_Init();
  MX_FSMC_Init();
  /* USER CODE BEGIN 2 */
  /* ★ 全工程唯一的应用入口。
   *
   * 为什么放在这里（时序上必须是这个位置）：
   *   HAL_Init → SystemClock_Config → MX_*_Init 已完成，硬件都就位了；
   *   而 osKernelInitialize / MX_FREERTOS_Init / osKernelStart 还没调 ——
   *   ⇒ app_init() 运行时**调度器还没启动**，所以它里面不许取任何
   *     FreeRTOS 原语（锁 / 队列 / 延时）。详见 Task/Inc/app.h 的时序说明。
   *
   * ⚠️ 这是 main.c 里唯一该出现的一行业务代码。要加功能就进 Task/ 层。 */
  app_init();
  /* USER CODE END 2 */

  /* Init scheduler */
  osKernelInitialize();  /* Call init function for freertos objects (in cmsis_os2.c) */
  MX_FREERTOS_Init();

  /* Start scheduler */
  osKernelStart();

  /* We should never get here as control is now taken by the scheduler */

  /* Infinite loop */
  /* USER CODE BEGIN WHILE */
  while (1)
  {
    /* USER CODE END WHILE */

    /* USER CODE BEGIN 3 */
  }
  /* USER CODE END 3 */
}

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
/**
  * @brief  Period elapsed callback in non blocking mode
  * @note   This function is called  when TIM6 interrupt took place, inside
  * HAL_TIM_IRQHandler(). It makes a direct call to HAL_IncTick() to increment
  * a global variable "uwTick" used as application time base.
  * @param  htim : TIM handle
  * @retval None
  */
void HAL_TIM_PeriodElapsedCallback(TIM_HandleTypeDef *htim)
{
  if (htim->Instance == TIM6)
  {
    HAL_IncTick();
  }
}

/**
  * @brief  This function is executed in case of error occurrence.
  * @retval None
  */
void Error_Handler(void)
{
  /* USER CODE BEGIN Error_Handler_Debug */
  /* ★ CubeMX 的默认实现是 `__disable_irq(); while(1);` —— **完全无声**。
   *   那时的现象是"板子毫无反应、RTT 一个字都没有"，与"固件没烧进去"
   *   "探针没插"完全无法区分 —— 实测能白查半小时。
   *   ⇒ 至少要把日志后端拉起来（RTT 只要内存，不需要时钟与中断）打一行。
   *
   * ⚠️ 但**不能**走"停机"路径 —— 2026-09-23 上板实测：
   *    Error_Handler 会被**所有** HAL 初始化失败调到，其中最常见的是
   *    `MX_SDIO_SD_Init()`：**板子上没插 TF 卡时 `HAL_SD_Init()` 必然失败**，
   *    结果整块板子起不来。实测调用栈：
   *      Reset_Handler → main → MX_SDIO_SD_Init → Error_Handler → 停机
   *    TF 卡是可选外设，不该绑架启动。
   *
   * ⇒ 改成 app_init_failed()：打一行 ERROR 日志后**返回**，让 main() 继续。
   *   （它故意不打 [AI_FAIL] 标记 —— 那是 fw.py verify 的失败判据，
   *     打了会把"其实跑起来了"误判成失败。） */
  app_init_failed("Error_Handler: HAL 初始化未成功（外设？时钟？HSE 起振？）");
  /* USER CODE END Error_Handler_Debug */
}
#ifdef USE_FULL_ASSERT
/**
  * @brief  Reports the name of the source file and the source line number
  *         where the assert_param error has occurred.
  * @param  file: pointer to the source file name
  * @param  line: assert_param error line source number
  * @retval None
  */
void assert_failed(uint8_t *file, uint32_t line)
{
  /* USER CODE BEGIN 6 */
  /* User can add his own implementation to report the file name and line number,
     ex: printf("Wrong parameters value: file %s on line %d\r\n", file, line) */
  /* USER CODE END 6 */
}
#endif /* USE_FULL_ASSERT */
