funiang-x/G2026/firmware/Core/Inc/main.h

#define LSE_IN_Pin GPIO_PIN_14
#define LSE_IN_GPIO_Port GPIOC
#define LSE_OUT_Pin GPIO_PIN_15
#define LSE_OUT_GPIO_Port GPIOC
#define HSE_IN_Pin GPIO_PIN_0
#define HSE_IN_GPIO_Port GPIOH
#define HSE_OUT_Pin GPIO_PIN_1
#define HSE_OUT_GPIO_Port GPIOH
#define FLASH_CS_Pin GPIO_PIN_4
#define FLASH_CS_GPIO_Port GPIOA
#define FLASH_SCK_Pin GPIO_PIN_5
#define FLASH_SCK_GPIO_Port GPIOA
#define FLASH_MISO_Pin GPIO_PIN_6
#define FLASH_MISO_GPIO_Port GPIOA
#define FLASH_MOSI_Pin GPIO_PIN_7
#define FLASH_MOSI_GPIO_Port GPIOA
#define TP_INT_Pin GPIO_PIN_5
#define TP_INT_GPIO_Port GPIOC
#define LCD_BL_Pin GPIO_PIN_0
#define LCD_BL_GPIO_Port GPIOB
#define LCD_RST_Pin GPIO_PIN_1
#define LCD_RST_GPIO_Port GPIOB
#define green_led_Pin GPIO_PIN_2
#define green_led_GPIO_Port GPIOB
#define TP_SCL_Pin GPIO_PIN_10
#define TP_SCL_GPIO_Port GPIOB
#define TP_SDA_Pin GPIO_PIN_11
#define TP_SDA_GPIO_Port GPIOB
#define SWDIO_Pin GPIO_PIN_13
#define SWDIO_GPIO_Port GPIOA
#define SWCLK_Pin GPIO_PIN_14
#define SWCLK_GPIO_Port GPIOA
#define SD_CARD_DET_Pin GPIO_PIN_3
#define SD_CARD_DET_GPIO_Port GPIOD
