funiang-x/G2026/firmware/project_config.h

#ifndef PROJECT_CONFIG_H
#define PROJECT_CONFIG_H
/* ============================================================================
 *  project_config.h —— 应用参数与功能开关（**与硬件无关**）
 *
 *  四层架构里的位置（见 docs/01）：
 *    · Task / Operation 都 include 它（本文件在工程根，两层都能看到）
 *    · **它里面不许出现任何 HAL 内容** —— Operation 层要在 PC 上编译，
 *      引了硬件头就编不过。硬件事实一律去 Core/Inc/board_config.h。
 *
 *  分工：
 *    Core/Inc/board_config.h   引脚、时钟、外设实例（"这块板子上有什么"）
 *    project_config.h（本文件）  周期、阈值、功能开关（"产品要怎么做"）
 *
 *  ⚠️ 写业务时把阈值 / 周期 / 开关放这里，**不要散落到 .c 里**（本工程禁止魔数）。
 *     加的时候照下面这条规矩：
 *
 *     · Operation 层的参数**不从本文件读** —— 由 Task 层在初始化时**注入**给
 *       Operation 实例（它是纯逻辑，配置也要当参数进来，那样才好在 PC 上单测）。
 *     · 本文件里**不许出现任何 HAL 内容**（Operation 要在 PC 上编译）。
 *     · 硬件事实（引脚/时钟）不在这儿，去 Core/Inc/board_config.h。
 * ==========================================================================*/

/* ---------------------------------------------------------------- 基本节拍 ---- */

/* 业务节拍：周期任务每次推进的间隔。
 *
 * ★ 2026-09-26 从 100ms 改成 **10ms** —— 因为 LVGL 的时基靠本循环推进
 *   （`app_lvgl_poll()` 用两次调用的差值调 `lv_tick_inc()`）。
 *   100ms 的节拍会让 LVGL 的时间分辨率变成 100ms：动画一顿一顿，
 *   触摸响应最多迟 100ms（手感"粘"）。
 *   10ms 是折中：比 LVGL 自己的重绘周期（16ms）密，又不至于空转太频繁。
 *   ⚠️ 改成大于 16ms 的值会让 LVGL 的重绘被拖慢（它能跑，但会掉帧）。 */
#define APP_TICK_PERIOD_MS 10U

/* 心跳日志周期（让 RTT 上能看出"系统还活着"）。 */
#define APP_HEARTBEAT_PERIOD_MS 5000U

/* ------------------------------------------------------------ LVGL 参数 ---- */

/* draw buffer 的行数：缓冲 = **逻辑宽** × 本值 × 2 字节。
 *   480 × 56 × 2 = 53.8 KB（在 SRAM1，见 Task/Src/app_lvgl.c）。
 *   ⚠️ 宽度是**逻辑宽 480**（横屏后），不是面板物理宽 320 —— 旧注释写的
 *      "320 × 48 × 2 = 30.7 KB" 是竖屏时代的口径，2026-10-14 订正。
 * ⚠️ 调大省 flush 次数（FSMC 每次开窗有固定开销），但吃 RAM。
 *    **2026-10-14 S6：48 → 56** —— 整屏重绘的**带数 7 → 6**
 *    （`ceil(320/48)=7`，`ceil(320/56)=6`）⇒ 每帧少一次"渲染 + flush + 带切换"。
 *    选 56 而不是 64：64 也是 5 带但要多 15 KB RAM（门禁余量只剩 2.7 KB，太紧）；
 *    56 只需 +7.5 KB、余量 10.2 KB，而且**带数与 64 只差 1**。
 *    再大（80 行 = +30 KB）会**直接撞穿 120 KB 体积门禁**。
 * ⚠️ 这个缓冲**不能放 CCM**：本工程走 CPU 直写 FSMC 时能跑，
 *    但将来若改成 DMA 搬 FSMC，CCM 会**静默失效**（不报错、花屏/黑屏）。
 *    放 SRAM1 就没有这个隐患，代价只是访问慢一点点。
 *
 * ★ 2026-10-14（C9②③）：**56 → 28，为 DMA 双缓冲定的**。
 *   为什么是 28：异步 flush（DMA）要求**两块** buffer，而横向逻辑宽是 **480**
 *   ⇒ 每块 = 480 × 行数 × 2 B。两块总量不能超过原来单块 480×56×2 = 53.76 KB
 *   ⇒ 行数 ≤ 28。取 28 = 26.25 KB/块、两块 **52.5 KB**（与原来基本持平）。
 *   代价：整屏带数 **6 → 18**（480/28=17.14 ⇒ 18 带）。
 * ★ 已实测的代价（**可复现测试台**，`_work/lvgl_band_ab_20261014/`，2026-10-14）：
 *   带数 6 → 18 时，**flush/帧几乎不变**（10.80 → 10.82 ms，带数在 flush 侧几乎免费），
 *   但 **render/帧 +2.57 ms**（7.40 → 9.97），即 **每多一带 ≈ +0.64 ms**（全在 render 侧）。
 *   ⇒ 换来的是把 flush 那 ≈14.3 ms/帧 藏到渲染背后（净赚 ≈6.6 ms/帧）。
 * ⇒ 结论（2026-10-14 定稿）：**56 行**（整屏 6 带）。28 行只在那条已放弃的
 *   "DMA 双缓冲"路线下才有意义（两块各 28 行）；那条路已按结论清理，
 *   所以这里回到 56 —— 它是**非 DMA 配置下的最优带数**。 */
#define APP_LVGL_DRAW_BUF_LINES 56U



/* ★ 横屏逻辑分辨率（2026-10-13 起界面固定横屏）。
 *
 * ⚠️ 这**不是**面板的物理尺寸（那是 `board_config.h` 的 BOARD_LCD_WIDTH/HEIGHT =
 *    320×480），而是 **LVGL 的逻辑坐标系** —— `app_lvgl.c` 把 display 旋转 90° 之后，
 *    `lv_display_get_horizontal_resolution()` 返回的就是这两个值。
 *    UI 布局、draw buffer 的一行宽度、坐标显示**一律按逻辑尺寸算**。
 *
 * 为什么是 480×320：ROTATION_90 = 把面板**顺时针**转 90°。依据是 LVGL 自己的
 *    `lv_display_rotate_point()`（`display/lv_display.c`）在 90° 下写的是
 *    `x' = ver_res - y - 1; y' = x` —— 与"绕中心顺时针旋转 90°"逐点一致
 *    （面板左上角 → 逻辑右上角），不是逆时针。
 * ⚠️ 触摸坐标**不用**我们手工转：`lv_indev_read()` 读完 indev 后自动调
 *    `lv_display_rotate_point()`（`indev/lv_indev.c`）⇒ `bsp_touch_read()` 给的必须是
 *    **面板物理坐标**（320×480 口径），旋转由 LVGL 负责。换方向时**只改**
 *    `app_lvgl.c` 的 `lv_display_set_rotation()` 那一处，别去动 MADCTL / bsp_lcd。 */
#define APP_LVGL_SCR_W 480U
#define APP_LVGL_SCR_H 320U

/* ★ LVGL 重绘周期（ms）：**帧率的第一瓶颈在这里，不在 FSMC**。
 *
 * 机理：显示刷新跑在一个周期定时器上（`disp->refr_timer`，初值 = `lv_conf.h` 的
 *   `LV_DEF_REFR_PERIOD` = 16ms），而**官方 sysmon 报的 FPS 上限就是 `1000/period`**
 *   —— `lv_sysmon.c` 的 `perf_dump_info()` 里有一句
 *   `fps = LV_MIN(fps, 1000 / disp_refr_period)`。⇒ period=16 时，无论实际多快，
 *   屏上永远看不到 62.5 以上的数。
 * 取 **10 = 与 `APP_TICK_PERIOD_MS` 对齐**：`lv_timer_handler()` 每 10ms 才被调一次
 *   （见 `app_ui_task`），周期设得比它小不会让 LVGL 更勤地被检查。
 *   ⇒ 本工程的**重绘率上限 = 100 fps**。
 * ⚠️ 再往小调（如 5ms）没有任何提升，只会让 sysmon 显示一个够不到的上限。
 * ⚠️ 这是**重绘**帧率；`app_lvgl_fps_x10()` 报的是另一个口径（像素吞吐 ÷ 整帧），
 *    两者不可互相印证（见 app_lvgl.c）。 */
#define APP_LVGL_REFR_PERIOD_MS 10U

/* ★ 2026-10-14 S4：**触摸读定时器的周期**（ms）。
 *
 * why：滑动的"跟手度"上限就是它 —— 手指动了最多要等一个采样周期才被读到。
 *   `lv_indev` 的读定时器默认跟 lv_conf.h 的 `LV_DEF_REFR_PERIOD`(16ms) ⇒ 上限 62.5Hz
 *   （板上实测 `[TOUCH] 1s: 采样 50`）。收到 10 ⇒ 上限 100Hz。
 * ⚠️ 只动这一个定时器（`app_lvgl.c` 里 `lv_indev_get_read_timer()`），
 *   **不要**去改 `LV_DEF_REFR_PERIOD` —— 那是全局初值，会连带把重绘周期也改掉。
 * ⚠️ 代价：I2C 读次数翻倍（每次 ~7 B @100kHz ≈ 0.7ms）⇒ UI 任务多约 3.5% CPU。
 *   采样窗内无影响（那时 UI 在忙等 `app_engine_acquiring()`，不读触摸）。 */
#define APP_TOUCH_READ_PERIOD_MS 10U

/* ★ 2026-10-14：**UI 业务刷新的最小间隔**（ms）—— 一道"防连续重测"的闸。
 *
 * why 要从 100 收到 20（用户要求："接入信号要及时刷出来，切换参数要尽快算出来显示"）：
 *   数据本身只有 **10 Hz**（测量周期 `APP_MEAS_PERIOD_MS` = 100ms），
 *   而闸门原来也是 100ms ⇒ **两个同周期、彼此不同步的计时器会锁在一个任意的
 *   固定相位差上** ⇒ 最坏给"发布 → 上屏"白加 **100 ms**。
 *   收到 20ms 后这段最坏只剩 20ms，而**负载上限仍被闸门兜住**（最坏 50 次/s）。
 *
 * ⚠️ **闸门不能删**：`app_engine_remeasure()`（切页 / 换 1T-3T）会让 engine 立刻重测，
 *    连点几下就是一波"连续重测"——闸门就是防它的（2026-10-13 四轮的原始动机）。
 * ⚠️ 2026-10-13 那条动机里的"重建波形 + 重启三处滚入动画"**已经不成立**了：
 *    滚入动画八轮已删、波形八轮加了变化检测、2026-10-14 起无信号时画直线 ⇒ 刷新很便宜。
 *    ⇒ 闸门只需要挡住"突发"，不需要挡住"正常 10Hz"。 */
/* ★ 2026-10-14：页面"按需加载 + 用后销毁"的**销毁推迟时长**（ms）。
 *
 * 为什么不离开就立刻删：`lv_tileview` 的翻页是**拖动动画**，动画期间老页仍在屏幕上
 *   ⇒ 立刻删就是**半屏空白**（"切换流畅、销毁不影响体验"这条要求的落点）。
 * 500ms 的来历：翻页动画是百毫秒量级（LVGL 默认 ~300ms）+ 一拍 10ms 的余量。
 *   ⚠️ 别调太大：来回快速滑动时多驻留一页 = 池峰值高一页（把需求 2 的收益吃回去）。
 *   ⚠️ 别调太小（小于一个动画时长）：会白屏。判据：滑动过程**不该**看到任何空白。 */
#define APP_UI_PAGE_FREE_DELAY_MS 500U

#define APP_UI_REFR_MIN_MS 20U

/* ★ LCD 写屏的"可打断粒度"（像素）：采样窗静默（硬件方案 02 §6 O1）靠它落地。
 *
 * 为什么需要：LVGL 的 flush 是**同步**的，一个 draw buffer = 480×48 px 的 FSMC 连续写
 * （现行 FSMC 时序 AS=2/DS=8 ⇒ 76.4 ns/字 ⇒ **≈1.17 ms**；见 board_config.h 的
 *  FSMC 段）。采样窗只有 2.048 ms —— 量级相当，所以"能不能在块边界被打断"是必须的。
 *
 * 机制（Task 层"LCD 总线闸"，实现在 app_engine.c）：
 *   · engine **开采集之前**先抢闸、采完放闸；
 *   · 写屏侧每写 `APP_LCD_CHUNK_PX` 像素抢一次闸。
 * ⇒ 采样窗内一次写屏都不会发生；代价是 engine 起采最多晚 1 块、flush 被推迟 ≤2ms。
 * ⚠️ 调大 = 信号量开销少但 engine 等得久；调小 = 打断更细但调用更频繁。
 *    1024 px @ 76.4 ns/字 ≈ **0.078 ms** —— 相对 2.048 ms 的采样窗已足够细，
 *    所以维持 1024 不变（原注释按已作废的 DS=85 写成 0.6ms）。 */
#define APP_LCD_CHUNK_PX 1024U

/* 抢 LCD 总线闸的等待上限（ms）：正常只需等"当前块"写完（1024 px ≈0.11ms）。
 * 给到 20ms 是**防御性**的：万一写屏侧漏了 give，engine 也不能被永久堵死
 * ——超时后照常开采集（退化成旧的整帧级避让，不比改前差）。 */
#define APP_LCD_BUS_WAIT_MS 20U

/* ★★ 2026-10-14 八轮：**两个 bring-up 开关已删除**（`APP_LVGL_USE_DEMO`、
 *   `APP_LCD_SOLID_TEST`）。它们的历史使命（屏/触摸的上板验证、花屏二义性切开）
 *   都已经完成，而"留一个 0 的开关 + 一圈 `#if` 脚手架"的代价是：
 *     · 每个读代码的人都要先判断"这条分支会不会生效"；
 *     · 支撑它们的那批代码（demo 源条目 / 纯色色带函数 / 各自的轮换逻辑）
 *       会一直躺在编译单元里，还要靠 `#if` 保证零告警。
 *   ⇒ 相关代码已一并删除（`app_lvgl.c` 的 `lcd_solid_bands()` 与 demo 分支、
 *      `CMakeLists.txt` 的 demo 源条目、`lv_conf.h` 的 `LV_USE_DEMO_WIDGETS`）。
 *   要重做同类验证：从 git 历史取回那一版，或临时写 20 行（当时就是这么写的）。
 *
 *   ★ 帧率等运行指标仍由 **LVGL 官方 sysmon 浮层**给（挂在 sys 顶层、本工程零代码，
 *     开关在 `lv_conf.h` 的 `LV_USE_SYSMON` + `LV_USE_PERF_MONITOR`）。
 *     ⚠️ 它显示的 FPS 是 **LVGL 重绘循环速率**（`LV_EVENT_REFR_READY` 次数/秒，
 *        "即使什么都没重绘也会发" ⇒ 静屏也是满值），上限 = 1000/重绘周期 = 100。
 *        它**不是**画面内容更新率（那个 = `APP_MEAS_PERIOD_MS` 决定的测量节拍）。
 *        页 2 的 BANDWIDTH 卡是另一个口径（flush 像素速率 kpx/s），三者别互相印证。 */

/* ★ 触摸子系统总开关（诊断用）：0 = **完全不碰 PB10/PB11**（初始化与自检都跳过）。
 *
 * 为什么要有它：2026-10-13 排查触摸（`I2C2` 扫不到器件）时，为了判定"线被顶死还是缺上拉"，
 * 固件与调试器反复把 SCL/SDA 拉低/释放；若模块那头把供电或某个低阻 3.3V 引到了我们当成
 * SCL 的脚上，这种反复驱动就会与模块电源对打。**1 = 正常产品态**；排查期用 0 隔离。
 * ⚠️ 它只影响**触摸**；屏（FSMC/8080）不受影响。 */
#define APP_TOUCH_ENABLE 1U

/* ------------------------------------------------------------ FreeRTOS 参数 ----
 * ⚠️ 任务**不要用 CubeMX 的图形界面建** —— CubeMX 里只勾 FreeRTOS 内核（docs/01 规矩 4）。
 *
 * ★ CubeMX 生成的 `defaultTask`（**本工程唯一"生成"的任务**）只跑轻量周期：
 *     栈深 / 优先级   → `.ioc` 的 `FREERTOS.Tasks01`（256 words / 优先级 24）
 *                        ⚠️ 它由 CubeMX 生成，参数**只能在 CubeMX 里给**，
 *                           写在这里的宏不会被读 —— 所以这里不重复定义（避免孤儿宏）。
 *     循环体          → `Task/Src/app_rtos.c` 的 `app_rtos_run()`（心跳/闪灯/RTC + 建下面两个任务）
 *     ⚠️ 栈深单位是 **word（4 字节）**，不是字节。256 words = 1 KiB。
 *     业务（测量 / UI）**不在它里面** —— 见下面的双任务小节。
 *
 * ⇒ **加新任务时**才在下面定义它的参数，并在 `Task/` 层用 `xTaskCreate` 建。
 *   例如：
 *       #define APP_SENSOR_TASK_STACK_WORDS 256U
 *       #define APP_SENSOR_TASK_PRIORITY    4U   // 比 defaultTask(24) 高才抢得到 CPU
 *   ⚠️ 优先级数值越大越优先；`configMAX_PRIORITIES` = 56。 */

/* ---- 测量 / UI 双任务（2026-09-28：从"单循环"改为真多任务）----
 *
 *  ★ 为什么现在拆：单循环里 engine 与 ui 抢同一拍 CPU，靠"DSP 拆两拍"绕开
 *    帧抖动；采集完成靠 10ms 轮询（最多白等一拍）。拆成任务后：
 *      · engine 阻塞在 ADC 帧信号量上 —— **零轮询延迟、采集期让出 CPU**；
 *      · 重测请求走任务通知（轻量二值信号量），切页即刻响应，不等下一拍；
 *      · 结果走 1 深 mailbox 队列（跨任务双缓冲），UI 永不读到写一半的结构。
 *
 *  ★ 优先级定序（2026-10-14 定）：**业务任务全部在 defaultTask 之上**
 *      Task_Ui **26** > Task_Engine **25** > defaultTask **24**（CubeMX，垫底）
 *  ⚠️ 数字本身无意义，**只看相对大小**。`defaultTask` 只做心跳/闪灯/RTC + 10ms 的
 *     `app_poll()`（见 `app_rtos.c`）—— 全工程最不紧急的一个 ⇒ 让它垫底，
 *     不去抢占 DSP 与重绘。
 *  ⚠️ **为什么不直接"把 defaultTask 降下来"**（2026-10-14 查实）：它的优先级写在
 *     生成物 `Core/Src/freertos.c` 的 `const osThreadAttr_t defaultTask_attributes`
 *     里 —— 那**不在任何 USER CODE 区内**（`USER CODE BEGIN Variables` 在它之前、
 *     `FunctionPrototypes` 在它之后），而且整个结构体是 `const` ⇒ 只能改 `.ioc` +
 *     重生成，而那要过 `firmware/docs/11 §11.1` 的回填清单（2026-10-02 那次重生成
 *     把 TIM8 整个 IP 连 `tim.c` 一起删了）。
 *     **抬我们自己的任务**结果完全等价、零风险、`.ioc` 不用动 ⇒ 选这条路。
 *
 *  ★ 为什么把引擎**降到 UI 之下**（原设计反了）：DSP 一拍是 **~40ms 的纯计算**，
 *    优先级高于 UI 就意味着"每 200ms 有一刀 40ms 的硬插队"。原注释写"engine 虽最高
 *    优先级，但阻塞在 ADC 帧信号量上、不长期占 CPU" —— 那句只对"等帧"那 2.048ms
 *    成立，**对后面的 DSP 链完全不成立**。
 *    现场症状（用户原话）："波形很明显从上到下刷新，整体一卡一卡" —— 波形区高 180px
 *    要走 4 条 480×48 的横带（LVGL 局部渲染），**每两条带之间被插 40ms** ⇒ 肉眼看到
 *    的就是"逐带刷 + 一顿一顿"。
 *    下调后：UI 一醒就抢占引擎，引擎用 UI 睡（每轮 10ms）的缝把 DSP 跑完 —— 40ms 的
 *    活摊到 ~55ms 墙钟，对 200ms 的测量周期毫无影响。
 *    2026-10-14 把 engine/UI **整体抬到 defaultTask 之上**（22→25 / 23→26）——
 *    **相对序没变**（engine 仍在 UI 之下），只是把 defaultTask 挤到垫底。
 *    ⚠️ 这条相对序是硬约束，别改回来。
 *  ⚠️ 这样改**不影响采样正确性**：`HAL_ADC_ConvCpltCallback` 在帧满时**先关了 TIM8
 *    触发源**（bsp_adc.c），所以就算引擎被推迟 10ms 才去 `bsp_adc_stop()`，缓冲里也
 *    不会再有新数据（单缓冲不会被循环覆盖）。
 *  ⚠️ 栈深单位是 **word（4 字节）**。UI 栈要给 LVGL 重绘 + 标定时的 DSP 链
 *     （标定按钮回调在 UI 任务里跑同步测量）留余量，故比 engine 大。
 *  ⚠️ 两个任务都用 `xTaskCreateStatic`（栈/TCB 是静态数组）—— 不动 FreeRTOS 堆。 */
#define APP_TASK_ENGINE_PRIORITY 25U
#define APP_TASK_ENGINE_STACK_WORDS 1024U
#define APP_TASK_UI_PRIORITY 26U
#define APP_TASK_UI_STACK_WORDS 2048U /* ★ 2026-10-14：1536→2048。原余量只 1124 B
                                       * （高水位 281 words，docs/03 §8 登记"值得盯"）；
                                       * 现在池/栈都有了富余，把这条风险直接买断。 */

/* 等一帧 DMA 的上限。正常一帧 4096 点 @2MSPS = 2.048ms；给 50ms 是"链断了
 * 也不永久挂死"的看门狗口径（超时由 engine 报错并跳过本帧）。 */
#define APP_ADC_FRAME_TIMEOUT_MS 50U

/* 任务栈高水位上报的时刻（上电后 ms，一次）。要晚到"DSP 全链 + LVGL 重绘
 * 都跑过几轮"之后才有意义；标定路径（UI 任务最坏栈）要人手动触发，所以
 * 想验 UI 栈余量，就**在这个时刻之前完成一次标定**（见 app_tasks_report_stack）。 */
#define APP_STACK_REPORT_MS 10000U

/* ------------------------------------------------------- AI 闭环验证标记 ---- */

/* ⚠️ 启动自检**不在上电瞬间跑**，而是延迟这么久、在任务里跑一次。
 *
 * 为什么（实测踩过）：`fw.py verify` 的顺序是"先烧录复位放行、再启动 RTT 主机"。
 * 目标从复位到输出完的那一瞬间，主机**还没挂上**；而 RTT 上行缓冲只有 1024 B
 * 且满则**静默丢** ⇒ 主机挂上时只能读到最早那 1024 B，中间的输出全被丢掉。
 * 实测现象：153 个值只收到 18 个，日志在缓冲容量处直接跳到结束标记 ——
 * 看起来像"算错了"，其实是**采集端来晚了**。
 *
 * 延迟到主机已挂上再跑才是可复现的做法；顺带也不再用几百毫秒拖慢启动。 */
#define APP_TRACE_START_MS 3000U

/* RTT 上行缓冲默认只有 1024 B，模式是 NO_BLOCK_SKIP —— 满则**直接丢**。
 * 批量输出必须分块主动让路：每块留在缓冲容量内，块间延时。
 * ⚠️ 节奏必须按**每一行**计（含表头），否则表头会先灌满缓冲，
 *    后面几十行全被丢掉 —— 丢数据是**静默**的。 */
#define APP_TRACE_DRAIN_LINES 8U
#define APP_TRACE_DRAIN_MS 15U

/* ------------------------------------------------------------ 演示：心跳灯 ----
 * 用一个"纯逻辑"的参数演示四层的走法（docs/10 §A）：
 *     Operation/Inc/op_blink.h   ← 纯逻辑：给定时间，该亮还是该灭
 *     Test/test_op_blink.c       ← PC 单测，`fw.py test` 秒级跑完
 *     Task/Src/app_blink.c       ← 取时间 / 传时间 / 按结论驱动 Device
 *
 * ⚠️ `on_ms + off_ms` 必须 < 2^32（用无符号减法算周期，天然处理回绕）。 */
#define APP_BLINK_ON_MS 500U
#define APP_BLINK_OFF_MS 500U

/* ------------------------------------------------------- 演示：写 SPI Flash ----
 * 一次跨页写最多拆成几段 —— 决定组合根里那个段数组开多大。
 * W25Q128 页 = 256B；起始未对齐时首段不足一页，所以段数会多一个。
 * 按"一次最多写 1KB"给 8 段，够用又省栈（`op_flash_page_count()` 可以先问）。 */
#define APP_FLASH_MAX_SEGS 8


/* ------------------------------------------------------ 找峰扫带（op_peak）----
 * ★ 2026-10-07 从 `app_engine.c` 的硬编码字面量上提到这里（本工程禁止魔数）。
 *
 * ⚠️ **[9000, 502000] 不是"比题面松一点"，是找峰下标算法的**最小可行值**。
 *    推导（op_peak.c 的下标算术，`df = fs/N = 2000000/4096 = 488.28125 Hz`）：
 *      · 下端：`k_lo = (int)(f_lo/df)`，而局部极大搜索**从 k_lo+1 起步**。
 *        题面下界 10 kHz 的栅格主峰在 `k = (int)(10000/df) = 20`。
 *        ⇒ 必须 `k_lo ≤ 19` ⇒ `f_lo < 20·df = 9765.6 Hz`。取 9000（k_lo=18）留 1 bin 余量。
 *        ⚠️ 若把 f_lo 写成 10000，k_lo=20、搜索从 21 起 ⇒ **10 kHz 的峰会整个漏掉**。
 *      · 上端：循环条件 `while (k < k_hi - 3)` ⇒ 最后一个被测下标是 `k_hi-4`。
 *        题面上界 500 kHz 恰好落在 `k = 500000/df = 1024.0`（整数周期，无泄漏）。
 *        ⇒ 必须 `k_hi - 4 ≥ 1024` ⇒ `k_hi ≥ 1028` ⇒ `f_hi ≥ 1027.96·df ≈ 501.95 kHz`。
 *        取 502000（k_hi=1028）**刚好够**。
 *        ⚠️ 若把 f_hi 写成 500000，k_hi=1024、最后测到 1020 ⇒ **500 kHz 的峰漏掉**。
 *    ⇒ 结论：这两个数**贴着算法边界**，不能"凑整"成 10k/500k。
 *      `app_engine_init()` 里有一道运行期自检（改 fs / OP_DSP_N 会当场报 ERROR）。
 *
 * gate = **2.5 mV**（★ 2026-10-16：1.5 → 2.5）。它是**夹逼**出来的值，两侧都要看
 *  （推导见 `op_peak.h` 的 ② 段）：
 *
 *   · 上界 = 不许误伤真分量。最小真分量按 `tools/sim/s8_e2e_fw.py` 的"场景 2：
 *     u_b 最小信号 50mVpp"档 = **3.575 mVpk**（幅度比 20:10:5）⇒ 2.5 留 **1.43×**。
 *     官方测评档（`docs/电赛测评值.png`）最小真分量 15 mV、PC 单测最小 9 mV（S2），
 *     余量更宽。⚠️ **再往上抬就会漏检小信号档**：丢掉一个 3.5mV 分量，它对 Upp 的
 *     贡献可达 2×幅值 ≈ 7 mV —— 直接击穿 5 mV 判据。
 *   · 下界 = 把假线挡在峰表外。三道地板要一起压住：最坏混叠残留 0.65 mV
 *     （复算：`tools/sim/` 折叠带最差 −57.4 dB ⇒ 250mV 输入折到 ADC 端 0.34 mV）·
 *     噪声底 0.053 mVrms · **1 MHz 干扰的三阶互调产物 ≈1.7 mV**
 *     （1000 − 375 − 125 = 500 kHz）。最后这条是 2026-10-16 上板现象：它卡在旧门限
 *     1.5 mV 上 ⇒ 逐帧时进时出 ⇒ 那根 500 kHz 谱柱闪烁、Upp 跟着跳 0.9~1.9 mV。
 *     抬到 2.5 后它进不了峰表，谱柱与 Upp 一起干净（余量 1.47×）。
 *
 * ⚠️ gate 的唯一职责是**防假线**。**禁止**把它改成"把已检出的分量留住"的迟滞/保持
 *    —— 那会让假线**稳定亮着**（= 把假象固化成永久结果），2026-10-16 已明确否决。
 * ⚠️ 这三个值在 `op_peak.c` 的静态默认值里有一份**同值拷贝**（PC 单测的兜底，
 *    且单测**不调** `op_peak_init` ⇒ 漏改那边 = PC 与板上两个门限，静默分叉）。
 *    ▶ 回归保护：`Test/test_op_meas.c` 的 **G1**（1.7 mV 互调必须检不出）/ **G2**
 *      （3.575 mV 真分量必须检出）—— 两条合起来才钉得住门限，只测一侧等于没测。 */
#define APP_PEAK_F_LO_HZ 9000.0f
#define APP_PEAK_F_HI_HZ 502000.0f
#define APP_PEAK_GATE_MV 2.5f

/* ------------------------------------------------------------ 测量节拍 ----
 * 自动重测周期。题面"各项 ≤2s 完成"：200ms 周期 + 全链 ~40ms ⇒ 任意时刻的
 * 屏上数据 ≤0.25s 旧 —— 判据的 1/8。切页/换 1T-3T 会立即重测一次（app_ui）。
 * ★ 500 → 200（2026-10-13 六轮）：**"时域页帧率太低"的真正原因是这个节拍，不是画不动** ——
 *   一次全屏重绘只要 ~12ms（FSMC AS=2/DS=8 ⇒ 76.4ns/字 ≈ 13Mpx/s），而屏上内容只在
 *   "新结果到达"时才变 ⇒ 节拍 = 屏上看到的帧率（500ms ⇒ 2 fps，观感就是"卡"）。
 *   200ms ⇒ ~5 fps，DSP 占空比 40/200 = 20%（仍留 5 倍余量）。
 * ★ 2026-10-14 七轮：200 → **100**（波形帧率 5 → 10 Hz）。前提是同一轮把波形的
 *   渲染成本砍了下来（丢 4px 发光层 / 关圆头 / 对象面积贴紧 / 噪声带 80 点 /
 *   引擎侧盒式平均抽取）—— 实测 UI 段从 **187ms/轮 → 33ms/轮**、整机 88% → 24.5%。
 *   ⇒ 10 Hz 时 UI ≈ 33ms/轮 × 10 = 33%，加 DSP 40% = 73% ✓ 放得下。
 *   ⚠️ 这些数字是"噪声轨迹"（台面悬空）下的；有真实基波时波形是光滑曲线，
 *      渲染更便宜（点数减半的掩膜更短）。若哪天把上面那些减负改回去，本值必须一起退回 200。
 * ⚠️ 别改成 <100ms：DSP 一拍 40ms，周期太短会把节拍全部吃满（LVGL 饿死）。 */
#define APP_MEAS_PERIOD_MS 100U

/* ------------------------------------------------------ 模拟轨建立等待 ----
 * 上电后**等模拟轨稳了再跑采样自检**（`app_rtos_run()` 里 `osDelay` 一次）。
 *
 * 机理（硬件事实，2026-10-07 按活体网表重核）：
 *   ⚠️ 原注释写"戴维南 = R9//R10//R2//R5//R7 = 2.0 kΩ" —— **那是 AC 阻抗，不是
 *      直流建立时间的阻抗**，两者被混用了。直流下：
 *        · R2 / R5 的另一端接运放 **+ 输入**（高阻，无直流电流）；
 *        · R7 两端（VBIAS 与 U1B 反相端）直流等电位 ⇒ 无直流电流。
 *      ⇒ **带直流电流的只有 R9(10k→+3V3) 与 R10(10k→AGND) ⇒ 戴维南 = 5.0 kΩ**。
 *   C5 = 10 µF（图纸 Value；⚠️ 其 MPN 是 100nF 件，见下方"待确认"）
 *      ⇒ **τ = 5.0k × 10µF = 50 ms**（不是 20 ms）。
 *   自检判据是"帧直流均值落在 2048±15% 带内" ⇒ VBIAS 落在 1.65V±124mV ⇒
 *      需到终值的 **92.5%** ⇒ t = 2.59τ = **129.5 ms**（不是"到 0.1% 的 138 ms"）。
 *
 * 取值 **200 ms**：> 129.5 ms（判据所需），留 ~54% 余量。
 *   ⚠️ 2026-10-07 从 150 提到 200：150 只比 129.5 高 16%，而这条延时存在的意义
 *      就是"别报假的「模拟轨可疑」把人带错方向"，余量太薄就失去了意义。
 *      相对题面"每项 ≤2 s"仍可忽略。
 *   ⚠️ 若 C5 最终确认是 100nF（其 MPN `CC0805KRX7R9BB104` 指向 100nF），
 *      τ 只有 0.5 ms、1.3 ms 就到位 —— 那 200 ms 就是 150× 保守，也无害。
 *      （C5 取值对 PSRR / 噪声**无影响**：仿真 10µF vs 100nF 结果逐位相同，
 *        见 `_work/hwsw-chain/c5_value_check.py`。）
 *
 * ⚠️ **改前是"侥幸成立"**：`bsp_lcd_init()` 里那两处 `HAL_Delay(20)`+`HAL_Delay(120)`
 *    恰好盖住了这段建立时间。但那两条延时是**屏的初始化需求**，不是 AFE 的时序依赖
 *    —— 谁哪天把它们去掉，这个假告警就冒出来。⇒ 显式等。
 *
 * 为什么放这里而不是 `board_config.h`：`app_rtos.c` 的分层约定只 include
 * `Operation/Inc` 与 `Common/Inc`，看不到 `Core/Inc`；这是**应用时序策略**，
 * 数值的硬件推导写在注释里。 */
#define APP_AFE_SETTLE_MS 200U

/* 波形页重建曲线的列数。
 * ⚠️ 2026-10-13 横屏后内容区宽 424，本值**仍是 320**（每点 1.33 px，轻微拉伸）——
 *    故意不跟到 424：`refresh_wave()` 里的 `float y[APP_UI_WAVE_POINTS]` 是**栈**数组，
 *    424 会多吃 416 B 的 UI 任务栈（实测栈余量只有 1324 B），而视觉上看不出差别。
 * op_wave/op_meas 的重建在 UI 刷新时跑：320×3 分量 sinf ≈ 1ms 级，无压力。
 *
 * ★★ 2026-10-14 七轮（T2）：320 → **160**。T0 消融实测"整页渲染时间 93% 花在波形"，
 *   而成本与**段数**成正比（LVGL 每一段斜线都要建一次覆盖率掩膜、逐像素混合，
 *   每段两端还各加一个圆头填充任务）⇒ 段数减半 = 掩膜/任务减半。
 *   448 px 宽下 160 点 = 每点 2.8 px，视觉上分辨不出（六轮前本来就是 160）。
 *   ⚠️ 2026-10-14：原先这里还有一条"必须能整除 `APP_ENGINE_TRACE_N`(160)"的约束
 *      （无基波时画抽取轨迹、按整数倍复制到各列）—— **那条轨迹已随"无信号画直线"删掉，
 *      约束随之消失**。
 *   ⚠️ 1T 其实过采样 ~2.5×（5 次谐波的弦误差只有 0.06px）；要不要降到 64 见
 *      `_work/lvgl_perf_20261014/波形点数与弦误差.md`（未做，按"改一处量一处"留着）。 */
#define APP_UI_WAVE_POINTS 160 /* 不带 U：大量出现在 int 循环里，-Wsign-compare 会炸 */

/* 标定表在 W25Q128 的落点：扇区 0（4KB）。选它是为了离固件尾部测试扇区
 * （app_flash_rw_test 用倒数两个扇区）足够远；表 252B < 1 页 256B。 */
#define APP_CAL_FLASH_ADDR 0x00000000U

/* 标定的**标称真值**：信号源在每个标定点上要给的正弦**峰值幅度**（mV）。
 *
 * ⚠️⚠️ 是**峰值** —— 不是 Vpp、不是 rms。100 mV 峰值 = 200 mVpp。
 *     屏上提示文字与 `app_engine_cal_step` 的计算同源，别在别处另写一个数。
 *
 * 用它的两处（改一处必须同时看另一处）：
 *   · `app_engine.c` `cal_measure_current()`：`g = 测得峰值幅度 / APP_CAL_SRC_PEAK_MV`；
 *   · `app_ui.c` 的标定覆盖层提示：`"(= <本值> mVpp) then press MEAS."`。
 *
 * ⚠️ 2026-10-16：本宏是上一会话的未提交改动，被我误用 `git checkout` 一并回退后重建。
 *    数值仍是 100.0f；若与原版注释措辞有出入，以代码里的用法为准。 */
#define APP_CAL_SRC_PEAK_MV 100.0f

/* --------------------------------------------------------- 功能开关（闸门）----
 * 一个开关如果没有任何代码读它，就是"孤儿宏"（翻成 1 什么都不会发生）。
 * 所以每个开关都配一道编译期闸门 —— 见 docs/07 §功能开关要有闸门。 */

#define APP_ENABLE_IWDG 0
#if APP_ENABLE_IWDG
#error "APP_ENABLE_IWDG=1，但工程里没有 bsp_iwdg 实现：请先补模块再启用"
#endif

/* 置 1 = 上电自检末尾**故意触发 HardFault**，用来验证崩溃取证链路：
 *   HardFault_Handler → bsp_fault_report() → RTT 输出栈帧。
 * ⚠️ 触发后固件**会停机**（bsp_fault_report 是 noreturn，这是预期行为）
 *    ⇒ 默认必须是 0。验完**记得改回 0**，留着会让板子每次上电都死。 */
#define APP_SELFTEST_FAULT 0

#endif /* PROJECT_CONFIG_H */
