funiang-x/G2026/tools/sim/s8_e2e_fw.py

# -*- coding: utf-8 -*-
"""S8 · 题面示例的**端到端复现**：源信号 → AFE → 12bit ADC → 固件峰检测链 → 显示值

这是全链最后一环，也是最直接的一项验证：题面**自己给了验收示例**
（u = U1·sin(2π·10.5k·t) + U3·sin(2π·31.5k·t) + U4·sin(2π·42.0k·t) mV，
装置应显示 10.5kHz/U1、31.5kHz/U3、42.0kHz/U4），
本脚本就按这个示例跑一遍，把**显示值**与**标称值**逐项对判据（5mV / 1kHz）。

固件算法**逐句照搬** `firmware/Operation/Src/op_peak.c` + `op_meas.c`：
  窗 = 固件自己的 `op_dsp_winh4[]` 表（从 .c 里抽出来的，不是我另造的 BH4）
  ① 栅格预筛 2·mag/(N·CG) ≥ 1.5mV
  ② log 域三点抛物线 → d ∈ [−0.5, 0.5]
  ③ fc0 ± Δf/8 三点 |X| 抛物线 → d2
  ④ 单点 DFT 读数 amp = 2|X|/(N·CG)，φ = atan2 + π/2（sin 载波补偿）
  ⑤ 标定修正（g、p_corr）→ 终判（门限 + 频带）
  Upp = sin 重建 max−min（抽点 max(512, 32·m_max)）；Urms = √(ΣA²/2)
"""
from __future__ import annotations

import math
import os
import sys

import numpy as np

sys.path.insert(0, os.path.dirname(os.path.abspath(__file__)))
from afe_net import V, build_afe  # noqa: E402

N = 4096
FS = 2.0e6
DF = FS / N                     # 488.28 Hz
CG = 0.35875                    # 固件 op_dsp_winh4.h 的 OP_DSP_CG
F_LO, F_HI = 9000.0, 502000.0   # 固件 op_peak 的默认 s_p
GATE_MV = 1.5
WIN = np.load(os.path.join(os.path.dirname(os.path.abspath(__file__)), "_winh4.npy"))


# ---------------------------------------------------------------- 固件算法
def dft_at(xw, f):
    n = len(xw)
    k = np.arange(n)
    X = np.sum(xw * np.exp(-2j * np.pi * f * k / FS))
    return X


def op_peak_run(xw, cal_mag=None, cal_ph=None):
    """返回峰表 [(f_hz, amp_mv, phi_rad), ...] —— 逐句照搬 op_peak_run()。"""
    n = len(xw)
    mag = np.abs(np.fft.rfft(xw))
    k_lo = int(F_LO / DF)
    k_hi = int(min(F_HI / DF, n // 2 - 1))
    floor_v = max(mag[k_lo:k_hi + 1].max(), 1e-30) * 1e-9
    out = []
    k = k_lo + 1
    while k < k_hi - 3 and len(out) < 16:
        if mag[k] >= mag[k - 1] and mag[k] > mag[k + 1]:
            if 2.0 * mag[k] / (n * CG) >= GATE_MV:
                a, b, c = (math.log(max(mag[k - 1], floor_v)),
                           math.log(max(mag[k], floor_v)),
                           math.log(max(mag[k + 1], floor_v)))
                den = a - 2 * b + c
                d = 0.5 * (a - c) / den if den != 0 else 0.0
                d = min(0.5, max(-0.5, d))
                fc0 = (k + d) * DF
                m3 = [abs(dft_at(xw, fc0 + (j - 1) * DF / 8.0)) for j in (0, 1, 2)]
                den2 = m3[0] - 2 * m3[1] + m3[2]
                d2 = 0.5 * (m3[0] - m3[2]) / den2 if den2 != 0 else 0.0
                d2 = min(0.5, max(-0.5, d2))
                f_c = fc0 + d2 * DF / 8.0
                X = dft_at(xw, f_c)
                amp = 2.0 * abs(X) / (n * CG)
                phi = math.atan2(X.imag, X.real) + math.pi / 2.0   # sin 载波补偿
                if cal_mag is not None:
                    g = float(np.interp(f_c, cal_mag[0], cal_mag[1]))
                    pc = float(np.interp(f_c, cal_ph[0], cal_ph[1]))
                    if g > 0:
                        amp /= g
                    phi -= pc
                if amp >= GATE_MV and F_LO <= f_c <= F_HI:
                    out.append((f_c, amp, phi))
            k += 5
        else:
            k += 1
    return out
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
