funiang-x/G2026/(commit log)

2026-09-27 G2026 建仓基线：固件源码 + 自产文档 + 工具脚本（build 与外部资料包按 .gitignore 排除）
2026-09-30 工作流重构 批次 4/4：三区迁移
    workbench/ → rules/ obsidian-vault/ → knowledge/ workspace/{stm32/f407vgt6,esp32} + products/G2026 → projects/
    workspace/ 保留：lceda · ad · proteus · latex · ppt（软件与素材区，非项目）
    新增 _refs/：github 上游仓库克隆（只读）
    ① 搬目录：5 个独立 git 仓随目录一起走，HEAD 不变（实测核验）
    ② 引用重写 8733 处（斜杠路径）+ 59 处（独立字符串字面量）
    —— 脚本里大量写法是 ROOT / "workbench" / "machine.md"，斜杠规则吃不到，
    必须单独按带引号的字面量替换
    ③ 43 扇规则门随 doors.json 一起改指并 --refresh 重生成
    ④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
2026-10-06 初始化：G2026 固件源码 + 项目文档
2026-10-14 G2026 收官版：LVGL 刷屏/触摸/页面生命周期优化（显示与触控已上板验证）
    刷屏（docs/03）
    - C8 触摸 INT 门：静屏 handler 22.7%→2.8%、滑动快窗 16.2→19.8 fps、I²C 失败 0
    - C9② 带数 A/B（可复现测试台）：flush 侧带数几乎免费、每多一带 +0.64 ms 全在 render 侧
    ⇒ 定稿 56 行；28 行只服务于已放弃的 DMA 路线
    - C9③ DMA 刷屏：做通半条路，但 CR.EN=0 时 NDTR 仍满值 ⇒ EN 不能证明"总线静默"
    ⇒ 不采用（O1 不能赌）；代码与测试台按结论清理，教训留档 docs/03 §8.1
    触摸（docs/03 §8.1 D）
    - 两次 I²C 读合并成一次（0x02 起连读 5B）：6.28 → 4.5 ms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
2026-10-16 G2026 最终版：零相位谐波族口径 + 找峰门限 2.5mV；上板测试单 14+6 行全过
    固件：形状与 Upp 统一为零相位谐波族（op_meas/op_wave，相位不参与重建——实测相位不可用：帧起点与源无关、逐点标定各自一帧）；找峰门限 1.5→2.5mV（挡 1MHz 干扰的三阶互调 500kHz≈1.7mV，不碰最小真分量 3.575mV）；峰表 5 根；test_op_meas 新增 G1/G2 两侧定标与零相位口径用例。
    工具：仿真按实物同步（R6 6.8k / R7 1k ⇒ 前端净增益 1.95），复跑 verify_dsp / indep_check。
    文档：docs/01 口径与判据同步；新增上板测试单 v5（含实测）；移除 docs/chain 旧逻辑链三份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
2026-10-16 仓库卫生：.gitignore 收口 .easyeda/ · 根 .vscode/ · .workbuddy/（沿用既有的“产物与 AI 状态不进库”口径）
2026-10-17 release: 公开版（源码 + 硬件资料 + 上板测试单）
    - 新增 MIT LICENSE、THIRD_PARTY、.gitattributes
    - 移除 docs/、PROJECT.md、内部 AI 规则与本机配置（本地文件保留）
    - 新增硬件原理图 PDF、BOM 汇总、66/67 号文档
    - 上板测试单移至 hardware/test/ 并保留为唯一公开的测试记录
2026-10-17 release: 精简公开范围
    - 硬件仅保留 hardware/sch/ 两份原理图 PDF
    - 移除 tools/、BOM/PCB 审查、结构文档与 hardware/data/
    - 上板测试单移至 test-record/ 单独保留
    - README 同步更新目录与链接
2026-10-17 docs: README 顶部增加技术栈徽章与可核对的证据索引
2026-10-30 feat(cal): 标定表 17→20 点，391.5k→500k 四等分
    - OP_CAL_POINTS 17→20：16 点沿用对数网格，顶段再四等分（416.2/442.5/470.4/500 kHz），该段步进 27.7%→6.3%
    - 表 216B→252B（仍单页）；CRC 偏移改 OP_CAL_BLOB_SIZE-4，不再写死 212
    - 修 op_spec_build 未夹 cap 的栈越界（UI 传 5 条、峰表 16 条），test_op_render 随之转绿
    - 标定页文案的 '17' 改由 app_engine_cal_points() 提供，改表长不再说谎
    - 门禁：fw.py test 5/5、build --clean-first 0 告警、sizecheck 通过
2026-11-01 docs: 补模拟前端五级链路图与说明；测试单换 v6
    - hardware/sch/G2026-AFE-frontend.jpg：前端原理图的可读版，位号与参数可见。
    原 G2026-AFE.pdf 由 EDA 导出时未嵌入字体，多数查看器只画图形不画文字
    - README：新增「模拟前端：五级链路」小节（配图 + 五级职责与关键数值表），
    目录结构、测试记录两处同步
    - test-record：上板测试单 v5 → v6（4 张表精简为 2 张，20/20 PASS），v5 移除
2026-11-01 docs: 移除 G2026-AFE.pdf（导出未嵌字体，位号不可见）
    - 该 PDF 由 EDA 的 jsPDF 导出、字体未嵌入：pdftotext 抽出 0 字符，
    多数查看器只画线条、不画位号与参数，作为"模拟电路"的证据链接名不副实
    - 前端原理图改由 hardware/sch/G2026-AFE-frontend.jpg 承载（位号可读）
    - README 三处引用同步；hardware/66 图纸清单改指 JPG，并注明重导命令见 §8
2026-11-01 docs: 两张原理图改用立创EDA 直接导出的 PNG
    - easyeda sch export-image --format png 重导两页：
    AFE 4441×1032（620 KB）、INT 2522×2101（1.2 MB），位号与参数完整可读
    - 弃用 PDF：EDA 的 PDF 导出不嵌字体（文字全部引用不存在的 /undefined 字体，
    pdftotext 抽出 0 字符），换任何查看器都画不出位号
    - 删除 G2026-AFE-frontend.jpg（1768px 低清）与 G2026-INT.pdf（无位号）
    - README / hardware/66 引用同步；66 的复现命令改为 --format png
